land-boards/lb-boards/KiCAD/README.md

lb-boards Designs
=================

land-boards.com - Printed Circuit Board Designs
-----------------------------------------------

Design files are kept here. Most are [Kicad based designs][Kicad].
[Kicad]: http://www.kicad-pcb.org/display/KICAD/KiCad+EDA+Software+Suite/ "Kicad is an open source electronic design suite which includes professional quality schematic capture and board layout tools."

See [our PCB Designs Website][ourWebsite] and our [land-boards Wiki][ourWiki].
[ourWebsite]: http://land-boards.com/content/ "land-boards.com website"
[ourWiki]: http://land-boards.com/blwiki/ "land-boards.com wiki"
