land-boards/lb-boards/BeagleBoneBlack Cards/FlyingBone/README

BeagleBone prototyping board.

Directory 'kicad' contains design files.
Directory 'gerber' contains gerber files prepared for sending to the board house.
Directory 'lib' contains schematic symbol and PCB module for BeagleBone, both ready for use on your own boards.
