land-boards/lb-boards/SYNTHS/ER-PROTO-02_SET/Hagiwo-Quantizer-main/README.md

# Hagiwo-Quantizer
A MCP4821 version of Hagiwo Quantizer

This is a version of Hagiwo Quantizer with a MCP4821 12 bit DAC. The code is still under review. Using the new DAC I have to check calibration.
