land-boards/lb-boards/HamRadio/VFO-003/Documents/REFERNCE_DESIGNS/ETHERKIT_Si5351ABreakoutBoard/README.md

Si5351A Breakout Board
=====================

This repository hosts the KiCad project files for the Si5351A Breakout 
Board, as well as the schematic in PDF format.
