land-boards/lb-boards/SYNTHS/ER-ADSR-555-01_SET/DOCS/BENJIAO/MiniADSR-main/README.md

# MiniADSR

A four-parameter envelope generator based on Rene Schmitz' [The Fastest Envelope in the West](https://www.schmitzbits.de/adsr.html). More info on my website: https://benjiaomodular.com/post/2022-02-02-mini-adsr/

# Versions

## 1.0.1
Quick fixes for v1.0
- Fixed connection of R7 to Q2 pin 1
- Updated C2 value to 10uF
- Change sustain pot from 1M to 10k
- C3 from 100uF to 1uF
- Added version numbers
- Flipped power connectors 180deg to accomodate larger IDC connectors.

## 1.0
Initial design.

### Issues
- Wrong connection from R7
- Wrong value for C3 and Sustain pot
