land-boards/lb-boards/Raspberry Pi Cards/RPI-PWR/Rev_X2/report.txt

Info: Backing up file “C:\Users\HPz420\Documents\GitHub\land-boards\lb-boards\Raspberry Pi Cards\RPI-PWR\sym-lib-table” to file “C:\Users\HPz420\Documents\GitHub\land-boards\lb-boards\Raspberry Pi Cards\RPI-PWR\rescue-backup\sym-lib-table-2020-02-07-10-05-51”.
Info: Backing up file “C:\Users\HPz420\Documents\GitHub\land-boards\lb-boards\Raspberry Pi Cards\RPI-PWR\RPI-PWR.sch” to file “C:\Users\HPz420\Documents\GitHub\land-boards\lb-boards\Raspberry Pi Cards\RPI-PWR\rescue-backup\RPI-PWR-2020-02-07-10-05-51.sch”.
Info: Backing up file “C:\Users\HPz420\Documents\GitHub\land-boards\lb-boards\Raspberry Pi Cards\RPI-PWR\RPI-PWR.pro” to file “C:\Users\HPz420\Documents\GitHub\land-boards\lb-boards\Raspberry Pi Cards\RPI-PWR\rescue-backup\RPI-PWR-2020-02-07-10-05-51.pro”.
Info: Backing up file “C:\Users\HPz420\Documents\GitHub\land-boards\lb-boards\Raspberry Pi Cards\RPI-PWR\RPI-PWR-cache.lib” to file “C:\Users\HPz420\Documents\GitHub\land-boards\lb-boards\Raspberry Pi Cards\RPI-PWR\rescue-backup\RPI-PWR-cache-2020-02-07-10-05-51.lib”.
Info: Backing up file “C:\Users\HPz420\Documents\GitHub\land-boards\lb-boards\Raspberry Pi Cards\RPI-PWR\RPI-PWR-rescue.lib” to file “C:\Users\HPz420\Documents\GitHub\land-boards\lb-boards\Raspberry Pi Cards\RPI-PWR\rescue-backup\RPI-PWR-rescue-2020-02-07-10-05-51.lib”.
Info: Backing up file “C:\Users\HPz420\Documents\GitHub\land-boards\lb-boards\Raspberry Pi Cards\RPI-PWR\RPI-PWR-rescue.dcm” to file “C:\Users\HPz420\Documents\GitHub\land-boards\lb-boards\Raspberry Pi Cards\RPI-PWR\rescue-backup\RPI-PWR-rescue-2020-02-07-10-05-51.dcm”.
Info: Adding library “RPI-PWR-rescue”, file “${KIPRJMOD}/RPI-PWR-rescue.lib” to project symbol library table.
Symbol “COUPON” mapped to symbol library “RPI-PWR-rescue”.
Symbol “COUPON” mapped to symbol library “RPI-PWR-rescue”.
Symbol “CONN_1” mapped to symbol library “RPI-PWR-rescue”.
Symbol “CONN_1” mapped to symbol library “RPI-PWR-rescue”.
Symbol “R” mapped to symbol library “Device”.
Symbol “LED-RESCUE-RPI-PWR” mapped to symbol library “RPI-PWR-rescue”.
Symbol “RASPIO” mapped to symbol library “RPI-PWR-rescue”.
Symbol “USB-MICRO-B” mapped to symbol library “RPI-PWR-rescue”.
Symbol “R” mapped to symbol library “Device”.
Symbol “FUSE” mapped to symbol library “RPI-PWR-rescue”.
Info: Symbol library table mapping complete!
