land-boards/lb-boards/Audio Cards/AudioAmp380/Rev2/panelx2/report.txt

Info: Backing up file “C:\Users\HPz420\Documents\GitHub\land-boards\lb-boards\Audio Cards\AudioAmp380\sym-lib-table” to file “C:\Users\HPz420\Documents\GitHub\land-boards\lb-boards\Audio Cards\AudioAmp380\rescue-backup\sym-lib-table-2021-08-17-08-27-29”.
Info: Backing up file “C:\Users\HPz420\Documents\GitHub\land-boards\lb-boards\Audio Cards\AudioAmp380\AudioAmp380.sch” to file “C:\Users\HPz420\Documents\GitHub\land-boards\lb-boards\Audio Cards\AudioAmp380\rescue-backup\AudioAmp380-2021-08-17-08-27-29.sch”.
Info: Backing up file “C:\Users\HPz420\Documents\GitHub\land-boards\lb-boards\Audio Cards\AudioAmp380\AudioAmp380.pro” to file “C:\Users\HPz420\Documents\GitHub\land-boards\lb-boards\Audio Cards\AudioAmp380\rescue-backup\AudioAmp380-2021-08-17-08-27-29.pro”.
Info: Backing up file “C:\Users\HPz420\Documents\GitHub\land-boards\lb-boards\Audio Cards\AudioAmp380\AudioAmp380-cache.lib” to file “C:\Users\HPz420\Documents\GitHub\land-boards\lb-boards\Audio Cards\AudioAmp380\rescue-backup\AudioAmp380-cache-2021-08-17-08-27-29.lib”.
Info: Backing up file “C:\Users\HPz420\Documents\GitHub\land-boards\lb-boards\Audio Cards\AudioAmp380\AudioAmp380-rescue.lib” to file “C:\Users\HPz420\Documents\GitHub\land-boards\lb-boards\Audio Cards\AudioAmp380\rescue-backup\AudioAmp380-rescue-2021-08-17-08-27-29.lib”.
Info: Backing up file “C:\Users\HPz420\Documents\GitHub\land-boards\lb-boards\Audio Cards\AudioAmp380\AudioAmp380-rescue.dcm” to file “C:\Users\HPz420\Documents\GitHub\land-boards\lb-boards\Audio Cards\AudioAmp380\rescue-backup\AudioAmp380-rescue-2021-08-17-08-27-29.dcm”.
Info: Adding library “AudioAmp380-rescue”, file “${KIPRJMOD}/AudioAmp380-rescue.lib” to project symbol library table.
Symbol “RCA-JACK” mapped to symbol library “AudioAmp380-rescue”.
Symbol “RCA-JACK” mapped to symbol library “AudioAmp380-rescue”.
Symbol “C” mapped to symbol library “Device”.
Symbol “GND-RESCUE-AudioAmp386” mapped to symbol library “AudioAmp380-rescue”.
Symbol “R” mapped to symbol library “Device”.
Symbol “C” mapped to symbol library “Device”.
Symbol “LM386-RESCUE-AudioAmp386” mapped to symbol library “AudioAmp380-rescue”.
Symbol “COUPON” mapped to symbol library “AudioAmp380-rescue”.
Symbol “MTG_HOLE” mapped to symbol library “AudioAmp380-rescue”.
Symbol “CP1_Small” mapped to symbol library “Device”.
Symbol “CP1_Small” mapped to symbol library “Device”.
Symbol “R” mapped to symbol library “Device”.
Symbol “CP1_Small” mapped to symbol library “Device”.
Symbol “CP1_Small” mapped to symbol library “Device”.
Symbol “CONN_01X05” mapped to symbol library “AudioAmp380-rescue”.
Symbol “CP1_Small” mapped to symbol library “Device”.
Symbol “C” mapped to symbol library “Device”.
Symbol “DCJ0202” mapped to symbol library “AudioAmp380-rescue”.
Info: Symbol library table mapping complete!
