land-boards/lb-boards/Projects/QTPy/circuitpython-community-bundle-7.x-mpy-20220601/VERSIONS.txt

20220601
https://github.com/WoolseyWorkshop/WoolseyWorkshop_CircuitPython_74HC165/releases/tag/0.8.0
https://github.com/mmabey/Adafruit_Soundboard/releases/tag/v0.1.1
https://github.com/BiffoBear/CircuitPython_AS3935/releases/tag/2.0.3
https://github.com/skerr92/at42qt-acorn-python/releases/tag/v1.0.6
https://github.com/solderparty/arturo182_CircuitPython_BBQ10Keyboard/releases/tag/v0.2.0
https://github.com/ricardoquesada/bluepad32-circuitpython/releases/tag/0.99.1
https://github.com/jamesbowman/CircuitPython_bteve/releases/tag/0.1.4
https://github.com/hierophect/Hierophect_Circuitpython_Dynamixel/releases/tag/0.0.0
https://github.com/tylercrumpton/CircuitPython_GC9A01/releases/tag/1.0.0
https://github.com/mmabey/CircuitPython_HCSR04/releases/tag/v0.2
https://github.com/fivesixzero/CircuitPython_HX711/releases/tag/1.1.0
https://github.com/gmparis/CircuitPython_I2C_Button/releases/tag/3.1.0
https://github.com/bwshockley/CircuitPython-i2cEncoderLibV21/releases/tag/1.0.1
https://github.com/electronut/Electronutlabs_CircuitPython_ILI/releases/tag/1.0.0
https://github.com/barbudor/CircuitPython_INA3221/releases/tag/2.0.0
https://github.com/Neradoc/Circuitpython_Waveshare_LCD1602/releases/tag/1.0.0
https://github.com/electronut/Electronutlabs_CircuitPython_LIS2DH12/releases/tag/1.0.0
https://github.com/electronut/Electronutlabs_CircuitPython_LTR329ALS01/releases/tag/1.0.0
https://github.com/pimoroni/Pimoroni_CircuitPython_LTR559/releases/tag/v0.0.1
https://github.com/pimoroni/Pimoroni_CircuitPython_MICS6814/releases/tag/v0.0.1
https://github.com/vifino/CircuitPython-mitutoyo/releases/tag/v1.0
https://github.com/CedarGroveStudios/CircuitPython_NAU7802/releases/tag/1.5.1
https://github.com/2bndy5/CircuitPython_nRF24L01/releases/tag/2.1.0
https://github.com/fourstix/Sparkfun_CircuitPython_QwiicAS3935/releases/tag/1.0.7
https://github.com/fourstix/Sparkfun_CircuitPython_QwiicJoystick/releases/tag/1.0.10
https://github.com/fourstix/Sparkfun_CircuitPython_QwiicKe/releases/tag/1.0.4
https://github.com/fourstix/Sparkfun_CircuitPython_QwiicRelay/releases/tag/1.0.6
https://github.com/fourstix/Sparkfun_CircuitPython_QwiicTwist/releases/tag/1.0.8
https://github.com/fourstix/Sparkfun_CircuitPython_SerLCD/releases/tag/1.0.4
https://github.com/winneymj/CircuitPython_SH/releases/tag/1.3.2
https://github.com/s-light/slight_CircuitPython_TLC5957/releases/tag/0.1.2
https://github.com/lesamouraipourpre/Community_CircuitPython_TCA9555/releases/tag/0.2.2
https://github.com/tekktrik/CircuitPython_TicStepper/releases/tag/2.0.1
https://github.com/barbudor/CircuitPython_TMP75/releases/tag/1.0.2
https://github.com/arofarn/CircuitPython_TrellisM4_extended/releases/tag/1.0.0
https://github.com/jfurcean/CircuitPython_WiiChuck/releases/tag/0.0.3
https://github.com/jimbobbennett/CircuitPython_AzureCustomVision_Predic/releases/tag/0.2.1
https://github.com/jimbobbennett/CircuitPython_/releases/tag/0.2.1
https://github.com/buildwithpiper/PiperBlocklyLibrary/releases/tag/v1.09
https://github.com/s-light/CircuitPython_ansi_escape_code/releases/tag/1.0.1
https://github.com/jposada202020/CircuitPython_ArrowLine/releases/tag/0.8.3
https://github.com/WarriorOfWire/CircuitPython_async/releases/tag/v0.1.2
https://github.com/jimbobbennett/CircuitPython_Ba/releases/tag/0.3.1
https://github.com/jposada202020/CircuitPython_Candlesticks/releases/tag/0.6.2
https://github.com/FoamyGuy/CircuitPython_Display_Frame/releases/tag/0.0.4
https://github.com/tekktrik/CircuitPython_CSV/releases/tag/1.0.7
https://github.com/2231puppy/CircuitPython_DiscordBot/releases/tag/1.2.0
https://github.com/dastels/circuitPython_dotstar_featherwing/releases/tag/Initial
https://github.com/tannewt/CircuitPython_Example/releases/tag/1.0.0
https://github.com/tekktrik/CircuitPython_functools/releases/tag/0.1.0
https://github.com/gamblor21/Gamblor21_CircuitPython_AHRS/releases/tag/v0.3-alpha
https://github.com/benevpi/CIRCUITPYTHON_ifttt/releases/tag/0.0.1
https://github.com/jposada202020/CircuitPython_MorseCode/releases/tag/0.2.0
https://github.com/s-light/CircuitPython_nonblocking_serialinput/releases/tag/1.0.0
https://github.com/Angeleno-Tech/nonblocking_timer/releases/tag/1.0.0
https://github.com/FoamyGuy/Foamyguy_CircuitPython_nvm_helper/releases/tag/1.0.1
https://github.com/jimbobbennett/CircuitPython_P/releases/tag/0.4.0
https://github.com/cognitivegears/CircuitPython_Schedule/releases/tag/0.1.2
https://github.com/jposada202020/CircuitPython_st/releases/tag/0.5.1
https://github.com/evindunn/circuitpython_tzdb/releases/tag/0.0.4
https://github.com/jepler/Jepler_CircuitPython_udecimal/releases/tag/1.0.5
