land-boards/lb-boards/BeagleBoneBlack Cards/BBB Overall/beaglebone-black-master/README.md

BeagleBone Black
================

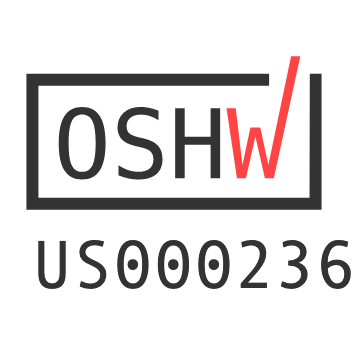
[picture p56: BeagleBoneBlack Cards/BBB Overall/beaglebone-black-master/OSHW_mark_US000236.png]
(https://certification.oshwa.org/us000236.html)
