land-boards/lb-boards/Analog Cards/UNI-OPAMP-04/Docs/RefDesigns/Ap31-OpAmp-DiffAmp.PNG

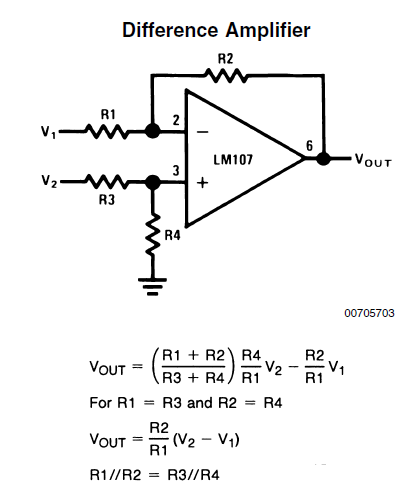
Analog Cards/UNI-OPAMP-04/Docs/RefDesigns/Ap31-OpAmp-DiffAmp.PNG
