land-boards/lb-boards/Analog Cards/UNI-OPAMP-04/Docs/RefDesigns/OpAMP-sch.PNG

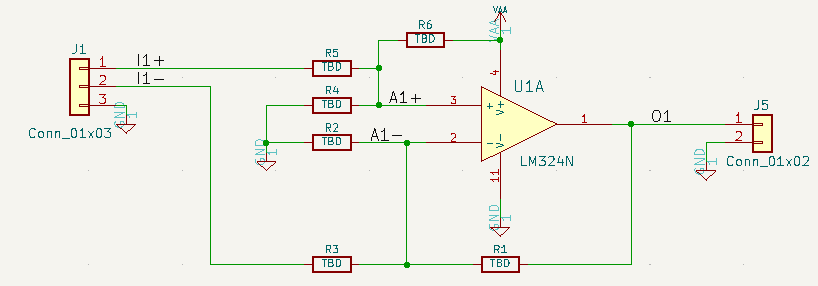
Analog Cards/UNI-OPAMP-04/Docs/RefDesigns/OpAMP-sch.PNG
