land-boards/lb-boards/Arduino Cards/QTPy49-01/QT_Py_Apps/QTPy49_Ap_01 (MMBASIC)/Pics/SD_Loader_App_Schematic.PNG

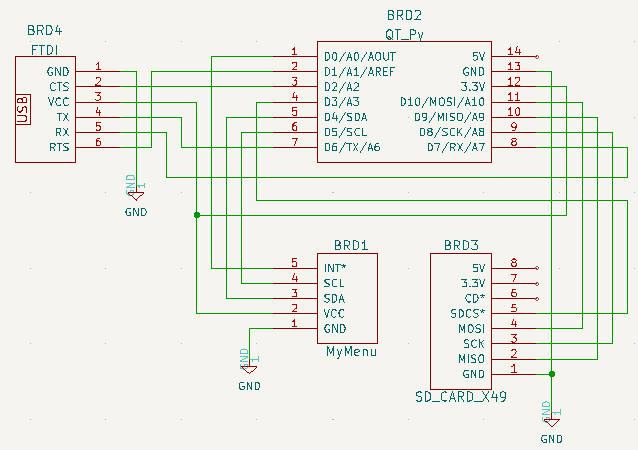
Arduino Cards/QTPy49-01/QT_Py_Apps/QTPy49_Ap_01 (MMBASIC)/Pics/SD_Loader_App_Schematic.PNG
