land-boards/lb-boards/Audio Cards/AudioAmp384/pictures/LM384_Equiv_Schematic.PNG

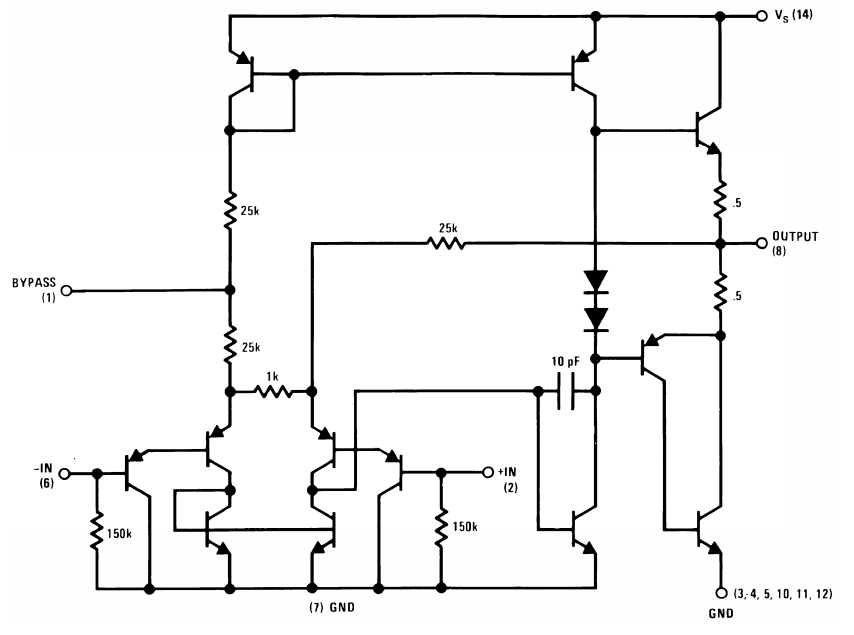
Audio Cards/AudioAmp384/pictures/LM384_Equiv_Schematic.PNG
