land-boards/lb-boards/Audio Cards/Pot_Pins/pictures/Schematics/AudioAmp380-Rev2_Schematic.png

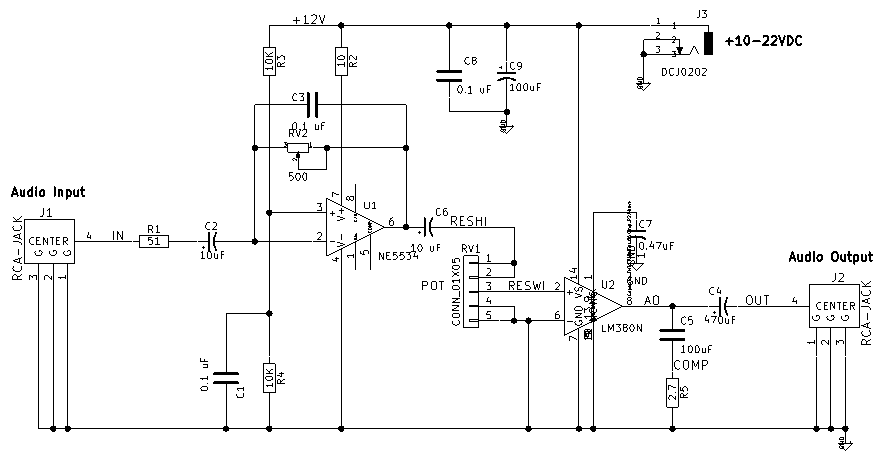
Audio Cards/Pot_Pins/pictures/Schematics/AudioAmp380-Rev2_Schematic.png
