land-boards/lb-boards/Audio Cards/Pot_Pins/pictures/Schematics/LM380_Equiv_Schematic.PNG

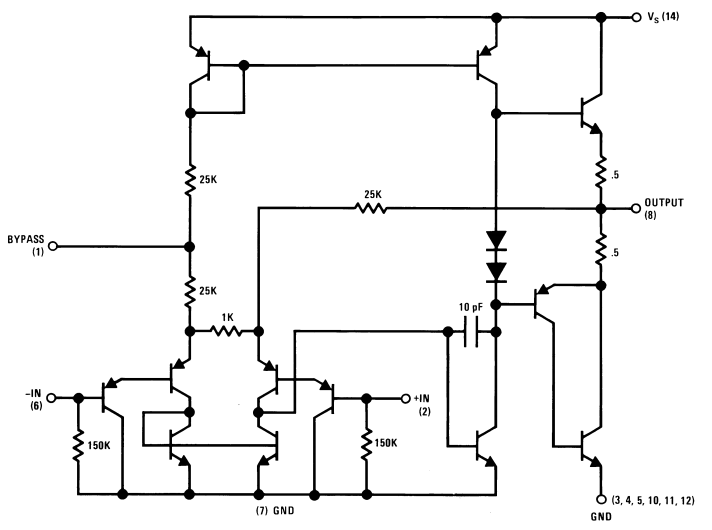
Audio Cards/Pot_Pins/pictures/Schematics/LM380_Equiv_Schematic.PNG
