land-boards/lb-boards/Audio Cards/XR-2206/pictures/Schematics/xr2206x3.png

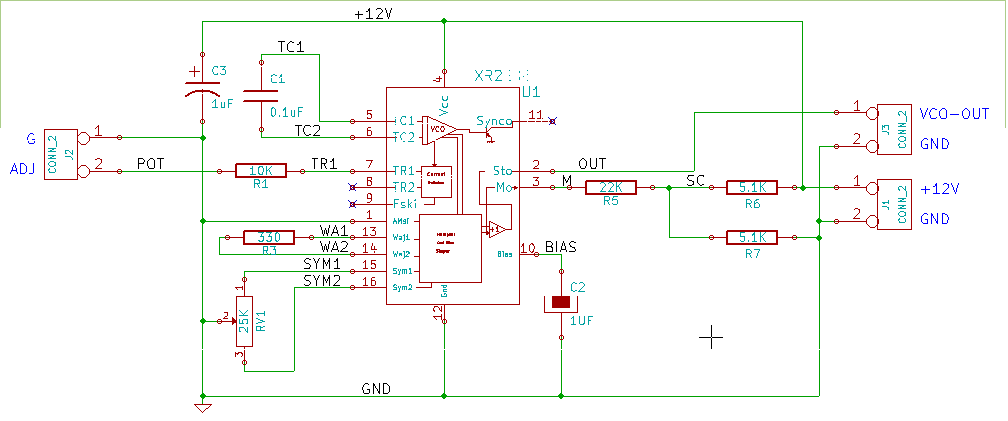
Audio Cards/XR-2206/pictures/Schematics/xr2206x3.png
