land-boards/lb-boards/BeagleBoneBlack Cards/BBB-COMMS-2/Docs/BeagleBone-Black-Pinout.jpg

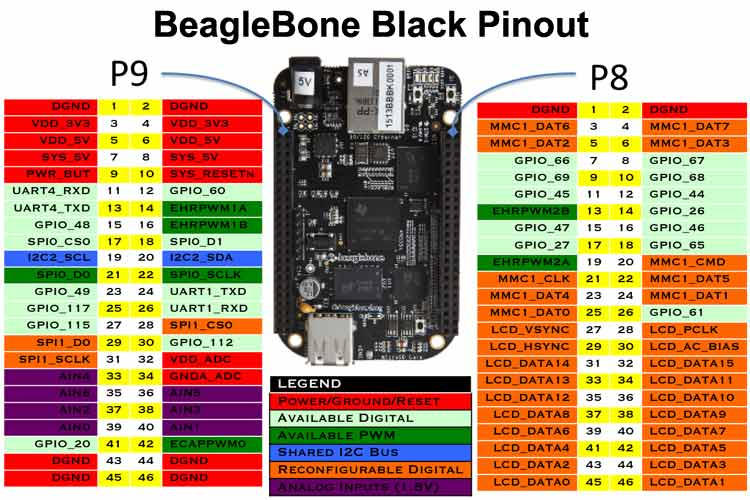
BeagleBoneBlack Cards/BBB-COMMS-2/Docs/BeagleBone-Black-Pinout.jpg
