land-boards/lb-boards/ESP32/ESP32-49MM/Pics/ESP-32_VGA_Pinout_Rev2.PNG

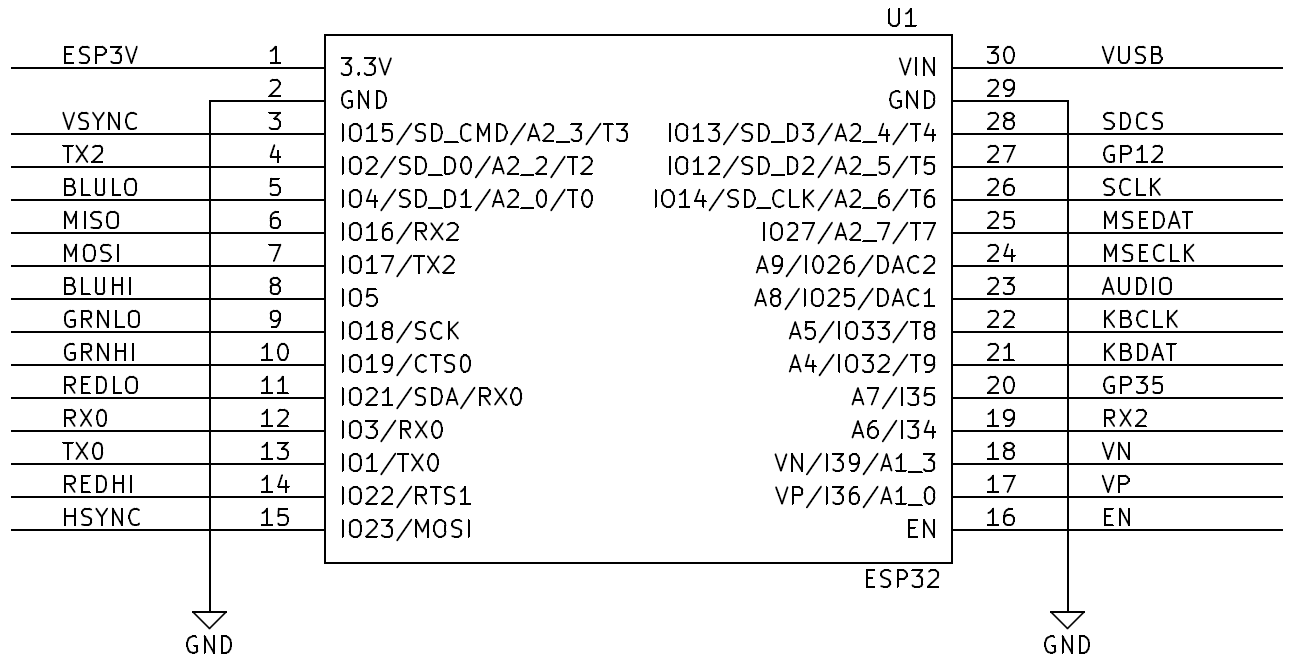
ESP32/ESP32-49MM/Pics/ESP-32_VGA_Pinout_Rev2.PNG
