land-boards/lb-boards/ESP32/ESP-12E-01/Pictures/Design/canvas.png

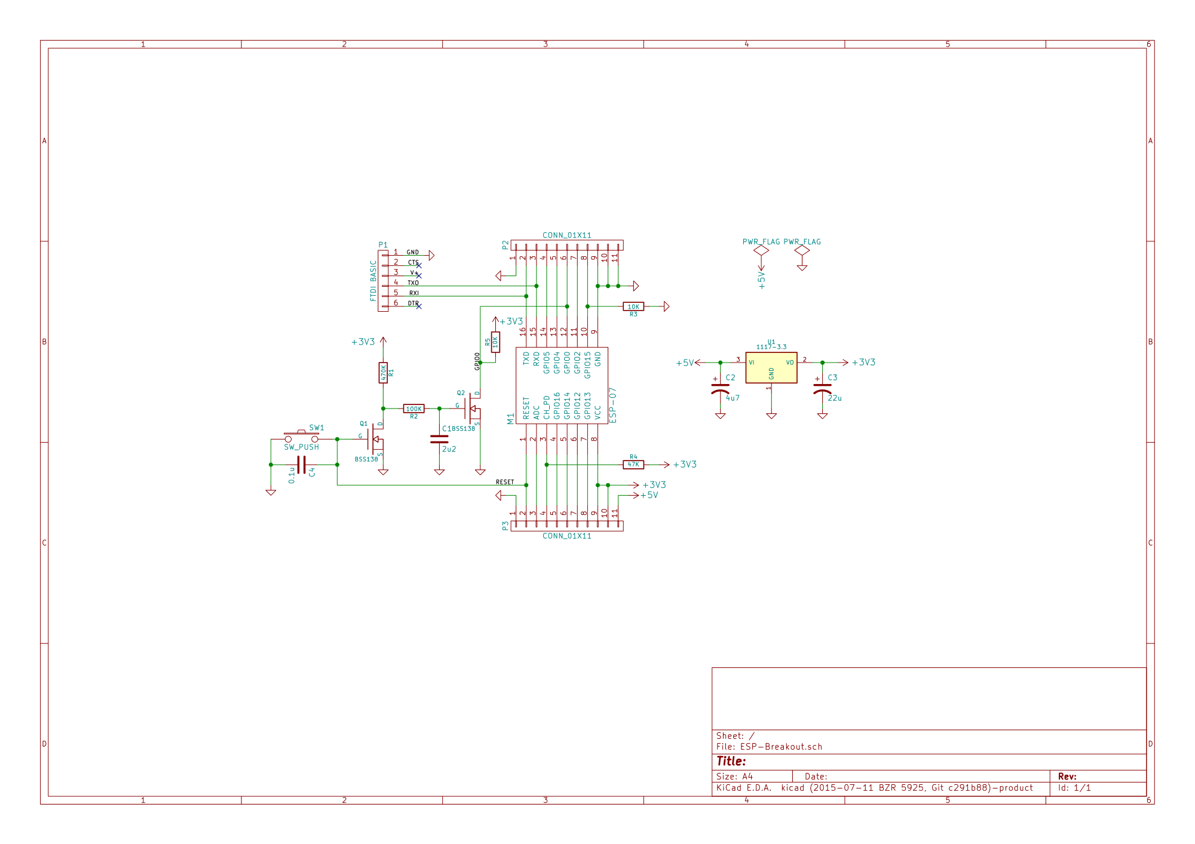
ESP32/ESP-12E-01/Pictures/Design/canvas.png
