land-boards/lb-boards/ESP32/ESP-12E-01/Pictures/Design/Screen-2015-06-12-641.png

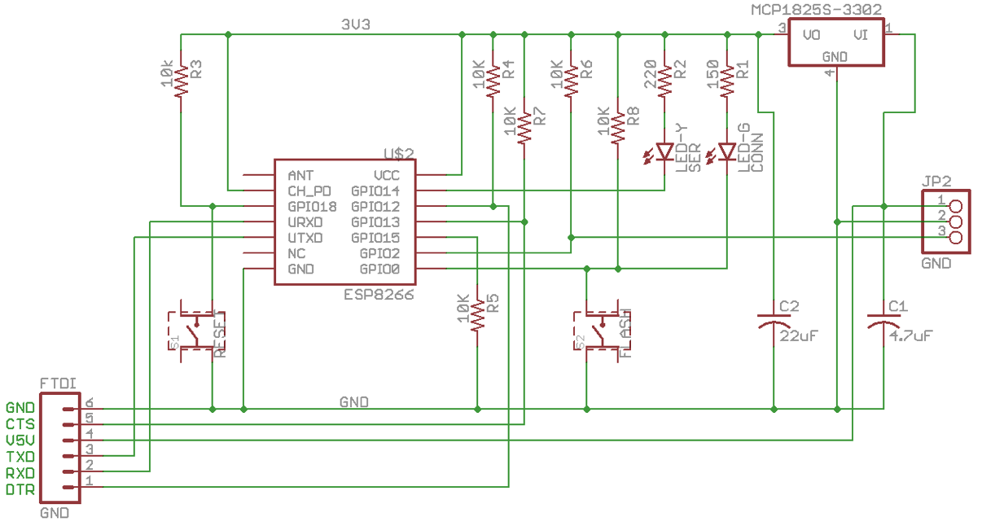
ESP32/ESP-12E-01/Pictures/Design/Screen-2015-06-12-641.png
