land-boards/lb-boards/ESP32/ESP-12E-01/Pictures/Design/wemos-d1-mini-shematics.jpg

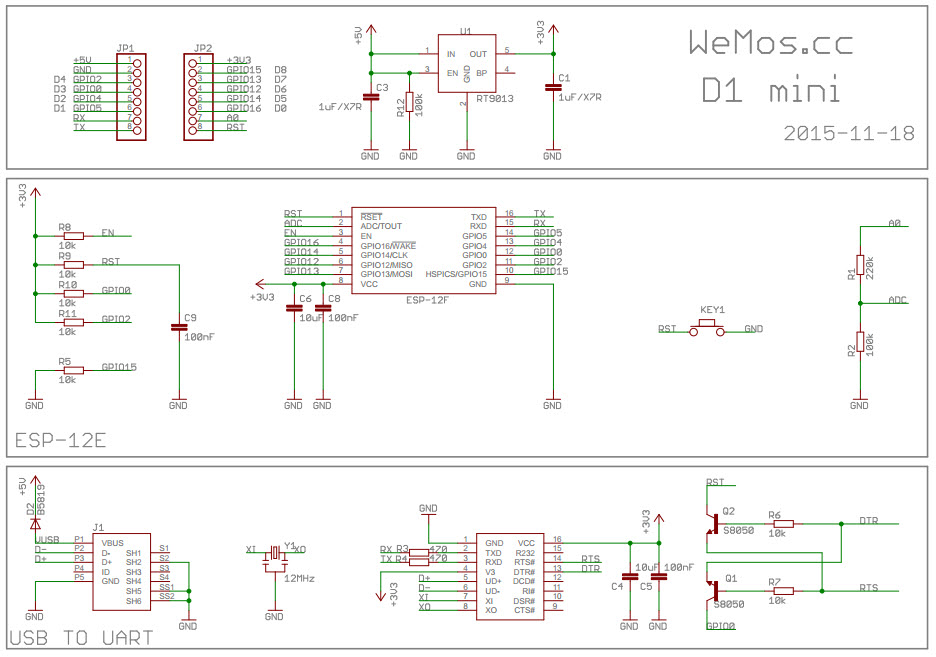
ESP32/ESP-12E-01/Pictures/Design/wemos-d1-mini-shematics.jpg
