land-boards/lb-boards/GPS Cards/GPS-Design/Pictures/GPS-Box-480vpx.jpg

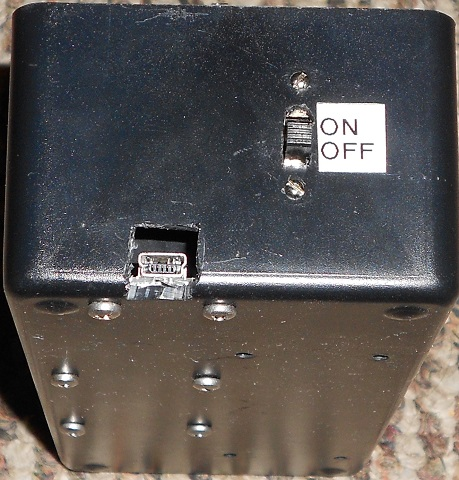
GPS Cards/GPS-Design/Pictures/GPS-Box-480vpx.jpg
