land-boards/lb-boards/GPS Cards/GPS-Design/Pictures/GPS-insides-1600px.JPG

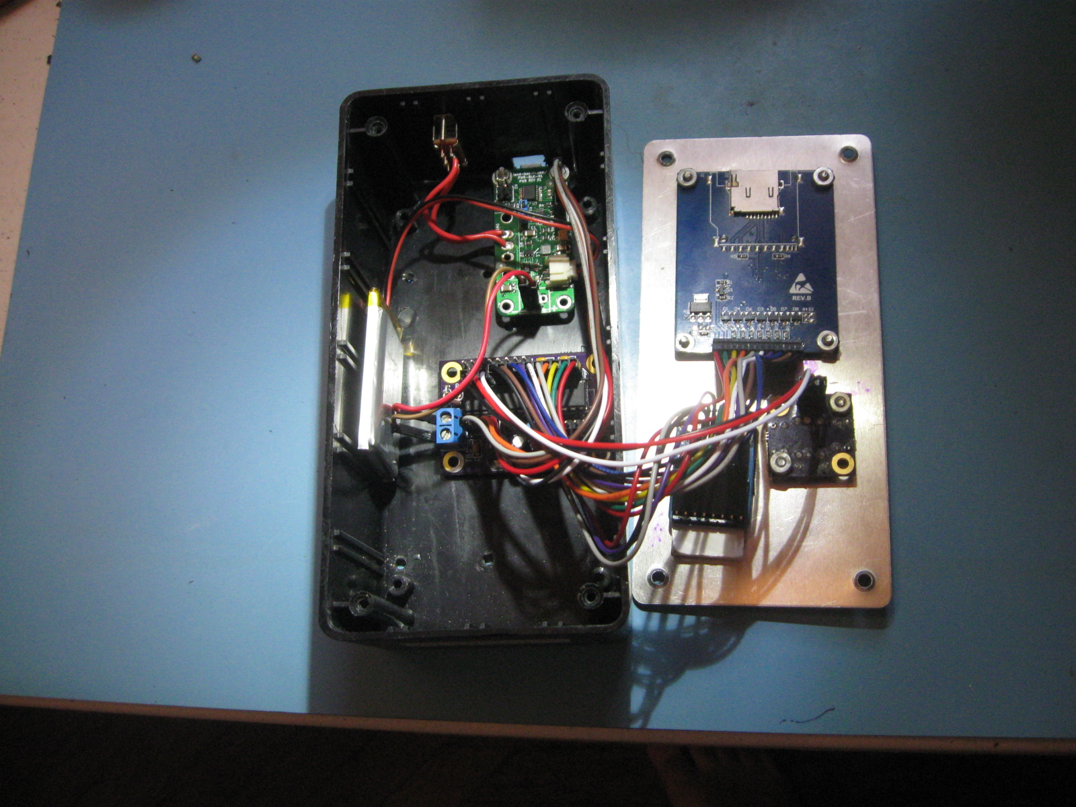
GPS Cards/GPS-Design/Pictures/GPS-insides-1600px.JPG
