land-boards/lb-boards/HamRadio/NoiseGen/Pics/Prototype/HighPassFilter/Filter DesignGain.PNG

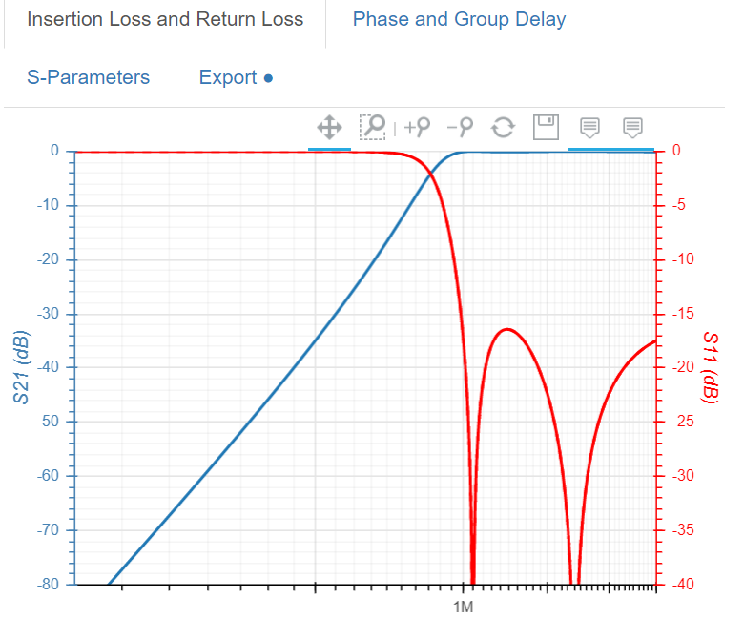
HamRadio/NoiseGen/Pics/Prototype/HighPassFilter/Filter DesignGain.PNG
