land-boards/lb-boards/HamRadio/RF-AMP-1/Docs/RF-AMP-1-Schematic.PNG

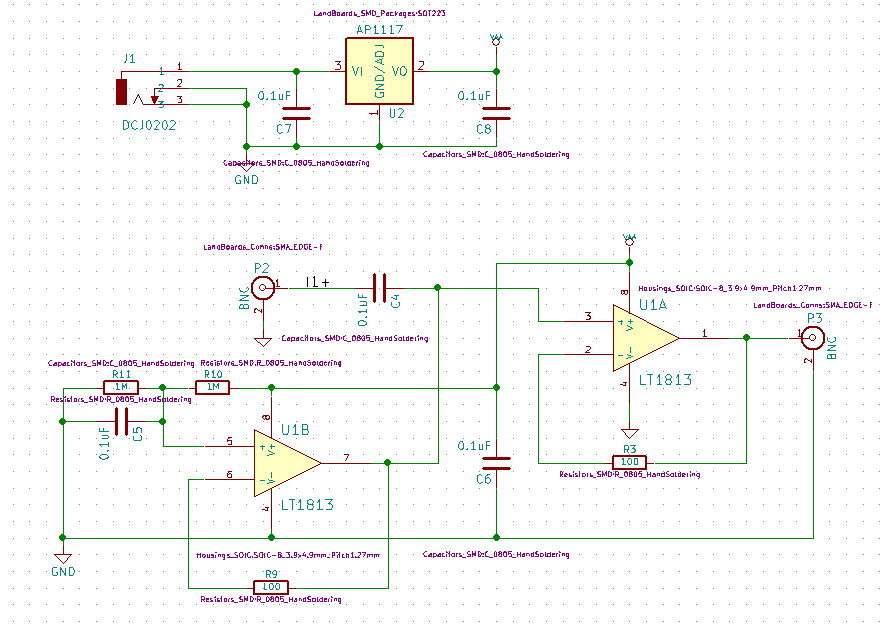
HamRadio/RF-AMP-1/Docs/RF-AMP-1-Schematic.PNG
