land-boards/lb-boards/HamRadio/VFO-001/Pictures/VFO-001-SCHEMATIC-V2A.PNG

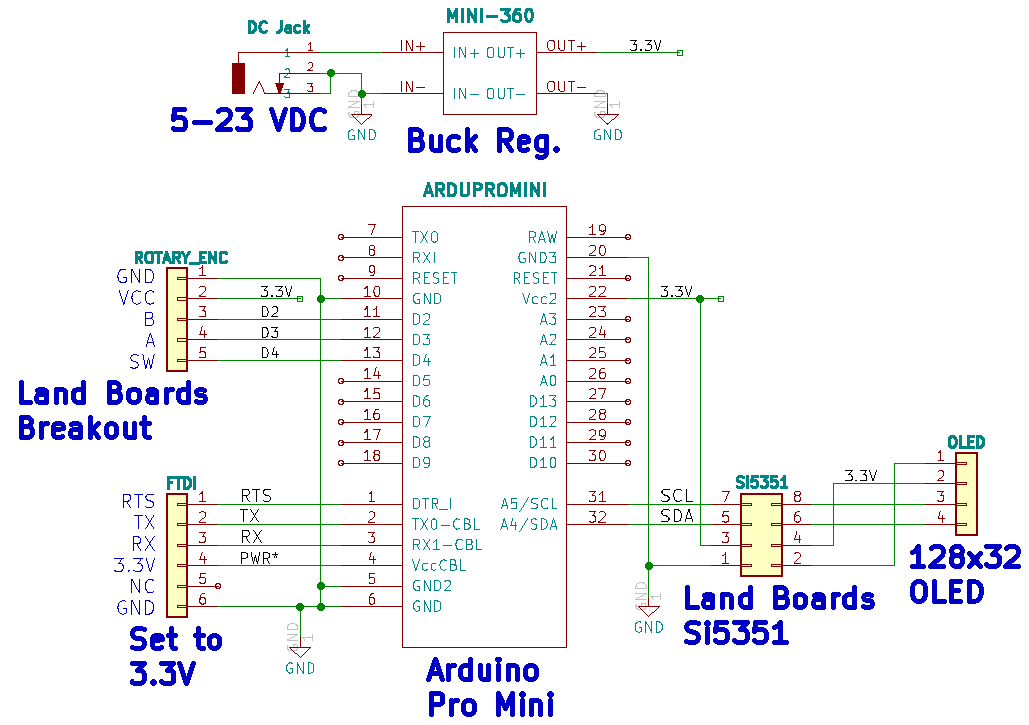
HamRadio/VFO-001/Pictures/VFO-001-SCHEMATIC-V2A.PNG
