land-boards/lb-boards/HamRadio/W7ZOI_TIA/Pics/NGSPICE/W7ZOI_SCHEMATIC_KiCAD-2.PNG

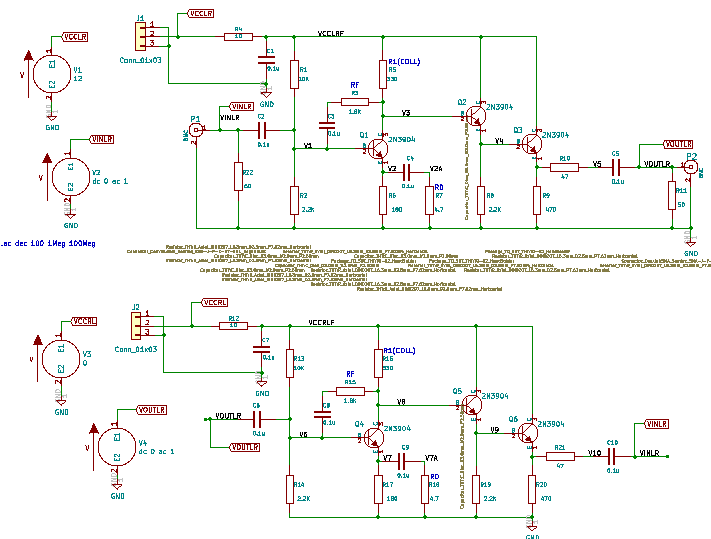
HamRadio/W7ZOI_TIA/Pics/NGSPICE/W7ZOI_SCHEMATIC_KiCAD-2.PNG
