land-boards/lb-boards/I2C Cards/DigIO32-I2C/Pictures/Conns/DB37Pinout.PNG

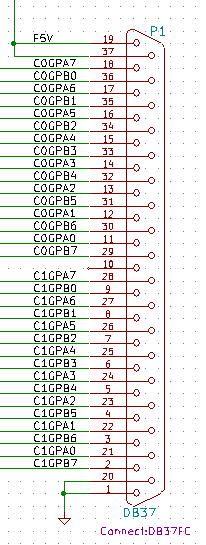
I2C Cards/DigIO32-I2C/Pictures/Conns/DB37Pinout.PNG
