land-boards/lb-boards/LEDs Cards/LEDS-SWITCHES _2/Pics/LEDS-SWITCHES-2_P1_Pinout.PNG

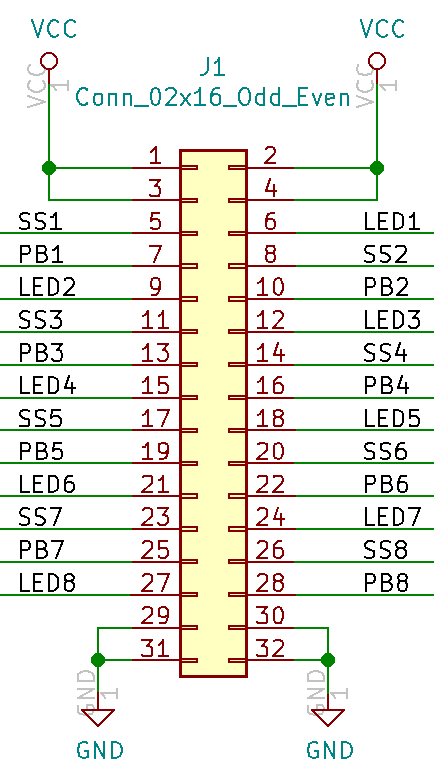
LEDs Cards/LEDS-SWITCHES _2/Pics/LEDS-SWITCHES-2_P1_Pinout.PNG
