land-boards/lb-boards/ODAS Cards/SD_CARD_X49/pictures/CCA/X49_Mounted_In_Chassis_1133px.jpg

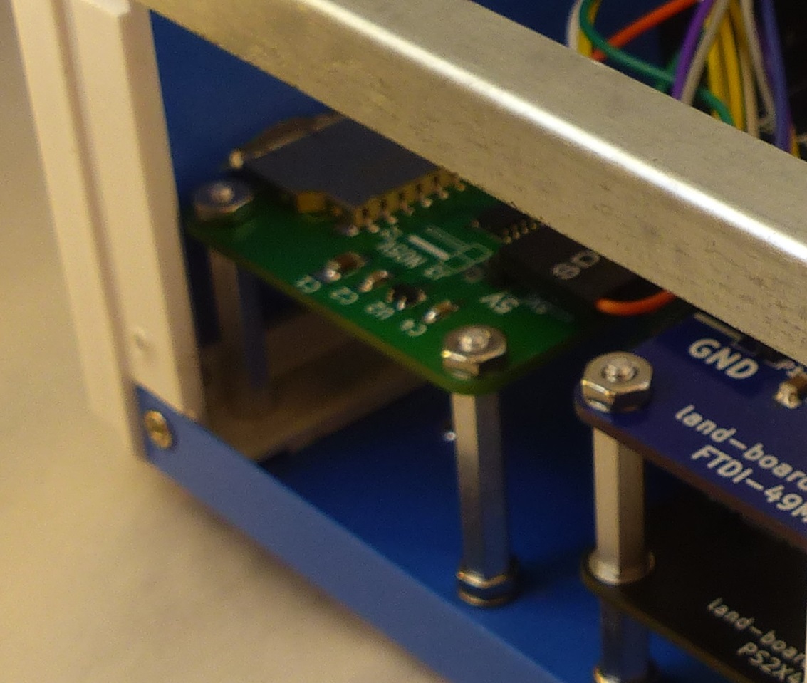
ODAS Cards/SD_CARD_X49/pictures/CCA/X49_Mounted_In_Chassis_1133px.jpg
