land-boards/lb-boards/Projects/RadioDesign/FilterDesign/BUTTER07/DOCS/BUTTER07-3D-OTRTH.png

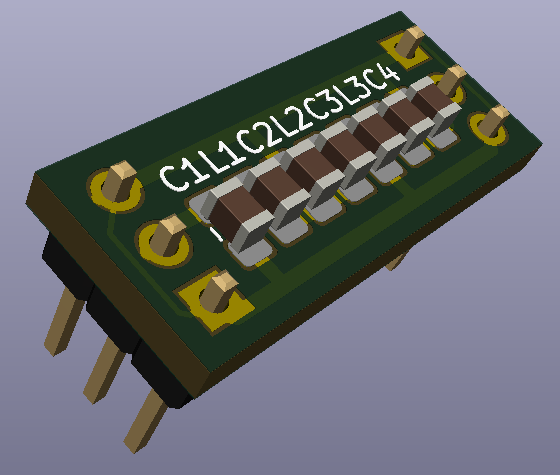
Projects/RadioDesign/FilterDesign/BUTTER07/DOCS/BUTTER07-3D-OTRTH.png
