land-boards/lb-boards/Projects/RadioDesign/FilterDesign/BUTTER07/DOCS/BUTTER07-LPF-Web.PNG

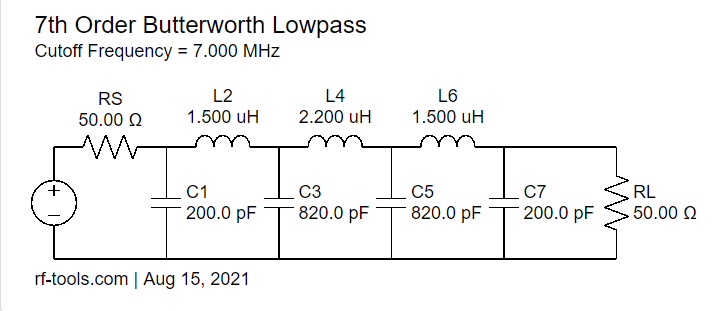
Projects/RadioDesign/FilterDesign/BUTTER07/DOCS/BUTTER07-LPF-Web.PNG
