land-boards/lb-boards/Projects/RadioDesign/FilterDesign/BUTTER07/DOCS/LPF-Web.PNG

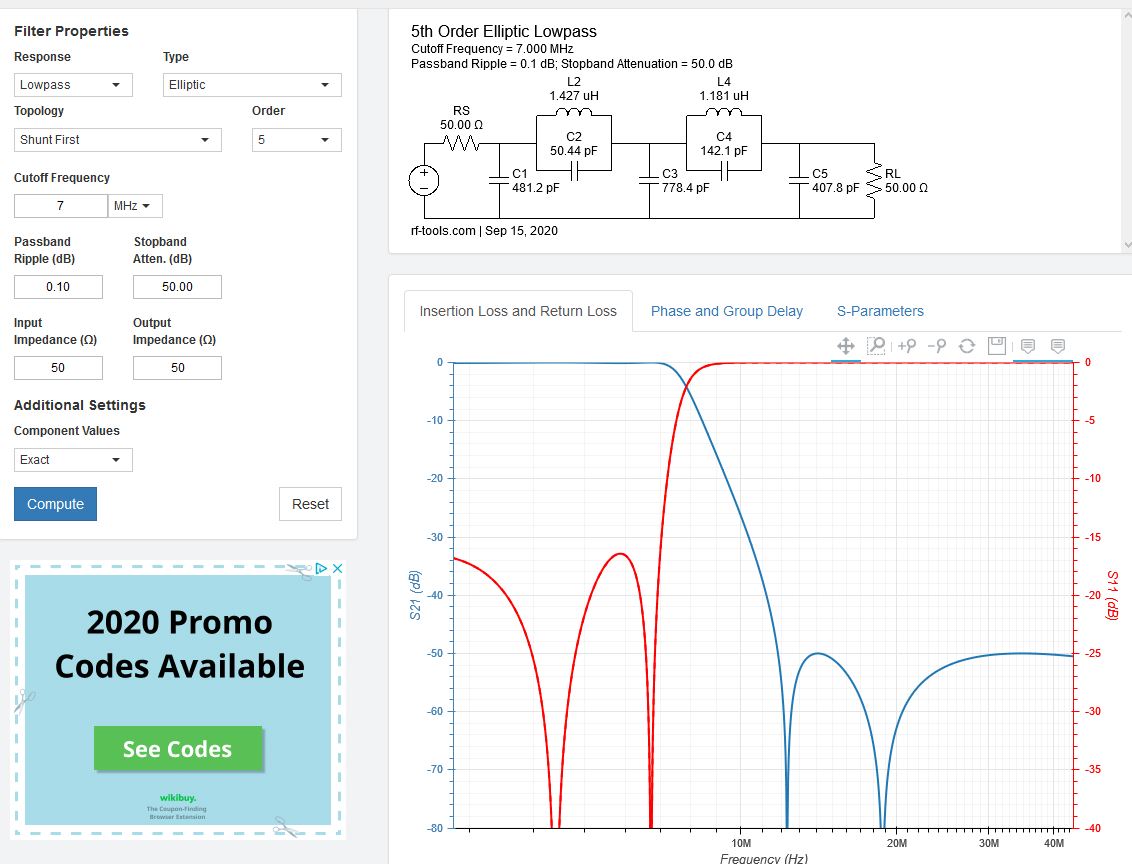
Projects/RadioDesign/FilterDesign/BUTTER07/DOCS/LPF-Web.PNG
