land-boards/lb-boards/Prototyping Cards/DB25-02/Docs/DB25-02_Female-02_SCHEMATIC.PNG

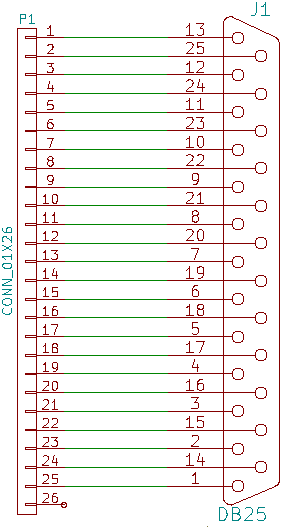
Prototyping Cards/DB25-02/Docs/DB25-02_Female-02_SCHEMATIC.PNG
