land-boards/lb-boards/Prototyping Cards/DB37RIBBONADAPTER/Pictures/Conns/DC37pinout.jpg

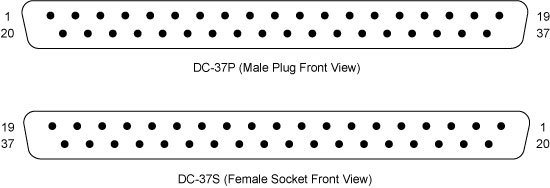
Prototyping Cards/DB37RIBBONADAPTER/Pictures/Conns/DC37pinout.jpg
