land-boards/lb-boards/Raspberry Pi Cards/RPPSOC/Pictures/ProgrammingDocs/ExampleCode/Example8-Blink-Schematic.PNG

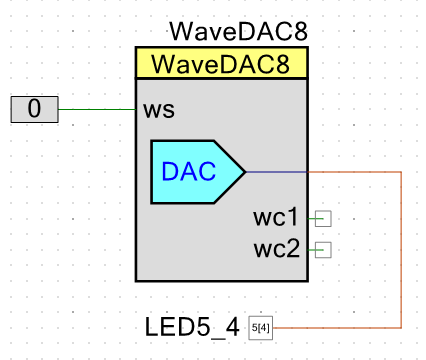
Raspberry Pi Cards/RPPSOC/Pictures/ProgrammingDocs/ExampleCode/Example8-Blink-Schematic.PNG
