land-boards/lb-boards/RetroCPUs/LB-RETRO-SET/LB-65CXX-01/Pics/Schem/R65C02_vs_W65C02_w65c816_Pinout.png

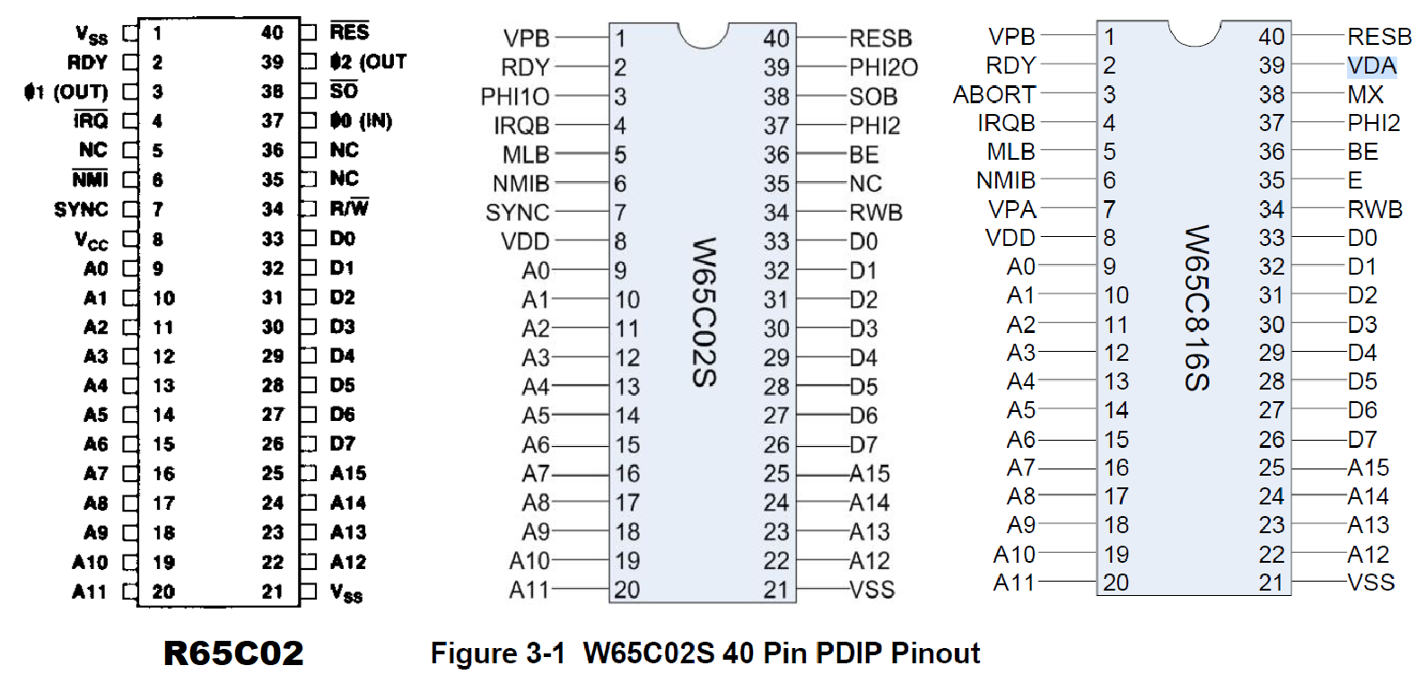
RetroCPUs/LB-RETRO-SET/LB-65CXX-01/Pics/Schem/R65C02_vs_W65C02_w65c816_Pinout.png
