land-boards/lb-boards/SYNTHS/Docs/Modules/Mutable Instruments/MI Beaks (Peaks)/Schematics/beaks_schem_sh3.PNG

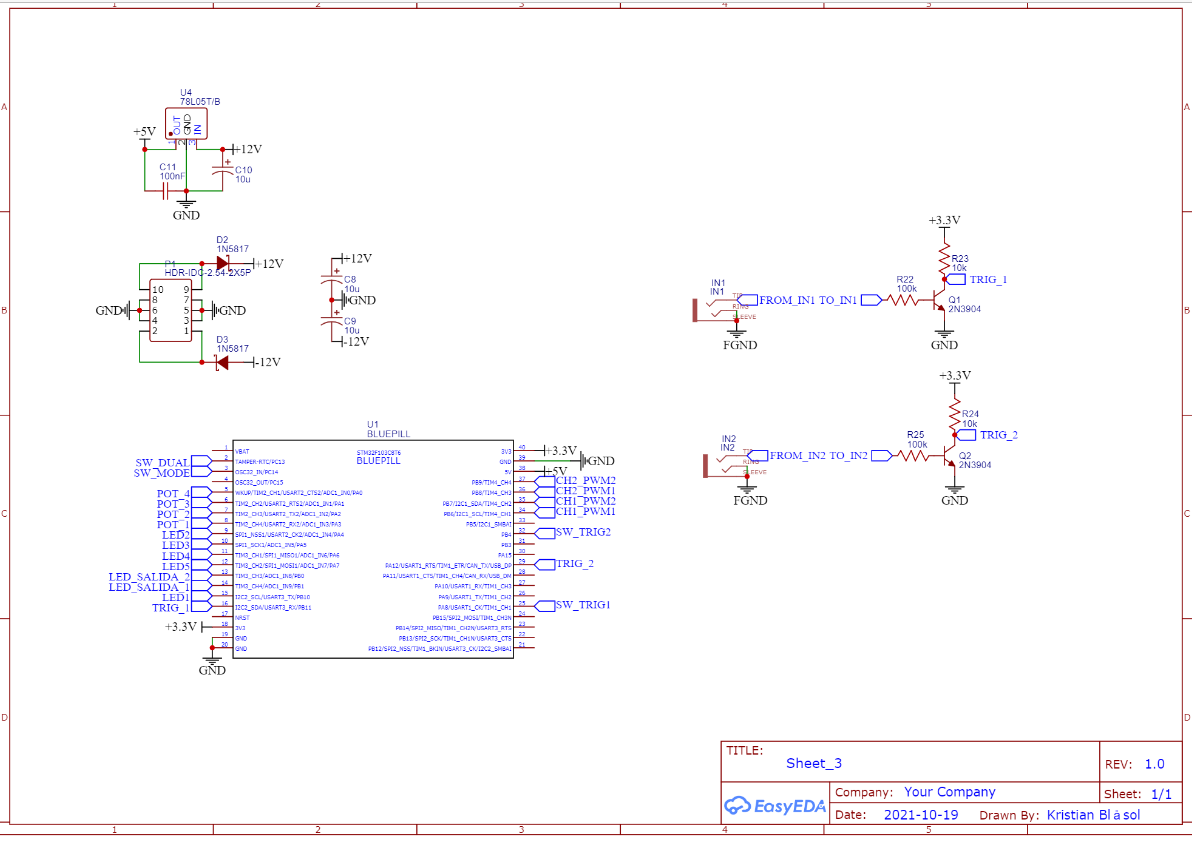
SYNTHS/Docs/Modules/Mutable Instruments/MI Beaks (Peaks)/Schematics/beaks_schem_sh3.PNG
