land-boards/lb-boards/SYNTHS/ER-PROTO-02_SET/ER-DELAY-03/Docs/Benji/MiniDelay v1.0 - Schematic.png

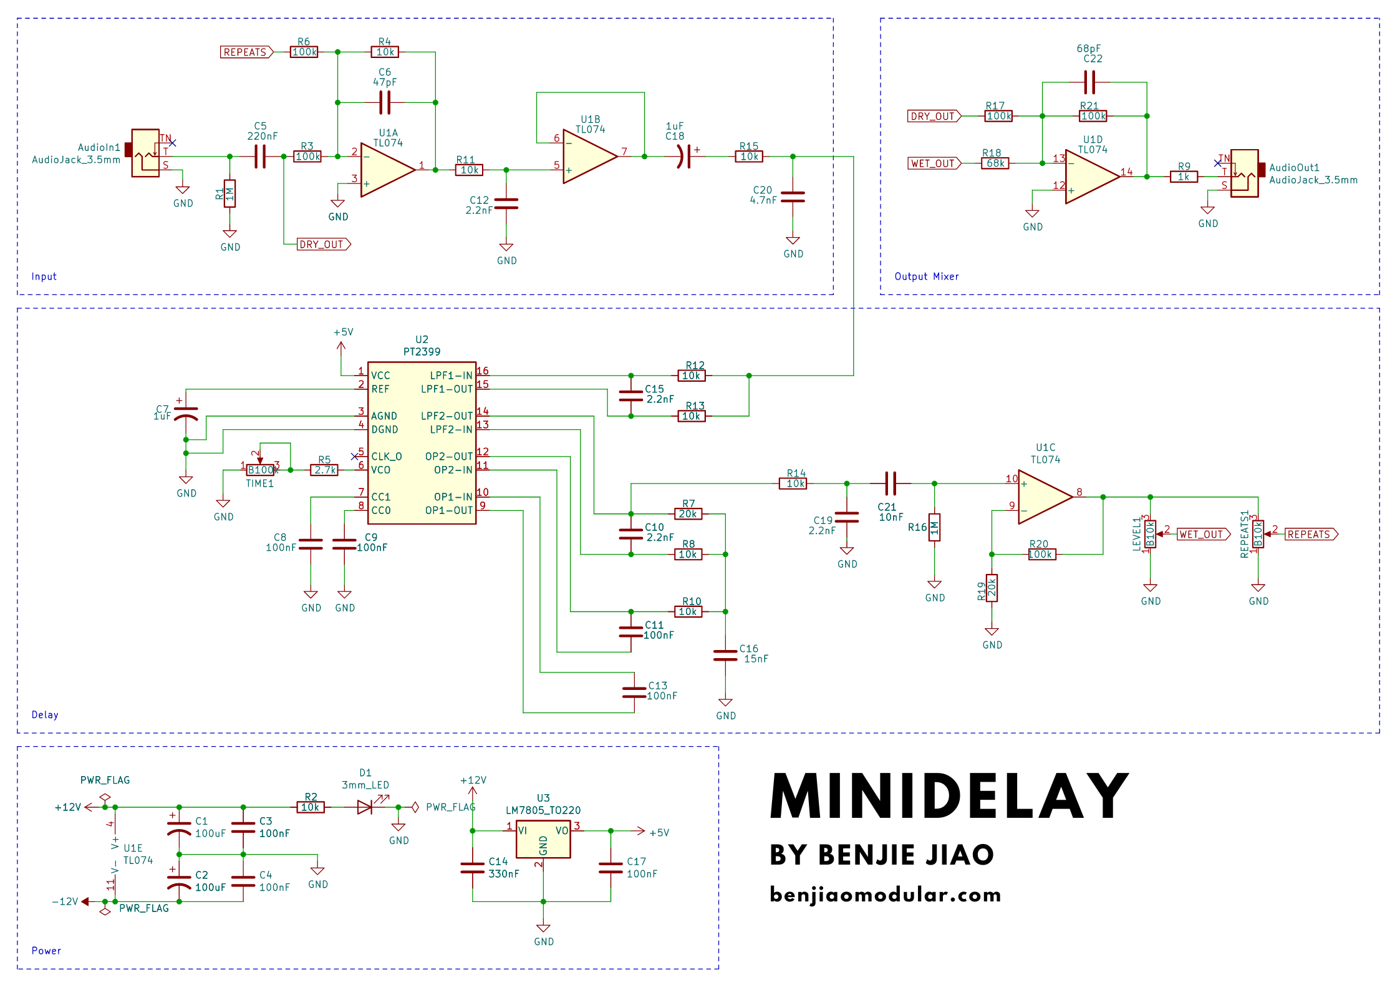
SYNTHS/ER-PROTO-02_SET/ER-DELAY-03/Docs/Benji/MiniDelay v1.0 - Schematic.png
