land-boards/lb-boards/SYNTHS/ER-VCF-02_SET/PICS/REWORK/ER-VCF-02_Pot_Pinout.PNG

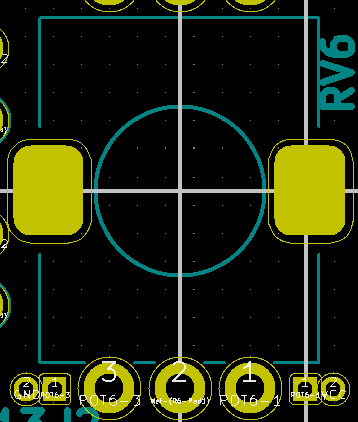
SYNTHS/ER-VCF-02_SET/PICS/REWORK/ER-VCF-02_Pot_Pinout.PNG
