land-boards/lb-boards/SYNTHS/ER-VCO-03_SET/ER-VCO-03-DB/DOCS/HAGIWO_VCO_SCHEMATIC.png

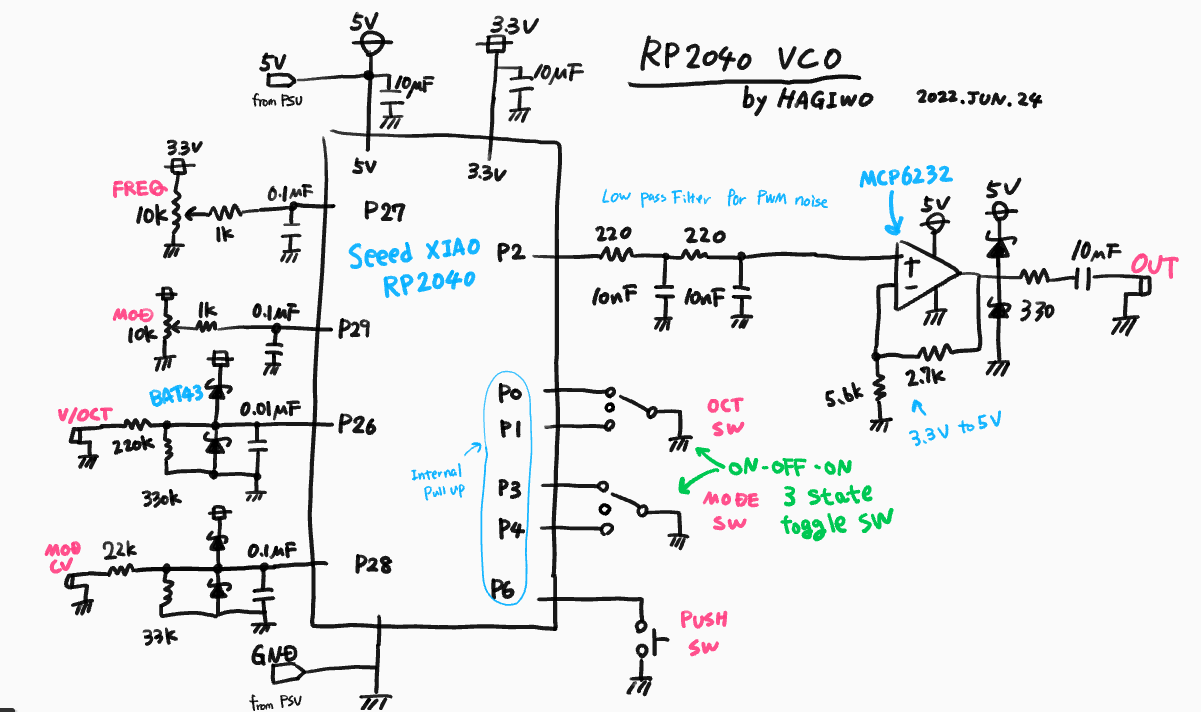
SYNTHS/ER-VCO-03_SET/ER-VCO-03-DB/DOCS/HAGIWO_VCO_SCHEMATIC.png
