land-boards/lb-boards/SYNTHS/SYNTH-LADDER/SYNTH-MIDI-CTL-01/DOCS/Eurorack-Power-Pinouts.png

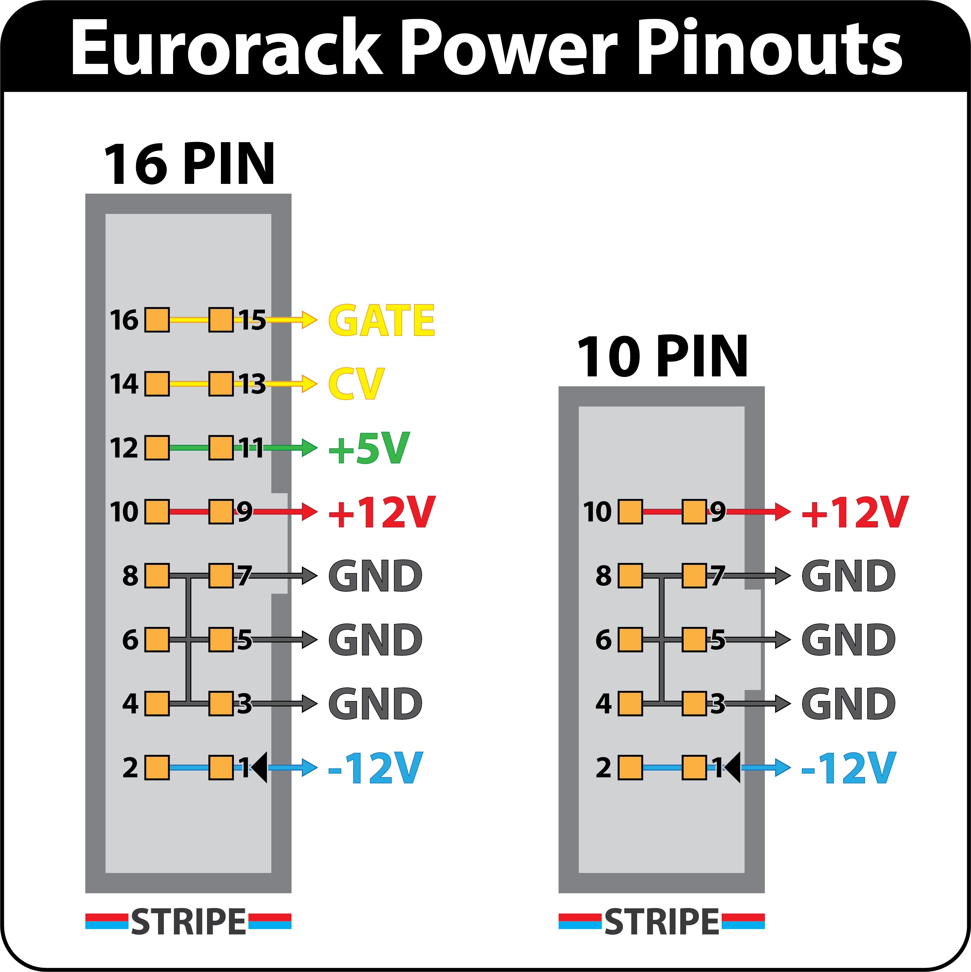
SYNTHS/SYNTH-LADDER/SYNTH-MIDI-CTL-01/DOCS/Eurorack-Power-Pinouts.png
