land-boards/lb-boards/LEDs Cards/LED1W/plots/OSH Park ~ Order Details.htm

Order number | RpxLyHyu
Order status | Payment verification has been received from Paypal.
Ordered on | March 12th 2017.
Paid on | March 12th 2017 via paypal.
Items
3 of LED1W.zip
0.80x0.80 inch (20.40x20.40 mm) 2 layer board.
Your board is awaiting panelization.
3 boards at $3.20 per batch of three. | $3.20
Sub total | $3.20
USPS - Free Shipping | $0.00
TOTAL (paid) | $3.20
Shipping Address | Doug Gilliland land-boards 1150 S Pittsburgh St Connellsville , PA , 15425 United States
