land-boards/lb-boards/Arduino Cards/Screwduino/PartsList/TERMINAL LABEL.odt

A5 | A4 | A3 | A2 | A1 | A0 | GND | ARF | D13 | D12 | D11 | D10 | D9 | VIN | +5V | GND
GND | GND | +5V | +5V | RS* | D8 | D7 | D6 | GND | +5V | D5 | D4 | D3 | D2 | D1 | GND

A5 | A4 | A3 | A2 | A1 | A0 | GND | ARF | D13 | D12 | D11 | D10 | D9 | VIN | +5V | GND
GND | GND | +5V | +5V | RS* | D8 | D7 | D6 | GND | +5V | D5 | D4 | D3 | D2 | D1 | GND

A5 | A4 | A3 | A2 | A1 | A0 | GND | ARF | D13 | D12 | D11 | D10 | D9 | VIN | +5V | GND
GND | GND | +5V | +5V | RS* | D8 | D7 | D6 | GND | +5V | D5 | D4 | D3 | D2 | D1 | GND

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

A5 | A4 | A3 | A2 | A1 | A0 | GND | ARF | D13 | D12 | D11 | D10 | D9 | VIN | +5V | GND
GND | GND | +5V | +5V | RT* | D8 | D7 | D6 | GND | +5V | D5 | D4 | D3 | D2 | D1 | GND

A5 | A4 | A3 | A2 | A1 | A0 | GND | ARF | D13 | D12 | D11 | D10 | D9 | VIN | +5V | GND
GND | GND | +5V | +5V | RT* | D8 | D7 | D6 | GND | +5V | D5 | D4 | D3 | D2 | D1 | GND

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
