land-boards/lb-boards/Inventory/Inventory-2013-03-07.xlsx

Mouser Part Number | Total Qty | Description | Category | Package
647-UPS2C101MHD1TN | 3 | Aluminum Electrolytic Capacitors - Leaded 100UF 160V 105c | Capacitor
140-REA100M1EBK0511P | 112 | Aluminum Electrolytic Capacitors - Leaded 25V 10uF 20% 5x11mm | Capacitor
661-EKMGG250ELL221MH | 3 | Aluminum Electrolytic Capacitors - Leaded 25volts 220uF 8x11.5 | Capacitor
647-UFW1V471MPD | 3 | Aluminum Electrolytic Capacitors - Leaded 35volts 470uF 20% | Capacitor
75-1C10Z5U104M050B | 168 | Multilayer Ceramic Capacitors MLCC - Leaded 0.1uF 50volts Z5U 20% 2.5mm L/S | Capacitor
581-08055C104K | 100 | Multilayer Ceramic Capacitors MLCC - SMD/SMT 0805 0.1uF 50volts X7R 10% | Capacitor | SM0805
140-CC501N180J-RC | 100 | Multilayer Ceramic Capacitors MLCC - SMD/SMT 0805 18pF 50volts C0G/NP0 5% | Capacitor | SM0805
77-VJ0805Y105MXQTBC | 100 | Multilayer Ceramic Capacitors MLCC - SMD/SMT 0805 1uF 10volts X7R 20% | Capacitor | SM0805
888-XB24-Z7WIT-004 | 2 | Zigbee / 802.15.4 Modules XBee ZB w/WiredWhip AT Router F/W | CCA
163-179PH-EX | 5 | DC Power Connectors PCB 2.1MM | Connector
568-NYS354 | 12 | RCA Phono Connectors SHIELDED RIGHT ANGLE REAN | Connector
798-UX60SC-MB-5ST80 | 31 | USB Connectors MINI B RECEPT RA SMT BTTM MNT | Connector
774-ATS080CSM-1 | 13 | Crystals 8MHz 32pF 30ppm -20C 70C | Crystal
546-1551KRBK | 1 | Enclosures, Boxes, & Cases 3.15 X 1.57 X .67 Black With Key Ring | Enclosure
546-1551KTBU | 5 | Enclosures, Boxes, & Cases 3.15 x 1.58 x 0.79 TransBlue | Enclosure
563-CU-1945 | 2 | Enclosures, Boxes, & Cases 3.76 X 6.21 X 2.0 | Enclosure
649-68494-426HLF | 3 | Headers & Wire Housings 26P UNSHROUD HEADER RT ANGLE | Header
649-68000-236HLF | 10 | Headers & Wire Housings 36 POS STR HDR | Header
649-68602-406HLF | 6 | Headers & Wire Housings 6P DR VRT UNSHRD HDR TIN OVER NICKEL | Header
571-6404536 | 6 | Headers & Wire Housings FLAT HEADER 6P Right Angle Post tin | Header
532-580200B00 | 3 | Heat Sinks HEAT SINK DIP-14/16 | HeatSink
926-LM386N-3/NOPB | 2 | Audio Amplifiers | IC-Analog
926-LM384N/NOPB | 3 | Audio Amplifiers 5-W AUDIO POWER AMP | IC-Analog
579-MCP23008-E/P | 1 | Interface - I/O Expanders In/Out I2C int | IC-Logic
579-MCP23017-E/SP | 3 | Interface - Specialized 16bit Input/Output Exp I2C interface | IC-Logic
895-FT232RL | 3 | USB Interface IC USB to Serial UART Enhanced IC SSOP-28 | IC-Logic
579-MCP73833-AMI/UN | 3 | Battery Management Charge Management Controllers | IC-Power
926-LM22674MR50NOPB | 0 | DC/DC Switching Converters | IC-Power
621-AP1117Y50G-13 | 8 | Low Dropout Regulators - LDO LINEAR REG FIXED-MODE | IC-Power
863-MBR0530T1G | 0 | Fixed Inductors 68uH 20% | Inductor
859-LTST-C170KRKT | 100 | Standard LEDs - SMD Red Clear 631nm | LED
696-SML-LX15IGC-TR | 6 | Standard LEDs - SMD Red/Green 635/565 nm | LED
78-TLHR5201 | 16 | Standard LEDs - Through Hole Red Tinted Non-Diff 16-30mcd@10mA | LED
556-ATMEGA328P-PU | 17 | 8-bit Microcontrollers - MCU 32KB In-system Flash 20MHz 1.8V-5.5V | Microcontroller
556-ATTINY85-20PU | 10 | 8-bit Microcontrollers - MCU 8kB Flash 0.512kB EEPROM 6 I/O Pins | Microcontroller
556-ATMEGA32U4-AU | 13 | 8-bit Microcontrollers - MCU AVR USB 32K FLASH INDUSTRIAL | Microcontroller
556-ATMEGA32U4-MU | 3 | 8-bit Microcontrollers - MCU AVR USB 32K FLASH INDUSTRIAL | Microcontroller
844-IRFU420PBF | 3 | MOSFET N-Chan 500V 2.4 Amp | MOSFET
844-IRFD9110PBF | 6 | MOSFET P-Chan 100V 0.7 Amp | MOSFET
652-91A1A-B24-B15L | 3 | Potentiometers 5/8" SQUARE ST PANEL CTRL | Potentiometer
512-1N4006 | 12 | Rectifiers 1.0a Rectifier General Purpose | Rectifier
512-1N4004 | 25 | Rectifiers Vr/400V Io/1A T/R | Rectifier
71-CCF55100KFKE36 | 100 | Metal Film Resistors - Through Hole 1/4watt 100Kohms 1% | Resistor | R4
71-CMF5510K000FKEK | 100 | Metal Film Resistors - Through Hole 1/4watt 10Kohms 1% | Resistor | R4
260-10K-RC | 100 | Thick Film Resistors - SMD 1/10WATT 10KOHMS 5% | Resistor | 0805
260-150-RC | 200 | Thick Film Resistors - SMD 1/10WATT 150OHMS 5% | Resistor | 0805
260-22-RC | 100 | Thick Film Resistors - SMD 1/10WATT 22OHMS | Resistor | 0805
260-470-RC | 100 | Thick Film Resistors - SMD 1/10WATT 470OHMS 5% | Resistor | 0805
301-150-RC | 100 | Thick Film Resistors - SMD 1/16WATT 150OHMS | Resistor | 0603
652-CR0805JW-271ELF | 100 | Thick Film Resistors - SMD 270ohm 5% | Resistor | 0805
652-CRT0805FZ1002ELF | 100 | Thin Film Resistors - SMD 1/8watts 10K 1% | Resistor | 0805
652-3306F-1-253 | 6 | Trimmer Resistors - Through Hole 25K 25% 6mm Single Turn | Resistor | POT-6MM
72-T93YA-50K | 3 | Trimmer Resistors - Through Hole 3/8" SQ V/ADJ 50K, 19 TURN | Resistor
81-CSTLS16M0X51-A0 | 13 | Resonators 16MHz 5% | Resonator | RESON_3PIN
546-1551ATS100 | 1 | Racks & Rack Cabinet Accessories #2 S-TAP SCREW 100PK | Screw
575-199328 | 6 | IC & Component Sockets 28P TIN PIN TIN CONT | Socket
517-4828-3004-CP | 6 | IC & Component Sockets SOCKET 28POS .3" IC OPEN FRAME | Socket
688-SKQUCA | 4 | Multi-Directional Switches 4-direction 160gf w/ 320gf cntr push | Switch
653-B3F-1022 | 6 | Tactile Switches 6X6 Flat 5mm Btn Force 150g w/Grd | Switch
685-EX330 | 1 | Digital Multimeters MINI DMM WITH TEMP & NON CONTACT VOLTAG | TestEqt
667-ERT-J1VG103JA | 10 | Thermistors - NTC 10KOhms 5% THERMISTOR NTC | Thermistor | 0603
667-ERT-JZEG103JA | 3 | Thermistors - NTC 10KOhms 5% THERMISTOR NTC | Thermistor | 0201
610-MJE13005 | 6 | Transistors Bipolar - BJT NPN Fast SW | Transistor | TO-220
512-SS8050CBU | 25 | Transistors Bipolar - BJT NPN/40V/1.5A | Transistor | TO-92
512-1N5228B | 3 | Zener Diodes 3.9V 0.5W Zener | Zener | DO-35
512-1N5239B | 3 | Zener Diodes 9.1V 0.5W Zener | Zener | DO-35
