land-boards/lb-boards/Hardware/Inventory/Mouser_All-LandBoards-Parts_May24_0422PM.xls

ALL-LANDBOARDS-PARTS
Mouser # | Mfr. # | Manufacturer | Customer # | Description | RoHS | Lifecycle | Order Qty. | Price (USD) | Ext.: (USD)
926-LMR62014XMFENOPB | LMR62014XMFE/NOPB | Texas Instruments |  | Switching Voltage Regulators 20VOUT,1A SIMPLE SW NANO STEP-UP REG | RoHS Compliant |  | 1 | $1.15 | $1.15
584-ADR3440ARJZ-R7 | ADR3440ARJZ-R7 | Analog Devices Inc. | VREG4096 | Voltage References 4.096V 0.60um CMOS 10ppm/C Voltage REF | RoHS Compliant |  | 1 | $2.87 | $2.87
895-FT230XS-R | FT230XS-R | FTDI | USB-Console | USB Interface IC USB to Basic Serial UART IC SSOP-16 | RoHS Compliant |  | 1 | $2.26 | $2.26
798-UX60SC-MB-5ST80 | UX60SC-MB-5ST(80) | Hirose Electric | RPI-Console-usb | USB Connectors MINI B RECEPT RA SMT BTTM MNT | RoHS Compliant |  | 1 | $0.75 | $0.75
652-TC33X-2-102E | TC33X-2-102E | Bourns |  | Trimmer Resistors - SMD 3MM 1KOHMS 25% 0.1WATT OPEN FRM | RoHS Compliant By Exemption |  | 1 | $0.28 | $0.28
595-TXS0108EPWR | TXS0108EPWR | Texas Instruments |  | Translation - Voltage Levels 8B Bidir Vltg-Level Translator | RoHS Compliant |  | 1 | $1.57 | $1.57
859-4N25M | 4N25M | Lite-On |  | Transistor Output Optocouplers PTR 20%, 2.5KV | RoHS Compliant |  | 1 | $0.47 | $0.47
660-RK73Z2ATTD | RK73Z2ATTD | KOA Speer |  | Thick Film Resistors - SMD ZEROohms JUMPER | RoHS Compliant By Exemption |  | 1 | $0.10 | $0.10
603-RC0805FR-079K09L | RC0805FR-079K09L | YAGEO |  | Thick Film Resistors - SMD 9.09 kOhms 125 mW 0805 1% | RoHS Compliant By Exemption |  | 1 | $0.10 | $0.10
603-RC0805FR-0782KL | RC0805FR-0782KL | YAGEO |  | Thick Film Resistors - SMD 82 kOhms 125 mW 0805 1% | RoHS Compliant By Exemption |  | 1 | $0.10 | $0.10
603-RC0805JR-0733KL | RC0805JR-0733KL | YAGEO |  | Thick Film Resistors - SMD 33 kOhms 125 mW 0805 5% | RoHS Compliant By Exemption |  | 1 | $0.10 | $0.10
603-RC0805FR-07249RL | RC0805FR-07249RL | YAGEO |  | Thick Film Resistors - SMD 249 Ohms 125 mW 0805 1% | RoHS Compliant By Exemption |  | 1 | $0.10 | $0.10
603-RC0805FR-07162KL | RC0805FR-07162KL | YAGEO |  | Thick Film Resistors - SMD 162 kOhms 125 mW 0805 1% | RoHS Compliant By Exemption |  | 1 | $0.10 | $0.10
660-RK73B2ATTD472J | RK73B2ATTD472J | KOA Speer |  | Thick Film Resistors - SMD 1/4watts 4.7Kohms 5% | RoHS Compliant By Exemption |  | 1 | $0.10 | $0.10
660-RK73H2ATTD3740F | RK73H2ATTD3740F | KOA Speer |  | Thick Film Resistors - SMD 1/4W 374 OHM 1% | RoHS Compliant By Exemption |  | 1 | $0.10 | $0.10
660-RK73B2ATTD331J | RK73B2ATTD331J | KOA Speer |  | Thick Film Resistors - SMD 1/4watts 330ohms 5% | RoHS Compliant By Exemption |  | 1 | $0.10 | $0.10
660-RK73B2ATTD392J | RK73B2ATTD392J | KOA Speer |  | Thick Film Resistors - SMD 1/4watts 3.9Kohms 5% | RoHS Compliant By Exemption |  | 1 | $0.10 | $0.10
660-RK73B2ATTD241J | RK73B2ATTD241J | KOA Speer |  | Thick Film Resistors - SMD 1/4watts 240ohms 5% | RoHS Compliant By Exemption |  | 1 | $0.10 | $0.10
660-RK73B2ATTD222J | RK73B2ATTD222J | KOA Speer |  | Thick Film Resistors - SMD 1/4watts 2.2Kohms 5% | RoHS Compliant By Exemption |  | 1 | $0.10 | $0.10
660-RK73B2ATTD103J | RK73B2ATTD103J | KOA Speer |  | Thick Film Resistors - SMD 1/4watts 10Kohms 5% | RoHS Compliant By Exemption |  | 1 | $0.10 | $0.10
660-RK73H2ATTE3091F | RK73H2ATTE3091F | KOA Speer |  | Thick Film Resistors - SMD 1/4W 3.09K OHM 1% | RoHS Compliant By Exemption |  | 1 | $0.10 | $0.10
595-PCA9544APWR | PCA9544APWR | Texas Instruments |  | Switch ICs - Various 4-Ch I2C & SMBus Multiplexer | RoHS Compliant |  | 1 | $2.40 | $2.40
859-LTST-C170KRKT | LTST-C170KRKT | Lite-On |  | Standard LEDs - SMD Red Clear 631nm | RoHS Compliant |  | 1 | $0.31 | $0.31
577-HS-4787 | HS-4787 | Techspray |  | Soldering Irons SOLDERING TIP | Not Applicable |  | 1 | $7.01 | $7.01
577-HS-4786 | HS-4786 | Techspray |  | Soldering Irons SOLDERING TIP | RoHS Compliant |  | 1 | $7.01 | $7.01
577-HS-2751 | HS-2751 | Techspray |  | Soldering Irons SOLDERING TIP | Not Applicable |  | 1 | $6.20 | $6.20
533-0186 | 83-1000-0186 | Kester |  | Soldering Flux #186 RMA FLUX PEN | RoHS Compliant |  | 1 | $11.32 | $11.32
910-SMD291SNL | SMD291SNL | Chip Quik |  | Solder Solder Paste 15g | RoHS Compliant |  | 1 | $15.29 | $15.29
738-13368 | 13368 | AIM - American Iron and Metal |  | Solder Sn63/Pb37 GLOWCORE2% .015 DIA 1/2 lb. | No |  | 1 | $65.94 | $65.94
738-14048 | 14048 | AIM - American Iron and Metal |  | Solder SAC305 GLOWCORE 2.5% .032 DIA 1 lb. | RoHS Compliant |  | 1 | $62.16 | $62.16
577-1809-25F | 1809-25F | Techspray |  | Desoldering Braid / Solder Removal PROWICK .055in WIDTH YELLOW 25ft LENTH A | RoHS Compliant |  | 1 | $17.38 | $17.38
577-1808-10F | 1808-10F | Techspray |  | Desoldering Braid / Solder Removal PROWICK .035in WIDTH WHITE 10ft LENTH AS | RoHS Compliant |  | 1 | $7.77 | $7.77
511-BAT20JFILM | BAT20JFILM | STMicroelectronics |  | Schottky Diodes & Rectifiers RECTIFIER | RoHS Compliant |  | 1 | $0.42 | $0.42
863-MBR0520LT1G | MBR0520LT1G | onsemi |  | Schottky Diodes & Rectifiers 0.5A 20V | RoHS Compliant |  | 1 | $0.36 | $0.36
523-31-5431-10RFX | 031-5431-10RFX | Amphenol |  | RF Connectors / Coaxial Connectors PC R/A BLHD JCK Ni WHITE HOUSING | RoHS Compliant By Exemption |  | 1 | $3.45 | $3.45
81-CSTLS16M0X53-B0 | CSTLS16M0X53-B0 | Murata | SCREWDUINO | Resonators 16.0 MHZ 5 % 15PF | RoHS Compliant By Exemption |  | 1 | $0.33 | $0.33
652-4610X-1LF-330 | 4610X-101-331LF | Bourns |  | Resistor Networks & Arrays 10pins 330 OHMS Bussed | RoHS Compliant By Exemption |  | 1 | $0.46 | $0.46
71-CSC10A014K70GEK | CSC10A014K70GEK | Vishay |  | Resistor Networks & Arrays 10pin 4.7Kohms 2% Bussed | RoHS Compliant By Exemption |  | 1 | $2.23 | $2.23
504-PTS12066V100 | PTS12066V100 | Eaton |  | Resettable Fuses - PPTC PPTC 1206 6V 1.0A SMD | RoHS Compliant |  | 1 | $0.19 | $0.19
652-MFR900 | MF-R900 | Bourns | 3D_Printer | Resettable Fuses - PPTC 30V 9.0A-HD 40A MAX | RoHS Compliant |  | 1 | $0.92 | $0.92
583-1N4004-T | 1N4004-T | Rectron |  | Rectifiers Vr/400V Io/1A T/R | RoHS Compliant By Exemption |  | 1 | $0.21 | $0.21
726-BTS117BKSA1 | BTS117BKSA1 | Infineon |  | Power Switch ICs - Power Distribution HITFET | RoHS Compliant By Exemption | End of Life | 1 | $3.23 | $3.23
595-LM324ADR | LM324ADR | Texas Instruments |  | Operational Amplifiers - Op Amps Quad GP Op Amp | RoHS Compliant |  | 1 | $0.49 | $0.49
579-MCP6004-I/SL | MCP6004-I/SL | Microchip |  | Operational Amplifiers - Op Amps Quad 1.8V 1MHz | RoHS Compliant |  | 1 | $0.58 | $0.58
511-LM358DT | LM358DT | STMicroelectronics |  | Operational Amplifiers - Op Amps Dual Low Power | RoHS Compliant |  | 1 | $0.54 | $0.54
579-MCP6002-I/SN | MCP6002-I/SN | Microchip |  | Operational Amplifiers - Op Amps Dual 1.8V 1MHz | RoHS Compliant |  | 1 | $0.44 | $0.44
80-C0805C473K5R | C0805C473K5RACTU | KEMET |  | Multilayer Ceramic Capacitors MLCC - SMD/SMT 50V 0.047uF X7R 0805 10% | RoHS Compliant |  | 1 | $0.25 | $0.25
80-C0805C104K5R | C0805C104K5RACTU | KEMET |  | Multilayer Ceramic Capacitors MLCC - SMD/SMT 50V 0.1uF X7R 0805 10% | RoHS Compliant |  | 1 | $0.13 | $0.13
80-C0805C105Z4V | C0805C105Z4VACTU | KEMET |  | Multilayer Ceramic Capacitors MLCC - SMD/SMT 16V 1uF Y5V 0805 -20%,+80% | RoHS Compliant |  | 1 | $0.11 | $0.11
77-VJ1206V106ZXQTBC | VJ1206V106ZXQTW1BC | Vishay |  | Multilayer Ceramic Capacitors MLCC - SMD/SMT 1206 10uF 10volts Y5V +80-20% | RoHS Compliant |  | 1 | $0.64 | $0.64
77-VJ0805Y681JXXCBC | VJ0805Y681JXXCW1BC | Vishay |  | Multilayer Ceramic Capacitors MLCC - SMD/SMT 0805 680pF 25volts X7R 5% | RoHS Compliant |  | 1 | $0.34 | $0.34
75-1C10Z5U104M050B | 1C10Z5U104M050B | Vishay |  | Multilayer Ceramic Capacitors MLCC - Leaded 0.1uF 50volts Z5U 20% 2.5mm L/S | RoHS Compliant By Exemption |  | 1 | $0.36 | $0.36
594-K104K15X7RF5UH5 | K104K15X7RF5UH5 | Vishay |  | Multilayer Ceramic Capacitors MLCC - Leaded .1uF 50volts 10% 5.0mm X7R | RoHS Compliant |  | 1 | $0.26 | $0.26
81-RDER71H104K0P1H3B | RDER71H104K0P1H03B | Murata |  | Multilayer Ceramic Capacitors MLCC - Leaded .1UF 50V 10% 2.54MM | RoHS Compliant |  | 1 | $0.50 | $0.50
771-PMV48XP215 | PMV48XP,215 | Nexperia |  | MOSFET P-CH -20 V -3.5 A | RoHS Compliant |  | 1 | $0.48 | $0.48
603-MFR-25FRF5210K | MFR-25FRF52-10K | YAGEO |  | Metal Film Resistors - Through Hole 10 kOhms 250 mW 1% 100 PPM / C | RoHS Compliant |  | 1 | $0.12 | $0.12
771-PCA9685PW,112 | PCA9685PW,112 | NXP |  | LED Display Drivers I2C Bus LED Controller 28-Pin | RoHS Compliant |  | 1 | $2.97 | $2.97
926-LM2936MP30NOPB | LM2936MP-3.0/NOPB | Texas Instruments |  | LDO Voltage Regulators Ultra-Lo Quiescent Current LDO Vtg Reg | RoHS Compliant |  | 1 | $2.67 | $2.67
595-SN74AC14DR | SN74AC14DR | Texas Instruments | COAX TESTER | Inverters Hex Schmitt-Trigger | RoHS Compliant |  | 1 | $0.56 | $0.56
579-MCP23008T-E/SO | MCP23008T-E/SO | Microchip | SOIC-18 | Interface - I/O Expanders In/Out I2C int | RoHS Compliant |  | 1 | $1.38 | $1.38
579-MCP23008-E/P | MCP23008-E/P | Microchip | PDIP-18 | Interface - I/O Expanders In/Out I2C int | RoHS Compliant |  | 1 | $1.55 | $1.55
579-MCP23017-E/SP | MCP23017-E/SP | Microchip | ODAS-23017 | Interface - I/O Expanders 16bit Input/Output Exp I2C interface | RoHS Compliant |  | 1 | $1.70 | $1.70
649-DILB8P223TLF | DILB8P-223TLF | FCI / Amphenol |  | IC & Component Sockets 8P IC SOCKET | RoHS Compliant |  | 1 | $0.22 | $0.22
801-R30G-0100 | R30G-0100 | Jonard Industries |  | Hook-up Wire WIRE 30 AWG GREEN 100 FT | RoHS Compliant |  | 1 | $14.95 | $14.95
652-PEC12R-4120F-S12 | PEC12R-4120F-S0012 | Bourns |  | Encoders HORZ 12DET 12PULSE 20mm SHAFT SPST SW | RoHS Compliant By Exemption |  | 1 | $2.04 | $2.04
546-1591LS-BK | 1591LSBK | Hammond |  | Enclosures, Boxes, & Cases ABS, Economical Type 3.3x2.2x1.4" Black | RoHS Compliant |  | 1 | $5.04 | $5.04
698-CAT24C32WI-GT3 | CAT24C32WI-GT3 | onsemi |  | EEPROM 32K-Bit I2C Serial EEPROM | RoHS Compliant |  | 1 | $0.31 | $0.31
579-24LC024-I/P | 24LC024-I/P | Microchip | ODAS EEPROM | EEPROM 256x8 | RoHS Compliant |  | 1 | $0.46 | $0.46
698-CAT24C256WI-GT3 | CAT24C256WI-GT3 | onsemi | BBB-EEPROM | EEPROM 256kb I2C Serial CMOS EEPROM | RoHS Compliant |  | 1 | $0.41 | $0.41
579-MCP4231-103-E/P | MCP4231-103E/P | Microchip |  | Digital Potentiometer ICs Dual 7B V SPI POT | RoHS Compliant |  | 1 | $1.30 | $1.30
579-MCP4151-103E/SN | MCP4151-103E/SN | Microchip |  | Digital Potentiometer ICs Digital Pot 256 step SPI dual Ch | RoHS Compliant |  | 1 | $1.21 | $1.21
727-CY8CKIT-059 | CY8CKIT-059 | Cypress Semiconductor |  | Development Boards & Kits - ARM CY8CKIT-059 PSoC 5LP Dev Kit | RoHS Compliant |  | 1 | $14.66 | $14.66
806-K22X-B25P-N | K22X-B25P-N | Kycon |  | D-Sub Standard Connectors D25 M 318FP-GR BRKT | RoHS Compliant By Exemption |  | 1 | $4.16 | $4.16
649-ID25S33E4GX00LF | ID25S33E4GX00LF | FCI / Amphenol | DB-25F | D-Sub Standard Connectors D-SUB 25 POSITION | RoHS Compliant |  | 1 | $1.76 | $1.76
652-CRA2512FZ-R50ELF | CRA2512-FZ-R050ELF | Bourns |  | Current Sense Resistors - SMD 0.050ohms 1% | RoHS Compliant |  | 1 | $0.48 | $0.48
579-TCN75AVUA | TCN75AVUA | Microchip |  | Board Mount Temperature Sensors 2-Wire SER Temp Sens/Ther Mon | RoHS Compliant |  | 1 | $0.90 | $0.90
863-MMBT3904LT1G | MMBT3904LT1G | onsemi |  | Bipolar Transistors - BJT NPN GENERAL PURPOSE | RoHS Compliant |  | 1 | $0.16 | $0.16
579-MCP73831T-2ACIOT | MCP73831T-2ACI/OT | Microchip |  | Battery Management Charge mgnt contr | RoHS Compliant |  | 1 | $0.77 | $0.77
727-CY8C5267AXILP051 | CY8C5267AXI-LP051 | Cypress Semiconductor |  | ARM Microcontrollers - MCU 5.50 V, PSoC 5 CapSense Plus | RoHS Compliant |  | 1 | $14.23 | $14.23
667-ECE-A1VKA100I | ECE-A1VKA100I | Panasonic |  | Aluminum Electrolytic Capacitors - Radial Leaded 35VDC 10uF SU | RoHS Compliant |  | 1 | $0.30 | $0.30
556-ATTINY85-20SU | ATTINY85-20SU | Microchip |  | 8-bit Microcontrollers - MCU AVR 8K FLSH 512B EE 512B SRAM ADC 5V | RoHS Compliant |  | 1 | $1.57 | $1.57
556-ATTINY85-20PU | ATTINY85-20PU | Microchip |  | 8-bit Microcontrollers - MCU 8kB Flash 0.512kB EEPROM 6 I/O Pins | RoHS Compliant |  | 1 | $1.74 | $1.74
556-ATMEGA328P-PU | ATMEGA328P-PU | Microchip |  | 8-bit Microcontrollers - MCU 32KB In-system Flash 20MHz 1.8V-5.5V | RoHS Compliant |  | 1 | $2.87 | $2.87
574-T42-1/C | T42-1/C | Vector |  | Circuit Board Hardware - PCB 100 PER PKG | RoHS Compliant |  | 1 | $12.12 | $12.12
595-CD74AC02E | CD74AC02E | Texas Instruments |  | Logic Gates Quad 2-Input NOR Gates | RoHS Compliant |  | 1 | $0.86 | $0.86
595-SN74AC08N | SN74AC08N | Texas Instruments |  | Logic Gates Quadruple 2-Input Positive-AND Gates | RoHS Compliant |  | 1 | $0.66 | $0.66
595-SN74LS123DR | SN74LS123DR | Texas Instruments |  | Monostable Multivibrator Dual retrig monostbl multivibrators | RoHS Compliant |  | 1 | $0.86 | $0.86
595-SN74AC14N | SN74AC14N | Texas Instruments |  | Inverters Hex Schmitt-Trigger | RoHS Compliant |  | 1 | $0.70 | $0.70
798-ZX62D-B-5PA830 | ZX62D-B-5PA8(30) | Hirose Electric | USB Micro | USB Connectors 5P RECEPTACLE | RoHS Compliant |  | 1 | $0.74 | $0.74
649-D37S13A4PA00LF | D37S13A4PA00LF | FCI / Amphenol | DB-37F | D-Sub Standard Connectors 37P SKT RA SOLDER SIZE C NO SCREWS | RoHS Compliant |  | 1 | $2.65 | $2.65
595-CD74HCT166E | CD74HCT166E | Texas Instruments |  | Counter Shift Registers 8-Bit Prl-In Srl-Out | RoHS Compliant |  | 1 | $0.62 | $0.62
815-ABL-11.0592-B2 | ABL-11.0592MHZ-B2 | ABRACON |  | Crystals CRYSTAL 11.0592MHZ 18PF T/H | RoHS Compliant |  | 1 | $0.32 | $0.32
156-3315-E | 156-3315-E | Kobiconn | VGA | D-Sub High Density Connectors HD D-SUB PCB R/A FM GOLD FLASH 15P BLK | RoHS Compliant |  | 1 | $1.69 | $1.69
559-FOXS160-20-LF | FOXSLF/160-20 | ABRACON |  | Crystals 16MHz 20pF | RoHS Compliant |  | 1 | $0.35 | $0.35
649-DC37P064HTXLF | DC37P064HTXLF | FCI / Amphenol | DB-37M | D-Sub Standard Connectors 37P PIN SOLDER BUCKET | RoHS Compliant |  | 1 | $2.29 | $2.29
603-CC805JRNPO9BN200 | CC0805JRNPO9BN200 | YAGEO |  | Multilayer Ceramic Capacitors MLCC - SMD/SMT 50 V 20 pF C0G 0805 5% | RoHS Compliant |  | 1 | $0.14 | $0.14
913-AS6C1008-55PCN | AS6C1008-55PCN | Alliance Memory | MULTICOMP | SRAM 1Mb, 2.7V-5.5V, 55ns 128K x 8 Asynch SRAM | RoHS Compliant |  | 1 | $3.99 | $3.99
571-3-1991253-7 | 3-1991253-7 | TE Connectivity |  | D-Sub Backshells 37 POS BCKSHL SIZE4 | RoHS Compliant |  | 1 | $2.79 | $2.79
512-FQP7P06 | FQP7P06 | onsemi |  | MOSFET 60V P-Channel QFET | RoHS Compliant |  | 1 | $1.56 | $1.56
546-1591BS-BK | 1591BSBK | Hammond |  | Enclosures, Boxes, & Cases ABS, Economical Type 4.4x2.4x1.1" Black | RoHS Compliant |  | 1 | $5.04 | $5.04
649-D25S33E4PA00LF | D25S33E4PA00LF | FCI / Amphenol | DB-25F | D-Sub Standard Connectors 25P SKT RA SOLDER SHELL SIZE B | RoHS Compliant |  | 1 | $1.42 | $1.42
667-ERJ-6ENF5103V | ERJ-6ENF5103V | Panasonic |  | Thick Film Resistors - SMD 0805 510Kohms 1% AEC-Q200 | RoHS Compliant By Exemption |  | 1 | $0.10 | $0.10
913-AS6C1008-55SIN | AS6C1008-55SIN | Alliance Memory | MULTICOMP | SRAM 1Mb, 2.7V-5.5V, 55ns 128K x 8 Asynch SRAM | RoHS Compliant |  | 1 | $3.21 | $3.21
727-CY8C4024AZI-S403 | CY8C4024AZI-S403 | Cypress Semiconductor | PSCO4 | ARM Microcontrollers - MCU PSoC4 | RoHS Compliant |  | 1 | $2.85 | $2.85
649-DC37P064TXLF | DC37P064TXLF | FCI / Amphenol | DigIO32-I2C | D-Sub Standard Connectors Solder bucket conn. 37 way Pin | RoHS Compliant |  | 1 | $2.18 | $2.18
685-EX330 | EX330 | Extech |  | Digital Multimeters Multimeter W/NCV, 4000 Ct Autoranging/Temp | RoHS Compliant |  | 1 | $59.99 | $59.99
660-CF1/4CT26A103J | CF1/4CT26A103J | KOA Speer |  | Carbon Film Resistors - Through Hole 10K ohm 5% | RoHS Compliant |  | 1 | $0.10 | $0.10
667-ERJ-6GEYJ102V | ERJ-6GEYJ102V | Panasonic |  | Thick Film Resistors - SMD 0805 1Kohms 5% AEC-Q200 | RoHS Compliant By Exemption |  | 1 | $0.12 | $0.12
738-13426 | 13426 | AIM - American Iron and Metal |  | Solder Sn63/Pb37 GLOWCORE2% .032 DIA. 1 lb. | No |  | 1 | $38.73 | $38.73
578-SM1 | SM1 | Apex Tool Group | Solder Stand | Soldering & Desoldering Stations Weller Solder-Mate Solder Dispenser | No |  | 1 | $14.10 | $14.10
590-824-1L | 824-1L | MG Chemicals | Isopropyl Al | Chemicals ISOPROPYL ALCOHOL 1L (1 QUART) LIQUID | RoHS Compliant |  | 1 | $12.03 | $12.03
863-LM317TG | LM317TG | onsemi | Adj Reg | Linear Voltage Regulators 1.5A ADJ 1.2-37V Positive | RoHS Compliant By Exemption |  | 1 | $0.87 | $0.87
652-4608X-2LF-330 | 4608X-102-331LF | Bourns | LED2 | Resistor Networks & Arrays 8pins 330 OHMS Isolated | RoHS Compliant By Exemption |  | 1 | $0.54 | $0.54
771-SA612AD01112 | SA612AD/01,112 | NXP | RF Mixer | RF Mixer LP VHF DBL-BAL W/OSC | RoHS Compliant |  | 1 | $3.35 | $3.35
844-IRF510PBF | IRF510PBF | Vishay | MOSFET | MOSFET 100V N-CH HEXFET D2-PAK | RoHS Compliant By Exemption |  | 1 | $1.17 | $1.17
512-BS170D75Z | BS170-D75Z | onsemi | MOSFET | MOSFET N-Ch Enhancement Mode Field Effect | RoHS Compliant |  | 1 | $0.42 | $0.42
71-CRCW0805-50 | CRCW080550R0FKTA | Vishay | Prec 50 Ohms | Thick Film Resistors - SMD 1/8watt 50ohms 1% Non Std Qt Req'd | No |  | 1 | $0.66 | $0.66
511-1N5711 | 1N5711 | STMicroelectronics | Schottky | Schottky Diodes & Rectifiers 15mA 70 Volt | RoHS Compliant By Exemption |  | 1 | $0.39 | $0.39
512-1N4148 | 1N4148 | onsemi | GP Diode | Diodes - General Purpose, Power, Switching 100V Io/200mA BULK | RoHS Compliant By Exemption |  | 1 | $0.10 | $0.10
647-UVR1V471MPD | UVR1V471MPD | Nichicon | Audio Amp | Aluminum Electrolytic Capacitors - Radial Leaded 35volts 470uF 10x16 20% 5LS | RoHS Compliant |  | 1 | $0.56 | $0.56
667-ECE-A1VKS100 | ECE-A1VKS100 | Panasonic | Audio Amp | Aluminum Electrolytic Capacitors - Radial Leaded 10UF 35V KS RADIAL | RoHS Compliant |  | 1 | $0.33 | $0.33
81-LQP02TN22NJ02D | LQP02TN22NJ02D | Murata | FM Filter | Fixed Inductors | RoHS Compliant |  | 1 | $0.11 | $0.11
609-L-14C27NJV4T | L-14C27NJV4T | Johanson | FM Filter | Fixed Inductors 27nH 5% | RoHS Compliant |  | 1 | $0.10 | $0.10
652-CE201210-R33J | CE201210-R33J | Bourns | FM Filter | Fixed Inductors 330nH 5% 1mm Multi Layer | RoHS Compliant |  | 1 | $0.14 | $0.14
652-CE201210-R18J | CE201210-R18J | Bourns | FM Filter | Fixed Inductors 180nH 5% 1mm Multi Layer | RoHS Compliant |  | 1 | $0.14 | $0.14
81-GRM39C111J50 | GRM1885C1H111JA01D | Murata | FM Filter | Multilayer Ceramic Capacitors MLCC - SMD/SMT PLEASE SEE MURATA'S SUGGESTED ALTERNATE GRM0335C1H111JA01D | RoHS Compliant |  | 1 | $0.15 | $0.15
710-885012006008 | 885012006008 | Wurth Elektronik | FM Filter | Multilayer Ceramic Capacitors MLCC - SMD/SMT WCAP-CSGP 100pF 0603 5% 10V MLCC | RoHS Compliant |  | 1 | $0.10 | $0.10
490-SJ1-3523N | SJ1-3523N | CUI Devices | 3.5mm Jack | Phone Connectors Audio Jacks | RoHS Compliant |  | 1 | $0.87 | $0.87
700-MAX11645EUA+ | MAX11645EUA+ | Maxim Integrated | A/D I2C | Analog to Digital Converters - ADC Low-Power, 1-/2-Channel, I C, 12-Bit ADCs | RoHS Compliant |  | 1 | $3.05 | $3.05
710-885012006052 | 885012006052 | Wurth Elektronik |  | Multilayer Ceramic Capacitors MLCC - SMD/SMT WCAP-CSGP 15pF 0603 5% 50V MLCC | RoHS Compliant |  | 1 | $0.10 | $0.10
728-FC4505-440-A | FC4505-440-A | Fascomp | Standoffs | Standoffs & Spacers 3/16 HEX 1/2" LNGTH ALUM 440 THREAD M/F | RoHS Compliant |  | 1 | $0.37 | $0.37
728-FC4513-440-A | FC4513-440-A | Fascomp | Standoffs | Standoffs & Spacers 3/16 HEX 1" LNGTH ALUM 440 THREAD M/F | RoHS Compliant |  | 1 | $0.82 | $0.82
728-FC4542-440-A | FC4542-440-A | Fascomp | Standoffs | Standoffs & Spacers 1/4 HEX 1" LNGTH ALUM 440 THREAD M/F | RoHS Compliant |  | 1 | $0.65 | $0.65
728-FC4536-632-A | FC4536-632-A | Fascomp | Standoffs | Standoffs & Spacers 1/4 HEX 5/8" LNGTH ALUM 632 THREAD M/F | RoHS Compliant |  | 1 | $0.47 | $0.47
728-FC4538-632-A | FC4538-632-A | Fascomp | Standoffs | Standoffs & Spacers 1/4 HEX 3/4" LNGTH ALUM 632 THREAD M/F | RoHS Compliant |  | 1 | $0.52 | $0.52
728-FC4542-632-A | FC4542-632-A | Fascomp | Standoffs | Standoffs & Spacers 1/4 HEX 1" LNGTH ALUM 632 THREAD M/F | RoHS Compliant |  | 1 | $0.65 | $0.65
700-MAX31855KASA+ | MAX31855KASA+ | Maxim Integrated |  | Sensor Interface Cold-Junction Compensated Thermocouple-to-Digital Converter | RoHS Compliant |  | 1 | $9.71 | $9.71
523-GMC020080HR | GMC020080HR | Amphenol |  | Memory Card Connectors 2 In 1 Connector Sd+mmc |  |  | 1 | $1.39 | $1.39
512-FQP30N06L | FQP30N06L | onsemi |  | MOSFET 60V N-Channel QFET Logic Level | RoHS Compliant By Exemption |  | 1 | $1.97 | $1.97
653-G6L-1P-DC12 | G6L-1P-DC12 | Omron |  | Low Signal Relays - PCB LO PROF SPST 12VDC | RoHS Compliant |  | 1 | $3.18 | $3.18
649-D37P33E4GX00LF | D37P33E4GX00LF | FCI / Amphenol | DB-37M | D-Sub Standard Connectors SIGNAL 37 WAY PIN RT ANGLE | RoHS Compliant By Exemption |  | 1 | $2.63 | $2.63
649-D37S33E4GV00LF | D37S33E4GV00LF | FCI / Amphenol | DB-37F | D-Sub Standard Connectors 37P SKT RA SOLDER SHELL SIZE C | RoHS Compliant By Exemption |  | 1 | $2.79 | $2.79
649-D25P13B4PA00LF | D25P13B4PA00LF | FCI / Amphenol | DB-25M | D-Sub Standard Connectors 25P PIN RA SOLDER SH SZ B EU STAND | RoHS Compliant |  | 1 | $1.89 | $1.89
603-RC0805FR-0720KL | RC0805FR-0720KL | YAGEO | OPTOFAST/USB | Thick Film Resistors - SMD 20 kOhms 125 mW 0805 1% | RoHS Compliant By Exemption |  | 1 | $0.13 | $0.13
667-ERJ-6GEYJ122V | ERJ-6GEYJ122V | Panasonic | OPTOFAST/USB | Thick Film Resistors - SMD 0805 1.2Kohms 5% AEC-Q200 | RoHS Compliant By Exemption |  | 1 | $0.12 | $0.12
603-RC0805FR-07150RL | RC0805FR-07150RL | YAGEO | OPTOFAST/USB | Thick Film Resistors - SMD 150 Ohms 125 mW 0805 1% | RoHS Compliant By Exemption |  | 1 | $0.10 | $0.10
595-ULN2003ADR | ULN2003ADR | Texas Instruments | RELAY-DRV | Darlington Transistors Darlington | RoHS Compliant |  | 1 | $0.56 | $0.56
603-RC0805FR-07200RL | RC0805FR-07200RL | YAGEO |  | Thick Film Resistors - SMD 200 Ohms 125 mW 0805 1% | RoHS Compliant By Exemption |  | 1 | $0.10 | $0.10
568-NYS354 | NYS354 | Neutrik | RCA_BLK | RCA Phono Connectors SHIELDED RIGHT ANGLE REAN | RoHS Compliant |  | 1 | $0.69 | $0.69
579-24LC024T-I/SN | 24LC024T-I/SN | Microchip | ODAS_EEP_SMT | EEPROM 256x8 | RoHS Compliant |  | 1 | $0.35 | $0.35
667-ERJ-6GEYJ220V | ERJ-6GEYJ220V | Panasonic | USB_RES | Thick Film Resistors - SMD 0805 22ohms 5% AEC-Q200 | RoHS Compliant By Exemption |  | 1 | $0.12 | $0.12
490-RCJ-014 | RCJ-014 | CUI Devices | RCA_YEL | RCA Phono Connectors RCA Connectors | RoHS Compliant |  | 1 | $0.95 | $0.95
565-4408 | 4408/POM | Pomona | CableRack | Test Accessories - Other TEST LEAD HOLDER FOR WIRES UP TO .320IN DIA. | RoHS Compliant |  | 1 | $20.80 | $20.80
577-1811-25F | 1811-25F | Techspray |  | Desoldering Braid / Solder Removal PROWICK .098in WIDTH BLUE 25ft LENGTH AS | RoHS Compliant |  | 1 | $19.39 | $19.39
556-ATTINY10-TSHR | ATTINY10-TSHR | Microchip |  | 8-bit Microcontrollers - MCU 12MHz, Indust. Temp | RoHS Compliant |  | 1 | $0.46 | $0.46
621-AP2191DWG-7 | AP2191DWG-7 | Diodes Incorporated |  | Power Switch ICs - Power Distribution 1.5A Single Ch USB 2.0 Switch 2.7V-5.5V | RoHS Compliant |  | 1 | $0.44 | $0.44
584-LT1813CS8#PBF | LT1813CS8#PBF | Analog Devices Inc. |  | High Speed Operational Amplifiers Dual 100MHz 3.6mA OA | RoHS Compliant |  | 1 | $3.23 | $3.23
511-TDA7850 | TDA7850 | STMicroelectronics |  | Audio Amplifiers 4 x 50 W MOSFET Quad Bridge Pwr Amplifier | RoHS Compliant |  | 1 | $11.41 | $11.41
870-61WV5128EDBLL10T | IS61WV5128EDBLL-10TLI | ISSI |  | SRAM 4Mb 2.4-3.6V 10ns 512x8 Async SRAM | RoHS Compliant |  | 1 | $4.41 | $4.41
530-105-0752-1 | 105-0752-001 | Cinch Connectivity Solutions |  | Test Plugs & Test Jacks TEST JACK RED | RoHS Compliant |  | 1 | $1.48 | $1.48
530-10507531 | 105-0753-001 | Cinch Connectivity Solutions |  | Test Plugs & Test Jacks TEST JACK BLACK | RoHS Compliant |  | 1 | $1.45 | $1.45
161-2206 | 161-2206 | Kobiconn |  | Circular DIN Connectors MINI DIN PCB 6 PIN | No |  | 1 | $1.55 | $1.55
584-LTC3569EFE#PBF | LTC3569EFE#PBF | Analog Devices Inc. |  | Switching Voltage Regulators Programmable 1.2A and 2X600mA, Triple Buck Regulator | RoHS Compliant |  | 1 | $8.61 | $8.61
511-STM32L152C-DISCO | STM32L152C-DISCO | STMicroelectronics |  | Development Boards & Kits - ARM STM32L152RCT6 MCU Discovery Kit Board | RoHS Compliant |  | 1 | $12.38 | $12.38
71-CRCW080510K0JNEAC | CRCW080510K0JNEAC | Vishay |  | Thick Film Resistors - SMD 1/8Watt 10Kohms 5% Commercial Use | RoHS Compliant By Exemption |  | 1 | $0.10 | $0.10
842-ICE40HX1KSTICKEV | ICE40HX1K-STICK-EVN | Lattice |  | Programmable Logic IC Development Tools iCE40-HX1K iCEstick Eval Board | RoHS Compliant |  | 1 | $49.49 | $49.49
424-410-328-35 | 410-328-35 | Digilent |  | Programmable Logic IC Development Tools Cmod A7-35T | RoHS Compliant |  | 1 | $89.00 | $89.00
771-MMBT3904VL | MMBT3904VL | Nexperia |  | Bipolar Transistors - BJT TRANS BIPOLAR | RoHS Compliant |  | 1 | $0.11 | $0.11
649-DILB40P223TLF | DILB40P-223TLF | FCI / Amphenol |  | IC & Component Sockets 40P DIP SOCKET STAMPED AND FORMED | RoHS Compliant |  | 1 | $0.78 | $0.78
701-SP3232EEN-L/TR | SP3232EEN-L/TR | MaxLinear |  | RS-232 Interface IC TRUE +3V-+5.5V RS-232 | RoHS Compliant |  | 1 | $1.42 | $1.42
490-UJ2-BH-1-TH | UJ2-BH-1-TH | CUI Devices |  | USB Connectors USB 2.0 type B jack 4 pin Horizontal TH | RoHS Compliant |  | 1 | $0.62 | $0.62
913-AS6C4008-55PCN | AS6C4008-55PCN | Alliance Memory |  | SRAM 4M, 2.7-5.5V, 55ns 512K x 8 Asynch SRAM | RoHS Compliant |  | 1 | $6.38 | $6.38
815-AB38T-32.768KHZ | AB38T-32.768KHZ | ABRACON |  | Crystals 32.768K HZ 12.5PF 30000 OHM | RoHS Compliant |  | 1 | $0.22 | $0.22
534-103 | 103 | Keystone Electronics |  | Coin Cell Battery Holders TH COIN CELL BATTERY HOLDER 20mm | RoHS Compliant |  | 1 | $1.82 | $1.82
649-DILB32P223TLF | DILB32P-223TLF | FCI / Amphenol |  | IC & Component Sockets SOCKETS DIP | RoHS Compliant |  | 1 | $0.75 | $0.75
692-Z84C0010PEG | Z84C0010PEG | ZiLOG |  | Microprocessors - MPU 10MHz CMOS CPU XTEMP | RoHS Compliant |  | 1 | $9.00 | $9.00
870-62WV102EBLL45TLI | IS62WV10248EBLL-45TLI | ISSI |  | SRAM 8Mb LowPwr/Pwr Saver Async 1Mbx8 45ns | RoHS Compliant |  | 1 | $6.28 | $6.28
955-W65C816S6TQG-14 | W65C816S6TQG-14 | Western Design Center (WDC) |  | Microprocessors - MPU 16-bit MPU 44 Pin QFP package | RoHS Compliant |  | 1 | $11.35 | $11.35
710-629105150521 | 629105150521 | Wurth Elektronik |  | USB Connectors WR-COM USB Micro SMT Type B Horiztl | RoHS Compliant |  | 1 | $2.21 | $2.21
649-D09S33E4PA00LF | D09S33E4PA00LF | FCI / Amphenol |  | D-Sub Standard Connectors 9P RA SOCKET SOLDER SHELL SIZE E | RoHS Compliant |  | 1 | $1.05 | $1.05
649-D09P13B4PA00LF | D09P13B4PA00LF | FCI / Amphenol |  | D-Sub Standard Connectors 9P RA PIN SOLDER SHELL SZ E EU STAND | RoHS Compliant |  | 1 | $1.12 | $1.12
875-HZ0805E601R-10 | HZ0805E601R-10 | Laird Performance Materials |  | Ferrite Beads 600ohms 100MHz .5A Monolithic 0805 SMD | RoHS Compliant |  | 1 | $0.10 | $0.10
523-12401610E4#2A | 12401610E4#2A | Amphenol |  | USB Connectors USB TYPE C RCPT R/A SMT TOP MOUNT | RoHS Compliant |  | 1 | $1.72 | $1.72
595-LP2985-33DBVR | LP2985-33DBVR | Texas Instruments |  | LDO Voltage Regulators 150-mA Low-Noise 1.5% tolerance | RoHS Compliant |  | 1 | $0.58 | $0.58
595-TXS0104EDR | TXS0104EDR | Texas Instruments |  | Translation - Voltage Levels 4B Bidirec Vltg- Level Translator | RoHS Compliant |  | 1 | $1.28 | $1.28
587-634-015-274-906 | 634-015-274-906 | EDAC |  | D-Sub High Density Connectors 15P VIDEO D-SUB RIGHT ANGLE BLUE | No |  | 1 | $1.70 | $1.70
863-2N3055G | 2N3055G | onsemi |  | Bipolar Transistors - BJT NPN 15A 60V | RoHS Compliant By Exemption |  | 1 | $4.73 | $4.73
87062WV1288BLL55QLI | IS62WV1288BLL-55QLI | ISSI |  | SRAM 1Mb 128Kx8 55ns Async SRAM | RoHS Compliant |  | 1 | $2.29 | $2.29
728-FC4530-632-A | FC4530-632-A | Fascomp | Standoffs | Standoffs & Spacers 1/4 HEX 1/4" LNGTH ALUM 632 THREAD M/F | RoHS Compliant |  | 1 | $0.36 | $0.36
728-FC4540-632-A | FC4540-632-A | Fascomp | Standoffs | Standoffs & Spacers 1/4 HEX 7/8" LNGTH ALUM 632 THREAD M/F | RoHS Compliant |  | 1 | $0.57 | $0.57
652-CR0805FX-6800ELF | CR0805-FX-6800ELF | Bourns |  | Thick Film Resistors - SMD 680ohm 1% | RoHS Compliant By Exemption |  | 1 | $0.10 | $0.10
579-MCP23017-E/SS | MCP23017-E/SS | Microchip | SSOP-28 | Interface - I/O Expanders 16bit Input/Output Exp I2C interface | RoHS Compliant |  | 1 | $1.70 | $1.70
217-C9536XL-10VQG44C | XC9536XL-10VQG44C | Xilinx |  | CPLD - Complex Programmable Logic Devices 3.3V 36-mc CPLD | RoHS Compliant |  | 1 | $2.31 | $2.31
284-HS10-3.3F | HS10 3R3 F | Ohmite |  | Wirewound Resistors - Chassis Mount PWR RES 10W 3.3 1% | RoHS Compliant |  | 1 | $2.70 | $2.70
284-HS10-5J | HS10 5R J | Ohmite |  | Wirewound Resistors - Chassis Mount 10W 5 OHM 5% | RoHS Compliant |  | 1 | $3.72 | $3.72
511-LF50ABV | LF50ABV | STMicroelectronics |  | LDO Voltage Regulators 5.0V 0.5A Positive | RoHS Compliant By Exemption |  | 1 | $1.44 | $1.44
540-TRG22F2FBBNN | TRG22F2FBBNN | ZF Electronics |  | Rocker Switches SPST BLK 16A ON-OFF | RoHS Compliant |  | 1 | $1.94 | $1.94
553-F14X | F-14X | Triad Magnetics |  | Power Transformers POWER XFMR 6.3Vct@1.2A 115V CHASSIS MOUNT w/LEADS/F-14X 1 | RoHS Compliant |  | 1 | $12.87 | $12.87
576-0217010.MXP | 0217010.MXP | Littelfuse | DVM fuse | Cartridge Fuses 250 V 10A 5x20mm Fast Acting | RoHS Compliant |  | 1 | $0.44 | $0.44
579-24LC1026-I/P | 24LC1026-I/P | Microchip |  | EEPROM 1024K 128K X 8 2.5V SER EE 128 BYTE PAGE | RoHS Compliant |  | 1 | $4.54 | $4.54
583-1N5822-T | 1N5822-T | Rectron |  | Schottky Diodes & Rectifiers Vr/40V Io/3A T/R | RoHS Compliant By Exemption |  | 1 | $0.35 | $0.35
603-RC0805FR-072K32L | RC0805FR-072K32L | YAGEO |  | Thick Film Resistors - SMD 2.32 kOhms 125 mW 0805 1% | RoHS Compliant By Exemption |  | 1 | $0.10 | $0.10
603-RC0805FR-07845RL | RC0805FR-07845RL | YAGEO | VGA-RES | Thick Film Resistors - SMD 845 Ohms 125 mW 0805 1% | RoHS Compliant By Exemption |  | 1 | $0.10 | $0.10
611-PTS636SK43SMTRLF | PTS636 SK43 SMTR LFS | C&K Switches |  | Tactile Switches Tact 50mA 12VDC, 6.0x3.5, 4.3mm H, 250gf, G leads, No ground pin, Black Actuator | RoHS Compliant |  | 1 | $0.16 | $0.16
634-SI5351A-B-GT | SI5351A-B-GT | Skyworks |  | Clock Generators & Support Products I2C program, any-frequency, any-output, Xtal reference, 3-output LVCMOS clock generator | RoHS Compliant |  | 1 | $2.05 | $2.05
652-CR0805FX-4220ELF | CR0805-FX-4220ELF | Bourns | VGA-RES | Thick Film Resistors - SMD 422ohm 1% | RoHS Compliant By Exemption |  | 1 | $0.10 | $0.10
652-CR0805JW-153ELF | CR0805-JW-153ELF | Bourns |  | Thick Film Resistors - SMD 15K 5% | RoHS Compliant By Exemption |  | 1 | $0.10 | $0.10
660-RK73H2ATTD3300F | RK73H2ATTD3300F | KOA Speer |  | Thick Film Resistors - SMD 1/4W 330 OHM 1% | RoHS Compliant By Exemption |  | 1 | $0.10 | $0.10
709-LRS200-36 | LRS-200-36 | MEAN WELL |  | Switching Power Supplies 212.4W 36V 5.9A 115Vac or 230Vac | RoHS Compliant |  | 1 | $33.80 | $33.80
709-RS25-3.3 | RS-25-3.3 | MEAN WELL |  | Switching Power Supplies 19.8W 3.3V 6A | RoHS Compliant |  | 1 | $12.91 | $12.91
709-RS25-5 | RS-25-5 | MEAN WELL |  | Switching Power Supplies 25W 5V 5A | RoHS Compliant |  | 1 | $12.91 | $12.91
71-CRCW080518K0JNEA | CRCW080518K0JNEA | Vishay |  | Thick Film Resistors - SMD 1/8watt 18Kohms 5% | RoHS Compliant By Exemption |  | 1 | $0.10 | $0.10
710-860020375018 | 860020375018 | Wurth Elektronik |  | Aluminum Electrolytic Capacitors - Radial Leaded WCAP-ATG5 1200uF 16V 20% Radial | RoHS Compliant |  | 1 | $0.52 | $0.52
756-WH25-1R0JI | WH25-1R0JI | TT Electronics |  | Wirewound Resistors - Chassis Mount 1ohm 5% | RoHS Compliant |  | 1 | $4.77 | $4.77
804-39SF0407CPHE | SST39SF040-70-4C-PHE | Microchip |  | NOR Flash 512K X 8 70ns | RoHS Compliant |  | 1 | $2.24 | $2.24
806-KMDGX-6S-BS | KMDGX-6S-BS | Kycon |  | Circular DIN Connectors 6P R/A FULL SHIELD GOLD PLANTED | RoHS Compliant |  | 1 | $1.49 | $1.49
704-MCQ1V2012-1R0-R | MCQ1V2012-1R0-R | Eaton |  | Fixed Inductors Multi H Q,IND 1.0uH Q35 150mA 2PADS SMT | RoHS Compliant | New Product | 1 | $0.10 | $0.10
704-MCQ1V2012-1R2-R | MCQ1V2012-1R2-R | Eaton |  | Fixed Inductors Multi H Q, IND 1.2uH Q35 50mA 2PADS SMT | RoHS Compliant | New Product | 1 | $0.10 | $0.10
704-MCQ1V2012-1R5-R | MCQ1V2012-1R5-R | Eaton |  | Fixed Inductors Multi H Q, IND 1.5uH Q35 50mA 2PADS SMT | RoHS Compliant | New Product | 1 | $0.10 | $0.10
704-MCQ1V2012-1R8-R | MCQ1V2012-1R8-R | Eaton |  | Fixed Inductors Multi H Q, IND 1.8uH Q35 50mA 2PADS SMT | RoHS Compliant | New Product | 1 | $0.10 | $0.10
728-FC4503-440-A | FC4503-440-A | Fascomp | Standoffs | Standoffs & Spacers 3/16 HEX 3/8" LNGTH ALUM 440 THREAD M/F | RoHS Compliant |  | 1 | $0.36 | $0.36
728-FC4509-440-A | FC4509-440-A | Fascomp | Standoffs | Standoffs & Spacers 3/16 HEX 3/4" LNGTH ALUM 440 THREAD M/F | RoHS Compliant |  | 1 | $0.50 | $0.50
728-FC4546-632-A | FC4546-632-A | Fascomp | Standoffs | Standoffs & Spacers Male Female Standoff, 1/4" Hex X 1-1/4", 632 Thread, Aluminum | RoHS Compliant |  | 1 | $0.79 | $0.79
455-RG_174_/U | RG_174_/U | HUBER+SUHNER | COAX_50OHM | Coaxial Cables SOLD IN METERS | RoHS Compliant |  | 1 | $3.52 | $3.52
512-BS270D74Z | BS270-D74Z | onsemi | MOSFET | MOSFET N-Ch Enhancement Mode Field Effect | RoHS Compliant |  | 1 | $0.44 | $0.44
595-SN74HC4066DR | SN74HC4066DR | Texas Instruments | ANALOG_SW | Analog Switch ICs Quadruple Bilateral Analog Switches | RoHS Compliant |  | 1 | $0.62 | $0.62
579-MCP2221A-I/P | MCP2221A-I/P | Microchip | USB_SER | USB Interface IC USB 2.0 to I2C Converter with GPIO | RoHS Compliant |  | 1 | $3.22 | $3.22
704-MCQ1V2012-3R3-R | MCQ1V2012-3R3-R | Eaton | FILT_I_3.3UH | Fixed Inductors Multi H Q, IND 3.3uH Q35 50mA 2PADS SMT | RoHS Compliant | New Product | 1 | $0.10 | $0.10
511-L7805CV | L7805CV | STMicroelectronics | VREG_5V | Linear Voltage Regulators 5.0V 1.0A Positive | RoHS Compliant By Exemption |  | 1 | $0.69 | $0.69
791-0805B561K501CT | 0805B561K501CT | Walsin | FILT_C_560PF | Multilayer Ceramic Capacitors MLCC - SMD/SMT 560pF, +-10%, 500V | RoHS Compliant |  | 1 | $0.20 | $0.20
603-CC805JRNPOBBN151 | CC0805JRNPOBBN151 | YAGEO | FILT_C_150PF | Multilayer Ceramic Capacitors MLCC - SMD/SMT 500V 150pF C0G 0805 5% | RoHS Compliant |  | 1 | $0.18 | $0.18
603-CC0805JRBBN121 | CC0805JRNPOBBN121 | YAGEO | FILT_C_120PF | Multilayer Ceramic Capacitors MLCC - SMD/SMT 500V 120pF C0G 0805 5% | RoHS Compliant |  | 1 | $0.21 | $0.21
595-SN74HC138N | SN74HC138N | Texas Instruments |  | Encoders, Decoders, Multiplexers & Demultiplexers 3-to-8 Line Decoder | RoHS Compliant |  | 1 | $0.60 | $0.60
546-1591DTBU | 1591DTBU | Hammond |  | Enclosures, Boxes, & Cases Polycarbonate 5.9x3.2x1.8" IceBlue | RoHS Compliant |  | 1 | $12.89 | $12.89
454-W25Q32JVSSIQ | W25Q32JVSSIQ | Winbond |  | NOR Flash spiFlash, 32M-bit, 4Kb Uniform Sector | RoHS Compliant |  | 1 | $0.89 | $0.89
738-14054 | 14054 | AIM - American Iron and Metal | SOLD-FINE | Solder SAC305 GLOWCORE 2.5% .020 DIA 1 lb. | RoHS Compliant |  | 1 | $78.60 | $78.60
556-ATMEGA32U4-AU | ATMEGA32U4-AU | Microchip |  | 8-bit Microcontrollers - MCU AVR USB 32K FLASH INDUSTRIAL | RoHS Compliant |  | 1 | $5.51 | $5.51
667-ERT-J1VG103JA | ERT-J1VG103JA | Panasonic |  | NTC Thermistors 10KOhms 5% THERMISTOR NTC | RoHS Compliant |  | 1 | $0.19 | $0.19
77-VJ0805Y105MXQTBC | VJ0805Y105MXQTW1BC | Vishay |  | Multilayer Ceramic Capacitors MLCC - SMD/SMT 0805 1uF 10volts X7R 20% | RoHS Compliant |  | 1 | $0.30 | $0.30
652-CR0805JW-271ELF | CR0805-JW-271ELF | Bourns |  | Thick Film Resistors - SMD 270ohm 5% | RoHS Compliant By Exemption |  | 1 | $0.10 | $0.10
652-CRT0805FZ1002ELF | CRT0805-FZ-1002ELF | Bourns |  | Thin Film Resistors - SMD 1/8watts 10K 1% | RoHS Compliant |  | 1 | $0.17 | $0.17
559-FOX924B-27 | FOX924B-27 | ABRACON | TXC0_Si5351 | TCXO Oscillators 27.0MHz 3.3Volts -30C +85C | RoHS Compliant |  | 1 | $3.06 | $3.06
738-13977 | 13977 | AIM - American Iron and Metal |  | Solder Sn63/Pb37 GLOCOR2.5% .032 DIA 1 lb. | No |  | 1 | $34.07 | $34.07
771-NXB0108PWJ | NXB0108PWJ | Nexperia |  | Translation - Voltage Levels TRANSLATION-VOLTAGE LEVELS | RoHS Compliant | New Product | 1 | $1.01 | $1.01
595-TXS0104ED | TXS0104ED | Texas Instruments |  | Translation - Voltage Levels 4B Bidirec Vltg- Level Translator | RoHS Compliant |  | 1 | $1.53 | $1.53
771-PCA9548AD-T | PCA9548AD,118 | NXP |  | Multiplexer Switch ICs 8-CH I2C SWITCH W/RESET | RoHS Compliant |  | 1 | $2.66 | $2.66
771-PCA9544APW-T | PCA9544APW,118 | NXP |  | Multiplexer Switch ICs 4-CH I2C MUX W/INTERRUPT | RoHS Compliant |  | 1 | $2.59 | $2.59
755-RN771VTE-17 | RN771VTE-17 | ROHM Semiconductor | PIN_DIODE | PIN Diodes DIODE PIN SWITCH 50V 2PIN UMD | RoHS Compliant |  | 1 | $0.36 | $0.36
710-885012007061 | 885012007061 | Wurth Elektronik | CP_OSC | Multilayer Ceramic Capacitors MLCC - SMD/SMT WCAP-CSGP 470pF 0805 5% 50V MLCC | RoHS Compliant |  | 1 | $0.10 | $0.10
926-LM380N/NOPB | LM380N/NOPB | Texas Instruments | AudioAmp | Audio Amplifiers 2.5W AUDIO POWER AMP | RoHS Compliant |  | 1 | $2.16 | $2.16
80-ESK477M035AH2AA | ESK477M035AH2AA | KEMET |  | Aluminum Electrolytic Capacitors - Radial Leaded 35V 470uF 85C 2k Hour Radial | RoHS Compliant |  | 1 | $0.58 | $0.58
926-LM386N-4/NOPB | LM386N-4/NOPB | Texas Instruments |  | Audio Amplifiers LOW VLTG AUDIO PWR AMP | RoHS Compliant |  | 1 | $1.49 | $1.49
595-NE5534AP | NE5534AP | Texas Instruments |  | Operational Amplifiers - Op Amps Low Noise | RoHS Compliant |  | 1 | $1.32 | $1.32
579-24LC024/P | 24LC024/P | Microchip |  | EEPROM 256x8 | RoHS Compliant |  | 1 | $0.46 | $0.46
603-AC1206FR-07249RL | AC1206FR-07249RL | YAGEO | ATTEN_20DB | Thick Film Resistors - SMD 249Ohms 1/4W 1206 1% AEC-Q200 | RoHS Compliant By Exemption |  | 1 | $0.11 | $0.11
660-RK73H2BTTDD61R9F | RK73H2BTTDD61R9F | KOA Speer | ATTEN_20DB | Thick Film Resistors - SMD 61.9 OHM 1% | RoHS Compliant By Exemption |  | 1 | $0.11 | $0.11
603-RC1206FR-0797R6L | RC1206FR-0797R6L | YAGEO | ATTEN_10DB | Thick Film Resistors - SMD 97.6Ohms 1/4W 1206 1% | RoHS Compliant By Exemption |  | 1 | $0.23 | $0.23
603-RC1206FR-0771R5L | RC1206FR-0771R5L | YAGEO | ATTEN_10DB | Thick Film Resistors - SMD 71.5 Ohms 250 mW 1206 1% | RoHS Compliant By Exemption |  | 1 | $0.14 | $0.14
603-AC1206FR-0753R6L | AC1206FR-0753R6L | YAGEO | ATTEN_30DB | Thick Film Resistors - SMD 53.6Ohms 1/4W 1206 1% AEC-Q200 | RoHS Compliant By Exemption |  | 1 | $0.13 | $0.13
660-RK73H2BTTD7870F | RK73H2BTTD7870F | KOA Speer | ATTEN_30DB | Thick Film Resistors - SMD 1/4watts 787ohms 1% | RoHS Compliant By Exemption |  | 1 | $0.10 | $0.10
660-RK73H2BTTD51R0F | RK73H2BTTD51R0F | KOA Speer | ATTEN_40DB | Thick Film Resistors - SMD 1/4watts 51ohms 1% | RoHS Compliant By Exemption |  | 1 | $0.11 | $0.11
603-RC1206FR-072K49L | RC1206FR-072K49L | YAGEO | ATTEN_40DB | Thick Film Resistors - SMD 2.49 kOhms 250 mW 1206 1% | RoHS Compliant By Exemption |  | 1 | $0.23 | $0.23
603-RC1206FR-07294RL | RC1206FR-07294RL | YAGEO | ATTEN_3DB | Thick Film Resistors - SMD 294Ohms 1/4W 1206 1% | RoHS Compliant By Exemption |  | 1 | $0.14 | $0.14
660-RK73H2BTTE17R8F | RK73H2BTTE17R8F | KOA Speer | ATTEN_3DB | Thick Film Resistors - SMD 1/4watts 17.8ohms 1% | RoHS Compliant By Exemption |  | 1 | $0.12 | $0.12
512-FST3253MTCX | FST3253MTCX | onsemi | SDR | Encoders, Decoders, Multiplexers & Demultiplexers Multi/Demulti Bus Sw | RoHS Compliant |  | 1 | $0.96 | $0.96
603-RC1206FR-077K87L | RC1206FR-077K87L | YAGEO | ATTEN_50DB | Thick Film Resistors - SMD 7.87 kOhms 250 mW 1206 1% | RoHS Compliant By Exemption |  | 1 | $0.10 | $0.10
603-RC1206FR-0726K1L | RC1206FR-0726K1L | YAGEO | ATTEN_60DB | Thick Film Resistors - SMD 26.1 kOhms 250 mW 1206 1% | RoHS Compliant |  | 1 | $0.10 | $0.10
660-RK73H2BTTD37R4F | RK73H2BTTD37R4F | KOA Speer | ATTEN_6DB | Thick Film Resistors - SMD 1/4watts 37.4ohms 1% | RoHS Compliant By Exemption |  | 1 | $0.10 | $0.10
660-RK73H2BTTDD49R9F | RK73H2BTTDD49R9F | KOA Speer | ATTEN_50_60DB | Thick Film Resistors - SMD 49.9 OHM 1% | RoHS Compliant By Exemption |  | 1 | $0.11 | $0.11
871-B78108S1155J | B78108S1155J | EPCOS / TDK | AF_MIX_OUT | Fixed Inductors HF-CHOKE BC 1500 UH 5% |  |  | 1 | $0.45 | $0.45
660-RK73H2BTTD1070F | RK73H2BTTD1070F | KOA Speer | ATTEN_13DB | Thick Film Resistors - SMD 1/4watts 107ohms 1% | RoHS Compliant By Exemption |  | 1 | $0.11 | $0.11
603-RC1206FR-0778R7L | RC1206FR-0778R7L | YAGEO | ATTEN_13DB | Thick Film Resistors - SMD 78.7 Ohms 250 mW 1206 1% | RoHS Compliant By Exemption |  | 1 | $0.14 | $0.14
810-CGA5L2C0G1H104J | CGA5L2C0G1H104J160AA | TDK |  | Multilayer Ceramic Capacitors MLCC - SMD/SMT CGA 1206 50V 0.1uF C0G 5% AEC-Q200 | RoHS Compliant |  | 1 | $0.51 | $0.51
575-144308 | 110-44-308-41-001000 | Mill-Max |  | IC & Component Sockets 8P TIN PIN TIN CNT | RoHS Compliant By Exemption |  | 1 | $0.60 | $0.60
575-1154731441001000 | 115-47-314-41-001000 | Mill-Max |  | IC & Component Sockets STANDRD SOLDER TAIL DIP SOCKET | RoHS Compliant |  | 1 | $1.18 | $1.18
575-199328 | 110-99-328-41-001000 | Mill-Max |  | IC & Component Sockets 28P TIN PIN TIN CONT | No |  | 1 | $1.64 | $1.64
575-1154732841003000 | 115-47-328-41-003000 | Mill-Max |  | IC & Component Sockets STANDRD SOLDER TAIL DIP SOCKET | RoHS Compliant |  | 1 | $2.30 | $2.30
71-CRCW1206150RFKEAC | CRCW1206150RFKEAC | Vishay | ATTEN_6DB | Thick Film Resistors - SMD 1/4Watt 150ohms 1% Commercial Use | RoHS Compliant By Exemption |  | 1 | $0.10 | $0.10
449-LFXTAL064523BULK | LFXTAL064523Bulk | IQD Frequency Products |  | Crystals 9MHz 30pF -10C 60C | RoHS Compliant |  | 1 | $1.26 | $1.26
771-BAV99-T/R | BAV99,215 | Nexperia |  | Diodes - General Purpose, Power, Switching SW DBL 100V 215MA HS | RoHS Compliant |  | 1 | $0.16 | $0.16
595-NE5534PE4 | NE5534PE4 | Texas Instruments |  | Operational Amplifiers - Op Amps Lo-Noise Hi-Sp Audio Op Amp | RoHS Compliant |  | 1 | $1.12 | $1.12
771-BZX79-C4V7-T/R | BZX79-C4V7,113 | Nexperia |  | Zener Diodes 500MW 4.7V 5% | RoHS Compliant By Exemption |  | 1 | $0.16 | $0.16
594-S100K33SL0R63K7R | S100K33SL0R63K7R | Vishay |  | Ceramic Disc Capacitors 10pF 3000V 10% SL0 7.5mm LS | RoHS Compliant |  | 1 | $0.35 | $0.35
810-CC45SL3AD121JYNA | CC45SL3AD121JYNNA | TDK |  | Ceramic Disc Capacitors D: 7mm 1kV 120pF SL 5% LS:5mm | RoHS Compliant |  | 1 | $0.36 | $0.36
810-CC45SL3AD470JYVN | CC45SL3AD470JYVNA | TDK |  | Ceramic Disc Capacitors D: 5.5mm 1kV 47pF SL 5% LS:5mm | RoHS Compliant |  | 1 | $0.30 | $0.30
810-CC45SL3AD820JYNA | CC45SL3AD820JYNNA | TDK |  | Ceramic Disc Capacitors D: 6mm 1kV 82pF SL 5% LS:5mm | RoHS Compliant |  | 1 | $0.35 | $0.35
810-CC45SL3AD101JYNA | CC45SL3AD101JYNNA | TDK |  | Ceramic Disc Capacitors D: 6.5mm 1kV 100pF SL 5% LS:5mm | RoHS Compliant |  | 1 | $0.31 | $0.31
810-CC45SL3AD391JYVN | CC45SL3AD391JYVNA | TDK |  | Ceramic Disc Capacitors D: 10.5mm 1kV 390pF SL 5% LS:5mm | RoHS Compliant |  | 1 | $0.44 | $0.44
594-D471K20Y5PH6UJ5R | D471K20Y5PH6UJ5R | Vishay |  | Ceramic Disc Capacitors 470pF 100V 10% | RoHS Compliant |  | 1 | $0.25 | $0.25
810-CC45SL3AD271JYVN | CC45SL3AD271JYVNA | TDK |  | Ceramic Disc Capacitors D: 9mm 1kV 270pF SL 5% LS:5mm | RoHS Compliant |  | 1 | $0.42 | $0.42
810-CC45SL3AD330JYNA | CC45SL3AD330JYNNA | TDK |  | Ceramic Disc Capacitors D: 5.5mm 1kV 33pF SL 5% LS:5mm | RoHS Compliant |  | 1 | $0.35 | $0.35
594-S681K29Y5PN63J5R | S681K29Y5PN63J5R | Vishay |  | Ceramic Disc Capacitors 680pF 1000V 10% Y5P 5.0mm LS | RoHS Compliant |  | 1 | $0.35 | $0.35
594-S331K33Y5PR63K7R | S331K33Y5PR63K7R | Vishay |  | Ceramic Disc Capacitors 330pF 3000V 10% Y5P 7.5mm LS | RoHS Compliant |  | 1 | $0.37 | $0.37
594-S201K33S3NN63L6 | S201K33S3NN63L6R | Vishay |  | Ceramic Disc Capacitors 200PF 1KV 10% | RoHS Compliant By Exemption |  | 1 | $0.58 | $0.58
603-CFR25SJT-26-10K | CFR25SJT-26-10K | YAGEO |  | Carbon Film Resistors - Through Hole 10 kOhms 250 mW 5% -350/ +500 PPM / C | RoHS Compliant |  | 1 | $0.10 | $0.10
667-ERJ-P06J104V | ERJ-P06J104V | Panasonic |  | Thick Film Resistors - SMD 0805 100Kohms 0.5W 5% AEC-Q200 | RoHS Compliant By Exemption |  | 1 | $0.13 | $0.13
595-SN74HC00AN | SN74HC00AN | Texas Instruments |  | Logic Gates | RoHS Compliant |  | 1 | $0.60 | $0.60
913-AS6C1008-55PIN | AS6C1008-55PIN | Alliance Memory |  | SRAM 1Mb, 2.7V-5.5V, 55ns 128K x 8 Asynch SRA | RoHS Compliant |  | 1 | $4.33 | $4.33
575-2104764041001000 | 210-47-640-41-001000 | Mill-Max |  | IC & Component Sockets STANDRD SOLDER TAIL DIP SOCKET | RoHS Compliant |  | 1 | $2.63 | $2.63
437-1108763241001101 | 110-87-632-41-001101 | Preci-dip |  | IC & Component Sockets | RoHS Compliant |  | 1 | $2.11 | $2.11
575-143314 | 110-43-314-41-001000 | Mill-Max |  | IC & Component Sockets 14P TIN PIN GLD CNT | RoHS Compliant By Exemption |  | 1 | $1.44 | $1.44
603-RC0805FR-07487KL | RC0805FR-07487KL | YAGEO |  | Thick Film Resistors - SMD 487 kOhms 125 mW 0805 1% | RoHS Compliant By Exemption |  | 1 | $0.10 | $0.10
660-RK73B2BTTD820J | RK73B2BTTD820J | KOA Speer |  | Thick Film Resistors - SMD 1/4watts 82ohms 5% | RoHS Compliant By Exemption |  | 1 | $0.10 | $0.10
859-HSDL-4261 | HSDL-4261 | Lite-On |  | Infrared Emitters IR Emitter 870nm High Power | RoHS Compliant |  | 1 | $0.64 | $0.64
720-SFH313FA | SFH 313 FA | ams OSRAM |  | Phototransistors PHOTOTRANSISTOR | RoHS Compliant |  | 1 | $0.76 | $0.76
71-CRCW08052K20JNEB | CRCW08052K20JNEB | Vishay |  | Thick Film Resistors - SMD 1/8watt 2.2Kohms 5% | RoHS Compliant By Exemption |  | 1 | $0.10 | $0.10
71-CRCW0805-1.0M-E3 | CRCW08051M00FKEA | Vishay |  | Thick Film Resistors - SMD 1/8watt 1Mohms 1% 100ppm | RoHS Compliant |  | 1 | $0.18 | $0.18
71-CRCW0805J-1K-E3 | CRCW08051K00JNEA | Vishay |  | Thick Film Resistors - SMD 1/8watt 1Kohms 5% 200ppm | RoHS Compliant By Exemption |  | 1 | $0.10 | $0.10
652-SRN3015-100M | SRN3015-100M | Bourns |  | Fixed Inductors 10uH 20% SMD 3015 | RoHS Compliant |  | 1 | $0.52 | $0.52
504-PTS120615V050 | PTS120615V050 | Eaton |  | Resettable Fuses - PPTC PPTC 1206 15V 0.5A SMD | RoHS Compliant |  | 1 | $0.19 | $0.19
77-VJ1206V475MXJTBC | VJ1206V475MXJTW1BC | Vishay |  | Multilayer Ceramic Capacitors MLCC - SMD/SMT 1206 4.7uF 16volts Y5V 20% | RoHS Compliant |  | 1 | $0.85 | $0.85
556-ATMEGA328-AU | ATMEGA328-AU | Microchip |  | 8-bit Microcontrollers - MCU AVR 32K FLSH, 1K EE 2K SRAM - 20 MHz | RoHS Compliant |  | 1 | $2.40 | $2.40
851-CDEP147NP8R0-125 | CDEP147NP-8R0MC-125 | Sumida |  | Fixed Inductors SMD Power Inductor 8UH 11A | RoHS Compliant |  | 1 | $2.28 | $2.28
647-QXK2J224KTP | QXK2J224KTP | Nichicon |  | Film Capacitors 630volts 0.22uF | RoHS Compliant |  | 1 | $1.59 | $1.59
649-68002-106HLF | 68002-106HLF | FCI / Amphenol |  | Headers & Wire Housings UNSHROUDED HEADER VERT THRU HOLE 6 POS | RoHS Compliant |  | 1 | $0.62 | $0.62
649-68002-103HLF | 68002-103HLF | FCI / Amphenol |  | Headers & Wire Housings 3POS HDR 30AU | RoHS Compliant |  | 1 | $0.43 | $0.43
696-SML-LX15IGC-TR | SML-LX15IGC-TR | Lumex |  | Standard LEDs - SMD Red/Green 635/565 nm | RoHS Compliant |  | 1 | $0.73 | $0.73
579-MCP73833-AMI/UN | MCP73833-AMI/UN | Microchip |  | Battery Management Charge Management Controllers | RoHS Compliant |  | 1 | $1.15 | $1.15
660-RK73B2ATTD562J | RK73B2ATTD562J | KOA Speer |  | Thick Film Resistors - SMD 1/4watts 5.6Kohms 5% | RoHS Compliant By Exemption |  | 1 | $0.10 | $0.10
660-RK73B2ATTD121J | RK73B2ATTD121J | KOA Speer |  | Thick Film Resistors - SMD 1/4watts 120ohms 5% | RoHS Compliant By Exemption |  | 1 | $0.10 | $0.10
774-ATS160SM-1 | ATS160SM-1 | CTS |  | Crystals 16MHz | RoHS Compliant |  | 1 | $0.37 | $0.37
782-TSOP38238 | TSOP38238 | Vishay |  | Infrared Receivers 2.5-5.5V 38kHz | RoHS Compliant |  | 1 | $0.95 | $0.95
782-TSAL6200 | TSAL6200 | Vishay |  | Infrared Emitters - High Power 940nm,T-1.75 72mW/sr,+/-17deg. | RoHS Compliant |  | 1 | $0.52 | $0.52
254-EMB125-RO | 254-EMB125-RO | Kobitone |  | Piezo Buzzers & Audio Indicators 12 x 9.5mm 2300Hz | RoHS Compliant |  | 1 | $1.98 | $1.98
653-B3F-1022 | B3F-1022 | Omron |  | Tactile Switches 6X6 Flat 5mm Btn Force 150g w/out Grd | RoHS Compliant |  | 1 | $0.38 | $0.38
649-68000-236 | 68000-236 | FCI / Amphenol |  | Headers & Wire Housings BERGSTIK HEADER 36P | No |  | 1 | $2.29 | $2.29
720-LGR971-KN-1 | LG R971-KN-1-0-20-R18 | ams OSRAM |  | Standard LEDs - SMD Green, 570nm 26mcd, 20mA | RoHS Compliant |  | 1 | $0.31 | $0.31
77-VJ0805A180GXQCBC | VJ0805A180GXQCW1BC | Vishay |  | Multilayer Ceramic Capacitors MLCC - SMD/SMT 0805 18pF 10volts C0G 2% | RoHS Compliant |  | 1 | $0.28 | $0.28
77-VJ1206V475MXQTBC | VJ1206V475MXQTW1BC | Vishay |  | Multilayer Ceramic Capacitors MLCC - SMD/SMT 1206 4.7uF 10volts Y5V 20% | RoHS Compliant |  | 1 | $0.85 | $0.85
77-VJ0805A681KXACBC | VJ0805A681KXACW1BC | Vishay |  | Multilayer Ceramic Capacitors MLCC - SMD/SMT 0805 680pF 50volts C0G 10% | RoHS Compliant |  | 1 | $0.28 | $0.28
71-CRCW0805J-100-E3 | CRCW0805100RJNEC | Vishay |  | Thick Film Resistors - SMD 1/8watt 100ohms 5% 200ppm | RoHS Compliant By Exemption |  | 1 | $0.10 | $0.10
71-CRCW0805J-10K-E3 | CRCW080510K0JNEA | Vishay |  | Thick Film Resistors - SMD 1/8watt 10Kohms 5% 200ppm | RoHS Compliant By Exemption |  | 1 | $0.12 | $0.12
71-CRCW0805105JT-RT5 | CRCW08051M00JNTB | Vishay |  | Thick Film Resistors - SMD 1/8watt 1Mohms 5% | No |  | 1 | $0.15 | $0.15
71-CRCW08052K20JNEA | CRCW08052K20JNEA | Vishay |  | Thick Film Resistors - SMD 1/8watt 2.2Kohms 5% | RoHS Compliant By Exemption |  | 1 | $0.10 | $0.10
71-CRCW0805J-33-E3 | CRCW080533R0JNEA | Vishay |  | Thick Film Resistors - SMD 1/8watt 33ohms 5% 200ppm | RoHS Compliant By Exemption |  | 1 | $0.13 | $0.13
71-CRCW0805J-330-E3 | CRCW0805330RJNEA | Vishay |  | Thick Film Resistors - SMD 1/8watt 330ohms 5% 200ppm | RoHS Compliant By Exemption |  | 1 | $0.12 | $0.12
71-CRCW0805470RJNEB | CRCW0805470RJNEB | Vishay |  | Thick Film Resistors - SMD 1/8watt 470ohms 5% | RoHS Compliant By Exemption |  | 1 | $0.13 | $0.13
926-LMR62014XMF/NOPB | LMR62014XMF/NOPB | Texas Instruments |  | Switching Voltage Regulators SIMPLE SWITCHER 20V out,1.4A SU Vltg Reg | RoHS Compliant |  | 1 | $1.15 | $1.15
863-MC14093BDG | MC14093BDG | onsemi | X1 board | Logic Gates 3-18V Quad 2-Input NAND Schmitt | RoHS Compliant |  | 1 | $0.69 | $0.69
621-MMBT3904-F | MMBT3904-7-F | Diodes Incorporated |  | Bipolar Transistors - BJT 40V NPN SS Trans 60Vceo 6Vebo 200mA | RoHS Compliant |  | 1 | $0.12 | $0.12
660-RK73B2ATTD102J | RK73B2ATTD102J | KOA Speer |  | Thick Film Resistors - SMD 1/4watt 1K OHM 5% | RoHS Compliant By Exemption |  | 1 | $0.10 | $0.10
660-RK73B2ATTD271J | RK73B2ATTD271J | KOA Speer |  | Thick Film Resistors - SMD 1/4watts 270ohms 5% | RoHS Compliant By Exemption |  | 1 | $0.10 | $0.10
660-RK73B2ATTD561J | RK73B2ATTD561J | KOA Speer |  | Thick Film Resistors - SMD 1/4watts 560ohms 5% | RoHS Compliant By Exemption |  | 1 | $0.10 | $0.10
660-RK73B2ATTD182J | RK73B2ATTD182J | KOA Speer |  | Thick Film Resistors - SMD 1/4watts 1.8Kohms 5% | RoHS Compliant By Exemption |  | 1 | $0.10 | $0.10
660-RK73B2ATTD332J | RK73B2ATTD332J | KOA Speer |  | Thick Film Resistors - SMD 1/4watts 3.3Kohms 5% | RoHS Compliant By Exemption |  | 1 | $0.10 | $0.10
534-3001 | 3001 | Keystone Electronics |  | Coin Cell Battery Holders TH COIN CELL BATTERY HOLDER 12mm | RoHS Compliant |  | 2 | $0.52 | $1.04
863-MC14093BDTR2G | MC14093BDTR2G | onsemi | X2 board | Logic Gates 3-18V Quad 2-Input NAND Schmitt | RoHS Compliant |  | 1 | $0.62 | $0.62
562-Q2Z116-6N36 | Q2-Z-1/16-01-QB6IN-36 | Qualtek | LAB | Heat Shrink Tubing and Sleeves 1/16 6IN 36PC BAG BLACK | RoHS Compliant |  | 1 | $1.39 | $1.39
562-Q2Z332-6N32 | Q2-Z-3/32-01-QB6IN-32 | Qualtek | LAB | Heat Shrink Tubing and Sleeves 3/32 6IN 32PC BAG BLACK | RoHS Compliant |  | 1 | $1.29 | $1.29
562-Q2Z18-6N28 | Q2-Z-1/8-01-QB6IN-28 | Qualtek | LAB | Heat Shrink Tubing and Sleeves 1/8 6IN 28PC BAG BLACK | RoHS Compliant |  | 1 | $1.24 | $1.24
562-Q2F316-04-24 | Q2-F-3/16-04-QB6IN-24 | Qualtek | LAB | Heat Shrink Tubing and Sleeves 3/16 6IN 24PC BAG RED | RoHS Compliant |  | 1 | $2.30 | $2.30
562-Q2Z14-6N20 | Q2-Z-1/4-01-QB6IN-20 | Qualtek | LAB | Heat Shrink Tubing and Sleeves 1/4 6IN 20PC BAG BLACK | RoHS Compliant |  | 1 | $1.57 | $1.57
517-3417-6600 | 3417-6600 | 3M | HP LA | Headers & Wire Housings 40P IDC SOCKET | RoHS Compliant |  | 1 | $8.31 | $8.31
517-3448-3040 | 3448-3040 | 3M | HP LA | Headers & Wire Housings STRAIN RELIEF FOR 40P CNCTR | RoHS Compliant |  | 1 | $1.11 | $1.11
517-3490-6 | 3490-6 | 3M | HP LA | Headers & Wire Housings SOCKET PULL TAB | RoHS Compliant |  | 1 | $1.98 | $1.98
562-Q2Z516-6N18 | Q2-Z-5/16-01-QB6IN-18 | Qualtek | LAB | Heat Shrink Tubing and Sleeves 5/16 6IN 18PC BAG BLACK | RoHS Compliant |  | 1 | $2.22 | $2.22
595-TLV1117-50CDCYR | TLV1117-50CDCYR | Texas Instruments |  | LDO Voltage Regulators Fixed LDO Volt Reg | RoHS Compliant |  | 1 | $0.86 | $0.86
612-TL1105DF100Q | TL1105DF100Q | E-Switch |  | Tactile Switches 6.0X13.0MM 100G | RoHS Compliant |  | 1 | $0.21 | $0.21
71-CMF5510K000FKEK | CMF5510K000FKEK | Vishay |  | Metal Film Resistors - Through Hole 1/2watt 10Kohms 1% | RoHS Compliant |  | 1 | $0.47 | $0.47
163-179PH-EX | 163-179PH-EX | Kobiconn |  | DC Power Connectors PCB 2.1MM | RoHS Compliant By Exemption |  | 1 | $1.04 | $1.04
651-1935226 | 1935226 | Phoenix Contact |  | Fixed Terminal Blocks PT 1.5/8-5.0-H | RoHS Compliant By Exemption |  | 1 | $1.81 | $1.81
649-69190-403 | 69190-403 | FCI / Amphenol |  | Headers & Wire Housings BERGSTIK HEADER 3P |  |  | 1 | $0.22 | $0.22
649-68602-406HLF | 68602-406HLF | FCI / Amphenol |  | Headers & Wire Housings 6P DR VRT UNSHRD HDR TIN OVER NICKEL | RoHS Compliant |  | 1 | $0.29 | $0.29
649-68602-404HLF | 68602-404HLF | FCI / Amphenol |  | Headers & Wire Housings 4P DR VRT UNSHRD HDR TIN OVER NICKEL | RoHS Compliant |  | 1 | $0.28 | $0.28
140-REA100M1EBK0511P | REA100M1EBK-0511P | Lelon |  | Aluminum Electrolytic Capacitors - Radial Leaded 25V 10uF 20% 5x11mm | RoHS Compliant |  | 1 | $0.11 | $0.11
517-4828-3004-CP | 4828-3004-CP | 3M |  | IC & Component Sockets SOCKET 28POS .3" IC OPEN FRAME | RoHS Compliant |  | 1 | $0.95 | $0.95
571-6404536 | 640453-6 | TE Connectivity |  | Headers & Wire Housings FLAT HEADER 6P Right Angle Post tin | RoHS Compliant |  | 1 | $0.81 | $0.81
517-3490-89140 | 3490-89140 | 3M |  | Headers & Wire Housings SOCKET PULL TAB PREASSEMBLED | RoHS Compliant |  | 1 | $1.02 | $1.02
726-BAT54-04E6327 | BAT 54-04 E6327 | Infineon |  | Schottky Diodes & Rectifiers 30V 0.2A | RoHS Compliant |  | 1 | $0.49 | $0.49
5168-CW8500 | CW8500 | Chemtronics |  | Soldering Flux NO CLEAN TACKY FLUX 3.5g SYRINGE | RoHS Compliant |  | 1 | $25.42 | $25.42
652-CR0805JW-241ELF | CR0805-JW-241ELF | Bourns |  | Thick Film Resistors - SMD 240ohm 5% | RoHS Compliant By Exemption |  | 1 | $0.10 | $0.10
581-08055C104M | 08055C104MAT2A | Kyocera AVX |  | Multilayer Ceramic Capacitors MLCC - SMD/SMT 50V 0.1uF X7R 0805 20% | RoHS Compliant By Exemption |  | 1 | $0.17 | $0.17
571-2158771 | 215877-1 | TE Connectivity |  | Modular Connectors / Ethernet Connectors 8/8 R/A MOD JACK | RoHS Compliant |  | 1 | $1.64 | $1.64
652-CR0805JW-331ELF | CR0805-JW-331ELF | Bourns |  | Thick Film Resistors - SMD 330ohm 5% | RoHS Compliant By Exemption |  | 1 | $0.10 | $0.10
652-CR0805JW-102ELF | CR0805-JW-102ELF | Bourns |  | Thick Film Resistors - SMD 1K 5% | RoHS Compliant By Exemption |  | 1 | $0.10 | $0.10
652-CR0805JW-182ELF | CR0805-JW-182ELF | Bourns |  | Thick Film Resistors - SMD 1.8K 5% | RoHS Compliant By Exemption |  | 1 | $0.10 | $0.10
652-CR0805JW-222ELF | CR0805-JW-222ELF | Bourns |  | Thick Film Resistors - SMD 2.2K 5% | RoHS Compliant By Exemption |  | 1 | $0.10 | $0.10
652-CR0805JW-332ELF | CR0805-JW-332ELF | Bourns |  | Thick Film Resistors - SMD 3.3K 5% | RoHS Compliant By Exemption |  | 1 | $0.10 | $0.10
652-CR0805-JW-472ELF | CR0805-JW-472ELF | Bourns |  | Thick Film Resistors - SMD 4.7KOHM 1/8WATT 5% | RoHS Compliant By Exemption |  | 1 | $0.10 | $0.10
652-CR0805JW-105ELF | CR0805-JW-105ELF | Bourns |  | Thick Film Resistors - SMD 1M 5% | RoHS Compliant By Exemption |  | 2 | $0.10 | $0.20
774-ATS16BSM-1 | ATS16BSM-1 | CTS |  | Crystals 16MHz 18pF 30ppm -20C 70C | RoHS Compliant |  | 1 | $0.38 | $0.38
660-RK73H2ATTD3091F | RK73H2ATTD3091F | KOA Speer |  | Thick Film Resistors - SMD 1/4W 3.09K OHM 1% | RoHS Compliant By Exemption |  | 1 | $0.10 | $0.10
80-C0805C103K5R | C0805C103K5RACTU | KEMET |  | Multilayer Ceramic Capacitors MLCC - SMD/SMT 50V 0.01uF X7R 0805 10% | RoHS Compliant |  | 2 | $0.12 | $0.24
603-CC206KKX5R7BB106 | CC1206KKX5R7BB106 | YAGEO |  | Multilayer Ceramic Capacitors MLCC - SMD/SMT 16 V 10 uF X5R 1206 10% | RoHS Compliant |  | 1 | $0.61 | $0.61
661-EKMGG250ELL221MH | EKMG250ELL221MHB5D | United Chemi-Con (UCC) |  | Aluminum Electrolytic Capacitors - Radial Leaded 25volts 220uF 8x11.5 | RoHS Compliant |  | 2 | $0.65 | $1.30
603-CC805KKX7R7BB105 | CC0805KKX7R7BB105 | YAGEO |  | Multilayer Ceramic Capacitors MLCC - SMD/SMT 16V 1uF X7R 0805 10% | RoHS Compliant |  | 1 | $0.25 | $0.25
77-VJ0805Y473JXAPBC | VJ0805Y473JXAPW1BC | Vishay |  | Multilayer Ceramic Capacitors MLCC - SMD/SMT 0805 0.047uF 50volts X7R 5% | RoHS Compliant |  | 1 | $0.34 | $0.34
926-LM22674MR50NOPB | LM22674MR-5.0/NOPB | Texas Instruments |  | Switching Voltage Regulators 500 mA SD Vtg Reg | RoHS Compliant |  | 2 | $4.08 | $8.16
556-ATMEGA328-PU | ATMEGA328-PU | Microchip |  | 8-bit Microcontrollers - MCU AVR 32K FLSH 1K EE2K SRAM-20MHz IND | RoHS Compliant |  | 1 | $2.61 | $2.61
895-FT232RL | FT232RL-REEL | FTDI |  | USB Interface IC USB to Serial UART Enhanced IC SSOP-28 | RoHS Compliant |  | 2 | $4.80 | $9.60
863-MBR0530T1G | MBR0530T1G | onsemi |  | Schottky Diodes & Rectifiers 0.5A 30V | RoHS Compliant |  | 1 | $0.38 | $0.38
810-C3225X5R1E106K | C3225X5R1E106K250AA | TDK |  | Multilayer Ceramic Capacitors MLCC - SMD/SMT 1210 25V 10uF X5R 10% T: 2.5mm | RoHS Compliant |  | 1 | $0.57 | $0.57
926-LM386N-3/NOPB | LM386N-3/NOPB | Texas Instruments |  | Audio Amplifiers Lo Vtg Audio Pwr Amp | RoHS Compliant |  | 1 | $1.49 | $1.49
926-LM384N/NOPB | LM384N/NOPB | Texas Instruments |  | Audio Amplifiers 5-W AUDIO POWER AMP | RoHS Compliant |  | 1 | $2.49 | $2.49
844-IRFU420PBF | IRFU420PBF | Vishay |  | MOSFET N-Chan 500V 2.4 Amp | RoHS Compliant |  | 1 | $1.28 | $1.28
81-CSTLS16M0X51-A0 | CSTLS16M0X51-A0 | Murata |  | Resonators 16.0 MHZ 5 % | RoHS Compliant By Exemption |  | 1 | $0.34 | $0.34
774-ATS080CSM-1 | ATS080CSM-1 | CTS |  | Crystals 8MHz 32pF 30ppm -20C 70C | RoHS Compliant |  | 1 | $0.38 | $0.38
72-T93YA-50K | T93YA503KT20 | Vishay |  | Trimmer Resistors - Through Hole 3/8" SQ V/ADJ 50K | RoHS Compliant By Exemption |  | 1 | $1.92 | $1.92
71-CCF55100KFKE36 | CCF55100KFKE36 | Vishay |  | Metal Film Resistors - Through Hole 1/4watt 100Kohms 1% Rated to 1/2watt | RoHS Compliant |  | 1 | $0.18 | $0.18
667-ERT-JZEG103JA | ERT-JZEG103JA | Panasonic |  | NTC Thermistors 10KOhms 5% THERMISTOR NTC | RoHS Compliant |  | 1 | $0.10 | $0.10
652-91A1A-B24-B15L | 91A1A-B24-B15L | Bourns |  | Potentiometers 5/8" SQUARE ST PANEL CTRL | RoHS Compliant By Exemption |  | 1 | $8.18 | $8.18
652-3306F-1-253 | 3306F-1-253 | Bourns |  | Trimmer Resistors - Through Hole 25K 25% 6mm Single Turn | RoHS Compliant By Exemption |  | 1 | $0.50 | $0.50
649-68000-236HLF | 68000-236HLF | FCI / Amphenol |  | Headers & Wire Housings 36 POS STR HDR | RoHS Compliant |  | 1 | $1.95 | $1.95
647-UPS2C101MHD1TN | UPS2C101MHD1TN | Nichicon |  | Aluminum Electrolytic Capacitors - Radial Leaded 100UF 160V 105c | RoHS Compliant |  | 1 | $1.44 | $1.44
647-UFW1V471MPD | UFW1V471MPD | Nichicon |  | Aluminum Electrolytic Capacitors - Radial Leaded 35volts 470uF 20% | RoHS Compliant |  | 1 | $0.76 | $0.76
610-MJE13005 | MJE13005 PBFREE | Central Semiconductor |  | Bipolar Transistors - BJT NPN Fast SW | RoHS Compliant |  | 1 | $2.92 | $2.92
581-08055C104K | 08055C104KAT2A | Kyocera AVX |  | Multilayer Ceramic Capacitors MLCC - SMD/SMT 50V 0.1uF X7R 0805 10% | RoHS Compliant By Exemption |  | 1 | $0.16 | $0.16
563-CU-1945 | CU-1945 | Bud Industries |  | Enclosures, Boxes, & Cases Utilibox Style J Plastic Utility Box (6.2 X 3.8 X 2.1 In) | RoHS Compliant |  | 1 | $5.50 | $5.50
546-1551KTBU | 1551KTBU | Hammond |  | Enclosures, Boxes, & Cases Translucent Blue Box 3.15x1.58x0.79" | RoHS Compliant |  | 1 | $2.85 | $2.85
546-1551KRBK | 1551KRBK | Hammond |  | Enclosures, Boxes, & Cases Mini w/Key Ring Kit .79x1.58x3.15" Black | RoHS Compliant |  | 1 | $3.06 | $3.06
546-1551ATS100 | 1551ATS100 | Hammond |  | Enclosures, Boxes, & Cases #2 x 3/16" Screw Pack 100, Phillips | RoHS Compliant |  | 1 | $8.69 | $8.69
532-580200B00 | 580200B00000G | Aavid |  | Heat Sinks Slide-On, Stamped Heat Sink, DIPS, Plastic, Angle Fin, Horizontal, 20C/W, 6.35mm | RoHS Compliant |  | 1 | $1.01 | $1.01
512-SS8050CBU | SS8050CBU | onsemi |  | Bipolar Transistors - BJT NPN/40V/1.5A | RoHS Compliant |  | 1 | $0.51 | $0.51
512-1N5239B | 1N5239B | onsemi |  | Zener Diodes 9.1V 0.5W Zener | RoHS Compliant |  | 1 | $0.19 | $0.19
512-1N5228B | 1N5228B | onsemi |  | Zener Diodes 3.9V 0.5W Zener | RoHS Compliant By Exemption |  | 1 | $0.17 | $0.17
844-IRFD9110PBF | IRFD9110PBF | Vishay |  | MOSFET 100V P-CH HEXFET MOSFET | RoHS Compliant By Exemption |  | 2 | $1.66 | $3.32
652-SRN6045-680M | SRN6045-680M | Bourns |  | Fixed Inductors 68uH 20% SMD 6045 | RoHS Compliant |  | 1 | $0.59 | $0.59
667-EEU-EE2C101 | EEU-EE2C101 | Panasonic |  | Aluminum Electrolytic Capacitors - Radial Leaded 100uF 160V | RoHS Compliant |  | 1 | $1.66 | $1.66
511-LD1117AS33 | LD1117AS33TR | STMicroelectronics |  | LDO Voltage Regulators 3.3V 1.0A Positive | RoHS Compliant |  | 1 | $1.03 | $1.03
649-78548-406HLF | 78548-406HLF | FCI / Amphenol |  | Headers & Wire Housings BERGSTIK II DR STRAIGHT-RET | RoHS Compliant |  | 1 | $0.48 | $0.48
810-FG18X7R1H474KRT6 | FG18X7R1H474KRT06 | TDK | AudioAmp | Multilayer Ceramic Capacitors MLCC - Leaded RAD 50V 0.47uF X7R 10% LS:2.5mm | RoHS Compliant |  | 1 | $0.34 | $0.34
603-MFR-25FTE52-51R | MFR-25FTE52-51R | YAGEO | AudioAmp | Metal Film Resistors - Through Hole 51 OHM 1/4W 1% | RoHS Compliant |  | 1 | $0.11 | $0.11
603-AC0805FR-07180RL | AC0805FR-07180RL | YAGEO | TIA_Amp | Thick Film Resistors - SMD 180 Ohms 125 mW 0805 1% AEC-Q200 | RoHS Compliant By Exemption |  | 2 | $0.10 | $0.20
998-MIC5317-3.3YM5TR | MIC5317-3.3YM5-TR | Microchip | SDCARD | LDO Voltage Regulators Single LDO, Hi-Perf. 150mA, 3.3 Vout | RoHS Compliant |  | 1 | $0.23 | $0.23
187-CL21B103KDCNNNC | CL21B103KDCNNNC | Samsung Electro-Mechanics |  | Multilayer Ceramic Capacitors MLCC - SMD/SMT 10nF+/-10% 200V X7R 0805 | RoHS Compliant |  | 1 | $0.10 | $0.10
588-OJ3925E-R52 | OJ3925E-R52 | Ohmite | PicoDAC | Carbon Film Resistors - Through Hole 3.9K Ohm 1/8W 5% 200 Volt | RoHS Compliant |  | 1 | $0.11 | $0.11
299-16K-RC | 299-16K-RC | Xicon | PicoDAC | Carbon Film Resistors - Through Hole 16Kohms 5% | RoHS Compliant |  | 1 | $0.36 | $0.36
260-1.8K-RC | 260-1.8K-RC | Xicon | TIA_SMT | Thick Film Resistors - SMD 1/8WATT 1.8KOHMS | RoHS Compliant By Exemption |  | 1 | $0.10 | $0.10
579-MCP4251503EP | MCP4251-503E/P | Microchip | SPIPOT_5K | Digital Potentiometer ICs Dual 8B V SPI POT | RoHS Compliant |  | 2 | $1.33 | $2.66
