land-boards/lb-boards/Hardware/Inventory/KickstarterCostFile.xlsx

Sheet: KickStarter
RasPi-GVS |  |  |  |  | RasPi-Plus-GVS |  |  |  |  | BBB-GVS
Reward Amount | Reward object | Limit | Date | Reward Text | Reward Amount | Reward object | Limit | Date | Reward Text | Reward Amount | Reward object | Limit | Date | Reward Text
$1.00 | Gratitude | Unlimited | 2014-09-01 | Pledge in increments of $1 to show you like this design and want to help us do more projects like this one. You get our gratitude. | $1.00 | Gratitude | Unlimited | 2014-09-01 | Pledge in increments of $1 to show you like this design and want to help us do more projects like this one. You get our gratitude. | $1.00 | Gratitude | Unlimited | 2014-09-01 | Pledge in increments of $1 to show you like this design and want to help us do more projects like this one. You get our gratitude.
$25.00 | Assembled/Tested board | 50 | 2014-09-01 | Initial adopter reward. You get an assembled and tested card. If you want more than one card, pledge in increments of the pledge amount. We will do the math and send you as many cards as you pledge to buy. | $28.00 | Assembled/Tested board | 50 | 2014-09-01 | Initial adopter reward. You get an assembled and tested card. If you want more than one card, pledge in increments of the pledge amount. We will do the math and send you as many cards as you pledge to buy. | $28.00 | Assembled/Tested board | 50 | 2014-09-01 | Initial adopter reward. You get an assembled and tested card. If you want more than one card, pledge in increments of the pledge amount. We will do the math and send you as many cards as you pledge to buy.
$28.00 | Assembled/Tested board | 100 | 2014-10-01 | You get an assembled and tested card. If you want more than one card, pledge in increments of the pledge amount. We will do the math and send you as many cards as you pledge to buy. | $30.00 | Assembled/Tested board | 100 | 2014-10-01 | You get an assembled and tested card. If you want more than one card, pledge in increments of the pledge amount. We will do the math and send you as many cards as you pledge to buy. | $30.00 | Assembled/Tested board | 100 | 2014-10-01 | You get an assembled and tested card. If you want more than one card, pledge in increments of the pledge amount. We will do the math and send you as many cards as you pledge to buy.
$30.00 | Assembled/Tested board | Unlimited | 2014-11-01 | You get an assembled and tested card. If you want more than one card, pledge in increments of the pledge amount. We will do the math and send you as many cards as you pledge to buy. | $34.00 | Assembled/Tested board | Unlimited | 2014-11-14 | You get an assembled and tested card. If you want more than one card, pledge in increments of the pledge amount. We will do the math and send you as many cards as you pledge to buy. | $34.00 | Assembled/Tested board | Unlimited | 2014-11-14 | You get an assembled and tested card. If you want more than one card, pledge in increments of the pledge amount. We will do the math and send you as many cards as you pledge to buy.

Sheet: RasPi-GVS
RasPi-GVS
Cost |  | Qty - 50 | Qty - 100 | Qty - 1000
BOM |  | $0.00 | $0.00 | $0.00
Assembly |  | $4.00 | $4.00 | $4.00
Test |  | $6.00 | $6.00 | $6.00
Ship |  | $3.50 | $3.50 | $3.50
Total |  | $13.50 | $13.50 | $13.50
Price |  | $28.00 | $30.00 | $34.00
Disc |  | $25.20 | $27.00 | $30.60
Profit |  | $11.70 | $13.50 | $17.10
BOM |  |  |  | Piece Price per item |  |  | Extended Cost per unit
Desc | Ref Des | Package | Qty per board | Qty - 50 | Qty - 100 | Qty - 1000 | Qty - 50 | Qty - 100 | Qty - 1000
PCB-50x50 | BRD1 |  | 1 | $1.00 | $0.80 | $0.75 | $1.00 | $0.80 | $0.75
CAP104-0805 | C2 C3 C4 C5 C6 | SM0805 | 5 | $0.10 | $0.08 | $0.07
CAP105-0805 | C1 | SM1206 | 1 | $0.20 | $0.18 | $0.16
FUSE | F1 F2 | SM1206 | 2 | $0.25 | $0.23 | $0.22
JACK-3.5MM | J12 | JACK_2.1MM | 1 | $0.55 | $0.45 | $0.40
CONN_6 | J10 J11 | PIN_ARRAY-6X1 | 2 | $0.26 | $0.26 | $0.26
CONN_3 | J3 J4 J5 J6 J7 J8 J9 | PIN_ARRAY_3X1 | 7 | $0.04 | $0.04 | $0.03
CONN_4 | J1 J2 J13 | PIN_ARRAY_4x1 | 3 | $0.06 | $0.05 | $0.04
COUPON | COUP?2 COUP?1 | REV_BLOCK | 2 | #N/A | #N/A | #N/A
RASPIO | P1 | pin_array_13x2 | 1 | $1.00 | $1.00 | $1.00
TXB0108EPWR | U1 U2 | SOG20 | 2 | $1.67 | $1.67 | $0.90
AP1117-5.0V | U3 | SOT223 | 1 | $1.00 | $0.90 | $0.80

Sheet: RasPi-Plus-GVS
RasPi-Plus-GVS
Cost |  | Qty - 50 | Qty - 100 | Qty - 1000
BOM |  | $1.00 | $0.90 | $0.80
Assembly |  | $4.00 | $4.00 | $4.00
Test |  | $6.00 | $6.00 | $6.00
Ship |  | $3.50 | $3.50 | $3.50
Total |  | $14.50 | $14.40 | $14.30
Price |  | $28.00 | $30.00 | $34.00
Disc |  | $25.20 | $27.00 | $30.60
Profit |  | $10.70 | $12.60 | $16.30
BOM |  |  |  | Piece Price per item |  |  | Extended Cost per unit
Desc | Ref Des | Package | Qty per board | Qty - 50 | Qty - 100 | Qty - 1000 | Qty - 50 | Qty - 100 | Qty - 1000
PCB-100x100 | BRD1 |  | 1 | $2.75 | $2.45 | $2.00 | $2.75 | $2.45 | $2.00
CAP104-0805 | C2 C3 C4 C5 C6 | SM0805 | 5 | $0.10 | $0.08 | $0.07 | $0.50 | $0.40 | $0.35
CAP106-1206 | C1 | SM1206 | 1 | $0.25 | $0.25 | $0.20 | $0.25 | $0.25 | $0.20
FUSE | F1 F2 | SM1206 | 2 | $0.25 | $0.23 | $0.22 | $0.50 | $0.46 | $0.44
JACK-3.5MM | J22 | JACK_2.1MM | 1 | $0.55 | $0.45 | $0.40 | $0.55 | $0.45 | $0.40
CONN_6 | J10 J11 | PIN_ARRAY-6X1 | 2 | $0.26 | $0.26 | $0.26 | $0.52 | $0.52 | $0.52
CONN_3 | J3 J4 J5 J6 J7 J8 J9 J12 J13 J14 J15 J16 J17 J18 J19 J20 | PIN_ARRAY_3X1 | 16 | $0.04 | $0.04 | $0.03 | $0.61 | $0.56 | $0.51
RASPIOPLUS | J24 | PIN_ARRAY_20X2 | 1 | $1.00 | $1.00 | $1.00 | $1.00 | $1.00 | $1.00
CONN_4 | J1 J2 J21 | PIN_ARRAY_4x1 | 3 | $0.06 | $0.05 | $0.04 | $0.17 | $0.15 | $0.14
TXB0108EPWR | U1 U2 | SOG20 | 2 | $1.67 | $1.67 | $0.90 | $3.34 | $3.34 | $1.80
AP1117-5.0V | U3 | SOT223 | 1 | $1.00 | $0.90 | $0.80 | $1.00 | $0.90 | $0.80
 |  |  |  |  |  |  | $11.20 | $10.48 | $8.16

Sheet: BBB-GVS
BBB-GVS |  | Qty - 50 | Qty - 100 | Qty - 1000
Cost
BOM |  | $9.91 | $9.25 | $7.03
Assembly |  | $4.00 | $4.00 | $4.00
Test |  | $6.00 | $6.00 | $6.00
Ship |  | $3.50 | $3.50 | $3.50
Total |  | $23.41 | $22.75 | $20.53
Price |  | $28.00 | $30.00 | $34.00
Disc |  | $25.20 | $27.00 | $30.60
Profit |  | $1.79 | $4.25 | $10.07
BOM |  |  |  | Piece Price per item |  |  | Extended Cost per unit
Desc | Ref Des | Package | Qty per board | Qty - 50 | Qty - 100 | Qty - 1000 | Qty - 50 | Qty - 100 | Qty - 1000
PCB-100x100 | BRD1 | BEAGLEBONE | 1 | $2.75 | $2.45 | $2.00 | $2.75 | $2.45 | $2.00
CONN_26x2_M | P8,P9 |  | 2 | $1.00 | $1.00 | $1.00
CAP104-0805 | C1 C2 C4 C5 | SM0805 | 4 | $0.10 | $0.08 | $0.07 | $0.40 | $0.32 | $0.28
CAP105-0805 | C3 | SM0805 | 1 | $0.20 | $0.18 | $0.16 | $0.20 | $0.18 | $0.16
LED-0805 | D1 D2 | SM0805 | 2 | $0.25 | $0.23 | $0.22 | $0.50 | $0.46 | $0.44
FUSE | F1 F2 | SM1206 | 2 | $0.25 | $0.23 | $0.22 | $0.50 | $0.46 | $0.44
ADR SEL | J24 | PIN_ARRAY_2X2 | 1 | $0.20 | $0.20 | $0.20 | $0.20 | $0.20 | $0.20
CONN_3 | J1-J10,J14,J15,J17-J23,J25-J32 | PIN_ARRAY_3X1 | 27 | $0.04 | $0.04 | $0.03 | $1.04 | $0.95 | $0.86
CONN_4 | J11-J13,J16 | PIN_ARRAY_4x1 | 4 | $0.06 | $0.05 | $0.04 | $0.23 | $0.20 | $0.18
330 | R3 R4 | SM0805 | 2 | $0.05 | $0.05 | $0.05 | $0.10 | $0.10 | $0.10
5.6K | R1 R2 R5 R6 R7 | SM0805 | 5 | $0.05 | $0.05 | $0.05 | $0.25 | $0.25 | $0.25
CAT24C256 | U3 | SO8E | 1 | $0.40 | $0.35 | $0.32 | $0.40 | $0.35 | $0.32
TXB0108EPWR | U2,U4 | SOG20 | 2 | $1.67 | $1.67 | $0.90 | $3.34 | $3.34 | $1.80
 |  |  |  |  |  |  | $9.91 | $9.25 | $7.03

Sheet: Costs
Parts Costs
 |  | Piece Price per item
Part | Descr | Qty - 50 | Qty - 100 | Qty - 1000 | BoE
330 |  | 0.05 | 0.05 | 0.05
5.6K |  | 0.05 | 0.05 | 0.05 | mouser
ADR SEL |  | 0.2 | 0.2 | 0.2
AP1117-5.0V |  | 1 | 0.9 | 0.8
CAP104-0805 | Cap, 0.1uF | 0.1 | 0.08 | 0.07
CAP105-0805 | Cap, 1.0uF | 0.2 | 0.18 | 0.16
CAP106-1206 | Cap, 10uF | 0.25 | 0.25 | 0.2
CAT24C256 |  | 0.4 | 0.35 | 0.32
CONN_26x2_M |  | 1 | 1 | 1
CONN_3 |  | 0.03833333333 | 0.035 | 0.032
CONN_4 |  | 0.0575 | 0.05 | 0.045
CONN_6 | HEADER, 6x1 | 0.26 | 0.26 | 0.26
FUSE |  | 0.25 | 0.23 | 0.22
JACK-3.5MM |  | 0.55 | 0.45 | 0.4
LED-0805 |  | 0.25 | 0.23 | 0.22
PCB-100x100 |  | $2.75 | $2.45 | $2.00 | SWAG
PCB-50x50 |  | $1.00 | $0.80 | $0.75 | seeedstudio
RASPIO |  | 1 | 1 | 1
RASPIOPLUS | CONN, 2x20 Female | 1 | 1 | 1
TXB0108EPWR |  | 1.67 | 1.67 | 0.9
