land-boards/lb-boards/SYNTHS/SYNTH-MIDI-CV4-01/PARTS LIST/SYNTH-MIDI-CV4-01.csv

Find | Qty | Ref Des | Part Number | Find | Qty | Ref Des | Part Number
1 | 7 | R1-R4, R13, R15, R16 | 220 | 12 | 1 | U2 | XIAO_RP2040
2 | 4 | R5, R8, R9, R12 | 3.9K | 13 | 2 | U3, U4 | [http://ww1.microchip.com/downloads/en/DeviceDoc/20002249B.pdf MCP4822-E/P]
3 | 4 | R6, R7, R10, R11 | 5.6K | 14 | 1 | U5 | [https://www.mouser.com/ProductDetail/Vishay-Semiconductors/CNY17-4X006?qs=%2Fjqivxn91ccVZaHNJrlaNA%3D%3D CNY17-4]
4 | 1 | R14 | 4.7K | 15 | 1 | U6 | [http://ww1.microchip.com/downloads/en/DeviceDoc/21733j.pdf MCP6234]
5 | 1 | R17 | 10K | 16 | 1 | U7 | [https://www.mouser.com/ProductDetail/595-SN74HC14AN 74HC14]
6 | 9 | D1-D9 | BAT41 | 17 | 1 | H1 | HEADER, 1X2
7 | 4 | C4-C7 | 0.1uF | 18 | 1 | J1 | HEADER, IDC, 2X8
8 | 3 | C1-C3 | 10uF | 19 | 4 | J2, J3, J5, J7 | [https://www.mouser.com/ProductDetail/490-SJ1-3523N SJ1-3523N]
9 | 1 | Q1 | [https://www.onsemi.com/pub/Collateral/2N3903-D.PDF 2N3904] | 20 | 2 | J4, J6 | [http://www.mouser.com/ds/2/18/40_c091_abd_e-75918.pdf DIN-5]
10 | 1 | U1 | AZ1117-5 | 21 | 1 | J8 | HEADER, 1X4
11 | 2 | U2 | SOCKET, FEMALE, 1X7
