land-boards/lb-boards/BeagleBoneBlack Cards/BBB-GVS-4/PartsList/BBB-GVS-4_REV1.csv

Item | Qty | Reference(s) | Value | Item | Qty | Reference(s) | Value
1 | 1 | C1 | 1uF (0805) | 8 | 1 | U1 | CAT24C256WI-GT3
2 | 2 | C2, C3 | 0.1uF (0805) | 9 | 2 | U4, U5 | TXS0104EDR
3 | 2 | D1, D2 | LED (0805) | 10 | 15 | VARIOUS | HEADER, 2X3
4 | 3 | R1, R2, R4 | 5.6K (0805) | 11 | 5 | A6, J1, J10, J12, J25 | HEADER, 1X3
5 | 1 | R3 | 470 (0805) | 12 | 2 | P8, P9 | HEADER, 2X26 (BOTTOM)
6 | 1 | R5 | 1K (0805) | 13 | 1 | J16 | HEADER, 1X2
7 | 2 | F1, F2 | POLY FUSE, 1A (1206) | 14 | 2 | J11, J25(SYS) | SHUNT
