land-boards/lb-boards/ESP32/ESP32-VGA/Parts List/ESP32-VGA_Rev3_PL.csv

Find | Qty | Ref Des | Part Number | Find | Qty | Ref Des | Part Number
1 | 4 | C1, C2, C4, C5 | [https://www.mouser.com/ProductDetail/KEMET/C0805C104M5RACTU 0.1uF] | 10 | 2 | U1 | Header, female, 1x15
2 | 1 | C3 | [https://www.mouser.com/ProductDetail/Taiyo-Yuden/EMK316BJ106KD-T 10uF] | 11 | 1 | H1 | Header, Vert, 1x2
3 | 1 | C6 | [https://www.mouser.com/ProductDetail/Taiyo-Yuden/EMK316BJ106KD-T 10uF] | 12 | 1 | H2 | Header, Vert, 2x4
4 | 3 | R1, R3, R5 | [https://www.mouser.com/ProductDetail/652-CR0805FX-4220ELF 422] | 13 | 1 | H3 | Header, Vert, 1x4
5 | 3 | R2, R4, R6 | [https://www.mouser.com/ProductDetail/603-RC0805FR-07845RL 845] | 14 | 1 | J1 | [https://www.ebay.com/sch/i.html?_from=R40&_nkw=5.5mm+x+2.5mm+Plastic+DC+Power+Jack&_sacat=0 DCJ0202]
6 | 1 | R7 | [https://www.mouser.com/ProductDetail/YAGEO/RC0805JR-13270RL?qs=fRxXYNj8ftGjdryVMthBYw%3D%3D 270] | 15 | 2 | J2, J3 | Header, 1x6, Rt Ang, (FTDI)
7 | 1 | R8 | [https://www.mouser.com/ProductDetail/Yageo/RT0805FRE07150RL?qs=sGAEpiMZZMu61qfTUdNhGxEjuuBLd0B4fB5OA91vaXU%3D 150] | 16 | 1 | J4 | [http://portal.fciconnect.com/Comergent//fci/drawing/10067847.pdf Conn, SD Card]
8 | 1 | U1 | [https://www.ebay.com/sch/i.html?_from=R40&_trksid=p2047675.m570.l1311&_nkw=esp-wroom-32&_sacat=0 ESP-32] | 17 | 1 | J5 | Header, Vert, 2x2
9 | 1 | U2 | [https://www.mouser.com/ProductDetail/Texas-Instruments/TXS0104ED?qs=7kv20MEVUlg5V59AplM5UA%3D%3D TXS0104ED] | 18 | 1 | P1 | [https://www.ebay.com/itm/10Pcs-mini-6pin-female-pcb-mount-ps2-jack-mouse-keyboard-plug-connec-CO/312856912531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 MINI-DIN6, PS2 (GRN)]
 |  |  |  | 19 | 1 | P2 | [https://www.ebay.com/itm/10PCS-MINI-6PIN-FEMALE-PCB-MOUNT-PS2-JACK-mouse-keyboard-plug-connector-Purple/141976500445 MINI-DIN6, PS2 (PURP)]
 |  |  |  | 20 | 1 | P3 | [https://www.mouser.com/ProductDetail/587-634-015-274-906 CONN, DB15HD, BLUE (VGA)]
 |  |  |  | 21 | 1 | P4 | [https://www.mouser.com/ProductDetail/568-NYS354 JACK,, RT ANG, RCA]
