land-boards/lb-boards/FPGA Cards/ITX-SWLEDs/PARTS_LIST/ITX-SWLEDs.csv

Find | Qty | Ref Des | Part Number
1 | 16 | D1-D16 | LED, 3mm
2 | 16 | R2-R17 | 1K (balllast resistors)
3 | 8 | SW1-SW8 | SW_Push, 6mm, 6mm high
4 | 8 | SW9-SW16 | SW, Slide, SPDT
5 | 1 | J8 | Header, Female, 2x20
