land-boards/lb-boards/HamRadio/DRIVE50/PartsList/DRIVE50.csv

Find | Qty | Ref Des | Part Number | Find | Qty | Ref Des | Part Number
1 | 1 | C4 | 0.1uF | 7 | 1 | J1 | Header, Right Angle, 1x3
2 | 1 | R1 | 1K (0805) | 8 | 1 | PB1 | BNC, 523-31-5431-10RFX (or)
3 | 5 | R2, R3, R4, R5, R6 | 249 (0805) or 374 (0805) | 9 | 1 | PA1 | SMA, Edge Launch
4 | 1 | R7 | 10K (0805)
5 | 1 | U1 | [http://www.ti.com/lit/gpn/sn74LS14 74AC14]
6 | 1 | DS1 | LED (0805)
