land-boards/lb-boards/I2C Cards/SWLEDX8/Parts List/SWLEDX8.csv

Find | Qty | Ref Des | Part Number
1 | 8 | D0-D7 | LED-fixed
2 | 8 | R1-R8 | 10K
3 | 8 | R9-R16 | 1K
4 | 8 | SW0-SW7 | [https://www.ebay.com/sch/i.html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 SS12D00G3]
5 | 1 | P1 | Header, 2X10
