land-boards/lb-boards/LEDs Cards/LED32-DB37/Parts List/LED32-DB37.csv

Find | Qty | Ref Des | Part Number
1 | 32 | D0-D31 | LED, 3mm
2 | 1 | J1 | DB37 Male or Female
4 | 32 | R1-R32 | 330 (Note)
