land-boards/lb-boards/LEDs Cards/LEDS-SWITCHES _2/Parts List/LEDS-SWITCHES _2.csv

Find | Qty | Ref Des | Part Number
1 | 8 | D1-D8 | LED, 5mm
2 | 8 | PB1-PB8 | [https://www.mouser.com/c/electromechanical/switches/tactile-switches/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 6x6mm Pushbutton]
3 | 16 | R1-R16 | 10K (1/4W)
4 | 8 | R17-R24 | 560 (1/4W)
5 | 8 | SS1-SS8 | [https://www.ebay.com/sch/i.html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 SS12D00G3]
6 | 1 | J1 | Header, Right Angle, 2x16
