land-boards/lb-boards/LEDs Cards/MAX7219X4/PartsList/MAX7219X4.csv

Find | Qty | Ref Des | Part Number
1 | 1 | J1 | Conn_01x08
2 | 1 | U1 | TXS0104
3 | 4 | BRD1-BRD4 | MAX7912_MODULE, BLUE PCB
