land-boards/lb-boards/ODAS Cards/ODAS-PSOC5/Parts List/ODAS-PSOC5_Rev5_PL.csv

Find | Qty | Ref Des | Part Number | Find | Qty | Ref Des | Part Number
1 | 1 | C1 | 10uF (1206) | 8 | 2 | H1, H2 | Header, Strt. 1X3
2 | 9 | C2, C3, C6, C7, C9-C14 | 0.1uF (0805) | 9 | 1 | H3 | Header, Strt, 1x2
3 | 2 | C4, C5 | 8pF (0805) | 10 | 1 | H4 | Header, Strt, 2X2
4 | 2 | C8, C11 | 1uF (0805) | 12 | 1 | P1 | Header, Right angle, 2X20
5 | 1 | DS1 | LED (0805) | 13 | 1 | P2 | USB-B
6 | 1 | F1 | Poly Fuse, 0.5A (1206) | 14 | 2 | P3, P5 | Header, Right angle, 1X4
17 | 2 | R1, R2 | 22 (0805) | 15 | 1 | P4 | Header, Right angle, 1X6
18 | 1 | R3 | 120 (0805) | 16 | 1 | P5
19 | 3 | R4, R6, R7 | 3.9K (0805)
20 | 1 | R5 | 1K (0805)
22 | 1 | U1 | AZ1117-3.3
23 | 1 | U2 | CY8C5267AXI-LP051
24 | 1 | U3 | CAT24C32WI-GT3
25 | 1 | Y1 | Crystal, 16 MHz
