land-boards/lb-boards/RetroCPUs/JoyPad/PartsList/JoyPad.csv

Find | Qty | Ref Des | Part Number
1 | 1 | J1 | Header, 1x12
2 | 1 | J2 | DB-9M
3 | 8 | SW1-SW8 | Pushbutton, 6mm, 6mm high
