land-boards/lb-boards/Audio Cards/AudioAmp380/Parts List/AudioAmp380_Rev3_PL.csv

Qty | Value | Ref Des | Qty | Value | Ref Des
1 | 0.47uF, 50V | C7 | 1 | IC, LM380N | U2
3 | 100nF, 50V | C1,C3,C8 | 1 | IC, NE5534 | U1
2 | 100uF, 35V | C5,C9 | 1 | RES, TRIMMER, 500 | RV2
2 | 10uF, 35V | C2,C6 | 1 | CONN, 1X5, 10K POT | RV1
1 | 470uF, 35V | C4 | 2 | RCA-JACK | J1,J2
1 | 51, 1/4W | R1 | 1 | DCJ0202 | J3
1 | 10, 1/4W | R2
2 | 10K, 1/4W | R3,R4
1 | 2.7, 1/4W | R5
