land-boards/lb-boards/HamRadio/RF-Amp/Parts List/RF-Amp_PL.csv

Qty | Value | RefDes | Qty | Value | RefDes
3 | CAP, 100nF | C1-C3 | 2 | TOROID, FT37-43 | T1,T2
1 | RES, 15K, 1/4W | R1 | 1 | TERM BLK, 2 PIN, 5mm | P3
1 | RES, 3.3K, 1/4W | R2 | 2 | BNC | P1,P2
1 | RES, 120, 1/4W | R3 | 2 | SMA | PB1,PB2
1 | RES, 10, 1/4W | R4 | 2 | DNP | R5,R6
1 | TRANS, 2N3904 | Q1
