land-boards/lb-boards/Arduino Cards/Screwduino/PartsList/screwduino_PL.csv

Qty | Value | RefDes | Qty | Value | RefDes
7 | 0.1uF | C1-C7 | 1 | SW_PUSH_OMRON | SW1
1 | 1N4004 | D1 | 1 | HEADER, STRT, 3X1 | JP2
3 | 10K | R1,R2,R3 | 1 | HEADER, STRT, 3X2 | JP3
1 | AP1117 | U2 | 1 | HEADER, STRT 1X4 | JP8
1 | RESONATOR, 16MHz | X1 | 1 | CONN. RT ANGLE, 6 | JP1
2 | 47uF | C8,C9 | 16 | TERM BLOCKS, 5MM, 2 POS | JP4-JP7
1 | SOCKET, 28 PIN, 0.3 IN |  | 1 | JACK-3.5MM | K1
1 | ATMEGA328-P | U1
