land-boards/lb-boards/RetroCPUs/FrontPanel01/PartsList/FrontPanel_PL.csv

Qty | Value | RefDes | Qty | Value | RefDes
4 | 10K | R3-R7 | 32 | LED (NOTE 3) | DS1-DS32
2 | 2.2K (NOTE 1) | R1,R2 | 1 | HEADER, RT ANG, 2X2 | J6
32 | 560 (NOTE 2) | R5,R8-R38 | 1 | HEADER, RT ANG 1X4 | J3
4 | MCP23017-E/SS | U1,U2,U3,U4 | 1 | HEADER, RT ANG, 1x2 | J1
32 | SW_Push | SW1-SW32 | 1 | HEADER, RT ANG, 1x5 | J2
