land-boards/lb-boards/SYNTHS/MIDI-IN-OUT/PARTS LIST/MIDI-IN-OUT.csv

Find | Qty | Ref Des | Part Number
1 | 1 | D1 | [https://www.mouser.com/ProductDetail/STMicroelectronics/BAT41?qs=JV7lzlMm3yLsDyxobuLK1w%3D%3D 1n914]
2 | 2 | J1, J2 | [https://www.amazon.com/dp/B07NY6Z2N7?psc=1&ref=ppx_yo2ov_dt_b_product_details DIN-5]
3 | 1 | J3 | HEADER, RIGHT ANG, 1x5
4 | 1 | J4 | HEADER, STRT, 1x2
6 | 1 | Q1 | [https://www.onsemi.com/pub/Collateral/2N3903-D.PDF 2N3904]
7 | 3 | R1, R4, R5 | [https://www.mouser.com/ProductDetail/Xicon/299-220-RC?qs=MNX0Jdkv8mSgBtBJYBhvZQ%3D%3D 220]
8 | 1 | R2 | [https://www.mouser.com/ProductDetail/Xicon/299-10K-RC?qs=qNdDiqE2HS9kugz4oNhLDw%3D%3D 10K]
9 | 1 | R3 | [https://www.mouser.com/ProductDetail/Xicon/299-2.2K-RC?qs=QaPBMFBEHz3RDbXknTj%252ByA%3D%3D 2.2K]
10 | 1 | U1 | [https://www.mouser.com/ProductDetail/595-SN74HC14AN 74HC14]
11 | 1 | U2 | [https://www.mouser.com/ProductDetail/Vishay-Semiconductors/CNY17-4X006?qs=%2Fjqivxn91ccVZaHNJrlaNA%3D%3D CNY17-4X006]
