land-boards/lb-boards/Arduino Cards/QTPy49-01/PartsList/QTPy49.csv

Find | Qty | Ref Des | Part Number | Find | Qty | Ref Des | Part Number
1 | 4 | C1, C4, C5, C6 | 0.1uF | 5 | 2 | J4, J5 | Header, Strt, 1x4
2 | 1 | D1 | D_Schottky | 6 | 3 | J6, J7, J8 | Header, Strt, 1x3
3 | 1 | U2 | AZ1117-5 | 7 | 1 | J2 | Header, Strt, 1x2 (opt)
4 | 1 | BRD1 | XIAO RP2040 | 8 | 1 | J3 | SD_Card
 |  |  |  | 9 | 1 | J1 | Conn, DC
