land-boards/lb-boards/FPGA Cards/RETRO-65C816/PARTS_LIST/RETRO-65C816_REV2.csv

Find | Qty | Ref Des | Part Number | Find | Qty | Ref Des | Part Number
1 | 6 | C1, C2, C3, C5, C8, C9 | Cap, 0.1uF (0805) | 22 | 1 | H1 | Header, Strt, 1x2
2 | 3 | C4, C6, C7 | Cap, 10uF (1206) | 23 | 1 | H1 | Shunt
3 | 2 | D1, D2 | LED, 3mm | 24 | 1 | H2 | Header, Right Ang, 1x3
4 | 1 | L1 | Ind, MI0805K601R-10 (0805) | 25 | 1 | J1 | Header, Strt, 2x25
5 | 3 | R1, R2, R7 | Res, 10K (0805) | 26 | 1 | J2 | Header, Strt, 1x4
6 | 2 | R3, R4 | Res, 22 (0805) | 27 | 1 | J3 | Header, Right Ang, 2x6
7 | 2 | R5, R6 | Res, 330 (0805) | 28 | 1 | J4 | [https://www.mouser.com/datasheet/2/670/uj2-bh-th-1779177.pdf Conn, USB B]
8 | 1 | R8 | R2H, Note 1 | 29 | 1 | J5 | Header, Rt Ang, 2x3
9 | 1 | R9 | R3M, Note 1 | 30 | 2 | J7, J8 | Header, Female, Strt, 2x32
10 | 1 | R10 | R3L, Note 1 | 31 | 1 | P1 | [https://www.mouser.com/ProductDetail/587-634-015-274-906 634-015-274-906 (DB15HD)]
11 | 1 | R11 | G3H, Note 1 | 32 | 1 | P2 | Mini-DIN6, PS/2, Purple
12 | 1 | R12 | G3M, Note 1 | 33 | 1 | P4 | [https://www.mouser.com/ProductDetail/523-GMC020080HR SD Socket, GMC020080HR]
13 | 1 | R13 | G3L, Note 1
14 | 1 | R14 | B2H, Note 1
15 | 1 | R15 | R3L, Note 1
16 | 2 | R16, R17 | Res, 47 (0805)
17 | 1 | U1 | [https://www.onsemi.com/pdf/datasheet/ncp1117-d.pdf NCP1117ST33T3G]
18 | 1 | U2 | [https://www.mouser.com/ProductDetail/FTDI/FT230XS-U/?qs=Gp1Yz1mis3UZolxbXux7lw%3D%3D FT230XS-U]
19 | 1 | U3 | [https://www.mouser.com/ProductDetail/ISSI/IS62WV10248EBLL-45TLI?qs=uCnMRCNammlHlbXwB0OS3A%3D%3D IS62WV10248EBLL-45TLI]
20 | 1 | U4 | [https://www.mouser.com/ProductDetail/Western-Design-Center-WDC/W65C816S6TQG-14?qs=9lcNTSmDlCpDFNJ8GRf7eQ%3D%3D W65C816S6TQG-14]
21 | 1 | U5 | [https://www.mouser.com/ProductDetail/Texas-Instruments/TXS0104ED?qs=7kv20MEVUlg5V59AplM5UA%3D%3D TXS0104EDR]
