land-boards/lb-boards/HamRadio/VFO-003/Parts List/VFO-003.csv

Find | Qty | Ref Des | Part Number
1 | 1 | BRD1 | MINI-360
2 | 1 | C1 | 10uF
3 | 7 | C2, C6, C7, C8, C9, C10, C11 | 0.1uF
