land-boards/lb-boards/I2C Cards/SWLEDX8-I2C/Parts List/SWLEDX8-I2C.csv

Item | Qty | Reference(s) | Value | Item | Qty | Reference(s) | Value
1 | 4 | R1-R4 | 10K (0805) | 4 | 1 | P1 (Note 1) | Header, 2X10
2 | 2 | R5, R6 | 2.2K (0805) | 5 | 1 | P2 (Note 2) | Header, 2X5
3 | 1 | U1 | MCP23017P | 6 | 1 | P3 (Note 3) | Header, 2X5
