land-boards/lb-boards/ODAS Cards/SH-LEV-01/Parts List/SH-LEV-01.csv

Find | Qty | Ref Des | Part Number
1 | 2 | C1, C2 | 0.1uF
2 | 2 | J1, J2 | Conn_01x12
5 | 2 | U1, U2 | [https://www.ti.com/product/TXS0104E TXS0104]
