land-boards/lb-boards/Raspberry Pi Cards/PiPico_SDK/Parts List/PiPico_SDK.csv

Find | Qty | Ref Des | Part Number
1 | 2 | C3, C5 | [https://www.mouser.com/ProductDetail/140-REA470M1CBK0511P 47uF]
2 | 6 | C7, C8, C96, C97, C98, C99 | [https://www.mouser.com/ProductDetail/KEMET/C315C104M5U5TA7303?qs=LRwtGMyvRhhtzW9z3Tp7qQ%3D%3D 0.1uF]
3 | 1 | D1 | [https://www.mouser.com/ProductDetail/onsemi/SBR80520LT1G?qs=VZpK7o2ExSQ%252BUJtVfeZ3AQ%3D%3D MBR0520T1H]
4 | 1 | D2 | [https://www.mouser.com/ProductDetail/Rectron/1N5819-T?qs=w4rXzN23dC3jxJaDspMQbA%3D%3D 1N5819]
5 | 1 | J2 | [https://www.mouser.com/datasheet/2/123/English_634_Ordering_Guide-1830723.pdf CONN, DB15HD, BLUE (VGA)]
6 | 1 | J4 | [https://www.mouser.com/datasheet/2/670/sj1_352xn-1779157.pdf AudioJack3]
7 | 1 | J5 | [https://www.mouser.com/datasheet/2/670/uj2_bh_th-1779177.pdf USB-B]
8 | 1 | J6 | Header, Vert, 2x3
9 | 2 | J9, J10 | Socket, Female. 1x20
11 | 2 | R1, R2 | [https://www.mouser.com/ProductDetail/Xicon/299-2.2K-RC?qs=QaPBMFBEHz3RDbXknTj%252ByA%3D%3D 2.2K]
12 | 2 | R3, R5 | [https://www.mouser.com/ProductDetail/Ohmite/OJ4705E-R52?qs=AkUtuiJmyfnsNaojPyuOog%3D%3D 47]
13 | 8 | R4, R10, R20, R21, R22, R27, R32, R37 | [https://www.mouser.com/ProductDetail/Xicon/299-1K-RC?qs=LFVzBv9lGv703mrPrUE94Q%3D%3D 1K]
14 | 4 | R8, R11, R23, R24 | [https://www.digikey.com/en/products/detail/stackpole-electronics-inc/CF18JT10K0/1741566 10K]
15 | 3 | R26, R31, R36 | [https://www.digikey.com/en/products/detail/vishay-dale/RN55D4990FB14/3193826 499]
16 | 3 | R28, R33, R38 | [https://www.mouser.com/ProductDetail/Xicon/299-2K-RC?qs=LARUBeJqYEWnnAboW84Hxg%3D%3D 2K]
17 | 3 | R29, R34, R39 | 4.02K
18 | 3 | R30, R35, R40 | 8.06K
19 | 1 | SD1 | [https://cdn.amphenol-cs.com/media/wysiwyg/files/drawing/gmc02008xhr.pdf Conn, SD Card]
20 | 4 | SW1, SW2, SW3, SW4 | Pushbutton, 6mm
22 | 1 | U1 | [https://www.adafruit.com/product/4864 RPi-PICO]
