land-boards/lb-boards/RetroCPUs/SIMPLE-6502/PartsList/SIMPLE-6502.csv

Find | Qty | Ref Des | Part Number | Find | Qty | Ref Des | Part Number
1 | 4 | C1-C4 | [https://www.mouser.com/ProductDetail/710-860020672005 1uF] | 13 | 1 | U5 | 65C02
2 | 1 | C5 | 47uF | 14 | 1 | U6 | [https://www.mouser.com/ProductDetail/595-SN74HC00AN 74HC00]
3 | 1 | C6 | [https://www.mouser.com/ProductDetail/TDK/FG18C0G1H271JNT00?qs=vNwBHymccZ%2FxLVdLN%2FZvBg%3D%3D 270pF] | 15 | 1 | U7 | [https://www.mouser.com/ProductDetail/Texas-Instruments/SN74HC04AN?qs=byeeYqUIh0N6S9uYkR6RCw%3D%3D 74HC04]
4 | 7 | C7-C13 | 0.1uF | 16 | 1 | U8 | [https://www.mouser.com/ProductDetail/595-SN74HC74N 74HC74]
5 | 7 | R1, R4-R9 | [https://www.mouser.com/ProductDetail/Xicon/299-2.2K-RC?qs=QaPBMFBEHz3RDbXknTj%252ByA%3D%3D 2.7K] | 17 | 1 | U9 | [https://www.mouser.com/c/?q=DS1813-5 DS1813-5]
6 | 2 | R2, R3 | [https://www.mouser.com/ProductDetail/Xicon/299-2.2K-RC?qs=QaPBMFBEHz3RDbXknTj%252ByA%3D%3D 2.2K] | 18 | 1 | J1 | [https://www.mouser.com/ProductDetail/649-D09P13B4PA00LF DB9_Male]
7 | 1 | SW1 | PUSHBUTTON, 6MM | 19 | 1 | J2 | HEADER, STRT, 1X3
8 | 1 | Y1 | [https://www.mouser.com/ProductDetail/815-AB-1.8432-B2 1.8432 MHz] | 20 | 1 | J3 | HEADER, STRT, 1X6
9 | 1 | U1 | [http://www.ti.com/lit/ds/symlink/max232.pdf MAX232] | 21 | 1 | J4 | HEADER, STRT, 2X4
10 | 1 | U2 | [https://www.mouser.com/ProductDetail/Alliance-Memory/AS6C62256-55PCN?qs=LD2UibpCYJqgbIupMJnGTQ%3D%3D AS6C62256-55PCN] | 22 | 2 | J5, J6 | JUMPER (1X3)
11 | 1 | U3 | [https://www.jameco.com/Jameco/Products/ProdDS/43633.pdf MC68B50] | 23 | 1 | JP1 | JMP_NOT_W65C02
12 | 1 | U4 | [http://ww1.microchip.com/downloads/en/DeviceDoc/doc0015.pdf 27C512]
