land-boards/lb-boards/RetroCPUs/SIMPLE-68008/PartsList/SIMPLE-68008.csv

Find | Qty | Ref Des | Part Number | Find | Qty | Ref Des | Part Number
1 | 7 | C1-C6, C9 | 0.1uF | 10 | 1 | U5 | [https://www.nxp.com/docs/en/reference-manual/MC68000UM.pdf MC68008D-10]
2 | 1 | C7 | 0-5pf | 11 | 1 | U6 | 68681
3 | 1 | C8 | 10-15pF | 12 | 1 | U7 | [https://www.alliancememory.com/wp-content/uploads/pdf/AS6C4008.pdf AS6C4008-55PCN]
4 | 6 | R1-R6 | [https://www.mouser.com/ProductDetail/Xicon/299-2.7K-RC?qs=sGAEpiMZZMsPqMdJzcrNwi5wZazroUaaviDzz9InDsw%3D 2.7K] | 13 | 1 | U8 | [http://ww1.microchip.com/downloads/en/devicedoc/doc0189.pdf EEPROM]
5 | 1 | Y1 | 3.6864 MHz | 14 | 1 | H1 | HEADER, STRT, 2X4
6 | 1 | SW1 | PUSHBUTTON, 6MM | 15 | 5 | H2, H3, H4, H5, H6 | JUMPER (1X3)
7 | 1 | U1 | OSC, 10 MHz | 16 | 1 | J1 | Conn_02x06_Odd_Even
8 | 2 | U2, U3 | GAL16V8 | 17 | 1 | J2 | Conn_01x06
9 | 1 | U4 | [https://www.mouser.com/c/?q=DS1813-5 DS1813-5 (OPT)] | 18 | 1 | J3 | Conn_01x08
