land-boards/lb-boards/RetroCPUs/SIMPLE-6809/PartsList/SIMPLE-6809.csv

Find | Qty | Ref Des | Part Number | Find | Qty | Ref Des | Part Number
1 | 4 | C1, C2, C3, C4 | [https://www.mouser.com/ProductDetail/710-860020672005 1uF] | 10 | 1 | U3 | [https://www.jameco.com/Jameco/Products/ProdDS/43633.pdf MC68B50]
2 | 2 | C5, C6 | 8pF | 11 | 1 | U4 | [http://ww1.microchip.com/downloads/en/DeviceDoc/doc0015.pdf 27C512]
3 | 5 | C7, C8, C9, C12, C13 | 0.1uF | 12 | 1 | U5 | [http://pdf.datasheetcatalog.com/datasheet/motorola/MC68B09S.pdf MC68B09]
4 | 1 | C10 | 47uF | 13 | 1 | U6 | [https://www.mouser.com/ProductDetail/595-SN74HC00AN 74HC00]
5 | 1 | Y1 | [https://www.mouser.com/ProductDetail/815-ABL-7.3728-B2 7.3728 MHz] | 14 | 1 | U7 | [https://www.mouser.com/c/?q=DS1813-5 DS1813-5]
6 | 4 | R1, R2, R6, R7 | [https://www.mouser.com/ProductDetail/Xicon/299-2.2K-RC?qs=QaPBMFBEHz3RDbXknTj%252ByA%3D%3D 2.7K] | 15 | 1 | J1 | [https://www.mouser.com/ProductDetail/649-D09P13B4PA00LF DB9_Male]
7 | 1 | SW1 | PUSHBUTTON, 6MM | 16 | 2 | J2, J5 | JUMPER, EEP (1X3)
8 | 1 | U1 | [http://www.ti.com/lit/ds/symlink/max232.pdf MAX232] | 17 | 1 | J3 | HEADER, STRT, 1X6
9 | 1 | U2 | [https://www.mouser.com/ProductDetail/Alliance-Memory/AS6C62256-55PCN?qs=LD2UibpCYJqgbIupMJnGTQ%3D%3D AS6C62256-55PCN] | 18 | 1 | J4 | HEADER, STRT, 2X4
