land-boards/lb-boards/HamRadio/Colpitts_XTAL_Osc/PARTSLIST/CP-OSC_PL.csv

Qty | Value | RefDes | Qty | Value | RefDes
1 | 0.1uF | C4 | 2 | 2N3904 | Q1,Q2
1 | 10nF | C3 | 1 | BNC | J1
2 | 470PF | C1,C2 | 1 | Conn_01x06 | J2
2 | 10K | R1,R2 | 1 | DCJ0202 | J3
3 | 1K | R3-R5 | 1 | SMA | P1
1 | 47 | R6 | 1 | UUT-Crystal | Y5
