land-boards/lb-boards/HamRadio/VFO-003/Parts List/VFO-003_Rev2_PL.csv

Qty | Value | RefDes | Qty | Value | RefDes
7 | 0.1uF | C2-C8 (0805) | 3 | SMA-F (OPT) | J9,J10,J11
1 | 10uF | C1 (1206) | 3 | BNC (OPT) | P1,P2,P3
9 | 150 | R7-R9,R12-R17 | 1 | Conn, Strt, 1x2 | J6
3 | 1K | R4-R6 | 1 | Conn, Strt, 1x6 | J4
5 | 2.2K | R1-R3,R10,R11 | 3 | Conn, 1x8 | J2,J3,J8
2 | 74AC14 | U4,U5 | 1 | Conn, 1x10 | J5
1 | Si5351A | U3 | 1 | Conn, 2x3 | J7
1 | ASE-xxxMHz | X1 | 1 | DCJ0202 | J99
1 | MINI-360 | BRD1 | 2 | Rotary_Encoder_Switch | SW1 OR SW2
1 | ARDUPROMINI-3.3V | U1 | 1 | OLED_I2C | J1
