land-boards/lb-boards/Arduino Cards/ToidUino/parts/pictures/alt-large-tin-usb.jpg

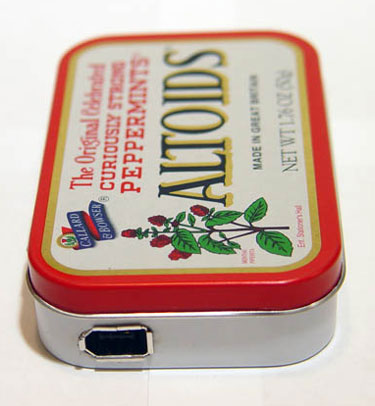
Arduino Cards/ToidUino/parts/pictures/alt-large-tin-usb.jpg
