land-boards/lb-boards/Arduino Cards/ToidUino/parts/pictures/LiPo.jpeg

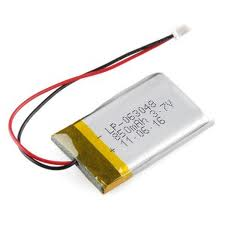
Arduino Cards/ToidUino/parts/pictures/LiPo.jpeg
