land-boards/lb-boards/Arduino Cards/ToidUino/parts/pictures/ToiDuinoInAltoidsTin.png

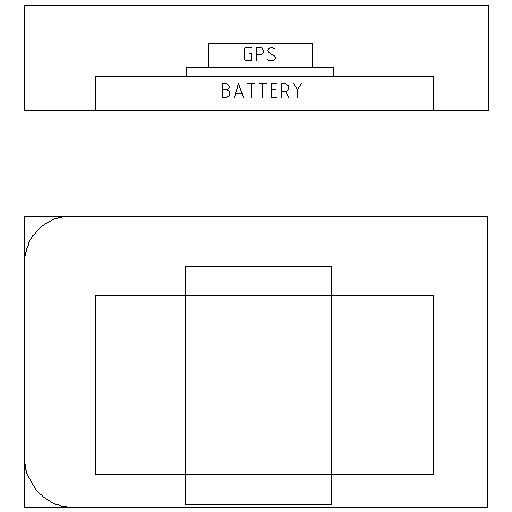
Arduino Cards/ToidUino/parts/pictures/ToiDuinoInAltoidsTin.png
