land-boards/lb-boards/HamRadio/BUTTER07/PartsAndKits/CWAZ_125W/CWAZ-20M/Pics/CWAZ-20M_P1828.JPG

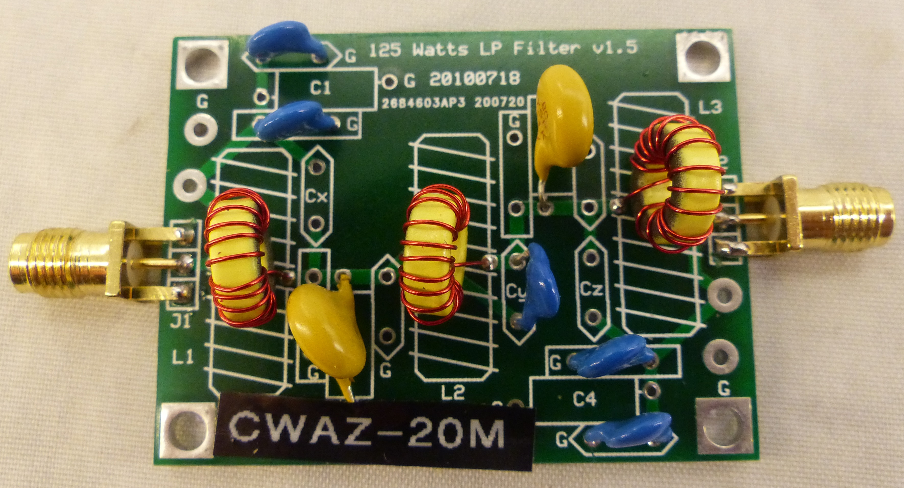
HamRadio/BUTTER07/PartsAndKits/CWAZ_125W/CWAZ-20M/Pics/CWAZ-20M_P1828.JPG
