land-boards/lb-boards/HamRadio/BUTTER07/PartsAndKits/CWAZ_125W/CWAZ-40M/Pics/125W_40M_KandP_Filter/P1070845.JPG

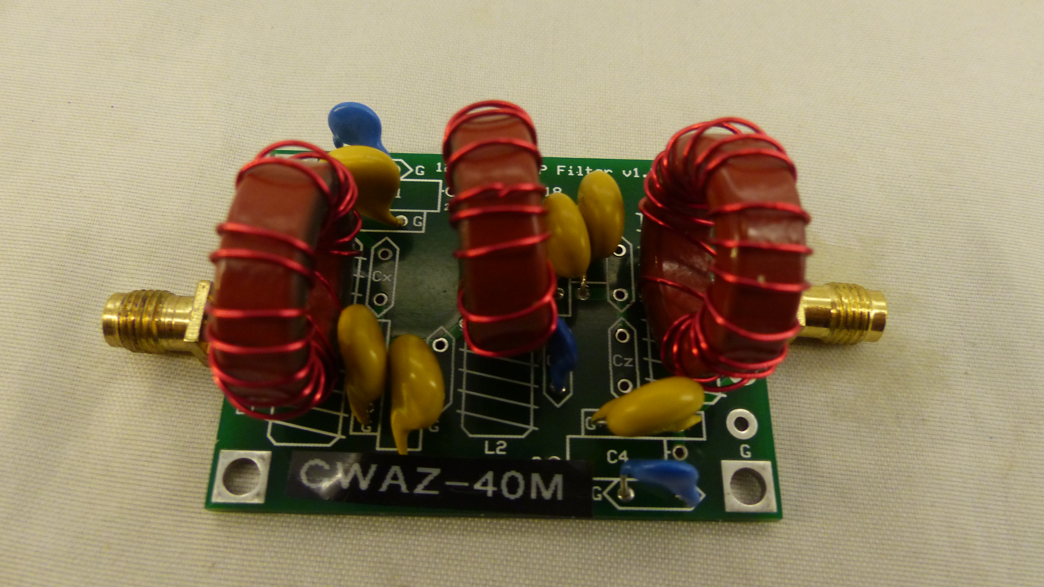
HamRadio/BUTTER07/PartsAndKits/CWAZ_125W/CWAZ-40M/Pics/125W_40M_KandP_Filter/P1070845.JPG
