land-boards/lb-boards/HamRadio/VFO-001/Pictures/Parts Pics/4f94a3ec-b251-4afd-8f34-ba00c37fba60.jpg

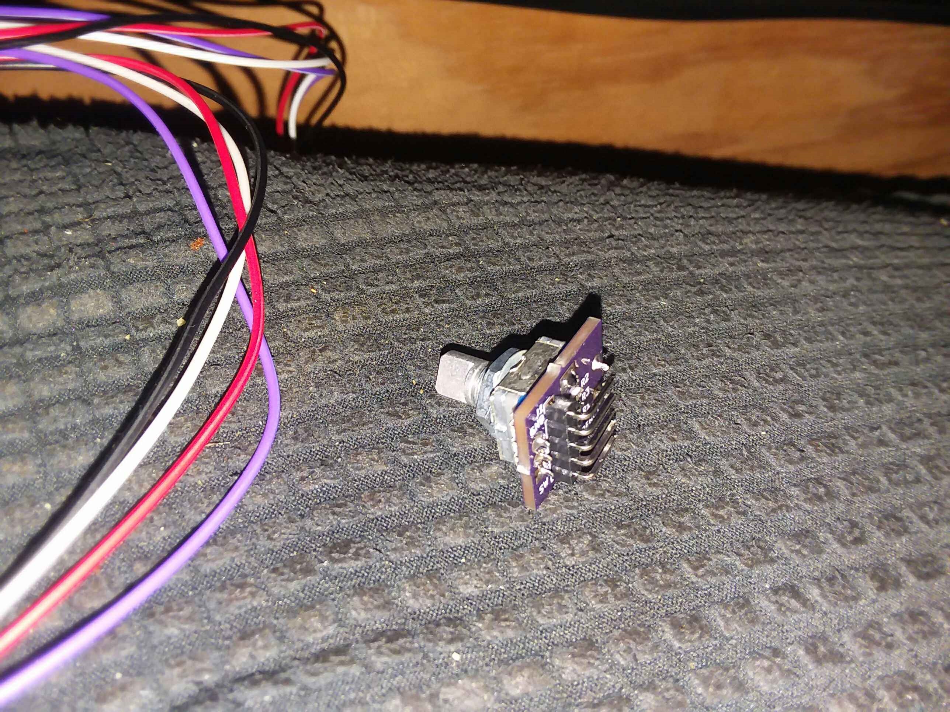
HamRadio/VFO-001/Pictures/Parts Pics/4f94a3ec-b251-4afd-8f34-ba00c37fba60.jpg
