land-boards/lb-boards/HamRadio/VFO-001/Pictures/Parts Pics/Mini-360-2.jpg

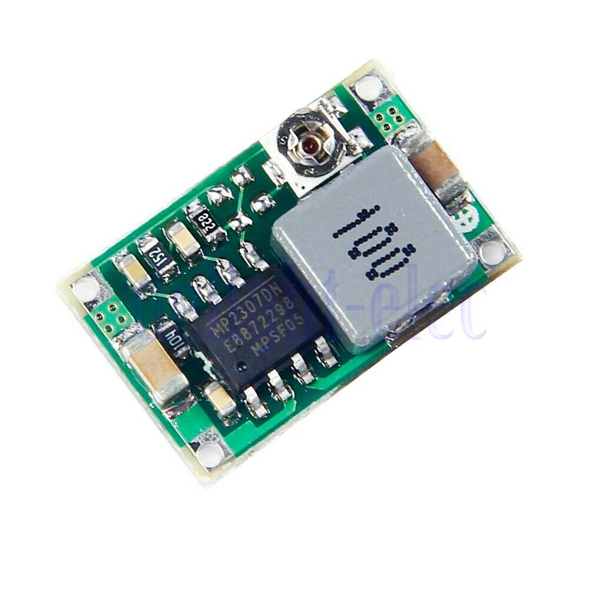
HamRadio/VFO-001/Pictures/Parts Pics/Mini-360-2.jpg
