land-boards/lb-boards/HamRadio/VFO-001/Pictures/Parts Pics/Mini-360-720px.jpg

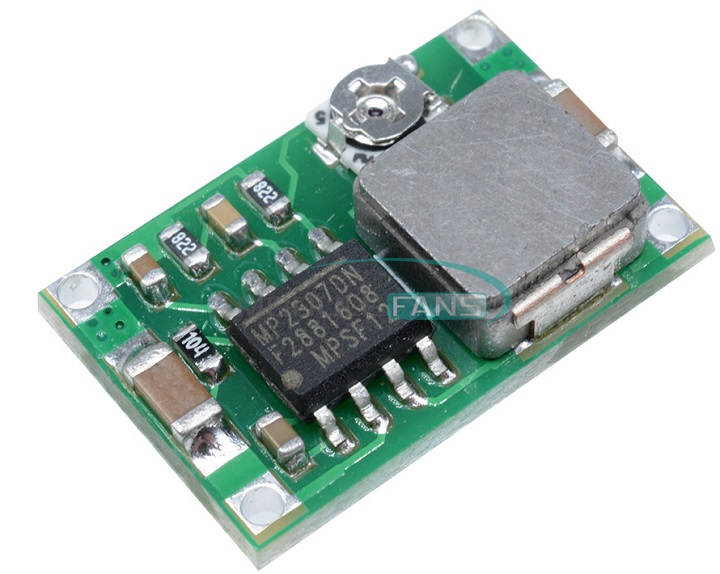
HamRadio/VFO-001/Pictures/Parts Pics/Mini-360-720px.jpg
