land-boards/lb-boards/Projects/IReflow/pictures/OvenParts/IMG_4966.JPG

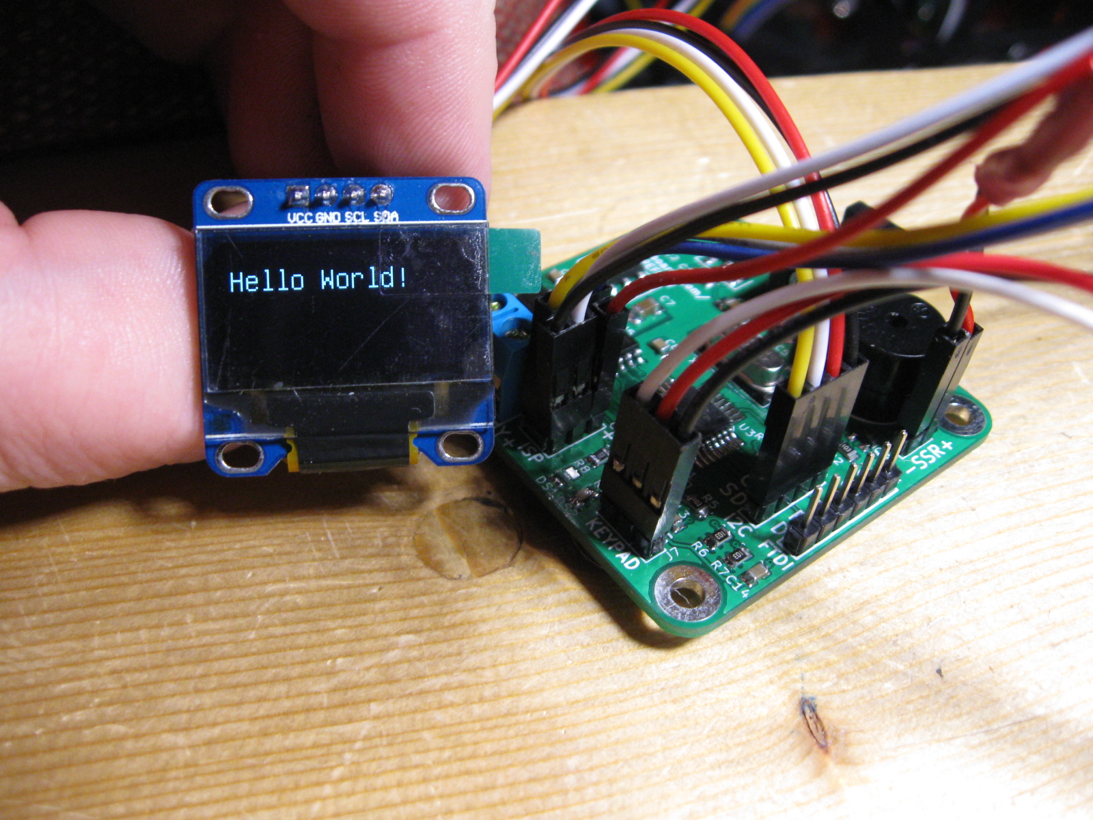
Projects/IReflow/pictures/OvenParts/IMG_4966.JPG
