land-boards/lb-boards/Projects/IReflow/pictures/OvenParts/Oster-TSSTTVDFL2-1.jpg

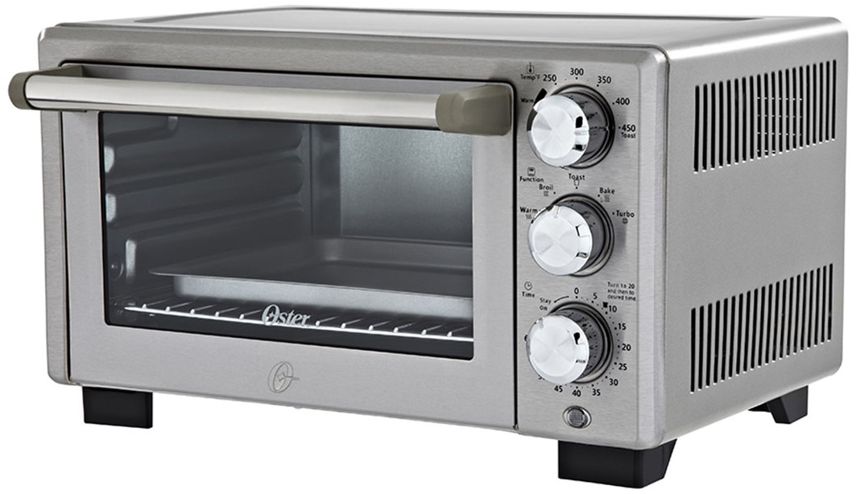
Projects/IReflow/pictures/OvenParts/Oster-TSSTTVDFL2-1.jpg
