land-boards/lb-boards/SYNTHS/ER-PROTO-01_SET/ER-PROTO-01-NANO-MOZZI/PICS/3D/ER-MOZZI-PARTS_3D.PNG

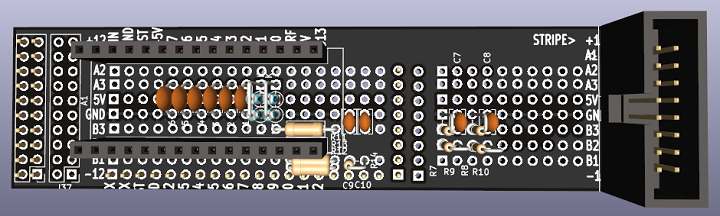
SYNTHS/ER-PROTO-01_SET/ER-PROTO-01-NANO-MOZZI/PICS/3D/ER-MOZZI-PARTS_3D.PNG
