land-boards/lb-boards/Arduino Cards/ToidUino/parts/Placement.dxf

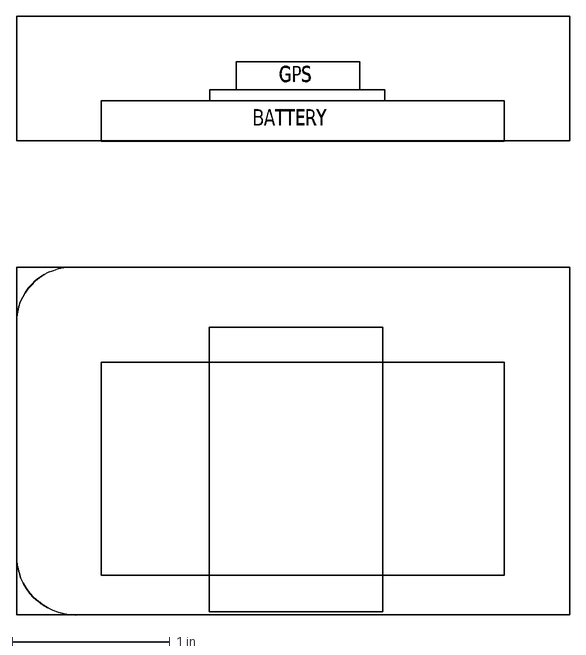
[picture p132: CAD file, 2012-09-03]
Arduino Cards/ToidUino/parts/Placement.dxf
BATTERY
GPS
