land-boards/lb-boards/Audio Cards/Pot_Pins/Parts/nys-354-1.dxf

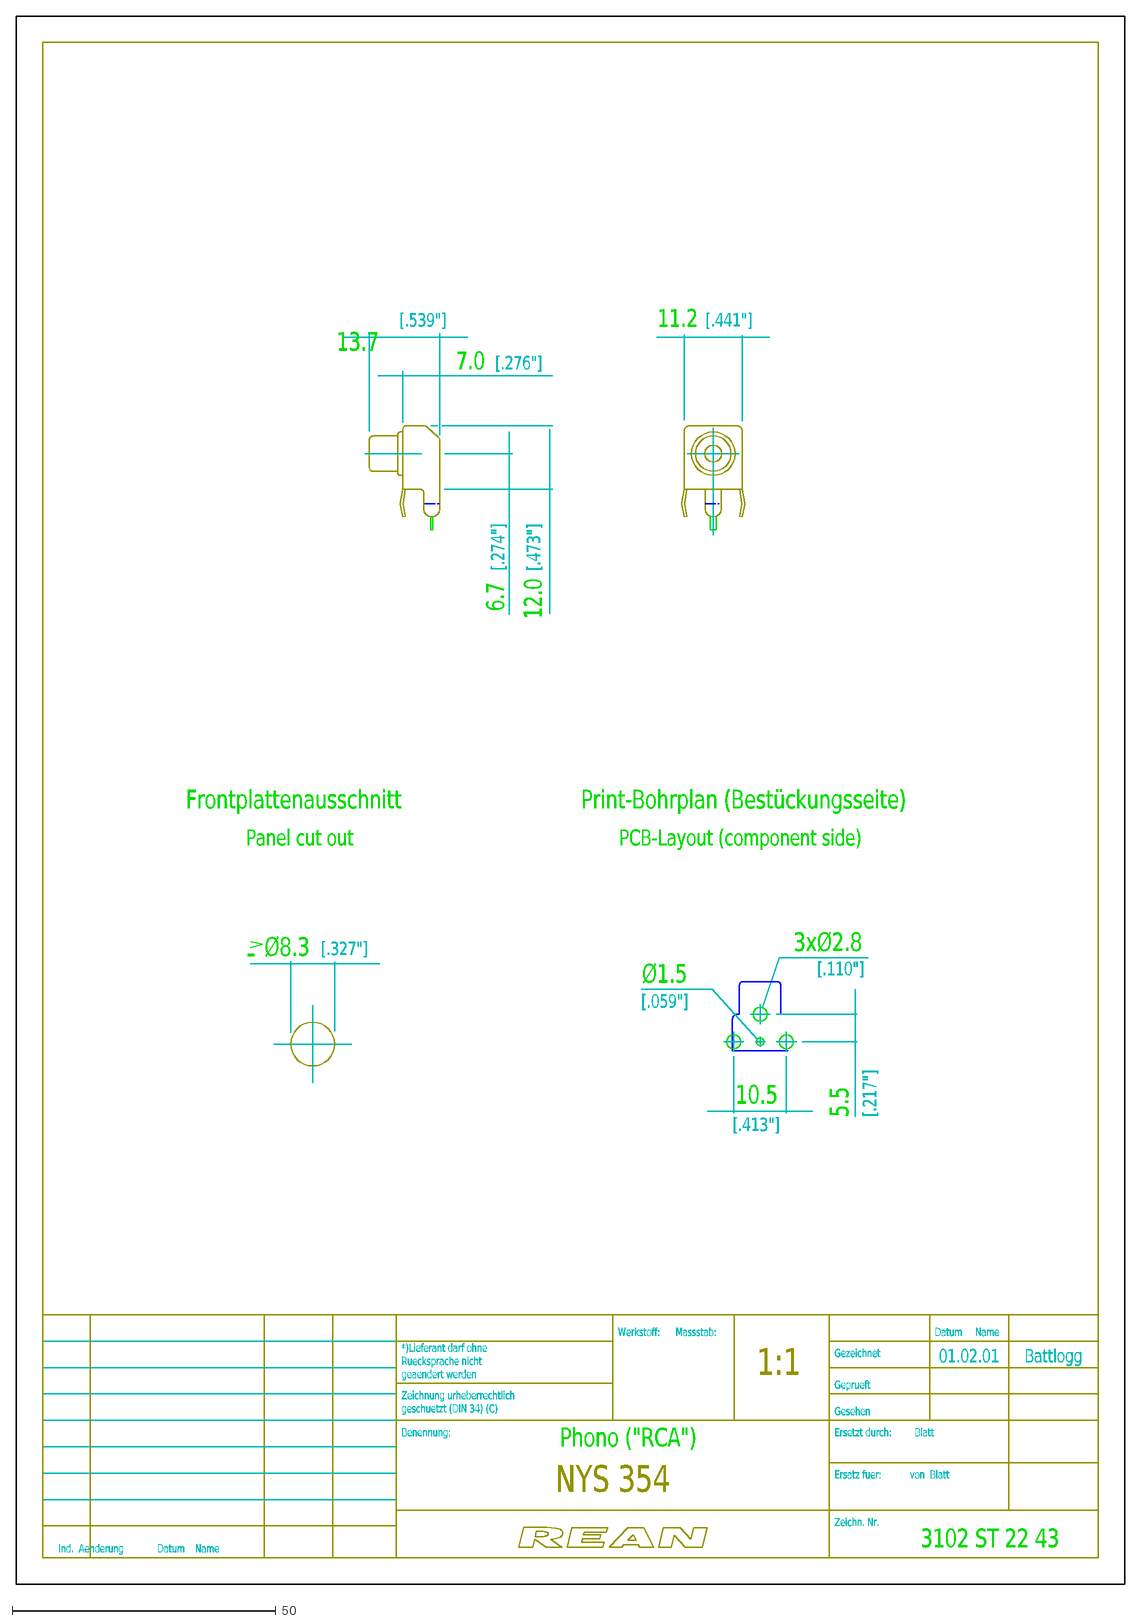
[picture p133: CAD file, 2012-07-01]
Audio Cards/Pot_Pins/Parts/nys-354-1.dxf
6.7
7.0
12.0
11.2
13.7
[.327"]
Ø8.3
-
Panel\~cut\~out
Frontplattenausschnitt
Print-Bohrplan\~(Bestückungsseite)
PCB-Layout\~(component\~side)
[.539"]
[.441"]
[.276"]
[.274"]
[.473"]
10.5
[.413"]
[.059"]
Ø1.5
3xØ2.8
[.110"]
5.5
[.217"]
Zeichn.\~Nr.
Ersetzt\~durch:\~\~\~\~\~\~\~\~\~Blatt
Gezeichnet
Gesehen
Datum\~\~\~\~\~Name
Werkstoff:\~\~\~\~\~\~Massstab:
Benennung:
*)Lieferant\~darf\~ohne
Ruecksprache\~nicht
geaendert\~werden
Zeichnung\~urheberrechtlich
geschuetzt\~(DIN\~34)\~(C)
Geprueft
Ersatz\~fuer:\~\~\~\~\~\~\~\~\~\~\~von\~\~Blatt
Ind.\~\~Aenderung\~\~\~\~\~\~\~\~\~\~\~\~\~Datum\~\~\~\~Name
Battlogg
01.02.01
NYS\~354
Phono\~("RCA")
3102\~ST\~22\~43
1:1
