land-boards/lb-boards/GPS Cards/USB-GPS-Hammond/parts/PowerSwitch-RS-275-409.dxf

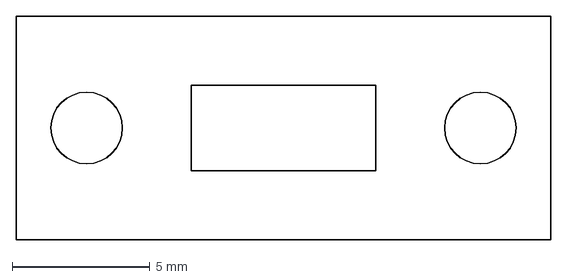
[picture p134: CAD file, 2012-12-21]
GPS Cards/USB-GPS-Hammond/parts/PowerSwitch-RS-275-409.dxf
19.4 x 8.10 mm
