land-boards/lb-boards/GVS Cards/IRSens-2/plots/IRSens-2-Dwgs_User.dxf

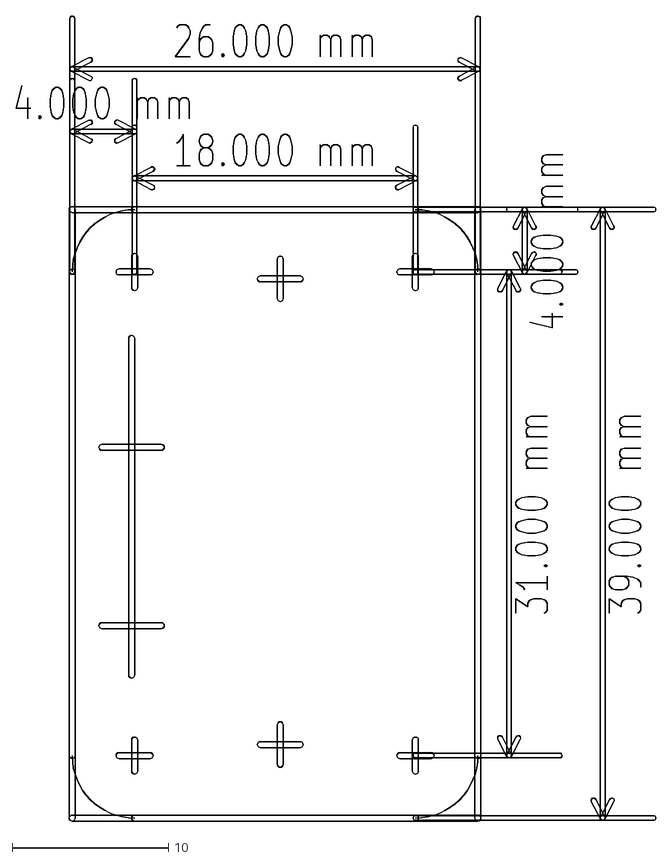
[picture p135: CAD file, 2015-02-15]
GVS Cards/IRSens-2/plots/IRSens-2-Dwgs_User.dxf
41.0 x 51.6
