land-boards/lb-boards/HamRadio/CRYSTAL_FILTERS/SSB6/REV1/SSB6.step

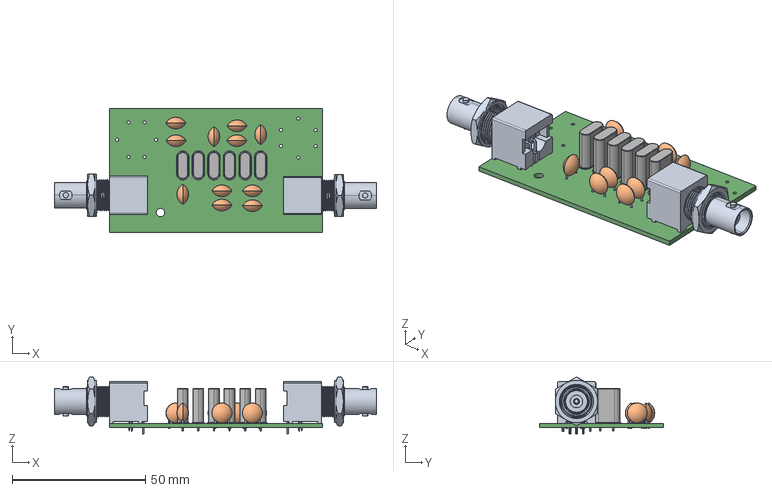
[picture p136: CAD file, 2021-09-03]
HamRadio/CRYSTAL_FILTERS/SSB6/REV1/SSB6.step
120.8 x 46.5 x 21.4 mm
