land-boards/lb-boards/HamRadio/VFO-003/Pictures/STP_Files/BNC/31-5431-10RFX.stp

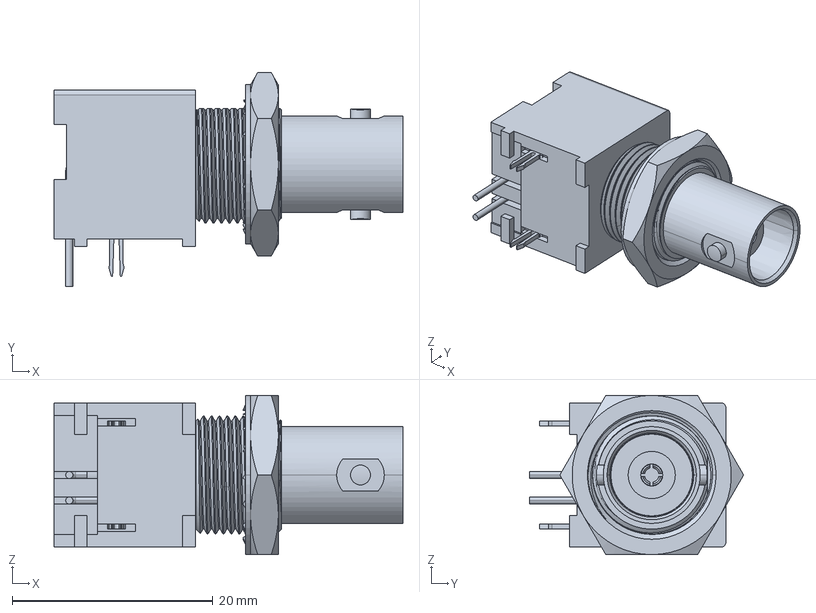
[picture p137: CAD file, 2020-11-30]
HamRadio/VFO-003/Pictures/STP_Files/BNC/31-5431-10RFX.stp
34.8 x 21.4 x 15.9 mm
