land-boards/lb-boards/HamRadio/VFO-003/Pictures/STP_Files/DC_Jack/DS-201B.step

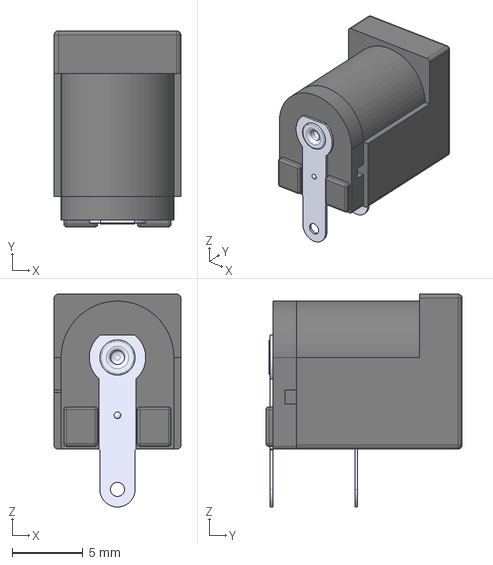
[picture p138: CAD file, 2020-11-30]
HamRadio/VFO-003/Pictures/STP_Files/DC_Jack/DS-201B.step
9.00 x 13.9 x 15.1 mm
