land-boards/lb-boards/HamRadio/VFO-003/Pictures/STP_Files/OLED/OLED_0.91_128x32.stp

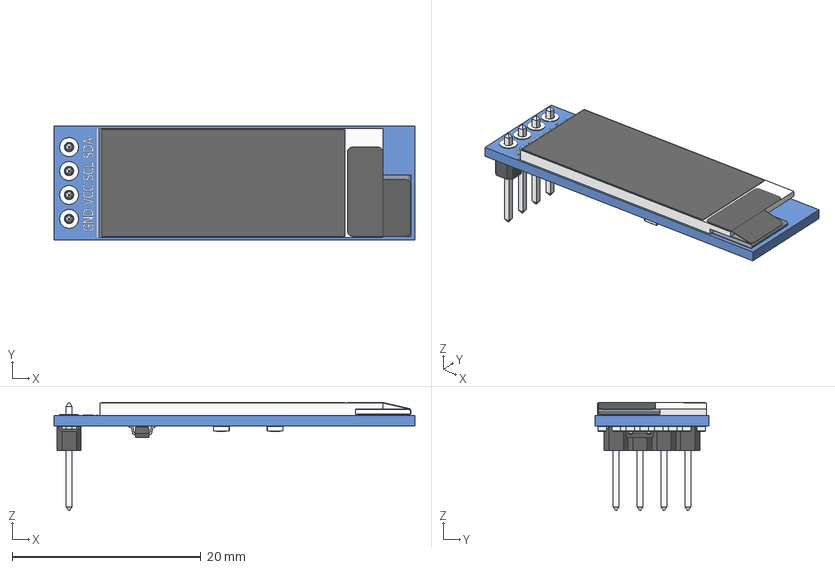
[picture p139: CAD file, 2020-11-30]
HamRadio/VFO-003/Pictures/STP_Files/OLED/OLED_0.91_128x32.stp
38.3 x 12.1 x 11.5 mm
OLED_0.91_128x32
Pin Header 4 x 1 TH 2.54mm Pitch
RESC-0603 x 13
2SD0601A
