land-boards/lb-boards/HamRadio/VFO-003/Pictures/STP_Files/Rotary-Encoder/encoder_RotativoPush_5PIN_M7.SLDPRT

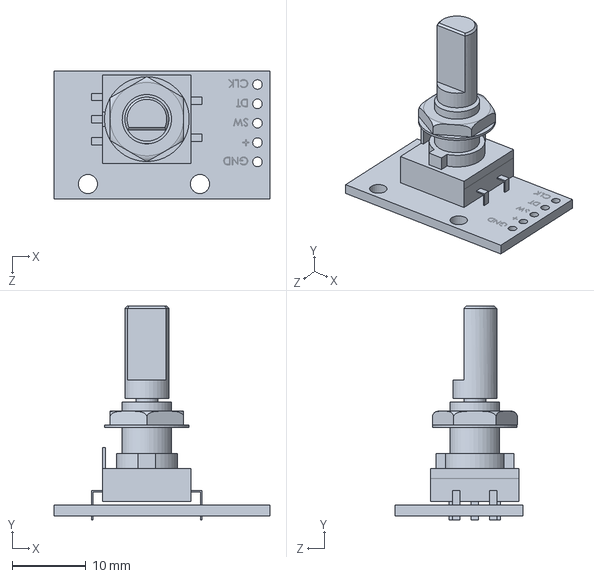
[picture p140: CAD file, 2020-11-30]
HamRadio/VFO-003/Pictures/STP_Files/Rotary-Encoder/encoder_RotativoPush_5PIN_M7.SLDPRT
29.3 x 29.0 x 17.3 mm
