land-boards/lb-boards/Hardware/PCIe outline/PCIe Outline.dxf

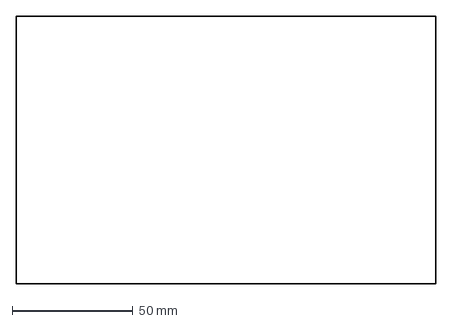
[picture p141: CAD file, 2012-07-11]
Hardware/PCIe outline/PCIe Outline.dxf
174.0 x 111.2 mm
