land-boards/lb-boards/I2C Cards/DigIO32-I2C/plots/DigIO32-I2C-drl_map.dxf

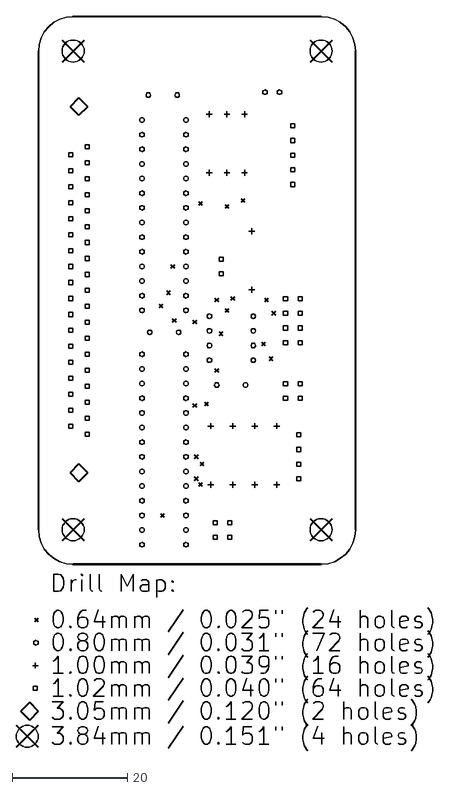
[picture p142: CAD file, 2018-12-25]
I2C Cards/DigIO32-I2C/plots/DigIO32-I2C-drl_map.dxf
72.3 x 127.4
