land-boards/lb-boards/I2C Cards/Proto16-I2C/Rev-X2/plots/Proto16-I2C-drl_map.dxf

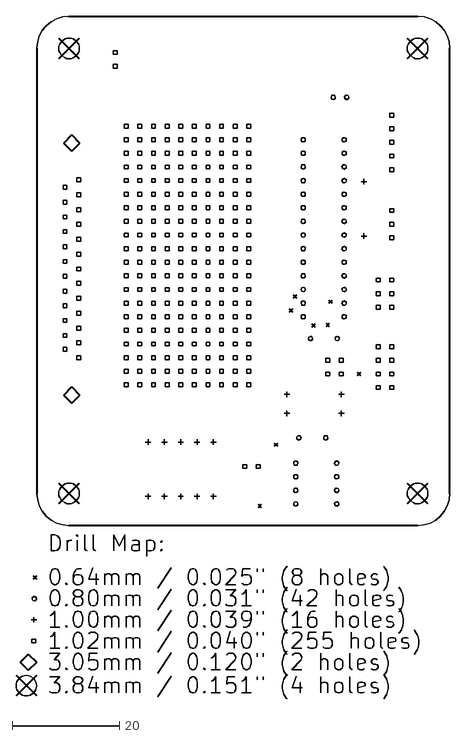
[picture p143: CAD file, 2018-12-25]
I2C Cards/Proto16-I2C/Rev-X2/plots/Proto16-I2C-drl_map.dxf
80.9 x 127.4
