land-boards/lb-boards/KiCAD/3D_STP_Files/AUD_PJ-301BM/AUD_PJ-301BM.step

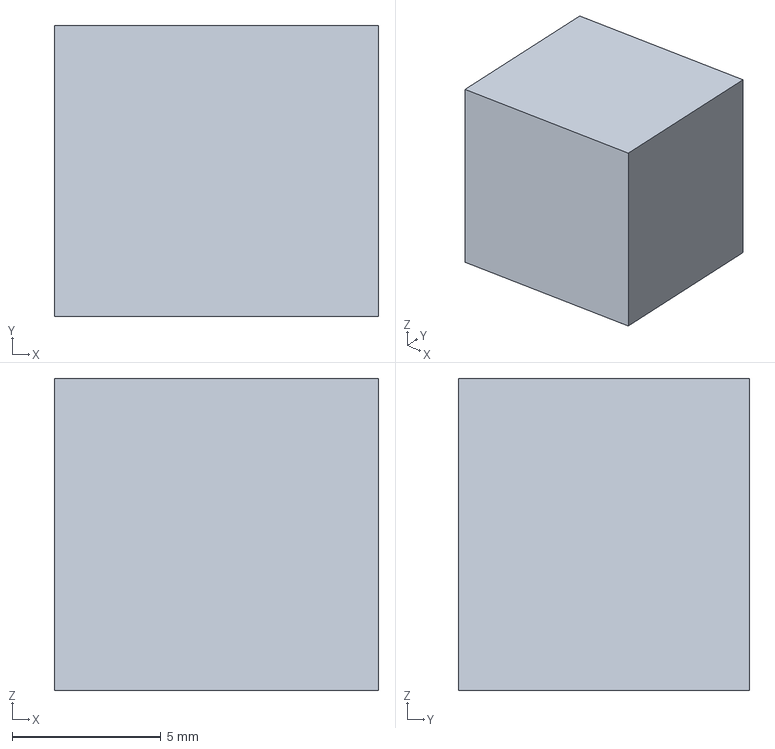
[picture p144: CAD file, 2022-10-10]
KiCAD/3D_STP_Files/AUD_PJ-301BM/AUD_PJ-301BM.step
10.9 x 9.80 x 10.5 mm
