land-boards/lb-boards/KiCAD/3D_STP_Files/Audio_Jack/AudioJack.FCStd

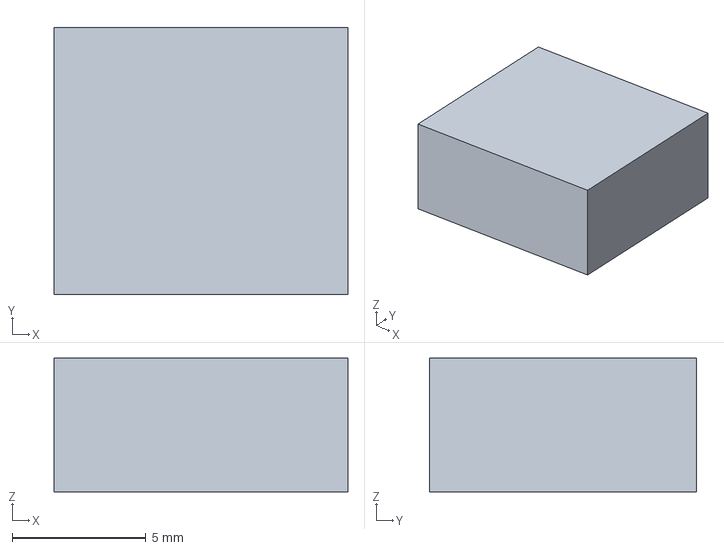
[picture p145: CAD file, 2022-10-10]
KiCAD/3D_STP_Files/Audio_Jack/AudioJack.FCStd
11.0 x 10.0 x 5.00 mm
