land-boards/lb-boards/KiCAD/3D_STP_Files/Audio_Thonny/PJ302M.step

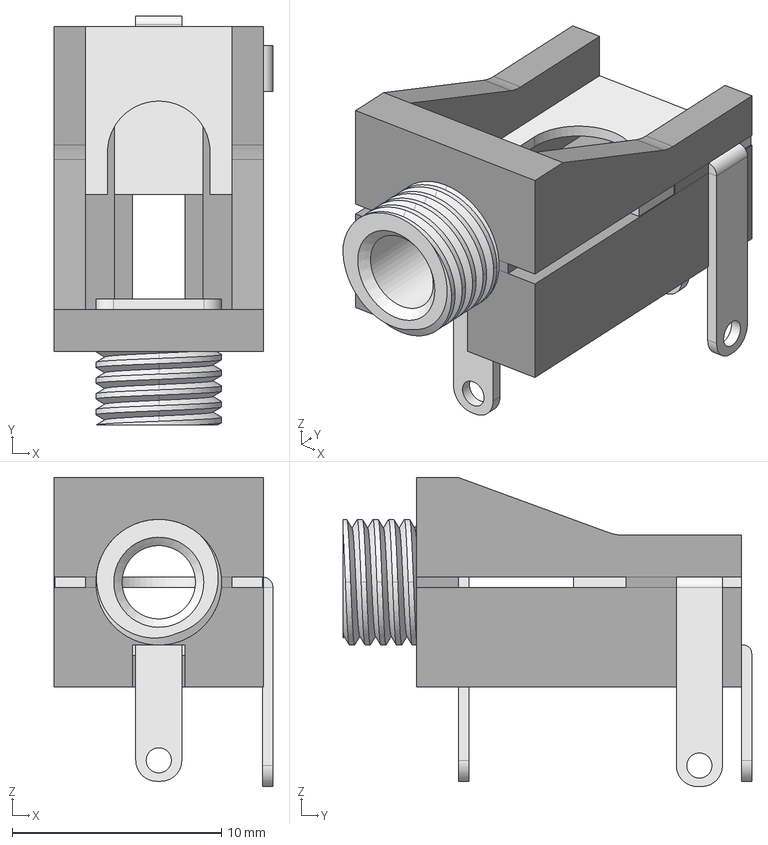
[picture p146: CAD file, 2022-10-10]
KiCAD/3D_STP_Files/Audio_Thonny/PJ302M.step
10.4 x 19.5 x 14.8 mm
