land-boards/lb-boards/KiCAD/3D_STP_Files/DIN-5_MIDI.FCStd

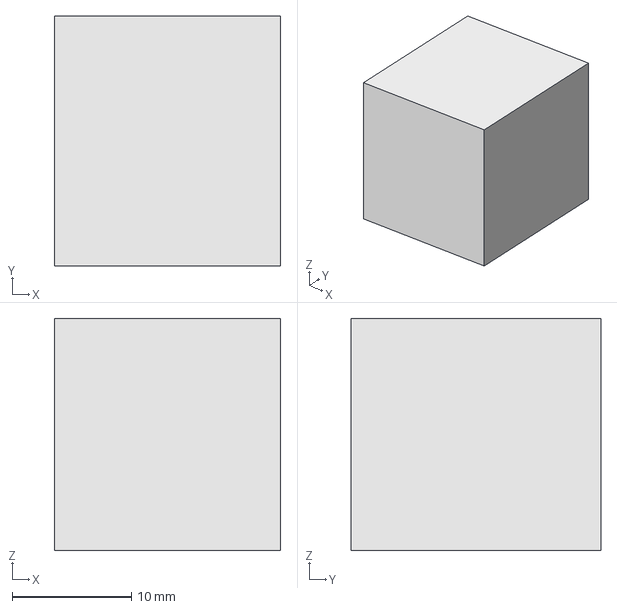
[picture p147: CAD file, 2022-10-10]
KiCAD/3D_STP_Files/DIN-5_MIDI.FCStd
19.0 x 21.0 x 19.5 mm
