land-boards/lb-boards/KiCAD/3D_STP_Files/DS1307/DS1307.FCStd

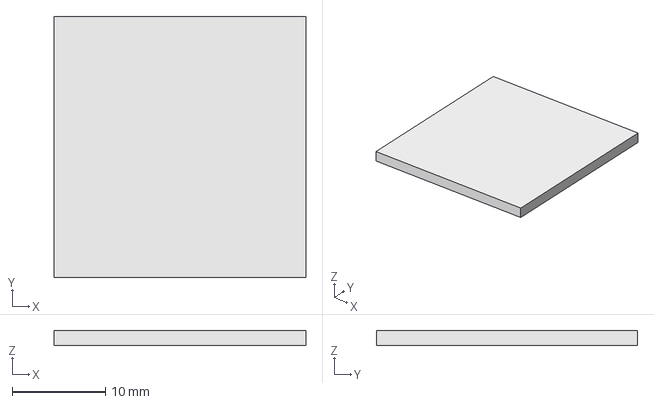
[picture p148: CAD file, 2022-10-10]
KiCAD/3D_STP_Files/DS1307/DS1307.FCStd
27.0 x 28.0 x 1.60 mm
