land-boards/lb-boards/KiCAD/3D_STP_Files/MAX7912_MODULE/MAX7912_MODULE.FCStd

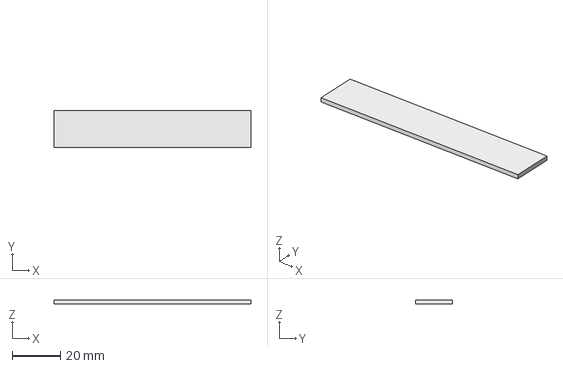
[picture p149: CAD file, 2022-10-10]
KiCAD/3D_STP_Files/MAX7912_MODULE/MAX7912_MODULE.FCStd
82.0 x 15.5 x 1.60 mm
