land-boards/lb-boards/KiCAD/3D_STP_Files/Mini-360/Mini-360.step

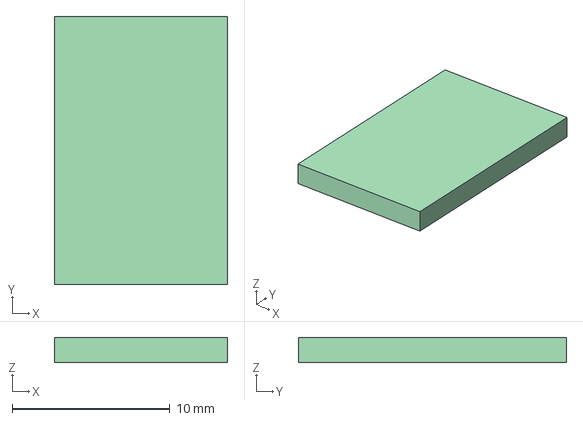
[picture p150: CAD file, 2022-10-10]
KiCAD/3D_STP_Files/Mini-360/Mini-360.step
11.0 x 17.0 x 1.60 mm
