land-boards/lb-boards/KiCAD/3D_STP_Files/OLED/0.96 OLED Module - i2C.stp

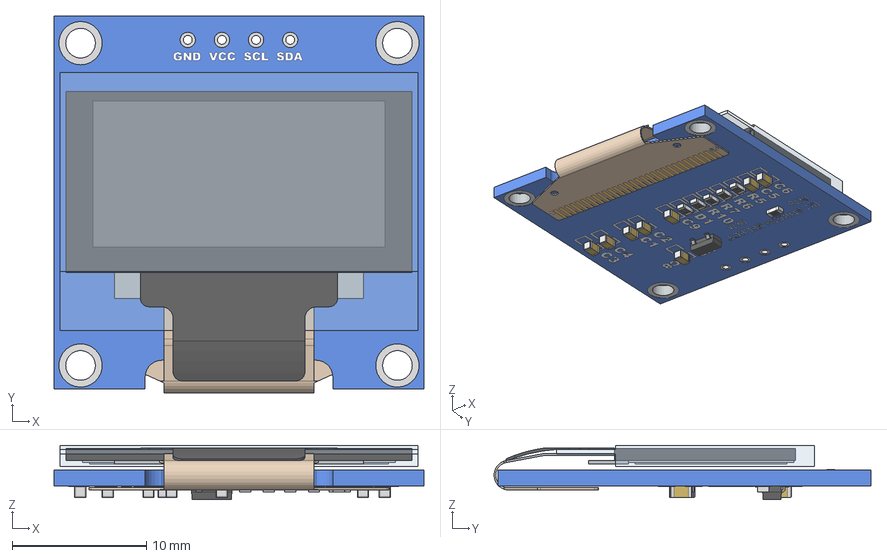
[picture p151: CAD file, 2022-10-10]
KiCAD/3D_STP_Files/OLED/0.96 OLED Module - i2C.stp
27.5 x 28.0 x 4.03 mm
0.96 OLED - Board - i2c
0.96 OLED - Glass
0.96 OLED - Flat Reverse
0603 Resistor x 6
SOT-23
0603 Capacitor x 8
