land-boards/lb-boards/KiCAD/3D_STP_Files/POTS/Potentiometer.step

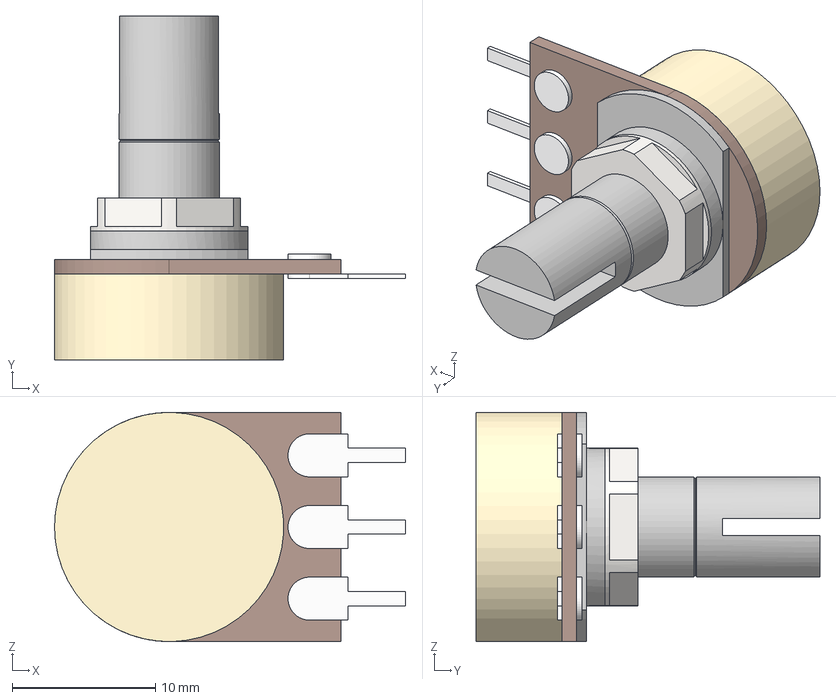
[picture p152: CAD file, 2022-10-10]
KiCAD/3D_STP_Files/POTS/Potentiometer.step
24.5 x 24.0 x 16.0 mm
Rotary top
Nut and washer
