land-boards/lb-boards/KiCAD/3D_STP_Files/POTS/Potentiometers/R-0904N-L-15KS-green.step

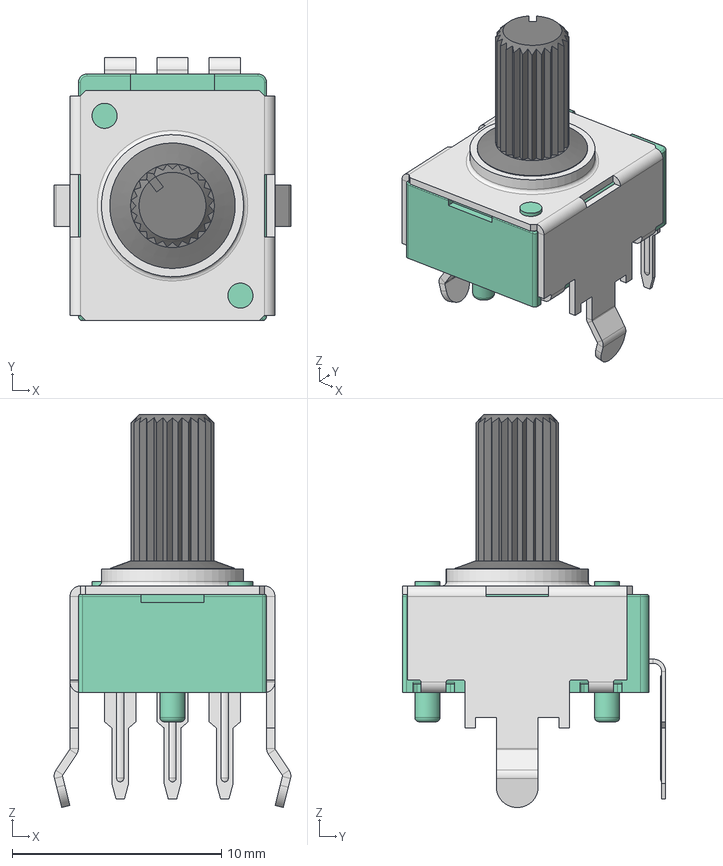
[picture p153: CAD file, 2022-10-10]
KiCAD/3D_STP_Files/POTS/Potentiometers/R-0904N-L-15KS-green.step
11.3 x 12.6 x 18.8 mm
