land-boards/lb-boards/KiCAD/3D_STP_Files/PS2_MiniDIN/PS2_MiniDIN6.step

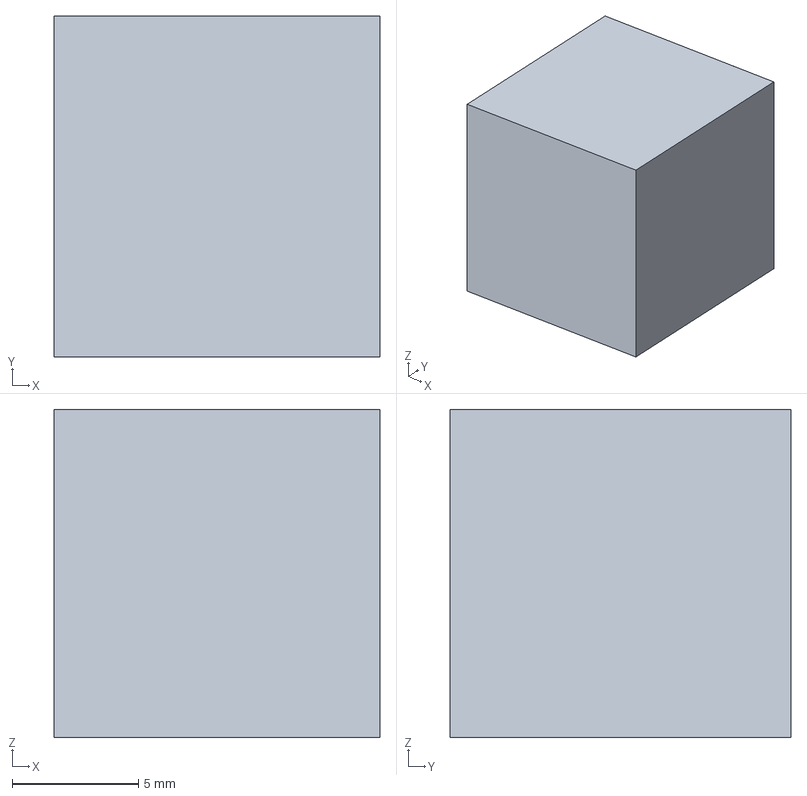
[picture p154: CAD file, 2022-10-10]
KiCAD/3D_STP_Files/PS2_MiniDIN/PS2_MiniDIN6.step
12.9 x 13.5 x 13.0 mm
