land-boards/lb-boards/KiCAD/3D_STP_Files/Raspberry Pi Pico/D1, Diode, Schottky, Raspberry Pi Pico-R3.SLDPRT

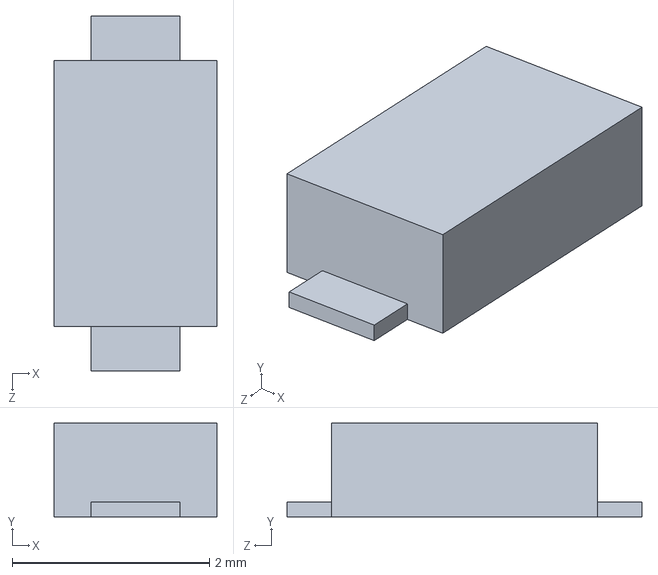
[picture p155: CAD file, 2022-10-10]
KiCAD/3D_STP_Files/Raspberry Pi Pico/D1, Diode, Schottky, Raspberry Pi Pico-R3.SLDPRT
1.65 x 0.95 x 3.60 mm
