land-boards/lb-boards/KiCAD/3D_STP_Files/Raspberry Pi Pico_6/Raspberry Pi Pico.step

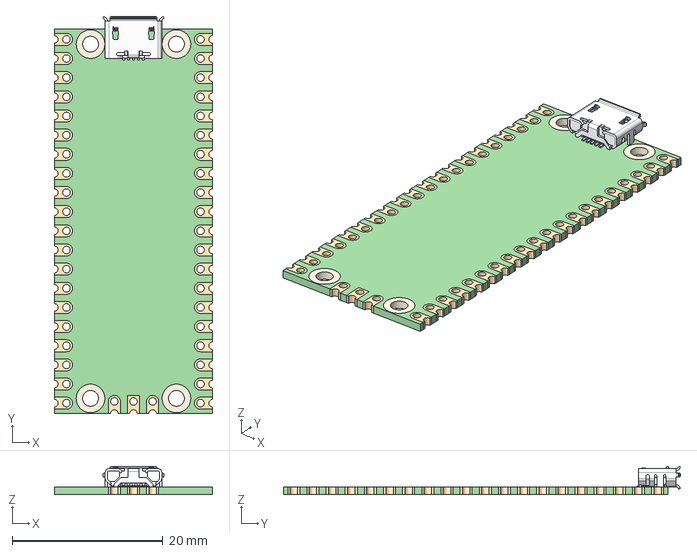
[picture p156: CAD file, 2022-10-10]
KiCAD/3D_STP_Files/Raspberry Pi Pico_6/Raspberry Pi Pico.step
21.0 x 52.7 x 3.73 mm
PCB
Micro-USB_breakout v2
