land-boards/lb-boards/KiCAD/3D_STP_Files/SD_Socket/SD_Socket.step

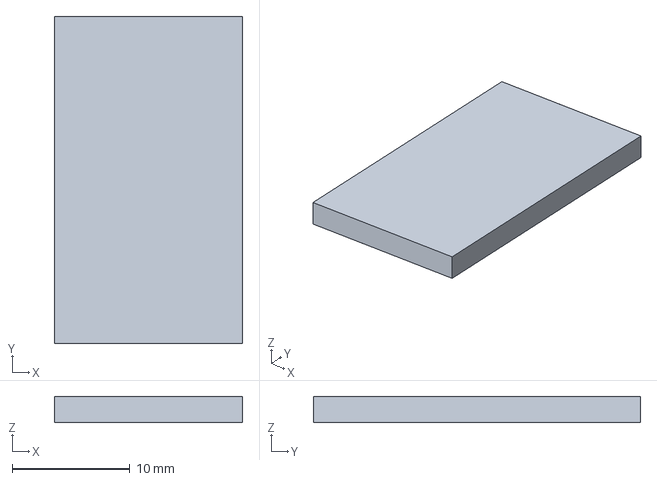
[picture p157: CAD file, 2022-10-10]
KiCAD/3D_STP_Files/SD_Socket/SD_Socket.step
16.0 x 27.8 x 2.25 mm
