land-boards/lb-boards/KiCAD/3D_STP_Files/Slide_Switch_THT_SPDT/Cube.step

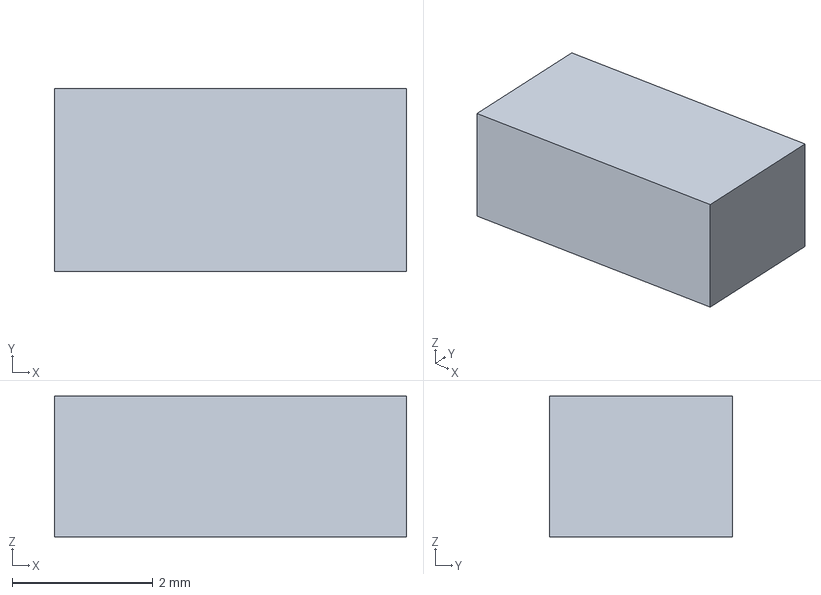
[picture p158: CAD file, 2022-10-10]
KiCAD/3D_STP_Files/Slide_Switch_THT_SPDT/Cube.step
5.00 x 2.60 x 2.00 mm
