land-boards/lb-boards/KiCAD/3D_STP_Files/USB_B/USB.step

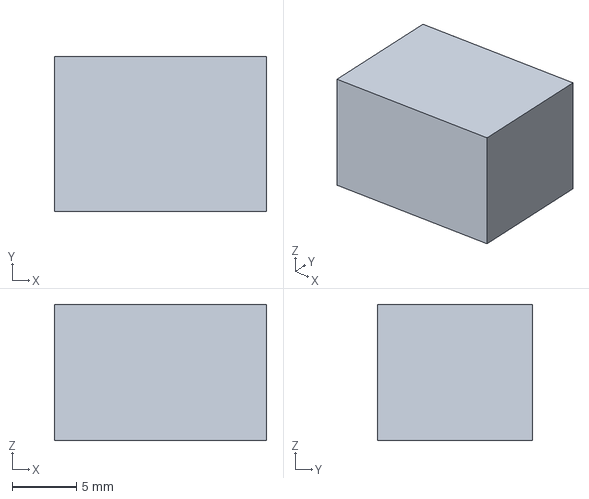
[picture p159: CAD file, 2022-10-10]
KiCAD/3D_STP_Files/USB_B/USB.step
16.5 x 12.1 x 10.6 mm
