land-boards/lb-boards/LEDs Cards/LED-12/LED-12-X1/plots/LED-12-Back.dxf

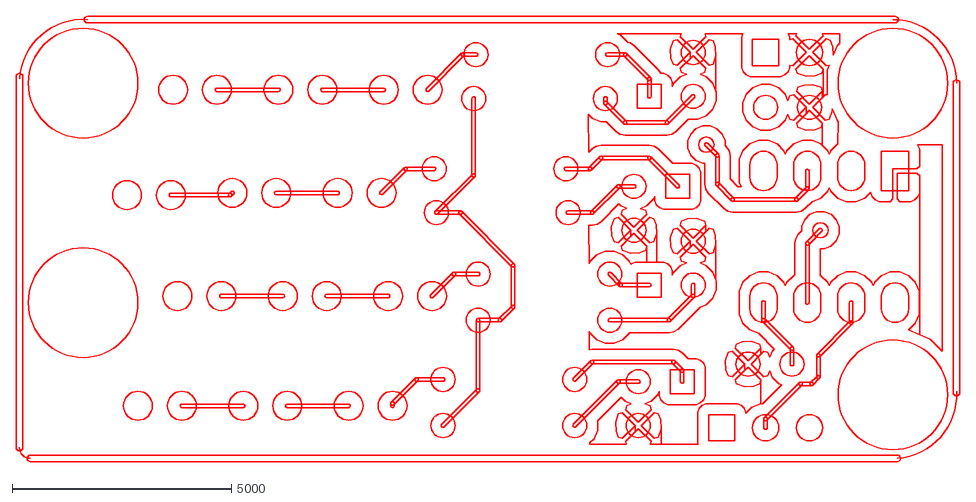
[picture p160: CAD file, 2013-01-22]
LEDs Cards/LED-12/LED-12-X1/plots/LED-12-Back.dxf
21500.0 x 10150.0
