land-boards/lb-boards/LEDs Cards/LED-32/plots/LED-32-drl_map.dxf

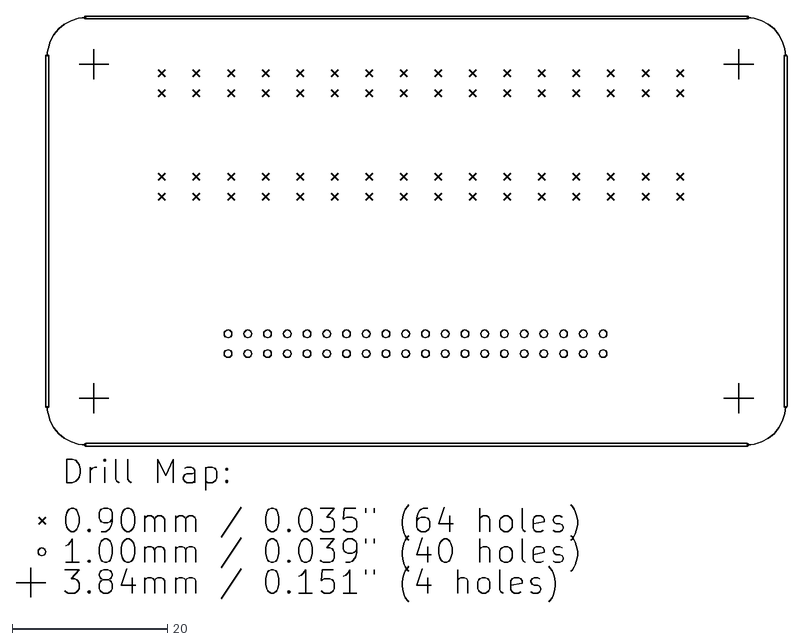
[picture p161: CAD file, 2018-12-25]
LEDs Cards/LED-32/plots/LED-32-drl_map.dxf
99.2 x 75.4
