land-boards/lb-boards/ODAS Cards/Carrier95to49/Rev_X3/plots/Carrier95to49-drl_map.dxf

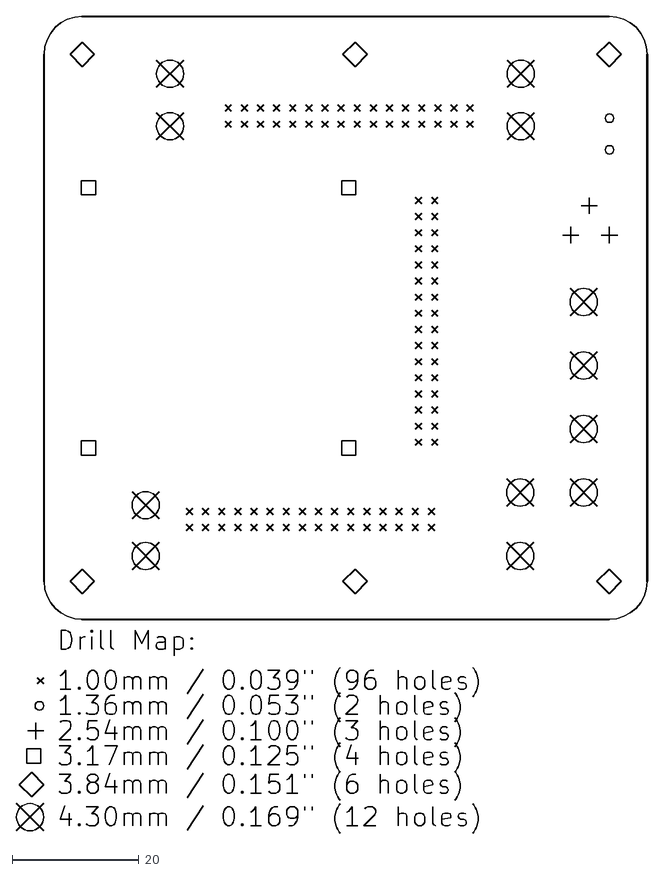
[picture p162: CAD file, 2018-12-25]
ODAS Cards/Carrier95to49/Rev_X3/plots/Carrier95to49-drl_map.dxf
99.4 x 128.7
