land-boards/lb-boards/ODAS Cards/ODAS-PSOC5/Rev X3/Plots/ODAS-PSOC5-drl_map.dxf

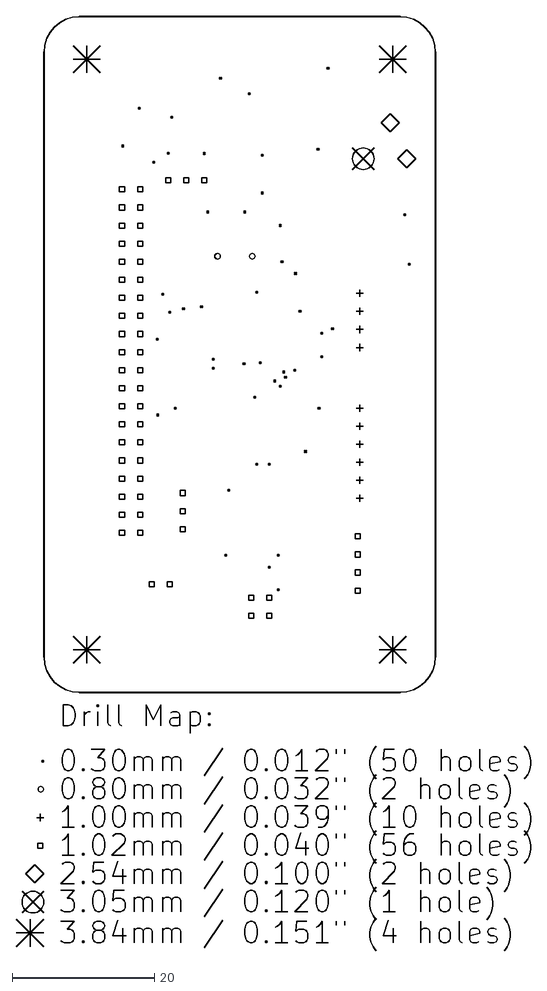
[picture p163: CAD file, 2018-12-25]
ODAS Cards/ODAS-PSOC5/Rev X3/Plots/ODAS-PSOC5-drl_map.dxf
72.3 x 131.3
