land-boards/lb-boards/Opto Cards/OptoFast-2/plots/OptoFast-2-drl_map.dxf

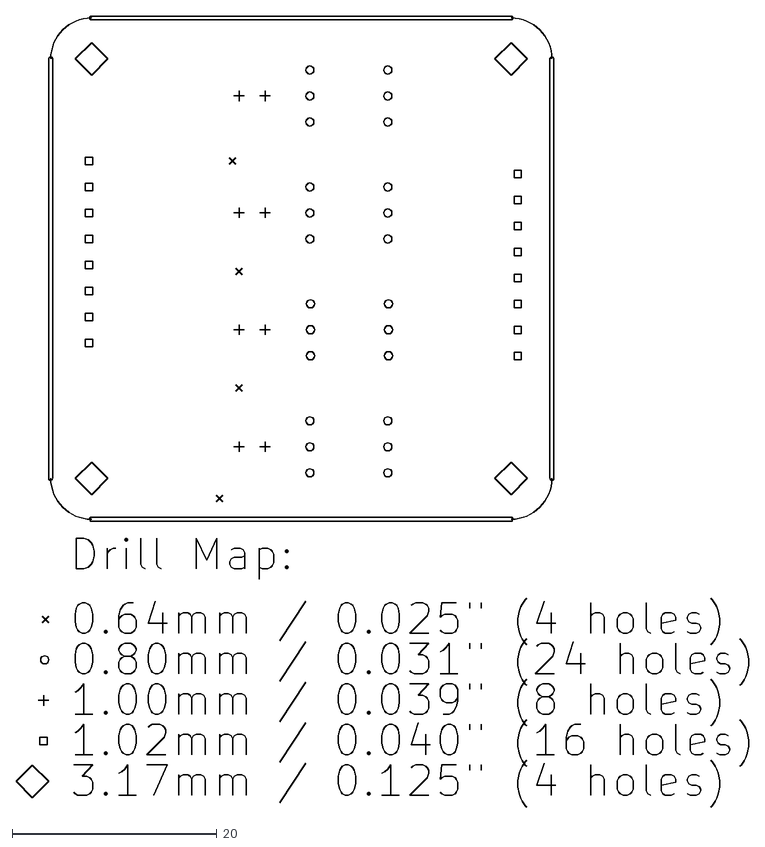
[picture p164: CAD file, 2018-12-25]
Opto Cards/OptoFast-2/plots/OptoFast-2-drl_map.dxf
71.6 x 77.3
