land-boards/lb-boards/Opto Cards/OptoUSB/Rev-X2/plots/OptoUSB-drl_map.dxf

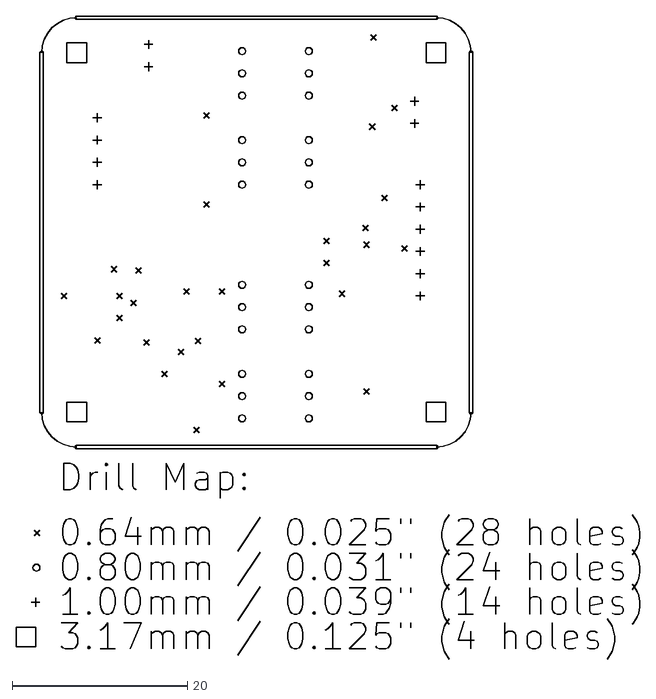
[picture p165: CAD file, 2018-12-25]
Opto Cards/OptoUSB/Rev-X2/plots/OptoUSB-drl_map.dxf
71.1 x 73.4
