land-boards/lb-boards/Power Cards/PWR-BLK-02/plots/PWR-BLK-02-F_Cu.dxf

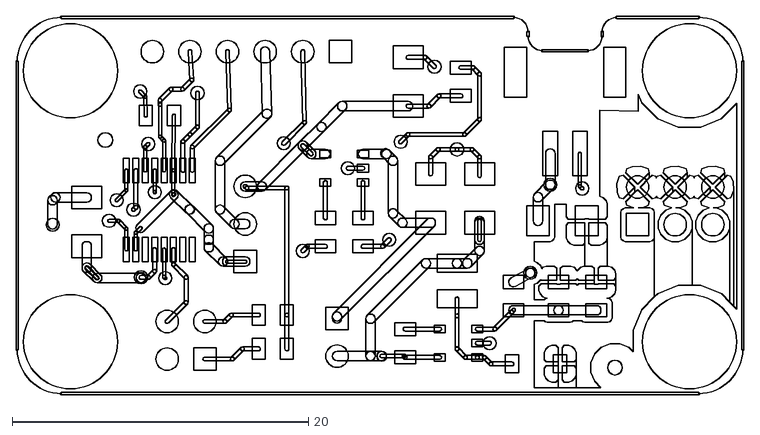
[picture p166: CAD file, 2015-02-14]
Power Cards/PWR-BLK-02/plots/PWR-BLK-02-F_Cu.dxf
49.1 x 25.6
