land-boards/lb-boards/Projects/WakeUp/plots/WakeUp-Dwgs_User.dxf

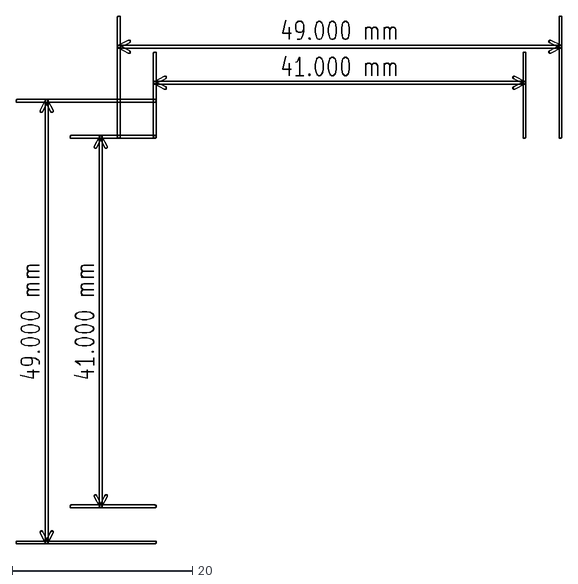
[picture p167: CAD file, 2014-11-27]
Projects/WakeUp/plots/WakeUp-Dwgs_User.dxf
60.6 x 58.6
