land-boards/lb-boards/Raspberry Pi Cards/PiPicoMite01/Parts/Enclosures/RL6215BK.stp

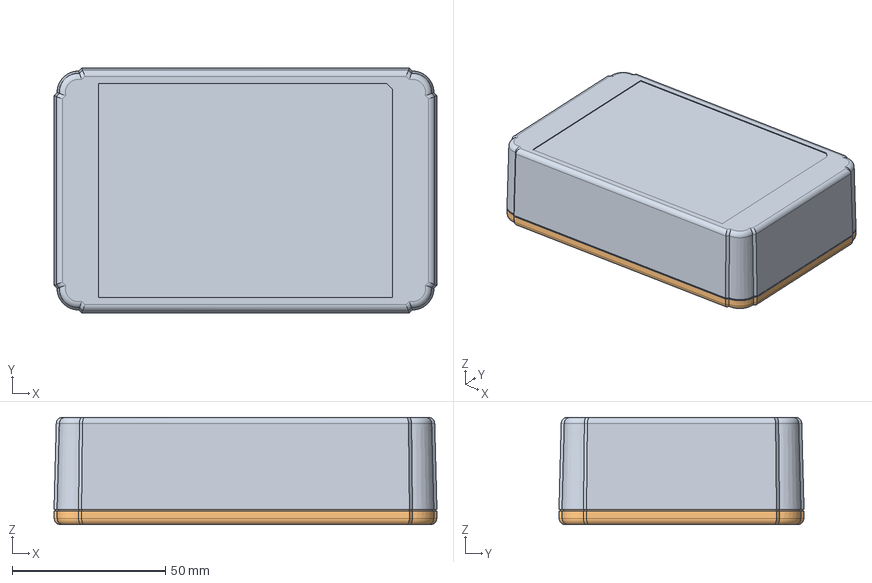
[picture p168: CAD file, 2022-10-10]
Raspberry Pi Cards/PiPicoMite01/Parts/Enclosures/RL6215BK.stp
125.0 x 80.0 x 35.0 mm
RL6215 BOX
(screw M2.6X 20mm FH) x 4
