land-boards/lb-boards/Raspberry Pi Cards/PiPicoMite03/Pics/Enclosure/3D_End_Panels/PiPicoMite03 panel - VGA end.stl

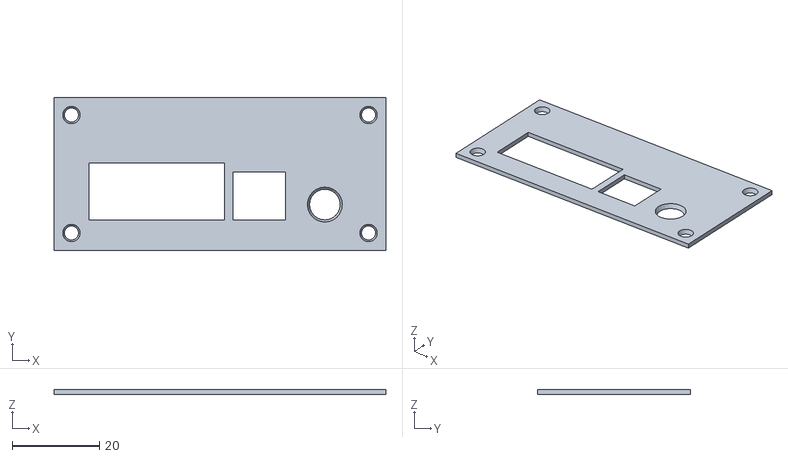
[picture p169: CAD file, 2023-02-11]
Raspberry Pi Cards/PiPicoMite03/Pics/Enclosure/3D_End_Panels/PiPicoMite03 panel - VGA end.stl
76.0 x 35.0 x 1.20
