land-boards/lb-boards/Raspberry Pi Cards/RasPi-GVS/parts/ibex_rpi_model_b_v1_00.dxf

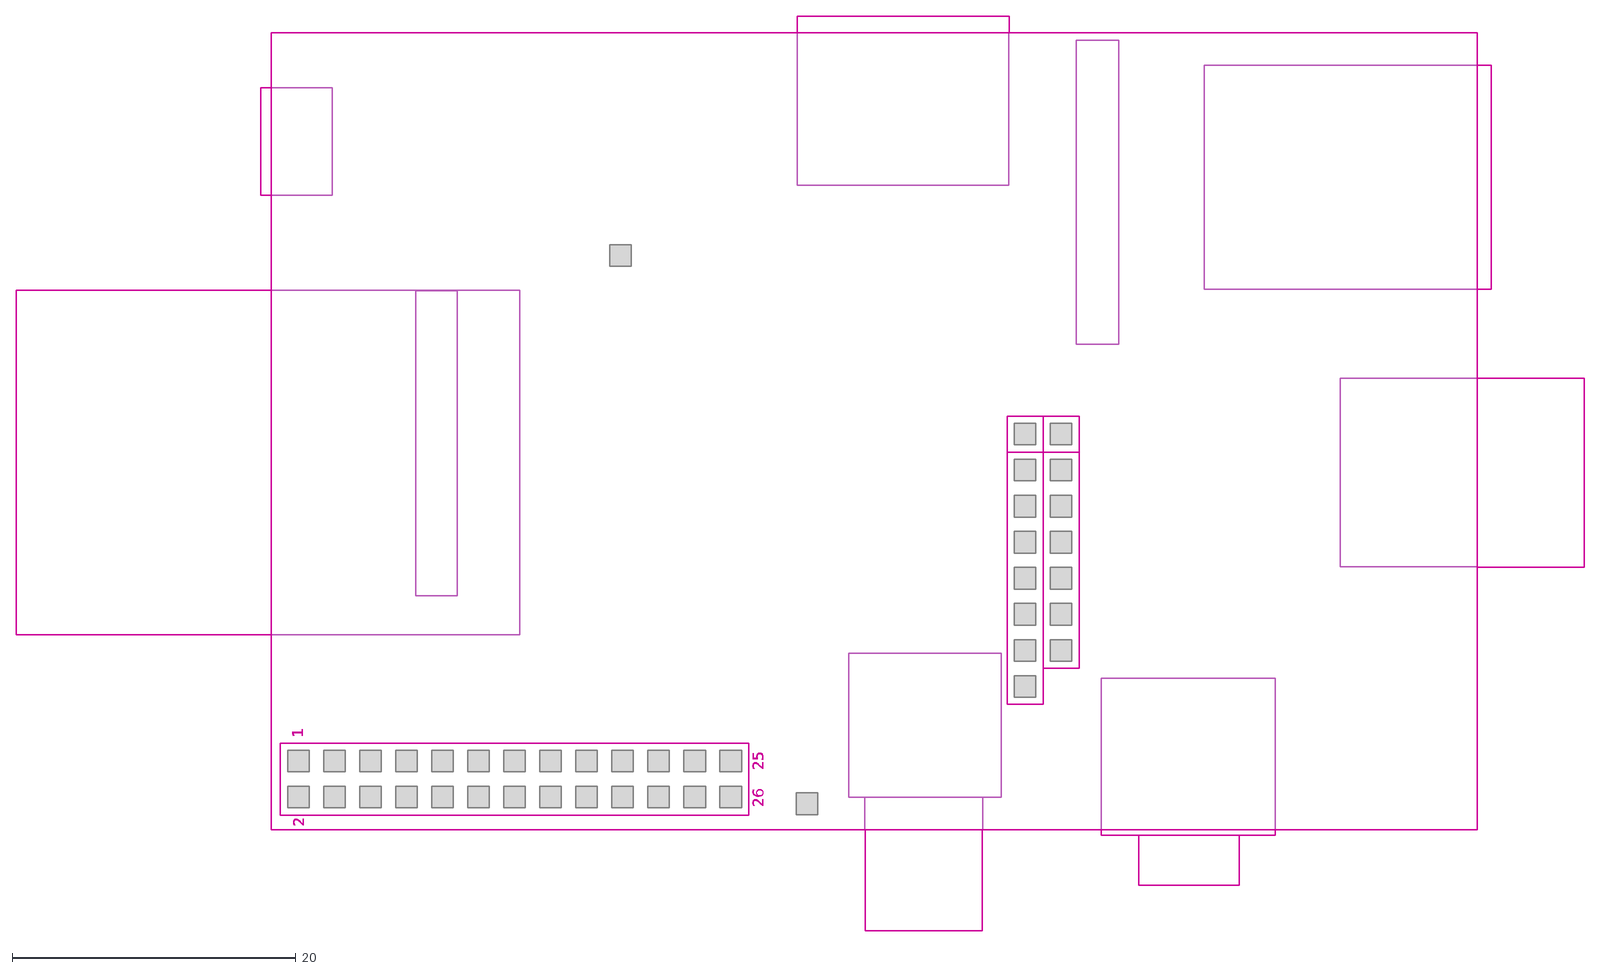
[picture p170: CAD file, 2014-04-24]
Raspberry Pi Cards/RasPi-GVS/parts/ibex_rpi_model_b_v1_00.dxf
26
25
2
1
