land-boards/lb-boards/SYNTHS/Docs/KiCad_3D_Models/pythonocc/cube-out-fc.stp

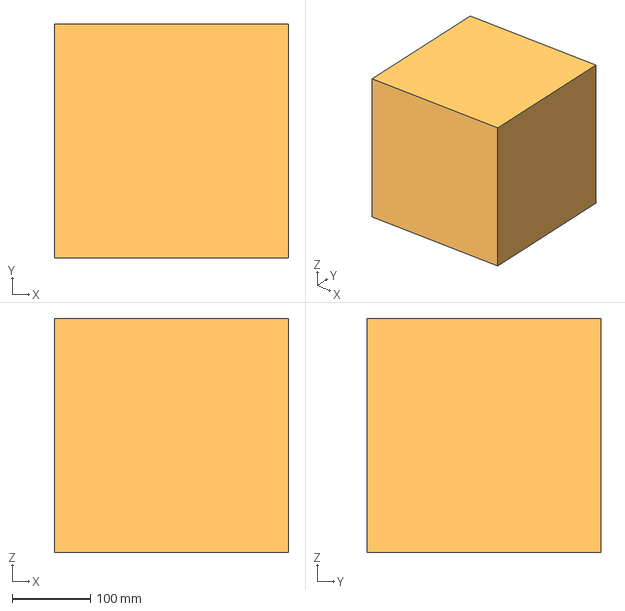
[picture p171: CAD file, 2022-10-11]
SYNTHS/Docs/KiCad_3D_Models/pythonocc/cube-out-fc.stp
300.0 x 300.0 x 300.0 mm
