land-boards/lb-boards/GVS Cards/IRSens-2/plots/IRSens-2-Dwgs_Use-dimensionedr.dxf

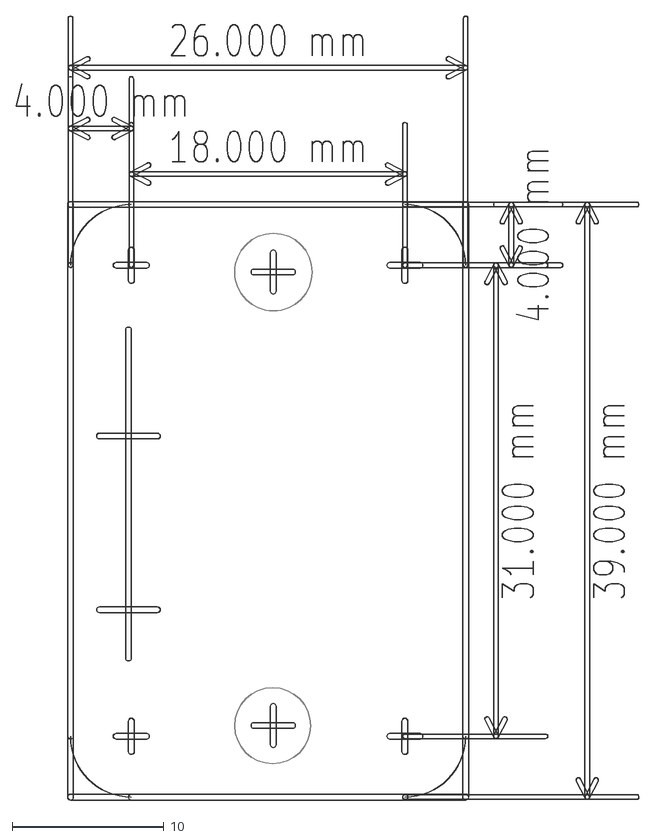
[picture p172: CAD file, 2015-02-15]
GVS Cards/IRSens-2/plots/IRSens-2-Dwgs_Use-dimensionedr.dxf
41.0 x 51.6
