land-boards/lb-boards/HamRadio/VFO-003/Pictures/STP_Files/DC_Jack/DS-261B.step

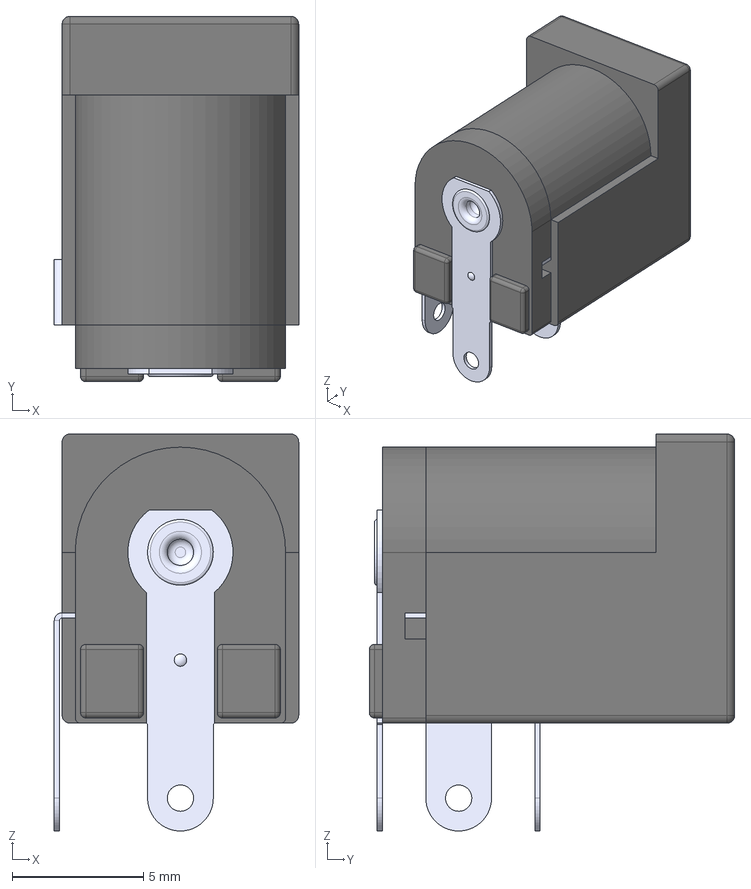
[picture p173: CAD file, 2020-11-30]
HamRadio/VFO-003/Pictures/STP_Files/DC_Jack/DS-261B.step
9.30 x 13.9 x 15.1 mm
