land-boards/lb-boards/HamRadio/VFO-003/Pictures/STP_Files/Rotary-Encoder/EC11E12-15P30C-SW.stp

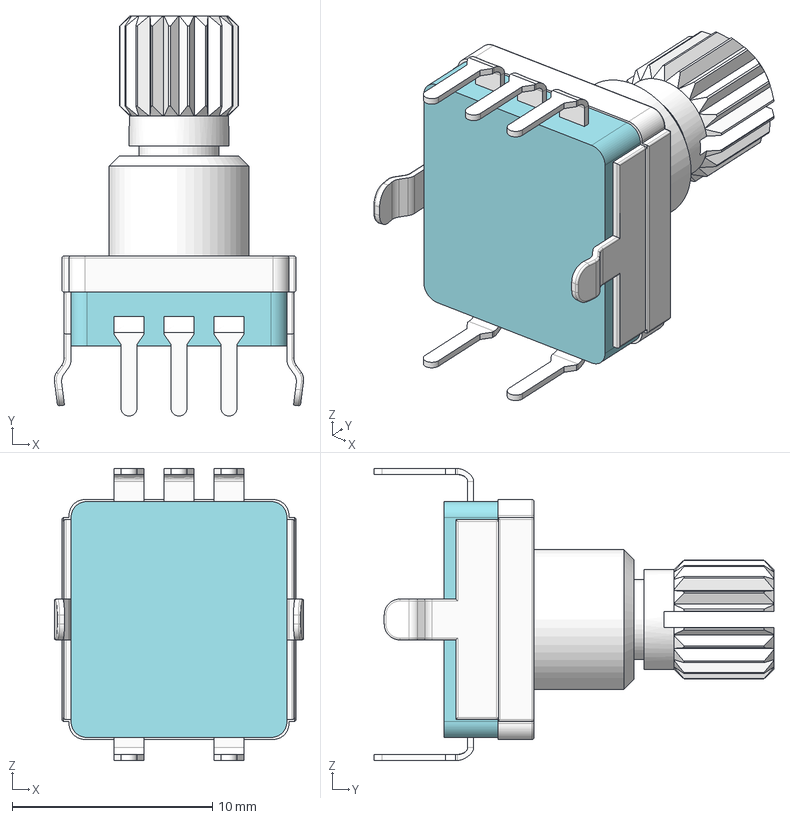
[picture p174: CAD file, 2020-11-30]
HamRadio/VFO-003/Pictures/STP_Files/Rotary-Encoder/EC11E12-15P30C-SW.stp
12.5 x 20.0 x 14.6 mm
