land-boards/lb-boards/KiCAD/3D_STP_Files/Audio_Thonny/PJ398SM.step

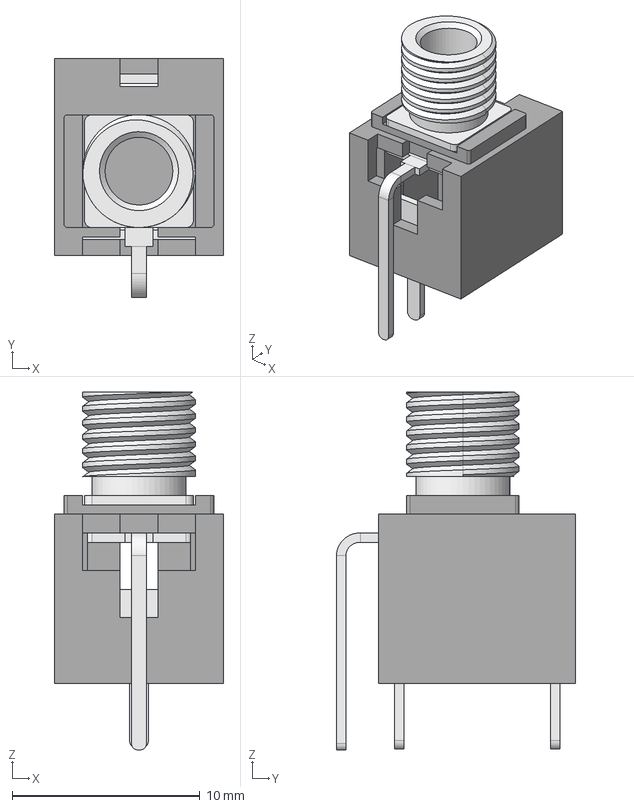
[picture p175: CAD file, 2022-10-10]
KiCAD/3D_STP_Files/Audio_Thonny/PJ398SM.step
9.00 x 12.7 x 19.1 mm
