land-boards/lb-boards/KiCAD/3D_STP_Files/OLED/0.96 OLED - Flush.stp

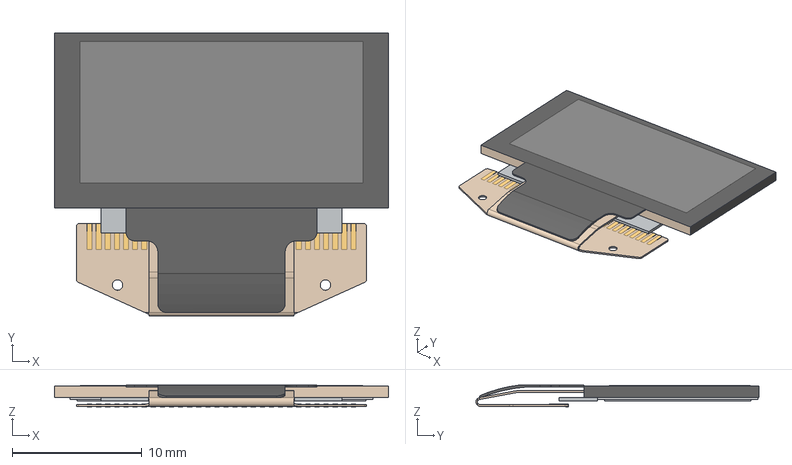
[picture p176: CAD file, 2022-10-10]
KiCAD/3D_STP_Files/OLED/0.96 OLED - Flush.stp
25.7 x 21.8 x 1.66 mm
