land-boards/lb-boards/KiCAD/3D_STP_Files/POTS/Potentiometers/R-0904N-L-20KQ.step

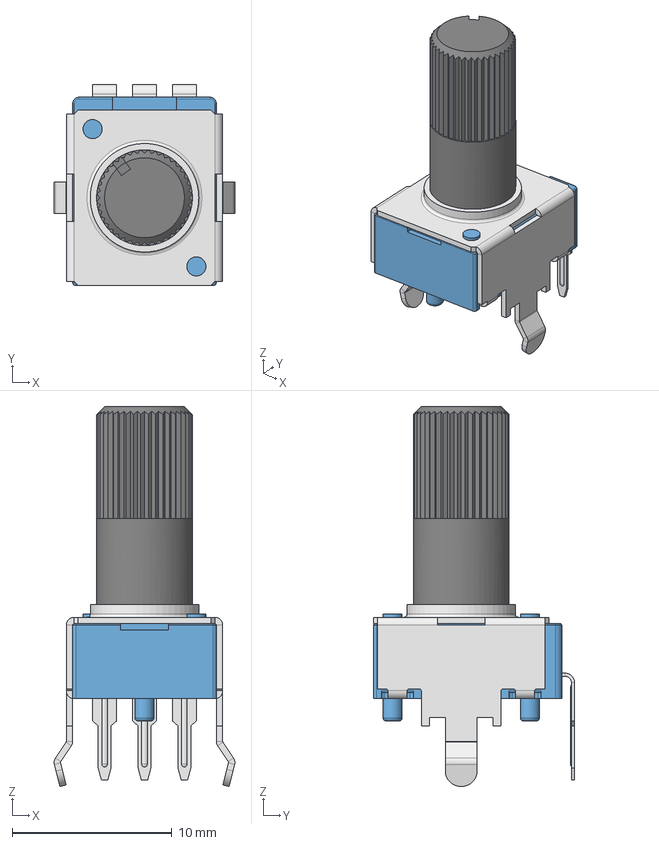
[picture p177: CAD file, 2022-10-10]
KiCAD/3D_STP_Files/POTS/Potentiometers/R-0904N-L-20KQ.step
11.3 x 12.6 x 23.8 mm
