land-boards/lb-boards/KiCAD/3D_STP_Files/PS2_MiniDIN/connector.SLDPRT

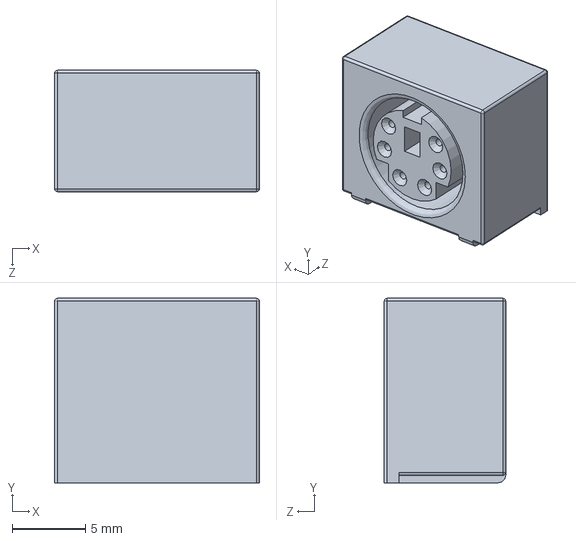
[picture p178: CAD file, 2022-10-10]
KiCAD/3D_STP_Files/PS2_MiniDIN/connector.SLDPRT
14.0 x 12.6 x 8.30 mm
