land-boards/lb-boards/KiCAD/3D_STP_Files/Raspberry Pi Pico/X1, X12M000000S096, 12 Mhz Crystal Resonator, Raspberry Pi Pico-R3.SLDPRT

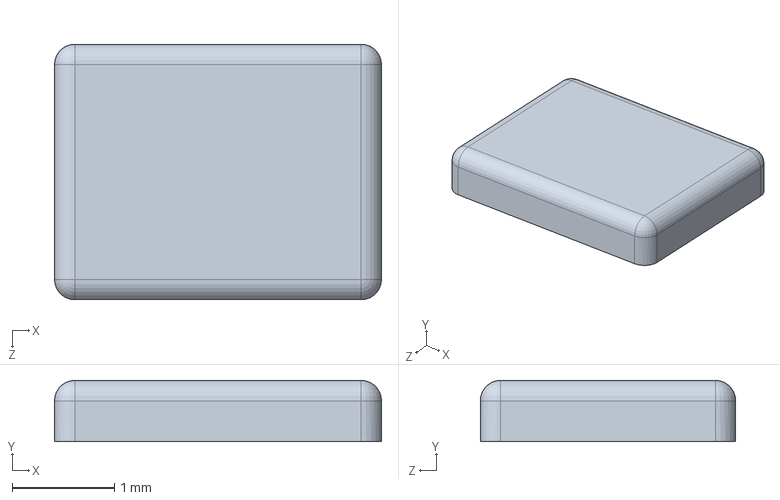
[picture p179: CAD file, 2022-10-10]
KiCAD/3D_STP_Files/Raspberry Pi Pico/X1, X12M000000S096, 12 Mhz Crystal Resonator, Raspberry Pi Pico-R3.SLDPRT
3.20 x 0.6 x 2.50 mm
