land-boards/lb-boards/LEDs Cards/LED-12/LED-12-X1/plots/LED-12-Front.dxf

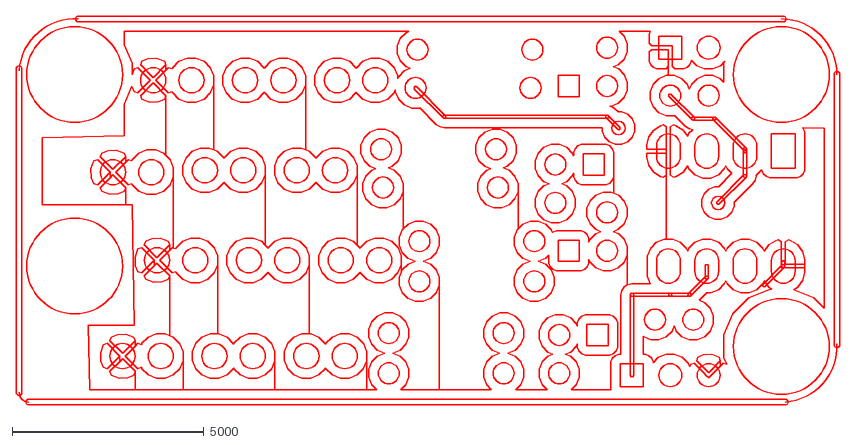
[picture p180: CAD file, 2013-01-22]
LEDs Cards/LED-12/LED-12-X1/plots/LED-12-Front.dxf
21500.0 x 10150.0
