land-boards/lb-boards/ODAS Cards/Carrier95to49/Rev_X2/plots/Carrier95to49-NPTH-drl_map.dxf

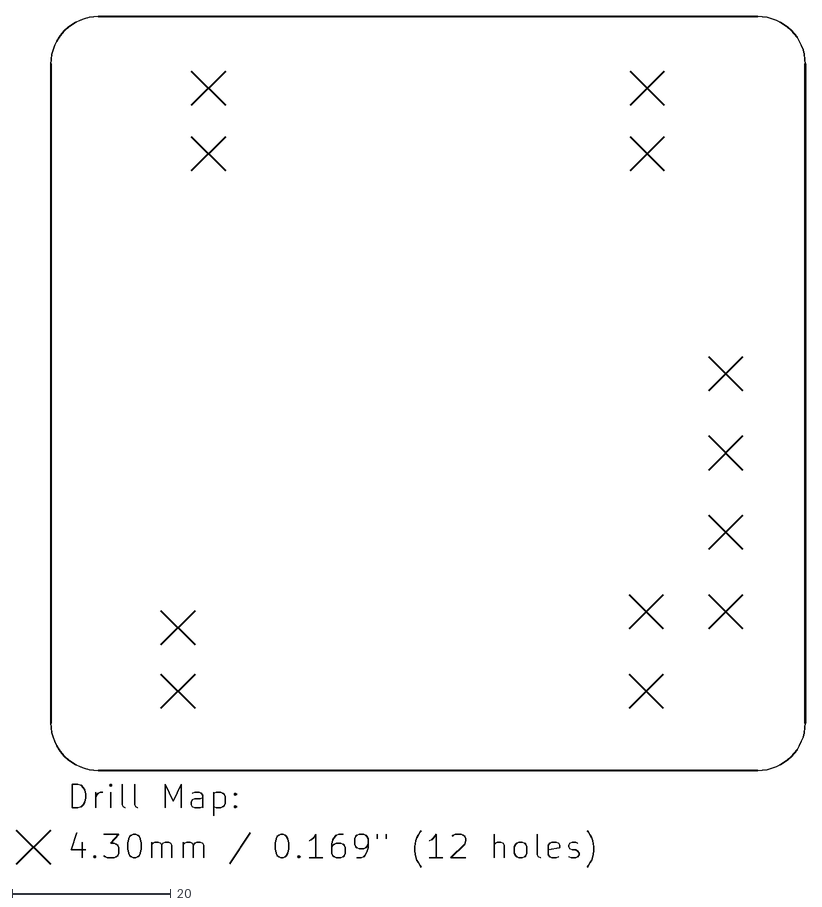
[picture p181: CAD file, 2018-12-25]
ODAS Cards/Carrier95to49/Rev_X2/plots/Carrier95to49-NPTH-drl_map.dxf
99.4 x 107.2
