land-boards/lb-boards/ODAS Cards/ODAS-PSOC5/Rev X3/Plots/ODAS-PSOC5-NPTH-drl_map.dxf

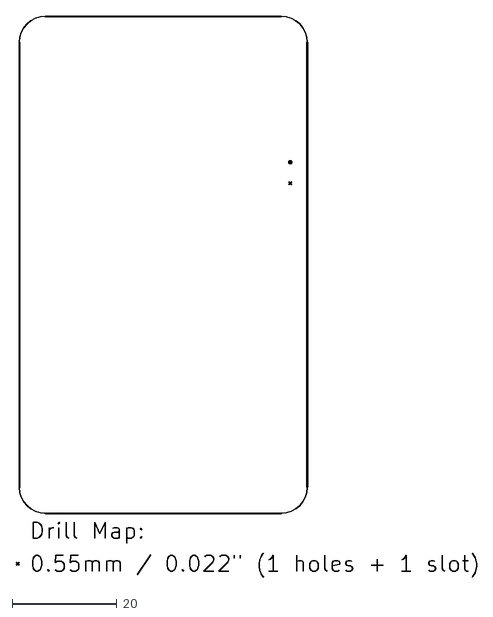
[picture p182: CAD file, 2018-12-25]
ODAS Cards/ODAS-PSOC5/Rev X3/Plots/ODAS-PSOC5-NPTH-drl_map.dxf
88.0 x 107.2
