land-boards/lb-boards/Projects/WakeUp/plots/WakeUp-Edge_Cuts.dxf

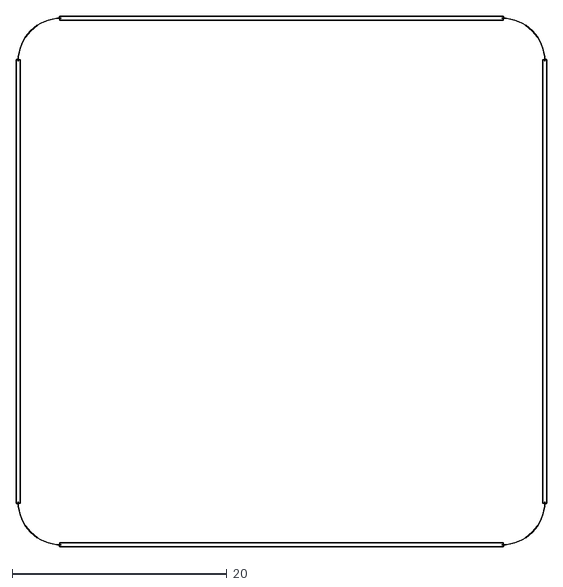
[picture p183: CAD file, 2014-11-27]
Projects/WakeUp/plots/WakeUp-Edge_Cuts.dxf
49.4 x 49.4
