land-boards/lb-boards/KiCAD/3D_STP_Files/POTS/Potentiometers/R-0904N-L-25F-green.step

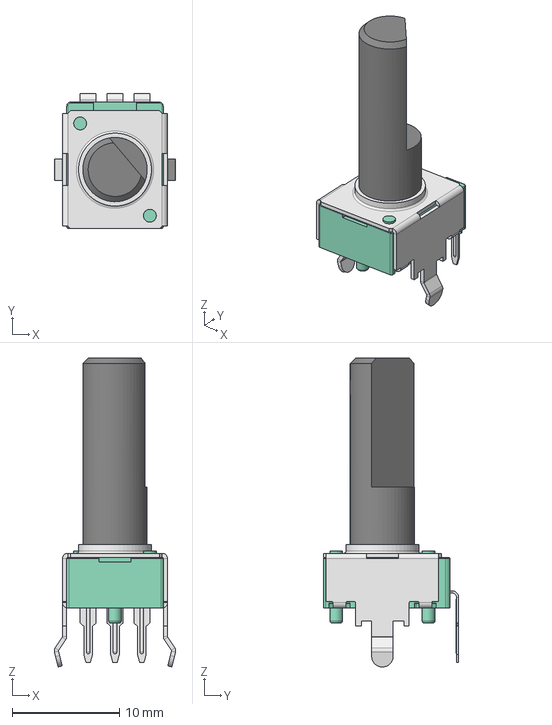
[picture p185: CAD file, 2022-10-10]
KiCAD/3D_STP_Files/POTS/Potentiometers/R-0904N-L-25F-green.step
11.3 x 12.6 x 28.8 mm
