land-boards/lb-boards/KiCAD/3D_STP_Files/PS2_MiniDIN/Cube.step

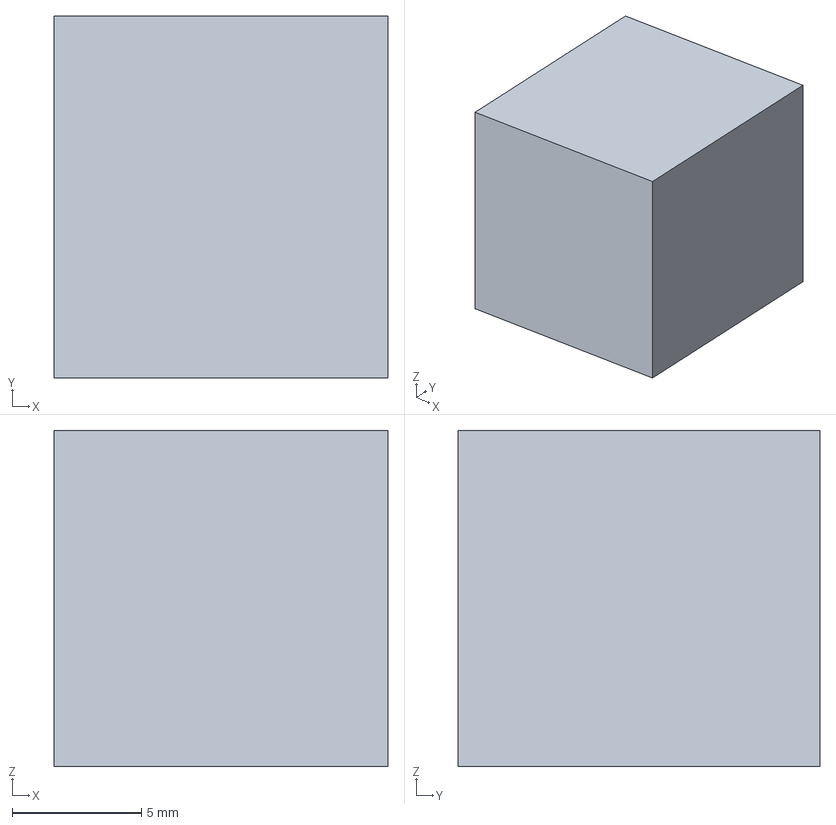
[picture p186: CAD file, 2022-10-10]
KiCAD/3D_STP_Files/PS2_MiniDIN/Cube.step
12.9 x 14.0 x 13.0 mm
