land-boards/lb-boards/KiCAD/3D_STP_Files/Raspberry Pi Pico/D2, QSME-C194, LED, Raspberry Pi Pico-R3.SLDPRT

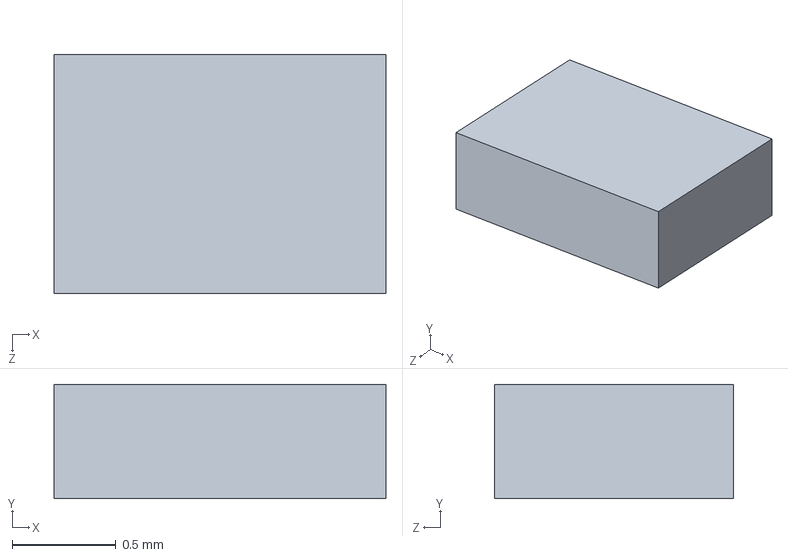
[picture p187: CAD file, 2022-10-10]
KiCAD/3D_STP_Files/Raspberry Pi Pico/D2, QSME-C194, LED, Raspberry Pi Pico-R3.SLDPRT
1.60 x 0.55 x 1.15 mm
