land-boards/lb-boards/Projects/WakeUp/plots/WakeUp-Front.dxf

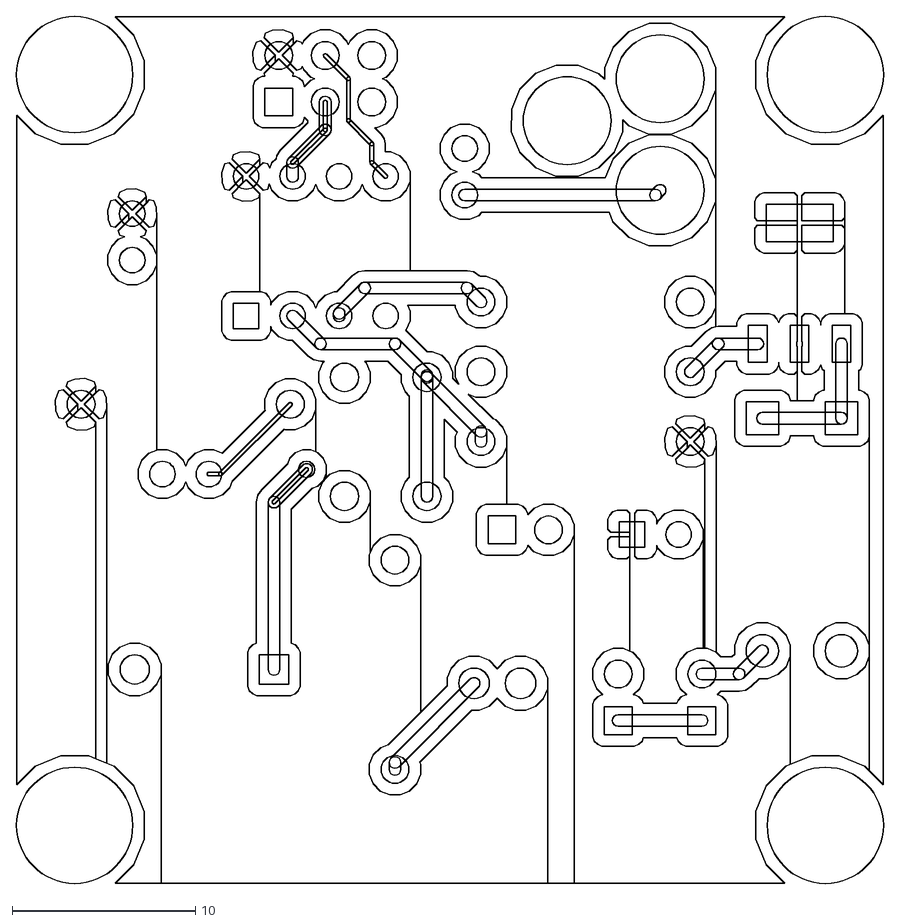
[picture p189: CAD file, 2014-11-27]
Projects/WakeUp/plots/WakeUp-Front.dxf
47.3 x 47.3
