land-boards/lb-boards/SYNTHS/Docs/KiCad_3D_Models/pythonocc/sg1-c5-214-out.stp

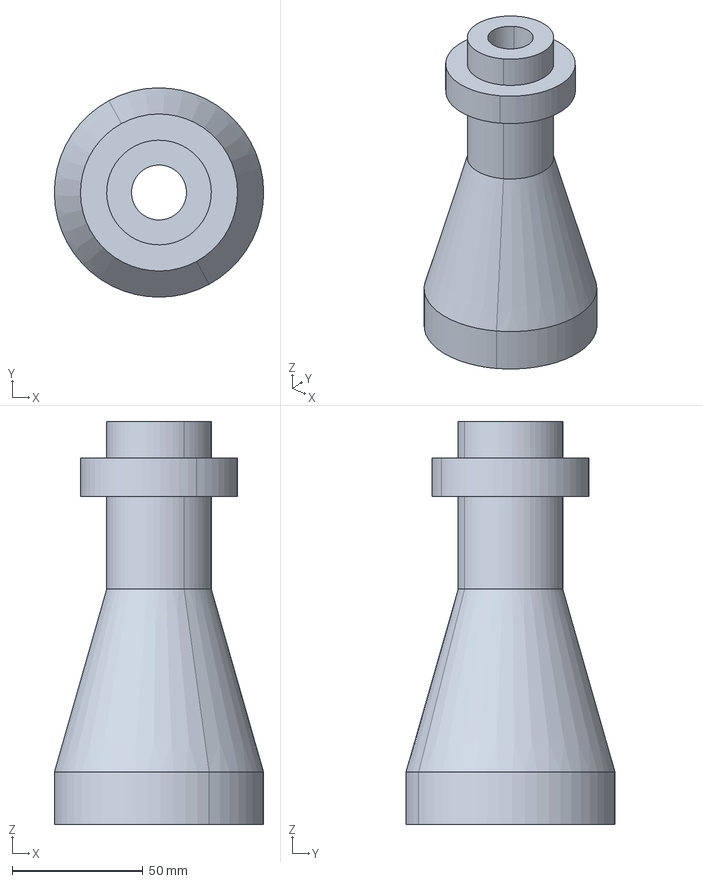
[picture p190: CAD file, 2022-10-11]
SYNTHS/Docs/KiCad_3D_Models/pythonocc/sg1-c5-214-out.stp
80.0 x 80.0 x 154.0 mm
