land-boards/lb-boards/HamRadio/VFO-003/Pictures/STP_Files/Rotary-Encoder/STEP Rotary Encoder Knob.STEP

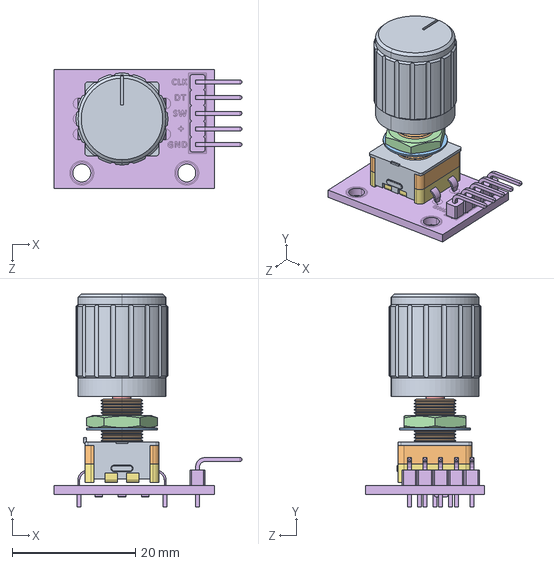
[picture p191: CAD file, 2020-11-30]
HamRadio/VFO-003/Pictures/STP_Files/Rotary-Encoder/STEP Rotary Encoder Knob.STEP
30.4 x 34.5 x 19.2 mm
