land-boards/lb-boards/LEDs Cards/LED-12/LED-12-X1/plots/LED-12-SilkS_Back.dxf

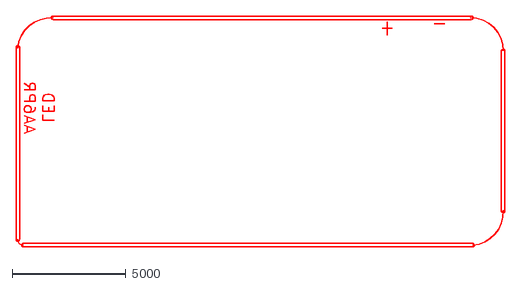
[picture p192: CAD file, 2013-01-22]
LEDs Cards/LED-12/LED-12-X1/plots/LED-12-SilkS_Back.dxf
21500.0 x 10150.0
