land-boards/lb-boards/HamRadio/VFO-003/Pictures/STP_Files/Rotary-Encoder/encoder.stp

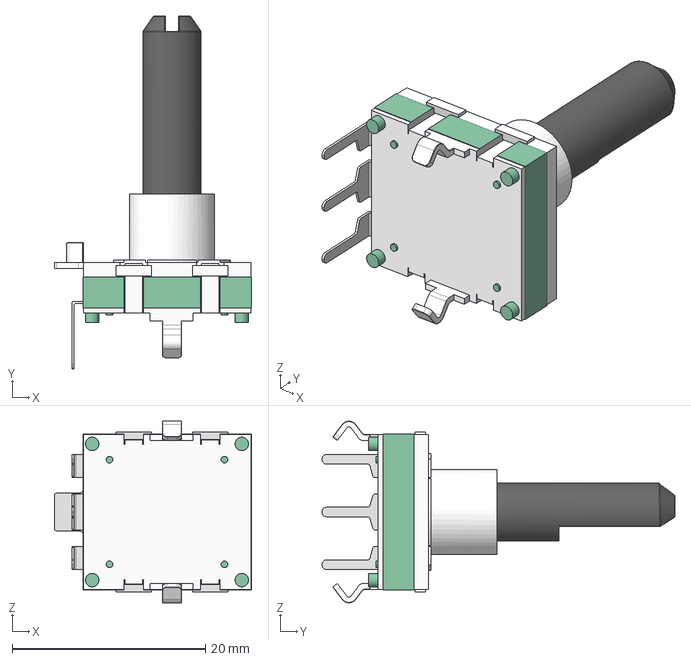
[picture p193: CAD file, 2020-11-30]
HamRadio/VFO-003/Pictures/STP_Files/Rotary-Encoder/encoder.stp
20.4 x 36.5 x 18.8 mm
