land-boards/lb-boards/KiCAD/3D_STP_Files/POTS/Potentiometers/R-0904N-L-15KT-black.step

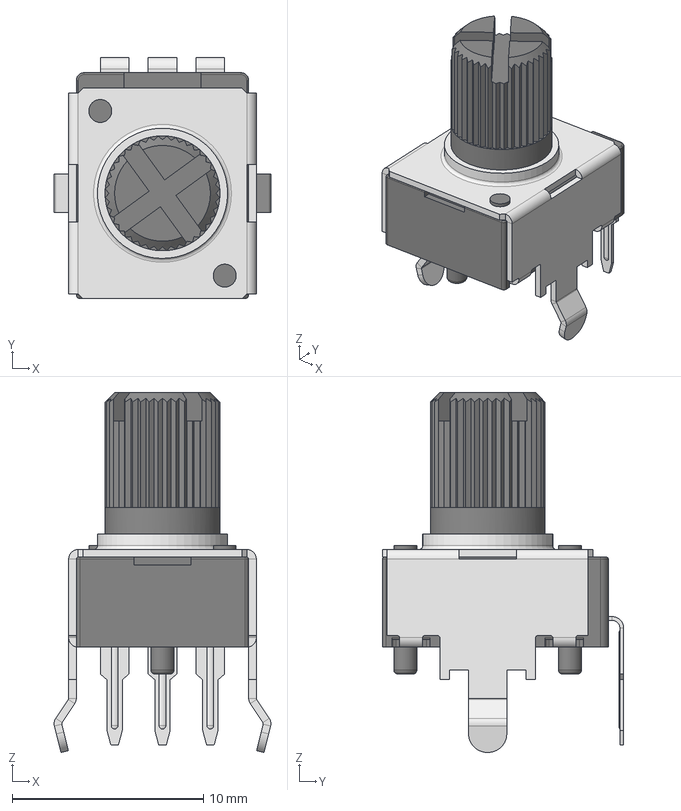
[picture p194: CAD file, 2022-10-10]
KiCAD/3D_STP_Files/POTS/Potentiometers/R-0904N-L-15KT-black.step
11.3 x 12.6 x 18.8 mm
