land-boards/lb-boards/KiCAD/3D_STP_Files/Raspberry Pi Pico/Q1, MOSFET, DMG1012T, Raspberry Pi Pico-R3.SLDPRT

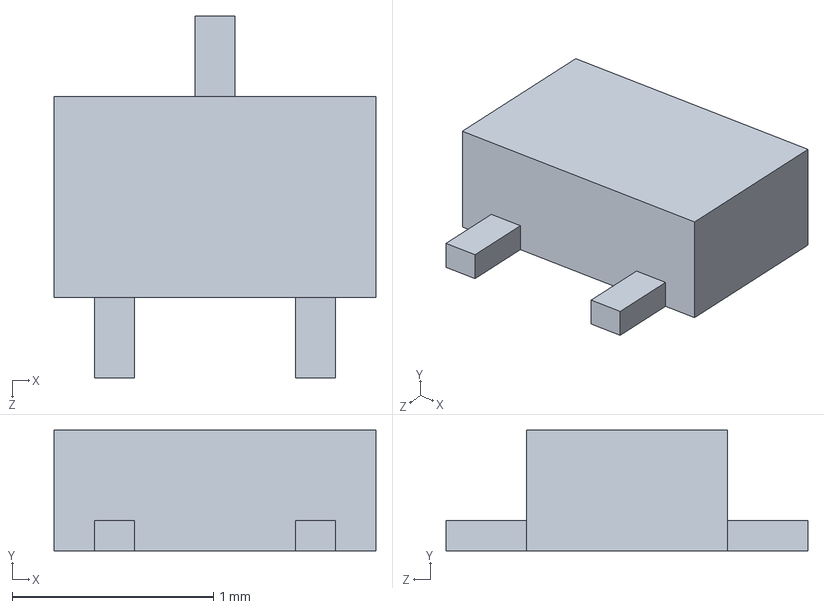
[picture p195: CAD file, 2022-10-10]
KiCAD/3D_STP_Files/Raspberry Pi Pico/Q1, MOSFET, DMG1012T, Raspberry Pi Pico-R3.SLDPRT
1.60 x 0.6 x 1.80 mm
