land-boards/lb-boards/KiCAD/3D_STP_Files/Audio_Thonny/PJ301BM.step

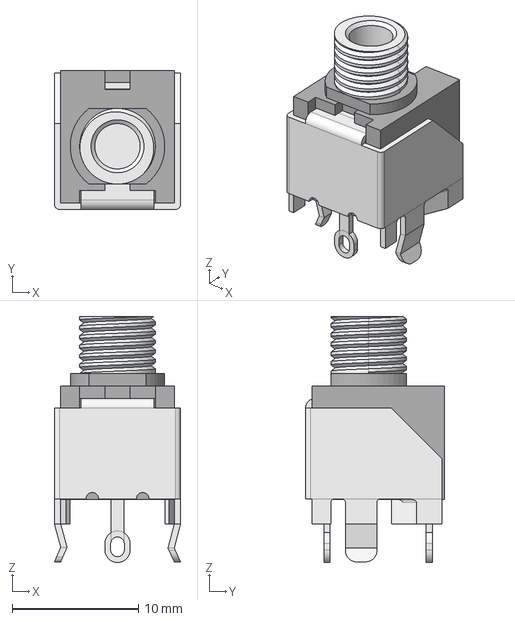
[picture p197: CAD file, 2022-10-10]
KiCAD/3D_STP_Files/Audio_Thonny/PJ301BM.step
10.0 x 11.0 x 19.5 mm
