land-boards/lb-boards/KiCAD/3D_STP_Files/Raspberry Pi Pico/L1, Inductor, Raspberry Pi Pico-R3.SLDPRT

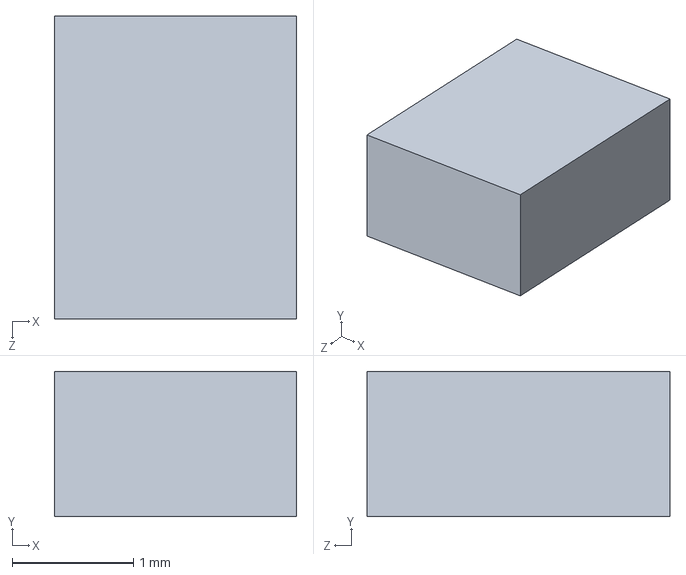
[picture p198: CAD file, 2022-10-10]
KiCAD/3D_STP_Files/Raspberry Pi Pico/L1, Inductor, Raspberry Pi Pico-R3.SLDPRT
2.00 x 1.20 x 2.50 mm
