land-boards/lb-boards/KiCAD/3D_STP_Files/Raspberry Pi Pico/RP2040 Microcontroller, Raspberry Pi Pico-R3.SLDPRT

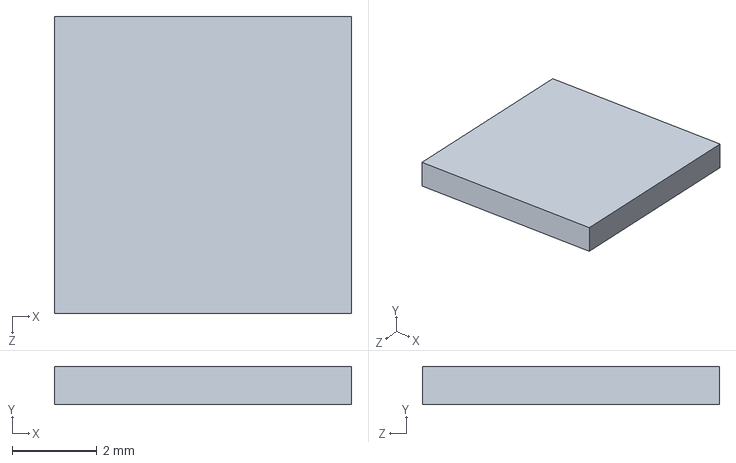
[picture p202: CAD file, 2022-10-10]
KiCAD/3D_STP_Files/Raspberry Pi Pico/RP2040 Microcontroller, Raspberry Pi Pico-R3.SLDPRT
7.00 x 0.9 x 7.00 mm
