land-boards/lb-boards/KiCAD/3D_STP_Files/Raspberry Pi Pico/PCB, Raspberry Pi Pico-R3.SLDPRT

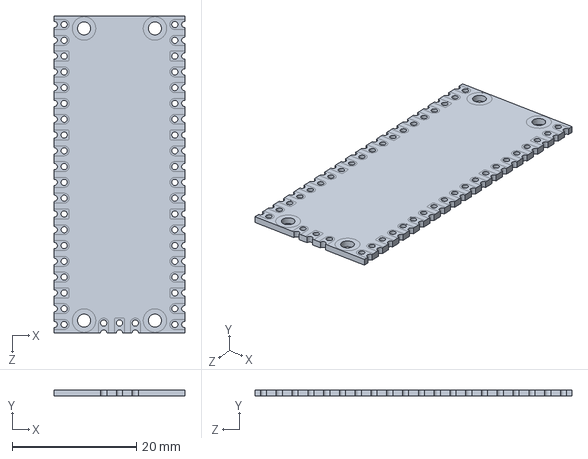
[picture p204: CAD file, 2022-10-10]
KiCAD/3D_STP_Files/Raspberry Pi Pico/PCB, Raspberry Pi Pico-R3.SLDPRT
21.0 x 1.00 x 51.0 mm
