land-boards/lb-boards/KiCAD/3D_STP_Files/Raspberry Pi Pico/SW1, Tact Switch, Raspberry Pi Pico-R3.SLDPRT

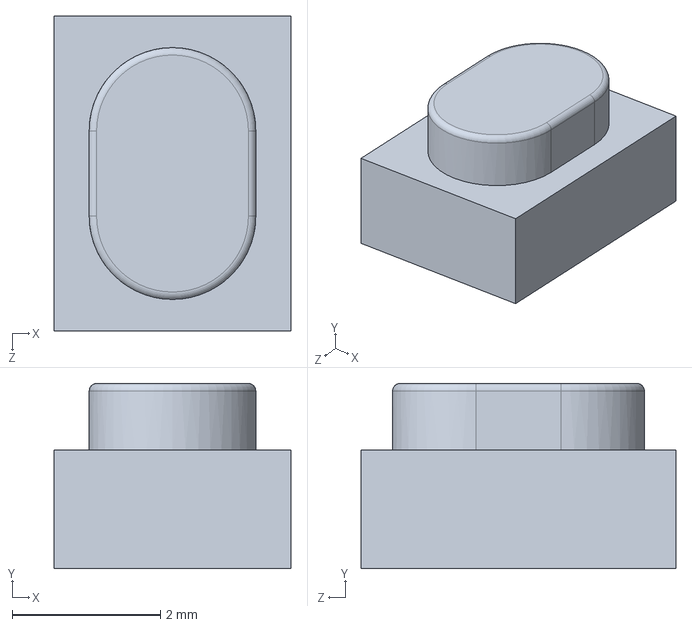
[picture p205: CAD file, 2022-10-10]
KiCAD/3D_STP_Files/Raspberry Pi Pico/SW1, Tact Switch, Raspberry Pi Pico-R3.SLDPRT
3.20 x 2.50 x 4.25 mm
