land-boards/lb-boards/KiCAD/3D_STP_Files/Audio_Thonny/PJ301M-12.step

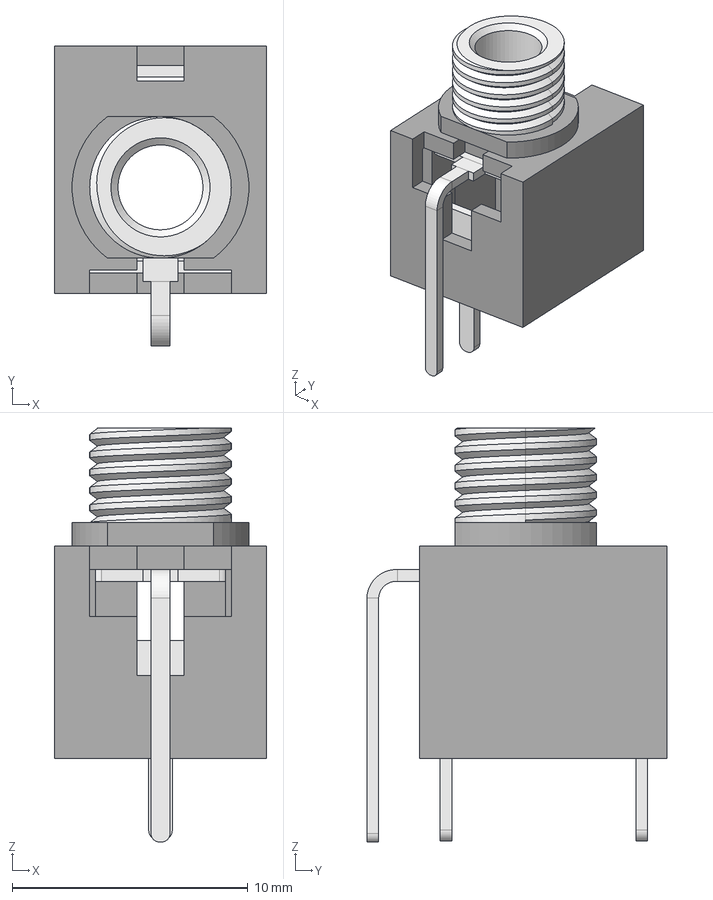
[picture p206: CAD file, 2022-10-10]
KiCAD/3D_STP_Files/Audio_Thonny/PJ301M-12.step
9.00 x 12.7 x 17.6 mm
