land-boards/lb-boards/KiCAD/3D_STP_Files/Raspberry Pi Pico/SMD Capacitor, Configurable, Raspberry Pi Pico-R3.SLDPRT

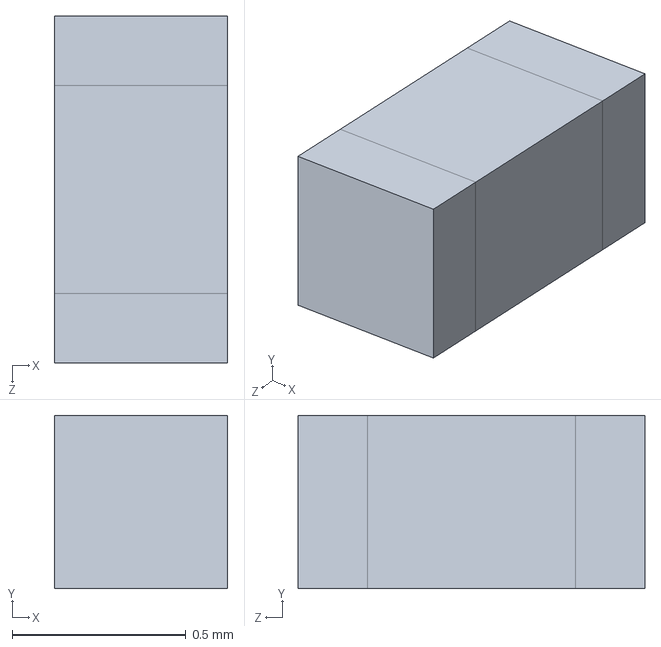
[picture p207: CAD file, 2022-10-10]
KiCAD/3D_STP_Files/Raspberry Pi Pico/SMD Capacitor, Configurable, Raspberry Pi Pico-R3.SLDPRT
0.5 x 0.5 x 1.00 mm
