land-boards/lb-boards/KiCAD/3D_STP_Files/Raspberry Pi Pico/U2, RT6150B-33GQW, Buck Boost Converter, Raspberry Pi Pico-R3.SLDPRT

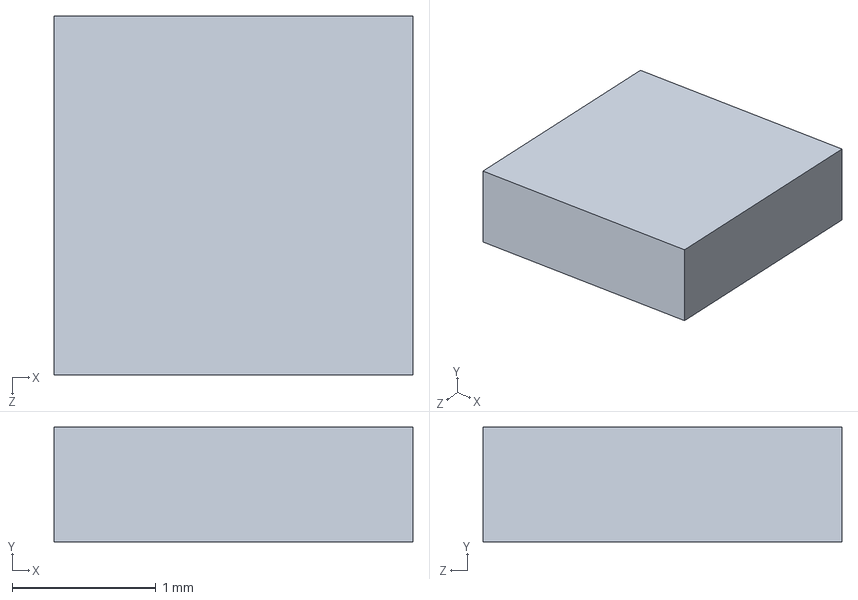
[picture p208: CAD file, 2022-10-10]
KiCAD/3D_STP_Files/Raspberry Pi Pico/U2, RT6150B-33GQW, Buck Boost Converter, Raspberry Pi Pico-R3.SLDPRT
2.50 x 0.8 x 2.50 mm
