land-boards/lb-boards/KiCAD/3D_STP_Files/Raspberry Pi Pico/MicroUSB Port, Raspberry Pi Pico-R3.SLDPRT

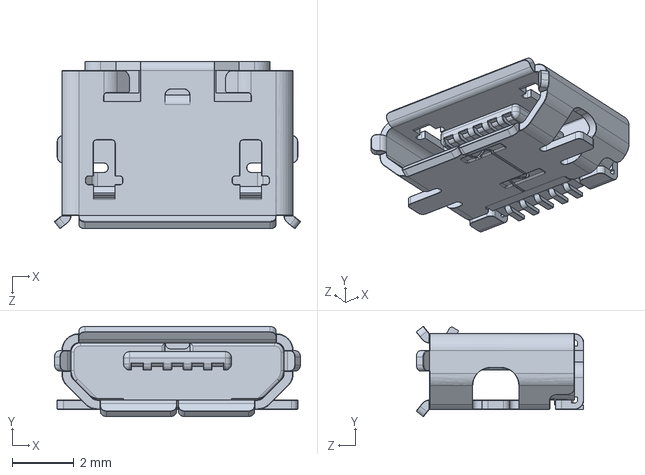
[picture p209: CAD file, 2022-10-10]
KiCAD/3D_STP_Files/Raspberry Pi Pico/MicroUSB Port, Raspberry Pi Pico-R3.SLDPRT
7.97 x 2.92 x 5.43 mm
