land-boards/lb-boards/KiCAD/3D_STP_Files/Audio_Thonny/FCR1281.step

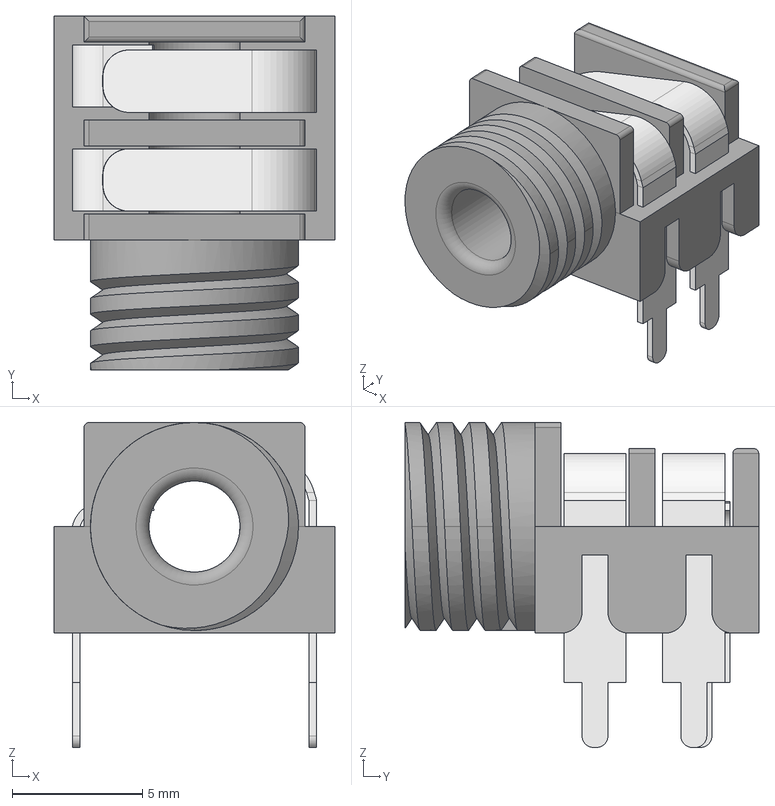
[picture p210: CAD file, 2022-10-10]
KiCAD/3D_STP_Files/Audio_Thonny/FCR1281.step
10.8 x 13.6 x 12.5 mm
