land-boards/lb-boards/KiCAD/3D_STP_Files/Audio_Thonny/PJ366ST.step

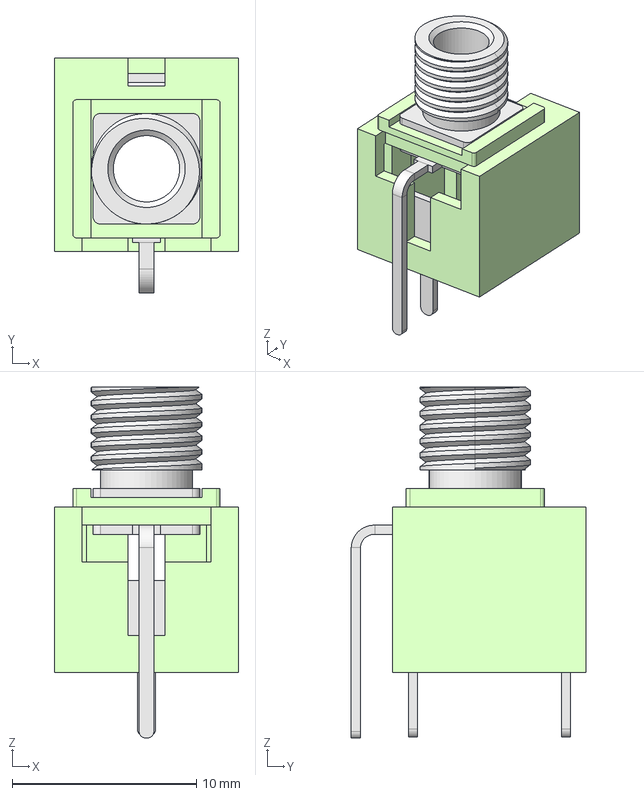
[picture p211: CAD file, 2022-10-10]
KiCAD/3D_STP_Files/Audio_Thonny/PJ366ST.step
10.0 x 12.7 x 19.1 mm
