land-boards/lb-boards/KiCAD/3D_STP_Files/Audio_Thonny/PJ3410.step

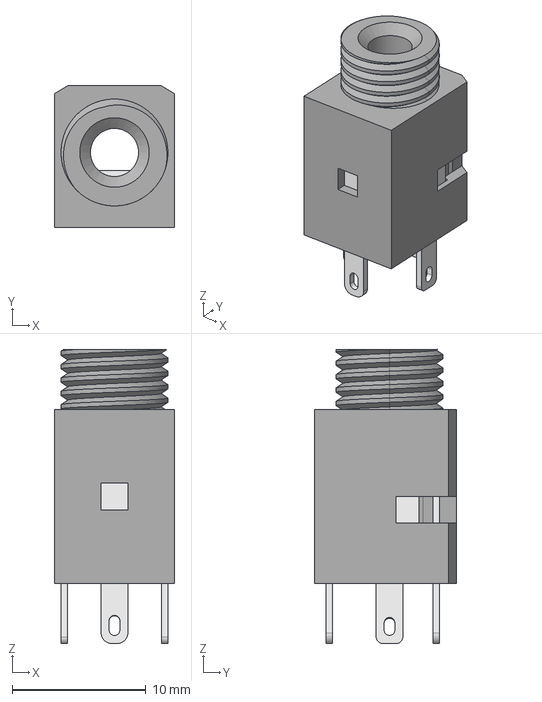
[picture p213: CAD file, 2022-10-10]
KiCAD/3D_STP_Files/Audio_Thonny/PJ3410.step
9.00 x 10.6 x 22.0 mm
