land-boards/lb-boards/(list of files, cad)

Other CAD files:
GPS Cards/USB-GPS/Case-3D/case-X1/USB-GPS-lid.dxf
KiCAD/3D_STP_Files/DIN-5_MIDI/Cube.step
Raspberry Pi Cards/PiPicoMite02/Pics/3D/Cube.step
Raspberry Pi Cards/RaspPi-001/Raspberry Pi Dimensioned drawing.dxf
SYNTHS/Docs/Modules/Mutable Instruments/MI_GitHub_Repo/blades/hardware_design/panel/blades.dwg
SYNTHS/Docs/Modules/Mutable Instruments/MI_GitHub_Repo/blinds/hardware_design/panel/blinds.dwg
SYNTHS/Docs/Modules/Mutable Instruments/MI_GitHub_Repo/braids/hardware_design/panel/braids.dwg
SYNTHS/Docs/Modules/Mutable Instruments/MI_GitHub_Repo/branches/hardware_design/panel/branches.dwg
SYNTHS/Docs/Modules/Mutable Instruments/MI_GitHub_Repo/clouds/hardware_design/panel/clouds.dwg
SYNTHS/Docs/Modules/Mutable Instruments/MI_GitHub_Repo/edges/hardware_design/panel/edges.dwg
SYNTHS/Docs/Modules/Mutable Instruments/MI_GitHub_Repo/elements/hardware_design/panel/elements.dwg
SYNTHS/Docs/Modules/Mutable Instruments/MI_GitHub_Repo/frames/hardware_design/panel/frames.dwg
SYNTHS/Docs/Modules/Mutable Instruments/MI_GitHub_Repo/grids/hardware_design/panel/grids.dwg
SYNTHS/Docs/Modules/Mutable Instruments/MI_GitHub_Repo/kinks/hardware_design/panel/kinks.dwg
SYNTHS/Docs/Modules/Mutable Instruments/MI_GitHub_Repo/links/hardware_design/panel/links.dwg
SYNTHS/Docs/Modules/Mutable Instruments/MI_GitHub_Repo/marbles/hardware_design/panel/marbles_v70.dwg
SYNTHS/Docs/Modules/Mutable Instruments/MI_GitHub_Repo/peaks/hardware_design/panel/peaks.dwg
SYNTHS/Docs/Modules/Mutable Instruments/MI_GitHub_Repo/plaits/hardware_design/panel/plaits_v50.dwg
SYNTHS/Docs/Modules/Mutable Instruments/MI_GitHub_Repo/rings/hardware_design/panel/rings.dwg
SYNTHS/Docs/Modules/Mutable Instruments/MI_GitHub_Repo/ripples/hardware_design/panel/ripples2.dwg
SYNTHS/Docs/Modules/Mutable Instruments/MI_GitHub_Repo/shades/hardware_design/panel/shades.dwg
SYNTHS/Docs/Modules/Mutable Instruments/MI_GitHub_Repo/shelves/hardware_design/panel/shelves.dwg
SYNTHS/Docs/Modules/Mutable Instruments/MI_GitHub_Repo/stages/hardware_design/panel/stages_v70.dwg
SYNTHS/Docs/Modules/Mutable Instruments/MI_GitHub_Repo/streams/hardware_design/panel/streams.dwg
SYNTHS/Docs/Modules/Mutable Instruments/MI_GitHub_Repo/tides/hardware_design/panel/tides.dwg
SYNTHS/Docs/Modules/Mutable Instruments/MI_GitHub_Repo/tides2/hardware_design/panel/tides2.dwg
SYNTHS/Docs/Modules/Mutable Instruments/MI_GitHub_Repo/veils/hardware_design/panel/veils2.dwg
SYNTHS/Docs/Modules/Mutable Instruments/MI_GitHub_Repo/warps/hardware_design/panel/warps.dwg
SYNTHS/Docs/Modules/Mutable Instruments/MI_GitHub_Repo/yarns/hardware_design/panel/yarns.dwg
KiCAD/3D_STP_Files/DIN-5_MIDI/DIN-5_MIDI.FCStd
KiCAD/3D_STP_Files/DS1307/DS1306_PCB.step
KiCAD/3D_STP_Files/MAX7912_MODULE/max7912_bd.step
KiCAD/3D_STP_Files/Mini-360/Cube.step
SYNTHS/Docs/KiCad_3D_Models/pythonocc/cube-occ-out.stp
SYNTHS/Docs/Modules/Mutable Instruments/MI_GitHub_Repo/ripples/hardware_design/panel/ripples.dwg
SYNTHS/Docs/Modules/Mutable Instruments/MI_GitHub_Repo/shades/hardware_design/panel/shades2.dwg
SYNTHS/Docs/Modules/Mutable Instruments/MI_GitHub_Repo/shelves/hardware_design/panel/shelves_mk2.dwg
SYNTHS/Docs/Modules/Mutable Instruments/MI_GitHub_Repo/veils/hardware_design/panel/veils.dwg
KiCAD/3D_STP_Files/Slide_Switch_THT_SPDT/Slide_SW_THT_SPDT.step
SYNTHS/Docs/Modules/Mutable Instruments/MI_GitHub_Repo/shelves/hardware_design/panel/shelves_expander.dwg
KiCAD/3D_STP_Files/POTS/Potentiometers/R-0904N-L-15KQ-black.step
KiCAD/3D_STP_Files/PS2_MiniDIN/PS2_MiniDIN.FCStd
SYNTHS/Docs/KiCad_3D_Models/pythonocc/sg1-c5-214.stp
KiCAD/3D_STP_Files/POTS/Potentiometers/R-0904N-L-25KQ-black.step
KiCAD/3D_STP_Files/POTS/Potentiometers/R-0904N-L-25KC-black.step
KiCAD/3D_STP_Files/POTS/Potentiometers/R-0904N-L-20KQ-green.step
KiCAD/3D_STP_Files/POTS/Potentiometers/R-0904N-L-20F-black.step
KiCAD/3D_STP_Files/POTS/Potentiometers/R-0904N-L-25KQ-green.step
KiCAD/3D_STP_Files/POTS/Potentiometers/R-0904N-L-20KQ-black.step
KiCAD/3D_STP_Files/POTS/Potentiometers/R-0904N-L-20F-green.step
KiCAD/3D_STP_Files/Raspberry Pi Pico/U3, W25Q16JVUXIQ, Serial NOR Flash 16 Mbit, Raspberry Pi Pico-R3.SLDPRT
KiCAD/3D_STP_Files/POTS/Potentiometers/R-0904N-L-15F.step
KiCAD/3D_STP_Files/POTS/Potentiometers/R-0904N-L-15KS-black.step
KiCAD/3D_STP_Files/POTS/Potentiometers/R-0904N-L-15KS.step
KiCAD/3D_STP_Files/POTS/Potentiometers/R-0904N-L-25KT-black.step
KiCAD/3D_STP_Files/POTS/Potentiometers/R-0904N-L-15KC.step
GPS Cards/USB-GPS/Case-3D/Case-X2/GPS-Box-X3.skp
GPS Cards/USB-GPS/Case-3D/Case-X2/GPS-Box.skp
GPS Cards/USB-GPS/Case-3D/Case-X2/USB-GPS-lid-x3.skp
GPS Cards/USB-GPS/Case-3D/Case-X2/USB-GPS-lid.skp
GPS Cards/USB-GPS/Case-3D/case-X1/GPS-Box.skp
GPS Cards/USB-GPS/Case-3D/case-X1/USB-GPS-Board.skp
GPS Cards/USB-GPS/Case-3D/case-X1/USB-GPS-lid.skp
GVS Cards/IRSens-2/plots/~IRSens-2-Dwgs_Use-dimensionedr.dxf
HamRadio/VFO-003/Pictures/STP_Files/Rotary-Encoder/nut.stp
Hardware/raspberry_pi_dimensions.skp
KiCAD/3D_STP_Files/AUD_PJ-301BM/AUD_PJ-301BM.FCStd
KiCAD/3D_STP_Files/Audio_Thonny/6mm_hex_nut.step
KiCAD/3D_STP_Files/Audio_Thonny/6mm_knurl_nut.step
KiCAD/3D_STP_Files/Audio_Thonny/FCR1281_Hex_nut.step
KiCAD/3D_STP_Files/Audio_Thonny/PJ301BM_Hex_nut.step
KiCAD/3D_STP_Files/Audio_Thonny/PJ301BM_Knurl_nut.step
KiCAD/3D_STP_Files/Audio_Thonny/PJ301M-12_Hex_nut.step
KiCAD/3D_STP_Files/Audio_Thonny/PJ301M-12_Knurl_nut.step
KiCAD/3D_STP_Files/Audio_Thonny/PJ302M_Hex_nut.step
KiCAD/3D_STP_Files/Audio_Thonny/PJ302M_Knurl_nut.step
KiCAD/3D_STP_Files/Audio_Thonny/PJ3410_Hex_nut.step
KiCAD/3D_STP_Files/Audio_Thonny/PJ3410_Round_nut.step
KiCAD/3D_STP_Files/Audio_Thonny/PJ366ST_Hex_nut.step
KiCAD/3D_STP_Files/Audio_Thonny/PJ366ST_Knurl_nut.step
KiCAD/3D_STP_Files/Audio_Thonny/PJ398SM_Hex_nut.step
KiCAD/3D_STP_Files/Audio_Thonny/PJ398SM_Knurl_nut.step
KiCAD/3D_STP_Files/Mini-360/Mini-360.FCStd
KiCAD/3D_STP_Files/POTS/Potentiometer.f3d
KiCAD/3D_STP_Files/POTS/Potentiometers/R-0904N-L-15F-black.step
KiCAD/3D_STP_Files/POTS/Potentiometers/R-0904N-L-15F-green.step
KiCAD/3D_STP_Files/POTS/Potentiometers/R-0904N-L-15KC-black.step
KiCAD/3D_STP_Files/POTS/Potentiometers/R-0904N-L-15KC-green.step
KiCAD/3D_STP_Files/POTS/Potentiometers/R-0904N-L-15KQ-green.step
KiCAD/3D_STP_Files/POTS/Potentiometers/R-0904N-L-15KQ.step
KiCAD/3D_STP_Files/POTS/Potentiometers/R-0904N-L-15KT-green.step
KiCAD/3D_STP_Files/POTS/Potentiometers/R-0904N-L-15KT.step
KiCAD/3D_STP_Files/POTS/Potentiometers/R-0904N-L-20F.step
KiCAD/3D_STP_Files/POTS/Potentiometers/R-0904N-L-20KC-green.step
KiCAD/3D_STP_Files/POTS/Potentiometers/R-0904N-L-20KC.step
KiCAD/3D_STP_Files/POTS/Potentiometers/R-0904N-L-20KS-black.step
KiCAD/3D_STP_Files/POTS/Potentiometers/R-0904N-L-20KS-green.step
KiCAD/3D_STP_Files/POTS/Potentiometers/R-0904N-L-20KS.step
KiCAD/3D_STP_Files/POTS/Potentiometers/R-0904N-L-20KT-black.step
KiCAD/3D_STP_Files/POTS/Potentiometers/R-0904N-L-20KT-green.step
KiCAD/3D_STP_Files/POTS/Potentiometers/R-0904N-L-20KT.step
KiCAD/3D_STP_Files/POTS/Potentiometers/R-0904N-L-25F-black.step
KiCAD/3D_STP_Files/POTS/Potentiometers/R-0904N-L-25F.step
KiCAD/3D_STP_Files/POTS/Potentiometers/R-0904N-L-25KC-green.step
KiCAD/3D_STP_Files/POTS/Potentiometers/R-0904N-L-25KC.step
KiCAD/3D_STP_Files/POTS/Potentiometers/R-0904N-L-25KQ.step
KiCAD/3D_STP_Files/POTS/Potentiometers/R-0904N-L-25KS-black.step
KiCAD/3D_STP_Files/POTS/Potentiometers/R-0904N-L-25KS-green.step
KiCAD/3D_STP_Files/POTS/Potentiometers/R-0904N-L-25KT-green.step
KiCAD/3D_STP_Files/POTS/Potentiometers/R-0904N-L-25KT.step
KiCAD/3D_STP_Files/Raspberry Pi Pico/Raspberry Pi Pico-R3.x_b
KiCAD/3D_STP_Files/Raspberry Pi Pico_6/Raspberry Pi Pico.f3d
KiCAD/3D_STP_Files/Raspberry Pi Pico_6/Raspberry Pi Pico.stl
KiCAD/3D_STP_Files/SD_Socket/SD_Socket.FCStd
KiCAD/3D_STP_Files/Slide_Switch_THT_SPDT/Slide_Switch_THT_SPDT.FCStd
KiCAD/3D_STP_Files/USB_B/usb.FCStd
ODAS Cards/Carrier95to49/Rev_X2/plots/Carrier95to49-drl_map.dxf
