land-boards/lb-boards/SYNTHS/NOT_BUILD/ER-MIDI-CV4-01/DOCS/Firmware/README.txt

Fuse LOW:  0xFF
Fuse HIGH: 0xDE
Fuse EXT:  0x05
