land-boards/lb-boards/SYNTHS/Docs/Modules/Mutable Instruments/MI Braids/MI Thru Hole Braids _Gerbers/How-to-order-PCB.txt

How to Order PCB

Please refer to:
https://docs.easyeda.com/en/PCB/Order-PCB
