land-boards/lb-boards/Projects/RadioDesign/RadioICs/SI4735-master/examples/SI47XX_08_RDS/SI47XX_03_RDS_TFT_ILI9225_NEW/user_manual.txt

User manual

1. BAND, MODE, AGC/Attenuation, banddwith and STEP

Press the desired command push button and after, rotate the encoder to select the option you want. For example:
To switch the band, press the band button and then rotate the encoder clockwise or counterclockwise.
The display will show you the current band. If you are on AM mode, you can use also the encoder push
button to select the band.

To switch the mode (AM, LSB or USB), press mode button and then rotate the encoder.

The same idea you can use to AGC/Attenuation, STEP and Banddwith.

Tip: Try press and release the push button fastly. I mean, do not keep the button pressed for a long time.
     If you do that, you might alternate the command status (enable and disable) randomly.

2. SEEK COMMAND

The seek button should be used to find a station. The seek direction is based on the last encoder movement.
If clockwise, the seek will go up; if counterclockwise, the seek will go down.

3. VFO/VFO Switch

To control the VFO and BFO, used the encoder push button. The display will show if you are using VFO or BFO.
It is importante to say the this action work only on SSB mode.
