land-boards/lb-boards/KiCAD/utilities/pyKiFootPrint/docs/index.rst

.. pyKiBackannSchem documentation master file, created by
   sphinx-quickstart on Thu May 08 14:02:28 2014.
   You can adapt this file completely to your liking, but it should at least
   contain the root `toctree` directive.

Welcome to pyKiBackannSchem's documentation!
============================================

Contents:

.. toctree::
   :maxdepth: 2

.. automodule:: pyKiBackannSchem
 
.. autoclass:: ProcessKicadSchematic
    :members:
	
.. autoclass:: UIManager
    :members:
