land-boards/lb-boards/Arduino Cards/MyMenu/pictures/Operating/IMG_5010.JPG

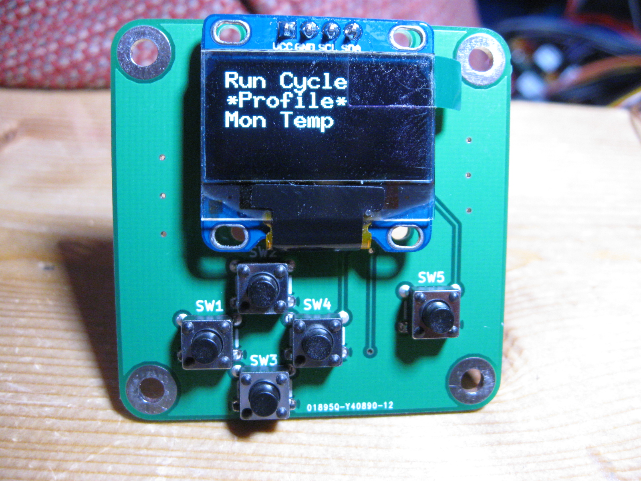
Arduino Cards/MyMenu/pictures/Operating/IMG_5010.JPG
