land-boards/lb-boards/Arduino Cards/MyMenu/pictures/Operating/IMG_5826.JPG

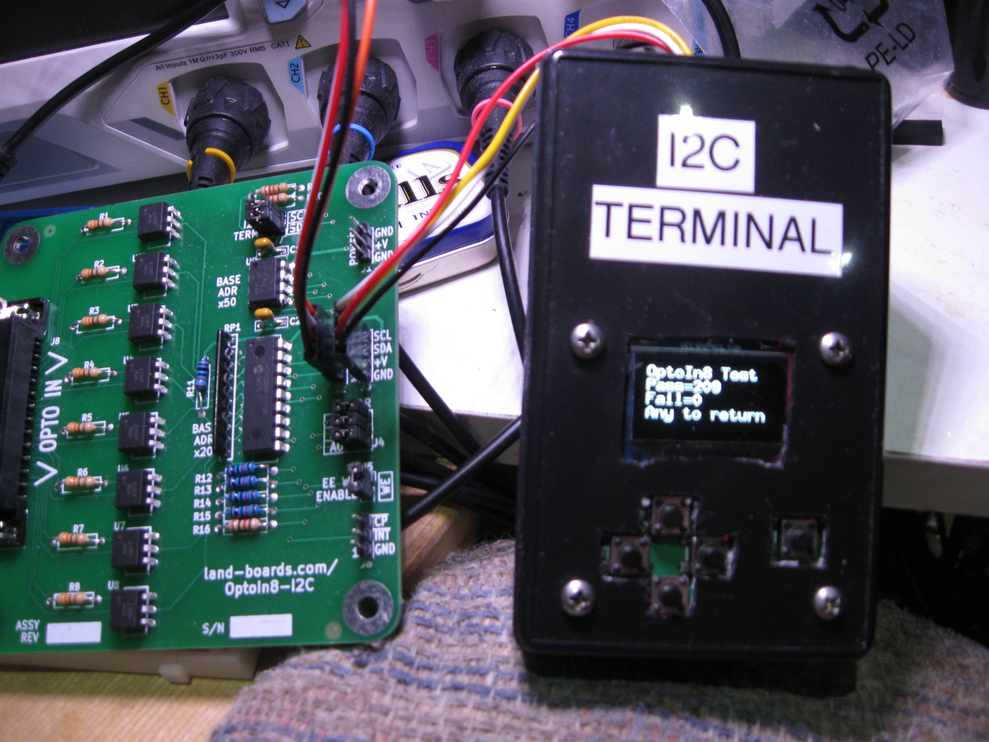
Arduino Cards/MyMenu/pictures/Operating/IMG_5826.JPG
