land-boards/lb-boards/Arduino Cards/MyMenu/pictures/Operating/MyMenu-X1-CCA-Oper-480px.jpg

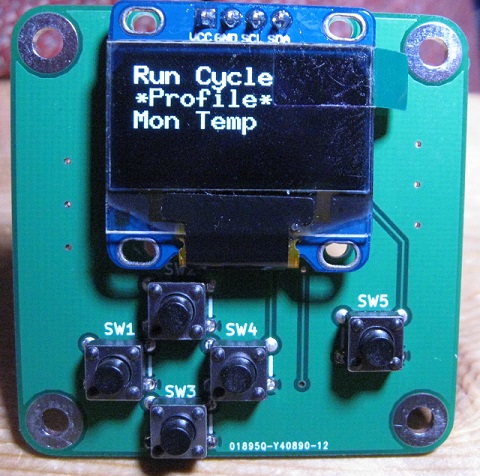
Arduino Cards/MyMenu/pictures/Operating/MyMenu-X1-CCA-Oper-480px.jpg
