land-boards/lb-boards/Arduino Cards/MyMenu/pictures/Operating/MyMenu-X2-rear-side.png

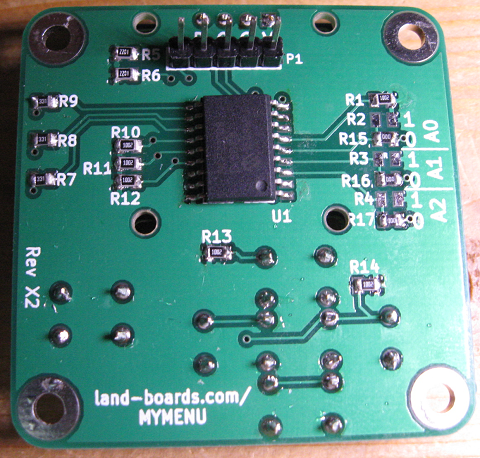
Arduino Cards/MyMenu/pictures/Operating/MyMenu-X2-rear-side.png
