land-boards/lb-boards/Arduino Cards/MyMenu/pictures/Operating/OLED 30654.jpg

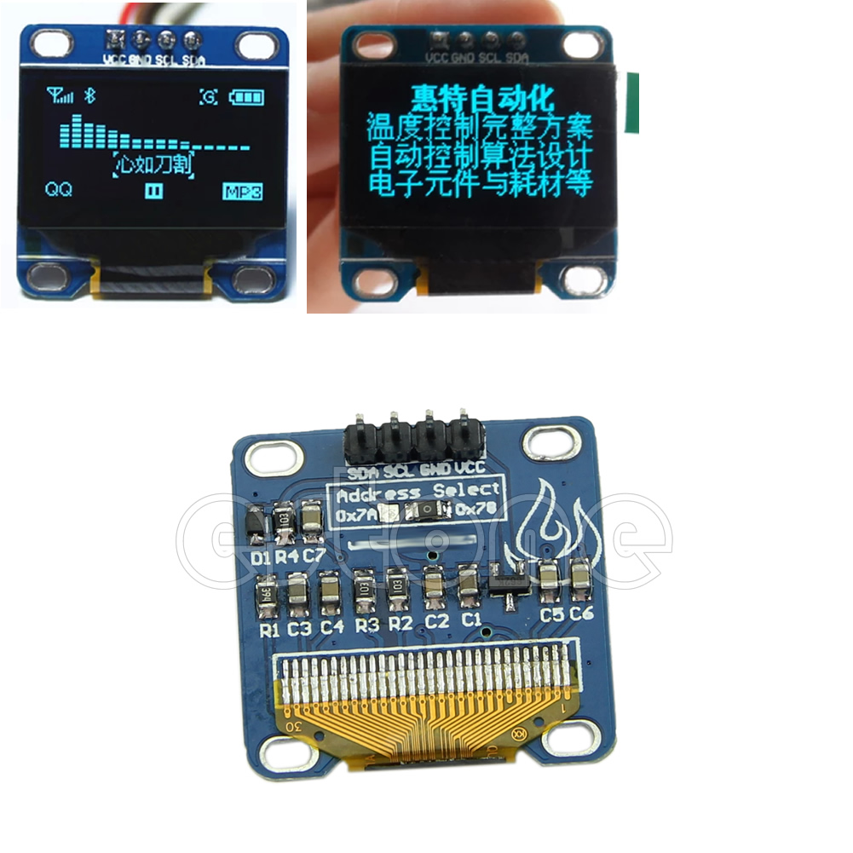
Arduino Cards/MyMenu/pictures/Operating/OLED 30654.jpg
