land-boards/lb-boards/Arduino Cards/MyMenu/pictures/Operating/P_20150807_124415.jpg

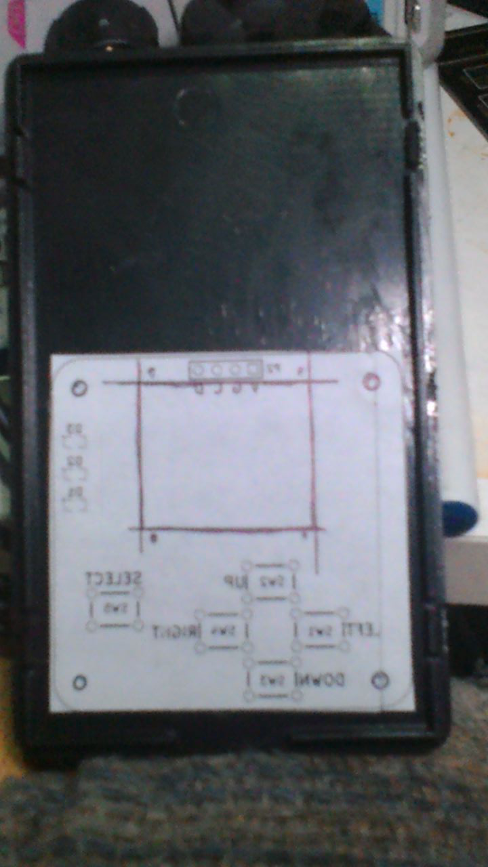
Arduino Cards/MyMenu/pictures/Operating/P_20150807_124415.jpg
