land-boards/lb-boards/BeagleBoneBlack Cards/BBB-GVS/Pictures/CCA/Pictures-V2/BBB-GVS-assembled-V2.jpg

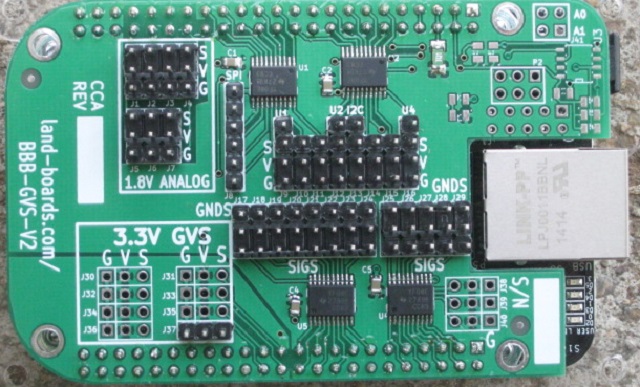
BeagleBoneBlack Cards/BBB-GVS/Pictures/CCA/Pictures-V2/BBB-GVS-assembled-V2.jpg
