land-boards/lb-boards/FPGA Cards/DCE-RS232-Female/Pics/Assembly/P1070560.JPG

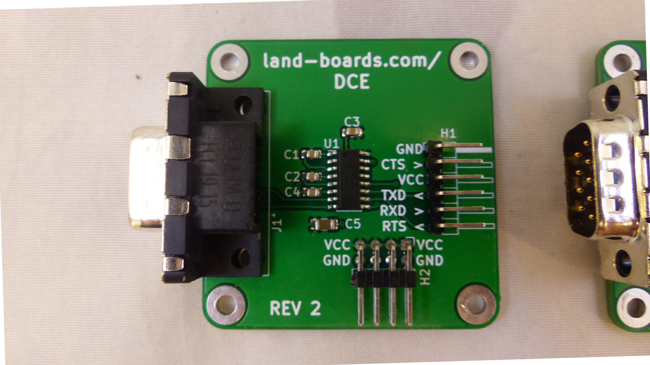
FPGA Cards/DCE-RS232-Female/Pics/Assembly/P1070560.JPG
