land-boards/lb-boards/FPGA Cards/DTE-RS232-Male/Pics/Assembly/P1070563.JPG

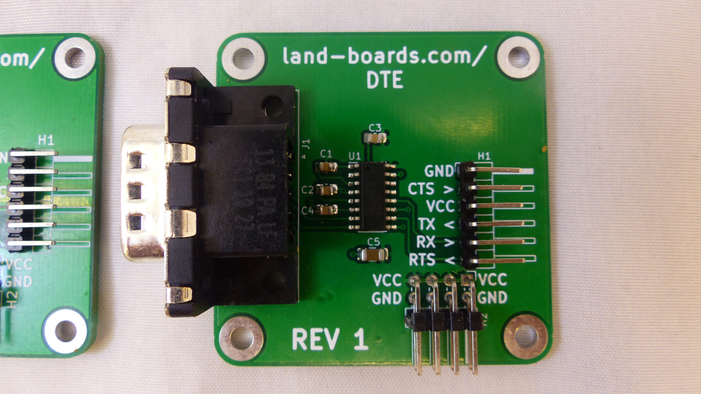
FPGA Cards/DTE-RS232-Male/Pics/Assembly/P1070563.JPG
