land-boards/lb-boards/FPGA Cards/RETRO-EP4CE15/Pictures/MultiCompInBox/BOX_BUILD/MultiCompInBox_P1984.JPG

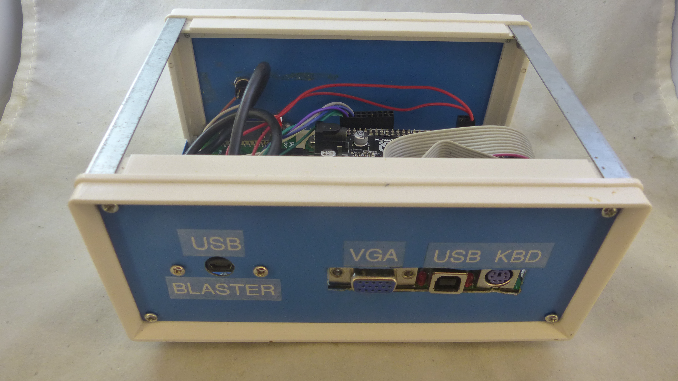
FPGA Cards/RETRO-EP4CE15/Pictures/MultiCompInBox/BOX_BUILD/MultiCompInBox_P1984.JPG
