land-boards/lb-boards/FPGA Cards/RETRO-EP4CE15/Pictures/MultiCompInBox/BOX_BUILD/MultiCompInBox_P1987_cropped.jpg

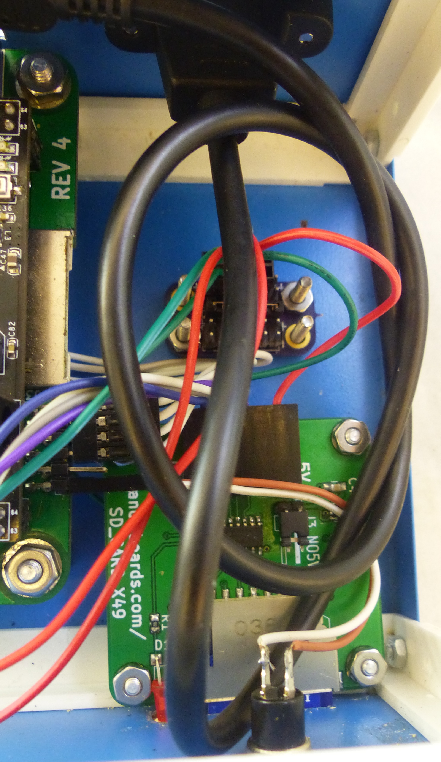
FPGA Cards/RETRO-EP4CE15/Pictures/MultiCompInBox/BOX_BUILD/MultiCompInBox_P1987_cropped.jpg
