land-boards/lb-boards/HamRadio/Colpitts_XTAL_Osc/Pics/W2AEW_Build/XTAL-Osc.PNG

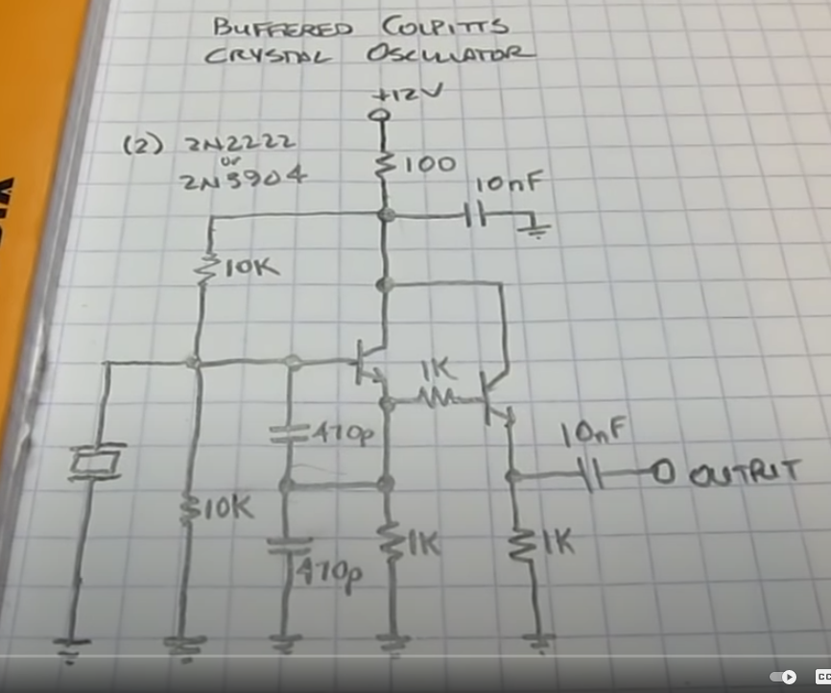
HamRadio/Colpitts_XTAL_Osc/Pics/W2AEW_Build/XTAL-Osc.PNG
