land-boards/lb-boards/HamRadio/CRYSTAL_FILTERS/SSB6/pictures/TestFixture/TestFixtureAssembly/P1070886.JPG

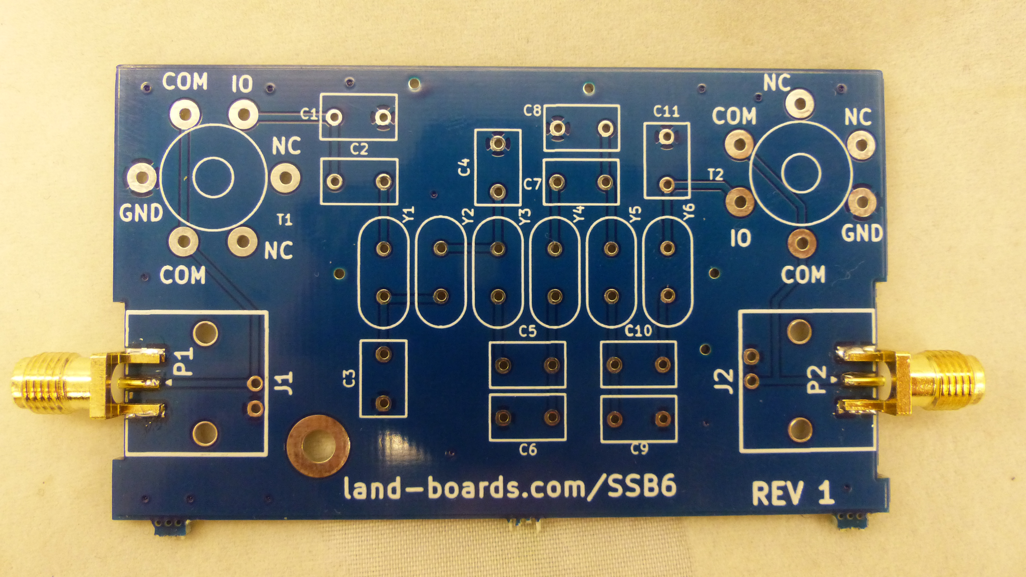
HamRadio/CRYSTAL_FILTERS/SSB6/pictures/TestFixture/TestFixtureAssembly/P1070886.JPG
