land-boards/lb-boards/HamRadio/CRYSTAL_FILTERS/SSB6/pictures/TestFixture/TestFixtureAssembly/P1070893.JPG

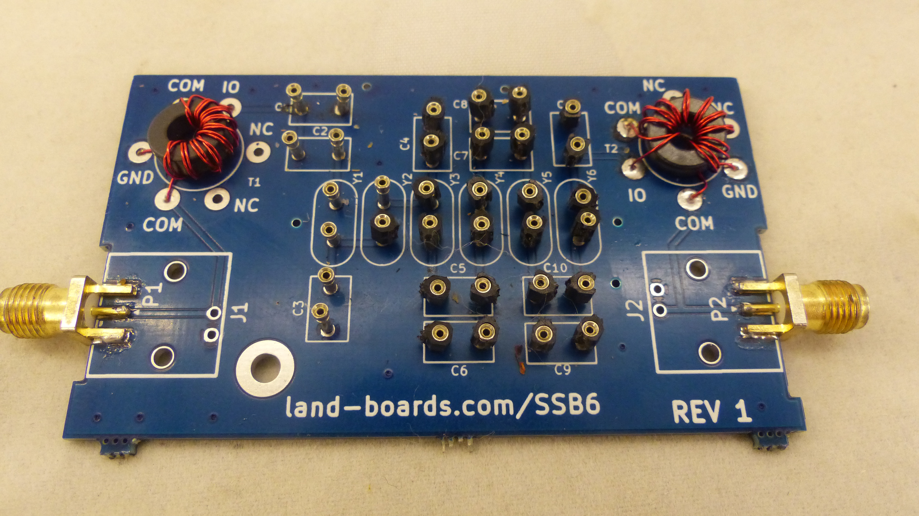
HamRadio/CRYSTAL_FILTERS/SSB6/pictures/TestFixture/TestFixtureAssembly/P1070893.JPG
