land-boards/lb-boards/HamRadio/VFO-001/Pictures/Assembly/P1070130.JPG

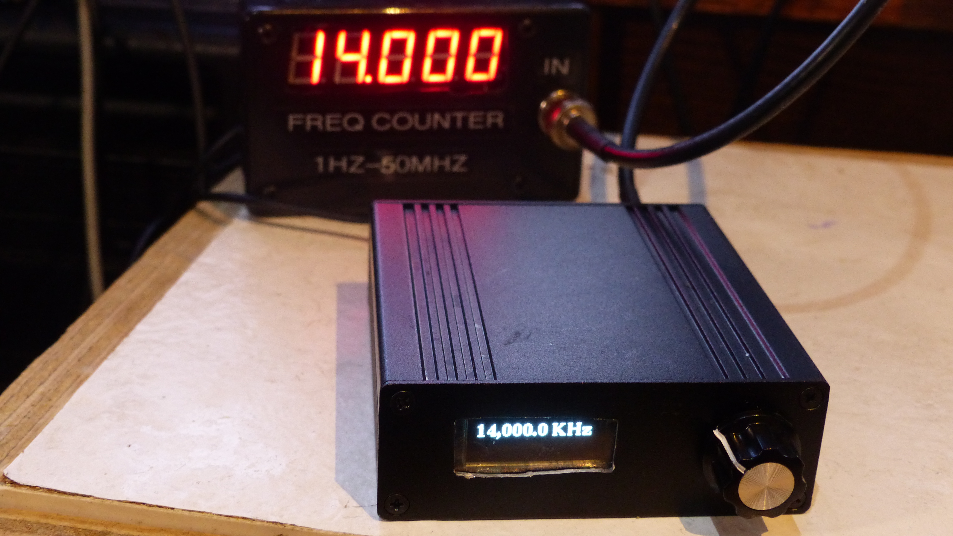
HamRadio/VFO-001/Pictures/Assembly/P1070130.JPG
