land-boards/lb-boards/HamRadio/VFO-001/Pictures/Assembly/P1070132.JPG

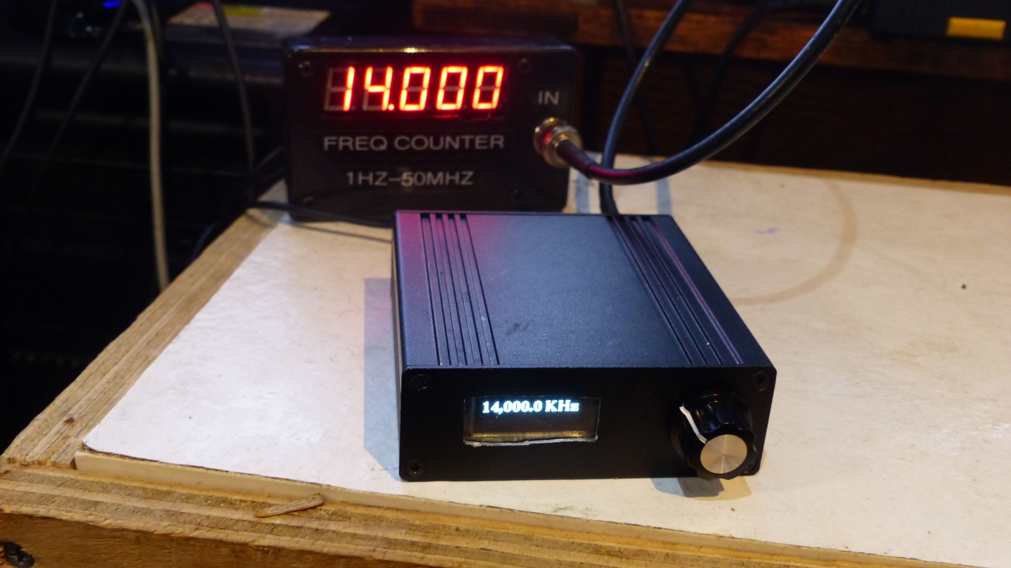
HamRadio/VFO-001/Pictures/Assembly/P1070132.JPG
