land-boards/lb-boards/HamRadio/VFO-001/Pictures/Assembly/VFO-001-Arduino_Mini-360-01.JPG

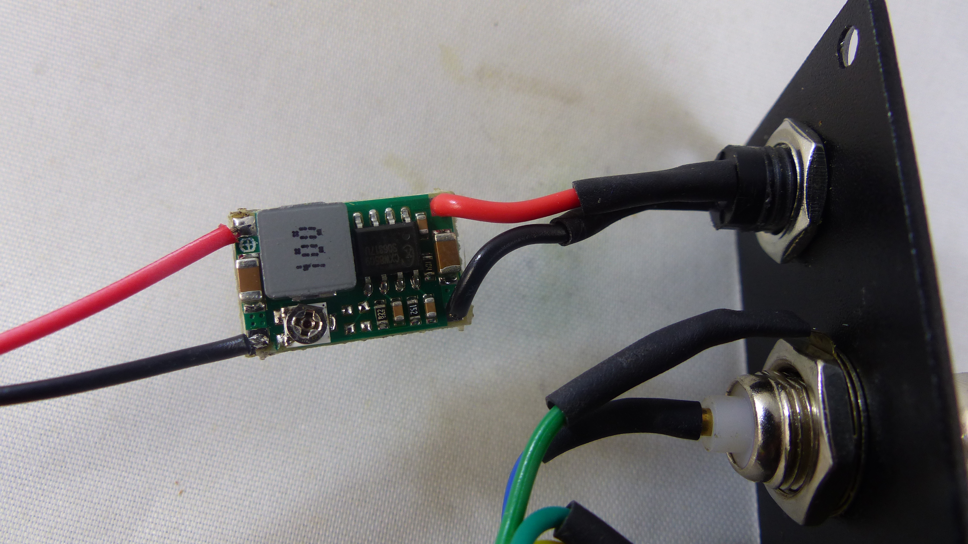
HamRadio/VFO-001/Pictures/Assembly/VFO-001-Arduino_Mini-360-01.JPG
