land-boards/lb-boards/HamRadio/VFO-001/Pictures/Assembly/VFO-001-Arduino_PD01-Wired.JPG

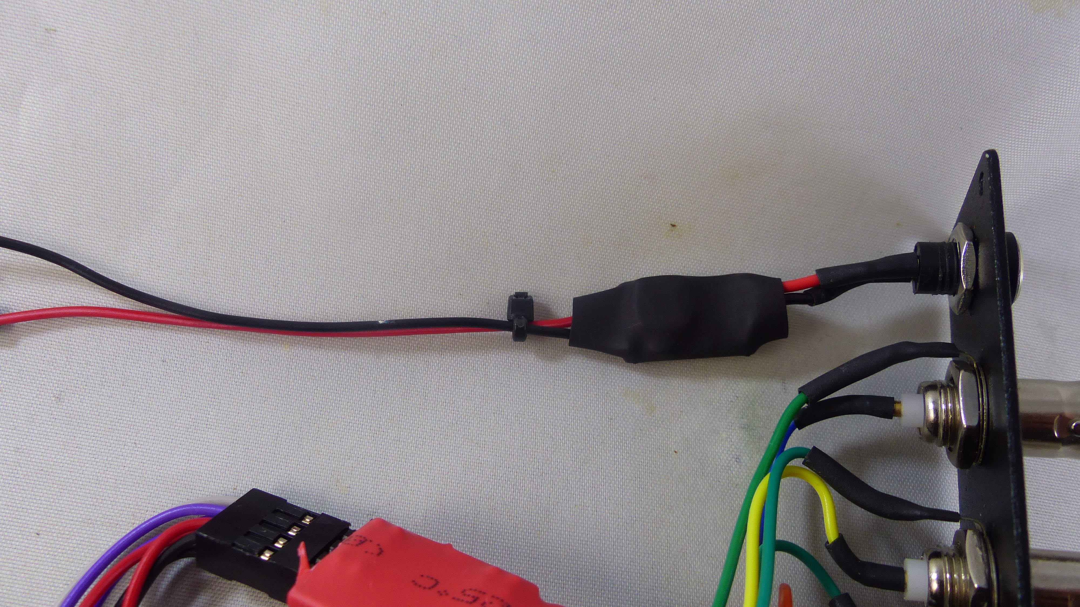
HamRadio/VFO-001/Pictures/Assembly/VFO-001-Arduino_PD01-Wired.JPG
