land-boards/lb-boards/HamRadio/VFO-001/Pictures/Assembly/VFO-001-Arduino_Si5351-1.JPG

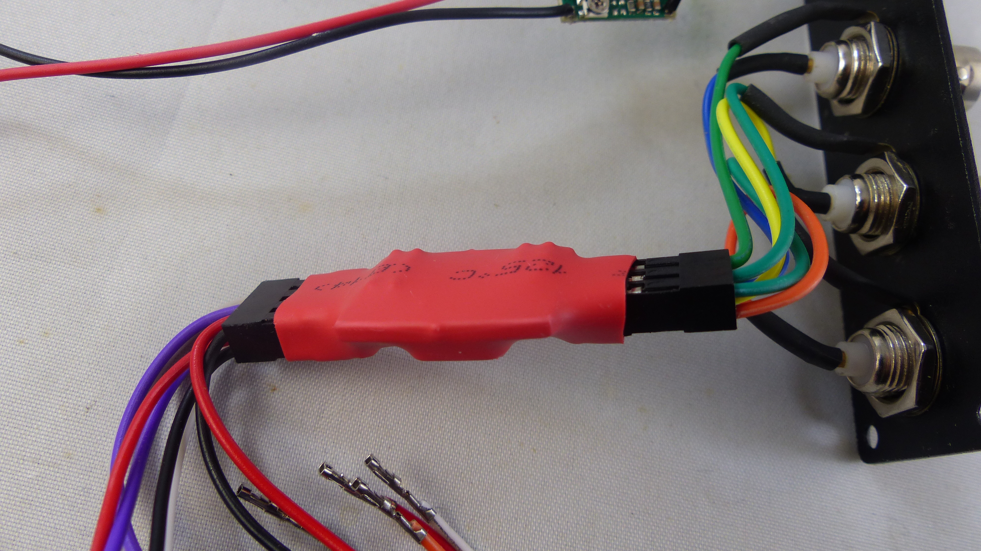
HamRadio/VFO-001/Pictures/Assembly/VFO-001-Arduino_Si5351-1.JPG
