land-boards/lb-boards/HamRadio/VFO-001/Pictures/Assembly/VFO-001-Nibbler-BNCs_Placement.jpg

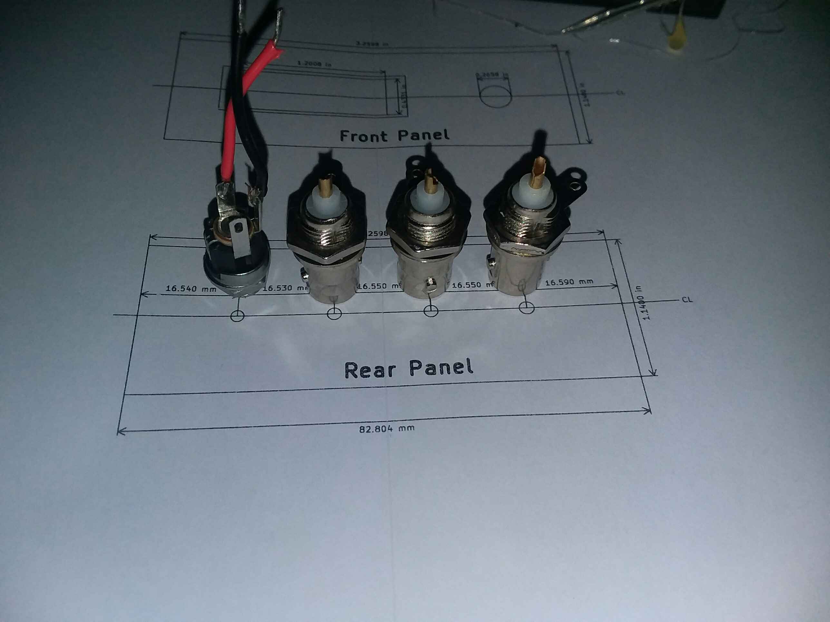
HamRadio/VFO-001/Pictures/Assembly/VFO-001-Nibbler-BNCs_Placement.jpg
