land-boards/lb-boards/HamRadio/VFO-001/Pictures/Assembly/VFO-001-Rear_Panel-720px.jpg

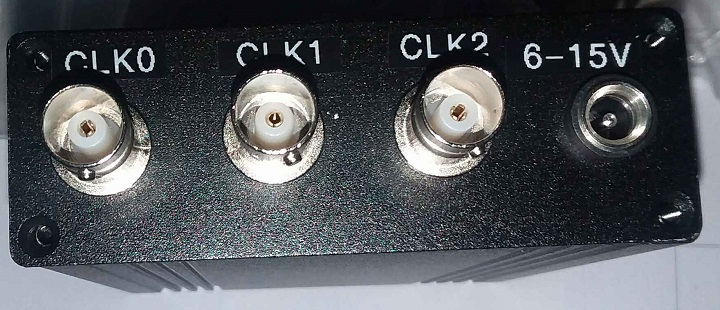
HamRadio/VFO-001/Pictures/Assembly/VFO-001-Rear_Panel-720px.jpg
