land-boards/lb-boards/HamRadio/VFO-001/Pictures/Assembly/VFO-001_P113.JPG

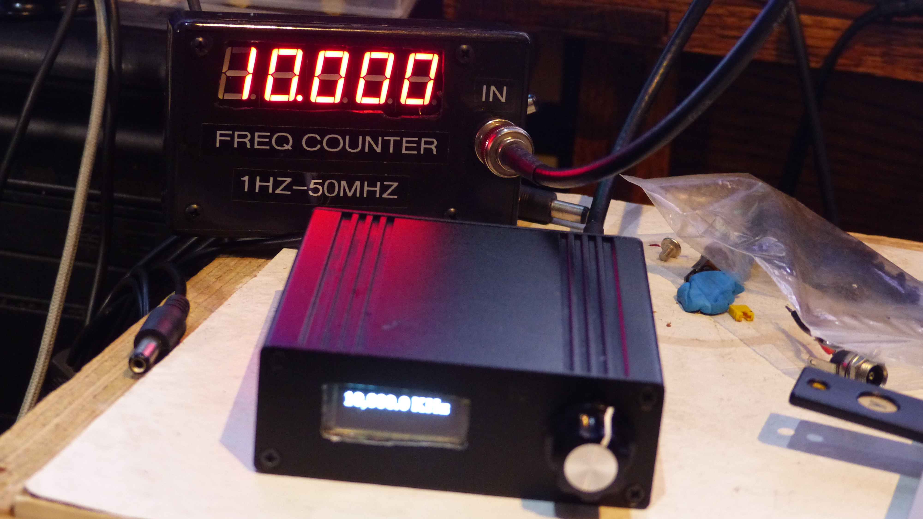
HamRadio/VFO-001/Pictures/Assembly/VFO-001_P113.JPG
