land-boards/lb-boards/HamRadio/VFO-001/Pictures/Assembly/VFO-001_P132-720px.jpg

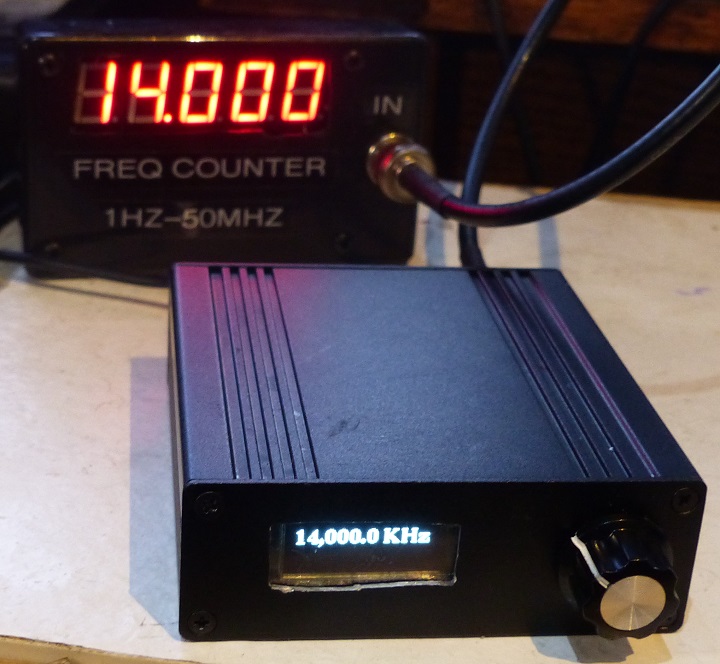
HamRadio/VFO-001/Pictures/Assembly/VFO-001_P132-720px.jpg
