land-boards/lb-boards/HamRadio/VFO-001/Pictures/Measurements/DS1Z_QuickPrint3.png

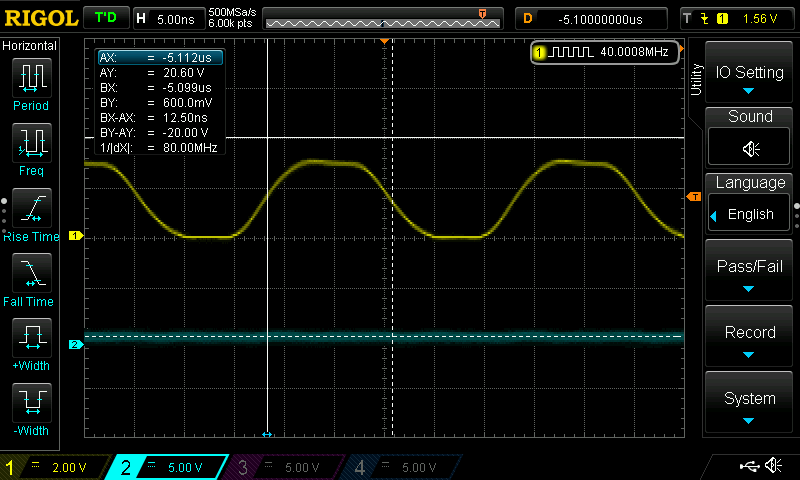
HamRadio/VFO-001/Pictures/Measurements/DS1Z_QuickPrint3.png
