land-boards/lb-boards/HamRadio/VFO-005/Pictures/Measurements/DS1Z_QuickPrint20.png

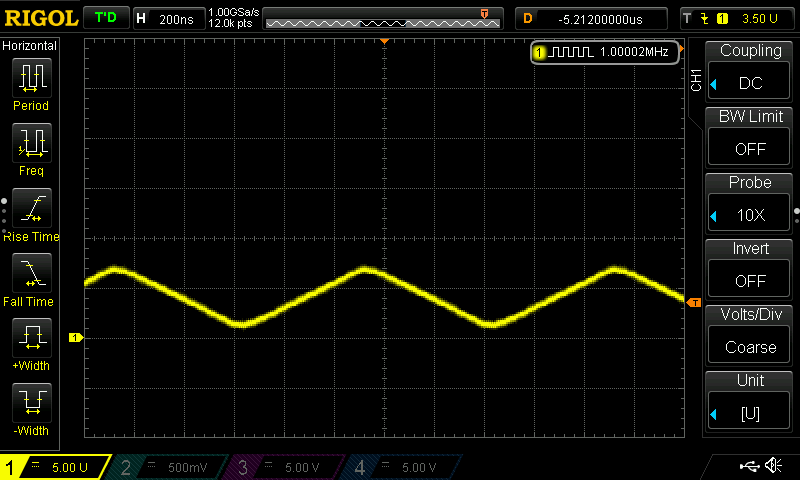
HamRadio/VFO-005/Pictures/Measurements/DS1Z_QuickPrint20.png
