land-boards/lb-boards/I2C Cards/I2CIO-8/Pictures/Assembly/IMG_6001.JPG

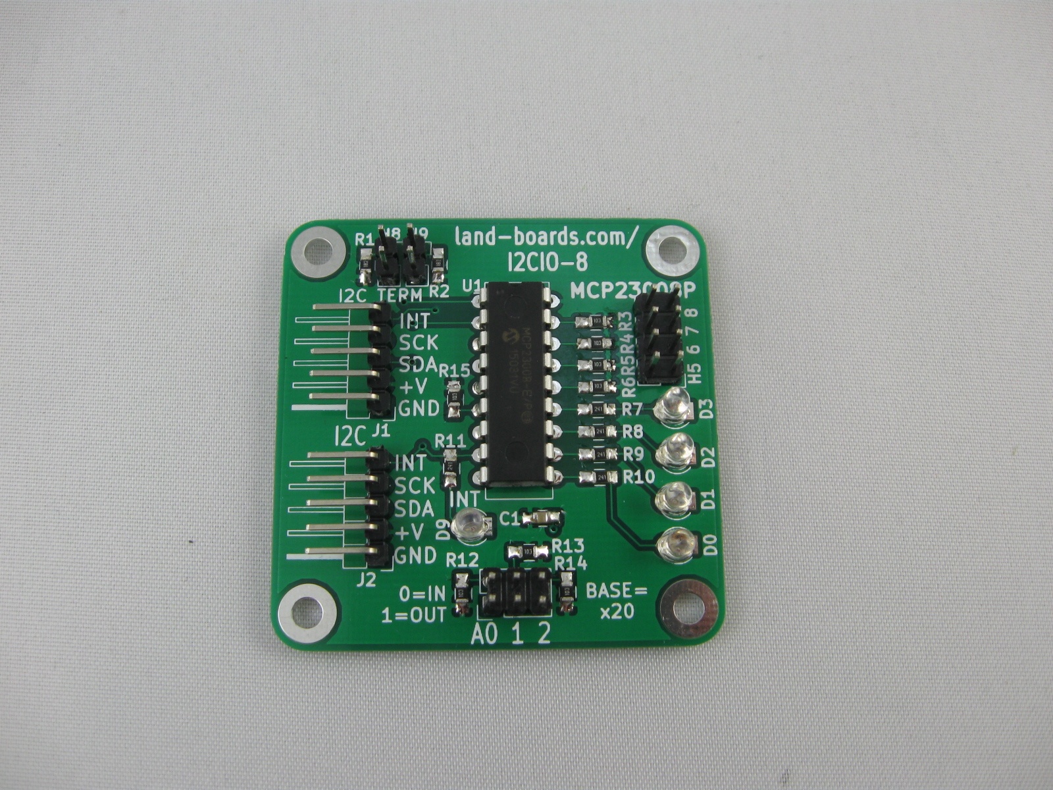
I2C Cards/I2CIO-8/Pictures/Assembly/IMG_6001.JPG
