land-boards/lb-boards/I2C Cards/I2CIO-8/Pictures/Assembly/Rev-X1/IMG_5957.JPG

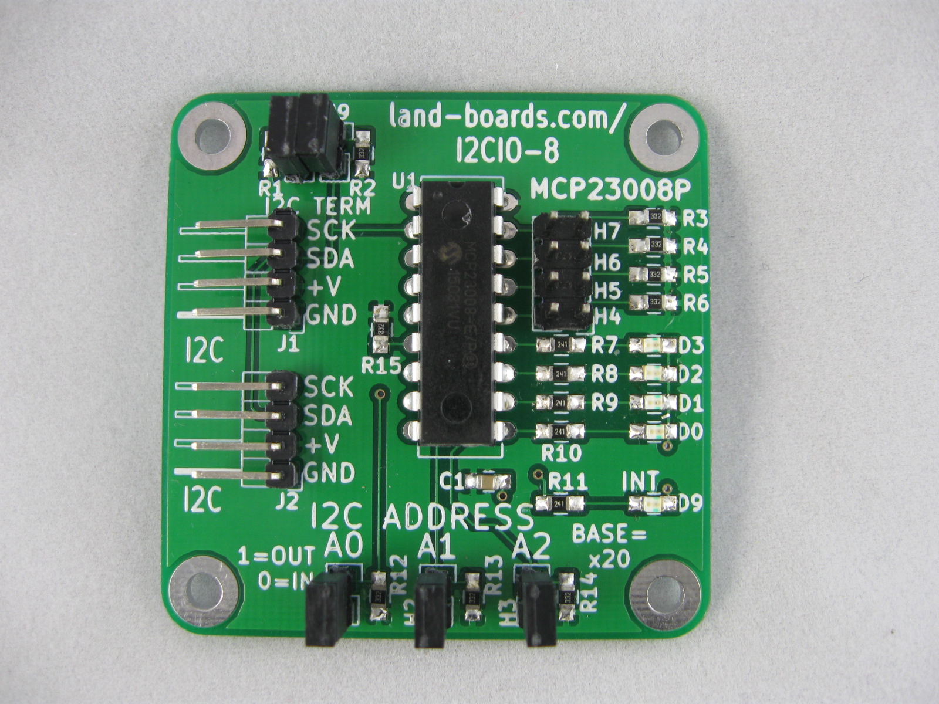
I2C Cards/I2CIO-8/Pictures/Assembly/Rev-X1/IMG_5957.JPG
