land-boards/lb-boards/ODAS Cards/ODAS-PSOC5/Pictures/Assembly/ODAS-PSOC5-P682-X4-4000px.JPG

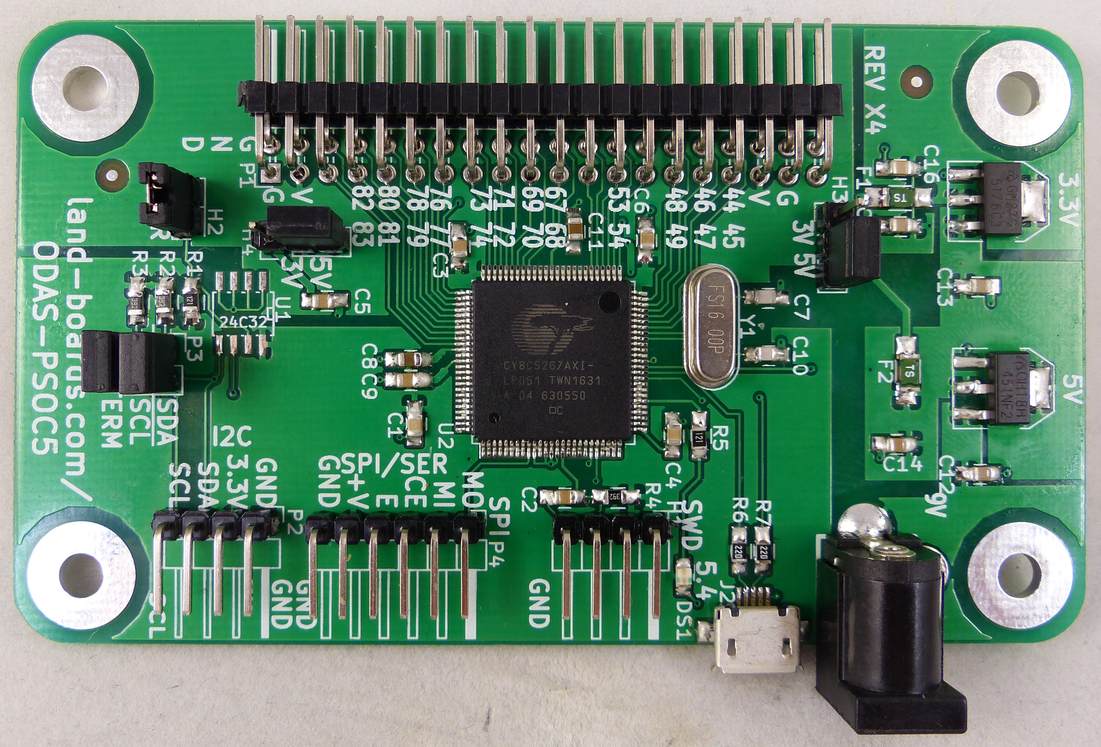
ODAS Cards/ODAS-PSOC5/Pictures/Assembly/ODAS-PSOC5-P682-X4-4000px.JPG
