land-boards/lb-boards/Projects/IReflow/pictures/Calibration/SetToBake-BothElements/BakeHeatCool-Manual/ToasterOvenBakeHeatCoolManual.png

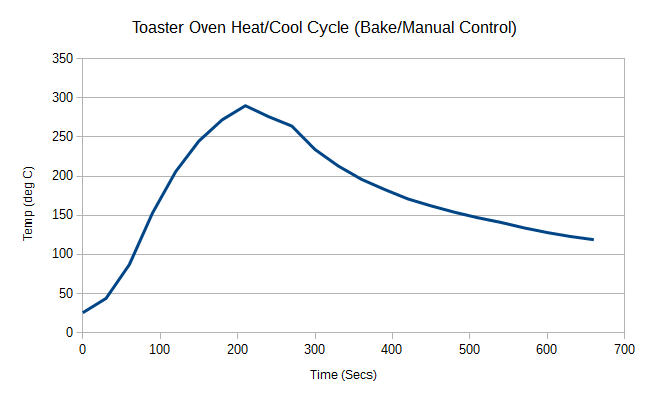
Projects/IReflow/pictures/Calibration/SetToBake-BothElements/BakeHeatCool-Manual/ToasterOvenBakeHeatCoolManual.png
