land-boards/lb-boards/Projects/IReflow/pictures/Calibration/SolderProfiles/LeadFreeProfile.PNG

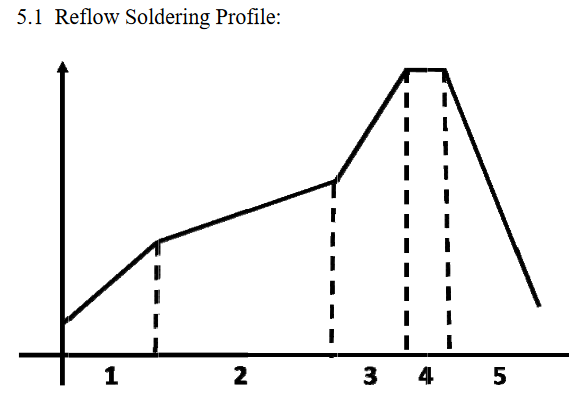
Projects/IReflow/pictures/Calibration/SolderProfiles/LeadFreeProfile.PNG
