land-boards/lb-boards/Projects/IReflow/pictures/Oven Build/P1030696.JPG

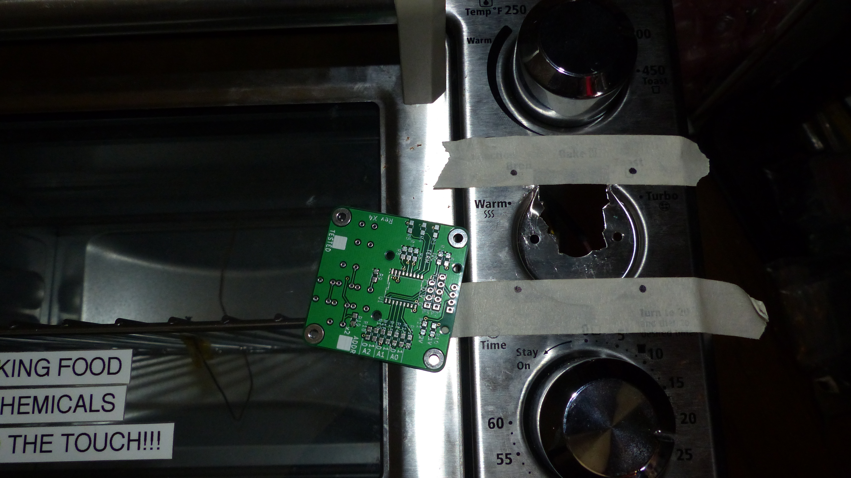
Projects/IReflow/pictures/Oven Build/P1030696.JPG
