land-boards/lb-boards/Projects/IReflow/pictures/Oven Build/P1030699.JPG

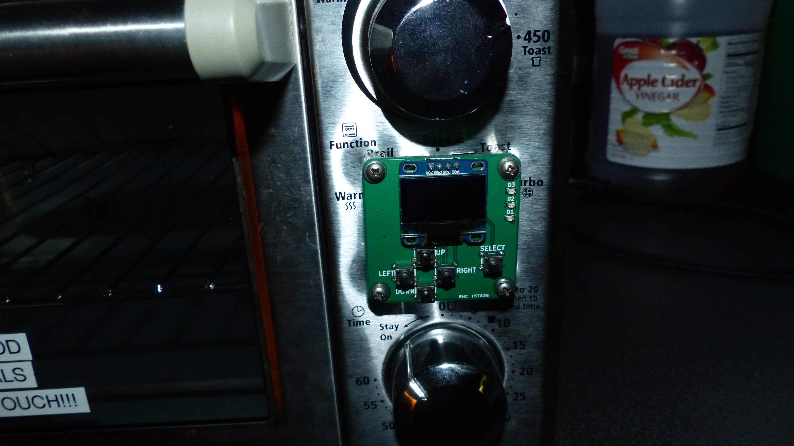
Projects/IReflow/pictures/Oven Build/P1030699.JPG
