land-boards/lb-boards/Projects/IReflow/pictures/Oven Build/P1030703.JPG

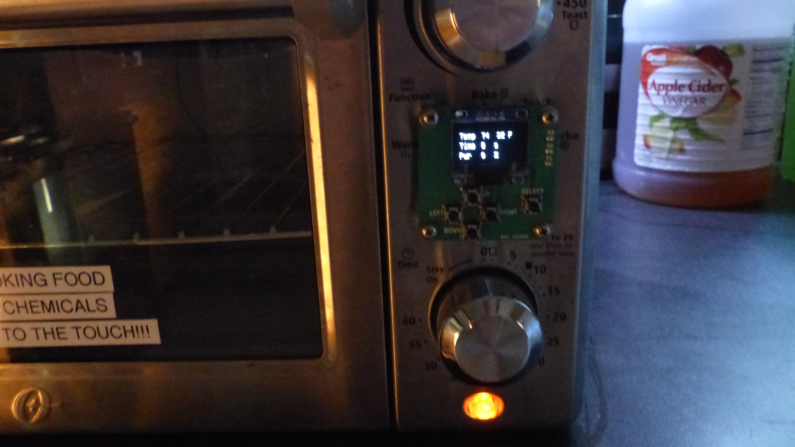
Projects/IReflow/pictures/Oven Build/P1030703.JPG
