land-boards/lb-boards/Raspberry Pi Cards/PiPicoMite02/Pics/CCA/CircuitPython_Build/PiPicoMite02_CPBuild_P18348-720px.jpg

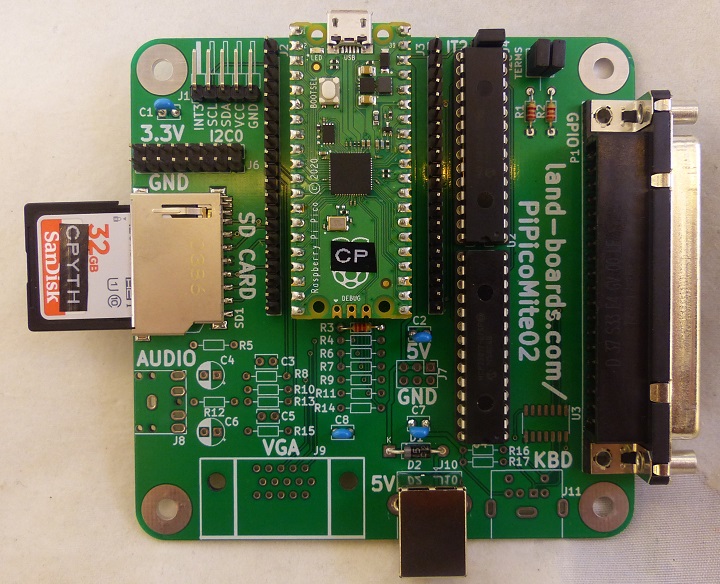
Raspberry Pi Cards/PiPicoMite02/Pics/CCA/CircuitPython_Build/PiPicoMite02_CPBuild_P18348-720px.jpg
