land-boards/lb-boards/RetroCPUs/SIMPLE-6502/Pics/Build/SIMPLE-6502_P1090153.JPG

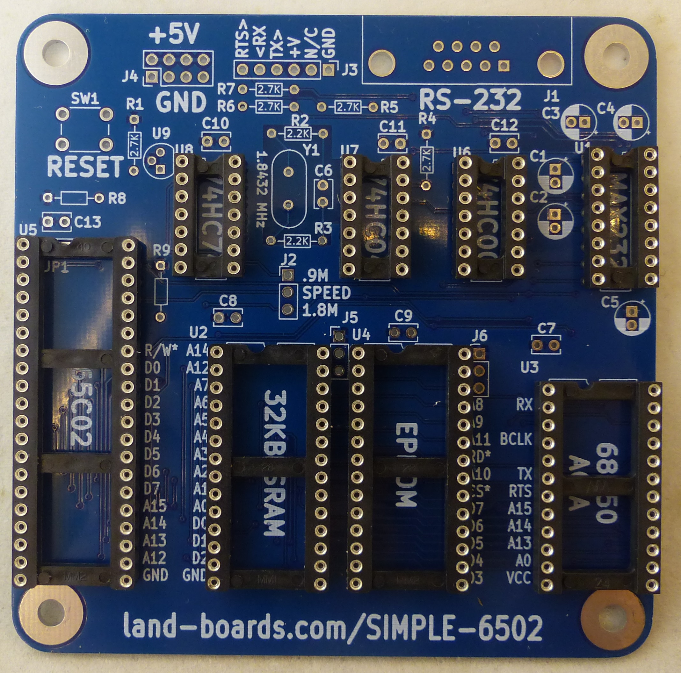
RetroCPUs/SIMPLE-6502/Pics/Build/SIMPLE-6502_P1090153.JPG
