land-boards/lb-boards/RetroCPUs/SIMPLE-6502/Pics/Build/SIMPLE-6502_P1090194-720pxV.jpg

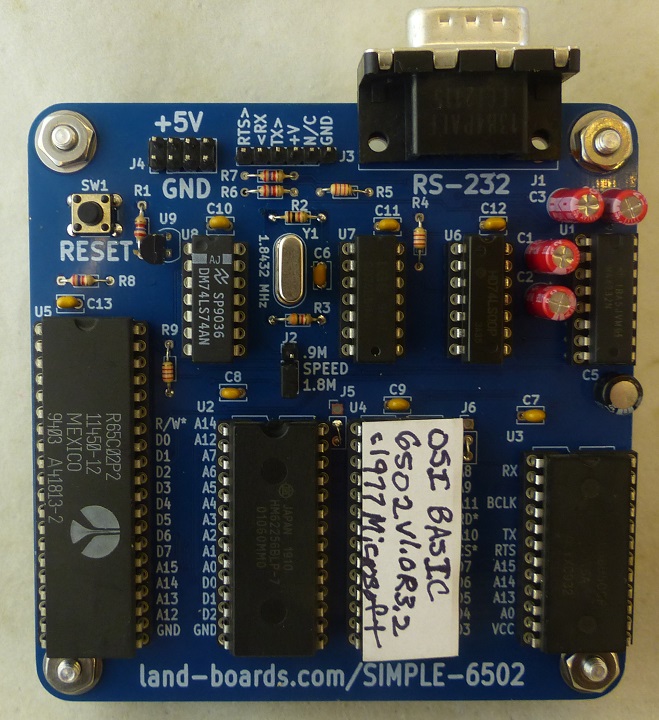
RetroCPUs/SIMPLE-6502/Pics/Build/SIMPLE-6502_P1090194-720pxV.jpg
