land-boards/lb-boards/RetroCPUs/SIMPLE-6809/Pics/Build/SIMPLE-6809_P1090173.JPG

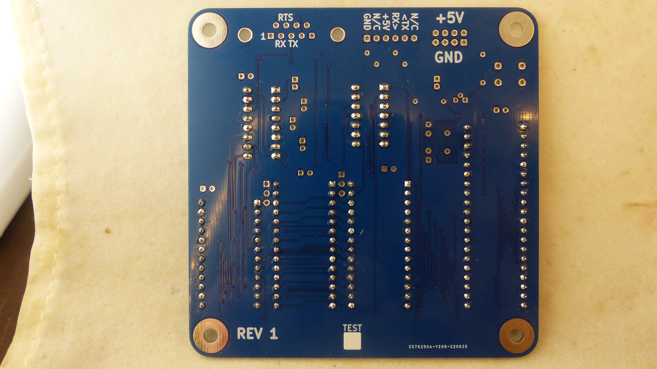
RetroCPUs/SIMPLE-6809/Pics/Build/SIMPLE-6809_P1090173.JPG
