land-boards/lb-boards/RetroCPUs/SIMPLE-Z80/Pics/BUILD/P1090203.JPG

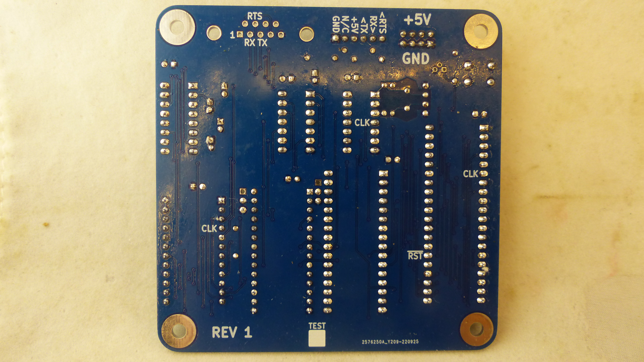
RetroCPUs/SIMPLE-Z80/Pics/BUILD/P1090203.JPG
