land-boards/lb-boards/RetroCPUs/SIMPLE-Z80/Pics/BUILD/SIMPLE-Z80_P1090211.JPG

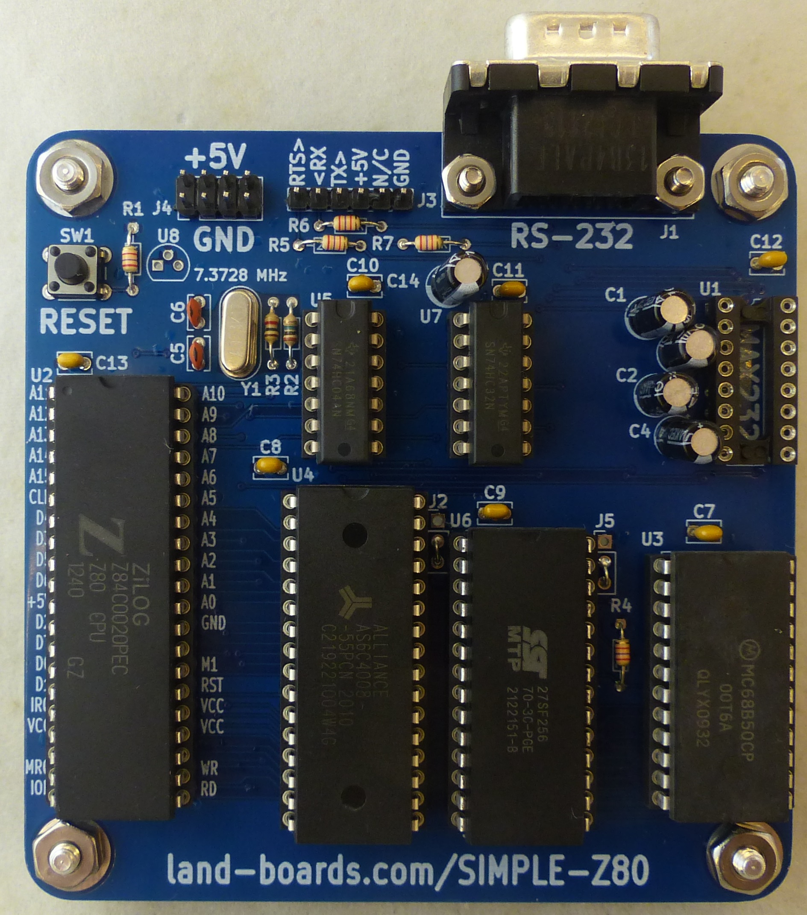
RetroCPUs/SIMPLE-Z80/Pics/BUILD/SIMPLE-Z80_P1090211.JPG
