land-boards/lb-boards/SYNTHS/Docs/Modules/Mutable Instruments/MI Beaks (Peaks)/Build/MI_Beaks_Analog_Card_Front_Side_Resistors_Caps_P1080745-720px.jpg

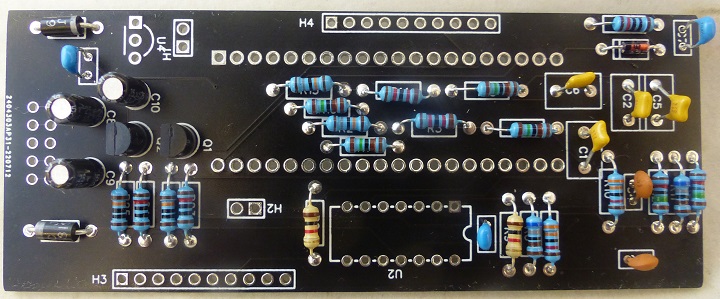
SYNTHS/Docs/Modules/Mutable Instruments/MI Beaks (Peaks)/Build/MI_Beaks_Analog_Card_Front_Side_Resistors_Caps_P1080745-720px.jpg
