land-boards/lb-boards/SYNTHS/Docs/Modules/Mutable Instruments/MI Beaks (Peaks)/Build/MI_Beaks_Controls_Resistors-Added_P1080719.JPG

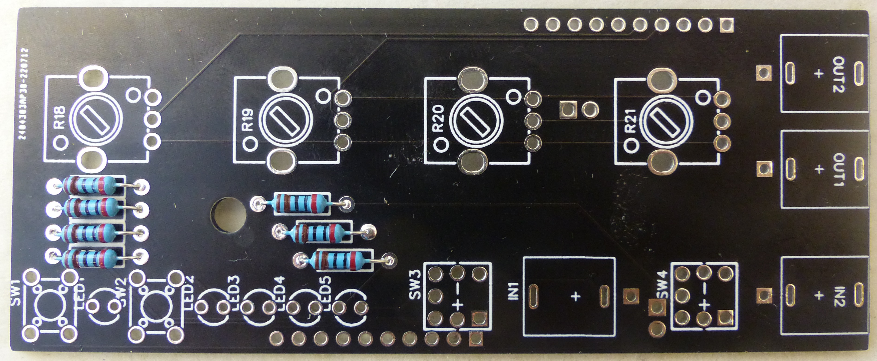
SYNTHS/Docs/Modules/Mutable Instruments/MI Beaks (Peaks)/Build/MI_Beaks_Controls_Resistors-Added_P1080719.JPG
