land-boards/lb-boards/SYNTHS/Docs/Modules/Mutable Instruments/MI Beaks (Peaks)/Build/MI_Beaks_Front_Panel_With_Ctrls_Jacks_P1080734-720px.jpg

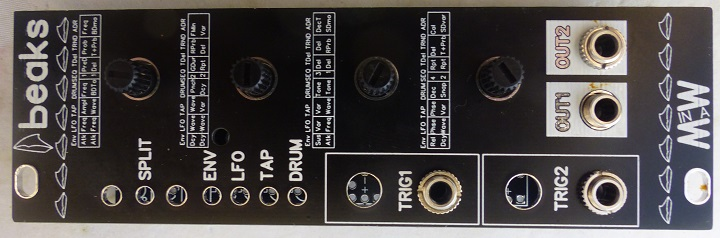
SYNTHS/Docs/Modules/Mutable Instruments/MI Beaks (Peaks)/Build/MI_Beaks_Front_Panel_With_Ctrls_Jacks_P1080734-720px.jpg
