land-boards/lb-boards/SYNTHS/Docs/Modules/Mutable Instruments/MI Braids/MI Thru Hole Braids Assembled/Braids_Video_Cap_01.PNG

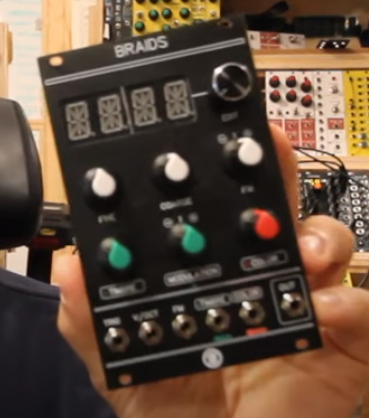
SYNTHS/Docs/Modules/Mutable Instruments/MI Braids/MI Thru Hole Braids Assembled/Braids_Video_Cap_01.PNG
