land-boards/lb-boards/SYNTHS/Docs/Modules/Mutable Instruments/MI_Gris (Grids)/Build/GRIS_P1370-720pxV.jpg

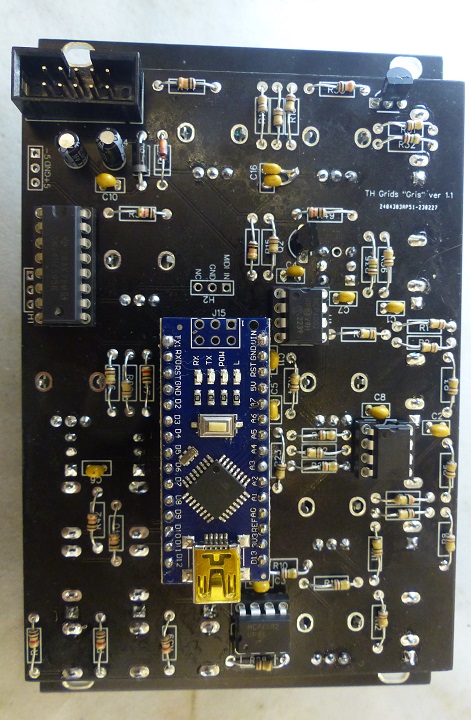
SYNTHS/Docs/Modules/Mutable Instruments/MI_Gris (Grids)/Build/GRIS_P1370-720pxV.jpg
