land-boards/lb-boards/SYNTHS/Docs/Modules/Mutable Instruments/MI_Gris (Grids)/Build/GRIS_P10366-720pxV.jpg

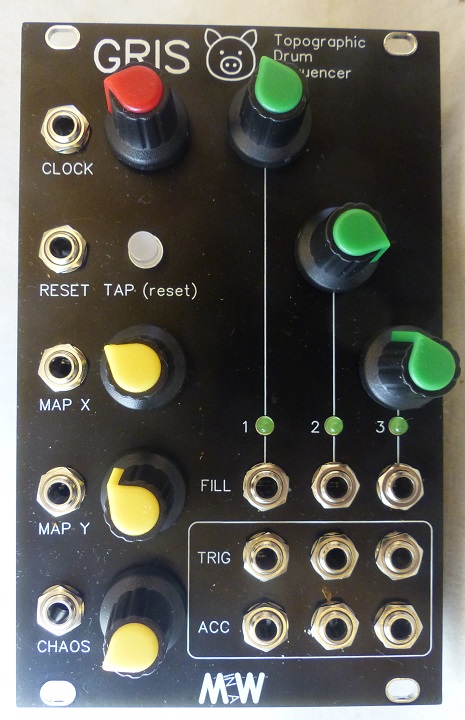
SYNTHS/Docs/Modules/Mutable Instruments/MI_Gris (Grids)/Build/GRIS_P10366-720pxV.jpg
