land-boards/lb-boards/SYNTHS/ER-PROTO-02_SET/ER-GATE-SEQ-01/Pics/Build/ER-GATE-SEQ-01_P1080968-720pxV.jpg

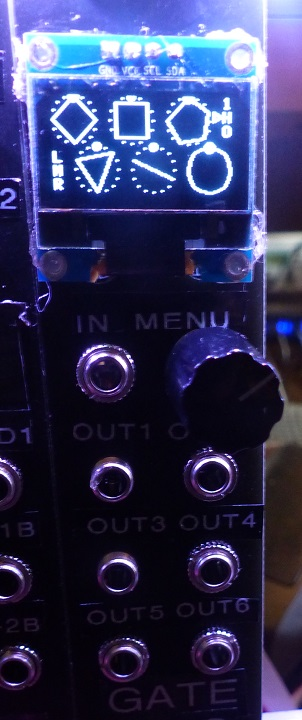
SYNTHS/ER-PROTO-02_SET/ER-GATE-SEQ-01/Pics/Build/ER-GATE-SEQ-01_P1080968-720pxV.jpg
