land-boards/lb-boards/SYNTHS/ER-PROTO-02_SET/ER-SCOPE-01/PICS/Build/ER-SCOPE-01_P1090044-720pxV.jpg

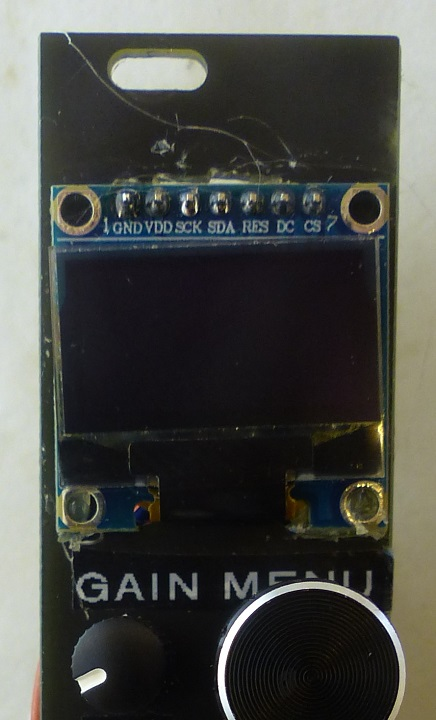
SYNTHS/ER-PROTO-02_SET/ER-SCOPE-01/PICS/Build/ER-SCOPE-01_P1090044-720pxV.jpg
