land-boards/lb-boards/SYNTHS/ER-PROTO-02_SET/ER-SCOPE-01/PICS/Build/ER-SCOPE-01_P1090053-720px.jpg

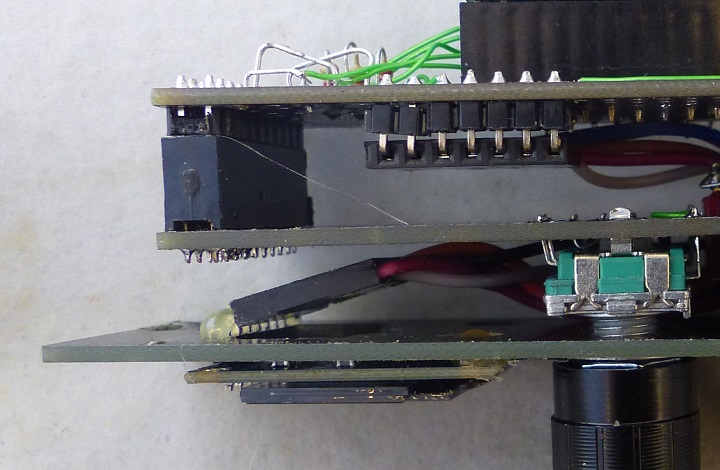
SYNTHS/ER-PROTO-02_SET/ER-SCOPE-01/PICS/Build/ER-SCOPE-01_P1090053-720px.jpg
