land-boards/lb-boards/SYNTHS/ER-PROTO-02_SET/ER-SCOPE-01/PICS/Build/I2C/ER-SCOPE-01_P1080978.JPG

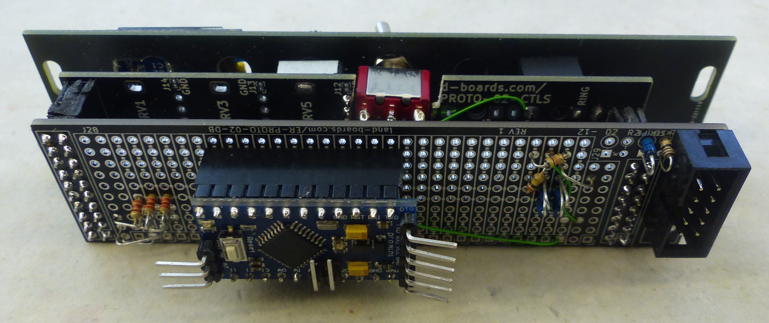
SYNTHS/ER-PROTO-02_SET/ER-SCOPE-01/PICS/Build/I2C/ER-SCOPE-01_P1080978.JPG
