land-boards/lb-boards/SYNTHS/NOT_BUILD/ER-MIDI-CV4-01/ER-MIDI-VC4-01_DB/PICS/3D/ER-MIDI-VC4-01_DB_FRONT_3D.png

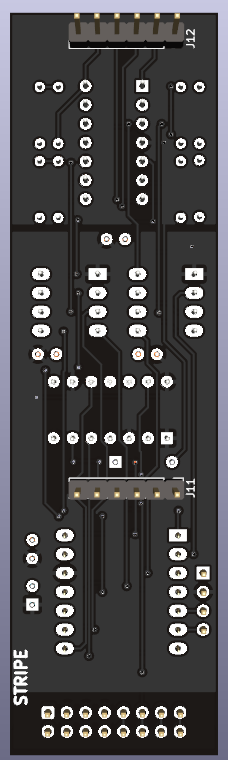
SYNTHS/NOT_BUILD/ER-MIDI-CV4-01/ER-MIDI-VC4-01_DB/PICS/3D/ER-MIDI-VC4-01_DB_FRONT_3D.png
