land-boards/lb-boards/SYNTHS/NOT_BUILD/ER-MIDI-CV4-01/ER-MIDI-VC4-01_DB/PICS/CAD/ER-MIDI-VC4-01_DB_FRONT_CAD.PNG

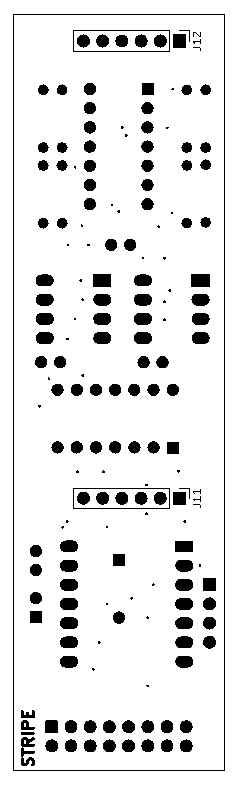
SYNTHS/NOT_BUILD/ER-MIDI-CV4-01/ER-MIDI-VC4-01_DB/PICS/CAD/ER-MIDI-VC4-01_DB_FRONT_CAD.PNG
