land-boards/lb-boards/SYNTHS/NOT_BUILD/ER-MIDI-CV4-01/PICS/3D/ER-MIDI-CV4-01_SET_3D-720px.png

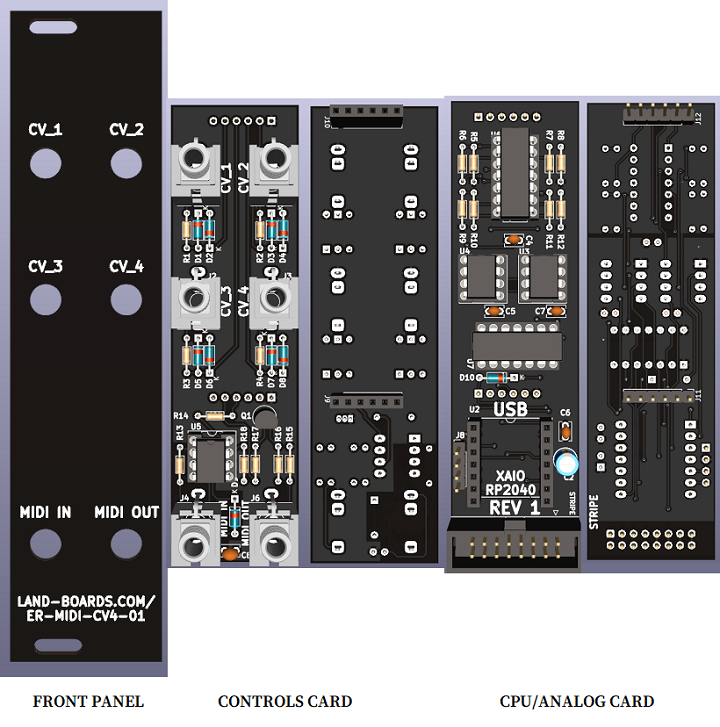
SYNTHS/NOT_BUILD/ER-MIDI-CV4-01/PICS/3D/ER-MIDI-CV4-01_SET_3D-720px.png
