land-boards/lb-boards/SYNTHS/NOT_BUILD/MOD-MIDI-THRU/PICS/3D/MOD-MIDI-THRU_REAR_4D.png

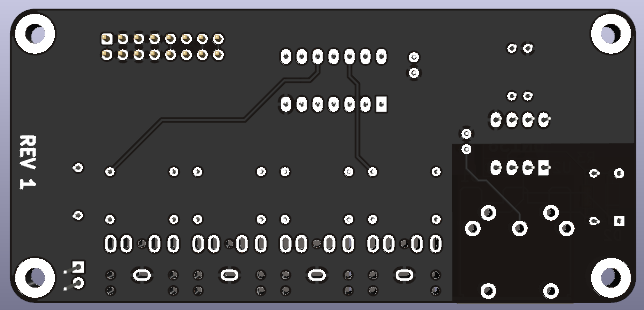
SYNTHS/NOT_BUILD/MOD-MIDI-THRU/PICS/3D/MOD-MIDI-THRU_REAR_4D.png
