land-boards/lb-boards/SYNTHS/NOT_BUILD/SYNTH-MIXER4-01_SET/SYNTH-CTLS-5-01/PICS/3D/SYNTH-MIXER4-01-CTRLS_FRONT_3D.PNG

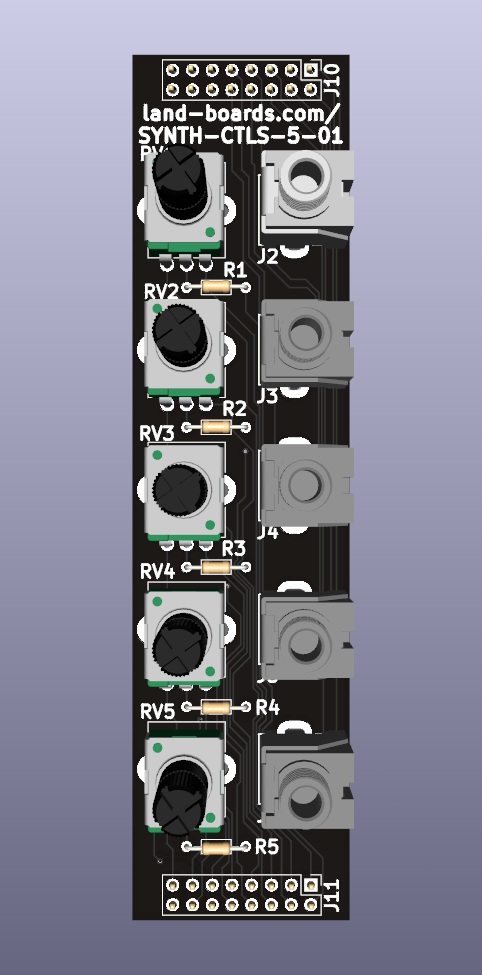
SYNTHS/NOT_BUILD/SYNTH-MIXER4-01_SET/SYNTH-CTLS-5-01/PICS/3D/SYNTH-MIXER4-01-CTRLS_FRONT_3D.PNG
