land-boards/lb-boards/SYNTHS/NOT_BUILD/SYNTH-MIXER4-01_SET/SYNTH-MIXER4-01-DB/PICS/3D/SYNTH-MIXER4-01-DB_REAR-3D.png

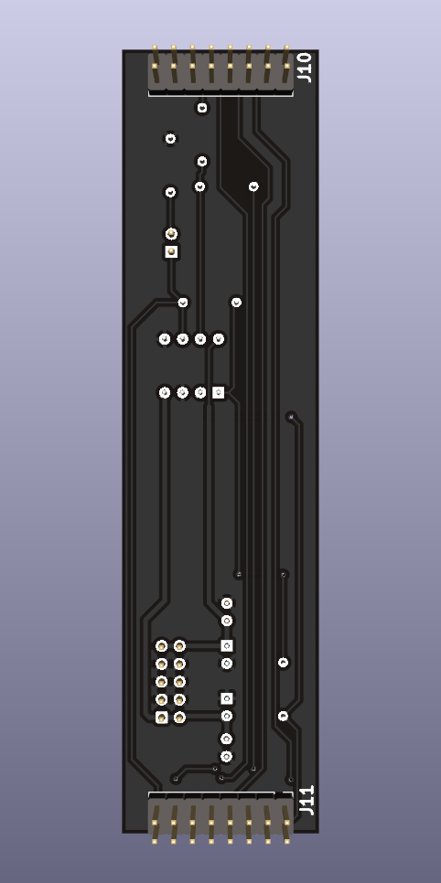
SYNTHS/NOT_BUILD/SYNTH-MIXER4-01_SET/SYNTH-MIXER4-01-DB/PICS/3D/SYNTH-MIXER4-01-DB_REAR-3D.png
