land-boards/lb-boards/SYNTHS/NOT_BUILD/SYNTH-MIXER4-DB/DOCS/pj301bm-jack-technical-drawing.jpg

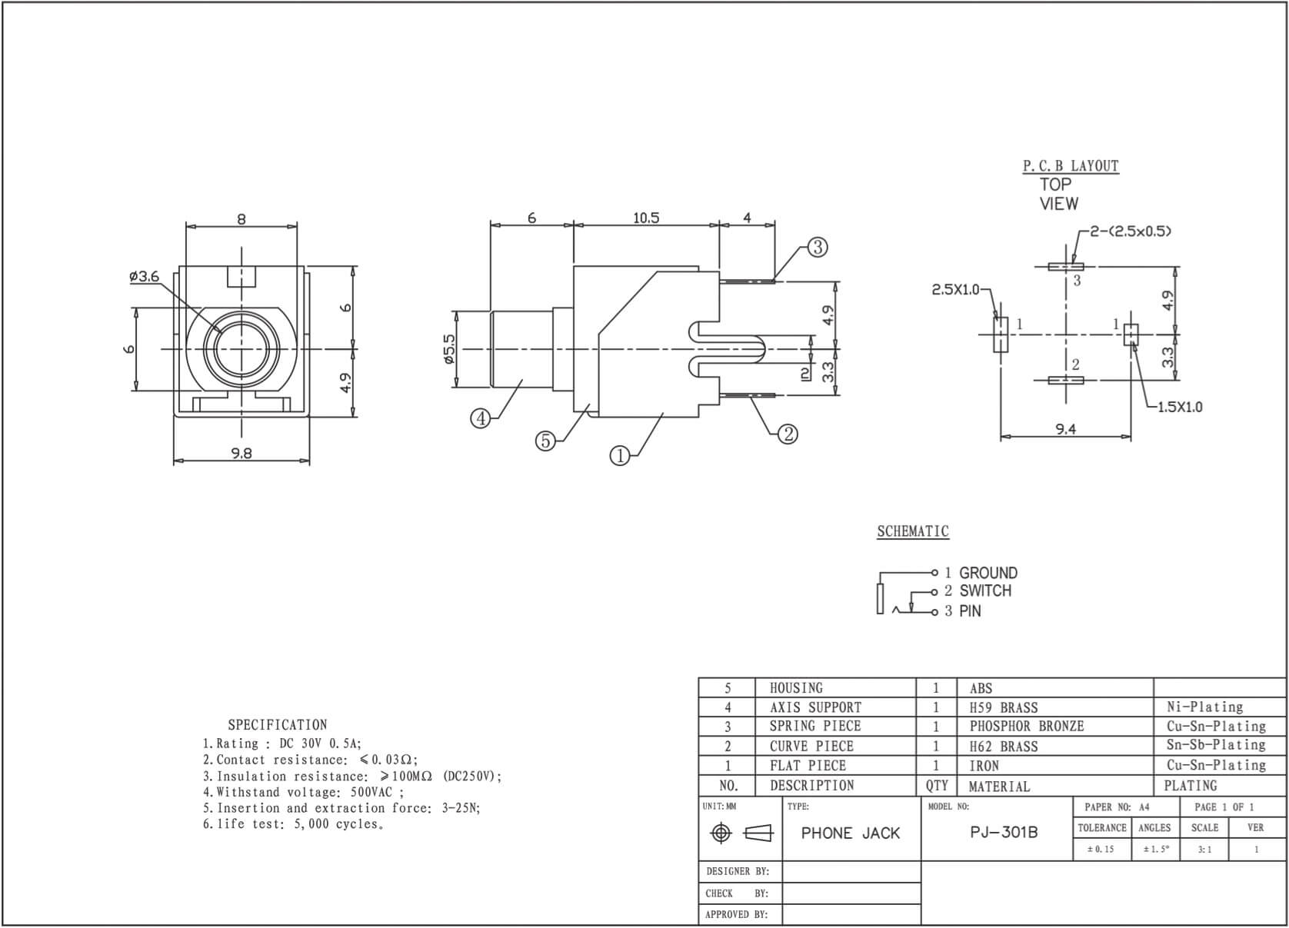
SYNTHS/NOT_BUILD/SYNTH-MIXER4-DB/DOCS/pj301bm-jack-technical-drawing.jpg
