land-boards/lb-boards/SYNTHS/NOT_BUILD/SYNTH-MIXER6-01_SET/SYNTH-MIXER6-01/PICS/Rework/SYNTH-MIXER6-01_Rework.PNG

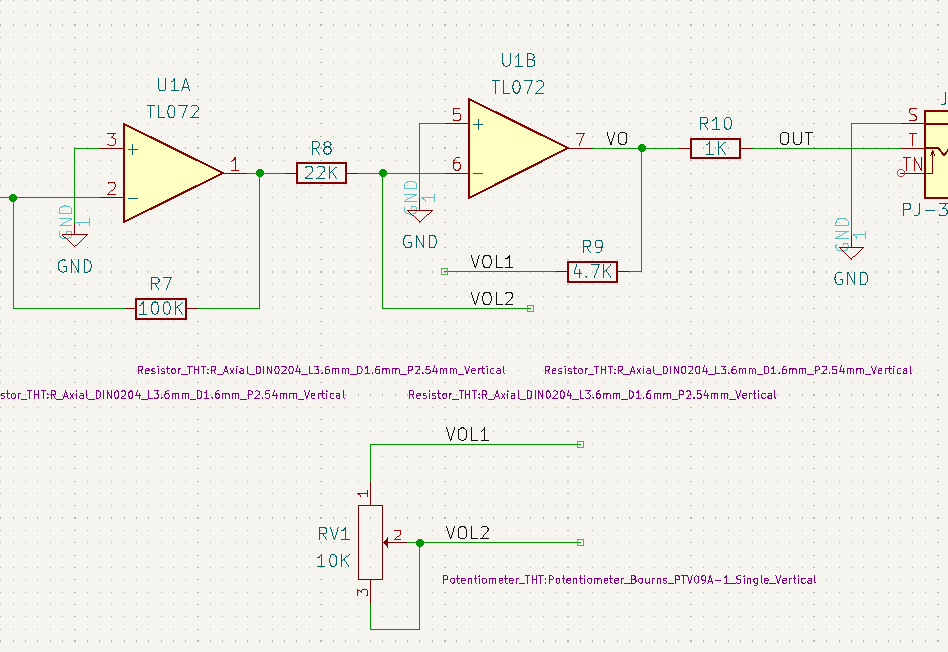
SYNTHS/NOT_BUILD/SYNTH-MIXER6-01_SET/SYNTH-MIXER6-01/PICS/Rework/SYNTH-MIXER6-01_Rework.PNG
