land-boards/lb-boards/SYNTHS/NOT_BUILD/SYNTH-MIXER6-01_SET/SYNTH-MIXER6-01_PANEL/PICS/3D/SYNTH-MIXER6-01_PWR_OPAMP_3D.png

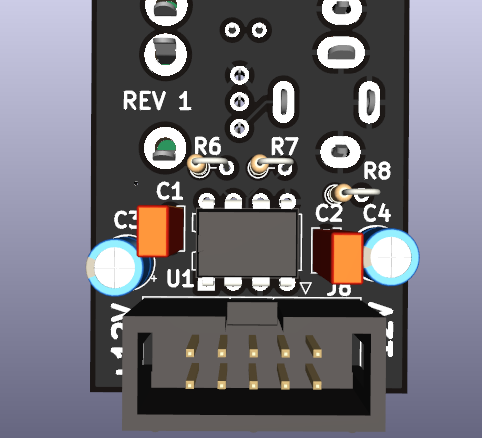
SYNTHS/NOT_BUILD/SYNTH-MIXER6-01_SET/SYNTH-MIXER6-01_PANEL/PICS/3D/SYNTH-MIXER6-01_PWR_OPAMP_3D.png
