land-boards/lb-boards/SYNTHS/NOT_BUILD/SYNTH-MIXER-05/PICS/3D/SYNTH-MIXER_05_REV1_REAR.png

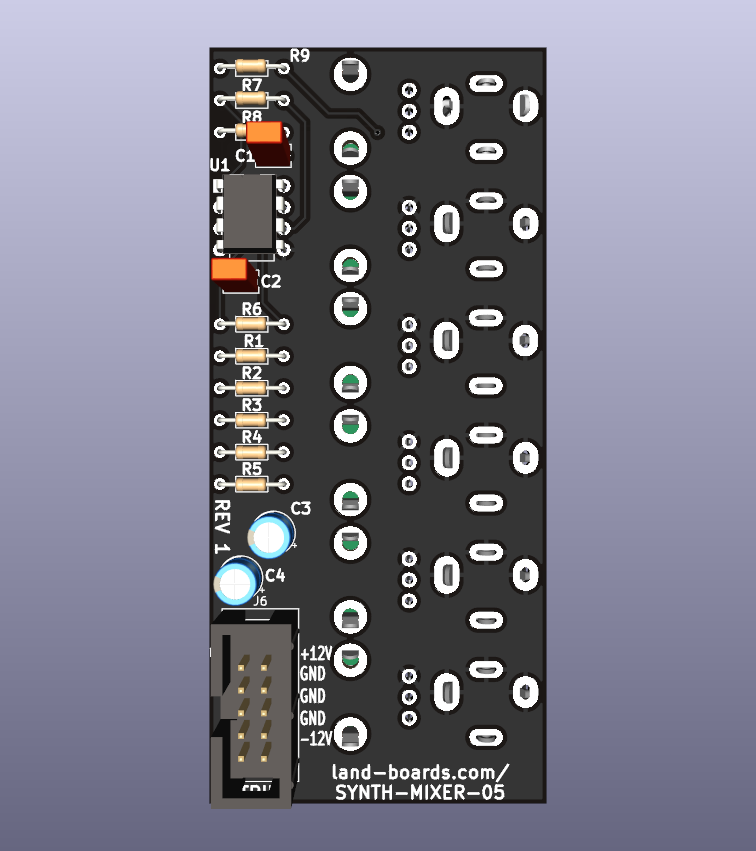
SYNTHS/NOT_BUILD/SYNTH-MIXER-05/PICS/3D/SYNTH-MIXER_05_REV1_REAR.png
