land-boards/lb-boards/Test Equipment Cards/DiffProbe/WebPages/4064.Solving Op Amp Stability 2014_Part 1.pptx

Solving Op Amp Stability Issues
Part 1

(For Voltage Feedback Op Amps)
Tim Green & Collin Wells
Precision Analog Linear Applications

<number>

Notes: This presentation will focus on techniques to solve voltage feedback op amp stability problems. The content is intended to teach any range of professional, from technician to PHD, to become an op amp stability expert!

## Slide 2

Overview

Main Presentation Focus:
1. Op Amp Stability Basics
2. Stability Analysis – Method 1 : Loaded Aol & 1/β Technique
A) Riso Compensation Technique for Output Capacitive Loads
1. Stability Analysis – Method 2 : Aol & 1/β Technique
  A. CF Compensation Technique for Input Capacitance
2. Stability Tricks and Rules of Thumb
Appendix:
1. Additional Useful Tools for your Analog Stability Toolbox
  A. Op Amp Output Impedance
  B. Pole and Zero: Magnitude and Phase on Bode Plots
  C. Dual Feedback Paths and 1/β
  D. Non-Loop Stability Problems
2) Nine different ways to stabilize op amps with capacitive loads
A) Definition by example using TINA-TI simulations

<number>

## Slide 3

The Culprits

Output Capacitive Loads!

Reference Buffers!

Cable/Shield Drive!

MOSFET Gate Drive!

Input Capacitance and Large Value Resistors

Large Value Resistors or Low-Power Circuits!

Transimpedance Amplifiers!

Transient Suppression!

<number>

Notes: For small signal op amps the most common cause of op amp instability is capacitance on the output or input. Sometimes output capacitive loads are obvious, such as a reference buffer loaded by an output capacitor, for high frequency filtering, and as a charge reservoir for load transients. Other output capacitive loads can often be overlooked, such as, cable capacitance and MOSFET gate capacitance. Input capacitance is easy to overlook, since it is usually parasitic capacitance, such as, op amp input capacitance, photodiode capacitance, or diode/transient voltage suppressor capacitance. Both input and output capacitance are often the culprits of unstable op amp circuits.

## Slide 4

Just Plain Trouble!

Inverting Input Filter??

Oscillator

Output Filter??

Oscillator

<number>

Notes: For an inverting gain configuration, as shown here, some engineers will add a filter, Cin, which will result in a nice oscillatory behavior unless proper compensation is added for stability. Output capacitance on an op amp should always be of concern from a stability concern. Even if it is not a sustained oscillation, a response to a transient step excitation can result in undesired overshoot and ringing on the output. This becomes more of concern as we designs systems with 12 bit and higher resolution A/D Converters with sample rates fast enough to capture the ringing.
.

## Slide 5

But it worked fine
in the lab!

Transient on:
+Input or –Input
Vcc or Vee
Output

But I’m only using it at DC!

Check ALL Op Amp Circuits for Stability regardless of their closed loop signal frequency of operation!

<number>

Notes: A typical “Supply Splitter” is shown above. Many an engineer has built one of these for a mid-supply reference point in a single supply system. A large capacitance is put on the output to provide a local charge reservoir for load transients on VOUT, and to also provide good high frequency bypassing in the form of a low impedance to ground at high frequencies, should loads connected generate noise or high frequency spikes. Then, in the lab, he has connected a DC meter and confirmed that the output voltage, VOUT, is indeed mid-supply. Now the supply splitter circuit goes into production. Best case the product passes final test and is shipped to the customer. Worst case production fall-out happens and yields go down. Worst, worst case the product ships to the end customer and the end customer starts to have intermittent performance problems All of this due to a marginally stable or unstable mid-supply reference circuit which could have been avoided by proper stability analysis at the design phase! Regardless of the final signal frequency of operation, including DC only, op amps have usable bandwidth and are happy to oscillate under the right conditions. Check stability on all op amp circuits.
Treat all op amp pins as inputs. A transient on +input, -input, output, or power supplies (Vcc or Vee) can set an unstable or marginally stable into an undesired, burst, oscillatory state that may eventually recover. However, during the oscillatory response due to a transient, the end application may read false data, make wrong decisions, or even cause unwanted shutdowns.

## Slide 6

Recognize Amplifier Stability Issues on the Bench

- Required Tools:
  - Oscilloscope
  - Signal Generator
- Other Useful Tools:
  - Gain / Phase Analyzer
  - Network / Spectrum Analyzer

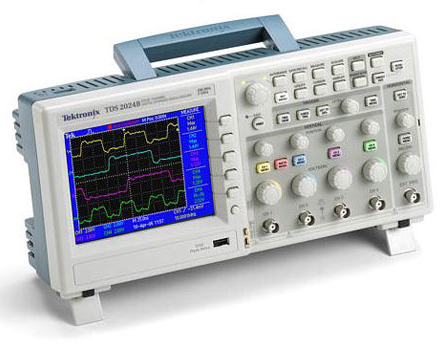
[picture p336: figure]
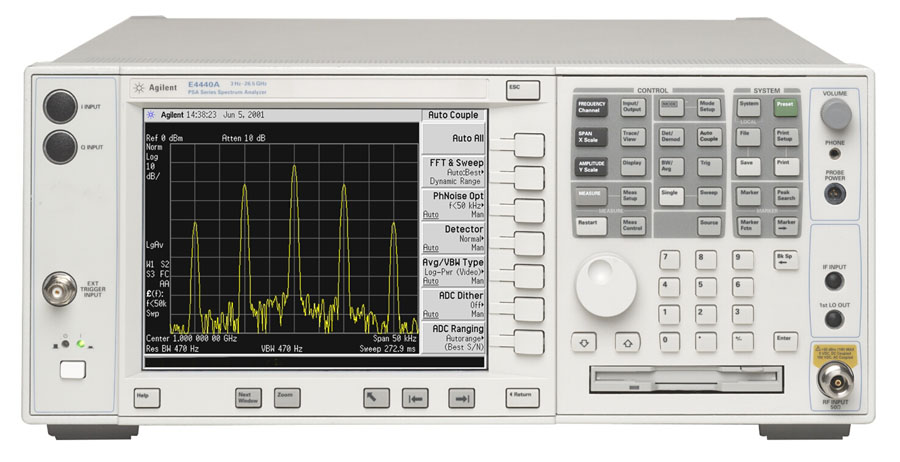
[picture p337: figure]
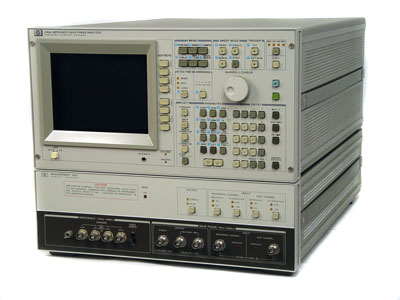
[picture p338: figure]

<number>

Notes: Your lab contains instruments that can help you check prototype circuits for stability problems. Most labs will have a Signal Generator and an Oscilloscope. Techniques will be shown later in this presentation on how to easily check op amp stability using these instruments in the time domain. If a Gain/Phase Analyzer or Network/Spectrum Analyzer are available they can be used to check op amp stability in the frequency domain.

## Slide 7

Recognize Amplifier Stability Issues

- Oscilloscope - Transient Domain Analysis:
  - Oscillations or Ringing
  - Overshoots
  - Unstable DC Voltages
  - High Distortion

<number>

Notes: In the time domain, a transient analysis in the lab, with the results displayed on and oscilloscope, can indicate whether there is a stability problem in the op amp circuit. On the output waveform, oscillations or ringing, overshoots, unstable DC voltages or high distortion are all indicators of stability issues.

## Slide 8

Recognize Amplifier Stability Issues

- Gain / Phase Analyzer - Frequency Domain:
- Peaking, Unexpected Gains, Rapid Phase Shifts

<number>

Notes: In the frequency domain, a Gain/Phase Analyzer output waveform will have peaking in the magnitude plot and rapid phase shifts in the phase plot, if there are stability issues with the op amp circuit.

## Slide 9

Quick Op-Amp Theory
Bode Plot Review
Basic Stability Tools

<number>

## Slide 10

Poles and Bode Plots

- Pole Location = fP
- Magnitude = -20dB/Decade Slope
- Slope begins at fP and continues down as frequency increases
- Actual Function = -3dB down @ fP
- Phase = -45°/Decade Slope through fP
- Decade Above fP Phase = -90° (-84.3°)
- Decade Below fP Phase = 0° (-5.7°)

<number>

Notes: Pole → ■● ☐● ☐☐■ ☐ ☐☐●●☐ ■ ☐ ●☐ ■ ☐☐ ■ ●☐ ☐● ●☐☐■ ■ ☐
☐☐ ☐☐ ●■ ■ ■ ●☐ ☐● ☐☐■ ☐ ☐● ●☐☐■ ☒■ ☐■ ☐ ☐ ☐ ☐☐● ■ ●☐ ■● ☐● ☐☐■ ● ●☐ ■☐☐ ☐■ ●● ●☐ ☐☐■ ☐☐ ■ ☐■ ■ ☐☐■ ☐☐ ☐☐ ■ ☐☐■ ☐☐ ☐ ☐☐■ ■ ■ ☐ ☐ ☐☐

## Slide 11

Zeros and Bode Plots

- Zero Location = fZ
- Magnitude = +20dB/Decade Slope
- Slope begins at fZ and continues up as frequency increases
- Actual Function = +3dB up @ fZ
- Phase = +45°/Decade Slope through fZ
- Decade Above fZ Phase = +90° (+84.3°)
- Decade Below fZ Phase = 0° (5.7°)

<number>

Notes: Zero → ■● ☐☐ ☐☐■ ☐ “☐☐●●☐■” ☐☐ ☐ ☐☐●●☐ ■ ☐ ●☐ ■ ☐☐ ■ ●☐ ☐☐ ●☐☐■ ■ ■☐ ☐☐ ☐☐ ●■ ■ ■ ●☐ ☐● ☐☐■ ☐ ☐☐ ●☐☐■ ☒■ ☐■ ☐ ☐ ☐ ☐☐● ■ ●☐ ■● ☐☐ ☐☐■ ● ■☐☐ ☐■ ☐☐■ ☐☐ ☐■ ●● ●☐ ☐☐■ ■ ■☐☐ ☐☐ ■ ☐☐■ ■☐☐ ■ ☐■ ☐☐ ☐ ●☐ ● ☐ ■ ■ ●☐ ☐☐■ ☐☐ ■ ☐☐■ ■ ☐ ☒ ■☐ ☐ ☐ ● ■ ☐☐ ☐☐■ ■☐ ■ ☐ ■☐☐ ■☐ ●● ■☐ ■ ☐ ☐ ☐☐ ☒ ☐☐■ ■ ☐ ☒ ■☐■ ■ ☐ ☐☐■ ■☐

## Slide 12

Capacitor - Intuitive Model

<number>

Notes: Our Intuitive Capacitive Model for AC Stability Analysis is defined above and contains three distinct operating areas. At “DC” the capacitor will be viewed as an open circuit. At “High Frequency” the capacitor will be viewed as a short circuit. In between the capacitor will be viewed as a frequency controlled resistor with a 1/2πfC decrease in impedance as frequency increases.

## Slide 13

Inductor - Intuitive Model

<number>

Notes: Our Intuitive Inductor Model for AC Stability Analysis is defined above and contains three distinct operating areas. At “DC” the inductor will be viewed as a short circuit. At “High Frequency” the inductor will be viewed as an open circuit. In between the inductor will be viewed as a frequency controlled resistor with a 2πfL increase in impedance as frequency increases.

## Slide 14

Capacitor and Inductor - Impedance vs Frequency

Low frequency=
High Impedance

High frequency=
High Impedance

Low frequency=
Low Impedance

High frequency=
Low Impedance

<number>

Notes: SPICE simulation confirms the impedance effects for a capacitor as Low Frequency = High Impedance and High Frequency = Low Impedance. Spice simulation also confirms the impedance effects for an inductor as Low Frequency = Low Impedance and High Frequency = High Impedance.

## Slide 15

Op Amp - Intuitive Model

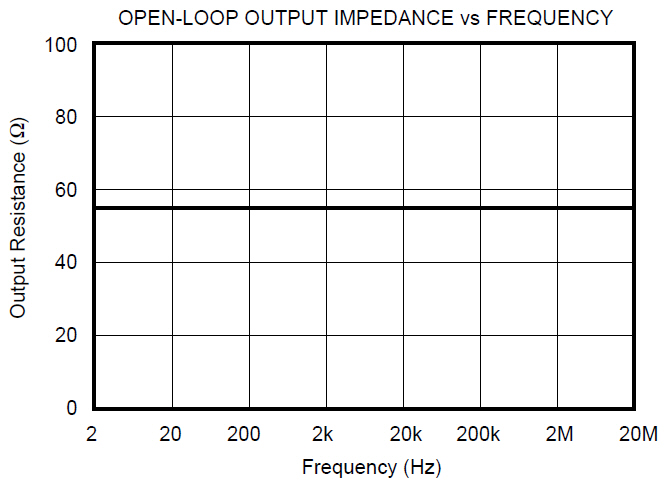
[picture p339: figure]
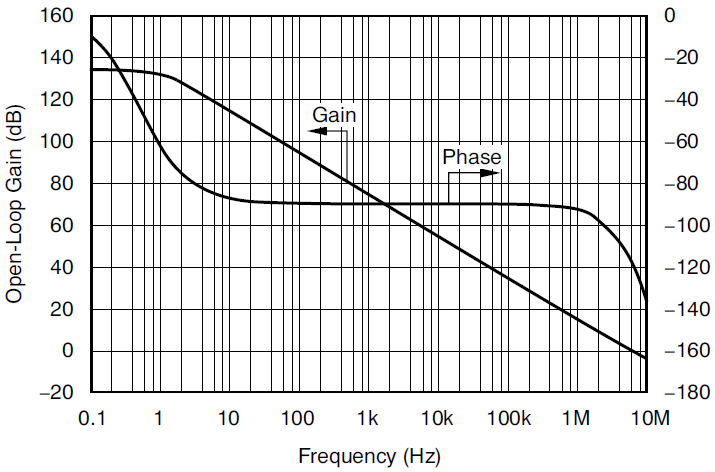
[picture p340: figure]

<number>

Notes: Our Intuitive Op Amp Model for AC Stability Analysis is defined above. The differential voltage between the IN+ and IN- terminals will be amplified by x1 and converted to a single-ended AC Voltage Source, Vdiff. Vdiff is then amplified by K(f). K(f) represents the data sheet Aol Curve (Open Loop Gain vs Frequency Plot). This resultant voltage, Vo, is then followed by the Op Amp Open Loop, AC Small Signal, Output Impedance, Ro. After passing through Ro the voltage, Vo, appears as Vout.

## Slide 16

Op-Amp Loop Gain Model

VOUT/VIN = Acl = Aol/(1+Aolβ)
If Aol >> 1 then Acl ≈ 1/β
Aol: Open Loop Gain
β: Feedback Factor
Acl: Closed Loop Gain

<number>

Notes: The lower diagram is the traditional control loop model which represents an op amp circuit with feedback. The top diagram depicts the sections of a typical op amp circuit with feedback which correspond to the control loop model. This model of an op amp circuit with feedback we will call the Op Amp Loop Gain Model. Notice that the Aol is the Op Amp data sheet parameter Aol, and is the open loop gain of the op amp. β (Beta) is the amount of output voltage from VOUT which gets fed back as feedback to the op amp -input. The β network in this example is a resistor feedback network.
In the derivation of VOUT/VIN we see that the closed loop gain function is directly defined by Aol and β.

## Slide 17

β and 1/β

- β is easy to calculate as feedback network around the Op Amp
- 1/β is reciprocal of β
- Easy Rules-Of-Thumb and Tricks to Plot 1/β on Op Amp Aol Curve
- Plotting Aol Curve and 1/β Curve shows Loop Gain

<number>

Notes: Before we simulate a circuit in SPICE we will want to know what the approximate outcome will be. Remember GIGO (Garbage In Garbage Out)!!
Beta (β) and its reciprocal 1/Beta (1/β) along with the data sheet Aol Curve will provide a powerful method for first-order approximations of Loop Gain analysis before we run SPICE. Beta (β) is easy to compute and its reciprocal even easier to plot!

## Slide 18

Amplifier Stability Criteria

VOUT/VIN = Aol / (1+ Aolβ)
If: Aolβ = -1
Then: VOUT/VIN = Aol / 0 → ∞
If VOUT/VIN = ∞ → Unbounded Gain
Any small changes in VIN will result in large changes in VOUT which will feed back to VIN and result in even larger changes in VOUT → OSCILLATIONS → INSTABILITY !!
Aolβ: Loop Gain
Aolβ = -1 → Phase shift of +180°, Magnitude of 1 (0dB)
fcl: frequency where Aolβ = 1 (0dB)
Stability Criteria:
At fcl, where Aolβ = 1 (0dB), Phase Shift < +180°
Desired Phase Margin (distance from +180° Phase Shift) > 45°

<number>

Notes: From our Op Amp Loop Gain Model we can derive the criteria for a stable, closed loop, op amp circuit.
At the frequency fcl, where Loop Gain (Aolβ) goes to 1 or 0dB, if the Loop Gain Phase Shift is +/-180°, then we have instability!!
At fcl the distance the Loop Gain Phase Shift is from 180° is called the Loop Gain Phase Margin. Our desired Loop Gain Phase Margin is >45° for an acceptably damped, well-behaved, closed loop response.

## Slide 19

Traditional Loop Gain Test

Op Amp Loop Gain Model
Op Amp is “Closed Loop”

Loop Gain Test:
(An Open Loop Test)
Break the Closed Loop at β
Ground VIN
Inject AC Source, VTest, into β
Aolβ = VOUT

<number>

Notes: Since stability is defined by the magnitude and phase plot of Loop Gain (Aolβ) then we will need to know how to easily analyze Loop Gain (Aolβ) magnitude and phase. To do this we will break the closed loop op amp circuit and inject a small signal AC source into the loop and measure amplitude and phase to plot the complete loop gain picture. It is key to understand that Loop Gain is an open loop analysis as shown here.

## Slide 20

Traditional Loop Gain Test

SPICE Loop Gain Test:
Op Amp Loop Gain Test is an “Open Loop” Test
SPICE finds a DC Operating Point before it does an AC Analysis so loop must be closed for DC and open for AC.
Break the Closed Loop at VOUT
Ground VIN → source impedance low for AC analysis
Inject: AC Source, VTest, into RF
(Inject: AC Source into High Impedance Node)
Read: Aolβ = Loop Gain = VOUT
(Read: Loop Gain from Low Impedance Node)

Op Amp Loop Gain Model
Op Amp is “Closed Loop”
VOUT/VIN = Aol / (1+Aolβ)

<number>

Notes: Loop Gain is an Open Loop Gain Test which looks at magnitude and phase around the entire loop starting on one side of where the loop is broken open and ending at the other side where it is broken open. The loop can be broken anywhere but the break shown here will account for both input capacitance effects and the interaction of the op amp open loop output impedance, Zo, with any capacitive loading on the output. When breaking the loop open remember to inject the test signal into the highest impedance side of the break and read out from the lowest impedance side of the break. This makes intuitive sense since you cannot excite a circuit if the source is being shorted out by a low impedance. When analyzing a circuit built in SPICE for simulation the traditional Loop Gain Test breaks the closed loop op amp circuit through the use of an inductor and capacitor. A very large value of inductance ensures the loop is closed at DC (a requirement for SPICE simulation is to be able to calculate a DC Operating Point first before performing an AC Analysis) but open at AC frequencies of interest. A very large value of capacitance ensures that our AC Small Signal Source is not connected at DC but is directly connected at the frequencies of interest.

## Slide 21

SPICE Loop Gain Test

DC Analysis

DC Analysis

DC Analysis

AC Equivalent Circuit

<number>

DC Equivalent Circuit

Notes: The SPICE loop gain circuit above is the preferred way to break open the loop for loop gain analysis for most applications. It will account for both input capacitance and any open loop output impedance, Zo, interactions with capacitive output loading. The DC Equivalent Circuit shows that the loop will be closed by the inductor, LT, being a short at DC and the capacitor, CT, being an open so our test generator, VG1, will not be connected. SPICE must find a DC operating point as a requirement before any AC Analysis will run. It is important to check the DC Operating point before running an AC Analysis. If an op amp output is saturated for example SPICE will use this condition to build its AC Equivalent Models and they will not be correct since the op amp will have a different AC Equivalent Model in saturation than in normal linear operation. AC Analysis is only valid when the op amp is in a linear operating condition. The AC Equivalent Circuit shows what SPICE will use during its AC Analysis. For all frequencies of interest the capacitor CT is a short and our test generator, VG1, injects the signal into the open loop since for all frequencies of interest the inductor, LT, is an open.

## Slide 22

Loop Gain (Aolβ) from Aol and 1/β

Plot (dB) 1/β on Op Amp Aol (dB)
Aolβ = Aol(dB) – 1/β(dB)
Aolβ = Aol / (1/β) = Aolβ
Note how Aolβ changes with frequency

<number>

Notes: The 1/β plot plotted on the Aol curve will provide a clear picture of exactly what the Loop Gain (Aolβ) plot is. From our derivation above we clearly see that the Aolβ magnitude plot is simply the difference between Aol and 1/β when we plot 1/β in dB on an Aol curve. Note that as frequency increases Aolβ decreases. Aolβ is the gain left to correct for errors in the VOUT/VIN or Closed Loop response. So as Aolβ decreases the VOUT/VIN response will become less accurate until the point where Aolβ goes to 0dB where from then on the VOUT/VIN response will simply follow the Aol curve.

## Slide 23

“Rate-of-Closure” Stability Criteria using 1/β & Aol

At fcl: Loop Gain (Aolβ) = 1 (0dB)
Rate-of-Closure @ fcl =
(Aol slope – 1/β slope)
*20dB/decade Rate-of-Closure @ fcl = STABLE
**40dB/decade Rate-of-Closure @ fcl = UNSTABLE

<number>

Notes: Once we plot 1/β on the Aol curve there is an easy first-order check for stability called Rate-Of-Closure. This Rate-Of-Closure stability check is defined as the “rate of closure” of the 1/β curve with the Aol curve at fcl, where loop gain goes to 0dB. A 40db/decade rate-of-closure implies an UNSTABLE circuit and a 20dB/decade rate-of-closure implies a STABLE circuit. The 40dB/decade rate-of-closure implies instability because it implies two poles in the Aolβ plot before fcl which can mean a 180 phase shift. Four examples are shown above with their respective rate-of-closure computed below.

fcl1: Aol-1/β1 = -20dB/decade - +20dB/decade = -40dB/decade → ☐☐●☐☐
● ☐●β → ☐☐●☐☐
● ☐●β – → ☐☐●☐☐
● ☐●β → ☐☐●☐☐

## Slide 24

Loop Gain (Aolβ) Example

Example 1: Note locations of poles and zeros in Aol & 1/β

Rate-of-Closure @ fcl = 40dB/decade
→ UNSTABLE!

<number>

Notes: A loop gain analysis example serves to relate how we can analyze the stability of an op amp circuit from the 1/β curve plotted on the Aol curve. Here as frequency increases the capacitor Cin goes towards a short in impedance thereby lowering the magnitude of the β plot with frequency (less voltage feedback as frequency increases) and respectively raising the 1/β curve as frequency increases. From our rate-of-closure criteria we predict an UNSTABLE circuit. Note the locations of poles, fp1 and fp2, in the Aol curve and the zero, fz1, in the 1/β plot.

## Slide 25

Loop Gain (Aolβ) Plot from Aol & 1/β Plot

Loop Gain (Aolβ) Phase at fcl:
Phase Shift = -180
Phase Margin = 0

To Plot Aolβ from Aol & 1/β Plot:
Poles in Aol curve are Poles in Aolβ (Loop Gain)Plot
Zeros in Aol curve are Zeros in Aolβ (Loop Gain) Plot
Poles in 1/β curve are Zeros in Aolβ (Loop Gain) Plot
Zeros in 1/β curve are Poles in Aolβ ( Loop Gain) Plot
[Remember: β is the reciprocal of 1/β]

<number>

Example 1: Note locations of poles and zeros in Loop Gain

Notes: From our 1/β plot on the Aol curve we can plot the Aolβ (Loop Gain) magnitude plot. From the Aolβ (Loop Gain) magnitude plot we can then plot the Aolβ (Loop Gain) phase plot. The rules to create an Aolβ (Loop Gain) plot from the 1/β plot on the Aol curve are simple: Poles and zeros from the Aol curve are poles and zeros in the Aolβ (Loop Gain) plot. Poles and zeros from the 1/β plot are opposite in the Aolβ (Loop Gain) plot. One easy way to remember this is β is used in the Aolβ (Loop Gain) plot and 1/β is the reciprocal of β and so we would expect the Aolβ (Loop Gain) curve to use the reciprocal of poles and zeros from the 1/β plot. Reciprocal of a pole is a zero and reciprocal of a zero is a pole.

Phase shift at fcl (Θcl) can be seen to be -180° which is UNSTABLE. Mathematically the complete Phase Shift is calculated as:
Θcl = -tan⁻¹ (fcl/fp1) -tan⁻¹ (fcl/fz1) -tan⁻¹ (fcl/fp2)
Θcl = -tan⁻¹ (10k/10) -tan⁻¹ (10k/1k) -tan⁻¹ (10k/1M)
Θcl = -89.94° -84.29°-0.57°
Θcl = -174.8°
Note that in the Aolβ (Loop Gain) plot there are all poles (fp1, fz1, fp2)

First order approximation errors for magnitude plots:
Actual Pole is -3dB down from ideal at fp
Actual Zero is +3dB up from ideal at fz

First order approximation errors for phase plots:
Actual Pole Phase is 6° lower than 0° a decade less than fp
Actual Pole Phase is 6° higher than -90° a decade more than fp
Actual Zero Phase is 6° higher than 0° a decade less than fz
Actual Pole Phase is 6° lower than +90° a decade more than fz

Phase margin is a definition used to describe how close closed loop op amp configuration is to oscillation (how far away from 180° Θcl is) . A positive phase margin is an indication of stability. A phase margin of about 45° is desirable for maximum response to a pulse input without ringing or instability.
Θpm (phase margin) = 180 + Θcl
First Order Approximation Phase Margin:
Θpm (phase margin) = 180° + Θcl
Θpm = 180° + (-180°) = 0°
Actual Phase Margin:
Θpm (phase margin) = 180° + Θcl
Θpm = 180° + (-174.8°) = 5.2°

## Slide 26

1/β Always = Closed Loop Response

VOUT/VIN = Aol/(1+Aolβ)
At fcl: Aolβ = 1 → VOUT/VIN = Aol/(1+1) ~ Aol
No Loop Gain left to correct for errors
VOUT/VIN follows the Aol curve at f > fcl

Note:
1/β is the AC, Small Signal, Closed Loop, ”Noise Gain” for the Op Amp.
VOUT/VIN is often NOT the same as 1/β.

<number>

Notes: The VOUT/VIN closed loop response is not always the same as 1/β. In the example above we see that the AC small signal feedback is modified by the Rn-Cn network in parallel with RI. As frequency increases we see the results of this network reflected in the 1/β plot on the Aol curve. Think of this example as an inverting summing op amp circuit. We are summing in VIN through RI and Ground through the Rn-Cn netowrk. VOUT/VIN will not be affected by this Rn-Cn network at low frequencies and the desired gain is seen as 20dB. As Loop Gain (Aolβ) is forced to 1 (0dB) by the Rn-Cn network there is no Loop Gain (Aolβ) left to correct for errors and VOUT/VIN will follow the Aol curve at frequencies above fcl. In this example the closed loop gain is inverting but the 1/β will reflect a non-inverting gain equivalent number at DC. One way to view this is that the 1/β gain is the “noise gain” and a noise source could appear on the +input of the op amp. In essence the op amp always runs in its “noise gain” for loop stability considerations.

## Slide 27

How to Modify 1/β for Stable Circuits

<number>

Notes: Two common op amp networks, ZI and ZF are shown above. We will perform a 1st Order Analysis on each of these networks independently and then use Tina SPICE to simulate the op amp circuit and check if our predicted results agree! The key to our 1st Order Analysis will be to use our Intuitive Component Models (capacitor and inductor) from earlier in this presentation and a little intuition.

## Slide 28

1/β “First Order Analysis” for ZF

- 1/β Low Frequency = RF/RI = 100 → 40dB
Cp = Open at Low Frequency
- 1/β High Frequency = (Rp//RF)/RI ≈ Rp/RI = 10 → 20dB
Cp = Short at High Frequency
- Pole in 1/β when Magnitude of XCp = RF
Magnitude XCp = 1/(2∙п∙f∙Cp)
fp = 1/(2∙п∙RF∙Cp) = 1kHz
- Zero in 1/β when Magnitude of XCp = Rp
fz = 1/(2∙п∙Rp∙Cp) = 10kHz

<number>

Notes: Let’s perform our 1st Order Analysis for the ZF network above. This is a feedback network in the op amp circuit. Cp is open at low frequency and the Low Frequency 1/β becomes simply RF/RI as shown. At the other frequency extreme, high frequency, Cp is a short and the High Frequency 1/β becomes (Rp//RF)/RI. However, when Cp is a short Rp<<RF and Rp should dominate the feedback resistance and so we approximate high frequency gain to be Rp/RI. We note there is a reactive element in the feedback path of the op amp, a capacitor, and therefore know there has to be some poles and/or zeros somewhere in the transfer function. At the frequency where the magnitude of Cp matches that of the parallel impedance with it (dominated here by RF) we anticipate a pole in the 1/β plot. Feedback resistance will be getting smaller and therefore VOUT must start to reduce. Now the frequency where the magnitude of Cp matches that of the impedance in series with it, Rp, we expect a zero since as Cp approaches a short the net feedback resistance can become no smaller and VOUT must flatten out as frequency increases. So we have predicted by our 1st order analysis where a pole and zero exists as well as the Low Frequency and High Frequency 1/β levels.

## Slide 29

TINA SPICE: 1/β for ZF

Lo f

Hi f

<number>

Notes: Our optimally scaled Tina SPICE simulation results are displayed above. Our First Order analysis results are shown along with the actual measured results. Our 1st Order Analysis results and predictions are not exact but certainly more than acceptable for a powerful and intuitive analysis for the 1/β curve for AC Stability Analysis.

## Slide 30

1/β “First Order Analysis” for ZI

- 1/β Low Frequency = RF/RI = 10 → 20dB
Cn = Open at Low Frequency
- 1/β High Frequency = RF/(RI//Rn) ≈ RF/Rn =100 → 40dB
Cn = Short at High Frequency
- Zero in 1/β when Magnitude of XCn = RI
Magnitude XCn = 1/(2∙п∙f∙Cn)
fz = 1/(2∙п∙RI∙Cn) = 1kHz
- Pole in 1/β when Magnitude of XCn = Rn
fp = 1/(2∙п∙Rn∙Cn) = 10kHz

<number>

Notes: Let’s perform our 1st Order Analysis for the ZI network above. This is an input network in the op amp circuit. Cn is open at low frequency and the Low Frequency 1/β becomes simply RF/RI as shown. At the other frequency extreme, high frequency, Cn is a short and the High Frequency 1/β becomes RF/(RI//Rn). However, when Cp is a short Rn<<RI and Rn should dominate the input resistance and so we approximate high frequency gain to be RF/Rn. We note there is a reactive element in the input path of the op amp, a capacitor, and therefore know there has to be some poles and/or zeros somewhere in the transfer function. At the frequency where the magnitude of Cn matches that of the parallel impedance with it (dominated here by RI) we anticipate a zero in the 1/β plot. Input resistance will be getting smaller and therefore VOUT must start to increase. Now the frequency where the magnitude of Cn matches that of the impedance in series with it, Rn, we expect a pole since as Cn approaches a short the net input resistance can become no smaller and VOUT must flatten out as frequency increases. So we have predicted by our 1st order analysis where a pole and zero exists as well as the Low Frequency and High Frequency 1/β levels.

## Slide 31

TINA SPICE: 1/β for ZI

Hi f

Lo f

<number>

Notes: Our optimally scaled Tina SPICE simulation results are displayed above. Our First Order analysis results are shown along with the actual measured results. Our 1st Order Analysis results and predictions are not exact but certainly more than acceptable for a powerful and intuitive analysis for the 1/β curve for AC Stability Analysis.

## Slide 32

Stability Analysis - Method 1
(Loaded Aol & 1/β Technique)

(Riso Compensation)

Notes: There are two basic methods for analyzing op amp stability problems. The first method, Method 1, will use the Loaded Aol and 1/β Technique to analyze stability problems due to capacitive loading of an op amp output. The compensation used for this example will be Riso Compensation.

## Slide 33

Capacitive Loading on Op Amp Outputs

Unity Gain Buffer Circuits Circuits with Gain

Will this circuit behavior
get you a raise in pay?

<number>

Notes: Capacitive loading on op amp outputs without proper stability considerations can lead to undesired oscillations on the op amp outputs as shown here. The worst case will be for a unity gain buffer as shown on the left, since phase margin will be lowest for this configuration. On the right is the transient response for a higher gain circuit with the same op amp and same capacitive load, with less oscillation, since phase margin is increased as closed loop gain is increased. Higher closed loop gain will also result in a decrease in closed loop bandwidth as well.

## Slide 34

Loaded Aol

<number>

Notes: A loop gain analysis circuit can be used to analyze the “Loaded Aol” due to CLoad. As shown here the “Loaded Aol” curve due to CLoad,1uF, has an additional pole in it around 3kHz, fp2. fp1 is the original pole in the Aol curve of the op amp before CLoad is applied. Since the circuit is running as a unity gain follower 1/β is 0dB and at fcl, where 1/β intersects the Loaded Aol curve, we see a 40dB/decade rate-of-closure, which is UNSTABLE by our rate-of-closure criteria.

## Slide 35

Loaded Aol Model

<number>

Notes: Our stability analysis of the effects of capacitive loading on an op amp will be simplified by the introduction of the “Loaded Aol Model”. As shown in this slide the data sheet Aol curve is followed by the op amp output resistance, Ro. The capacitive load, CLoad, in conjunction with Ro will form an additional pole in the Aol plot and may be represented by a new “Loaded Aol” plot. The Ro-CLoad network form the “Aol Load” on the original op amp “Aol”.

## Slide 36

Loaded Aol Model

fp2

<number>

Notes: The data sheet Aol is loaded by the Ro-CLoad load network as shown here. The additional pole, fp2, due to Ro and CLoad is computed here.

## Slide 37

Loaded Aol Model

fp1

Aol

fp2

Aol Load

+

Note: Addition on Bode Plots = Linear Multiplication

fp1

Loaded Aol

=

fp2

<number>

Notes: The op amp original “Aol” is “multiplied” by the “Aol Load” to yield the resultant “Loaded Aol” curve. On dB plots linear multiplication is performed by adding the curves in dB. As shown above it becomes easy to see the resultant “Loaded Aol” by adding the op amp original “Aol” plus the “Aol Load” formed by Ro-CLoad.

## Slide 38

Loaded Aol –
Loop Gain & Phase

Phase Margin at fcl

<number>

Notes: The Loaded Aol caused by CLoad, 1uF, will result in Loop Gain phase margin at fcl of only 0.548 degrees. This is definitely an UNSTABLE circuit as it stands here.

## Slide 39

Riso Compensation

Riso will add a zero in the Loaded Aol Curve

<number>

Notes: One way to compensate the op amp circuit for CLoad is to add Riso Compensation. Note the point of feedback for the circuit is still taken directly at the output of the op amp. The addition of Riso will add a zero into the “Loaded Aol” curve and stabilize the circuit.

## Slide 40

Riso Compensation
Results

<number>

Notes: The Riso Compensation will add fz1 into the “Loaded Aol” which will result in a -20dB/decade slope crossing 0db at fcl. This will result in a stable circuit by our rate-of-closure criteria of 20dB/decade indicating stability.

## Slide 41

Riso Compensation Theory

<number>

Notes: Our stability analysis using the “Loaded Aol Model” will be analyzed for the addition of the Riso Compensation. The data sheet Aol curve is followed by the op amp output resistance, Ro, Riso Compensation, Riso, and load capacitance, CLoad. Note the point of feedback is between Ro and Riso. The capacitive load, CLoad, in conjunction with Ro and Riso will form an additional pole in the Loaded Aol plot. The capacitive load, CLoad, in conjunction with Riso will add a zero in the Loaded Aol plot.

## Slide 42

Riso Compensation Theory

fp2

fz1

<number>

Notes: The data sheet Aol is loaded by the Ro-Riso-CLoad load network as shown here. The additional pole, fp2, due to Ro + Riso and CLoad is computed here. Also we see a zero, fz1, formed by Riso and Cload.

## Slide 43

Riso Compensation Theory

fp1

Aol

fp2

fz1

Aol Load

+

Note: Addition on Bode Plots = Linear Multiplication

fp1

fp2

fz1

Loaded Aol

=

<number>

Notes: The op amp original “Aol” is “multiplied” by the “Aol Load” with Riso Compensation to yield the resultant “Loaded Aol” curve. On dB plots linear multiplication is performed by adding the curves in dB. As shown above, it becomes easy to see the resultant “Loaded Aol”, by adding the op amp original “Aol” plus the “Aol Load”, formed by the Ro-Riso-CLoad combination.

## Slide 44

Riso Compensation Design Steps

1. Determine fp2 in Loaded Aol due to CLoad
  A. Measure in SPICE with CLoad on Op Amp Output
2. Plot fp2 on original Aol to create new Loaded Aol
3) Add Desired fz2 on to Loaded Aol Plot for Riso Compensation
  A. Keep fz1 < 10*fp2 (Case A)
  B. Or keep the Loaded Aol Magnitude at fz1 > 0dB (Case B)
(fz1>10dB will allow for Aol variation of ½ Decade in Unity Gain Bandwidth)
4) Compute value for Riso based on plotted fz1
5) SPICE simulation with Riso for Loop Gain (Aolβ) Magnitude and Phase
6. Adjust Riso Compensation if greater Loop Gain (Aolβ) phase margin desired
7. Check closed loop AC response for VOUT/VIN
  A. Look for peaking which indicates marginal stability
  B. Check if closed AC response is acceptable for end application
8. Check Transient response for VOUT/VIN
  A. Overshoot and ringing in the time domain indicates marginal stability
  B. Determine if settling time is acceptable for end application

<number>

Notes: The Riso Compensation design steps are outlined here. Two cases, Case A and Case B, will be presented. Rules-of-thumb will be presented to yield best stability on first pass analysis.

## Slide 45

1),2) Loaded Aol and fp2

Case A, CLoad=1uF, fp2=2.98kHz
Case B, CLoad=2.9nF, fp2=983.37kHz

<number>

Notes: Two different CLoads will be analyzed to show rules-of-thumb to get the best stability using Riso Compensation. Case A will use CLoad = 1uF and Case B will used CLoad = 2.9nF. By setting Riso = 0 ohms we can easily analyze the Loaded Aol for each case without Riso Compensation. From above Loaded Aol plots we can use the phase plots to determine the pole locations of fp2 for each of Case A, CLoad=1uF and Case B, CLoad=2.9nF.
From above we have completed Steps 1 and 2 for the Riso Compensation Design:
Determine fp2 in Loaded Aol due to CLoad
Measure in SPICE with CLoad on Op Amp Output
Plot fp2 on original Aol to create new Loaded Aol

## Slide 46

3) Add fz1 on Loaded Aol

Case A, CLoad=1uF, fz1=29.8kHz
Case B, CLoad=2.9nF, fz1=4.07MHz

<number>

Notes: Our Loaded Aol curves for Case A, CLoad=1uF and Case B, CLoad=2.9nF, found using Step 1 and Step 2, are shown above. We can add straight line approximations to the magnitude plot (-20dB/decade slope) to indicate how and where we want to modify the Loaded Aol curve so the unity gain buffer (1/β = 0dB) will be stable with each respective capacitive load. These lines are added per the recommended rules-of-thumb below in Step 3.
From above we have completed Step 3 for the Riso Compensation Design:
3) Add Desired fz2 on to Loaded Aol Plot for Riso Compensation
Keep fz1 < 10*fp2 (Case A)
Or keep the Loaded Aol Magnitude at fz1 > 0dB (Case B)
(fz1>10dB will allow for Aol variation of ½ Decade in Unity Gain Bandwidth)

## Slide 47

4) Compute Value for Riso

Case A, CLoad=1uF, fz1=29.8kHz
Case B, CLoad=2.9nF, fz1=4.07MHz

<number>

Notes: From Riso Compensation Design Step 3 we know the respective locations we want for fz1. From that we can compute Riso and choose a standard resistor value.
From above we have completed Step 4 for the Riso Compensation Design:
4) Compute value for Riso based on plotted fz1

## Slide 48

5),6) Loop Gain, Case A

Phase Margin at fcl = 87.5 degrees

<number>

Notes: Design Step 5 for Riso Compensation is to check the final Riso value chosen by a loop gain plot on the complete op amp circuit. We see from above that for Case A, CLoad=1uF, at fcl, where Loop Gain (Aolβ) goes to zero, the phase margin is 87.5 degrees. Step 6 is to adjust Riso for more phase margin if we are not satisfied with our first analysis and re-run the loop gain and phase plot to check the final design. Here we are happy with 87.5 degrees of Loop Gain (Aolβ) phase margin.
From above we have completed Steps 5 & 6 for the Riso Compensation Design:
SPICE simulation with Riso for Loop Gain (Aolβ) Magnitude and Phase
Adjust Riso Compensation if greater Loop Gain (Aolβ) phase margin desired

## Slide 49

5),6) Loop Gain, Case B

Phase Margin at fcl = 54 degrees

<number>

Notes: Design Step 5 for Riso Compensation is to check the final Riso value chosen by a loop gain plot on the complete op amp circuit. We see from above that for Case B, CLoad=2.9nF, at fcl, where Loop Gain (Aolβ) goes to zero, the phase margin is 54.2 degrees. Step 6 is to adjust Riso for more phase margin if we are not satisfied with our first analysis and re-run the loop gain and phase plot to check the final design. Here we are happy with 54.2 degrees of Loop Gain (Aolβ) phase margin.
From above we have completed Steps 5 & 6 for the Riso Compensation Design:
SPICE simulation with Riso for Loop Gain (Aolβ) Magnitude and Phase
Adjust Riso Compensation if greater Loop Gain (Aolβ) phase margin desired

## Slide 50

7) AC VOUT/VIN, Case A

<number>

Notes: Design Step 7 for Riso Compensation is to check the closed loop AC response over frequency. From above, for Case A, CLoad=1uF, we see the closed loop AC response for both the output of the op amp, VOA, and the output after Riso, VOUT. If this closed loop bandwidth is not acceptable for the final application we will need to consider other capacitive stability techniques (see Appendix) or a different op amp or different load capacitance value.
From above we have completed Step 7 for the Riso Compensation Design:
Check closed loop AC response for VOUT/VIN
Look for peaking which indicates marginal stability
Check if closed AC response is acceptable for end application

## Slide 51

8) Transient Analysis, Case A

<number>

Notes: Design Step 8 for Riso Compensation is to check the closed loop transient response. From above, for Case A, CLoad=1uF, we see the closed loop Transient response for both the output of the op amp, VOA, and the output after Riso, VOUT show no signs of excessive overshoot or ringing before settling.
From above we have completed Step 7 for the Riso Compensation Design:
Check Transient response for VOUT/VIN
A) Overshoot and ringing in the time domain indicates marginal stability

## Slide 52

Riso Compensation: Key Design Consideration

Accuracy of VOUT depends on Load Current

Light Load Current

Heavy Load Current

<number>

Notes: The Riso Compensation has one key design consideration with regards to accuracy at VOUT for heavy loads. The feedback for voltage accuracy is directly at the output of the op amp and the VOUT at the load is isolated by Riso. If output currents are large and depending upon the value of Riso the voltage at VOUT will not be the voltage at VIN for the unity gain follower shown above. If this is a problem in the end application a different compensation technique for the CLoad will need to be used (see Appendix for alternative compensation methods for output capacitive loads).
