land-boards/lb-boards/Analog Cards/SPI-POTX2/Pictures/Testing/SPI-POTX2_P1889_720px.jpg

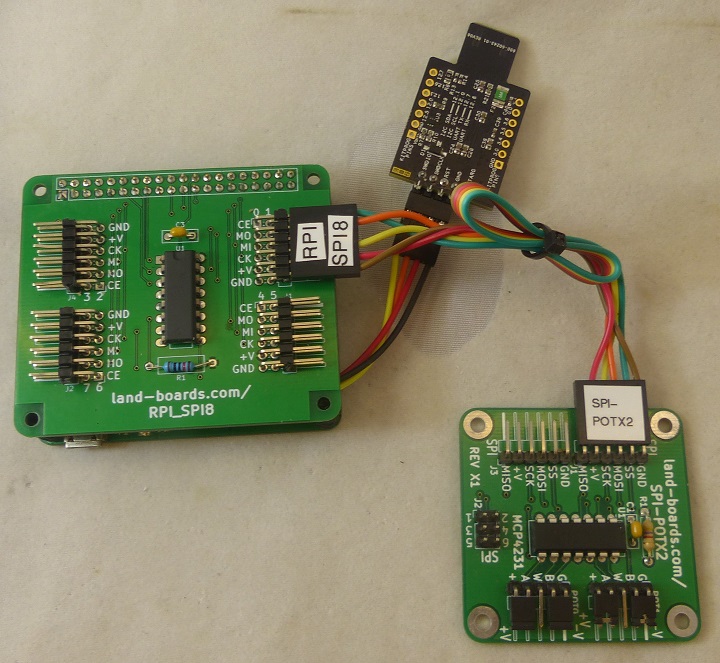
Analog Cards/SPI-POTX2/Pictures/Testing/SPI-POTX2_P1889_720px.jpg
