land-boards/lb-boards/Analog Cards/UNI-OPAMP-04/Docs/Measure_Input_Voltage_Offseet/Input-Offset-Voltage-Test-Schematic.png

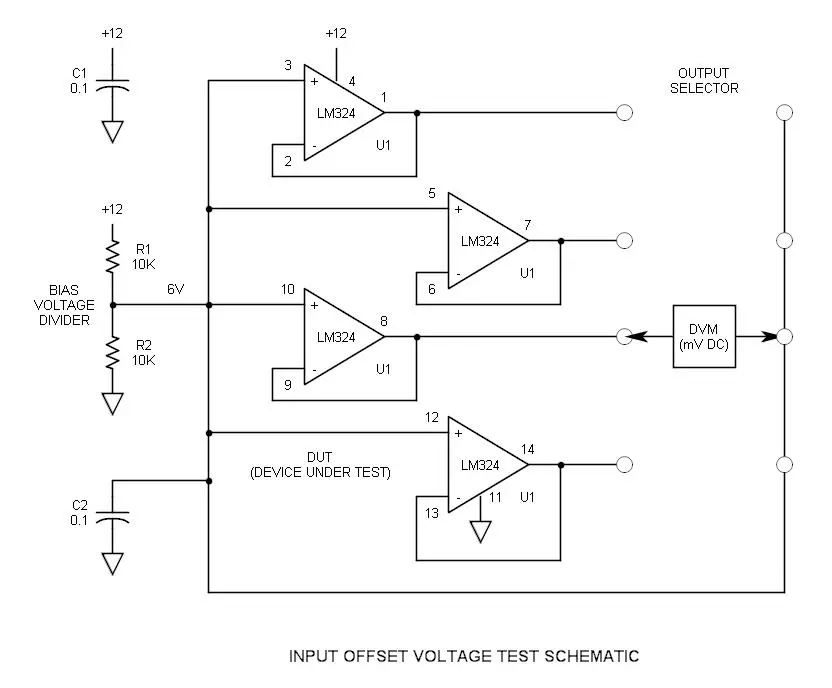
Analog Cards/UNI-OPAMP-04/Docs/Measure_Input_Voltage_Offseet/Input-Offset-Voltage-Test-Schematic.png
