land-boards/lb-boards/Arduino Cards/Blue-Pill-Hub/Pictures/TESTING/P1050641.JPG

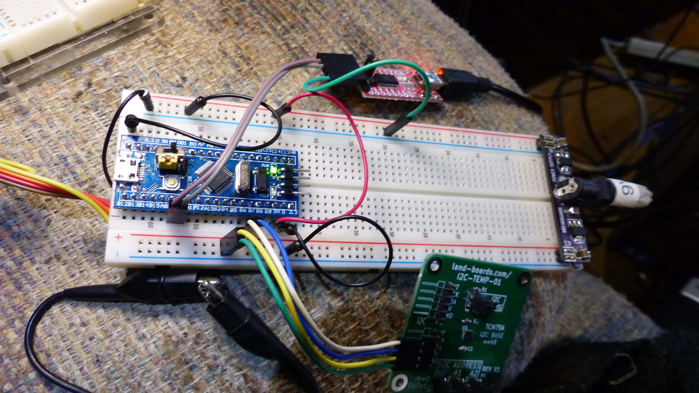
Arduino Cards/Blue-Pill-Hub/Pictures/TESTING/P1050641.JPG
