land-boards/lb-boards/Arduino Cards/Blue-Pill-Hub/Pictures/TESTING/P1050642.JPG

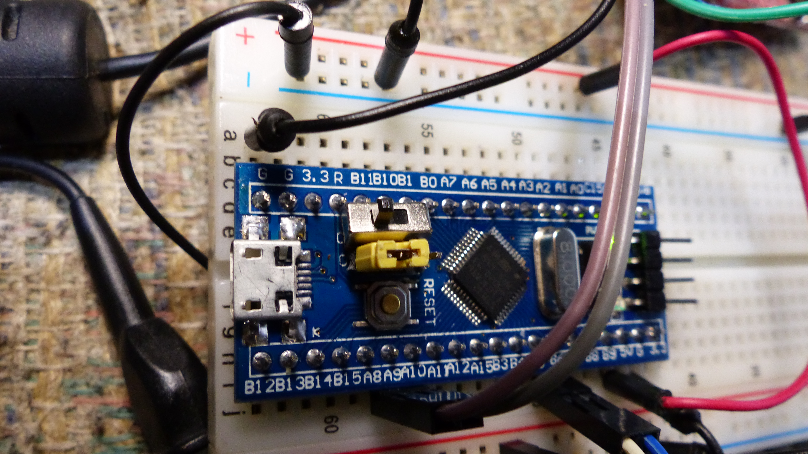
Arduino Cards/Blue-Pill-Hub/Pictures/TESTING/P1050642.JPG
