land-boards/lb-boards/Arduino Cards/Screwduino/pictures/TestStation/P1010560.JPG

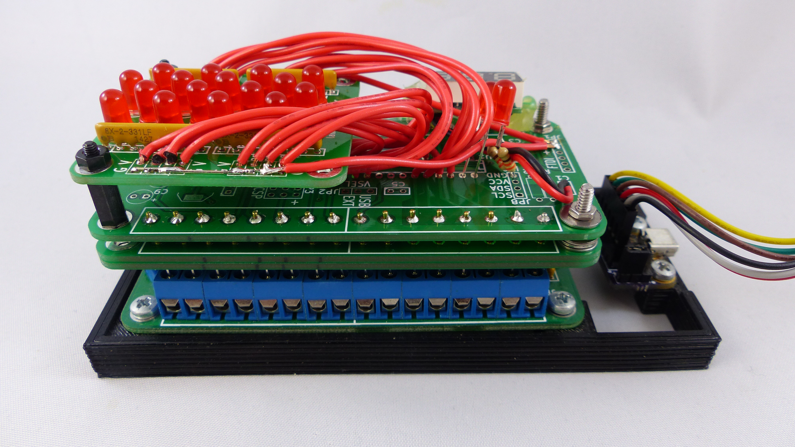
Arduino Cards/Screwduino/pictures/TestStation/P1010560.JPG
