land-boards/lb-boards/Arduino Cards/Screwduino/pictures/TestStation/P1010563.JPG

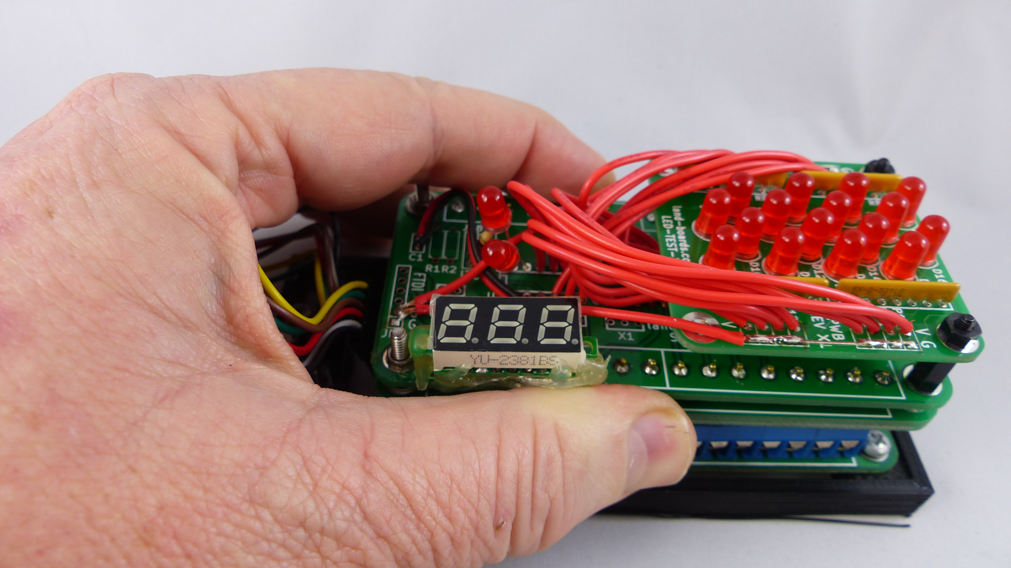
Arduino Cards/Screwduino/pictures/TestStation/P1010563.JPG
