land-boards/lb-boards/Arduino Cards/Screwduino/pictures/TestStation/P1010565.JPG

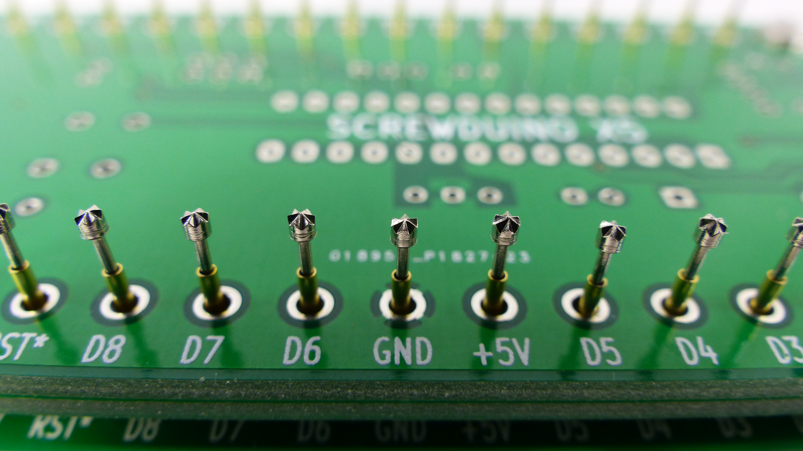
Arduino Cards/Screwduino/pictures/TestStation/P1010565.JPG
