land-boards/lb-boards/Arduino Cards/Screwduino/pictures/TestStation/P1080600.JPG

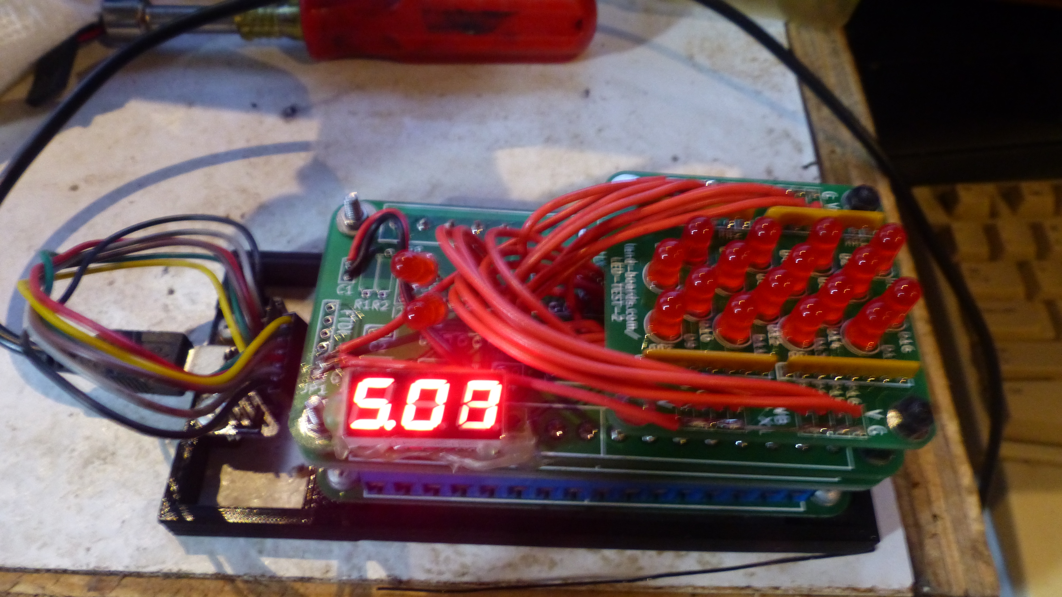
Arduino Cards/Screwduino/pictures/TestStation/P1080600.JPG
