land-boards/lb-boards/Arduino Cards/Screwduino/pictures/TestStation/P1080603.JPG

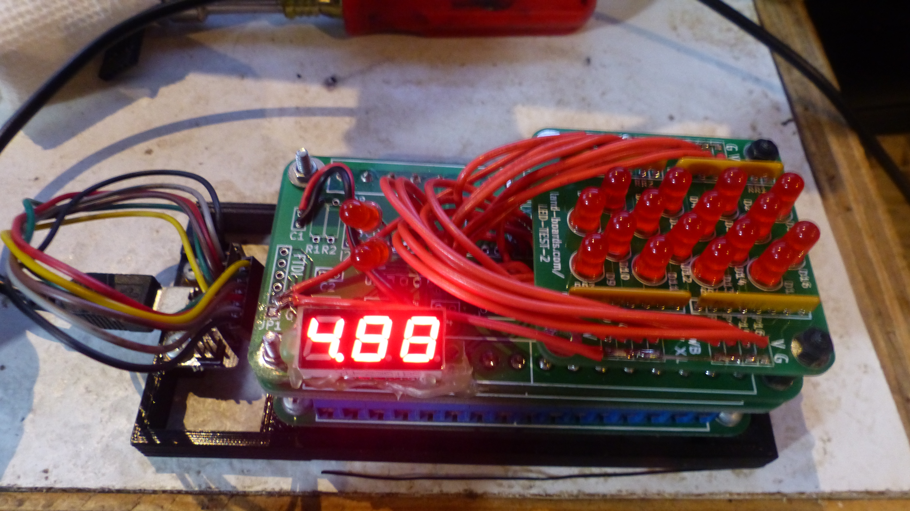
Arduino Cards/Screwduino/pictures/TestStation/P1080603.JPG
