land-boards/lb-boards/BeagleBoneBlack Cards/BBB-COMMS-2/Pictures/CAD/OSH Park ~ Verify your design_files/26344b4748915d2698897abf6a432f1f.png

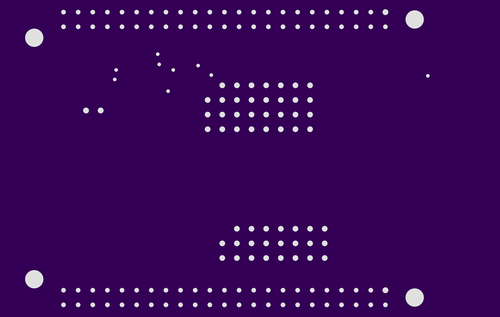
BeagleBoneBlack Cards/BBB-COMMS-2/Pictures/CAD/OSH Park ~ Verify your design_files/26344b4748915d2698897abf6a432f1f.png
