land-boards/lb-boards/BeagleBoneBlack Cards/BBB-COMMS-2/Pictures/CAD/OSH Park ~ Verify your design_files/d28c9fd01b917575ffffe7b1b9482da2.png

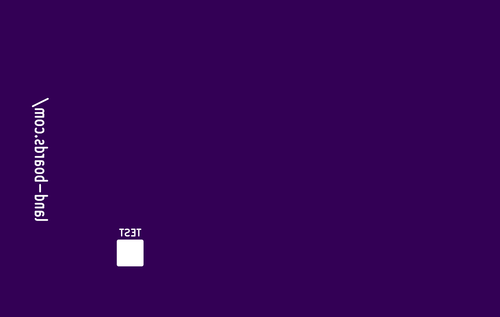
BeagleBoneBlack Cards/BBB-COMMS-2/Pictures/CAD/OSH Park ~ Verify your design_files/d28c9fd01b917575ffffe7b1b9482da2.png
