land-boards/lb-boards/BeagleBoneBlack Cards/BBB-COMMS-2/Pictures/CAD/OSH Park ~ Verify your design_files/e2ff3fcda02047be365012851a60dec0.png

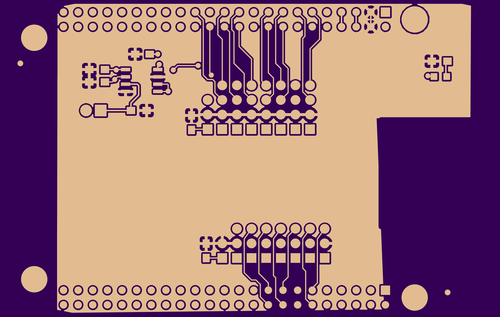
BeagleBoneBlack Cards/BBB-COMMS-2/Pictures/CAD/OSH Park ~ Verify your design_files/e2ff3fcda02047be365012851a60dec0.png
