land-boards/lb-boards/BeagleBoneBlack Cards/BBB-COMMS-2/Pictures/CAD/OSH Park ~ Verify your design_files/f5591a89d30ee6acd70fab4394c8f5de.png

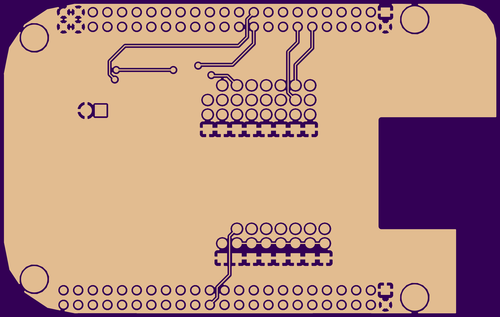
BeagleBoneBlack Cards/BBB-COMMS-2/Pictures/CAD/OSH Park ~ Verify your design_files/f5591a89d30ee6acd70fab4394c8f5de.png
