land-boards/lb-boards/BeagleBoneBlack Cards/BBB-COMMS-2/Pictures/Testing/I2C_Testing/BBB-COMMS-2_I2CIO-8_Test-Setup_720px.png

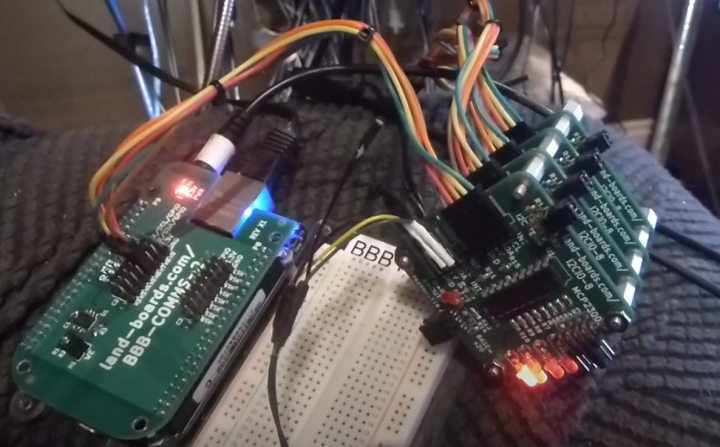
BeagleBoneBlack Cards/BBB-COMMS-2/Pictures/Testing/I2C_Testing/BBB-COMMS-2_I2CIO-8_Test-Setup_720px.png
