land-boards/lb-boards/BeagleBoneBlack Cards/BBB-GVS-3/Pictures/Testing/BBB-GVS-3_IMG_6046stretched-720px.jpg

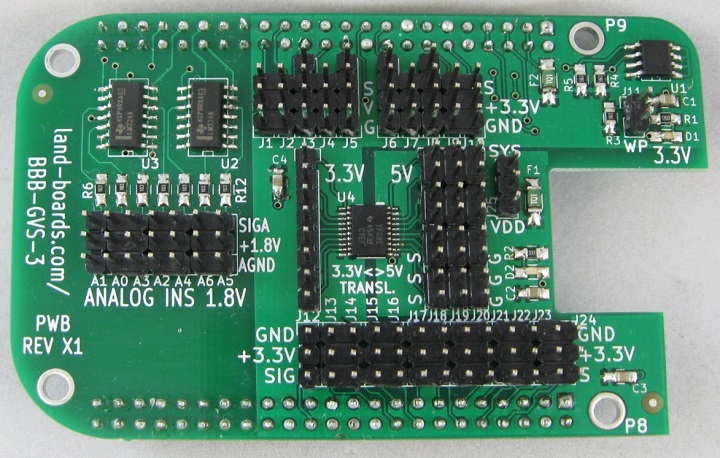
BeagleBoneBlack Cards/BBB-GVS-3/Pictures/Testing/BBB-GVS-3_IMG_6046stretched-720px.jpg
