land-boards/lb-boards/BeagleBoneBlack Cards/BBB-GVS-3/Pictures/Testing/P1080050.JPG

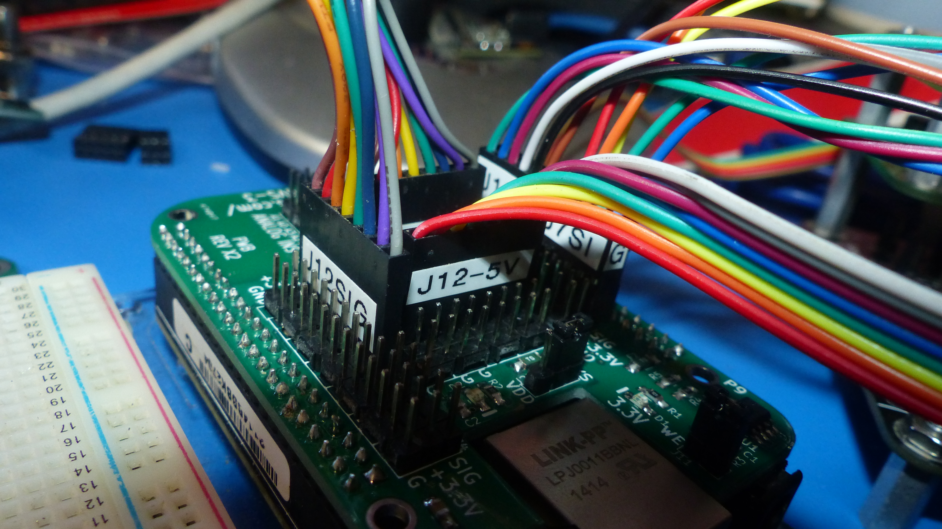
BeagleBoneBlack Cards/BBB-GVS-3/Pictures/Testing/P1080050.JPG
