land-boards/lb-boards/FPGA Cards/DCE-RS232-Female/Pics/Test/P1070553.JPG

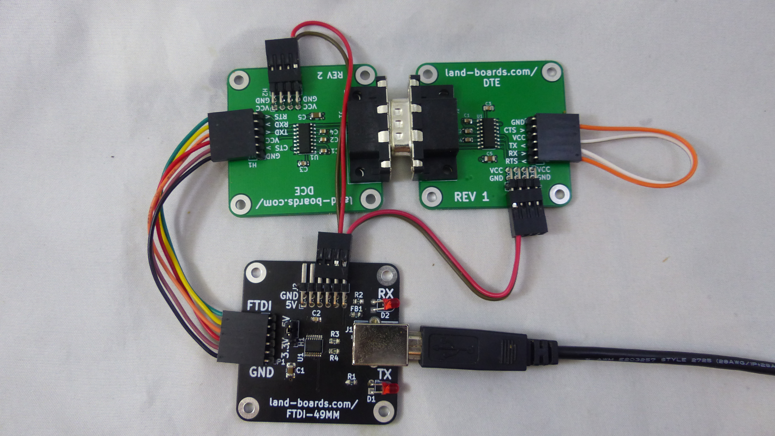
FPGA Cards/DCE-RS232-Female/Pics/Test/P1070553.JPG
