land-boards/lb-boards/HamRadio/ADE1-MIXER/pics/ADE-1_Performance.PNG

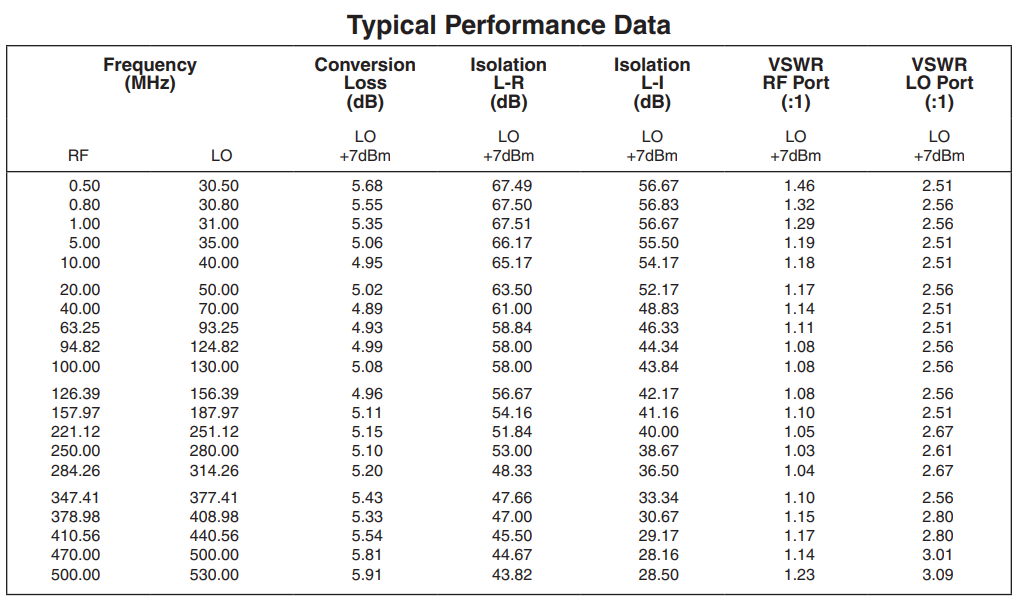
HamRadio/ADE1-MIXER/pics/ADE-1_Performance.PNG
