land-boards/lb-boards/HamRadio/ANTUNER/Pictures/CAD/OSH Park ~ Verify your design_files/5f9017c68a6d9b3b453f8d4b126e3967.png

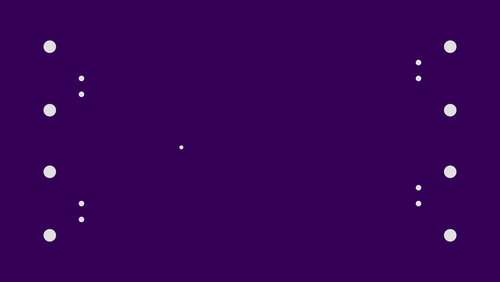
HamRadio/ANTUNER/Pictures/CAD/OSH Park ~ Verify your design_files/5f9017c68a6d9b3b453f8d4b126e3967.png
