land-boards/lb-boards/HamRadio/ANTUNER/Pictures/CAD/OSH Park ~ Verify your design_files/8e6a2d3d959b461287f77ae5e3ae1cac.png

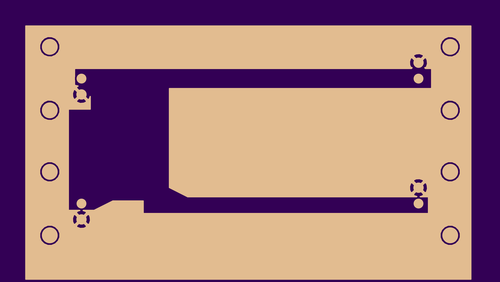
HamRadio/ANTUNER/Pictures/CAD/OSH Park ~ Verify your design_files/8e6a2d3d959b461287f77ae5e3ae1cac.png
