land-boards/lb-boards/HamRadio/ANTUNER/Pictures/CAD/OSH Park ~ Verify your design_files/4330d881c0278b81a7cbf9f7f889a85a.png

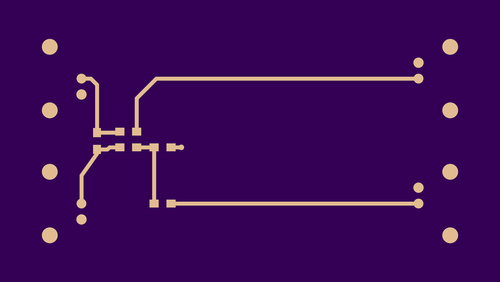
HamRadio/ANTUNER/Pictures/CAD/OSH Park ~ Verify your design_files/4330d881c0278b81a7cbf9f7f889a85a.png
