land-boards/lb-boards/HamRadio/ANTUNER/Pictures/CAD/OSH Park ~ Verify your design_files/79091656915c47fab60f8ce10f2de985.png

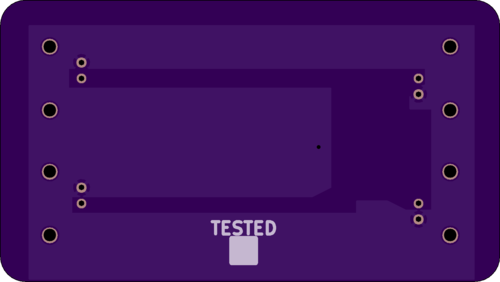
HamRadio/ANTUNER/Pictures/CAD/OSH Park ~ Verify your design_files/79091656915c47fab60f8ce10f2de985.png
