land-boards/lb-boards/HamRadio/Colpitts_XTAL_Osc/Pics/tinySA_Measurements/Rev2/CP_Osc_4p43MHz_4_to_30MHz_SMT_BNC_Rev2_tinySA.PNG

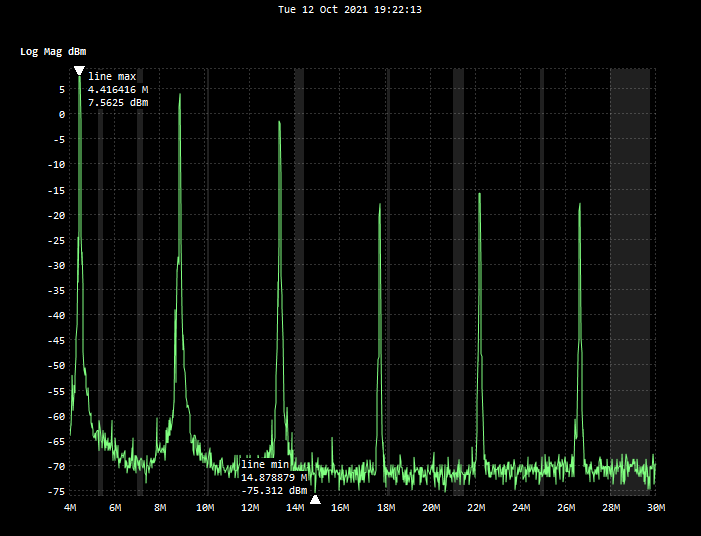
HamRadio/Colpitts_XTAL_Osc/Pics/tinySA_Measurements/Rev2/CP_Osc_4p43MHz_4_to_30MHz_SMT_BNC_Rev2_tinySA.PNG
