land-boards/lb-boards/HamRadio/CRYSTAL_FILTERS/SSB6/pictures/TestFixture/Measurements/PinJig-02.png

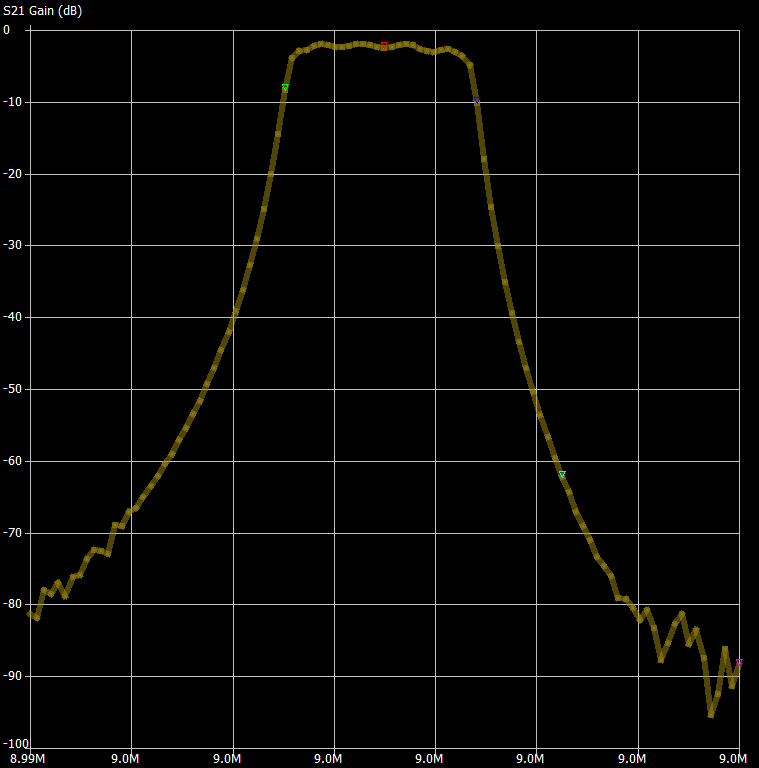
HamRadio/CRYSTAL_FILTERS/SSB6/pictures/TestFixture/Measurements/PinJig-02.png
