land-boards/lb-boards/HamRadio/DRIVE50/Pictures/Test/P1080484.JPG

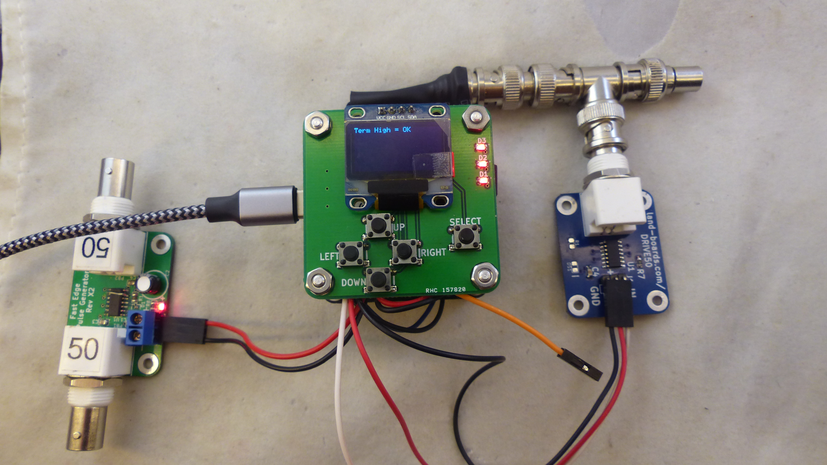
HamRadio/DRIVE50/Pictures/Test/P1080484.JPG
