land-boards/lb-boards/HamRadio/NoiseGen/Pics/Prototype/TESTING_PROTOTYPE/NG_ON.PNG

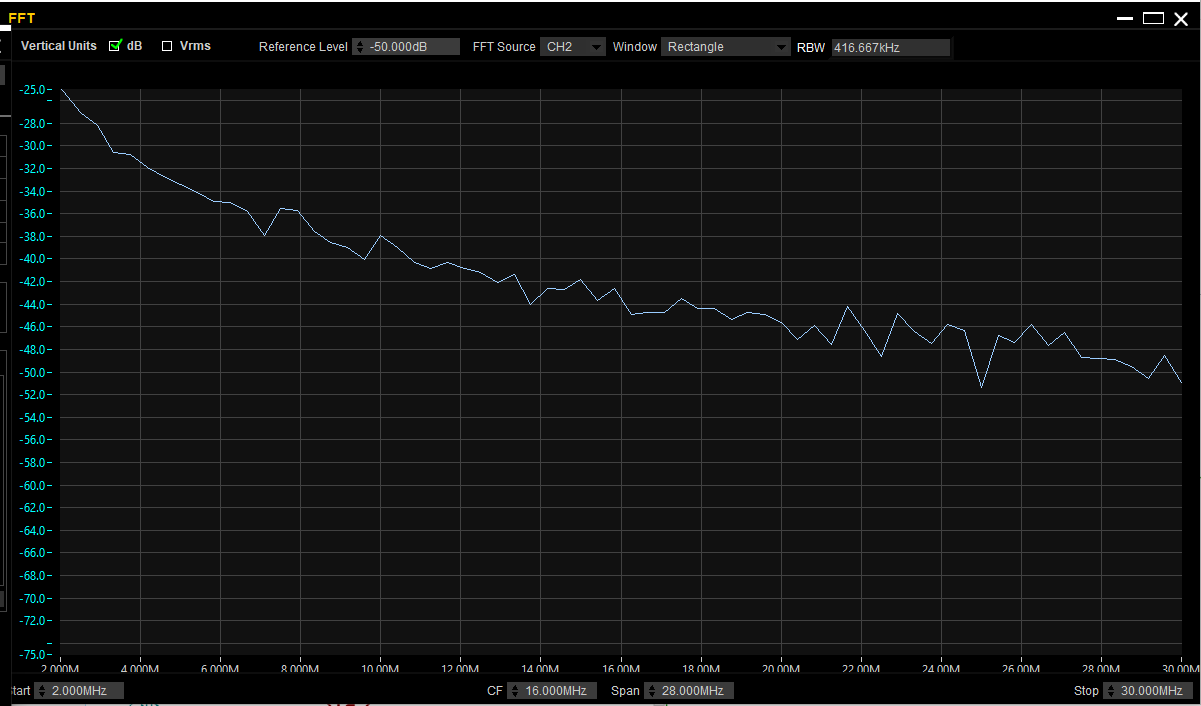
HamRadio/NoiseGen/Pics/Prototype/TESTING_PROTOTYPE/NG_ON.PNG
