land-boards/lb-boards/HamRadio/NoiseGen/Pics/tinySA_Measurements/EMiRFD/NoiseGenOnTinySA_On_100KHz-1MHz.PNG

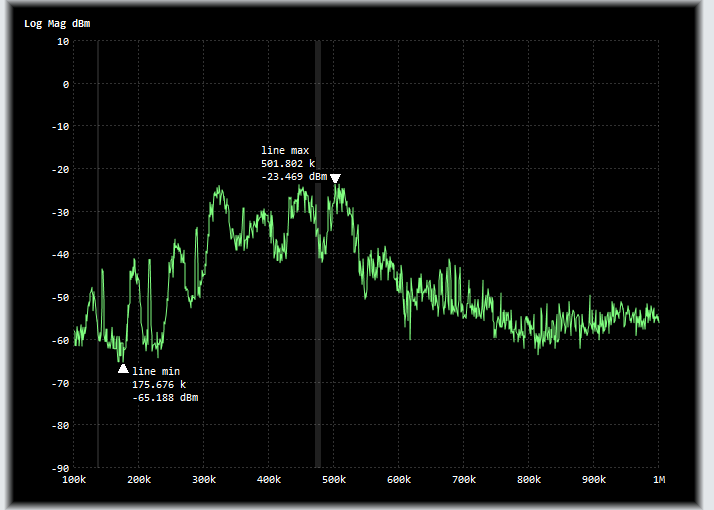
HamRadio/NoiseGen/Pics/tinySA_Measurements/EMiRFD/NoiseGenOnTinySA_On_100KHz-1MHz.PNG
