land-boards/lb-boards/HamRadio/PULSE-GEN/Pictures/Test/P1080369.JPG

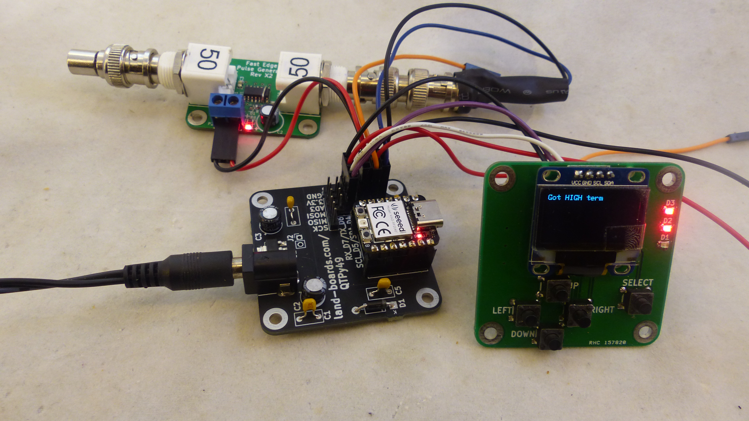
HamRadio/PULSE-GEN/Pictures/Test/P1080369.JPG
