land-boards/lb-boards/HamRadio/VFO-001/Pictures/Measurements/7ceb0521-5bfa-4f60-983f-b9007c21abcd.jpg

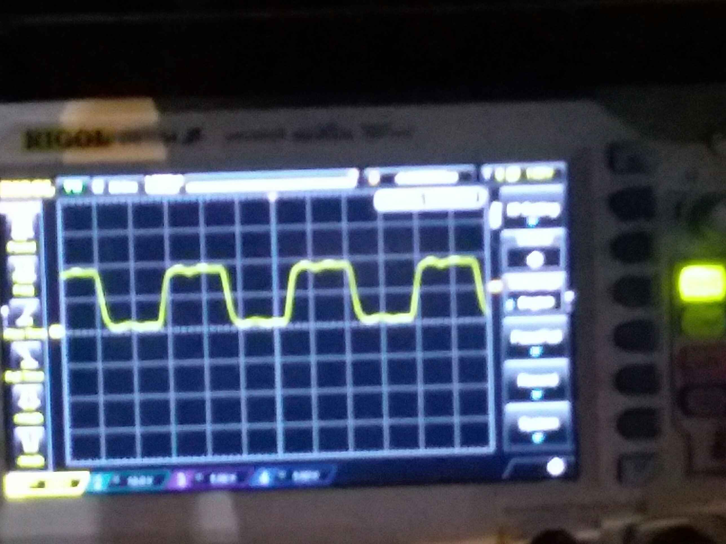
HamRadio/VFO-001/Pictures/Measurements/7ceb0521-5bfa-4f60-983f-b9007c21abcd.jpg
