land-boards/lb-boards/HamRadio/VFO-001/Pictures/Measurements/tinySA/tinySA_VFO-001_10MHz-Signal_Narrow-10MHz.png

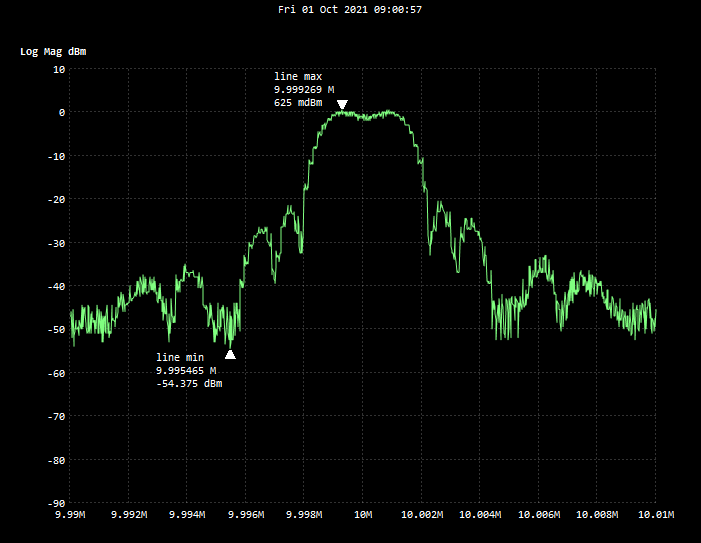
HamRadio/VFO-001/Pictures/Measurements/tinySA/tinySA_VFO-001_10MHz-Signal_Narrow-10MHz.png
