land-boards/lb-boards/HamRadio/VFO-005/Pictures/Measurements/tinySA/tinySA_7MHz-Sinewave.png

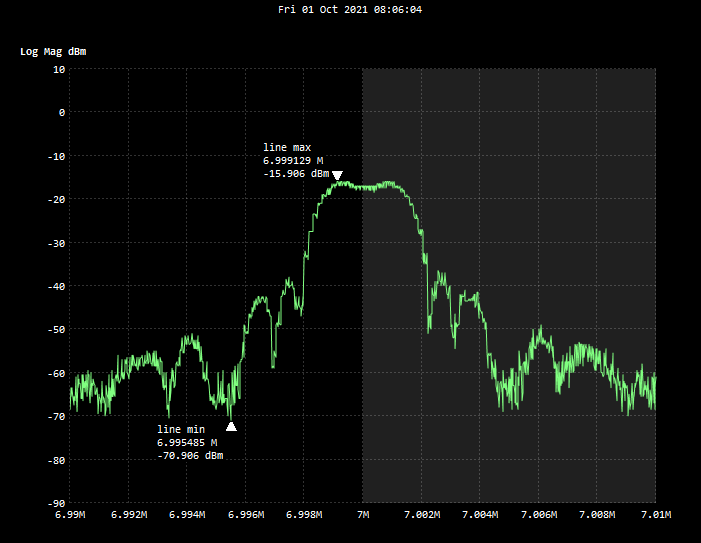
HamRadio/VFO-005/Pictures/Measurements/tinySA/tinySA_7MHz-Sinewave.png
