land-boards/lb-boards/HamRadio/VFO-005/Pictures/Measurements/tinySA/tinySA_10MHz-Sinewave_From_DC_to_30MHz_.png

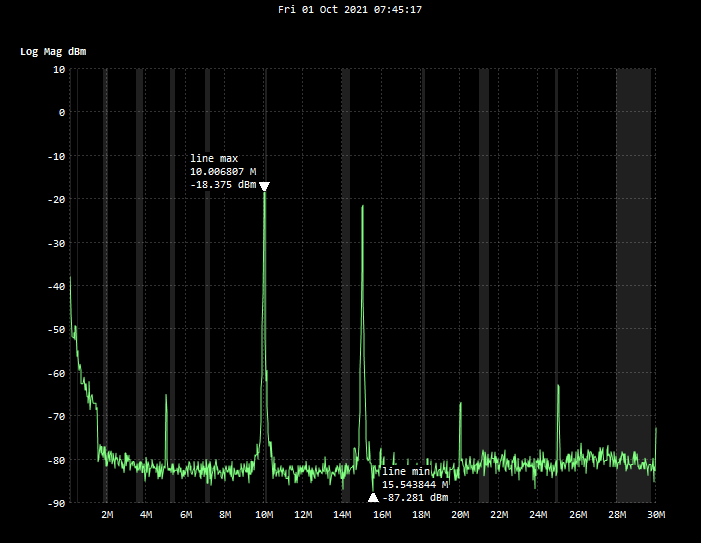
HamRadio/VFO-005/Pictures/Measurements/tinySA/tinySA_10MHz-Sinewave_From_DC_to_30MHz_.png
