land-boards/lb-boards/I2C Cards/I2C-RPT-01/pictures/Testing/I2C-RPT-01_P1858.JPG

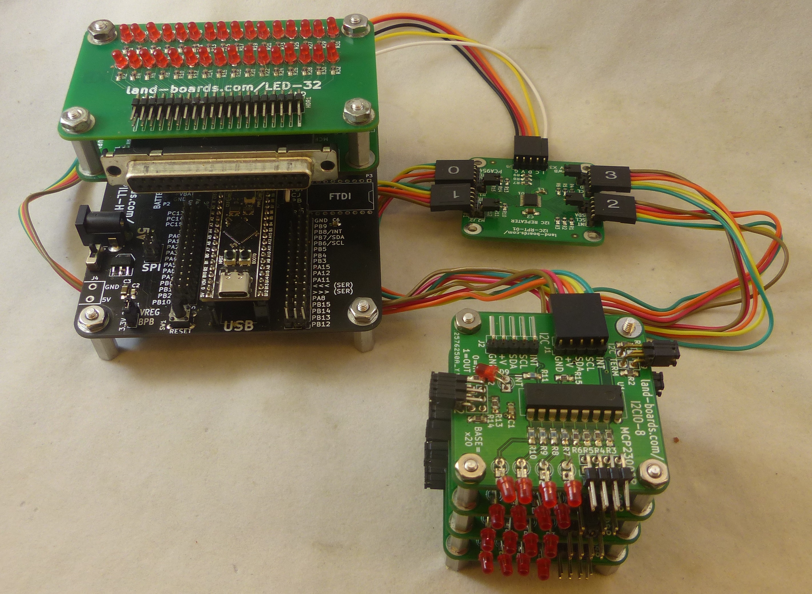
I2C Cards/I2C-RPT-01/pictures/Testing/I2C-RPT-01_P1858.JPG
