land-boards/lb-boards/I2C Cards/I2C-RPT-08/pictures/Testing/IC2RPT-08_P1871-720px.jpg

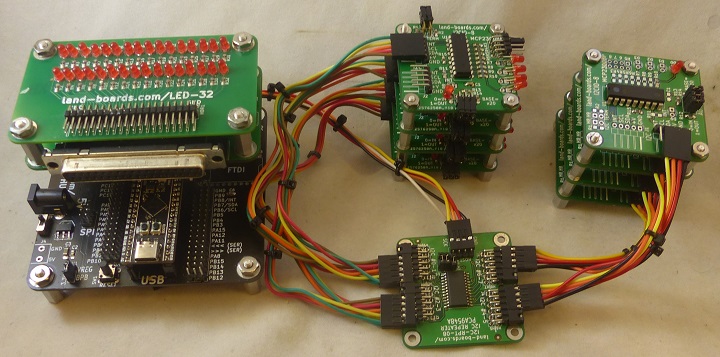
I2C Cards/I2C-RPT-08/pictures/Testing/IC2RPT-08_P1871-720px.jpg
