land-boards/lb-boards/I2C Cards/I2C-RPT-08/pictures/Testing/P1010969.JPG

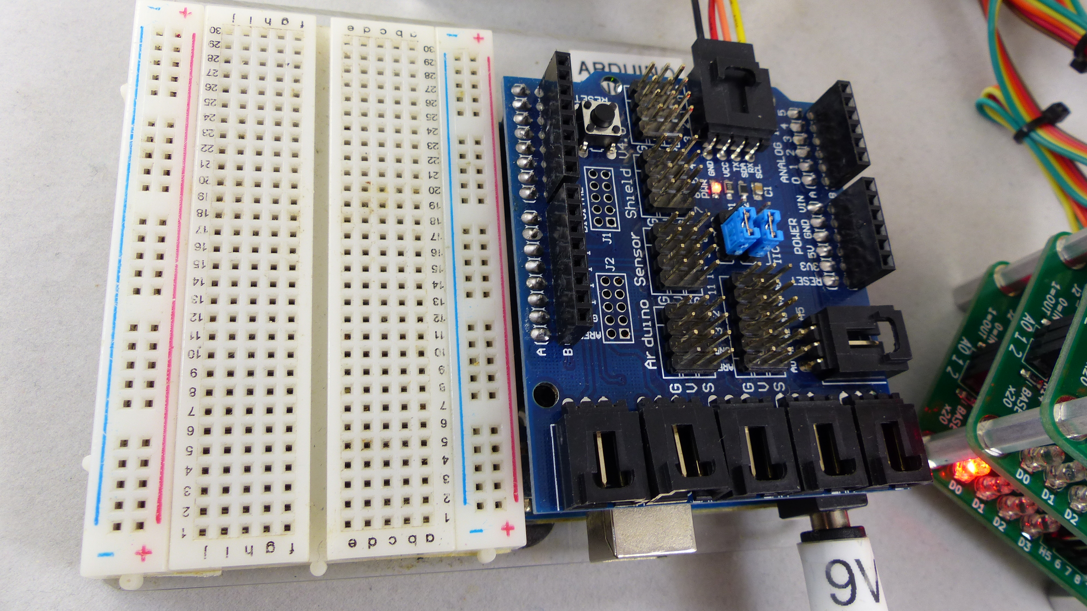
I2C Cards/I2C-RPT-08/pictures/Testing/P1010969.JPG
