land-boards/lb-boards/I2C Cards/I2CIO16-DB25/Pictures/Test/P1080297.JPG

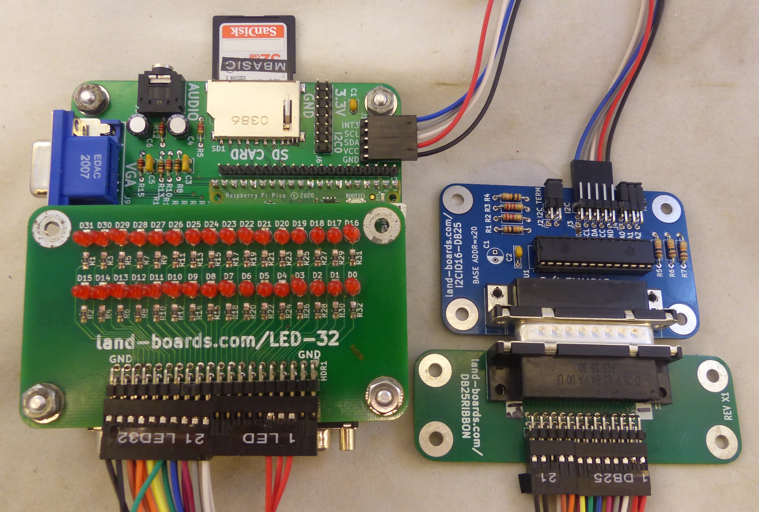
I2C Cards/I2CIO16-DB25/Pictures/Test/P1080297.JPG
