land-boards/lb-boards/I2C Cards/I2CIO-8X/pictures/Test_Station/I2CIO-8X_P1866_720PX.jpg

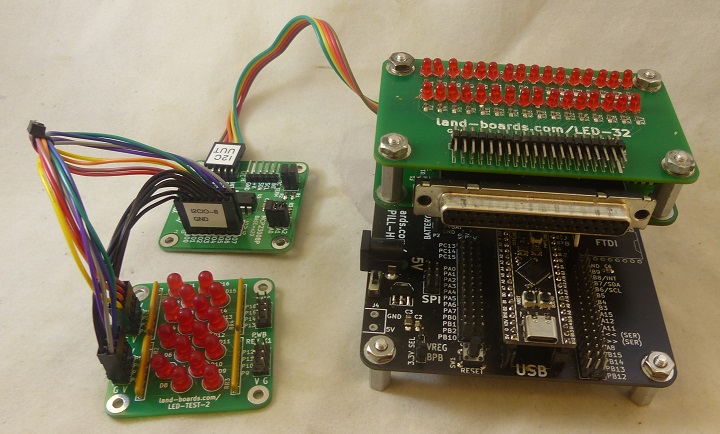
I2C Cards/I2CIO-8X/pictures/Test_Station/I2CIO-8X_P1866_720PX.jpg
