land-boards/lb-boards/I2C Cards/I2CIO-8X/pictures/Test_Station/P1080065.JPG

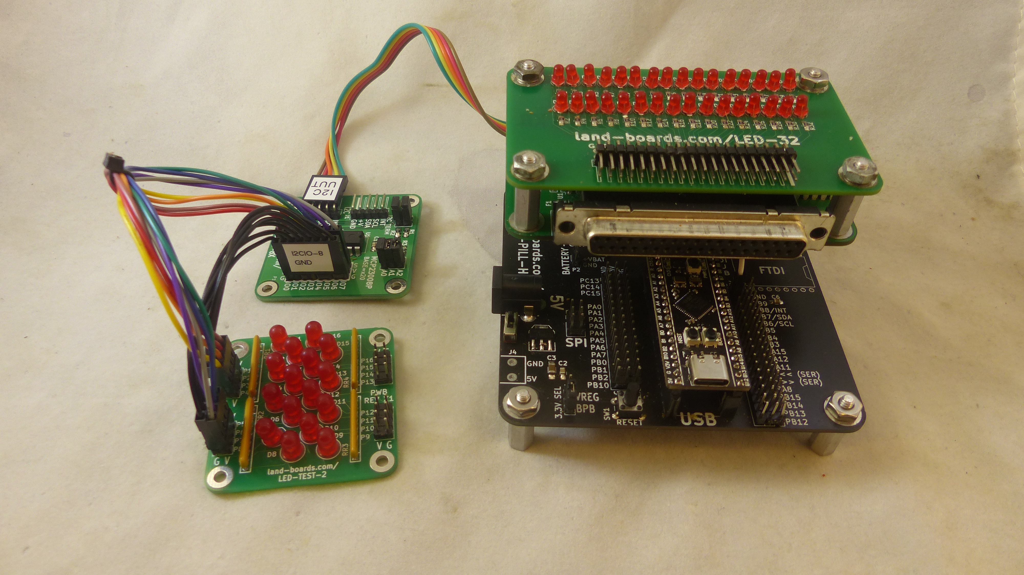
I2C Cards/I2CIO-8X/pictures/Test_Station/P1080065.JPG
