land-boards/lb-boards/I2C Cards/Proto16-I2C/Pictures/Test/Proto16-I2C-P1010569-4000px.JPG

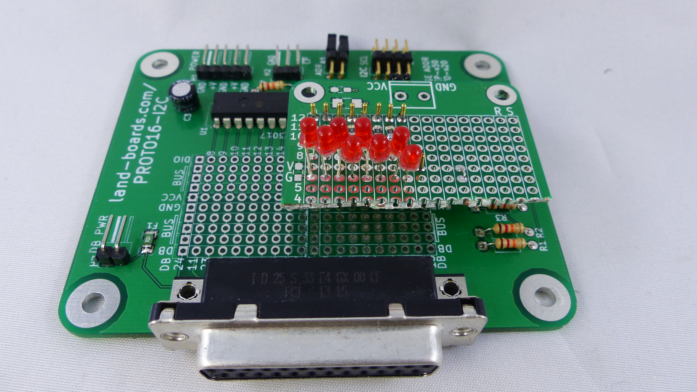
I2C Cards/Proto16-I2C/Pictures/Test/Proto16-I2C-P1010569-4000px.JPG
