land-boards/lb-boards/I2C Cards/SWLEDX8/Pictures/Test/P1080189.JPG

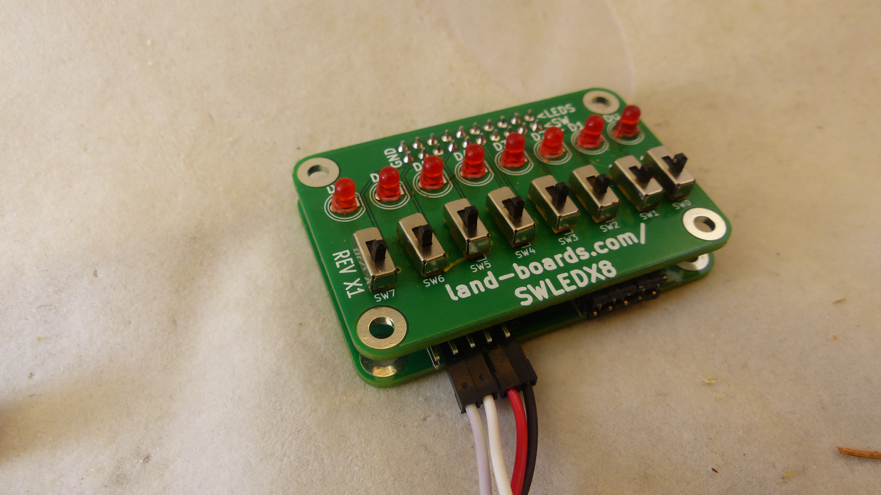
I2C Cards/SWLEDX8/Pictures/Test/P1080189.JPG
