land-boards/lb-boards/LEDs Cards/LED-32/Pictures/CAD/OSH Park ~ Verify your design_files/5ff55e49373707292266e07264227a3e.png

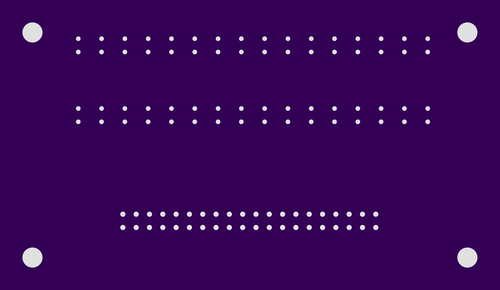
LEDs Cards/LED-32/Pictures/CAD/OSH Park ~ Verify your design_files/5ff55e49373707292266e07264227a3e.png
