land-boards/lb-boards/LEDs Cards/LED-32/Pictures/CAD/OSH Park ~ Verify your design_files/51f58de5c15280c3748f97e8f75a3555.png

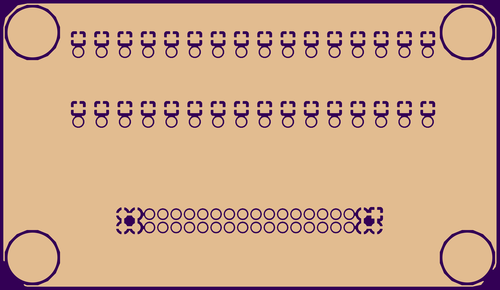
LEDs Cards/LED-32/Pictures/CAD/OSH Park ~ Verify your design_files/51f58de5c15280c3748f97e8f75a3555.png
