land-boards/lb-boards/LEDs Cards/LED-32/Pictures/CAD/OSH Park ~ Verify your design_files/933de1b0c6578e26555cf48e5fd52e9e.png

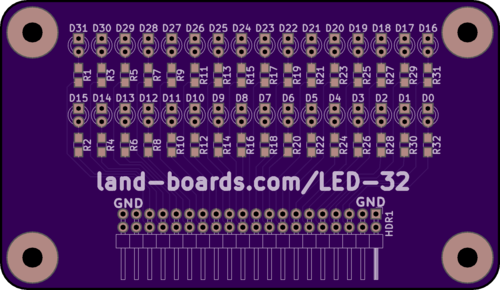
LEDs Cards/LED-32/Pictures/CAD/OSH Park ~ Verify your design_files/933de1b0c6578e26555cf48e5fd52e9e.png
