land-boards/lb-boards/LEDs Cards/LED-TEST-2/Pictures/CCA/LED-Test-2-320px.jpg

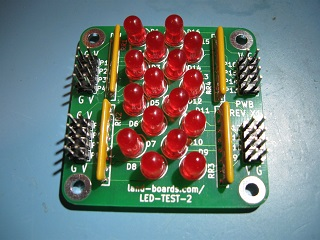
LEDs Cards/LED-TEST-2/Pictures/CCA/LED-Test-2-320px.jpg
