land-boards/lb-boards/LEDs Cards/LED-TEST-2/Pictures/CCA/LED-Test-2-5291-512px.jpg

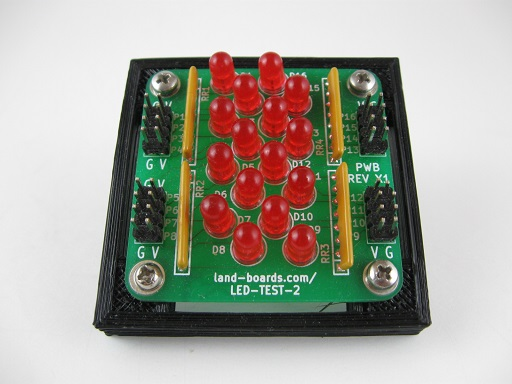
LEDs Cards/LED-TEST-2/Pictures/CCA/LED-Test-2-5291-512px.jpg
