land-boards/lb-boards/LEDs Cards/LED-TEST-2/Pictures/Kits/LED-TEST-2_5834-640px.jpg

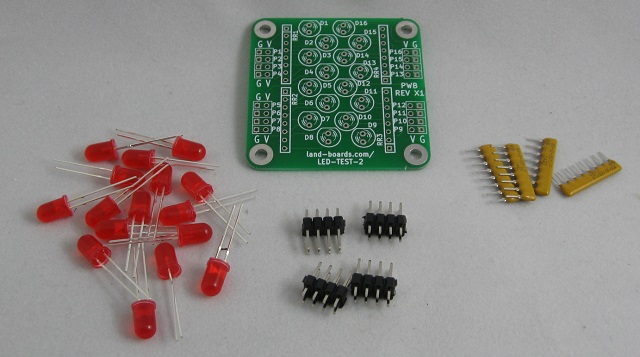
LEDs Cards/LED-TEST-2/Pictures/Kits/LED-TEST-2_5834-640px.jpg
