land-boards/lb-boards/LEDs Cards/LED-TEST-2/Pictures/Kits/LED-TEST-2_5835.JPG

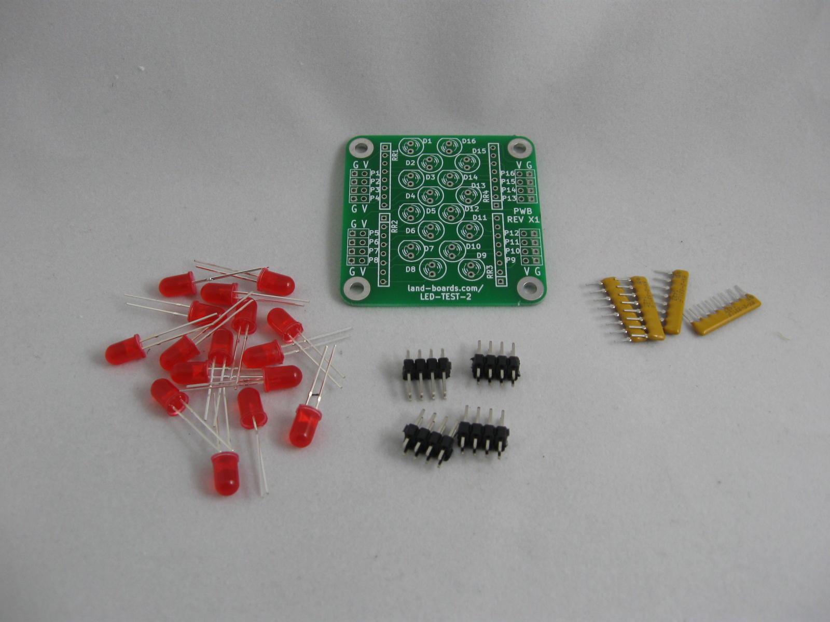
LEDs Cards/LED-TEST-2/Pictures/Kits/LED-TEST-2_5835.JPG
