land-boards/lb-boards/LEDs Cards/LED-TEST-2/Pictures/LED-TEST-2-CAD/LED-Test2-CAD-X1.PNG

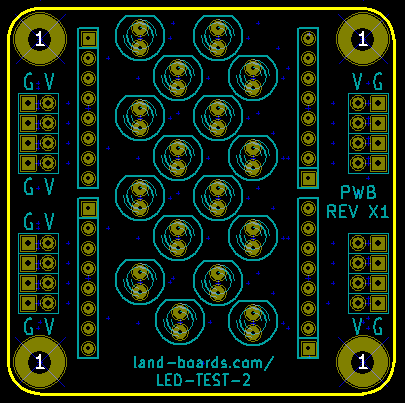
LEDs Cards/LED-TEST-2/Pictures/LED-TEST-2-CAD/LED-Test2-CAD-X1.PNG
