land-boards/lb-boards/LEDs Cards/LED-Test/Pictures/LED-Test-3D.PNG

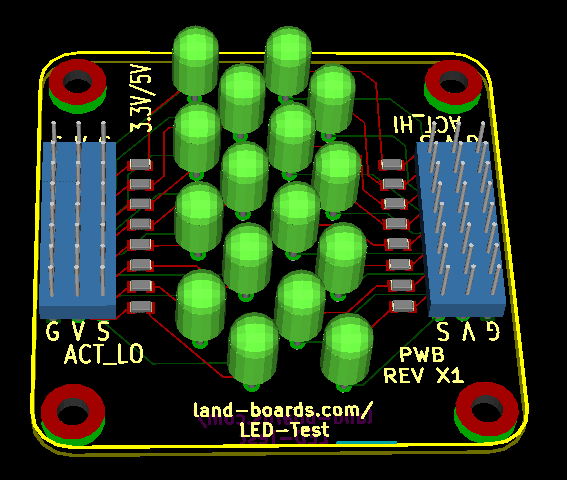
LEDs Cards/LED-Test/Pictures/LED-Test-3D.PNG
