land-boards/lb-boards/LEDs Cards/LED-Test/Pictures/LED-Test-PWB-X2.PNG

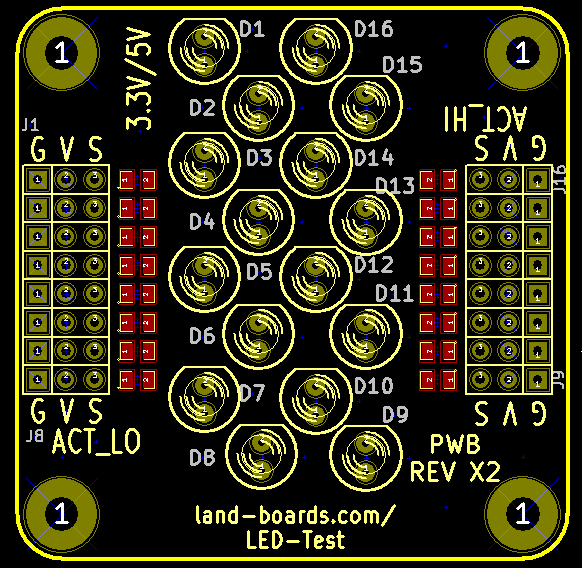
LEDs Cards/LED-Test/Pictures/LED-Test-PWB-X2.PNG
