land-boards/lb-boards/LEDs Cards/MAX7219X4/pics/Test/Rev_2_Test/MAX7219X4_P18547_TEST_720PX.jpg

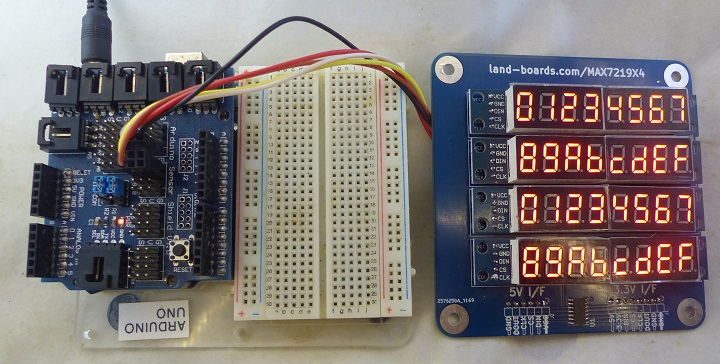
LEDs Cards/MAX7219X4/pics/Test/Rev_2_Test/MAX7219X4_P18547_TEST_720PX.jpg
