land-boards/lb-boards/LEDs Cards/MAX7219X4/pics/Test/Rev_2_Test/P1080545.JPG

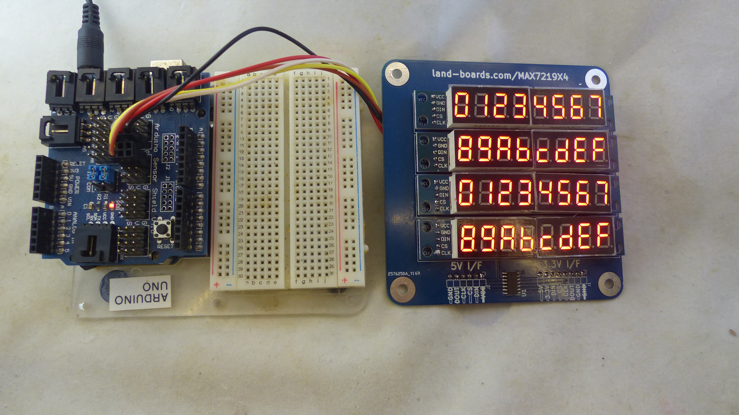
LEDs Cards/MAX7219X4/pics/Test/Rev_2_Test/P1080545.JPG
