land-boards/lb-boards/LEDs Cards/MAX7219X4/pics/Test/Rev_2_Test/P1080548.JPG

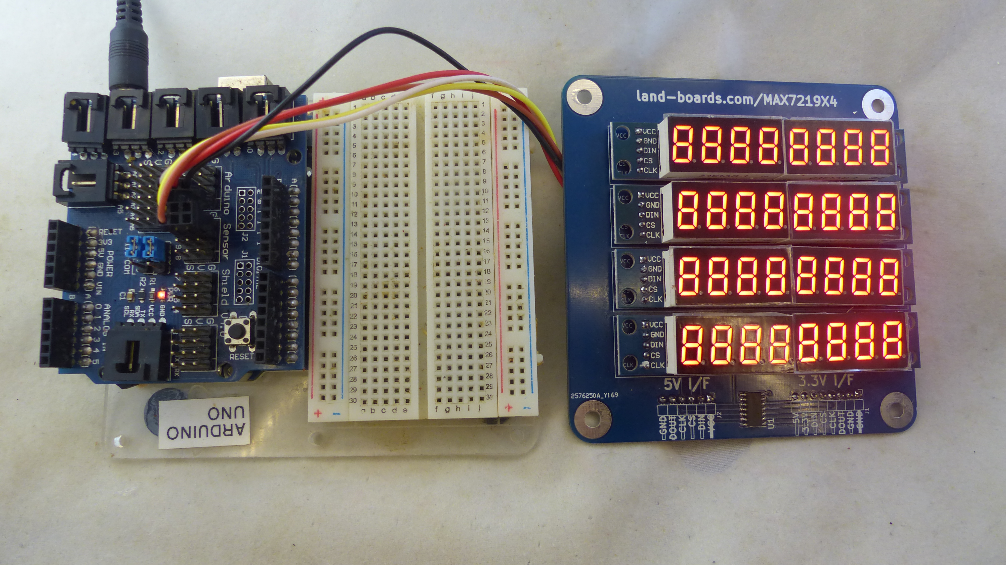
LEDs Cards/MAX7219X4/pics/Test/Rev_2_Test/P1080548.JPG
