land-boards/lb-boards/ODAS Cards/ODAS-PSOC5/Pictures/CAD/Rev_X3/OSH Park ~ Verify your design_files/67a9cf9259c8ad0957d5cbf876ce4164.png

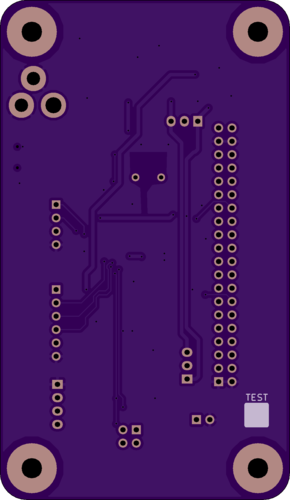
ODAS Cards/ODAS-PSOC5/Pictures/CAD/Rev_X3/OSH Park ~ Verify your design_files/67a9cf9259c8ad0957d5cbf876ce4164.png
