land-boards/lb-boards/ODAS Cards/ODAS-PSOC5/Pictures/Test/oLDtESTsTATION/ODAS-PSOC5_P1002_720px.jpg

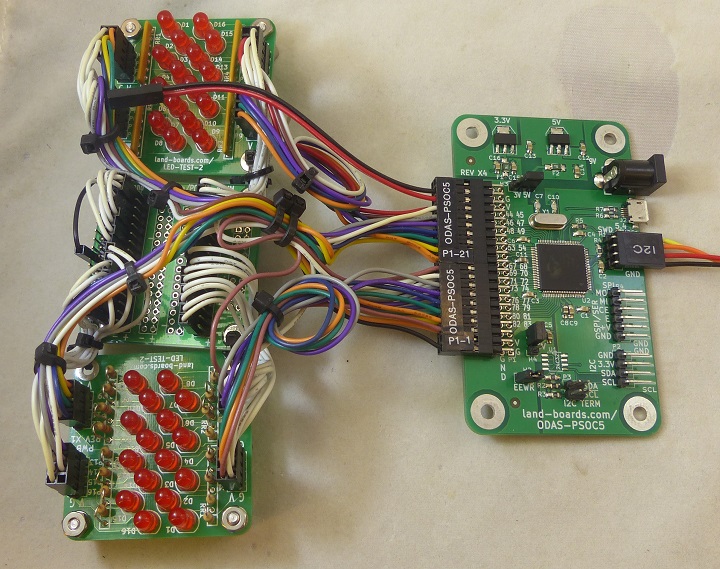
ODAS Cards/ODAS-PSOC5/Pictures/Test/oLDtESTsTATION/ODAS-PSOC5_P1002_720px.jpg
