land-boards/lb-boards/ODAS Cards/ODAS-PSOC5/Pictures/Test/oLDtESTsTATION/P1020179.JPG

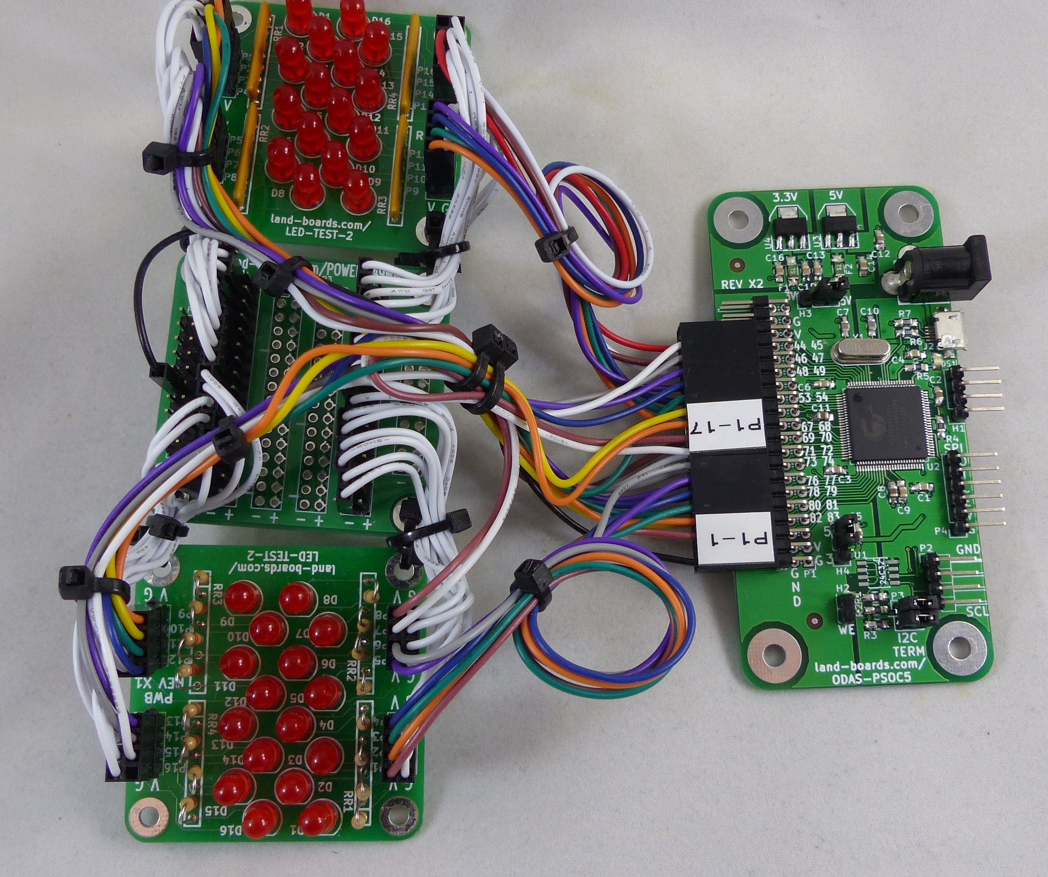
ODAS Cards/ODAS-PSOC5/Pictures/Test/oLDtESTsTATION/P1020179.JPG
