land-boards/lb-boards/ODAS Cards/ODAS-RELAY-16/Pictures/CAD/Rev X1/OSH Park ~ Verify your design_files/1d2613d0f5e87df5b81078e25bc14c08.png

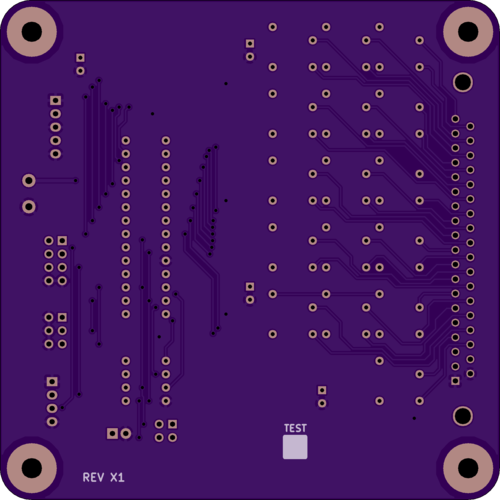
ODAS Cards/ODAS-RELAY-16/Pictures/CAD/Rev X1/OSH Park ~ Verify your design_files/1d2613d0f5e87df5b81078e25bc14c08.png
