land-boards/lb-boards/ODAS Cards/ODAS-RELAY-16/Pictures/CAD/Rev X1/OSH Park ~ Verify your design_files/7b400250536779faadce071df40903d1.png

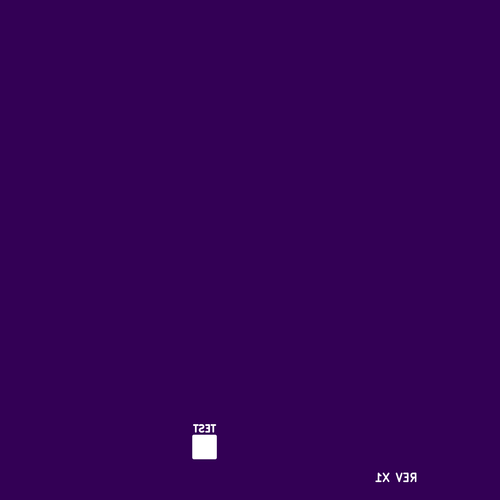
ODAS Cards/ODAS-RELAY-16/Pictures/CAD/Rev X1/OSH Park ~ Verify your design_files/7b400250536779faadce071df40903d1.png
