land-boards/lb-boards/ODAS Cards/ODAS-RELAY-16/Pictures/CAD/Rev X1/OSH Park ~ Verify your design_files/50c78d8d6da620e211219df4ae009382.png

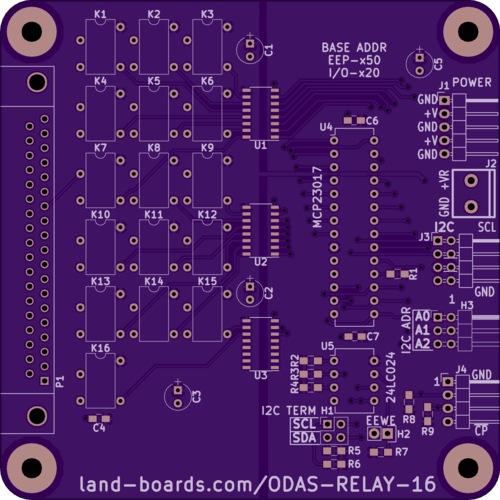
ODAS Cards/ODAS-RELAY-16/Pictures/CAD/Rev X1/OSH Park ~ Verify your design_files/50c78d8d6da620e211219df4ae009382.png
