land-boards/lb-boards/ODAS Cards/ODAS-RELAY-16/Pictures/CAD/Rev X1/OSH Park ~ Verify your design_files/54f0901a02893a44a5df7a569760597b.png

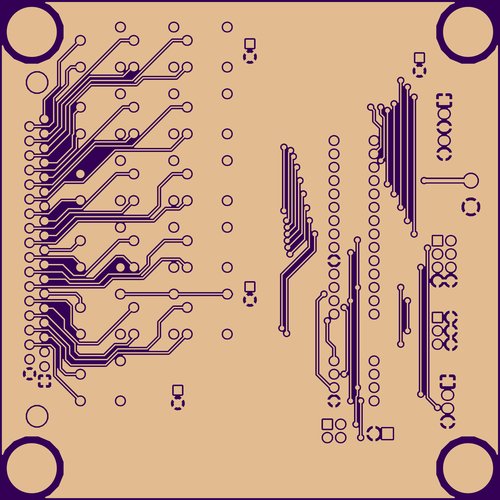
ODAS Cards/ODAS-RELAY-16/Pictures/CAD/Rev X1/OSH Park ~ Verify your design_files/54f0901a02893a44a5df7a569760597b.png
