land-boards/lb-boards/ODAS Cards/ODAS-RELAY-16/Pictures/CAD/Rev X1/OSH Park ~ Verify your design_files/aedef1bad6f94f3484544abb19d93113.png

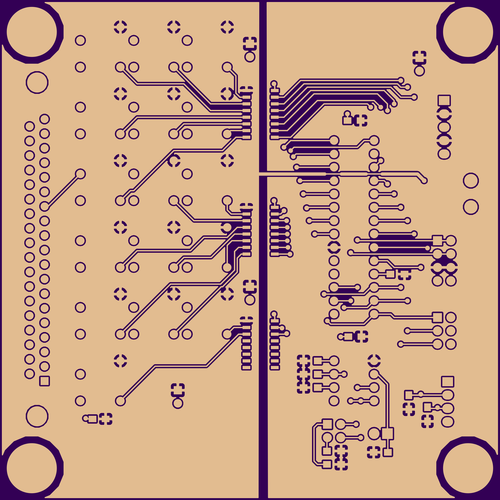
ODAS Cards/ODAS-RELAY-16/Pictures/CAD/Rev X1/OSH Park ~ Verify your design_files/aedef1bad6f94f3484544abb19d93113.png
