land-boards/lb-boards/ODAS Cards/SD_CARD_X49/pictures/Test/P1080098.JPG

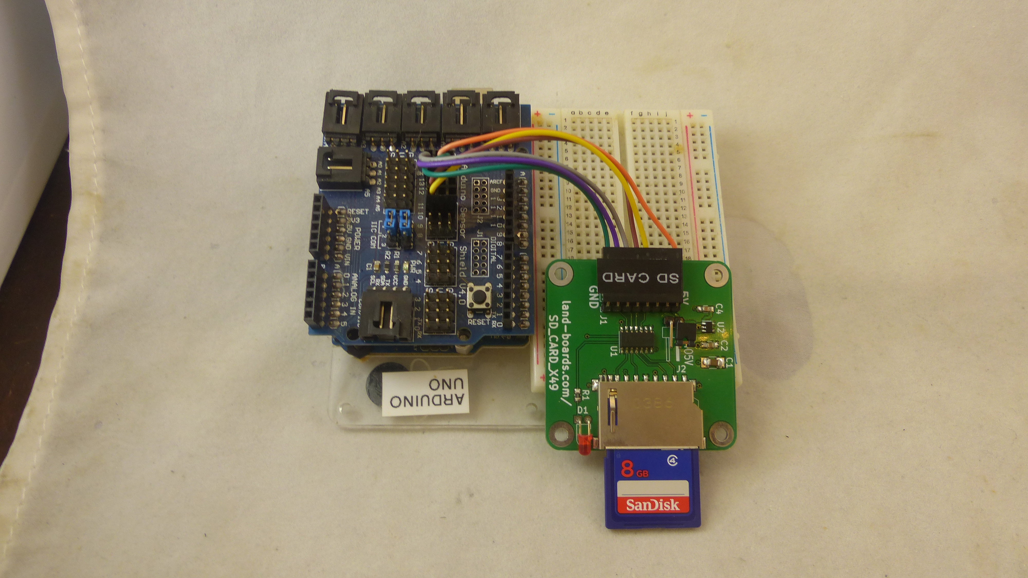
ODAS Cards/SD_CARD_X49/pictures/Test/P1080098.JPG
