land-boards/lb-boards/Opto Cards/OptoUSB/Pictures/Test/P1080128.JPG

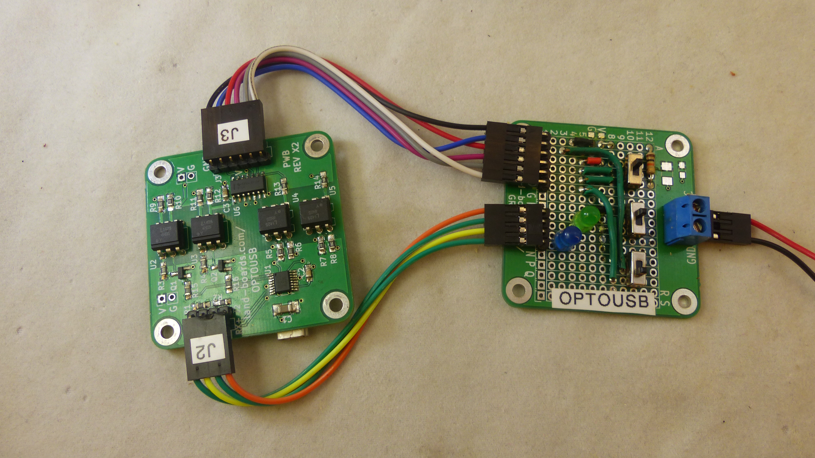
Opto Cards/OptoUSB/Pictures/Test/P1080128.JPG
