land-boards/lb-boards/Opto Cards/OptoUSB/Pictures/Test/P1080131.JPG

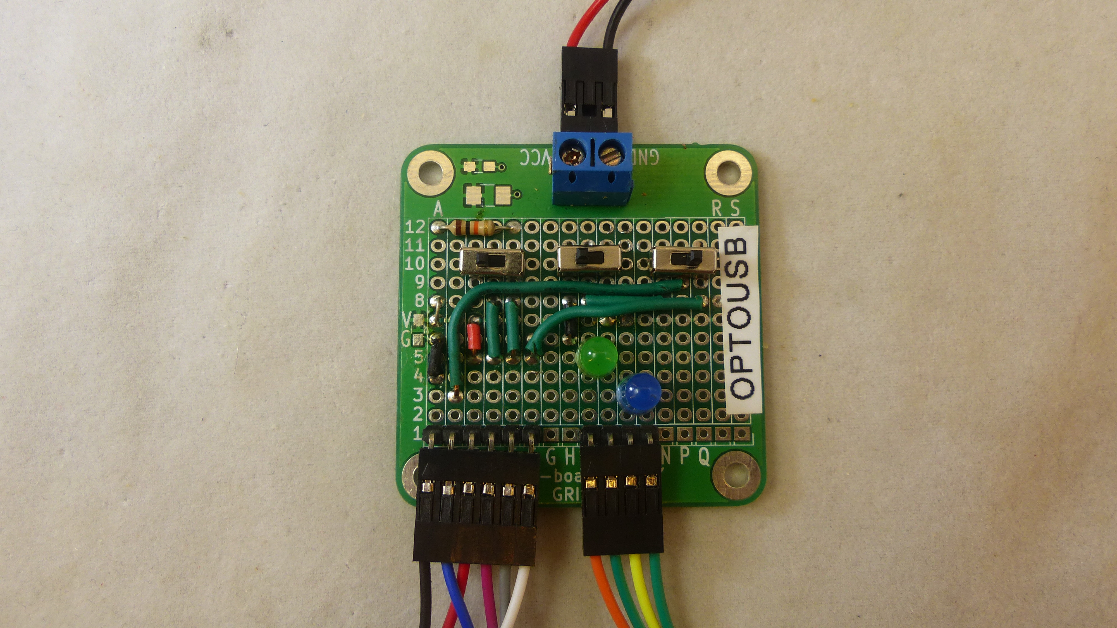
Opto Cards/OptoUSB/Pictures/Test/P1080131.JPG
