land-boards/lb-boards/Projects/IReflow/pictures/Calibration/SetToBake-BothElements/BakeHeatOnly/ToasterOvenBake.png

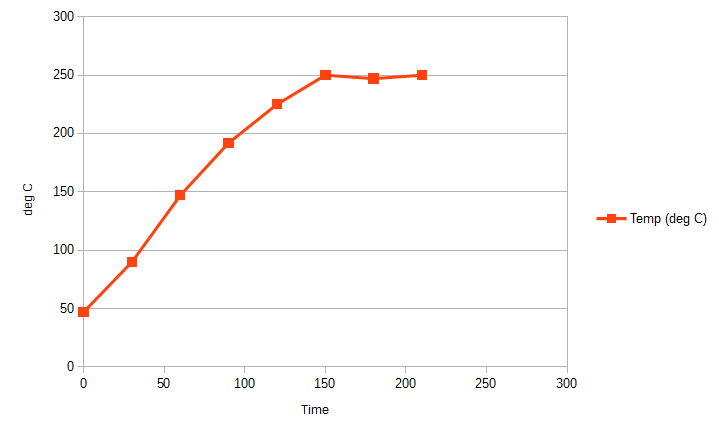
Projects/IReflow/pictures/Calibration/SetToBake-BothElements/BakeHeatOnly/ToasterOvenBake.png
