land-boards/lb-boards/Projects/PiPicoMite02_Card_Test_Sration/Pics/Full-Sized/PiPicoMite02_Test_Station_Back-2.JPG

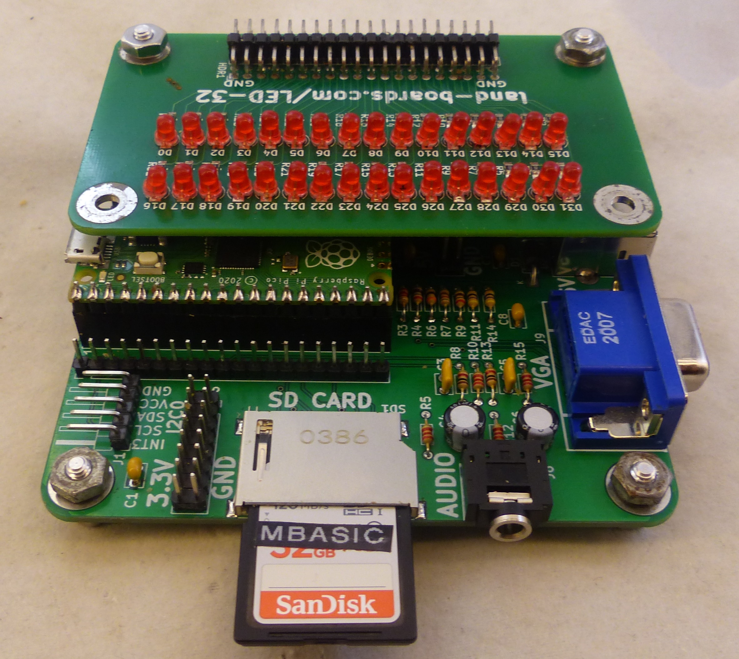
Projects/PiPicoMite02_Card_Test_Sration/Pics/Full-Sized/PiPicoMite02_Test_Station_Back-2.JPG
