land-boards/lb-boards/Projects/PiPicoMite02_Card_Test_Sration/Pics/PiPicoMite02_Test_Station_I2C_Conn-720px.jpg

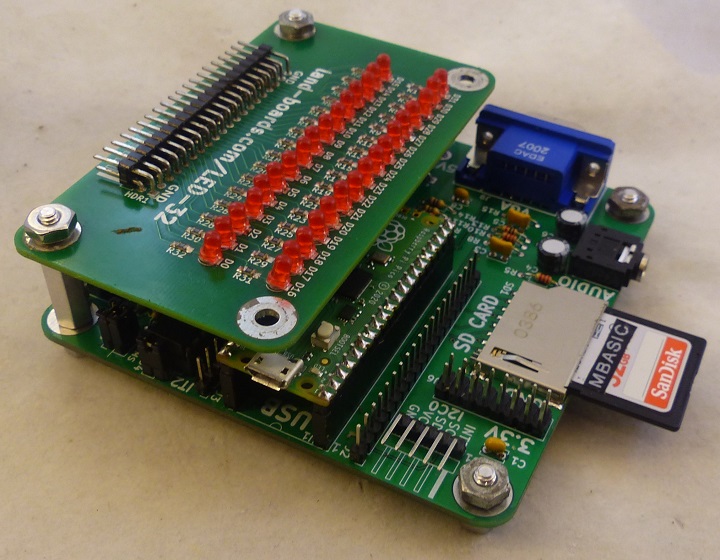
Projects/PiPicoMite02_Card_Test_Sration/Pics/PiPicoMite02_Test_Station_I2C_Conn-720px.jpg
