land-boards/lb-boards/Projects/PiPicoMite02_Card_Test_Sration/Pics/PiPicoMite02_Test_Station_VGA_PS2_Pwr-720px.jpg

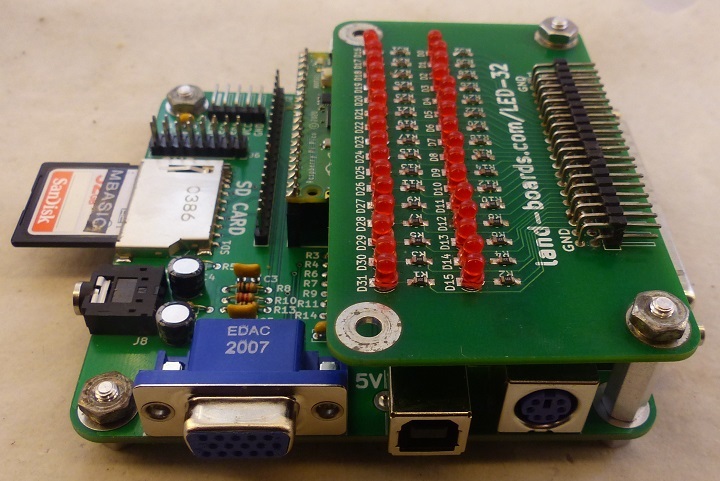
Projects/PiPicoMite02_Card_Test_Sration/Pics/PiPicoMite02_Test_Station_VGA_PS2_Pwr-720px.jpg
