land-boards/lb-boards/Prototyping Cards/DB37RIBBONADAPTER/Pictures/CAD/OSH Park ~ Verify your design_files/20b94aa5baac756f3711ddb7e1676801.png

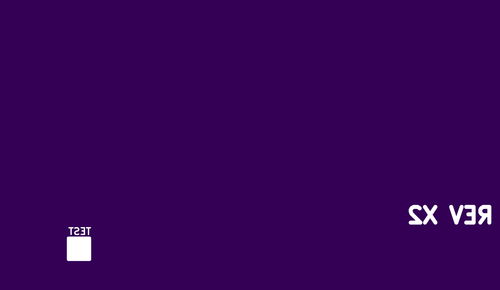
Prototyping Cards/DB37RIBBONADAPTER/Pictures/CAD/OSH Park ~ Verify your design_files/20b94aa5baac756f3711ddb7e1676801.png
