land-boards/lb-boards/Prototyping Cards/DB37RIBBONADAPTER/Pictures/CAD/OSH Park ~ Verify your design_files/b7e5e5d91109f69d2ac4e82da0f3353c.png

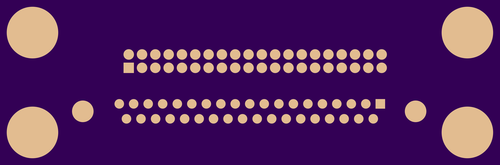
Prototyping Cards/DB37RIBBONADAPTER/Pictures/CAD/OSH Park ~ Verify your design_files/b7e5e5d91109f69d2ac4e82da0f3353c.png
