land-boards/lb-boards/Raspberry Pi Cards/PiPicoMite01/Pics/Test/RTC/PiPicoMite01_RTC_P1080357_Cropped_720px.jpg

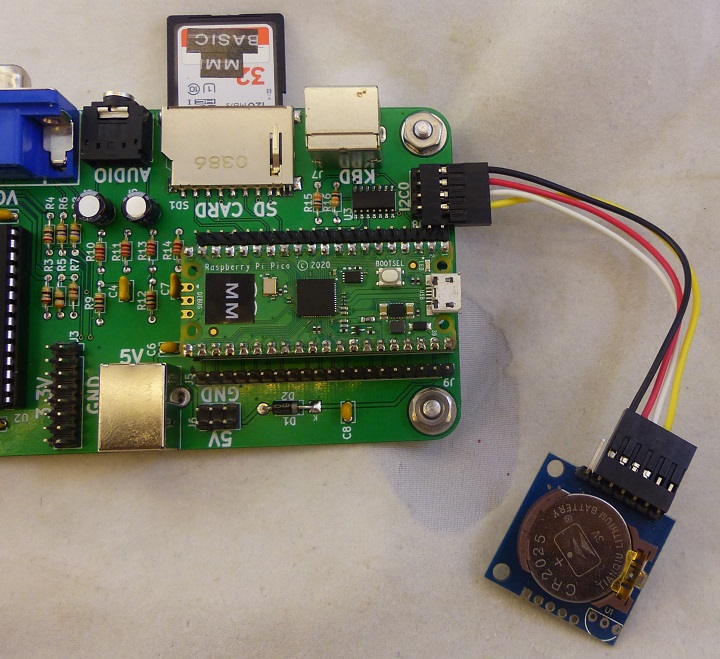
Raspberry Pi Cards/PiPicoMite01/Pics/Test/RTC/PiPicoMite01_RTC_P1080357_Cropped_720px.jpg
