land-boards/lb-boards/Raspberry Pi Cards/PiPicoMite01/Pics/Test/SWLEDX8/P1080359.JPG

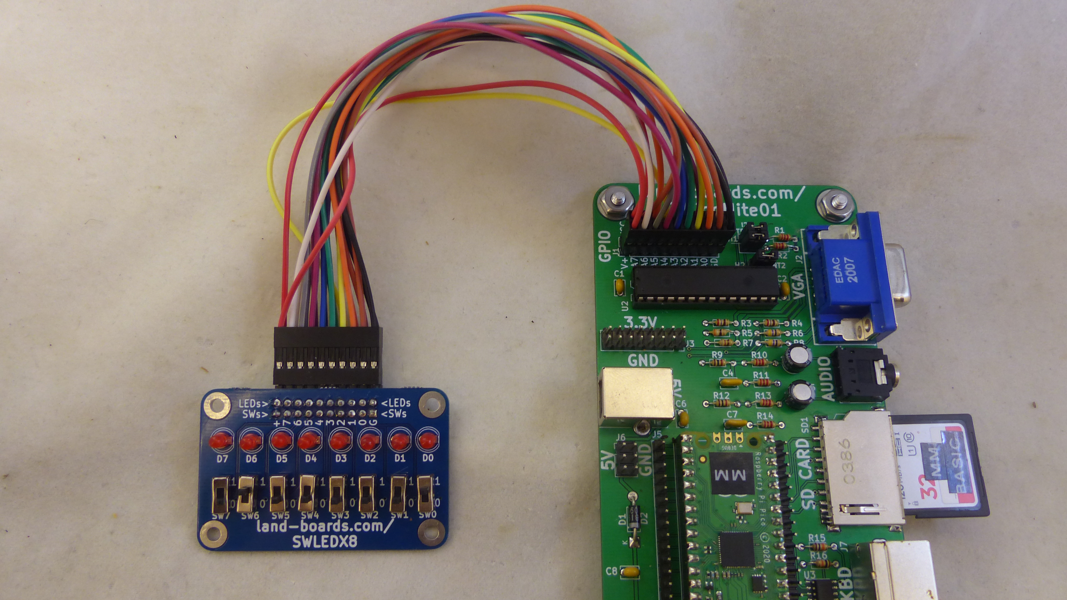
Raspberry Pi Cards/PiPicoMite01/Pics/Test/SWLEDX8/P1080359.JPG
