land-boards/lb-boards/Raspberry Pi Cards/PiPicoMite01/Pics/Test/SWLEDX8/PiPicoMite01_P1080361_2789px.jpg

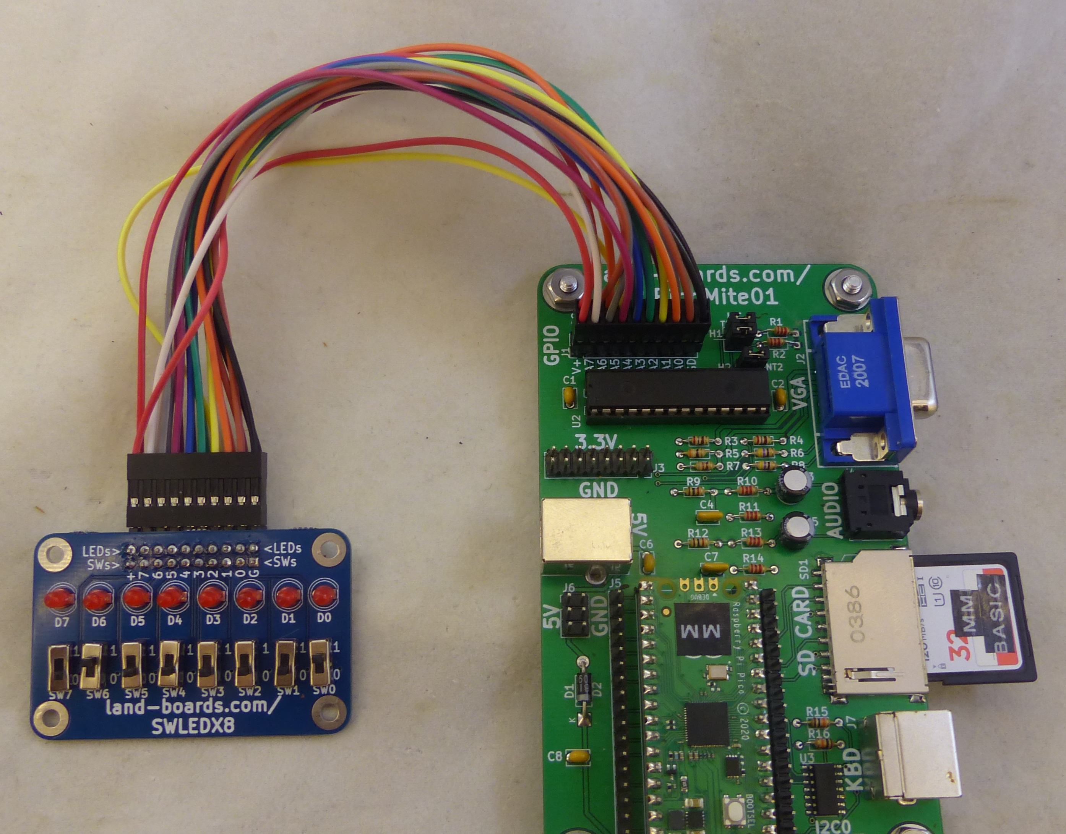
Raspberry Pi Cards/PiPicoMite01/Pics/Test/SWLEDX8/PiPicoMite01_P1080361_2789px.jpg
