land-boards/lb-boards/Raspberry Pi Cards/PiPicoMite01/Pics/Test/SWLEDX8/PiPicoMite01_P1080361_4000px.JPG

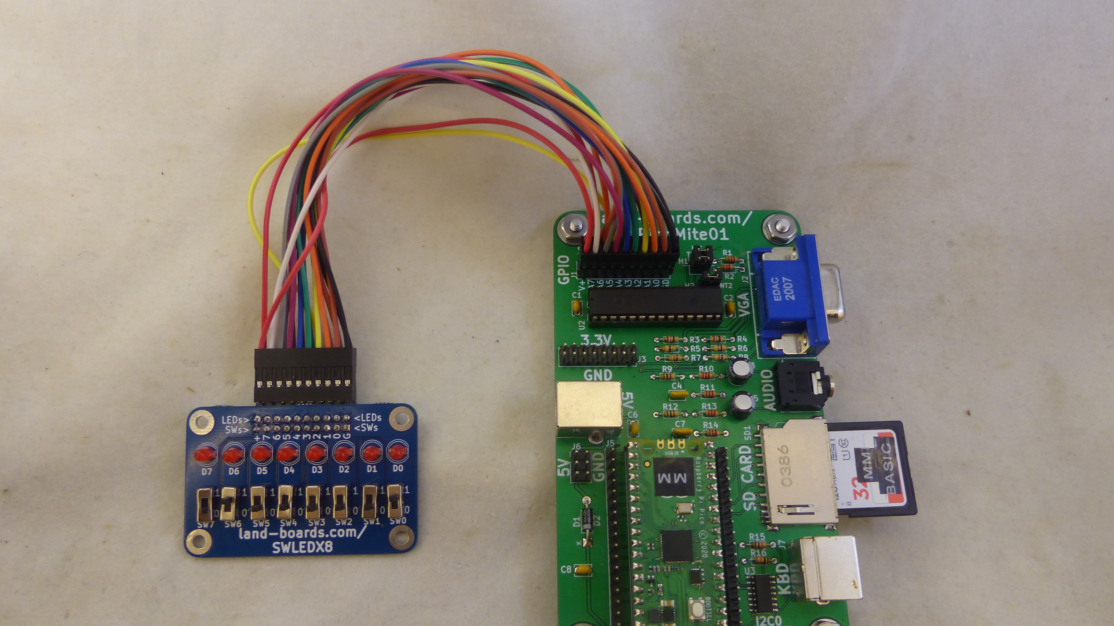
Raspberry Pi Cards/PiPicoMite01/Pics/Test/SWLEDX8/PiPicoMite01_P1080361_4000px.JPG
