land-boards/lb-boards/Raspberry Pi Cards/RasPi-Plus-GVS-CFG/pictures/UUT/RPP-GVS-CFG-X2-fastTest-640px.jpg

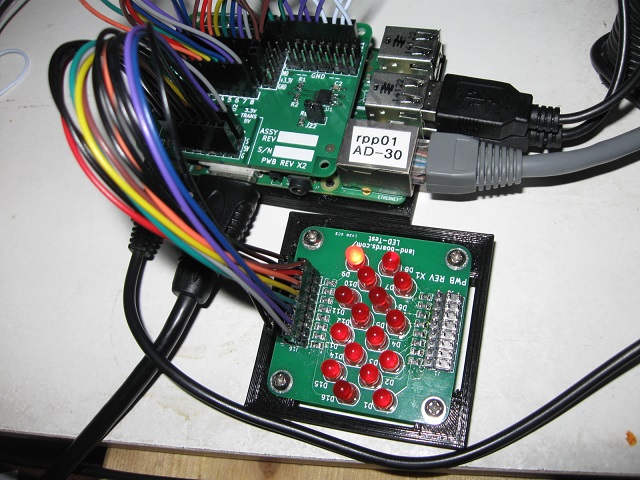
Raspberry Pi Cards/RasPi-Plus-GVS-CFG/pictures/UUT/RPP-GVS-CFG-X2-fastTest-640px.jpg
