land-boards/lb-boards/Raspberry Pi Cards/RP-Console/pictures/UUT/RPI-Console-Test-5459-cropped-640px.jpg

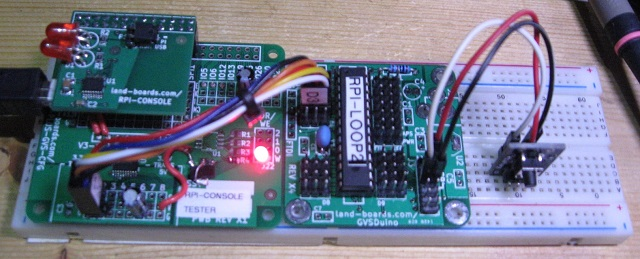
Raspberry Pi Cards/RP-Console/pictures/UUT/RPI-Console-Test-5459-cropped-640px.jpg
