land-boards/lb-boards/Raspberry Pi Cards/RP-Console/pictures/UUT/RPI-CONSOLE-TESTER-BOARD/IMG_5153.JPG

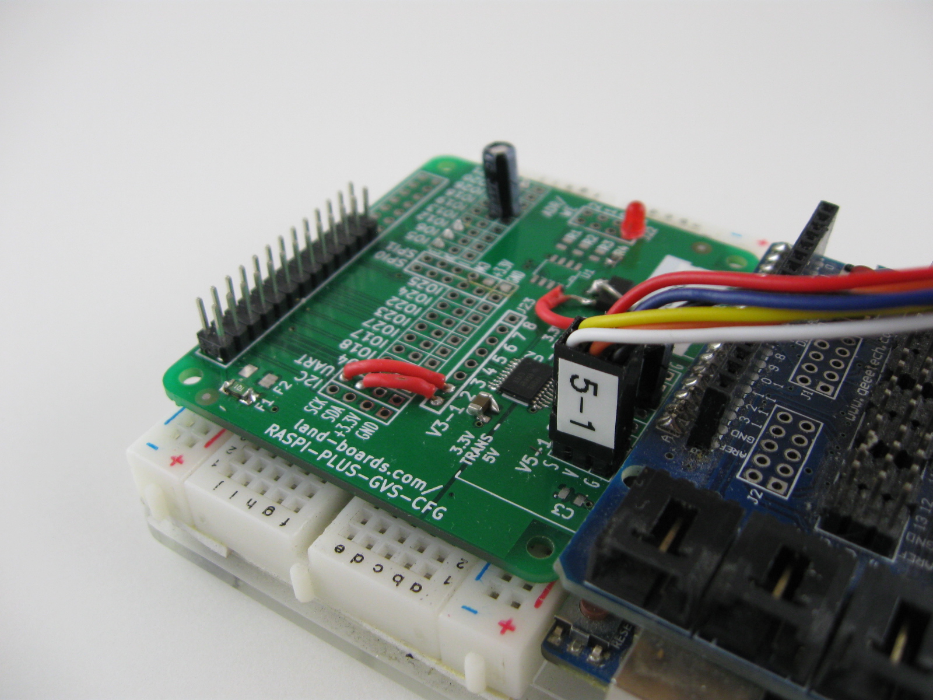
Raspberry Pi Cards/RP-Console/pictures/UUT/RPI-CONSOLE-TESTER-BOARD/IMG_5153.JPG
