land-boards/lb-boards/Raspberry Pi Cards/RP-Console/pictures/UUT/RPI-CONSOLE-TESTER-WITH-ARDUINO/IMG_5099.JPG

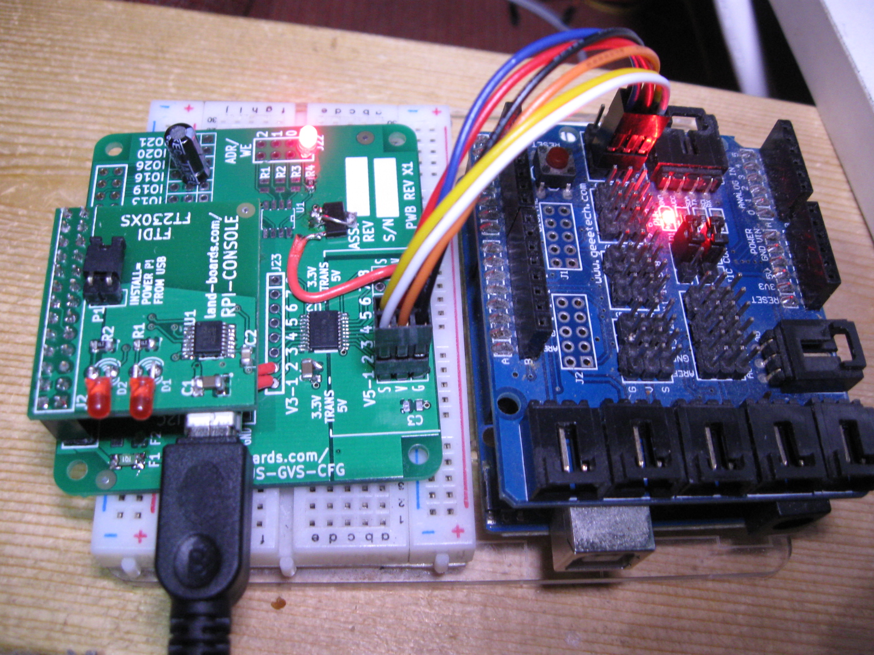
Raspberry Pi Cards/RP-Console/pictures/UUT/RPI-CONSOLE-TESTER-WITH-ARDUINO/IMG_5099.JPG
