land-boards/lb-boards/Raspberry Pi Cards/RP-Console/pictures/UUT/RPI-CONSOLE-TESTER-WITH-ARDUINO/IMG_5101.JPG

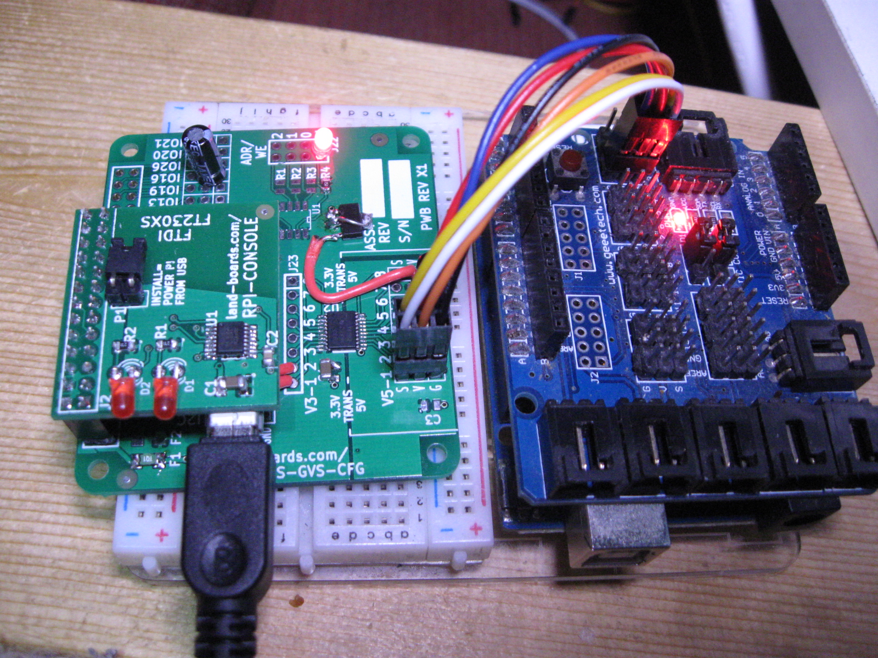
Raspberry Pi Cards/RP-Console/pictures/UUT/RPI-CONSOLE-TESTER-WITH-ARDUINO/IMG_5101.JPG
