land-boards/lb-boards/Raspberry Pi Cards/RPI-I2C-HUB/pictures/Test/P1416.JPG

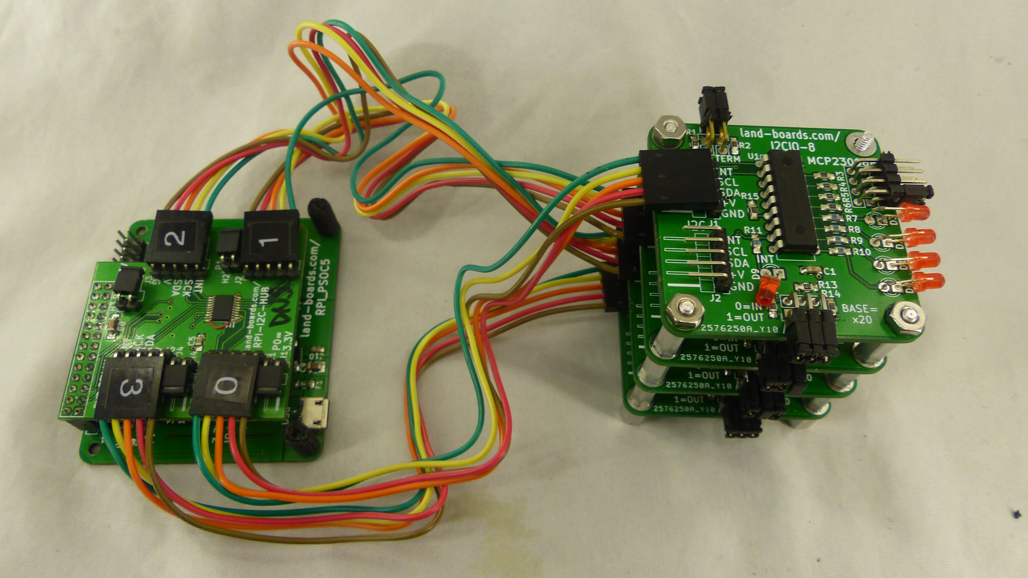
Raspberry Pi Cards/RPI-I2C-HUB/pictures/Test/P1416.JPG
