land-boards/lb-boards/Raspberry Pi Cards/RPI_SPI8/Pictures/Testing/LED_Testing/P1080083.JPG

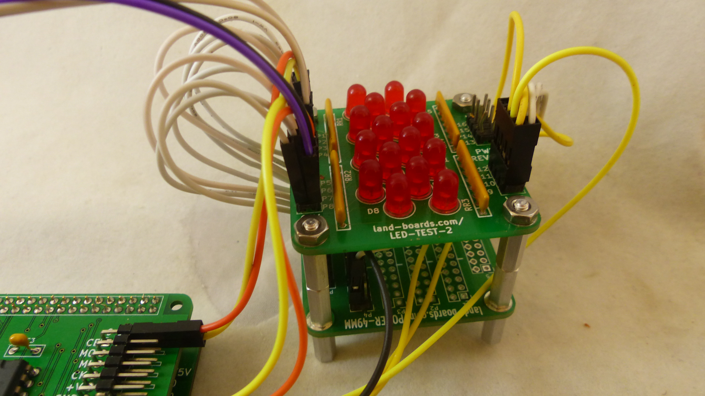
Raspberry Pi Cards/RPI_SPI8/Pictures/Testing/LED_Testing/P1080083.JPG
