land-boards/lb-boards/Raspberry Pi Cards/RPI_SPI8/Pictures/Testing/RASPI_TESTING/P1080094.JPG

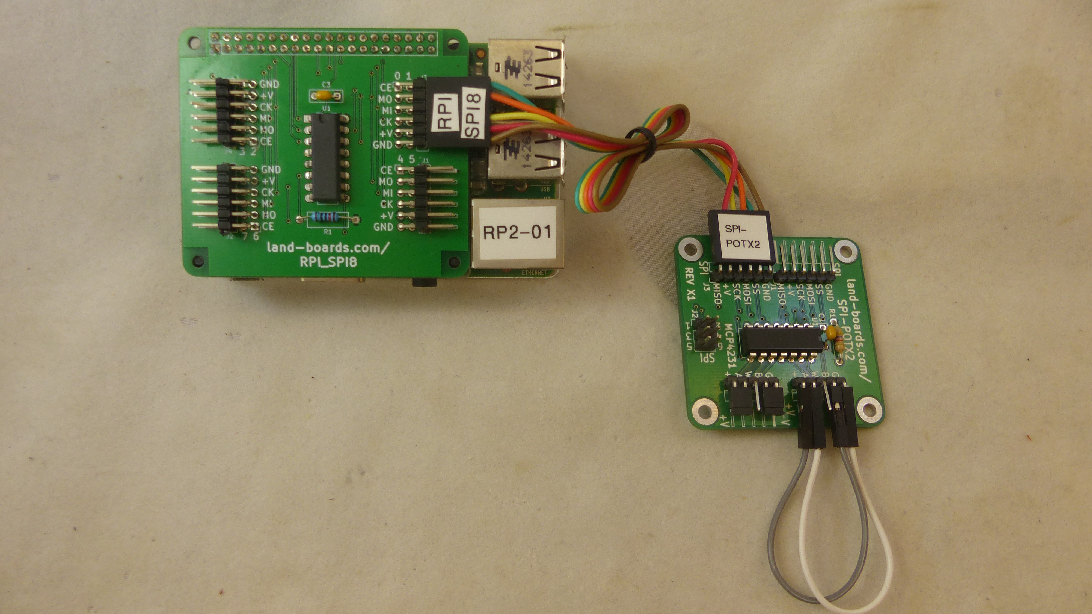
Raspberry Pi Cards/RPI_SPI8/Pictures/Testing/RASPI_TESTING/P1080094.JPG
