land-boards/lb-boards/Raspberry Pi Cards/RPI_SPI8/Pictures/Testing/RASPI_TESTING/P1080095.JPG

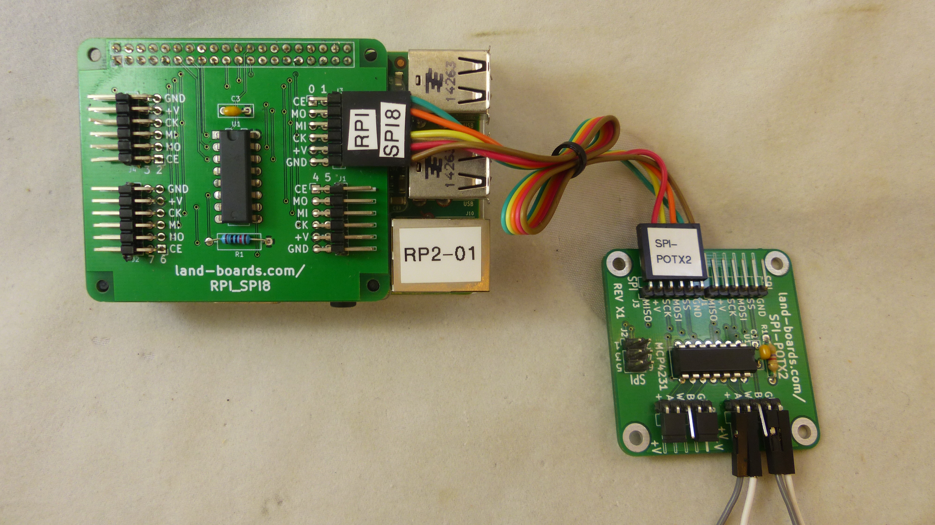
Raspberry Pi Cards/RPI_SPI8/Pictures/Testing/RASPI_TESTING/P1080095.JPG
