land-boards/lb-boards/Raspberry Pi Cards/RPPSOC/Pictures/Test/RPPSOC_TEST_P110153.JPG

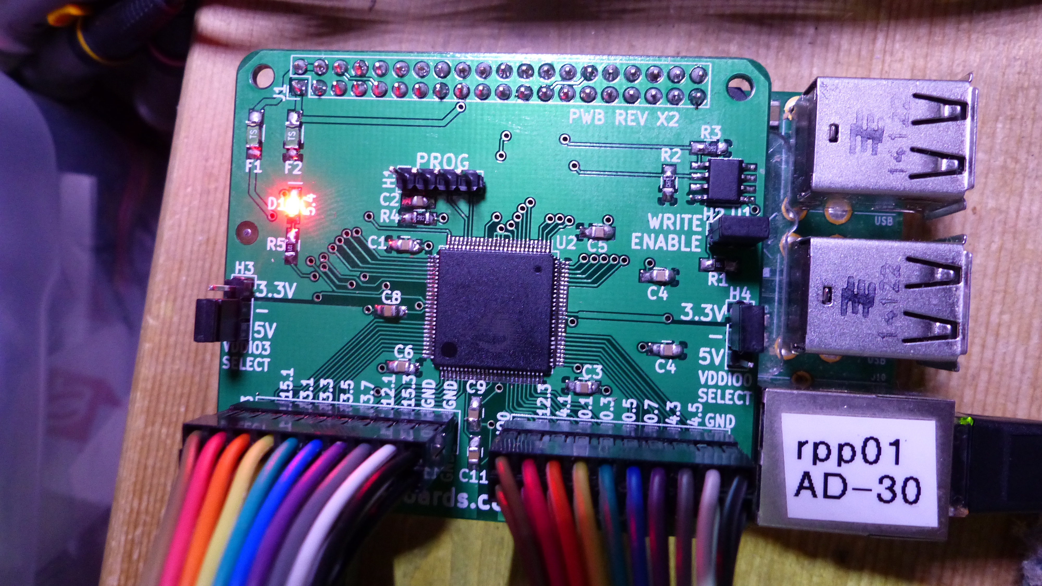
Raspberry Pi Cards/RPPSOC/Pictures/Test/RPPSOC_TEST_P110153.JPG
