land-boards/lb-boards/SYNTHS/ER-PROTO-02_SET/ER-PROTO-02_S-H/PICS/MEASURE/ER-LEVEL-SH_.SAM_CLK.png

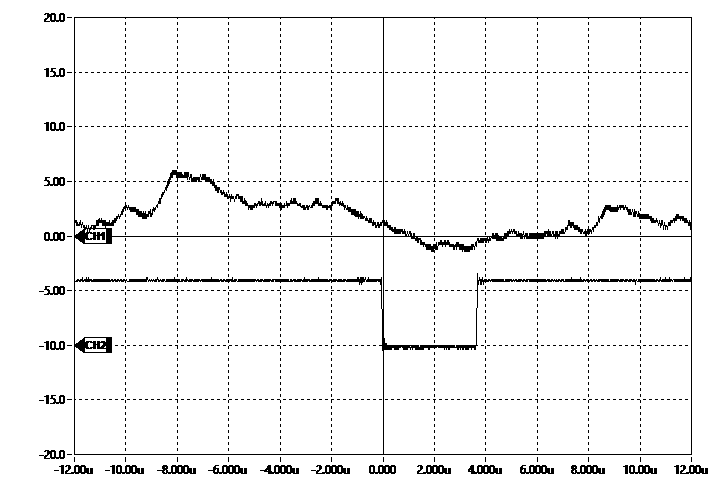
SYNTHS/ER-PROTO-02_SET/ER-PROTO-02_S-H/PICS/MEASURE/ER-LEVEL-SH_.SAM_CLK.png
