land-boards/lb-boards/SYNTHS/ER-PROTO-02_SET/ER-PROTO-02_S-H/PICS/MEASURE/ER-S-H_WHITE_SAMPLE.png

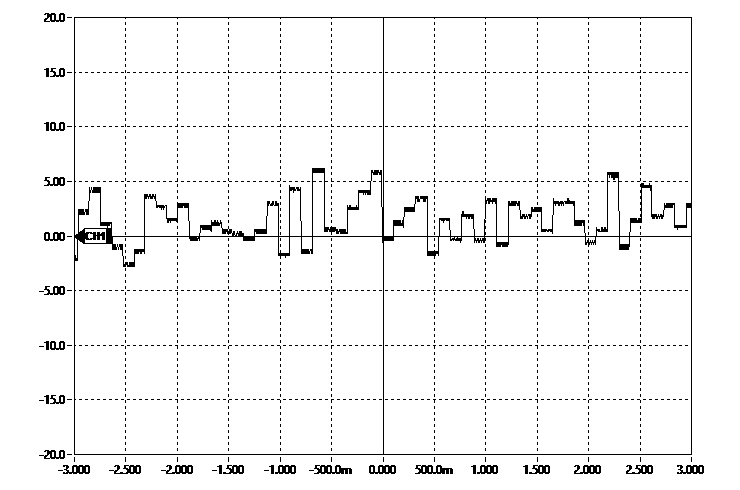
SYNTHS/ER-PROTO-02_SET/ER-PROTO-02_S-H/PICS/MEASURE/ER-S-H_WHITE_SAMPLE.png
