land-boards/lb-boards/Test Equipment Cards/DiffProbe/Pictures/CAD/DiffProbe-BothSides-X2bw.png

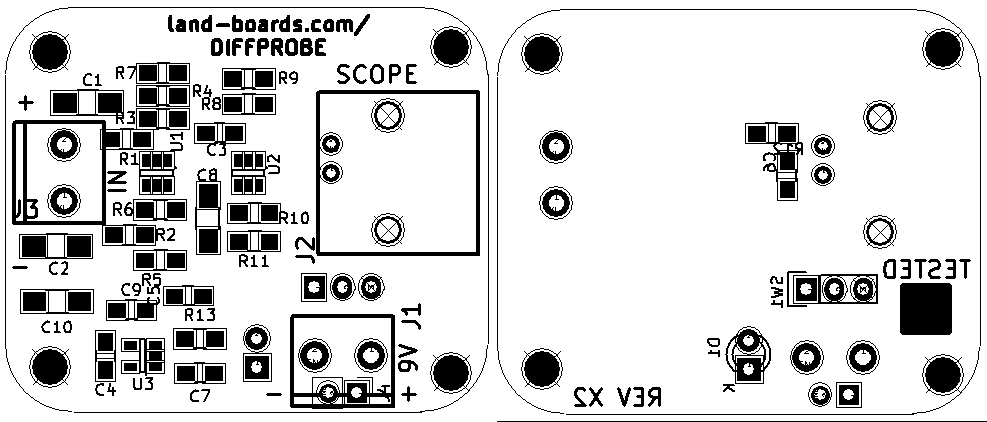
Test Equipment Cards/DiffProbe/Pictures/CAD/DiffProbe-BothSides-X2bw.png
