land-boards/lb-boards/Test Equipment Cards/DiffProbe/Pictures/CAD/X1/DiffProbe-Back.PNG

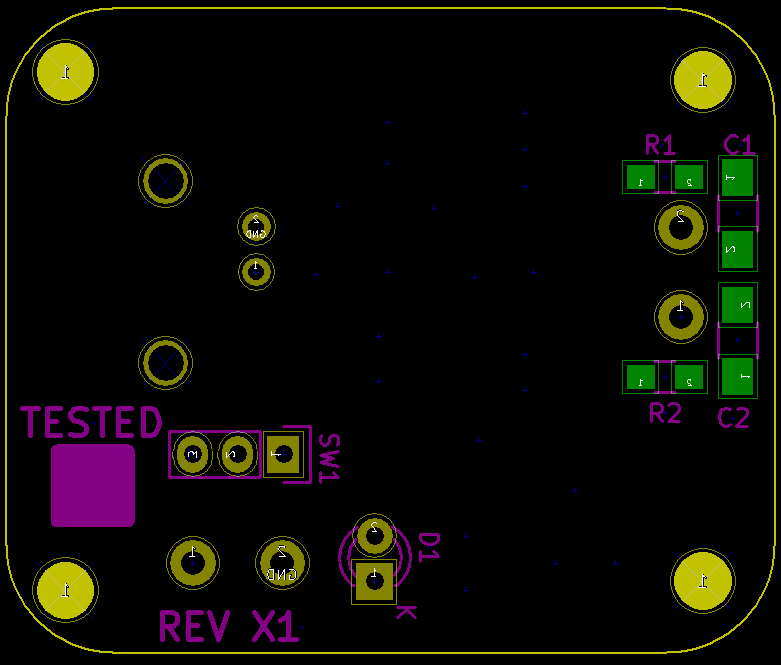
Test Equipment Cards/DiffProbe/Pictures/CAD/X1/DiffProbe-Back.PNG
