land-boards/lb-boards/Test Equipment Cards/DiffProbe/Pictures/DiffProbe.PNG

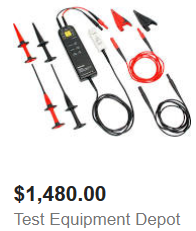
Test Equipment Cards/DiffProbe/Pictures/DiffProbe.PNG
