land-boards/lb-boards/Test Equipment Cards/DiffProbe/Pictures/DiffProbeCabled-4000px-P591.JPG

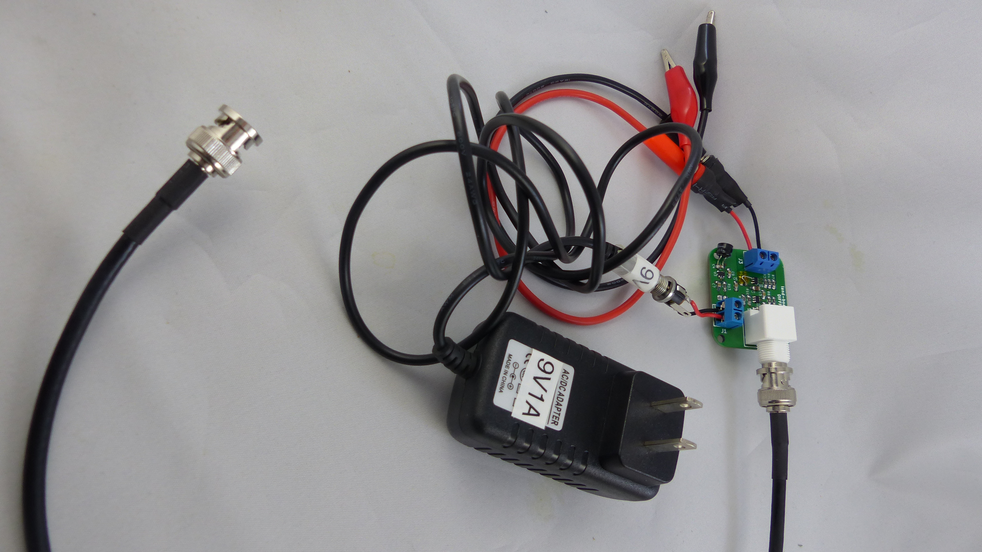
Test Equipment Cards/DiffProbe/Pictures/DiffProbeCabled-4000px-P591.JPG
