land-boards/lb-boards/Test Equipment Cards/DiffProbe/Pictures/DiffProbeX2-back.png

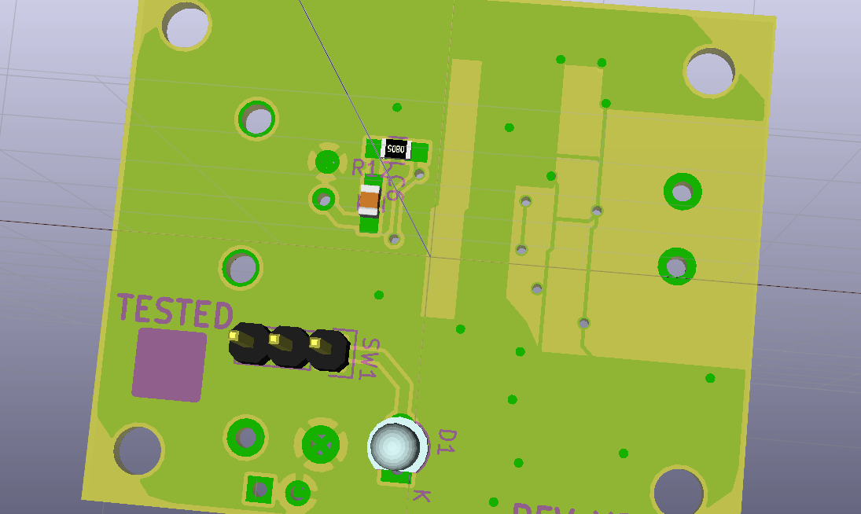
Test Equipment Cards/DiffProbe/Pictures/DiffProbeX2-back.png
