land-boards/lb-boards/Test Equipment Cards/DiffProbe/Pictures/ds1054z-grounds.jpg

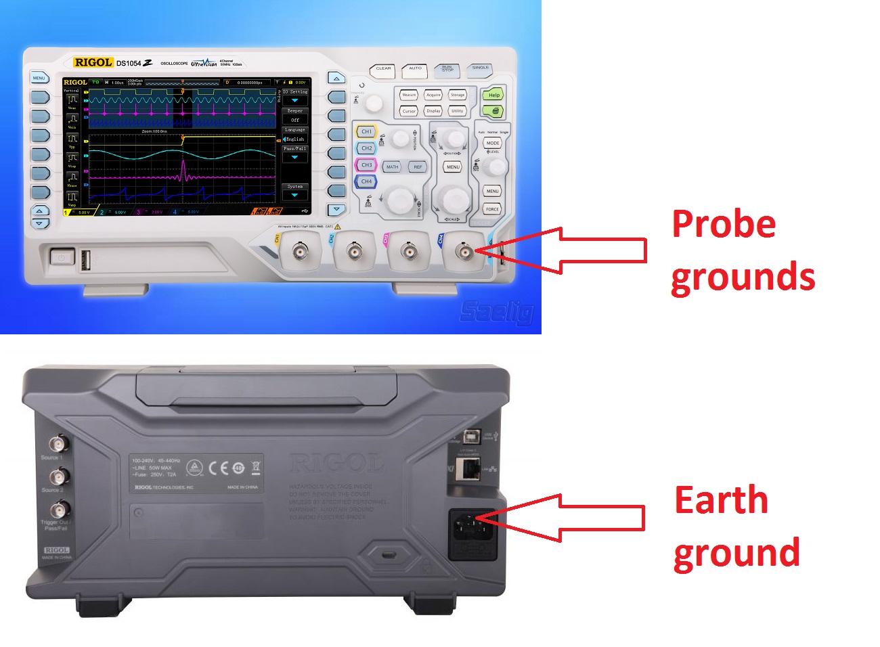
Test Equipment Cards/DiffProbe/Pictures/ds1054z-grounds.jpg
