land-boards/lb-boards/Test Equipment Cards/DiffProbe/Pictures/GimmickCap.PNG

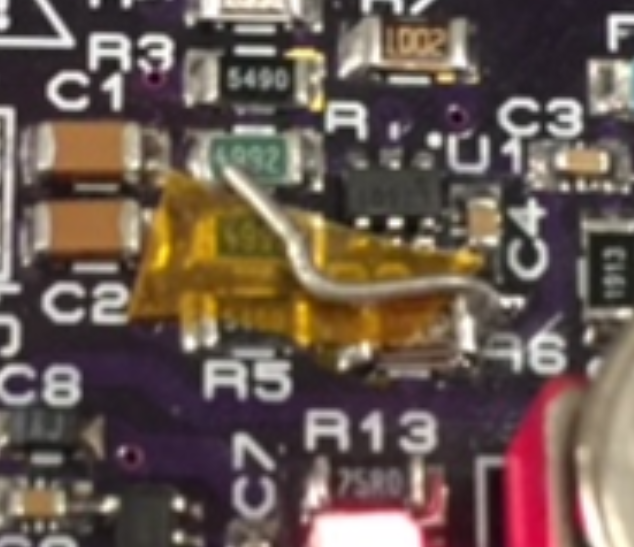
Test Equipment Cards/DiffProbe/Pictures/GimmickCap.PNG
