land-boards/lb-boards/Test Equipment Cards/DiffProbe/Pictures/LTC6268-10_isoSPI_DiffAmp.png

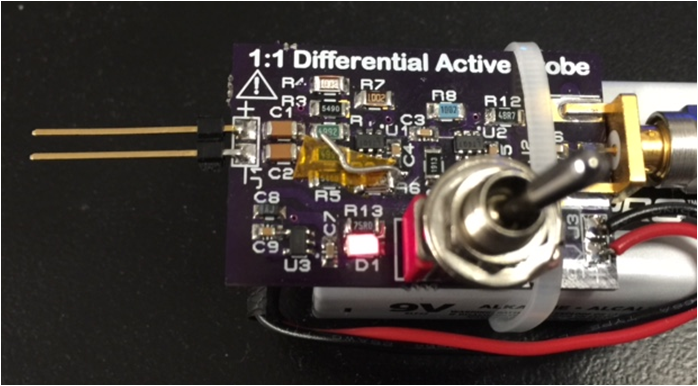
Test Equipment Cards/DiffProbe/Pictures/LTC6268-10_isoSPI_DiffAmp.png
