land-boards/lb-boards/Test Equipment Cards/DiffProbe/Pictures/PWB/P1070438.JPG

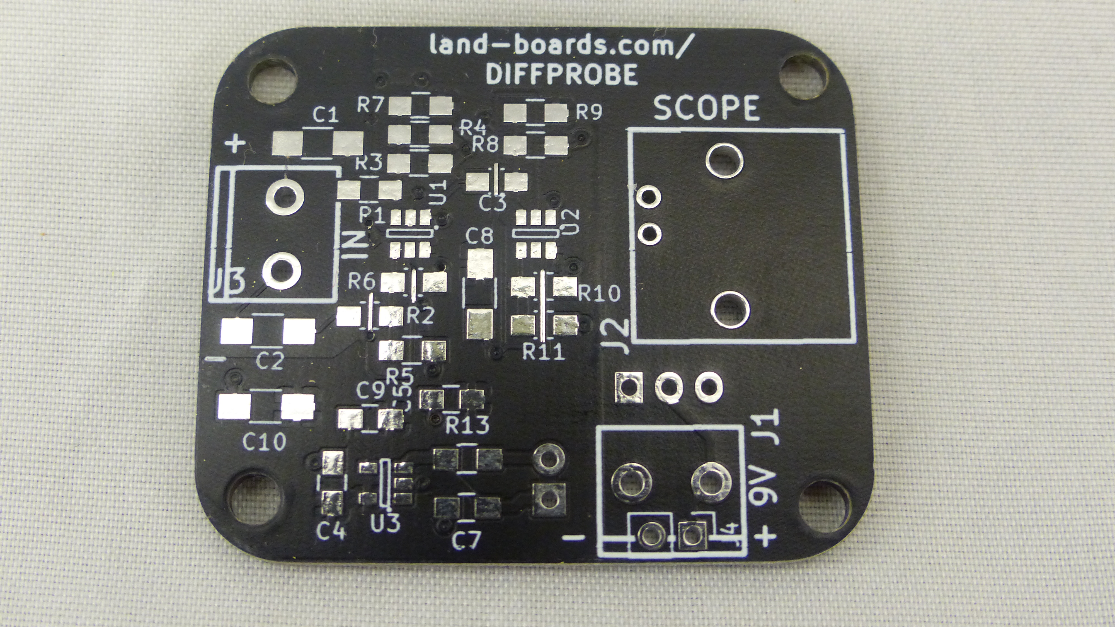
Test Equipment Cards/DiffProbe/Pictures/PWB/P1070438.JPG
