land-boards/lb-boards/Test Equipment Cards/DiffProbe/Pictures/ScopeScreenCaps/DiffProbe-X2sine1MHz200mV.bmp

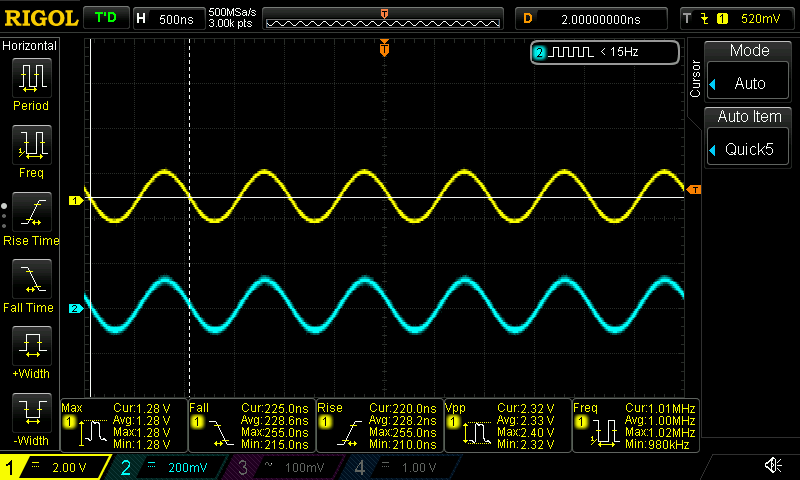
Test Equipment Cards/DiffProbe/Pictures/ScopeScreenCaps/DiffProbe-X2sine1MHz200mV.bmp
