land-boards/lb-boards/Test Equipment Cards/DiffProbe/Pictures/ScopeScreenCaps/DiffProbe-X2square1MHz200mV.bmp

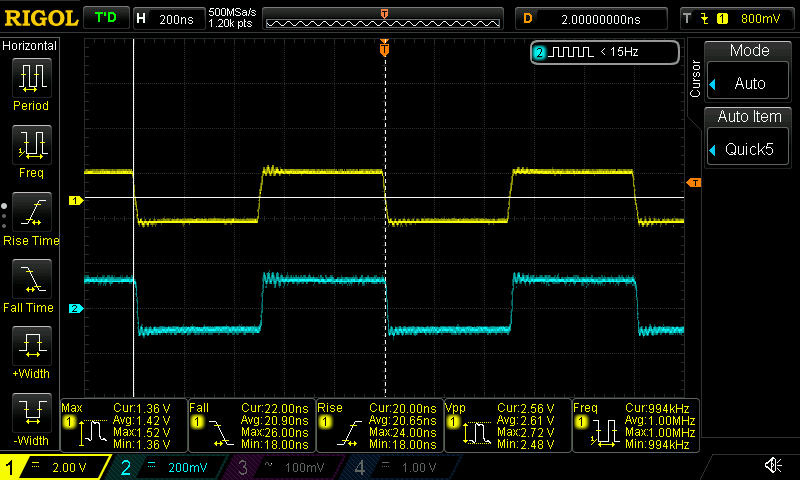
Test Equipment Cards/DiffProbe/Pictures/ScopeScreenCaps/DiffProbe-X2square1MHz200mV.bmp
