land-boards/lb-boards/Test Equipment Cards/DiffProbe/Pictures/ScopeScreenCaps/DiffProbe-X2square100KHz200mV-risingEdge.bmp

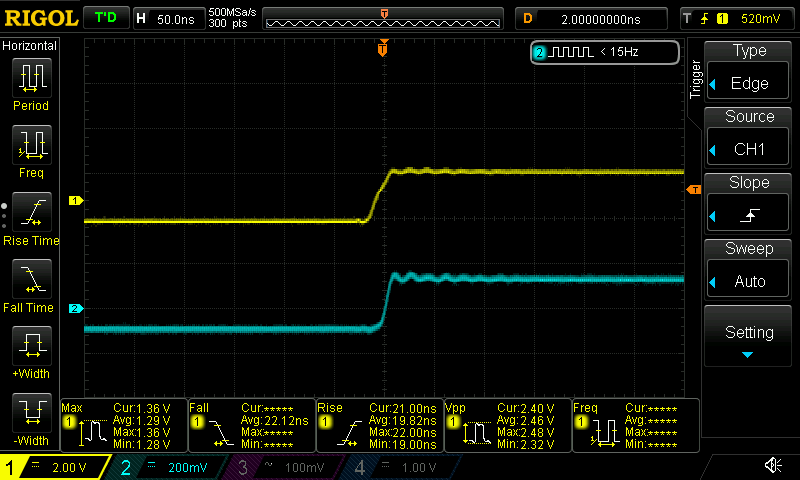
Test Equipment Cards/DiffProbe/Pictures/ScopeScreenCaps/DiffProbe-X2square100KHz200mV-risingEdge.bmp
