land-boards/lb-boards/Test Equipment Cards/DiffProbe/Pictures/ScopeScreenCaps/P1010671.JPG

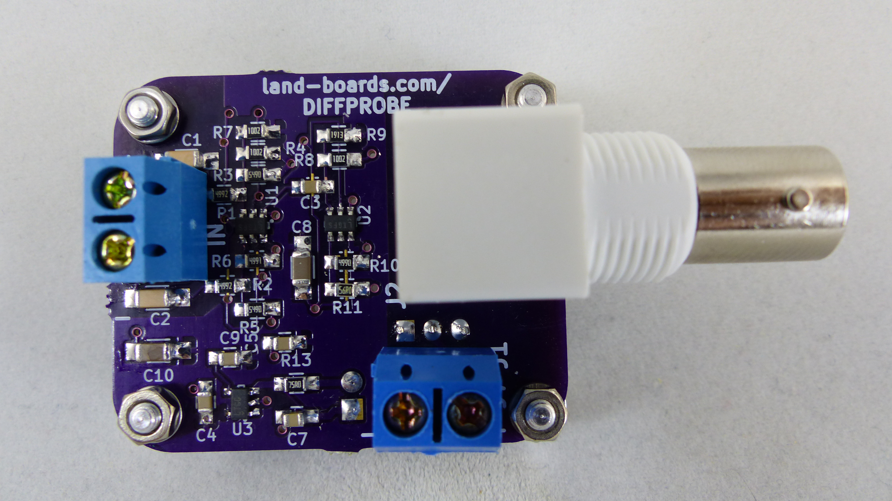
Test Equipment Cards/DiffProbe/Pictures/ScopeScreenCaps/P1010671.JPG
