land-boards/lb-boards/Test Equipment Cards/DiffProbe/Pictures/ScopeScreenCaps/P1010676.JPG

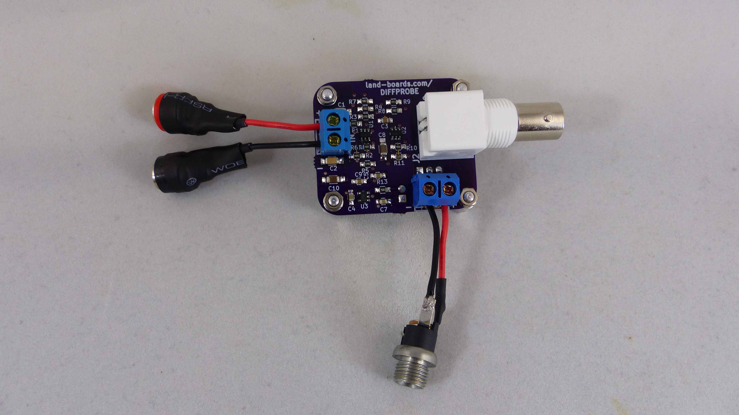
Test Equipment Cards/DiffProbe/Pictures/ScopeScreenCaps/P1010676.JPG
