land-boards/lb-boards/Test Equipment Cards/FTDIBkout/Pictures/FTDIBkout-X1-P619-4000px.JPG

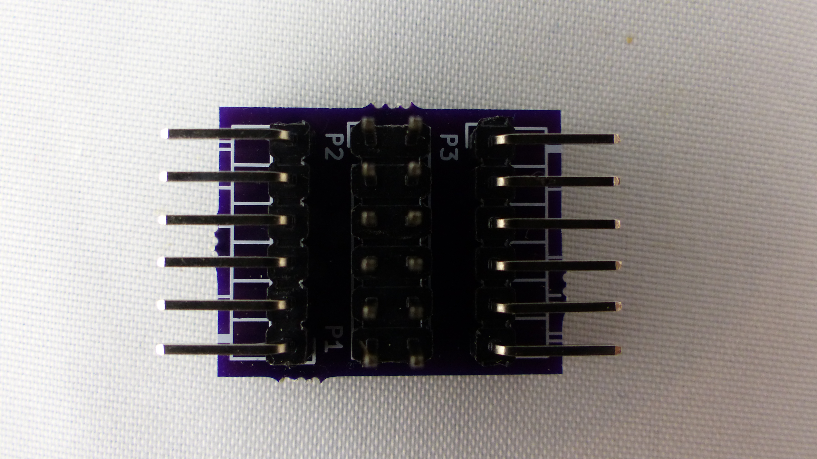
Test Equipment Cards/FTDIBkout/Pictures/FTDIBkout-X1-P619-4000px.JPG
