land-boards/lb-boards/Test Equipment Cards/FTDIBkout/Pictures/P1010620.JPG

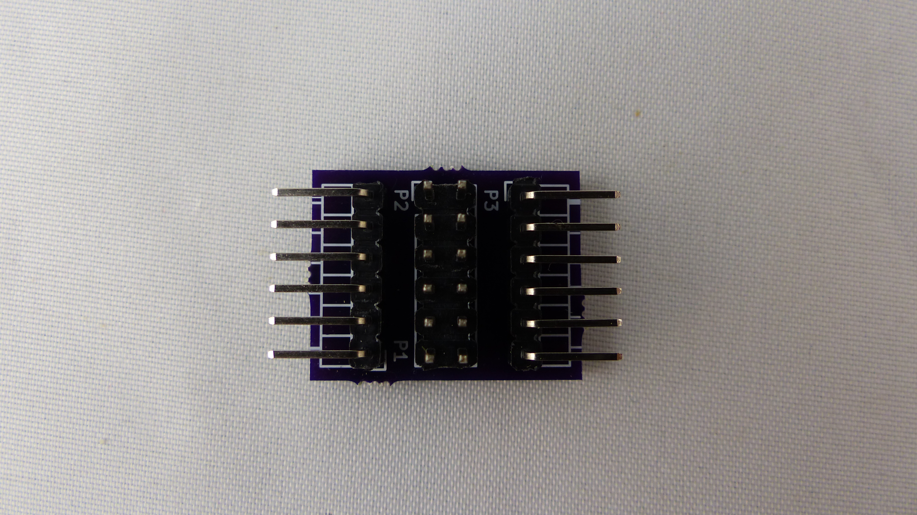
Test Equipment Cards/FTDIBkout/Pictures/P1010620.JPG
