land-boards/lb-boards/Test Equipment Cards/FTDIBkout/Pictures/Rev X0/FTDIBkout-4000px-P573.JPG

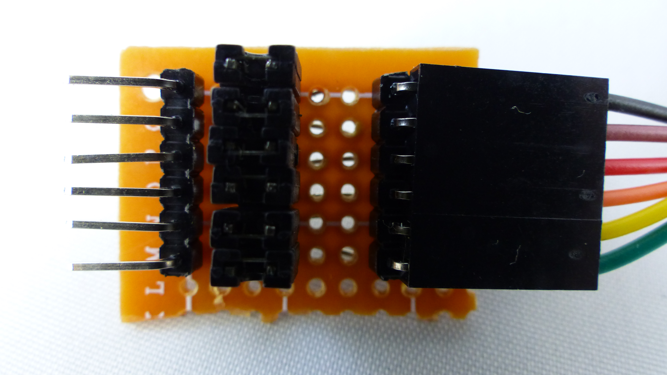
Test Equipment Cards/FTDIBkout/Pictures/Rev X0/FTDIBkout-4000px-P573.JPG
