land-boards/lb-boards/Test Equipment Cards/LogicProbe/pictures/CCAs/RPI-CONSOLE-U-MTD-PI-ORTHO-X1_6013-320px.jpg

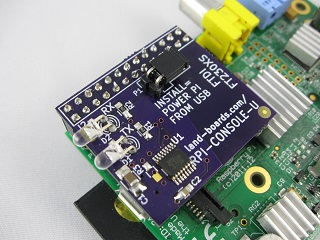
Test Equipment Cards/LogicProbe/pictures/CCAs/RPI-CONSOLE-U-MTD-PI-ORTHO-X1_6013-320px.jpg
