land-boards/lb-boards/Test Equipment Cards/LogicProbe/pictures/CCAs/RPI-CONSOLE-U-ORTHO-X1__6011-320px.jpg

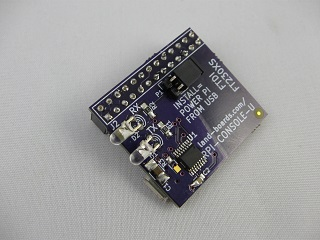
Test Equipment Cards/LogicProbe/pictures/CCAs/RPI-CONSOLE-U-ORTHO-X1__6011-320px.jpg
