land-boards/lb-boards/Test Equipment Cards/TinyOptoProbe/Pictures/RevX1/P1010726.JPG

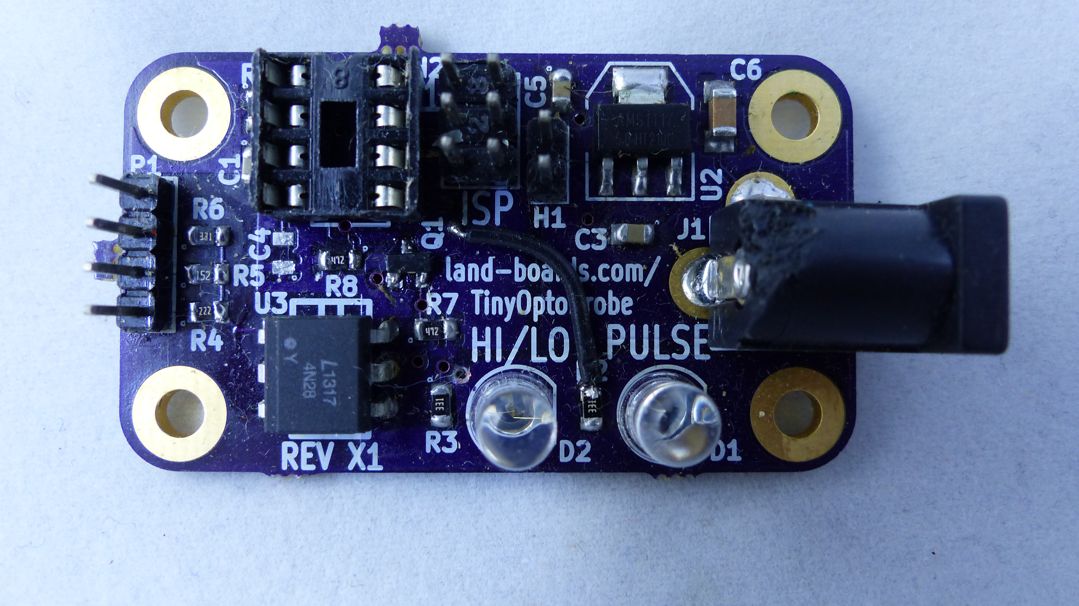
Test Equipment Cards/TinyOptoProbe/Pictures/RevX1/P1010726.JPG
