land-boards/lb-boards/Test Equipment Cards/TinyOptoProbe/Pictures/RevX2/TinyOptoProbe-X2-PWB-H2-Header.png

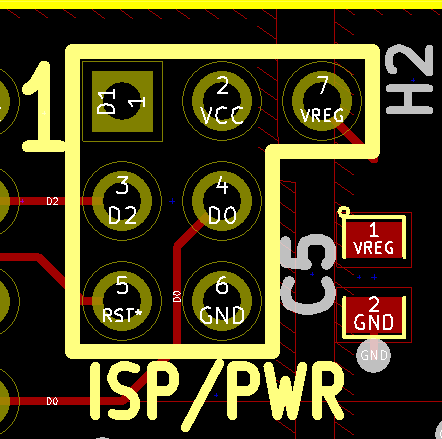
Test Equipment Cards/TinyOptoProbe/Pictures/RevX2/TinyOptoProbe-X2-PWB-H2-Header.png
