land-boards/lb-boards/Test Equipment Cards/TinyOptoProbe/Pictures/RevX2/TinyOptoProbe-X2-PWB-Layers-Kicad.png

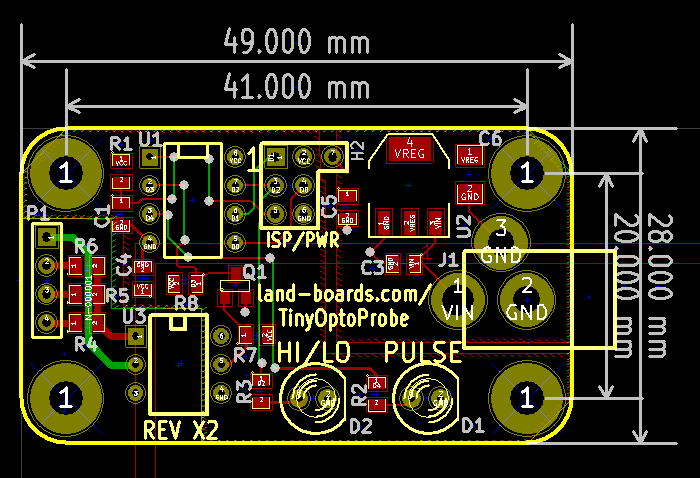
Test Equipment Cards/TinyOptoProbe/Pictures/RevX2/TinyOptoProbe-X2-PWB-Layers-Kicad.png
