land-boards/lb-boards/Test Equipment Cards/TinyOptoProbe/Pictures/RevX2/TinyOptoProbe-X3-CCA-1600px.JPG

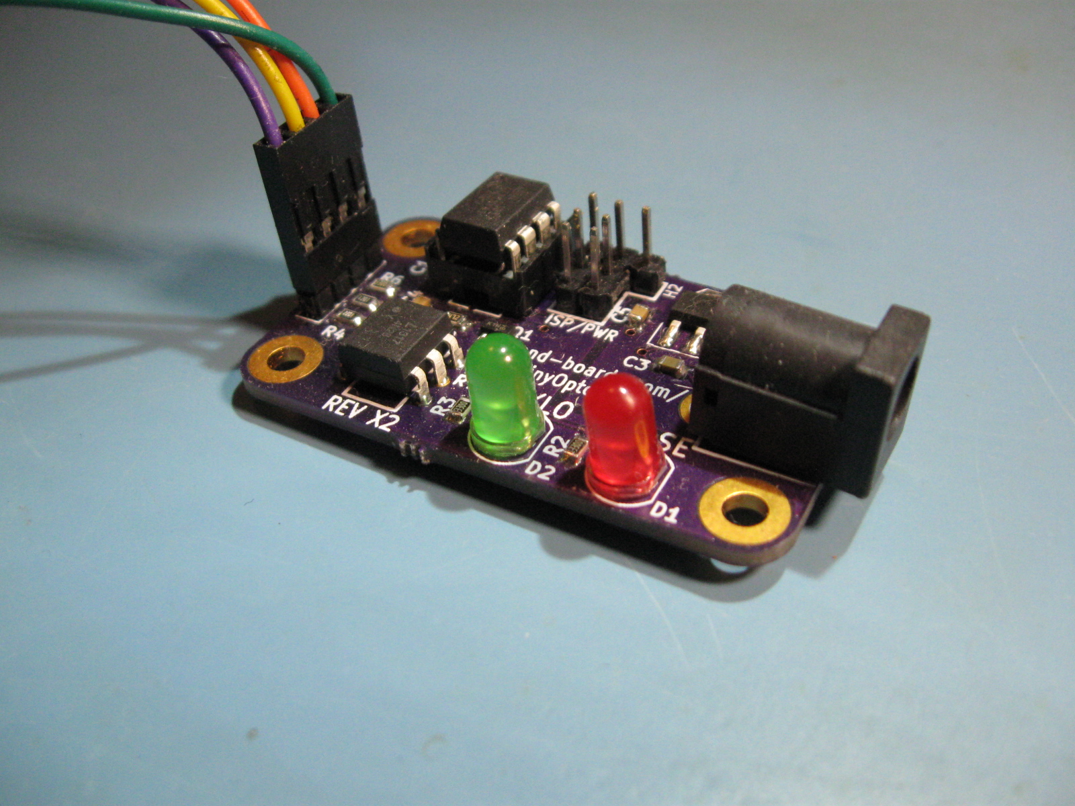
Test Equipment Cards/TinyOptoProbe/Pictures/RevX2/TinyOptoProbe-X3-CCA-1600px.JPG
