land-boards/lb-boards/TestProject/RPI_TESR/pics/CAD/Raspberri_Pi_Color_CAD.PNG

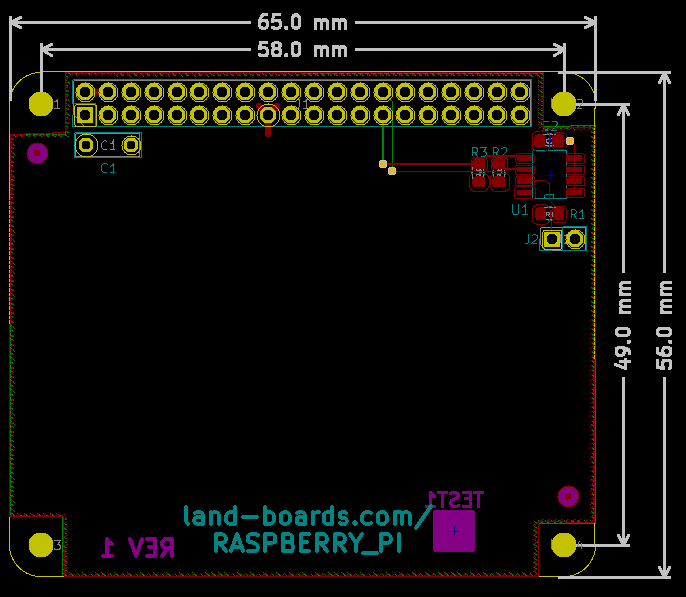
TestProject/RPI_TESR/pics/CAD/Raspberri_Pi_Color_CAD.PNG
