land-boards/lb-boards/Raspberry Pi Cards/RPPSOC/PSOC-SPI/PSOC-SPI/PSOC-SPI.cydsn/CortexM3/ARM_GCC_493/Debug/LINK_options.txt

-Wl,--start-group -o ".\\CortexM3\\ARM_GCC_493\\Debug\\PSOC-SPI.elf" ".\\CortexM3\\ARM_GCC_493\\Debug\\main.o" ".\\CortexM3\\ARM_GCC_493\\Debug\\cymetadata.o" ".\\CortexM3\\ARM_GCC_493\\Debug\\Cm3Start.o" ".\\CortexM3\\ARM_GCC_493\\Debug\\PSOC-SPI.a" "C:\\Program\ Files\ (x86)\\Cypress\\PSoC\ Creator\\3.3\\PSoC\ Creator\\psoc\\content\\cycomponentlibrary\\CyComponentLibrary.cylib\\CortexM3\\ARM_GCC_493\\Debug\\CyComponentLibrary.a" -mcpu=cortex-m3 -mthumb -g -ffunction-sections -Og -L "Generated_Source\\PSoC5" "-Wl,-Map,.\\CortexM3\\ARM_GCC_493\\Debug/PSOC-SPI.map" -T "Generated_Source\\PSoC5\\cm3gcc.ld" -specs=nano.specs -Wl,--gc-sections -Wl,--end-group
