land-boards/lb-boards/I2C Cards/I2C-RPT-01/pictures/CAD/I2C-RPT-01-X2_Changes.png

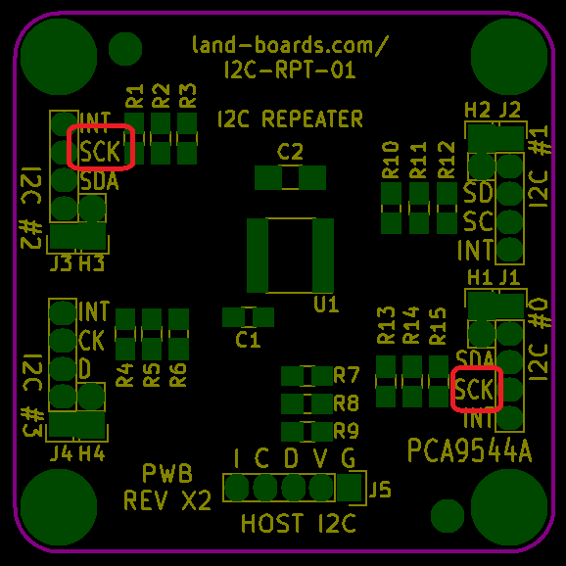
I2C Cards/I2C-RPT-01/pictures/CAD/I2C-RPT-01-X2_Changes.png
