land-boards/lb-boards/RetroCPUs/LB-RETRO-SET/LB-6809-01/Pics/Debug/LB6809_Loop_Trigger.png

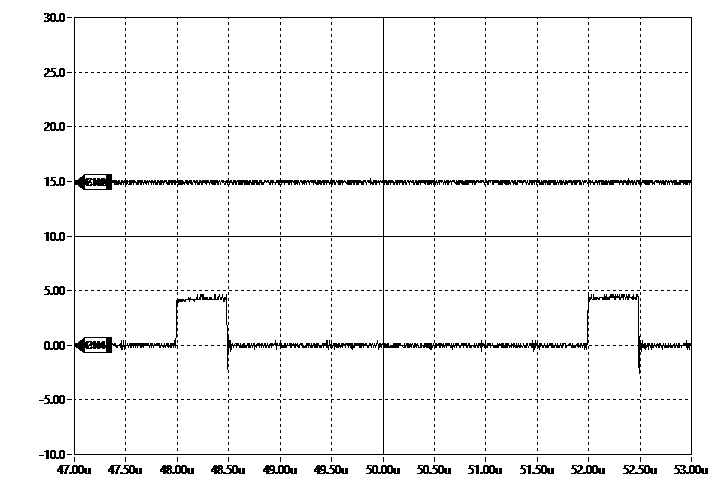
RetroCPUs/LB-RETRO-SET/LB-6809-01/Pics/Debug/LB6809_Loop_Trigger.png
