land-boards/lb-boards/RetroCPUs/SIMPLE-6502/Pics/DEBUG/SIMPLE-6502_RESET-FALLING.png

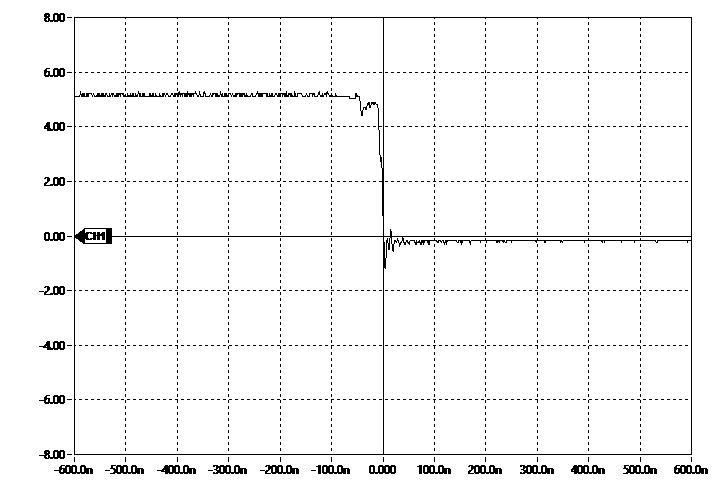
RetroCPUs/SIMPLE-6502/Pics/DEBUG/SIMPLE-6502_RESET-FALLING.png
