land-boards/lb-boards/RetroCPUs/SIMPLE-6502/Pics/DEBUG/SIMPLE-6502_TL866Plus_Program.png

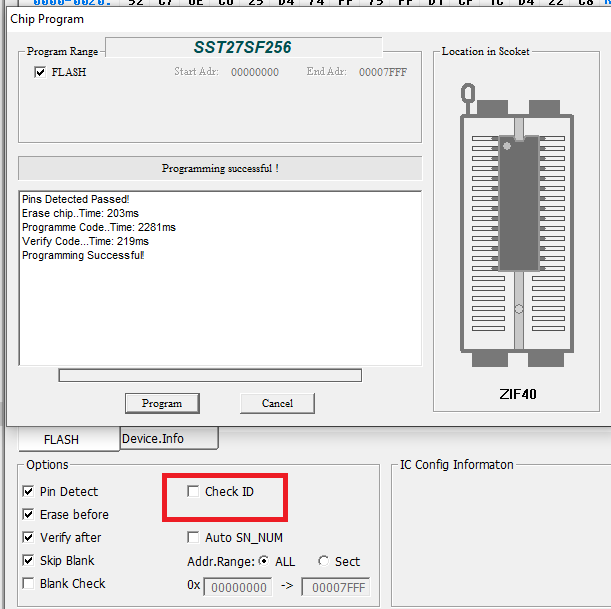
RetroCPUs/SIMPLE-6502/Pics/DEBUG/SIMPLE-6502_TL866Plus_Program.png
