land-boards/lb-boards/RetroCPUs/SIMPLE-6809/Pics/DEBUG/SIMPLE-6809_BASIC_DISPLAY.PNG

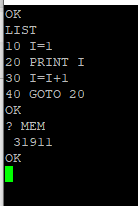
RetroCPUs/SIMPLE-6809/Pics/DEBUG/SIMPLE-6809_BASIC_DISPLAY.PNG
