land-boards/lb-boards/SYNTHS/ER-ADSR-555-01_SET/DOCS/DEBUG/ER-ADSR-555_CAP_003.png

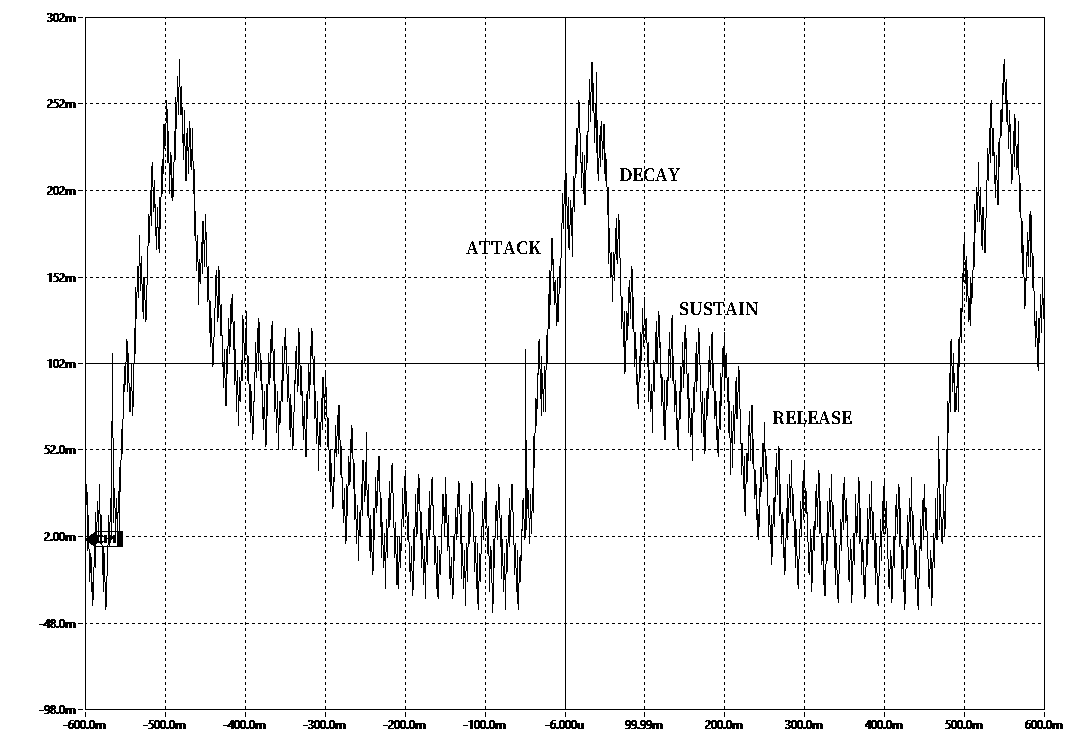
SYNTHS/ER-ADSR-555-01_SET/DOCS/DEBUG/ER-ADSR-555_CAP_003.png
