land-boards/lb-boards/SYNTHS/ER-ADSR-555-01_SET/DOCS/DEBUG/ER-ADSR-555_CAP_004.png

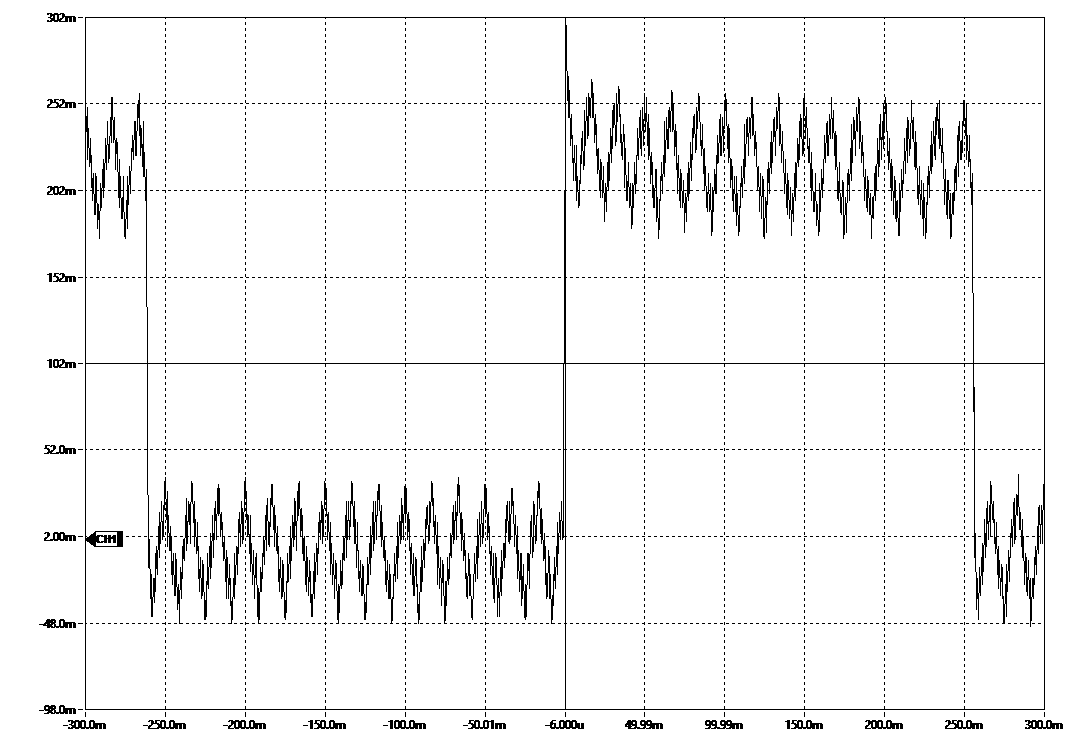
SYNTHS/ER-ADSR-555-01_SET/DOCS/DEBUG/ER-ADSR-555_CAP_004.png
