land-boards/lb-boards/SYNTHS/ER-ADSR-555-01_SET/ER-ADSR-555-01-controls/Pics/DEBUG/Rev2/ER-DELAY-01_C1-R6-Base-Voltage.png

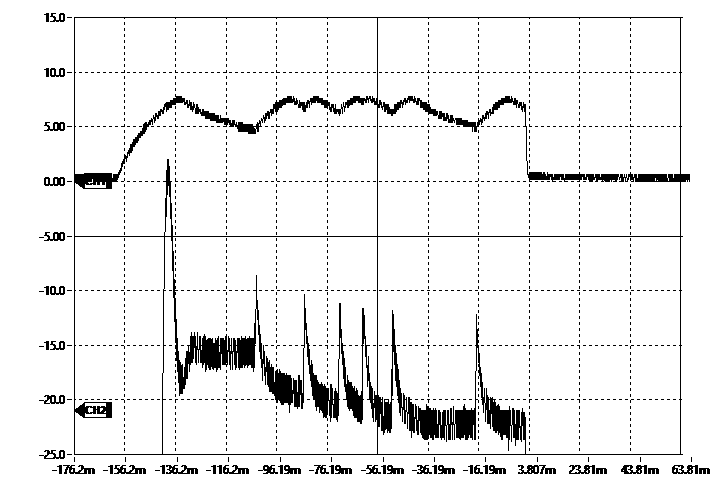
SYNTHS/ER-ADSR-555-01_SET/ER-ADSR-555-01-controls/Pics/DEBUG/Rev2/ER-DELAY-01_C1-R6-Base-Voltage.png
