land-boards/lb-boards/(threads)

Thread 1 (2019-10-28):

M29F400T

piotr433, 2019-10-28:
M29F400T in the KICAD/st-microelectronics.lib - swapped pins A15 and A-1/D15
