land-boards/lb-boards/Projects/RadioDesign/ubitxv6.pdf

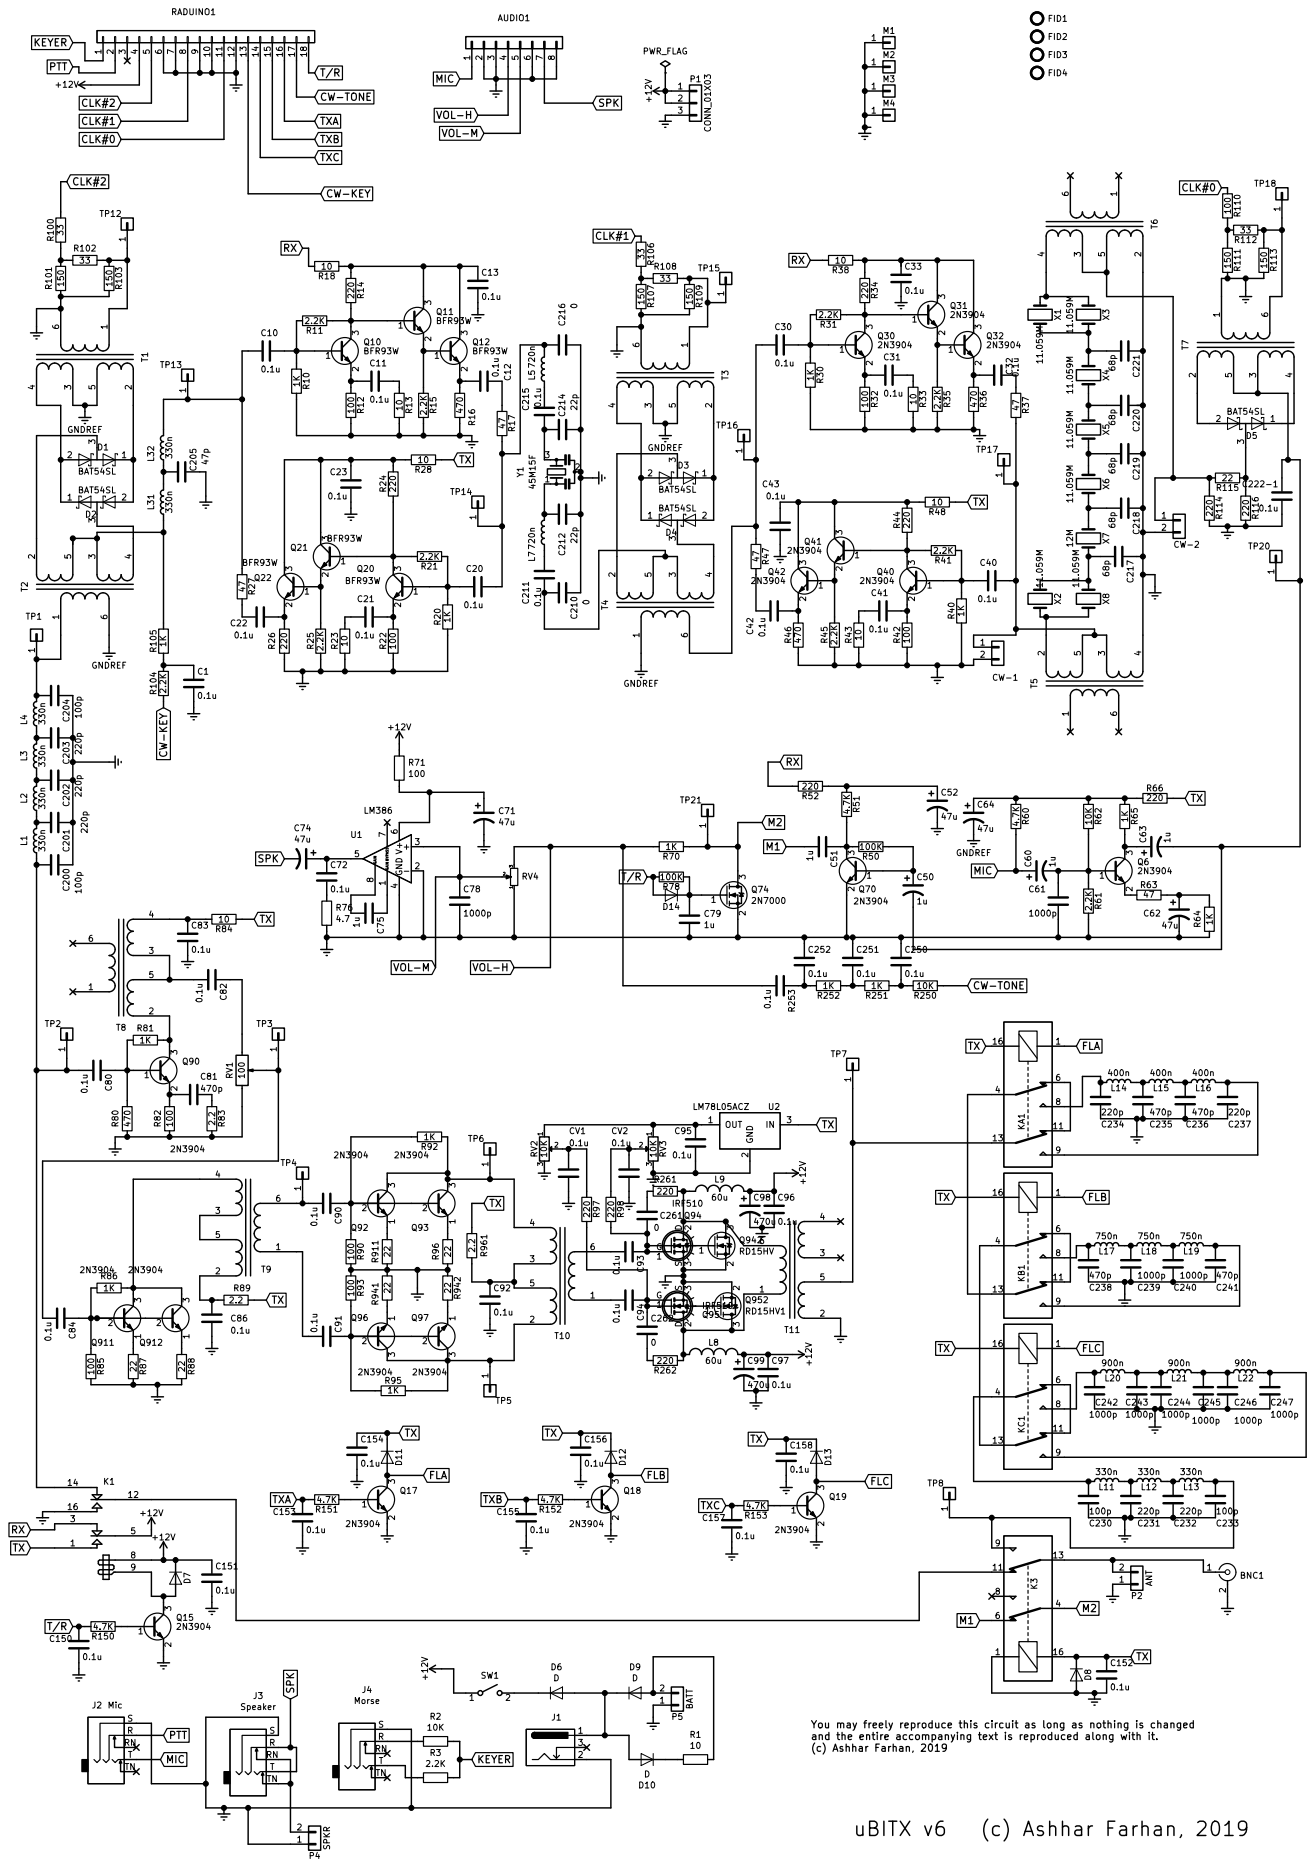
[picture p491: page 1]

You may freely reproduce this circuit as long as nothing is changed
and the entire accompanying text is reproduced along with it.
(c) Ashhar Farhan, 2019
