land-boards/lb-boards/ESP32/ESP32-TERM/ESP32-TERM_SCHEMATIC_REV1.pdf

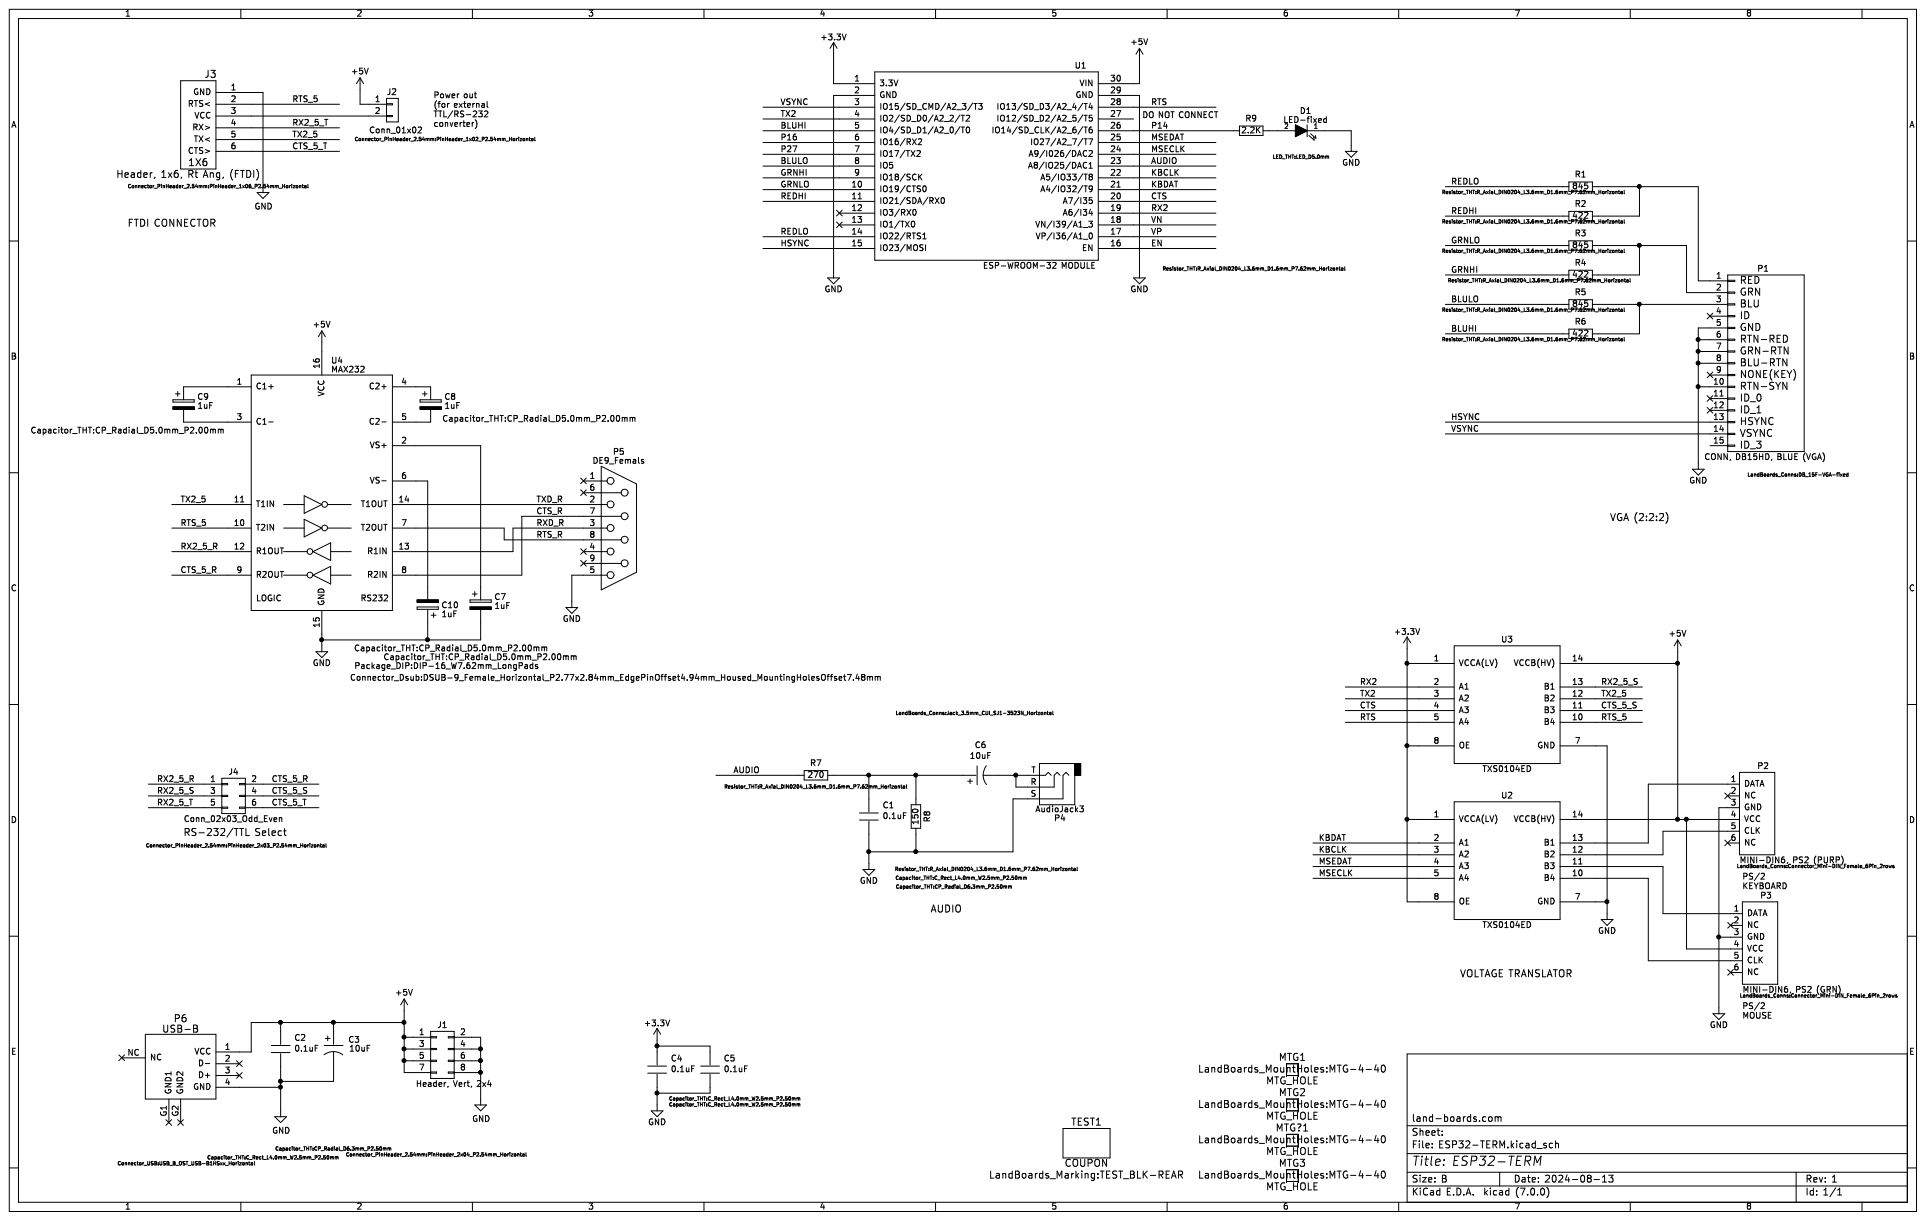
[picture p492: page 1]
