land-boards/lb-boards/RetroCPUs/SIMPLE-68008/SIMPLE-68008_Rev1_Schematic.pdf

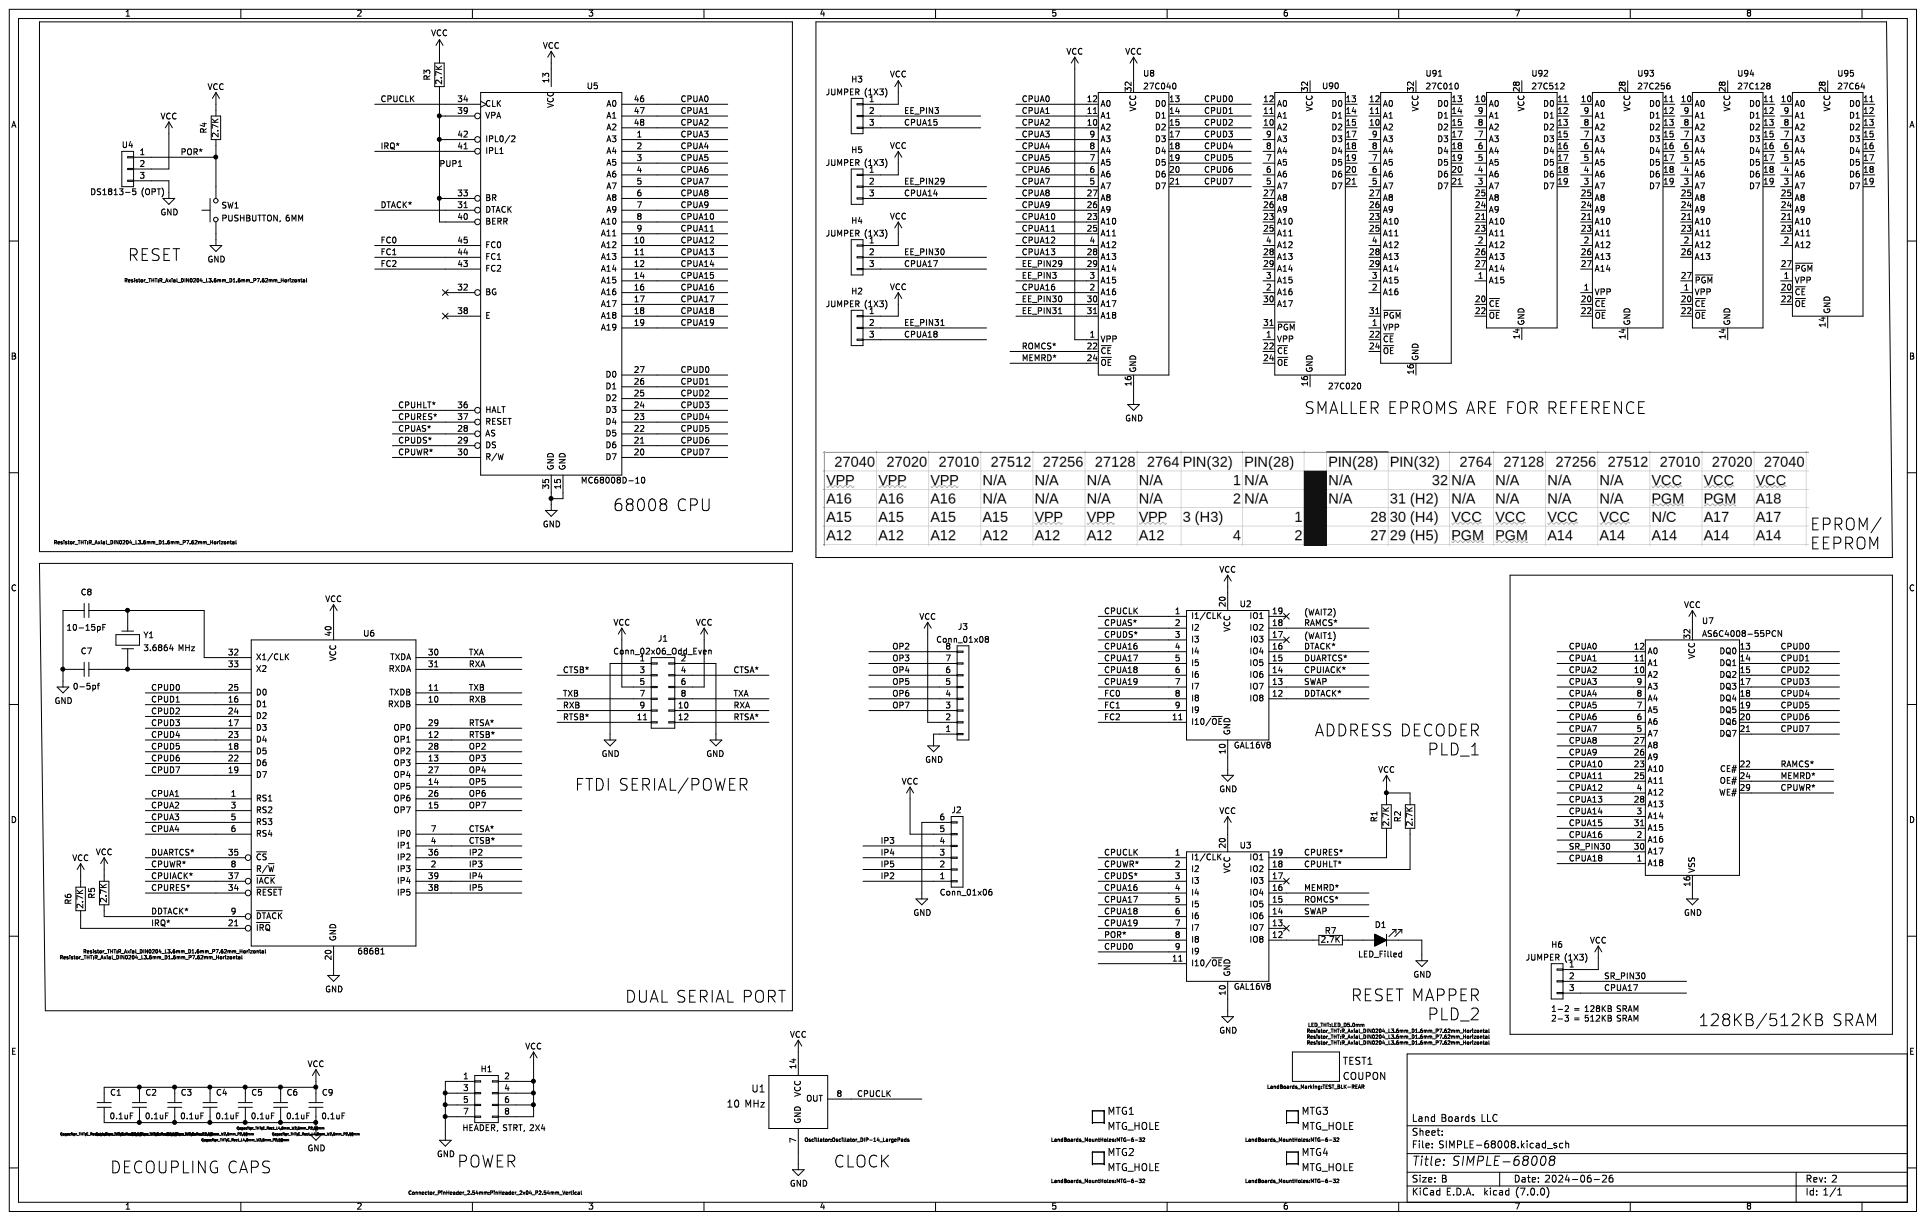
[picture p493: page 1]
