land-boards/lb-boards/SYNTHS/ER-VCO-03_SET/ER-VCO-03_REV1_Schematic.pdf

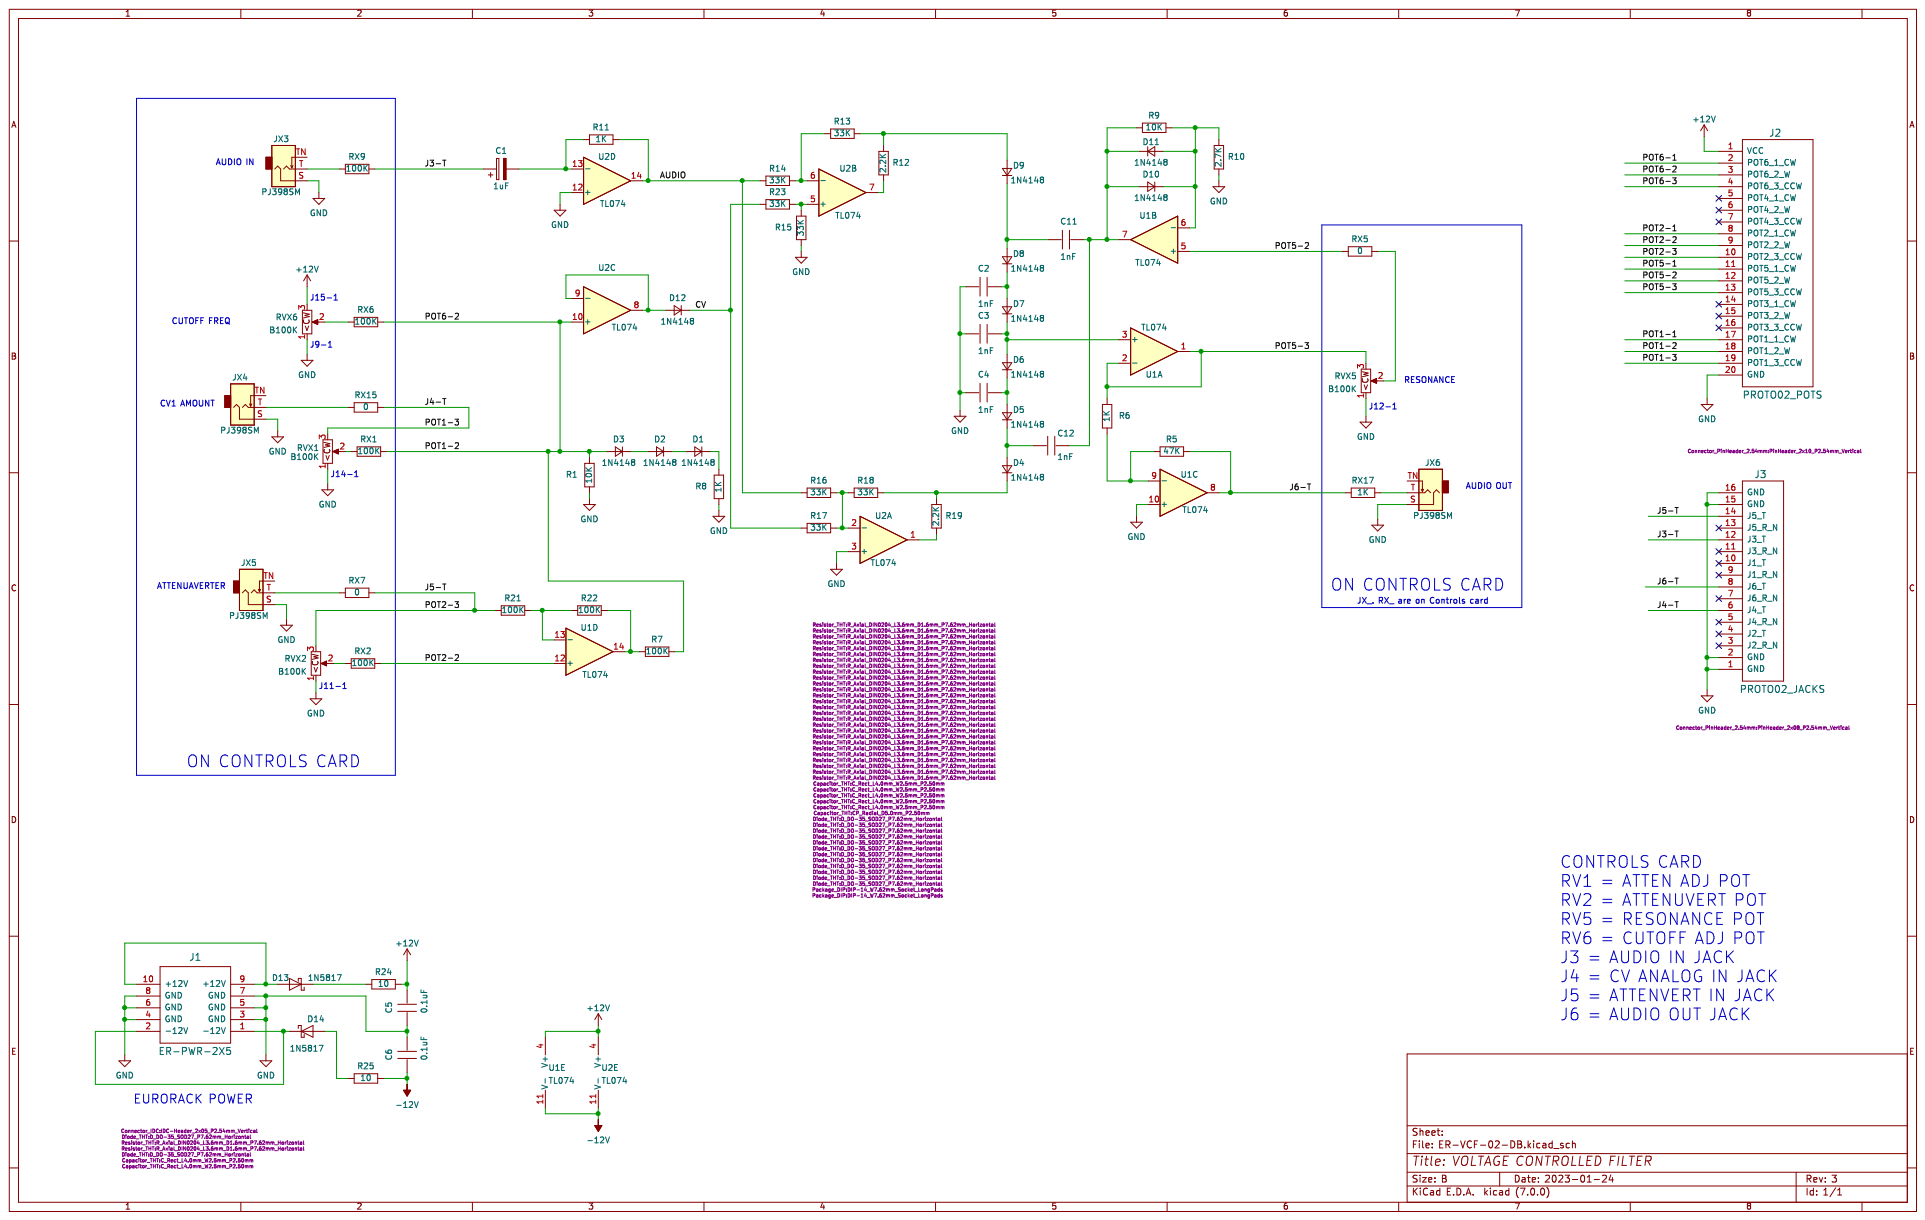
[picture p494: page 1]
