land-boards/lb-boards/SYNTHS/ER-VCF-02_SET/ER-VCF-02_REV1_Schematic.pdf

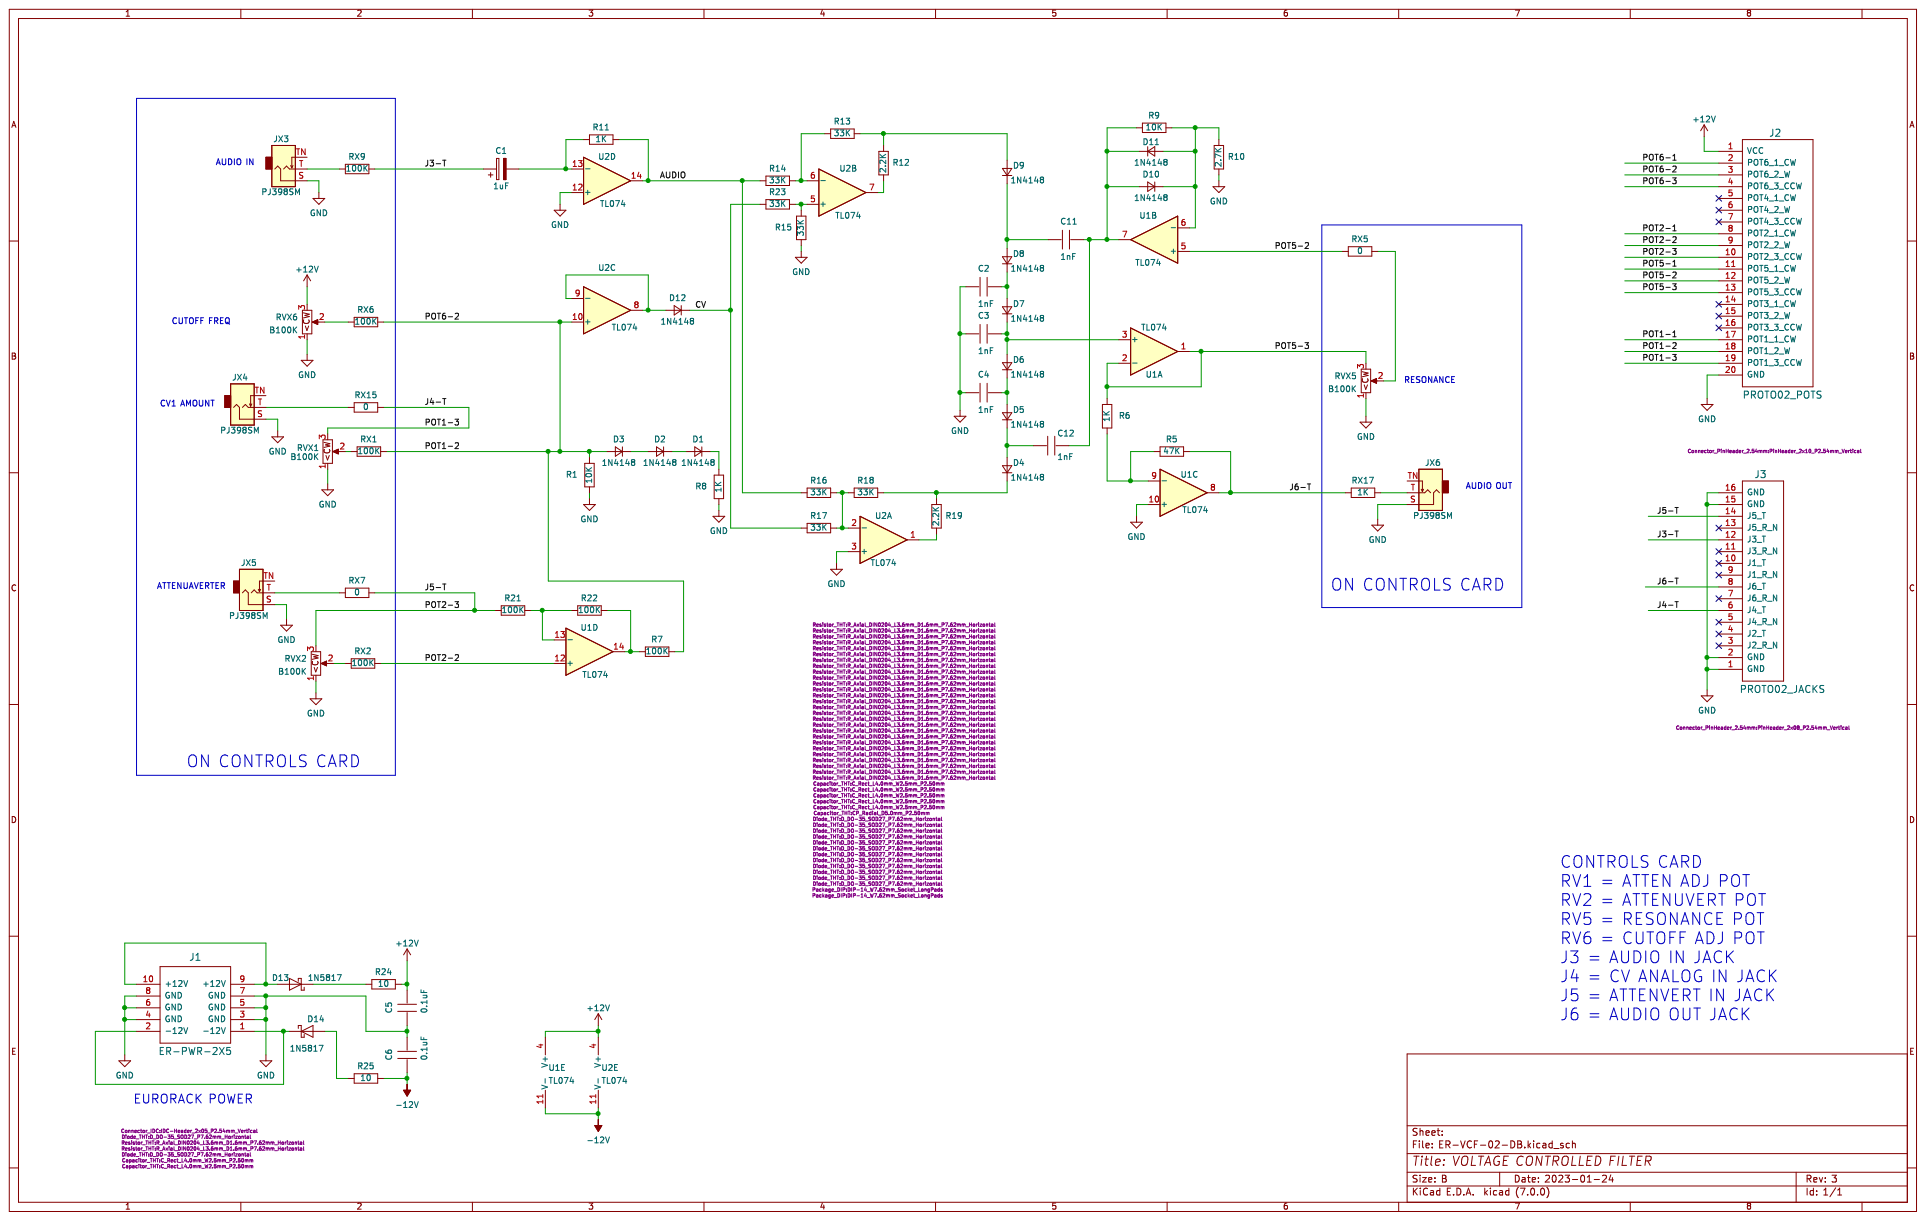
[picture p495: page 1]
