land-boards/lb-boards/SYNTHS/SYNTH-MIDI-CV4-01/SYNTH-MIDI-CV4-01_REV1_Schematic.pdf

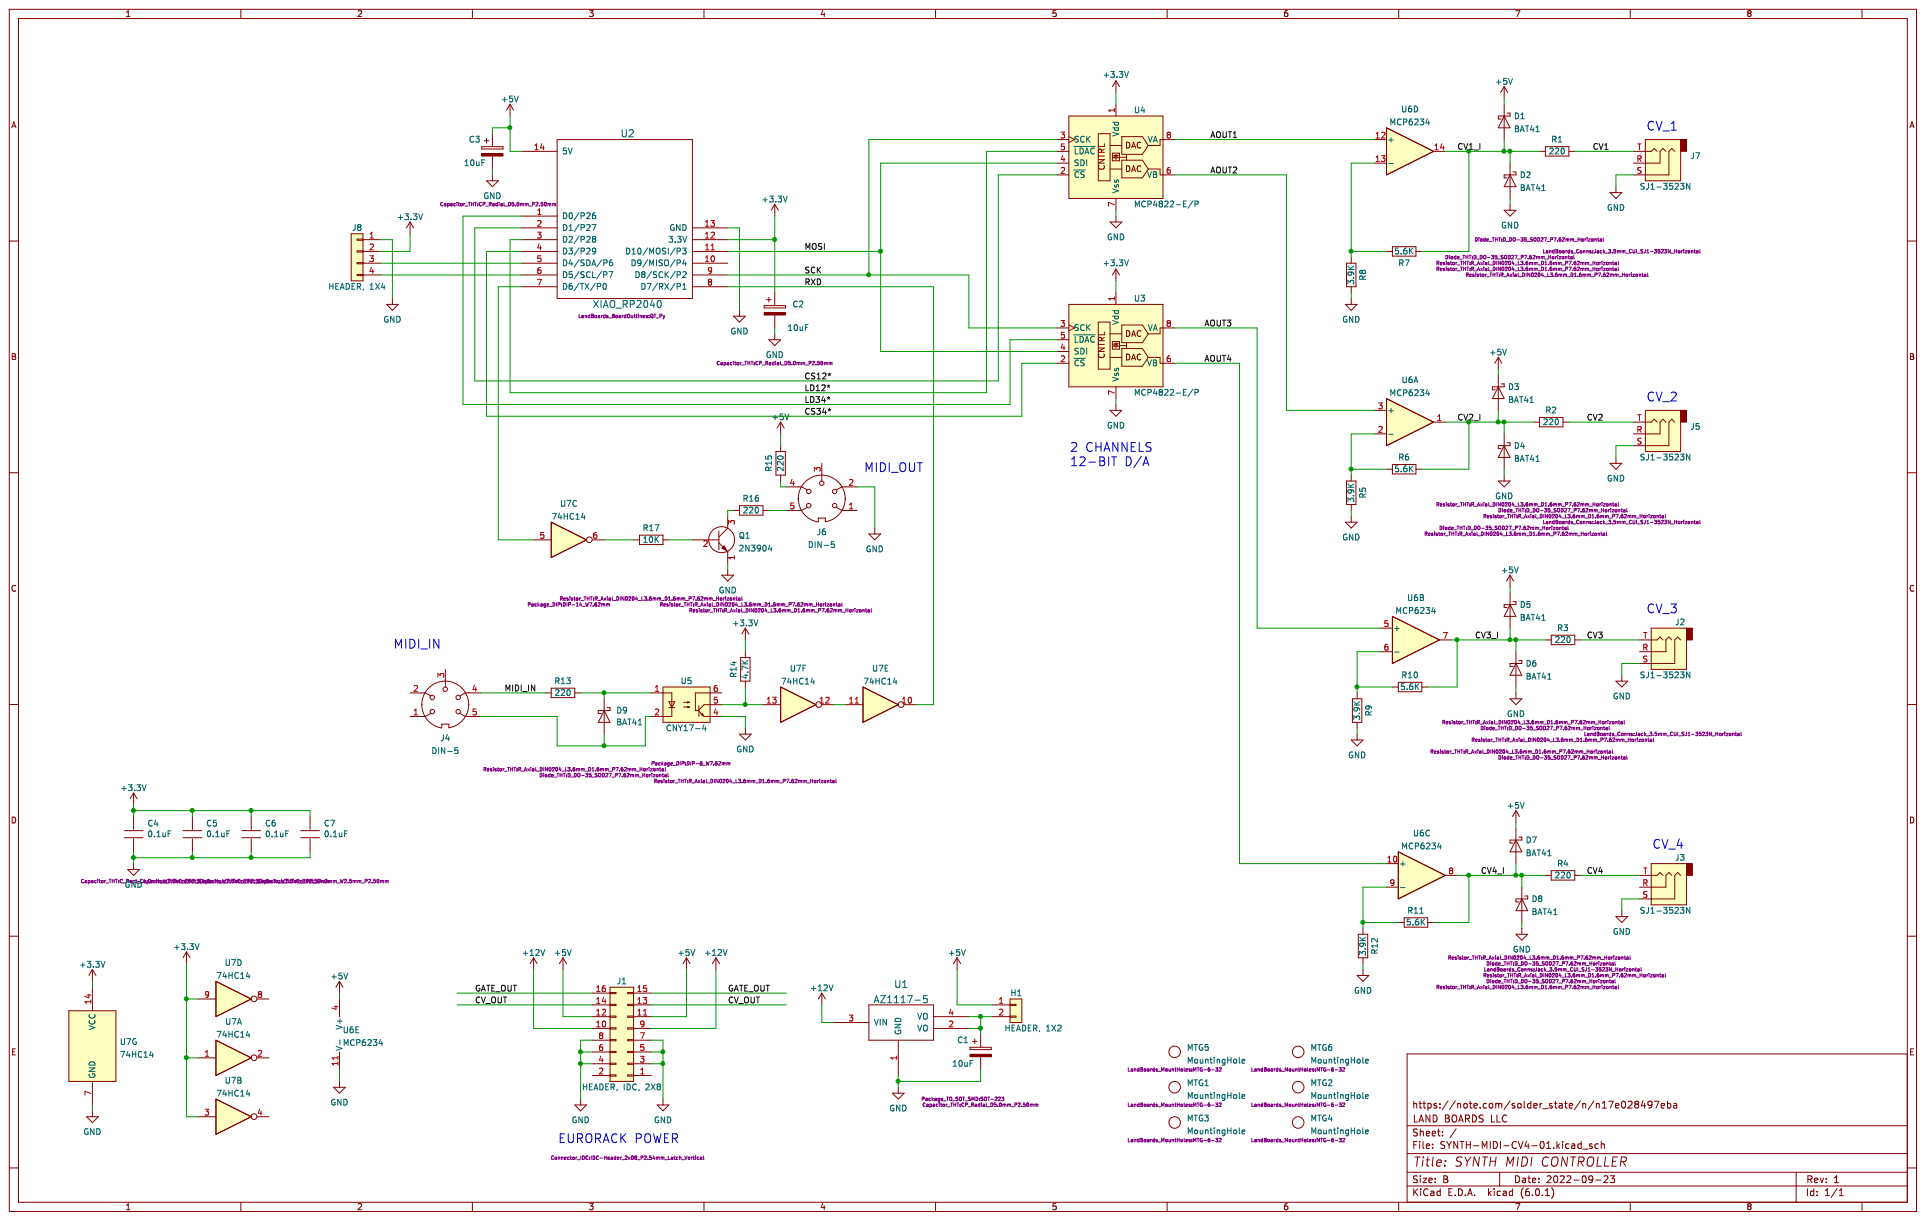
[picture p496: page 1]
