land-boards/lb-boards/SYNTHS/ER-MIDI-THRU_SET/ER-MIDI-THRU_REV1_Schematic.pdf

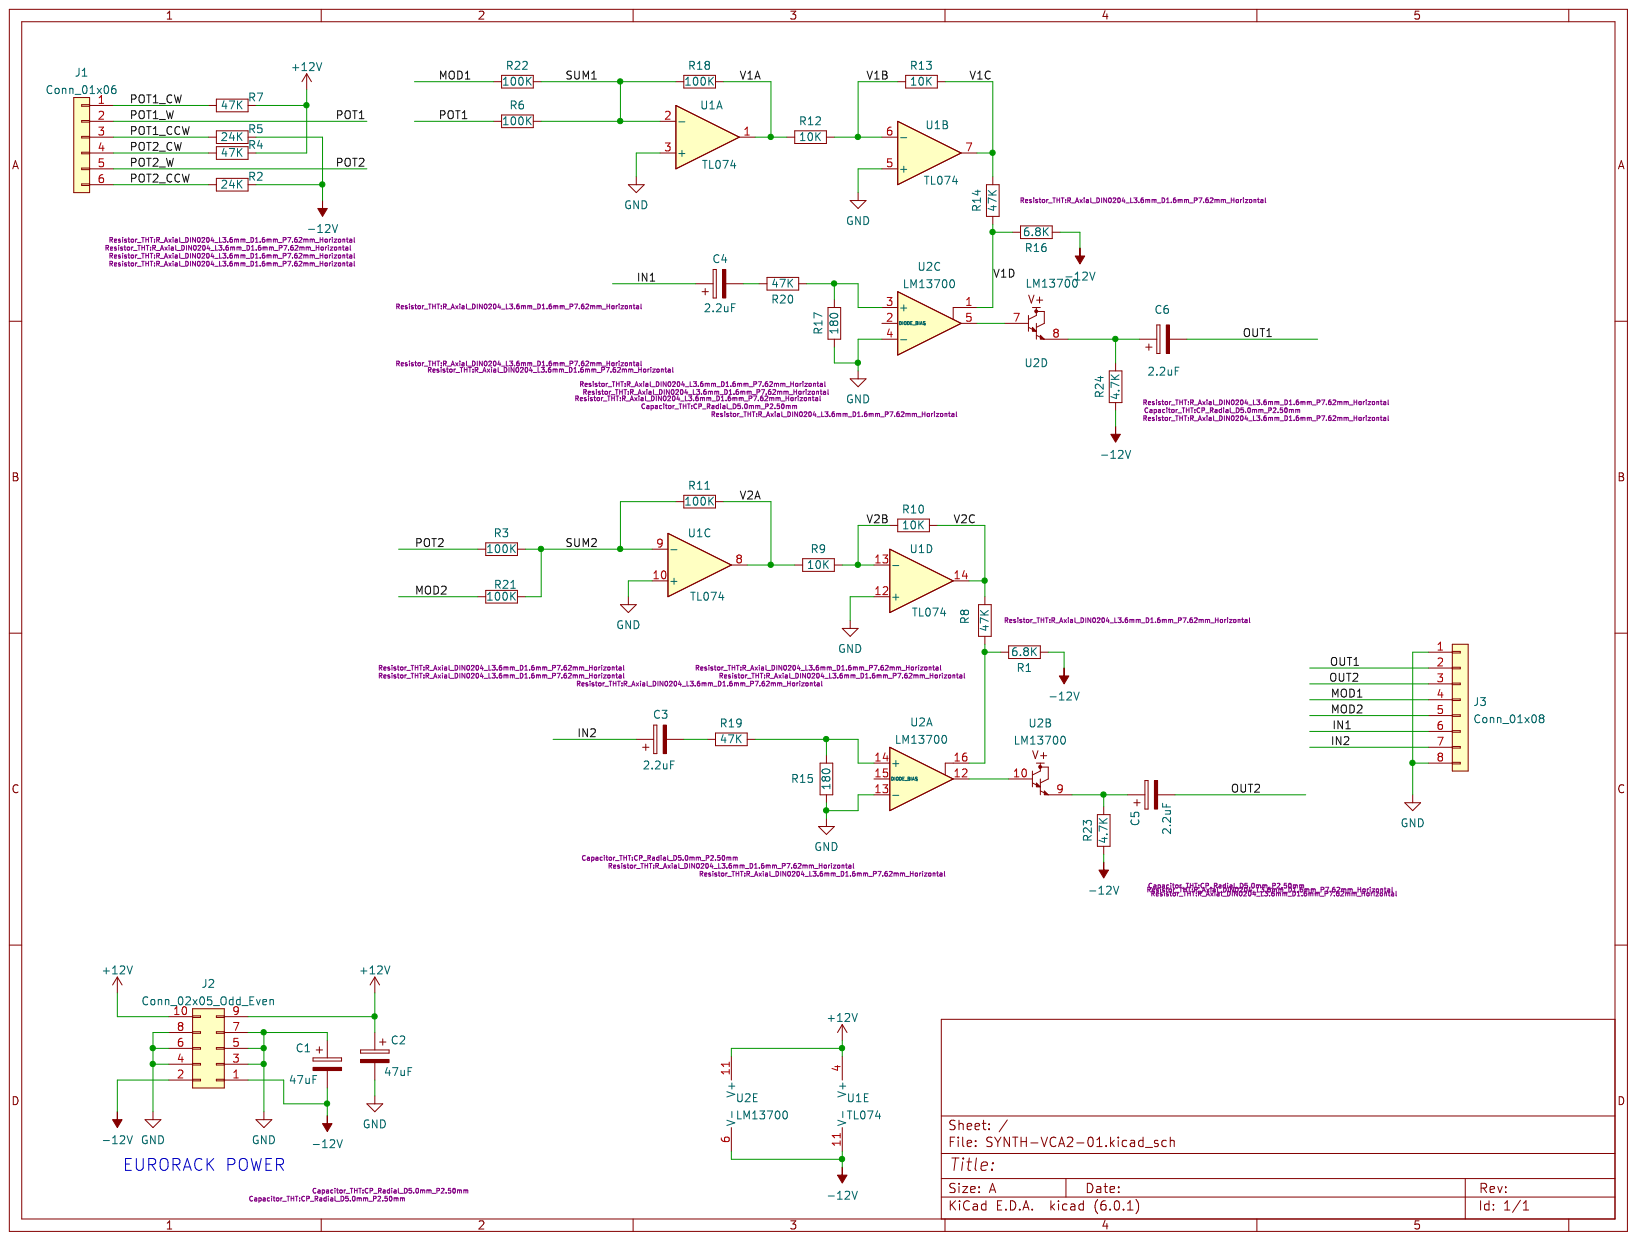
[picture p497: page 1]
