land-boards/lb-boards/Analog Cards/SPI-POTX2/SPI-POTX2_Rev2_Schematic.pdf

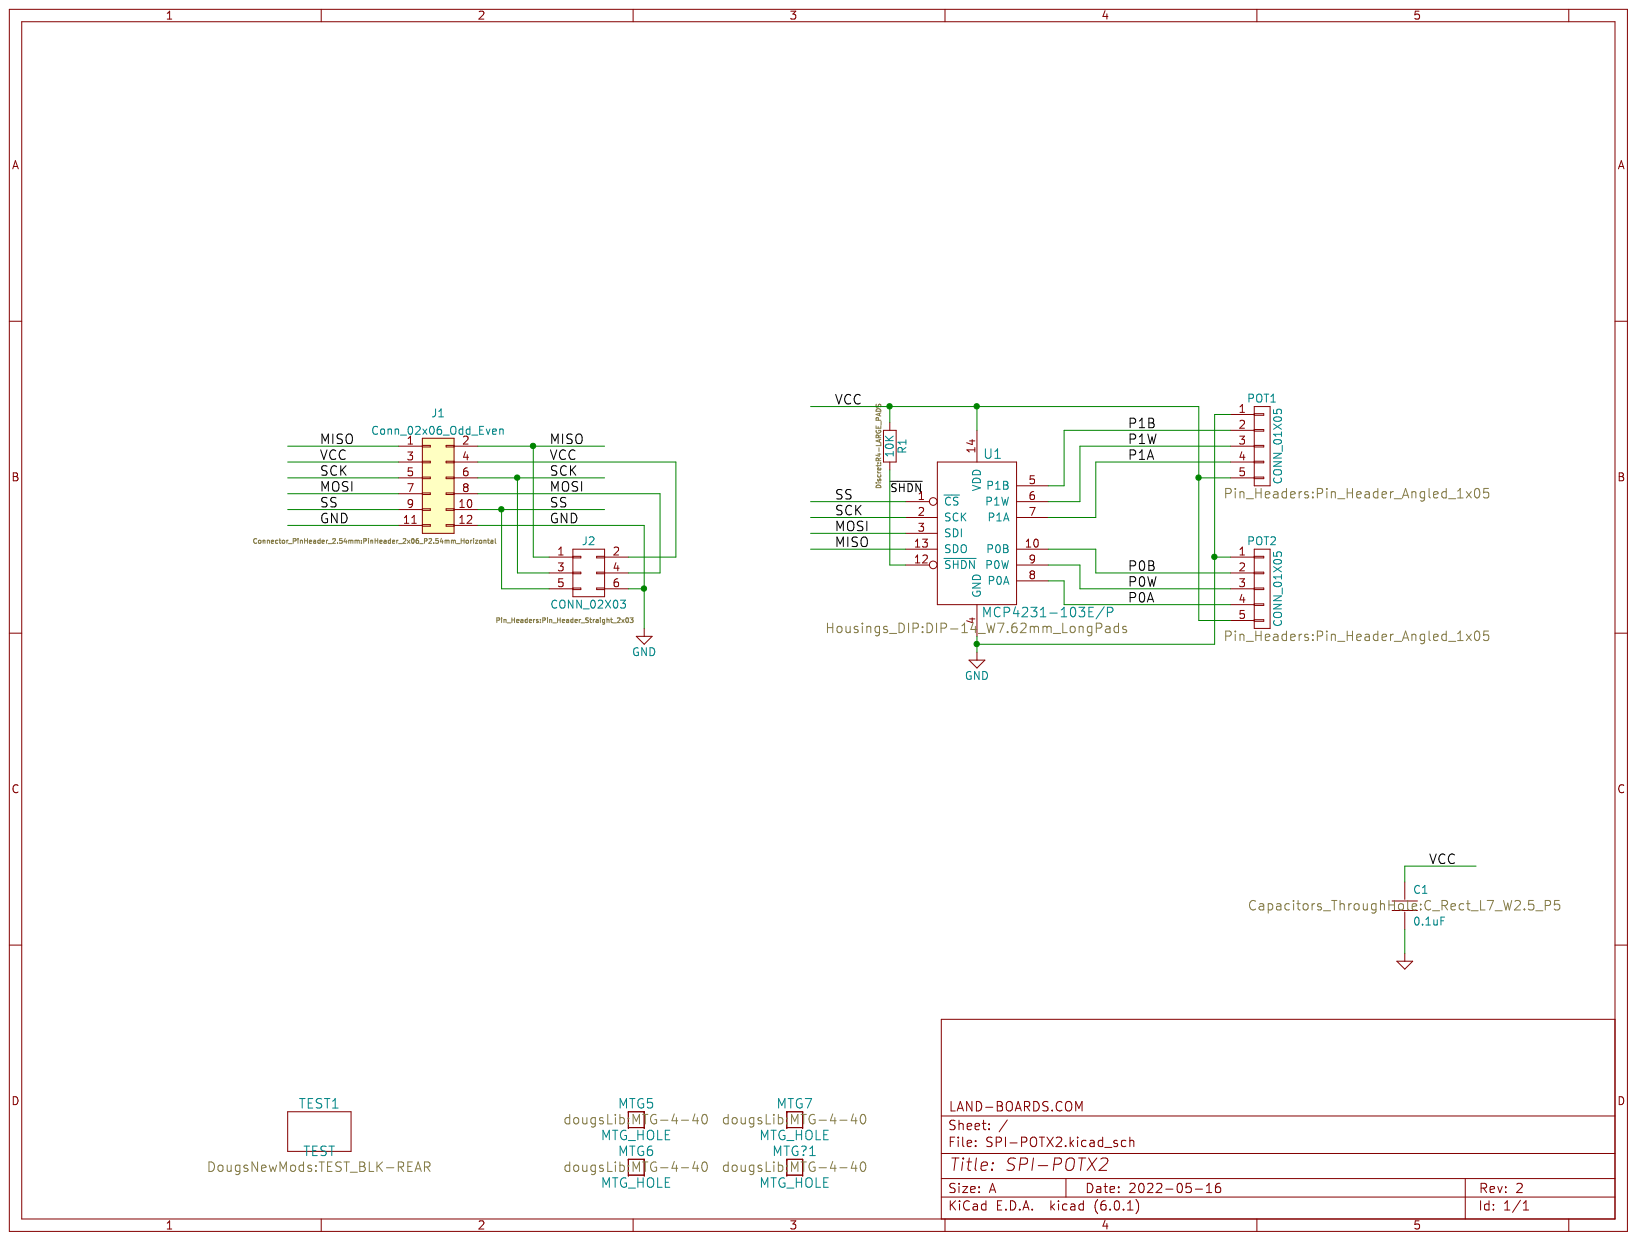
[picture p498: page 1]
