land-boards/lb-boards/Analog Cards/UNI-OPAMP-04/UNI-OPAMP-04_Rev1_Schematic.pdf

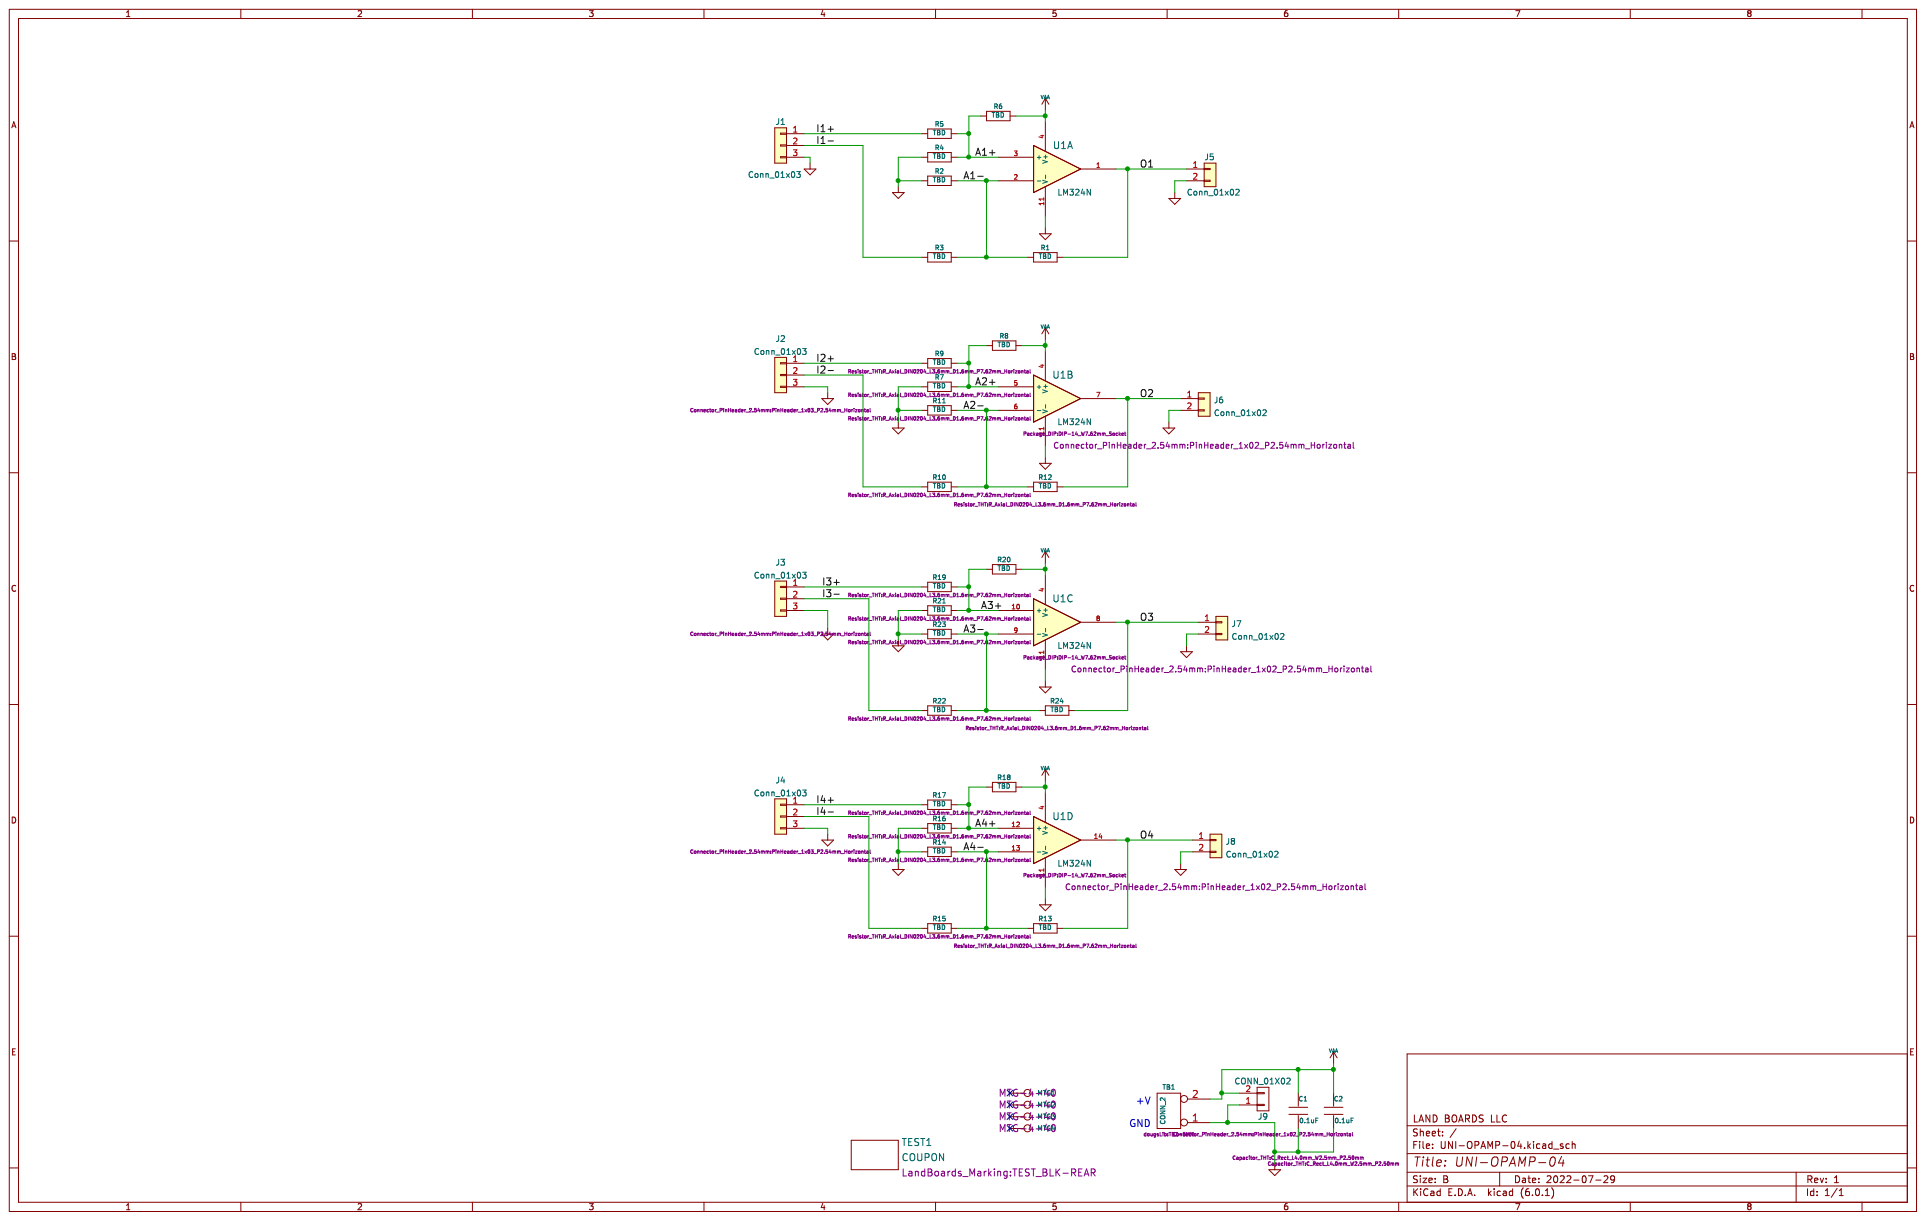
[picture p499: page 1]
