land-boards/lb-boards/Arduino Cards/ArduinoInABox/ARDUINO_IN_A_BOX_REV1_Schematic.pdf

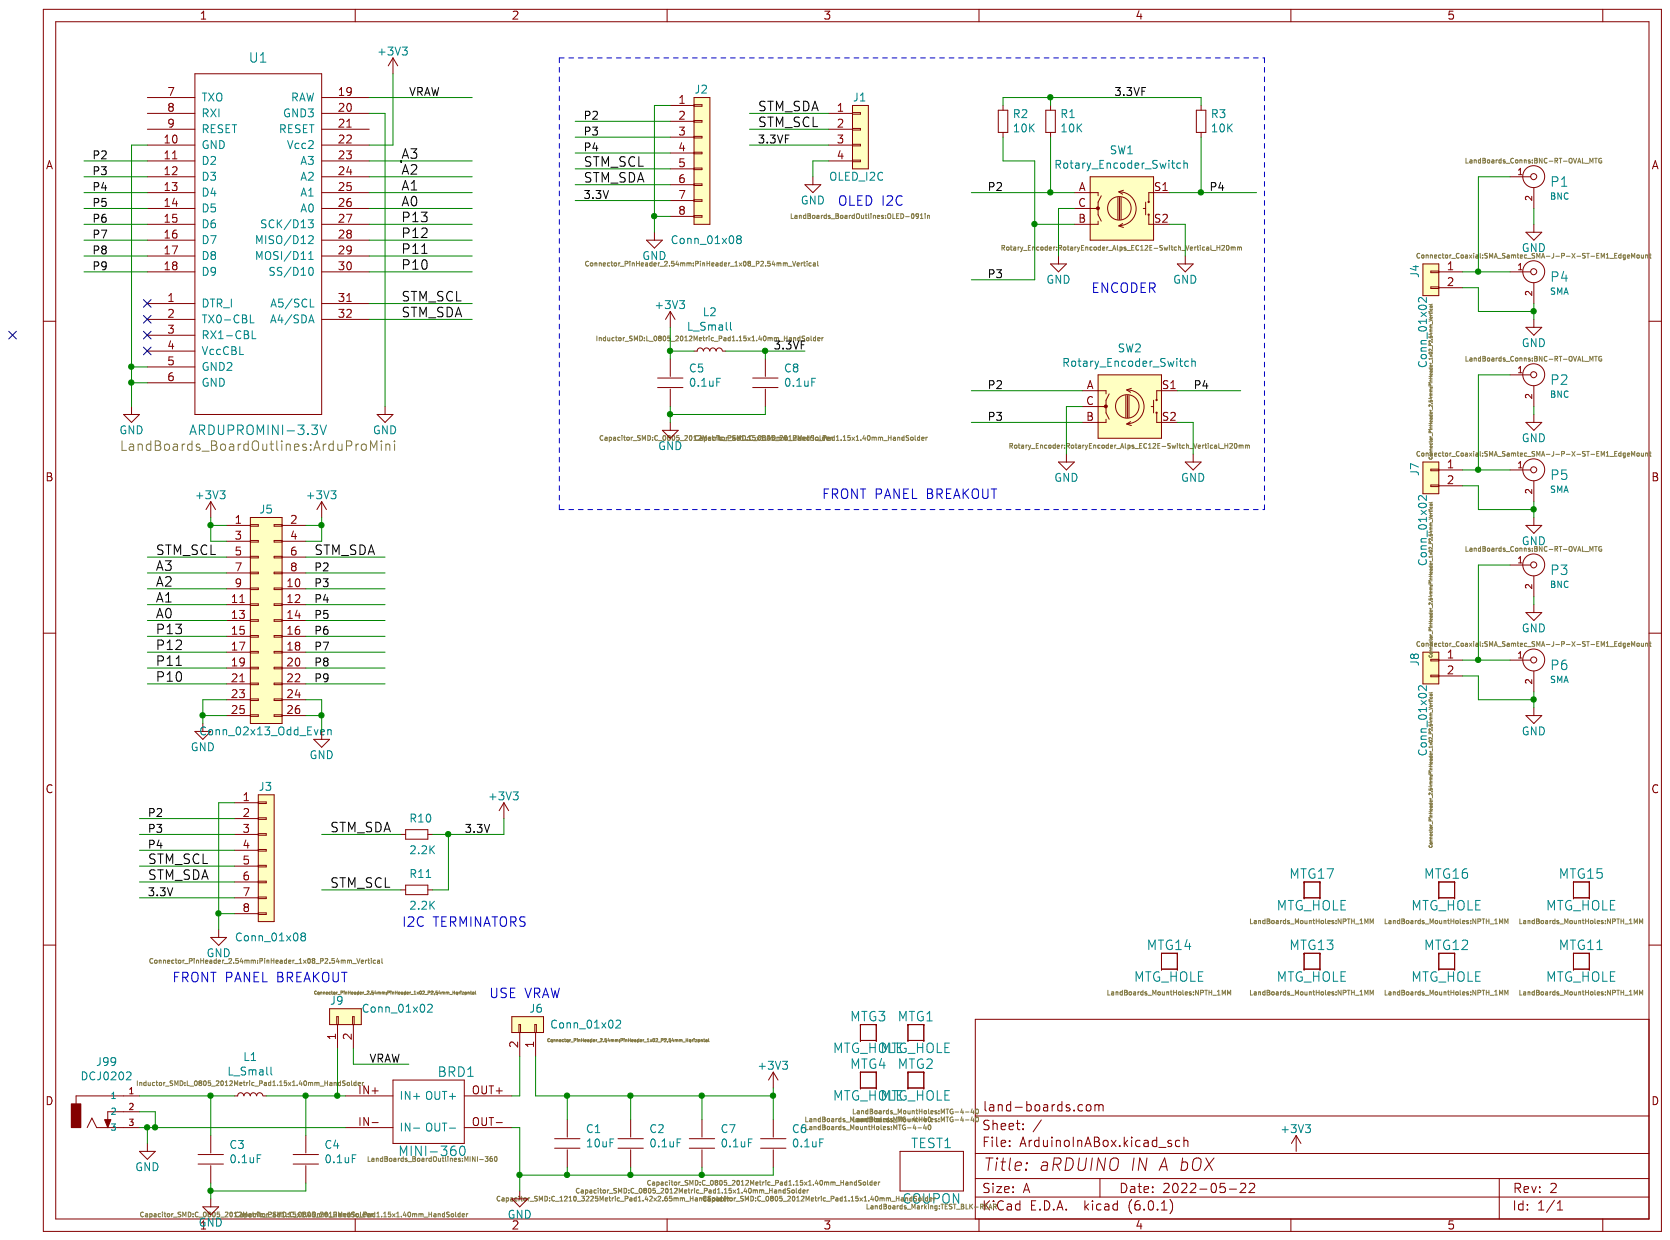
[picture p500: page 1]
