land-boards/lb-boards/Arduino Cards/MyMenu/MyMenu_Rev5_Schematic.pdf

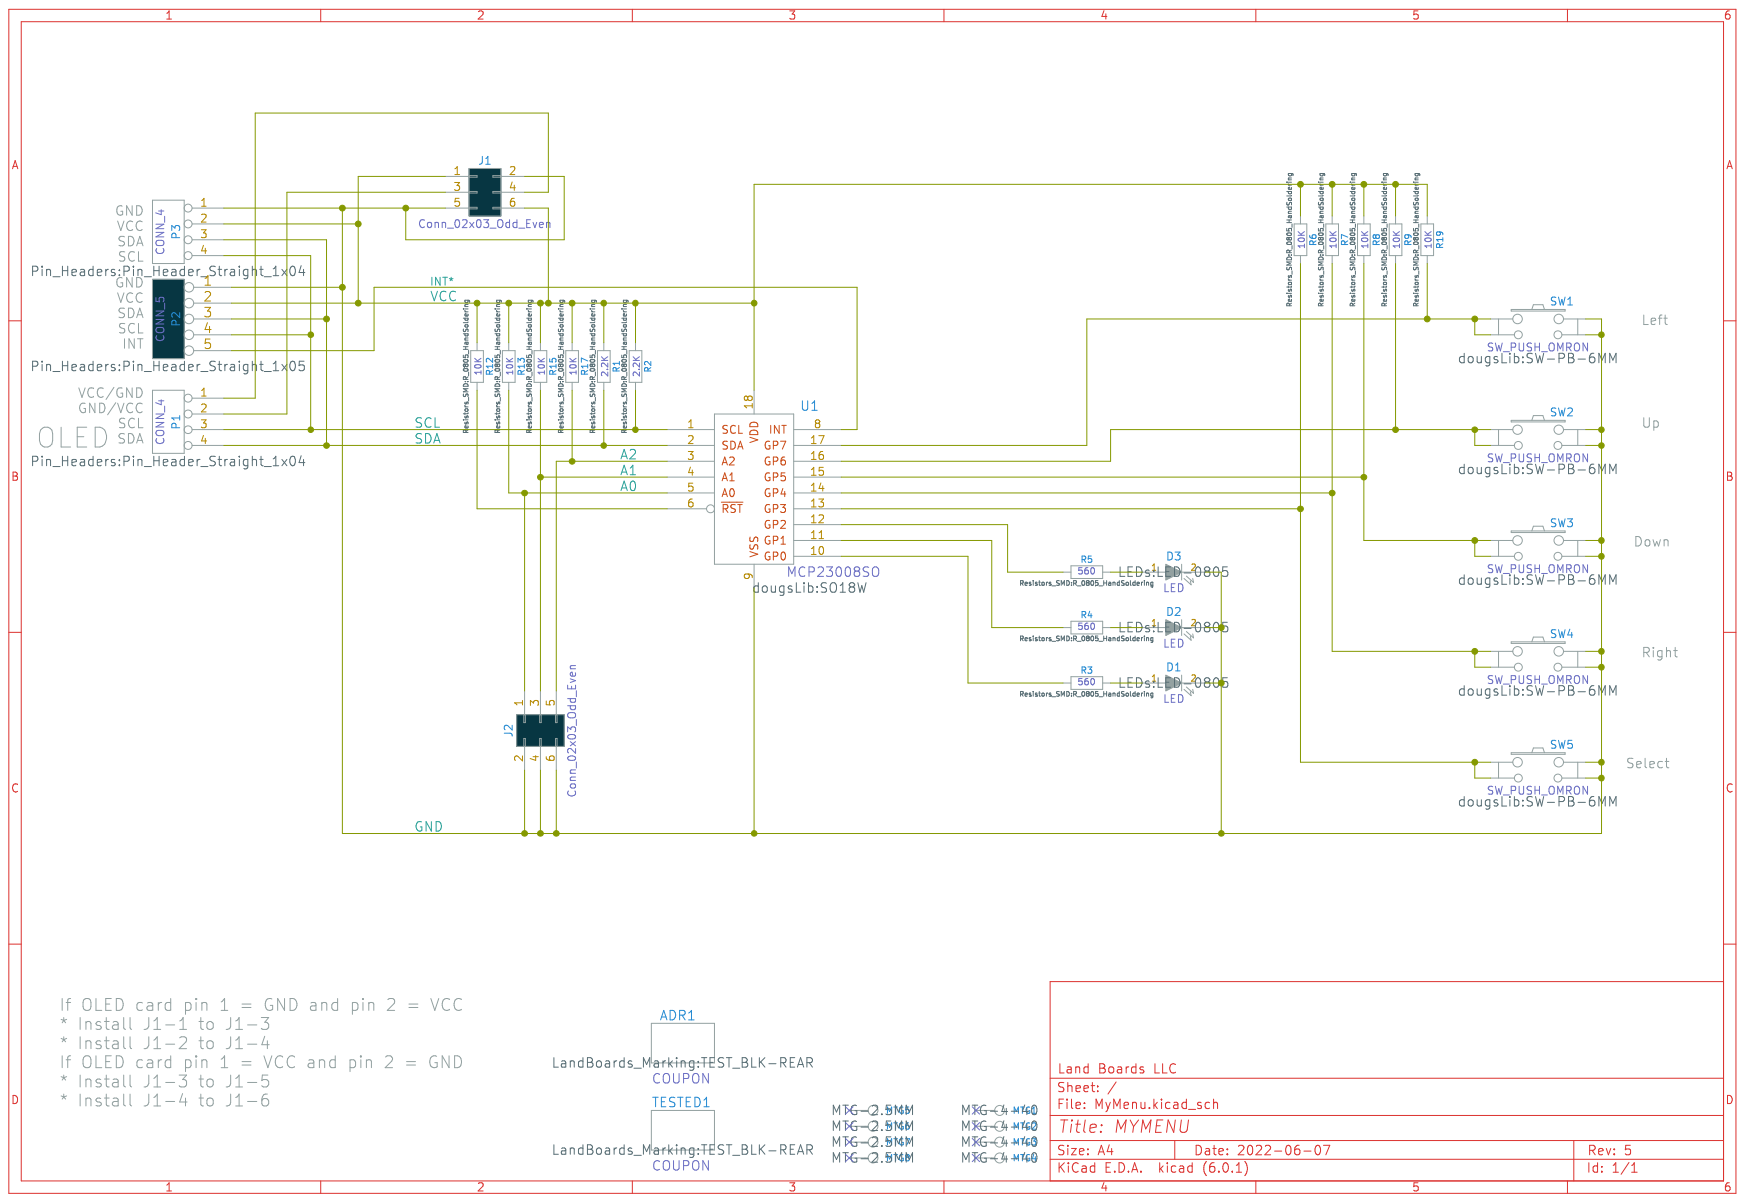
[picture p501: page 1]
