land-boards/lb-boards/Arduino Cards/QTPy49-01/QTPy-01_Rev1_Schematic.pdf

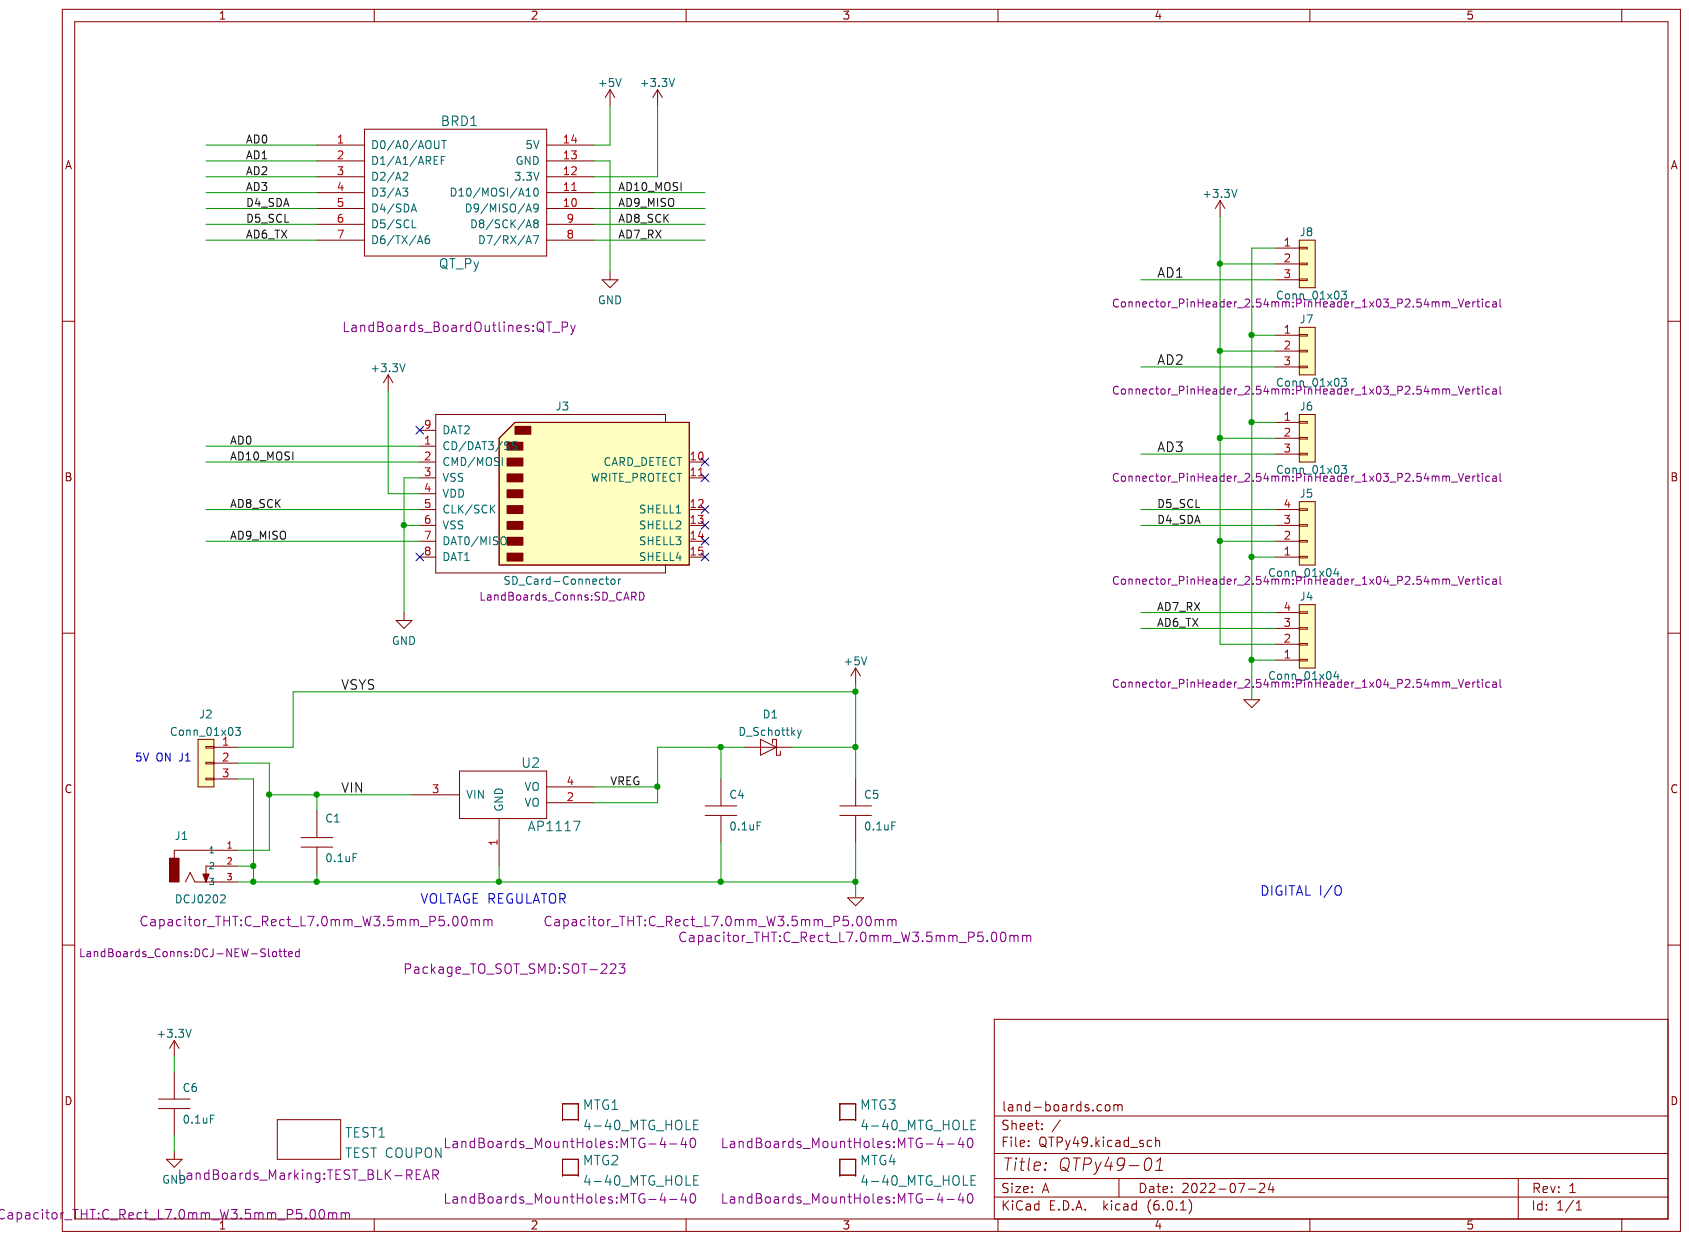
[picture p502: page 1]
