land-boards/lb-boards/Arduino Cards/QTPy49/QTPy49_Rev1_Schematic.pdf

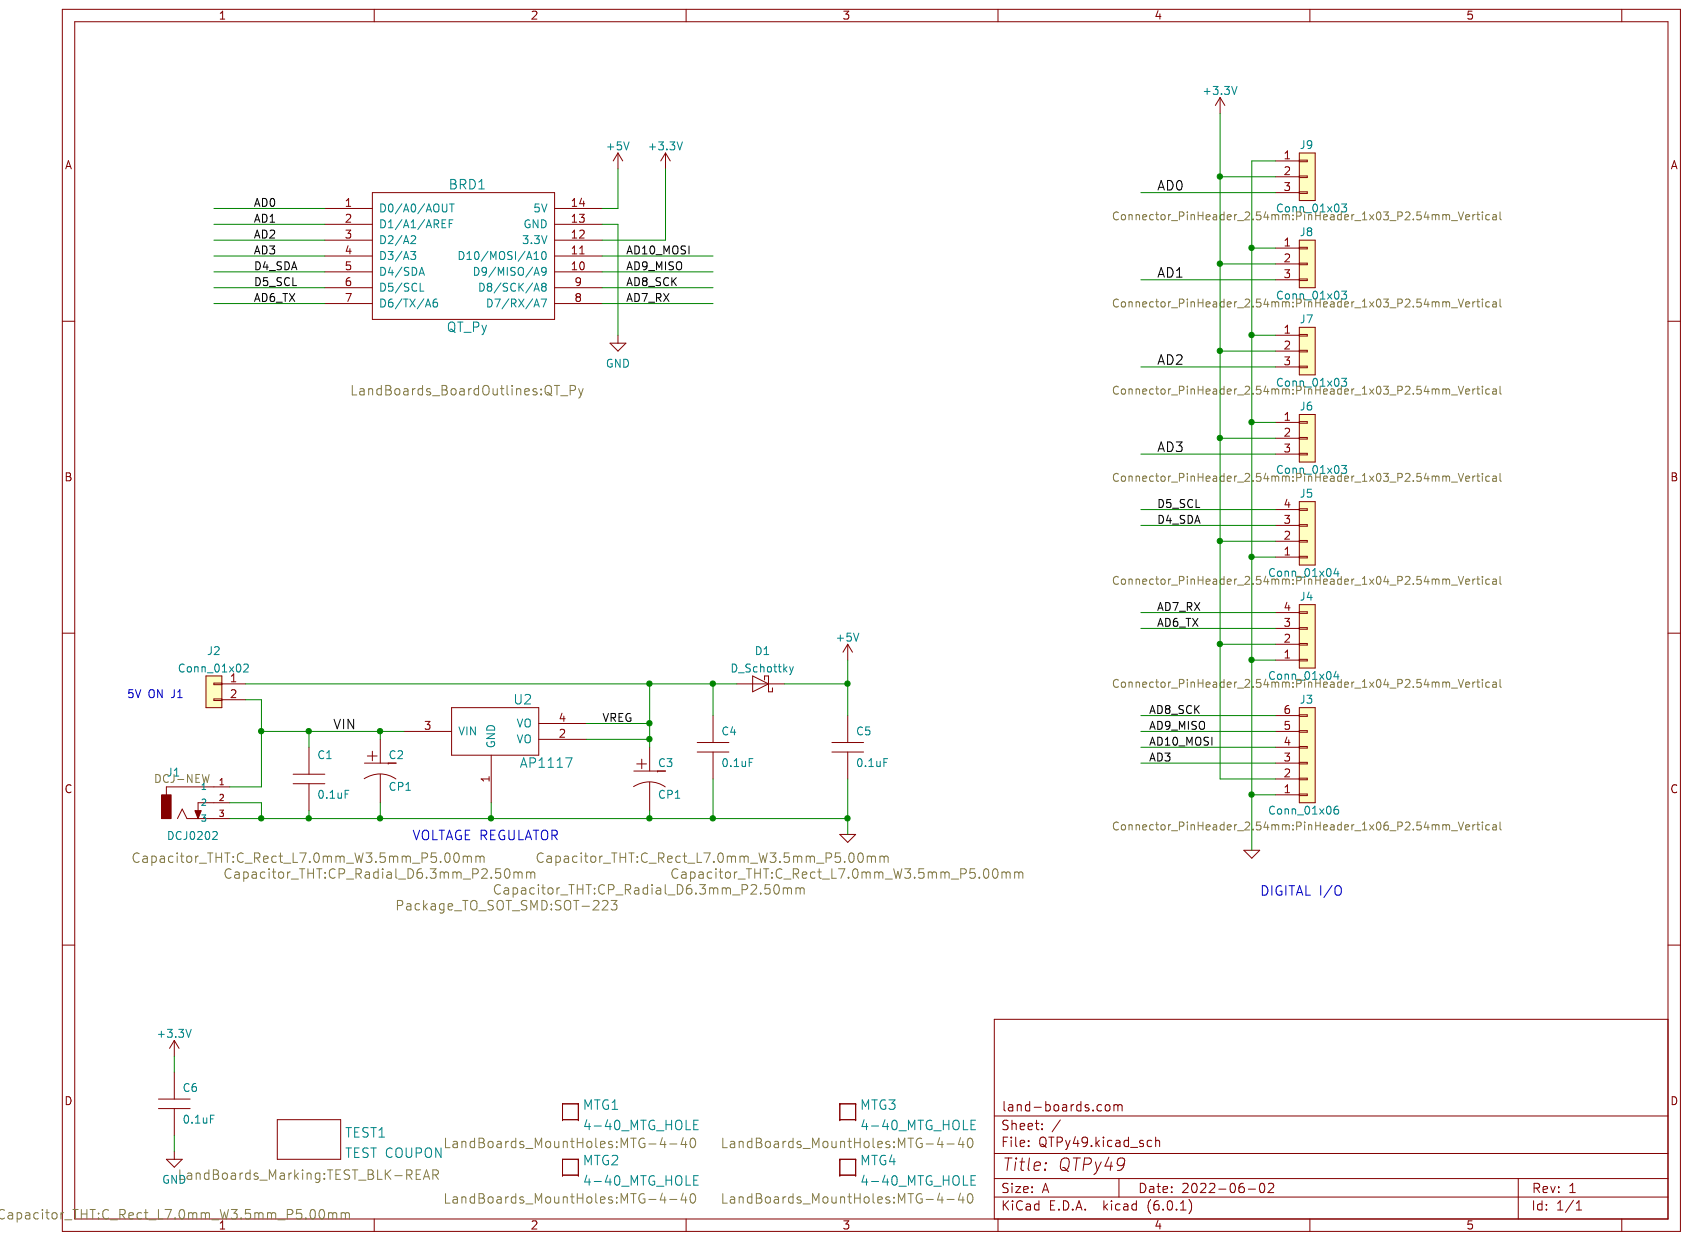
[picture p503: page 1]
