land-boards/lb-boards/FPGA Cards/FPGA-ITX-01/FPGA-ITX-01_Rev1_Schematic.pdf

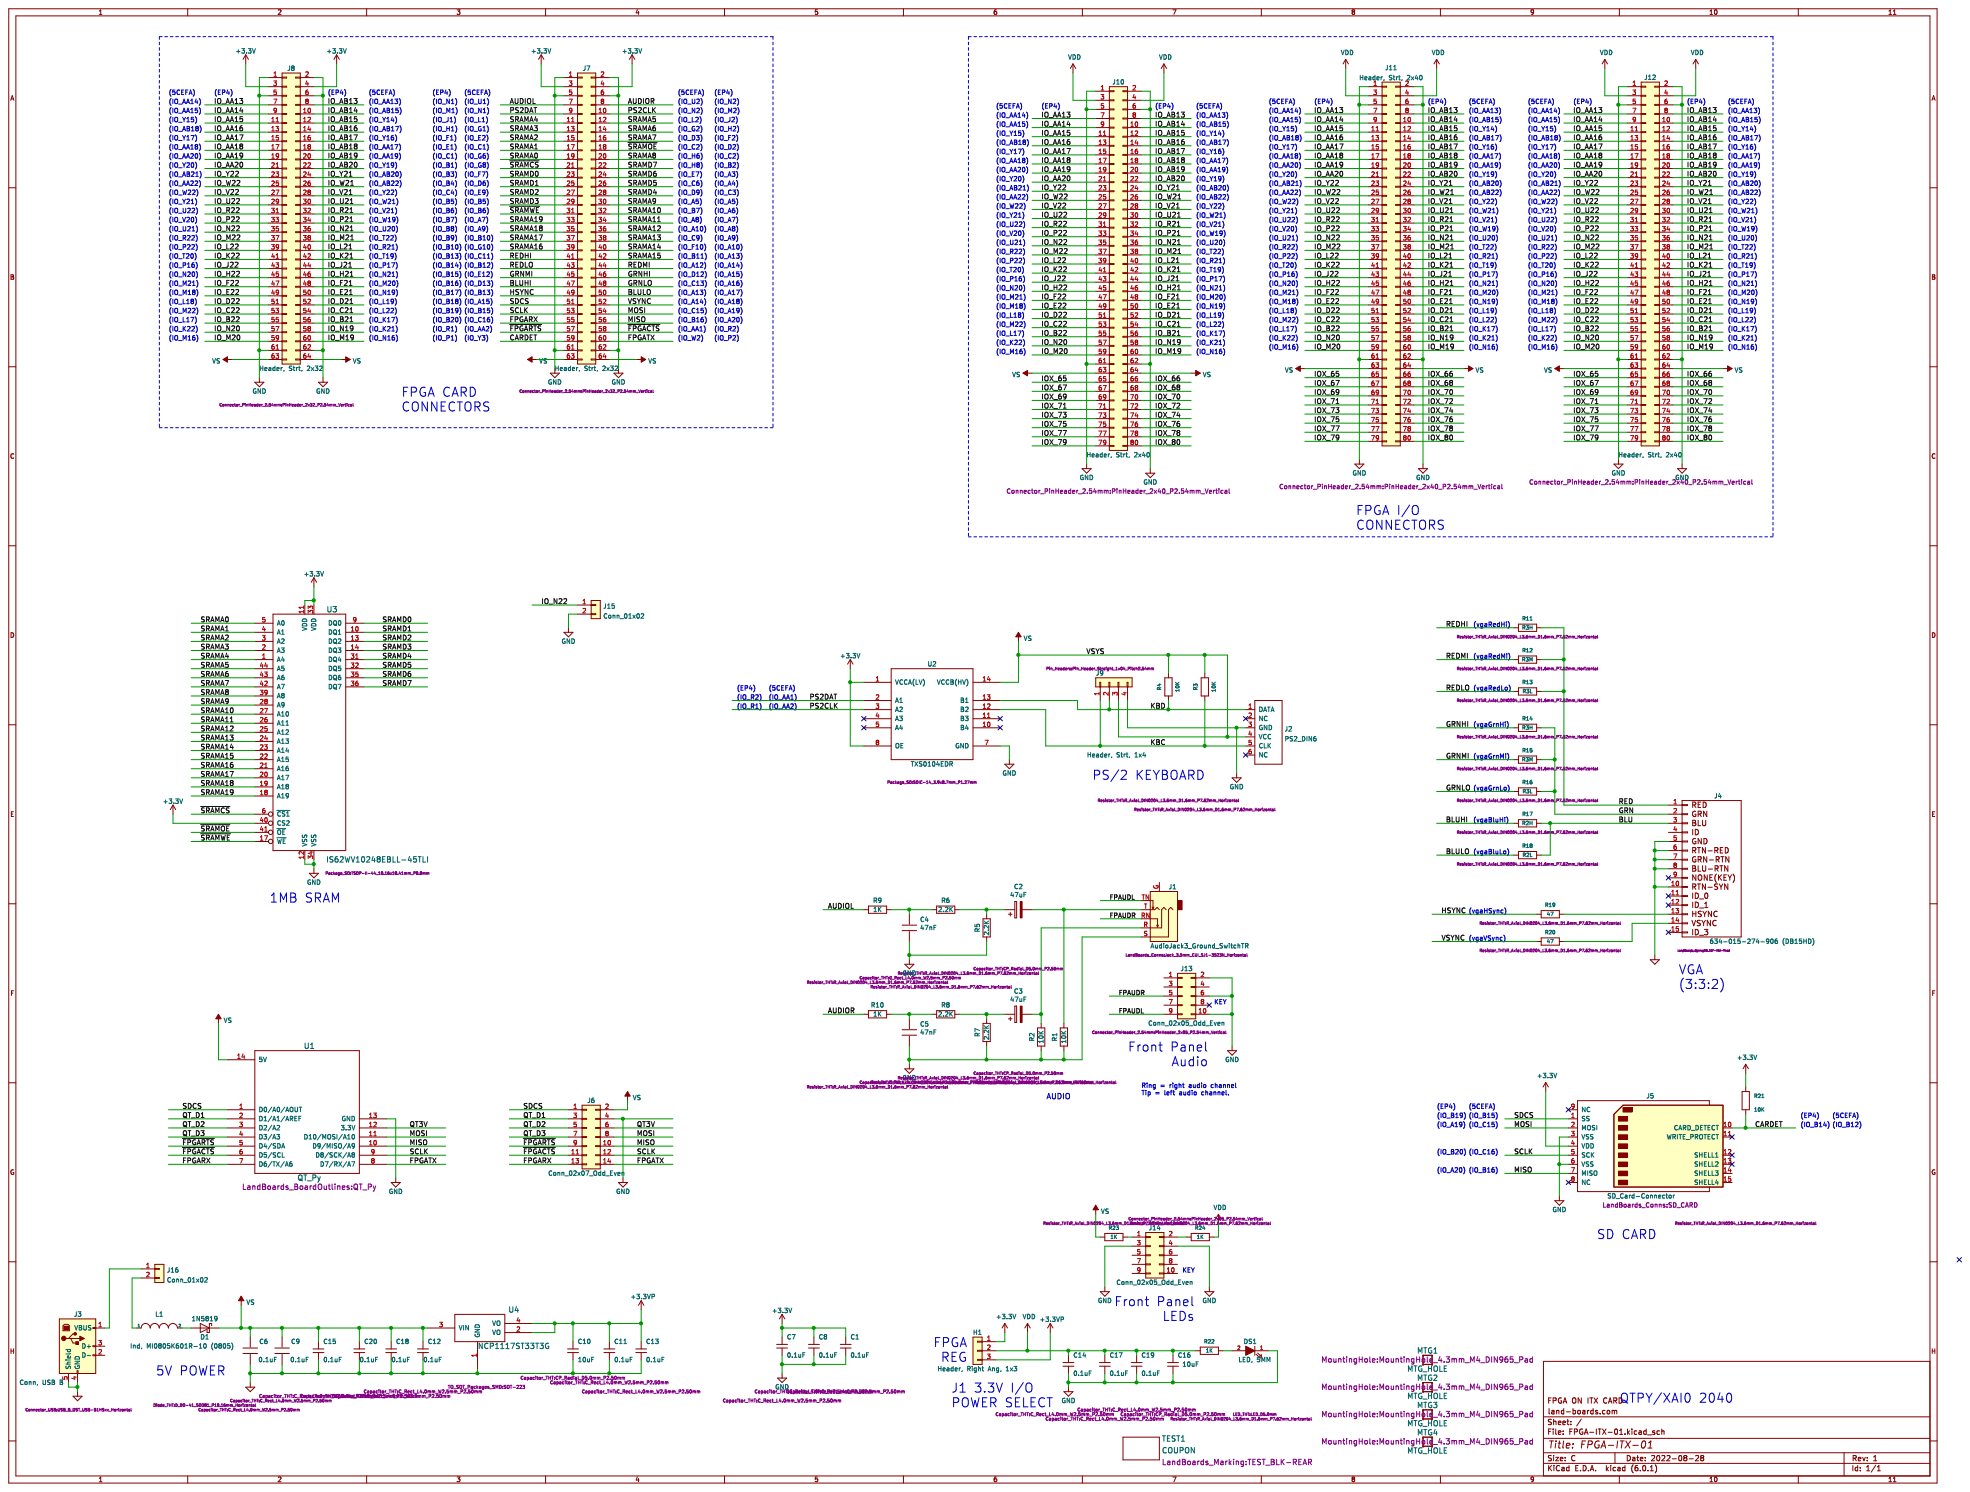
[picture p504: page 1]
