land-boards/lb-boards/FPGA Cards/RETRO-65C816/RETRO-65C816_REV2_SCHEMATIC.pdf

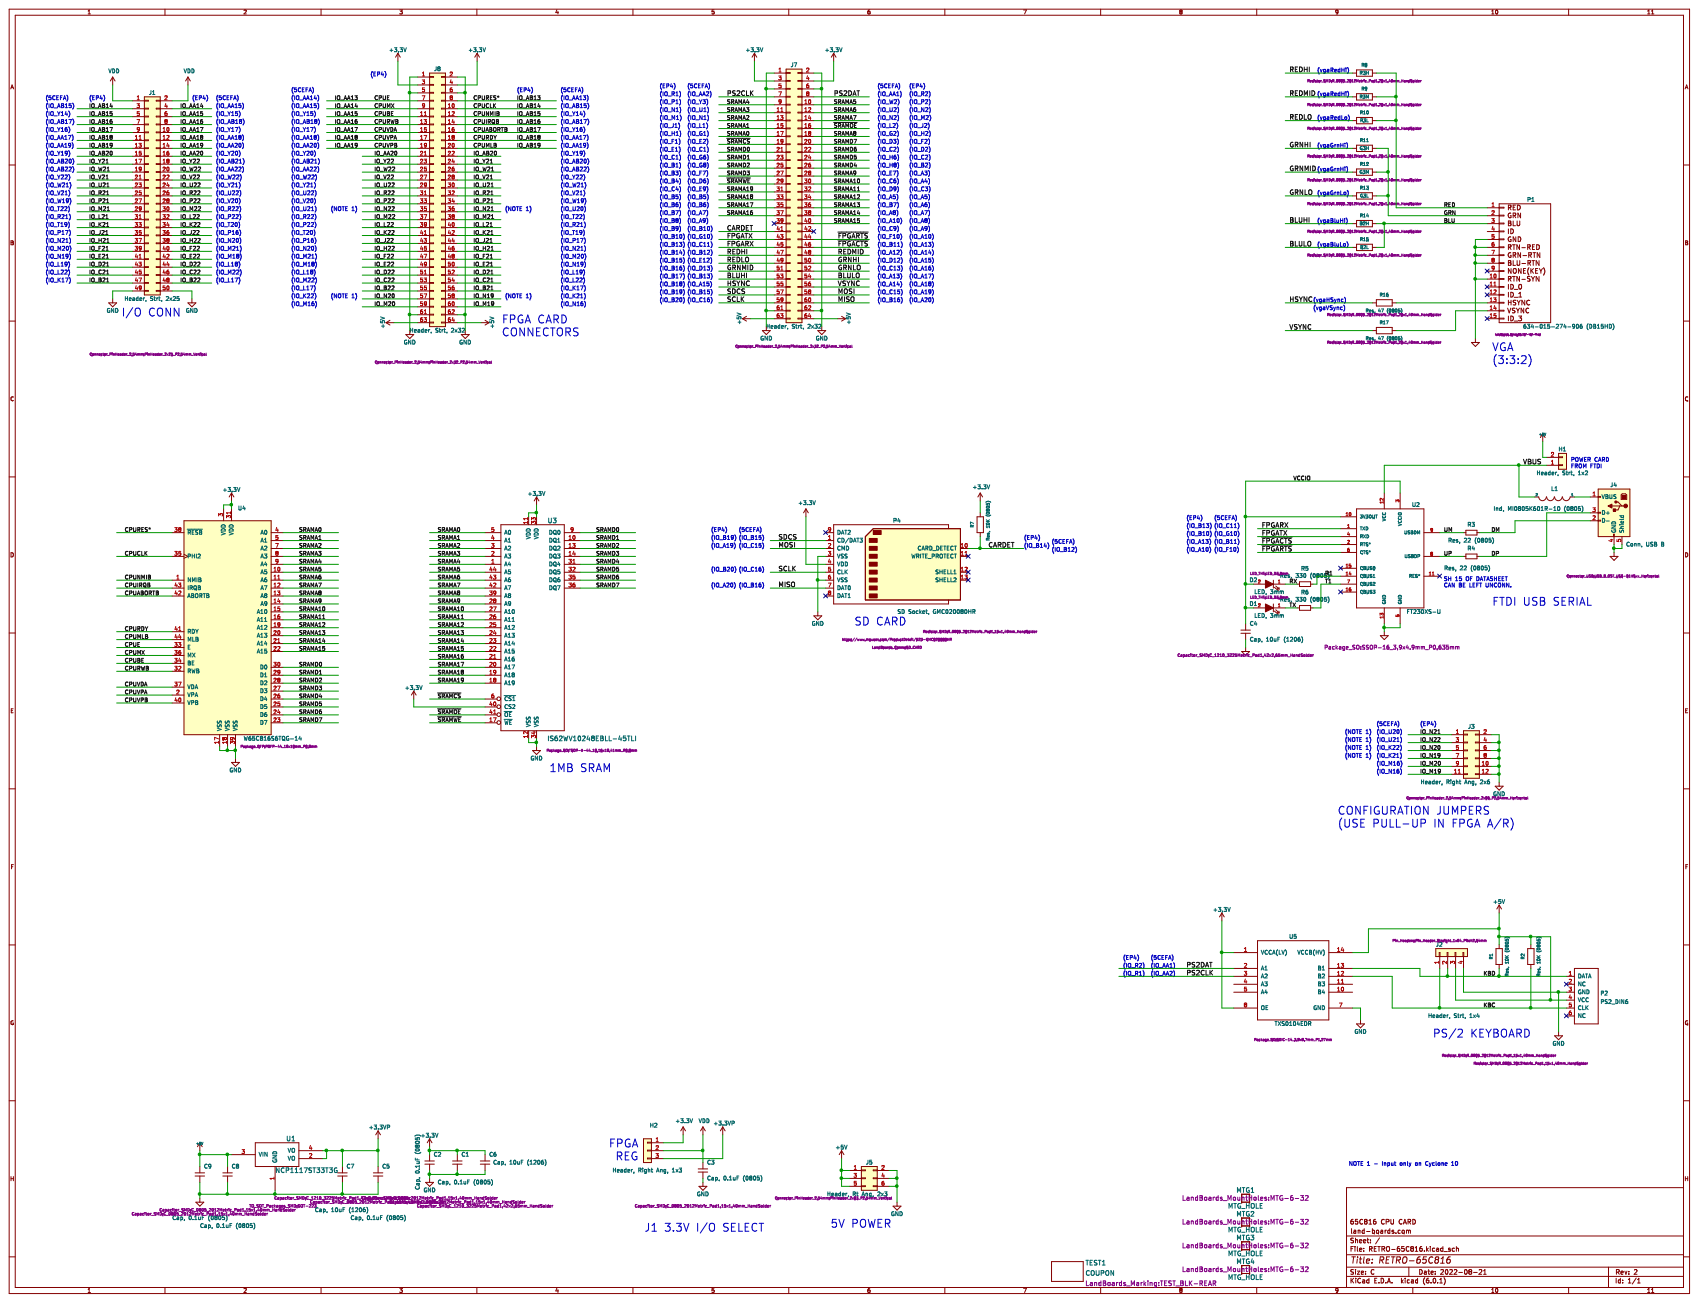
[picture p505: page 1]
