land-boards/lb-boards/I2C Cards/I2CIO-8/I2CIO-8_Rev3_Schematic.pdf

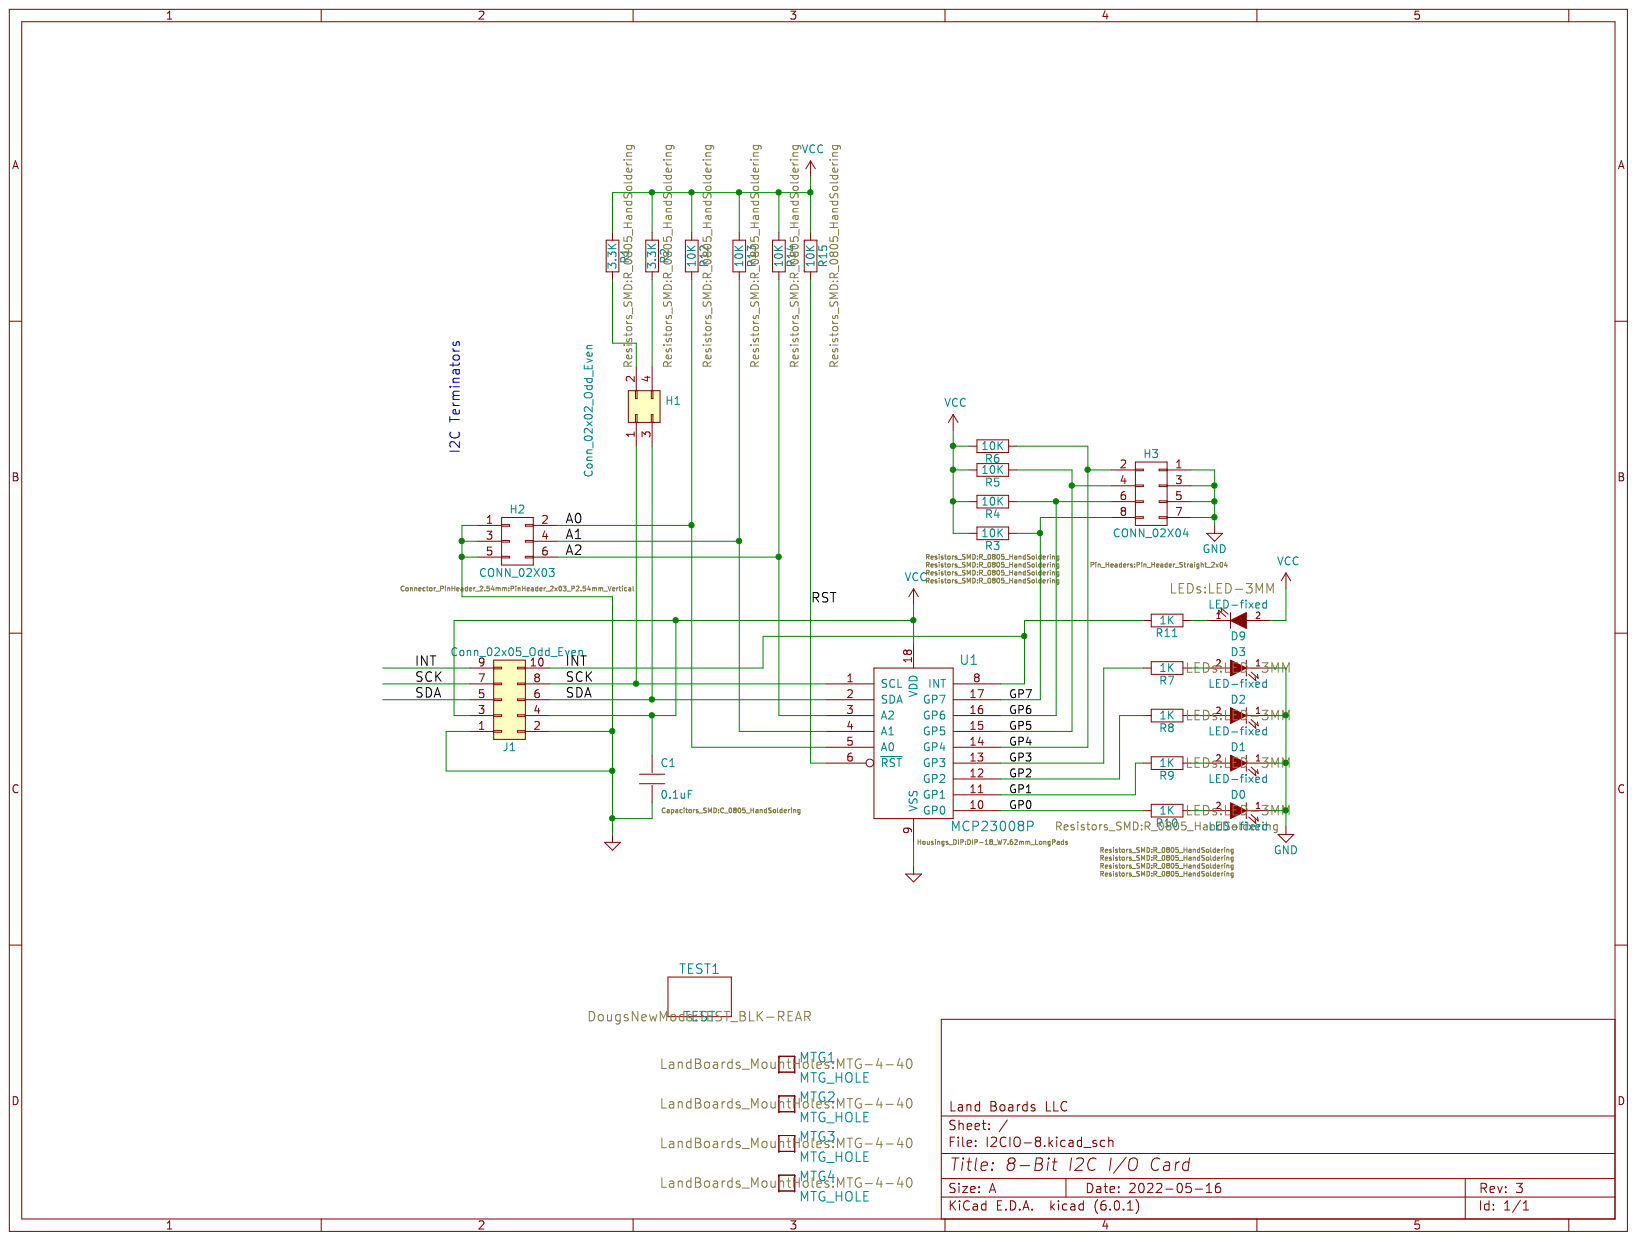
[picture p506: page 1]
