land-boards/lb-boards/I2C Cards/I2CIO16-DB25/I2CIO16-DB25_Rev1_Schematic.pdf

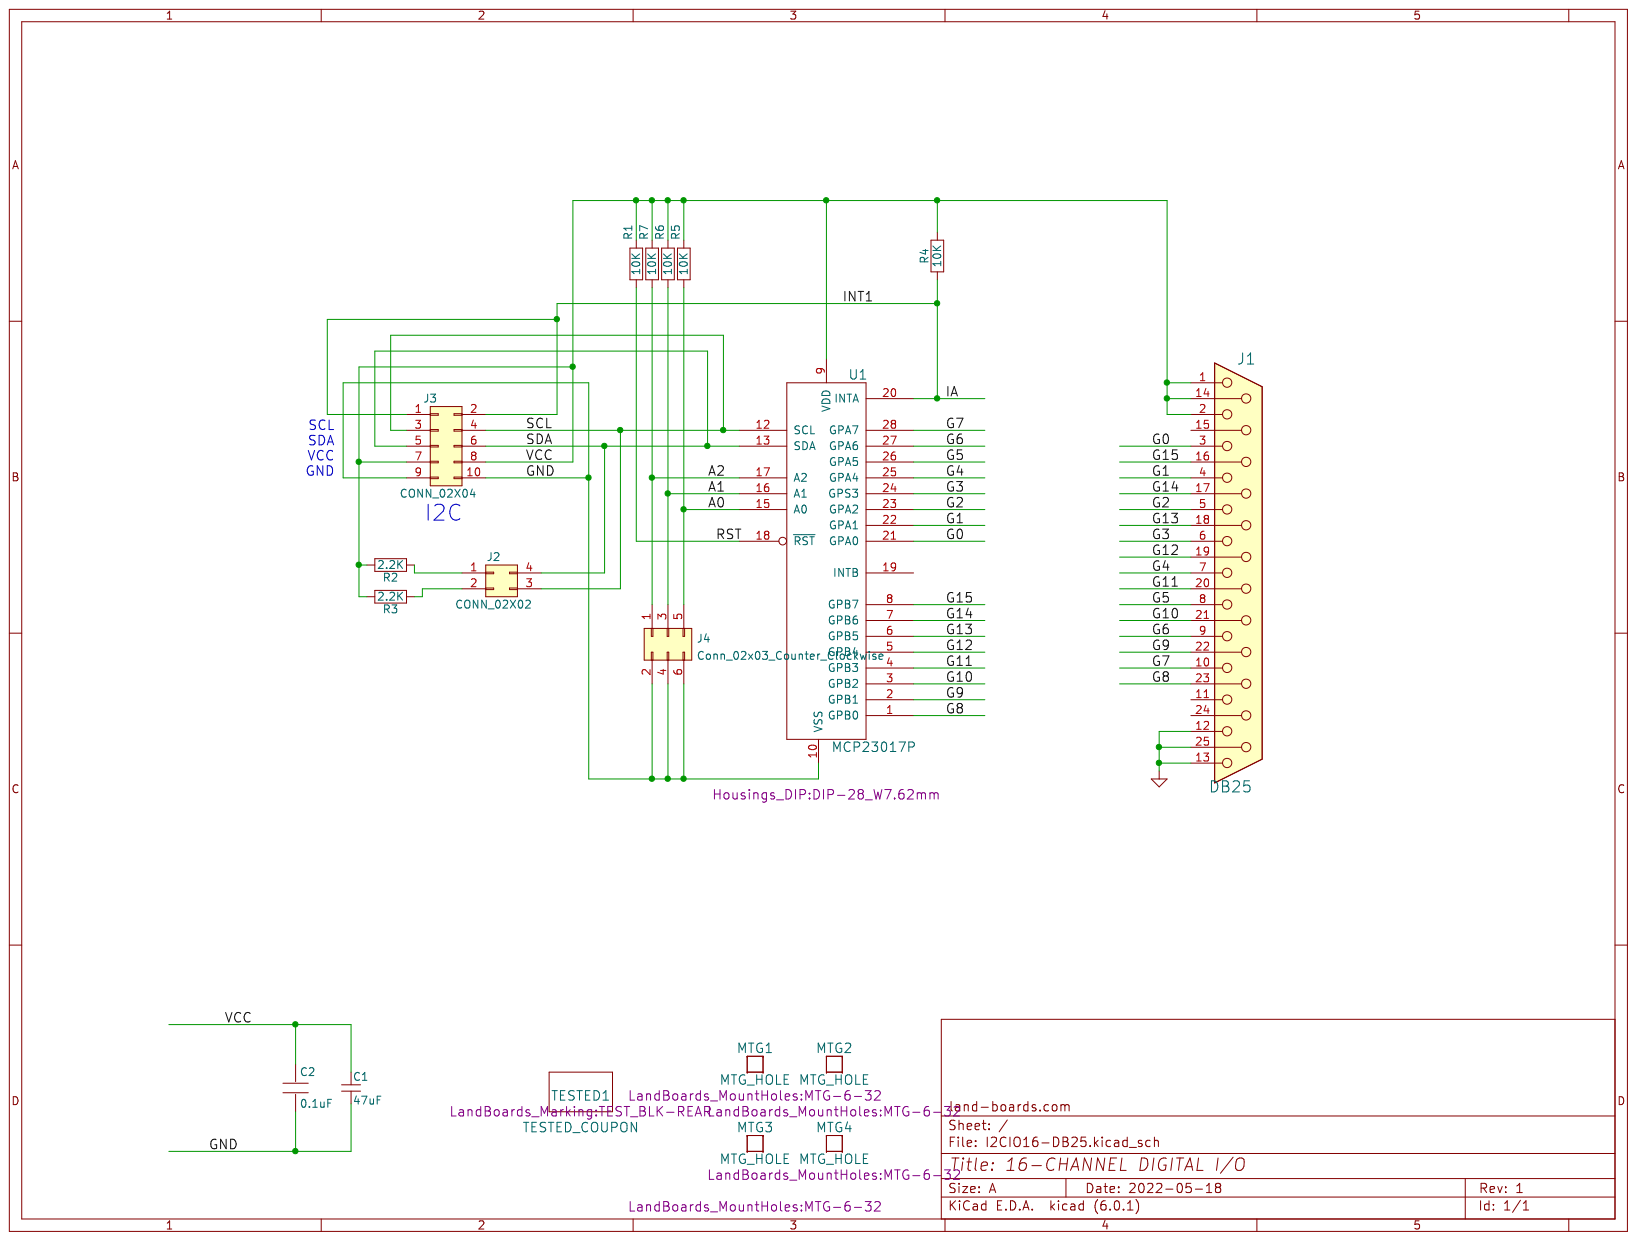
[picture p507: page 1]
