land-boards/lb-boards/I2C Cards/SWLEDX8-I2C/SWLEDX8-I2C_REV2_Schematic.pdf

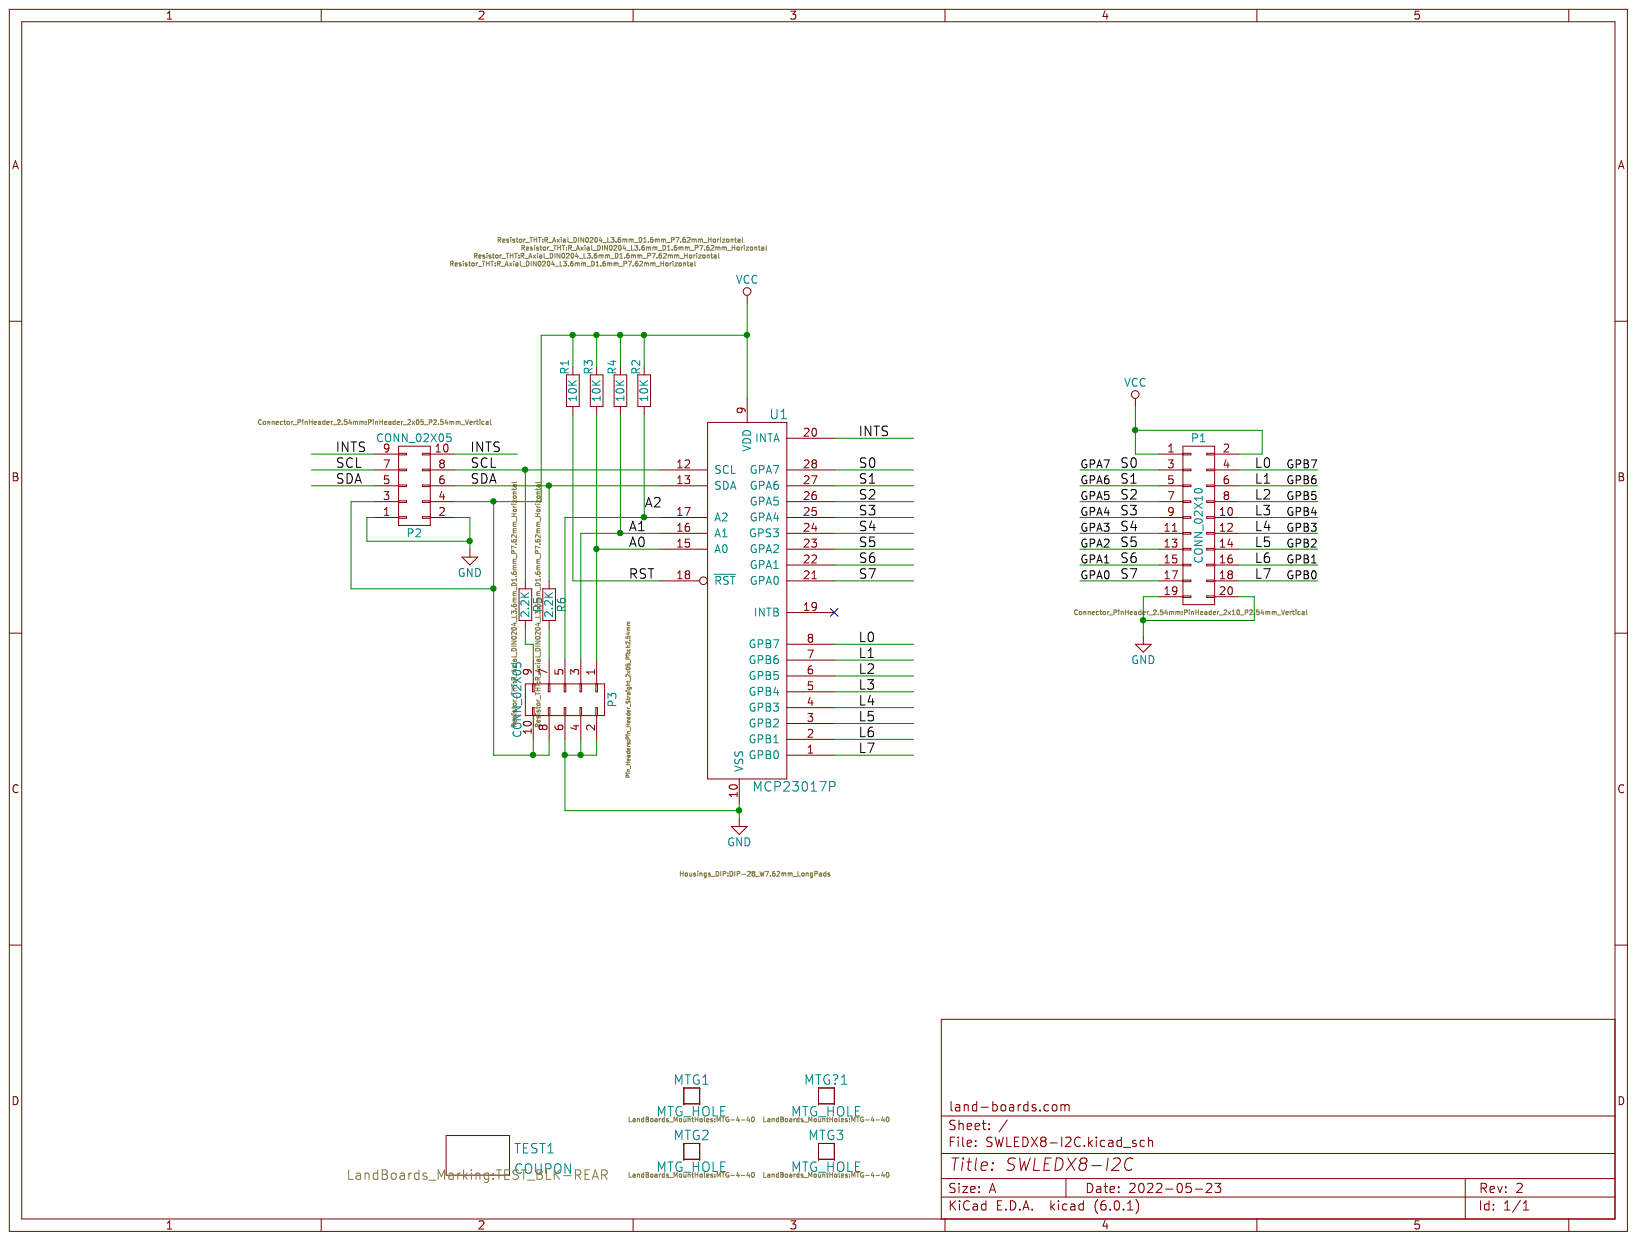
[picture p508: page 1]
