land-boards/lb-boards/I2C Cards/SWLEDX8/SWLEDX8_Rev2_Schematic.pdf

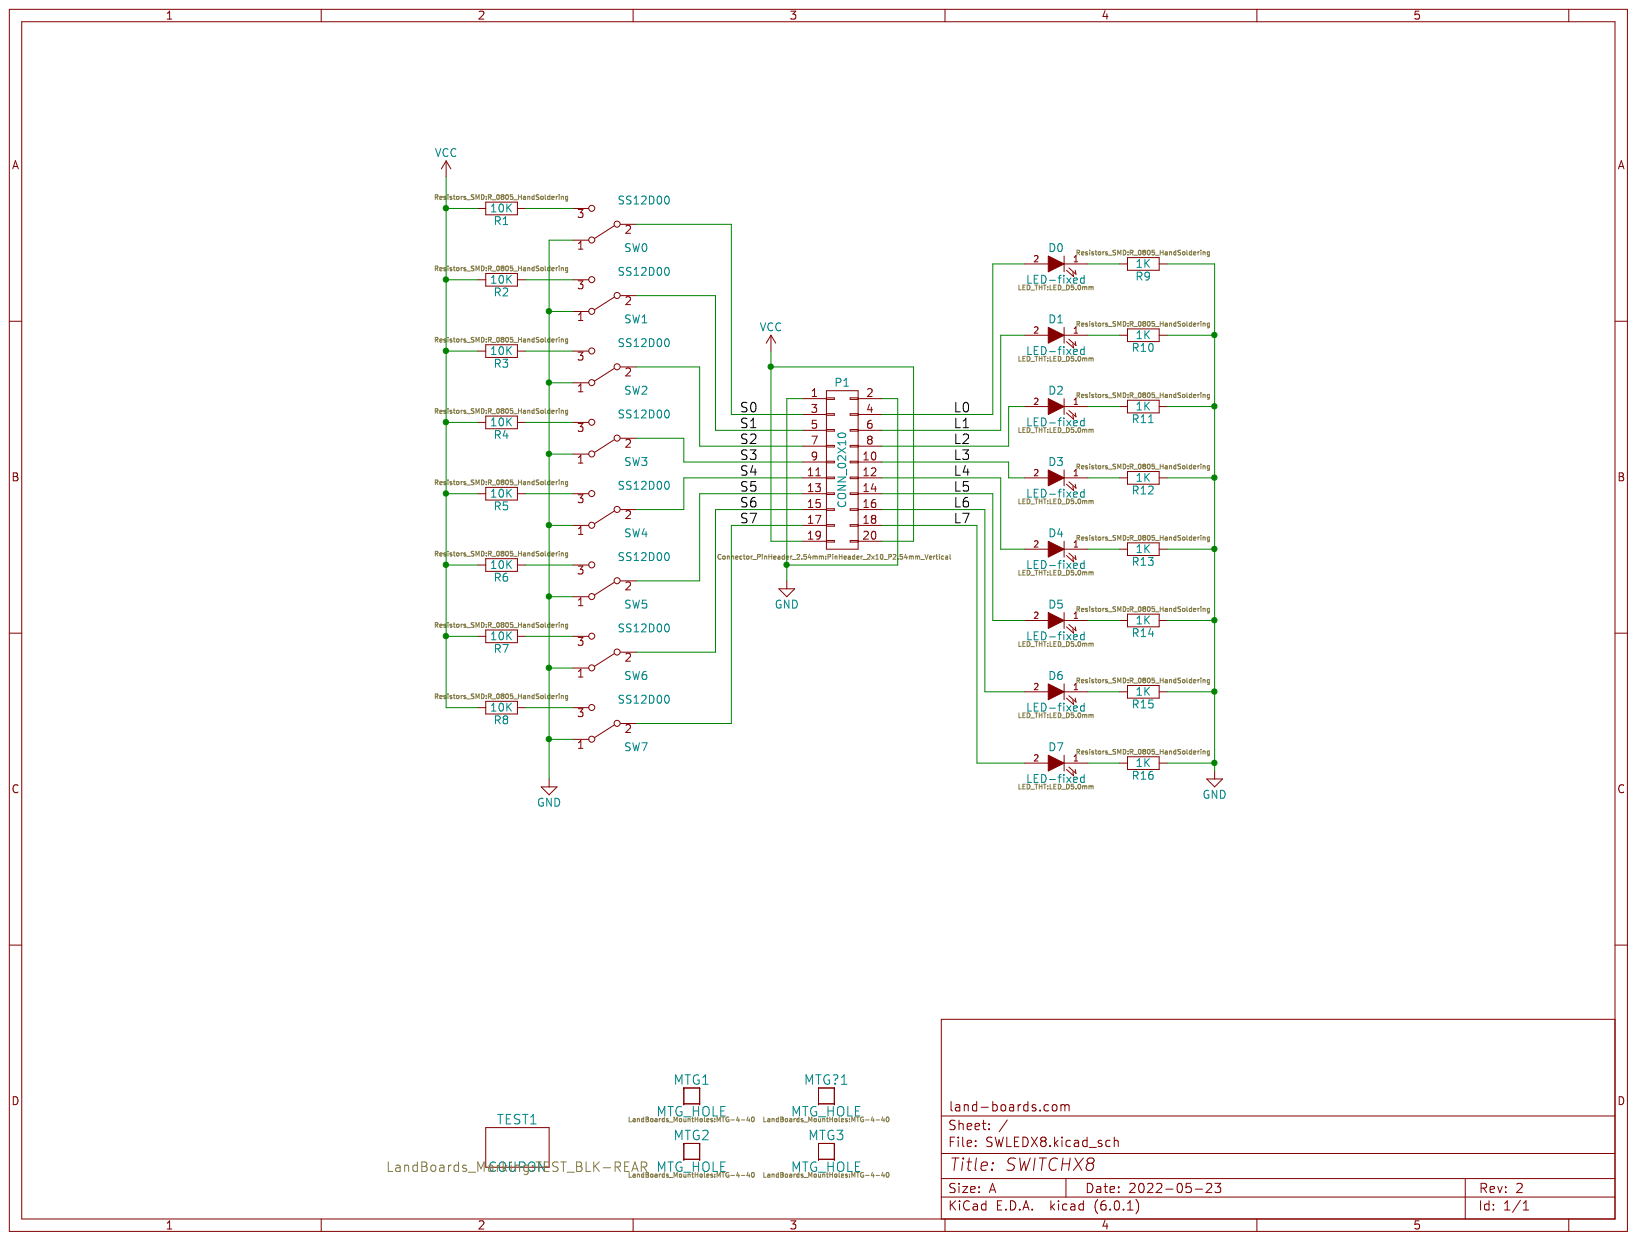
[picture p509: page 1]
