land-boards/lb-boards/LEDs Cards/LEDS-SWITCHES _2/LEDS-SWITCHES-2_REV1_Schematic.pdf

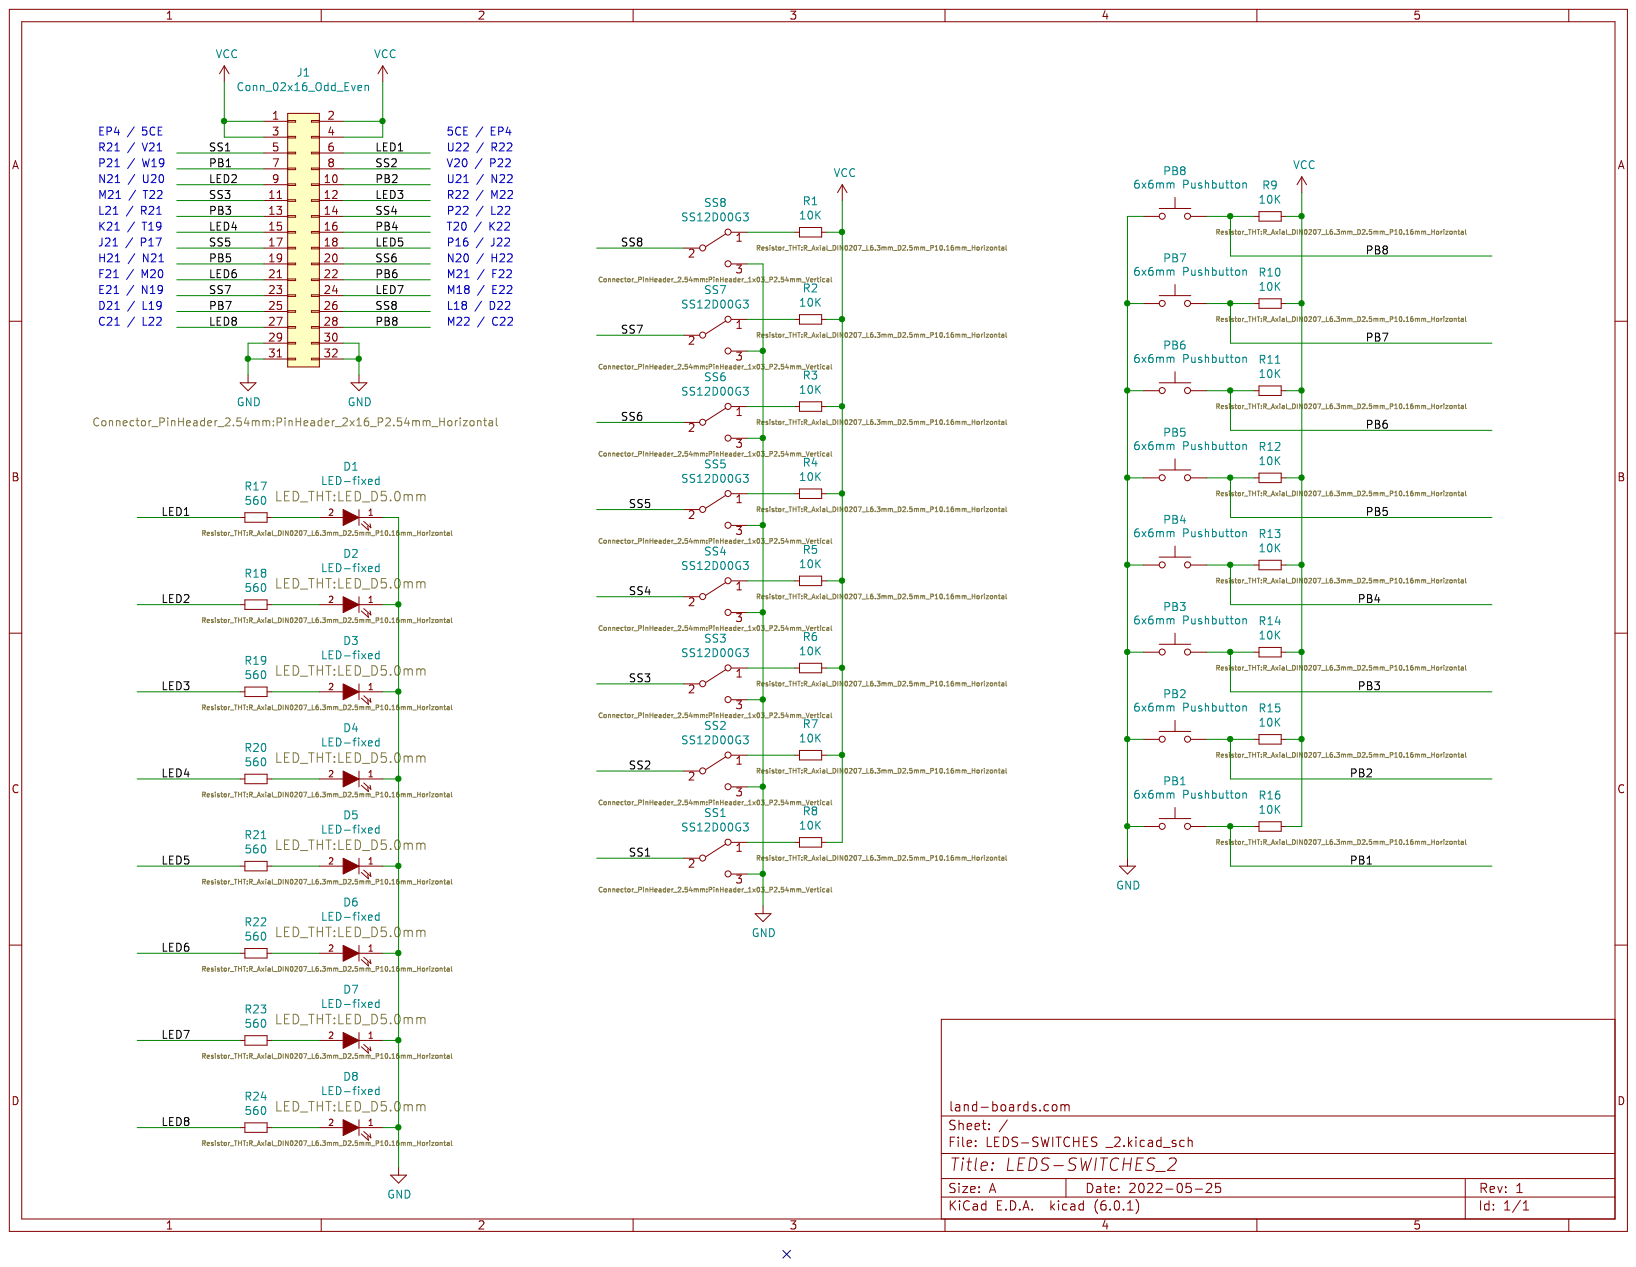
[picture p510: page 1]
