land-boards/lb-boards/ODAS Cards/ODAS-PSOC5/ODAS-PSOC5LP-Rev5-Schematic.pdf

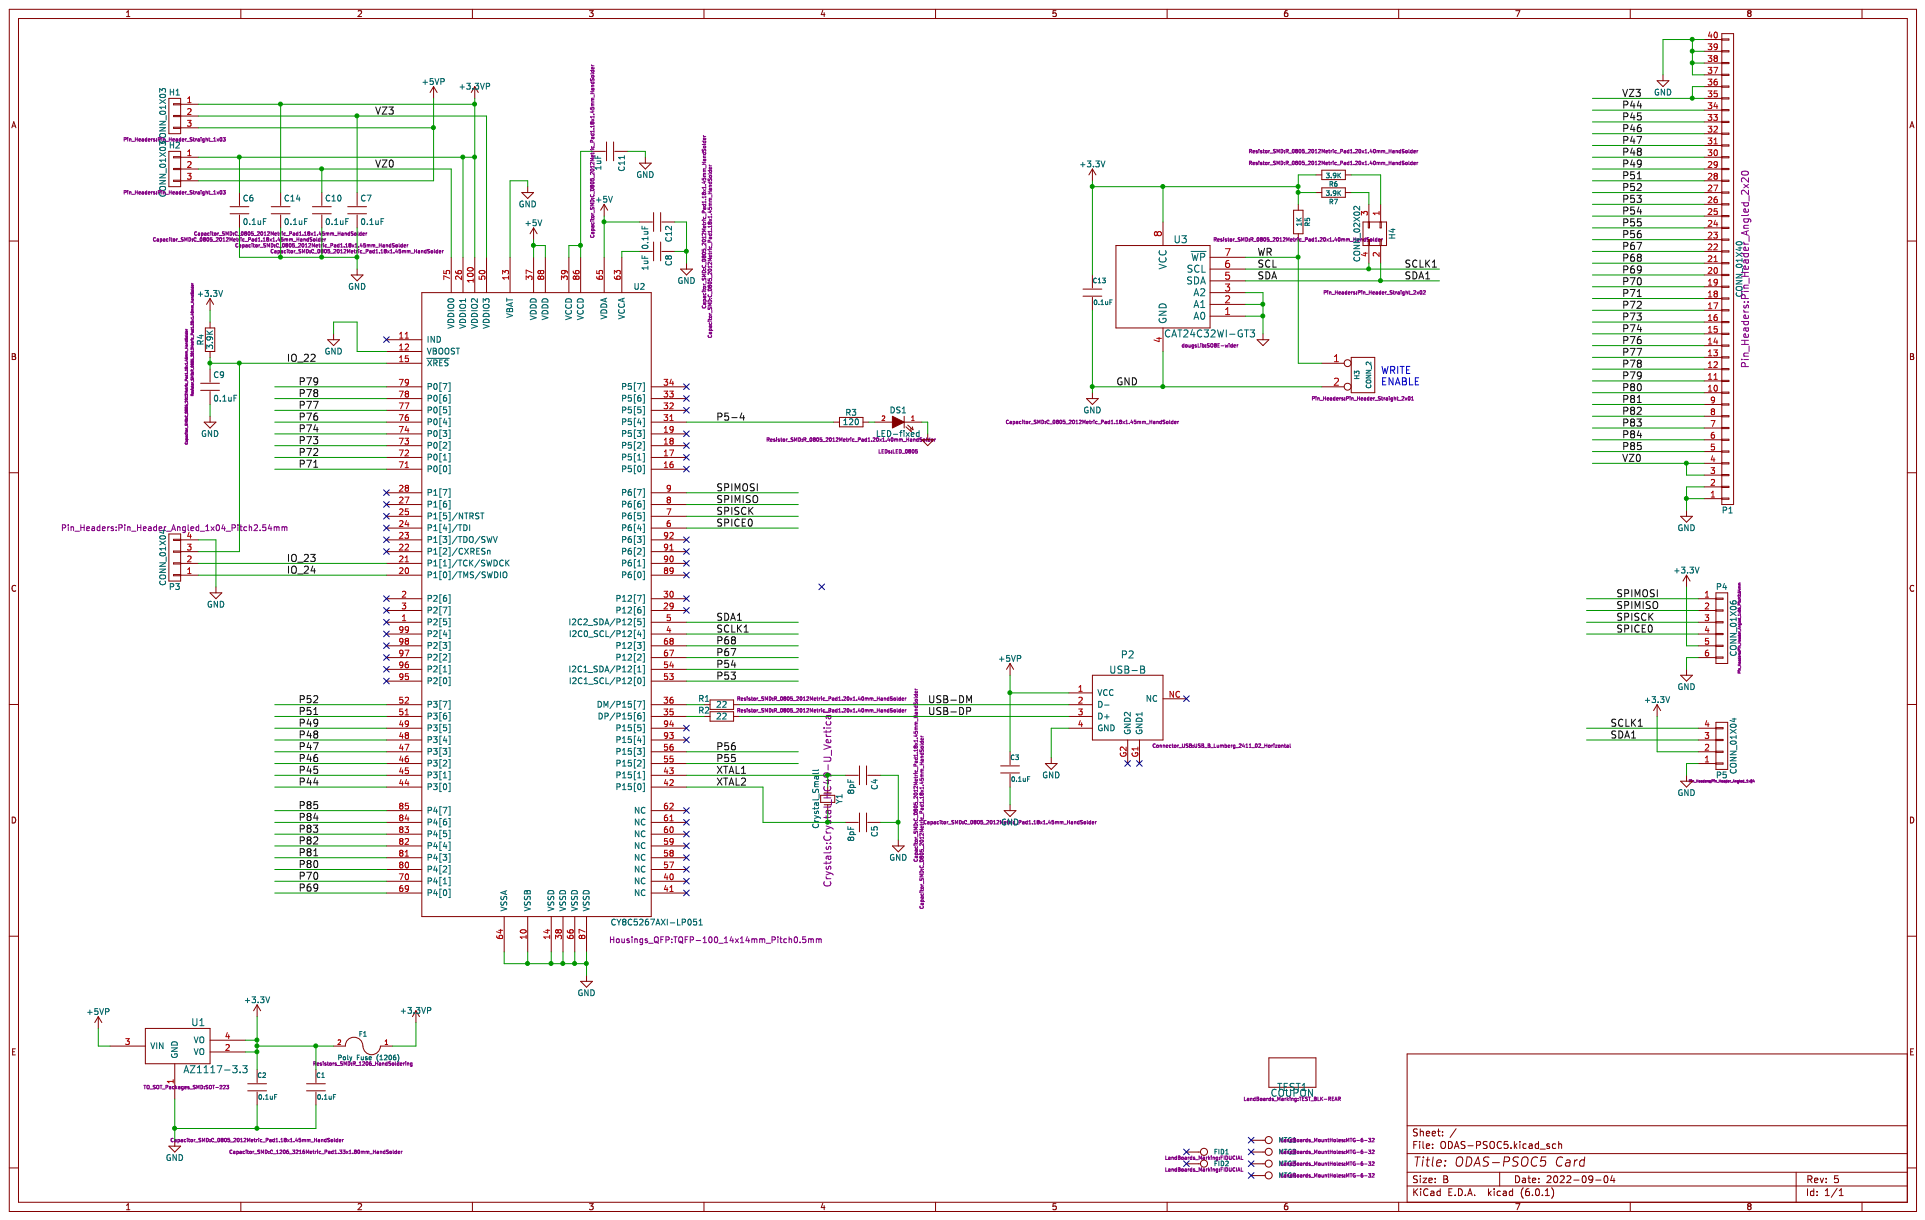
[picture p511: page 1]
