land-boards/lb-boards/ODAS Cards/PS2X49/PS2X49_Rev3_Schematic.pdf

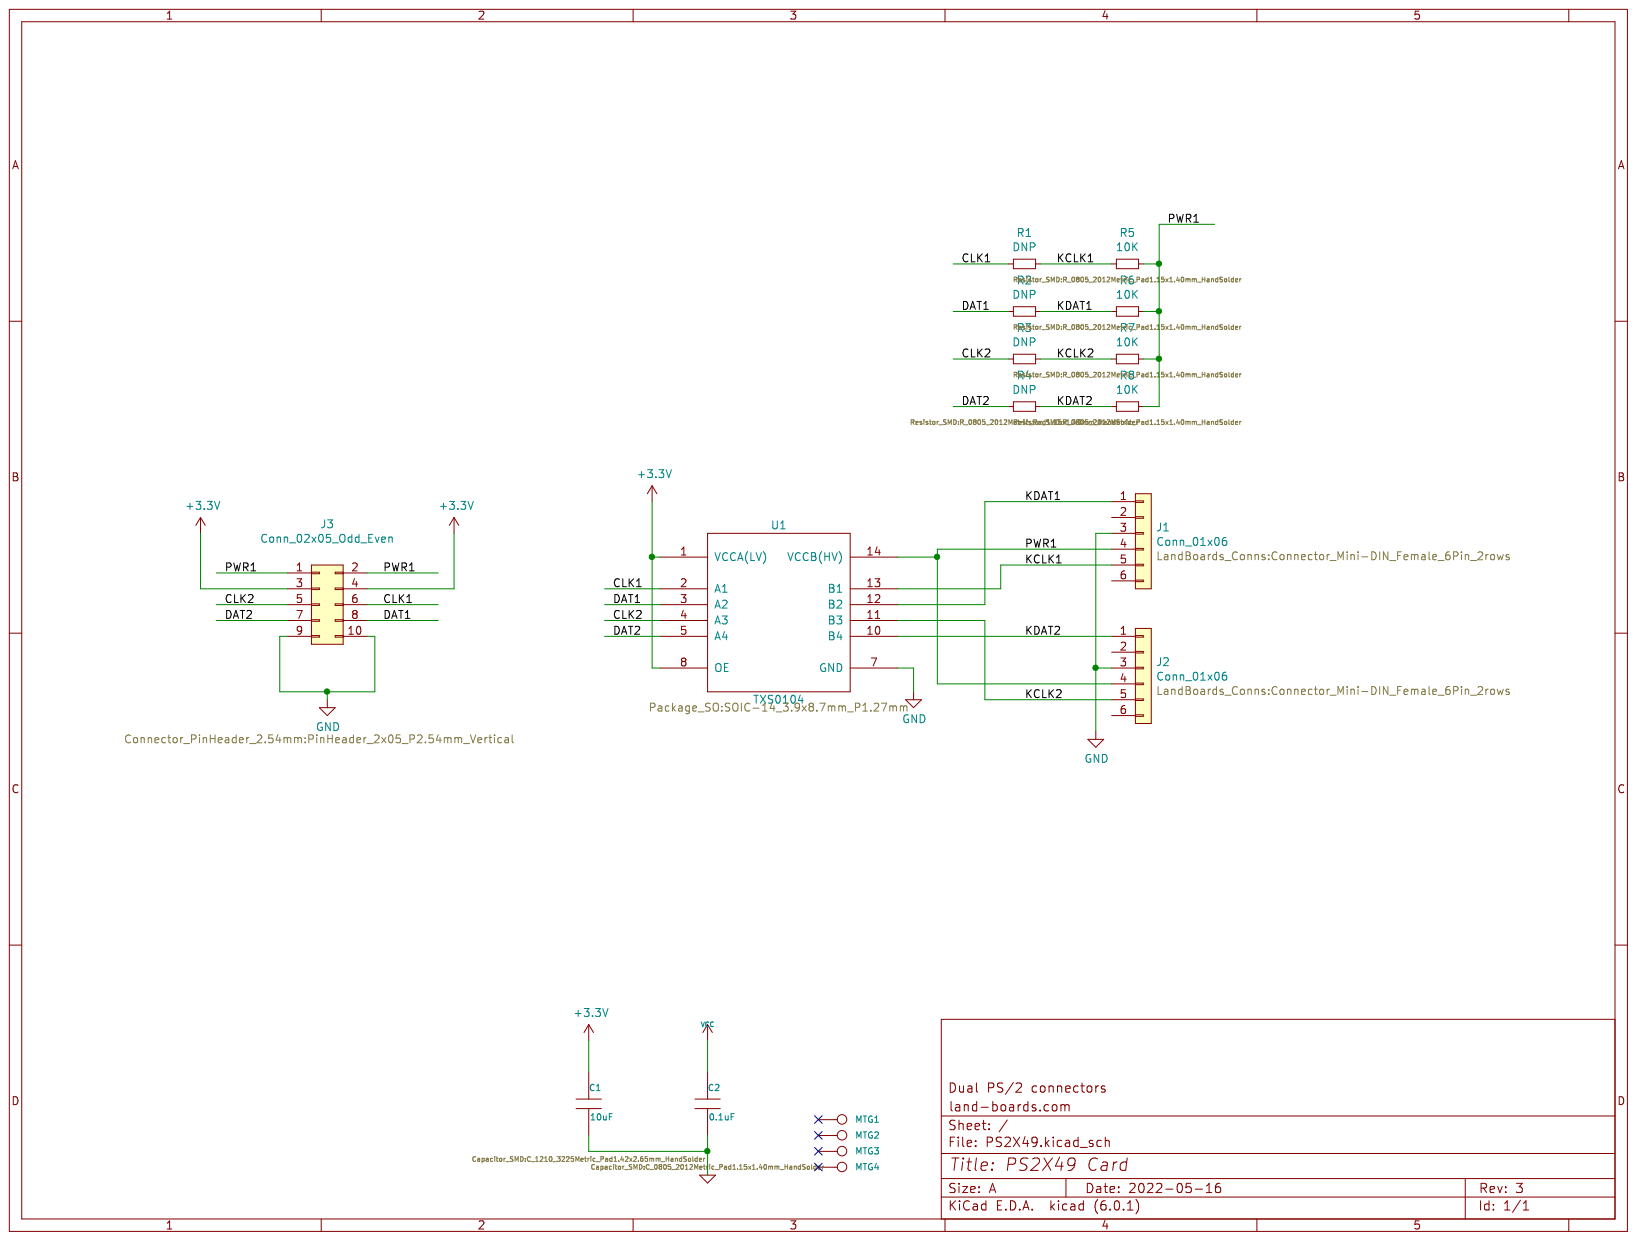
[picture p512: page 1]
