land-boards/lb-boards/ODAS Cards/SD_CARD_X49/SD_CARD_X49_REV2_SCHEMATIC.pdf

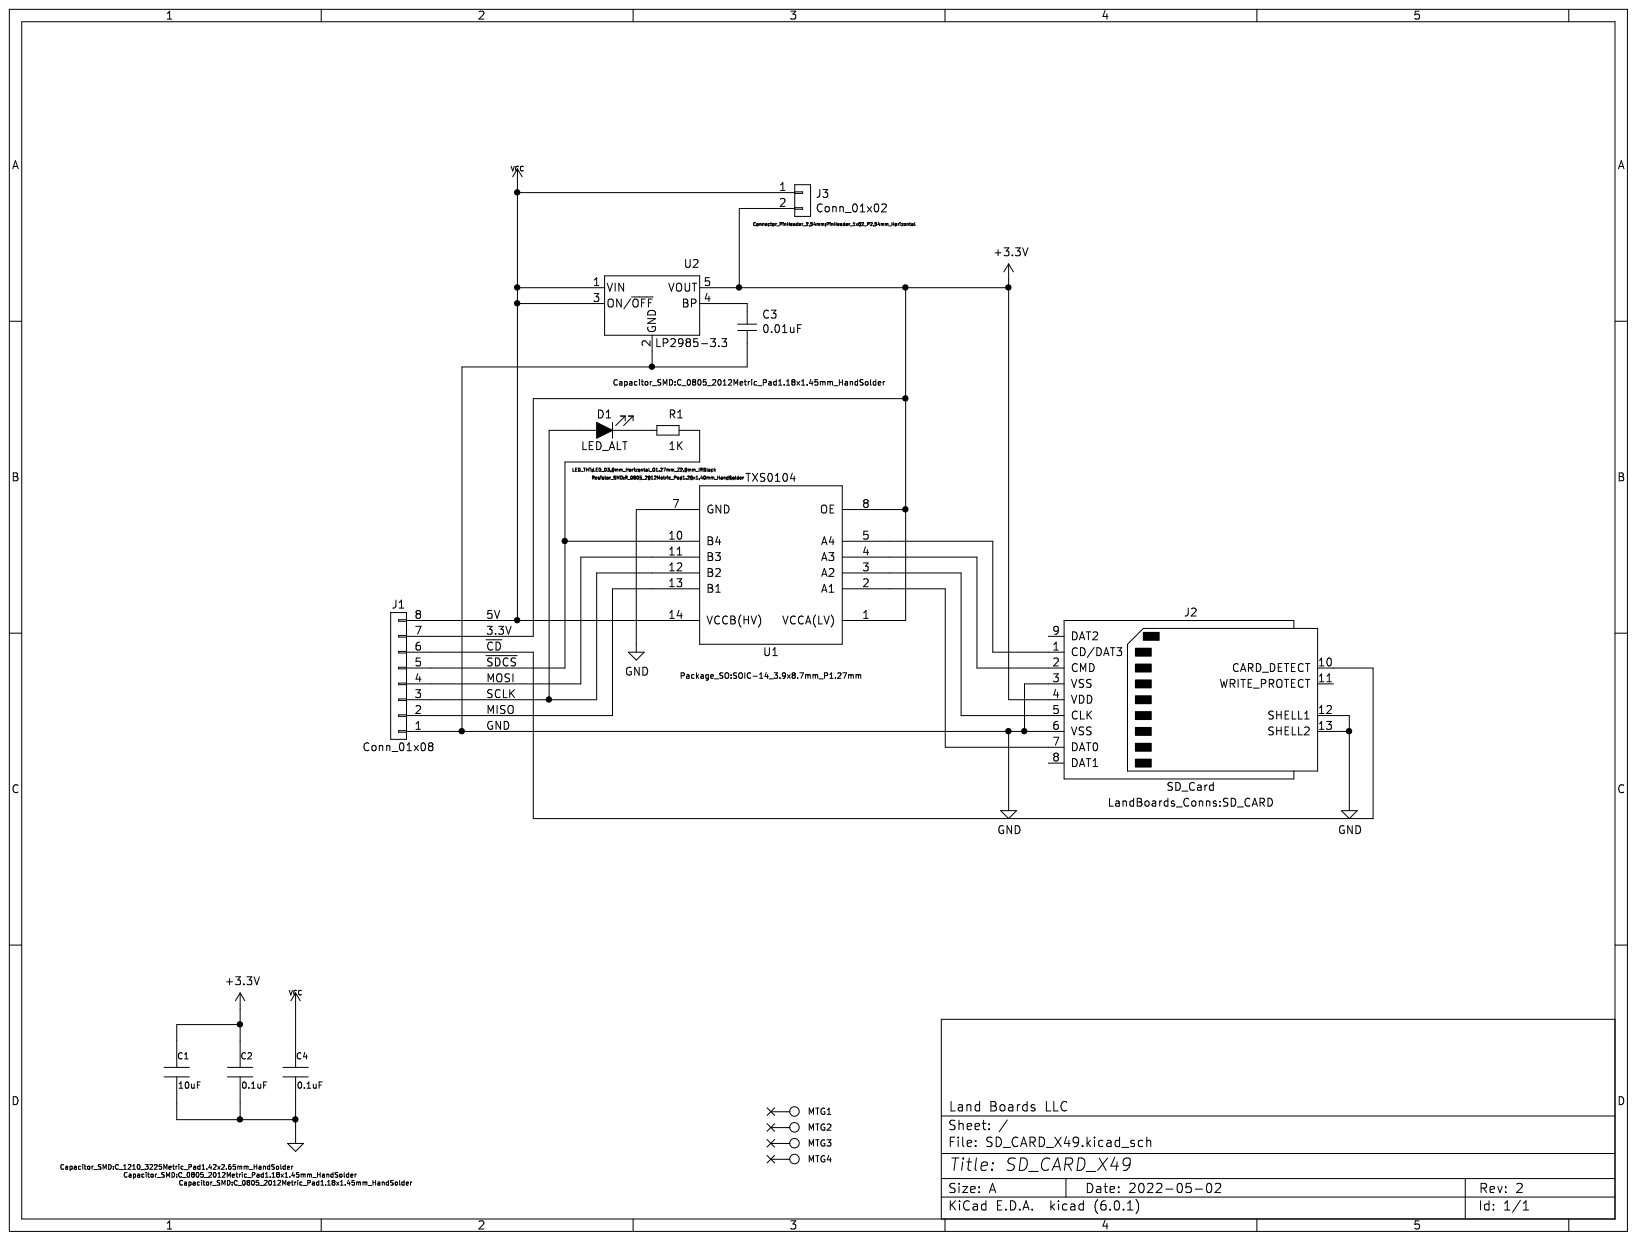
[picture p513: page 1]
