land-boards/lb-boards/Raspberry Pi Cards/PicoVGA/PicoVGA01_Rev1_Schematic.pdf

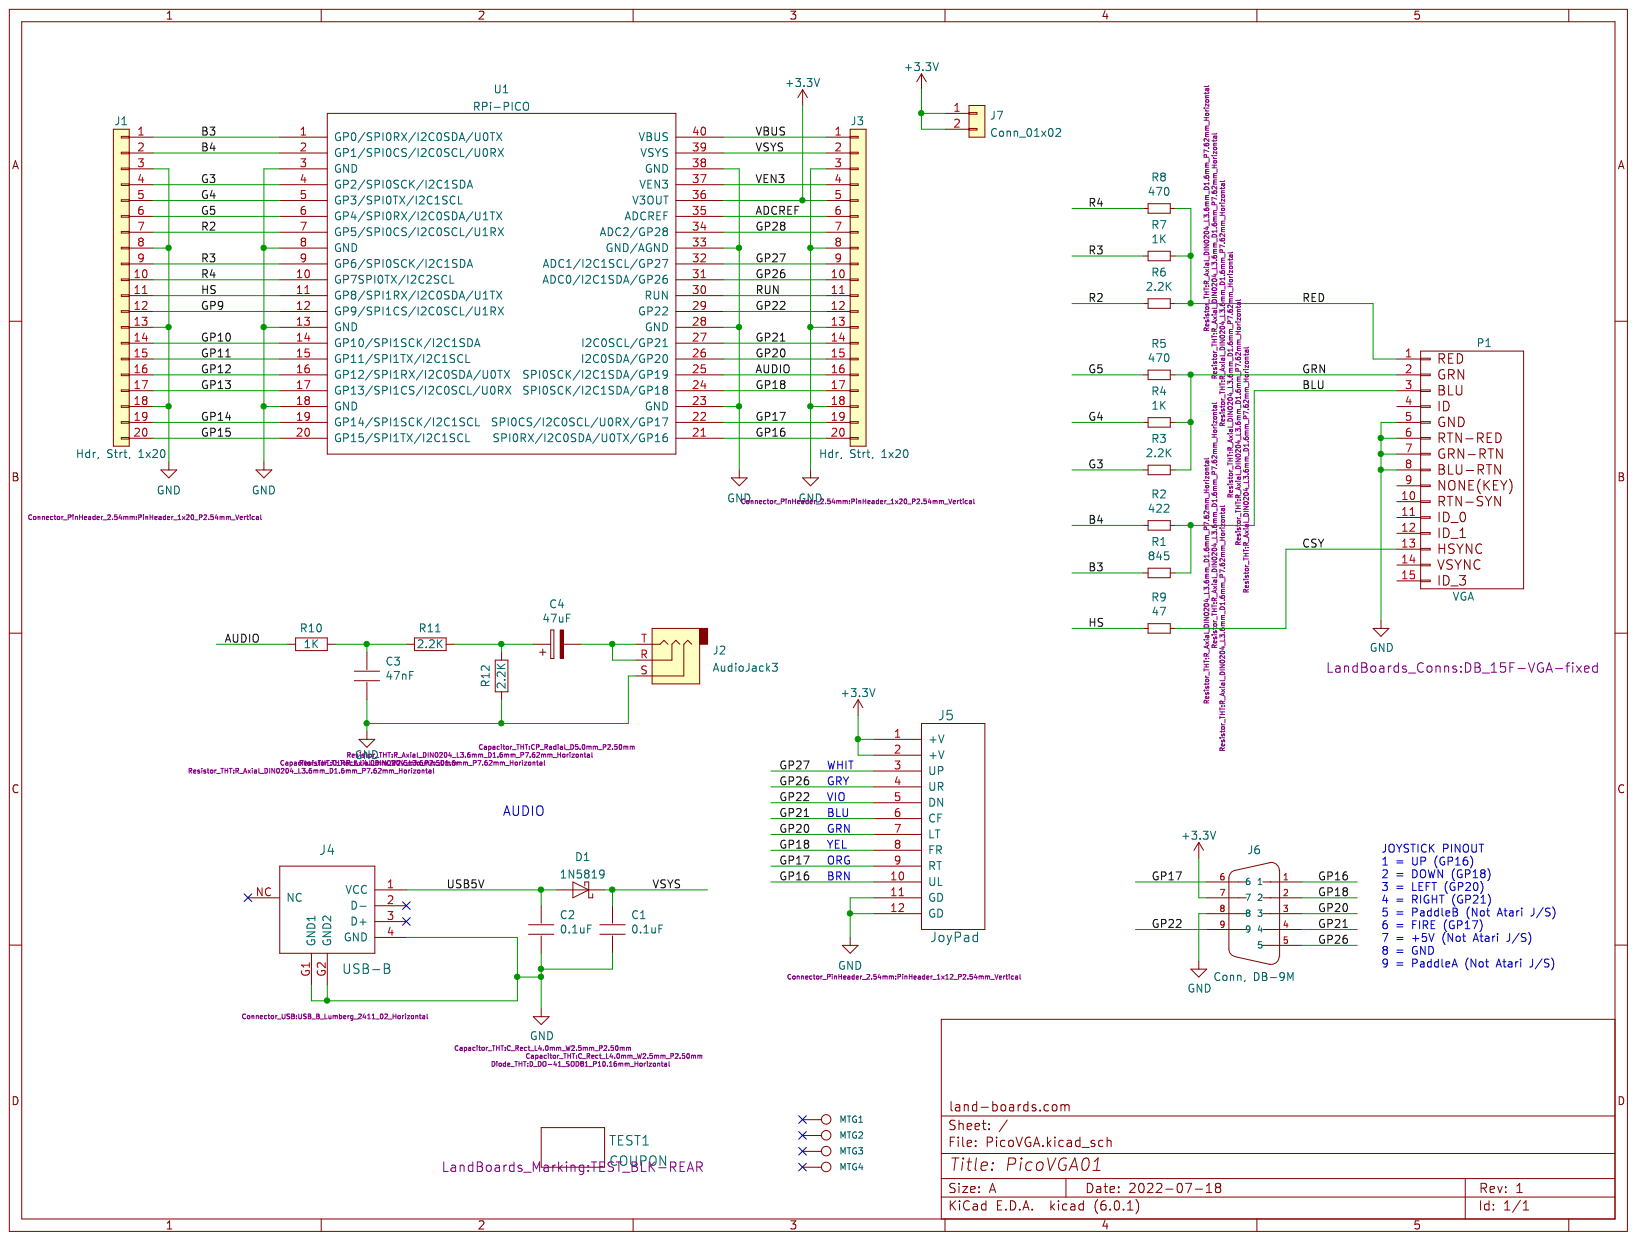
[picture p514: page 1]
