land-boards/lb-boards/Raspberry Pi Cards/PiPico_SDK/PiPico_SDK_Rev1_Schematic.pdf

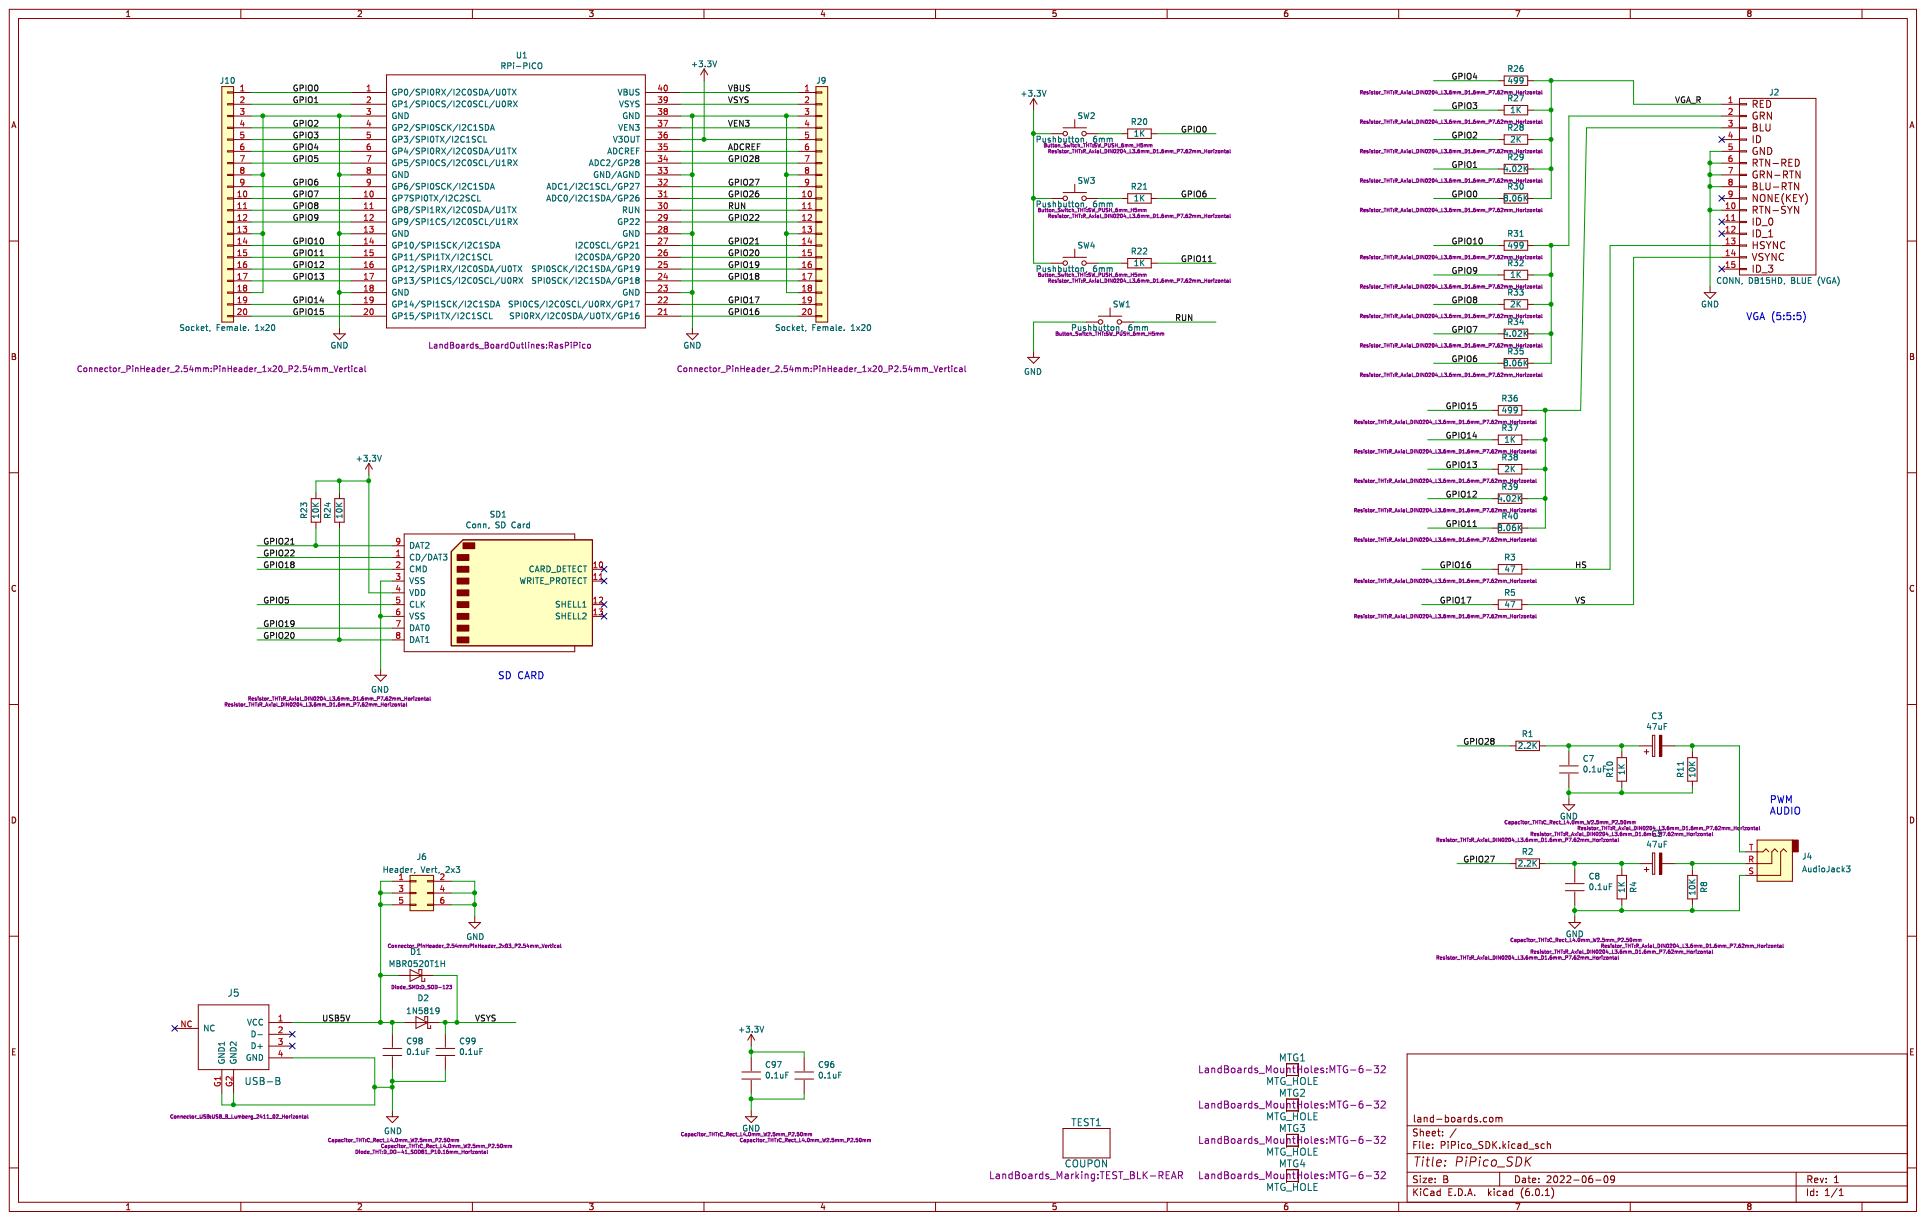
[picture p515: page 1]
