land-boards/lb-boards/Raspberry Pi Cards/PiPicoMite01/PiPicoMite01_Rev2_Schematic.pdf

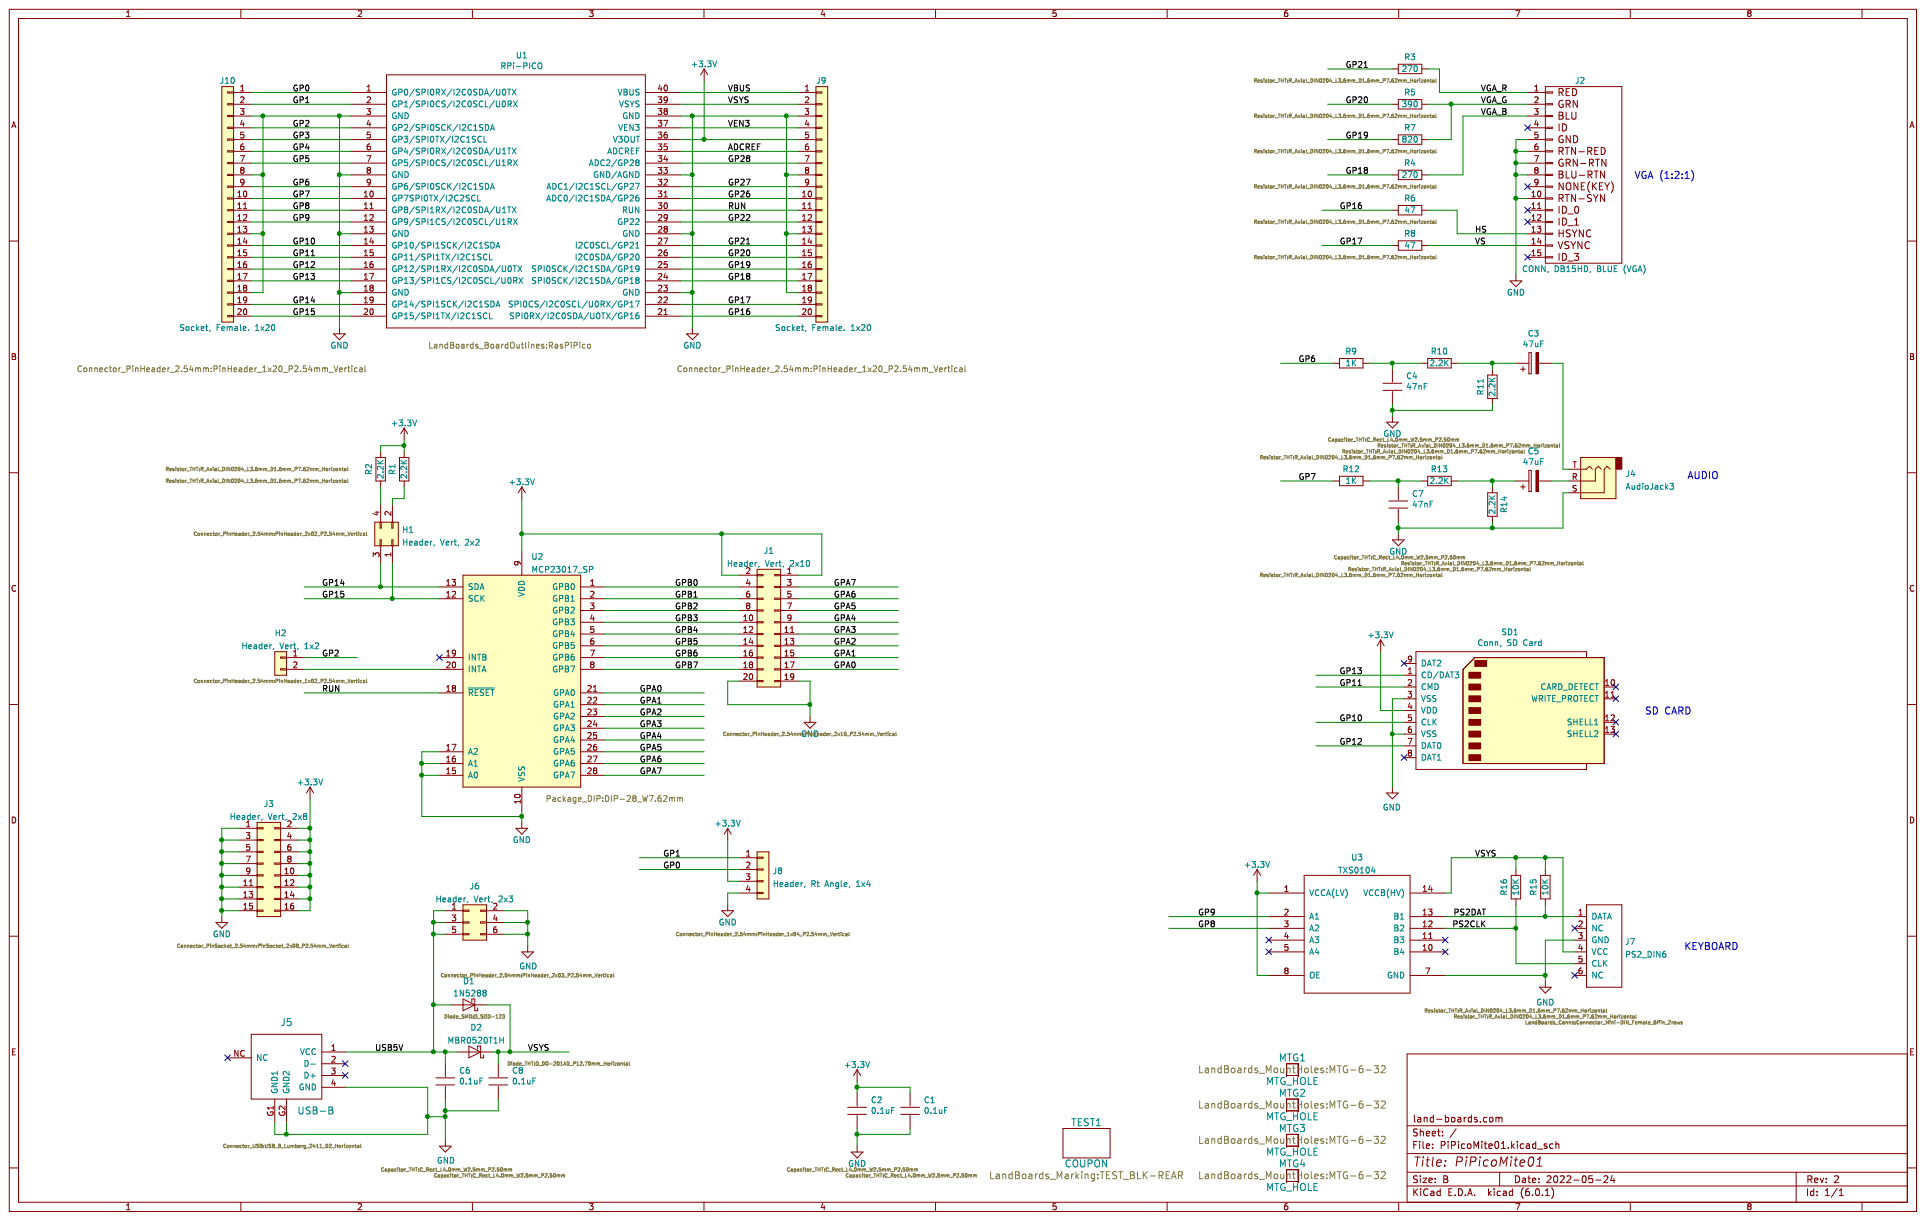
[picture p516: page 1]
