land-boards/lb-boards/Raspberry Pi Cards/PiPicoMite02/PiPicoMite02_Rev1_Schematic.pdf

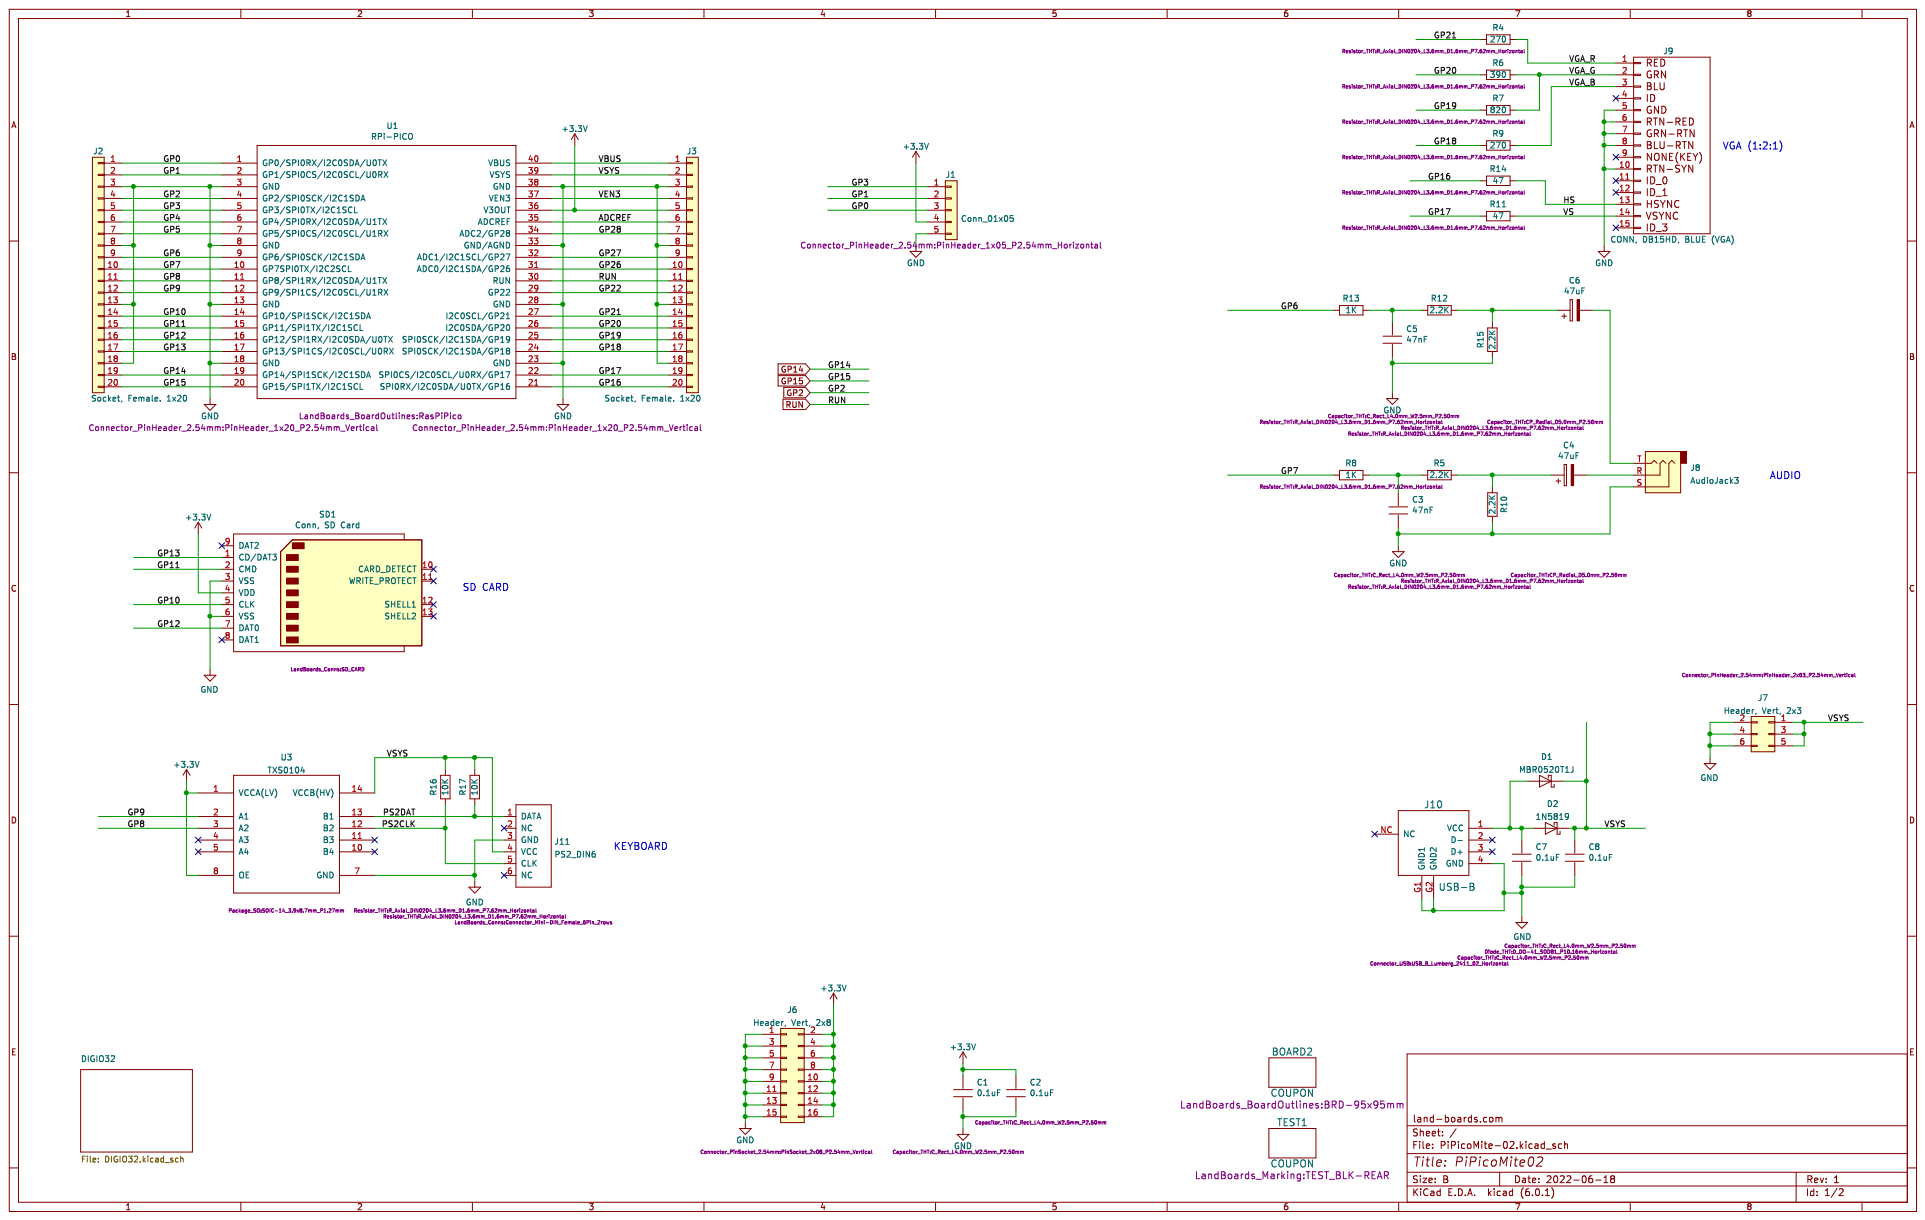
[picture p517: page 1]

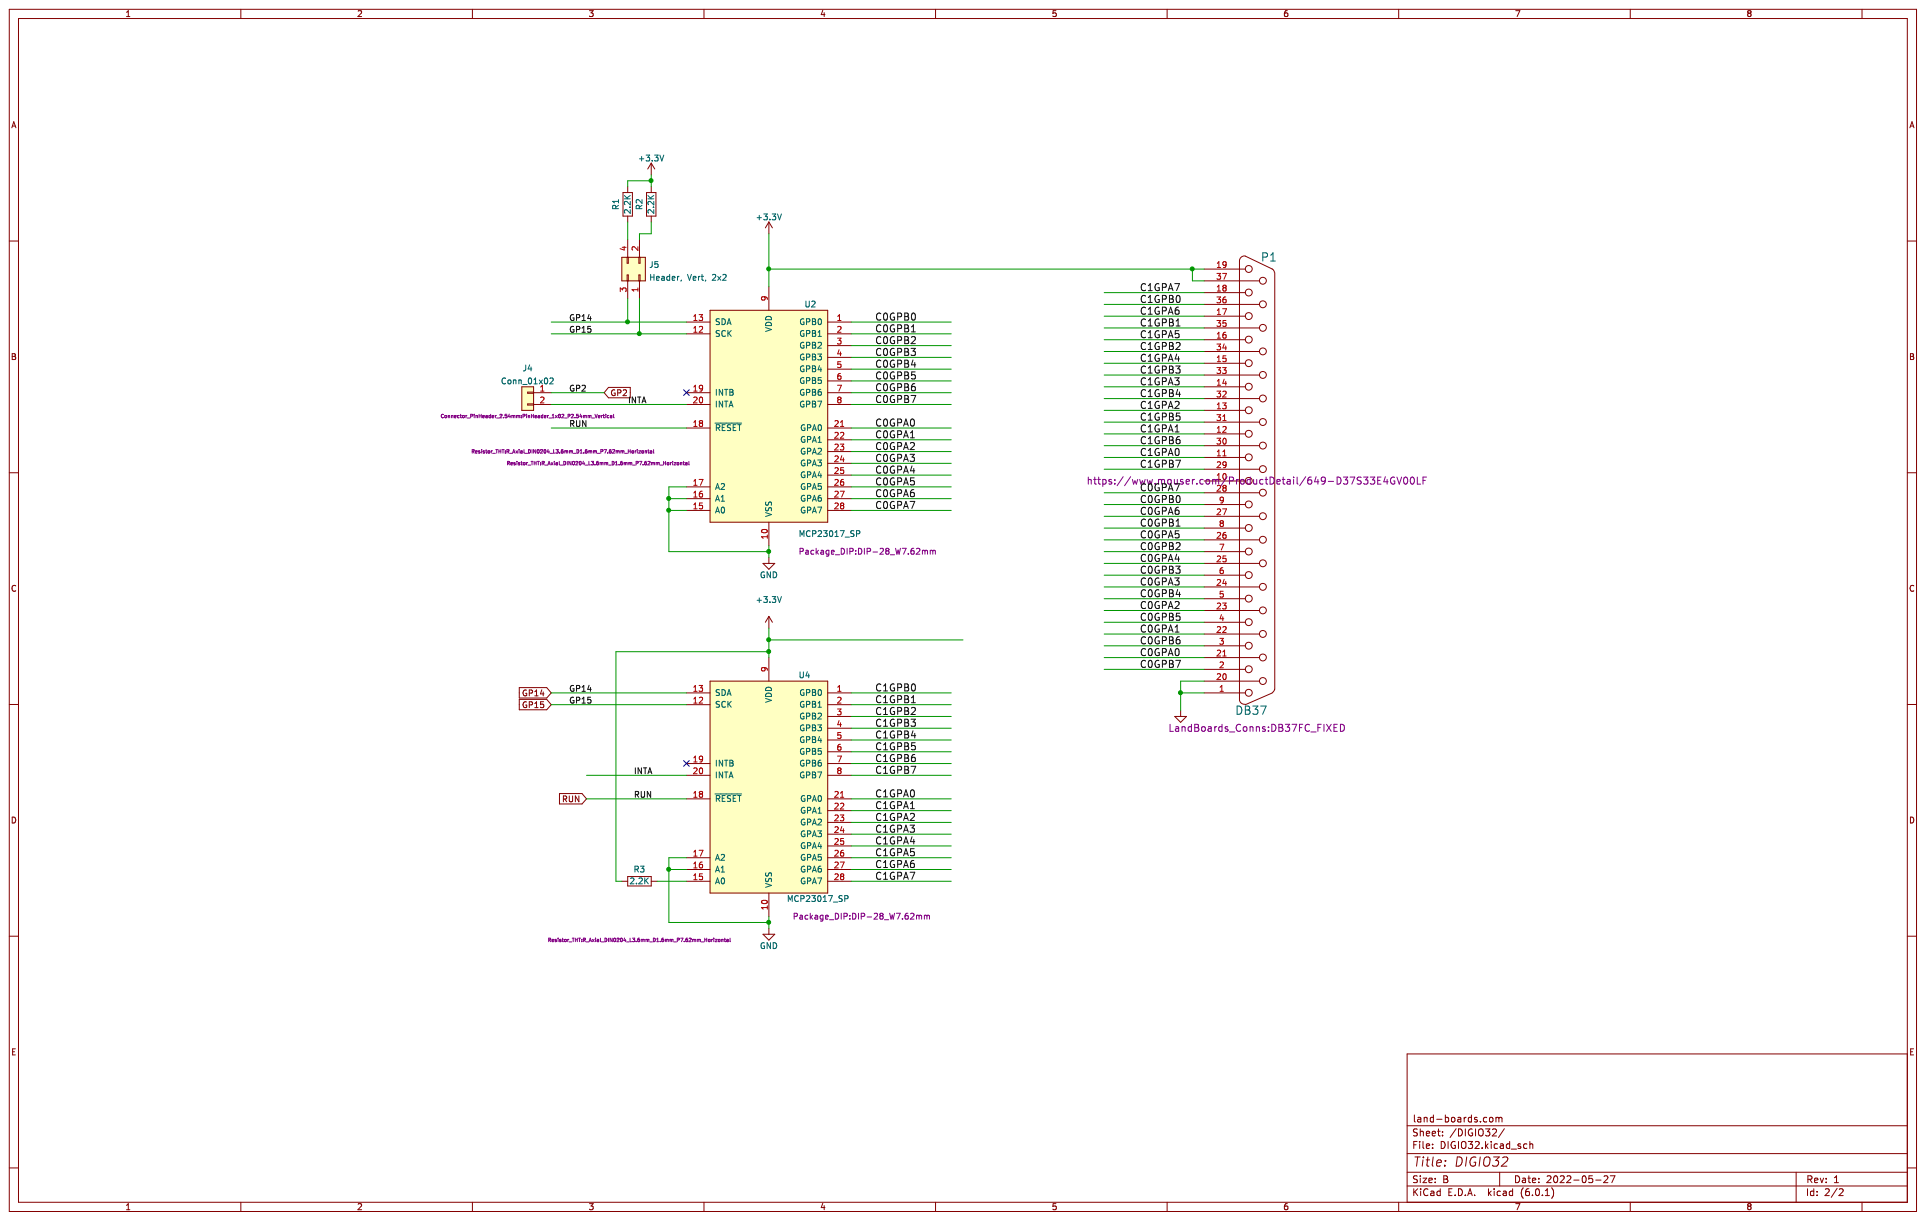
[picture p518: page 2]
