land-boards/lb-boards/Raspberry Pi Cards/PiPicoMite03/PiPicoMite03_Rev1_Schematic.pdf

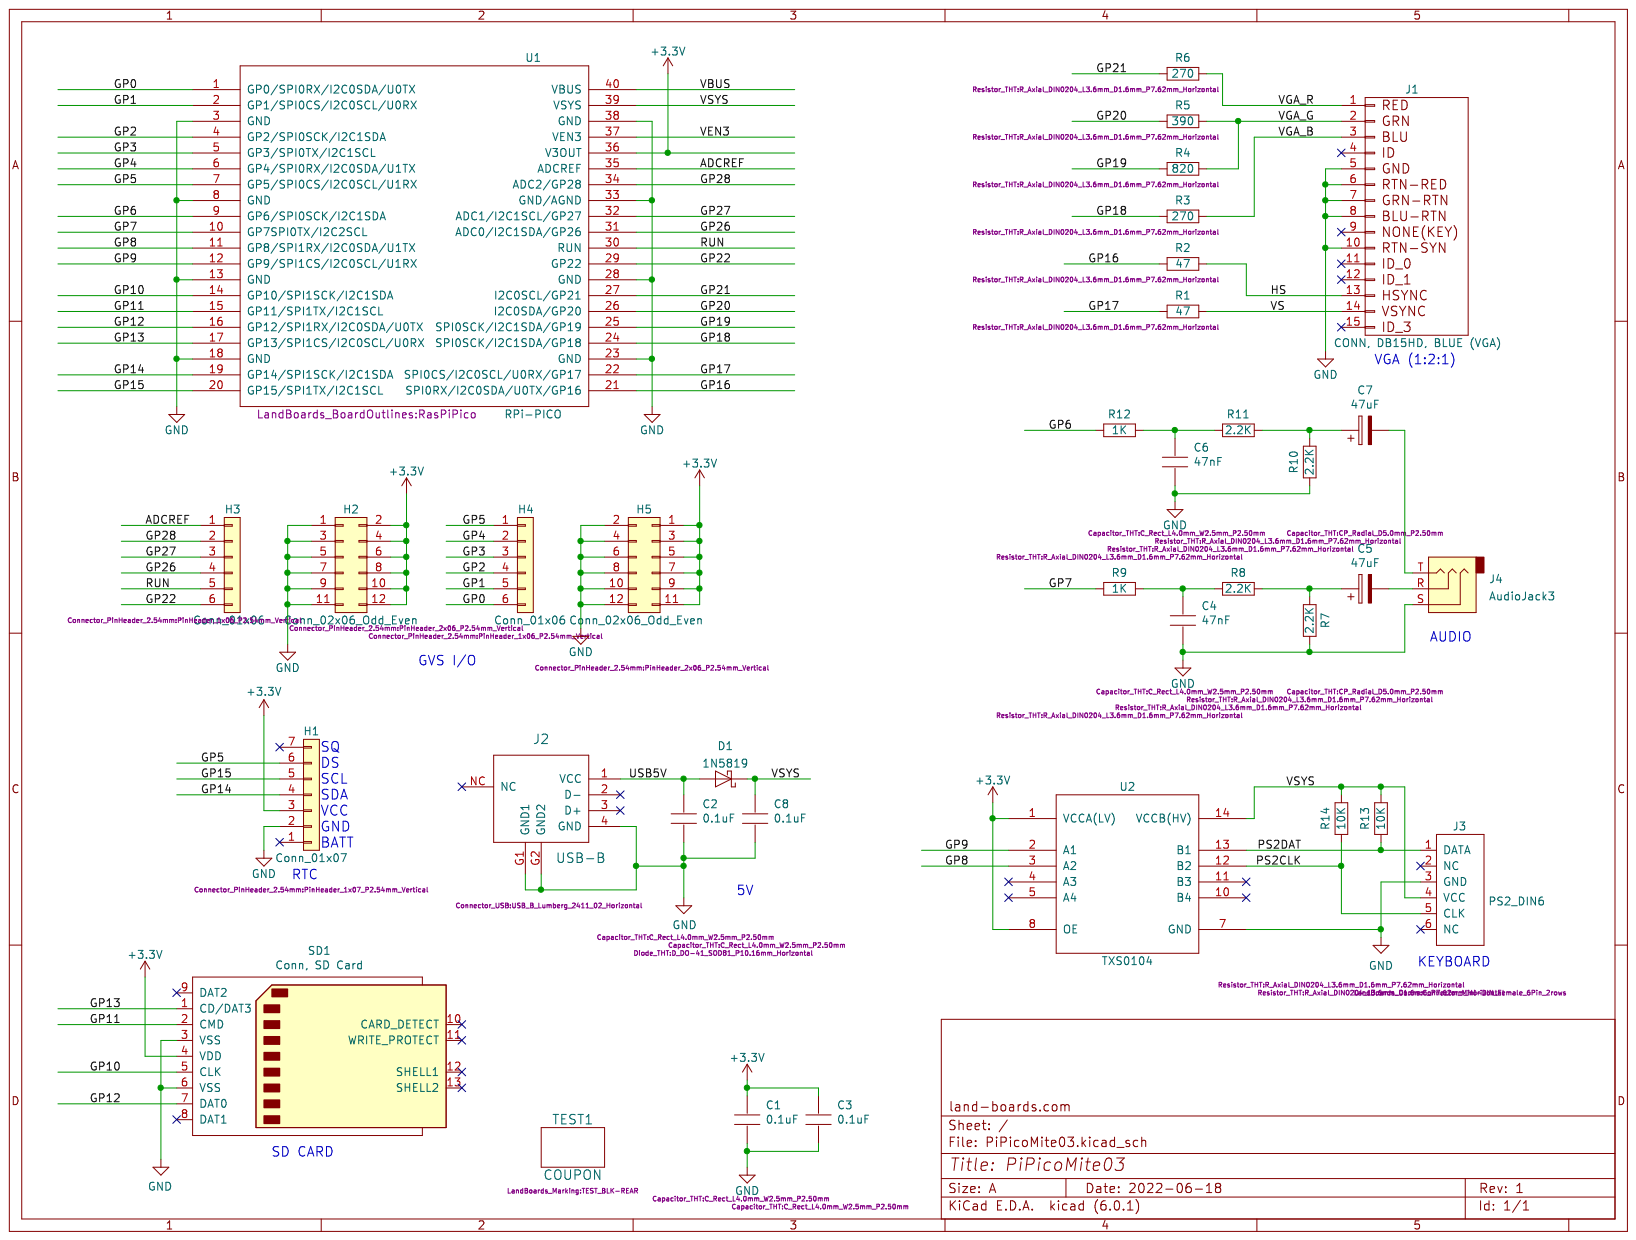
[picture p519: page 1]
