land-boards/lb-boards/Raspberry Pi Cards/RPI_SPI8/RPI_SPI8_Schematic_Rev3.pdf

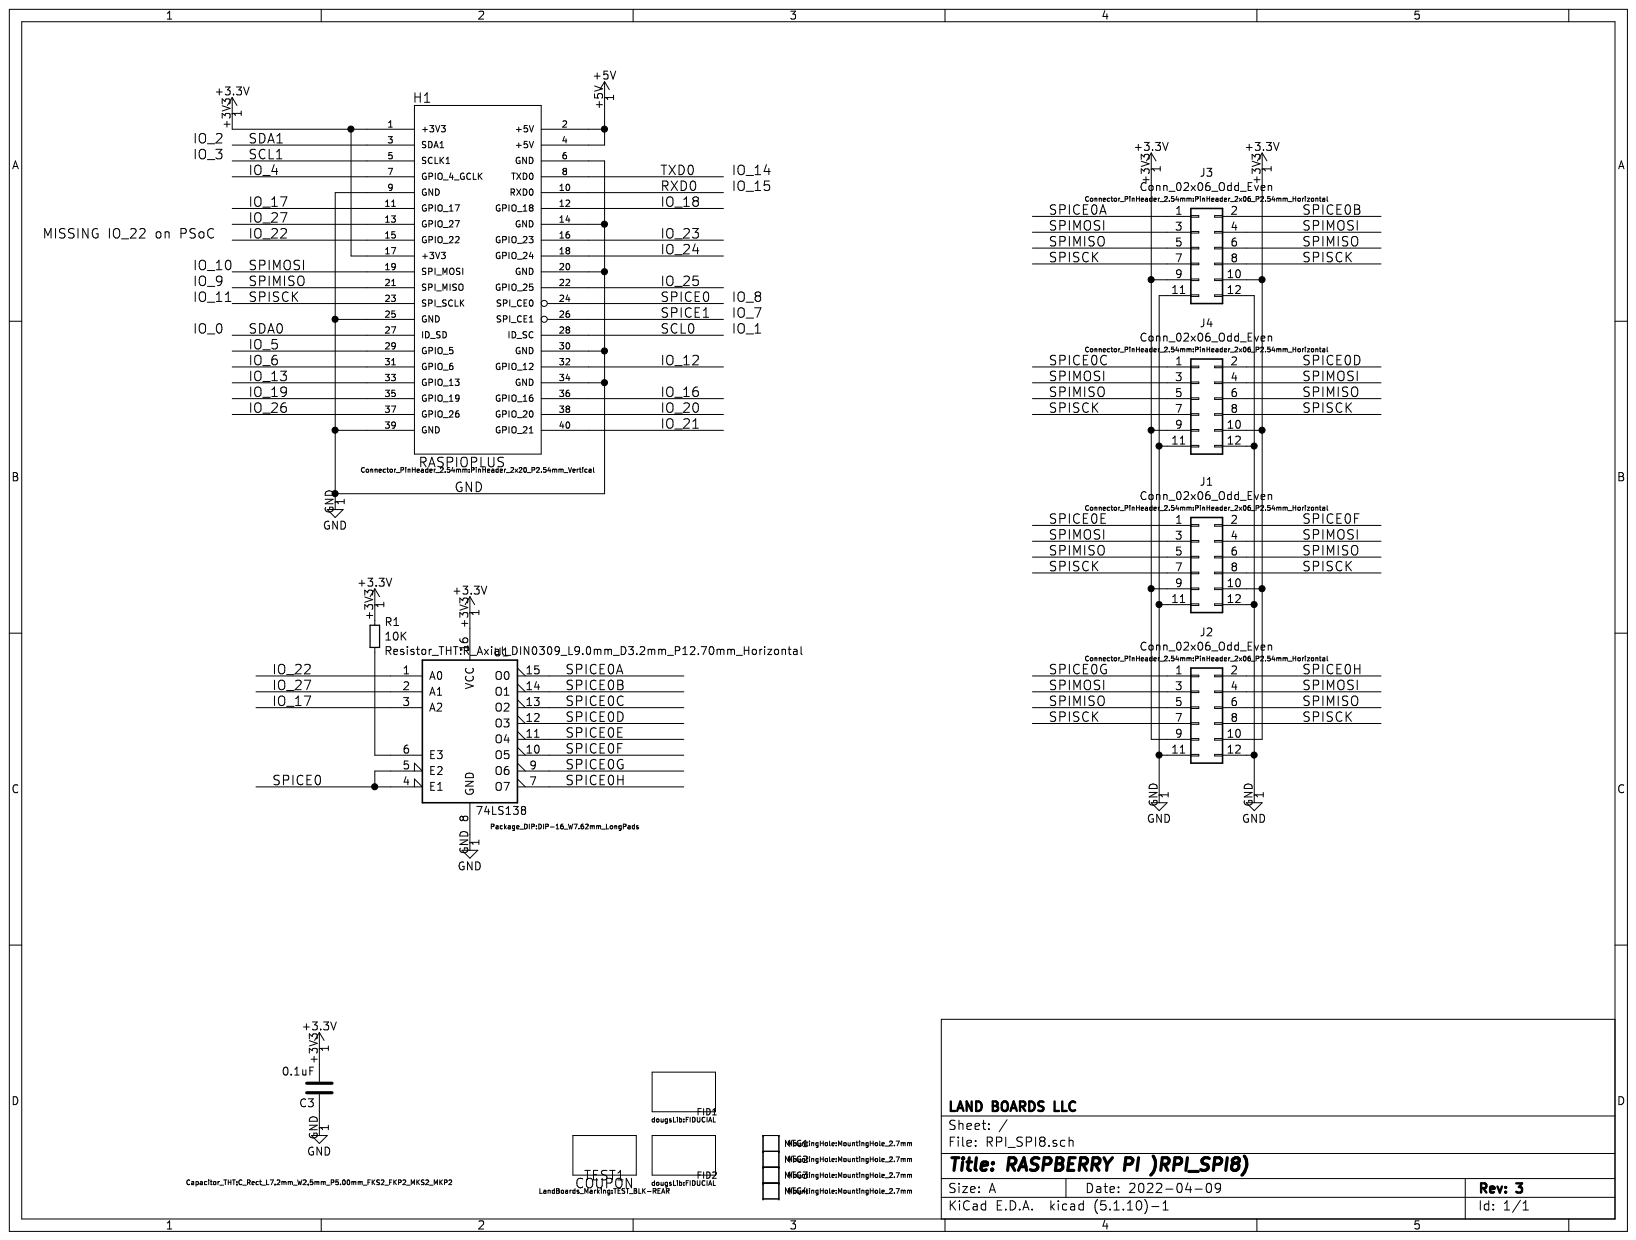
[picture p520: page 1]
