land-boards/lb-boards/Analog Cards/SPI-POTX2/SPI-POTX2_RevX1_Schematic.pdf

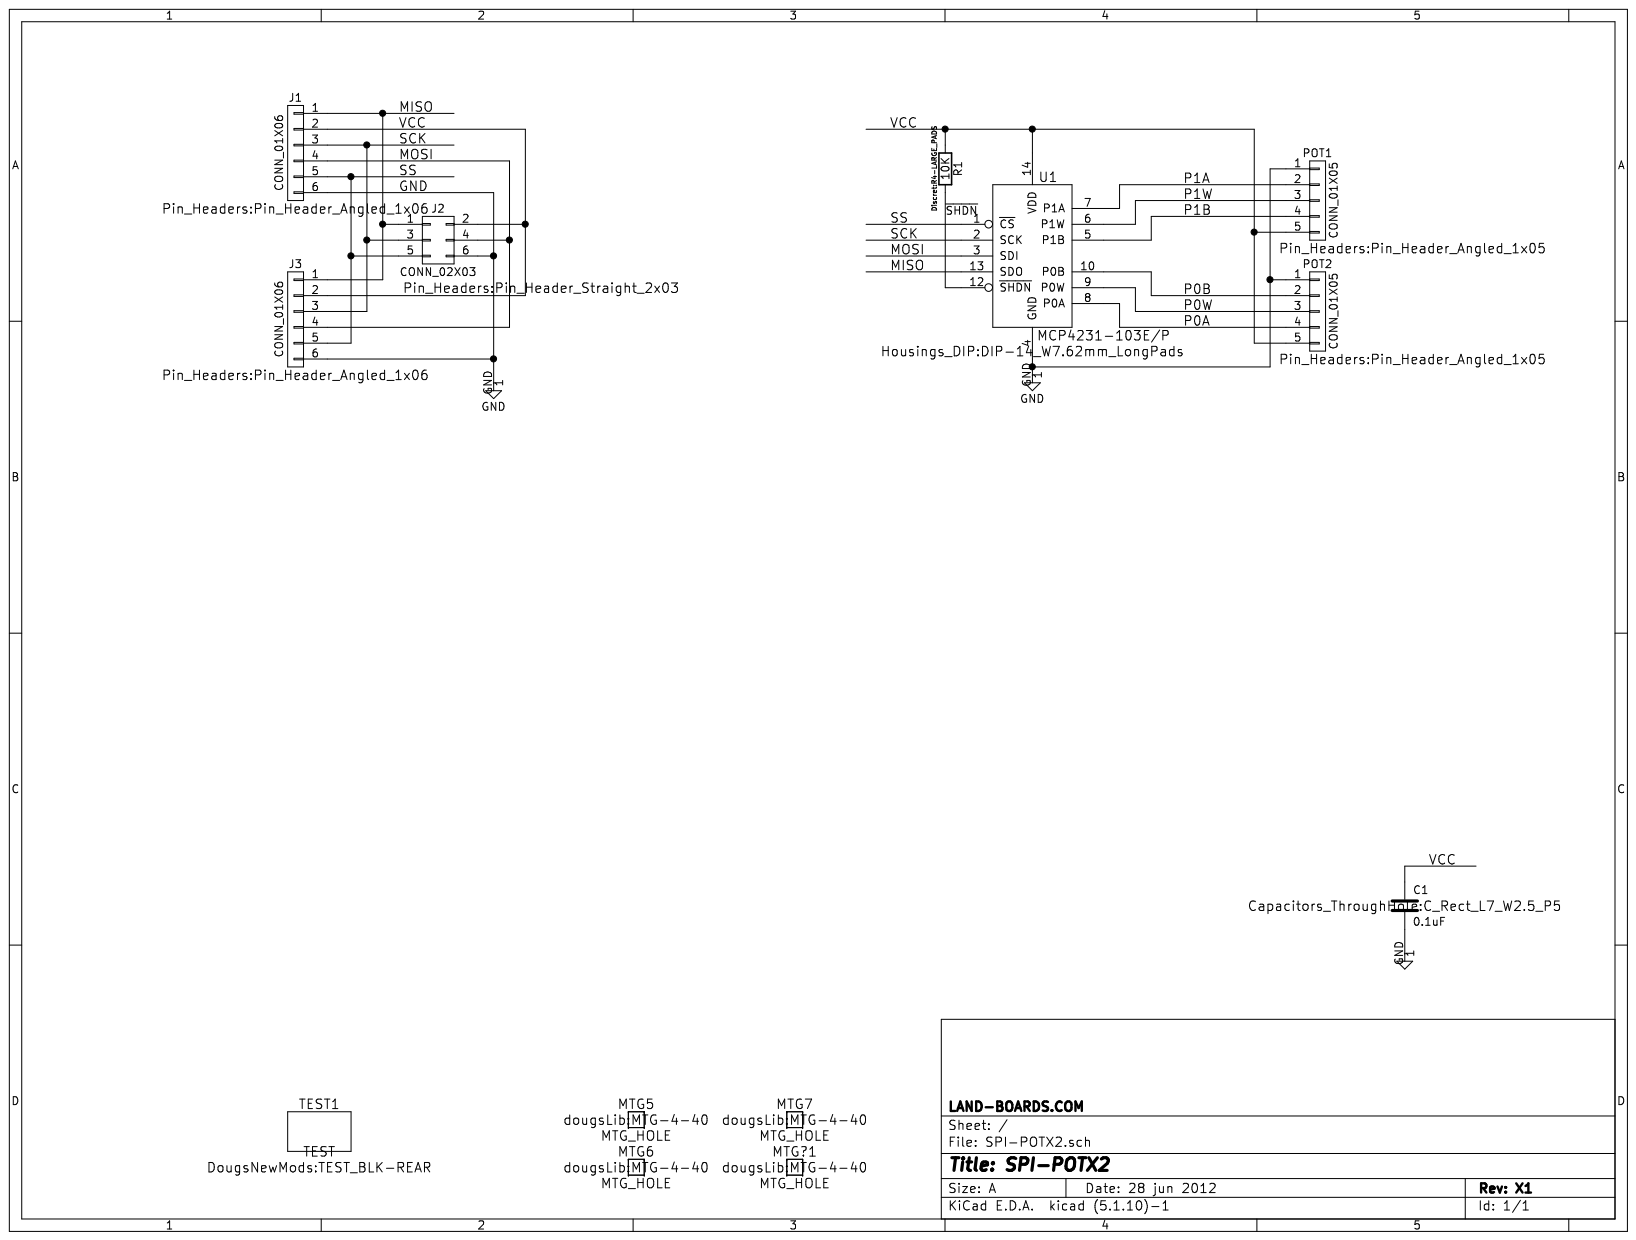
[picture p521: page 1]
