land-boards/lb-boards/BeagleBoneBlack Cards/BBB-COMMS-2/BBB_COMMS_2_RevX1_Schematic.pdf

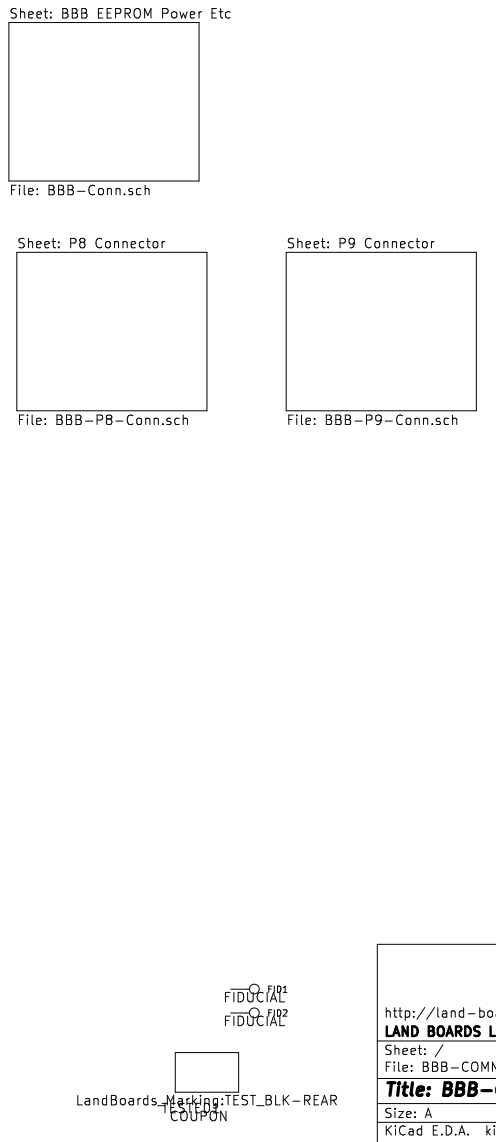
[picture p522: page 1]

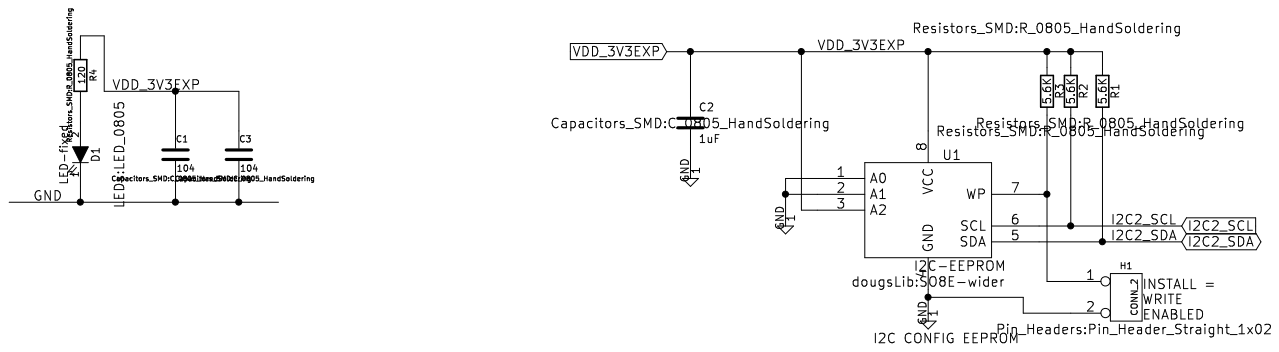
[picture p523: page 2]

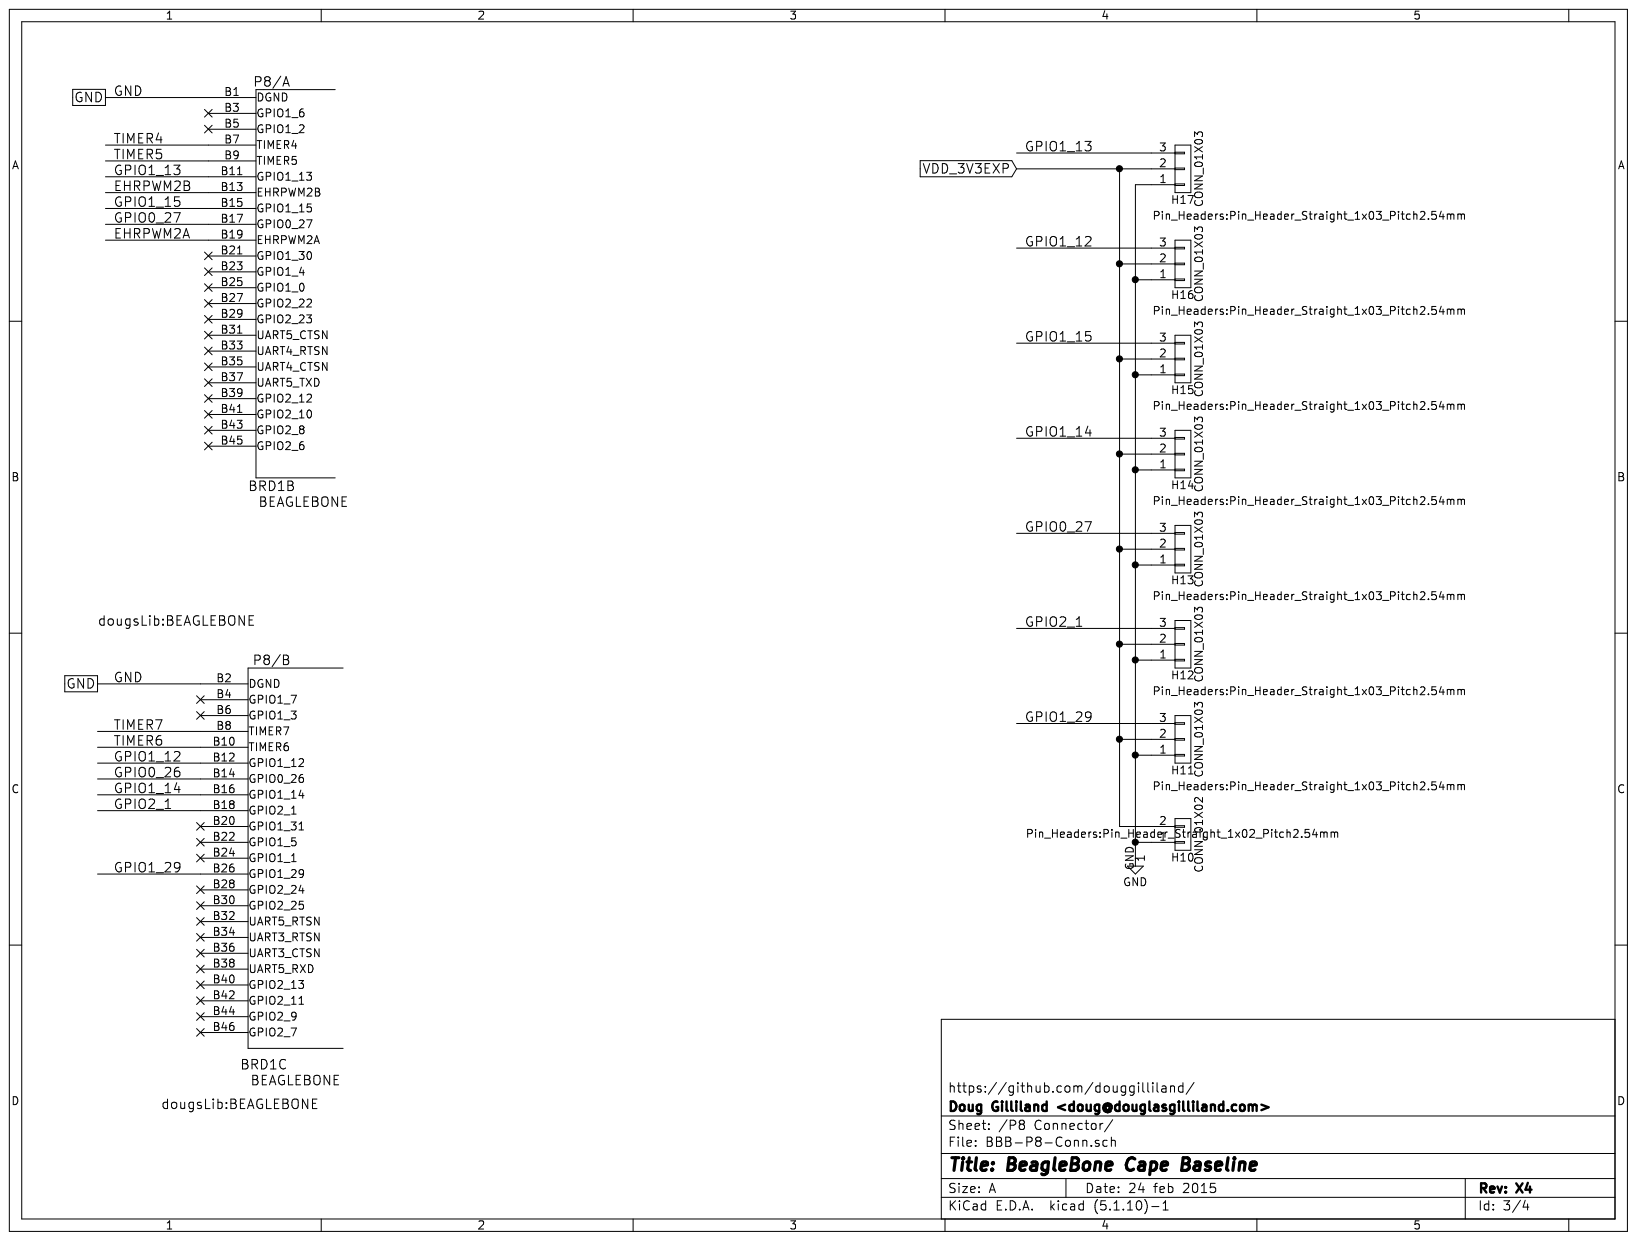
[picture p524: page 3]

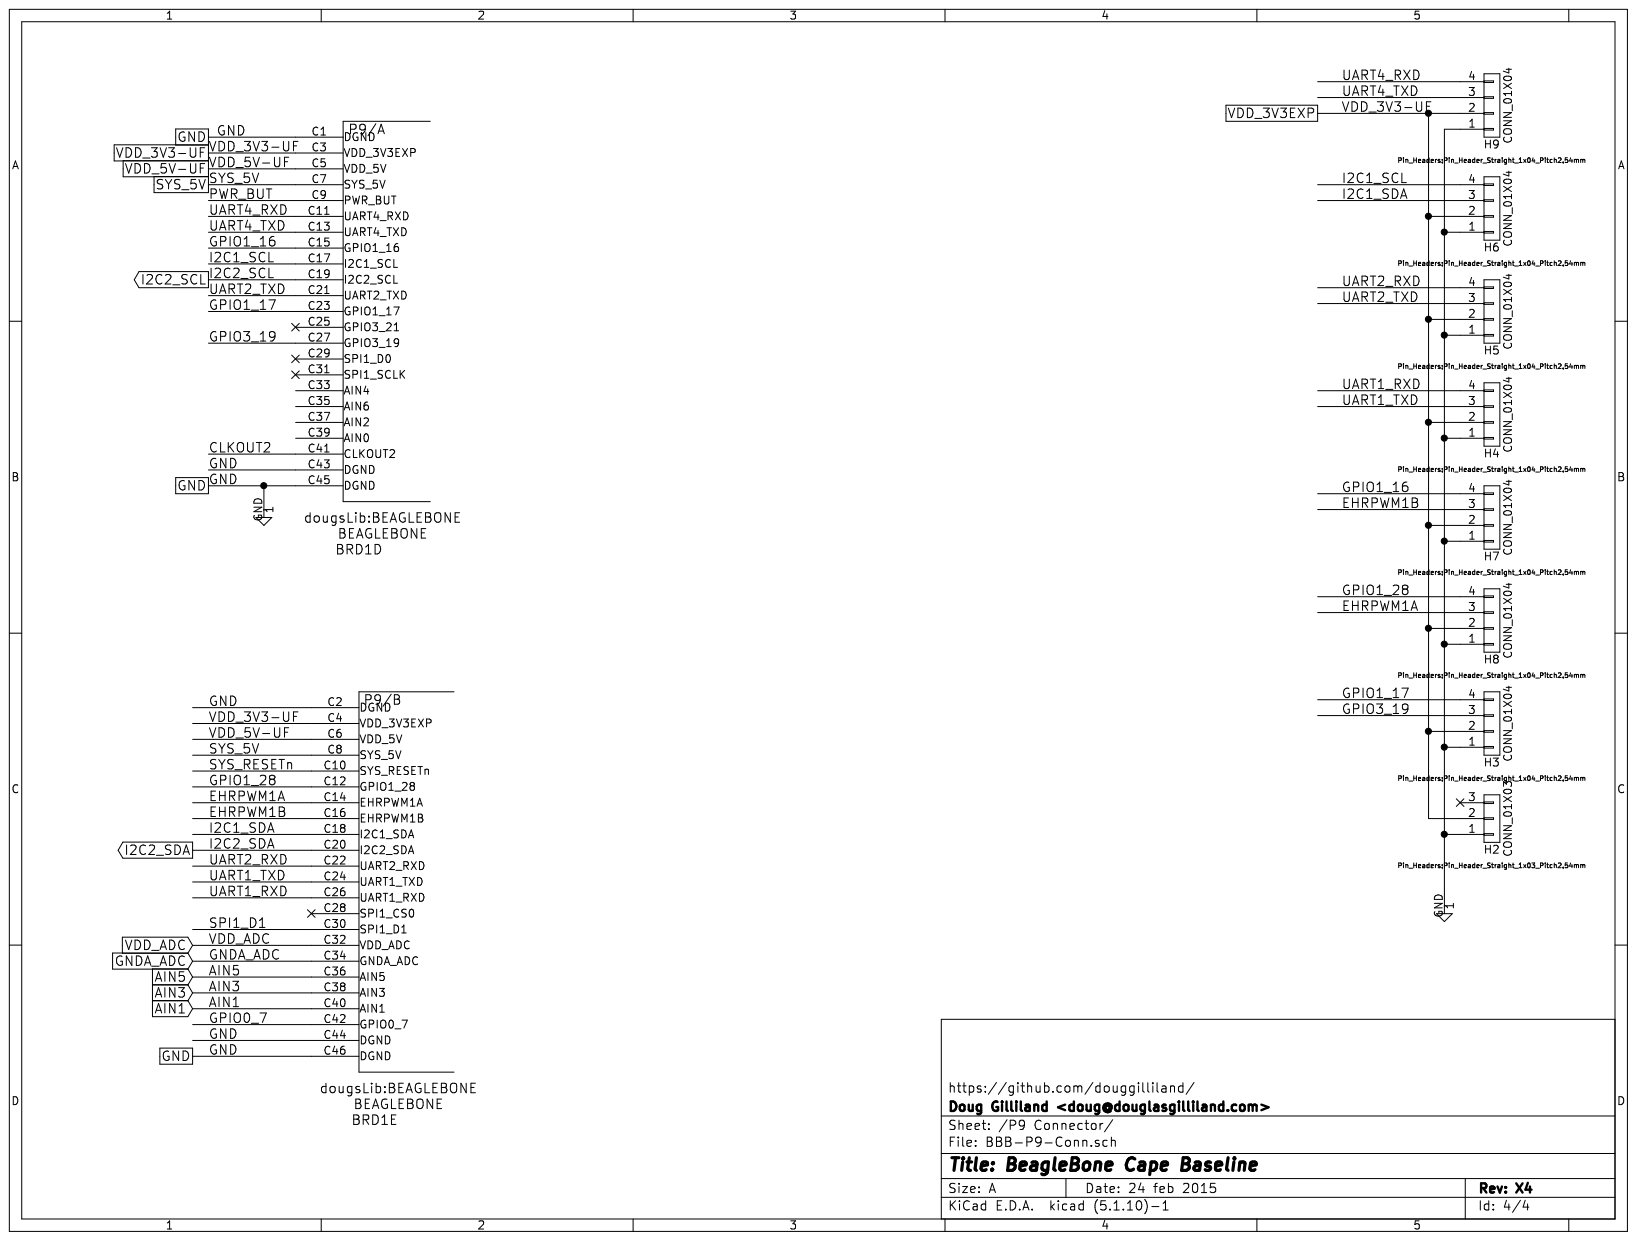
[picture p525: page 4]
