land-boards/lb-boards/BeagleBoneBlack Cards/BBB-GVS/BBB-GVS_RexX5_Schematic.pdf

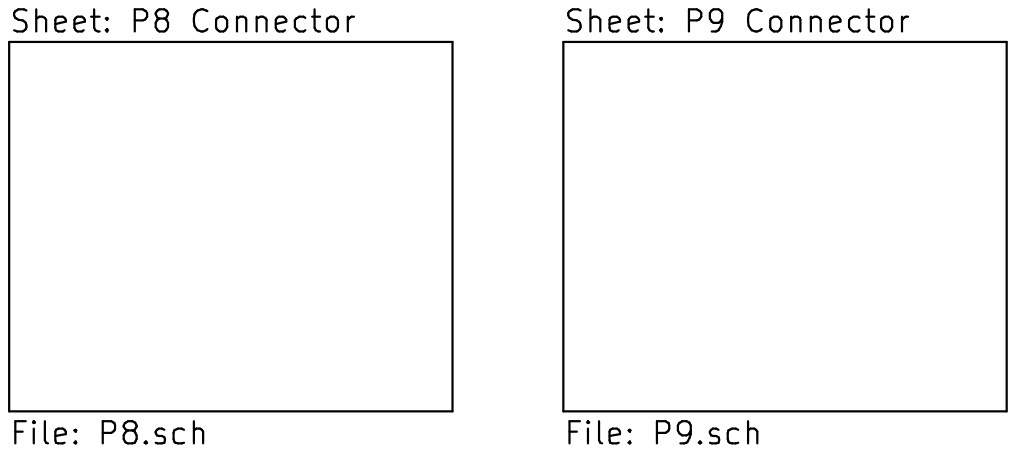
[picture p526: page 1]

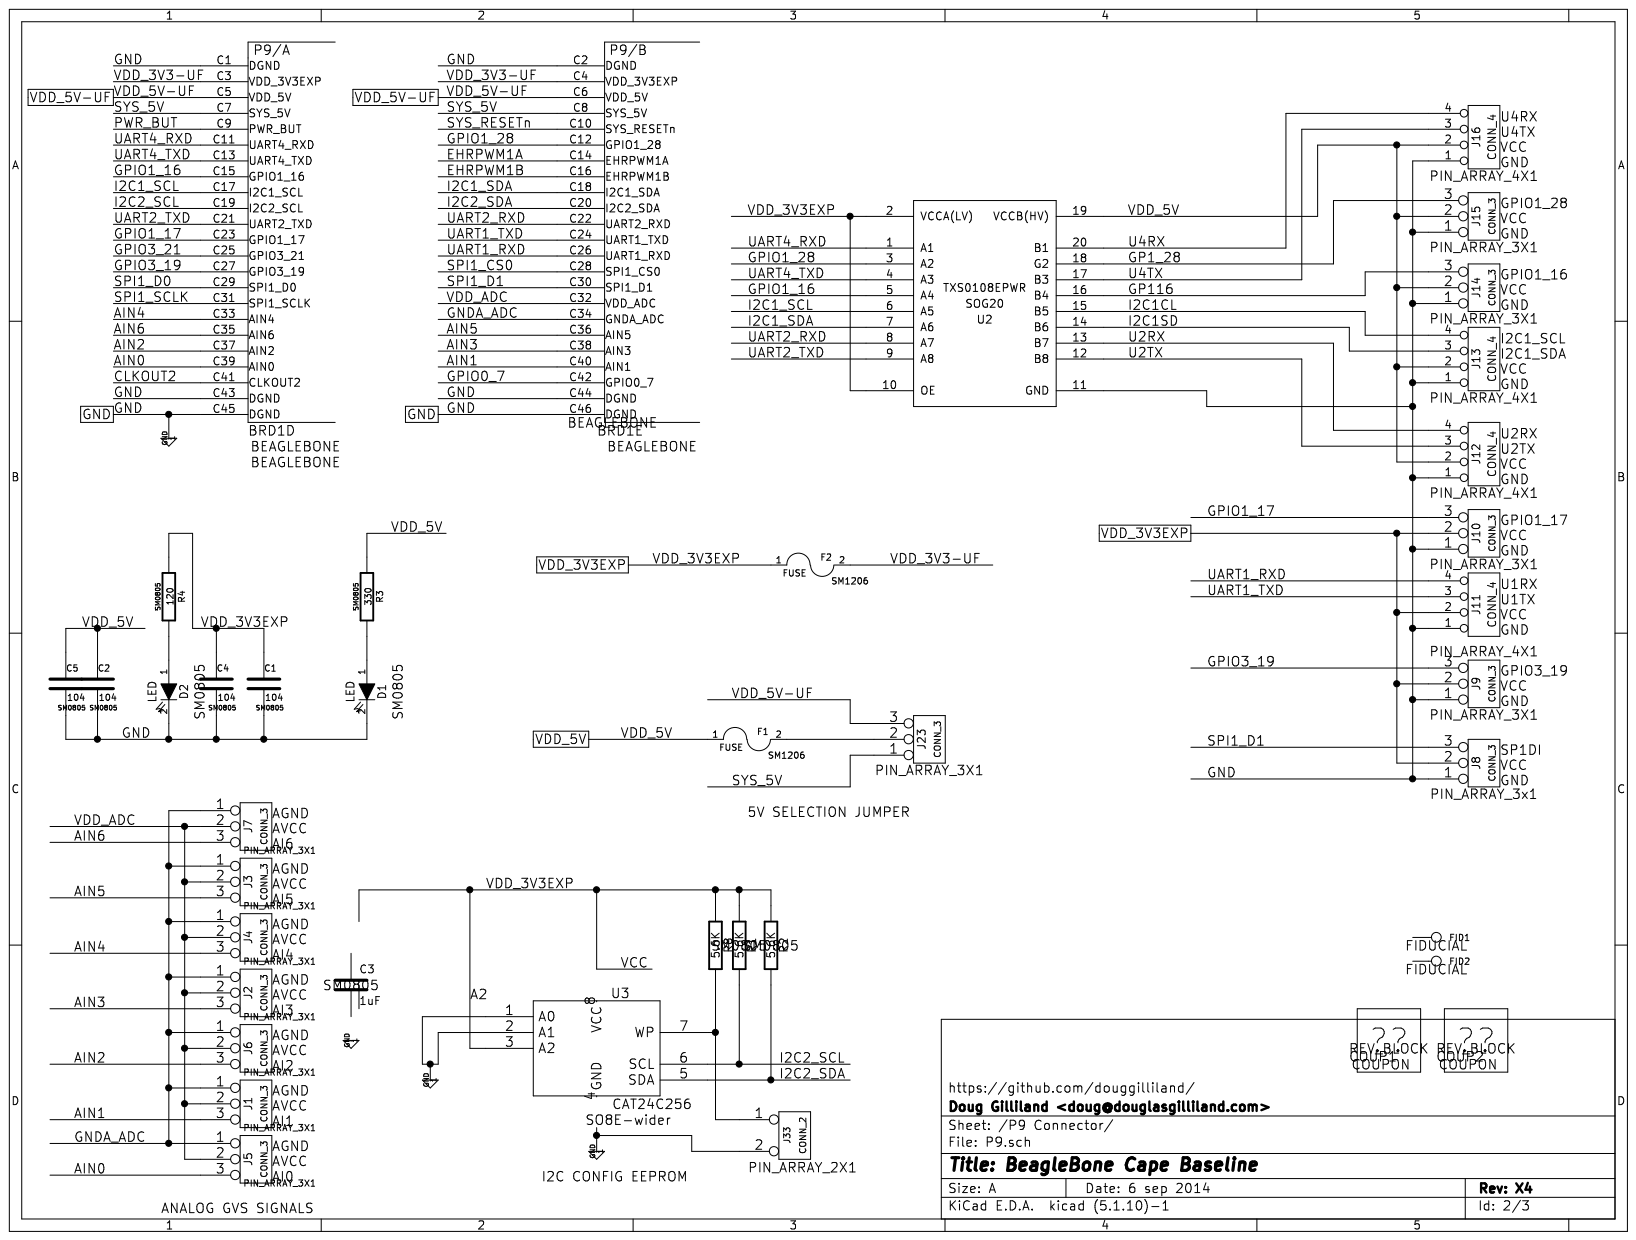
[picture p527: page 2]

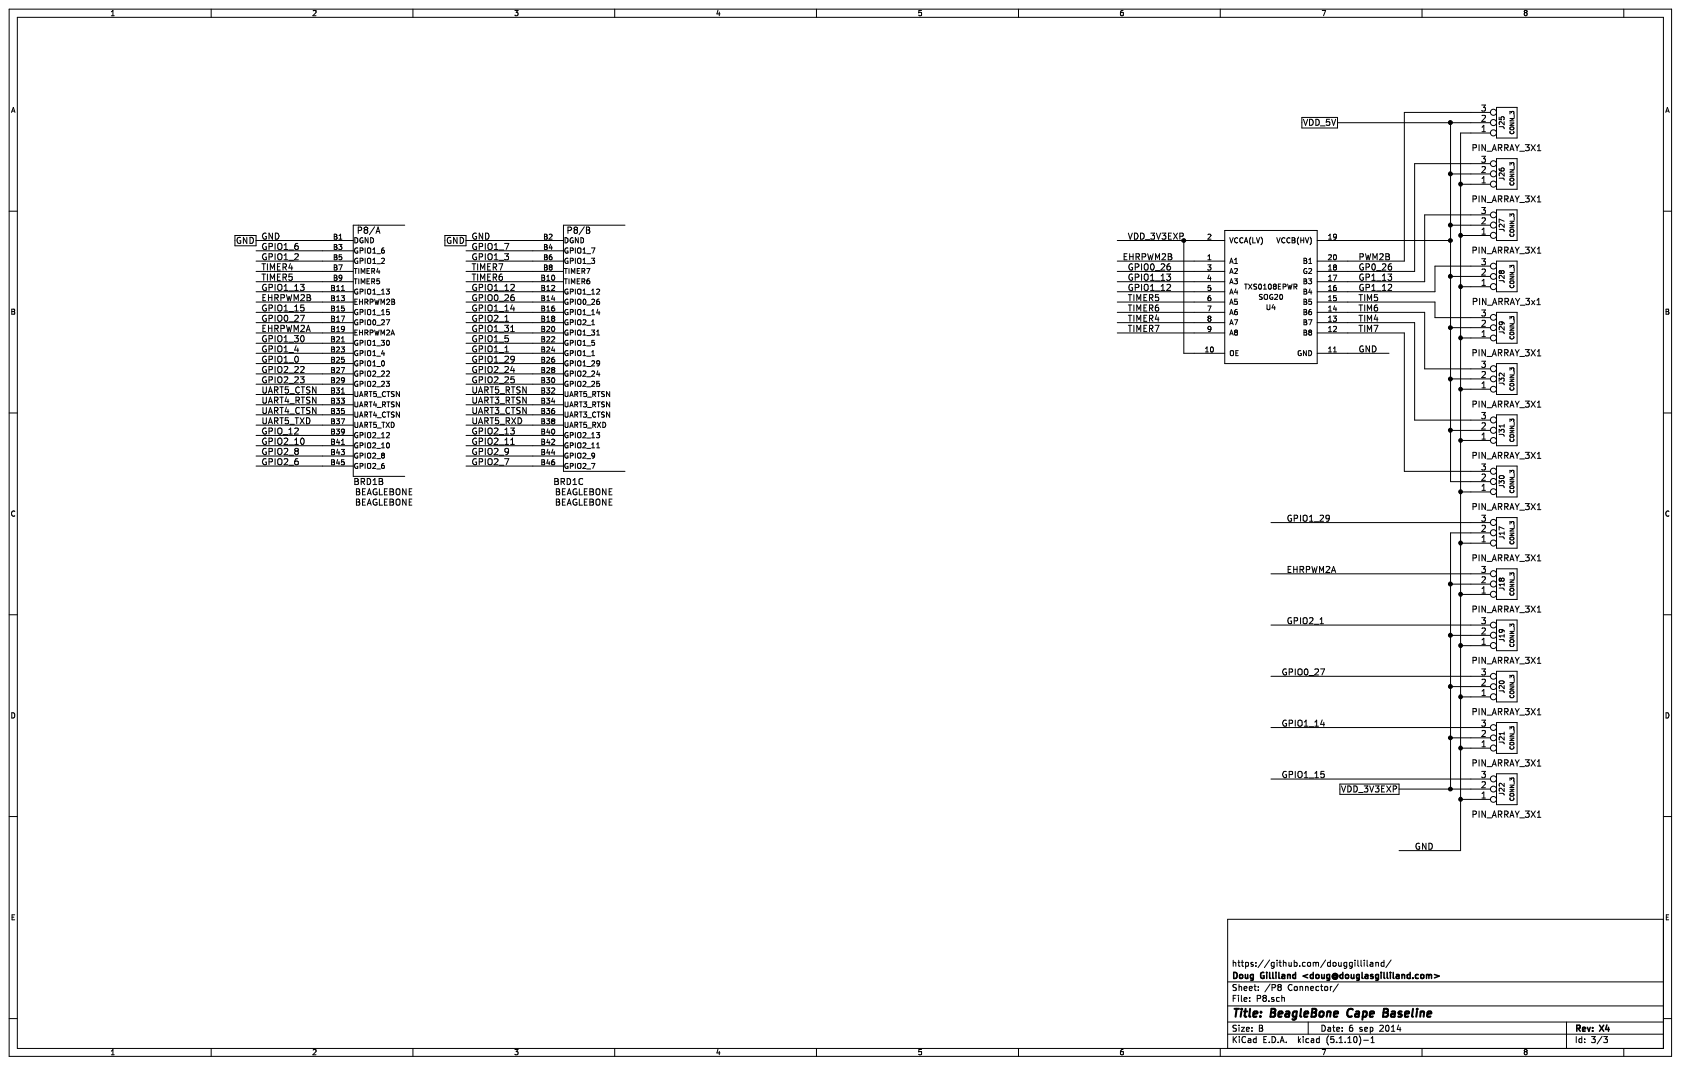
[picture p528: page 3]
