land-boards/lb-boards/HamRadio/W7ZOI_TIA/W7ZOI_TIA_SCHEMATIC_REV1.pdf

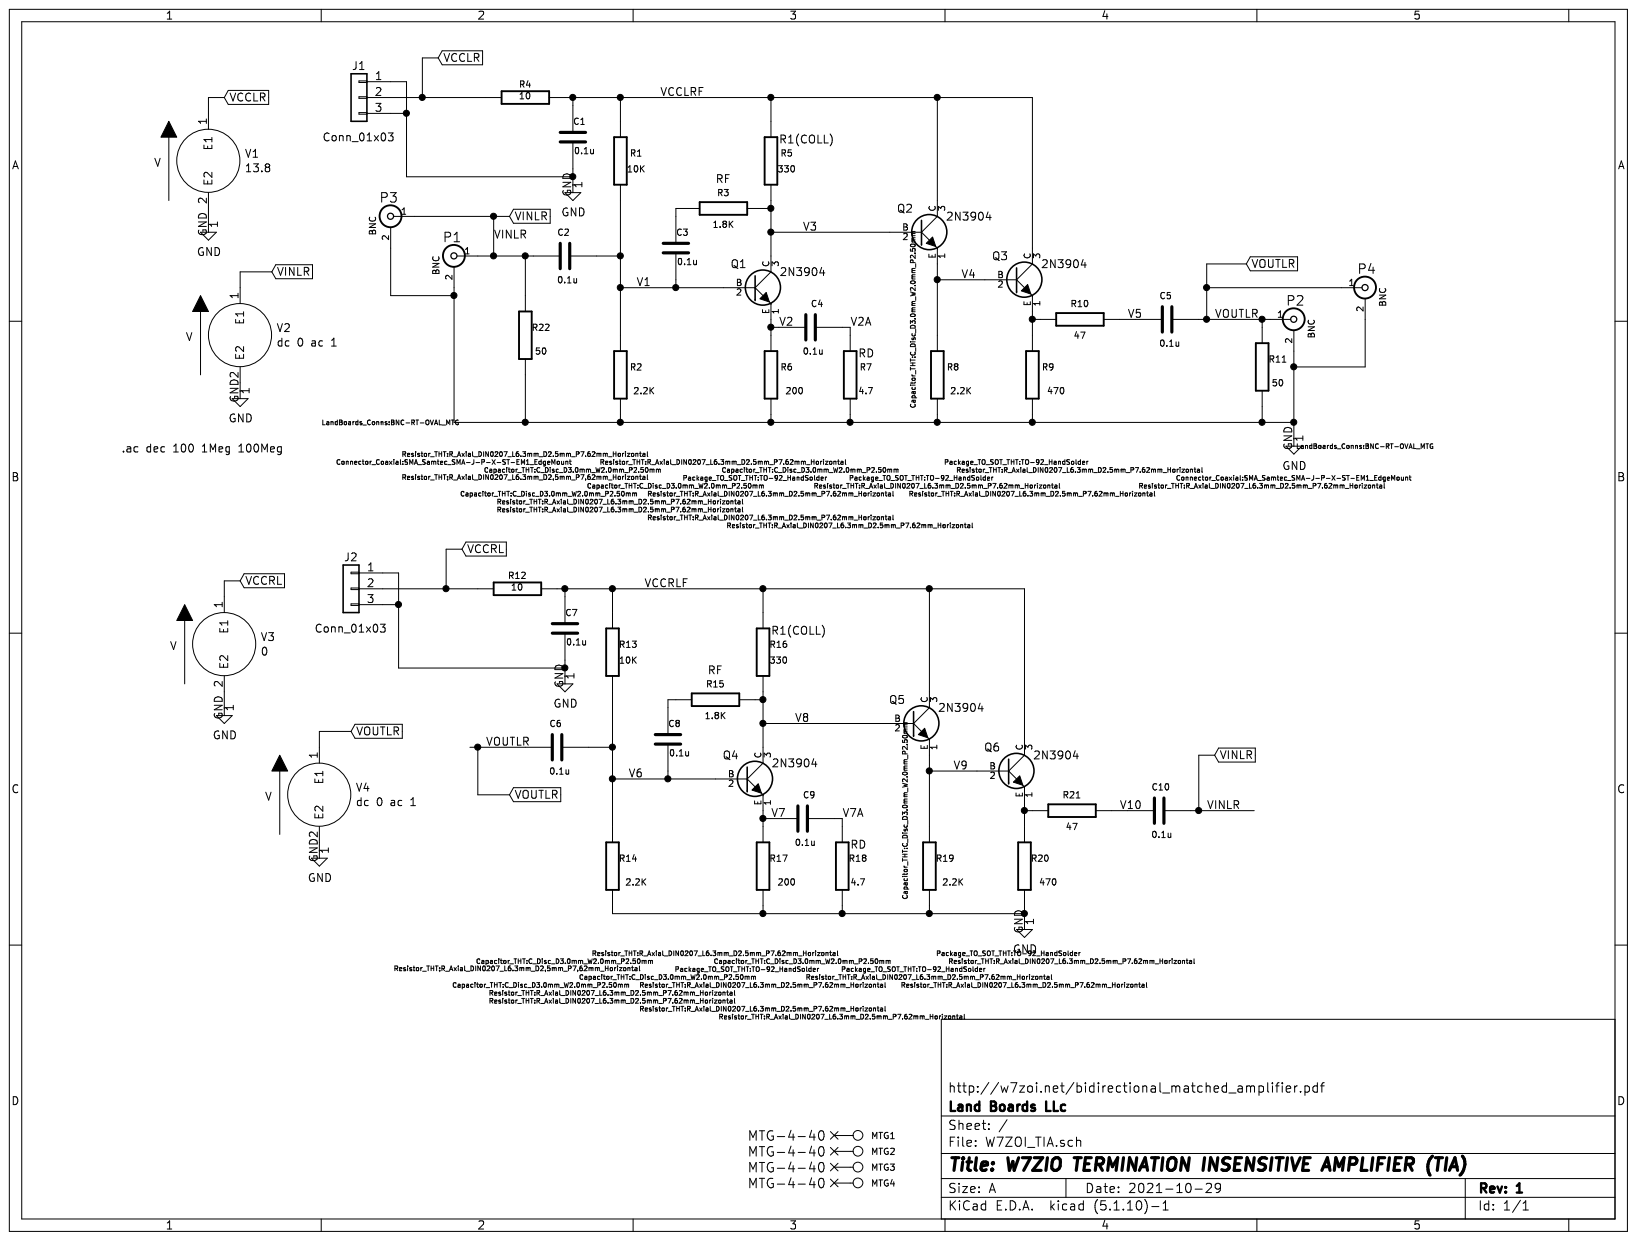
[picture p529: page 1]
