land-boards/lb-boards/I2C Cards/I2C-RPT-08/I2CRPT08_Rev2_Schematic.pdf

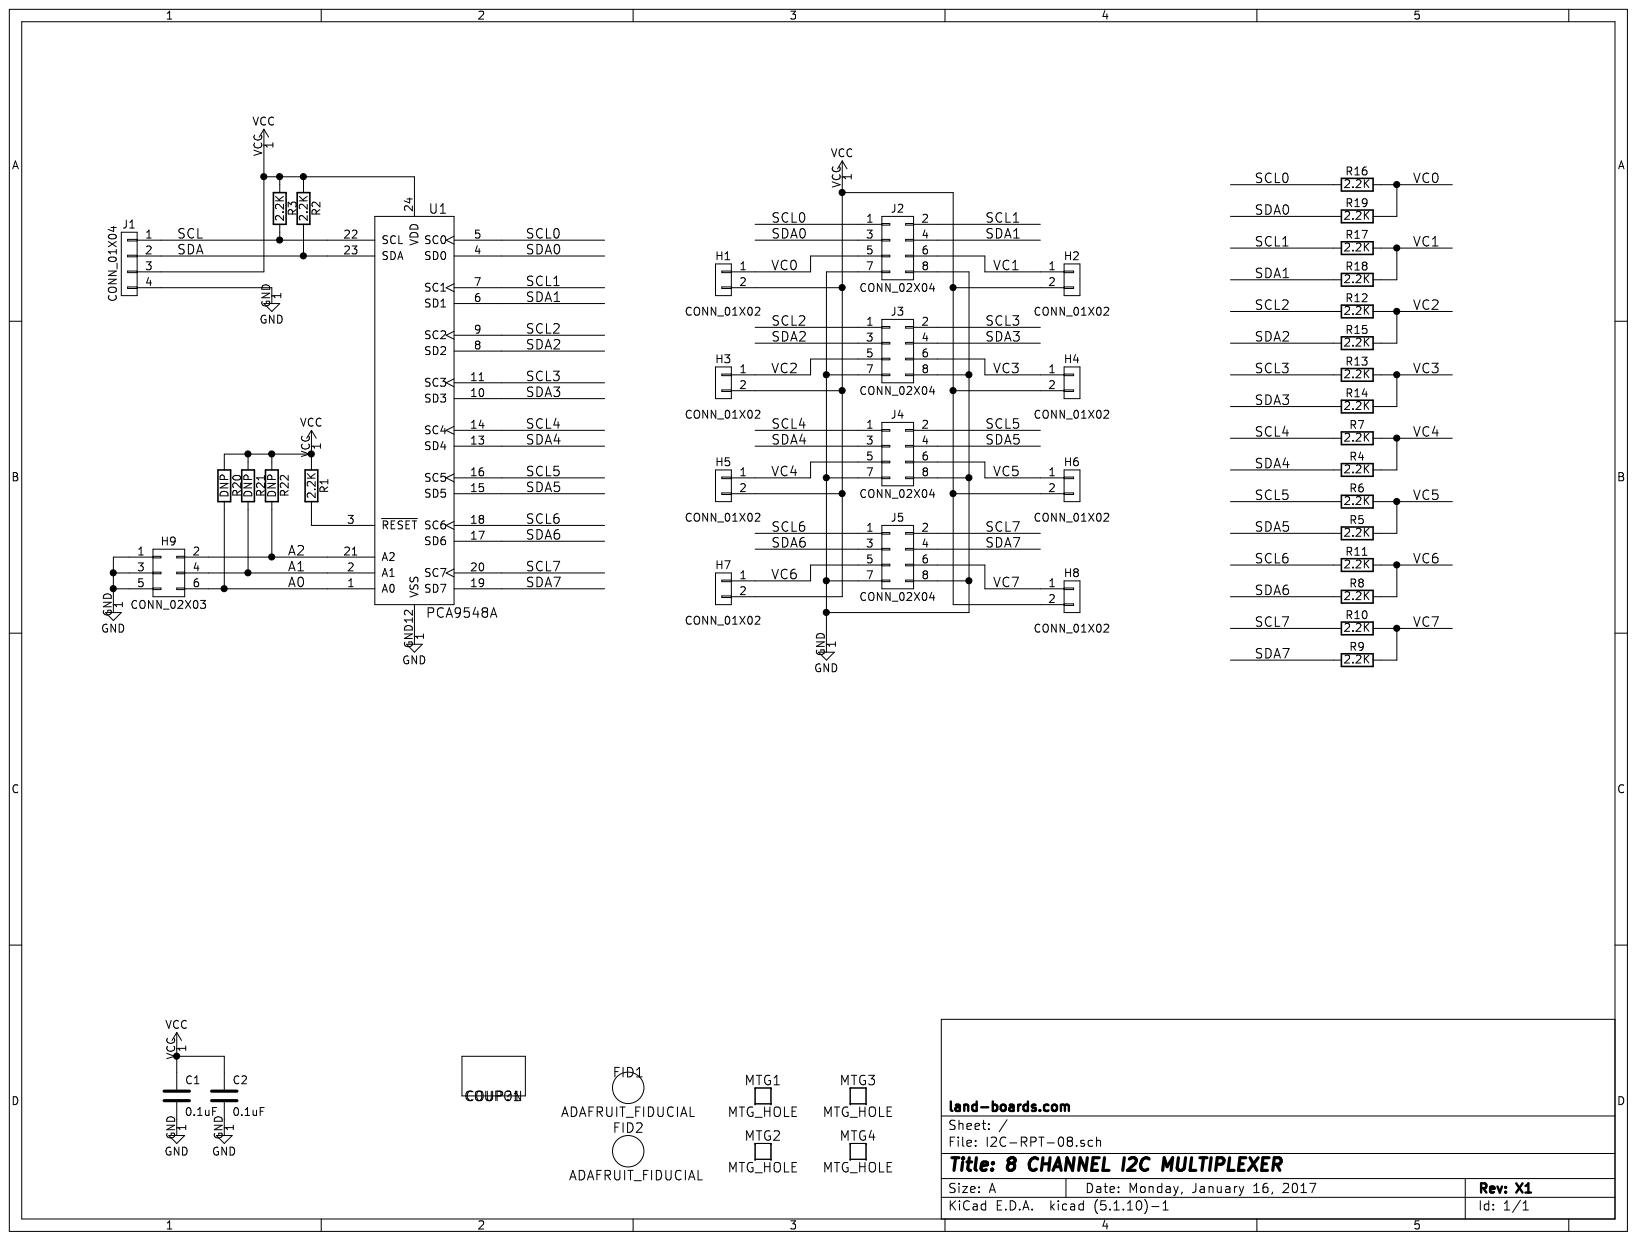
[picture p530: page 1]
