land-boards/lb-boards/I2C Cards/I2CIO-8X/I2CIO-8X_RevX1_Schematic.pdf

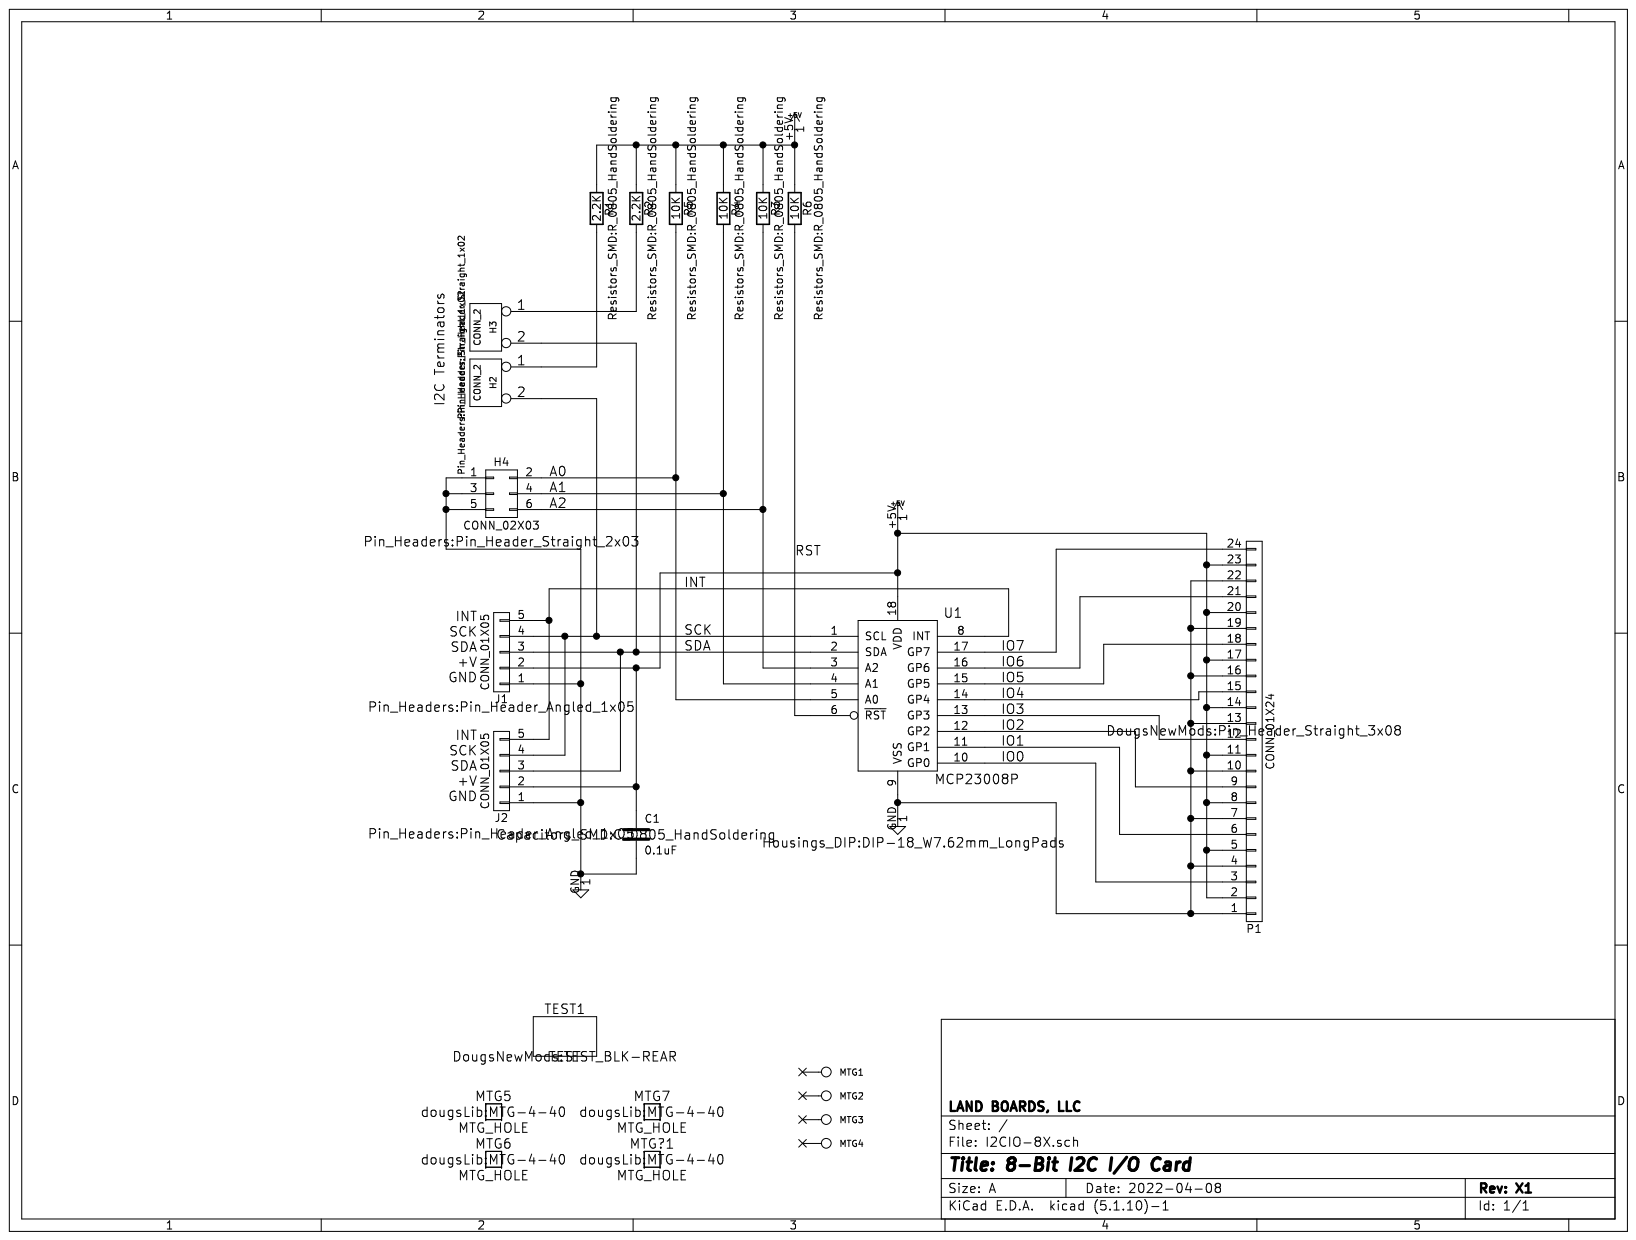
[picture p531: page 1]
