land-boards/lb-boards/Projects/IntegTheremin/IntegTheramin_Schematic.pdf

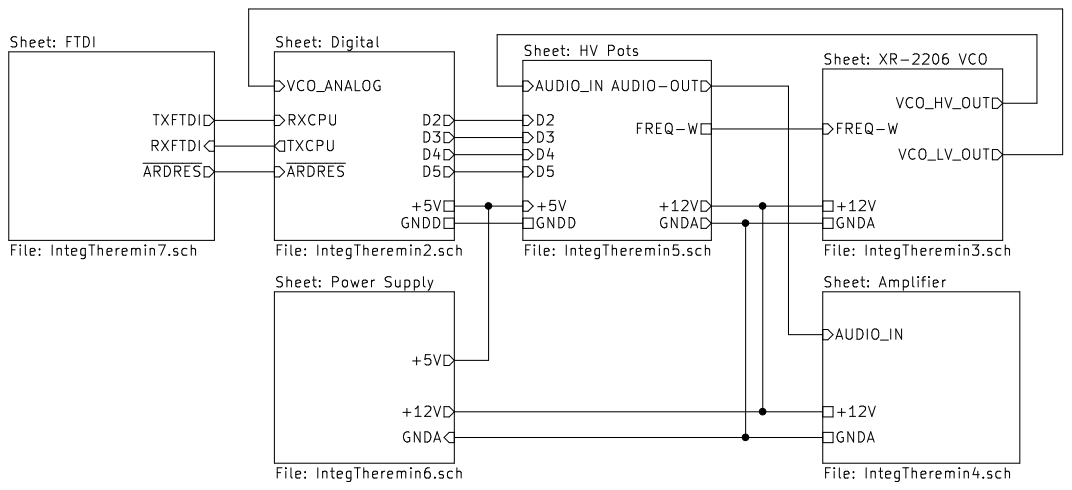
[picture p532: page 1]

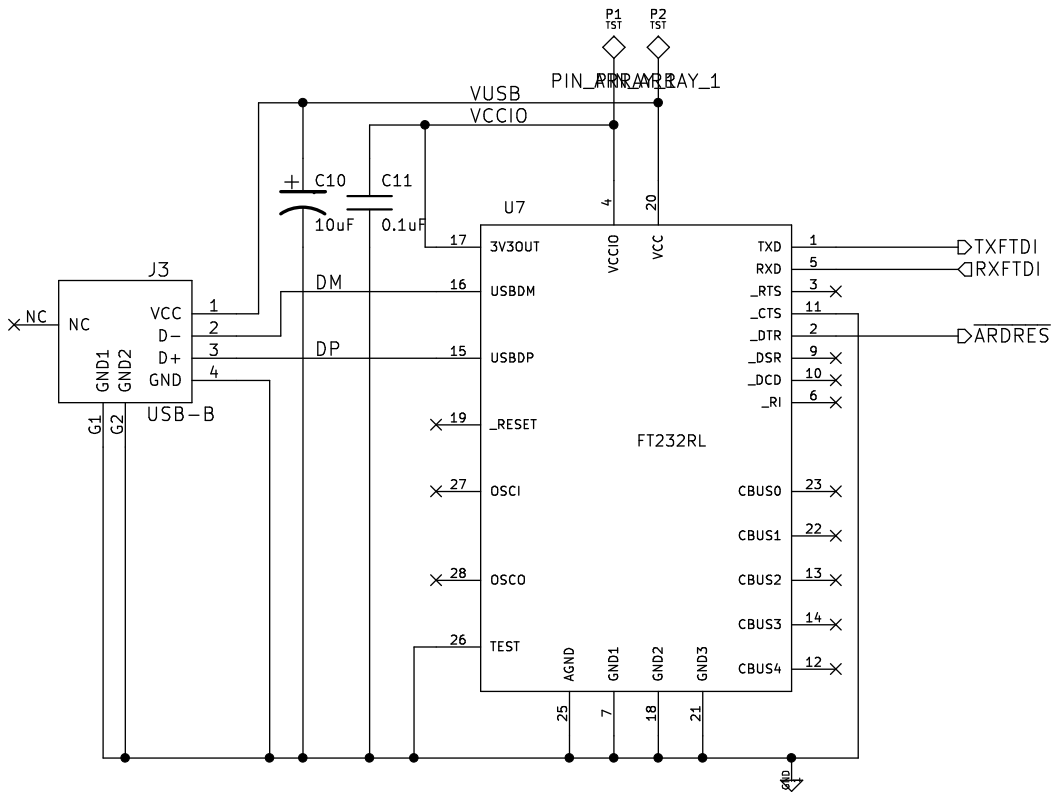
[picture p533: page 2]

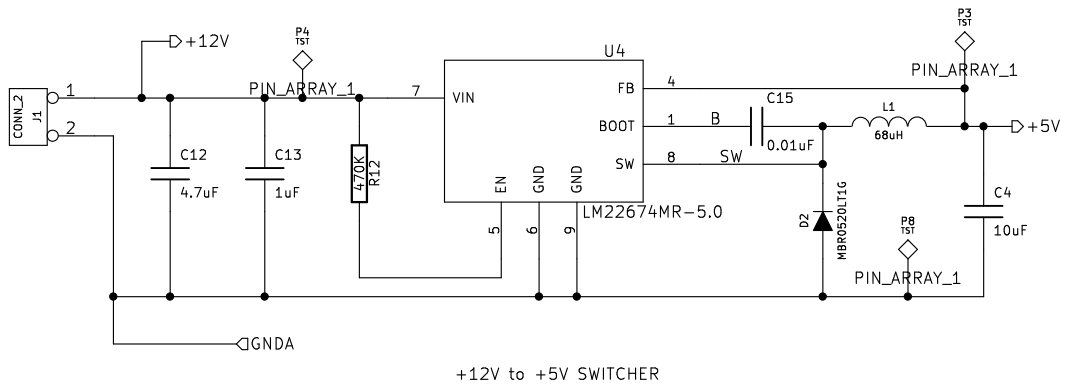
[picture p534: page 3]

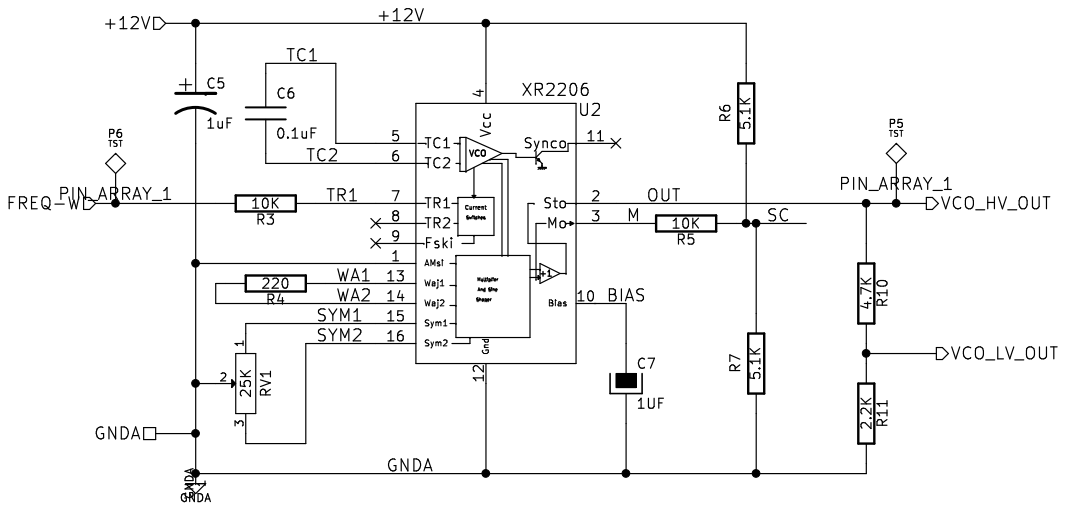
[picture p535: page 4]

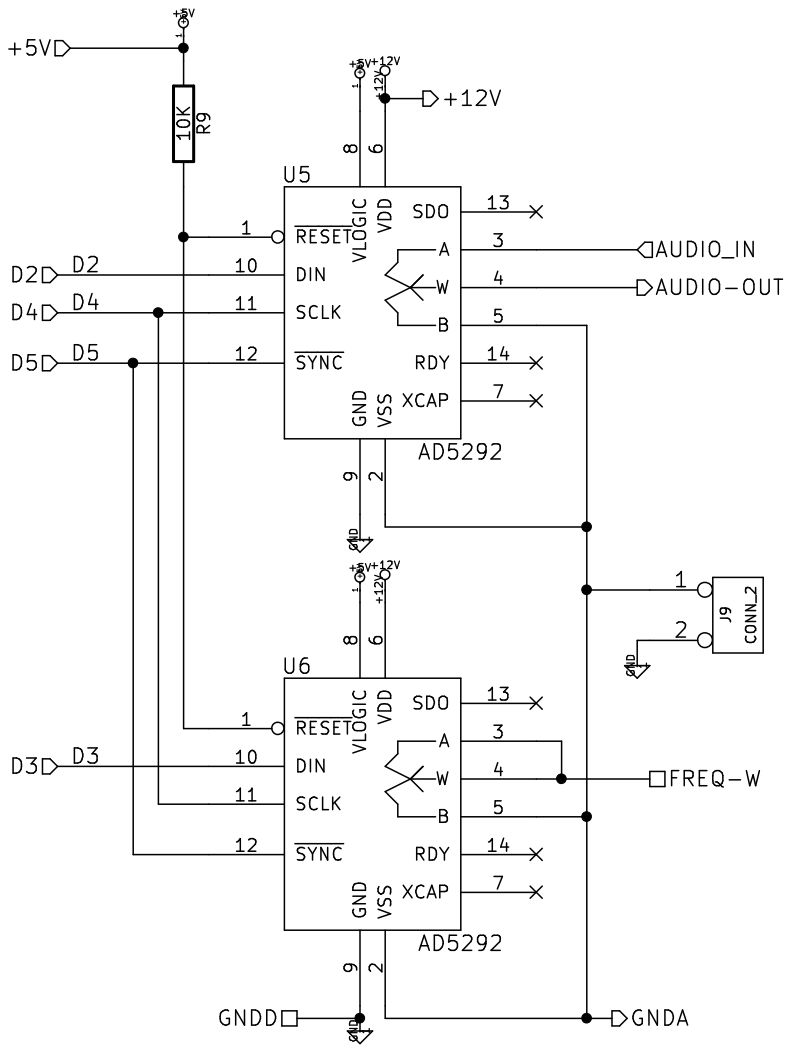
[picture p536: page 5]

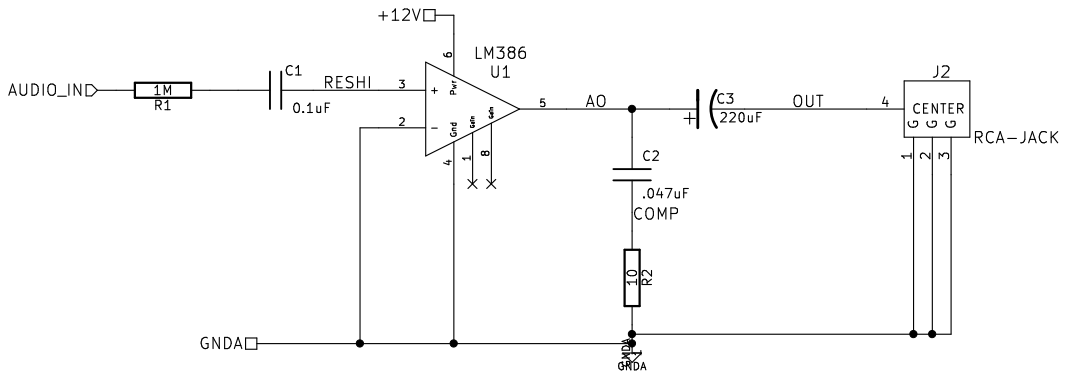
[picture p537: page 6]

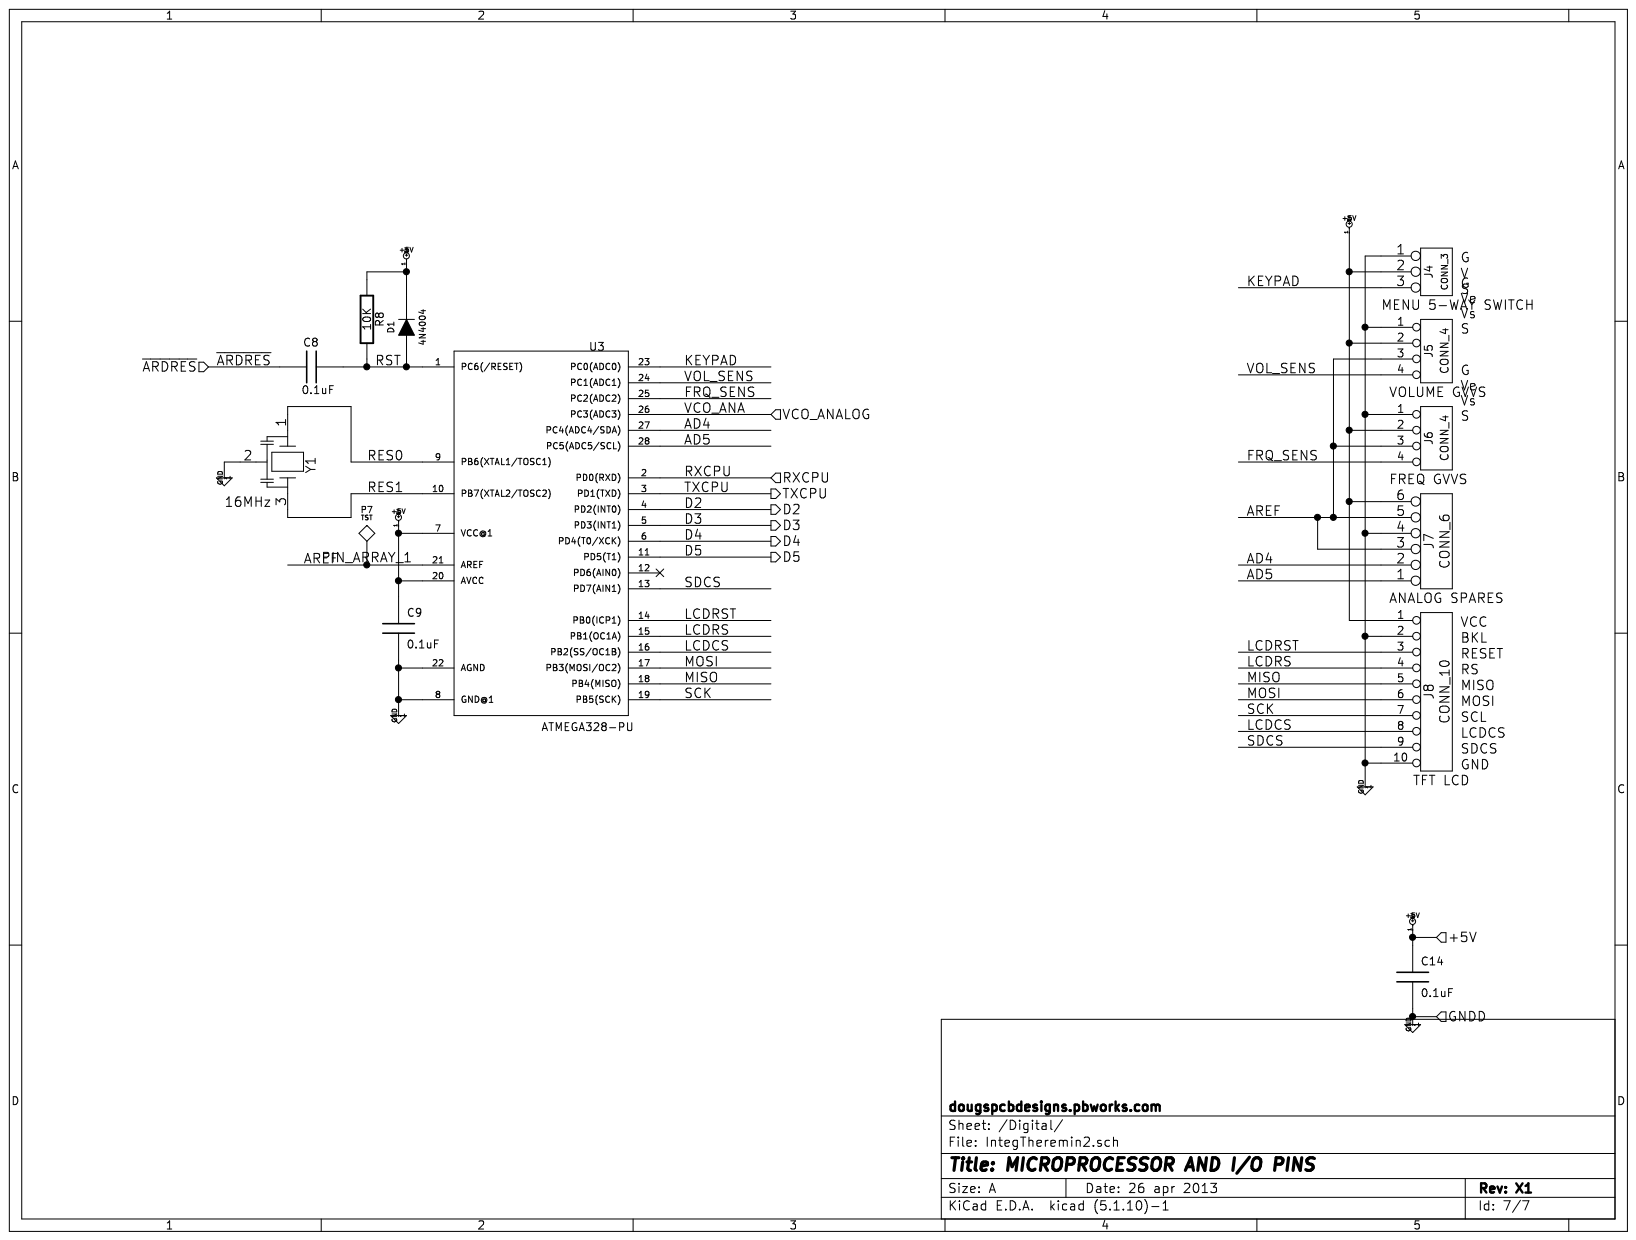
[picture p538: page 7]
