land-boards/lb-boards/FPGA Cards/RETRO-EP4CE15/RETRO-EP4CE15_REV_4_Schematic.pdf

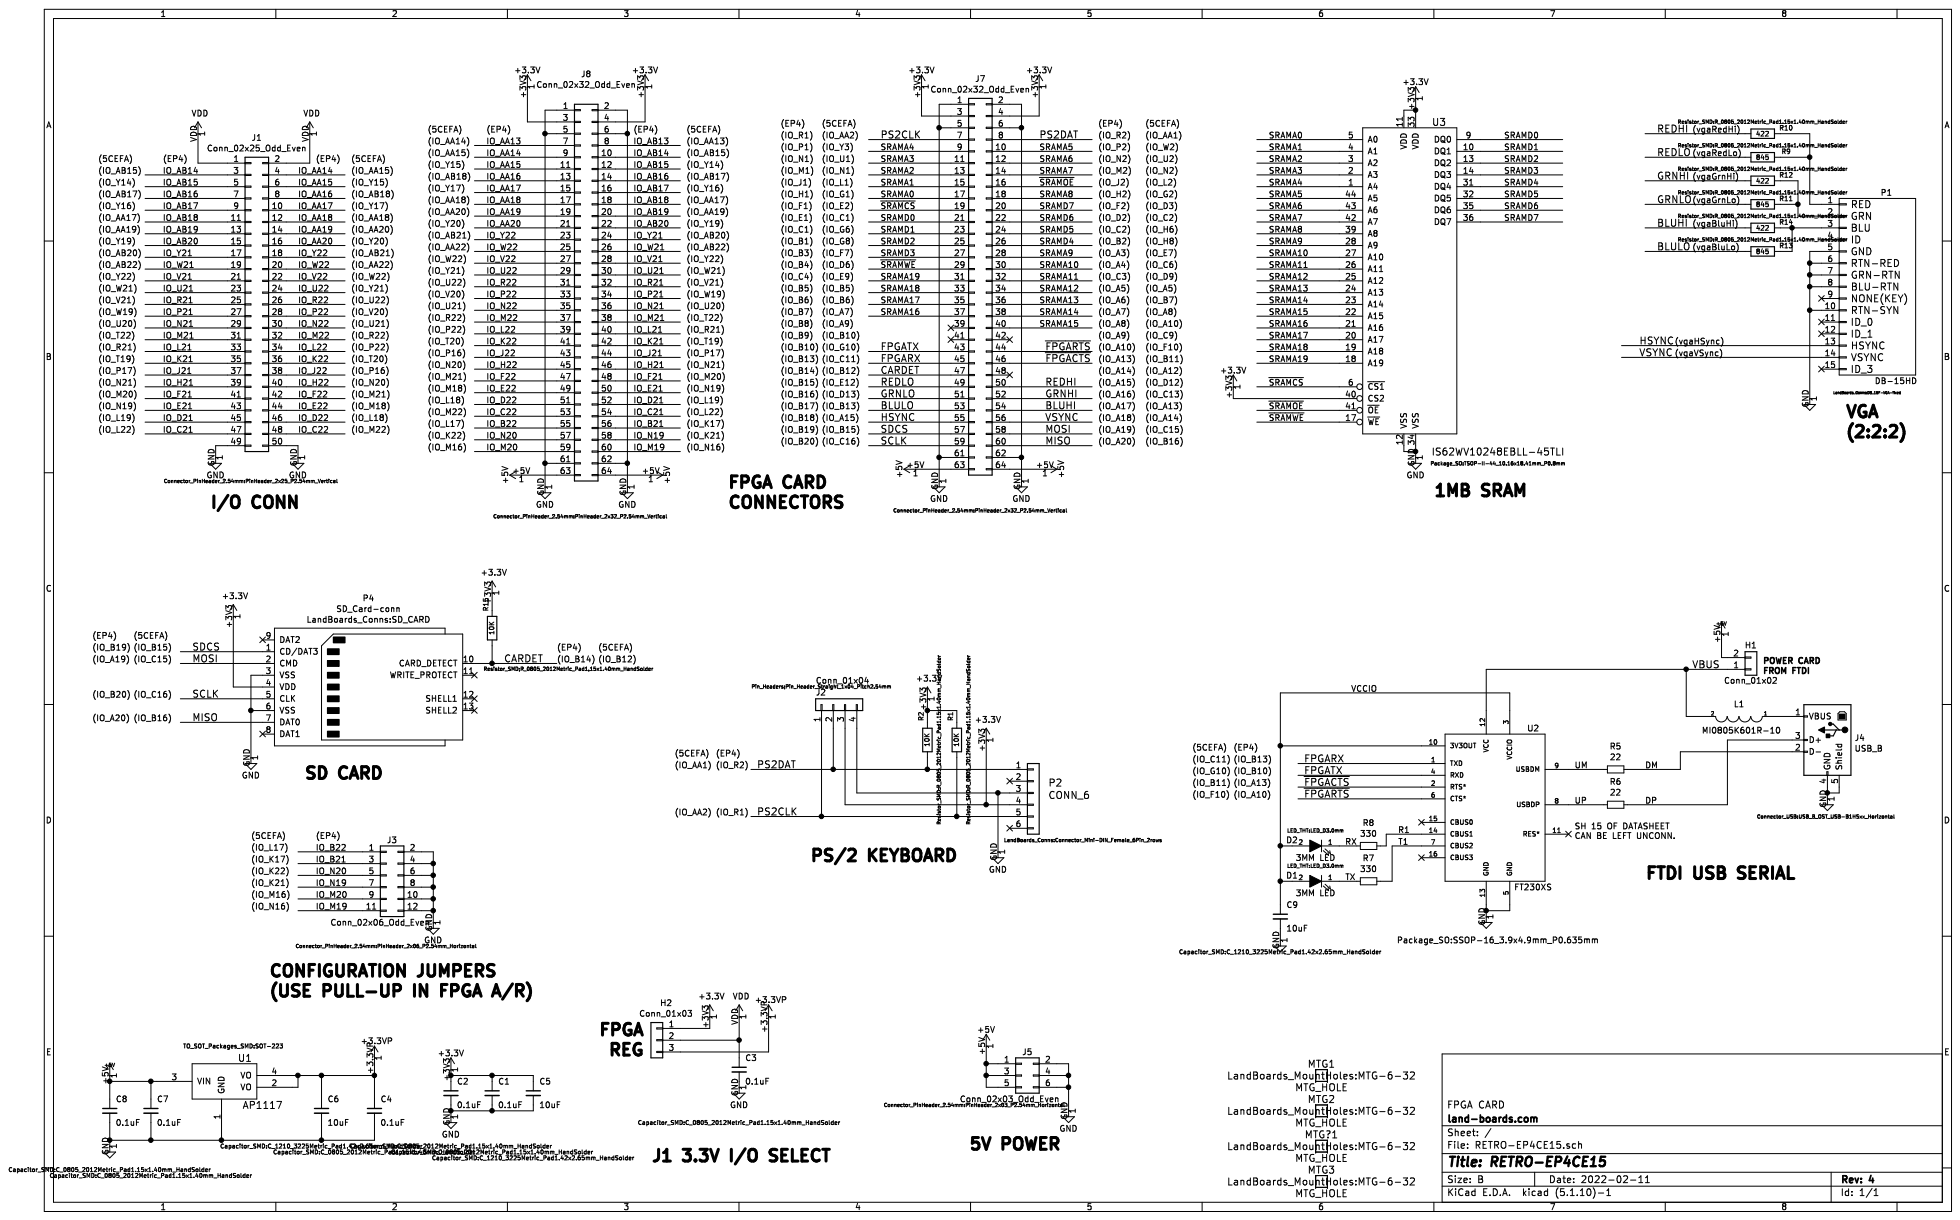
[picture p539: page 1]
