land-boards/lb-boards/Arduino Cards/FTDI-USB-TTL-49MM/FTDI-49MM_REV_2_Schematic.pdf

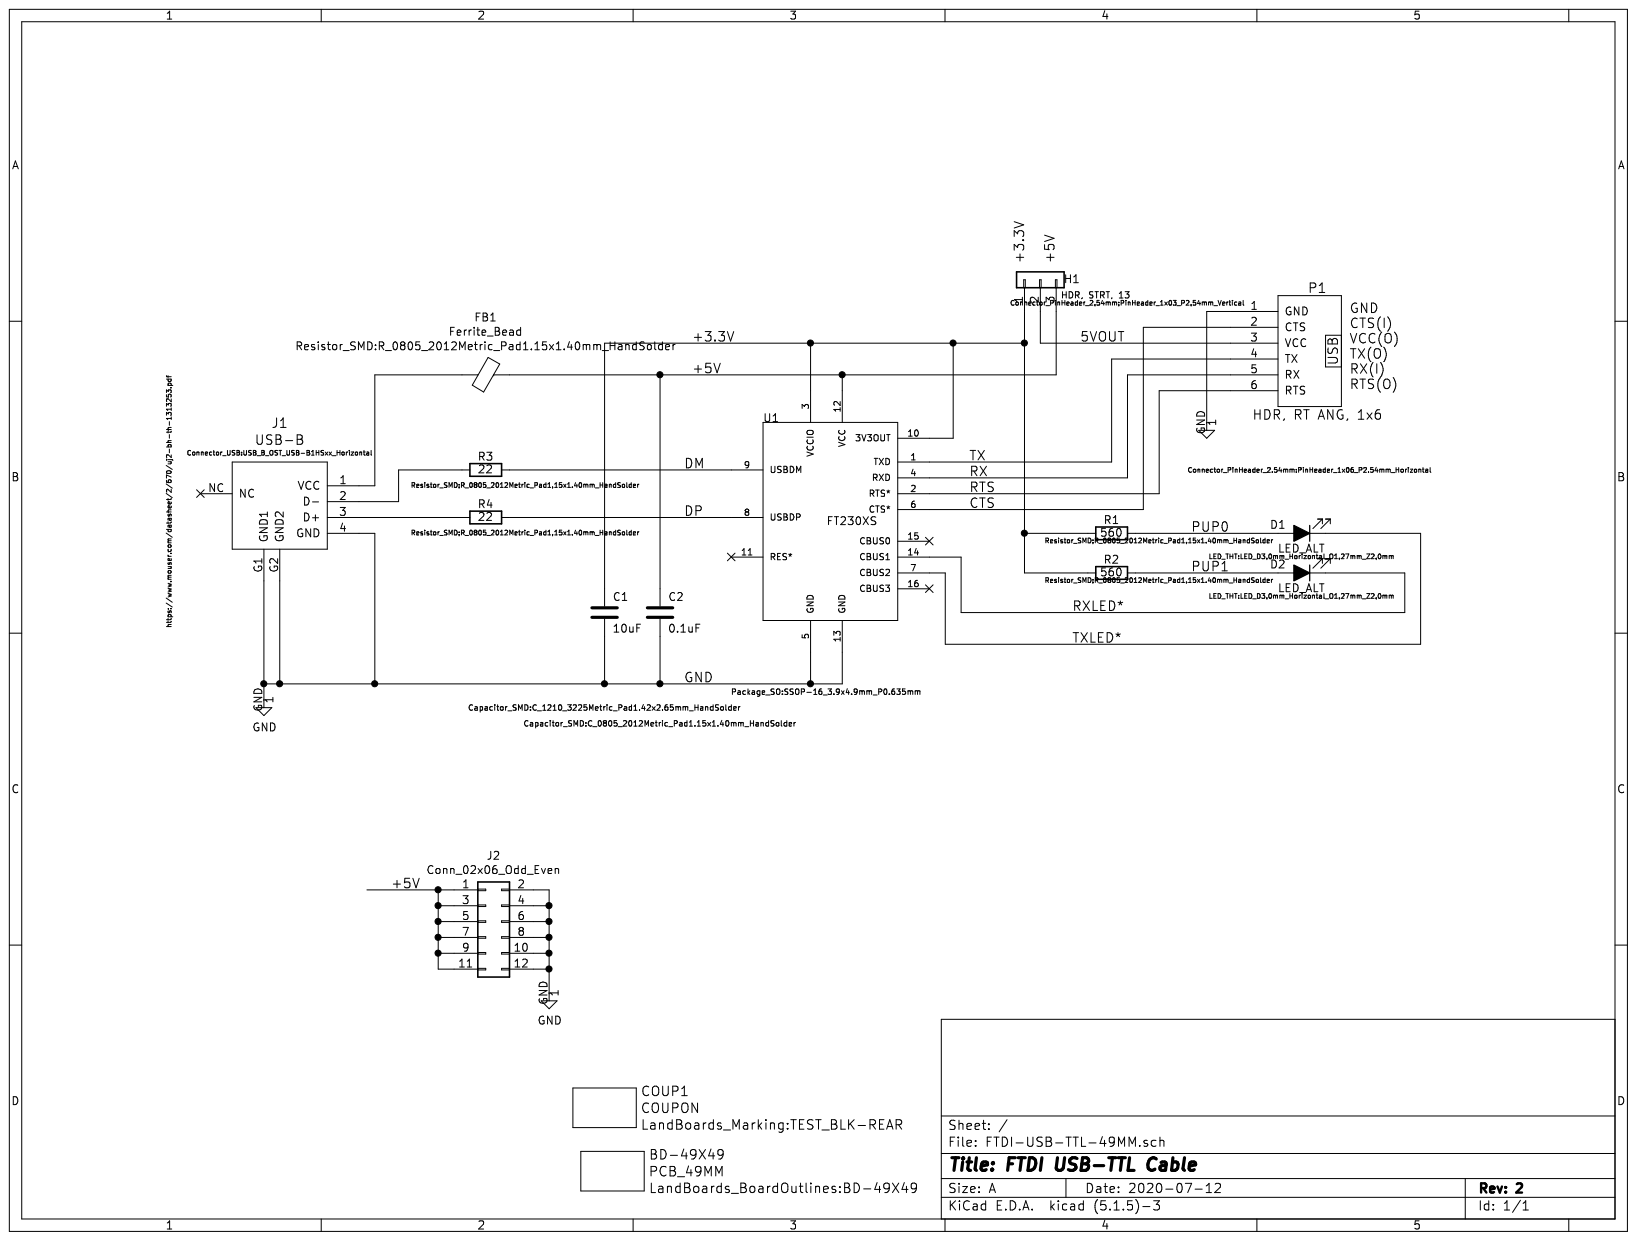
[picture p540: page 1]
