land-boards/lb-boards/Arduino Cards/Screwduino/Screwduino-Rev_X6_Schematic.pdf

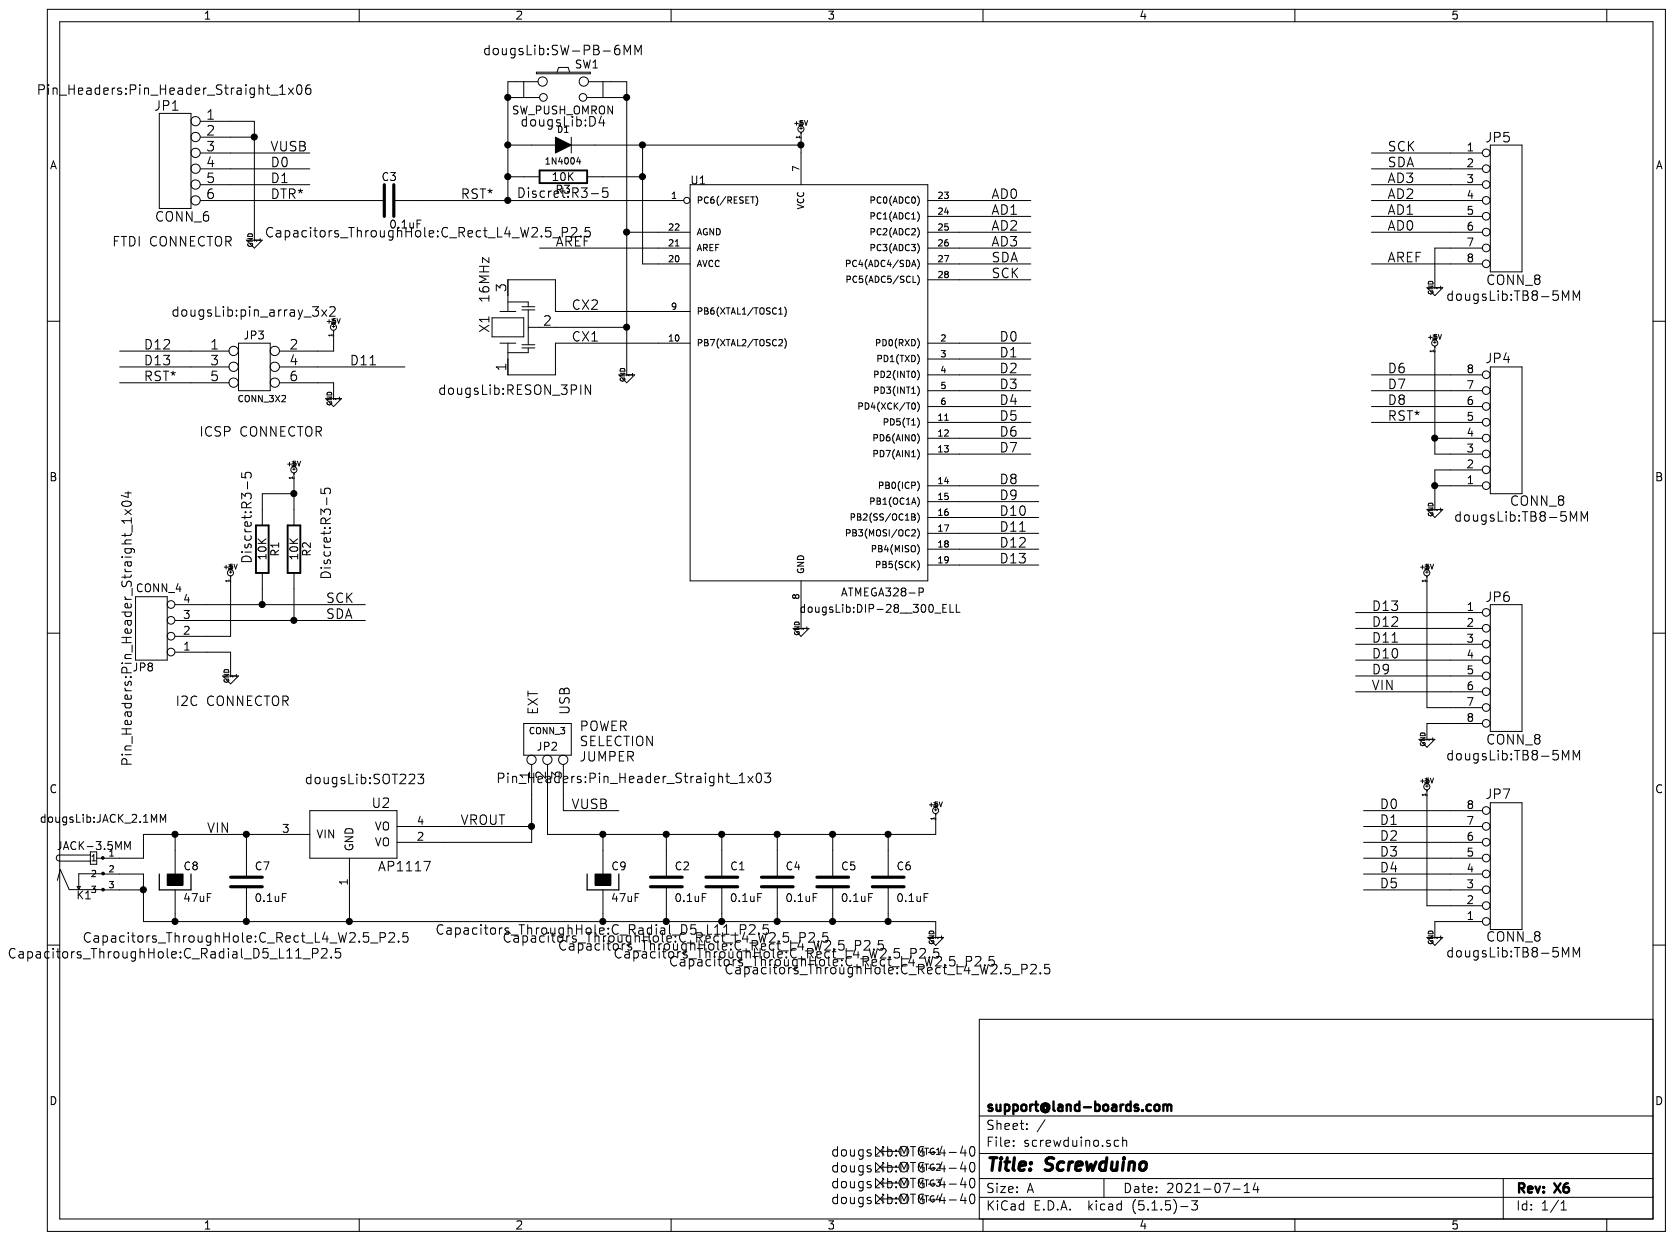
[picture p541: page 1]
