land-boards/lb-boards/RetroCPUs/FrontPanel02/FrontPanel-01_Rev1_Schematic.pdf

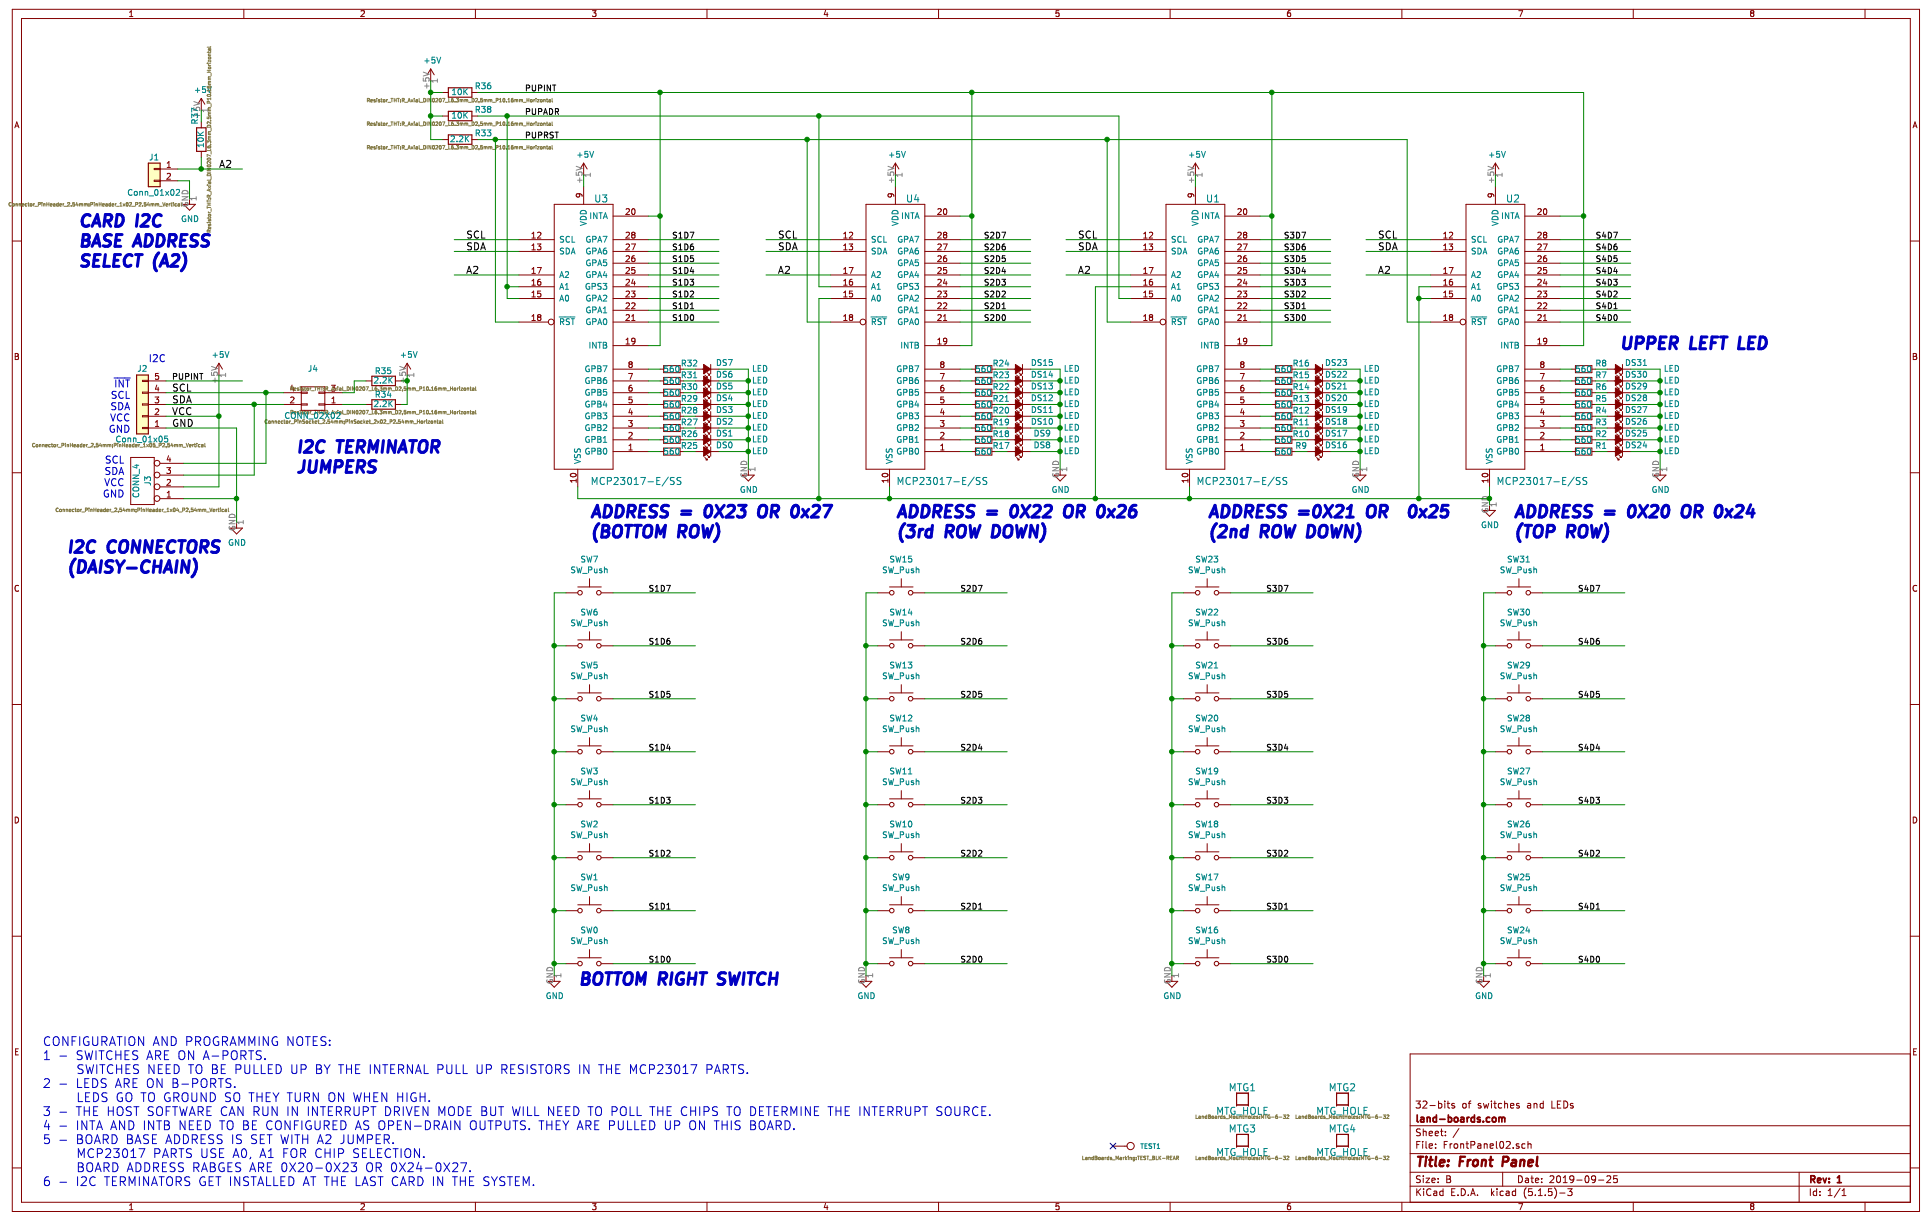
[picture p542: page 1]
