land-boards/lb-boards/RetroCPUs/PDP-8/PDP-8_Rev_1_Schematic.pdf

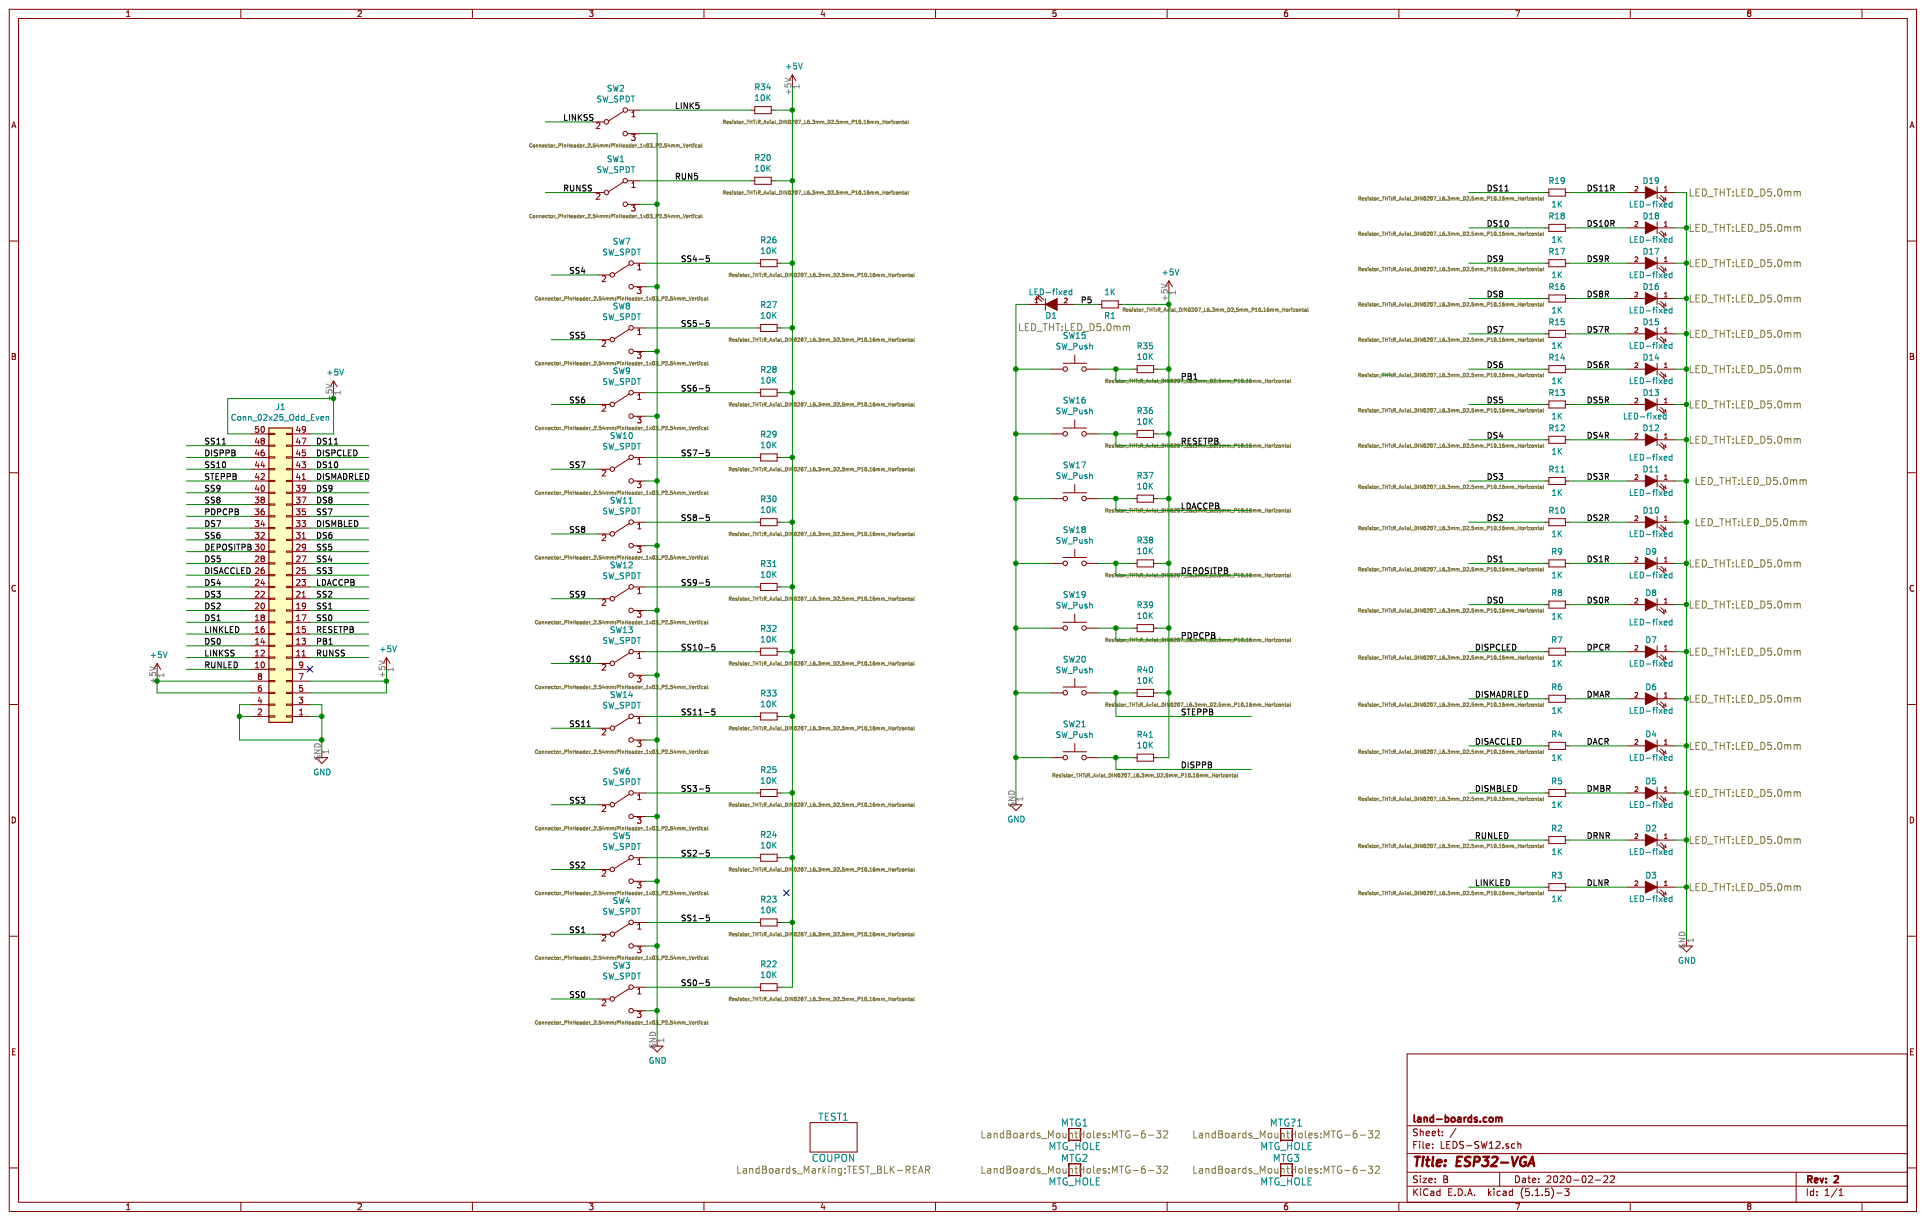
[picture p543: page 1]
