land-boards/lb-boards/ModuleTest/Parts/SD-card-slot-module-schematic.pdf

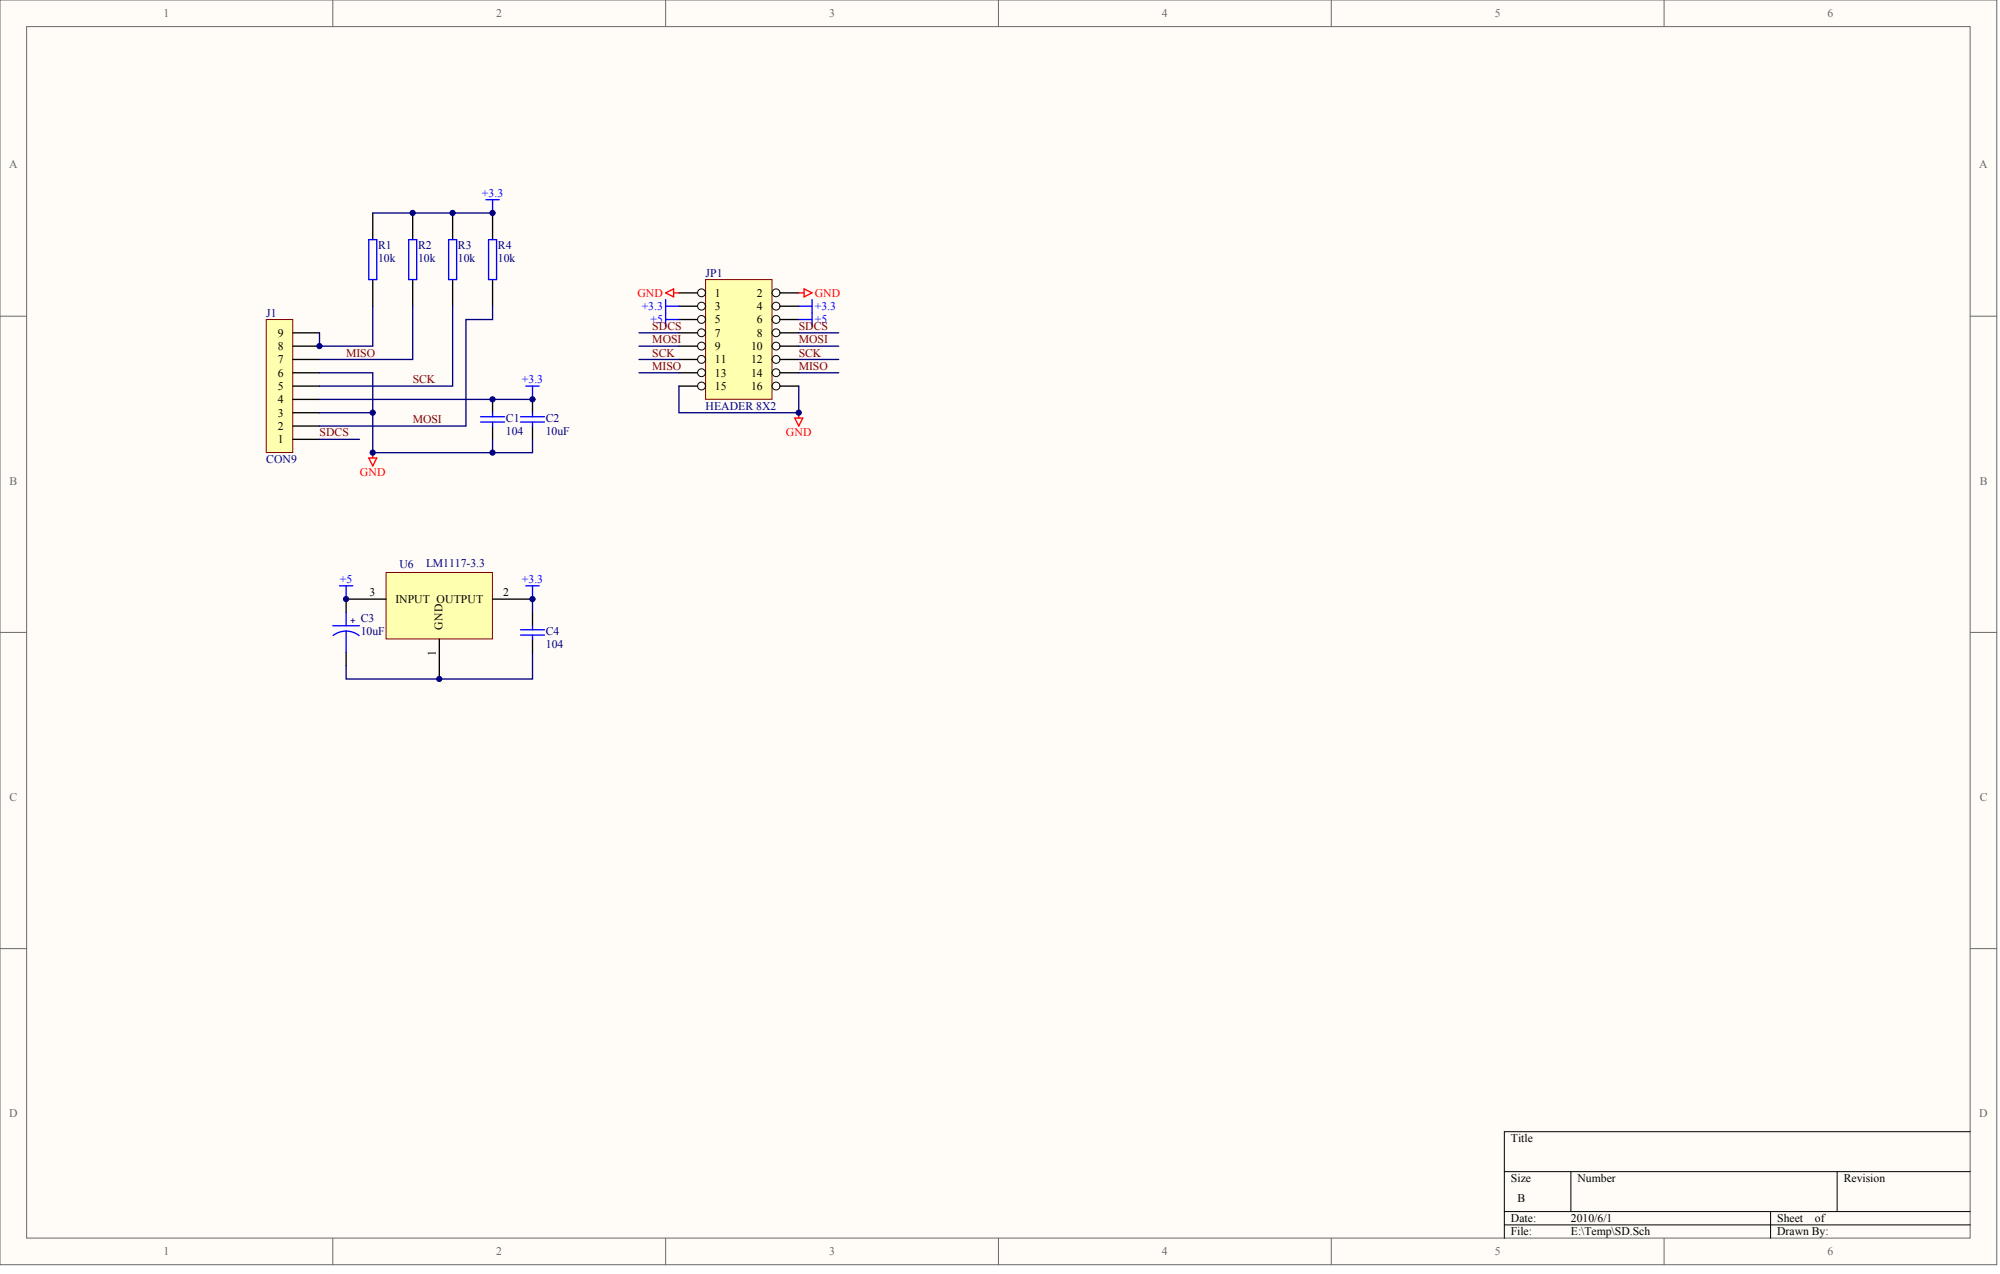
[picture p544: page 1]
