land-boards/lb-boards/ESP32/ESP32-Hub/ESP-32_Hub_Rev3_Schematic.pdf

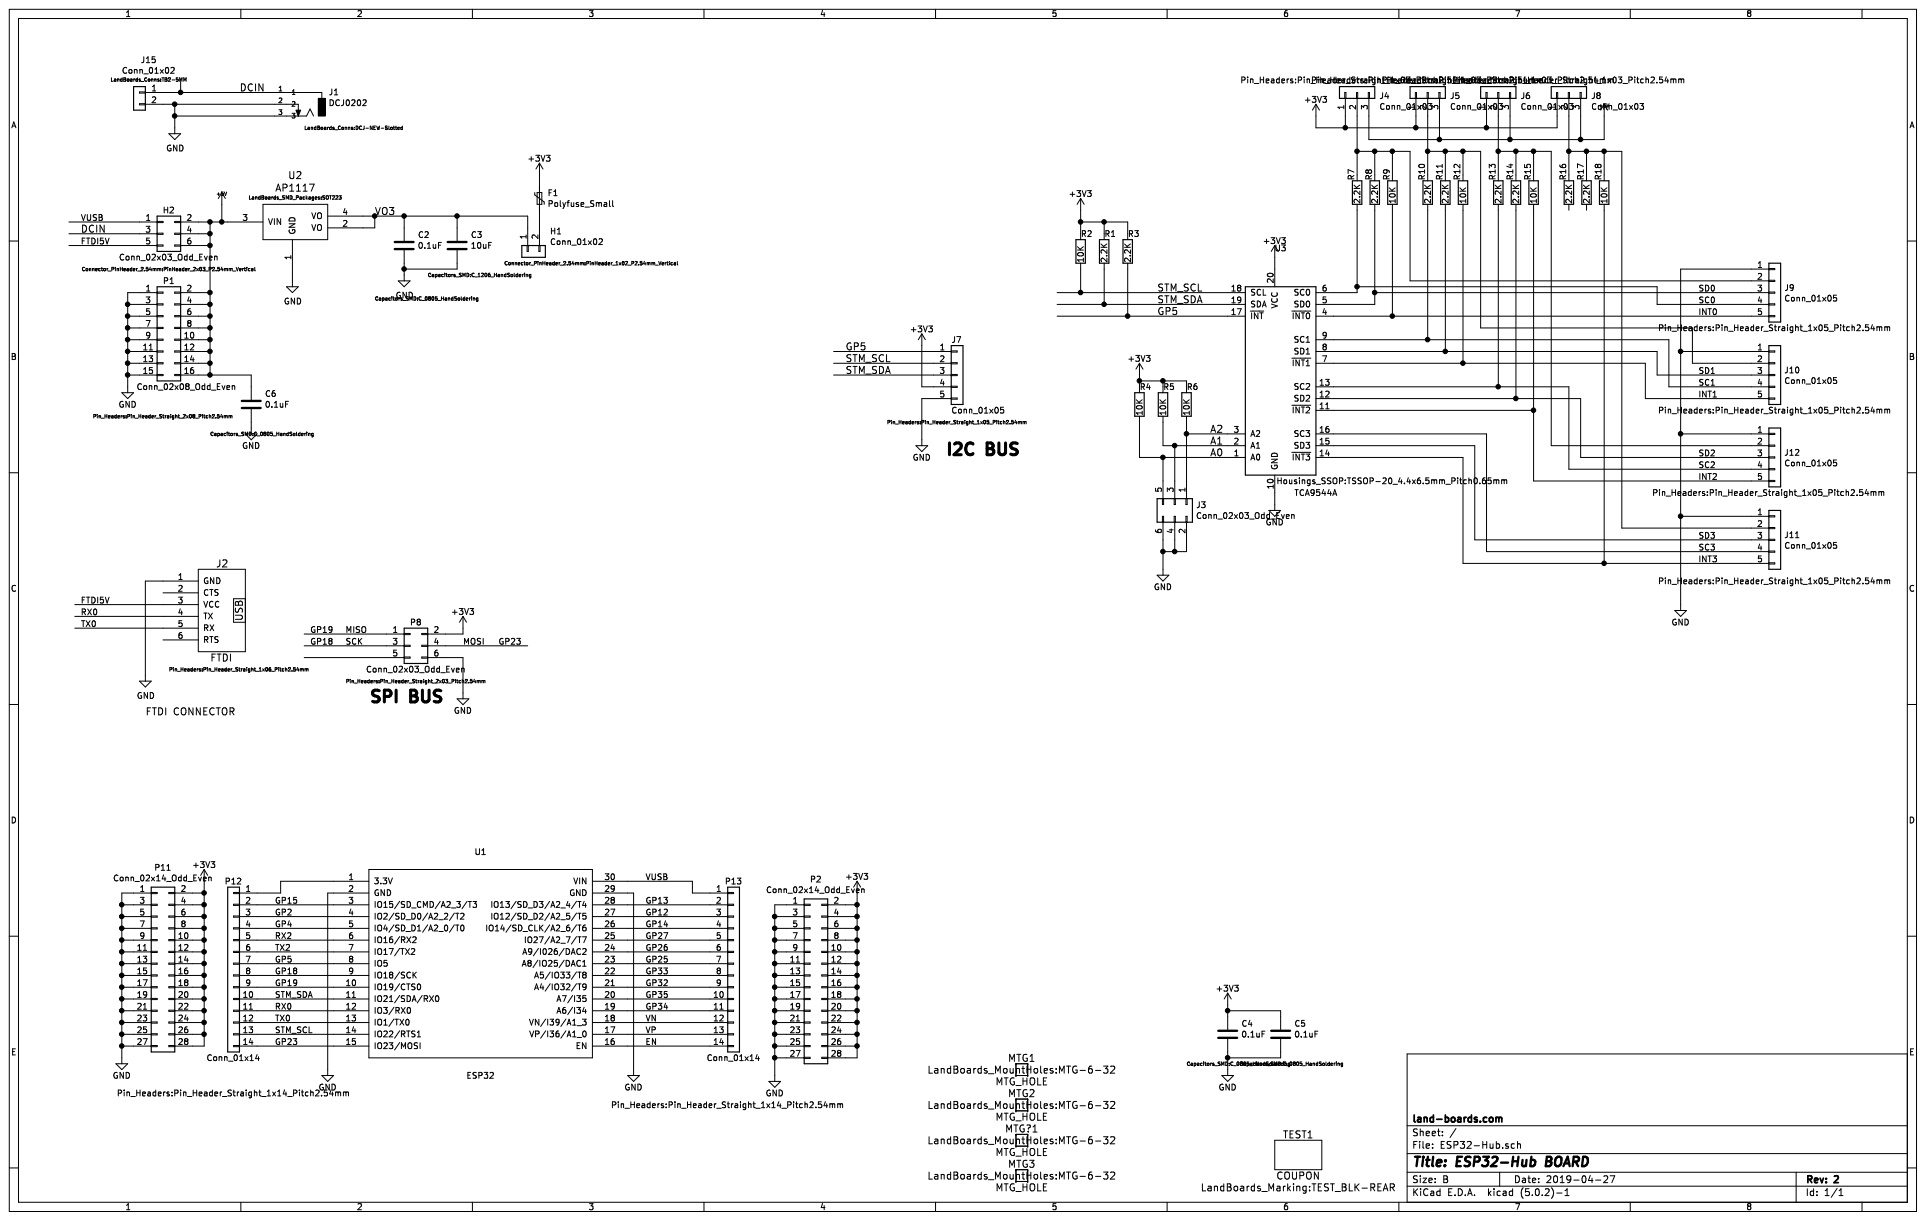
[picture p545: page 1]
