land-boards/lb-boards/Raspberry Pi Cards/RasPi-Plus-GVS-CFG/RasPi-GVS-Plus-CFG_Rev_X3_Schematic.pdf

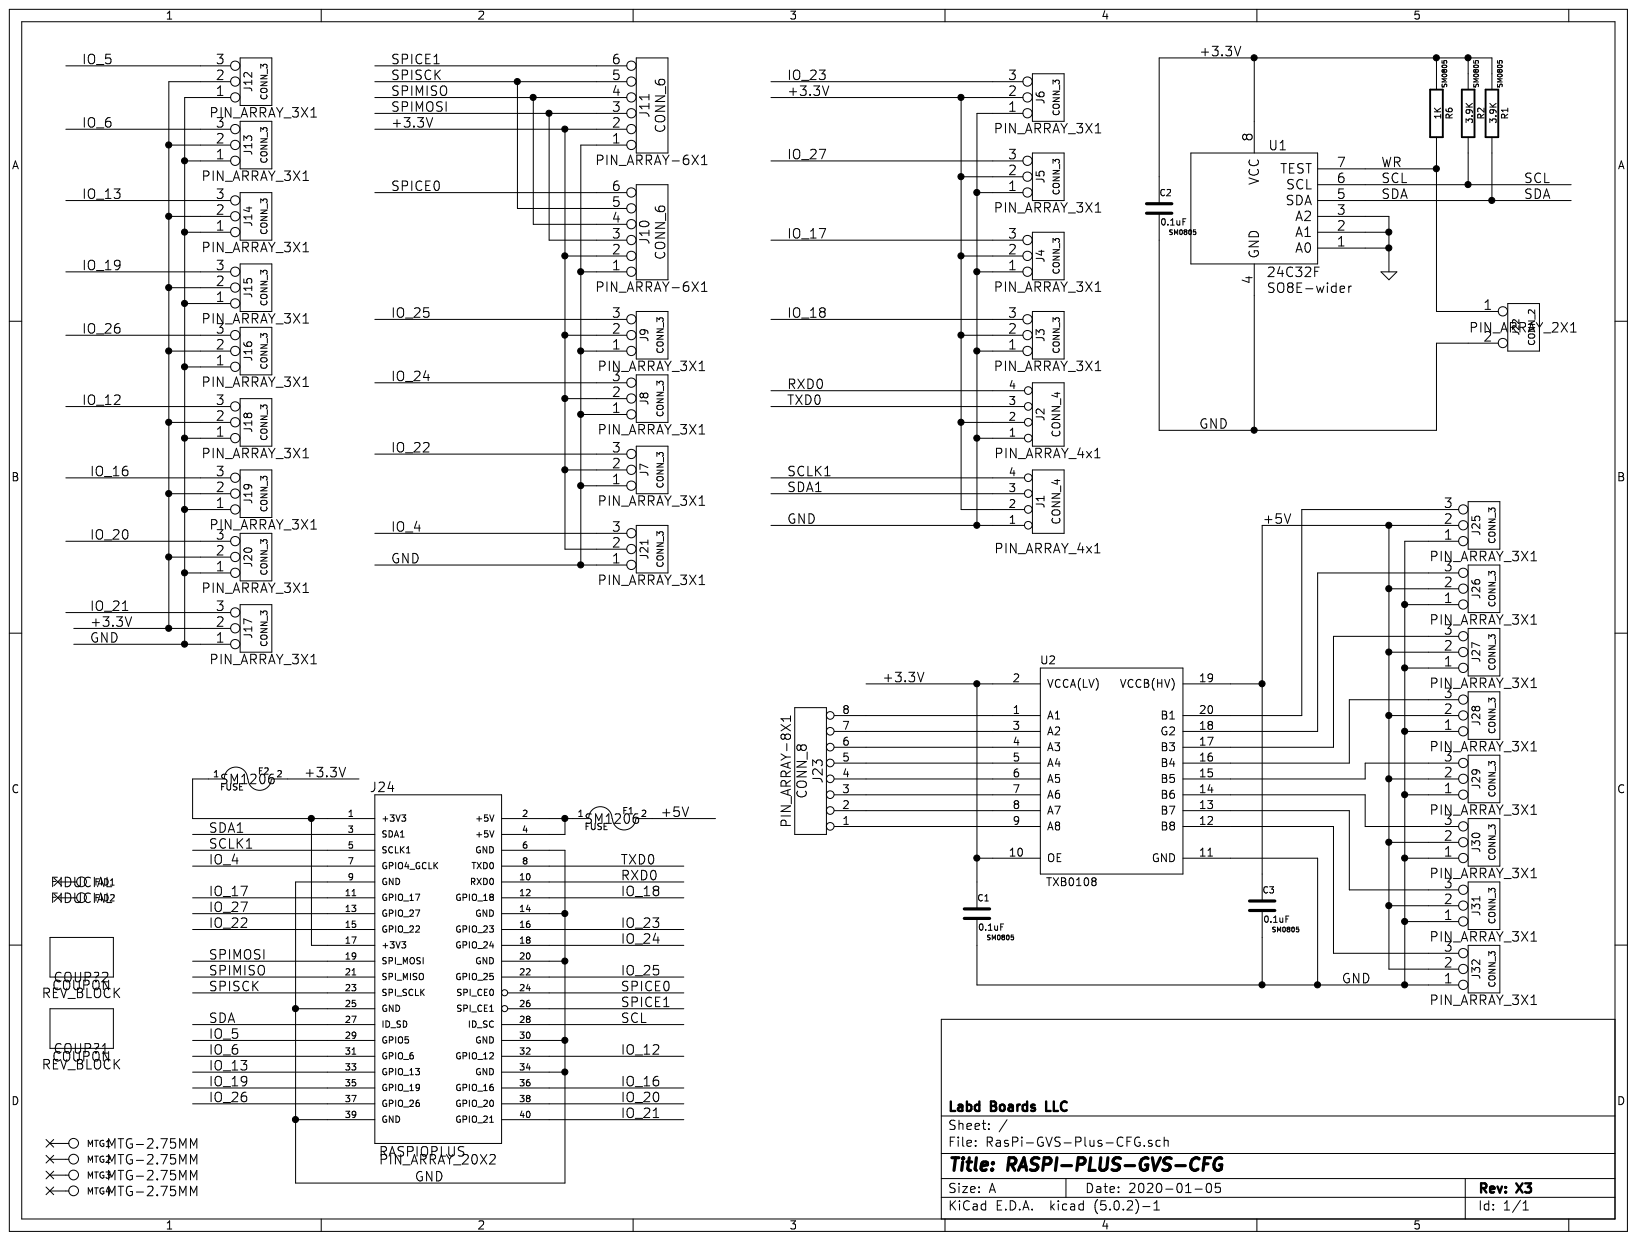
[picture p546: page 1]
