land-boards/lb-boards/Raspberry Pi Cards/RPI-MDI/RPI-MDI_Rev_X3_Schematic.pdf

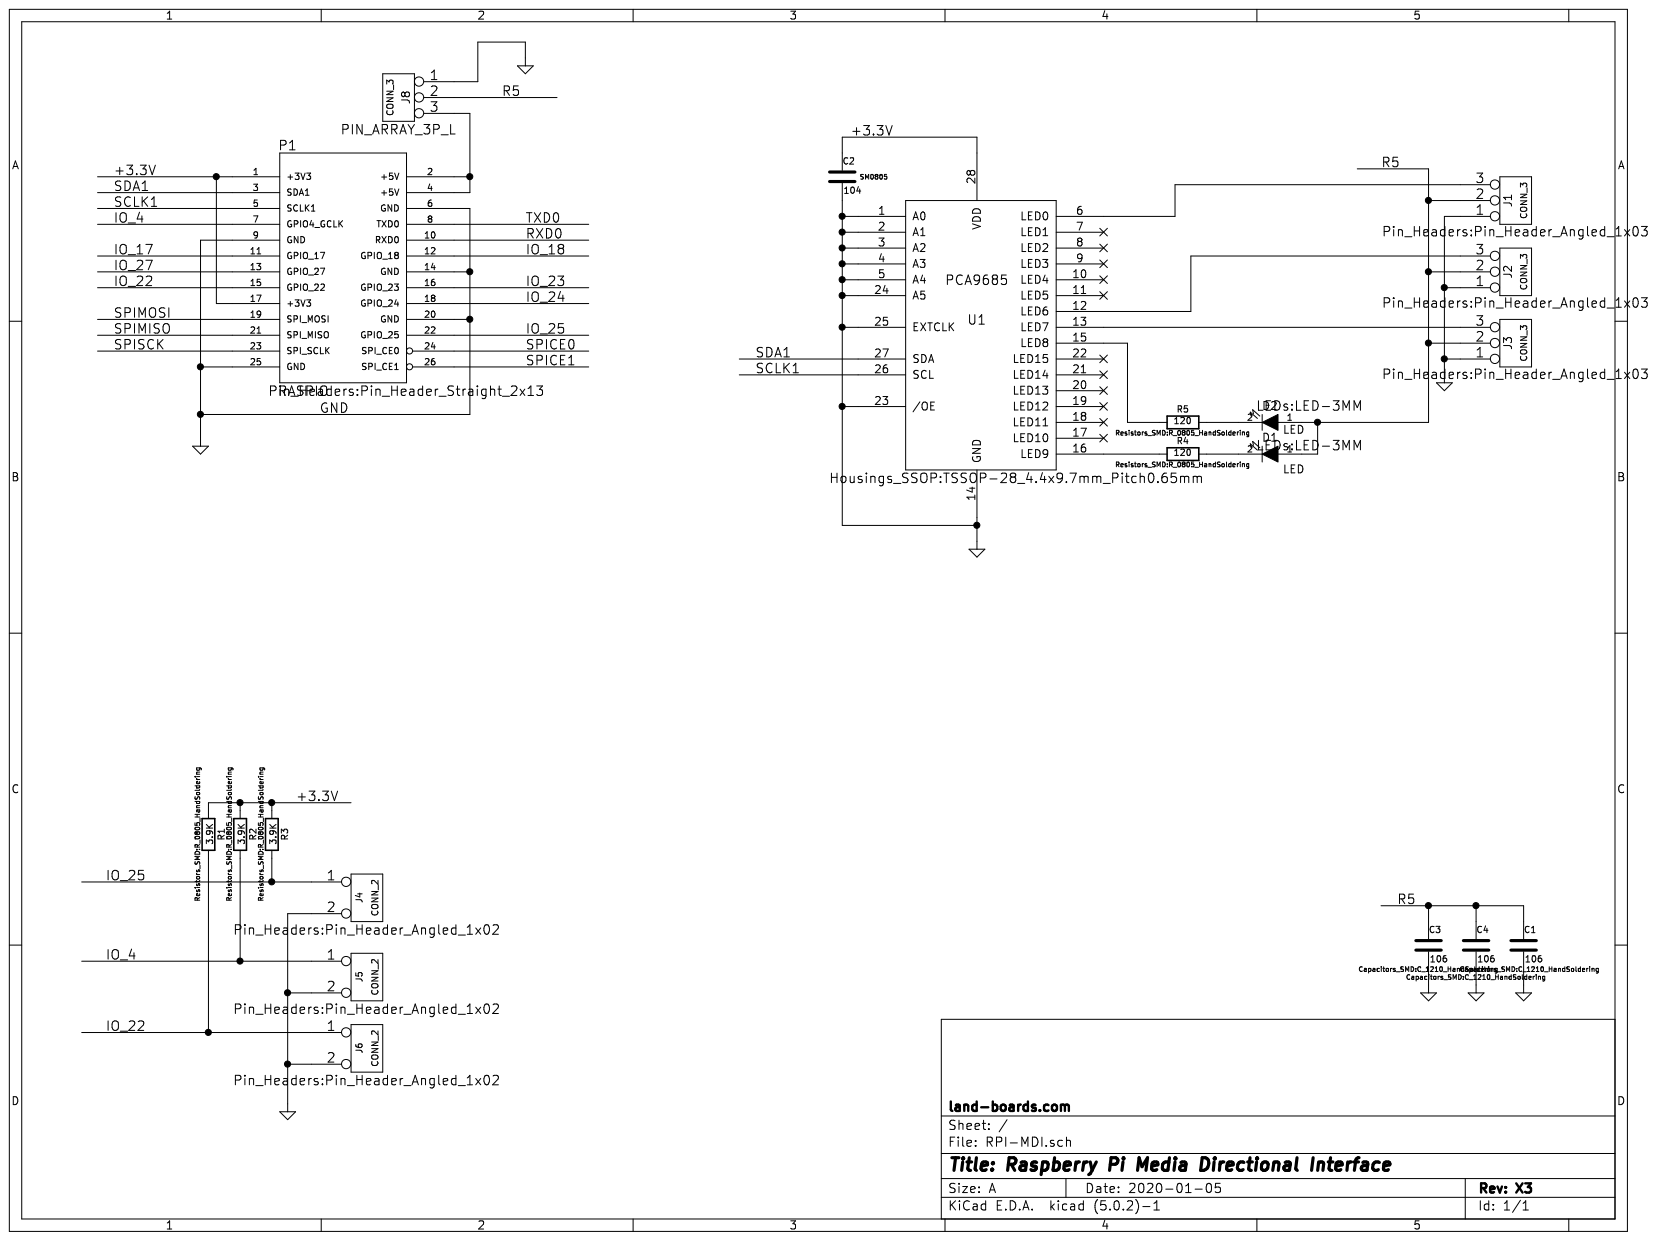
[picture p547: page 1]
