land-boards/lb-boards/Raspberry Pi Cards/RPP-UIO-16/RPP-UIO-16_Rev_X2_Schematic.pdf

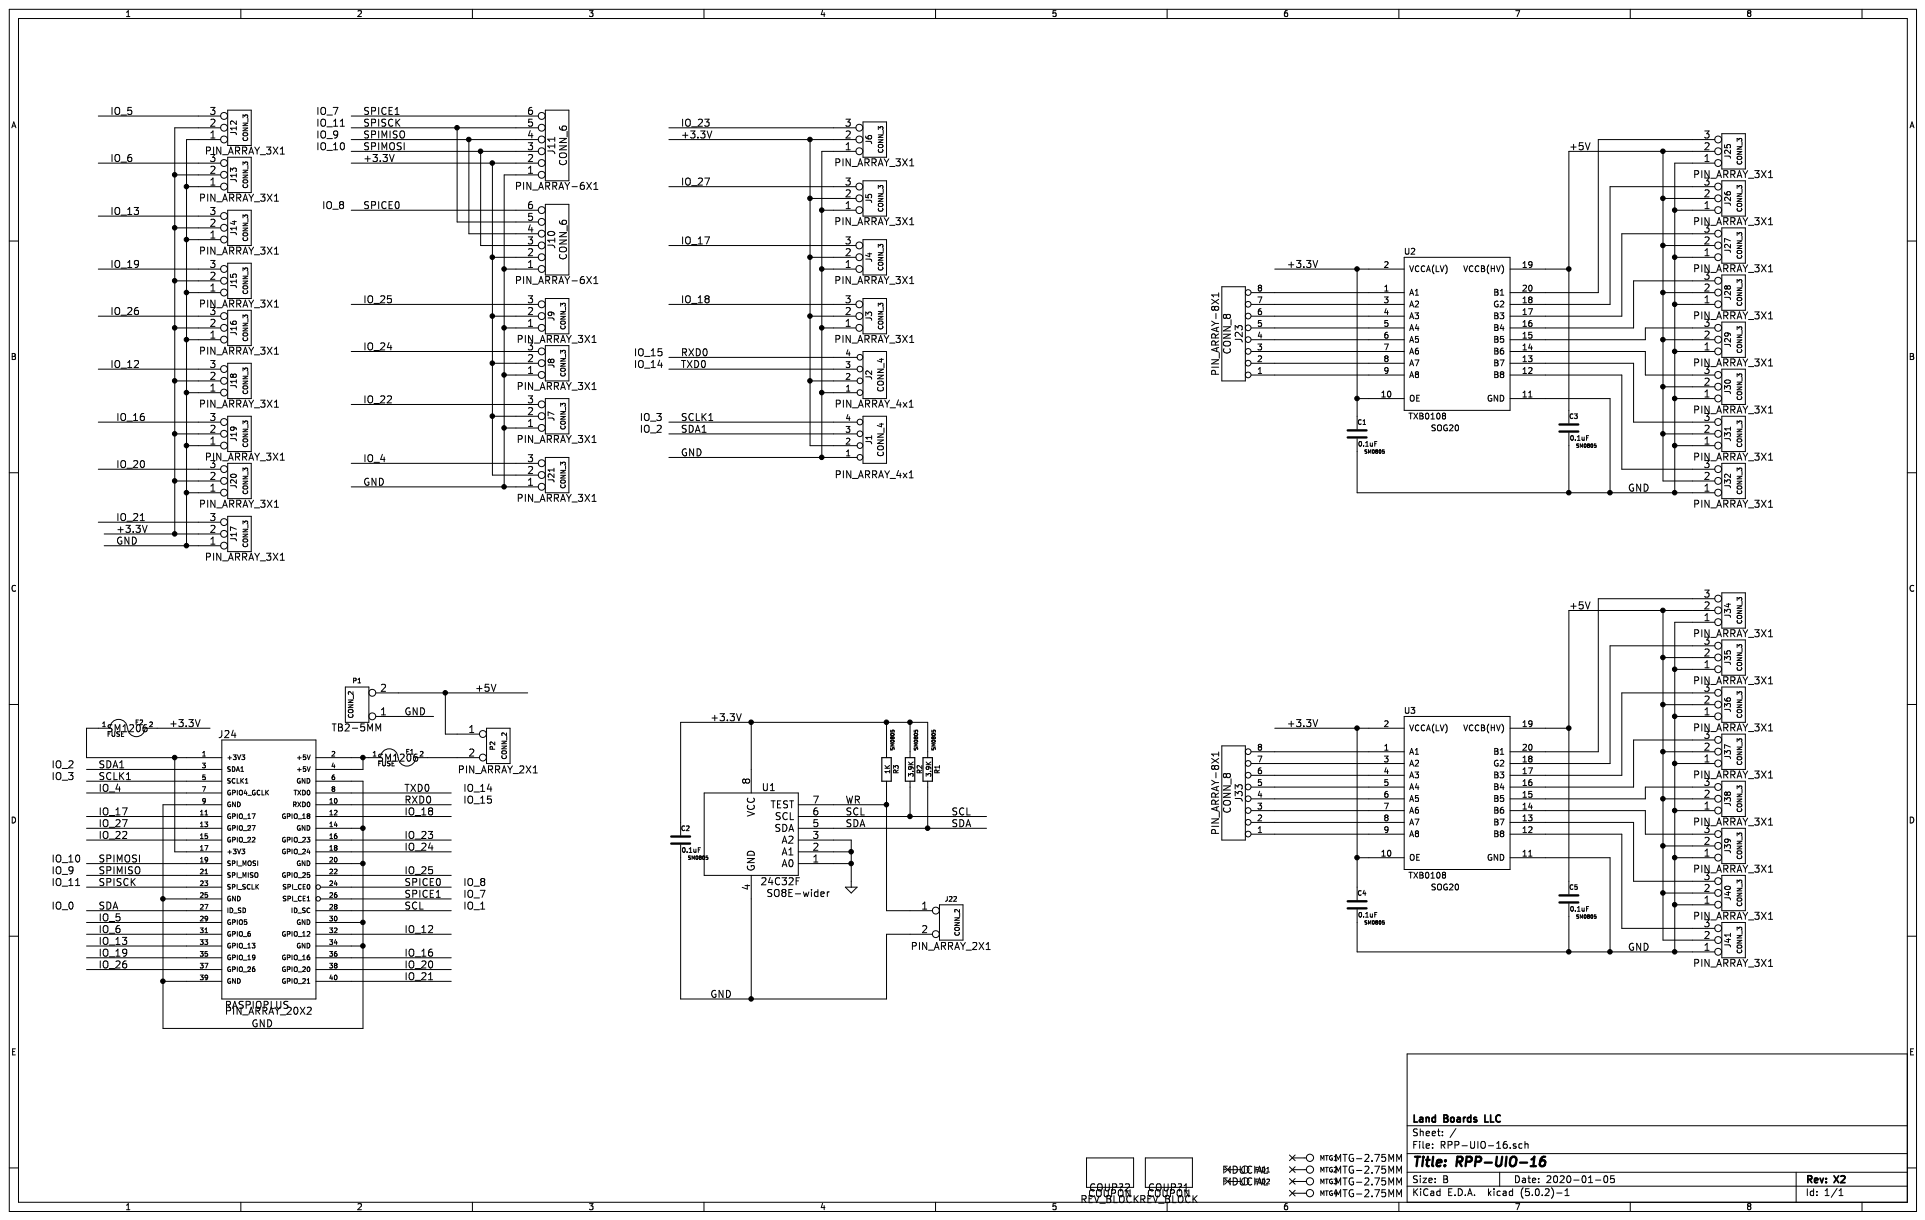
[picture p548: page 1]
