land-boards/lb-boards/Raspberry Pi Cards/RasPi-Plus-GVS/Raspi-Plus-GVS_Rev_X2_Schematic.pdf

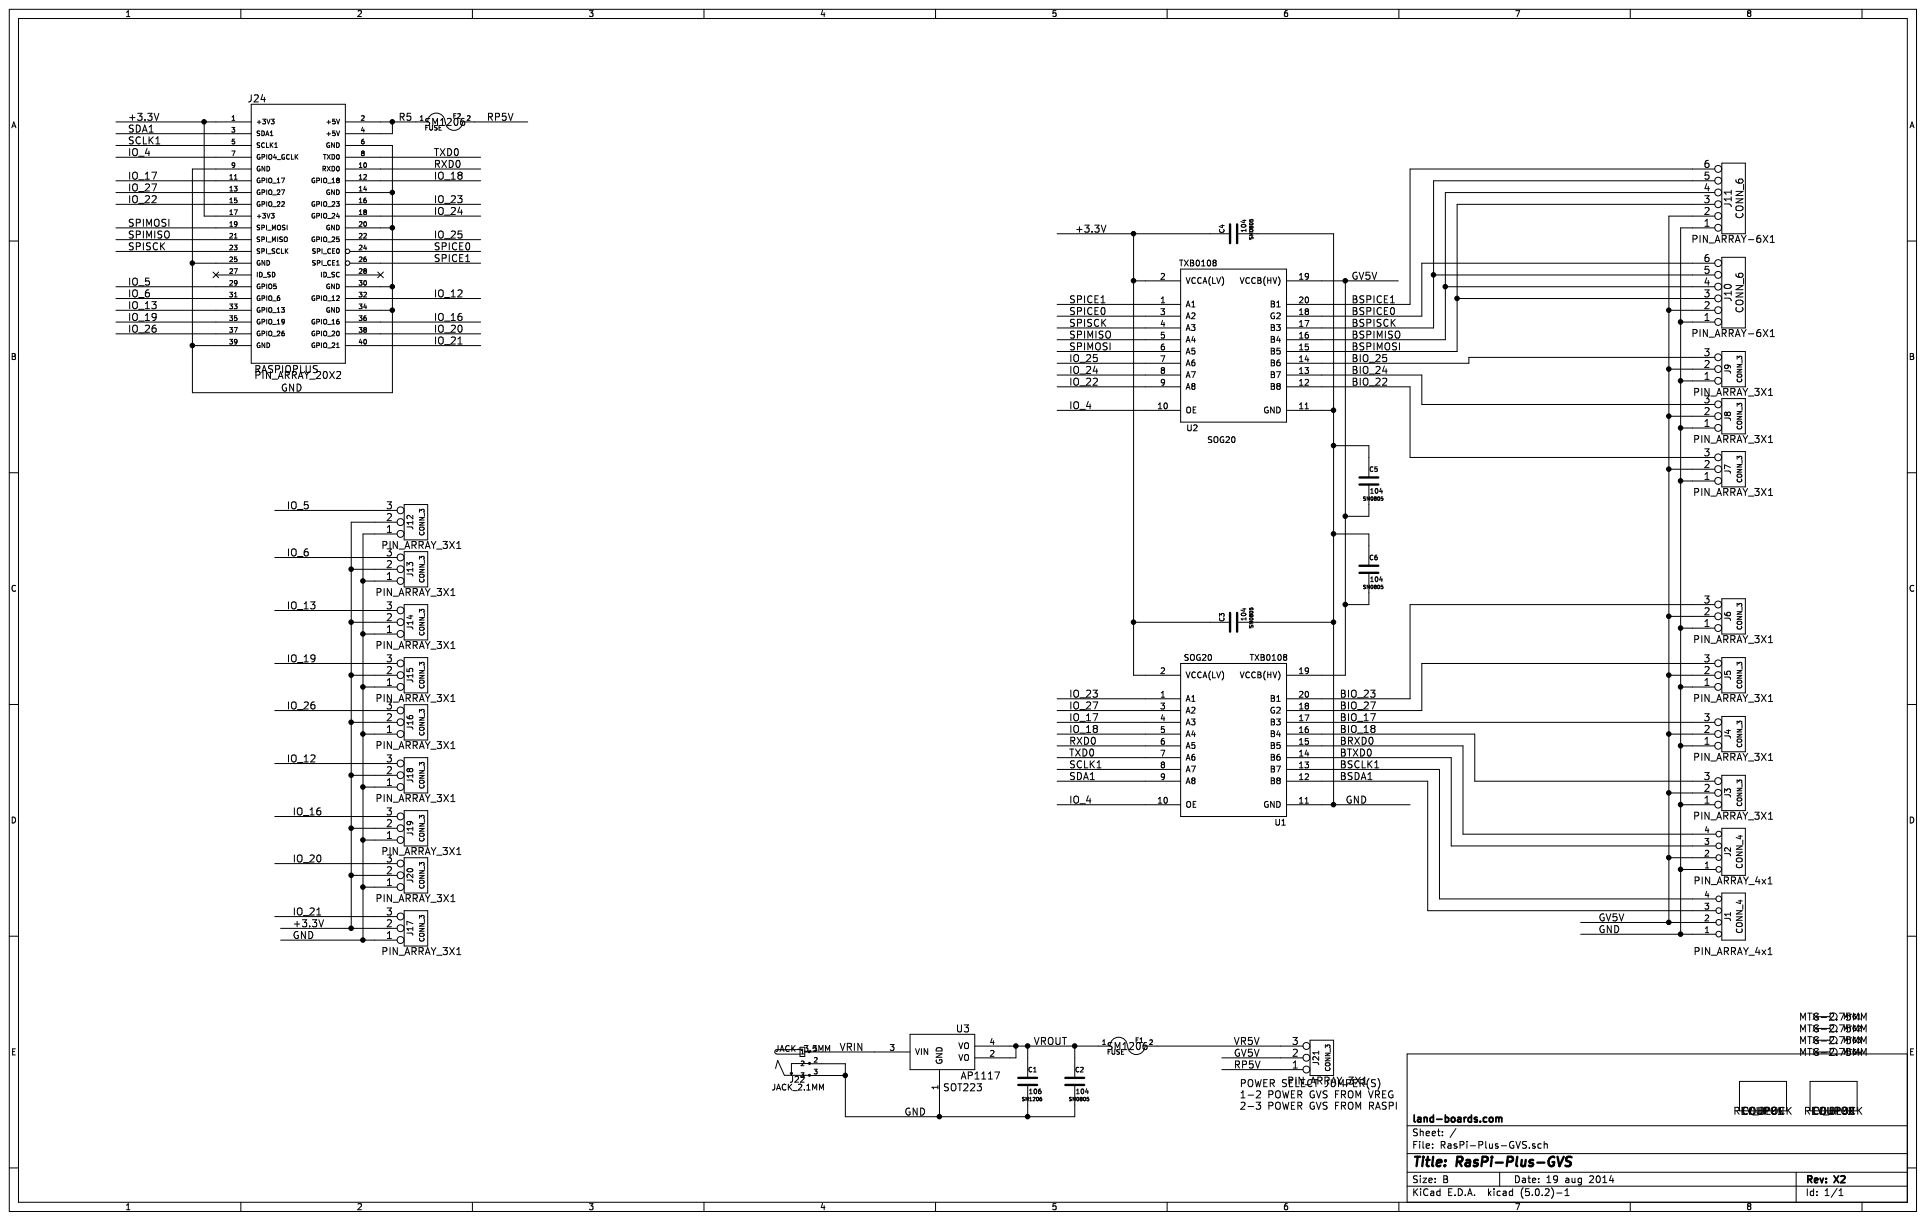
[picture p549: page 1]
