land-boards/lb-boards/I2C Cards/DigIO16-I2C/DigIO16-I2C_X3_Schematic.pdf

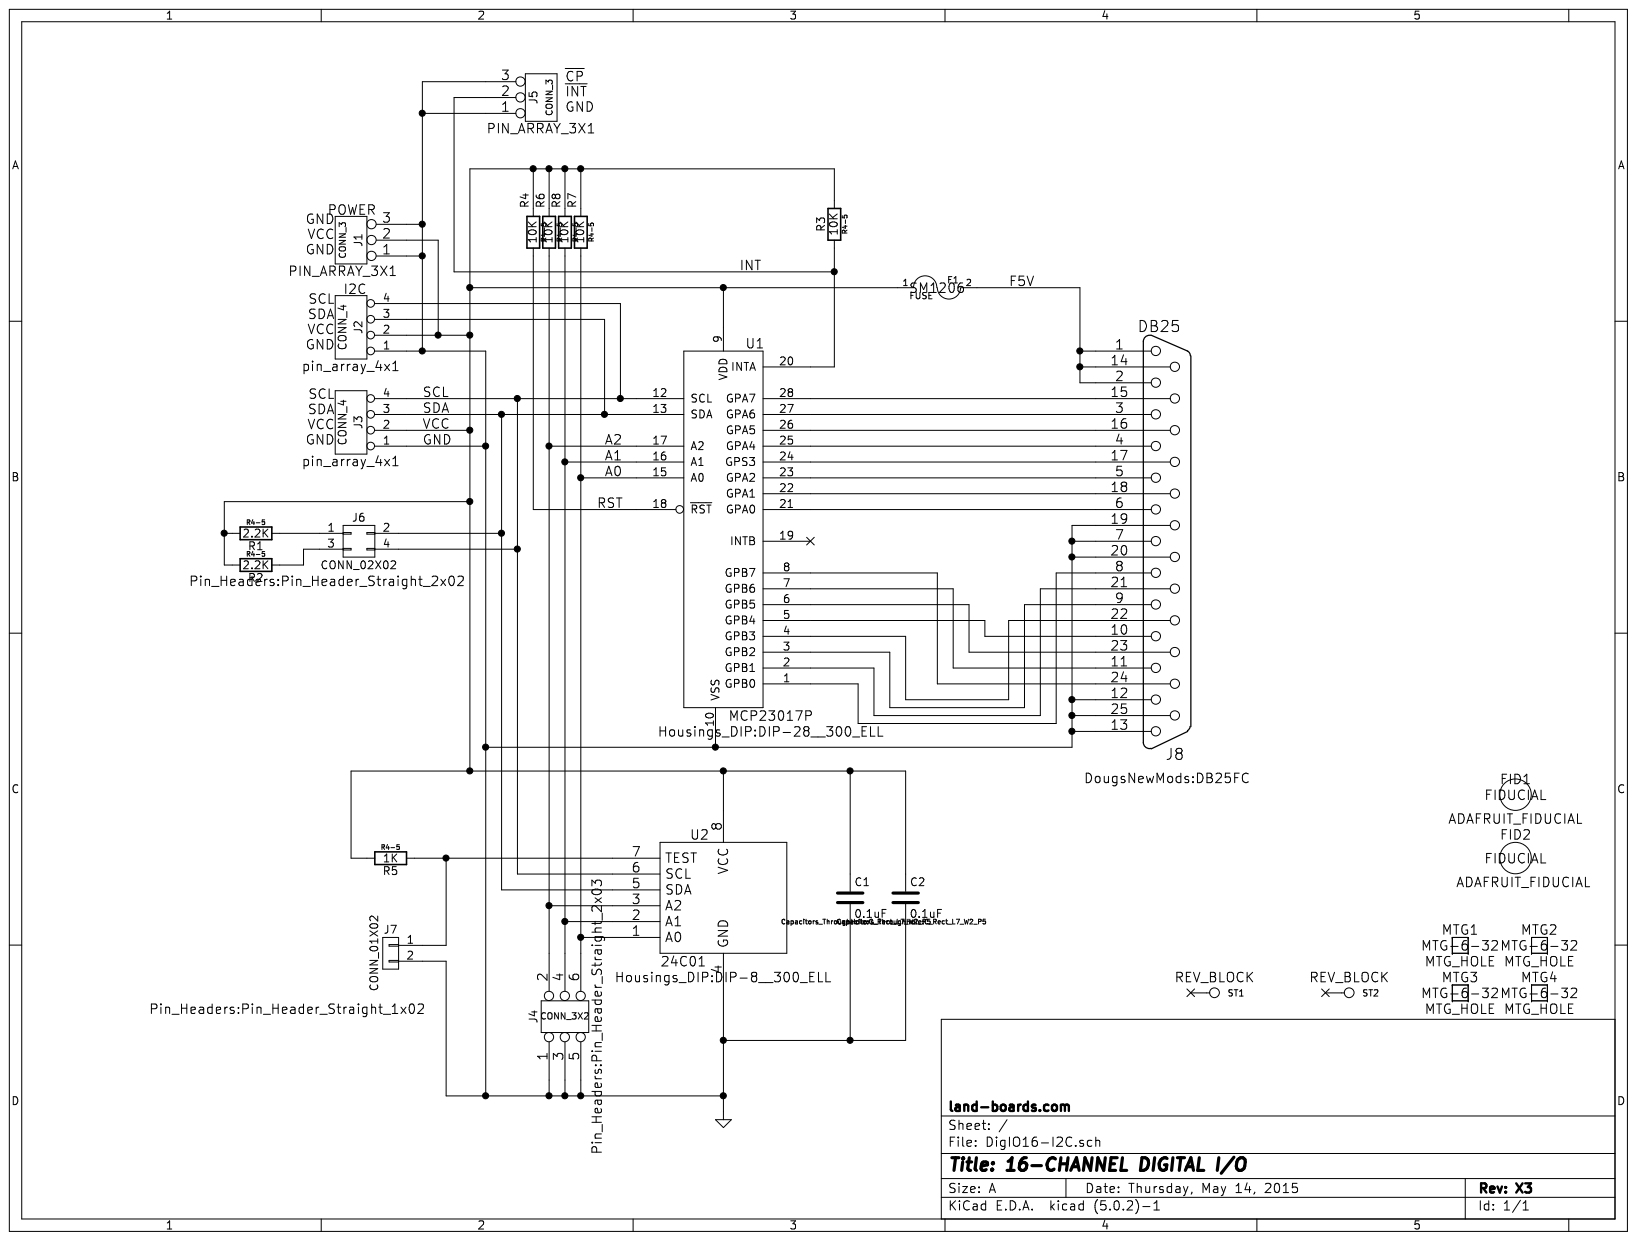
[picture p550: page 1]
