land-boards/lb-boards/I2C Cards/I2C-RPT-01/I2C-RPT-01_RevX3_Schematic.pdf

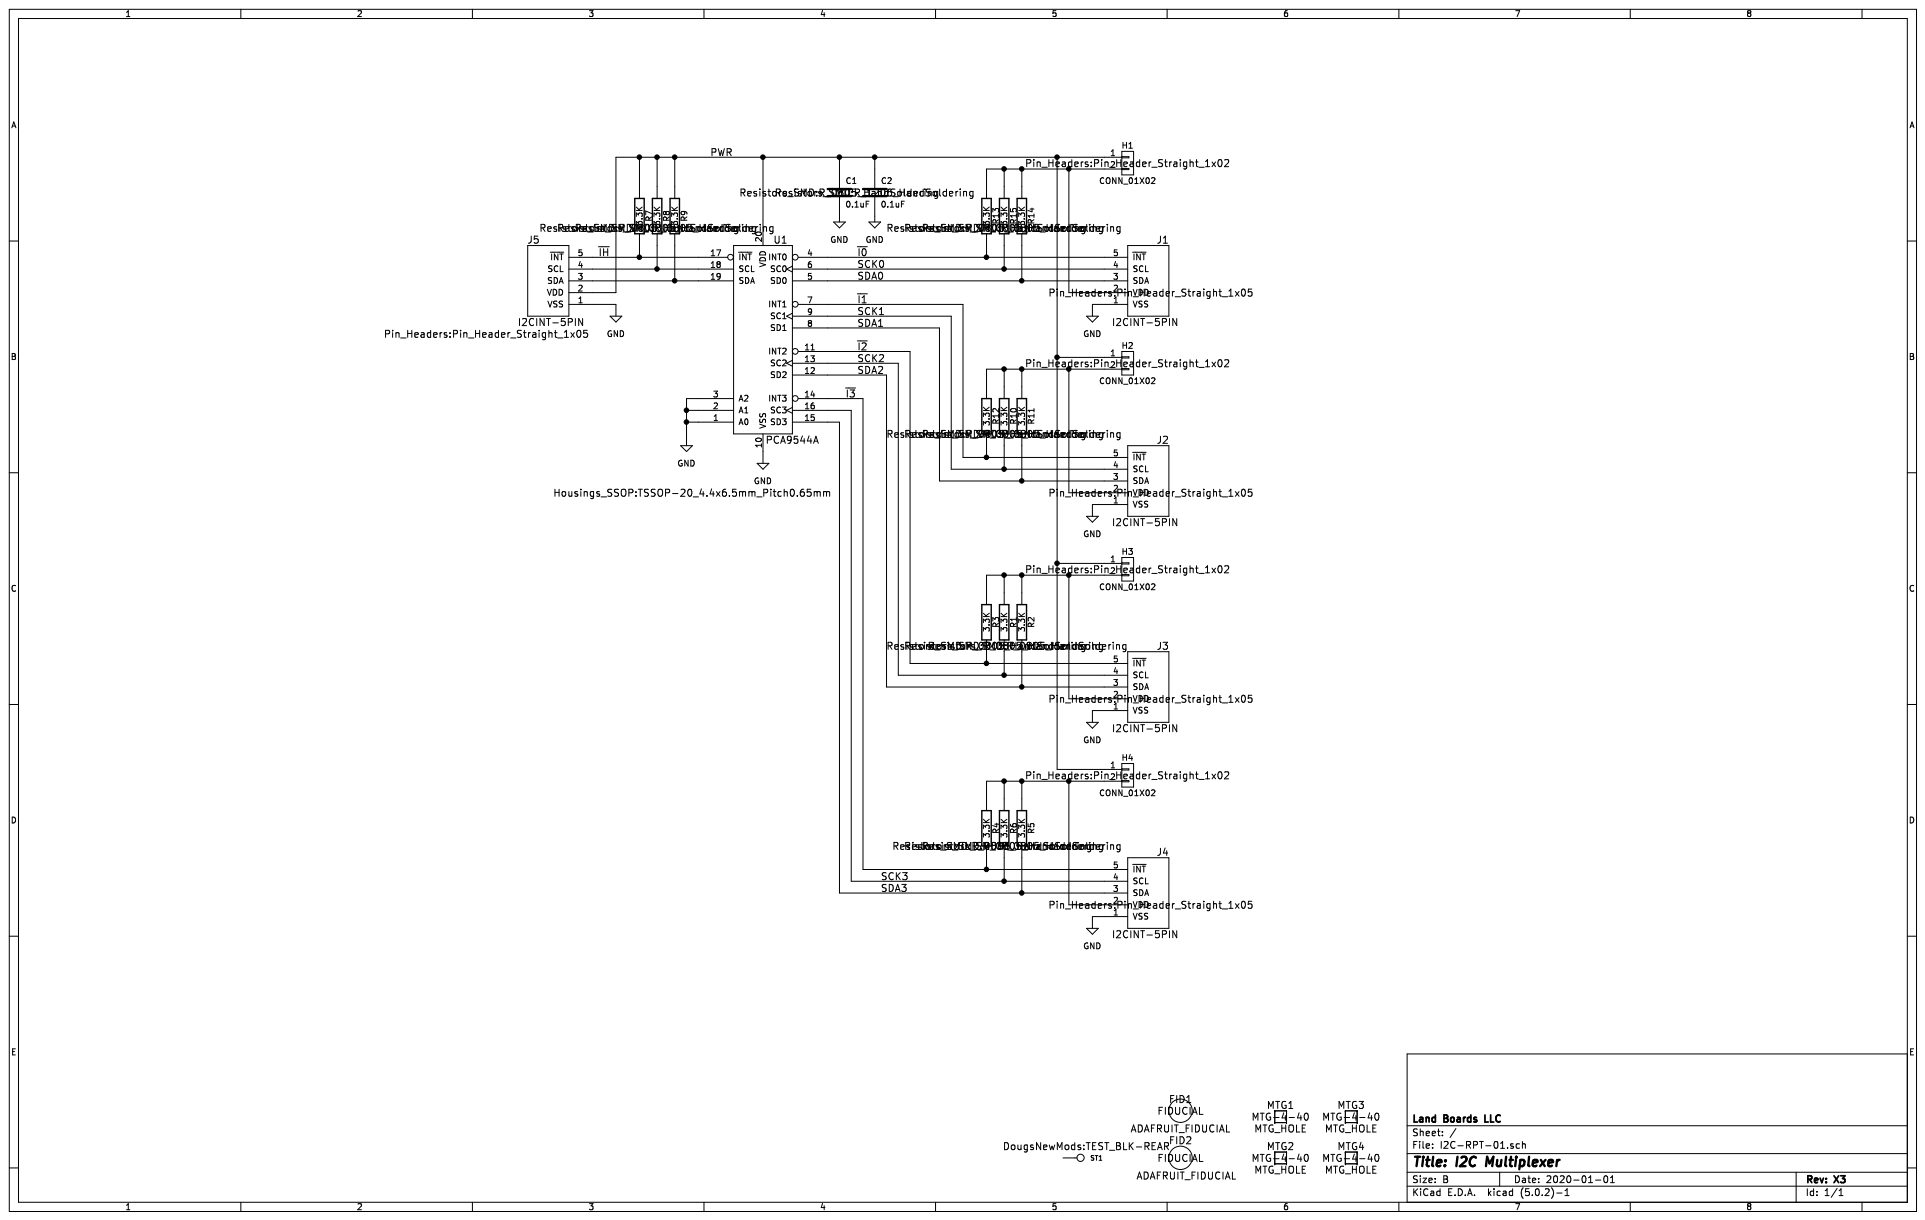
[picture p551: page 1]
