land-boards/lb-boards/FPGA Cards/RETRO-EP4CE6/RETRO-EP4_Schematic_Rev_X2.pdf

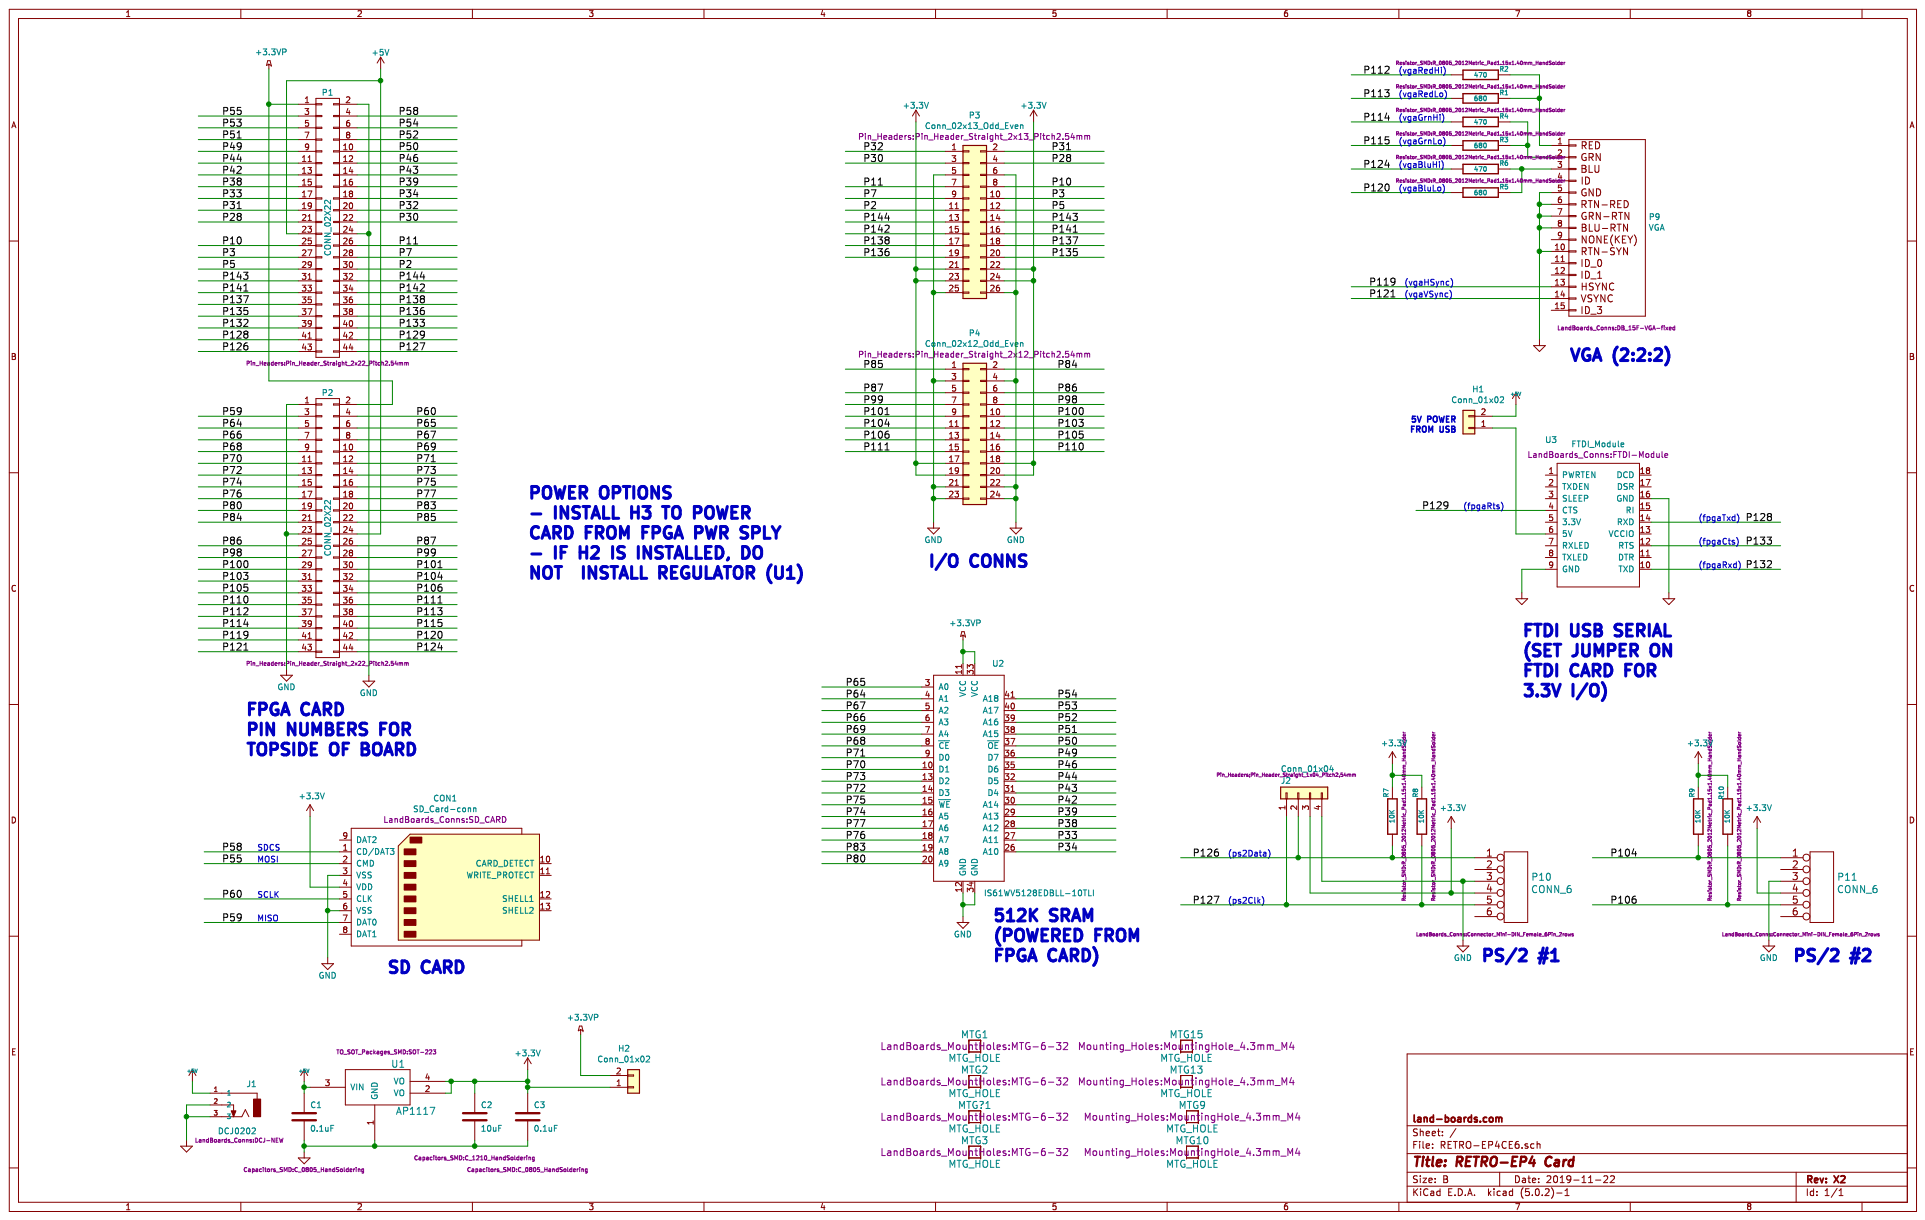
[picture p552: page 1]
