land-boards/lb-boards/Raspberry Pi Cards/RPI_PSOC5/RPI_PSOC5_Schematic_Rev_2.pdf

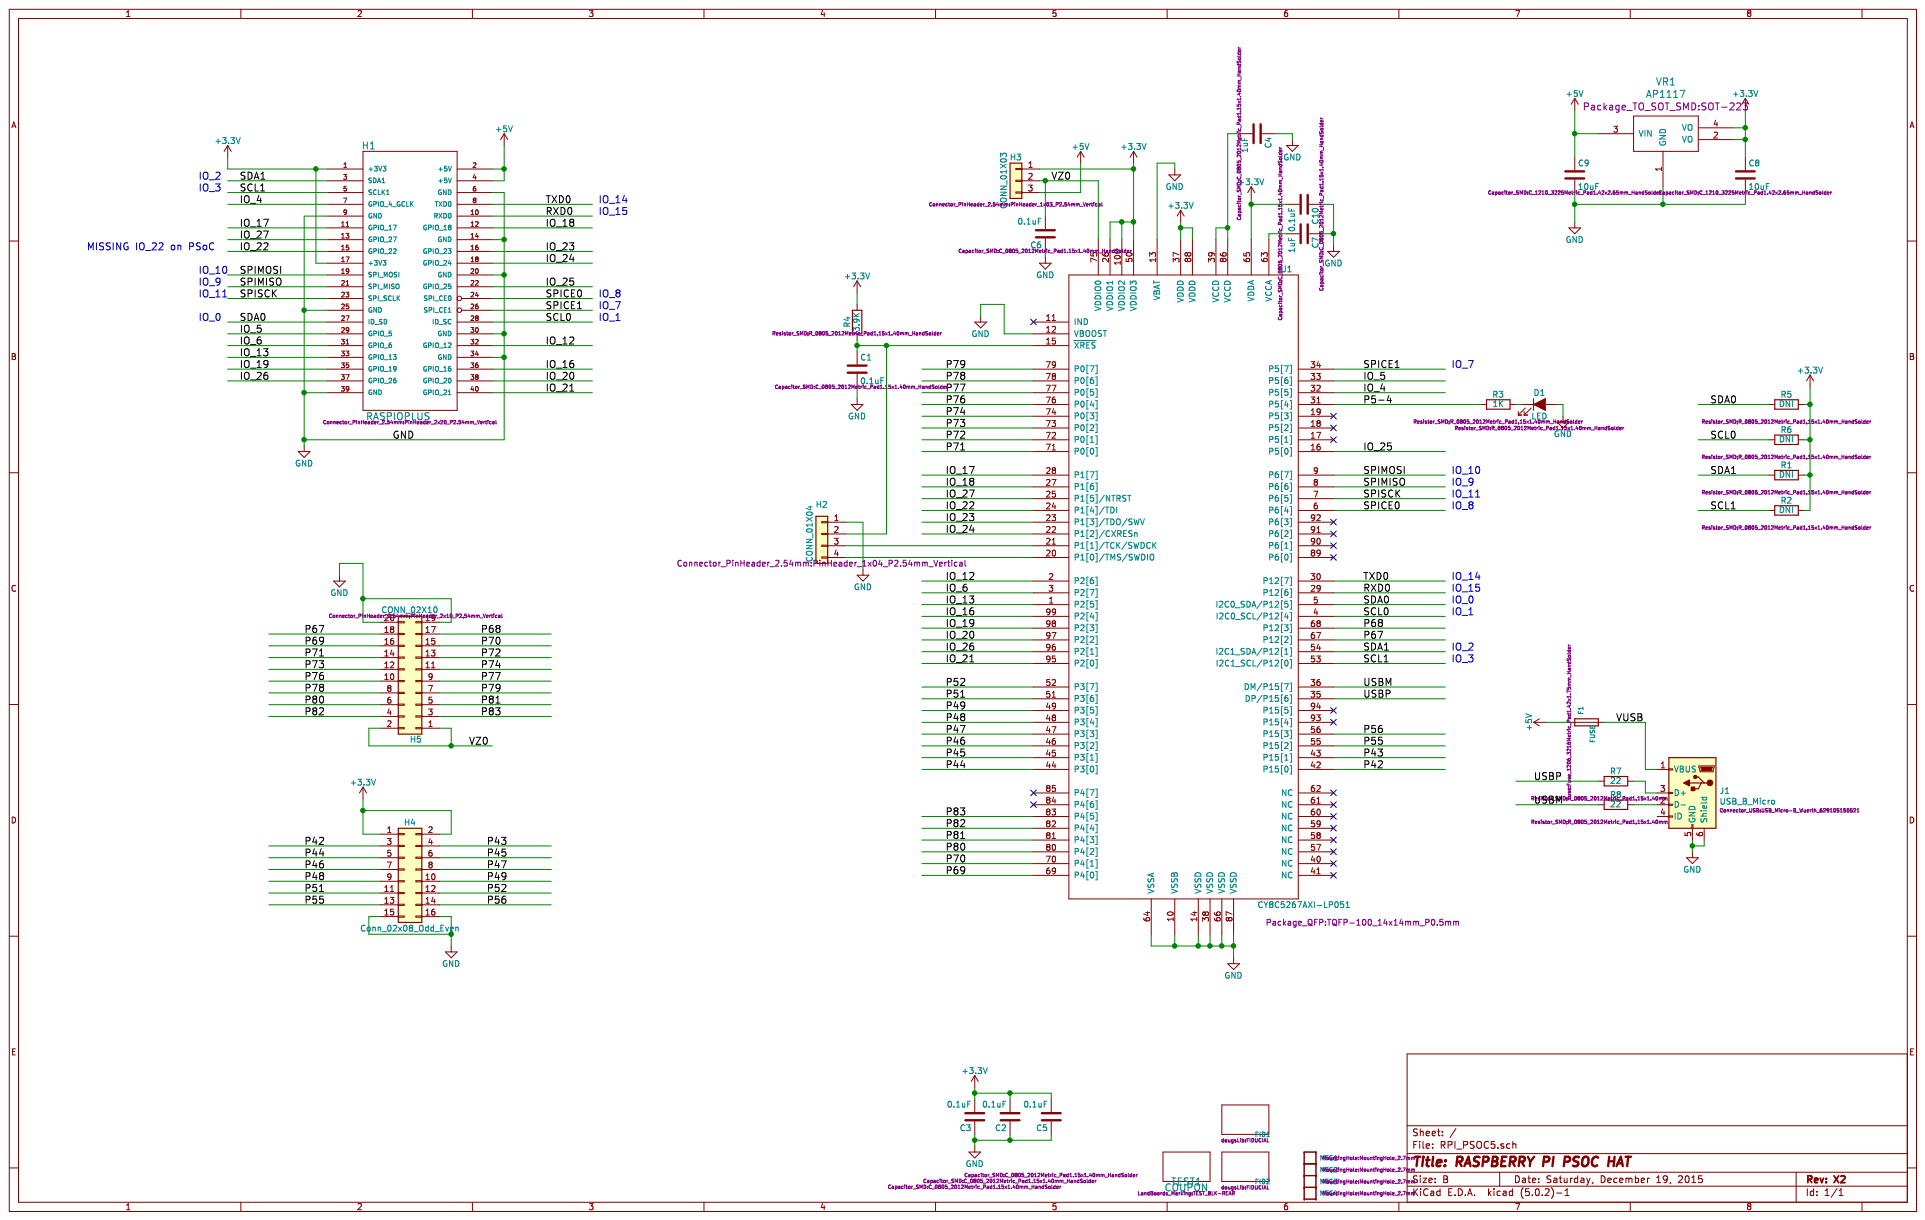
[picture p553: page 1]
