land-boards/lb-boards/FPGA Cards/RETRO-EP4CE6/RETRO-EP4_Schematic_Rev_X1.pdf

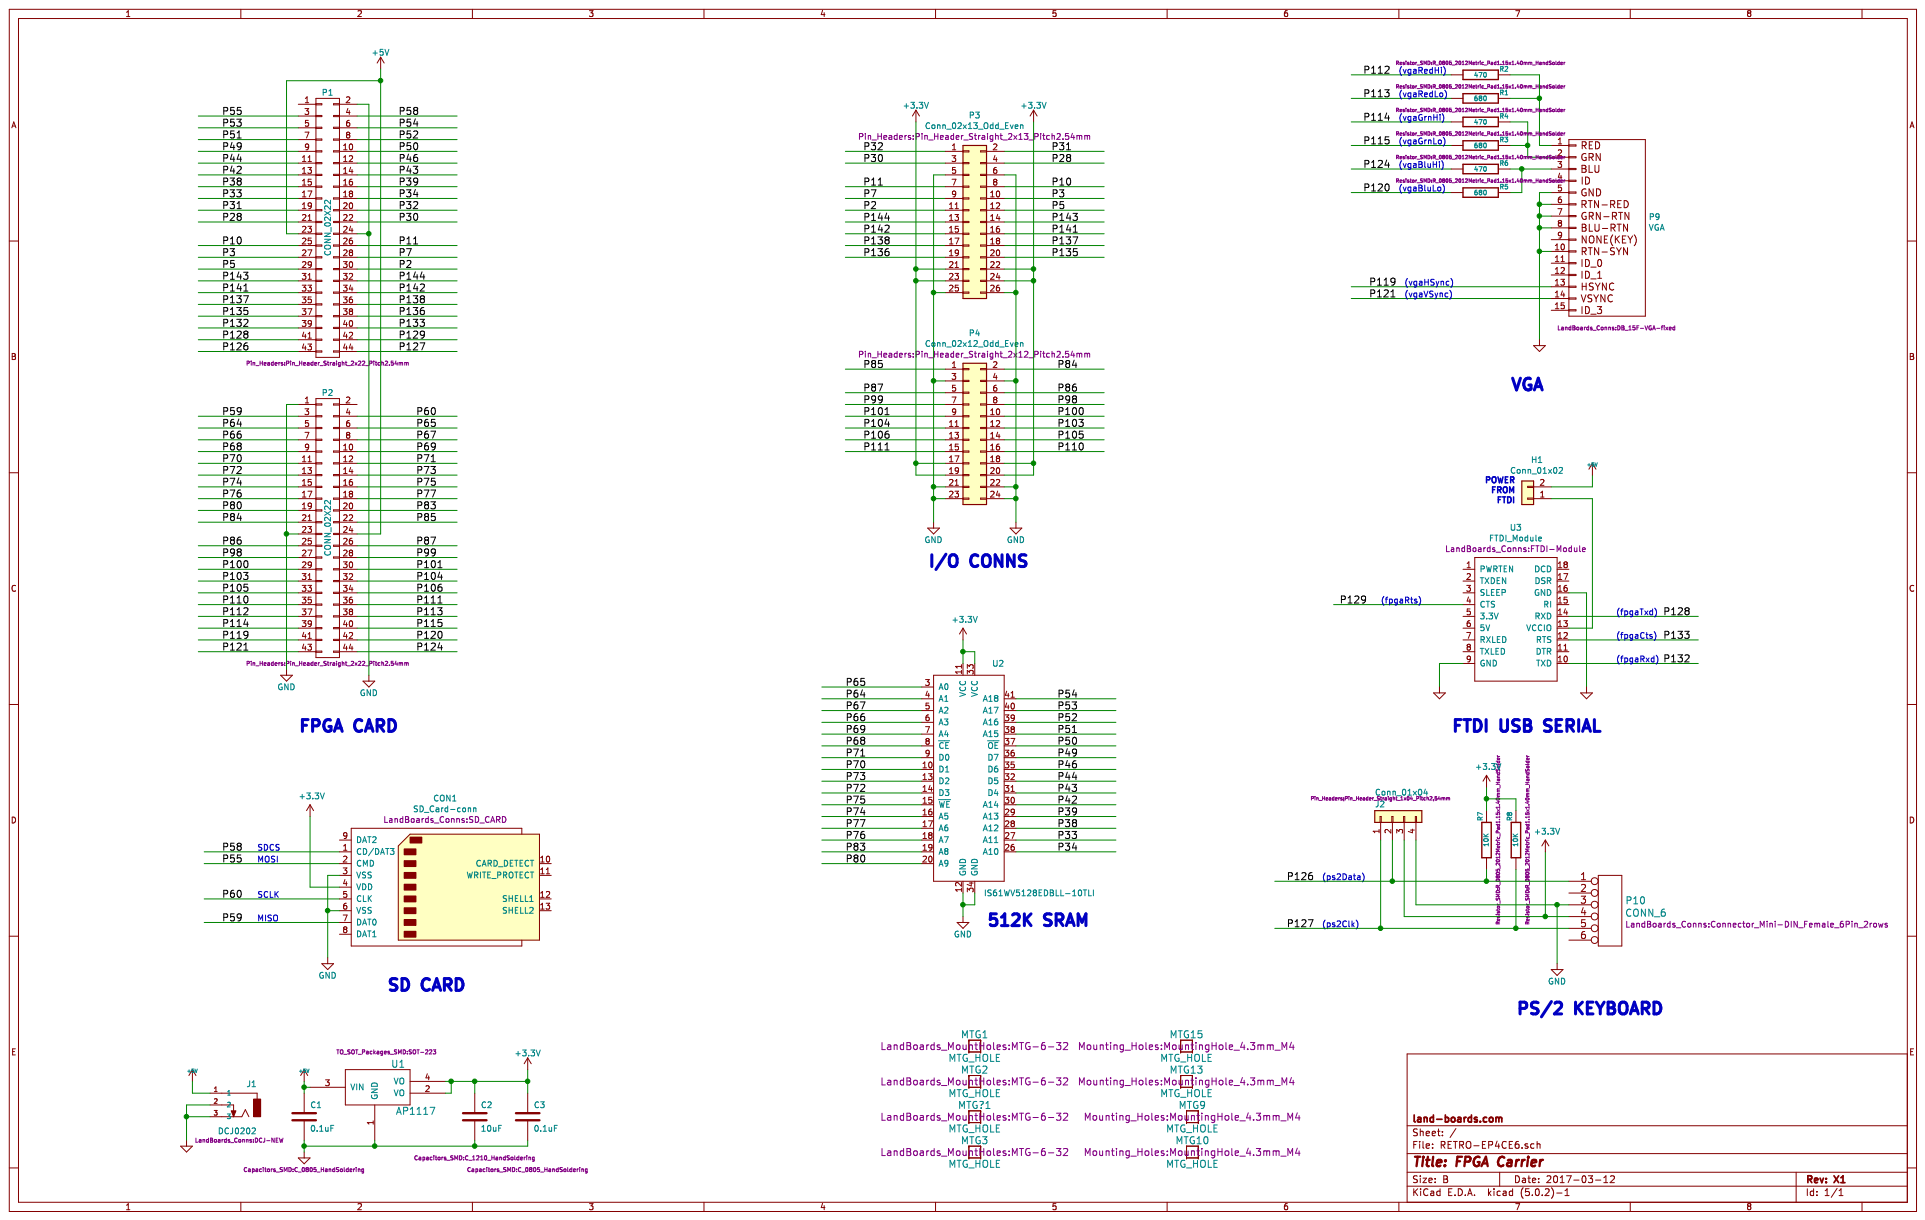
[picture p554: page 1]
