land-boards/lb-boards/FPGA Cards/BASE-EP4CE6/BaseEP6-Schematic.pdf

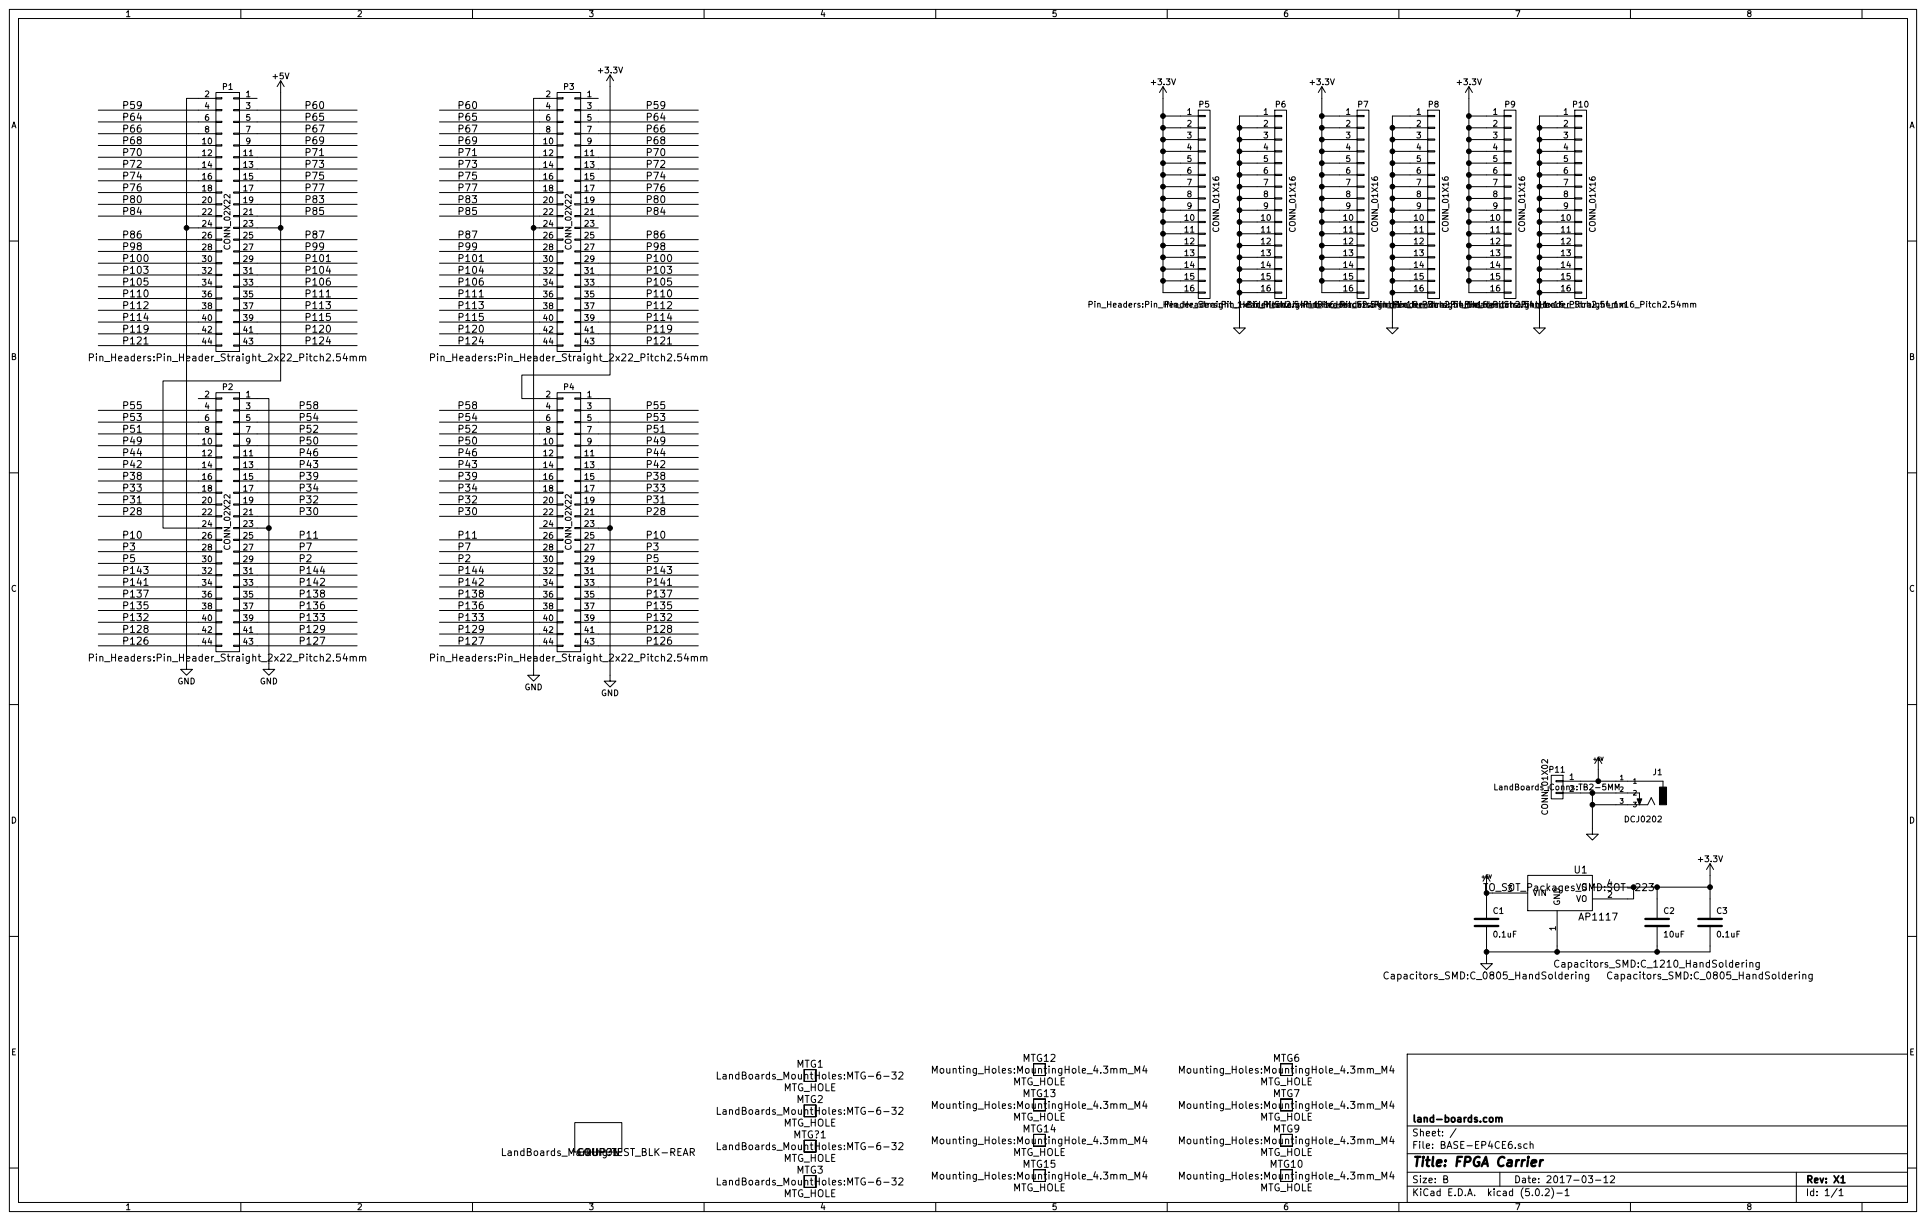
[picture p555: page 1]
