land-boards/lb-boards/Audio Cards/AudioAmp384/AudioAmp384 Schematic.pdf

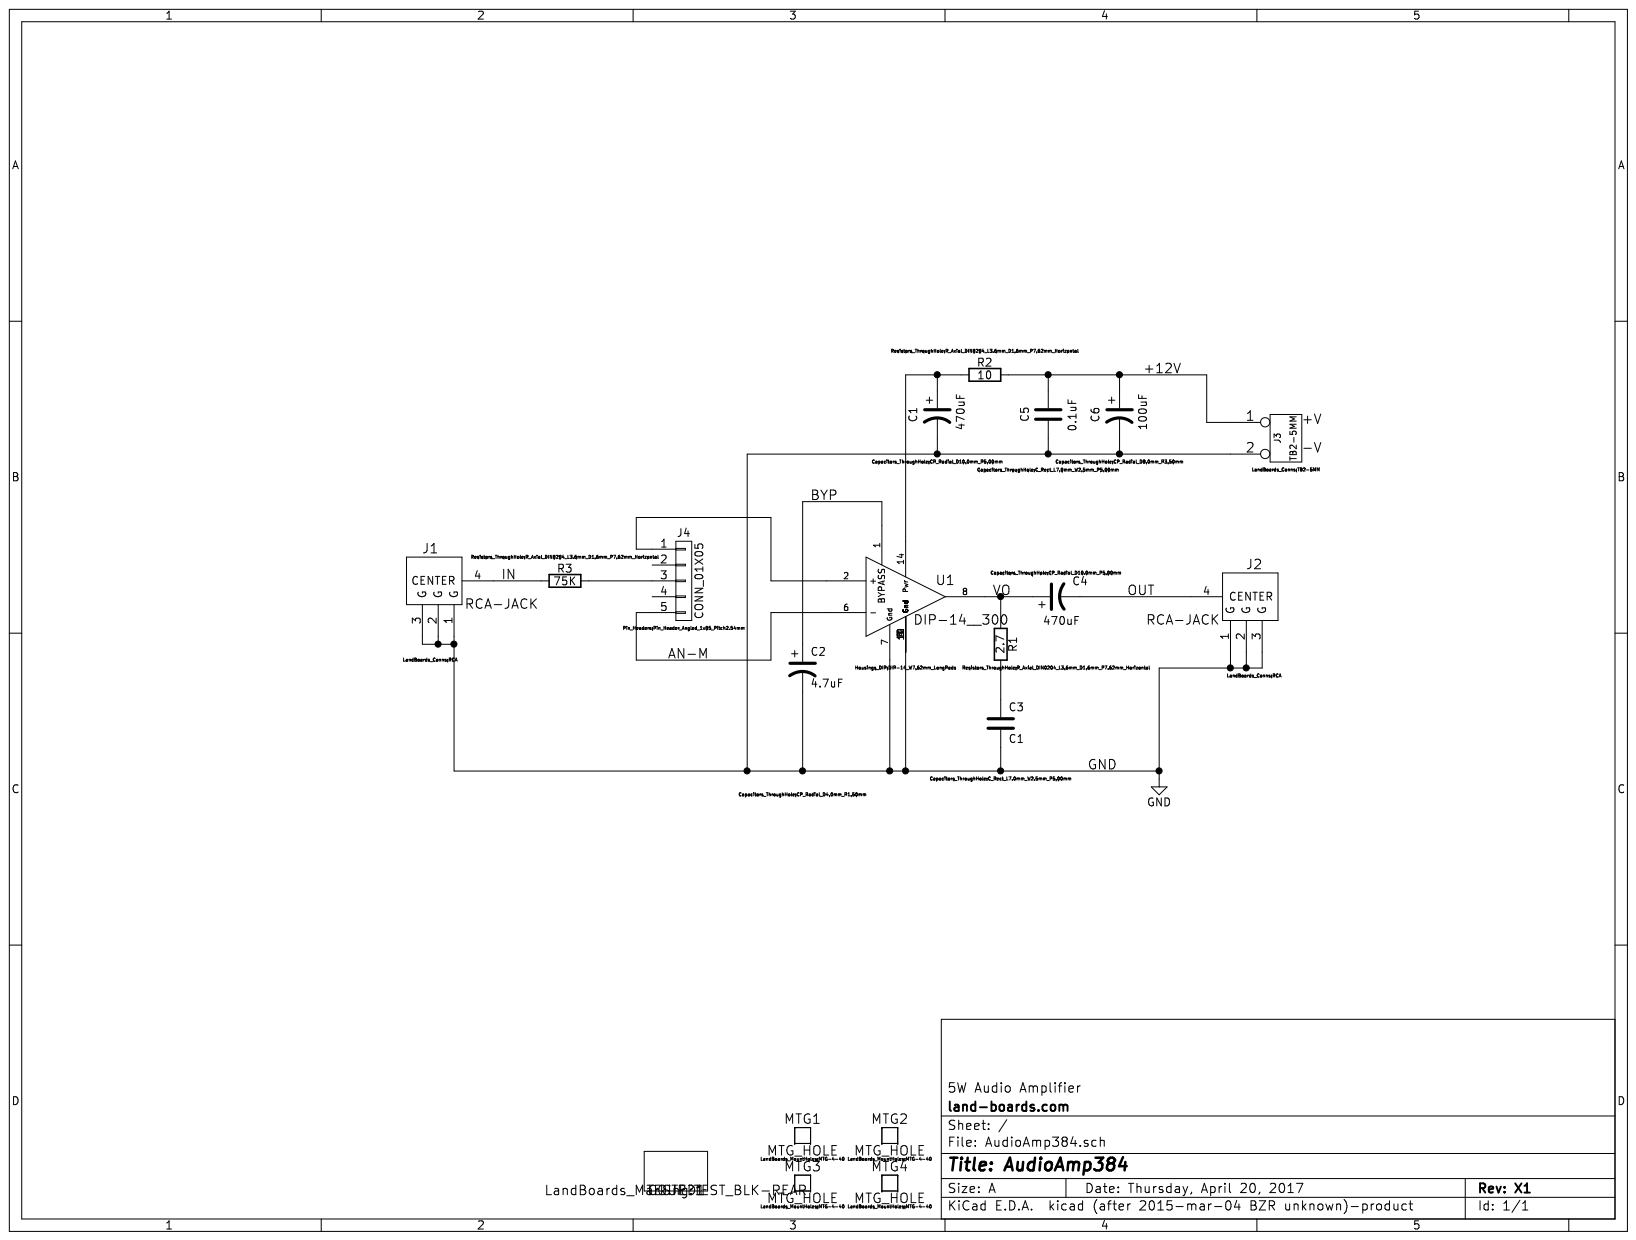
[picture p556: page 1]
