land-boards/lb-boards/Test Equipment Cards/DiffProbe/Simulations/LTC6268_isoSPI_DiffAmp-1-msecScale.asc

C1: cap; 2.2n
C2: cap; .07p
C3: cap; 2.2n
C4: cap; 1µ
C5: cap; 14p
C6: cap; {Cp2}
C7: cap; {Cp2}
C8: cap; {Cp2}
C9: cap; {Cp2}
C10: cap; {Cp2}
C11: cap; {Cp2}
C12: cap; {Cp2}
C13: cap; {Cp2}
C14: cap; {Cp2}
C15: cap; 10n
L1: ind2; {Lz2}
L2: ind2; {Lz2}
L3: ind2; {Lz2}
L4: ind2; {Lz2}
L5: ind2; {Lz2}
L6: ind2; {Lz2}
L7: ind2; {Lz2}
L8: ind2; {Lz2}
R1: res; 505k
R2: res; 549
R3: res; 549
R4: res; 4.99K
R5: res; 10K
R6: res; 549
R7: res; 4.99K
R8: res; 10K
R9: res; 191K
R10: res; 48.7
R11: res; 1Meg
R12: res; 505K
R13: res; 10K
U1: LTC6268-10
U2: LTC6268-10
V1: voltage; 5
V2: signal; PULSE(0 -5 100n 2n 2n 100n)
Named nets: 0, +V, -IN, +IN, OUT, SCOPE
.param Lz2=29n Cp2=11p
Note:
  C2 is stray capacitance from a wire positioned above R4 (location and clearance tuned for best settling/stability).
  If the simulation model is not found please update with the "Sync Release" command from the "Tools" menu.
  It remains the customer's responsibility to verify proper and reliable operation in the actual application.
  Component substitution and printed circuit board layout may significantly affect circuit performance or reliability.
  Contact your local sales representative for assistance. This circuit is distributed to customers only for use with LTC parts.
  Copyright © 2015 Linear Technology Inc. All rights reserved.
LTC6268-10 - 4GHz Ultra-Low Bias Current FET Input Op Amp
Oscilloscope Differential Probe
High common mode range and CMRR, high impedance, super low input current, low input capacitance, high closed loop bandwidth
Model of scope probe and 2ns of 50 Ohm cable
.tran 300n
