land-boards/lb-boards/Projects/RadioDesign/SDR_Upverter/WA3TFS_LPF/LP_Filter.asc

C1: cap; 68p
C2: cap; 150p
C3: cap; 68p
L1: ind; .3µ
L2: ind; .3µ
R1: res; 50
V1: voltage; ""; AC 1; Rser=0
Named nets: 0
.ac dec 10 1MEG 100MEG
