land-boards/lb-boards/HamRadio/NoiseGen/Rev4/LTSpice_Design4/CascodeAmp2.asc

C1: cap; 0.1µ
C2: cap; 0.1µ
C3: cap; 100nF
Q1: npn; 2N3904
Q2: npn; 2N3904
R1: res; 560
R2: res; 50
R3: res; 100K
R4: res; 100K
R5: res; 150K
R6: res; 560K
R7: res; 100K
V1: voltage; ""; AC 1
V2: voltage; 12
Named nets: 0, N1, N3, +12V, N4, N6, N5, N2
;tran 0 100uS 99.9uS
.ac lin 100 1K 100MEG
