land-boards/lb-boards/Projects/RadioDesign/FilterDesign/BUTTER07/DOCS/BUTTER07.asc

C1: cap; 160pf
C2: cap; 620pf
C3: cap; 620pf
C4: cap; 160pF
L1: ind; 1.1µH
L2: ind; 1.8µh
L3: ind; 1.1µH
R1: res; 50
R2: res; 50
V1: voltage; ""; AC 1
Named nets: 0
.ac oct 100 1000000 30000000
