land-boards/lb-boards/Projects/RadioDesign/FilterDesign/BUTTER07/DOCS/eliptic-5th order.asc

C1: cap; 481pf
C2: cap; 50pf
C3: cap; 142pf
C4: cap; 744pf
C5: cap; 408pf
L1: ind; 1.4µH
L2: ind; 1.1µh
R1: res; 50
R2: res; 50
V1: voltage; ""; AC 1
Named nets: 0
.ac oct 100 1 30000000
