land-boards/lb-boards/SYNTHS/ER-PROTO-01_SET/ER-PROTO-01_NOISE/Draft1.asc

C1: cap; 10µF
C2: cap; 1OUF
D1: zener; PTZ6_2B
R1: res; 10K
R2: res; 1K
R3: res; 100K
R4: res; 22K
R5: res; 10K
R6: res; 110K
U1: UniversalOpamp
U2: UniversalOpamp
V1: voltage; 12
V2: voltage; SINE(0 1 1000)
.tran .01
