land-boards/lb-boards/HamRadio/RF-Amp/Mic_Amp/Draft1.asc

C1: cap; 47n
R1: res; 2.2K
R2: res; 2.2K
R3: res; 2.2K
V1: voltage; PULSE(0 3.3 10US 0 0 10US 20US)
Named nets: 0, VOUT
