land-boards/lb-boards/ODAS Cards/VGAX49/Simulation/DAC_Sim_3bit.asc

C1: cap; 75pF
R1: res; 2200
R3: res; 1000
R4: res; 470
R5: res; 75
V1: voltage; PULSE(0 3.3 .25 1ns 1ns .25 .5 4)
V2: voltage; PULSE(0 3.3 .5 1ns 1ns 0.5 0 4)
V3: voltage; PULSE(0 3.3 .125 1nS 1nS .125 .25 8)
Named nets: 0, VOUT
.tran 1
