land-boards/lb-boards/ODAS Cards/VGAX49/Simulation/Draft1.asc

C1: cap; 12n
C2: cap; 47n
L1: ind; 0.0012
R1: res; 1K
R2: res; 2.2K
R3: res; 2.2K
V1: voltage; SINE(0 3.3 1000); AC 3.3
Named nets: 0
.ac dec 20 20000 50000
