land-boards/lb-boards/HamRadio/RF-Amp/LTSpice/2n3904 2_amp.asc

C1: cap; 100nF
C3: cap; 100nF
C4: cap; 100nF
L1: ind2; 35µH
L2: ind2; 8.75µH
L3: ind2; 38.3µH
L4: ind2; 42.4µH
Q1: npn; 2N3904
R1: res; 15K
R2: res; 3.3K
R3: res; 120
R4: res; 4.7
R5: res; 50
V1: voltage; ""; AC 1; Rser=50
V2: voltage; 12; Rser=10
Named nets: 0
K2 L1 L2 1
.ac dec 100 1.5MEG 30MEG
K1 L3 L4 1
