land-boards/lb-boards/HamRadio/RF-Amp/Mic_Amp/2n3904_Mic_amp.asc

C1: cap; 47µF
C2: cap; 10µF
C3: cap; 10µF
C4: cap; 100nF
Q1: npn; 2N3904
R1: res; 15K
R2: res; 3K
R3: res; 120
R5: res; 50
R6: res; 560
V1: voltage; ""; AC 1; Rser=50
V2: voltage; 12; Rser=10
Named nets: 0
.ac dec 100 300 5K
