land-boards/lb-boards/HamRadio/ADE1-MIXER/LP_Audio/LP_Audio.asc

C1: cap; 1p
C2: cap; 100µ
C3: cap; 0.1µ
L1: ind; 1.5m
R1: res; 50
R2: res; 50
R7: res; 51
V1: voltage; ""; AC 1
Named nets: 0
.ac dec 100 10 1000K
