land-boards/lb-boards/HamRadio/BUTTER07/Spice_Sims/CWAZ_Low_Pass_7MHz.asc

C1: cap; 430p
C2: cap; 660p
C3: cap; 660p
C4: cap; 430p
C5: cap; 100p
L1: ind; 1.41µ
L2: ind; 1.5µ
L3: ind; 1.41µ
R1: res; 50
V1: voltage; SINE(0 1 1MEG 0); AC 1; Rser=50
Named nets: 0
.ac dec 100 7MEG 18MEG
