land-boards/lb-boards/HamRadio/IRF510-Amplifier-v2/ltspice/10W IRF510 Amp - Impedance.asc

C1: cap; 220pF
C2: cap; 680pF
C3: cap; 470pF
C4: cap; 270pF
C5: cap; 150p
C6: cap; 330pF
C7: cap; 150p
C8: cap; 33p
C9: cap; .1µF
C24: cap; 150p
C25: cap; 330pF
C26: cap; 150p
C27: cap; 33p
C29: cap; 470p
C30: cap; 1200p
C31: cap; 1200p
C32: cap; 100nF
C33: cap; .1µF
C34: cap; .1µ
C35: cap; .33µ
D4: zener; ZENER_12V
L1: ind2; .22µH
L2: ind; .27µH
L3: ind; 300nH
L4: ind2; .58µH
L5: ind; 1.02µH
L13: ind2; .68µH
L15: ind2; .58µH
L16: ind; 1.02µH
L17: ind2; 100n
L18: ind; 120n
L19: ind2; 44µH
L21: ind2; .68µH
M3: nmos; IRF510
Q1: npn; 2N3904
R1: res; 50
R2: res; 50
R3: res; 100
R4: res; 4.7k
R5: res; 4.7k
R6: res; 1k
R7: res; 50
R24: res; 50
R25: res; 50
R26: res; 1
R27: res; 33
R28: res; 10
R29: res; 2.7k
R30: res; .1
R31: res; .1
V1: voltage; ""; AC 1; Rser=0.1
V2: voltage; 5; Rser=0
V3: voltage; ""; AC 1; Rser=0.1
V7: voltage; ""; AC 1; Rser=0.1
V11: voltage; 13.8; Rser=0
V12: voltage; 4.2; Rser=0
Named nets: 0, Vsw
20m
Actual
K3 L13 L21 1
.ac dec 400 1000000 45000000
20 in 50 ohm out
20m
.lib ZENER_12V.LIB
