land-boards/lb-boards/HamRadio/ADE1-MIXER/Diplexer/Diplexer_9MHz.asc

C1: cap; 40pf
C3: cap; 1000pF
L1: ind; 8.0µH
L2: ind; 250nh
R1: res; 50
R7: res; 51
R8: res; 51
V1: voltage; 0; AC 1; Rser=50
Named nets: 0
.ac lin 100 1MEG 30MEG
