land-boards/lb-boards/HamRadio/BUTTER07/Spice_Sims/Butter_Low_Pass_7MHz.asc

C1: cap; 470p
C2: cap; 680p
C3: cap; 680p
C4: cap; 470p
C5: cap; 100p
L1: ind; 1.3µ
L2: ind; 1.2µ
L3: ind; 1.3µ
R1: res; 50
V1: voltage; ""; AC 1; Rser=50
Named nets: 0
.ac dec 100 100K 30MEG
