land-boards/lb-boards/HamRadio/BUTTER07/Spice_Sims/Draft1.asc

C1: cap; 2.4n
C2: cap; 2.4n
L1: ind; 6.8µ
L2: ind; 3.9µ
L3: ind; 6.8µ
R1: res; 50
V1: voltage; ""; AC 1; Rser=50
Named nets: 0
.ac dec 100 10k 100MEG
