land-boards/lb-boards/HamRadio/RF_Finals/LTSpice/10W IRF510 Amp - Impedance.asc

C1: cap; 220pF
C2: cap; 680pF
C3: cap; 470pF
C4: cap; 100n
C5: cap; 150p
C6: cap; 330pF
C7: cap; 150p
C8: cap; 33p
C9: cap; .1µF
C10: cap; 100n
C11: cap; 150p
C12: cap; 330pF
C13: cap; 150p
C14: cap; 33p
C15: cap; 100n
C16: cap; 100n
C17: cap; 150p
C18: cap; 100nF
C19: cap; .1µF
C20: cap; .1µ
C21: cap; .1µ
C22: cap; 100n
C23: cap; .1µF
C24: cap; 150p
C25: cap; 330pF
C26: cap; 150p
C27: cap; 33p
C28: cap; 100n
C29: cap; 470p
C30: cap; 1200p
C31: cap; 1200p
C32: cap; 100nF
C33: cap; .1µF
C34: cap; .1µ
C35: cap; .33µ
C36: cap; 100n
C37: cap; 330pF
C38: cap; 150p
C39: cap; 33pF
C40: cap; 100n
C41: cap; 270pF
C42: cap; 430pF
C43: cap; 270pF
C44: cap; 100n
C45: cap; 100n
D1: zener; ZENER_12V
D4: zener; PH_BZX384-B12
L1: ind2; .22µH
L2: ind2; .27µH
L3: ind2; 89.6µH
L4: ind2; .58µH
L5: ind; 1.02µH
L6: ind2; 250µH
L7: ind2; .58µH
L8: ind; 1.02µH
L9: ind2; 44µH
L10: ind2; .58µH
L11: ind2; 44µH
L12: ind2; 25µH
L13: ind2; 22.4µH
L14: ind2; 89.6µH
L15: ind2; .58µH
L16: ind; 1.02µH
L17: ind2; 100n
L18: ind; 120n
L19: ind2; 44µH
L20: ind2; 22.4µH
L22: ind; 1.02µH
L23: ind2; .75µH
L24: ind; .75µH
M1: nmos; IRF510
M3: nmos; IRF510
Q1: npn; 2N3904
Q2: npn; 2SC5706
Q3: npn; 2N3904
Q4: npn; 2N3904
Q5: npn; 2SC5706
R1: res; 50
R2: res; 24k
R3: res; 100
R4: res; 4.7k
R5: res; 4.7k
R6: res; 1k
R7: res; 50
R8: res; 24k
R9: res; 6.8k
R10: res; 18
R11: res; 50
R12: res; 22k
R13: res; 1
R14: res; 33
R15: res; 10
R16: res; 2.7k
R17: res; .1
R18: res; .1
R19: res; 22k; tol=4.7k
R20: res; 4.7k
R21: res; 4.7k
R22: res; 62
R23: res; 62
R24: res; 50
R25: res; 50
R26: res; 1
R27: res; 33
R28: res; 10
R29: res; 2.7k
R30: res; .1
R31: res; .1
R32: res; .1
R33: res; 200
R34: res; 1.6k
R35: res; 8.4k
R36: res; 1k
R37: res; 62
R38: res; 62
R39: res; 18
R40: res; .1
R41: res; .1
R42: res; 50
R43: res; 50
R44: res; 6.8k
R45: res; 18
R46: res; 18
R47: res; .1
R48: res; 16
V1: voltage; ""; AC 1; Rser=0.1
V2: voltage; 5; Rser=0
V3: voltage; ""; AC 1; Rser=0.1
V4: voltage; 13.8; Rser=0
V5: voltage; ""; AC .05; Rser=0.1
V6: voltage; 13.8; Rser=0
V7: voltage; ""; AC 1; Rser=0.1
V8: voltage; 5; Rser=0
V9: voltage; ""; AC 1; Rser=0.1
V10: voltage; 13.8; Rser=0
V11: voltage; 13.8; Rser=0
V12: voltage; 4.2; Rser=0
V13: voltage; ""; AC .05; Rser=0.1
V14: voltage; ""; AC 1; Rser=0.1
V15: voltage; 13.8; Rser=0
V16: voltage; ""; AC 1; Rser=0.1
Named nets: 0
20m
Actual
.ac dec 400 12000000 16000000
20 in 50 ohm out
20m
.lib 2SC5706-SPICE-D.LIB
20m
K12 L14 L20 1
K11 L6 L12 1
.lib ZENER_12V.LIB
20m
20m
K32 L3 L13 1
