land-boards/lb-boards/HamRadio/RF_Finals/LTSpice/10W IRF510 Amp - preamp v2.asc

C1: cap; 100n
C2: cap; .1µF
C19: cap; 100n
C20: cap; 100n
C24: cap; 150p
C25: cap; 330pF
C26: cap; 150p
C27: cap; 33p
C29: cap; 470p
C30: cap; 1200p
C31: cap; 1200p
C32: cap; 100nF
C33: cap; .1µF
C34: cap; .1µ
C35: cap; .1µ
D4: zener; PH_BZX384-B12
L13: ind2; 89.6µH
L15: ind2; .58µH
L16: ind; 1.02µH
L17: ind2; 100n
L18: ind; 120n
L19: ind2; 44µH
L21: ind2; 22.4µH
M1: pmos; IRF7207
M2: nmos; BS170
M3: nmos; IRF510
Q1: npn; 2SC5706
Q2: npn; 2N2222
R1: res; 4.7k
R2: res; 4.7k
R3: res; 1.5k
R4: res; 10k
R5: res; 10k
R6: res; 10k
R7: res; 1k
R8: res; 1.6k
R9: res; 8.4k
R10: res; 1k
R16: res; 100
R17: res; 2k
R18: res; 4.7k
R19: res; 20k
R20: res; 10
R24: res; 50
R25: res; 50
R26: res; 1
R27: res; 33
R28: res; 10
R29: res; 2.7k
R30: res; .1
R31: res; .1
V1: voltage; 5; Rser=0
V2: voltage; 12; Rser=0
V3: voltage; PULSE(0 3,3 0 10n 10n 1 2); Rser=0
V7: voltage; 13.8; Rser=0
V10: voltage; SINE(0 0.4 14000000 0 0 0 0); Rser=1
V11: voltage; 13.8; Rser=0
V12: voltage; 5; Rser=0
Named nets: 0, Vsw
.lib 2SC5706-SPICE-D.LIB
20m
Actual
K3 L13 L21 1
.tran 0 .00009 .000088
.include bs170.txt
