land-boards/lb-boards/HamRadio/RF_Finals/LTSpice/10W IRF510 Amp 7 MHz - Impedance.asc

C1: cap; 330p
C2: cap; 680p
C3: cap; 330p
C4: cap; 68p
C9: cap; .1µF
C24: cap; 330p
C25: cap; 680p
C26: cap; 330p
C27: cap; 68p
C32: cap; 100nF
C33: cap; .1µF
C34: cap; .1µ
C35: cap; .33µ
D4: zener; PH_BZX384-B12
L1: ind2; 1.25µH
L2: ind; 1.77µH
L15: ind2; 1.25µH
L16: ind; 1.77µH
L19: ind2; 44µH
M3: nmos; IRF510
Q1: npn; 2N3904
R1: res; 50
R3: res; 100
R4: res; 4.7k
R5: res; 4.7k
R6: res; 1k
R24: res; 50
R26: res; 1
R27: res; 33
R28: res; 10
R29: res; 2.7k
R30: res; .1
R31: res; .1
V1: voltage; ""; AC 1; Rser=0.1
V2: voltage; 5; Rser=0
V3: voltage; ""; AC 1; Rser=0.1
V7: voltage; ""; AC 1; Rser=0.1
V11: voltage; 13.8; Rser=0
V12: voltage; 4.2; Rser=0
Named nets: 0
20m
.ac dec 400 6000000 8000000
20m
