land-boards/lb-boards/HamRadio/RF_Finals/LTSpice/10W IRF510 Amp.asc

C1: cap; 33p
C2: cap; 150p
C3: cap; 470p
C4: cap; 1200p
C5: cap; 1200p
C6: cap; .1µ
C7: cap; .33µ
C8: cap; 100nF
C9: cap; .1µF
C10: cap; 100nF
C11: cap; 330pF
C12: cap; 150p
C13: cap; .1µ
C14: cap; .33µ
C15: cap; 330p
C16: cap; 680p
C17: cap; 330p
C18: cap; 68p
C28: cap; .1µF
D1: zener; PH_BZX384-B12
D2: zener; PH_BZX384-B12
L1: ind2; 100n
L2: ind2; 44µH
L3: ind; 120n
L4: ind2; 44µH
L5: ind2; 12.6µH
L6: ind2; 5.6µH
L7: ind2; .58µH
L8: ind; 1.02µH
L9: ind2; 12.6µH
L10: ind2; 1.25µ
L11: ind; 1.77µ
L12: ind2; 5.6µH
M1: nmos; IRF510
M2: nmos; IRF510
R1: res; 50
R2: res; .1
R3: res; 0
R4: res; .1
R5: res; 0
R6: res; 50
R7: res; 33
R8: res; 10
R9: res; 2.7k
R10: res; 33
R11: res; 50
R12: res; 10
R13: res; 2.7k
R14: res; .1
R15: res; .1
V1: voltage; 13.8; Rser=0
V2: voltage; SINE(0 10 7000000 0 0 0 0); Rser=1
V3: voltage; 4.25; Rser=0
V4: voltage; 13.8; Rser=0
V5: voltage; SINE(0 10 14000000 0 0 0 0); Rser=1
V6: voltage; 4.25; Rser=0
Named nets: 0
.tran 0 .00009 .000088
K1 L5 L6 1
20m
Actual
40m
K2 L9 L12 1
