land-boards/lb-boards/HamRadio/RF_Finals/LTSpice/Bias Reference.asc

M1: nmos; BS170
M2: nmos; BS170
Q1: npn; 2N3904
Q2: npn; 2N3904
R1: res; 2.2k
R2: res; 33.2
R3: res; 220
R4: res; 22k
R5: res; 1Meg
R6: res; 2.2k
R7: res; 33.2
R8: res; 220
R9: res; 22k
R10: res; 1Meg
V1: voltage; 20; Rser=0
V2: voltage; 9; Rser=0
Named nets: 0
.tran .000000001
.include bs170.txt
