land-boards/lb-boards/HamRadio/RF_Finals/LTSpice/BS170 PMOS Power Switch.asc

C1: cap; 22n
M1: pmos; IRF7207
M2: nmos; BS170
R3: res; 1.5k
R4: res; 10k
R5: res; 10k
R6: res; 10k
R7: res; 1k
V2: voltage; 12; Rser=0
V3: voltage; PULSE(0 3 1 10n 10n 1 2 10); Rser=0
Named nets: 0
.include bs170.txt
.tran 10
