land-boards/lb-boards/HamRadio/RF_Finals/LTSpice/bs170 push pull.asc

C1: cap; .1µF
C2: cap; 10µF
C3: cap; .1µF
C4: cap; .1µF
C5: cap; .1µF
C6: cap; .1µF
C7: cap; .1µF
C8: cap; .1µF
C9: cap; .1µF
C10: cap; 33pF
L1: ind2; 9µH
L2: ind2; 2.25µH
L3: ind2; 2.25µH
L4: ind2; 6.25µH
L5: ind2; 2.25µH
L6: ind2; 2.25µH
L7: ind; 23µH
L8: ind; 1µH
L9: ind; 1µH
L10: ind2; 44µH
L11: ind2; 44µH
L12: ind2; 8.8µH
L13: ind2; 19.8µH
L14: ind; 1µH
L15: ind; 1µH
M1: nmos; BS170
M2: nmos; BS170
M3: nmos; IRF510
M4: nmos; IRF510
R1: res; 220
R2: res; 220
R3: res; 2.2
R4: res; 2.2
R5: res; 220
R6: res; 220
R7: res; 220
R8: res; 220
R9: res; 50
R10: res; .5
R11: res; .5
R12: res; 47
R13: res; 47
V1: voltage; SINE(0 2 7000000); Rser=1
V2: voltage; 14; Rser=0
V3: voltage; 2.7; Rser=0
V4: voltage; 4.9; Rser=0
V5: voltage; 4.9; Rser=0
Named nets: 0
K2 L4 L5 L6 1
.include bs170.txt
K1 L1 L2 L3 1
.tran 0 .000110 .000109
K3 L10 L11 1
K5 L12 L13 1
