land-boards/lb-boards/HamRadio/RF_Finals/LTSpice/Collector Feedback.asc

C1: cap; 100nF
C2: cap; 100nF
C3: cap; .1µF
C4: cap; 10µF
C5: cap; 10µF
C6: cap; .1µF
L1: ind2; 100µH
L2: ind2; 100µH
Q1: npn; 2N3904
Q2: npn; 2N3904
R1: res; 4.7k
R2: res; 1k
R3: res; 40
R4: res; 40
R5: res; 1000
R6: res; 20k
R7: res; 3.6k
R8: res; 220
R9: res; .01
R10: res; 1.2k
V1: voltage; SINE(0 .01 14000000); Rser=0
V2: voltage; 12; Rser=0
V3: voltage; SINE(0 .001 10000); Rser=0
V4: voltage; 12; Rser=0
Named nets: 0
K3 L1 L2 1
.tran .000001
