land-boards/lb-boards/HamRadio/RF_Finals/LTSpice/Combiner.asc

C1: cap; 82p
C2: cap; 82p
C3: cap; 82p
C4: cap; 82p
C5: cap; 82p
C6: cap; 82p
C7: cap; 82p
C8: cap; 82p
C9: cap; 220pF
C10: cap; 220pF
L1: ind2; 1.76µH
L2: ind2; 176µH
L3: ind2; 44µH
L4: ind2; 44µH
L5: ind2; 1.76µH
L6: ind2; 176µH
L7: ind2; 176µH
L8: ind2; 176µH
L9: ind2; 1.76µH
L10: ind2; 1.76µH
L11: ind2; .44µH
L12: ind2; .44µH
L13: ind2; 1.76µH
L14: ind2; .44µH
L15: ind2; .44µH
L16: ind2; 1.76µH
L17: ind2; 2.4µH
L18: ind2; .6µH
L19: ind2; .6µH
L20: ind2; 2.4µH
L21: ind2; 176µH
L23: ind2; 176µH
R1: res; 50
R2: res; 50
R3: res; 50
R4: res; 50
R5: res; 50
R6: res; 50
R7: res; 50
R8: res; 50
R9: res; 50
R10: res; 50
R11: res; 50
R12: res; 50
R13: res; 50
R14: res; 50
R15: res; 50
R16: res; 50
R17: res; 50
V1: voltage; SINE(0 1 14000000 0 0 180); AC 1 180; Rser=.1
V2: voltage; SINE(0 1 14000000 0 0 0); AC 1; Rser=.1
V3: voltage; SINE(0 1 14000000 0 0 180); AC 1 180; Rser=.1
V4: voltage; SINE(0 1 14000000 0 0 0); AC 1; Rser=.1
V5: voltage; SINE(0 1 14000000 0 0 0); AC 1; Rser=.1
V6: voltage; SINE(0 1 14000000 0 0 180); AC 1; Rser=.1
V7: voltage; ""; AC 1; Rser=.1
V8: voltage; ""; AC 1 180; Rser=.1
V9: voltage; ""; AC 1; Rser=.1
V10: voltage; ""; AC 1 180; Rser=.1
V11: voltage; SINE(0 1 14000000 0 0 0); AC 1; Rser=.1
Named nets: 0
K3 L10 L11 L12 1
K4 L2 L3 L4 1
K5 L6 L7 L8 1
K13 L13 L14 L15 1
.tran 0 .0000022 .0000018
;ac dec 400 1Meg 30Meg
K19 L17 L18 L19 1
K17 L23 L21 1
