land-boards/lb-boards/HamRadio/RF_Finals/LTSpice/Doubler.asc

C1: cap; 47pF
C2: cap; 10nF
C3: cap; 10nF
C4: cap; 10nF
C5: cap; 10nF
C6: cap; 10nF
C9: cap; 47pF
D1: diode; 1N4148
D2: diode; 1N4148
D3: diode; 1N4148
D4: diode; 1N4148
D5: diode; 1N4148
D6: diode; 1N4148
D9: diode; 1N4148
L1: ind2; 20µH
L2: ind2; 20µH
R1: res; 470k
R2: res; 470k
R12: res; 100k
V1: voltage; SINE(0 20 12000000); Rser=50
V2: voltage; SINE(0 50 12000000); Rser=0
V7: voltage; SINE(0 50 12000000); Rser=0
Named nets: 0
.tran 0 .00001 0
K3 L1 L2 1
Voltage Tripler
Voltage Doubler
