land-boards/lb-boards/HamRadio/RF_Finals/LTSpice/Harmonic Trap Impedance.asc

C1: cap; 150p
C2: cap; 330pF
C3: cap; 150p
C4: cap; 33p
C5: cap; 100nF
C6: cap; 220p
C7: cap; 560p
C8: cap; 220p
C9: cap; 100nF
C10: cap; 47p
C11: cap; 100nF
C12: cap; 100nF
C13: cap; 330p
C14: cap; 330p
C15: cap; 680p
C16: cap; 330p
C17: cap; 68p
C18: cap; 680p
C19: cap; 330p
C20: cap; 68p
L1: ind2; .58µH
L2: ind; 1.02µH
L3: ind2; .71µH
L4: ind; 1.25µH
L5: ind2; 1.02µH
L6: ind2; 1.25µH
L7: ind; 1.77µH
L8: ind; 1.44µH
R1: res; 50
R2: res; 50
R3: res; 50
R35: res; 50
V1: voltage; ""; AC 1 0
V2: voltage; ""; AC 1 0
V3: voltage; ""; AC 1 0
V5: voltage; ""; AC 1 0
Named nets: 0
.lib 2SC5706-SPICE-D.LIB
;tran 0 .00019 .000188
.include bs170.txt
.lib ZENER_12V.LIB
40m
.ac dec 401 6Meg 8Meg
20m
30m
40m
