land-boards/lb-boards/HamRadio/RF_Finals/LTSpice/jfet switch.asc

C1: cap; 100nF
J1: njf; J113
J2: njf; J113
J3: njf; J113
R1: res; 20k
R2: res; 100
R6: res; 20k
R8: res; 1Meg
R9: res; 4.7Meg
V1: voltage; SINE(5 1 1000); Rser=0
V2: voltage; -1
V3: voltage; SINE(5 1 1000); Rser=0
V4: voltage; 10; Rser=0
V5: voltage; PULSE(0 -1.8 0 .001 0 0 .001)
Named nets: 0
.tran .01
