land-boards/lb-boards/HamRadio/RF_Finals/LTSpice/paraset40 (1).asc

C1: cap; 47p
C2: cap; 100nF
C3: cap; .1µF
C4: cap; .1µF
C5: cap; .1µF
D1: diode; 1N4148
J1: njf
J2: njf
L1: ind2; 1µH
M1: nmos; BS170
M2: nmos; BS170
M3: nmos; BS170
M4: nmos; BS170
Q1: npn; 2N3904
R1: res; 330k
R2: res; 2.2k
R3: res; 470
R4: res; 50
R5: res; 4.7k
R6: res; 50
R7: res; 50
R8: res; 1Meg
R9: res; 4.7Meg
V1: voltage; SINE(0 4 7000000); Rser=0
V2: voltage; 12; Rser=0
V3: voltage; SINE(2 2 1000); Rser=0
Named nets: 0
.tran .001
.include bs170.txt
