land-boards/lb-boards/HamRadio/RF_Finals/LTSpice/Phaser Filter.asc

C1: cap; .1µF
C2: cap; 150p
C3: cap; 390p
C4: cap; 220p
C5: cap; .1µF
C6: cap; 220p
C7: cap; 390p
C8: cap; 220p
C9: cap; 33p
C10: cap; 220p
C11: cap; 560p
C12: cap; 330p
C13: cap; .1µF
C14: cap; 33p
L1: ind; .51µH
L2: ind; .59µH
L3: ind; .71µH
L4: ind; .78µH
L9: ind; .68µH
L10: ind; .68µH
R1: res; 50
R2: res; 50
R3: res; 32
R4: res; 50
R5: res; 40
R12: res; 50
V1: voltage; SINE(0 1 14000000); Rser=0
V2: voltage; SINE(0 1 10000000); Rser=0
V3: voltage; SINE(0 1 14000000); Rser=0
Named nets: 0
.tran .000001
20 meter Filter from Phaser
30 meter Filter from Phaser
