land-boards/lb-boards/HamRadio/RF_Finals/LTSpice/Phaser PA Impedance.asc

C1: cap; 100nF
C2: cap; 180pF
C3: cap; 100nF
C4: cap; 180pF
C5: cap; 100nF
C6: cap; 150p
C7: cap; 390p
C8: cap; 220p
C9: cap; 33p
C10: cap; 100nF
C11: cap; 330pF
C12: cap; 180pF
C13: cap; 220pF
C14: cap; 270pF
C15: cap; 120pF
C16: cap; 470pF
C17: cap; 1200pF
C18: cap; 1200pF
C19: cap; 220pF
C20: cap; 470pF
C21: cap; 330pF
C22: cap; 270pF
C23: cap; 680pF
C24: cap; 560pF
C25: cap; 180pF
C26: cap; 320pF
C27: cap; 180pF
C28: cap; .1µF
C29: cap; 220pF
C30: cap; 470pF
C31: cap; 330pF
C32: cap; 220pF
C33: cap; 680pF
C34: cap; 470pF
C35: cap; 283.9p
C36: cap; 697.1p
C37: cap; 760.6p
C38: cap; 220p
C39: cap; 766p
C40: cap; 587p
C41: cap; 680pF
C42: cap; 470p
C43: cap; 220pF
C44: cap; 470pF
C45: cap; 330pF
C46: cap; 150p
C47: cap; 330pF
C48: cap; 150p
C49: cap; 33p
C50: cap; 470p
C51: cap; 1200p
C52: cap; 1200p
C53: cap; 100n
C54: cap; 330p
C55: cap; 680p
C56: cap; 680p
C57: cap; 68p
D1: diode
L1: ind2; .68µH
L2: ind2; 11µH
L3: ind2; .51µH
L4: ind; .59µH
L5: ind2; 68µH
L6: ind2; 68µH
L7: ind2; .51µH
L8: ind; .51µH
L9: ind2; .68µH
L10: ind; .56µH
L11: ind2; .1µH
L12: ind; .12µH
L13: ind2; .33µH
L14: ind; .39µH
L15: ind2; .22µH
L16: ind; .27µH
L17: ind2; .54µH
L18: ind; .54µH
L19: ind2; .36µH
L20: ind; .36µH
L21: ind2; .22µH
L22: ind; .27µH
L23: ind2; 223.2n
L24: ind; 281.3n
L25: ind2; 291.7n
L26: ind; 282n
L27: ind2; .22µH
L28: ind; .27µH
L29: ind2; .33µH
L30: ind; .39µH
L31: ind2; .58µH
L32: ind; 1.02µH
L33: ind2; 100n
L34: ind; 120n
L35: ind2; 1.25µ
L36: ind; 1.77µ
Q1: npn; 2SC5706
Q2: npn; 2N3904
Q3: npn; 2SC5706
R1: res; 1k
R2: res; 1k
R3: res; 100
R4: res; 10k
R5: res; 10
R6: res; 100
R7: res; 1k
R8: res; 1k
R9: res; .5
R10: res; 50
R11: res; 50
R12: res; 50
R13: res; 50
R14: res; 50
R15: res; 50
R16: res; 50
R17: res; 50
R18: res; 1k
R19: res; 50
R20: res; 50
R21: res; 50
R22: res; 50
R23: res; 50
R24: res; 50
R25: res; 50
R26: res; 50
R27: res; 50
V1: voltage; 12; Rser=0
V2: voltage; SINE(2.5 .4 14000000 0 0 0); Rser=50
V3: voltage; 5; Rser=0
V4: voltage; 12; Rser=0
V5: voltage; SINE(2.5 .5 14000000 0 0 0); Rser=25
V6: voltage; SINE(2.5 .5 14000000 0 0 90); Rser=25
V7: voltage; ""; AC 1
Named nets: 0, Vsw, v7
;tran 0 .00002 .000018
.lib 2SC5706-SPICE-D.LIB
K1 L5 L6 1
Original from Phaser
Actual
70 in 50 out
30 in 50 out
10 in 50 ohm out
20 in 50 ohm out
50 in 50 ohm out
30 in 50 out
20 in 50 ohm out
20 in 50 ohm out
.ac dec 101 1000000 28000000
20 in 50 ohm out
30 in 50 out
Actual
Actual
40m
