land-boards/lb-boards/(list of files, drawings)

Other design files:
Arduino Cards/Screwduino/ExpressPCB-OBE/screwduino.pcb
BeagleBoneBlack Cards/BBB Overall/beaglebone-black-master/ALLEGRO/BEAGLEBONEBLK_C3.DSN
Projects/RadioDesign/RadioICs/SI4735-master/extras/schematic/ANTTENA.fzz
Projects/RadioDesign/RadioICs/SI4735-master/extras/schematic/attiny85_schematic.fzz
Projects/RadioDesign/RadioICs/SI4735-master/extras/schematic/basic_schematic.fzz
Projects/RadioDesign/RadioICs/SI4735-master/extras/schematic/basic_schematic_with_buttons_internal_pullup_i2c.fzz
Projects/RadioDesign/RadioICs/SI4735-master/extras/schematic/mute_circuit.fzz
