land-boards/lb-boards/RetroCPUs/LB-RETRO-SET/LB-6809-01/LB-6809-01.kicad_pcb

## KiCad design RetroCPUs/LB-RETRO-SET/LB-6809-01/LB-6809-01.kicad_pcb (2024-12-02)

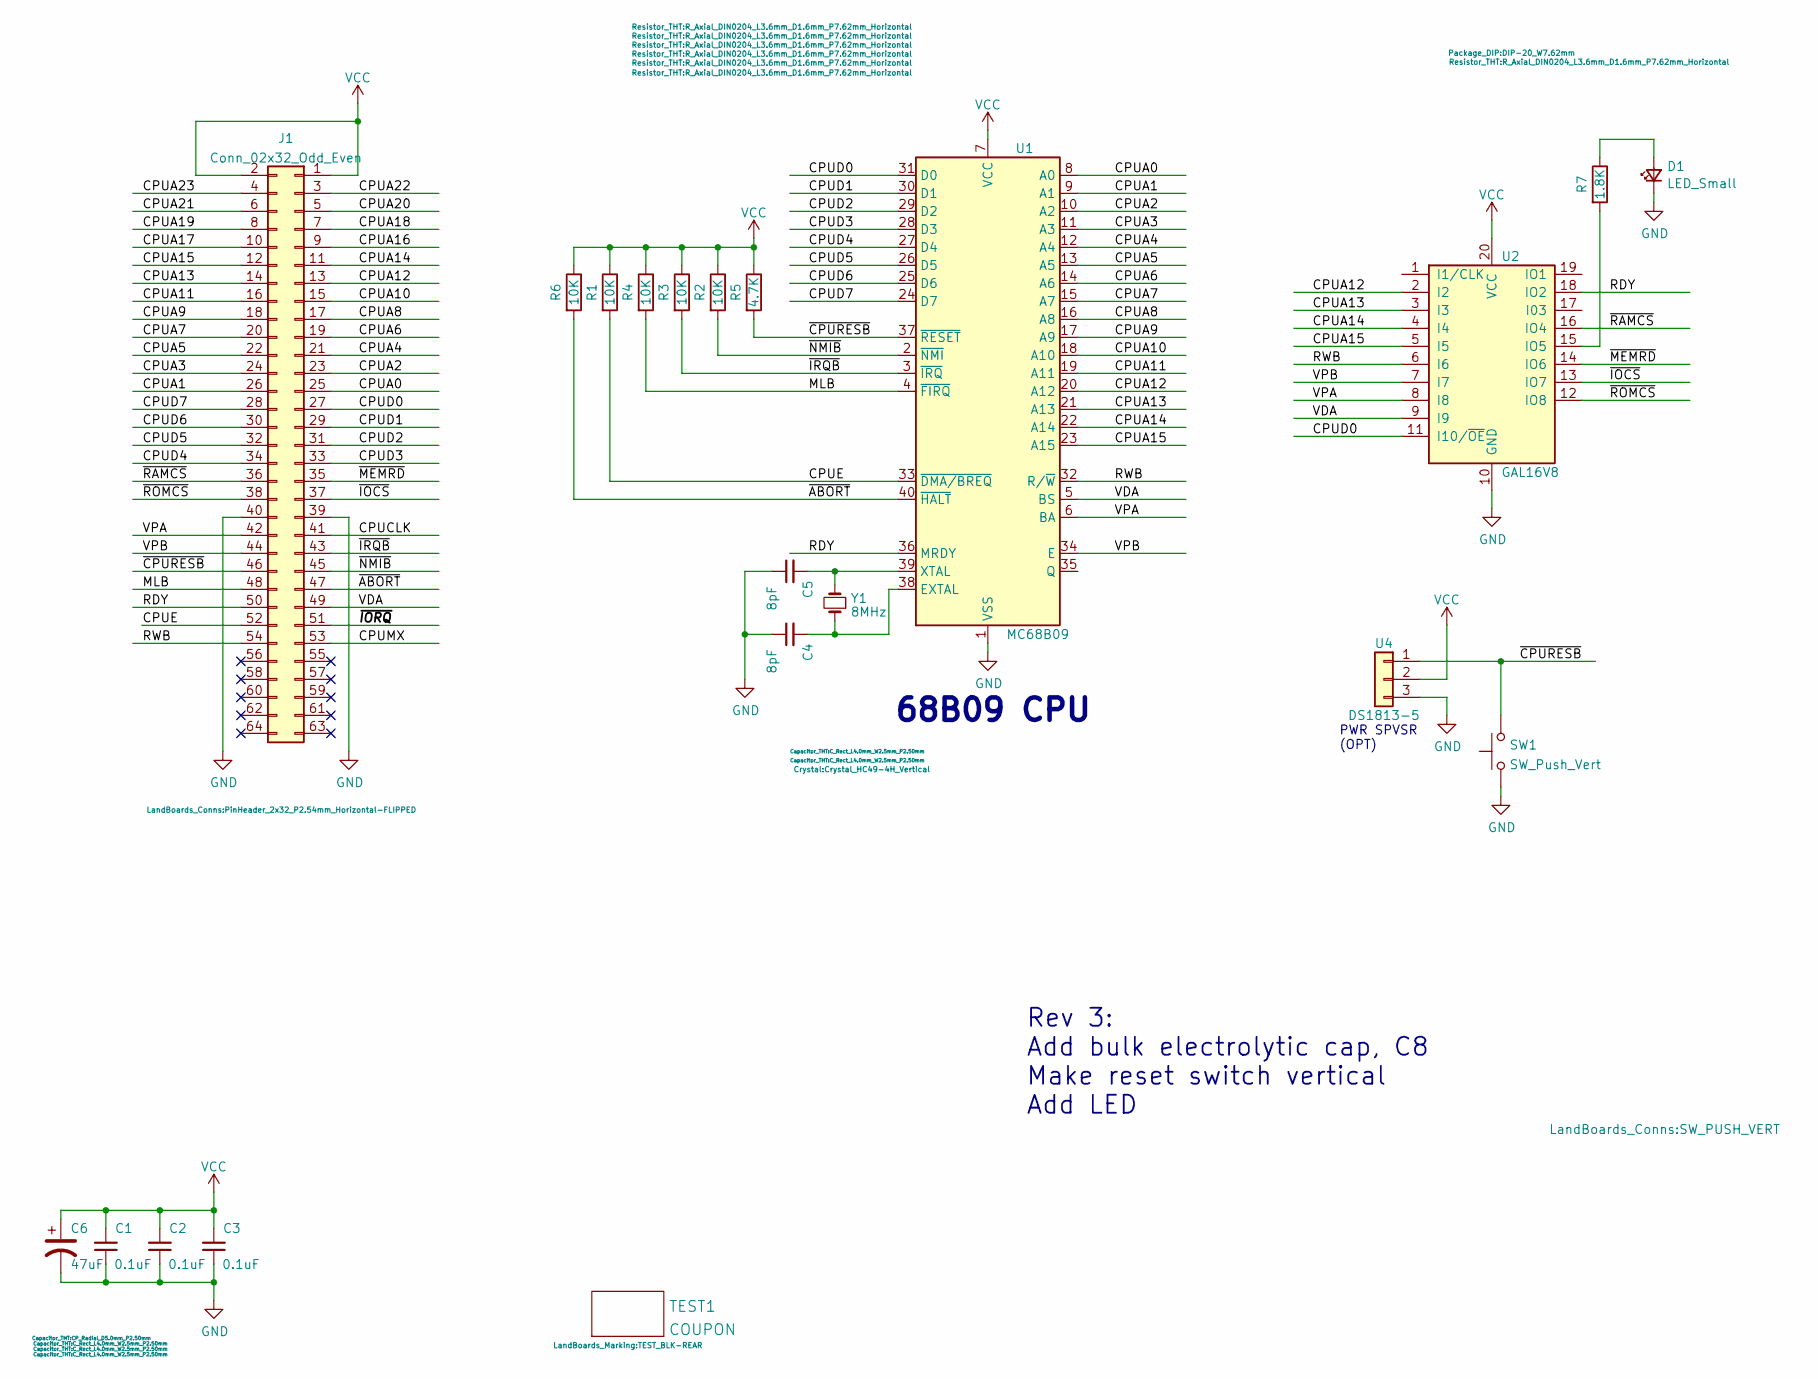
[picture p557: schematic LB-6809-01.kicad_sch]

Parts:
C1, C2, C3: 0.1uF; C_Rect_L4.0mm_W2.5mm_P2.50mm
C4, C5: 8pF; C_Rect_L4.0mm_W2.5mm_P2.50mm
C6: 47uF; CP_Radial_D5.0mm_P2.50mm
D1: LED_Small; LED_D5.0mm_Horizontal_O3.81mm_Z9.0mm
J1: Conn_02x32_Odd_Even; PinHeader_2x32_P2.54mm_Horizontal-FLIPPED
R1, R2, R3, R4, R6: 10K; R_Axial_DIN0204_L3.6mm_D1.6mm_P7.62mm_Horizontal
R5: 4.7K; R_Axial_DIN0204_L3.6mm_D1.6mm_P7.62mm_Horizontal
R7: 1.8K; R_Axial_DIN0204_L3.6mm_D1.6mm_P7.62mm_Horizontal
SW1: SW_Push_Vert; SW_PUSH_VERT
TEST1: COUPON; TEST_BLK-REAR
U1: MC68B09; DIP-40_W15.24mm
U2: GAL16V8; DIP-20_W7.62mm
U4: DS1813-5; TO-92
Y1: 8MHz; Crystal_HC49-4H_Vertical

Connections:
/CPUA0: J1.25, U1.8 (A0)
/CPUA1: J1.26, U1.9 (A1)
/CPUA2: J1.23, U1.10 (A2)
/CPUA3: J1.24, U1.11 (A3)
/CPUA4: J1.21, U1.12 (A4)
/CPUA5: J1.22, U1.13 (A5)
/CPUA6: J1.19, U1.14 (A6)
/CPUA7: J1.20, U1.15 (A7)
/CPUA8: J1.17, U1.16 (A8)
/CPUA9: J1.18, U1.17 (A9)
/CPUA10: J1.15, U1.18 (A10)
/CPUA11: J1.16, U1.19 (A11)
/CPUA12: J1.13, U1.20 (A12), U2.2 (I2)
/CPUA13: J1.14, U1.21 (A13), U2.3 (I3)
/CPUA14: J1.11, U1.22 (A14), U2.4 (I4)
/CPUA15: J1.12, U1.23 (A15), U2.5 (I5)
/CPUA16: J1.9
/CPUA17: J1.10
/CPUA18: J1.7
/CPUA19: J1.8
/CPUA20: J1.5
/CPUA21: J1.6
/CPUA22: J1.3
/CPUA23: J1.4
/CPUCLK: J1.41
/CPUD0: J1.27, U1.31 (D0), U2.11 (I10/~OE)
/CPUD1: J1.29, U1.30 (D1)
/CPUD2: J1.31, U1.29 (D2)
/CPUD3: J1.33, U1.28 (D3)
/CPUD4: J1.34, U1.27 (D4)
/CPUD5: J1.32, U1.26 (D5)
/CPUD6: J1.30, U1.25 (D6)
/CPUD7: J1.28, U1.24 (D7)
/CPUE: J1.52, R1.2, U1.33 (~DMA/BREQ)
/CPUMX: J1.53
/MLB: J1.48, R4.2, U1.4 (~FIRQ)
/RDY: J1.50, U1.36 (MRDY), U2.18 (IO2)
/RWB: J1.54, U1.32 (R/~W), U2.6 (I6)
/VDA: J1.49, U1.5 (BS), U2.9 (I9)
/VPA: J1.42, U1.6 (BA), U2.8 (I8)
/VPB: J1.44, U1.34 (E), U2.7 (I7)
/~ABORT: J1.47, R6.2, U1.40 (~HALT)
/~CPURESB: J1.46, R5.2, SW1.2, U1.37 (~RESET), U4.1
/~IOCS: J1.37, U2.13 (IO7)
/~IORQ: J1.51
/~IRQB: J1.43, R3.2, U1.3 (~IRQ)
/~MEMRD: J1.35, U2.14 (IO6)
/~NMIB: J1.45, R2.2, U1.2 (~NMI)
/~RAMCS: J1.36, U2.16 (IO4)
/~ROMCS: J1.38, U2.12 (IO8)
GND: C1.1, C2.1, C3.1, C4.1, C5.1, C6.2, D1.1 (K), J1.39, J1.40, SW1.1, U1.1 (VSS), U2.10 (GND), U4.3
unnamed: D1.2 (A), R7.1
unnamed: C4.2, U1.38 (EXTAL), Y1.1
unnamed: C5.2, U1.39 (XTAL), Y1.2
unnamed: R7.2, U2.15 (IO5)
VCC: C1.2, C2.2, C3.2, C6.1, J1.1, J1.2, R1.1, R2.1, R3.1, R4.1, R5.1, R6.1, U1.7 (VCC), U2.20 (VCC), U4.2

Notes on the sheet:
68B09 CPU
PWR SPVSR (OPT)
Rev 3: Add bulk electrolytic cap, C8 Make reset switch vertical Add LED

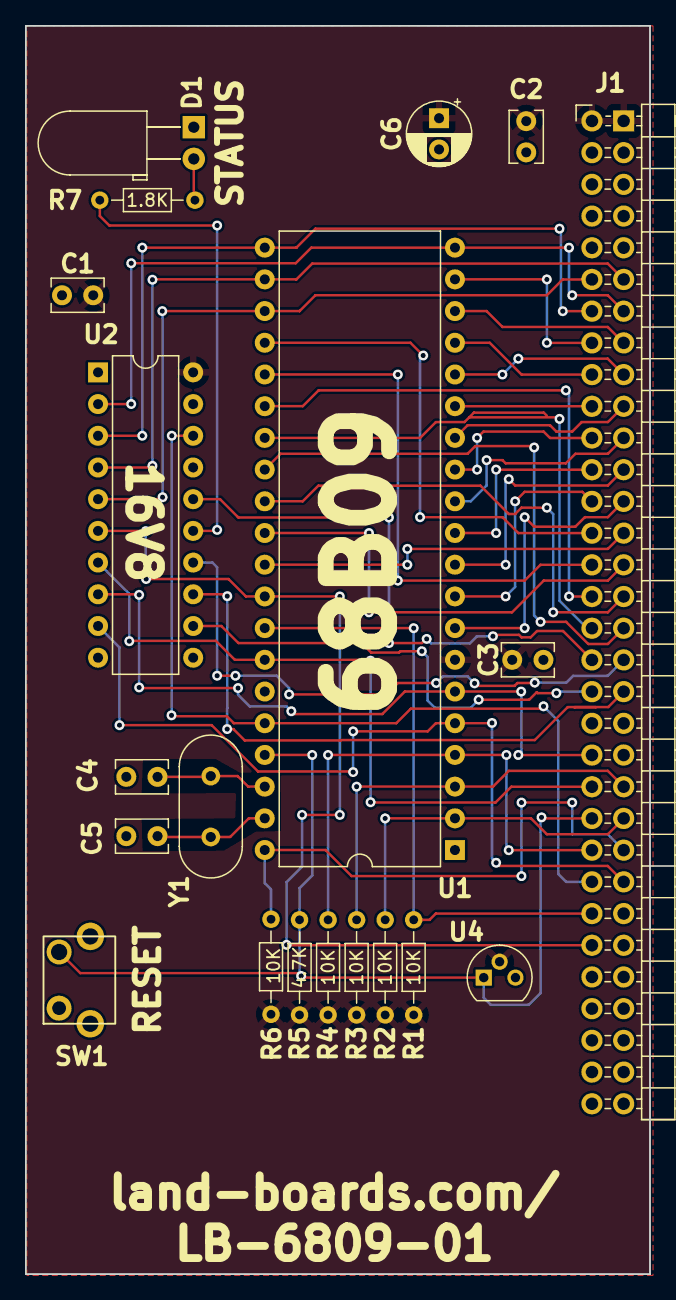
[picture p558: board LB-6809-01.kicad_pcb from above]

Board: 2 copper layers, 50.0 x 100.0 mm, 21 parts (0 on the bottom side), 45 nets.
