land-boards/lb-boards/RetroCPUs/LB-RETRO-SET/LB-MEM-04/LB-MEM-04.kicad_pcb

## KiCad design RetroCPUs/LB-RETRO-SET/LB-MEM-04/LB-MEM-04.kicad_pcb (2024-10-17)

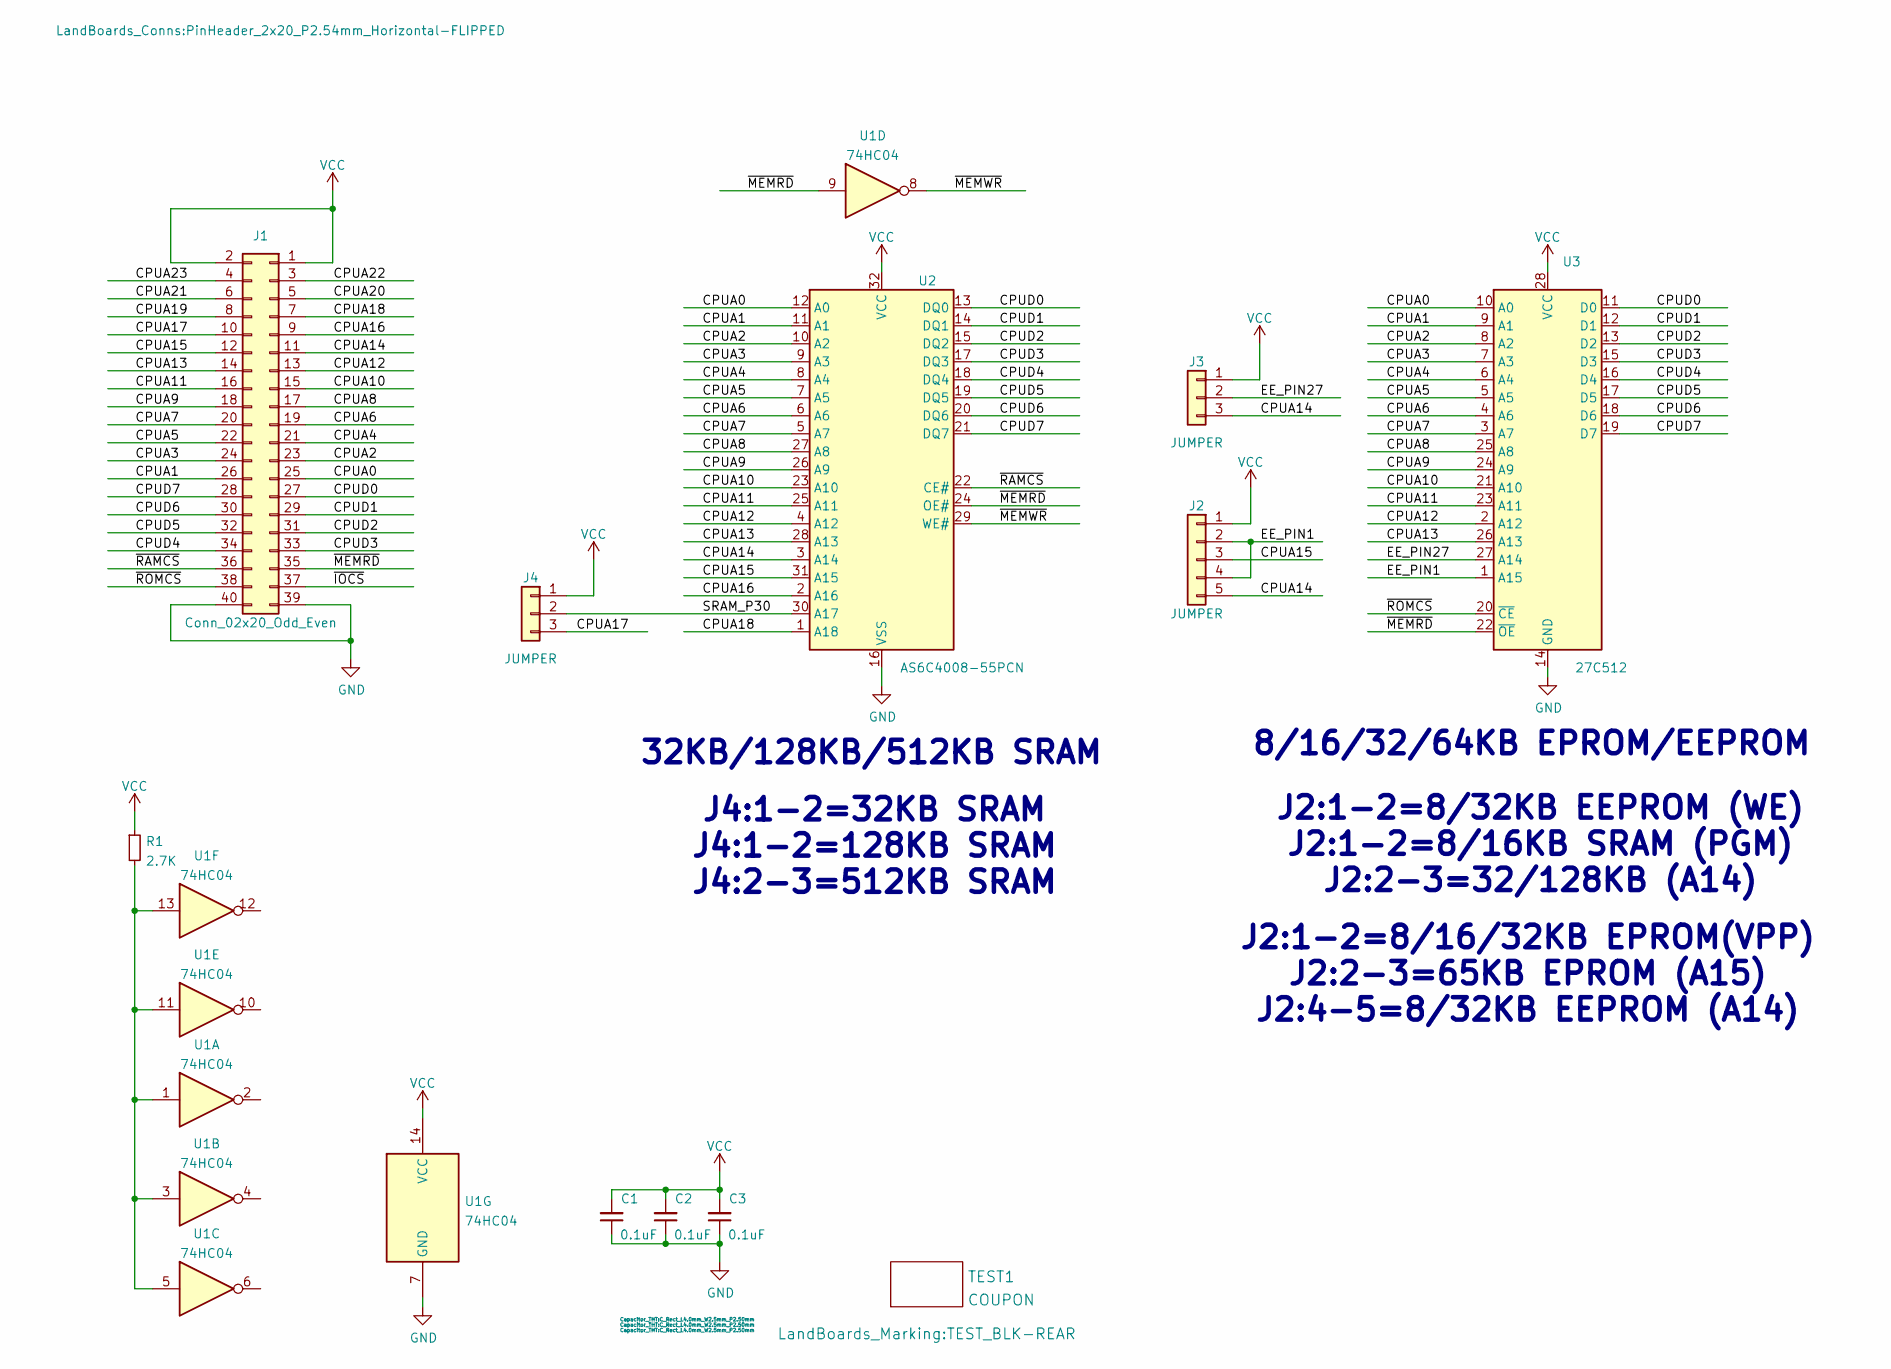
[picture p559: schematic LB-MEM-04.kicad_sch]

Parts:
C1, C2, C3: 0.1uF; C_Rect_L4.0mm_W2.5mm_P2.50mm
J1: Conn_02x20_Odd_Even; PinHeader_2x20_P2.54mm_Horizontal-FLIPPED
J2: JUMPER; PinHeader_1x05_P2.54mm_Vertical
J3, J4: JUMPER; PinHeader_1x03_P2.54mm_Vertical
R1: 2.7K; R_Axial_DIN0204_L3.6mm_D1.6mm_P7.62mm_Horizontal
TEST1: COUPON; TEST_BLK-REAR
U1: 74HC04; DIP-14_W7.62mm_LongPads
U2: AS6C4008-55PCN; DIP-32_W15.24mm
U3: 27C512; DIP-28_W15.24mm

Connections:
/CPUA0: J1.25, U2.12 (A0), U3.10 (A0)
/CPUA1: J1.26, U2.11 (A1), U3.9 (A1)
/CPUA2: J1.23, U2.10 (A2), U3.8 (A2)
/CPUA3: J1.24, U2.9 (A3), U3.7 (A3)
/CPUA4: J1.21, U2.8 (A4), U3.6 (A4)
/CPUA5: J1.22, U2.7 (A5), U3.5 (A5)
/CPUA6: J1.19, U2.6 (A6), U3.4 (A6)
/CPUA7: J1.20, U2.5 (A7), U3.3 (A7)
/CPUA8: J1.17, U2.27 (A8), U3.25 (A8)
/CPUA9: J1.18, U2.26 (A9), U3.24 (A9)
/CPUA10: J1.15, U2.23 (A10), U3.21 (A10)
/CPUA11: J1.16, U2.25 (A11), U3.23 (A11)
/CPUA12: J1.13, U2.4 (A12), U3.2 (A12)
/CPUA13: J1.14, U2.28 (A13), U3.26 (A13)
/CPUA14: J1.11, J2.5, J3.3, U2.3 (A14)
/CPUA15: J1.12, J2.3, U2.31 (A15)
/CPUA16: J1.9, U2.2 (A16)
/CPUA17: J1.10, J4.3
/CPUA18: J1.7, U2.1 (A18)
/CPUA19: J1.8
/CPUA20: J1.5
/CPUA21: J1.6
/CPUA22: J1.3
/CPUA23: J1.4
/CPUD0: J1.27, U2.13 (DQ0), U3.11 (D0)
/CPUD1: J1.29, U2.14 (DQ1), U3.12 (D1)
/CPUD2: J1.31, U2.15 (DQ2), U3.13 (D2)
/CPUD3: J1.33, U2.17 (DQ3), U3.15 (D3)
/CPUD4: J1.34, U2.18 (DQ4), U3.16 (D4)
/CPUD5: J1.32, U2.19 (DQ5), U3.17 (D5)
/CPUD6: J1.30, U2.20 (DQ6), U3.18 (D6)
/CPUD7: J1.28, U2.21 (DQ7), U3.19 (D7)
/EE_PIN1: J2.2, J2.4, U3.1 (A15)
/EE_PIN27: J3.2, U3.27 (A14)
/SRAM_P30: J4.2, U2.30 (A17)
/~IOCS: J1.37
/~MEMRD: J1.35, U1.9, U2.24 (OE#), U3.22 (~OE)
/~MEMWR: U1.8, U2.29 (WE#)
/~RAMCS: J1.36, U2.22 (CE#)
/~ROMCS: J1.38, U3.20 (~CE)
GND: C1.1, C2.1, C3.1, J1.39, J1.40, U1.7 (GND), U2.16 (VSS), U3.14 (GND)
unnamed: R1.2, U1.1, U1.3, U1.5, U1.11, U1.13
VCC: C1.2, C2.2, C3.2, J1.1, J1.2, J2.1, J3.1, J4.1, R1.1, U1.14 (VCC), U2.32 (VCC), U3.28 (VCC)

Notes on the sheet:
32KB/128KB/512KB SRAM
J2:1-2=8/32KB EEPROM (WE) J2:1-2=8/16KB SRAM (PGM) J2:2-3=32/128KB (A14)
J2:1-2=8/16/32KB EPROM(VPP) J2:2-3=65KB EPROM (A15) J2:4-5=8/32KB EEPROM (A14)
8/16/32/64KB EPROM/EEPROM
J4:1-2=32KB SRAM J4:1-2=128KB SRAM J4:2-3=512KB SRAM

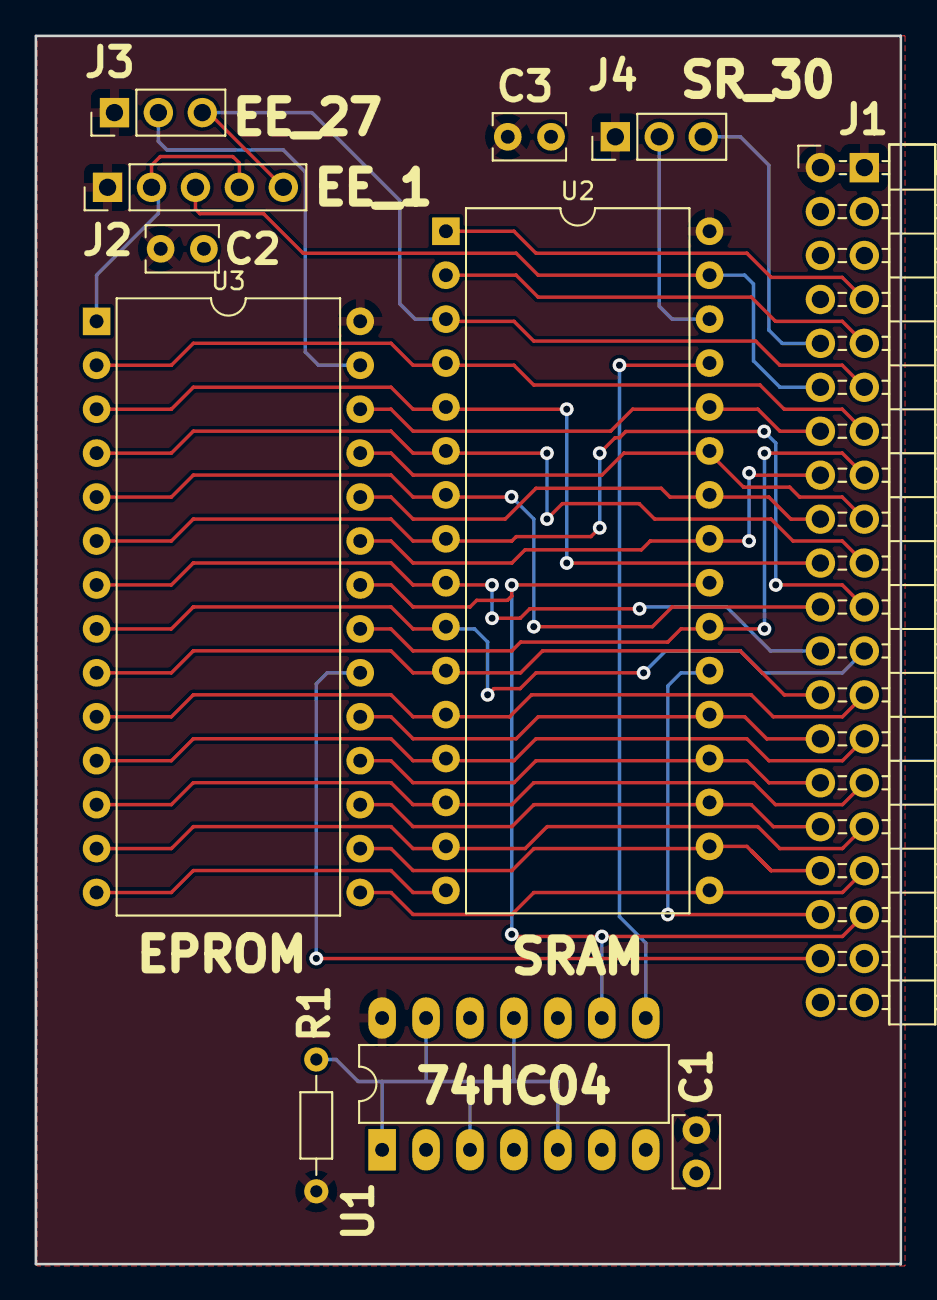
[picture p560: board LB-MEM-04.kicad_pcb from above]

Board: 2 copper layers, 50.0 x 71.0 mm, 12 parts (0 on the bottom side), 37 nets.

Other parts of the board:
TEST: COUPON; TEST_BLK-REAR
