land-boards/lb-boards/RetroCPUs/LB-RETRO-SET/LB-68B50-02/LB-68B50-02.kicad_pcb

## KiCad design RetroCPUs/LB-RETRO-SET/LB-68B50-02/LB-68B50-02.kicad_pcb (2024-10-03)

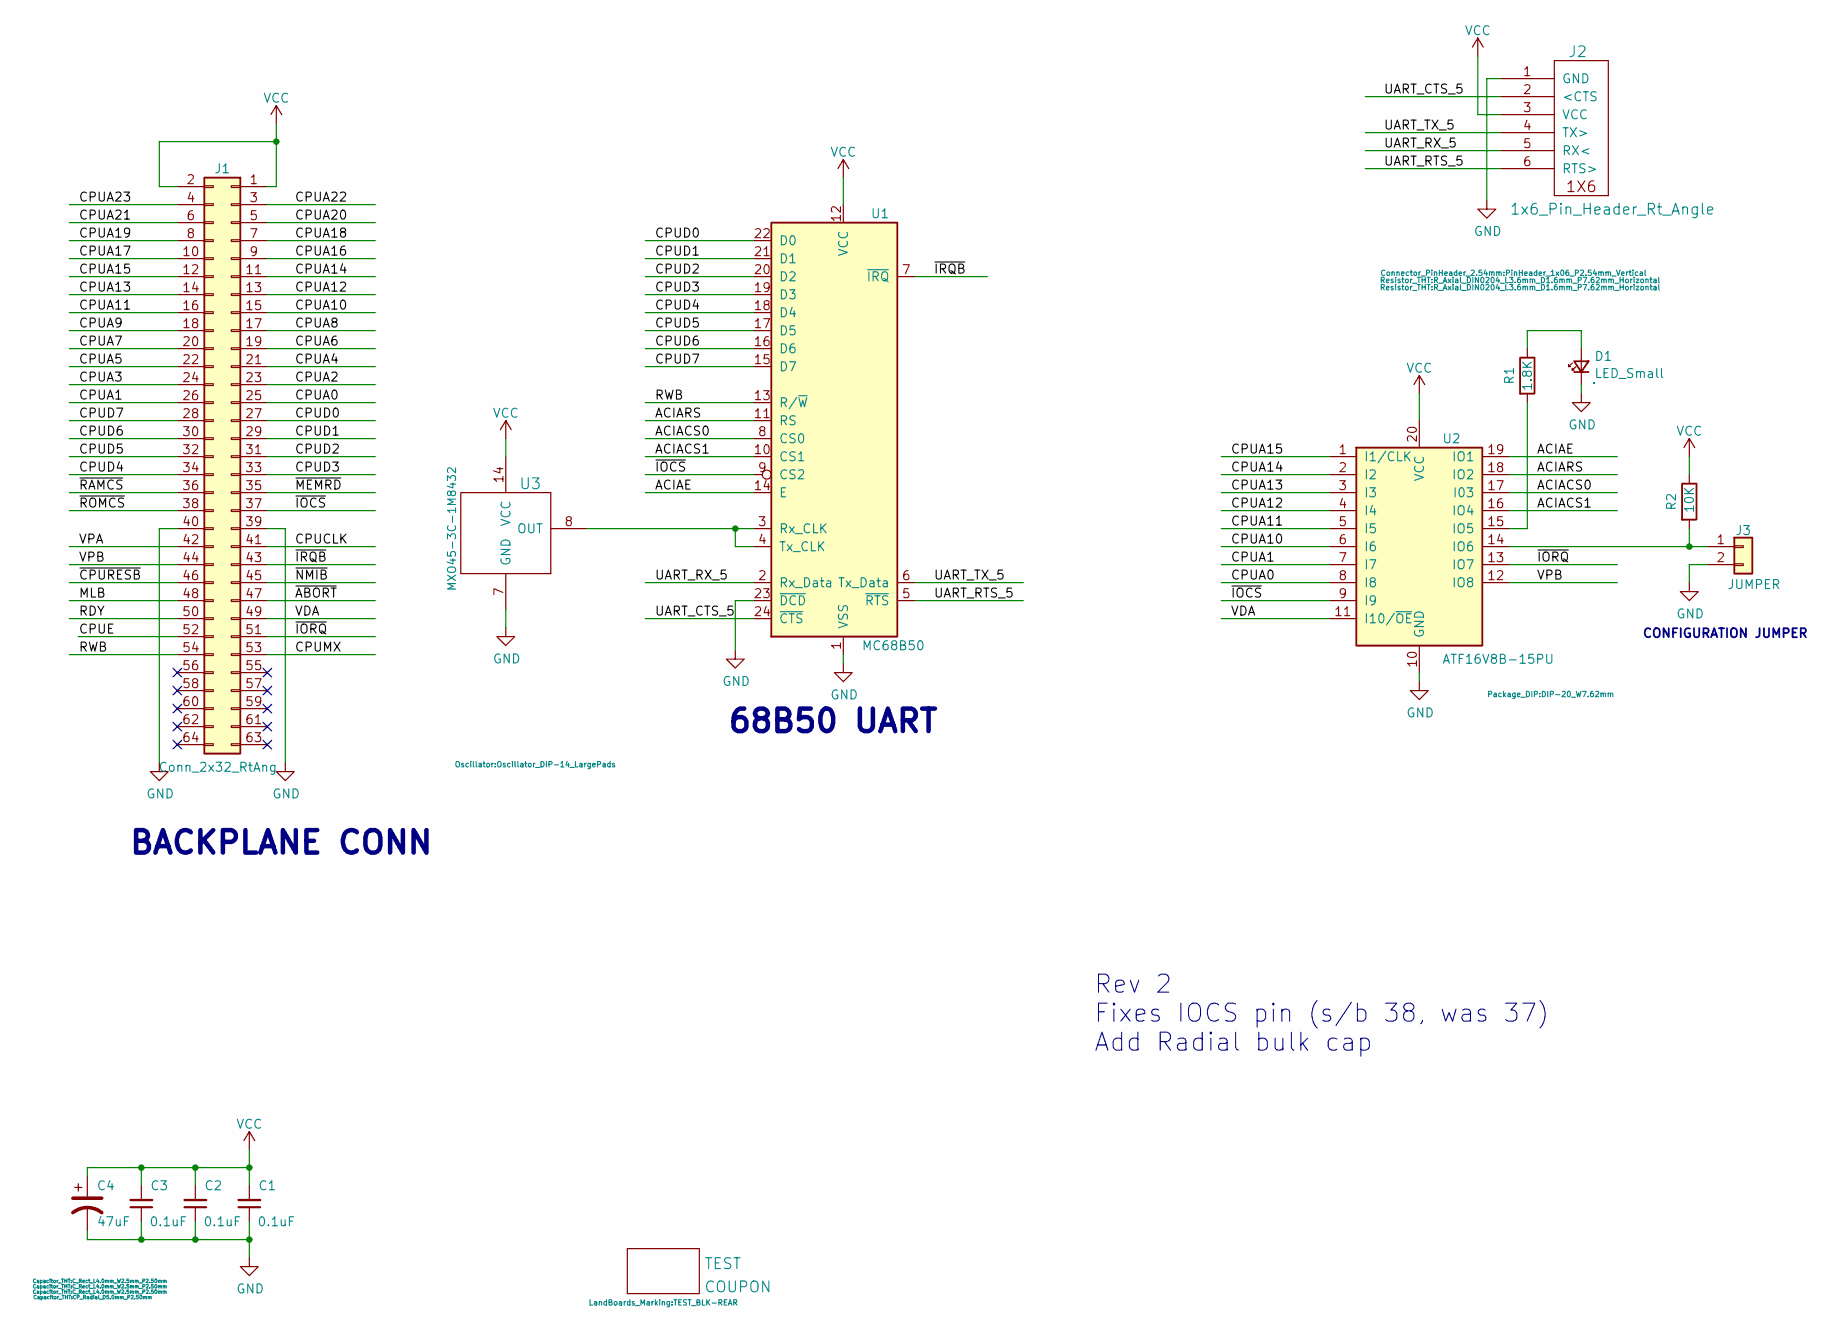
[picture p561: schematic LB-68B50-02.kicad_sch]

Parts:
C1, C2, C3: 0.1uF; C_Rect_L4.0mm_W2.5mm_P2.50mm
C4: 47uF; CP_Radial_D5.0mm_P2.50mm
D1: LED_Small; LED_D5.0mm_Horizontal_O3.81mm_Z9.0mm
J1: Conn_2x32_RtAng; PinHeader_2x32_P2.54mm_Horizontal-FLIPPED
J2: 1x6_Pin_Header_Rt_Angle; PinHeader_1x06_P2.54mm_Vertical
J3: JUMPER; PinHeader_1x02_P2.54mm_Vertical
R1: 1.8K; R_Axial_DIN0204_L3.6mm_D1.6mm_P7.62mm_Horizontal
R2: 10K; R_Axial_DIN0204_L3.6mm_D1.6mm_P7.62mm_Horizontal
TEST: COUPON; TEST_BLK-REAR
U1: MC68B50; DIP-24_W15.24mm_LongPads
U2: ATF16V8B-15PU; DIP-20_W7.62mm
U3: MXO45-3C-1M8432; Oscillator_DIP-14_LargePads

Connections:
/ACIACS0: U1.8 (CS0), U2.17 (I03)
/ACIACS1: U1.10 (CS1), U2.16 (IO4)
/ACIAE: U1.14 (E), U2.19 (IO1)
/ACIARS: U1.11 (RS), U2.18 (IO2)
/CPUA0: J1.25, U2.8 (I8)
/CPUA1: J1.26, U2.7 (I7)
/CPUA2: J1.23
/CPUA3: J1.24
/CPUA4: J1.21
/CPUA5: J1.22
/CPUA6: J1.19
/CPUA7: J1.20
/CPUA8: J1.17
/CPUA9: J1.18
/CPUA10: J1.15, U2.6 (I6)
/CPUA11: J1.16, U2.5 (I5)
/CPUA12: J1.13, U2.4 (I4)
/CPUA13: J1.14, U2.3 (I3)
/CPUA14: J1.11, U2.2 (I2)
/CPUA15: J1.12, U2.1 (I1/CLK)
/CPUA16: J1.9
/CPUA17: J1.10
/CPUA18: J1.7
/CPUA19: J1.8
/CPUA20: J1.5
/CPUA21: J1.6
/CPUA22: J1.3
/CPUA23: J1.4
/CPUCLK: J1.41
/CPUD0: J1.27, U1.22 (D0)
/CPUD1: J1.29, U1.21 (D1)
/CPUD2: J1.31, U1.20 (D2)
/CPUD3: J1.33, U1.19 (D3)
/CPUD4: J1.34, U1.18 (D4)
/CPUD5: J1.32, U1.17 (D5)
/CPUD6: J1.30, U1.16 (D6)
/CPUD7: J1.28, U1.15 (D7)
/CPUE: J1.52
/CPUMX: J1.53
/MLB: J1.48
/RDY: J1.50
/RWB: J1.54, U1.13 (R/~W)
/UART_CTS_5: J2.2 (<CTS), U1.24 (~CTS)
/UART_RTS_5: J2.6 (RTS>), U1.5 (~RTS)
/UART_RX_5: J2.5 (RX<), U1.2 (Rx_Data)
/UART_TX_5: J2.4 (TX>), U1.6 (Tx_Data)
/VDA: J1.49, U2.11 (I10/~OE)
/VPA: J1.42
/VPB: J1.44, U2.12 (IO8)
/~ABORT: J1.47
/~CPURESB: J1.46
/~IOCS: J1.37, U1.9 (CS2), U2.9 (I9)
/~IORQ: J1.51, U2.13 (IO7)
/~IRQB: J1.43, U1.7 (~IRQ)
/~MEMRD: J1.35
/~NMIB: J1.45
/~RAMCS: J1.36
/~ROMCS: J1.38
GND: C1.1, C2.1, C3.1, C4.2, D1.1 (K), J1.39, J1.40, J2.1 (GND), J3.2, U1.1 (VSS), U1.23 (~DCD), U2.10 (GND), U3.7 (GND)
unnamed: D1.2 (A), R1.1
unnamed: J3.1, R2.2, U2.14 (IO6)
unnamed: U1.3 (Rx_CLK), U1.4 (Tx_CLK), U3.8 (OUT)
unnamed: R1.2, U2.15 (IO5)
VCC: C1.2, C2.2, C3.2, C4.1, J1.1, J1.2, J2.3 (VCC), R2.1, U1.12 (VCC), U2.20 (VCC), U3.14 (VCC)

Notes on the sheet:
68B50 UART
CONFIGURATION JUMPER
Rev 2 Fixes IOCS pin (s/b 38, was 37) Add Radial bulk cap
BACKPLANE CONN

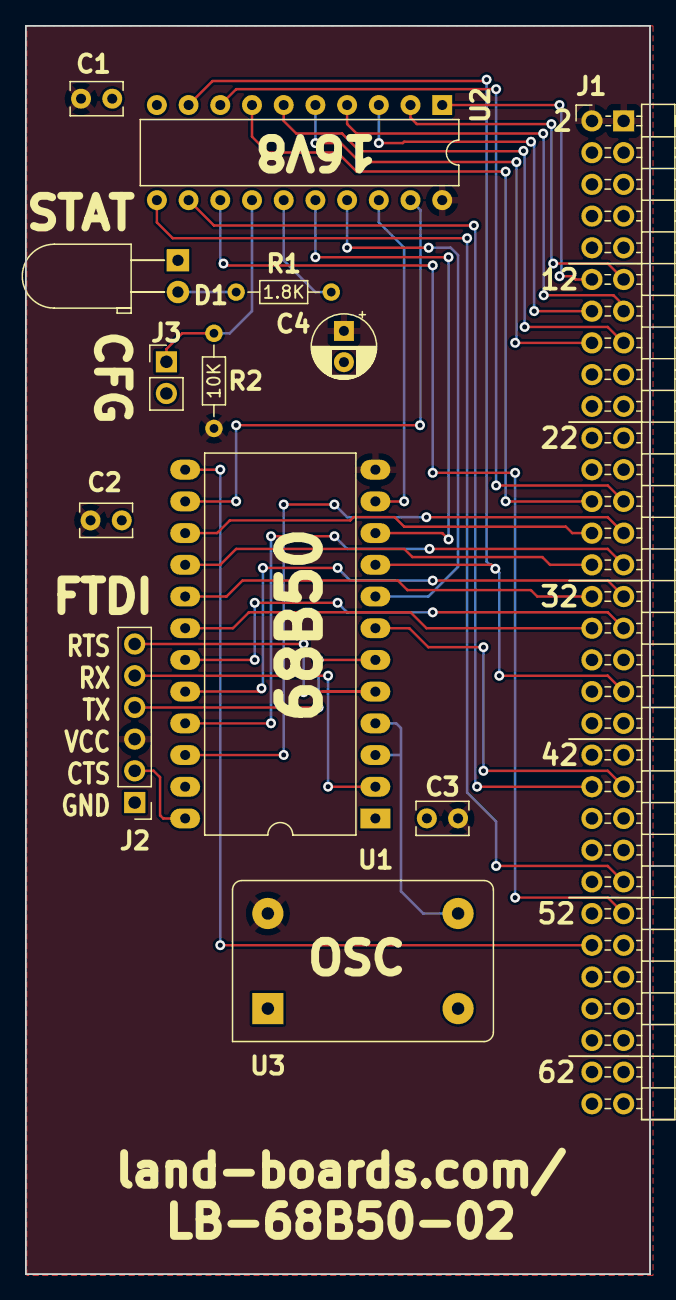
[picture p562: board LB-68B50-02.kicad_pcb from above]

Board: 2 copper layers, 50.0 x 100.0 mm, 14 parts (0 on the bottom side), 36 nets.
