land-boards/lb-boards/RetroCPUs/LB-RETRO-SET/LB-65CXX-01/LB-65CXX-01.kicad_pcb

## KiCad design RetroCPUs/LB-RETRO-SET/LB-65CXX-01/LB-65CXX-01.kicad_pcb (2024-09-23)

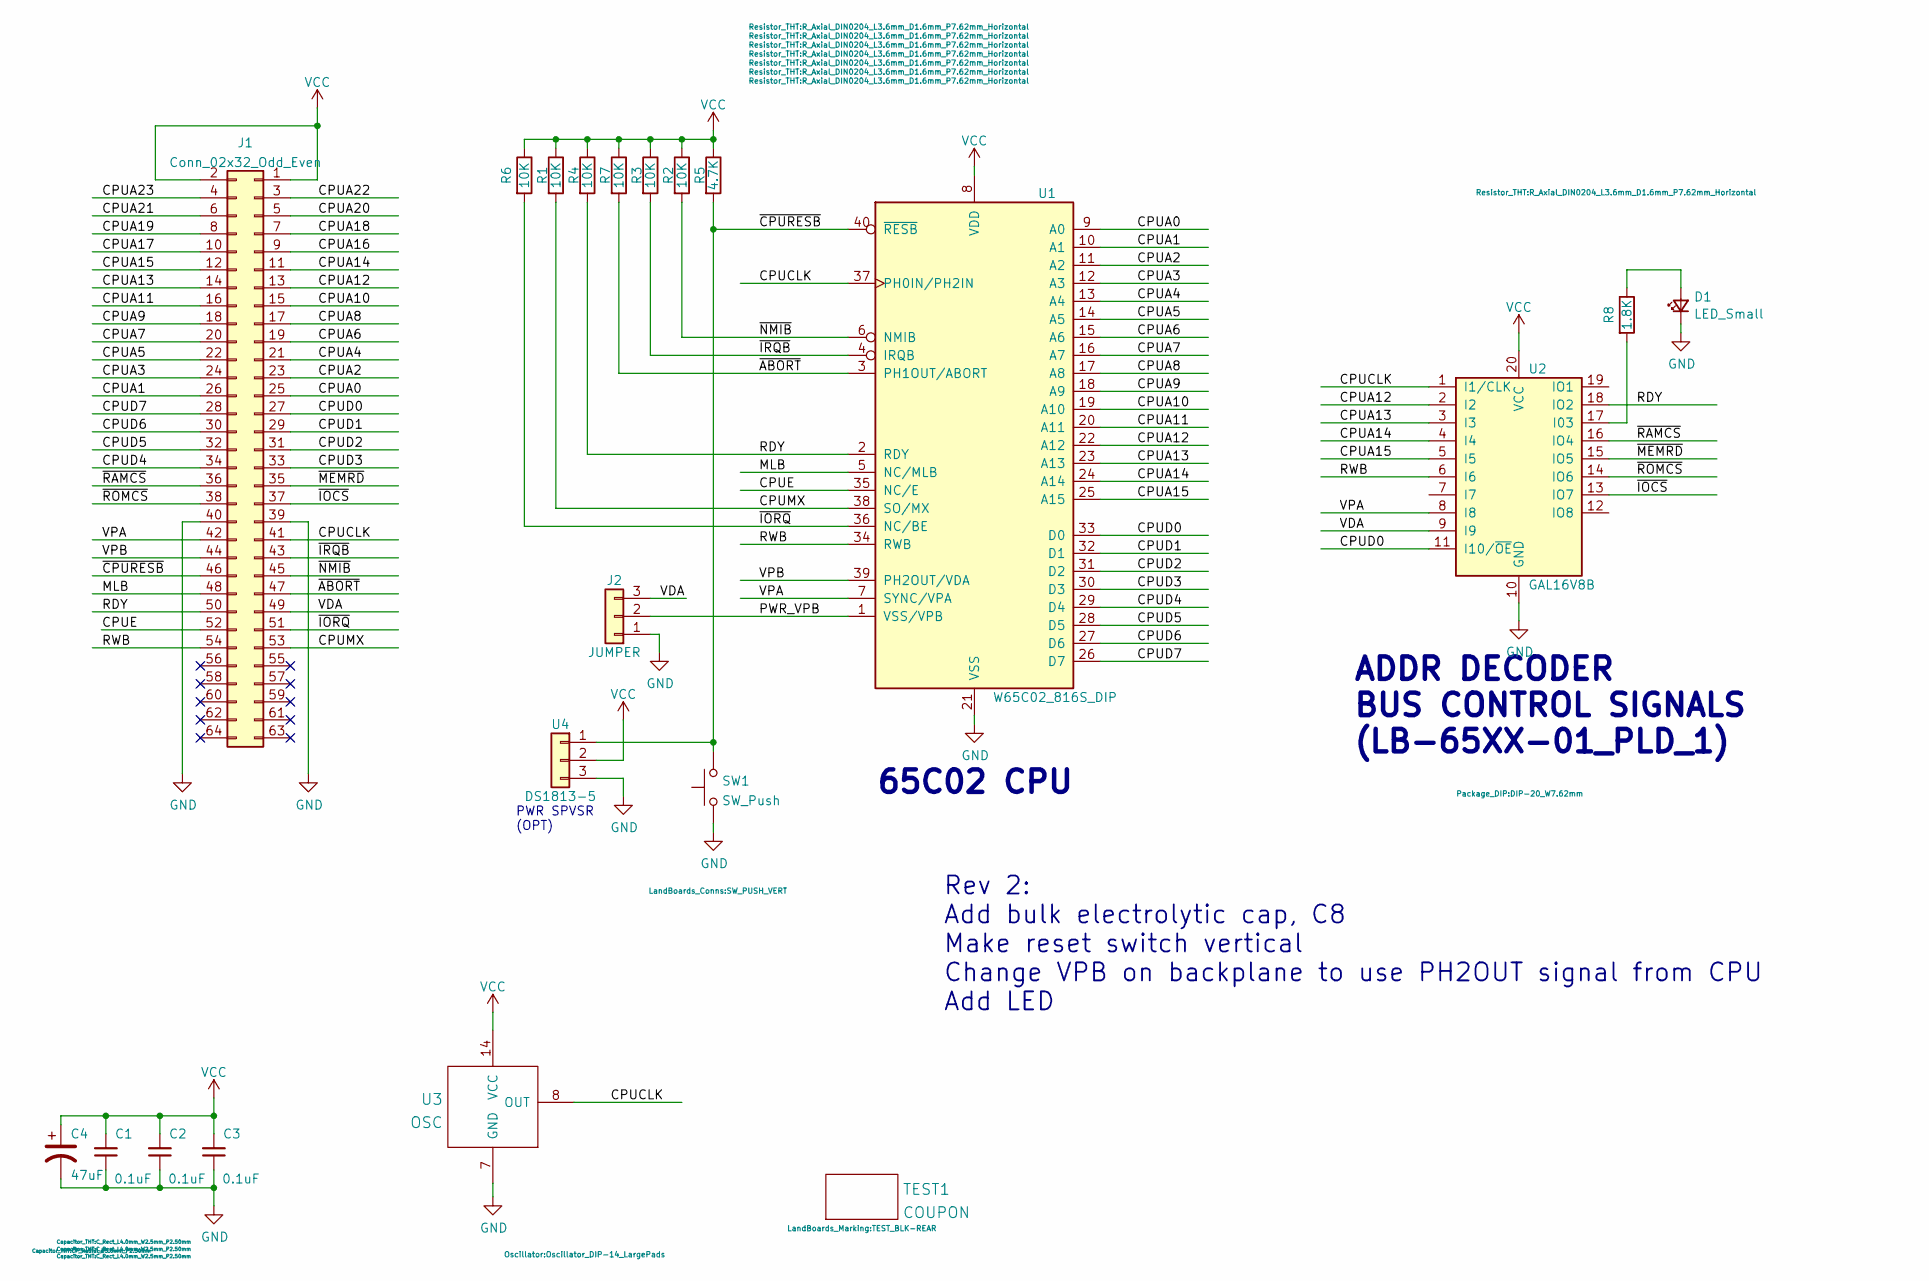
[picture p563: schematic LB-65CXX-01.kicad_sch]

Parts:
C1, C2, C3: 0.1uF; C_Rect_L4.0mm_W2.5mm_P2.50mm
C4: 47uF; CP_Radial_D5.0mm_P2.50mm
D1: LED_Small; LED_D5.0mm_Horizontal_O3.81mm_Z9.0mm
J1: Conn_02x32_Odd_Even; PinHeader_2x32_P2.54mm_Horizontal-FLIPPED
J2: JUMPER; PinHeader_1x03_P2.54mm_Vertical
R1, R2, R3, R4, R6, R7: 10K; R_Axial_DIN0204_L3.6mm_D1.6mm_P7.62mm_Horizontal
R5: 4.7K; R_Axial_DIN0204_L3.6mm_D1.6mm_P7.62mm_Horizontal
R8: 1.8K; R_Axial_DIN0204_L3.6mm_D1.6mm_P7.62mm_Horizontal
SW1: SW_Push; SW_PUSH_VERT
TEST1: COUPON; TEST_BLK-REAR
U1: W65C02_816S_DIP; DIP-40_W15.24mm_LongPads
U2: GAL16V8B; DIP-20_W7.62mm
U3: OSC; Oscillator_DIP-14_LargePads
U4: DS1813-5; TO-92

Connections:
/CPUA0: J1.25, U1.9 (A0)
/CPUA1: J1.26, U1.10 (A1)
/CPUA2: J1.23, U1.11 (A2)
/CPUA3: J1.24, U1.12 (A3)
/CPUA4: J1.21, U1.13 (A4)
/CPUA5: J1.22, U1.14 (A5)
/CPUA6: J1.19, U1.15 (A6)
/CPUA7: J1.20, U1.16 (A7)
/CPUA8: J1.17, U1.17 (A8)
/CPUA9: J1.18, U1.18 (A9)
/CPUA10: J1.15, U1.19 (A10)
/CPUA11: J1.16, U1.20 (A11)
/CPUA12: J1.13, U1.22 (A12), U2.2 (I2)
/CPUA13: J1.14, U1.23 (A13), U2.3 (I3)
/CPUA14: J1.11, U1.24 (A14), U2.4 (I4)
/CPUA15: J1.12, U1.25 (A15), U2.5 (I5)
/CPUA16: J1.9
/CPUA17: J1.10
/CPUA18: J1.7
/CPUA19: J1.8
/CPUA20: J1.5
/CPUA21: J1.6
/CPUA22: J1.3
/CPUA23: J1.4
/CPUCLK: J1.41, U1.37 (PH0IN/PH2IN), U2.1 (I1/CLK), U3.8 (OUT)
/CPUD0: J1.27, U1.33 (D0), U2.11 (I10/~OE)
/CPUD1: J1.29, U1.32 (D1)
/CPUD2: J1.31, U1.31 (D2)
/CPUD3: J1.33, U1.30 (D3)
/CPUD4: J1.34, U1.29 (D4)
/CPUD5: J1.32, U1.28 (D5)
/CPUD6: J1.30, U1.27 (D6)
/CPUD7: J1.28, U1.26 (D7)
/CPUE: J1.52, U1.35 (NC/E)
/CPUMX: J1.53, R1.2, U1.38 (SO/MX)
/MLB: J1.48, U1.5 (NC/MLB)
/PWR_VPB: J2.2, U1.1 (VSS/VPB)
/RDY: J1.50, R4.2, U1.2 (RDY), U2.18 (IO2)
/RWB: J1.54, U1.34 (RWB), U2.6 (I6)
/VDA: J1.49, J2.3, U2.9 (I9)
/VPA: J1.42, U1.7 (SYNC/VPA), U2.8 (I8)
/VPB: J1.44, U1.39 (PH2OUT/VDA)
/~ABORT: J1.47, R7.2, U1.3 (PH1OUT/ABORT)
/~CPURESB: J1.46, R5.2, SW1.2, U1.40 (~RESB), U4.1
/~IOCS: J1.37, U2.13 (IO7)
/~IORQ: J1.51, R6.2, U1.36 (NC/BE)
/~IRQB: J1.43, R3.2, U1.4 (IRQB)
/~MEMRD: J1.35, U2.15 (IO5)
/~NMIB: J1.45, R2.2, U1.6 (NMIB)
/~RAMCS: J1.36, U2.16 (IO4)
/~ROMCS: J1.38, U2.14 (IO6)
GND: C1.1, C2.1, C3.1, C4.2, D1.1 (K), J1.39, J1.40, J2.1, SW1.1, U1.21 (VSS), U2.10 (GND), U3.7 (GND), U4.3
unnamed: D1.2 (A), R8.1
unnamed: R8.2, U2.17 (I03)
VCC: C1.2, C2.2, C3.2, C4.1, J1.1, J1.2, R1.1, R2.1, R3.1, R4.1, R5.1, R6.1, R7.1, U1.8 (VDD), U2.20 (VCC), U3.14 (VCC), U4.2

Notes on the sheet:
65C02 CPU
PWR SPVSR (OPT)
Rev 2: Add bulk electrolytic cap, C8 Make reset switch vertical Change VPB on backplane to use PH2OUT signal from CPU Add LED
ADDR DECODER BUS CONTROL SIGNALS (LB-65XX-01_PLD_1)

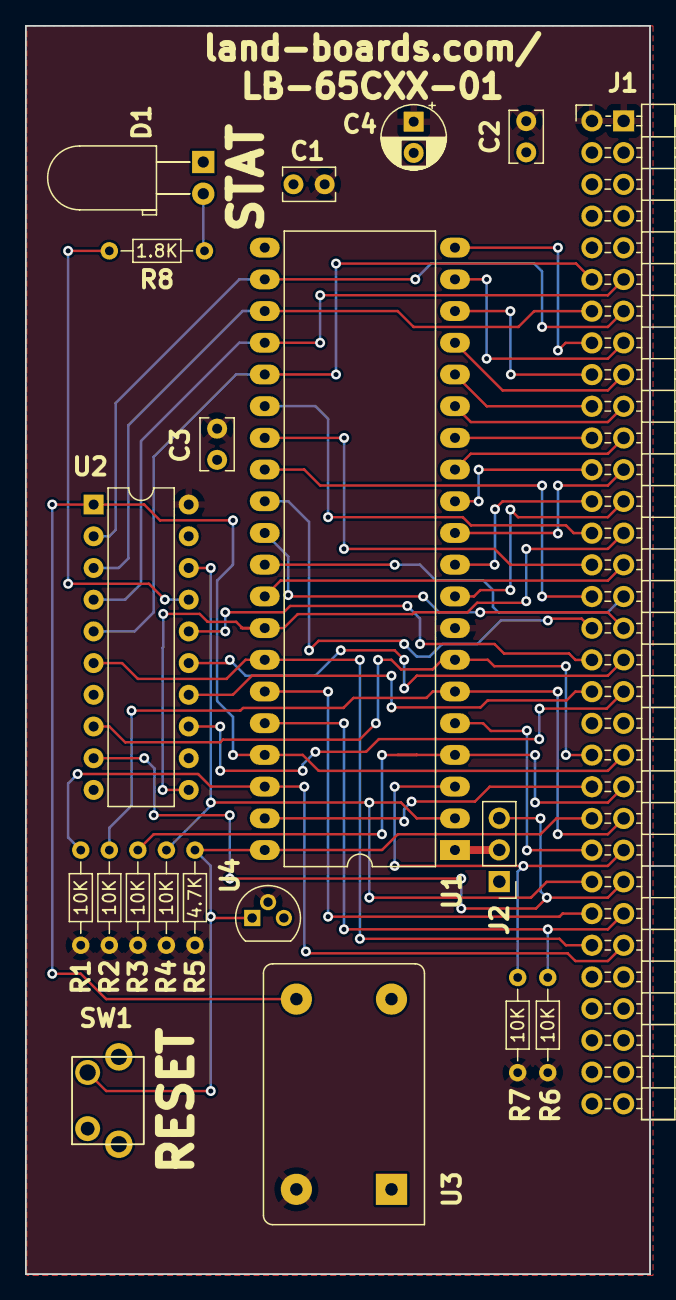
[picture p564: board LB-65CXX-01.kicad_pcb from above]

Board: 2 copper layers, 50.0 x 100.0 mm, 21 parts (0 on the bottom side), 47 nets.

Other parts of the board:
TEST: COUPON; TEST_BLK-REAR
