land-boards/lb-boards/RetroCPUs/SIMPLE-68008/SIMPLE-68008.kicad_pcb

## KiCad design RetroCPUs/SIMPLE-68008/SIMPLE-68008.kicad_pcb (2024-09-23)

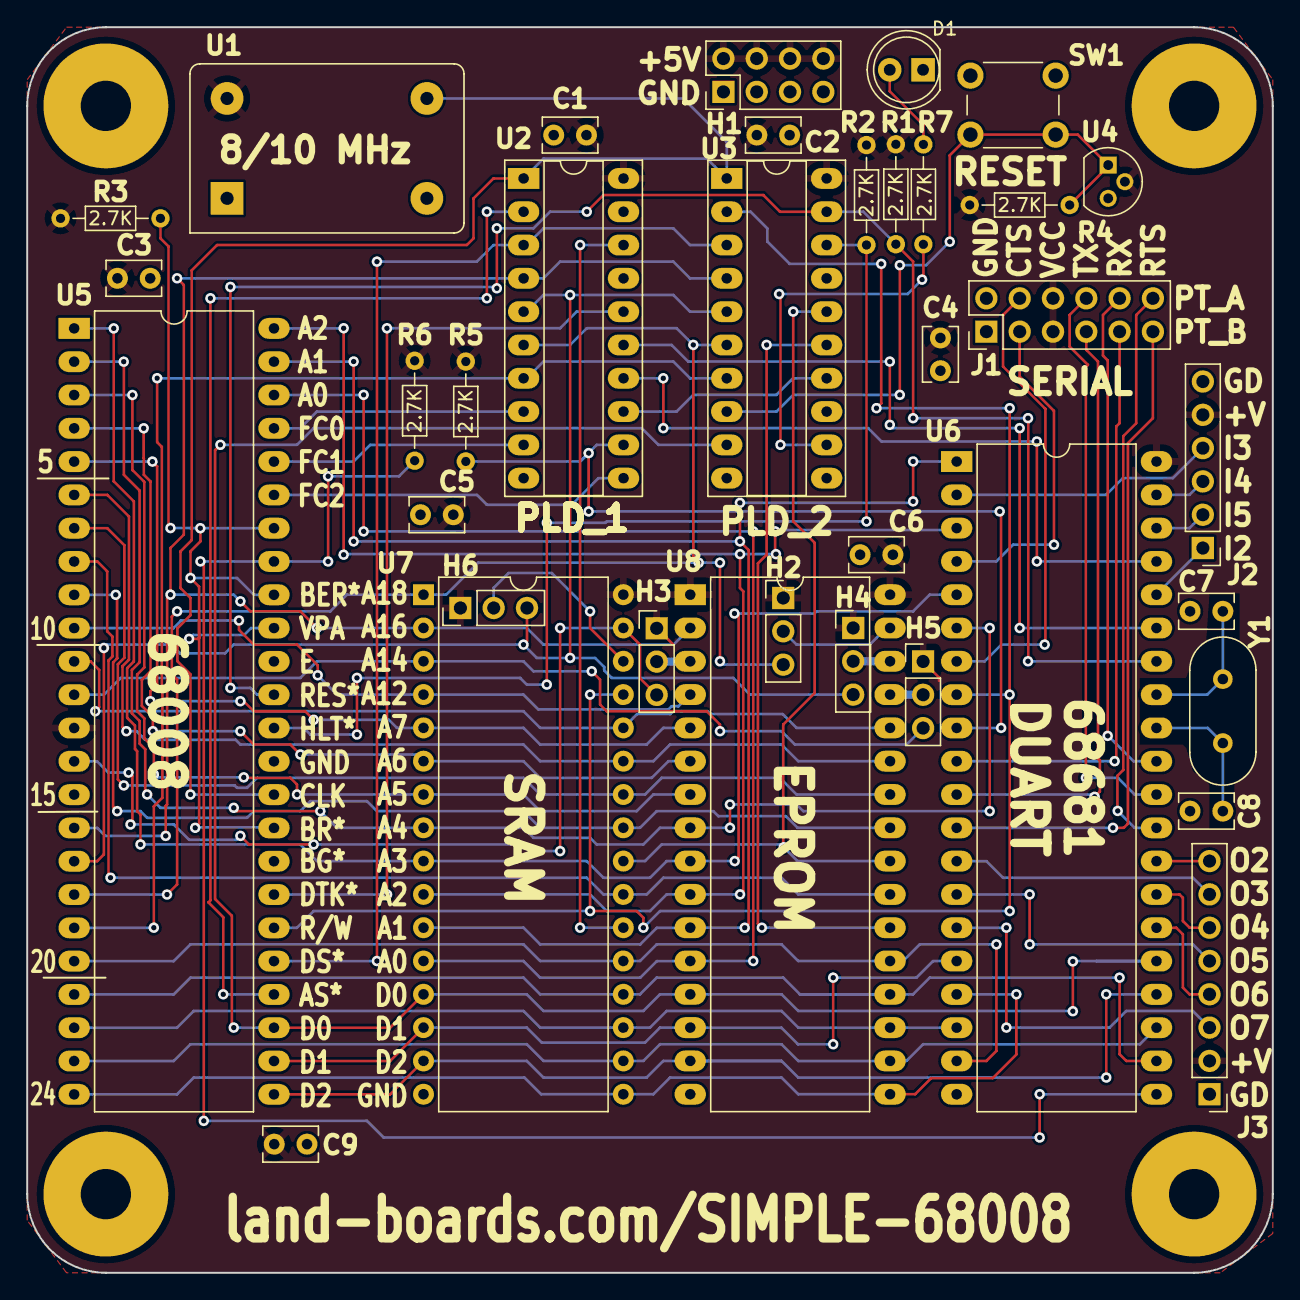
[picture p565: board SIMPLE-68008.kicad_pcb from above]

Board: 2 copper layers, 95.0 x 95.0 mm, 41 parts (0 on the bottom side), 77 nets.

Parts:
C1, C2, C3, C4, C5, C6, C9: 0.1uF; C_Rect_L4.0mm_W2.5mm_P2.50mm
C7: 0-5pf; C_Rect_L4.0mm_W2.5mm_P2.50mm
C8: 10-15pF; C_Rect_L4.0mm_W2.5mm_P2.50mm
D1: LED_Filled; LED_D5.0mm
H1: HEADER, STRT, 2X4; PinHeader_2x04_P2.54mm_Vertical
H2, H3, H4, H5, H6: JUMPER (1X3); PinHeader_1x03_P2.54mm_Vertical
J1: Conn_02x06_Odd_Even; PinHeader_2x06_P2.54mm_Vertical
J2: Conn_01x06; PinHeader_1x06_P2.54mm_Vertical
J3: Conn_01x08; PinHeader_1x08_P2.54mm_Vertical
MTG1, MTG2, MTG3, MTG4: MTG_HOLE; MTG-6-32
R1, R2, R3, R4, R5, R6, R7: 2.7K; R_Axial_DIN0204_L3.6mm_D1.6mm_P7.62mm_Horizontal
SW1: PUSHBUTTON, 6MM; SW_PUSH_6mm_H8.5mm
TEST: COUPON; TEST_BLK-REAR
U1: 10 MHz; Oscillator_DIP-14_LargePads
U2, U3: GAL16V8; DIP-20_W7.62mm_Socket_LongPads
U4: DS1813-5 (OPT); TO-92
U5: MC68008D-10; DIP-48_W15.24mm_LongPads
U6: 68681; DIP-40_W15.24mm_LongPads
U7: AS6C4008-55PCN; DIP-32_W15.24mm
U8: 27C040; DIP-32_W15.24mm_LongPads
Y1: 3.6864 MHz; Crystal_HC49-U_Vertical

Connections:
/CPUA0: U5.46 (A0), U7.12 (A0), U8.12 (A0)
/CPUA1: U5.47 (A1), U6.1 (RS1), U7.11 (A1), U8.11 (A1)
/CPUA2: U5.48 (A2), U6.3 (RS2), U7.10 (A2), U8.10 (A2)
/CPUA3: U5.1 (A3), U6.5 (RS3), U7.9 (A3), U8.9 (A3)
/CPUA4: U5.2 (A4), U6.6 (RS4), U7.8 (A4), U8.8 (A4)
/CPUA5: U5.3 (A5), U7.7 (A5), U8.7 (A5)
/CPUA6: U5.4 (A6), U7.6 (A6), U8.6 (A6)
/CPUA7: U5.5 (A7), U7.5 (A7), U8.5 (A7)
/CPUA8: U5.6 (A8), U7.27 (A8), U8.27 (A8)
/CPUA9: U5.7 (A9), U7.26 (A9), U8.26 (A9)
/CPUA10: U5.8 (A10), U7.23 (A10), U8.23 (A10)
/CPUA11: U5.9 (A11), U7.25 (A11), U8.25 (A11)
/CPUA12: U5.10 (A12), U7.4 (A12), U8.4 (A12)
/CPUA13: U5.11 (A13), U7.28 (A13), U8.28 (A13)
/CPUA14: H5.3, U5.12 (A14), U7.3 (A14)
/CPUA15: H3.3, U5.14 (A15), U7.31 (A15)
/CPUA16: U2.4 (I4), U3.4 (I4), U5.16 (A16), U7.2 (A16), U8.2 (A16)
/CPUA17: H4.3, H6.3, U2.5 (I5), U3.5 (I5), U5.17 (A17)
/CPUA18: H2.3, U2.6 (I6), U3.6 (I6), U5.18 (A18), U7.1 (A18)
/CPUA19: U2.7 (I7), U3.7 (I7), U5.19 (A19)
/CPUAS*: U2.2 (I2), U5.28 (AS)
/CPUCLK: U1.8 (OUT), U2.1 (I1/CLK), U3.1 (I1/CLK), U5.34 (CLK)
/CPUD0: U3.9 (I9), U5.27 (D0), U6.25 (D0), U7.13 (DQ0), U8.13 (D0)
/CPUD1: U5.26 (D1), U6.16 (D1), U7.14 (DQ1), U8.14 (D1)
/CPUD2: U5.25 (D2), U6.24 (D2), U7.15 (DQ2), U8.15 (D2)
/CPUD3: U5.24 (D3), U6.17 (D3), U7.17 (DQ3), U8.17 (D3)
/CPUD4: U5.23 (D4), U6.23 (D4), U7.18 (DQ4), U8.18 (D4)
/CPUD5: U5.22 (D5), U6.18 (D5), U7.19 (DQ5), U8.19 (D5)
/CPUD6: U5.21 (D6), U6.22 (D6), U7.20 (DQ6), U8.20 (D6)
/CPUD7: U5.20 (D7), U6.19 (D7), U7.21 (DQ7), U8.21 (D7)
/CPUDS*: U2.3 (I3), U3.3 (I3), U5.29 (DS)
/CPUHLT*: R2.2, U3.18 (IO2), U5.36 (HALT)
/CPUIACK*: U2.14 (IO6), U6.37 (~IACK)
/CPURES*: R1.2, U3.19 (IO1), U5.37 (RESET), U6.34 (~RESET)
/CPUWR*: U3.2 (I2), U5.30 (R/W), U6.8 (R/~W), U7.29 (WE#)
/CTSA*: J1.4, U6.7 (IP0)
/CTSB*: J1.3, U6.4 (IP1)
/DDTACK*: R5.2, U2.12 (IO8), U6.9 (~DTACK)
/DTACK*: U2.16 (IO4), U5.31 (DTACK)
/DUARTCS*: U2.15 (IO5), U6.35 (~CS)
/EE_PIN3: H3.2, U8.3 (A15)
/EE_PIN29: H5.2, U8.29 (A14)
/EE_PIN30: H4.2, U8.30 (A17)
/EE_PIN31: H2.2, U8.31 (A18)
/FC0: U2.8 (I8), U5.45 (FC0)
/FC1: U2.9 (I9), U5.44 (FC1)
/FC2: U2.11 (I10/~OE), U5.43 (FC2)
/IP2: J2.1, U6.36 (IP2)
/IP3: J2.4, U6.2 (IP3)
/IP4: J2.3, U6.39 (IP4)
/IP5: J2.2, U6.38 (IP5)
/IRQ*: R6.2, U5.41 (IPL1), U6.21 (~IRQ)
/MEMRD*: U3.16 (IO4), U7.24 (OE#), U8.24 (~OE)
/OP2: J3.8, U6.28 (OP2)
/OP3: J3.7, U6.13 (OP3)
/OP4: J3.6, U6.27 (OP4)
/OP5: J3.5, U6.14 (OP5)
/OP6: J3.4, U6.26 (OP6)
/OP7: J3.3, U6.15 (OP7)
/POR*: R4.2, SW1.2, U3.8 (I8), U4.1
/PUP1: R3.2, U5.33 (BR), U5.39 (VPA), U5.40 (BERR), U5.42 (IPL0/2)
/RAMCS*: U2.18 (IO2), U7.22 (CE#)
/ROMCS*: U3.15 (IO5), U8.22 (~CE)
/RTSA*: J1.12, U6.29 (OP0)
/RTSB*: J1.11, U6.12 (OP1)
/RXA: J1.10, U6.31 (RXDA)
/RXB: J1.9, U6.10 (RXDB)
/SR_PIN30: H6.2, U7.30 (A17)
/SWAP: U2.13 (IO7), U3.14 (IO6)
/TXA: J1.8, U6.30 (TXDA)
/TXB: J1.7, U6.11 (TXDB)
GND: C1.1, C2.1, C3.1, C4.1, C5.1, C6.1, C7.2, C8.2, C9.1, D1.1 (K), H1.1, H1.3, H1.5, H1.7, J1.1, J1.2, J2.6, J3.1, SW1.1, U1.7 (GND), U2.10 (GND), U3.10 (GND), U4.3, U5.15 (GND), U5.35 (GND), U6.20 (GND), U7.16 (VSS), U8.16 (GND)
unnamed: D1.2 (A), R7.2
unnamed: R7.1, U3.12 (IO8)
unnamed: C8.1, U6.32 (X1/CLK), Y1.2
unnamed: C7.1, U6.33 (X2), Y1.1
VCC: C1.2, C2.2, C3.2, C4.2, C5.2, C6.2, C9.2, H1.2, H1.4, H1.6, H1.8, H2.1, H3.1, H4.1, H5.1, H6.1, J1.5, J1.6, J2.5, J3.2, R1.1, R2.1, R3.1, R4.1, R5.1, R6.1, U1.14 (VCC), U2.20 (VCC), U3.20 (VCC), U4.2, U5.13 (VCC), U6.40 (VCC), U7.32 (VCC), U8.1 (VPP), U8.32 (VCC)
