land-boards/lb-boards/Test Equipment Cards/FTDI_Monitor/FTDI_Monitor.kicad_pcb

## KiCad design Test Equipment Cards/FTDI_Monitor/FTDI_Monitor.kicad_pcb (2024-09-20)

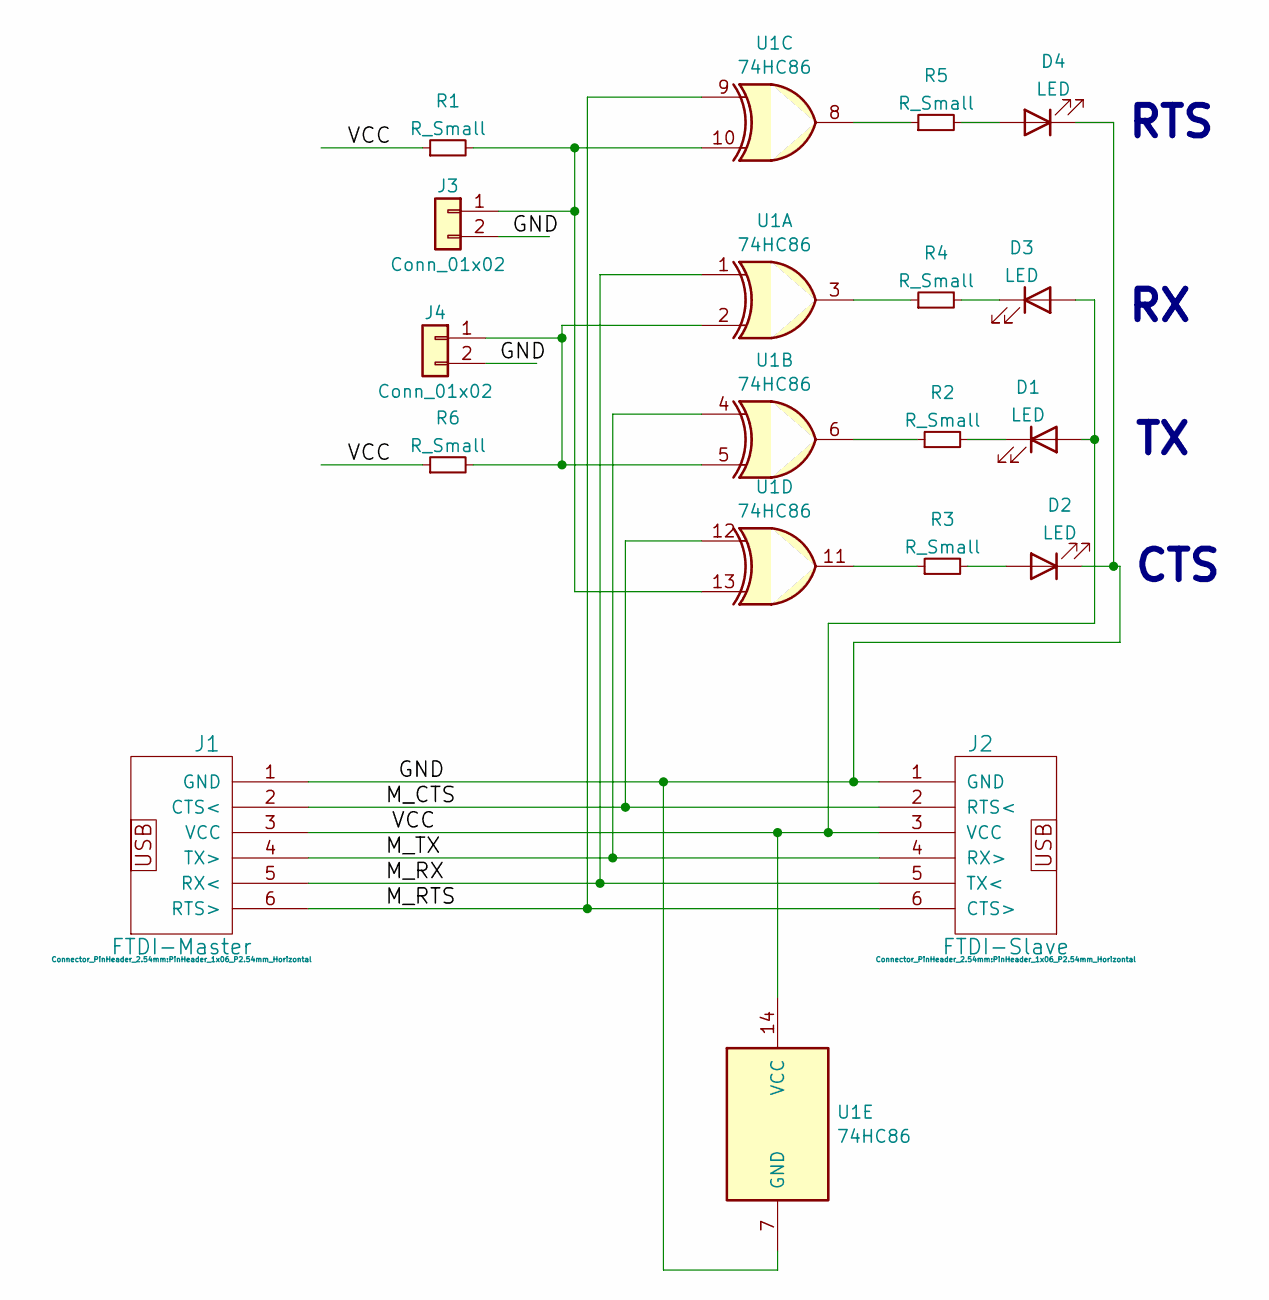
[picture p566: schematic FTDI_Monitor.kicad_sch]

Parts:
D1, D2, D3, D4: LED; LED_D5.0mm
J1: FTDI-Master; PinHeader_1x06_P2.54mm_Horizontal
J2: FTDI-Slave; PinHeader_1x06_P2.54mm_Horizontal
J3, J4: Conn_01x02; PinHeader_1x02_P2.54mm_Vertical
R1, R2, R3, R4, R5, R6: R_Small; R_Axial_DIN0204_L3.6mm_D1.6mm_P7.62mm_Horizontal
U1: 74HC86; DIP-14_W7.62mm_LongPads

Connections:
/GND: D2.1 (K), D4.1 (K), J1.1 (GND), J2.1 (GND), J3.2, J4.2, U1.7 (GND)
/M_CTS: J1.2 (CTS<), J2.2 (RTS<), U1.12
/M_RTS: J1.6 (RTS>), J2.6 (CTS>), U1.9
/M_RX: J1.5 (RX<), J2.5 (TX<), U1.1
/M_TX: J1.4 (TX>), J2.4 (RX>), U1.4
/VCC: D1.2 (A), D3.2 (A), J1.3 (VCC), J2.3 (VCC), R1.1, R6.1, U1.14 (VCC)
unnamed: D4.2 (A), R5.2
unnamed: D3.1 (K), R4.2
unnamed: D1.1 (K), R2.2
unnamed: D2.2 (A), R3.2
unnamed: J3.1, R1.2, U1.10, U1.13
unnamed: J4.1, R6.2, U1.2, U1.5
unnamed: R2.1, U1.6
unnamed: R3.1, U1.11
unnamed: R4.1, U1.3
unnamed: R5.1, U1.8

Notes on the sheet:
CTS
RTS

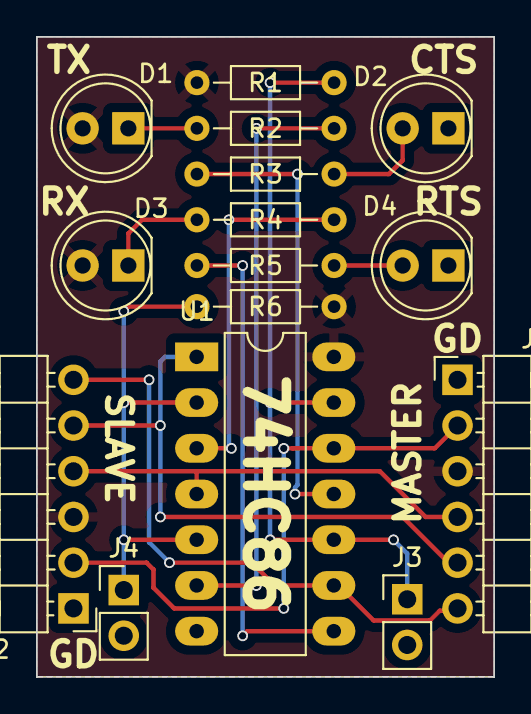
[picture p567: board Test Equipment Cards/FTDI_Monitor/FTDI_Monitor.kicad_pcb from above]

Board: 2 copper layers, 25.4 x 35.6 mm, 15 parts (0 on the bottom side), 16 nets.
