land-boards/lb-boards/Test Equipment Cards/FTDI_Monitor/Rev1/FTDI_Monitor.kicad_pcb

## KiCad design Test Equipment Cards/FTDI_Monitor/Rev1/FTDI_Monitor.kicad_pcb (2024-09-07)

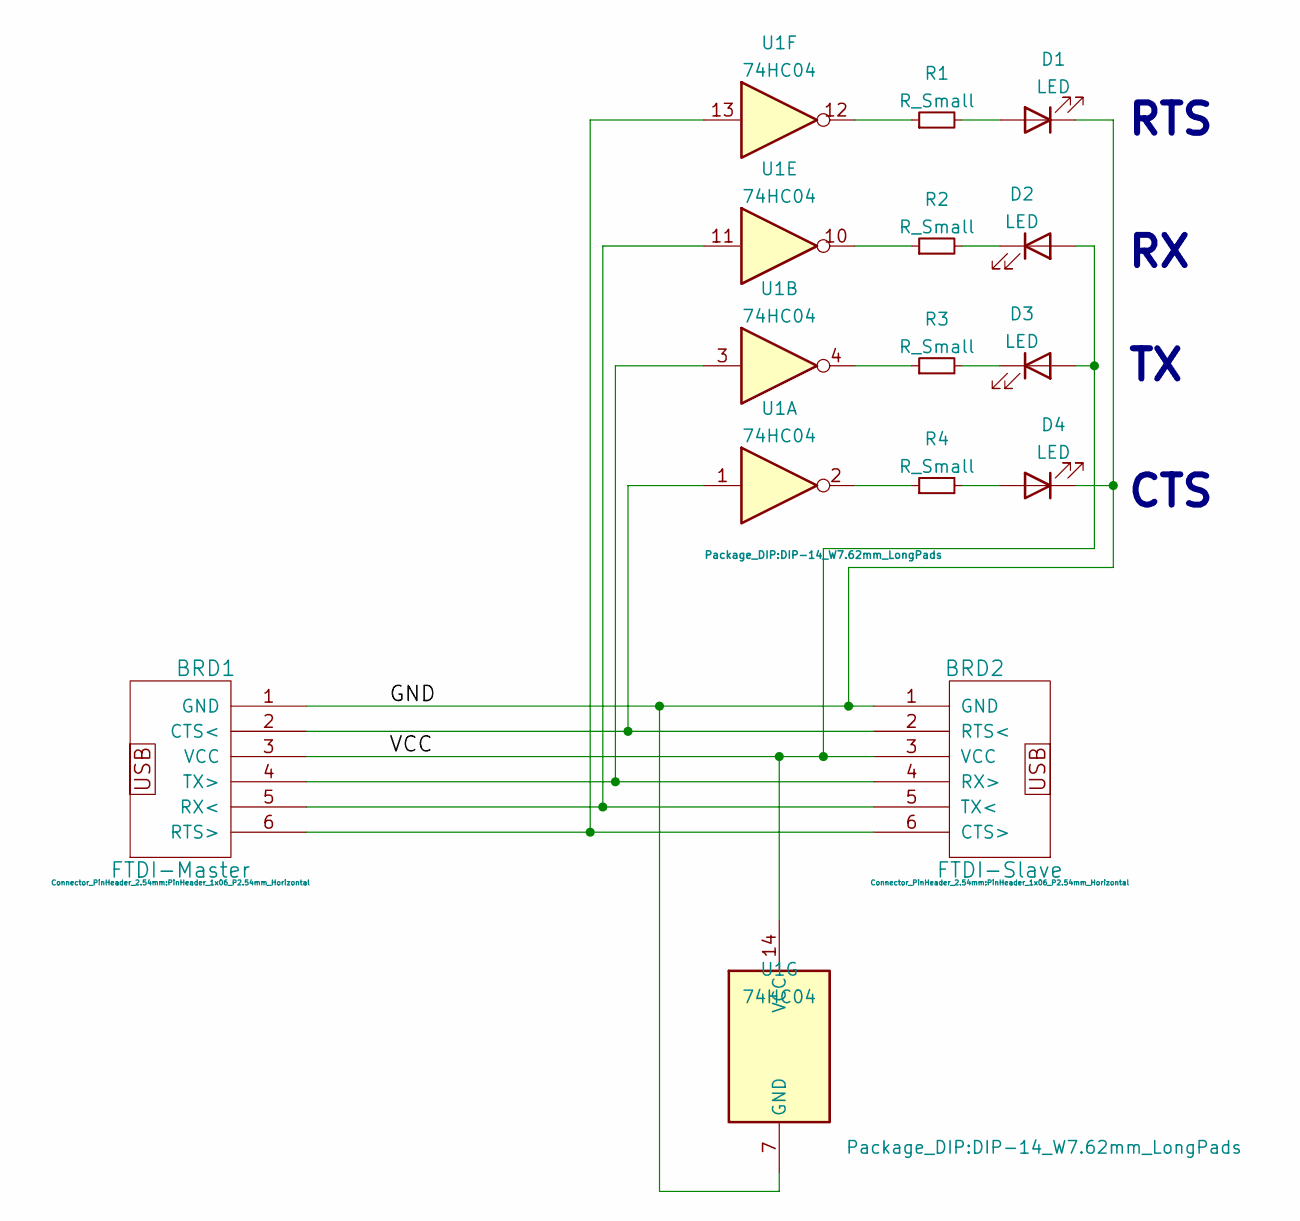
[picture p568: schematic FTDI_Monitor.kicad_sch]

Parts:
BRD1: FTDI-Master; PinHeader_1x06_P2.54mm_Horizontal
BRD2: FTDI-Slave; PinHeader_1x06_P2.54mm_Horizontal
D1, D2, D3, D4: LED; LED_D5.0mm
R1, R2, R3, R4: R_Small; R_Axial_DIN0204_L3.6mm_D1.6mm_P7.62mm_Horizontal
U1: 74HC04; DIP-14_W7.62mm_LongPads

Connections:
/GND: BRD1.1 (GND), BRD2.1 (GND), D1.1 (K), D4.1 (K), U1.7 (GND)
/VCC: BRD1.3 (VCC), BRD2.3 (VCC), D2.2 (A), D3.2 (A), U1.14 (VCC)
unnamed: BRD1.2 (CTS<), BRD2.2 (RTS<), U1.1
unnamed: BRD1.4 (TX>), BRD2.4 (RX>), U1.3
unnamed: BRD1.5 (RX<), BRD2.5 (TX<), U1.11
unnamed: BRD1.6 (RTS>), BRD2.6 (CTS>), U1.13
unnamed: D1.2 (A), R1.2
unnamed: D2.1 (K), R2.2
unnamed: D3.1 (K), R3.2
unnamed: D4.2 (A), R4.2
unnamed: R1.1, U1.12
unnamed: R2.1, U1.10
unnamed: R3.1, U1.4
unnamed: R4.1, U1.2

Notes on the sheet:
CTS
RTS

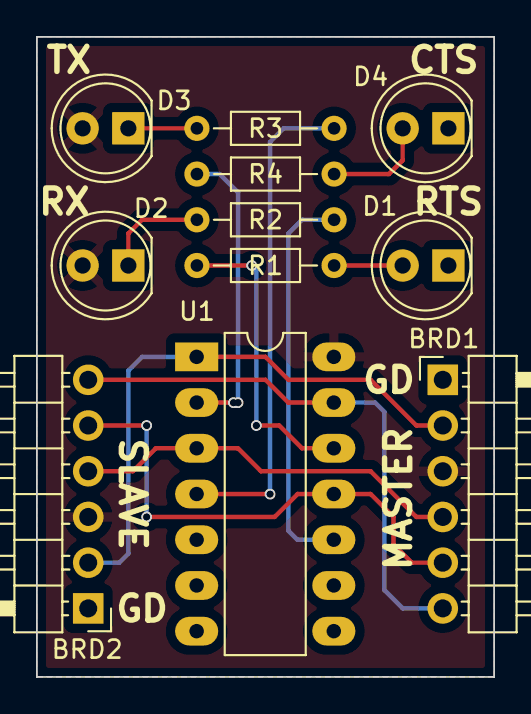
[picture p569: board Test Equipment Cards/FTDI_Monitor/Rev1/FTDI_Monitor.kicad_pcb from above]

Board: 2 copper layers, 25.4 x 35.6 mm, 11 parts (0 on the bottom side), 14 nets.
