land-boards/lb-boards/RetroCPUs/LB-RETRO-SET/LB-Z80-01/LB-Z80-01.kicad_pcb

## KiCad design RetroCPUs/LB-RETRO-SET/LB-Z80-01/LB-Z80-01.kicad_pcb (2024-09-20)

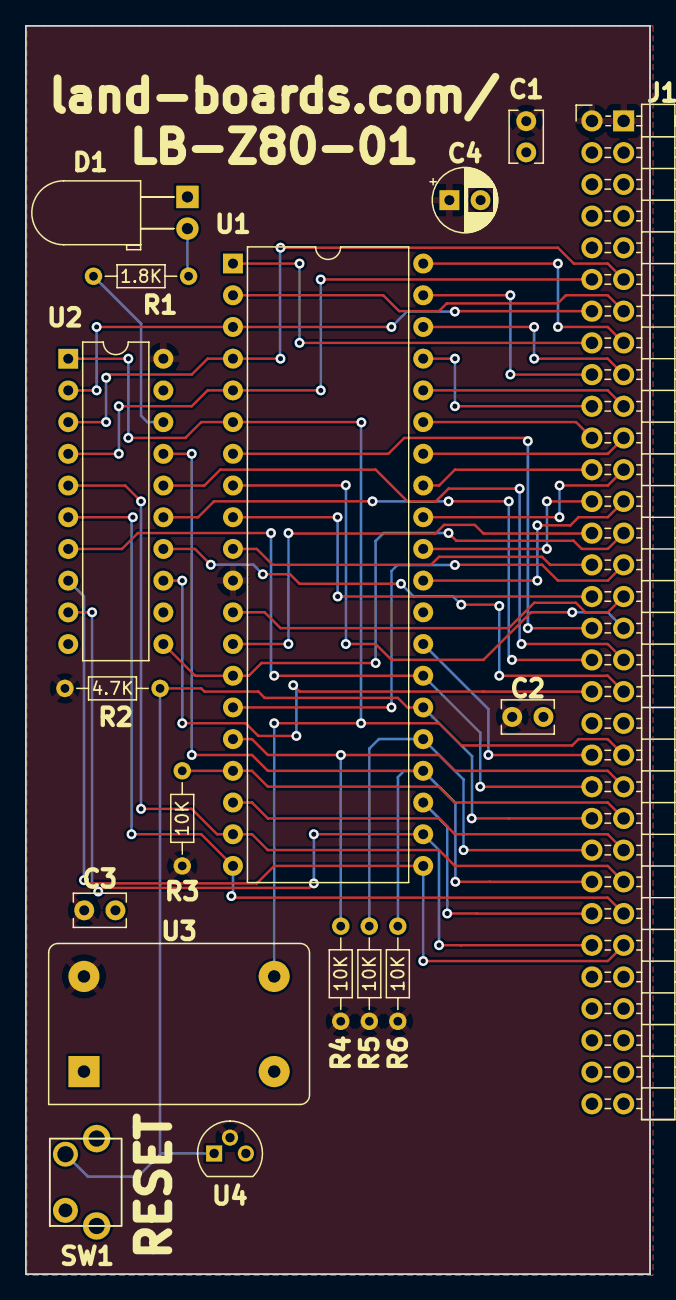
[picture p572: board LB-Z80-01.kicad_pcb from above]

Board: 2 copper layers, 50.0 x 100.0 mm, 18 parts (0 on the bottom side), 46 nets.

Parts:
C1, C2, C3: 0.1uF; C_Rect_L4.0mm_W2.5mm_P2.50mm
C4: 47uF; CP_Radial_D5.0mm_P2.50mm
D1: LED_Small; LED_D5.0mm_Horizontal_O3.81mm_Z9.0mm
J1: Conn_02x32_Odd_Even; PinHeader_2x32_P2.54mm_Horizontal-FLIPPED
R1: 1.8K; R_Axial_DIN0204_L3.6mm_D1.6mm_P7.62mm_Horizontal
R2: 4.7K; R_Axial_DIN0204_L3.6mm_D1.6mm_P7.62mm_Horizontal
R3, R4, R5, R6: 10K; R_Axial_DIN0204_L3.6mm_D1.6mm_P7.62mm_Horizontal
SW1: SW_Push; SW_PUSH_VERT
TEST1: COUPON; TEST_BLK-REAR
U1: Z80CPU; DIP-40_W15.24mm
U2: GAL16V8; DIP-20_W7.62mm
U3: OSC; Oscillator_DIP-14_LargePads
U4: DS1813-5; TO-92

Connections:
/CPUA0: J1.25, U1.30 (A0)
/CPUA1: J1.26, U1.31 (A1)
/CPUA2: J1.23, U1.32 (A2)
/CPUA3: J1.24, U1.33 (A3)
/CPUA4: J1.21, U1.34 (A4)
/CPUA5: J1.22, U1.35 (A5)
/CPUA6: J1.19, U1.36 (A6)
/CPUA7: J1.20, U1.37 (A7)
/CPUA8: J1.17, U1.38 (A8)
/CPUA9: J1.18, U1.39 (A9)
/CPUA10: J1.15, U1.40 (A10)
/CPUA11: J1.16, U1.1 (A11)
/CPUA12: J1.13, U1.2 (A12)
/CPUA13: J1.14, U1.3 (A13), U2.2 (I2)
/CPUA14: J1.11, U1.4 (A14), U2.3 (I3)
/CPUA15: J1.12, U1.5 (A15), U2.4 (I4)
/CPUCLK: J1.41, U1.6 (~CLK), U2.1 (I1/CLK), U3.8 (OUT)
/CPUD0: J1.27, U1.14 (D0), U2.11 (I10/~OE)
/CPUD1: J1.29, U1.15 (D1)
/CPUD2: J1.31, U1.12 (D2)
/CPUD3: J1.33, U1.8 (D3)
/CPUD4: J1.34, U1.7 (D4)
/CPUD5: J1.32, U1.9 (D5)
/CPUD6: J1.30, U1.10 (D6)
/CPUD7: J1.28, U1.13 (D7)
/LED: R1.2, U2.18 (IO2)
/RFSH: J1.42, U1.28 (~RFSH)
/~BUSACK: J1.52, U1.23 (~BUSACK)
/~BUSRQ: J1.48, R5.2, U1.25 (~BUSRQ)
/~CPURD: J1.53, U1.21 (~RD), U2.8 (I8)
/~CPURST: J1.46, R2.2, SW1.2, U1.26 (~RESET), U4.1
/~CPUWR: J1.54, U1.22 (~WR), U2.9 (I9)
/~HALT: J1.47, U1.18 (~HALT)
/~INT: J1.43, R4.2, U1.16 (~INT)
/~IOCS: J1.37, U2.14 (IO6)
/~IORQ: J1.51, U1.20 (~IORQ), U2.6 (I6)
/~M1: J1.44, U1.27 (~M1), U2.7 (I7)
/~MEMRD: J1.35, U2.16 (IO4)
/~MREQ: J1.49, U1.19 (~MREQ), U2.5 (I5)
/~NMI: J1.45, R3.2, U1.17 (~NMI)
/~RAMCS: J1.36, U2.15 (IO5)
/~ROMCS: J1.38, U2.13 (IO7)
/~WAIT: J1.50, R6.2, U1.24 (~WAIT), U2.17 (I03)
GND: C1.1, C2.1, C3.1, C4.2, D1.1 (K), J1.39, J1.40, SW1.1, U1.29 (GND), U2.10 (GND), U3.7 (GND), U4.3
unnamed: D1.2 (A), R1.1
VCC: C1.2, C2.2, C3.2, C4.1, J1.1, J1.2, R2.1, R3.1, R4.1, R5.1, R6.1, U1.11 (VCC), U2.20 (VCC), U3.14 (VCC), U4.2
