land-boards/lb-boards/RetroCPUs/LB-RETRO-SET/LB-BKOUT-02/LB-BKOUT-02.kicad_pcb

## KiCad design RetroCPUs/LB-RETRO-SET/LB-BKOUT-02/LB-BKOUT-02.kicad_pcb (2024-09-20)

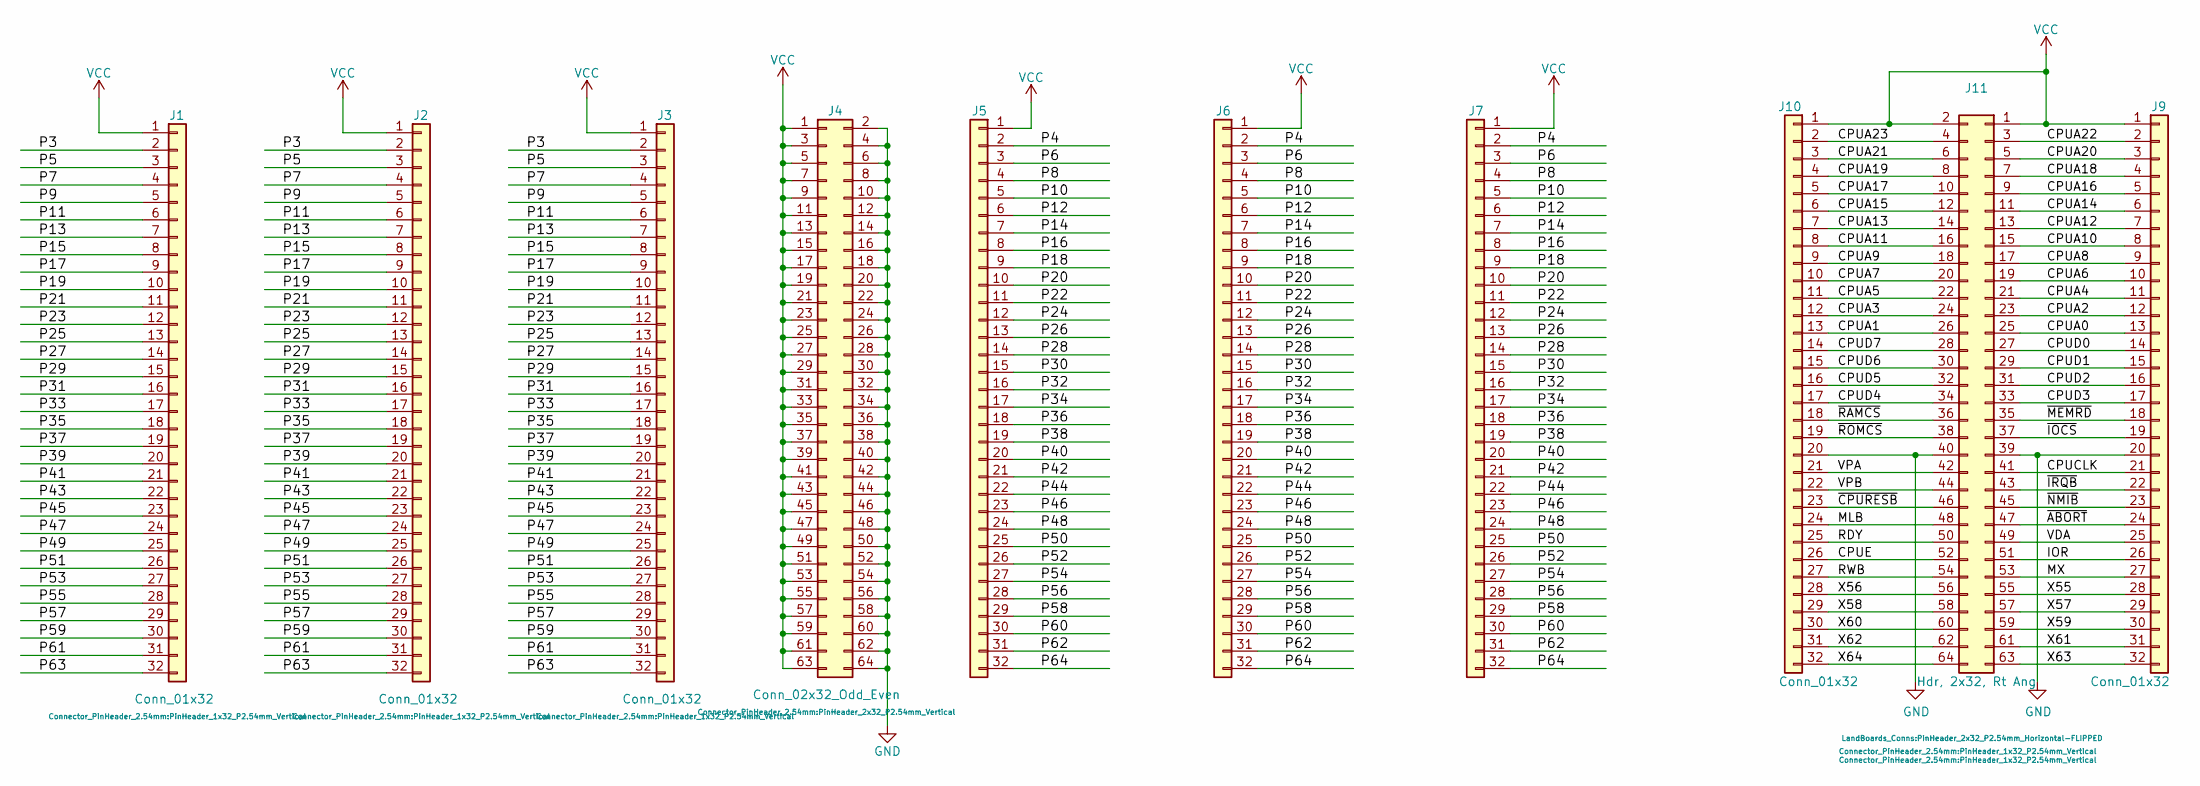
[picture p573: schematic LB-BKOUT-02.kicad_sch, ITX-65C816]

Parts:
J1, J2, J3, J5, J6, J7, J9, J10: Conn_01x32; PinHeader_1x32_P2.54mm_Vertical
J4: Conn_02x32_Odd_Even; PinHeader_2x32_P2.54mm_Vertical
J11: Hdr, 2x32, Rt Ang; PinHeader_2x32_P2.54mm_Horizontal-FLIPPED

Connections:
/CPUA0: J9.13, J11.25
/CPUA1: J10.13, J11.26
/CPUA2: J9.12, J11.23
/CPUA3: J10.12, J11.24
/CPUA4: J9.11, J11.21
/CPUA5: J10.11, J11.22
/CPUA6: J9.10, J11.19
/CPUA7: J10.10, J11.20
/CPUA8: J9.9, J11.17
/CPUA9: J10.9, J11.18
/CPUA10: J9.8, J11.15
/CPUA11: J10.8, J11.16
/CPUA12: J9.7, J11.13
/CPUA13: J10.7, J11.14
/CPUA14: J9.6, J11.11
/CPUA15: J10.6, J11.12
/CPUA16: J9.5, J11.9
/CPUA17: J10.5, J11.10
/CPUA18: J9.4, J11.7
/CPUA19: J10.4, J11.8
/CPUA20: J9.3, J11.5
/CPUA21: J10.3, J11.6
/CPUA22: J9.2, J11.3
/CPUA23: J10.2, J11.4
/CPUCLK: J9.21, J11.41
/CPUD0: J9.14, J11.27
/CPUD1: J9.15, J11.29
/CPUD2: J9.16, J11.31
/CPUD3: J9.17, J11.33
/CPUD4: J10.17, J11.34
/CPUD5: J10.16, J11.32
/CPUD6: J10.15, J11.30
/CPUD7: J10.14, J11.28
/CPUE: J10.26, J11.52
/IOR: J9.26, J11.51
/MLB: J10.24, J11.48
/MX: J9.27, J11.53
/P3: J1.2, J2.2, J3.2
/P4: J5.2, J6.2, J7.2
/P5: J1.3, J2.3, J3.3
/P6: J5.3, J6.3, J7.3
/P7: J1.4, J2.4, J3.4
/P8: J5.4, J6.4, J7.4
/P9: J1.5, J2.5, J3.5
/P10: J5.5, J6.5, J7.5
/P11: J1.6, J2.6, J3.6
/P12: J5.6, J6.6, J7.6
/P13: J1.7, J2.7, J3.7
/P14: J5.7, J6.7, J7.7
/P15: J1.8, J2.8, J3.8
/P16: J5.8, J6.8, J7.8
/P17: J1.9, J2.9, J3.9
/P18: J5.9, J6.9, J7.9
/P19: J1.10, J2.10, J3.10
/P20: J5.10, J6.10, J7.10
/P21: J1.11, J2.11, J3.11
/P22: J5.11, J6.11, J7.11
/P23: J1.12, J2.12, J3.12
/P24: J5.12, J6.12, J7.12
/P25: J1.13, J2.13, J3.13
/P26: J5.13, J6.13, J7.13
/P27: J1.14, J2.14, J3.14
/P28: J5.14, J6.14, J7.14
/P29: J1.15, J2.15, J3.15
/P30: J5.15, J6.15, J7.15
/P31: J1.16, J2.16, J3.16
/P32: J5.16, J6.16, J7.16
/P33: J1.17, J2.17, J3.17
/P34: J5.17, J6.17, J7.17
/P35: J1.18, J2.18, J3.18
/P36: J5.18, J6.18, J7.18
/P37: J1.19, J2.19, J3.19
/P38: J5.19, J6.19, J7.19
/P39: J1.20, J2.20, J3.20
/P40: J5.20, J6.20, J7.20
/P41: J1.21, J2.21, J3.21
/P42: J5.21, J6.21, J7.21
/P43: J1.22, J2.22, J3.22
/P44: J5.22, J6.22, J7.22
/P45: J1.23, J2.23, J3.23
/P46: J5.23, J6.23, J7.23
/P47: J1.24, J2.24, J3.24
/P48: J5.24, J6.24, J7.24
/P49: J1.25, J2.25, J3.25
/P50: J5.25, J6.25, J7.25
/P51: J1.26, J2.26, J3.26
/P52: J5.26, J6.26, J7.26
/P53: J1.27, J2.27, J3.27
/P54: J5.27, J6.27, J7.27
/P55: J1.28, J2.28, J3.28
/P56: J5.28, J6.28, J7.28
/P57: J1.29, J2.29, J3.29
/P58: J5.29, J6.29, J7.29
/P59: J1.30, J2.30, J3.30
/P60: J5.30, J6.30, J7.30
/P61: J1.31, J2.31, J3.31
/P62: J5.31, J6.31, J7.31
/P63: J1.32, J2.32, J3.32
/P64: J5.32, J6.32, J7.32
/RDY: J10.25, J11.50
/RWB: J10.27, J11.54
/VDA: J9.25, J11.49
/VPA: J10.21, J11.42
/VPB: J10.22, J11.44
/X55: J9.28, J11.55
/X56: J10.28, J11.56
/X57: J9.29, J11.57
/X58: J10.29, J11.58
/X59: J9.30, J11.59
/X60: J10.30, J11.60
/X61: J9.31, J11.61
/X62: J10.31, J11.62
/X63: J9.32, J11.63
/X64: J10.32, J11.64
/~ABORT: J9.24, J11.47
/~CPURESB: J10.23, J11.46
/~IOCS: J9.19, J11.37
/~IRQB: J9.22, J11.43
/~MEMRD: J9.18, J11.35
/~NMIB: J9.23, J11.45
/~RAMCS: J10.18, J11.36
/~ROMCS: J10.19, J11.38
GND: J4.2, J4.4, J4.6, J4.8, J4.10, J4.12, J4.14, J4.16, J4.18, J4.20, J4.22, J4.24, J4.26, J4.28, J4.30, J4.32, J4.34, J4.36, J4.38, J4.40, J4.42, J4.44, J4.46, J4.48, J4.50, J4.52, J4.54, J4.56, J4.58, J4.60, J4.62, J4.64, J9.20, J10.20, J11.39, J11.40
VCC: J1.1, J2.1, J3.1, J4.1, J4.3, J4.5, J4.7, J4.9, J4.11, J4.13, J4.15, J4.17, J4.19, J4.21, J4.23, J4.25, J4.27, J4.29, J4.31, J4.33, J4.35, J4.37, J4.39, J4.41, J4.43, J4.45, J4.47, J4.49, J4.51, J4.53, J4.55, J4.57, J4.59, J4.61, J4.63, J5.1, J6.1, J7.1, J9.1, J10.1, J11.1, J11.2

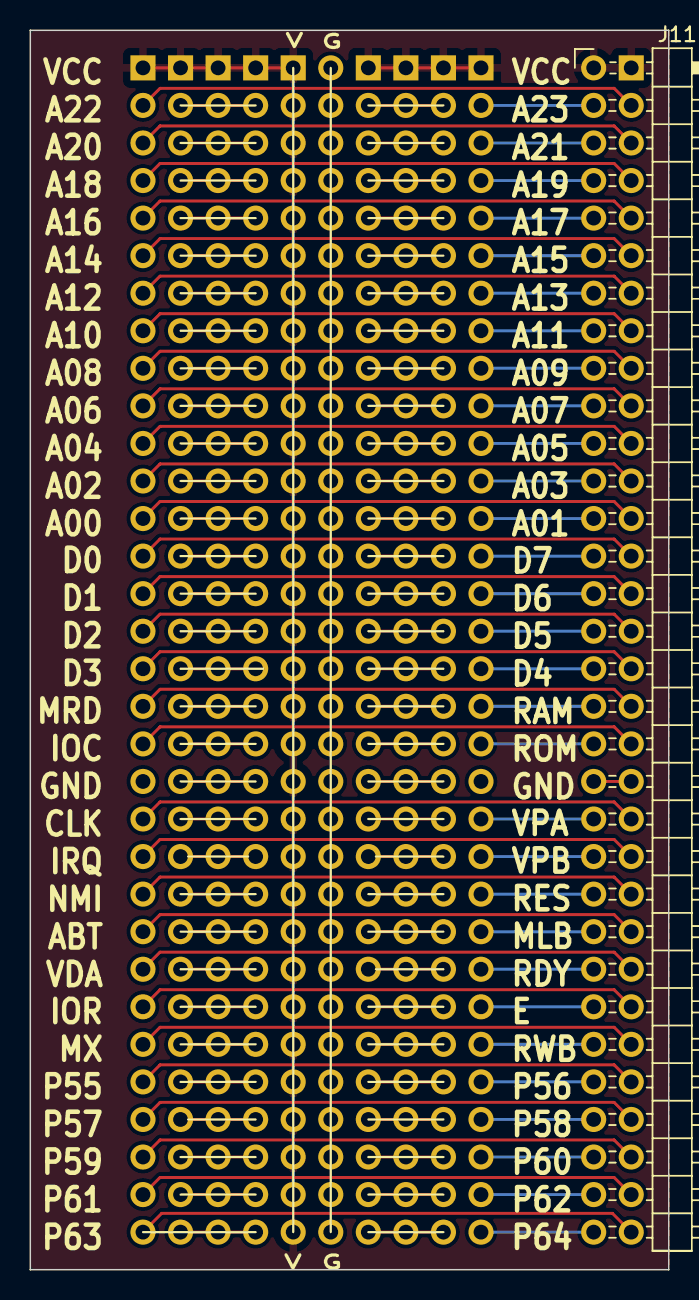
[picture p574: board LB-BKOUT-02.kicad_pcb from above]

Board: 2 copper layers, 43.2 x 83.8 mm, 10 parts (0 on the bottom side), 124 nets.
