land-boards/lb-boards/RetroCPUs/LB-RETRO-SET/LB-IOBRIDGE-01/LB-68B50-01.kicad_pcb

## KiCad design RetroCPUs/LB-RETRO-SET/LB-IOBRIDGE-01/LB-68B50-01.kicad_pcb (2024-09-13)

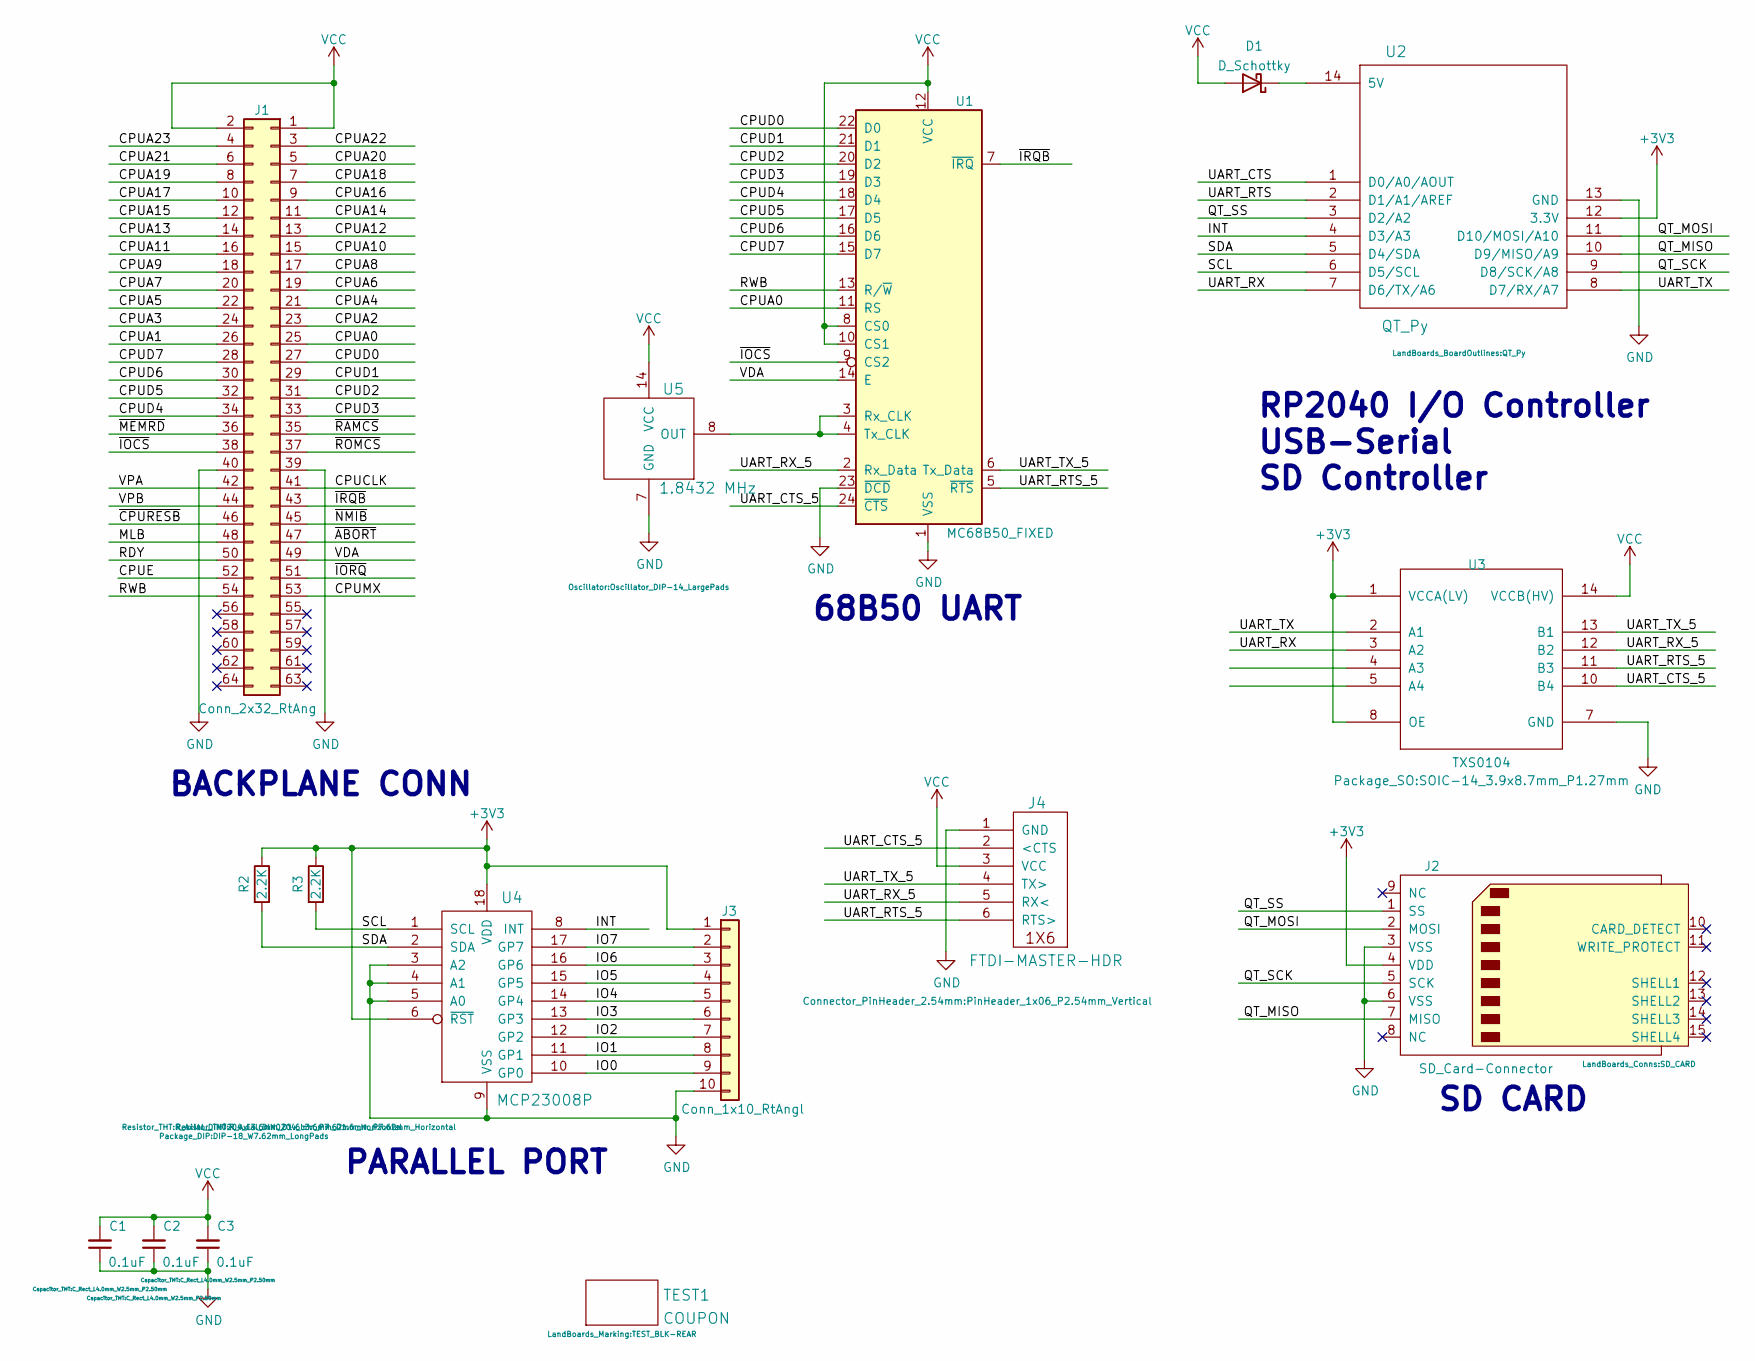
[picture p575: schematic LB-68B50-01.kicad_sch]

Parts:
C1, C2, C3: 0.1uF; C_Rect_L4.0mm_W2.5mm_P2.50mm
D1: D_Schottky; D_DO-35_SOD27_P10.16mm_Horizontal
J1: Conn_2x32_RtAng; PinHeader_2x32_P2.54mm_Horizontal-FLIPPED
J2: SD_Card-Connector; SD_CARD
J3: Conn_1x10_RtAngl; PinHeader_1x10_P2.54mm_Horizontal
J4: FTDI-MASTER-HDR; PinHeader_1x06_P2.54mm_Vertical
R2, R3: 2.2K; R_Axial_DIN0204_L3.6mm_D1.6mm_P7.62mm_Horizontal
TEST1: COUPON; TEST_BLK-REAR
U1: MC68B50_FIXED; DIP-24_W15.24mm_LongPads
U2: QT_Py
U3: TXS0104; SOIC-14_3.9x8.7mm_P1.27mm
U4: MCP23008P; DIP-18_W7.62mm_LongPads
U5: 1.8432 MHz; Oscillator_DIP-14_LargePads

Connections:
+3V3: J2.4 (VDD), J3.1, R2.1, R3.1, U2.12 (3.3V), U3.1 (VCCA(LV)), U3.8 (OE), U4.6 (~RST), U4.18 (VDD)
/CPUA0: J1.25, U1.11 (RS)
/CPUA1: J1.26
/CPUA2: J1.23
/CPUA3: J1.24
/CPUA4: J1.21
/CPUA5: J1.22
/CPUA6: J1.19
/CPUA7: J1.20
/CPUA8: J1.17
/CPUA9: J1.18
/CPUA10: J1.15
/CPUA11: J1.16
/CPUA12: J1.13
/CPUA13: J1.14
/CPUA14: J1.11
/CPUA15: J1.12
/CPUA16: J1.9
/CPUA17: J1.10
/CPUA18: J1.7
/CPUA19: J1.8
/CPUA20: J1.5
/CPUA21: J1.6
/CPUA22: J1.3
/CPUA23: J1.4
/CPUCLK: J1.41
/CPUD0: J1.27, U1.22 (D0)
/CPUD1: J1.29, U1.21 (D1)
/CPUD2: J1.31, U1.20 (D2)
/CPUD3: J1.33, U1.19 (D3)
/CPUD4: J1.34, U1.18 (D4)
/CPUD5: J1.32, U1.17 (D5)
/CPUD6: J1.30, U1.16 (D6)
/CPUD7: J1.28, U1.15 (D7)
/CPUE: J1.52
/CPUMX: J1.53
/INT: U2.4 (D3/A3), U4.8 (INT)
/IO0: J3.9, U4.10 (GP0)
/IO1: J3.8, U4.11 (GP1)
/IO2: J3.7, U4.12 (GP2)
/IO3: J3.6, U4.13 (GP3)
/IO4: J3.5, U4.14 (GP4)
/IO5: J3.4, U4.15 (GP5)
/IO6: J3.3, U4.16 (GP6)
/IO7: J3.2, U4.17 (GP7)
/MLB: J1.48
/QT_MISO: J2.7 (MISO), U2.10 (D9/MISO/A9)
/QT_MOSI: J2.2 (MOSI), U2.11 (D10/MOSI/A10)
/QT_SCK: J2.5 (SCK), U2.9 (D8/SCK/A8)
/QT_SS: J2.1 (SS), U2.3 (D2/A2)
/RDY: J1.50
/RWB: J1.54, U1.13 (R/~W)
/SCL: R3.2, U2.6 (D5/SCL), U4.1 (SCL)
/SDA: R2.2, U2.5 (D4/SDA), U4.2 (SDA)
/UART_CTS: U2.1 (D0/A0/AOUT)
/UART_CTS_5: J4.2 (<CTS), U1.24 (~CTS), U3.10 (B4)
/UART_RTS: U2.2 (D1/A1/AREF)
/UART_RTS_5: J4.6 (RTS>), U1.5 (~RTS), U3.11 (B3)
/UART_RX: U2.7 (D6/TX/A6), U3.3 (A2)
/UART_RX_5: J4.5 (RX<), U1.2 (Rx_Data), U3.12 (B2)
/UART_TX: U2.8 (D7/RX/A7), U3.2 (A1)
/UART_TX_5: J4.4 (TX>), U1.6 (Tx_Data), U3.13 (B1)
/VDA: J1.49, U1.14 (E)
/VPA: J1.42
/VPB: J1.44
/~ABORT: J1.47
/~CPURESB: J1.46
/~IOCS: J1.38, U1.9 (CS2)
/~IORQ: J1.51
/~IRQB: J1.43, U1.7 (~IRQ)
/~MEMRD: J1.36
/~NMIB: J1.45
/~RAMCS: J1.35
/~ROMCS: J1.37
GND: C1.1, C2.1, C3.1, J1.39, J1.40, J2.3 (VSS), J2.6 (VSS), J3.10, J4.1 (GND), U1.1 (VSS), U1.23 (~DCD), U2.13 (GND), U3.7 (GND), U4.3 (A2), U4.4 (A1), U4.5 (A0), U4.9 (VSS), U5.7 (GND)
unnamed: D1.1 (K), U2.14 (5V)
unnamed: U1.3 (Rx_CLK), U1.4 (Tx_CLK), U5.8 (OUT)
VCC: C1.2, C2.2, C3.2, D1.2 (A), J1.1, J1.2, J4.3 (VCC), U1.8 (CS0), U1.10 (CS1), U1.12 (VCC), U3.14 (VCCB(HV)), U5.14 (VCC)

Notes on the sheet:
68B50 UART
RP2040 I/O Controller USB-Serial SD Controller
SD CARD
BACKPLANE CONN
PARALLEL PORT

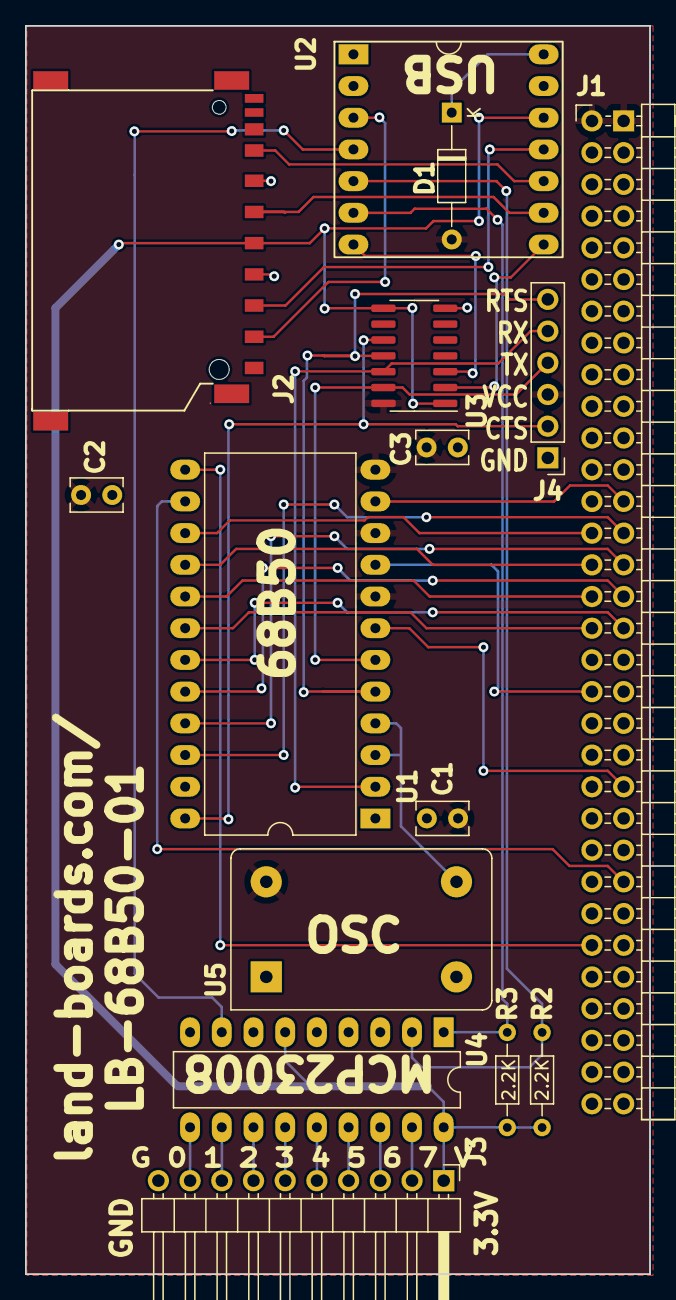
[picture p576: board LB-68B50-01.kicad_pcb from above]

Board: 2 copper layers, 50.0 x 100.0 mm, 16 parts (0 on the bottom side), 39 nets.

Other parts of the board:
TEST: COUPON; TEST_BLK-REAR
