land-boards/lb-boards/RetroCPUs/LB-RETRO-SET/LB-MEM-03/LB-MEM-03.kicad_pcb

## KiCad design RetroCPUs/LB-RETRO-SET/LB-MEM-03/LB-MEM-03.kicad_pcb (2024-09-07)

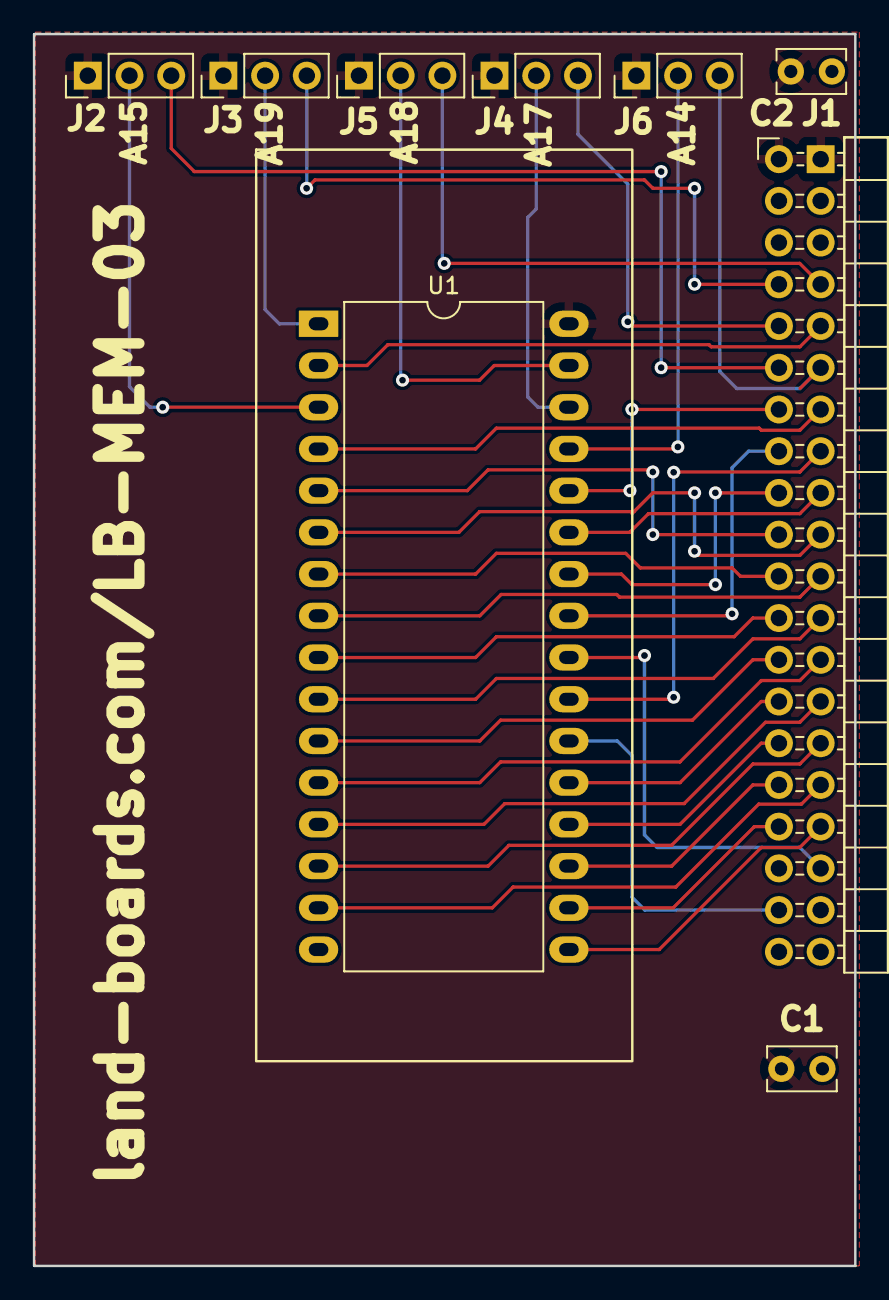
[picture p577: board LB-MEM-03.kicad_pcb from above]

Board: 2 copper layers, 50.0 x 75.0 mm, 10 parts (0 on the bottom side), 37 nets.

Parts:
C1, C2: 0.1uF; C_Rect_L4.0mm_W2.5mm_P2.50mm
J1: Conn_02x20_Odd_Even; PinHeader_2x20_P2.54mm_Horizontal-FLIPPED
J2, J3, J4, J5, J6: Conn_01x03; PinHeader_1x03_P2.54mm_Vertical
TEST: COUPON; TEST_BLK-REAR
U1: 27C080; DIP-32_W15.24mm_TEXTOOL

Connections:
/CPUA0: J1.25, U1.12 (A0)
/CPUA1: J1.26, U1.11 (A1)
/CPUA2: J1.23, U1.10 (A2)
/CPUA3: J1.24, U1.9 (A3)
/CPUA4: J1.21, U1.8 (A4)
/CPUA5: J1.22, U1.7 (A5)
/CPUA6: J1.19, U1.6 (A6)
/CPUA7: J1.20, U1.5 (A7)
/CPUA8: J1.17, U1.27 (A8)
/CPUA9: J1.18, U1.26 (A9)
/CPUA10: J1.15, U1.23 (A10)
/CPUA11: J1.16, U1.25 (A11)
/CPUA12: J1.13, U1.4 (A12)
/CPUA13: J1.14, U1.28 (A13)
/CPUA14: J1.11, J6.3
/CPUA15: J1.12, J2.3
/CPUA16: J1.9, U1.2 (A16)
/CPUA17: J1.10, J4.3
/CPUA18: J1.7, J5.3
/CPUA19: J1.8, J3.3
/CPUD0: J1.27, U1.13 (D0)
/CPUD1: J1.29, U1.14 (D1)
/CPUD2: J1.31, U1.15 (D2)
/CPUD3: J1.33, U1.17 (D3)
/CPUD4: J1.34, U1.18 (D4)
/CPUD5: J1.32, U1.19 (D5)
/CPUD6: J1.30, U1.20 (D6)
/CPUD7: J1.28, U1.21 (D7)
/EE_PIN1: J3.2, U1.1 (A19)
/EE_PIN3: J2.2, U1.3 (A15)
/EE_PIN29: J6.2, U1.29 (A14)
/EE_PIN30: J4.2, U1.30 (A17)
/EE_PIN31: J5.2, U1.31 (A18)
/~MEMRD: J1.35, U1.24 (~OE)
/~ROMCS: J1.38, U1.22 (~CE)
GND: C1.1, C2.1, J1.39, J1.40, U1.16 (GND)
VCC: C1.2, C2.2, J1.1, J1.2, J2.1, J3.1, J4.1, J5.1, J6.1, U1.32 (VCC)
