land-boards/lb-boards/RetroCPUs/LB-RETRO-SET/LB-BKPLANE-01/LB-BKPLANE-01.kicad_pcb

## KiCad design RetroCPUs/LB-RETRO-SET/LB-BKPLANE-01/LB-BKPLANE-01.kicad_pcb (2024-08-29)

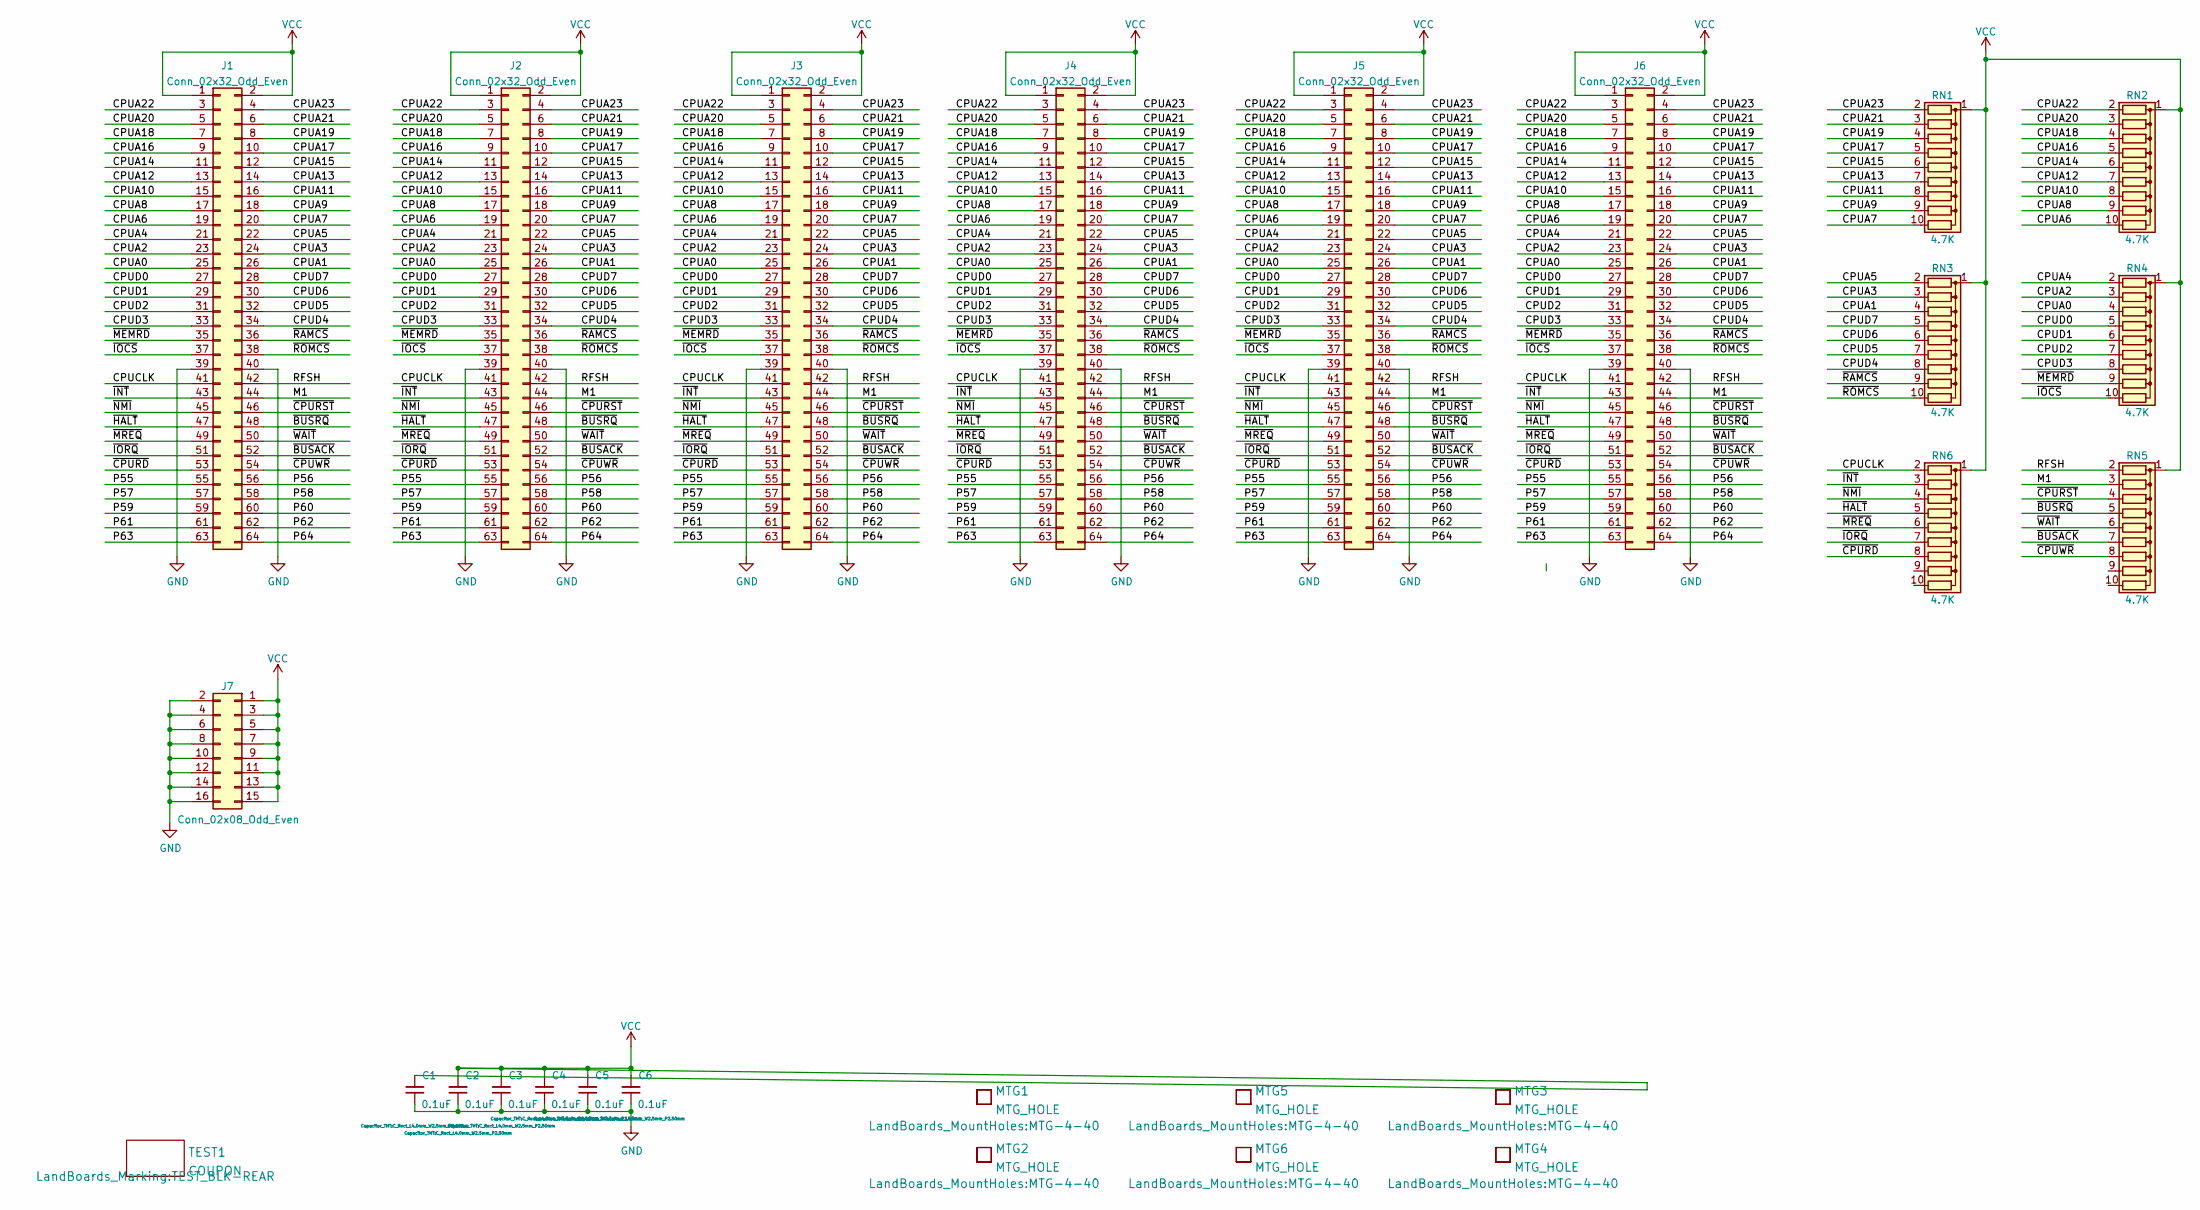
[picture p578: schematic LB-BKPLANE-01.kicad_sch]

Parts:
C1, C2, C3, C4, C5, C6: 0.1uF; C_Rect_L4.0mm_W2.5mm_P2.50mm
J1, J2, J3, J4, J5, J6: Conn_02x32_Odd_Even; PinHeader_2x32_P2.54mm_Vertical
J7: Conn_02x08_Odd_Even; PinHeader_2x08_P2.54mm_Vertical
MTG1, MTG2, MTG3, MTG4, MTG5, MTG6: MTG_HOLE; MTG-4-40
RN1, RN2, RN3, RN4, RN5, RN6: 4.7K; R_Array_SIP10
TEST1: COUPON; TEST_BLK-REAR

Connections:
/CPUA0: J1.25, J2.25, J3.25, J4.25, J5.25, J6.25, RN4.4 (R3)
/CPUA1: J1.26, J2.26, J3.26, J4.26, J5.26, J6.26, RN3.4 (R3)
/CPUA2: J1.23, J2.23, J3.23, J4.23, J5.23, J6.23, RN4.3 (R2)
/CPUA3: J1.24, J2.24, J3.24, J4.24, J5.24, J6.24, RN3.3 (R2)
/CPUA4: J1.21, J2.21, J3.21, J4.21, J5.21, J6.21, RN4.2 (R1)
/CPUA5: J1.22, J2.22, J3.22, J4.22, J5.22, J6.22, RN3.2 (R1)
/CPUA6: J1.19, J2.19, J3.19, J4.19, J5.19, J6.19, RN2.10 (R9)
/CPUA7: J1.20, J2.20, J3.20, J4.20, J5.20, J6.20, RN1.10 (R9)
/CPUA8: J1.17, J2.17, J3.17, J4.17, J5.17, J6.17, RN2.9 (R8)
/CPUA9: J1.18, J2.18, J3.18, J4.18, J5.18, J6.18, RN1.9 (R8)
/CPUA10: J1.15, J2.15, J3.15, J4.15, J5.15, J6.15, RN2.8 (R7)
/CPUA11: J1.16, J2.16, J3.16, J4.16, J5.16, J6.16, RN1.8 (R7)
/CPUA12: J1.13, J2.13, J3.13, J4.13, J5.13, J6.13, RN2.7 (R6)
/CPUA13: J1.14, J2.14, J3.14, J4.14, J5.14, J6.14, RN1.7 (R6)
/CPUA14: J1.11, J2.11, J3.11, J4.11, J5.11, J6.11, RN2.6 (R5)
/CPUA15: J1.12, J2.12, J3.12, J4.12, J5.12, J6.12, RN1.6 (R5)
/CPUA16: J1.9, J2.9, J3.9, J4.9, J5.9, J6.9, RN2.5 (R4)
/CPUA17: J1.10, J2.10, J3.10, J4.10, J5.10, J6.10, RN1.5 (R4)
/CPUA18: J1.7, J2.7, J3.7, J4.7, J5.7, J6.7, RN2.4 (R3)
/CPUA19: J1.8, J2.8, J3.8, J4.8, J5.8, J6.8, RN1.4 (R3)
/CPUA20: J1.5, J2.5, J3.5, J4.5, J5.5, J6.5, RN2.3 (R2)
/CPUA21: J1.6, J2.6, J3.6, J4.6, J5.6, J6.6, RN1.3 (R2)
/CPUA22: J1.3, J2.3, J3.3, J4.3, J5.3, J6.3, RN2.2 (R1)
/CPUA23: J1.4, J2.4, J3.4, J4.4, J5.4, J6.4, RN1.2 (R1)
/CPUCLK: J1.41, J2.41, J3.41, J4.41, J5.41, J6.41, RN6.2 (R1)
/CPUD0: J1.27, J2.27, J3.27, J4.27, J5.27, J6.27, RN4.5 (R4)
/CPUD1: J1.29, J2.29, J3.29, J4.29, J5.29, J6.29, RN4.6 (R5)
/CPUD2: J1.31, J2.31, J3.31, J4.31, J5.31, J6.31, RN4.7 (R6)
/CPUD3: J1.33, J2.33, J3.33, J4.33, J5.33, J6.33, RN4.8 (R7)
/CPUD4: J1.34, J2.34, J3.34, J4.34, J5.34, J6.34, RN3.8 (R7)
/CPUD5: J1.32, J2.32, J3.32, J4.32, J5.32, J6.32, RN3.7 (R6)
/CPUD6: J1.30, J2.30, J3.30, J4.30, J5.30, J6.30, RN3.6 (R5)
/CPUD7: J1.28, J2.28, J3.28, J4.28, J5.28, J6.28, RN3.5 (R4)
/M1: J1.44, J2.44, J3.44, J4.44, J5.44, J6.44, RN5.3 (R2)
/P55: J1.55, J2.55, J3.55, J4.55, J5.55, J6.55
/P56: J1.56, J2.56, J3.56, J4.56, J5.56, J6.56
/P57: J1.57, J2.57, J3.57, J4.57, J5.57, J6.57
/P58: J1.58, J2.58, J3.58, J4.58, J5.58, J6.58
/P59: J1.59, J2.59, J3.59, J4.59, J5.59, J6.59
/P60: J1.60, J2.60, J3.60, J4.60, J5.60, J6.60
/P61: J1.61, J2.61, J3.61, J4.61, J5.61, J6.61
/P62: J1.62, J2.62, J3.62, J4.62, J5.62, J6.62
/P63: J1.63, J2.63, J3.63, J4.63, J5.63, J6.63
/P64: J1.64, J2.64, J3.64, J4.64, J5.64, J6.64
/RFSH: J1.42, J2.42, J3.42, J4.42, J5.42, J6.42, RN5.2 (R1)
/~BUSACK: J1.52, J2.52, J3.52, J4.52, J5.52, J6.52, RN5.7 (R6)
/~BUSRQ: J1.48, J2.48, J3.48, J4.48, J5.48, J6.48, RN5.5 (R4)
/~CPURD: J1.53, J2.53, J3.53, J4.53, J5.53, J6.53, RN6.8 (R7)
/~CPURST: J1.46, J2.46, J3.46, J4.46, J5.46, J6.46, RN5.4 (R3)
/~CPUWR: J1.54, J2.54, J3.54, J4.54, J5.54, J6.54, RN5.8 (R7)
/~HALT: J1.47, J2.47, J3.47, J4.47, J5.47, J6.47, RN6.5 (R4)
/~INT: J1.43, J2.43, J3.43, J4.43, J5.43, J6.43, RN6.3 (R2)
/~IOCS: J1.37, J2.37, J3.37, J4.37, J5.37, J6.37, RN4.10 (R9)
/~IORQ: J1.51, J2.51, J3.51, J4.51, J5.51, J6.51, RN6.7 (R6)
/~MEMRD: J1.35, J2.35, J3.35, J4.35, J5.35, J6.35, RN4.9 (R8)
/~MREQ: J1.49, J2.49, J3.49, J4.49, J5.49, J6.49, RN6.6 (R5)
/~NMI: J1.45, J2.45, J3.45, J4.45, J5.45, J6.45, RN6.4 (R3)
/~RAMCS: J1.36, J2.36, J3.36, J4.36, J5.36, J6.36, RN3.9 (R8)
/~ROMCS: J1.38, J2.38, J3.38, J4.38, J5.38, J6.38, RN3.10 (R9)
/~WAIT: J1.50, J2.50, J3.50, J4.50, J5.50, J6.50, RN5.6 (R5)
GND: C1.1, C2.1, C3.1, C4.1, C5.1, C6.1, J1.39, J1.40, J2.39, J2.40, J3.39, J3.40, J4.39, J4.40, J5.39, J5.40, J6.39, J6.40, J7.2, J7.4, J7.6, J7.8, J7.10, J7.12, J7.14, J7.16
VCC: C1.2, C2.2, C3.2, C4.2, C5.2, C6.2, J1.1, J1.2, J2.1, J2.2, J3.1, J3.2, J4.1, J4.2, J5.1, J5.2, J6.1, J6.2, J7.1, J7.3, J7.5, J7.7, J7.9, J7.11, J7.13, J7.15, RN1.1 (common), RN2.1 (common), RN3.1 (common), RN4.1 (common), RN5.1 (common), RN6.1 (common)

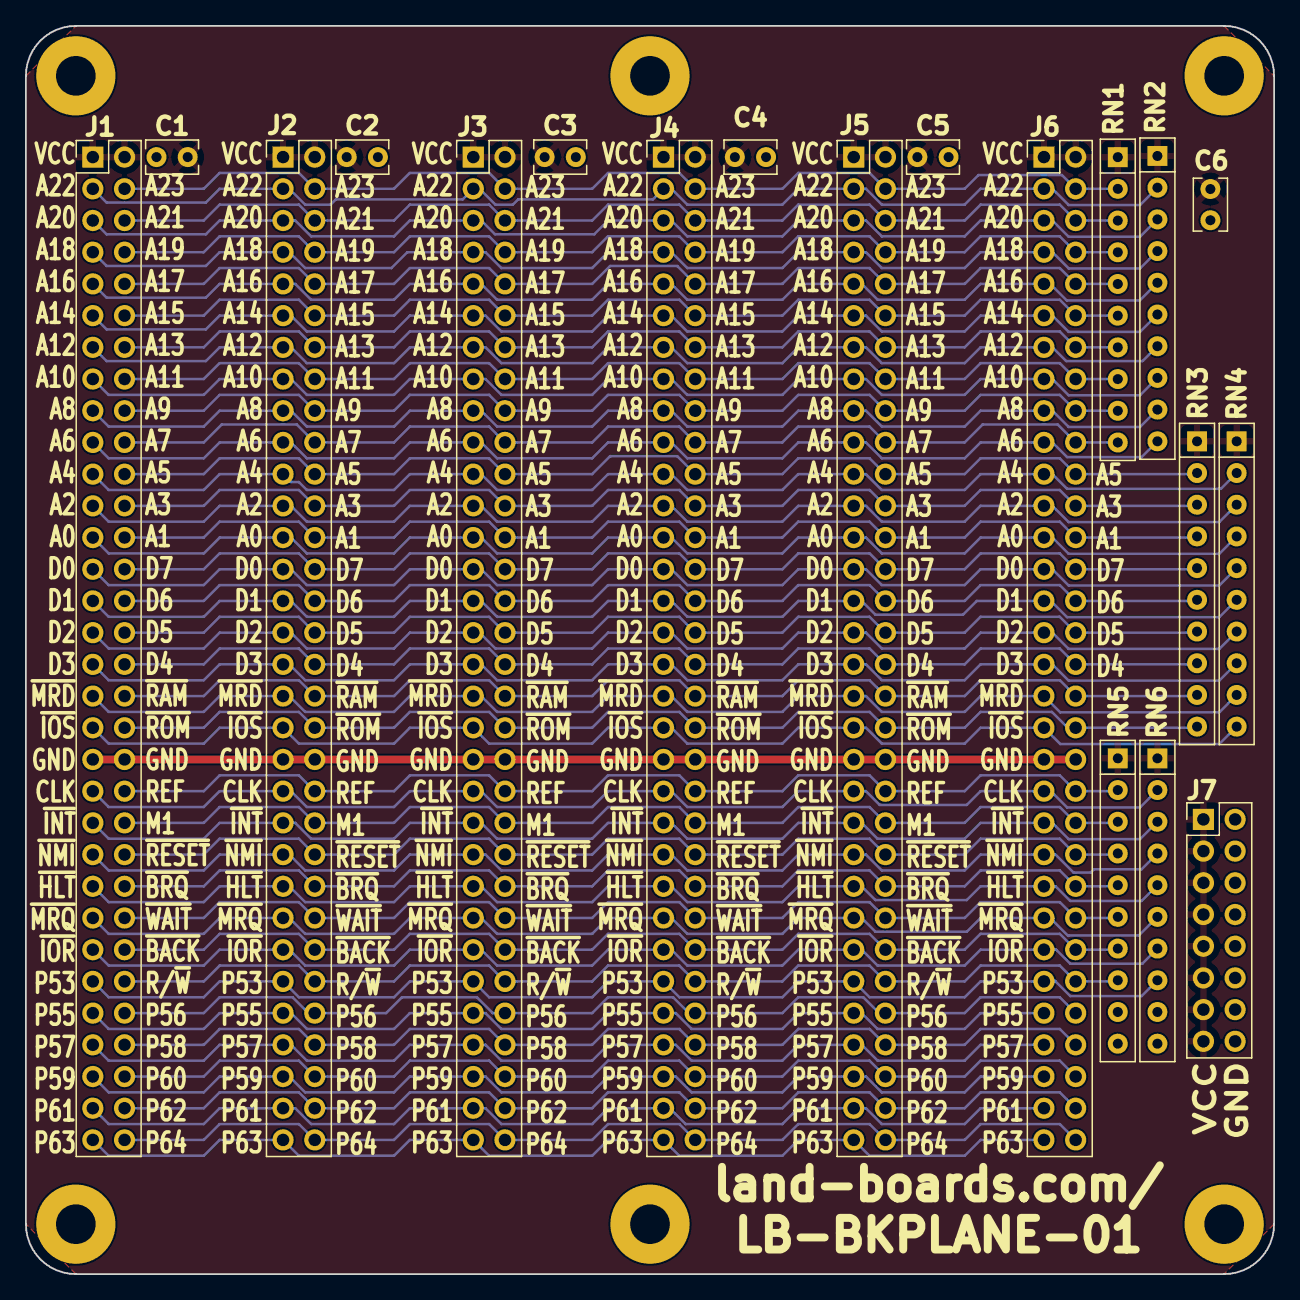
[picture p579: board LB-BKPLANE-01.kicad_pcb from above]

Board: 2 copper layers, 100.0 x 100.0 mm, 26 parts (0 on the bottom side), 62 nets.

Other parts of the board:
TEST: COUPON; TEST_BLK-REAR
