land-boards/lb-boards/RetroCPUs/LB-RETRO-SET/LB-LOGIC-01/LB-Logic-01.kicad_pcb

## KiCad design RetroCPUs/LB-RETRO-SET/LB-LOGIC-01/LB-Logic-01.kicad_pcb (2024-08-29)

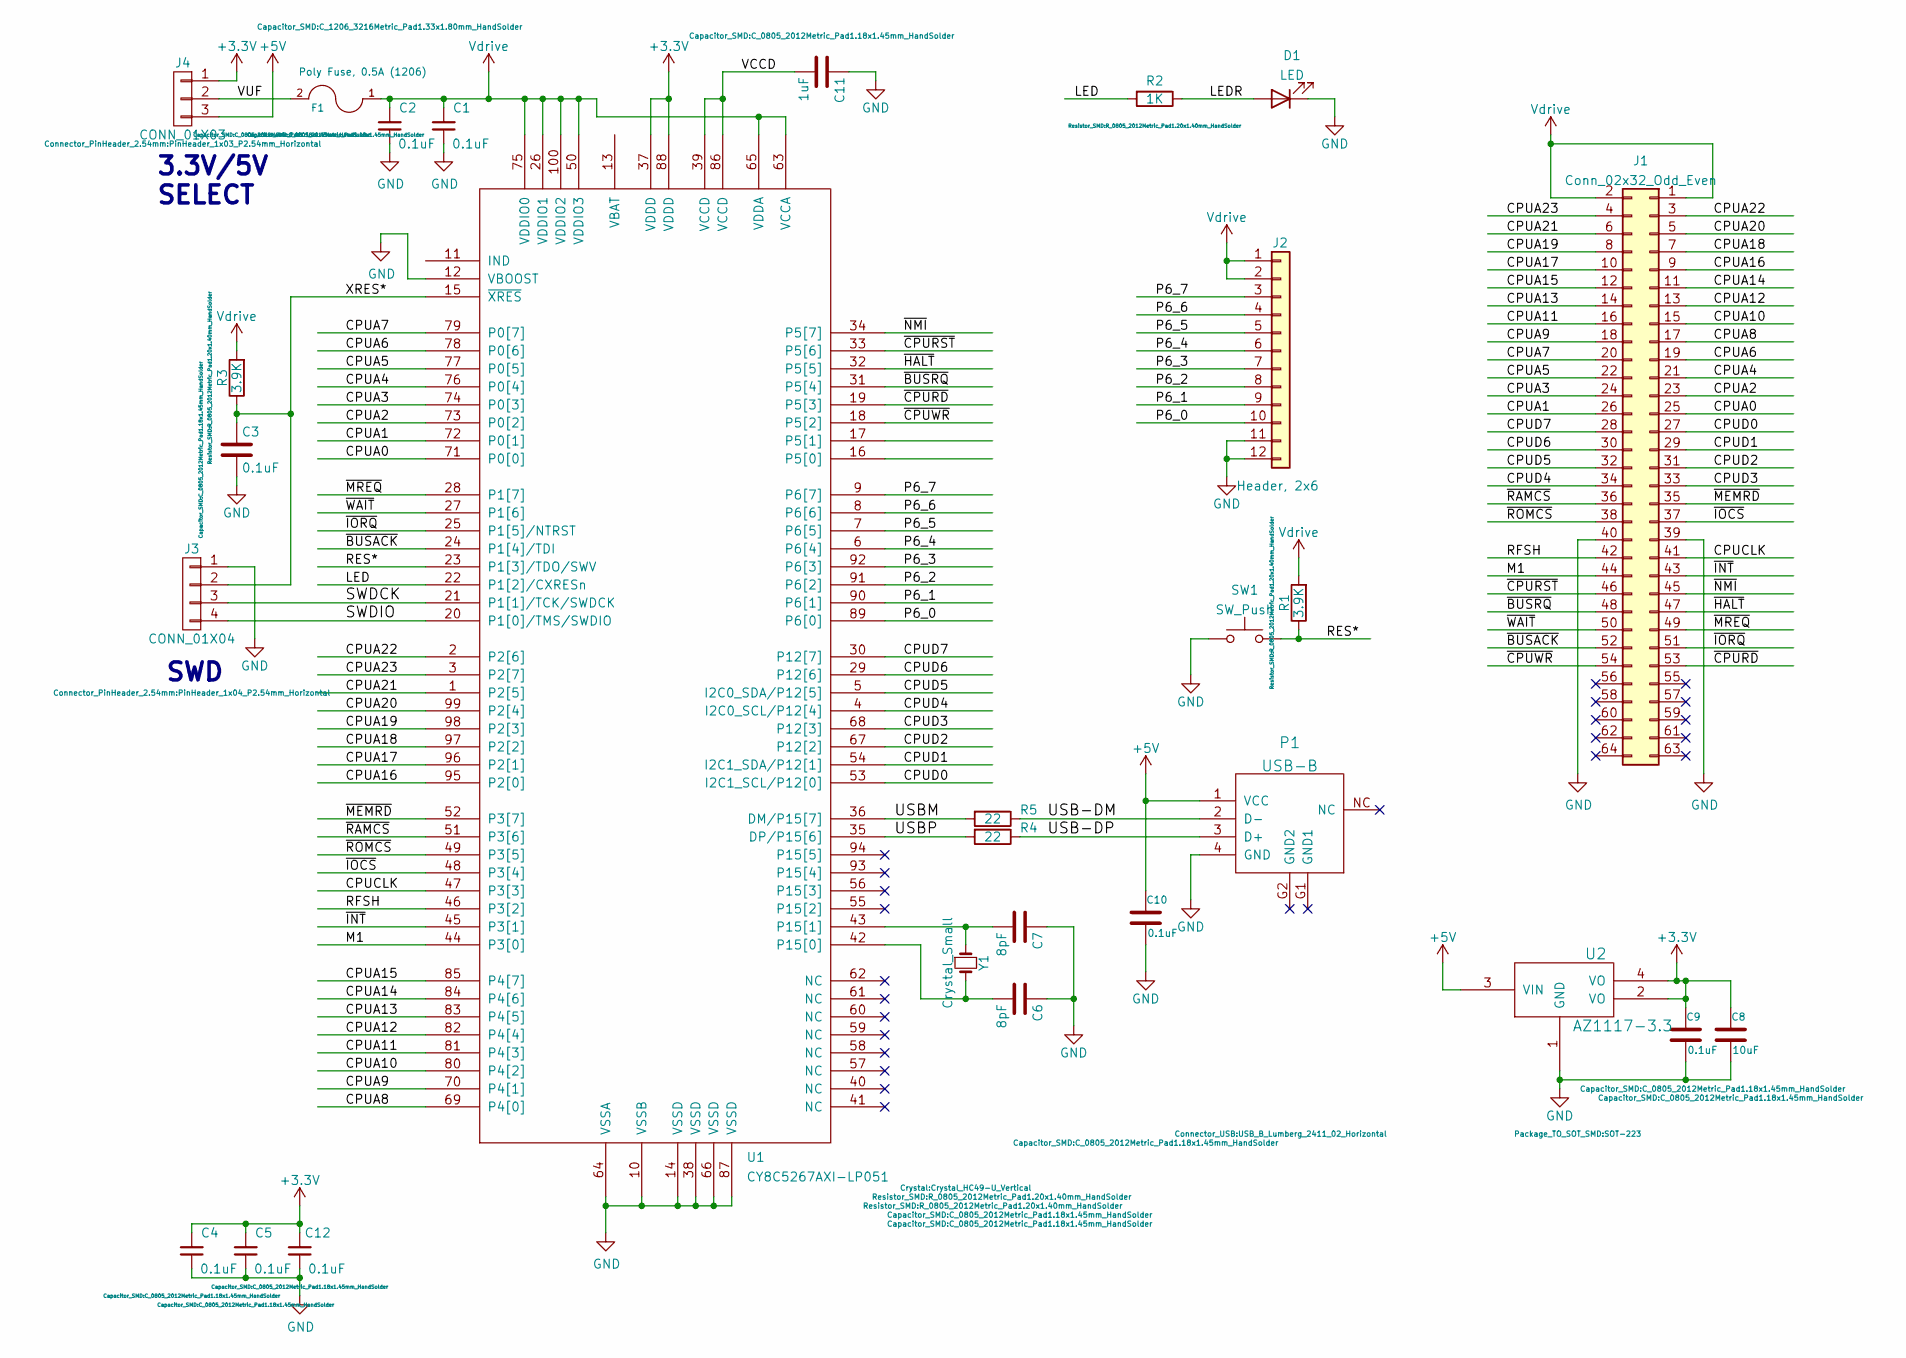
[picture p580: schematic LB-Logic-01.kicad_sch]

Parts:
C1, C2, C3, C4, C5, C9, C10, C12: 0.1uF; C_0805_2012Metric_Pad1.18x1.45mm_HandSolder
C6, C7: 8pF; C_0805_2012Metric_Pad1.18x1.45mm_HandSolder
C8: 10uF; C_0805_2012Metric_Pad1.18x1.45mm_HandSolder
C11: 1uF; C_0805_2012Metric_Pad1.18x1.45mm_HandSolder
D1: LED; LED_D3.0mm
F1: Poly Fuse, 0.5A (1206); C_1206_3216Metric_Pad1.33x1.80mm_HandSolder
J1: Conn_02x32_Odd_Even; PinHeader_2x32_P2.54mm_Horizontal-FLIPPED
J2: Header, 2x6; PinHeader_2x06_P2.54mm_Horizontal
J3: CONN_01X04; PinHeader_1x04_P2.54mm_Horizontal
J4: CONN_01X03; PinHeader_1x03_P2.54mm_Horizontal
P1: USB-B; USB_B_Lumberg_2411_02_Horizontal
R1, R3: 3.9K; R_0805_2012Metric_Pad1.20x1.40mm_HandSolder
R2: 1K; R_0805_2012Metric_Pad1.20x1.40mm_HandSolder
R4, R5: 22; R_0805_2012Metric_Pad1.20x1.40mm_HandSolder
SW1: SW_Push; SW_PUSH_6mm_H8.5mm
U1: CY8C5267AXI-LP051; TQFP-100_14x14mm_P0.5mm
U2: AZ1117-3.3; SOT-223
Y1: Crystal_Small; Crystal_HC49-U_Vertical

Connections:
+3V3: C4.2, C5.2, C8.1, C9.1, C12.2, J4.1, U1.37 (VDDD), U1.88 (VDDD), U2.2 (VO), U2.4 (VO)
+5V: C10.1, J4.3, P1.1 (VCC), U2.3 (VIN)
/CPUA0: J1.25, U1.71 (P0[0])
/CPUA1: J1.26, U1.72 (P0[1])
/CPUA2: J1.23, U1.73 (P0[2])
/CPUA3: J1.24, U1.74 (P0[3])
/CPUA4: J1.21, U1.76 (P0[4])
/CPUA5: J1.22, U1.77 (P0[5])
/CPUA6: J1.19, U1.78 (P0[6])
/CPUA7: J1.20, U1.79 (P0[7])
/CPUA8: J1.17, U1.69 (P4[0])
/CPUA9: J1.18, U1.70 (P4[1])
/CPUA10: J1.15, U1.80 (P4[2])
/CPUA11: J1.16, U1.81 (P4[3])
/CPUA12: J1.13, U1.82 (P4[4])
/CPUA13: J1.14, U1.83 (P4[5])
/CPUA14: J1.11, U1.84 (P4[6])
/CPUA15: J1.12, U1.85 (P4[7])
/CPUA16: J1.9, U1.95 (P2[0])
/CPUA17: J1.10, U1.96 (P2[1])
/CPUA18: J1.7, U1.97 (P2[2])
/CPUA19: J1.8, U1.98 (P2[3])
/CPUA20: J1.5, U1.99 (P2[4])
/CPUA21: J1.6, U1.1 (P2[5])
/CPUA22: J1.3, U1.2 (P2[6])
/CPUA23: J1.4, U1.3 (P2[7])
/CPUCLK: J1.41, U1.47 (P3[3])
/CPUD0: J1.27, U1.53 (I2C1_SCL/P12[0])
/CPUD1: J1.29, U1.54 (I2C1_SDA/P12[1])
/CPUD2: J1.31, U1.67 (P12[2])
/CPUD3: J1.33, U1.68 (P12[3])
/CPUD4: J1.34, U1.4 (I2C0_SCL/P12[4])
/CPUD5: J1.32, U1.5 (I2C0_SDA/P12[5])
/CPUD6: J1.30, U1.29 (P12[6])
/CPUD7: J1.28, U1.30 (P12[7])
/LED: R2.2, U1.22 (P1[2]/CXRESn)
/LEDR: D1.2 (A), R2.1
/M1: J1.44, U1.44 (P3[0])
/P6_0: J2.10, U1.89 (P6[0])
/P6_1: J2.9, U1.90 (P6[1])
/P6_2: J2.8, U1.91 (P6[2])
/P6_3: J2.7, U1.92 (P6[3])
/P6_4: J2.6, U1.6 (P6[4])
/P6_5: J2.5, U1.7 (P6[5])
/P6_6: J2.4, U1.8 (P6[6])
/P6_7: J2.3, U1.9 (P6[7])
/RES*: R1.1, SW1.2, U1.23 (P1[3]/TDO/SWV)
/RFSH: J1.42, U1.46 (P3[2])
/SWDCK: J3.3, U1.21 (P1[1]/TCK/SWDCK)
/SWDIO: J3.4, U1.20 (P1[0]/TMS/SWDIO)
/USB-DM: P1.2 (D-), R5.1
/USB-DP: P1.3 (D+), R4.1
/USBM: R5.2, U1.36 (DM/P15[7])
/USBP: R4.2, U1.35 (DP/P15[6])
/VCCD: C11.2, U1.39 (VCCD), U1.86 (VCCD)
/VUF: F1.2, J4.2
/XRES*: C3.1, J3.2, R3.1, U1.15 (~XRES)
/~BUSACK: J1.52, U1.24 (P1[4]/TDI)
/~BUSRQ: J1.48, U1.31 (P5[4])
/~CPURD: J1.53, U1.19 (P5[3])
/~CPURST: J1.46, U1.33 (P5[6])
/~CPUWR: J1.54, U1.18 (P5[2])
/~HALT: J1.47, U1.32 (P5[5])
/~INT: J1.43, U1.45 (P3[1])
/~IOCS: J1.37, U1.48 (P3[4])
/~IORQ: J1.51, U1.25 (P1[5]/NTRST)
/~MEMRD: J1.35, U1.52 (P3[7])
/~MREQ: J1.49, U1.28 (P1[7])
/~NMI: J1.45, U1.34 (P5[7])
/~RAMCS: J1.36, U1.51 (P3[6])
/~ROMCS: J1.38, U1.49 (P3[5])
/~WAIT: J1.50, U1.27 (P1[6])
GND: C1.1, C2.1, C3.2, C4.1, C5.1, C6.1, C7.1, C8.2, C9.2, C10.2, C11.1, C12.1, D1.1 (K), J1.39, J1.40, J2.11, J2.12, J3.1, P1.4 (GND), SW1.1, U1.10 (VSSB), U1.12 (VBOOST), U1.14 (VSSD), U1.38 (VSSD), U1.64 (VSSA), U1.66 (VSSD), U1.87 (VSSD), U2.1 (GND)
unnamed: C6.2, U1.42 (P15[0]), Y1.2
unnamed: C7.2, U1.43 (P15[1]), Y1.1
Vdrive: C1.2, C2.2, F1.1, J1.1, J1.2, J2.1, J2.2, R1.2, R3.2, U1.26 (VDDIO1), U1.50 (VDDIO3), U1.63 (VCCA), U1.65 (VDDA), U1.75 (VDDIO0), U1.100 (VDDIO2)

Notes on the sheet:
SWD
3.3V/5V SELECT

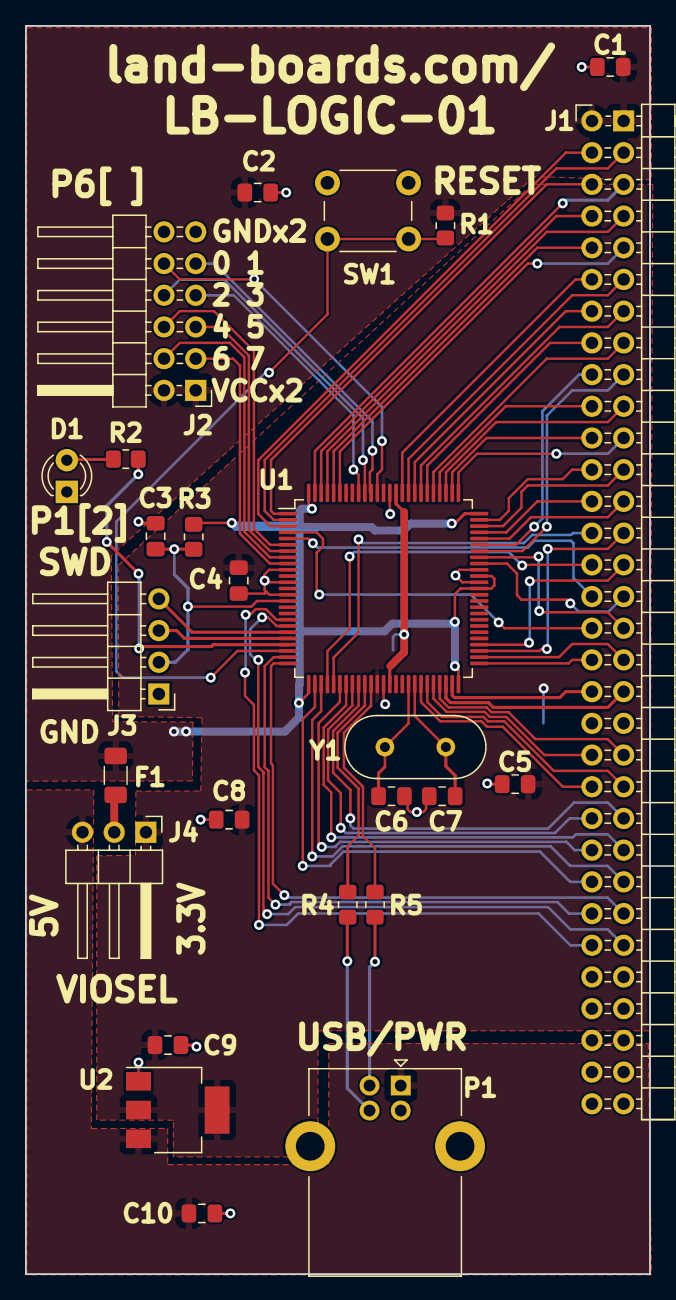
[picture p581: board LB-Logic-01.kicad_pcb from above]

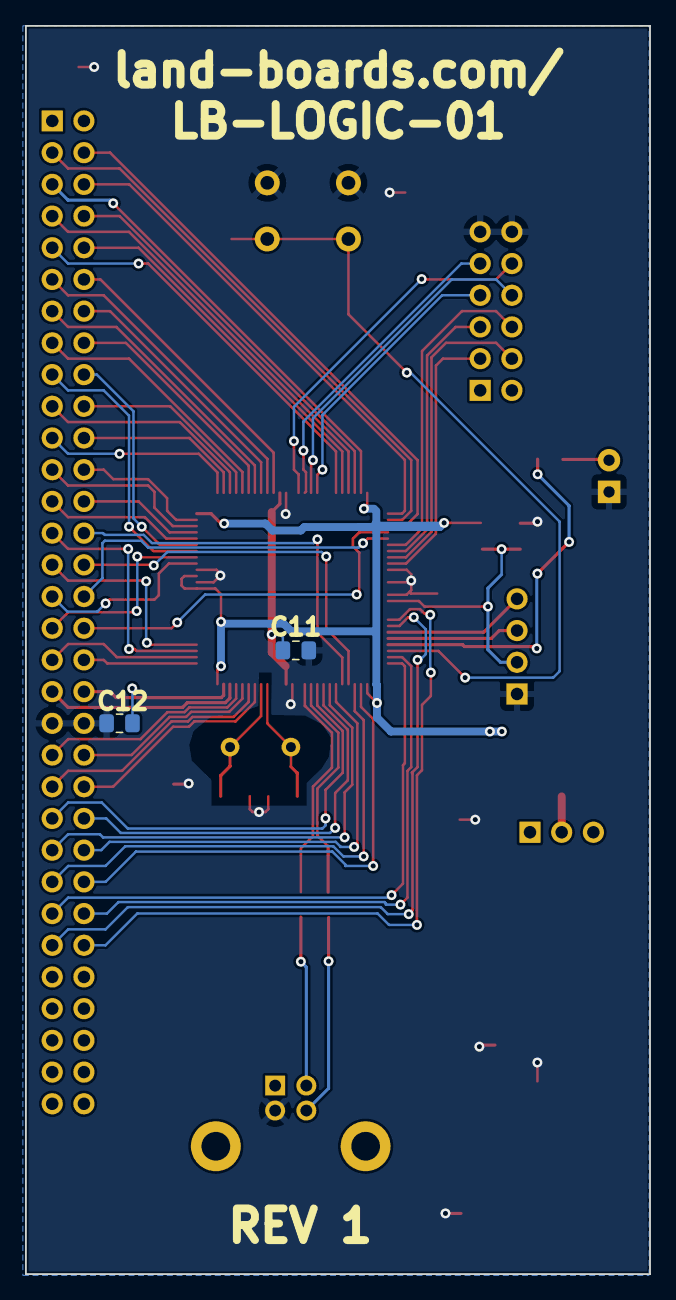
[picture p582: board LB-Logic-01.kicad_pcb from below]

Board: 2 copper layers, 50.0 x 100.0 mm, 28 parts (2 on the bottom side), 76 nets.
