land-boards/lb-boards/RetroCPUs/LB-RETRO-SET/LB-BKOUT-01/LB-BKOUT.kicad_pcb

## KiCad design RetroCPUs/LB-RETRO-SET/LB-BKOUT-01/LB-BKOUT.kicad_pcb (2024-08-29)

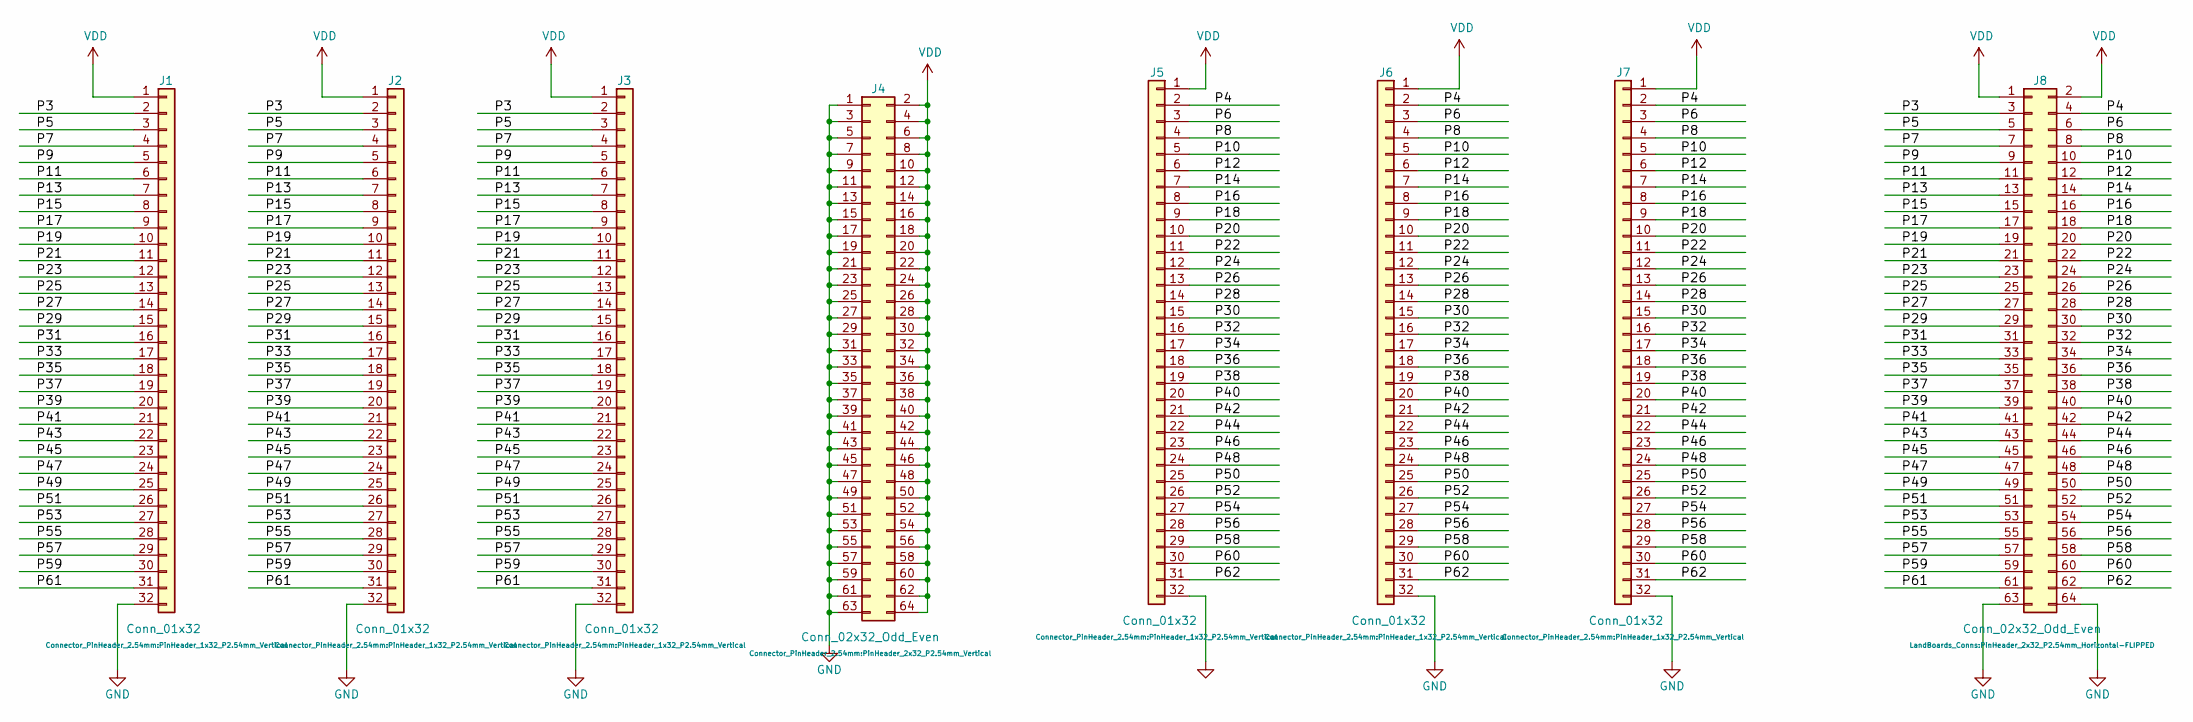
[picture p583: schematic LB-BKOUT.kicad_sch, ITX-65C816]

Parts:
J1, J2, J3, J5, J6, J7: Conn_01x32; PinHeader_1x32_P2.54mm_Vertical
J4: Conn_02x32_Odd_Even; PinHeader_2x32_P2.54mm_Vertical
J8: Conn_02x32_Odd_Even; PinHeader_2x32_P2.54mm_Horizontal-FLIPPED

Connections:
/P3: J1.2, J2.2, J3.2, J8.3
/P4: J5.2, J6.2, J7.2, J8.4
/P5: J1.3, J2.3, J3.3, J8.5
/P6: J5.3, J6.3, J7.3, J8.6
/P7: J1.4, J2.4, J3.4, J8.7
/P8: J5.4, J6.4, J7.4, J8.8
/P9: J1.5, J2.5, J3.5, J8.9
/P10: J5.5, J6.5, J7.5, J8.10
/P11: J1.6, J2.6, J3.6, J8.11
/P12: J5.6, J6.6, J7.6, J8.12
/P13: J1.7, J2.7, J3.7, J8.13
/P14: J5.7, J6.7, J7.7, J8.14
/P15: J1.8, J2.8, J3.8, J8.15
/P16: J5.8, J6.8, J7.8, J8.16
/P17: J1.9, J2.9, J3.9, J8.17
/P18: J5.9, J6.9, J7.9, J8.18
/P19: J1.10, J2.10, J3.10, J8.19
/P20: J5.10, J6.10, J7.10, J8.20
/P21: J1.11, J2.11, J3.11, J8.21
/P22: J5.11, J6.11, J7.11, J8.22
/P23: J1.12, J2.12, J3.12, J8.23
/P24: J5.12, J6.12, J7.12, J8.24
/P25: J1.13, J2.13, J3.13, J8.25
/P26: J5.13, J6.13, J7.13, J8.26
/P27: J1.14, J2.14, J3.14, J8.27
/P28: J5.14, J6.14, J7.14, J8.28
/P29: J1.15, J2.15, J3.15, J8.29
/P30: J5.15, J6.15, J7.15, J8.30
/P31: J1.16, J2.16, J3.16, J8.31
/P32: J5.16, J6.16, J7.16, J8.32
/P33: J1.17, J2.17, J3.17, J8.33
/P34: J5.17, J6.17, J7.17, J8.34
/P35: J1.18, J2.18, J3.18, J8.35
/P36: J5.18, J6.18, J7.18, J8.36
/P37: J1.19, J2.19, J3.19, J8.37
/P38: J5.19, J6.19, J7.19, J8.38
/P39: J1.20, J2.20, J3.20, J8.39
/P40: J5.20, J6.20, J7.20, J8.40
/P41: J1.21, J2.21, J3.21, J8.41
/P42: J5.21, J6.21, J7.21, J8.42
/P43: J1.22, J2.22, J3.22, J8.43
/P44: J5.22, J6.22, J7.22, J8.44
/P45: J1.23, J2.23, J3.23, J8.45
/P46: J5.23, J6.23, J7.23, J8.46
/P47: J1.24, J2.24, J3.24, J8.47
/P48: J5.24, J6.24, J7.24, J8.48
/P49: J1.25, J2.25, J3.25, J8.49
/P50: J5.25, J6.25, J7.25, J8.50
/P51: J1.26, J2.26, J3.26, J8.51
/P52: J5.26, J6.26, J7.26, J8.52
/P53: J1.27, J2.27, J3.27, J8.53
/P54: J5.27, J6.27, J7.27, J8.54
/P55: J1.28, J2.28, J3.28, J8.55
/P56: J5.28, J6.28, J7.28, J8.56
/P57: J1.29, J2.29, J3.29, J8.57
/P58: J5.29, J6.29, J7.29, J8.58
/P59: J1.30, J2.30, J3.30, J8.59
/P60: J5.30, J6.30, J7.30, J8.60
/P61: J1.31, J2.31, J3.31, J8.61
/P62: J5.31, J6.31, J7.31, J8.62
GND: J1.32, J2.32, J3.32, J4.1, J4.3, J4.5, J4.7, J4.9, J4.11, J4.13, J4.15, J4.17, J4.19, J4.21, J4.23, J4.25, J4.27, J4.29, J4.31, J4.33, J4.35, J4.37, J4.39, J4.41, J4.43, J4.45, J4.47, J4.49, J4.51, J4.53, J4.55, J4.57, J4.59, J4.61, J4.63, J5.32, J6.32, J7.32, J8.63, J8.64
VDD: J1.1, J2.1, J3.1, J4.2, J4.4, J4.6, J4.8, J4.10, J4.12, J4.14, J4.16, J4.18, J4.20, J4.22, J4.24, J4.26, J4.28, J4.30, J4.32, J4.34, J4.36, J4.38, J4.40, J4.42, J4.44, J4.46, J4.48, J4.50, J4.52, J4.54, J4.56, J4.58, J4.60, J4.62, J4.64, J5.1, J6.1, J7.1, J8.1, J8.2

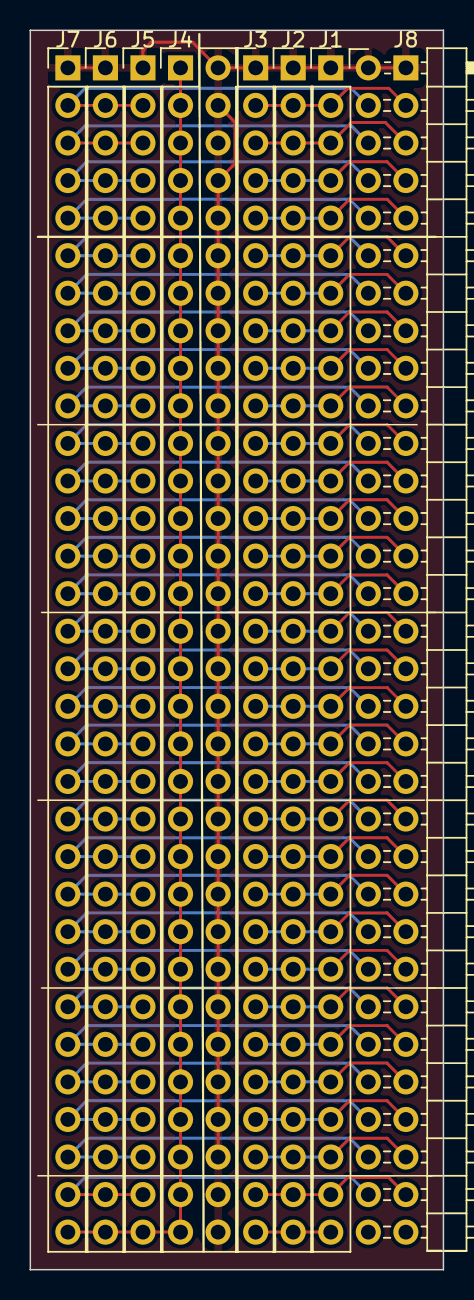
[picture p584: board LB-BKOUT.kicad_pcb from above]

Board: 2 copper layers, 27.9 x 83.8 mm, 8 parts (0 on the bottom side), 62 nets.
