land-boards/lb-boards/ESP32/ESP32-TERM/ESP32-TERM.kicad_pcb

## KiCad design ESP32/ESP32-TERM/ESP32-TERM.kicad_pcb (2024-08-18)

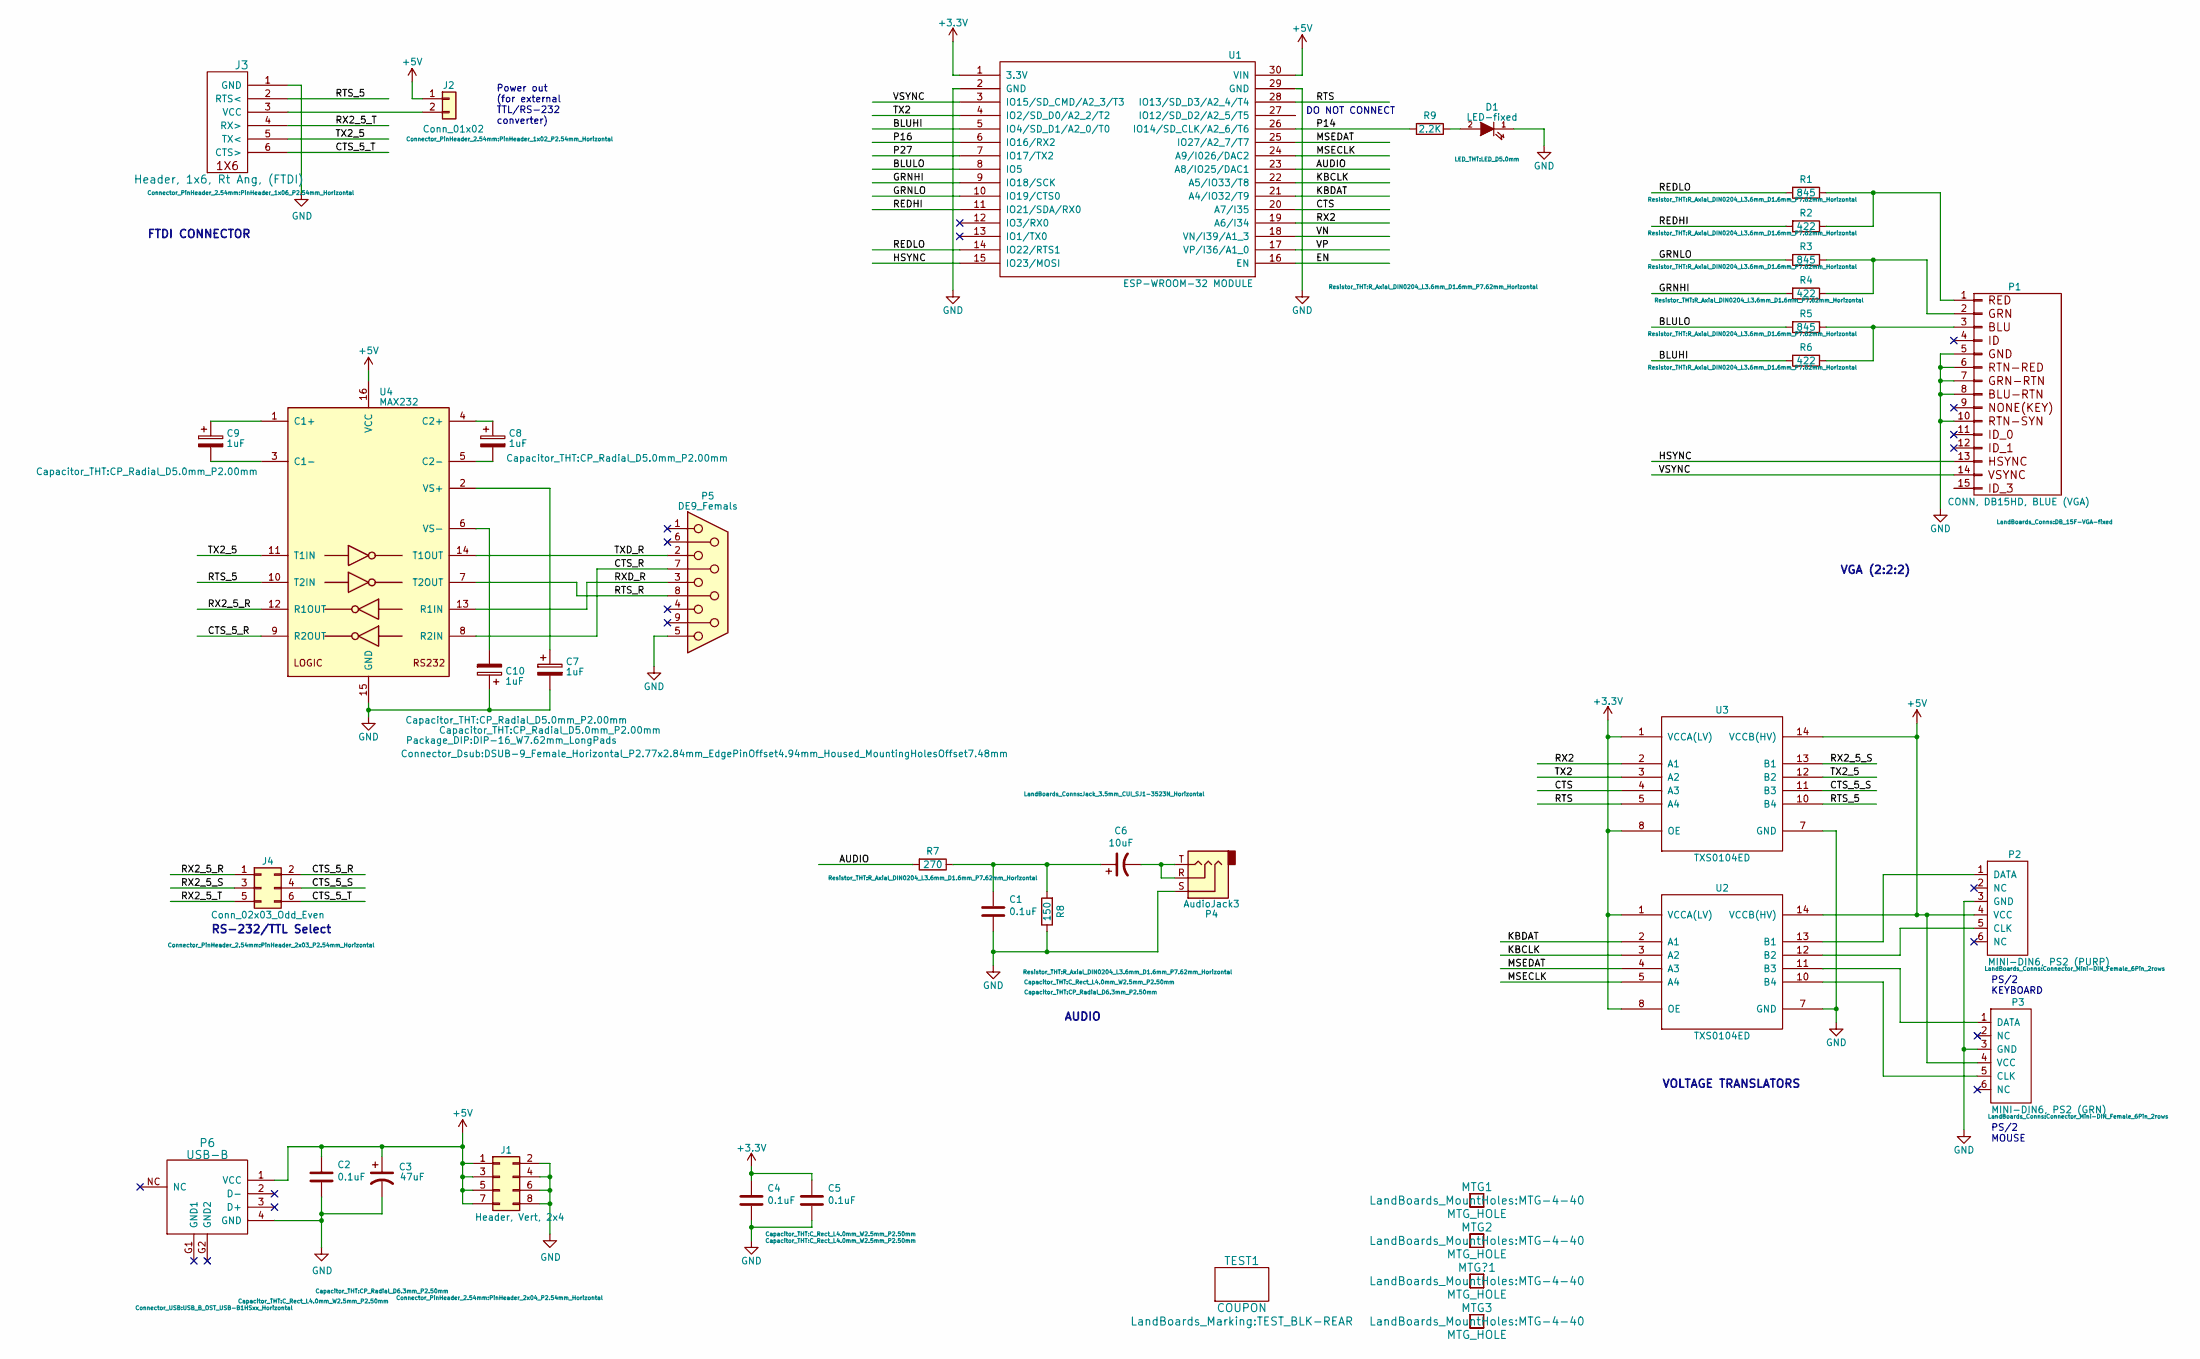
[picture p585: schematic ESP32-TERM.kicad_sch]

Parts:
C1, C2, C4, C5: 0.1uF; C_Rect_L4.0mm_W2.5mm_P2.50mm
C3: 47uF; CP_Radial_D6.3mm_P2.50mm
C6: 10uF; CP_Radial_D6.3mm_P2.50mm
C7, C8, C9, C10: 1uF; CP_Radial_D5.0mm_P2.00mm
D1: LED-fixed; LED_D5.0mm
J1: Header, Vert, 2x4; PinHeader_2x04_P2.54mm_Horizontal
J2: Conn_01x02; PinHeader_1x02_P2.54mm_Horizontal
J3: Header, 1x6, Rt Ang, (FTDI); PinHeader_1x06_P2.54mm_Horizontal
J4: Conn_02x03_Odd_Even; PinHeader_2x03_P2.54mm_Horizontal
MTG1, MTG2, MTG3: MTG_HOLE; MTG-4-40
MTG?1: MTG_HOLE; MTG-4-40
P1: CONN, DB15HD, BLUE (VGA); DB_15F-VGA-fixed
P2: MINI-DIN6, PS2 (PURP); Connector_Mini-DIN_Female_6Pin_2rows
P3: MINI-DIN6, PS2 (GRN); Connector_Mini-DIN_Female_6Pin_2rows
P4: AudioJack3; Jack_3.5mm_CUI_SJ1-3523N_Horizontal
P5: DE9_Femals; DSUB-9_Female_Horizontal_P2.77x2.84mm_EdgePinOffset4.94mm_H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
P6: USB-B; USB_B_OST_USB-B1HSxx_Horizontal
R1, R3, R5: 845; R_Axial_DIN0204_L3.6mm_D1.6mm_P7.62mm_Horizontal
R2, R4, R6: 422; R_Axial_DIN0204_L3.6mm_D1.6mm_P7.62mm_Horizontal
R7: 270; R_Axial_DIN0204_L3.6mm_D1.6mm_P7.62mm_Horizontal
R8: 150; R_Axial_DIN0204_L3.6mm_D1.6mm_P7.62mm_Horizontal
R9: 2.2K; R_Axial_DIN0204_L3.6mm_D1.6mm_P7.62mm_Horizontal
TEST1: COUPON; TEST_BLK-REAR
U1: ESP-WROOM-32 MODULE; ESP32_EXP
U2, U3: TXS0104ED; SOIC-14_3.9x8.7mm_P1.27mm
U4: MAX232; DIP-16_W7.62mm_LongPads

Connections:
+3V3: C4.1, C5.1, U1.1 (3.3V), U2.1 (VCCA(LV)), U2.8 (OE), U3.1 (VCCA(LV)), U3.8 (OE)
+5V: C2.1, C3.1, J1.1, J1.3, J1.5, J1.7, J2.1, P2.4 (VCC), P3.4 (VCC), P6.1 (VCC), U1.30 (VIN), U2.14 (VCCB(HV)), U3.14 (VCCB(HV)), U4.16 (VCC)
/AUDIO: R7.2, U1.23 (A8/IO25/DAC1)
/BLUHI: R6.2, U1.5 (IO4/SD_D1/A2_0/T0)
/BLULO: R5.2, U1.8 (IO5)
/CTS: U1.20 (A7/I35), U3.4 (A3)
/CTS_5_R: J4.2, U4.9 (R2OUT)
/CTS_5_S: J4.4, U3.11 (B3)
/CTS_5_T: J3.6 (CTS>), J4.6
/CTS_R: P5.7, U4.8 (R2IN)
/EN: U1.16 (EN)
/GRNHI: R4.2, U1.9 (IO18/SCK)
/GRNLO: R3.2, U1.10 (IO19/CTS0)
/HSYNC: P1.13, U1.15 (IO23/MOSI)
/KBCLK: U1.22 (A5/IO33/T8), U2.3 (A2)
/KBDAT: U1.21 (A4/IO32/T9), U2.2 (A1)
/MSECLK: U1.24 (A9/I026/DAC2), U2.5 (A4)
/MSEDAT: U1.25 (IO27/A2_7/T7), U2.4 (A3)
/P14: R9.2, U1.26 (IO14/SD_CLK/A2_6/T6)
/P16: U1.6 (IO16/RX2)
/P27: U1.7 (IO17/TX2)
/REDHI: R2.2, U1.11 (IO21/SDA/RX0)
/REDLO: R1.2, U1.14 (IO22/RTS1)
/RTS: U1.28 (IO13/SD_D3/A2_4/T4), U3.5 (A4)
/RTS_5: J3.2 (RTS<), U3.10 (B4), U4.10 (T2IN)
/RTS_R: P5.8, U4.7 (T2OUT)
/RX2: U1.19 (A6/I34), U3.2 (A1)
/RX2_5_R: J4.1, U4.12 (R1OUT)
/RX2_5_S: J4.3, U3.13 (B1)
/RX2_5_T: J3.4 (RX>), J4.5
/RXD_R: P5.3, U4.13 (R1IN)
/TX2: U1.4 (IO2/SD_D0/A2_2/T2), U3.3 (A2)
/TX2_5: J3.5 (TX<), U3.12 (B2), U4.11 (T1IN)
/TXD_R: P5.2, U4.14 (T1OUT)
/VN: U1.18 (VN/I39/A1_3)
/VP: U1.17 (VP/I36/A1_0)
/VSYNC: P1.14, U1.3 (IO15/SD_CMD/A2_3/T3)
GND: C1.2, C2.2, C3.2, C4.2, C5.2, C7.2, C10.1, D1.1 (K), J1.2, J1.4, J1.6, J1.8, J3.1 (GND), P1.5, P1.6, P1.7, P1.8, P1.10, P2.3 (GND), P3.3 (GND), P4.S, P5.5, P6.4 (GND), R8.1, U1.2 (GND), U1.29 (GND), U2.7 (GND), U3.7 (GND), U4.15 (GND)
unnamed: C1.1, C6.1, R7.1, R8.2
unnamed: C6.2, P4.R, P4.T
unnamed: D1.2 (A), R9.1
unnamed: J2.2, J3.3 (VCC)
unnamed: P1.1, R1.1, R2.1
unnamed: P1.2, R3.1, R4.1
unnamed: P1.3, R5.1, R6.1
unnamed: P2.5 (CLK), U2.12 (B2)
unnamed: P2.1 (DATA), U2.13 (B1)
unnamed: P3.5 (CLK), U2.10 (B4)
unnamed: P3.1 (DATA), U2.11 (B3)
unnamed: C9.1, U4.1 (C1+)
unnamed: C9.2, U4.3 (C1-)
unnamed: C8.1, U4.4 (C2+)
unnamed: C8.2, U4.5 (C2-)
unnamed: C7.1, U4.2 (VS+)
unnamed: C10.2, U4.6 (VS-)

Notes on the sheet:
VOLTAGE TRANSLATORS
AUDIO
Power out (for external TTL/RS-232 converter)
PS/2 KEYBOARD
DO NOT CONNECT
VGA (2:2:2)
PS/2 MOUSE
FTDI CONNECTOR
RS-232/TTL Select

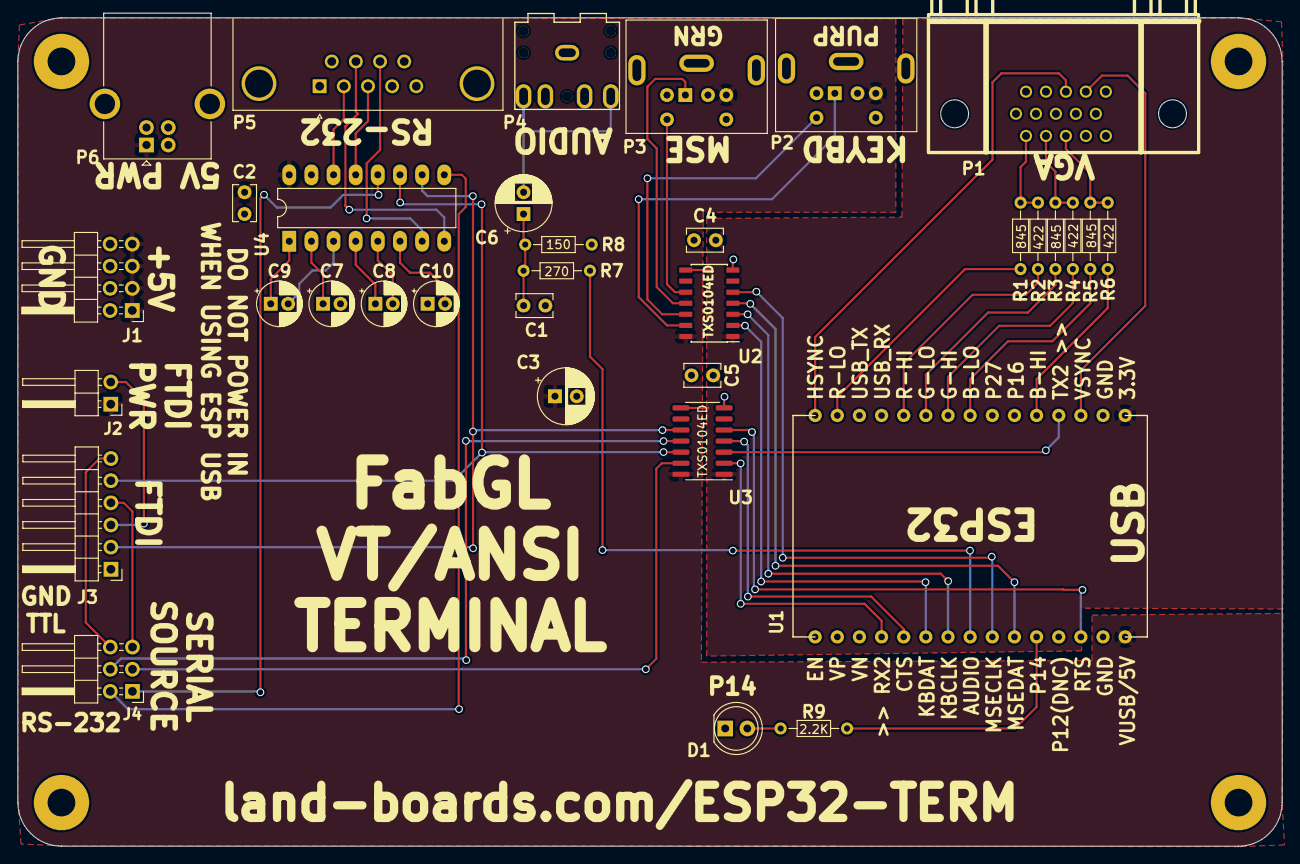
[picture p586: board ESP32-TERM.kicad_pcb from above]

Board: 2 copper layers, 145.0 x 95.0 mm, 39 parts (0 on the bottom side), 50 nets.

Other parts of the board:
TEST: COUPON; TEST_BLK-REAR
