land-boards/lb-boards/ESP32/ESP32-VGA/ESP32-VGA.kicad_pcb

## KiCad design ESP32/ESP32-VGA/ESP32-VGA.kicad_pcb (2024-08-18)

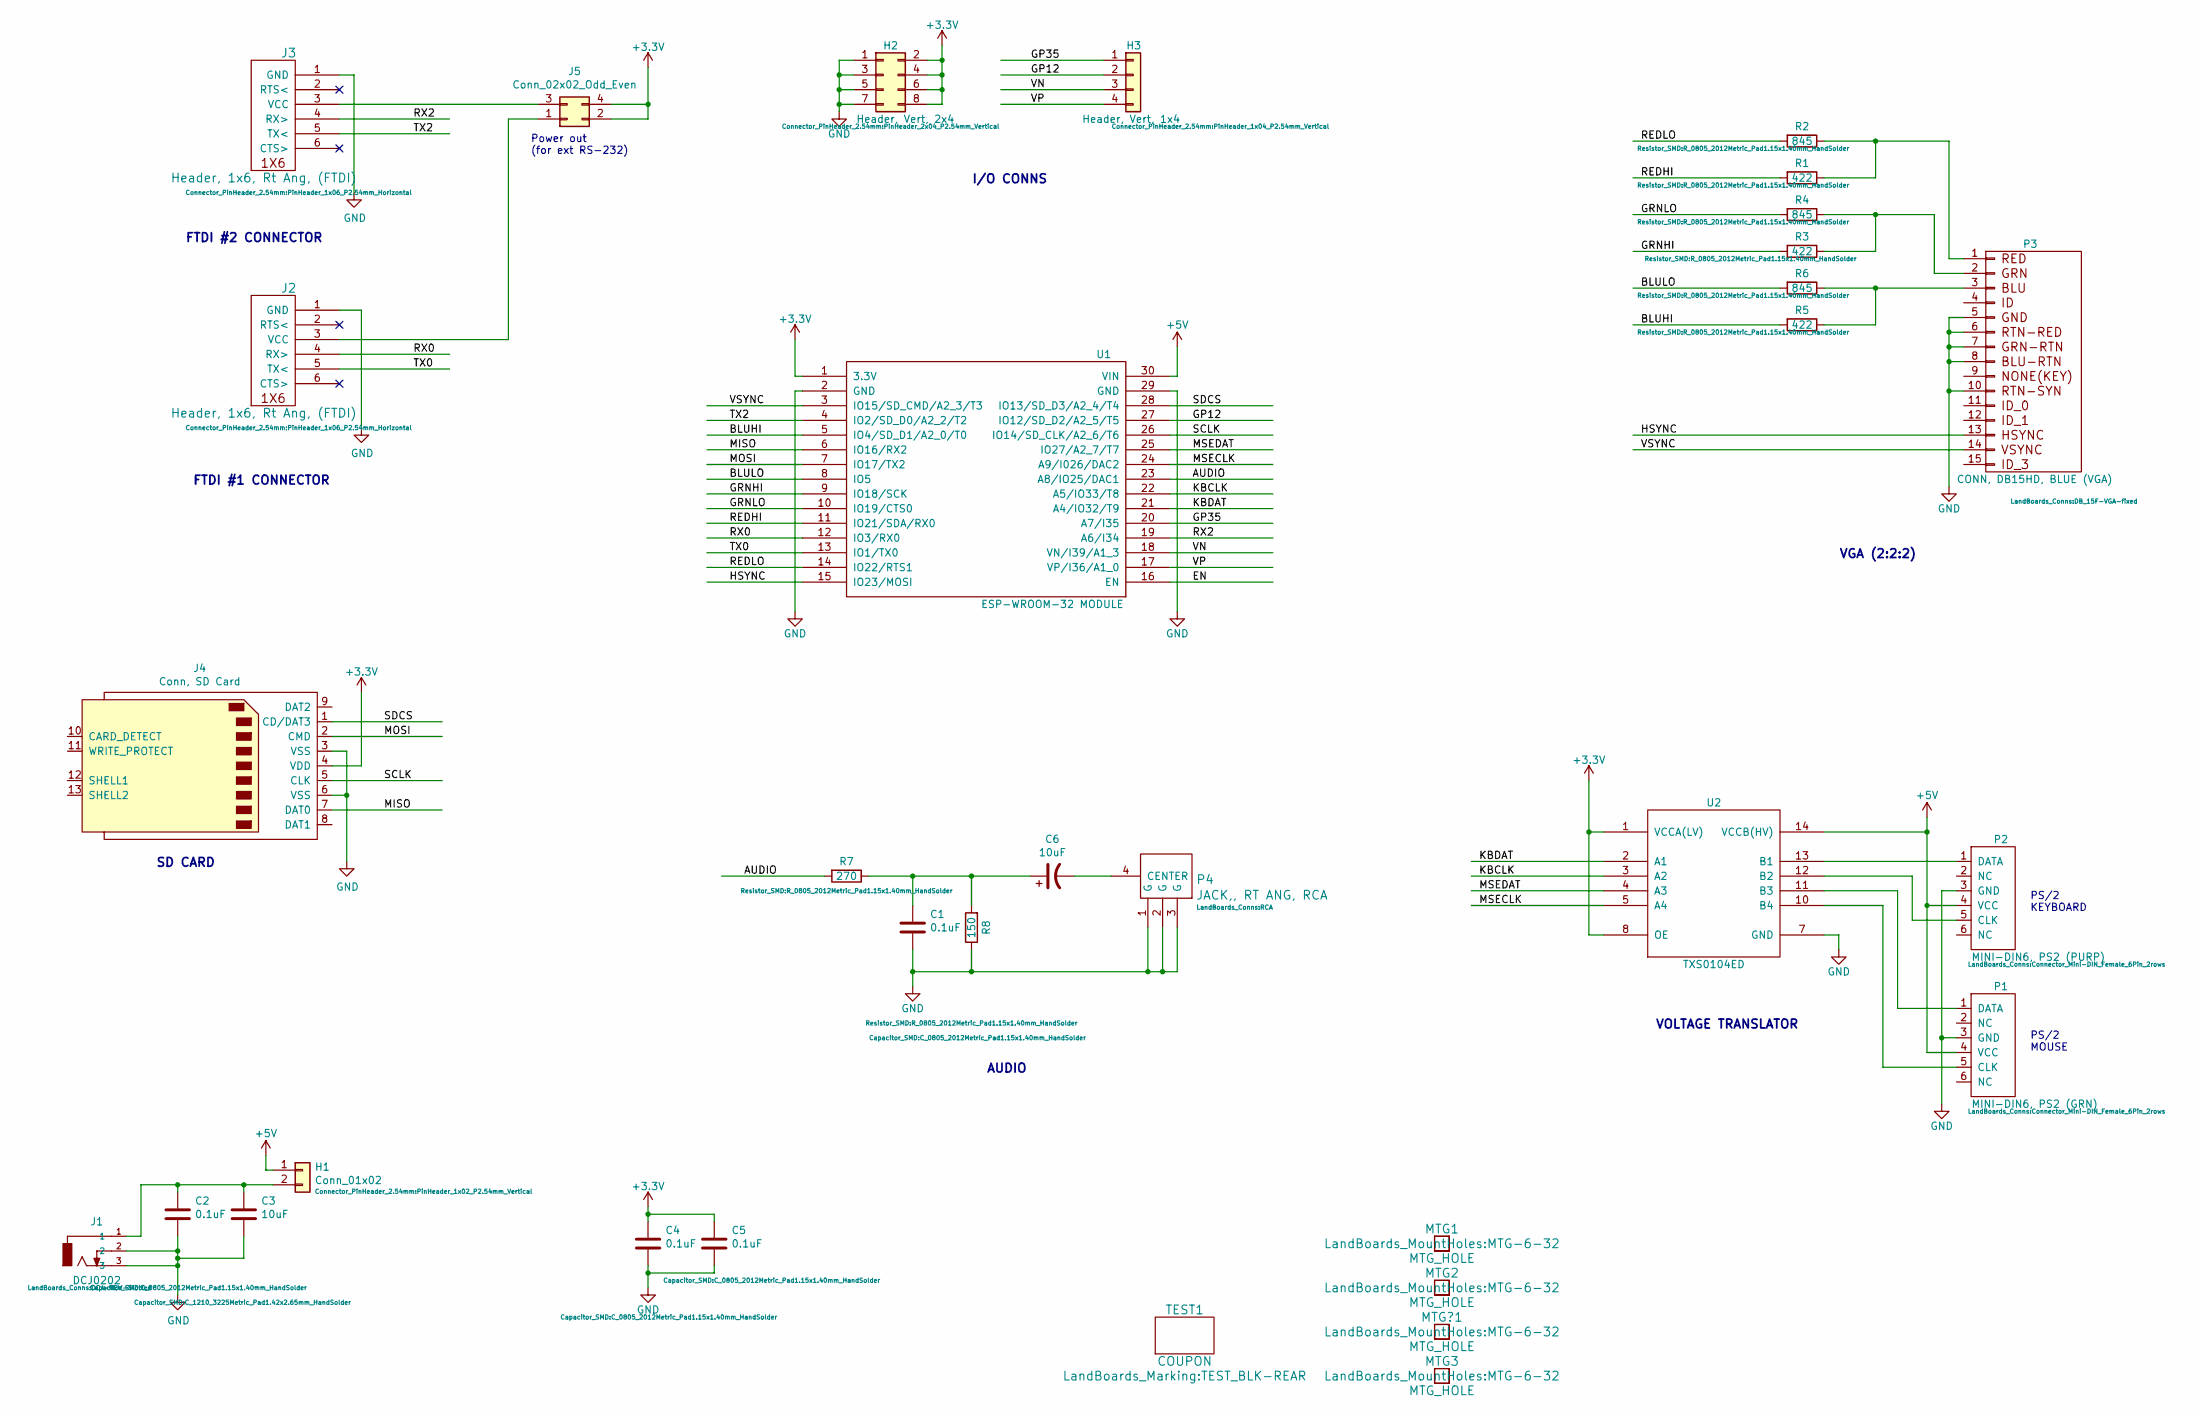
[picture p587: schematic ESP32-VGA.kicad_sch]

Parts:
C1, C2, C4, C5: 0.1uF; C_0805_2012Metric_Pad1.15x1.40mm_HandSolder
C3, C6: 10uF; C_1210_3225Metric_Pad1.42x2.65mm_HandSolder
H1: Conn_01x02; PinHeader_1x02_P2.54mm_Vertical
H2: Header, Vert, 2x4; PinHeader_2x04_P2.54mm_Vertical
H3: Header, Vert, 1x4; PinHeader_1x04_P2.54mm_Vertical
J1: DCJ0202; DCJ-NEW-Slotted
J2, J3: Header, 1x6, Rt Ang, (FTDI); PinHeader_1x06_P2.54mm_Horizontal
J4: Conn, SD Card; SD_CARD
J5: Conn_02x02_Odd_Even; PinHeader_2x02_P2.54mm_Vertical
MTG1, MTG2, MTG3: MTG_HOLE; MTG-6-32
MTG?1: MTG_HOLE; MTG-6-32
P1: MINI-DIN6, PS2 (GRN); Connector_Mini-DIN_Female_6Pin_2rows
P2: MINI-DIN6, PS2 (PURP); Connector_Mini-DIN_Female_6Pin_2rows
P3: CONN, DB15HD, BLUE (VGA); DB_15F-VGA-fixed
P4: JACK,, RT ANG, RCA; RCA
R1, R3, R5: 422; R_0805_2012Metric_Pad1.15x1.40mm_HandSolder
R2, R4, R6: 845; R_0805_2012Metric_Pad1.15x1.40mm_HandSolder
R7: 270; R_0805_2012Metric_Pad1.15x1.40mm_HandSolder
R8: 150; R_0805_2012Metric_Pad1.15x1.40mm_HandSolder
TEST1: COUPON; TEST_BLK-REAR
U1: ESP-WROOM-32 MODULE; ESP32_EXP
U2: TXS0104ED; SOIC-14_3.9x8.7mm_P1.27mm

Connections:
+3V3: C4.1, C5.1, H2.2, H2.4, H2.6, H2.8, J4.4 (VDD), J5.2, J5.4, U1.1 (3.3V), U2.1 (VCCA(LV)), U2.8 (OE)
+5V: H1.1, P1.4 (VCC), P2.4 (VCC), U1.30 (VIN), U2.14 (VCCB(HV))
/AUDIO: R7.2, U1.23 (A8/IO25/DAC1)
/BLUHI: R5.2, U1.5 (IO4/SD_D1/A2_0/T0)
/BLULO: R6.2, U1.8 (IO5)
/GP12: H3.2, U1.27 (IO12/SD_D2/A2_5/T5)
/GP35: H3.1, U1.20 (A7/I35)
/GRNHI: R3.2, U1.9 (IO18/SCK)
/GRNLO: R4.2, U1.10 (IO19/CTS0)
/HSYNC: P3.13, U1.15 (IO23/MOSI)
/KBCLK: U1.22 (A5/IO33/T8), U2.3 (A2)
/KBDAT: U1.21 (A4/IO32/T9), U2.2 (A1)
/MISO: J4.7 (DAT0), U1.6 (IO16/RX2)
/MOSI: J4.2 (CMD), U1.7 (IO17/TX2)
/MSECLK: U1.24 (A9/I026/DAC2), U2.5 (A4)
/MSEDAT: U1.25 (IO27/A2_7/T7), U2.4 (A3)
/REDHI: R1.2, U1.11 (IO21/SDA/RX0)
/REDLO: R2.2, U1.14 (IO22/RTS1)
/RX0: J2.4 (RX>), U1.12 (IO3/RX0)
/RX2: J3.4 (RX>), U1.19 (A6/I34)
/SCLK: J4.5 (CLK), U1.26 (IO14/SD_CLK/A2_6/T6)
/SDCS: J4.1 (CD/DAT3), U1.28 (IO13/SD_D3/A2_4/T4)
/TX0: J2.5 (TX<), U1.13 (IO1/TX0)
/TX2: J3.5 (TX<), U1.4 (IO2/SD_D0/A2_2/T2)
/VN: H3.3, U1.18 (VN/I39/A1_3)
/VP: H3.4, U1.17 (VP/I36/A1_0)
/VSYNC: P3.14, U1.3 (IO15/SD_CMD/A2_3/T3)
GND: C1.2, C2.2, C3.2, C4.2, C5.2, H2.1, H2.3, H2.5, H2.7, J1.2, J1.3, J2.1 (GND), J3.1 (GND), J4.3 (VSS), J4.6 (VSS), P1.3 (GND), P2.3 (GND), P3.5, P3.6, P3.7, P3.8, P3.10, P4.1 (G), P4.2 (G), P4.3 (G), R8.1, U1.2 (GND), U1.29 (GND), U2.7 (GND)
unnamed: C1.1, C6.1, R7.1, R8.2
unnamed: C2.1, C3.1, H1.2, J1.1
unnamed: C6.2, P4.4 (CENTER)
unnamed: J2.3 (VCC), J5.1
unnamed: J3.3 (VCC), J5.3
unnamed: P1.1 (DATA), U2.11 (B3)
unnamed: P1.5 (CLK), U2.10 (B4)
unnamed: P2.1 (DATA), U2.13 (B1)
unnamed: P2.5 (CLK), U2.12 (B2)
unnamed: P3.1, R1.1, R2.1
unnamed: P3.2, R3.1, R4.1
unnamed: P3.3, R5.1, R6.1

Notes on the sheet:
VOLTAGE TRANSLATOR
AUDIO
PS/2 MOUSE
Power out (for ext RS-232)
PS/2 KEYBOARD
FTDI #1 CONNECTOR
I/O CONNS
VGA (2:2:2)
SD CARD
FTDI #2 CONNECTOR

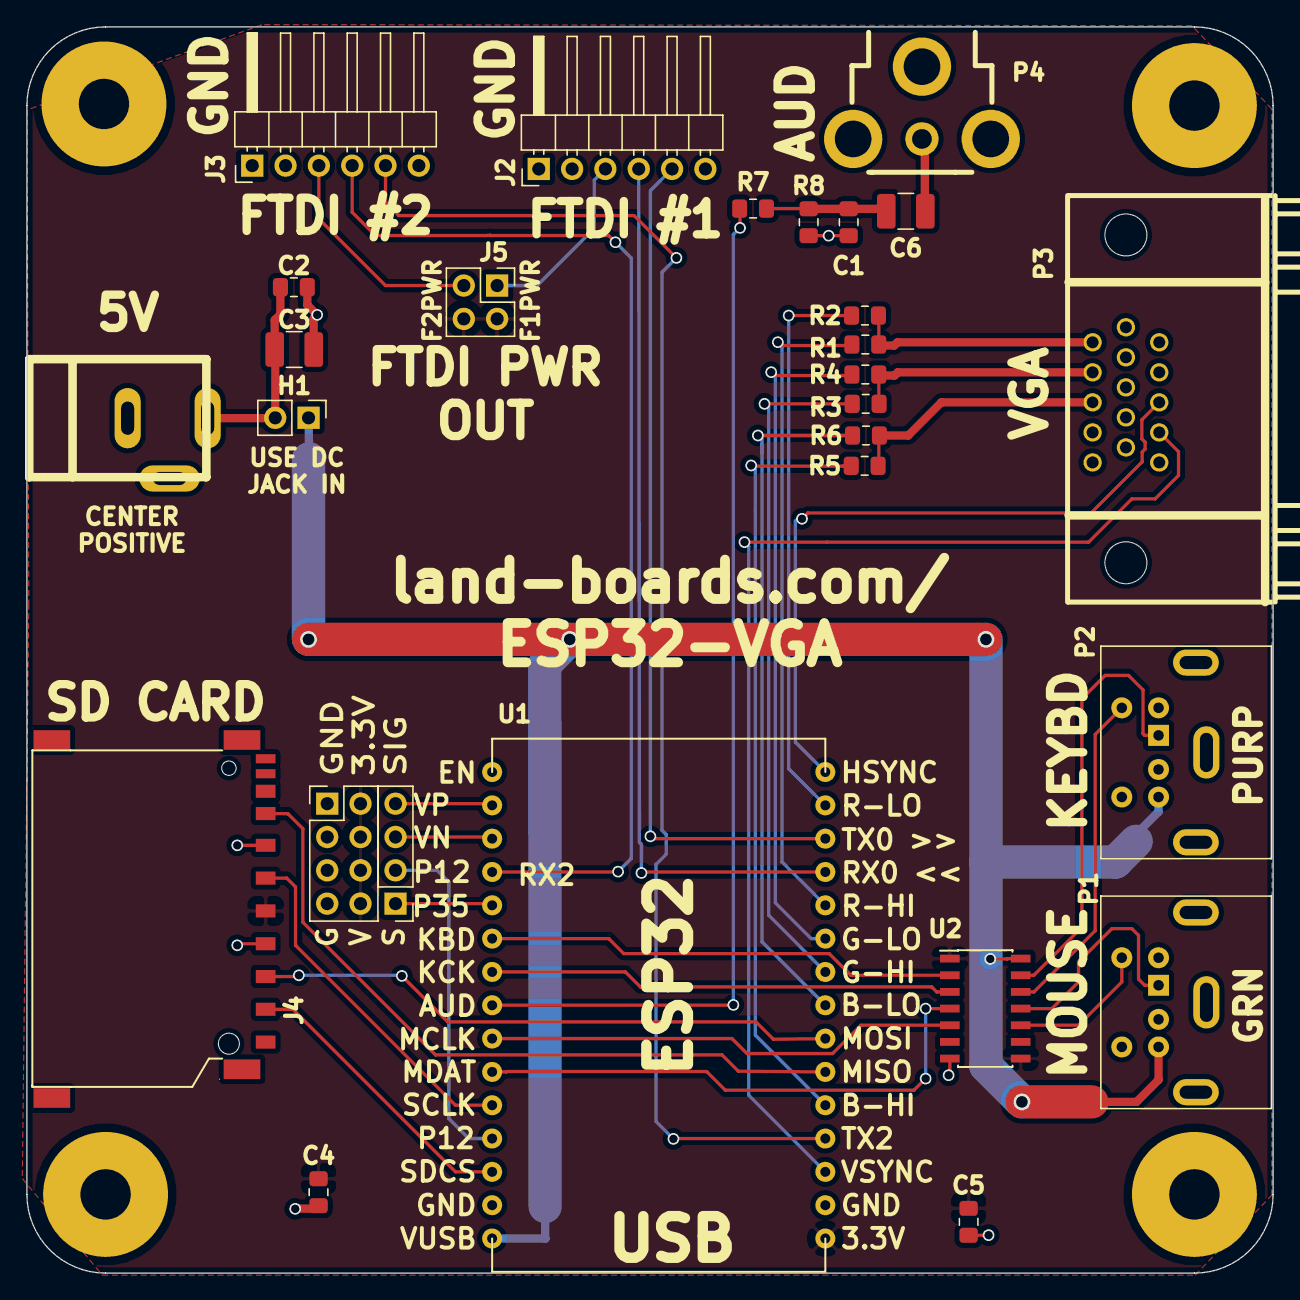
[picture p588: board ESP32-VGA.kicad_pcb from above]

Board: 2 copper layers, 95.0 x 95.0 mm, 33 parts (0 on the bottom side), 40 nets.

Other parts of the board:
TEST: COUPON; TEST_BLK-REAR
