land-boards/lb-boards/RetroCPUs/PDP-8/LEDS-SW12.kicad_pcb

## KiCad design RetroCPUs/PDP-8/LEDS-SW12.kicad_pcb (2024-06-27)

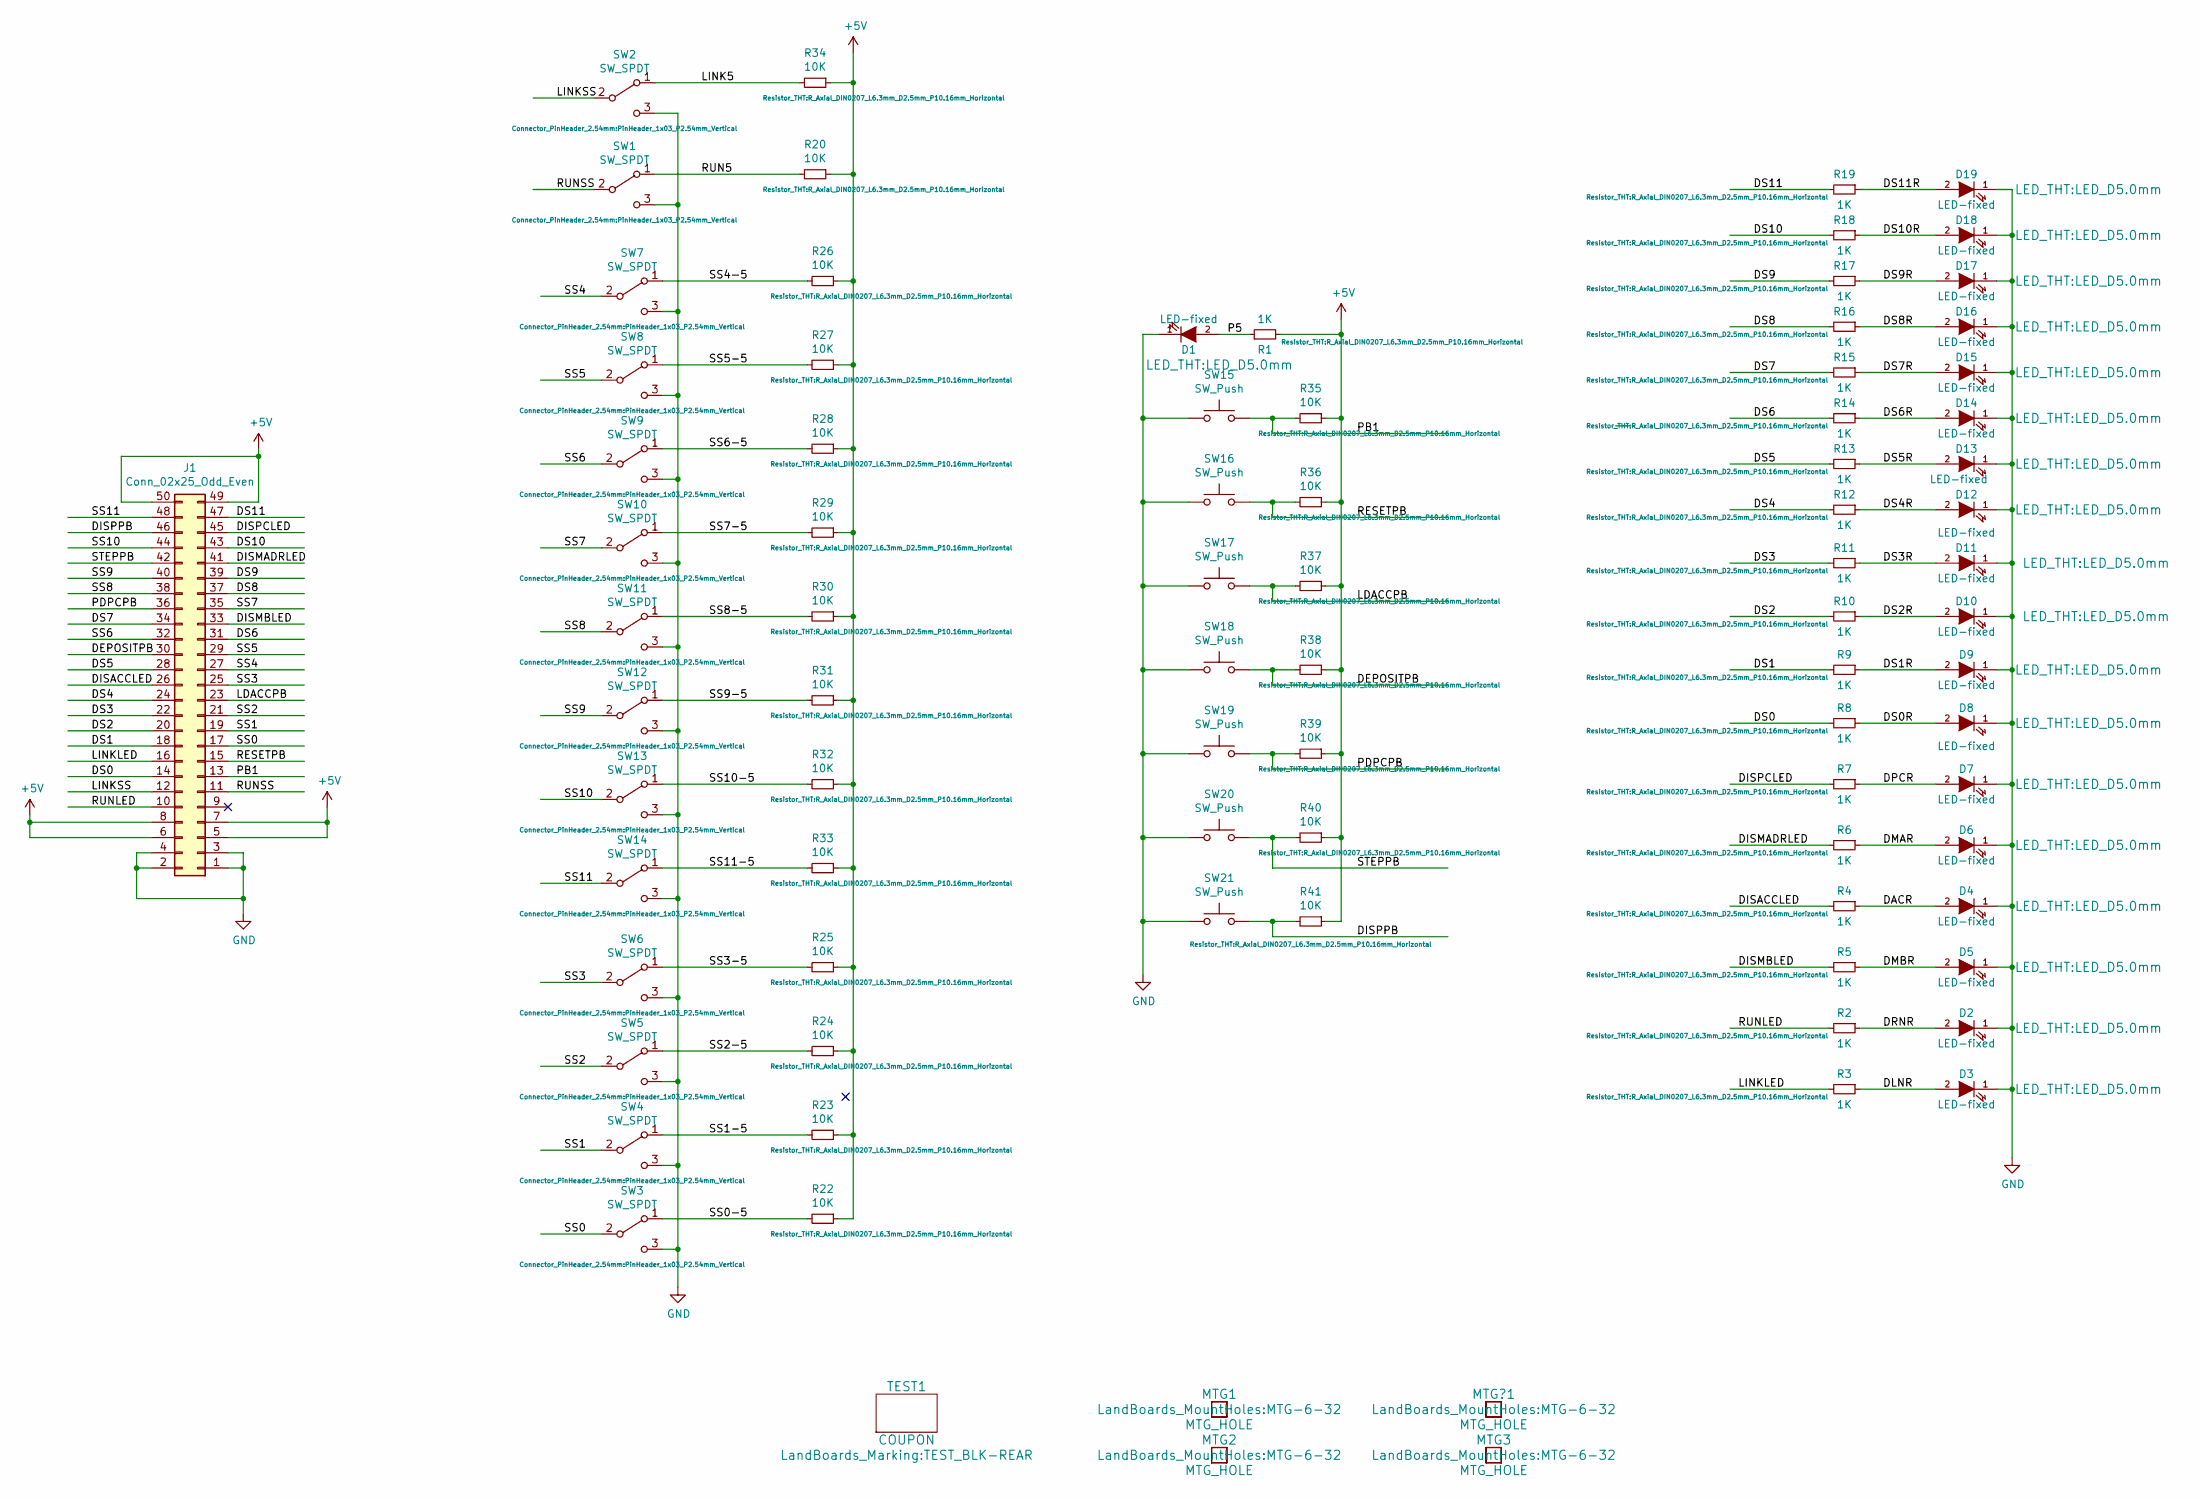
[picture p589: schematic LEDS-SW12.kicad_sch, ESP32-VGA]

Parts:
D1, D2, D3, D4, D5, D6, D7, D8, D9, D10, D11, D12, D13, D14, D15, D16, D17, D18, D19: LED-fixed; LED_D5.0mm
J1: Conn_02x25_Odd_Even; PinHeader_2x25_P2.54mm_Horizontal
MTG1, MTG2, MTG3: MTG_HOLE; MTG-6-32
MTG?1: MTG_HOLE; MTG-6-32
R1, R2, R3, R4, R5, R6, R7, R8, R9, R10, R11, R12, R13, R14, R15, R16, R17, R18, R19: 1K; R_Axial_DIN0207_L6.3mm_D2.5mm_P10.16mm_Horizontal
R20, R22, R23, R24, R25, R26, R27, R28, R29, R30, R31, R32, R33, R34, R35, R36, R37, R38, R39, R40, R41: 10K; R_Axial_DIN0207_L6.3mm_D2.5mm_P10.16mm_Horizontal
SW1, SW2, SW3, SW4, SW5, SW6, SW7, SW8, SW9, SW10, SW11, SW12, SW13, SW14: SW_SPDT; PinHeader_1x03_P2.54mm_Vertical
SW15, SW16, SW17, SW18, SW19, SW20, SW21: SW_Push; SW_PUSH_6mm_H8.5mm
TEST1: COUPON; TEST_BLK-REAR

Connections:
+5V: J1.5, J1.6, J1.7, J1.8, J1.49, J1.50, R1.2, R20.1, R22.1, R23.1, R24.1, R25.1, R26.1, R27.1, R28.1, R29.1, R30.1, R31.1, R32.1, R33.1, R34.1, R35.1, R36.1, R37.1, R38.1, R39.1, R40.1, R41.1
/DACR: D4.2 (A), R4.1
/DEPOSITPB: J1.30, R38.2, SW18.2
/DISACCLED: J1.26, R4.2
/DISMADRLED: J1.41, R6.2
/DISMBLED: J1.33, R5.2
/DISPCLED: J1.45, R7.2
/DISPPB: J1.46, R41.2, SW21.2
/DLNR: D3.2 (A), R3.1
/DMAR: D6.2 (A), R6.1
/DMBR: D5.2 (A), R5.1
/DPCR: D7.2 (A), R7.1
/DRNR: D2.2 (A), R2.1
/DS0: J1.14, R8.2
/DS0R: D8.2 (A), R8.1
/DS1: J1.18, R9.2
/DS1R: D9.2 (A), R9.1
/DS2: J1.20, R10.2
/DS2R: D10.2 (A), R10.1
/DS3: J1.22, R11.2
/DS3R: D11.2 (A), R11.1
/DS4: J1.24, R12.2
/DS4R: D12.2 (A), R12.1
/DS5: J1.28, R13.2
/DS5R: D13.2 (A), R13.1
/DS6: J1.31, R14.2
/DS6R: D14.2 (A), R14.1
/DS7: J1.34, R15.2
/DS7R: D15.2 (A), R15.1
/DS8: J1.37, R16.2
/DS8R: D16.2 (A), R16.1
/DS9: J1.39, R17.2
/DS9R: D17.2 (A), R17.1
/DS10: J1.43, R18.2
/DS10R: D18.2 (A), R18.1
/DS11: J1.47, R19.2
/DS11R: D19.2 (A), R19.1
/LDACCPB: J1.23, R37.2, SW17.2
/LINK5: R34.2, SW2.1 (A)
/LINKLED: J1.16, R3.2
/LINKSS: J1.12, SW2.2 (B)
/P5: D1.2 (A), R1.1
/PB1: J1.13, R35.2, SW15.2
/PDPCPB: J1.36, R39.2, SW19.2
/RESETPB: J1.15, R36.2, SW16.2
/RUN5: R20.2, SW1.1 (A)
/RUNLED: J1.10, R2.2
/RUNSS: J1.11, SW1.2 (B)
/SS0: J1.17, SW3.2 (B)
/SS0-5: R22.2, SW3.1 (A)
/SS1: J1.19, SW4.2 (B)
/SS1-5: R23.2, SW4.1 (A)
/SS2: J1.21, SW5.2 (B)
/SS2-5: R24.2, SW5.1 (A)
/SS3: J1.25, SW6.2 (B)
/SS3-5: R25.2, SW6.1 (A)
/SS4: J1.27, SW7.2 (B)
/SS4-5: R26.2, SW7.1 (A)
/SS5: J1.29, SW8.2 (B)
/SS5-5: R27.2, SW8.1 (A)
/SS6: J1.32, SW9.2 (B)
/SS6-5: R28.2, SW9.1 (A)
/SS7: J1.35, SW10.2 (B)
/SS7-5: R29.2, SW10.1 (A)
/SS8: J1.38, SW11.2 (B)
/SS8-5: R30.2, SW11.1 (A)
/SS9: J1.40, SW12.2 (B)
/SS9-5: R31.2, SW12.1 (A)
/SS10: J1.44, SW13.2 (B)
/SS10-5: R32.2, SW13.1 (A)
/SS11: J1.48, SW14.2 (B)
/SS11-5: R33.2, SW14.1 (A)
/STEPPB: J1.42, R40.2, SW20.2
GND: D1.1 (K), D2.1 (K), D3.1 (K), D4.1 (K), D5.1 (K), D6.1 (K), D7.1 (K), D8.1 (K), D9.1 (K), D10.1 (K), D11.1 (K), D12.1 (K), D13.1 (K), D14.1 (K), D15.1 (K), D16.1 (K), D17.1 (K), D18.1 (K), D19.1 (K), J1.1, J1.2, J1.3, J1.4, SW1.3 (C), SW2.3 (C), SW3.3 (C), SW4.3 (C), SW5.3 (C), SW6.3 (C), SW7.3 (C), SW8.3 (C), SW9.3 (C), SW10.3 (C), SW11.3 (C), SW12.3 (C), SW13.3 (C), SW14.3 (C), SW15.1, SW16.1, SW17.1, SW18.1, SW19.1, SW20.1, SW21.1
