land-boards/lb-boards/RetroCPUs/PDP-8/LEDS-SW12.kicad_pcb

## KiCad design RetroCPUs/PDP-8/LEDS-SW12.kicad_pcb (continued)

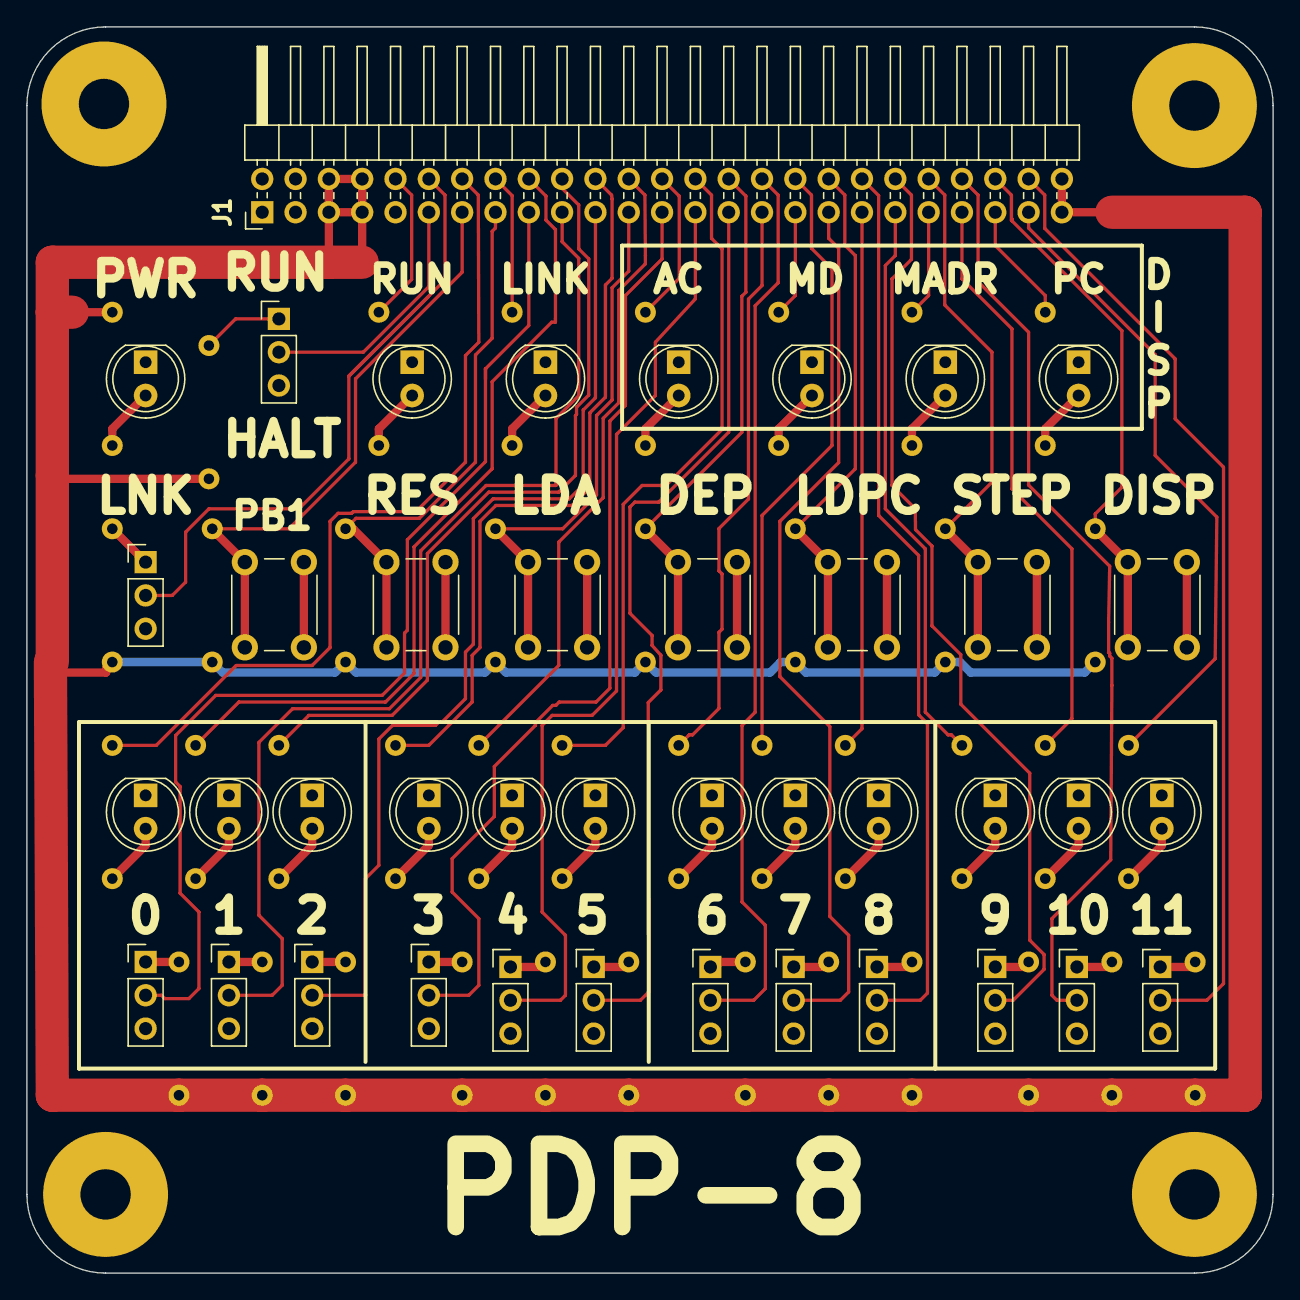
[picture p590: board LEDS-SW12.kicad_pcb from above]

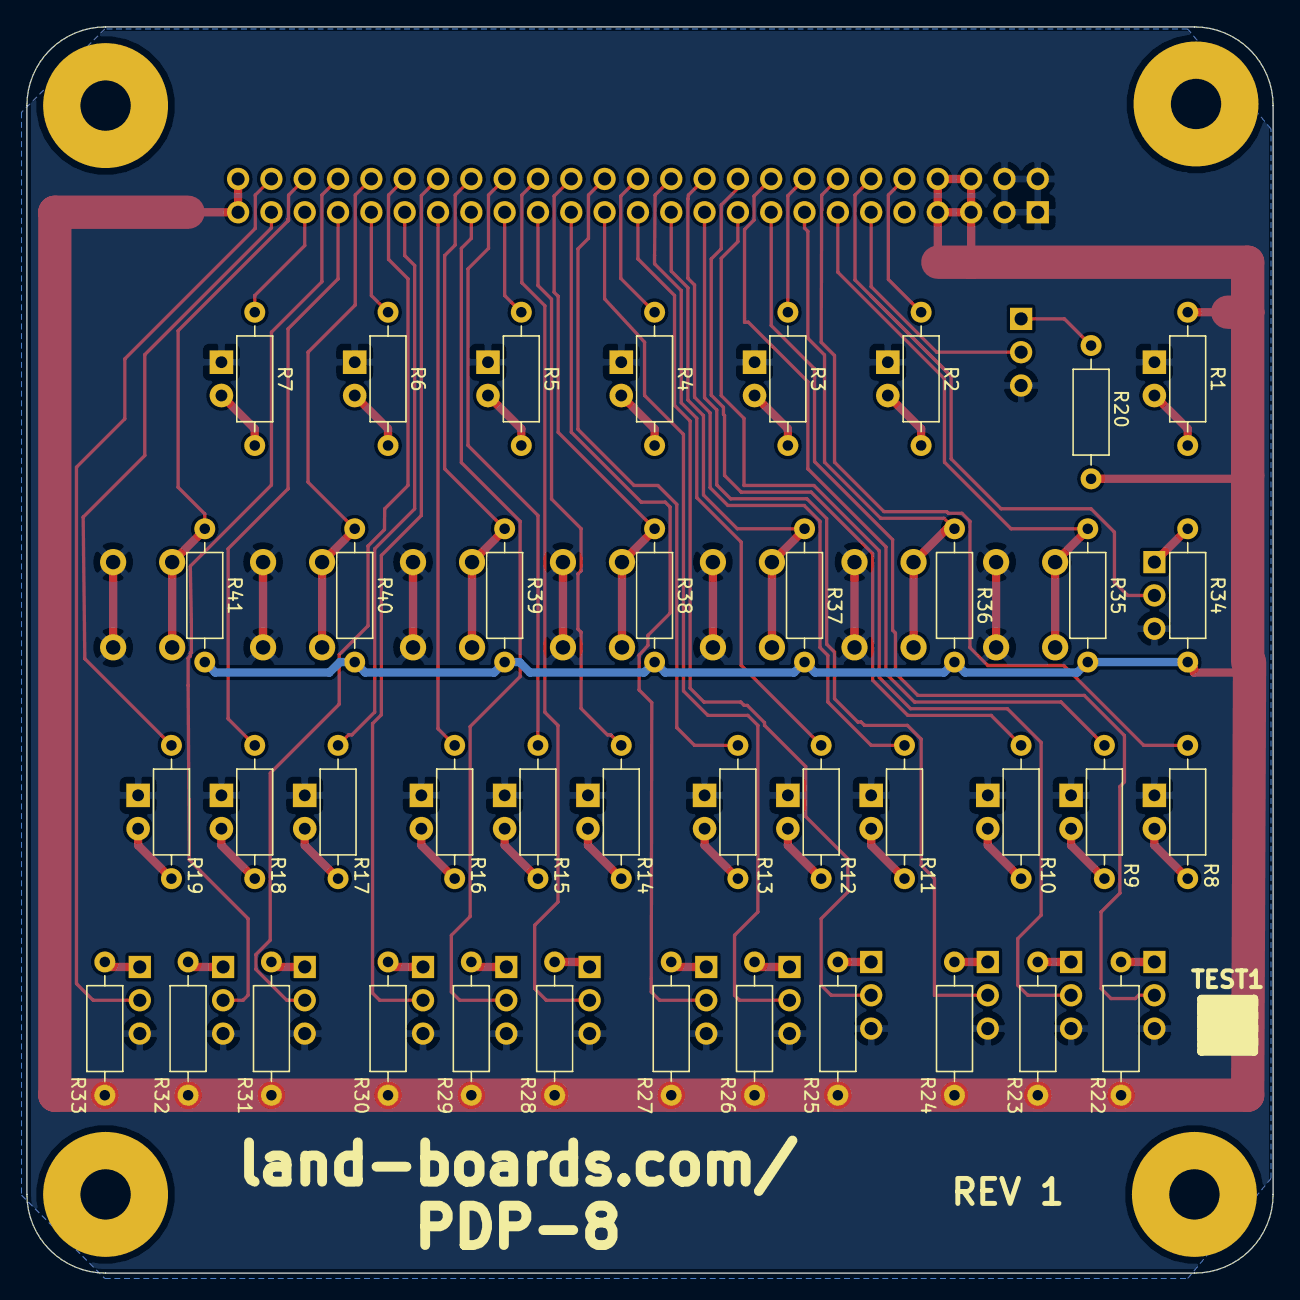
[picture p591: board LEDS-SW12.kicad_pcb from below]

Board: 2 copper layers, 95.0 x 95.0 mm, 86 parts (40 on the bottom side), 74 nets.
