land-boards/lb-boards/RetroCPUs/SIMPLE-6809/SIMPLE-6809.kicad_pcb

## KiCad design RetroCPUs/SIMPLE-6809/SIMPLE-6809.kicad_pcb (2024-06-20)

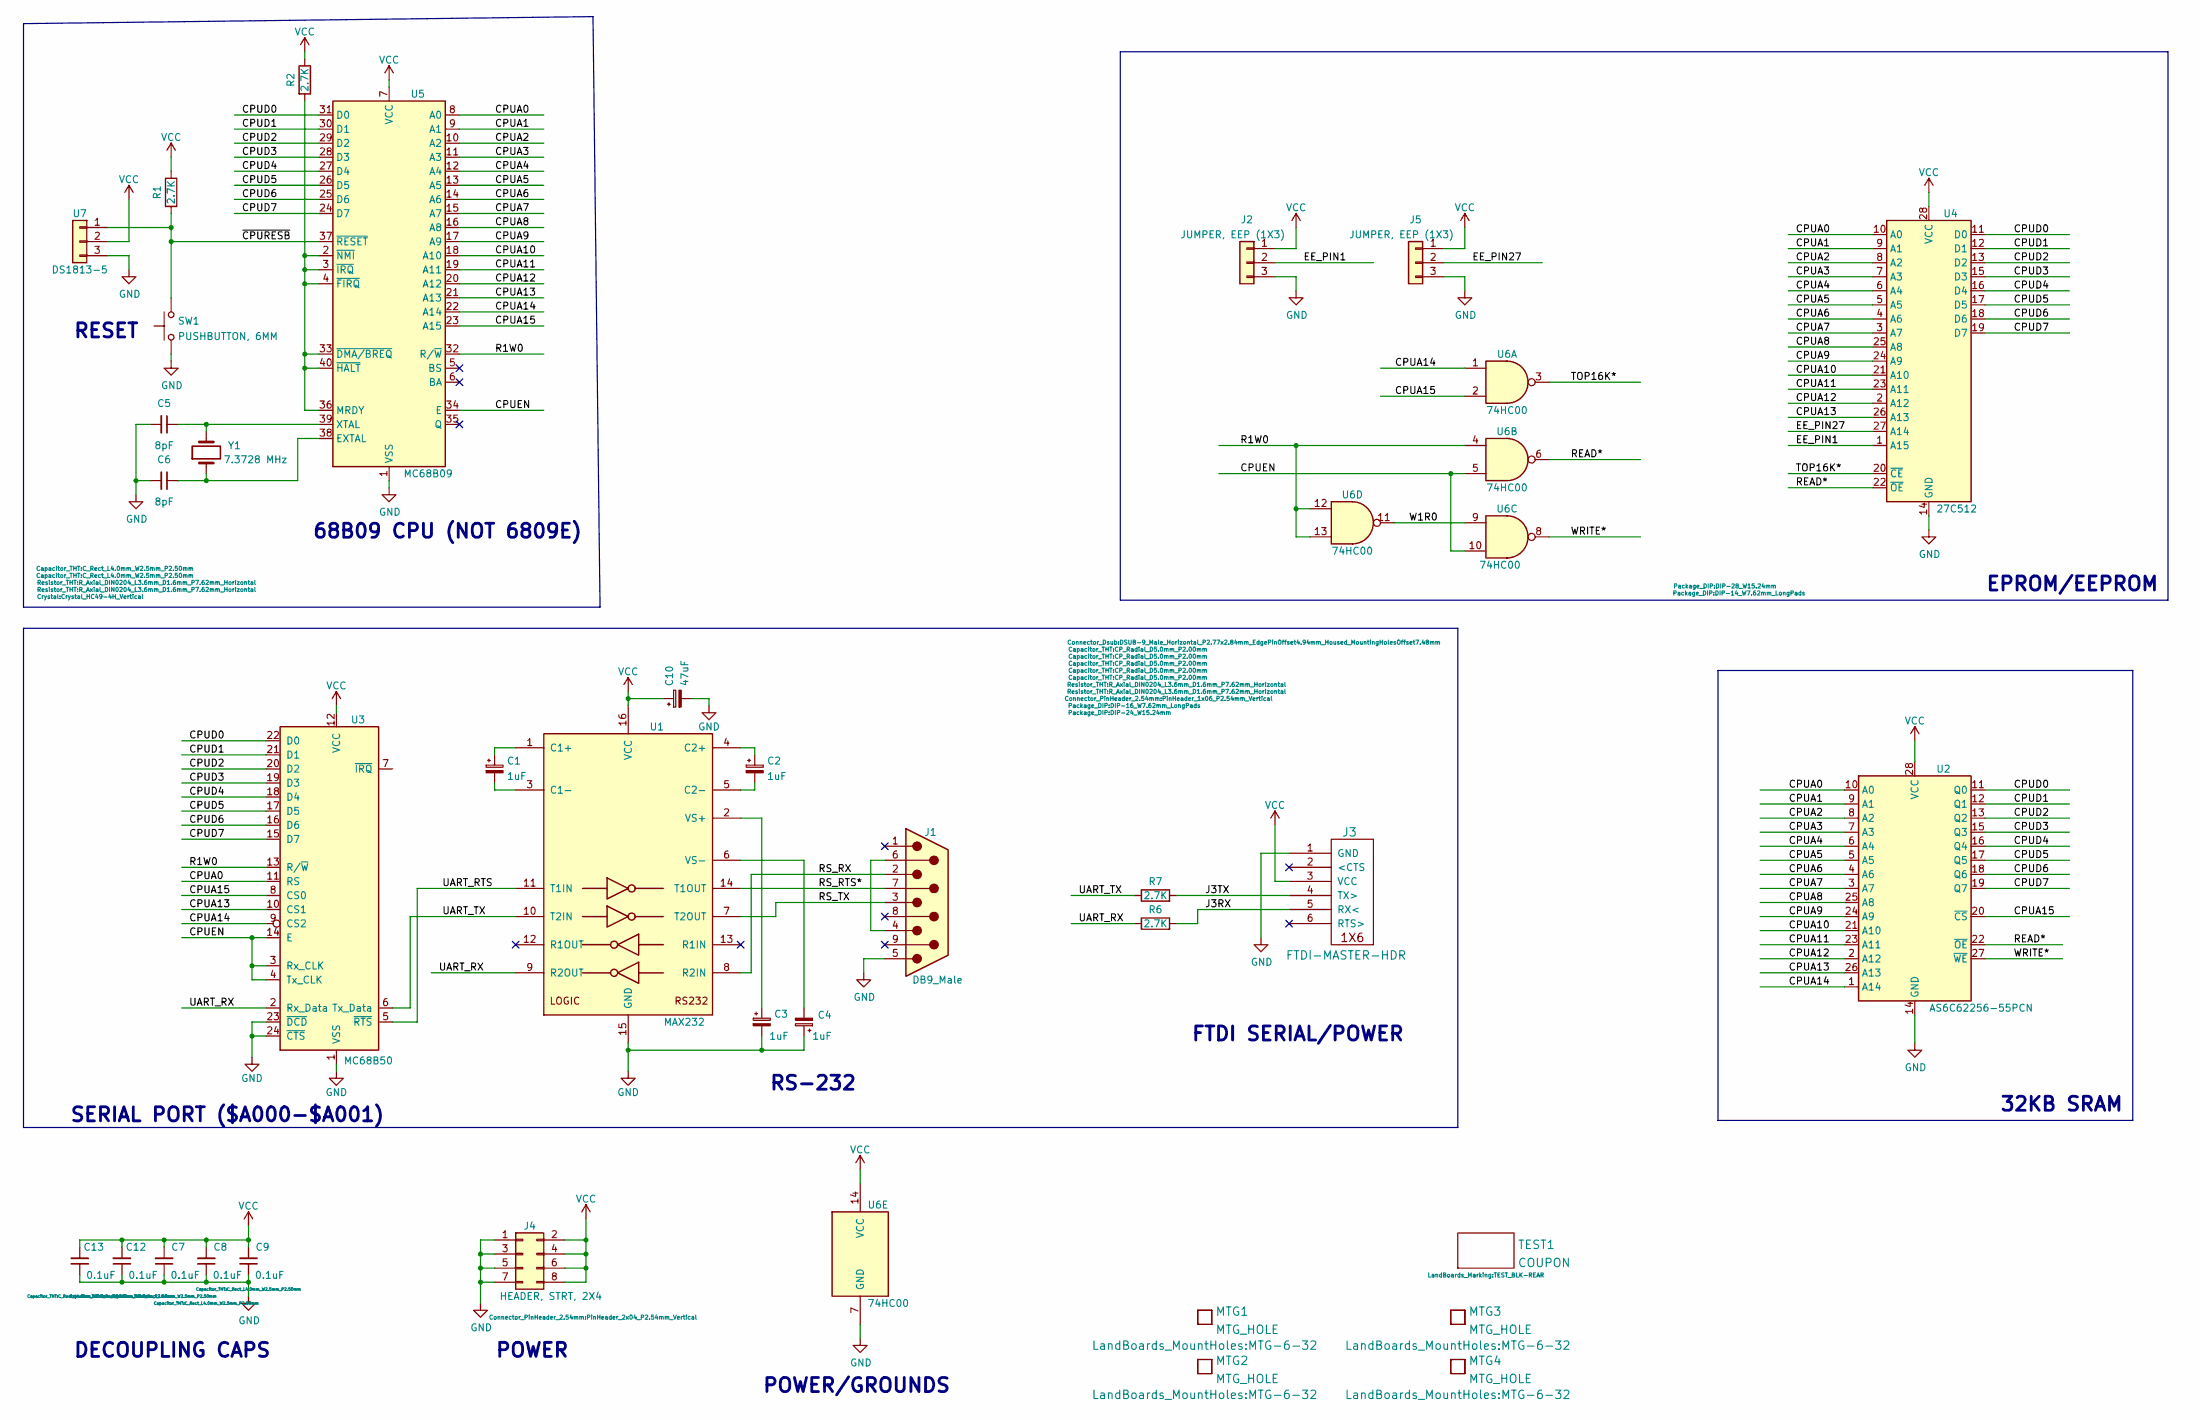
[picture p594: schematic SIMPLE-6809.kicad_sch]

Parts:
C1, C2, C3, C4: 1uF; CP_Radial_D5.0mm_P2.00mm
C5, C6: 8pF; C_Rect_L4.0mm_W2.5mm_P2.50mm
C7, C8, C9, C12, C13: 0.1uF; C_Rect_L4.0mm_W2.5mm_P2.50mm
C10: 47uF; CP_Radial_D5.0mm_P2.00mm
J1: DB9_Male; DSUB-9_Male_Horizontal_P2.77x2.84mm_EdgePinOffset4.94mm_Hou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
J2, J5: JUMPER, EEP (1X3); PinHeader_1x03_P2.54mm_Vertical
J3: FTDI-MASTER-HDR; PinHeader_1x06_P2.54mm_Vertical
J4: HEADER, STRT, 2X4; PinHeader_2x04_P2.54mm_Vertical
MTG1, MTG2, MTG3, MTG4: MTG_HOLE; MTG-6-32
R1, R2, R6, R7: 2.7K; R_Axial_DIN0204_L3.6mm_D1.6mm_P7.62mm_Horizontal
SW1: PUSHBUTTON, 6MM; SW_PUSH_6mm_H8.5mm
TEST1: COUPON; TEST_BLK-REAR
U1: MAX232; DIP-16_W7.62mm_LongPads
U2: AS6C62256-55PCN; DIP-28_W15.24mm
U3: MC68B50; DIP-24_W15.24mm
U4: 27C512; DIP-28_W15.24mm
U5: MC68B09; DIP-40_W15.24mm
U6: 74HC00; DIP-14_W7.62mm_LongPads
U7: DS1813-5; TO-92
Y1: 7.3728 MHz; Crystal_HC49-4H_Vertical

Connections:
/CPUA0: U2.10 (A0), U3.11 (RS), U4.10 (A0), U5.8 (A0)
/CPUA1: U2.9 (A1), U4.9 (A1), U5.9 (A1)
/CPUA2: U2.8 (A2), U4.8 (A2), U5.10 (A2)
/CPUA3: U2.7 (A3), U4.7 (A3), U5.11 (A3)
/CPUA4: U2.6 (A4), U4.6 (A4), U5.12 (A4)
/CPUA5: U2.5 (A5), U4.5 (A5), U5.13 (A5)
/CPUA6: U2.4 (A6), U4.4 (A6), U5.14 (A6)
/CPUA7: U2.3 (A7), U4.3 (A7), U5.15 (A7)
/CPUA8: U2.25 (A8), U4.25 (A8), U5.16 (A8)
/CPUA9: U2.24 (A9), U4.24 (A9), U5.17 (A9)
/CPUA10: U2.21 (A10), U4.21 (A10), U5.18 (A10)
/CPUA11: U2.23 (A11), U4.23 (A11), U5.19 (A11)
/CPUA12: U2.2 (A12), U4.2 (A12), U5.20 (A12)
/CPUA13: U2.26 (A13), U3.10 (CS1), U4.26 (A13), U5.21 (A13)
/CPUA14: U2.1 (A14), U3.9 (CS2), U5.22 (A14), U6.1
/CPUA15: U2.20 (~CS), U3.8 (CS0), U5.23 (A15), U6.2
/CPUD0: U2.11 (Q0), U3.22 (D0), U4.11 (D0), U5.31 (D0)
/CPUD1: U2.12 (Q1), U3.21 (D1), U4.12 (D1), U5.30 (D1)
/CPUD2: U2.13 (Q2), U3.20 (D2), U4.13 (D2), U5.29 (D2)
/CPUD3: U2.15 (Q3), U3.19 (D3), U4.15 (D3), U5.28 (D3)
/CPUD4: U2.16 (Q4), U3.18 (D4), U4.16 (D4), U5.27 (D4)
/CPUD5: U2.17 (Q5), U3.17 (D5), U4.17 (D5), U5.26 (D5)
/CPUD6: U2.18 (Q6), U3.16 (D6), U4.18 (D6), U5.25 (D6)
/CPUD7: U2.19 (Q7), U3.15 (D7), U4.19 (D7), U5.24 (D7)
/CPUEN: U3.3 (Rx_CLK), U3.4 (Tx_CLK), U3.14 (E), U5.34 (E), U6.5, U6.10
/EE_PIN1: J2.2, U4.1 (A15)
/EE_PIN27: J5.2, U4.27 (A14)
/J3RX: J3.5 (RX<), R6.2
/J3TX: J3.4 (TX>), R7.2
/R1W0: U3.13 (R/~W), U5.32 (R/~W), U6.4, U6.12, U6.13
/READ*: U2.22 (~OE), U4.22 (~OE), U6.6
/RS_RTS*: J1.7, U1.14 (T1OUT)
/RS_RX: J1.2, U1.8 (R2IN)
/RS_TX: J1.3, U1.7 (T2OUT)
/TOP16K*: U4.20 (~CE), U6.3
/UART_RTS: U1.11 (T1IN), U3.5 (~RTS)
/UART_RX: R6.1, U1.9 (R2OUT), U3.2 (Rx_Data)
/UART_TX: R7.1, U1.10 (T2IN), U3.6 (Tx_Data)
/W1R0: U6.9, U6.11
/WRITE*: U2.27 (~WE), U6.8
/~CPURESB: R1.2, SW1.2, U5.37 (~RESET), U7.1
GND: C3.2, C4.1, C5.2, C6.2, C7.1, C8.1, C9.1, C10.2, C12.1, C13.1, J1.5, J2.3, J3.1 (GND), J4.1, J4.3, J4.5, J4.7, J5.3, SW1.1, U1.15 (GND), U2.14 (GND), U3.1 (VSS), U3.23 (~DCD), U3.24 (~CTS), U4.14 (GND), U5.1 (VSS), U6.7 (GND), U7.3
unnamed: J1.4, J1.6
unnamed: C1.1, U1.1 (C1+)
unnamed: C1.2, U1.3 (C1-)
unnamed: C2.1, U1.4 (C2+)
unnamed: C2.2, U1.5 (C2-)
unnamed: C3.1, U1.2 (VS+)
unnamed: C4.2, U1.6 (VS-)
unnamed: C6.1, U5.38 (EXTAL), Y1.1
unnamed: R2.2, U5.2 (~NMI), U5.3 (~IRQ), U5.4 (~FIRQ), U5.33 (~DMA/BREQ), U5.36 (MRDY), U5.40 (~HALT)
unnamed: C5.1, U5.39 (XTAL), Y1.2
VCC: C7.2, C8.2, C9.2, C10.1, C12.2, C13.2, J2.1, J3.3 (VCC), J4.2, J4.4, J4.6, J4.8, J5.1, R1.1, R2.1, U1.16 (VCC), U2.28 (VCC), U3.12 (VCC), U4.28 (VCC), U5.7 (VCC), U6.14 (VCC), U7.2

Notes on the sheet:
POWER
RESET
32KB SRAM
DECOUPLING CAPS
FTDI SERIAL/POWER
SERIAL PORT ($A000-$A001)
POWER/GROUNDS
EPROM/EEPROM
68B09 CPU (NOT 6809E)
RS-232

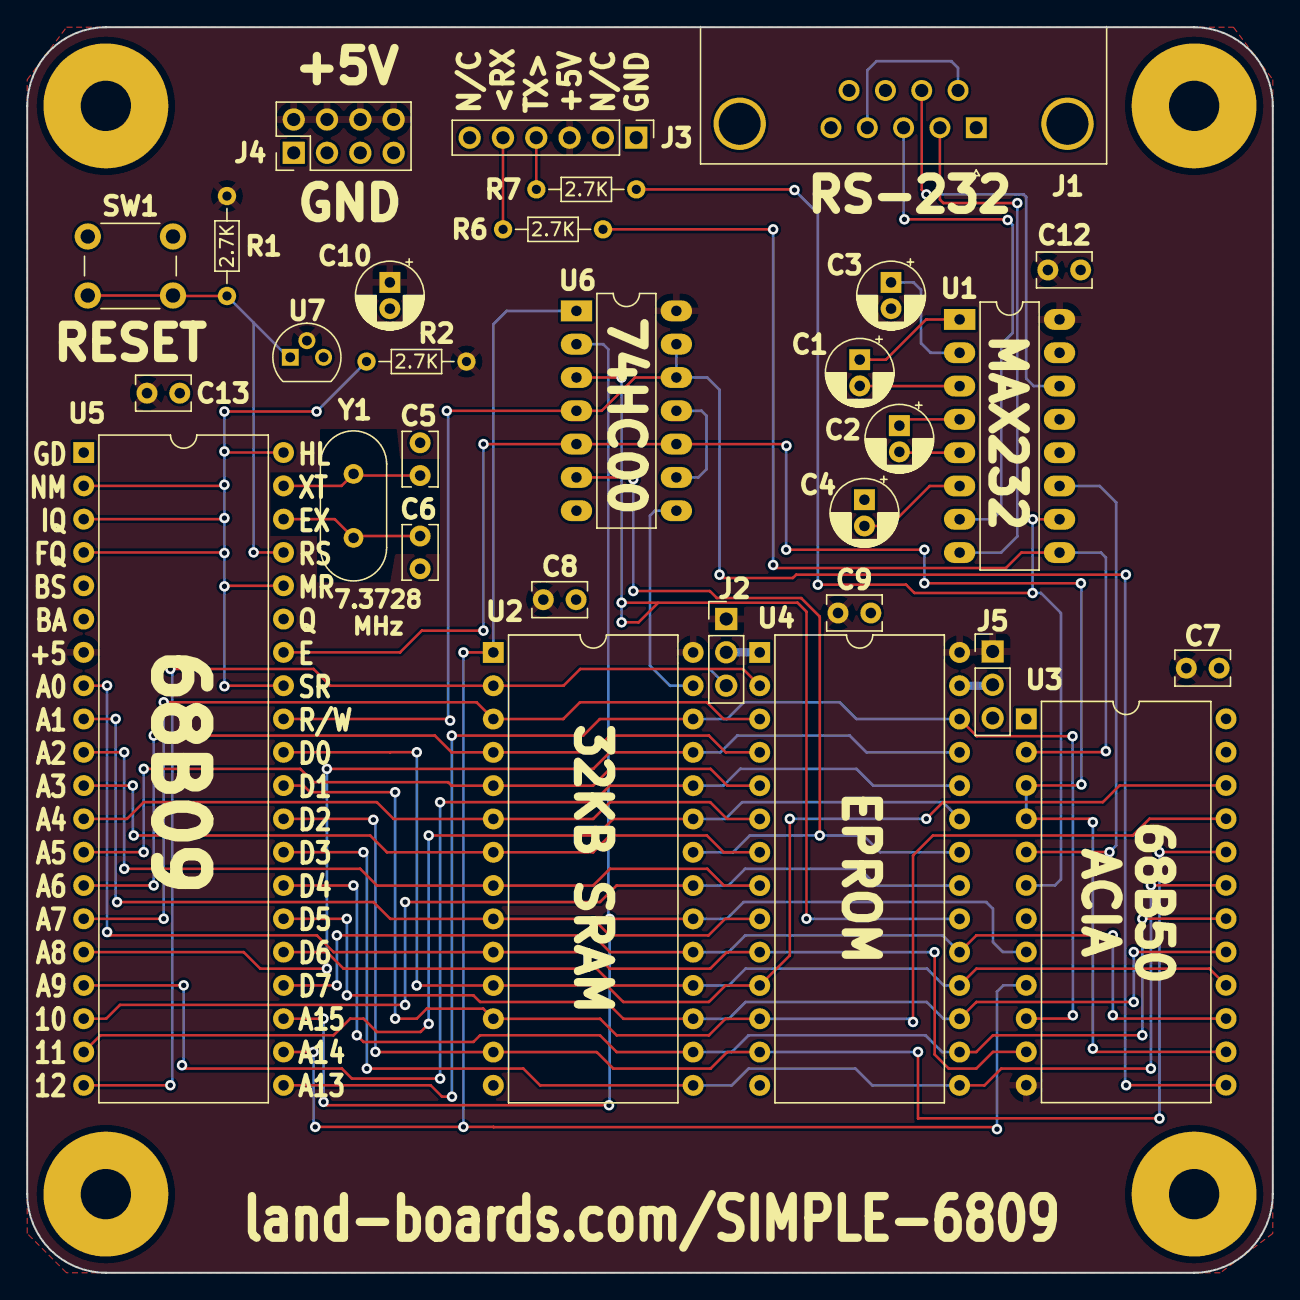
[picture p595: board SIMPLE-6809.kicad_pcb from above]

Board: 2 copper layers, 95.0 x 95.0 mm, 35 parts (0 on the bottom side), 53 nets.

Other parts of the board:
TEST: COUPON; TEST_BLK-REAR
