land-boards/lb-boards/Analog Cards/ANA-SIG-CON/ANA-SIG-CON.kicad_pcb

## KiCad design Analog Cards/ANA-SIG-CON/ANA-SIG-CON.kicad_pcb (2024-06-20)

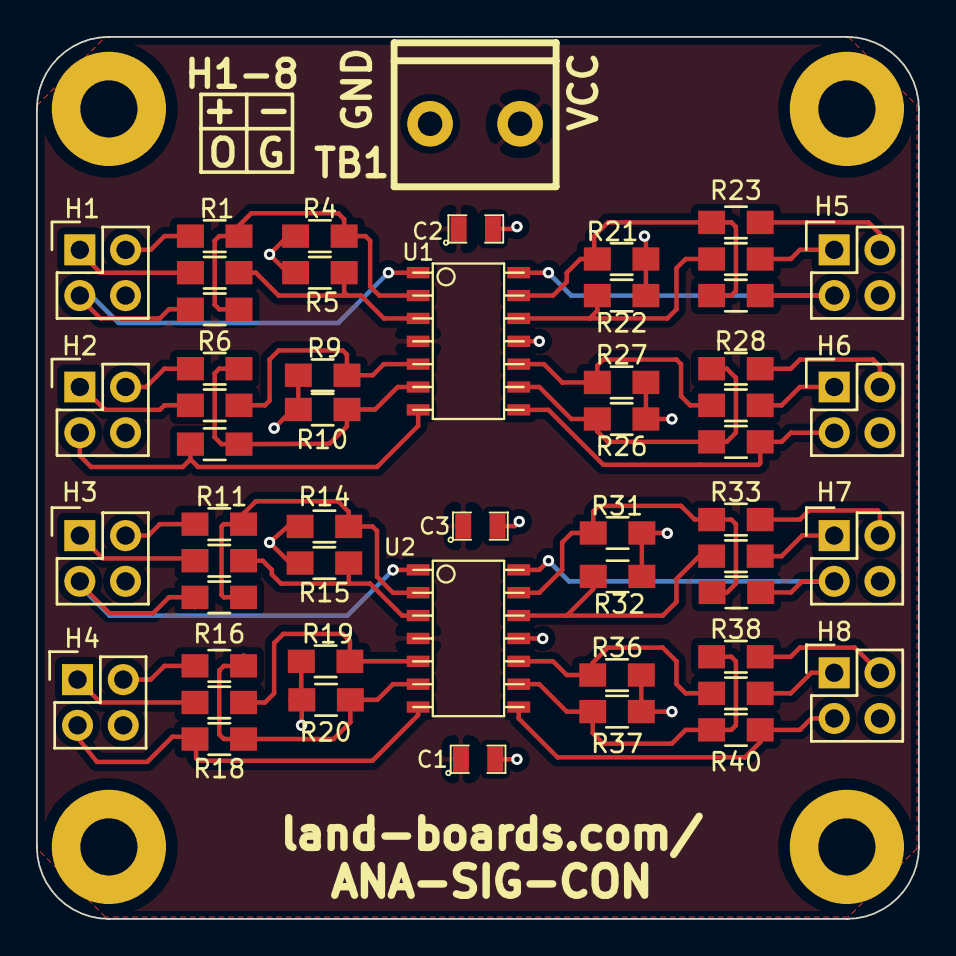
[picture p596: board ANA-SIG-CON.kicad_pcb from above]

Board: 2 copper layers, 49.0 x 49.0 mm, 58 parts (0 on the bottom side), 42 nets.

Parts:
C1, C2, C3: C; SM0805
H1, H2, H3, H4, H5, H6, H7, H8: CONN_01X04; Pin_Header_Straight_2x02
MTG1, MTG2, MTG3, MTG4: CONN_1; MTG-4-40
R1, R2, R4, R5, R6, R7, R9, R10, R11, R12, R14, R15, R16, R17, R19, R20, R21, R22, R23, R24, R26, R27, R28, R29, R31, R32, R33, R34, R36, R37, R38, R39: 1K; R_0805_HandSoldering
R3, R8, R13, R18, R25, R30, R35, R40: 1M; R_0805_HandSoldering
TB1: CONN_2; TB2-5MM
U1, U2: LM324N; so-14

Connections:
/I1+: H1.1, R2.1
/I1-: H1.2, R1.1
/I2+: H2.1, R7.1
/I2-: H2.2, R6.1
/I3+: H3.1, R12.1
/I3-: H3.2, R11.1
/I4+: H4.1, R17.1
/I4-: H4.2, R16.1
/I5+: H5.1, R24.1
/I5-: H5.2, R23.1
/I6+: H6.1, R29.1
/I6-: H6.2, R28.1
/I7+: H7.1, R34.1
/I7-: H7.2, R33.1
/I8+: H8.1, R39.1
/I8-: H8.2, R38.1
/O1: H1.3, R3.2, U1.1
/O2: H2.3, R8.2, U1.7
/O3: H3.3, R13.2, U2.1
/O4: H4.3, R18.2, U2.7
/O5: H5.3, R25.2, U1.14
/O6: H6.3, R30.2, U1.8
/O7: H7.3, R35.2, U2.14
/O8: H8.3, R40.2, U2.8
GND: C1.2, C2.2, C3.2, H1.4, H2.4, H3.4, H4.4, H5.4, H6.4, H7.4, H8.4, R4.1, R5.1, R9.1, R10.1, R14.1, R15.1, R19.1, R20.1, R21.1, R22.1, R26.1, R27.1, R31.1, R32.1, R36.1, R37.1, TB1.1, U1.11, U2.11
unnamed: R1.2, R3.1, R4.2, U1.2
unnamed: R2.2, R5.2, U1.3
unnamed: R7.2, R9.2, U1.5
unnamed: R6.2, R8.1, R10.2, U1.6
unnamed: R11.2, R13.1, R14.2, U2.2
unnamed: R12.2, R15.2, U2.3
unnamed: R16.2, R18.1, R20.2, U2.6
unnamed: R17.2, R19.2, U2.5
unnamed: R21.2, R23.2, R25.1, U1.13
unnamed: R22.2, R24.2, U1.12
unnamed: R26.2, R28.2, R30.1, U1.9
unnamed: R27.2, R29.2, U1.10
unnamed: R31.2, R33.2, R35.1, U2.13
unnamed: R32.2, R34.2, U2.12
unnamed: R36.2, R39.2, U2.10
unnamed: R37.2, R38.2, R40.1, U2.9
VAA: C1.1, C2.1, C3.1, TB1.2, U1.4, U2.4
