land-boards/lb-boards/Opto Cards/OptoIn8-I2C/KiCad5/OptoIn8-I2C.kicad_pcb

## KiCad design Opto Cards/OptoIn8-I2C/KiCad5/OptoIn8-I2C.kicad_pcb (2022-04-09)

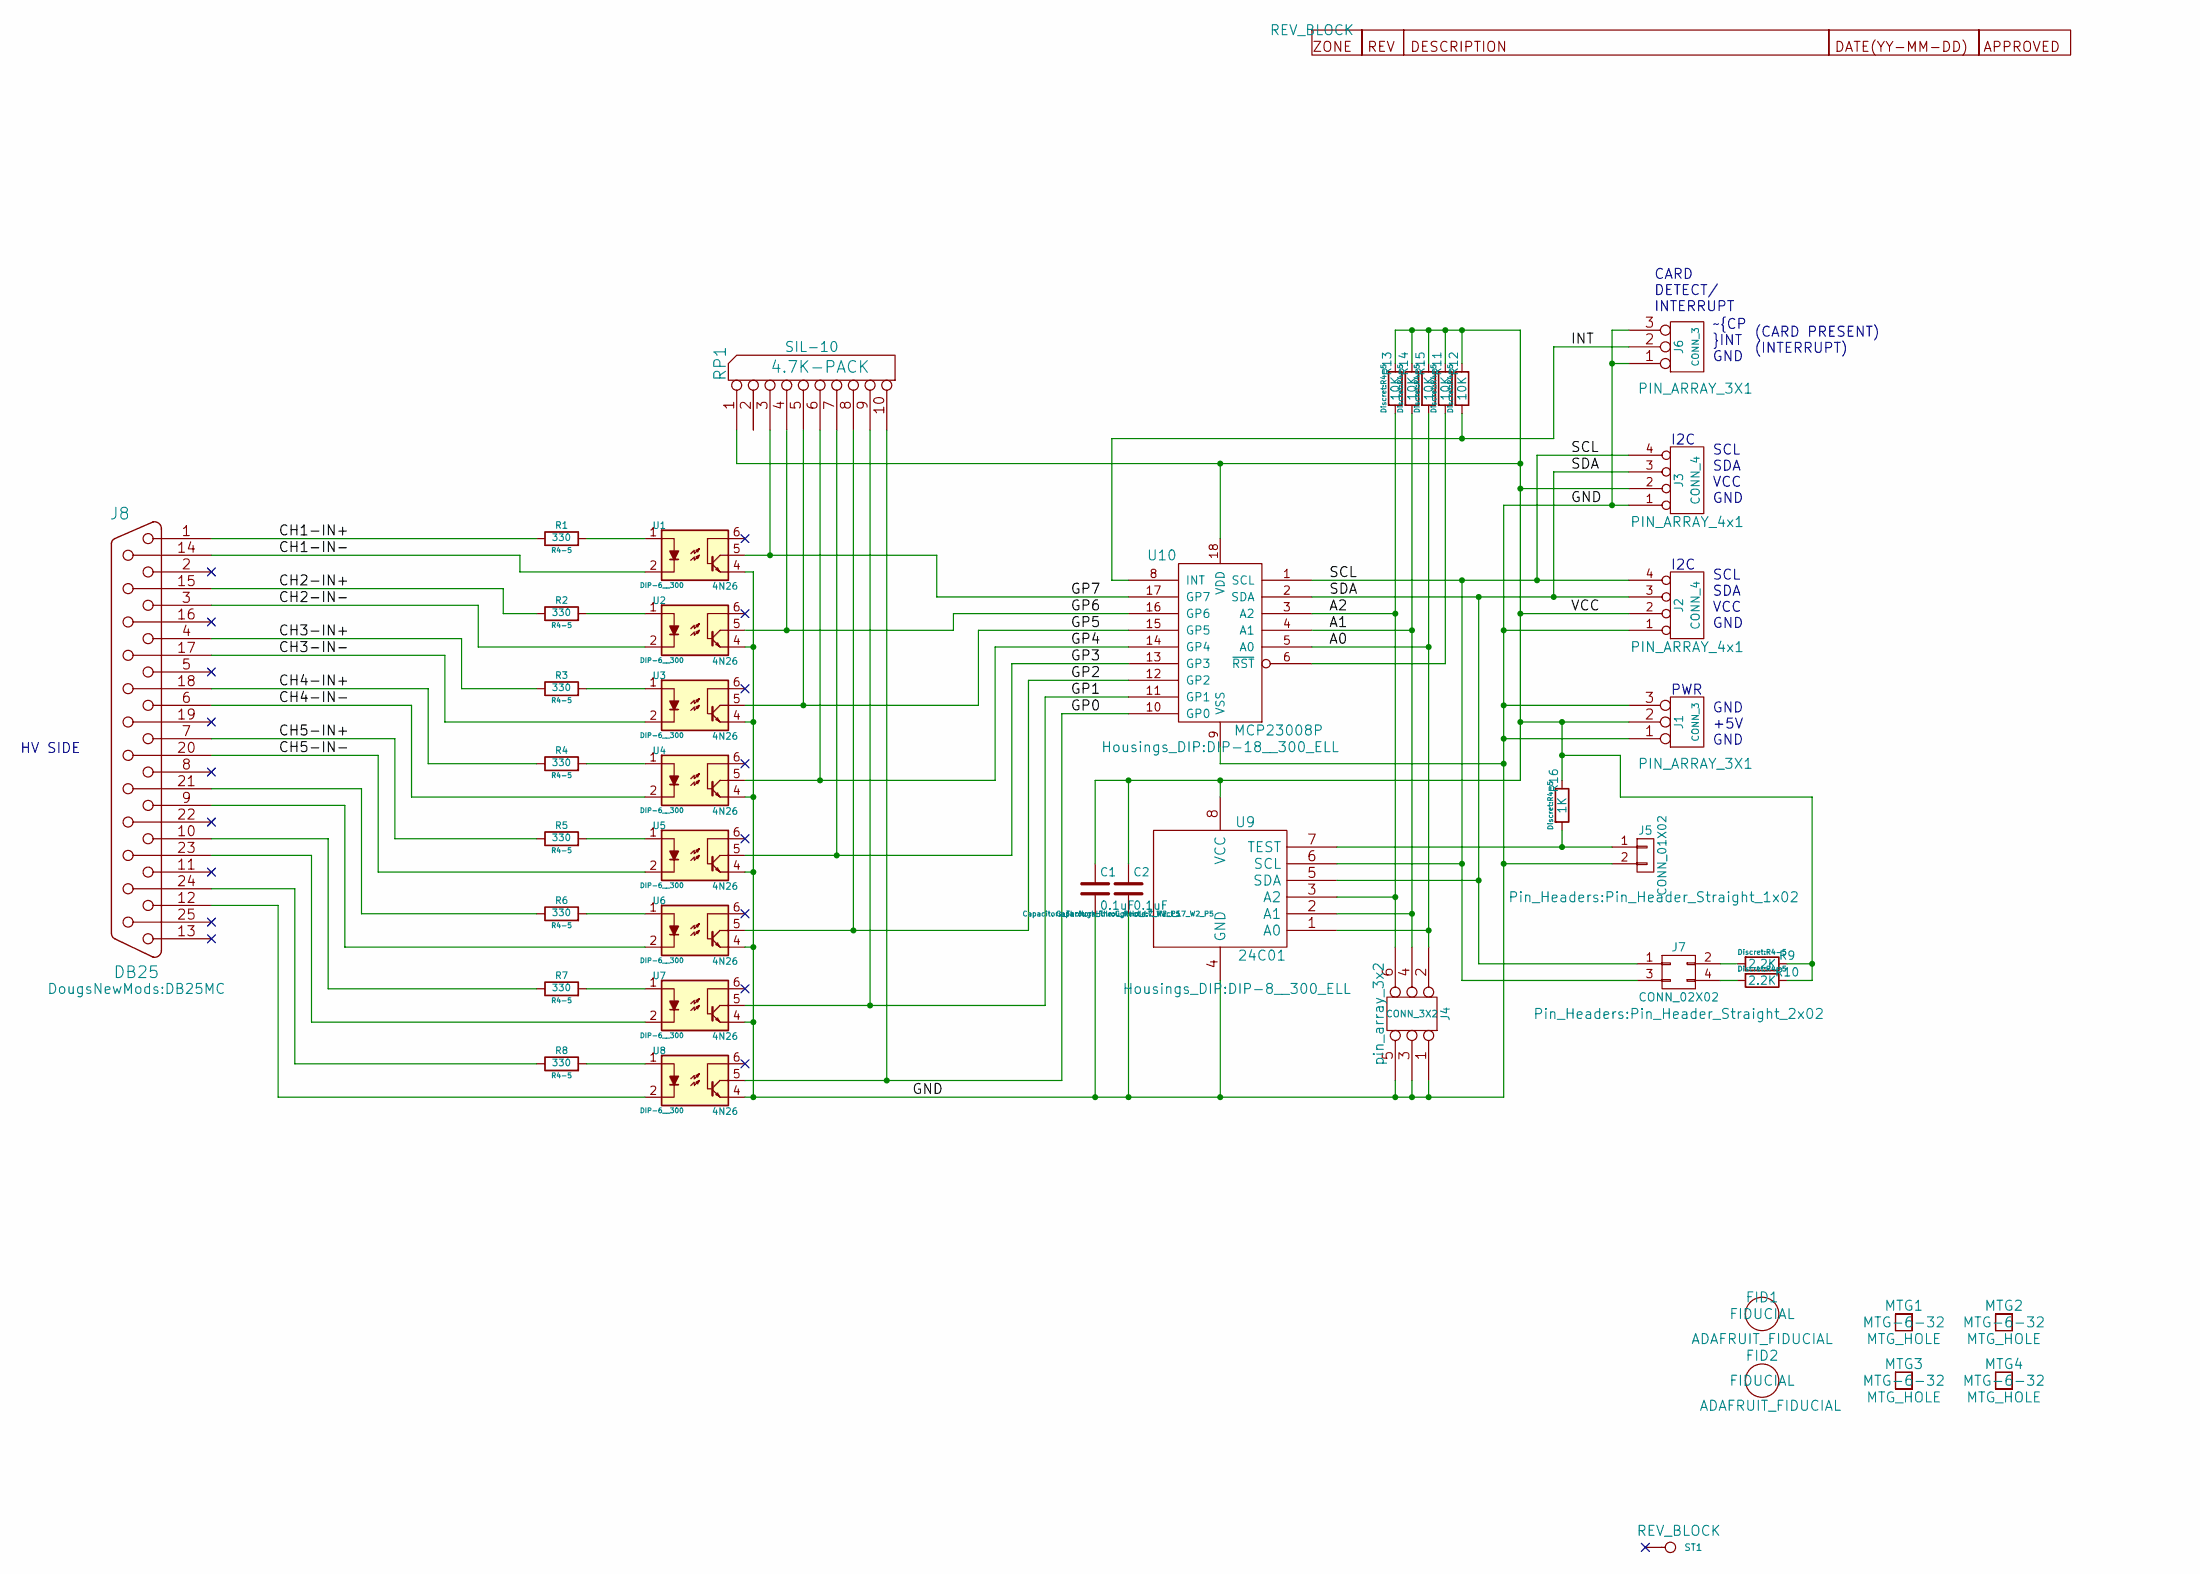
[picture p597: schematic OptoIn8-I2C.sch, 8-CHANNEL OPTO-ISOLATED INPUT I2C CARD]

Parts:
C1, C2: 0.1uF; C_Rect_L7_W2_P5
FID1, FID2: ADAFRUIT_FIDUCIAL; FIDUCIAL
J1, J6: CONN_3; PIN_ARRAY_3X1
J2, J3: CONN_4; PIN_ARRAY_4x1
J4: CONN_3X2; pin_array_3x2
J5: CONN_01X02; Pin_Header_Straight_1x02
J7: CONN_02X02; Pin_Header_Straight_2x02
J8: DB25; DB25MC
MTG1, MTG2, MTG3, MTG4: MTG_HOLE; MTG-6-32
R1, R2, R3, R4, R5, R6, R7, R8: 330; R4-5
R9, R10: 2.2K; R4-5
R11, R12, R13, R14, R15: 10K; R4-5
R16: 1K; R4-5
RP1: 4.7K-PACK; SIL-10; MfgPN 4610X-101-472LF
ST1: CONN_1; REV_BLOCK
ST2: REV-HIST; REV_BLOCK
U1, U2, U3, U4, U5, U6, U7, U8: 4N26; DIP-6__300
U9: 24C01; DIP-8__300_ELL
U10: MCP23008P; DIP-18__300_ELL

Connections:
/A0: J4.2, R15.2, U9.1 (A0), U10.5 (A0)
/A1: J4.4, R14.2, U9.2 (A1), U10.4 (A1)
/A2: J4.6, R13.2, U9.3 (A2), U10.3 (A2)
/CH1-IN+: J8.1, R1.1
/CH1-IN-: J8.14, U1.2
/CH2-IN+: J8.15, R2.1
/CH2-IN-: J8.3, U2.2
/CH3-IN+: J8.4, R3.1
/CH3-IN-: J8.17, U3.2
/CH4-IN+: J8.18, R4.1
/CH4-IN-: J8.6, U4.2
/CH5-IN+: J8.7, R5.1
/CH5-IN-: J8.20, U5.2
/GND: C1.2, C2.2, J1.1, J1.3, J2.1, J3.1, J4.1, J4.3, J4.5, J5.2, J6.1, J6.3, U1.4, U2.4, U3.4, U4.4, U5.4, U6.4, U7.4, U8.4, U9.4 (GND), U10.9 (VSS)
/GP0: RP1.10, U8.5, U10.10 (GP0)
/GP1: RP1.9, U7.5, U10.11 (GP1)
/GP2: RP1.8, U6.5, U10.12 (GP2)
/GP3: RP1.7, U5.5, U10.13 (GP3)
/GP4: RP1.6, U4.5, U10.14 (GP4)
/GP5: RP1.5, U3.5, U10.15 (GP5)
/GP6: RP1.4, U2.5, U10.16 (GP6)
/GP7: RP1.3, U1.5, U10.17 (GP7)
/INT: J6.2 (PM), R12.2, U10.8 (INT)
/SCL: J2.4, J3.4, J7.3, U9.6 (SCL), U10.1 (SCL)
/SDA: J2.3, J3.3, J7.1, U9.5 (SDA), U10.2 (SDA)
/VCC: C1.1, C2.1, J1.2 (PM), J2.2, J3.2, R9.1, R10.1, R11.1, R12.1, R13.1, R14.1, R15.1, R16.1, RP1.1 (COM), U9.8 (VCC), U10.18 (VDD)
unnamed: J5.1, R16.2, U9.7 (TEST)
unnamed: J7.2, R9.2
unnamed: J7.4, R10.2
unnamed: J8.9, U6.2
unnamed: J8.10, R7.1
unnamed: J8.12, U8.2
unnamed: J8.21, R6.1
unnamed: J8.23, U7.2
unnamed: J8.24, R8.1
unnamed: R1.2, U1.1
unnamed: R2.2, U2.1
unnamed: R3.2, U3.1
unnamed: R4.2, U4.1
unnamed: R5.2, U5.1
unnamed: R6.2, U6.1
unnamed: R7.2, U7.1
unnamed: R8.2, U8.1
unnamed: R11.2, U10.6 (~RST)

Notes on the sheet:
I2C
HV SIDE
SCL SDA VCC GND
~CP ~INT GND
CARD DETECT/ INTERRUPT
GND +5V GND
PWR
(CARD PRESENT) (INTERRUPT)

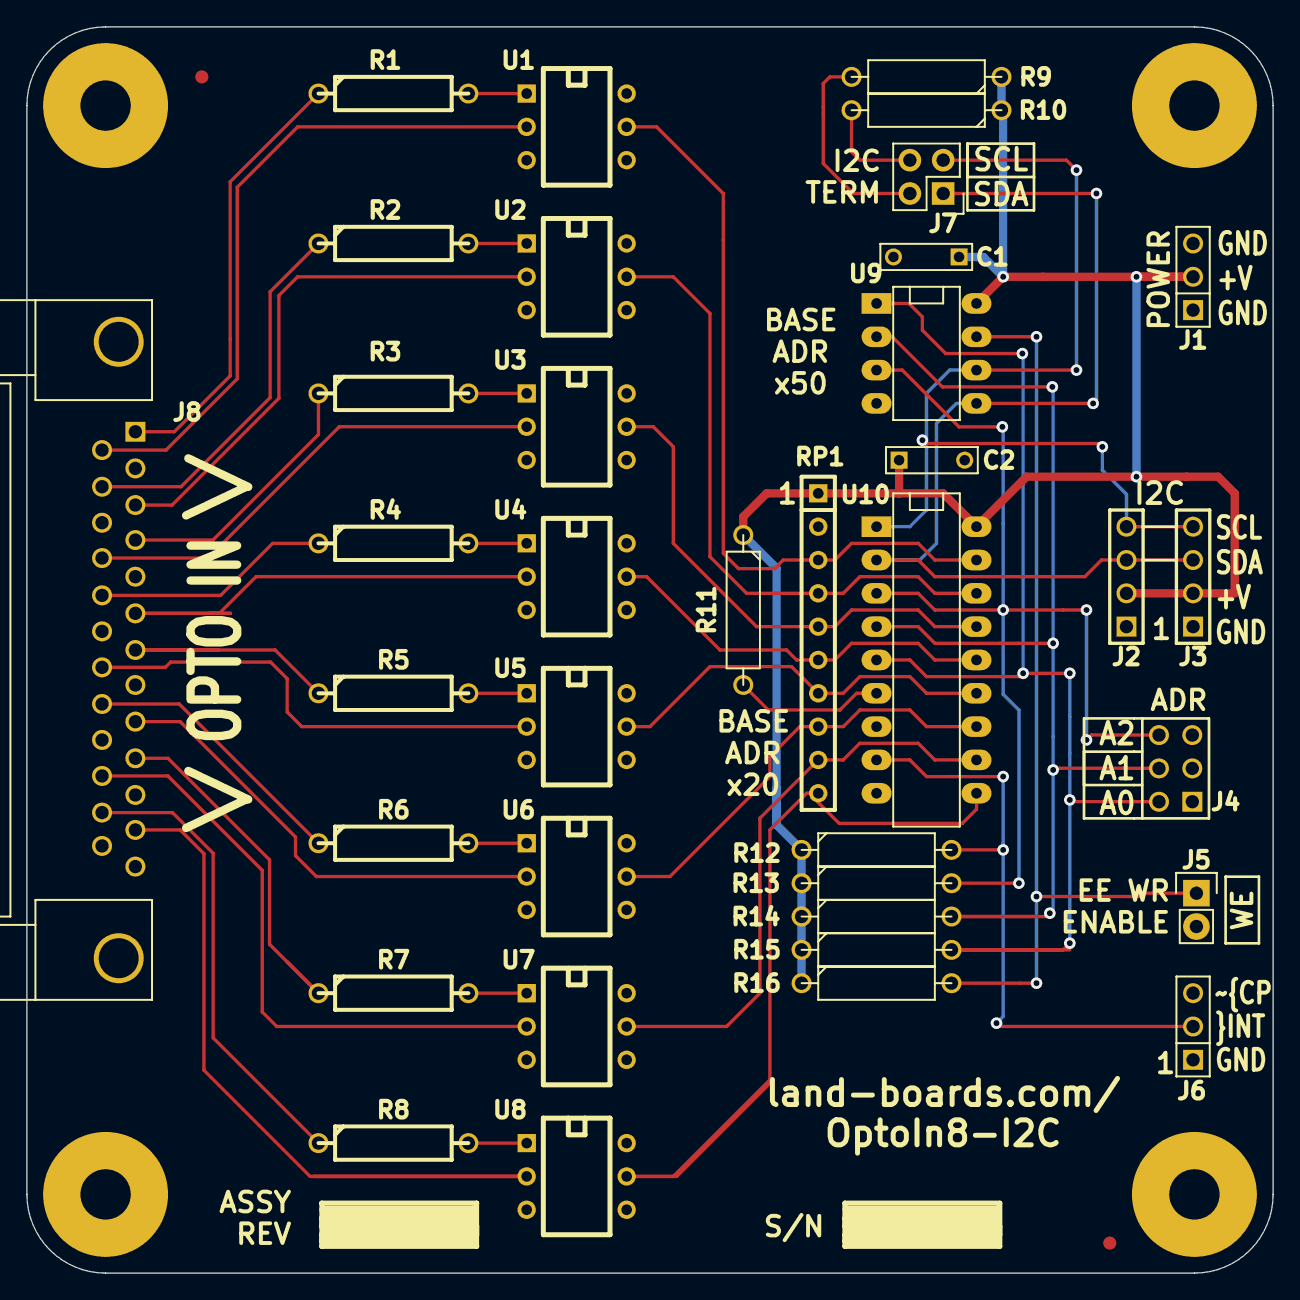
[picture p598: board OptoIn8-I2C.kicad_pcb from above]

Board: 2 copper layers, 95.0 x 95.0 mm, 46 parts (0 on the bottom side), 44 nets.

Other parts of the board:
TESTED: VAL**; TEST_BLK-REAR
