land-boards/lb-boards/Test Equipment Cards/DiffProbe/DiffProbe.kicad_pcb

## KiCad design Test Equipment Cards/DiffProbe/DiffProbe.kicad_pcb (2023-08-08)

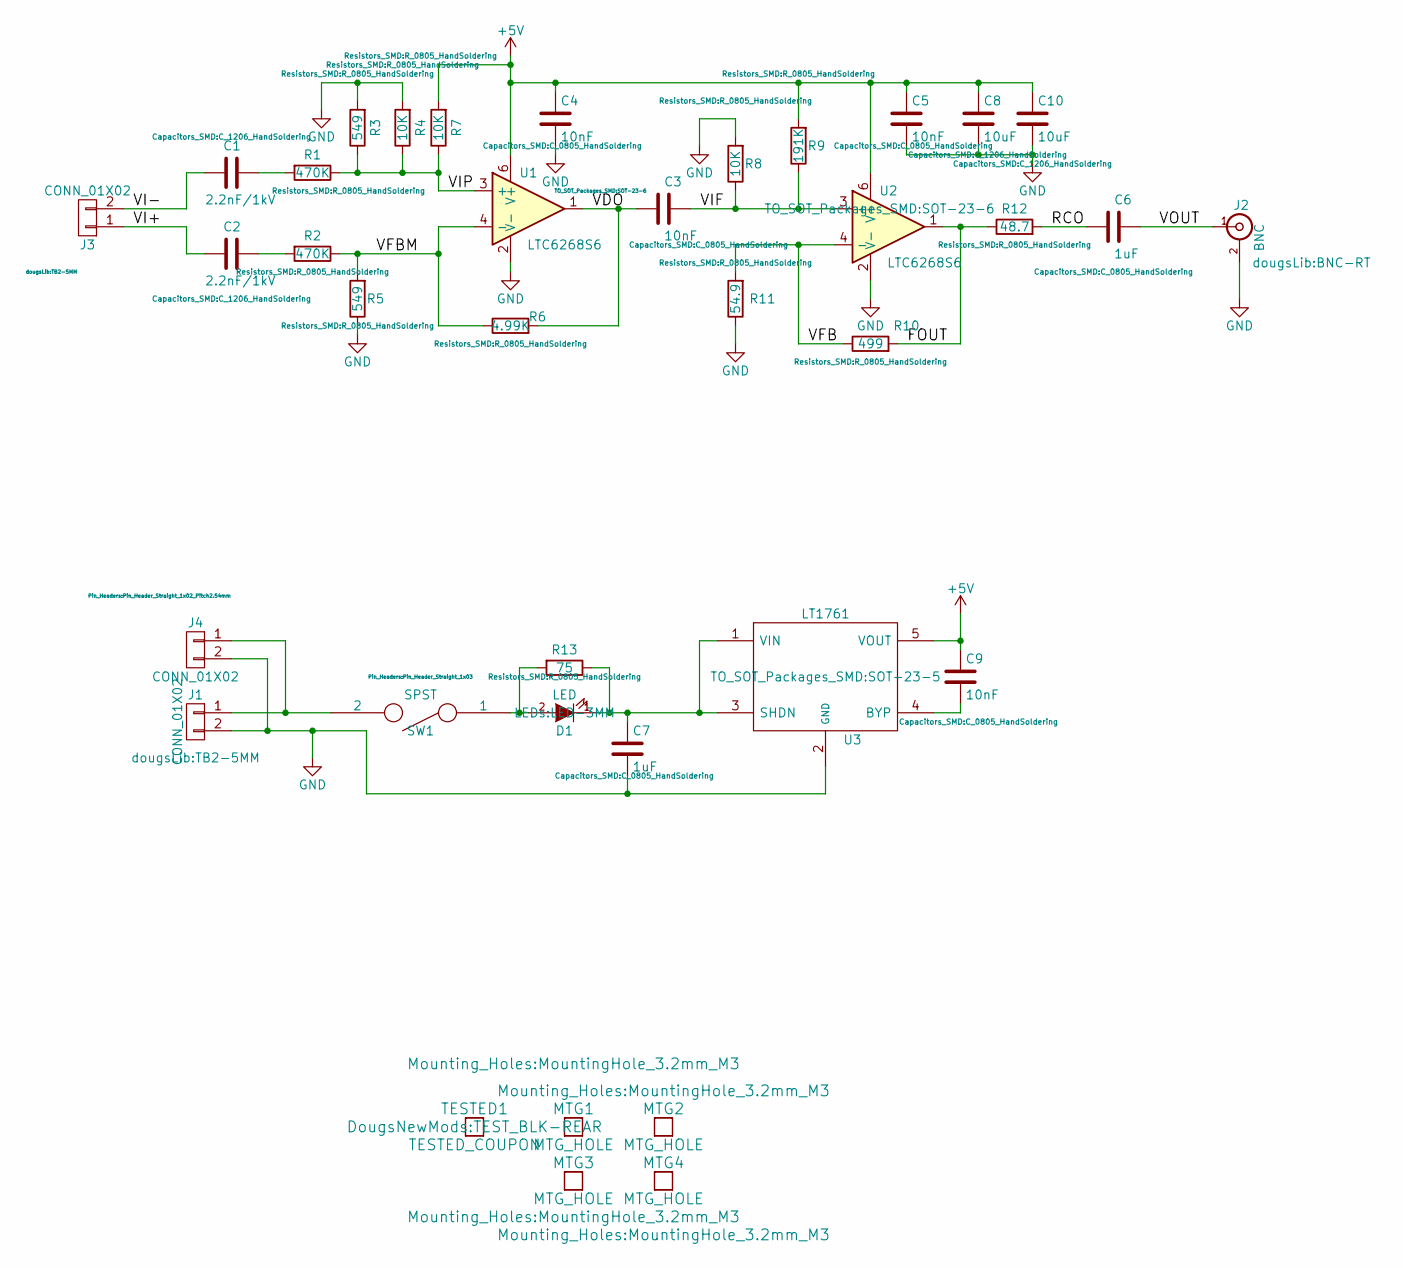
[picture p599: schematic DiffProbe.kicad_sch, Differential Probe]

Parts:
C1, C2: 2.2nF/1kV; C_1206_HandSoldering
C3, C4, C5, C9: 10nF; C_0805_HandSoldering
C6, C7: 1uF; C_0805_HandSoldering
C8, C10: 10uF; C_1206_HandSoldering
D1: LED; LED-3MM
J1, J3: CONN_01X02; TB2-5MM
J2: BNC; BNC-RT
J4: CONN_01X02; Pin_Header_Straight_1x02_Pitch2.54mm
MTG1, MTG2, MTG3, MTG4: MTG_HOLE; MountingHole_3.2mm_M3
R1, R2: 470K; R_0805_HandSoldering
R3, R5: 549; R_0805_HandSoldering
R4, R7, R8: 10K; R_0805_HandSoldering
R6: 4.99K; R_0805_HandSoldering
R9: 191K; R_0805_HandSoldering
R10: 499; R_0805_HandSoldering
R11: 54.9; R_0805_HandSoldering
R12: 48.7; R_0805_HandSoldering
R13: 75; R_0805_HandSoldering
SW1: SPST; Pin_Header_Straight_1x03
TESTED1: TESTED_COUPON; TEST_BLK-REAR
U1, U2: LTC6268S6; SOT-23-6
U3: LT1761; SOT-23-5

Connections:
+5V: C4.1, C5.1, C8.1, C9.1, C10.1, R7.2, R9.2, U1.6 (V+), U2.6 (V+), U3.5 (VOUT)
/FOUT: R10.2, R12.1, U2.1
/RCO: C6.2, R12.2
/VDO: C3.2, R6.2, U1.1
/VFB: R10.1, R11.2, U2.4 (-)
/VFBM: R2.1, R5.2, R6.1, U1.4 (-)
/VI+: C2.2, J3.1
/VI-: C1.2, J3.2
/VIF: C3.1, R8.1, R9.1, U2.3 (+)
/VIP: R1.1, R3.1, R4.1, R7.1, U1.3 (+)
/VOUT: C6.1, J2.1 (In)
GND: C4.2, C5.2, C7.2, C8.2, C10.2, J1.2, J2.2 (Ext), J4.2, R3.2, R4.2, R5.1, R8.2, R11.1, U1.2 (V-), U2.2 (V-), U3.2 (GND)
unnamed: C1.1, R1.2
unnamed: C2.1, R2.2
unnamed: C7.1, D1.1 (K), R13.1, U3.1 (VIN), U3.3 (SHDN)
unnamed: C9.2, U3.4 (BYP)
unnamed: D1.2 (A), R13.2, SW1.1
unnamed: J1.1, J4.1, SW1.2

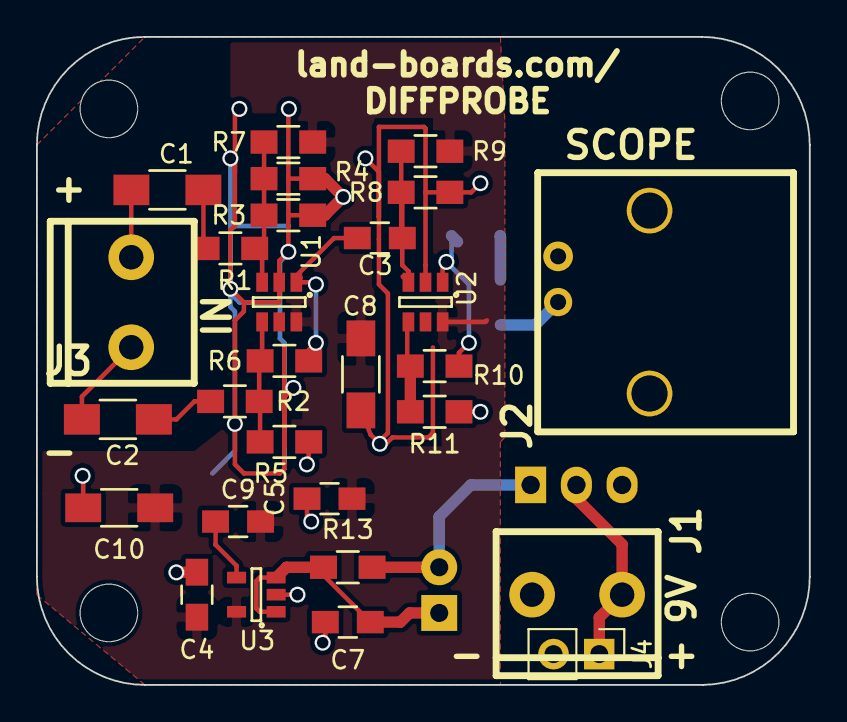
[picture p600: board DiffProbe.kicad_pcb from above]

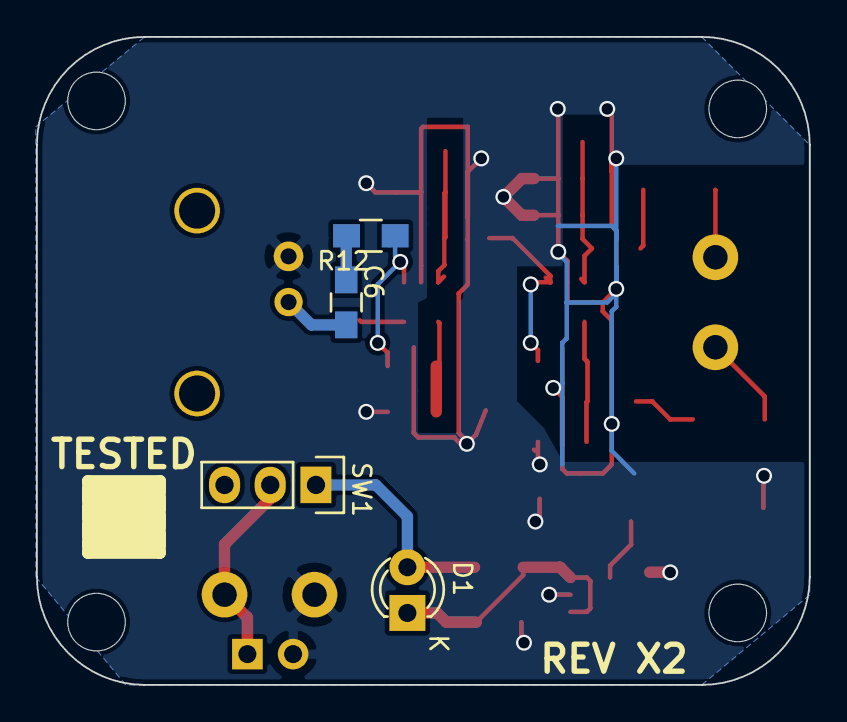
[picture p601: board DiffProbe.kicad_pcb from below]

Board: 2 copper layers, 42.9 x 36.0 mm, 37 parts (4 on the bottom side), 18 nets.

Other parts of the board:
TESTED: TESTED_COUPON; TEST_BLK-REAR
