land-boards/lb-boards/FPGA Cards/FPGA-ITX-01/FPGA-ITX-01.kicad_pcb

## KiCad design FPGA Cards/FPGA-ITX-01/FPGA-ITX-01.kicad_pcb (2023-05-29)

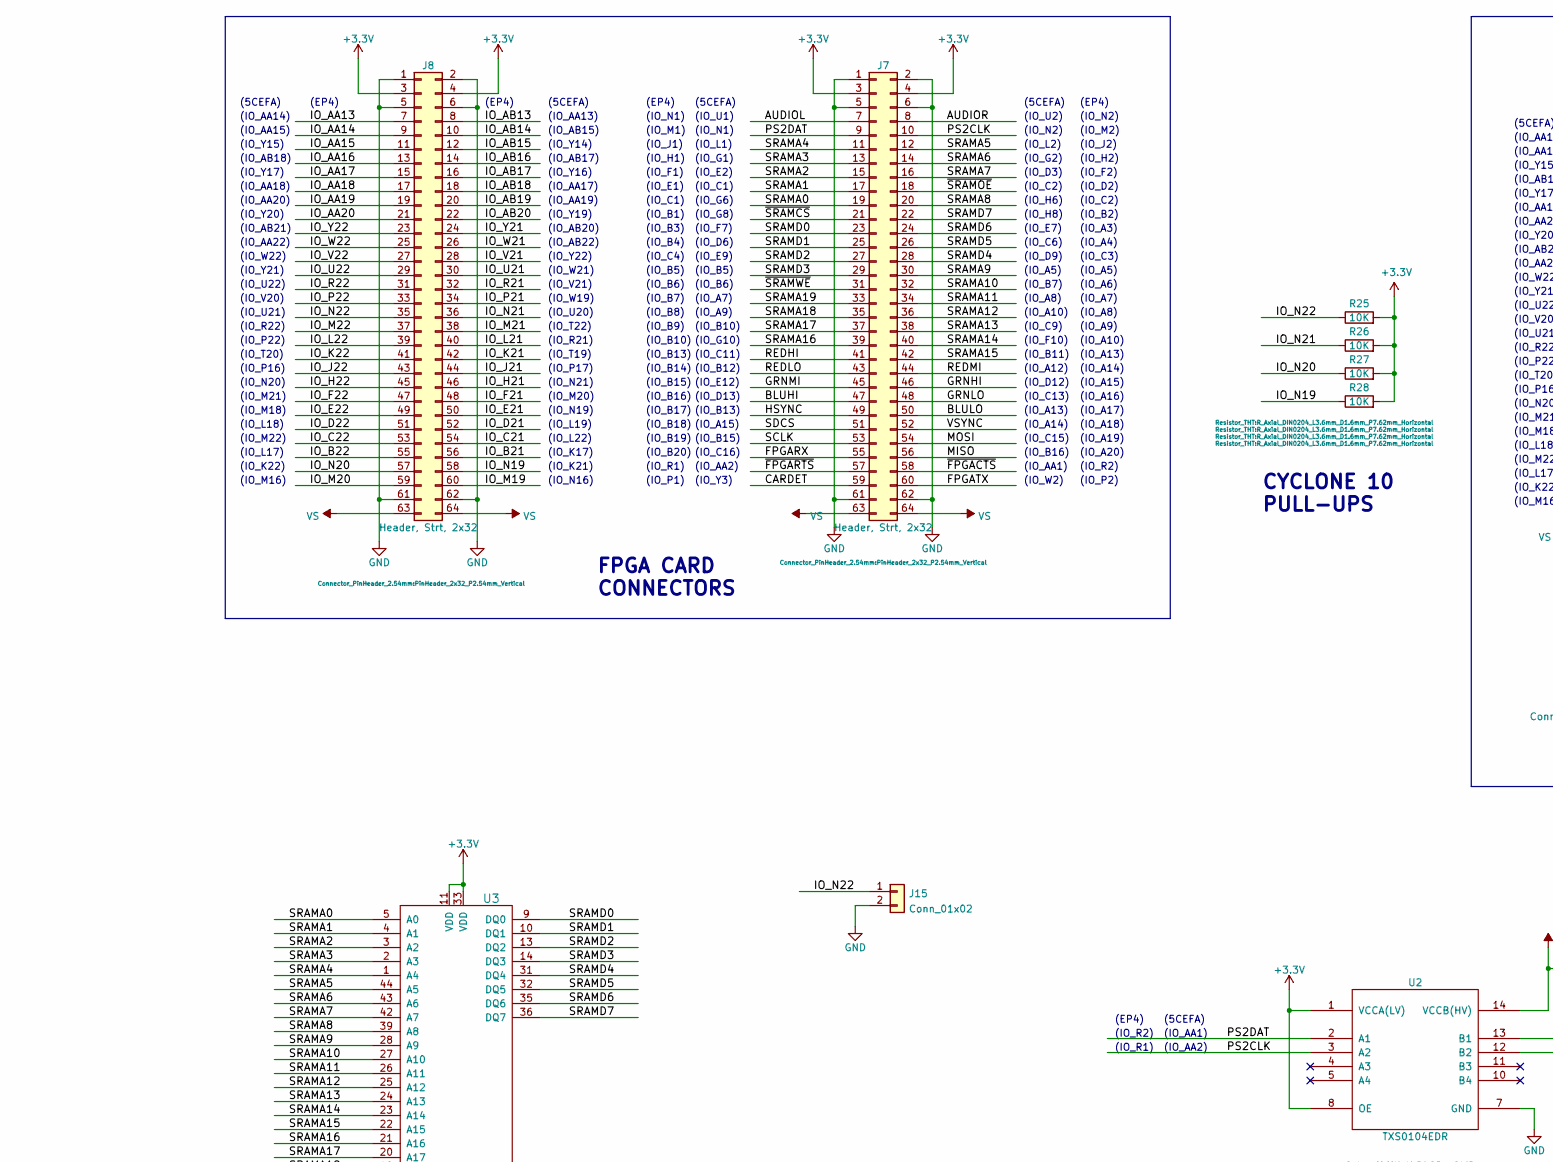
[picture p602: schematic FPGA-ITX-01.kicad_sch, part in row 1, column 1]

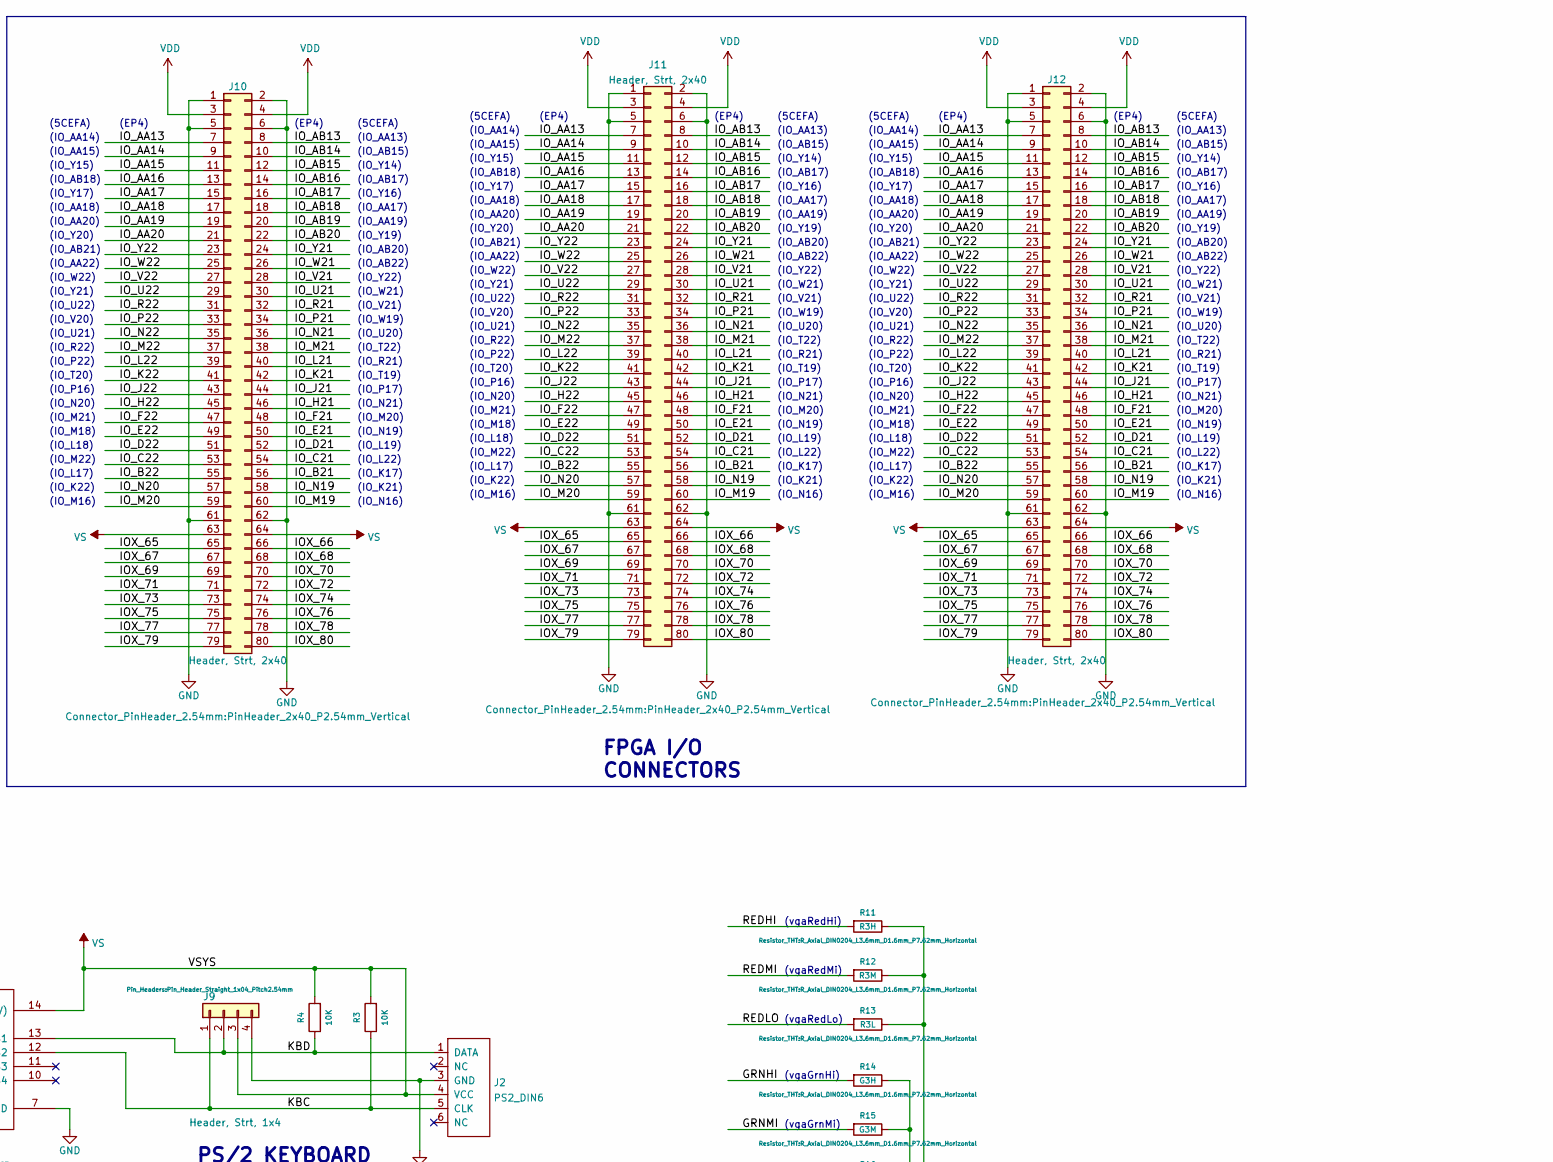
[picture p603: schematic FPGA-ITX-01.kicad_sch, part in row 1, column 2]

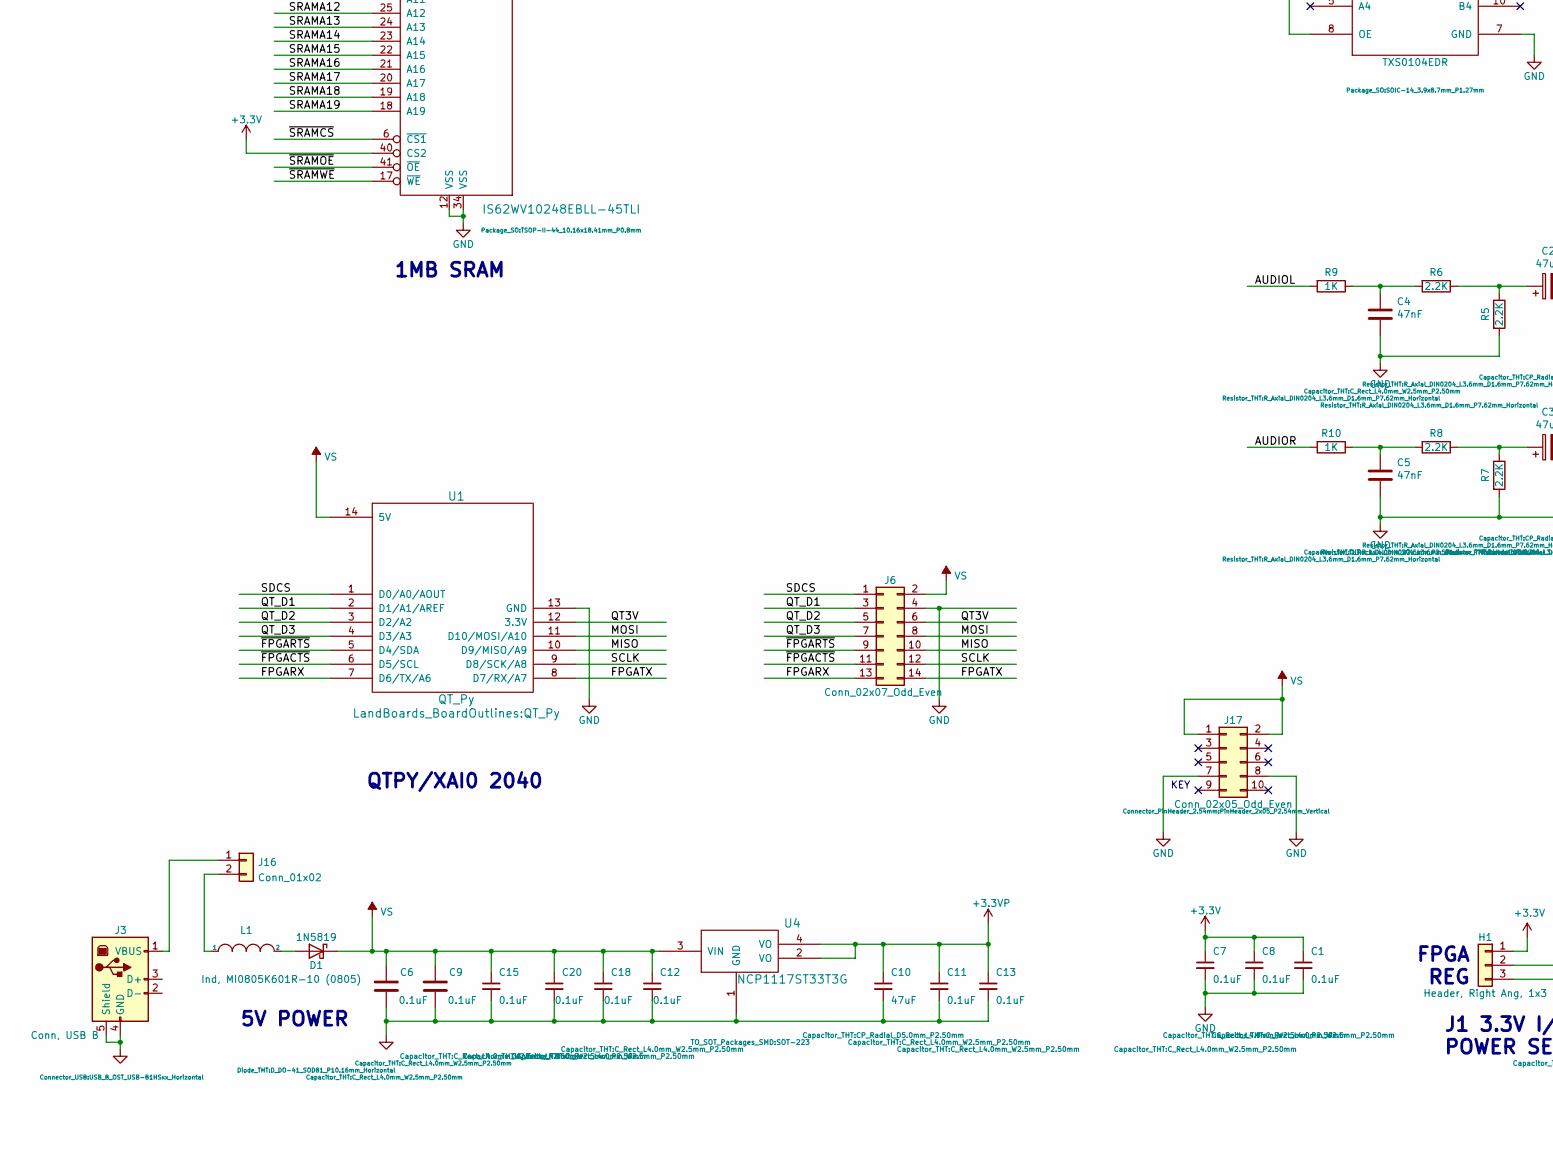
[picture p604: schematic FPGA-ITX-01.kicad_sch, part in row 2, column 1]

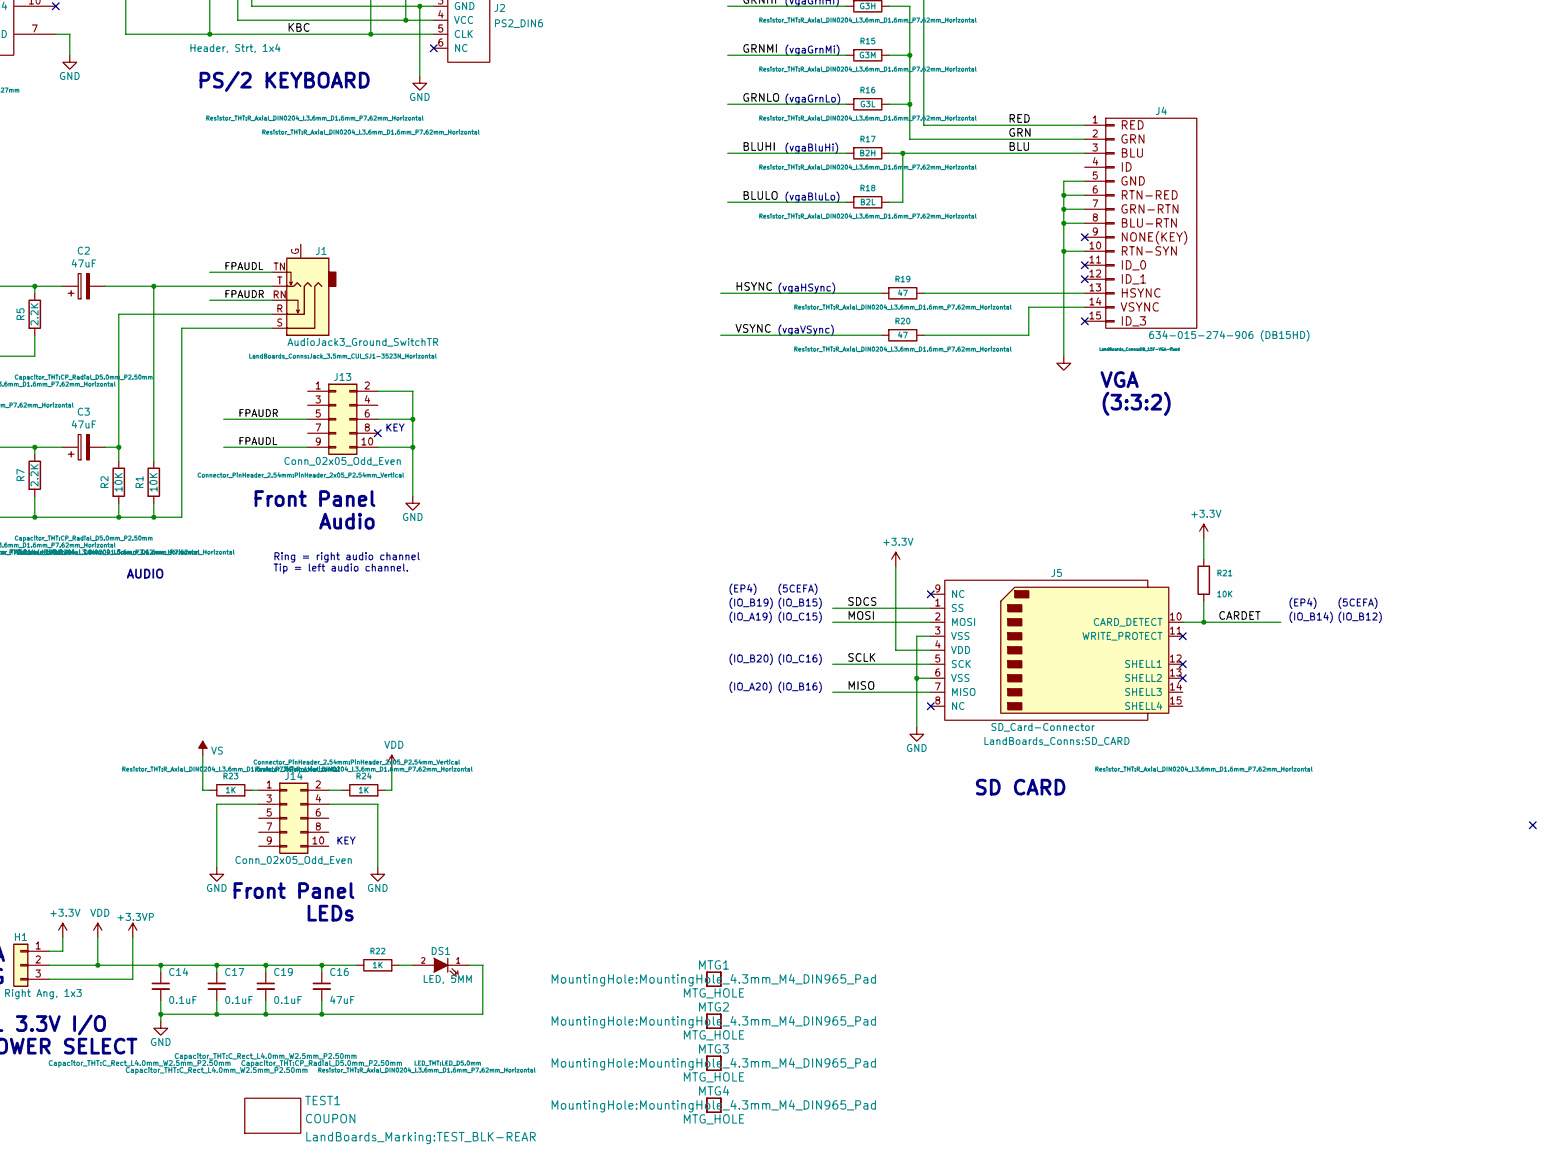
[picture p605: schematic FPGA-ITX-01.kicad_sch, part in row 2, column 2]

Parts:
C1, C6, C7, C8, C9, C11, C12, C13, C14, C15, C17, C18, C19, C20: 0.1uF; C_Rect_L4.0mm_W2.5mm_P2.50mm
C2, C3, C10, C16: 47uF; CP_Radial_D5.0mm_P2.50mm
C4, C5: 47nF; C_Rect_L4.0mm_W2.5mm_P2.50mm
D1: 1N5819; D_DO-41_SOD81_P10.16mm_Horizontal
DS1: LED, 5MM; LED_D5.0mm
H1: Header, Right Ang, 1x3; PinHeader_1x03_P2.54mm_Horizontal
J1: AudioJack3_Ground_SwitchTR; Jack_3.5mm_CUI_SJ1-3523N_Horizontal
J2: PS2_DIN6; Connector_Mini-DIN_Female_6Pin_2rows
J3: Conn, USB B; USB_B_OST_USB-B1HSxx_Horizontal
J4: 634-015-274-906 (DB15HD); DB_15F-VGA-fixed
J5: SD_Card-Connector; SD_CARD
J6: Conn_02x07_Odd_Even; PinHeader_2x07_P2.54mm_Vertical
J7, J8: Header, Strt, 2x32; PinHeader_2x32_P2.54mm_Vertical
J9: Header, Strt, 1x4; Pin_Header_Straight_1x04_Pitch2.54mm
J10, J11, J12: Header, Strt, 2x40; PinHeader_2x40_P2.54mm_Vertical
J13, J14, J17: Conn_02x05_Odd_Even; PinHeader_2x05_P2.54mm_Vertical
J15: Conn_01x02; PinHeader_1x02_P2.54mm_Horizontal
J16: Conn_01x02; PinHeader_1x02_P2.54mm_Vertical
L1: Ind, MI0805K601R-10 (0805); L_0805_2012Metric_Pad1.15x1.40mm_HandSolder
MTG1, MTG2, MTG3, MTG4: MTG_HOLE; MountingHole_4.3mm_M4_DIN965_Pad
R1, R2, R3, R4, R21, R25, R26, R27, R28: 10K; R_Axial_DIN0204_L3.6mm_D1.6mm_P7.62mm_Horizontal
R5, R6, R7, R8: 2.2K; R_Axial_DIN0204_L3.6mm_D1.6mm_P7.62mm_Horizontal
R9, R10, R22, R23, R24: 1K; R_Axial_DIN0204_L3.6mm_D1.6mm_P7.62mm_Horizontal
R11: R3H; R_Axial_DIN0204_L3.6mm_D1.6mm_P7.62mm_Horizontal
R12: R3M; R_Axial_DIN0204_L3.6mm_D1.6mm_P7.62mm_Horizontal
R13: R3L; R_Axial_DIN0204_L3.6mm_D1.6mm_P7.62mm_Horizontal
R14: G3H; R_Axial_DIN0204_L3.6mm_D1.6mm_P7.62mm_Horizontal
R15: G3M; R_Axial_DIN0204_L3.6mm_D1.6mm_P7.62mm_Horizontal
R16: G3L; R_Axial_DIN0204_L3.6mm_D1.6mm_P7.62mm_Horizontal
R17: B2H; R_Axial_DIN0204_L3.6mm_D1.6mm_P7.62mm_Horizontal
R18: B2L; R_Axial_DIN0204_L3.6mm_D1.6mm_P7.62mm_Horizontal
R19, R20: 47; R_Axial_DIN0204_L3.6mm_D1.6mm_P7.62mm_Horizontal
TEST1: COUPON; TEST_BLK-REAR
U1: QT_Py
U2: TXS0104EDR; SOIC-14_3.9x8.7mm_P1.27mm
U3: IS62WV10248EBLL-45TLI; TSOP-II-44_10.16x18.41mm_P0.8mm
U4: NCP1117ST33T3G; SOT-223

Connections:
+3.3VP: C10.1, C11.1, C13.1, H1.3, U4.2 (VO), U4.4 (VO)
+3V3: C1.1, C7.1, C8.1, H1.1, J5.4 (VDD), J7.3, J7.4, J8.3, J8.4, R21.2, R25.2, R26.2, R27.2, R28.2, U2.1 (VCCA(LV)), U2.8 (OE), U3.11 (VDD), U3.33 (VDD), U3.40 (CS2)
/AUDIOL: J7.7, R9.2
/AUDIOR: J7.8, R10.2
/BLU: J4.3, R17.1, R18.1
/BLUHI: J7.47, R17.2
/BLULO: J7.50, R18.2
/CARDET: J5.10 (CARD_DETECT), J7.59, R21.1
/FPAUDL: J1.TN, J13.9
/FPAUDR: J1.RN, J13.5
/FPGARX: J6.13, J7.55, U1.7 (D6/TX/A6)
/FPGATX: J6.14, J7.60, U1.8 (D7/RX/A7)
/GRN: J4.2, R14.1, R15.1, R16.1
/GRNHI: J7.46, R14.2
/GRNLO: J7.48, R16.2
/GRNMI: J7.45, R15.2
/HSYNC: J7.49, R19.2
/IOX_65: J10.65, J11.65, J12.65
/IOX_66: J10.66, J11.66, J12.66
/IOX_67: J10.67, J11.67, J12.67
/IOX_68: J10.68, J11.68, J12.68
/IOX_69: J10.69, J11.69, J12.69
/IOX_70: J10.70, J11.70, J12.70
/IOX_71: J10.71, J11.71, J12.71
/IOX_72: J10.72, J11.72, J12.72
/IOX_73: J10.73, J11.73, J12.73
/IOX_74: J10.74, J11.74, J12.74
/IOX_75: J10.75, J11.75, J12.75
/IOX_76: J10.76, J11.76, J12.76
/IOX_77: J10.77, J11.77, J12.77
/IOX_78: J10.78, J11.78, J12.78
/IOX_79: J10.79, J11.79, J12.79
/IOX_80: J10.80, J11.80, J12.80
/IO_AA13: J8.7, J10.7, J11.7, J12.7
/IO_AA14: J8.9, J10.9, J11.9, J12.9
/IO_AA15: J8.11, J10.11, J11.11, J12.11
/IO_AA16: J8.13, J10.13, J11.13, J12.13
/IO_AA17: J8.15, J10.15, J11.15, J12.15
/IO_AA18: J8.17, J10.17, J11.17, J12.17
/IO_AA19: J8.19, J10.19, J11.19, J12.19
/IO_AA20: J8.21, J10.21, J11.21, J12.21
/IO_AB13: J8.8, J10.8, J11.8, J12.8
/IO_AB14: J8.10, J10.10, J11.10, J12.10
/IO_AB15: J8.12, J10.12, J11.12, J12.12
/IO_AB16: J8.14, J10.14, J11.14, J12.14
/IO_AB17: J8.16, J10.16, J11.16, J12.16
/IO_AB18: J8.18, J10.18, J11.18, J12.18
/IO_AB19: J8.20, J10.20, J11.20, J12.20
/IO_AB20: J8.22, J10.22, J11.22, J12.22
/IO_B21: J8.56, J10.56, J11.56, J12.56
/IO_B22: J8.55, J10.55, J11.55, J12.55
/IO_C21: J8.54, J10.54, J11.54, J12.54
/IO_C22: J8.53, J10.53, J11.53, J12.53
/IO_D21: J8.52, J10.52, J11.52, J12.52
/IO_D22: J8.51, J10.51, J11.51, J12.51
/IO_E21: J8.50, J10.50, J11.50, J12.50
/IO_E22: J8.49, J10.49, J11.49, J12.49
/IO_F21: J8.48, J10.48, J11.48, J12.48
/IO_F22: J8.47, J10.47, J11.47, J12.47
/IO_H21: J8.46, J10.46, J11.46, J12.46
/IO_H22: J8.45, J10.45, J11.45, J12.45
/IO_J21: J8.44, J10.44, J11.44, J12.44
/IO_J22: J8.43, J10.43, J11.43, J12.43
/IO_K21: J8.42, J10.42, J11.42, J12.42
/IO_K22: J8.41, J10.41, J11.41, J12.41
/IO_L21: J8.40, J10.40, J11.40, J12.40
/IO_L22: J8.39, J10.39, J11.39, J12.39
/IO_M19: J8.60, J10.60, J11.60, J12.60
/IO_M20: J8.59, J10.59, J11.59, J12.59
/IO_M21: J8.38, J10.38, J11.38, J12.38
/IO_M22: J8.37, J10.37, J11.37, J12.37
/IO_N19: J8.58, J10.58, J11.58, J12.58, R28.1
/IO_N20: J8.57, J10.57, J11.57, J12.57, R27.1
/IO_N21: J8.36, J10.36, J11.36, J12.36, R26.1
/IO_N22: J8.35, J10.35, J11.35, J12.35, J15.1, R25.1
/IO_P21: J8.34, J10.34, J11.34, J12.34
/IO_P22: J8.33, J10.33, J11.33, J12.33
/IO_R21: J8.32, J10.32, J11.32, J12.32
/IO_R22: J8.31, J10.31, J11.31, J12.31
/IO_U21: J8.30, J10.30, J11.30, J12.30
/IO_U22: J8.29, J10.29, J11.29, J12.29
/IO_V21: J8.28, J10.28, J11.28, J12.28
/IO_V22: J8.27, J10.27, J11.27, J12.27
/IO_W21: J8.26, J10.26, J11.26, J12.26
/IO_W22: J8.25, J10.25, J11.25, J12.25
/IO_Y21: J8.24, J10.24, J11.24, J12.24
/IO_Y22: J8.23, J10.23, J11.23, J12.23
/KBC: J2.5 (CLK), J9.1, R3.1, U2.12 (B2)
/KBD: J2.1 (DATA), J9.2, R4.1, U2.13 (B1)
/MISO: J5.7 (MISO), J6.10, J7.56, U1.10 (D9/MISO/A9)
/MOSI: J5.2 (MOSI), J6.8, J7.54, U1.11 (D10/MOSI/A10)
/PS2CLK: J7.10, U2.3 (A2)
/PS2DAT: J7.9, U2.2 (A1)
/QT3V: J6.6, U1.12 (3.3V)
/QT_D1: J6.3, U1.2 (D1/A1/AREF)
/QT_D2: J6.5, U1.3 (D2/A2)
/QT_D3: J6.7, U1.4 (D3/A3)
/RED: J4.1, R11.1, R12.1, R13.1
/REDHI: J7.41, R11.2
/REDLO: J7.43, R13.2
/REDMI: J7.44, R12.2
/SCLK: J5.5 (SCK), J6.12, J7.53, U1.9 (D8/SCK/A8)
/SDCS: J5.1 (SS), J6.1, J7.51, U1.1 (D0/A0/AOUT)
/SRAMA0: J7.19, U3.5 (A0)
/SRAMA1: J7.17, U3.4 (A1)
/SRAMA2: J7.15, U3.3 (A2)
/SRAMA3: J7.13, U3.2 (A3)
/SRAMA4: J7.11, U3.1 (A4)
/SRAMA5: J7.12, U3.44 (A5)
/SRAMA6: J7.14, U3.43 (A6)
/SRAMA7: J7.16, U3.42 (A7)
/SRAMA8: J7.20, U3.39 (A8)
/SRAMA9: J7.30, U3.28 (A9)
/SRAMA10: J7.32, U3.27 (A10)
/SRAMA11: J7.34, U3.26 (A11)
/SRAMA12: J7.36, U3.25 (A12)
/SRAMA13: J7.38, U3.24 (A13)
/SRAMA14: J7.40, U3.23 (A14)
/SRAMA15: J7.42, U3.22 (A15)
/SRAMA16: J7.39, U3.21 (A16)
/SRAMA17: J7.37, U3.20 (A17)
/SRAMA18: J7.35, U3.19 (A18)
/SRAMA19: J7.33, U3.18 (A19)
/SRAMD0: J7.23, U3.9 (DQ0)
/SRAMD1: J7.25, U3.10 (DQ1)
/SRAMD2: J7.27, U3.13 (DQ2)
/SRAMD3: J7.29, U3.14 (DQ3)
/SRAMD4: J7.28, U3.31 (DQ4)
/SRAMD5: J7.26, U3.32 (DQ5)
/SRAMD6: J7.24, U3.35 (DQ6)
/SRAMD7: J7.22, U3.36 (DQ7)
/VSYNC: J7.52, R20.2
/~FPGACTS: J6.11, J7.58, U1.6 (D5/SCL)
/~FPGARTS: J6.9, J7.57, U1.5 (D4/SDA)
/~SRAMCS: J7.21, U3.6 (~CS1)
/~SRAMOE: J7.18, U3.41 (~OE)
/~SRAMWE: J7.31, U3.17 (~WE)
GND: C1.2, C4.2, C5.2, C6.2, C7.2, C8.2, C9.2, C10.2, C11.2, C12.2, C13.2, C14.2, C15.2, C16.2, C17.2, C18.2, C19.2, C20.2, DS1.1 (K), J1.S, J2.3 (GND), J3.4 (GND), J3.5 (Shield), J4.5, J4.6, J4.7, J4.8, J4.10, J5.3 (VSS), J5.6 (VSS), J6.4, J7.1, J7.2, J7.5, J7.6, J7.61, J7.62, J8.1, J8.2, J8.5, J8.6, J8.61, J8.62, J9.4, J10.1, J10.2, J10.5, J10.6, J10.61, J10.62, J11.1, J11.2, J11.5, J11.6, J11.61, J11.62, J12.1, J12.2, J12.5, J12.6, J12.61, J12.62, J13.2, J13.6, J13.10, J14.3, J14.4, J15.2, J17.7, J17.8, R1.2, R2.2, R5.2, R7.2, U1.13 (GND), U2.7 (GND), U3.12 (VSS), U3.34 (VSS), U4.1 (GND)
unnamed: C2.1, R5.1, R6.1
unnamed: C2.2, J1.T, R1.1
unnamed: C3.1, R7.1, R8.1
unnamed: C3.2, J1.R, R2.1
unnamed: C4.1, R6.2, R9.1
unnamed: C5.1, R8.2, R10.1
unnamed: D1.2 (A), L1.2
unnamed: DS1.2 (A), R22.2
unnamed: J4.13, R19.1
unnamed: J4.14, R20.1
unnamed: J14.1, R23.2
unnamed: J14.2, R24.1
unnamed: J3.1 (VBUS), J16.1
unnamed: J16.2, L1.1
VDD: C14.1, C16.1, C17.1, C19.1, H1.2, J10.3, J10.4, J11.3, J11.4, J12.3, J12.4, R22.1, R24.2
VS: C6.1, C9.1, C12.1, C15.1, C18.1, C20.1, D1.1 (K), J2.4 (VCC), J6.2, J7.63, J7.64, J8.63, J8.64, J9.3, J10.63, J10.64, J11.63, J11.64, J12.63, J12.64, J17.1, J17.2, R3.2, R4.2, R23.1, U1.14 (5V), U2.14 (VCCB(HV)), U4.3 (VIN)

Notes on the sheet:
(IO_B5)
(IO_B18)
(IO_AA20)
(IO_B10)
(IO_K22)
(EP4)
(IO_Y19)
(IO_J1)
(IO_R2)
(IO_M18)
(IO_B17)
(IO_K21)
(IO_C2)
(IO_AA2)
(IO_A13)
(5CEFA)
1MB SRAM
(IO_AA1)
(IO_T22)
(vgaVSync)
(IO_A5)
(IO_Y15)
(IO_N20)
(IO_N21)
(vgaRedLo)
(IO_N1)
(IO_L18)
(IO_L17)
(vgaBluLo)
(IO_AA17)
(IO_N19)
Ring = right audio channel Tip = left audio channel.
(IO_H8)
(vgaHSync)
(IO_AA13)
Front Panel Audio
(IO_P17)
(IO_W22)
(IO_C15)
(IO_B7)
5V POWER
(IO_A14)
(IO_B6)
(IO_A3)
(IO_N2)
(IO_E9)
(IO_P2)
(IO_Y17)
(vgaGrnHi)
(IO_R22)
(IO_AA22)
(IO_U22)
(IO_H1)
(IO_B19)
(IO_A15)
(IO_Y14)
(IO_A6)
(IO_M20)
(IO_G2)
(IO_R21)
(IO_P1)
(IO_AB22)
(IO_AB17)
(IO_A16)
(IO_AB21)
FPGA CARD CONNECTORS
(IO_L22)
(IO_M1)
(IO_L1)
(IO_Y20)
(IO_A7)
(vgaRedHi)
(IO_N16)
(IO_AB18)
(IO_Y22)
(IO_A17)
(IO_A19)
(vgaBluHi)
(IO_AA18)
(IO_M22)
(IO_K17)
(IO_T19)
(IO_U21)
(IO_V21)
(IO_AA19)
(IO_A18)
(IO_A9)
(IO_AB20)
(IO_V20)
(IO_G1)
(IO_P16)
(IO_AA15)
(IO_P22)
(IO_A4)
(IO_C16)
(IO_Y21)
J1 3.3V I/O POWER SELECT
PS/2 KEYBOARD
(IO_H6)
(IO_AA14)
QTPY/XAI0 2040
(IO_C4)
(IO_R1)
(IO_M21)
(IO_B4)
(IO_D6)
(IO_A12)
(IO_W19)
(IO_B1)
(IO_B11)
(IO_L19)
(IO_B16)
(IO_D12)
Front Panel LEDs
(IO_C1)
(IO_U2)
(vgaGrnMi)
(IO_U1)
(IO_A8)
(IO_Y16)
(IO_T20)
(IO_B12)
(IO_AB15)
(IO_B13)
(IO_M16)
(IO_D13)
(IO_D2)
(IO_B15)
(IO_W21)
(IO_G6)
(IO_F2)
SD CARD
(IO_B14)
(IO_B8)
(IO_A10)
(IO_C13)
CYCLONE 10 PULL-UPS
(IO_U20)
(IO_E1)
(IO_G10)
(IO_F1)
(IO_E7)
(IO_B20)
(IO_B2)
(IO_A20)
(IO_D3)
(IO_Y3)
(IO_F7)
(IO_C11)
(IO_C9)
(vgaRedMi)
(IO_B3)
(IO_G8)
(IO_H2)
KEY
(IO_C3)
(IO_E12)
(IO_J2)
(IO_D9)
(IO_L2)
(IO_F10)
VGA (3:3:2)
(IO_E2)
(vgaGrnLo)
(IO_C6)
(IO_W2)
FPGA I/O CONNECTORS
AUDIO
(IO_B9)
FPGA REG
(IO_M2)

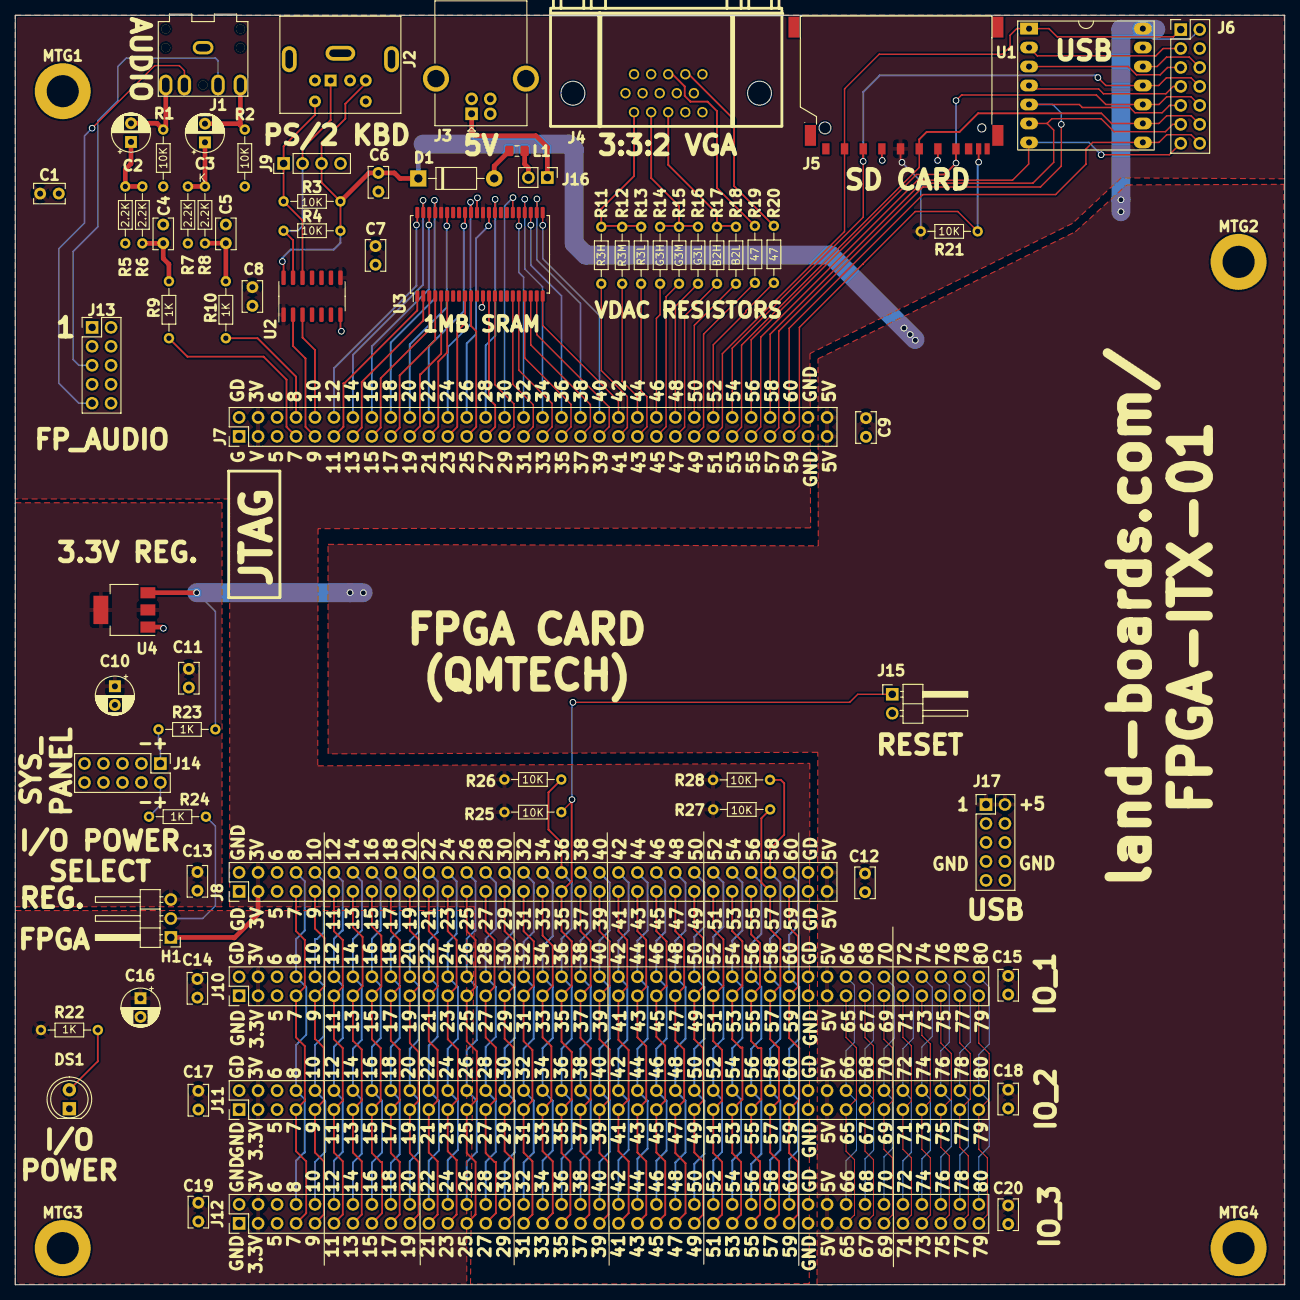
[picture p606: board FPGA-ITX-01.kicad_pcb from above]

Board: 2 copper layers, 170.0 x 170.0 mm, 78 parts (0 on the bottom side), 154 nets.

Other parts of the board:
TEST: COUPON; TEST_BLK-REAR
