land-boards/lb-boards/Projects/RadioDesign/RadioICs/SI4735-master/extras/schematic/SI4735.brd

## EAGLE design Projects/RadioDesign/RadioICs/SI4735-master/extras/schematic/SI4735.brd (2020-11-30)

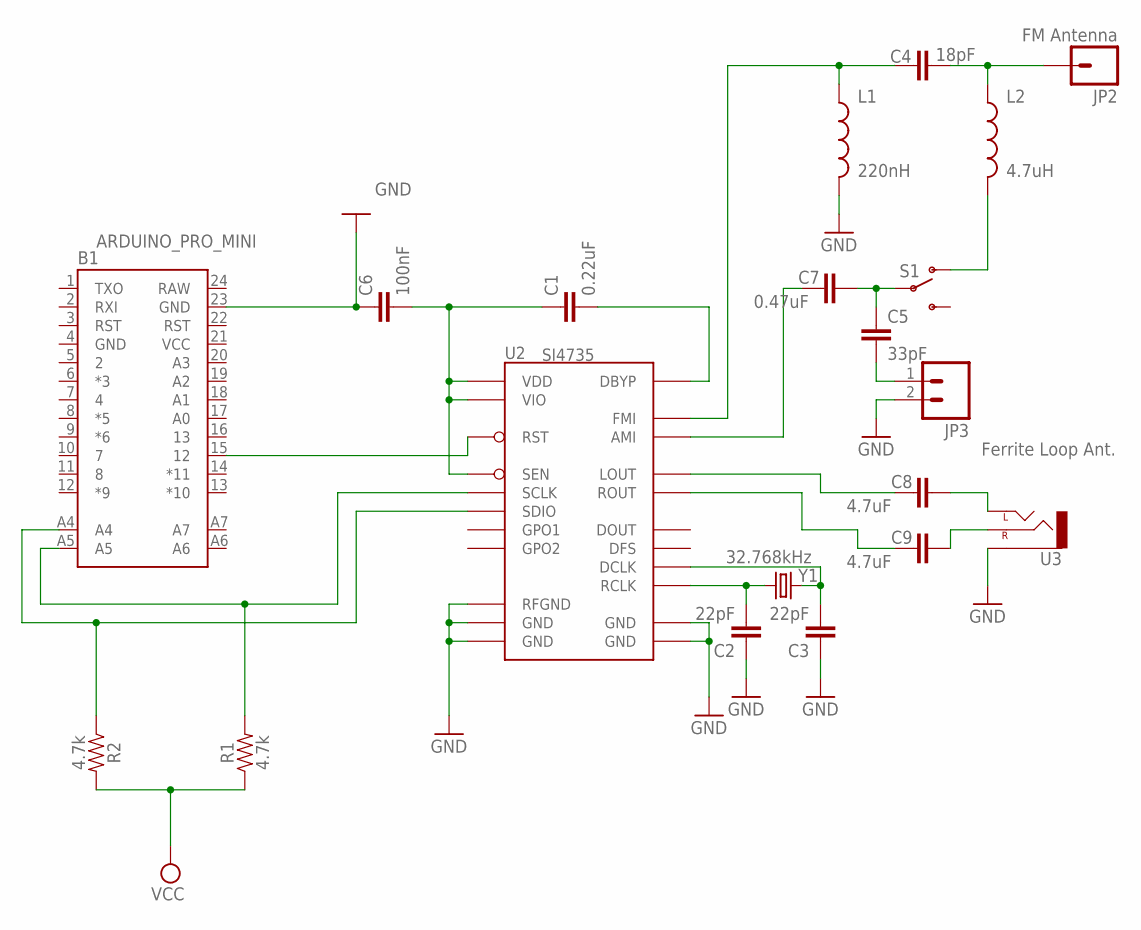
[picture p607: schematic SI4735.sch]

Parts:
B1: ARDUINO_PRO_MINI
C1: 0.22uF; 0402-CAP
C2, C3: 22pF; 0402-CAP
C4: 18pF; 0402-CAP
C5: 33pF; 0402-CAP
C6: 100nF; 0402-CAP
C7: 0.47uF; 0402-CAP
C8, C9: 4.7uF; 0402-CAP
JP2: FM Antenna; 1X01
JP3: Ferrite Loop Ant.; 1X02
L1: 220nH; C0402
L2: 4.7uH; C0402
R1, R2: 4.7k; 0603
S1: SWITCH-SPSTSMD; AYZ0202
U2: SI4735; SSOP24_NARROW
U3: AUDIO-JACKSMD2; AUDIO-JACK-3.5MM-SMD
Y1: 32.768kHz; CRYSTAL-32KHZ-SMD

Connections:
GND: B1.4 (GND), B1.23 (GND), C2.1, C3.1, C6.1, JP3.2, L1.2, U2.9 (RFGND), U2.10 (GND), U2.11 (GND), U2.13 (GND), U2.14 (GND), U3.SLEEVE
unnamed: C2.2, U2.19 (RCLK), Y1.X1 (1)
unnamed: C3.2, U2.3 (DCLK), Y1.X2 (2)
unnamed: B1.15 (12), U2.15 (RST)
unnamed: C1.2, U2.22 (DBYP)
unnamed: B1.A5, R1.2, U2.17 (SCLK)
unnamed: B1.A4, R2.1, U2.18 (SDIO)
unnamed: C4.1, L1.1, U2.8 (FMI)
unnamed: C4.2, JP2.1, L2.1
unnamed: L2.2, S1.1 (O)
unnamed: C5.1, C7.1, S1.2
unnamed: C7.2, U2.12 (AMI)
unnamed: C5.2, JP3.1
unnamed: C9.1, U3.RING (RIGHT)
unnamed: C8.1, U3.TIP (LEFT)
unnamed: C8.2, U2.24 (LOUT)
unnamed: C9.2, U2.23 (ROUT)
RAD_PWR: C1.1, C6.2, U2.16 (SEN), U2.20 (VIO), U2.21 (VDD)
RAW: B1.24 (RAW)
VCC: B1.21 (VCC), R1.1, R2.2

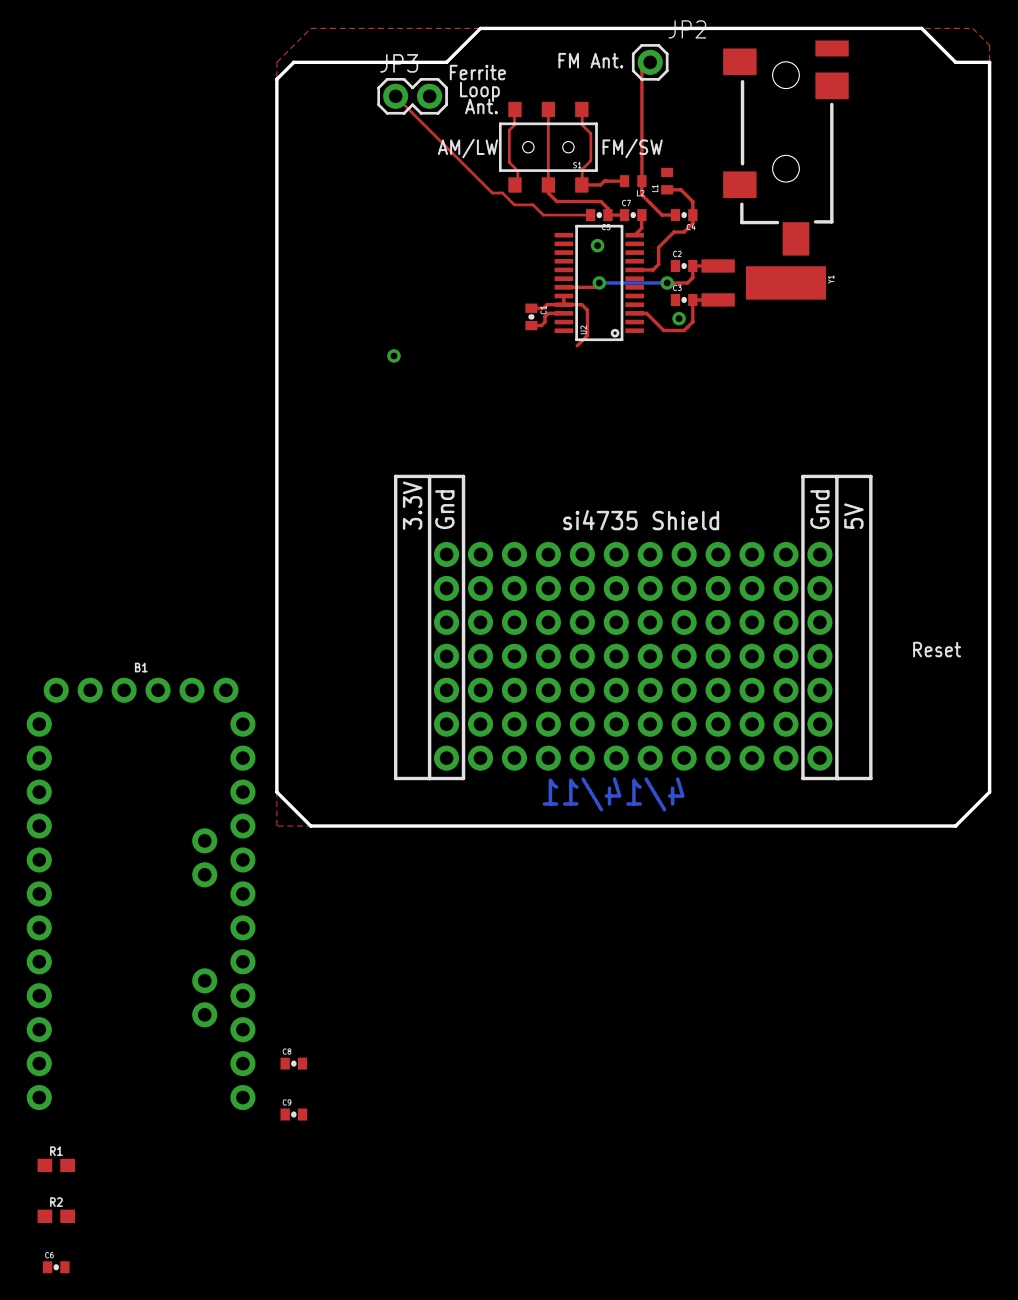
[picture p608: board SI4735.brd from above]

Board: 2 copper layers, 53.3 x 59.7 mm, 20 parts (0 on the bottom side), 19 nets.
