land-boards/lb-boards/GVSDuino/GVSDuino-X5.sch

## KiCad design GVSDuino/GVSDuino-X5.sch (2014-12-31)

Schematic: GVSDuino-X5.sch

Parts:
C1, C2, C3, C5: 0.1uF
C4: CP
C6, C7: 0.1uF; C1
D1: 1N4004
J1: CONN_3
J2: DCJ0202; JACK-3.5MM
J3: CONN_6X2
J4: CONN_6
K1, K2, K3, K4, K5, K6, K7, K8, K9, K10, K11, K12, K13, K14, K15, K16, K17, K18, K19, K20, K21: CONN_3
MTG1, MTG2, MTG3, MTG4: CONN_1
R1: 10K
U1: ATMEGA328-PU; atmega8-DIL28-3
U2: AP1117
Y1: 16MHz

Notes on the sheet:
FTDI CONNECTOR
POWER SELECTION
ANALOG INPUTS
Voltage Selector
Power from +5V
Power from AREF
DIGITAL I/O
SPI/ATProgHead
VOLTAGE REGULATOR
Power from Regulator
Power from FTDI
