land-boards/lb-boards/OptoIn8/OptoIn8.sch

## KiCad design OptoIn8/OptoIn8.sch (2014-05-19)

Schematic: OptoIn8.sch

Parts:
FID1, FID2: ADAFRUIT_FIDUCIAL
IC1, IC2, IC3, IC4, IC5, IC6, IC7, IC8: 4N26; DIP6
J1: DB15
J2: DB25
MTG1, MTG2, MTG3, MTG4: MTG_HOLE
R1, R2, R3, R4, R5, R6, R7, R8, R9, R10, R11, R12, R13, R14, R15, R16: R
ST1: CONN_1
ST2: REV-HIST

Notes on the sheet:
TTS SIDE
U70X SIDE
