land-boards/lb-boards/PC-Case-SwLED/PC-Case-SwLED.sch

## KiCad design PC-Case-SwLED/PC-Case-SwLED.sch (2016-06-28)

Schematic: PC-Case-SwLED.sch

Parts:
COUP?1: COUPON; REV_BLOCK
D1: LED; LED-5MM
F1: FUSE; R_1206_HandSoldering
FID1, FID2: CONN_1; FIDUCIAL
J1: RASPIO; Pin_Header_Straight_2x13
J2: CONN_02X05; Pin_Header_Straight_2x05
J3: USB-MICRO-B; USB_Micro-B-Wellco-SMT
R1, R2, R3, R4: 120; R_0805_HandSoldering
R5, R6: DNP; R_0805_HandSoldering
R7: 2.2K; R_0805_HandSoldering
