land-boards/lb-boards/Arduino Cards/ATProg/ATProg-Sht2.sch

## KiCad design Arduino Cards/ATProg/ATProg-Sht2.sch (2013-09-18)

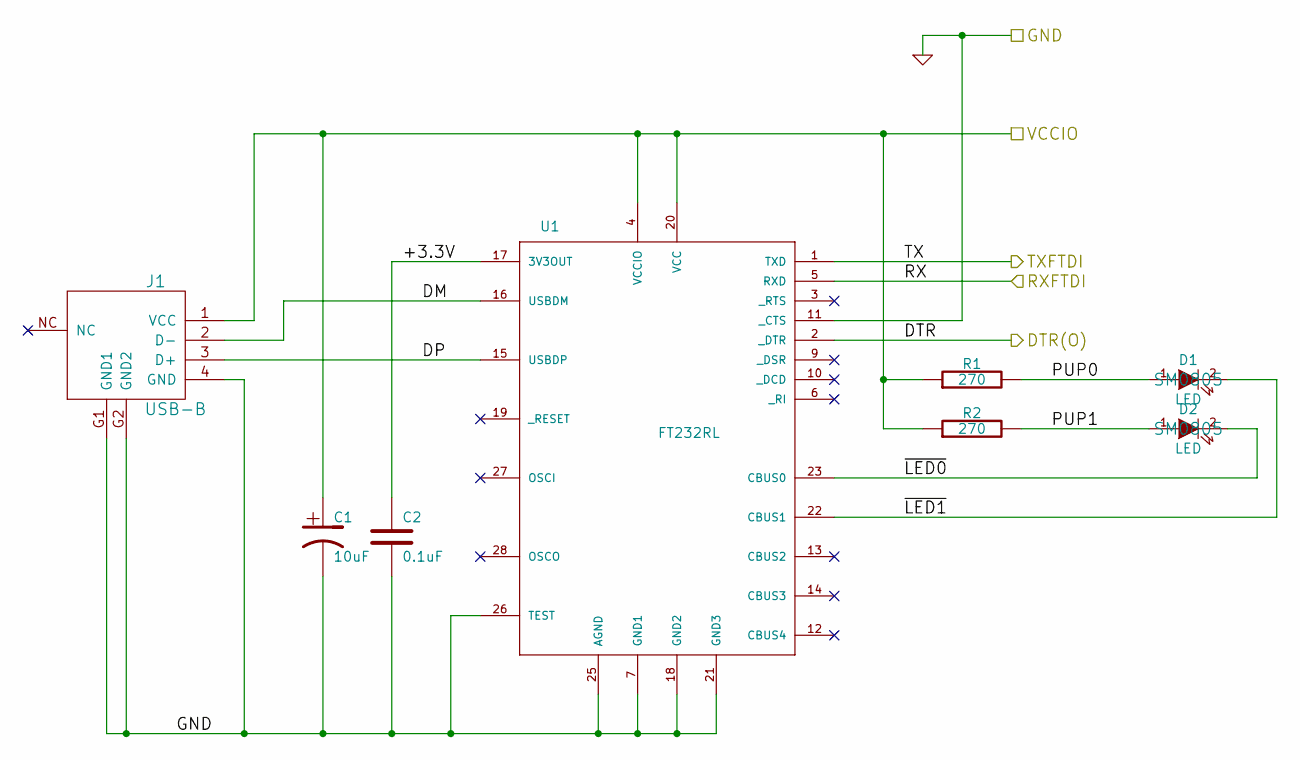
[picture p609: schematic ATProg-Sht2.sch]

Parts:
C1: 10uF; SM1210; MfgPN CC121ZKY5V8BB106
C2: 0.1uF; SM0805; MfgPN GRM155F51E104ZA1J
D1, D2: LED; SM0805
J1: USB-B; USB-B-MINI; MfgPN UX60SC-MB-5ST(80)
R1: 270; SM0805; MfgPN CRG0805F270R
R2: 270; SM0805
U1: FT232RL; SSOP28; MfgPN FT232RL-REEL

Connections:
+3.3V: C2.1, U1.17 (3V3OUT)
DM: J1.2 (D-), U1.16 (USBDM)
DP: J1.3 (D+), U1.15 (USBDP)
DTR: U1.2 (_DTR)
GND: C1.2, C2.2, J1.4 (GND), J1.G1 (GND1), J1.G2 (GND2), U1.7 (GND1), U1.11 (_CTS), U1.18 (GND2), U1.21 (GND3), U1.25 (AGND), U1.26 (TEST)
PUP0: D1.1 (A), R1.2
PUP1: D2.1 (A), R2.2
RX: U1.5 (RXD)
TX: U1.1 (TXD)
VCCIO: C1.1, J1.1 (VCC), R1.1, R2.1, U1.4 (VCCIO), U1.20 (VCC)
~LED0: D2.2 (K), U1.23 (CBUS0)
~LED1: D1.2 (K), U1.22 (CBUS1)
