land-boards/lb-boards/Arduino Cards/ATProg/ATProg-Sht3.sch

## KiCad design Arduino Cards/ATProg/ATProg-Sht3.sch (2013-09-18)

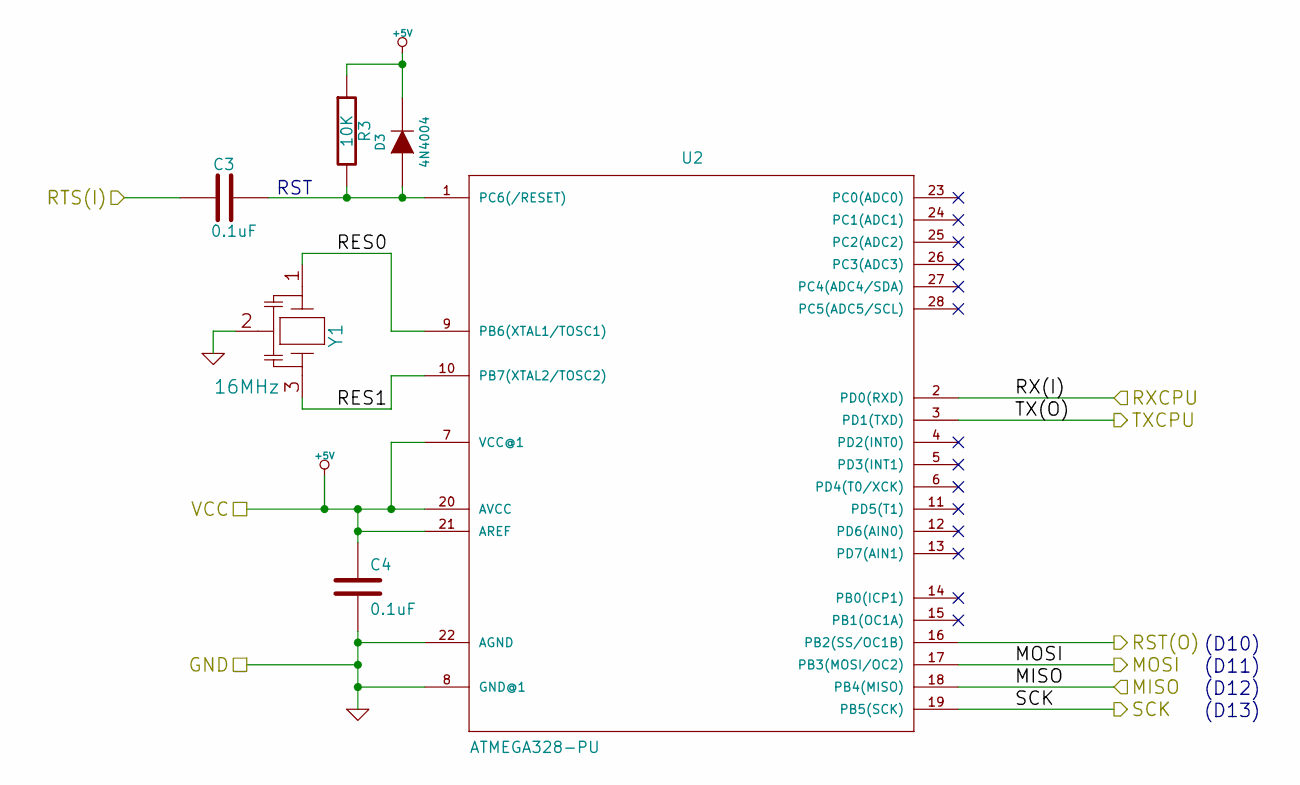
[picture p610: schematic ATProg-Sht3.sch]

Parts:
C3, C4: 0.1uF; SM0805
D3: 4N4004; D3
R3: 10K; SM0805
U2: ATMEGA328-PU; DIP-28__300
Y1: 16MHz; SIL-3

Connections:
+5V: C4.1, D3.2 (K), R3.1, U2.7 (VCC@1), U2.20 (AVCC), U2.21 (AREF)
GND: C4.2, U2.8 (GND@1), U2.22 (AGND), Y1.2
MISO: U2.18 (PB4(MISO))
MOSI: U2.17 (PB3(MOSI/OC2))
unnamed: C3.2, D3.1 (A), R3.2, U2.1 (PC6(/RESET))
RES0: U2.9 (PB6(XTAL1/TOSC1)), Y1.1
RES1: U2.10 (PB7(XTAL2/TOSC2)), Y1.3
RST(O): U2.16 (PB2(SS/OC1B))
RTS(I): C3.1
RX(I): U2.2 (PD0(RXD))
SCK: U2.19 (PB5(SCK))
TX(O): U2.3 (PD1(TXD))

Notes on the sheet:
(D13)
(D12)
(D11)
RST
(D10)
