land-boards/lb-boards/Arduino Cards/ATProg/ATProg-Sht4.sch

## KiCad design Arduino Cards/ATProg/ATProg-Sht4.sch (2013-09-18)

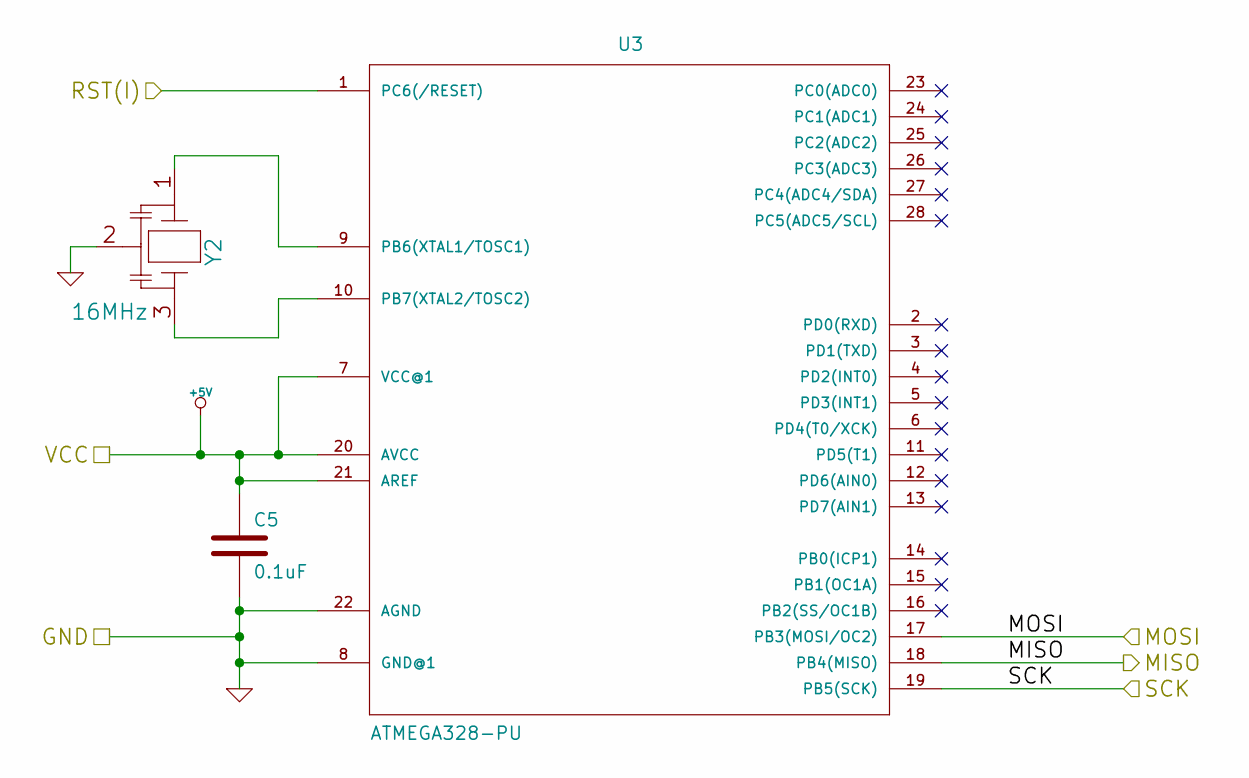
[picture p611: schematic ATProg-Sht4.sch]

Parts:
C5: 0.1uF; SM0805
U3: ATMEGA328-PU; TEXTOOL-28N
Y2: 16MHz; SIL-3

Connections:
+5V: C5.1, U3.7 (VCC@1), U3.20 (AVCC), U3.21 (AREF)
GND: C5.2, U3.8 (GND@1), U3.22 (AGND), Y2.2
MISO: U3.18 (PB4(MISO))
MOSI: U3.17 (PB3(MOSI/OC2))
unnamed: U3.9 (PB6(XTAL1/TOSC1)), Y2.1
unnamed: U3.10 (PB7(XTAL2/TOSC2)), Y2.3
RST(I): U3.1 (PC6(/RESET))
SCK: U3.19 (PB5(SCK))
