land-boards/lb-boards/Arduino Cards/ATProg/ATProg.sch

## KiCad design Arduino Cards/ATProg/ATProg.sch (2013-09-18)

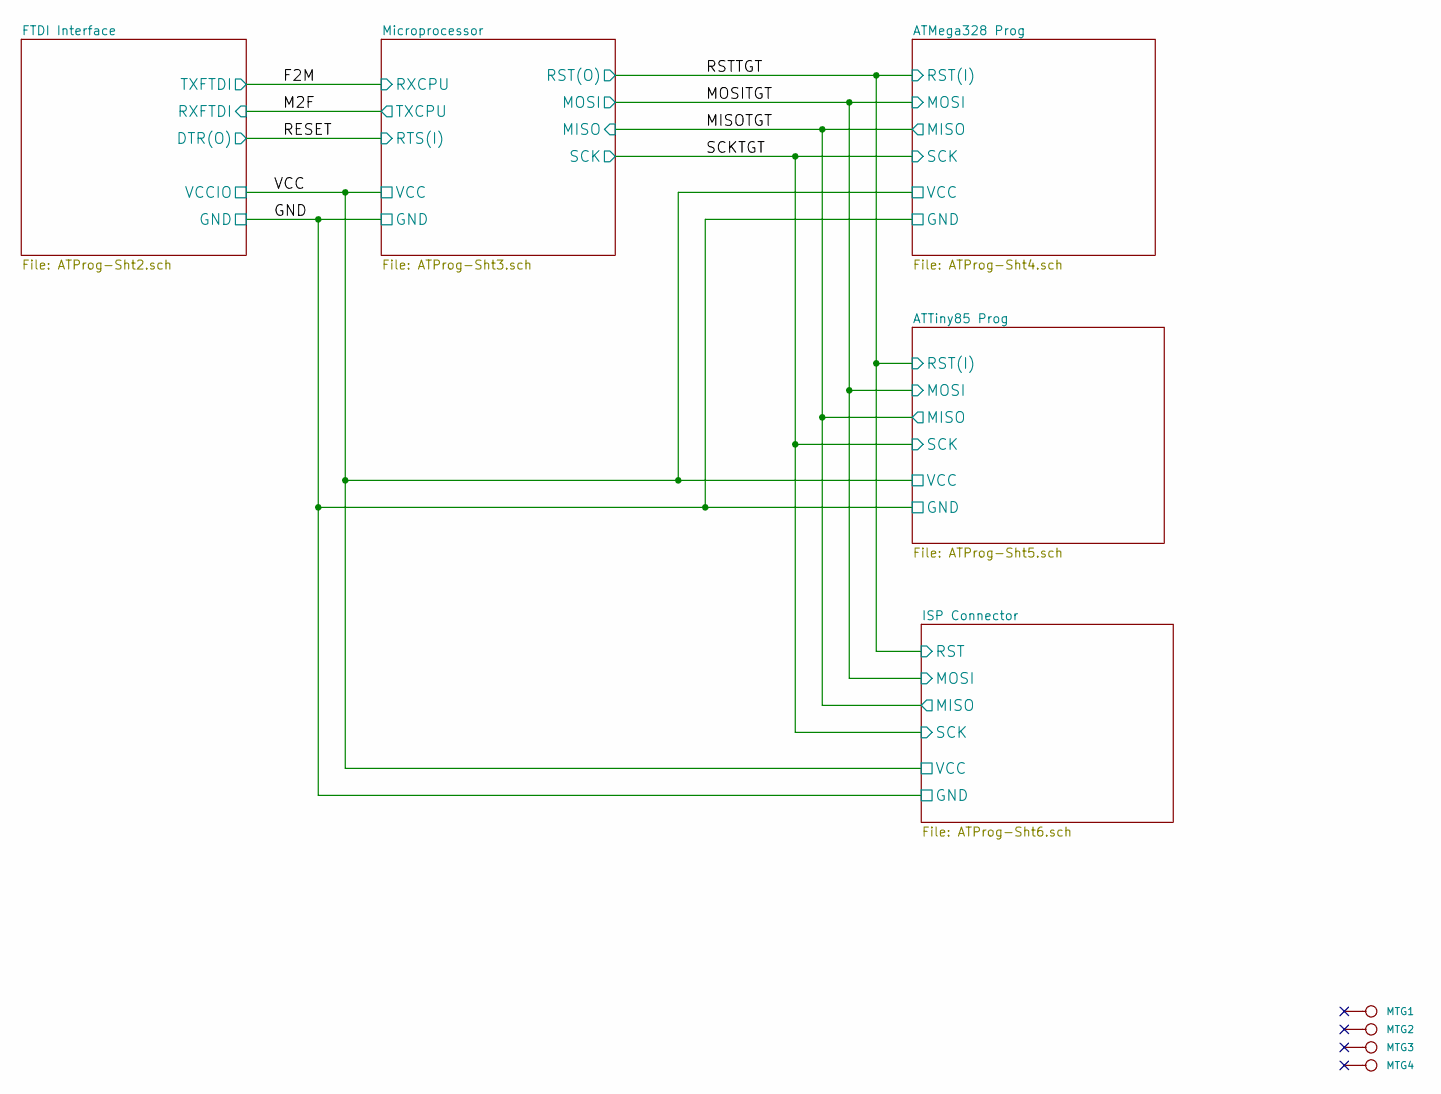
[picture p612: schematic ATProg.sch]

Parts:
MTG1, MTG2, MTG3, MTG4: CONN_1; MTG-4-40
