land-boards/lb-boards/Arduino Cards/ATProgHead/ATProgHead.sch

## KiCad design Arduino Cards/ATProgHead/ATProgHead.sch (2014-07-06)

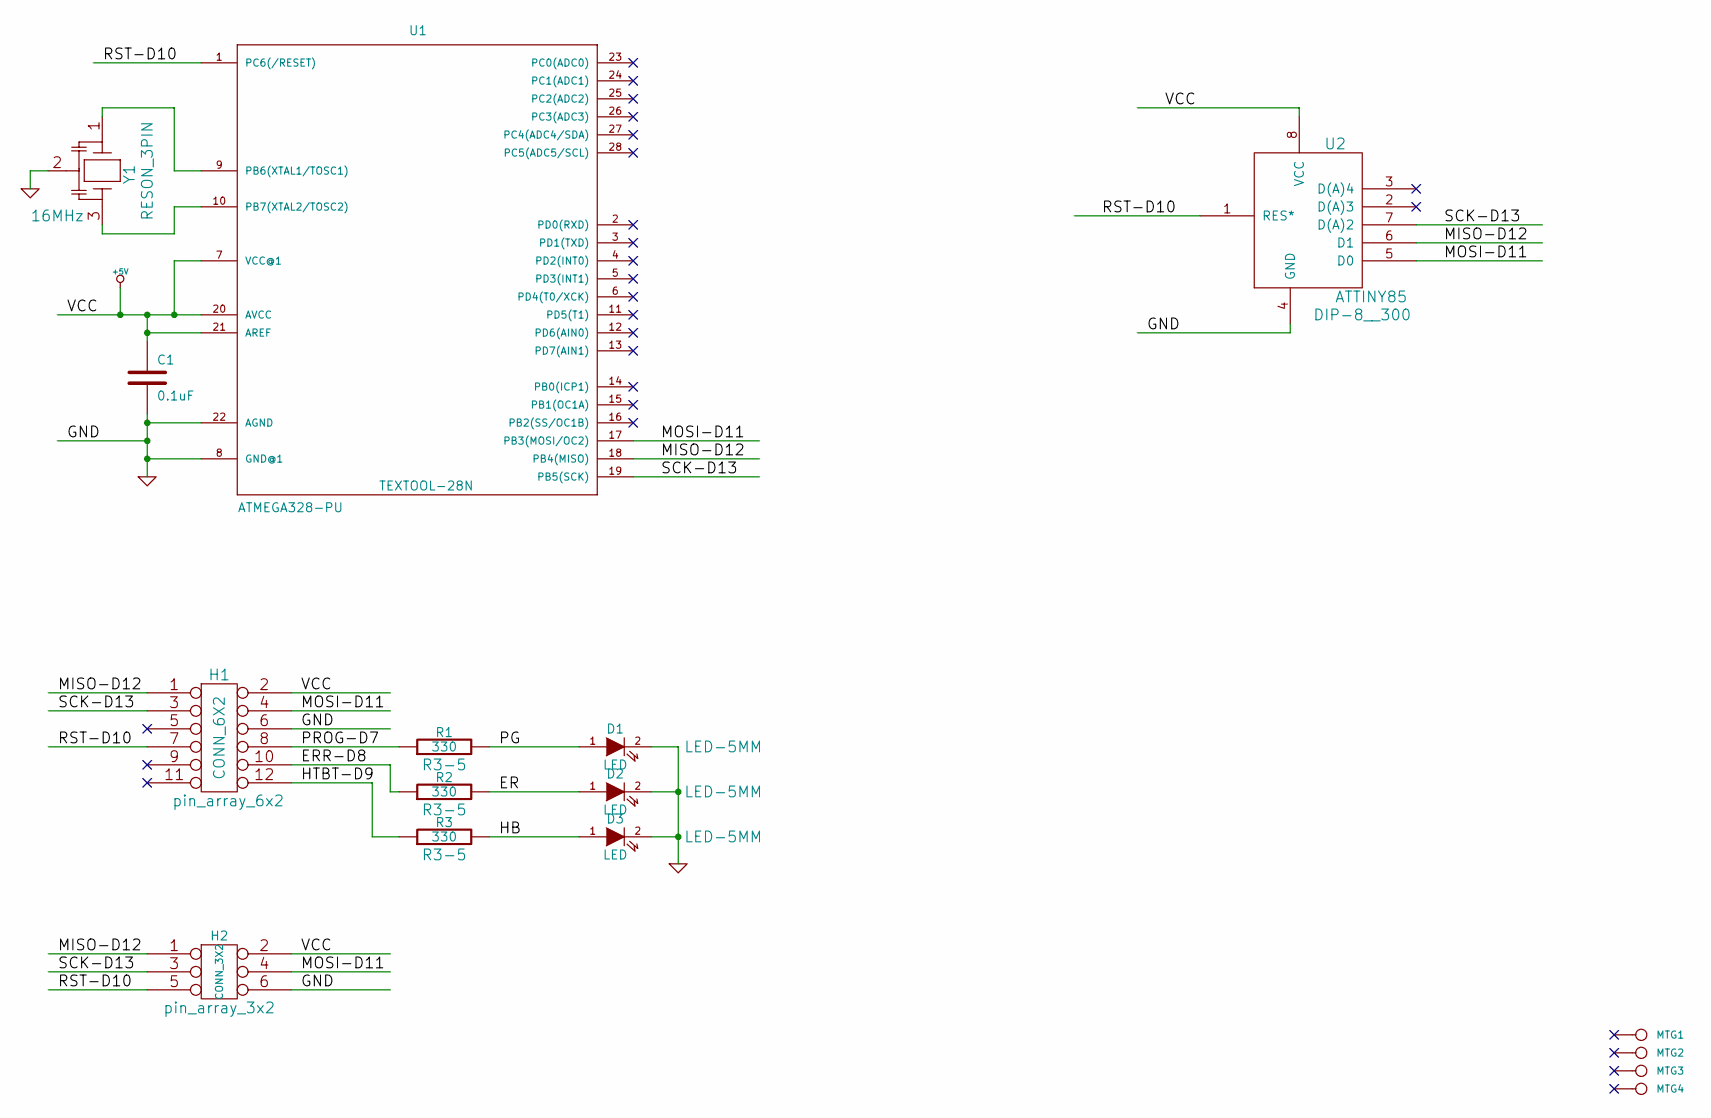
[picture p613: schematic ATProgHead.sch]

Parts:
C1: 0.1uF; C1
D1, D2, D3: LED; LED-5MM
H1: CONN_6X2; pin_array_6x2
H2: CONN_3X2; pin_array_3x2
MTG1, MTG2, MTG3, MTG4: CONN_1; MTG-4-40
R1, R2, R3: 330; R3-5
U1: ATMEGA328-PU; TEXTOOL-28N
U2: ATTINY85; DIP-8__300
Y1: 16MHz; RESON_3PIN

Connections:
+5V: C1.1, H1.2, H2.2, U1.7 (VCC@1), U1.20 (AVCC), U1.21 (AREF), U2.8 (VCC)
ER: D2.1 (A), R2.2
ERR-D8: H1.10, R2.1
GND: C1.2, D1.2 (K), D2.2 (K), D3.2 (K), H1.6, H2.6, U1.8 (GND@1), U1.22 (AGND), U2.4 (GND), Y1.2
HB: D3.1 (A), R3.2
HTBT-D9: H1.12, R3.1
MISO-D12: H1.1, H2.1, U1.18 (PB4(MISO)), U2.6 (D1)
MOSI-D11: H1.4, H2.4, U1.17 (PB3(MOSI/OC2)), U2.5 (D0)
unnamed: U1.9 (PB6(XTAL1/TOSC1)), Y1.1
unnamed: U1.10 (PB7(XTAL2/TOSC2)), Y1.3
PG: D1.1 (A), R1.2
PROG-D7: H1.8, R1.1
RST-D10: H1.7, H2.5, U1.1 (PC6(/RESET)), U2.1 (RES*)
SCK-D13: H1.3, H2.3, U1.19 (PB5(SCK)), U2.7 (D(A)2)
