land-boards/lb-boards/Arduino Cards/ArduinoInABox/ArduinoInABox.kicad_sch

## KiCad design Arduino Cards/ArduinoInABox/ArduinoInABox.kicad_sch (2022-10-10)

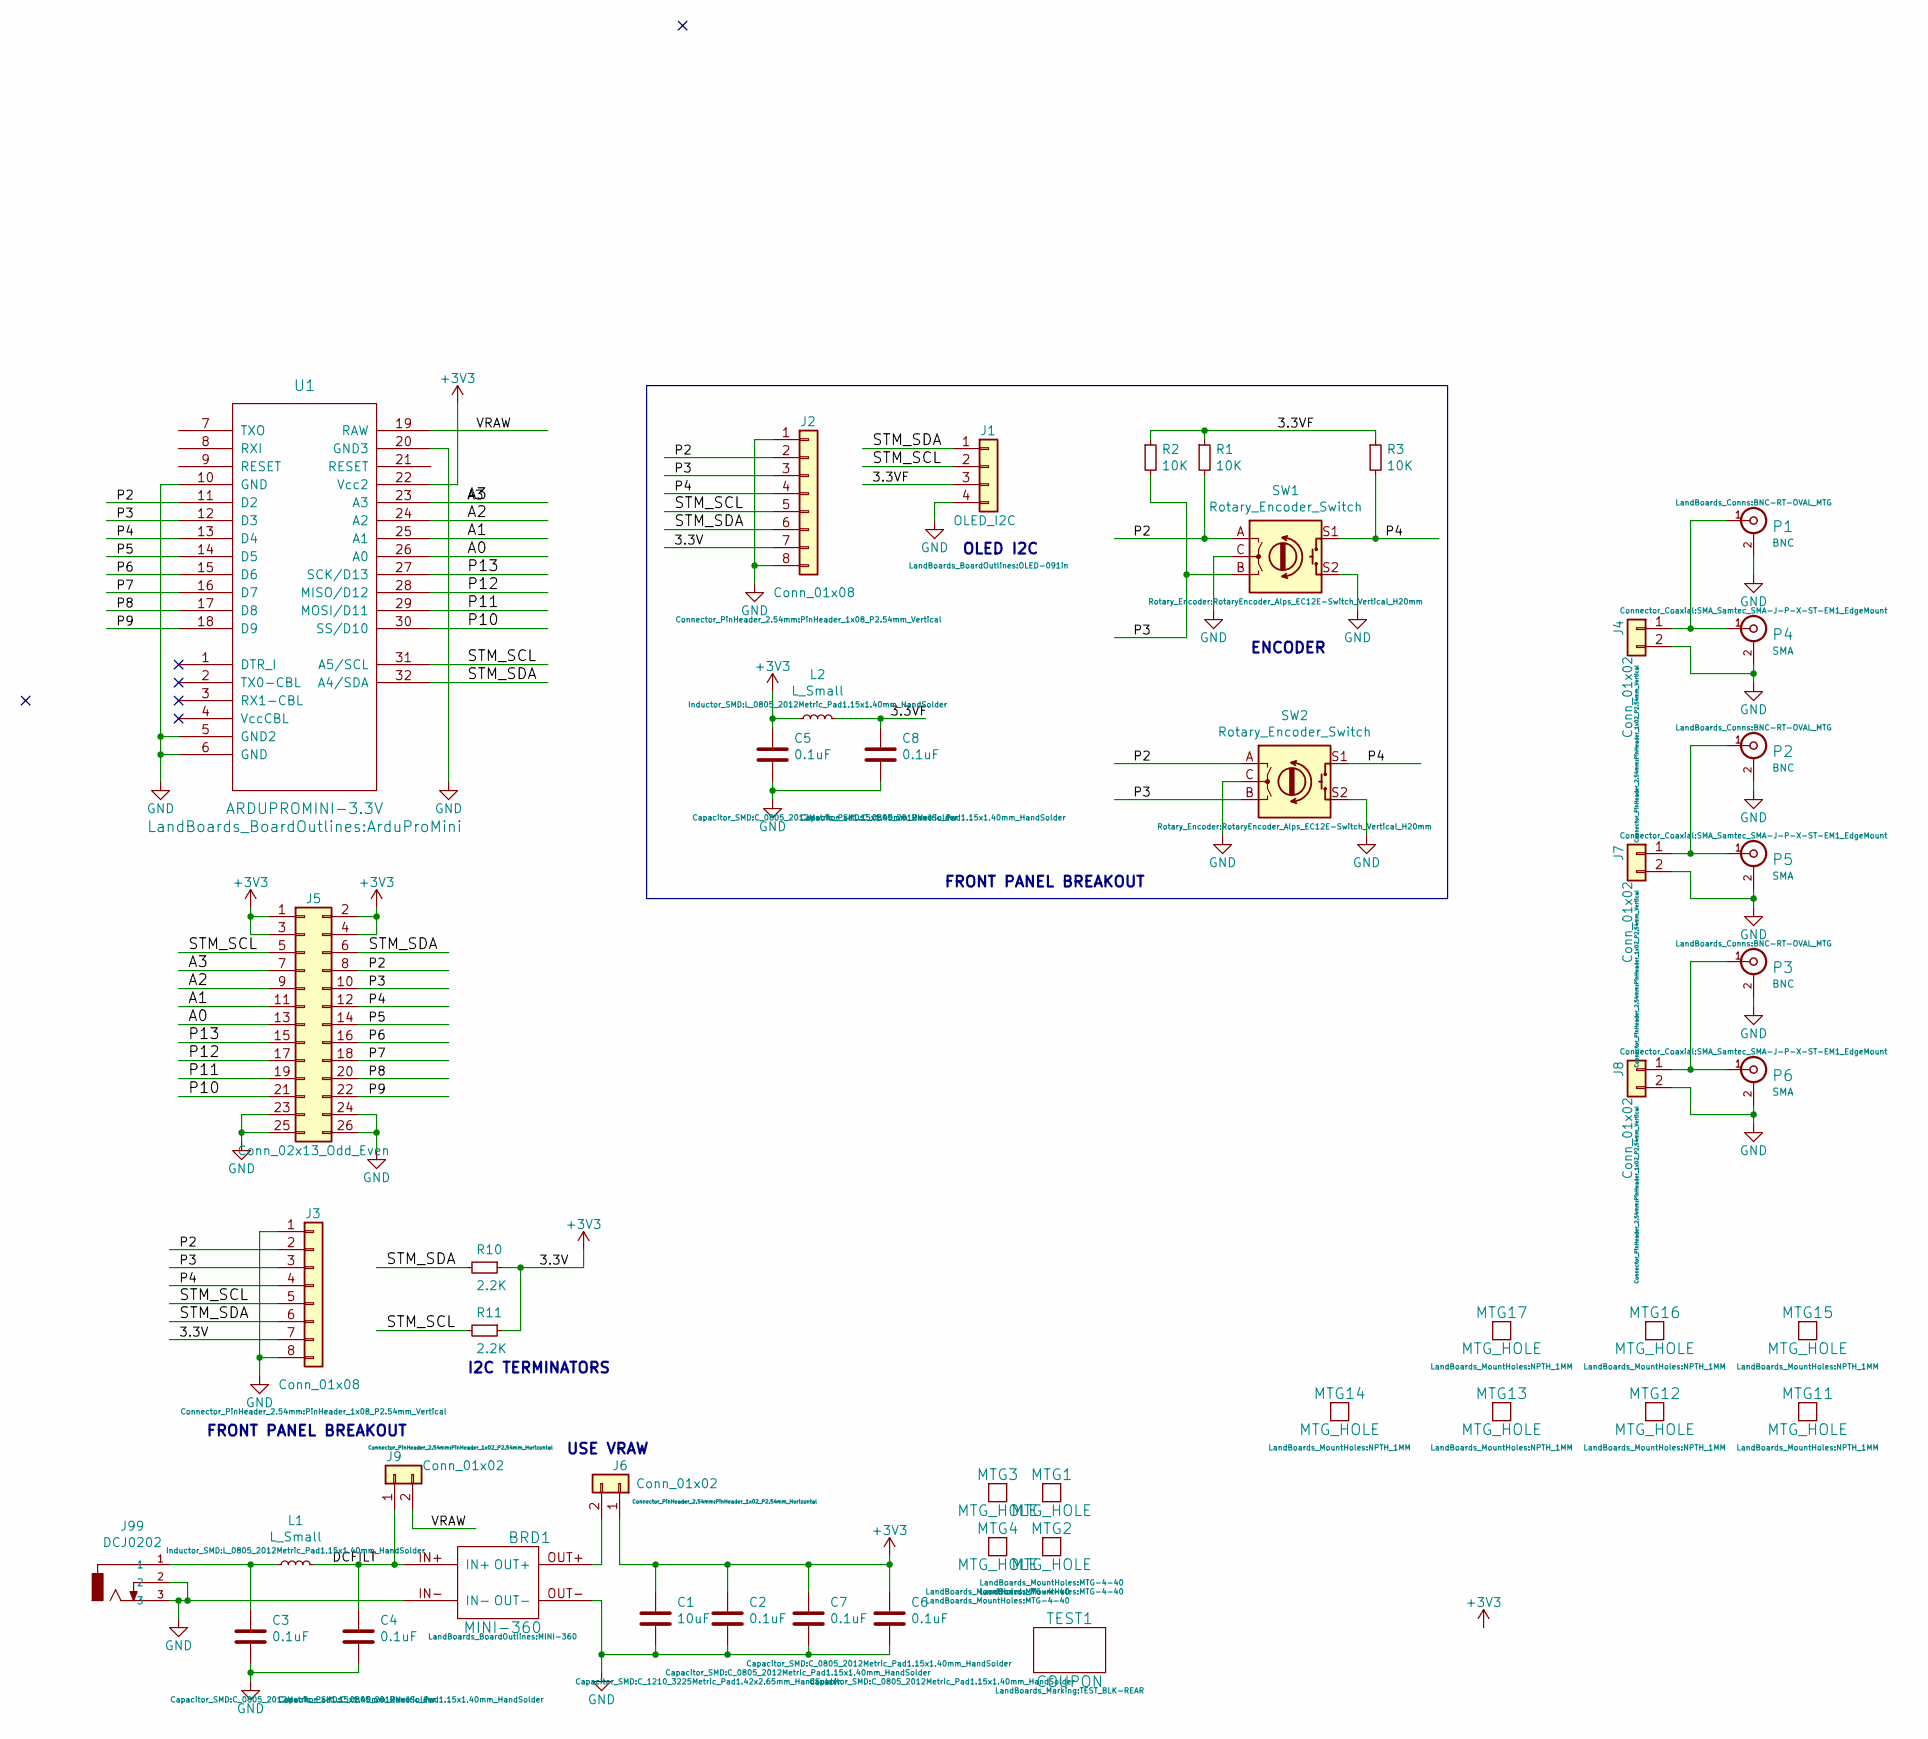
[picture p614: schematic ArduinoInABox.kicad_sch]

Parts:
BRD1: MINI-360
C1: 10uF; C_1210_3225Metric_Pad1.42x2.65mm_HandSolder
C2, C3, C4, C5, C6, C7, C8: 0.1uF; C_0805_2012Metric_Pad1.15x1.40mm_HandSolder
J1: OLED_I2C; OLED-091in
J2, J3: Conn_01x08; PinHeader_1x08_P2.54mm_Vertical
J4, J7, J8: Conn_01x02; PinHeader_1x02_P2.54mm_Vertical
J5: Conn_02x13_Odd_Even; PinHeader_2x13_P2.54mm_Vertical
J6, J9: Conn_01x02; PinHeader_1x02_P2.54mm_Horizontal
J99: DCJ0202; DCJ-NEW-Slotted
L1, L2: L_Small; L_0805_2012Metric_Pad1.15x1.40mm_HandSolder
MTG1, MTG2, MTG3, MTG4: MTG_HOLE; MTG-4-40
MTG11, MTG12, MTG13, MTG14, MTG15, MTG16, MTG17: MTG_HOLE; NPTH_1MM
P1, P2, P3: BNC; BNC-RT-OVAL_MTG
P4, P5, P6: SMA; SMA_Samtec_SMA-J-P-X-ST-EM1_EdgeMount
R1, R2, R3: 10K; R_0805_2012Metric_Pad1.15x1.40mm_HandSolder
R10, R11: 2.2K; R_0805_2012Metric_Pad1.15x1.40mm_HandSolder
SW1, SW2: Rotary_Encoder_Switch; RotaryEncoder_Alps_EC12E-Switch_Vertical_H20mm
TEST1: COUPON; TEST_BLK-REAR
U1: ARDUPROMINI-3.3V; ArduProMini

Connections:
3.3VF: C8.1, J1.3, L2.2, R1.1, R2.1, R3.1
+3V3: C1.1, C2.1, C5.1, C6.1, C7.1, J2.7, J3.7, J5.1, J5.2, J5.3, J5.4, J6.1, L2.1, R10.1, R11.1, U1.22 (Vcc2)
A0: J5.13, U1.26 (A0)
A1: J5.11, U1.25 (A1)
A2: J5.9, U1.24 (A2)
A3: J5.7, U1.23 (A3)
DCFILT: BRD1.IN+, C4.1, J9.1, L1.2
GND: BRD1.IN-, BRD1.OUT-, C1.2, C2.2, C3.2, C4.2, C5.2, C6.2, C7.2, C8.2, J1.4, J2.1, J2.8, J3.1, J3.8, J4.2, J5.23, J5.24, J5.25, J5.26, J7.2, J8.2, J99.2, J99.3, P1.2 (Ext), P2.2 (Ext), P3.2 (Ext), P4.2 (Ext), P5.2 (Ext), P6.2 (Ext), SW1.C, SW1.S2, SW2.C, SW2.S2, U1.5 (GND2), U1.6 (GND), U1.10 (GND), U1.20 (GND3)
unnamed: BRD1.OUT+, J6.2
unnamed: C3.1, J99.1, L1.1
unnamed: J4.1, P1.1 (In), P4.1 (In)
unnamed: J7.1, P2.1 (In), P5.1 (In)
unnamed: J8.1, P3.1 (In), P6.1 (In)
P2: J2.2, J3.2, J5.8, R1.2, SW1.A, SW2.A, U1.11 (D2)
P3: J2.3, J3.3, J5.10, R2.2, SW1.B, SW2.B, U1.12 (D3)
P4: J2.4, J3.4, J5.12, R3.2, SW1.S1, SW2.S1, U1.13 (D4)
P5: J5.14, U1.14 (D5)
P6: J5.16, U1.15 (D6)
P7: J5.18, U1.16 (D7)
P8: J5.20, U1.17 (D8)
P9: J5.22, U1.18 (D9)
P10: J5.21, U1.30 (SS/D10)
P11: J5.19, U1.29 (MOSI/D11)
P12: J5.17, U1.28 (MISO/D12)
P13: J5.15, U1.27 (SCK/D13)
STM_SCL: J1.2, J2.5, J3.5, J5.5, R11.2, U1.31 (A5/SCL)
STM_SDA: J1.1, J2.6, J3.6, J5.6, R10.2, U1.32 (A4/SDA)
VRAW: J9.2, U1.19 (RAW)

Notes on the sheet:
OLED I2C
FRONT PANEL BREAKOUT
USE VRAW
ENCODER
I2C TERMINATORS
