land-boards/lb-boards/Arduino Cards/Black-Pill-Hub/Black-Pill-Board.sch

## KiCad design Arduino Cards/Black-Pill-Hub/Black-Pill-Board.sch (2021-01-31)

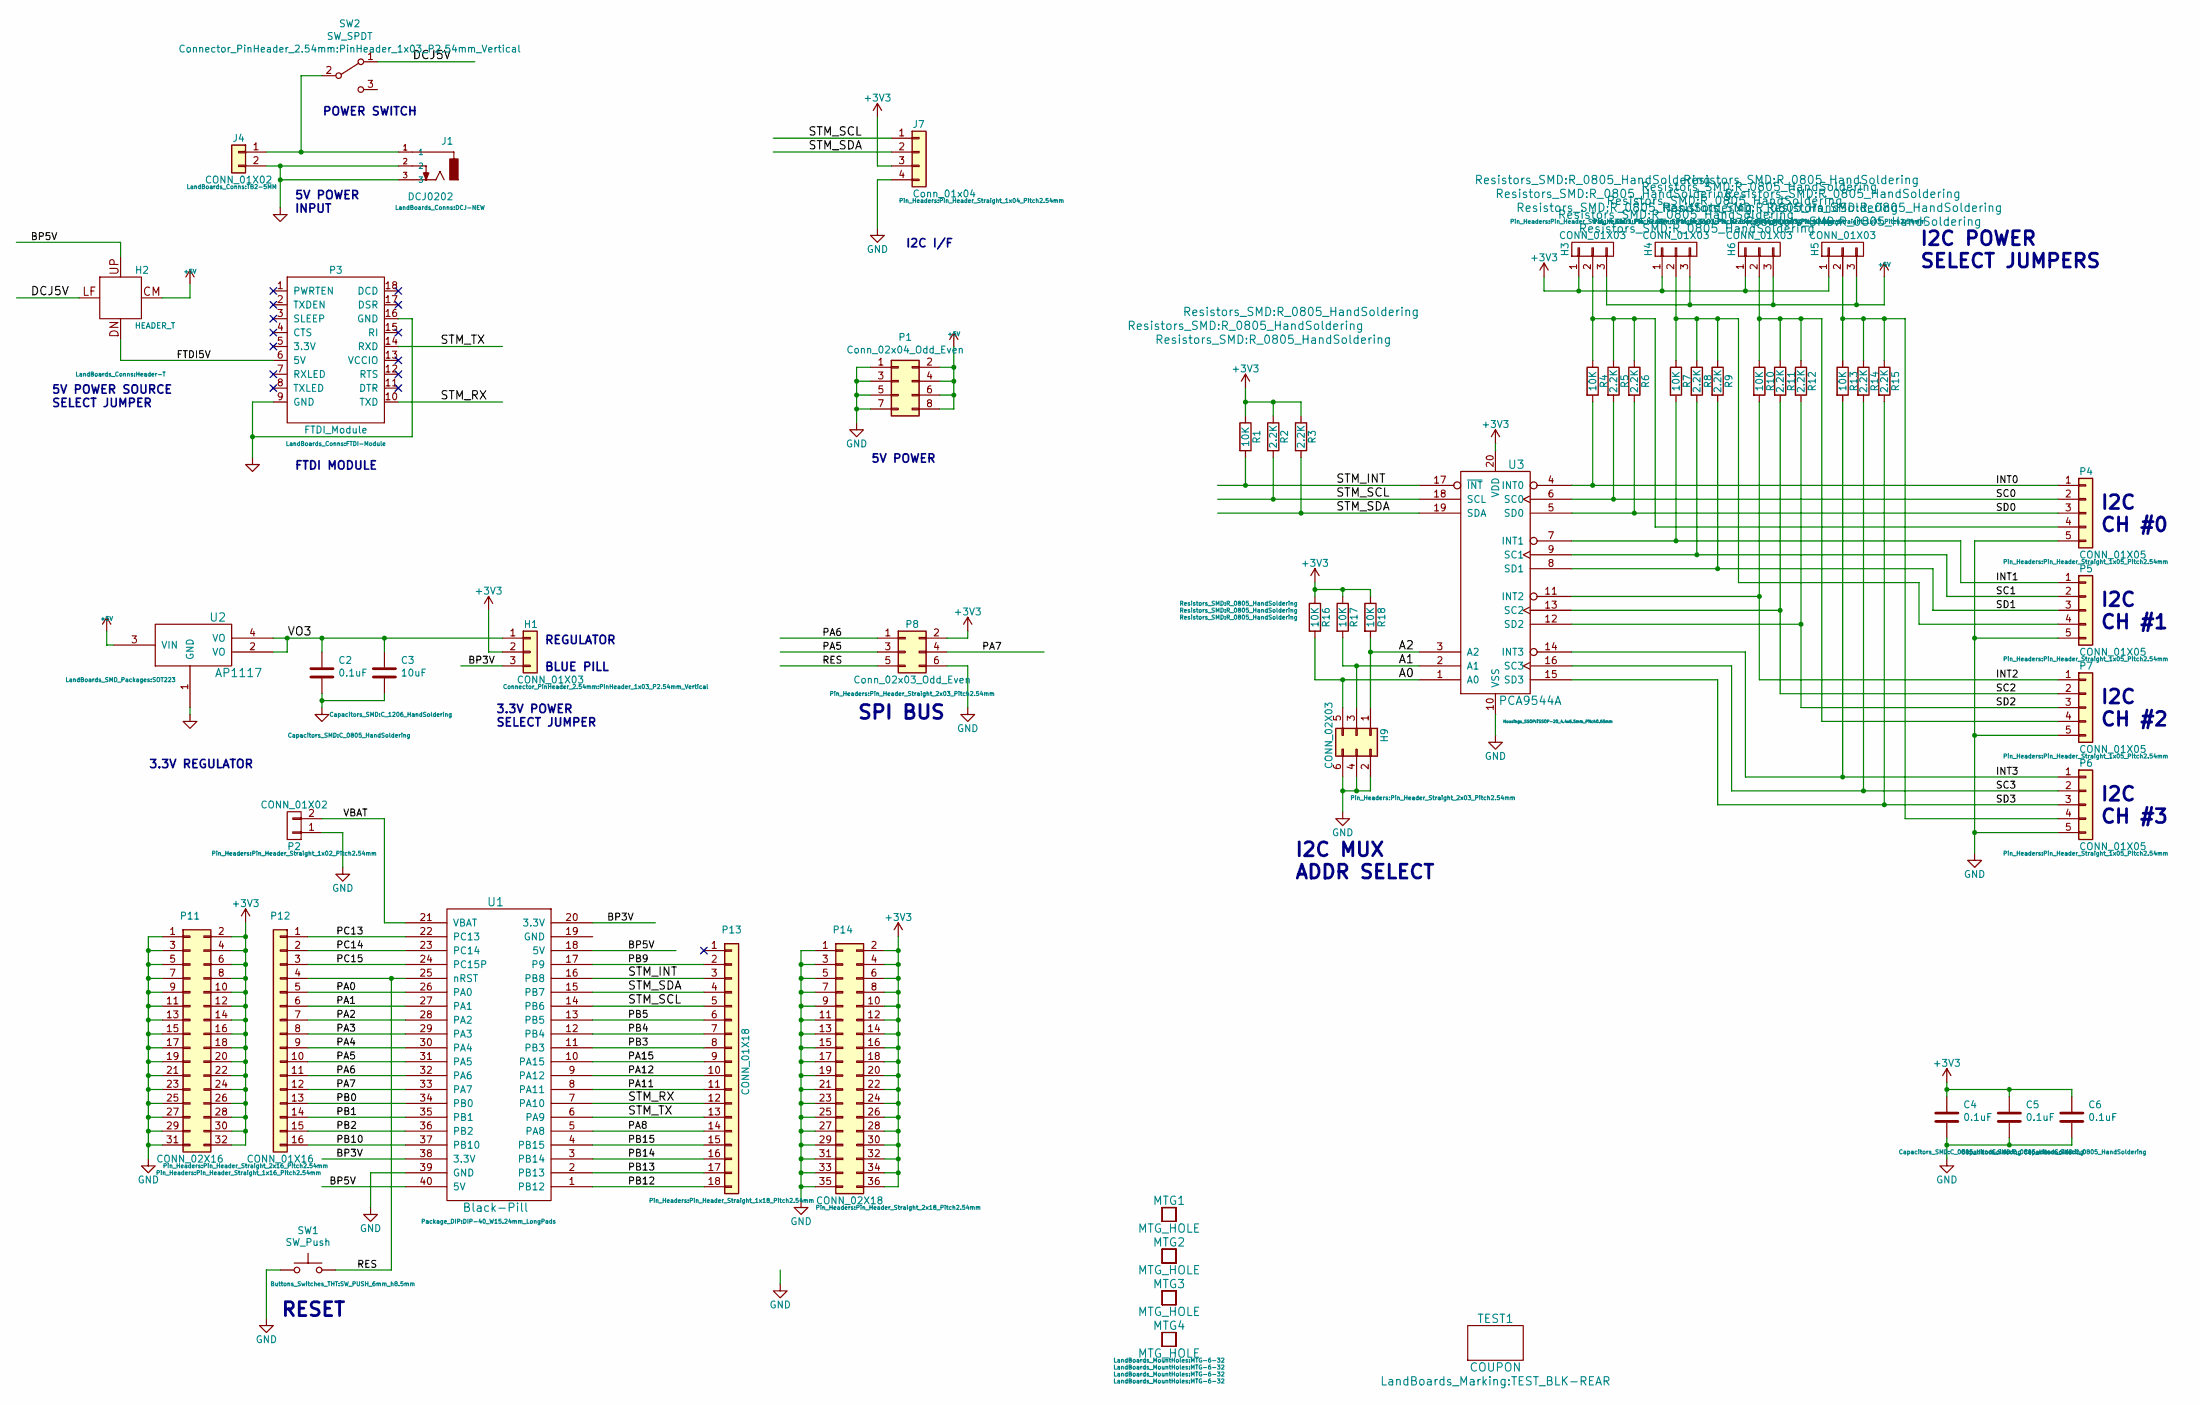
[picture p615: schematic Black-Pill-Board.sch]

Parts:
C2, C4, C5, C6: 0.1uF; C_0805_HandSoldering
C3: 10uF; C_1206_HandSoldering
H1: CONN_01X03; PinHeader_1x03_P2.54mm_Vertical
H2: HEADER_T; Header-T
H3, H4, H5, H6: CONN_01X03; Pin_Header_Straight_1x03_Pitch2.54mm
H9: CONN_02X03; Pin_Header_Straight_2x03_Pitch2.54mm
J1: DCJ0202; DCJ-NEW
J4: CONN_01X02; TB2-5MM
J7: Conn_01x04; Pin_Header_Straight_1x04_Pitch2.54mm
MTG1, MTG2, MTG3, MTG4: MTG_HOLE; MTG-6-32
P1: Conn_02x04_Odd_Even; PinHeader_2x04_P2.54mm_Vertical
P2: CONN_01X02; Pin_Header_Straight_1x02_Pitch2.54mm
P3: FTDI_Module; FTDI-Module
P4, P5, P6, P7: CONN_01X05; Pin_Header_Straight_1x05_Pitch2.54mm
P8: Conn_02x03_Odd_Even; Pin_Header_Straight_2x03_Pitch2.54mm
P11: CONN_02X16; Pin_Header_Straight_2x16_Pitch2.54mm
P12: CONN_01X16; Pin_Header_Straight_1x16_Pitch2.54mm
P13: CONN_01X18; Pin_Header_Straight_1x18_Pitch2.54mm
P14: CONN_02X18; Pin_Header_Straight_2x18_Pitch2.54mm
R1, R4, R7, R10, R13, R16, R17, R18: 10K; R_0805_HandSoldering
R2, R3, R5, R6, R8, R9, R11, R12, R14, R15: 2.2K; R_0805_HandSoldering
SW1: SW_Push; SW_PUSH_6mm_h8.5mm
SW2: SW_SPDT; PinHeader_1x03_P2.54mm_Vertical
TEST1: COUPON; TEST_BLK-REAR
U1: Black-Pill; DIP-40_W15.24mm_LongPads
U2: AP1117; SOT223
U3: PCA9544A; TSSOP-20_4.4x6.5mm_Pitch0.65mm

Connections:
+3V3: C4.1, C5.1, C6.1, H1.2, H3.1, H4.1, H5.1, H6.1, J7.3, P8.2, P11.2, P11.4, P11.6, P11.8, P11.10, P11.12, P11.14, P11.16, P11.18, P11.20, P11.22, P11.24, P11.26, P11.28, P11.30, P11.32, P14.2, P14.4, P14.6, P14.8, P14.10, P14.12, P14.14, P14.16, P14.18, P14.20, P14.22, P14.24, P14.26, P14.28, P14.30, P14.32, P14.34, P14.36, R1.1, R2.1, R3.1, R16.1, R17.1, R18.1, U3.20 (VDD)
+5V: H2.CM (COM), H3.3, H4.3, H5.3, H6.3, P1.2, P1.4, P1.6, P1.8, U2.3 (VIN)
A0: H9.5, R16.2, U3.1 (A0)
A1: H9.3, R17.2, U3.2 (A1)
A2: H9.1, R18.2, U3.3 (A2)
BP3V: H1.3, U1.20 (3.3V), U1.38 (3.3V)
BP5V: H2.UP, U1.18 (5V), U1.40 (5V)
DCJ5V: H2.LF (LEFT), SW2.1 (A)
FTDI5V: H2.DN (DOWN), P3.6 (5V)
GND: C2.2, C3.2, C4.2, C5.2, C6.2, H9.2, H9.4, H9.6, J1.2, J1.3, J4.2, J7.4, P1.1, P1.3, P1.5, P1.7, P2.1, P3.9 (GND), P3.16 (GND), P4.5, P5.5, P6.5, P7.5, P8.6, P11.1, P11.3, P11.5, P11.7, P11.9, P11.11, P11.13, P11.15, P11.17, P11.19, P11.21, P11.23, P11.25, P11.27, P11.29, P11.31, P14.1, P14.3, P14.5, P14.7, P14.9, P14.11, P14.13, P14.15, P14.17, P14.19, P14.21, P14.23, P14.25, P14.27, P14.29, P14.31, P14.33, P14.35, SW1.1, U1.39 (GND), U2.1 (GND), U3.10 (VSS)
INT0: P4.1, R4.2, U3.4 (INT0)
INT1: P5.1, R7.2, U3.7 (INT1)
INT2: P7.1, R10.2, U3.11 (INT2)
INT3: P6.1, R13.2, U3.14 (INT3)
unnamed: H3.2, P4.4, R4.1, R5.1, R6.1
unnamed: H4.2, P5.4, R7.1, R8.1, R9.1
unnamed: H5.2, P6.4, R13.1, R14.1, R15.1
unnamed: H6.2, P7.4, R10.1, R11.1, R12.1
unnamed: J1.1, J4.1, SW2.2 (B)
PA0: P12.5, U1.26 (PA0)
PA1: P12.6, U1.27 (PA1)
PA2: P12.7, U1.28 (PA2)
PA3: P12.8, U1.29 (PA3)
PA4: P12.9, U1.30 (PA4)
PA5: P8.3, P12.10, U1.31 (PA5)
PA6: P8.1, P12.11, U1.32 (PA6)
PA7: P8.4, P12.12, U1.33 (PA7)
PA8: P13.14, U1.5 (PA8)
PA11: P13.11, U1.8 (PA11)
PA12: P13.10, U1.9 (PA12)
PA15: P13.9, U1.10 (PA15)
PB0: P12.13, U1.34 (PB0)
PB1: P12.14, U1.35 (PB1)
PB2: P12.15, U1.36 (PB2)
PB3: P13.8, U1.11 (PB3)
PB4: P13.7, U1.12 (PB4)
PB5: P13.6, U1.13 (PB5)
PB9: P13.2, U1.17 (P9)
PB10: P12.16, U1.37 (PB10)
PB12: P13.18, U1.1 (PB12)
PB13: P13.17, U1.2 (PB13)
PB14: P13.16, U1.3 (PB14)
PB15: P13.15, U1.4 (PB15)
PC13: P12.1, U1.22 (PC13)
PC14: P12.2, U1.23 (PC14)
PC15: P12.3, U1.24 (PC15P)
RES: P8.5, P12.4, SW1.2, U1.25 (nRST)
SC0: P4.2, R5.2, U3.6 (SC0)
SC1: P5.2, R8.2, U3.9 (SC1)
SC2: P7.2, R11.2, U3.13 (SC2)
SC3: P6.2, R14.2, U3.16 (SC3)
SD0: P4.3, R6.2, U3.5 (SD0)
SD1: P5.3, R9.2, U3.8 (SD1)
SD2: P7.3, R12.2, U3.12 (SD2)
SD3: P6.3, R15.2, U3.15 (SD3)
STM_INT: P13.3, R1.2, U1.16 (PB8), U3.17 (~INT)
STM_RX: P3.10 (TXD), P13.12, U1.7 (PA10)
STM_SCL: J7.1, P13.5, R2.2, U1.14 (PB6), U3.18 (SCL)
STM_SDA: J7.2, P13.4, R3.2, U1.15 (PB7), U3.19 (SDA)
STM_TX: P3.14 (RXD), P13.13, U1.6 (PA9)
VBAT: P2.2, U1.21 (VBAT)
VO3: C2.1, C3.1, H1.1, U2.2 (VO), U2.4 (VO)

Notes on the sheet:
FTDI MODULE
SPI BUS
RESET
I2C I/F
POWER SWITCH
5V POWER INPUT
5V POWER SOURCE SELECT JUMPER
I2C MUX ADDR SELECT
I2C CH #0
I2C CH #1
I2C CH #2
I2C CH #3
I2C POWER SELECT JUMPERS
3.3V REGULATOR
3.3V POWER SELECT JUMPER
REGULATOR BLUE PILL
5V POWER
