land-boards/lb-boards/Arduino Cards/FTDI-USB-RS-232/FTDI-USB-RS-232.sch

## KiCad design Arduino Cards/FTDI-USB-RS-232/FTDI-USB-RS-232.sch (2016-09-02)

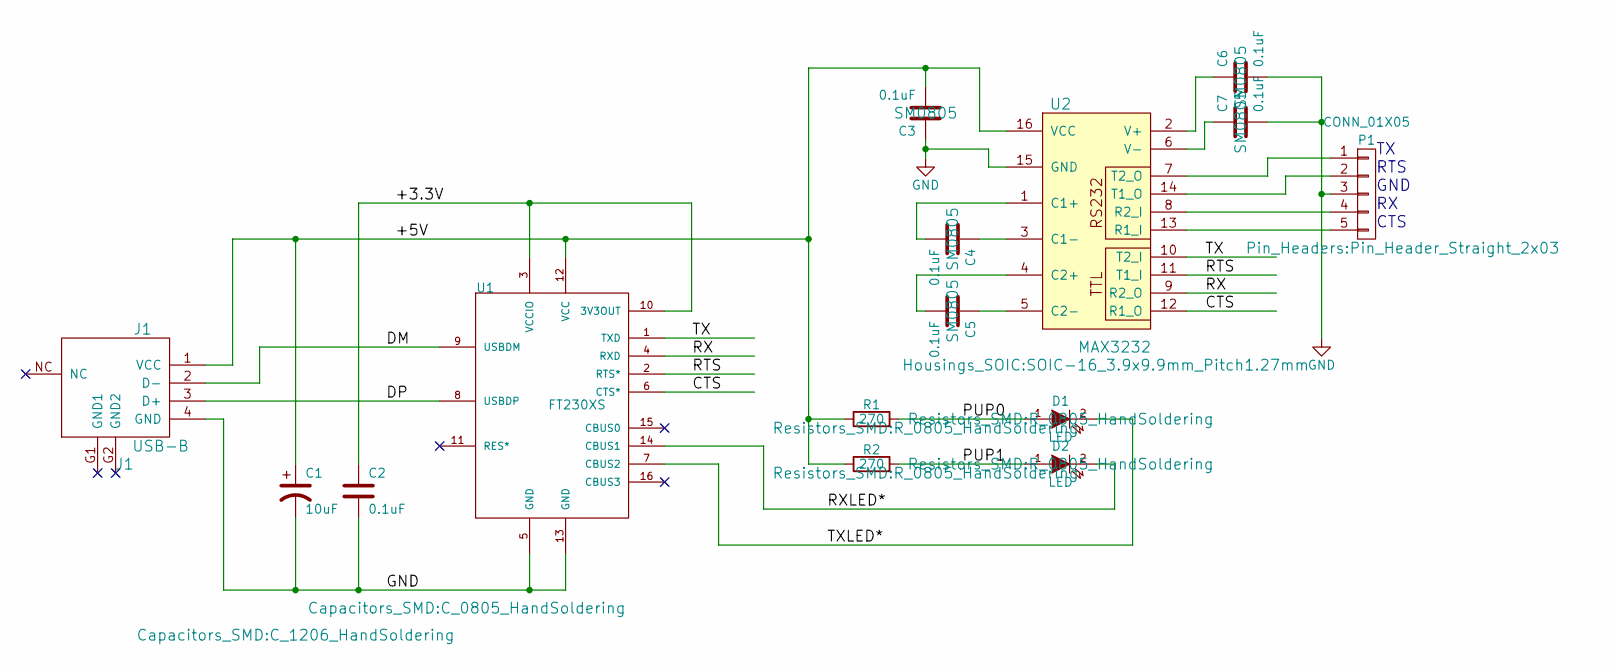
[picture p616: schematic FTDI-USB-RS-232.sch]

Parts:
C1: 10uF; C_1206_HandSoldering; MfgPN CC121ZKY5V8BB106
C2: 0.1uF; C_0805_HandSoldering; MfgPN GRM155F51E104ZA1J
C3, C4, C5, C6, C7: 0.1uF; SM0805; MfgPN GRM155F51E104ZA1J
D1, D2: LED; R_0805_HandSoldering
J1: USB-B; J1; MfgPN UX60SC-MB-5ST(80)
P1: CONN_01X05; Pin_Header_Straight_2x03
R1: 270; R_0805_HandSoldering; MfgPN CRG0805F270R
R2: 270; R_0805_HandSoldering
U1: FT230XS; SSOP-16_3.9x4.9mm_Pitch0.635mm
U2: MAX3232; SOIC-16_3.9x9.9mm_Pitch1.27mm

Connections:
+3.3V: C2.1, U1.3 (VCCIO), U1.10 (3V3OUT)
+5V: C1.1, C3.2, J1.1 (VCC), R1.1, R2.1, U1.12 (VCC), U2.16 (VCC)
CTS: U1.6 (CTS*), U2.12 (R1_O)
DM: J1.2 (D-), U1.9 (USBDM)
DP: J1.3 (D+), U1.8 (USBDP)
GND: C1.2, C2.2, C3.1, C6.2, C7.2, J1.4 (GND), P1.3, U1.5 (GND), U1.13 (GND), U2.15 (GND)
unnamed: C4.1, U2.3 (C1-)
unnamed: C4.2, U2.1 (C1+)
unnamed: C5.1, U2.5 (C2-)
unnamed: C5.2, U2.4 (C2+)
unnamed: C6.1, U2.2 (V+)
unnamed: C7.1, U2.6 (V-)
unnamed: P1.1, U2.7 (T2_O)
unnamed: P1.2, U2.14 (T1_O)
unnamed: P1.4, U2.8 (R2_I)
unnamed: P1.5, U2.13 (R1_I)
PUP0: D1.1 (A), R1.2
PUP1: D2.1 (A), R2.2
RTS: U1.2 (RTS*), U2.11 (T1_I)
RX: U1.4 (RXD), U2.9 (R2_O)
RXLED*: D2.2 (K), U1.14 (CBUS1)
TX: U1.1 (TXD), U2.10 (T2_I)
TXLED*: D1.2 (K), U1.7 (CBUS2)

Notes on the sheet:
TX RTS GND RX CTS
