land-boards/lb-boards/Arduino Cards/FTDI-USB-TTL-49MM/FTDI-USB-TTL-49MM.kicad_sch

## KiCad design Arduino Cards/FTDI-USB-TTL-49MM/FTDI-USB-TTL-49MM.kicad_sch (2024-08-18)

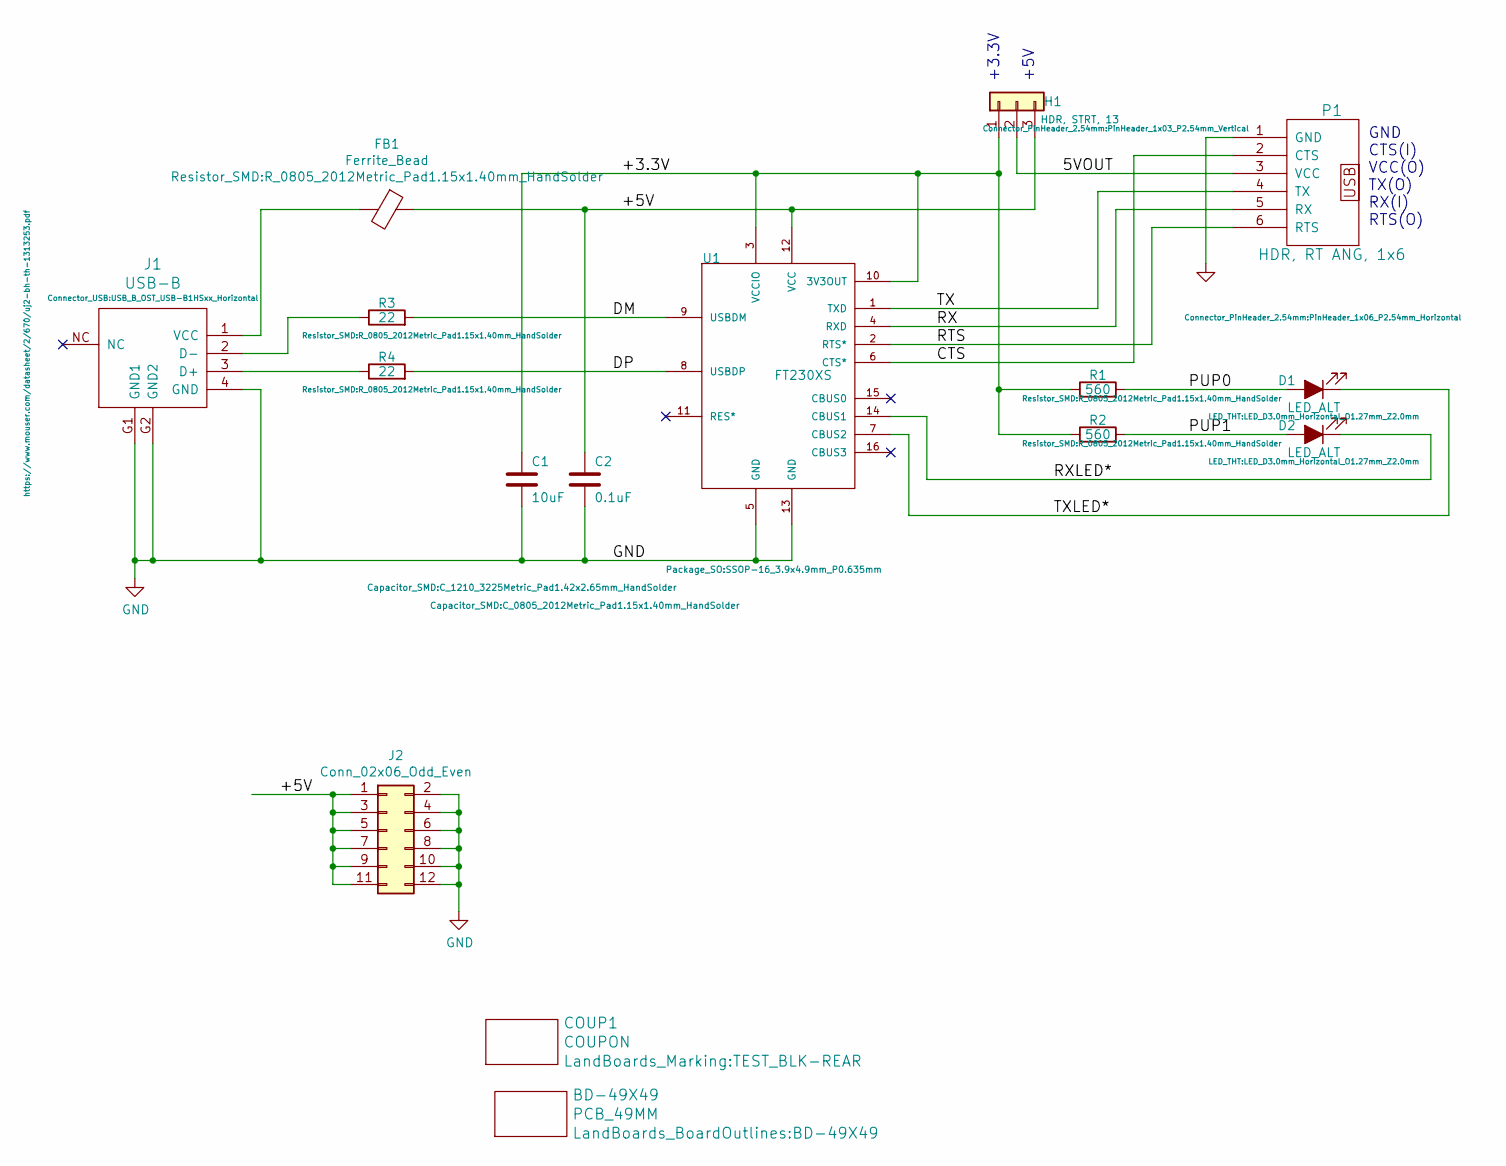
[picture p617: schematic FTDI-USB-TTL-49MM.kicad_sch]

Parts:
BD-49X49: PCB_49MM; BD-49X49
C1: 10uF; C_1210_3225Metric_Pad1.42x2.65mm_HandSolder; MfgPN CC121ZKY5V8BB106
C2: 0.1uF; C_0805_2012Metric_Pad1.15x1.40mm_HandSolder; MfgPN GRM155F51E104ZA1J
COUP1: COUPON; TEST_BLK-REAR
D1, D2: LED_ALT; LED_D3.0mm_Horizontal_O1.27mm_Z2.0mm
FB1: Ferrite_Bead; R_0805_2012Metric_Pad1.15x1.40mm_HandSolder
H1: HDR, STRT, 13; PinHeader_1x03_P2.54mm_Vertical; MfgPN 68002-103HLF
J1: USB-B; USB_B_OST_USB-B1HSxx_Horizontal
J2: Conn_02x06_Odd_Even; PinHeader_2x06_P2.54mm_Horizontal
P1: HDR, RT ANG, 1x6; PinHeader_1x06_P2.54mm_Horizontal; MfgPN 68002-106HLF
R1: 560; R_0805_2012Metric_Pad1.15x1.40mm_HandSolder; MfgPN CRG0805F270R
R2: 560; R_0805_2012Metric_Pad1.15x1.40mm_HandSolder
R3, R4: 22; R_0805_2012Metric_Pad1.15x1.40mm_HandSolder
U1: FT230XS; SSOP-16_3.9x4.9mm_P0.635mm

Connections:
5VOUT: H1.2, P1.3 (VCC)
+3.3V: C1.1, H1.1, R1.1, R2.1, U1.3 (VCCIO), U1.10 (3V3OUT)
+5V: C2.1, FB1.1, H1.3, J2.1, J2.3, J2.5, J2.7, J2.9, J2.11, U1.12 (VCC)
CTS: P1.2 (CTS), U1.6 (CTS*)
DM: R3.2, U1.9 (USBDM)
DP: R4.2, U1.8 (USBDP)
GND: C1.2, C2.2, J1.4 (GND), J1.G1 (GND1), J1.G2 (GND2), J2.2, J2.4, J2.6, J2.8, J2.10, J2.12, P1.1 (GND), U1.5 (GND), U1.13 (GND)
unnamed: FB1.2, J1.1 (VCC)
unnamed: J1.2 (D-), R3.1
unnamed: J1.3 (D+), R4.1
PUP0: D1.2 (A), R1.2
PUP1: D2.2 (A), R2.2
RTS: P1.6 (RTS), U1.2 (RTS*)
RX: P1.5 (RX), U1.4 (RXD)
RXLED*: D2.1 (K), U1.14 (CBUS1)
TX: P1.4 (TX), U1.1 (TXD)
TXLED*: D1.1 (K), U1.7 (CBUS2)

Notes on the sheet:
GND CTS(I) VCC(O) TX(O) RX(I) RTS(O)
+3.3V +5V
