land-boards/lb-boards/Arduino Cards/FTDI-USB-TTL/FTDI-USB-TTL.sch

## KiCad design Arduino Cards/FTDI-USB-TTL/FTDI-USB-TTL.sch (2020-11-30)

Schematic: FTDI-USB-TTL.sch

Parts:
C1: 10uF; C_1210_HandSoldering; MfgPN CC121ZKY5V8BB106
C2: 0.1uF; C_0805_HandSoldering; MfgPN GRM155F51E104ZA1J
H1: CONN_3; Pin_Header_Straight_1x03_Pitch2.54mm; MfgPN 68002-103HLF
H2: CONN_2X2; Pin_Header_Straight_2x02_Pitch2.54mm
J1: USB-B; USB-B-MINI; MfgPN UX60SC-MB-5ST(80)
MTG1: CONN_1; MTG-4-40; MfgPN N/A
MTG2: CONN_1; MTG-4-40
P1: CONN_6; Pin_Header_Angled_1x06_Pitch2.54mm; MfgPN 68002-106HLF
R1: 270; R_0805_HandSoldering; MfgPN CRG0805F270R
R2: 270; R_0805_HandSoldering
U1: FT230XS; SSOP-16_3.9x4.9mm_Pitch0.635mm

Notes on the sheet:
GND CTS(I) VCC(O) TX(O) RX(I) RTS(O)
+3.3V +5V
