land-boards/lb-boards/Arduino Cards/GVS-32U4/GVS-32U4-X3.sch

## KiCad design Arduino Cards/GVS-32U4/GVS-32U4-X3.sch (2013-06-27)

Schematic: GVS-32U4-X3.sch

Parts:
C1: 1uF; SM0805
C2, C3, C5, C6, C7, C8: 0.1uF; SM0805
C4: 10uF; SM1210
C9: 0.01uF; SM0805
COUP1: REV_BLOCK
DS2: LED; LED-0805
F1: FUSE; SM1206
J1: USB-B; USB-B-MINI
J2, J3, J4, J5, J6, J7, J9, J10, J11, J12, J13, J14, J15, J16, J17, J18, J19, J20, J21, J22, J23, J24, J25, J26, J27: GVS; PIN_ARRAY_3X1
J8, J29, J30: CONN_2; PIN_ARRAY_2X1
J28: CONN_3; PIN_ARRAY_3X1
L1: 10uH; SM0805
MTG1, MTG2, MTG3, MTG4: CONN_1; MTG-4-40
R1, R2: 22; SM0805
R3: 270; SM0805
R4, R9: 10K; SM0805
U1: ATMEGA32U4-AU; TQFP44
U2: AP1117; SOT223
X1: 16MHz; RESON_3PIN

Notes on the sheet:
USB Pwr
