land-boards/lb-boards/Arduino Cards/MiniDuino/MiniDuino.sch

## KiCad design Arduino Cards/MiniDuino/MiniDuino.sch (2013-05-17)

Schematic: MiniDuino.sch

Parts:
C1, C2, C3, C5: 0.1uF; C1
C4: CP; CP_5x11mm
D1: 4N4004; D3
J1: CONN_10; PIN_ARRAY-10X1
J2, J8: CONN_3; PIN_ARRAY_3X1
J3: CONN_8; PIN_ARRAY-8X1
J4, J5, J6: CONN_6; PIN_ARRAY-6X1
J7: CONN_4; PIN_ARRAY_4x1
MTG1, MTG2, MTG3, MTG4: CONN_1; MTG-4-40
R1: 10K; R1
TB1: TB-2PIN; TB2-5MM
U1: ATMEGA328-PU; DIP-28__300
U2: AP1117; SOT223
Y1: 16MHz; SIL-3

Notes on the sheet:
GND CTS +5V TX RX RTS
GND
+VIN
I2C I/F
DIGITAL SPARES
ANALOG SPARES
FTDI CONNECTOR
MENU 5-WAY SWITCH
GPS CONNECTOR
3.3VOUT
GPSEN
VBAT
GPSFIX
GPSTX
GPSRX
VIN
TFT LCD
SDCS
MOSI
MISO
SCL
LCDCS
RESET
BKL
VCC
(D13)
(D12)
(D11)
(D10)
(D9)
(D8)
(D7)
(D6)
(D5)
(D4)
(D3)
(D2)
(D1)
(D0)
(AD0)
(AD1)
(AD2)
(AD3)
(AD4)
(AD5)
