land-boards/lb-boards/Arduino Cards/MyMenu/MyMenu.kicad_sch

## KiCad design Arduino Cards/MyMenu/MyMenu.kicad_sch (2022-10-10)

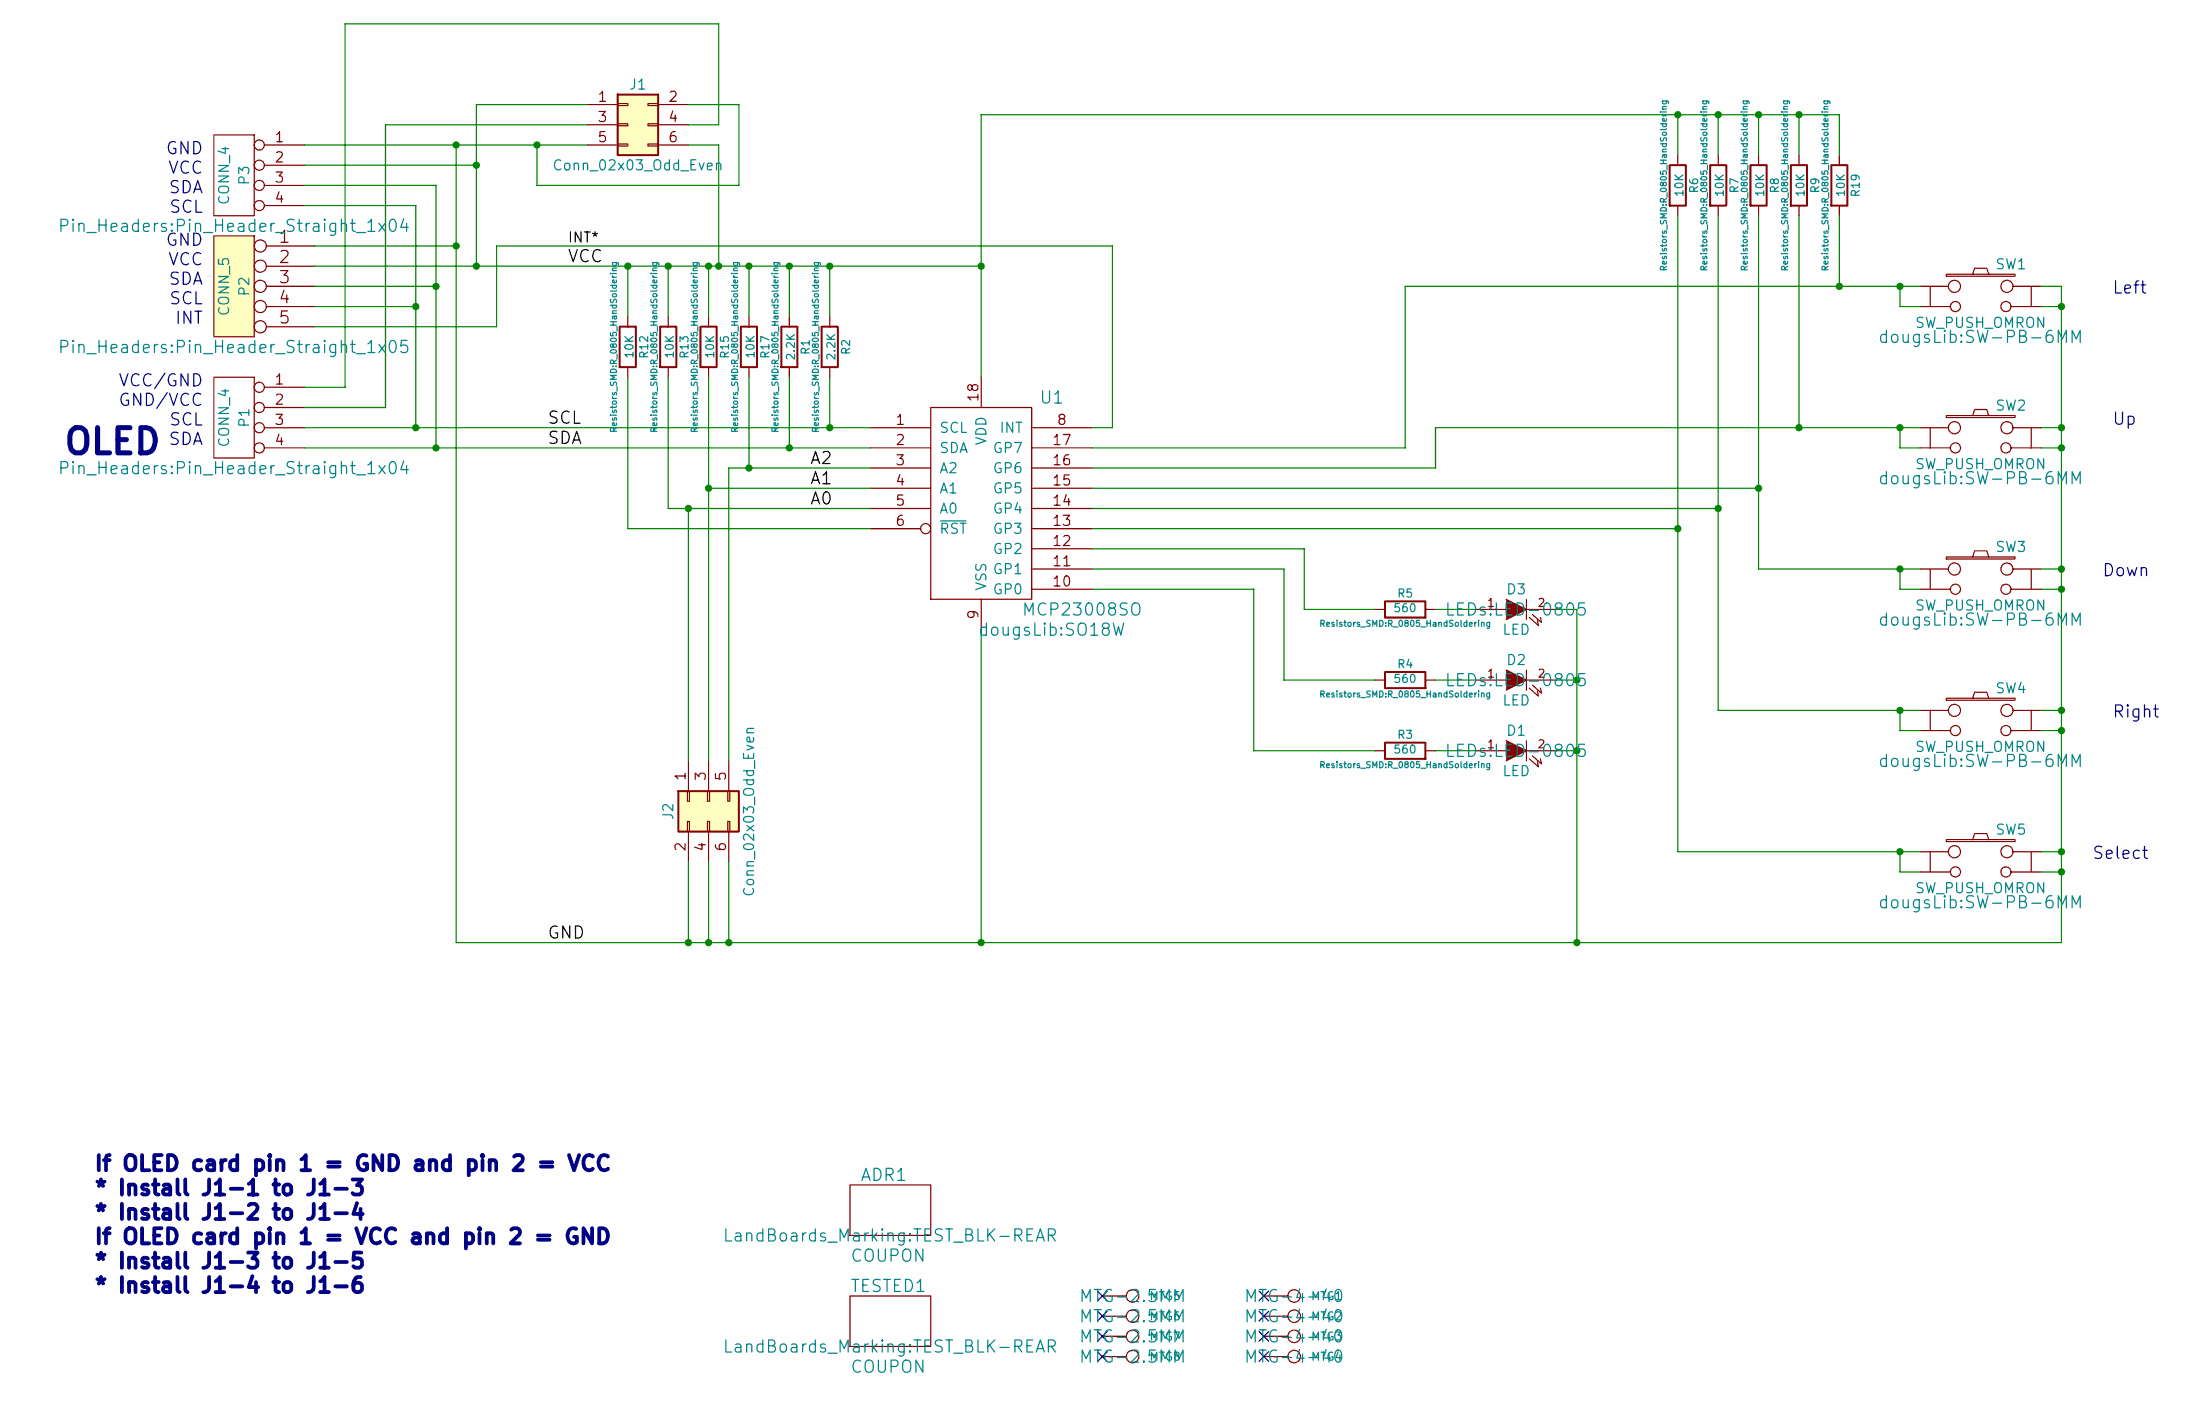
[picture p618: schematic MyMenu.kicad_sch]

Parts:
ADR1: COUPON; TEST_BLK-REAR
D1, D2, D3: LED; LED-0805
J1, J2: Conn_02x03_Odd_Even; PinHeader_2x03_P2.54mm_Vertical
MTG1, MTG2, MTG3, MTG4: CONN_1; MTG-4-40
MTG5, MTG6, MTG7, MTG8: CONN_1; MTG-2.5MM
P1, P3: CONN_4; Pin_Header_Straight_1x04
P2: CONN_5; Pin_Header_Straight_1x05
R1, R2: 2.2K; R_0805_HandSoldering
R3, R4, R5: 560; R_0805_HandSoldering
R6, R7, R8, R9, R12, R13, R15, R17, R19: 10K; R_0805_HandSoldering
SW1, SW2, SW3, SW4, SW5: SW_PUSH_OMRON; SW-PB-6MM
TESTED1: COUPON; TEST_BLK-REAR
U1: MCP23008SO; SO18W

Connections:
A0: J2.1, R13.2, U1.5 (A0)
A1: J2.3, R15.2, U1.4 (A1)
A2: J2.5, R17.2, U1.3 (A2)
GND: D1.2 (K), D2.2 (K), D3.2 (K), J1.2, J1.5, J2.2, J2.4, J2.6, P2.1, P3.1, SW1.3, SW1.4, SW2.3, SW2.4, SW3.3, SW3.4, SW4.3, SW4.4, SW5.3, SW5.4, U1.9 (VSS)
INT*: P2.5, U1.8 (INT)
unnamed: D1.1 (A), R3.2
unnamed: D2.1 (A), R4.2
unnamed: D3.1 (A), R5.2
unnamed: J1.3, P1.2
unnamed: J1.4, P1.1
unnamed: R3.1, U1.10 (GP0)
unnamed: R4.1, U1.11 (GP1)
unnamed: R5.1, U1.12 (GP2)
unnamed: R6.2, SW5.1, SW5.2, U1.13 (GP3)
unnamed: R7.2, SW4.1, SW4.2, U1.14 (GP4)
unnamed: R8.2, SW3.1, SW3.2, U1.15 (GP5)
unnamed: R9.2, SW2.1, SW2.2, U1.16 (GP6)
unnamed: R12.2, U1.6 (~RST)
unnamed: R19.2, SW1.1, SW1.2, U1.17 (GP7)
SCL: P1.3, P2.4, P3.4, R2.2, U1.1 (SCL)
SDA: P1.4, P2.3, P3.3, R1.2, U1.2 (SDA)
VCC: J1.1, J1.6, P2.2, P3.2, R1.1, R2.1, R6.1, R7.1, R8.1, R9.1, R12.1, R13.1, R15.1, R17.1, R19.1, U1.18 (VDD)

Notes on the sheet:
GND VCC SDA SCL
Left
OLED
VCC/GND GND/VCC SCL SDA
Right
If OLED card pin 1 = GND and pin 2 = VCC * Install J1-1 to J1-3 * Install J1-2 to J1-4 If OLED card pin 1 = VCC and pin 2 = GND * Install J1-3 to J1-5 * Install J1-4 to J1-6
Down
Select
GND VCC SDA SCL INT
