land-boards/lb-boards/Arduino Cards/NANO-BKOUT/NANO-BKOUT.kicad_sch

## KiCad design Arduino Cards/NANO-BKOUT/NANO-BKOUT.kicad_sch (2022-10-10)

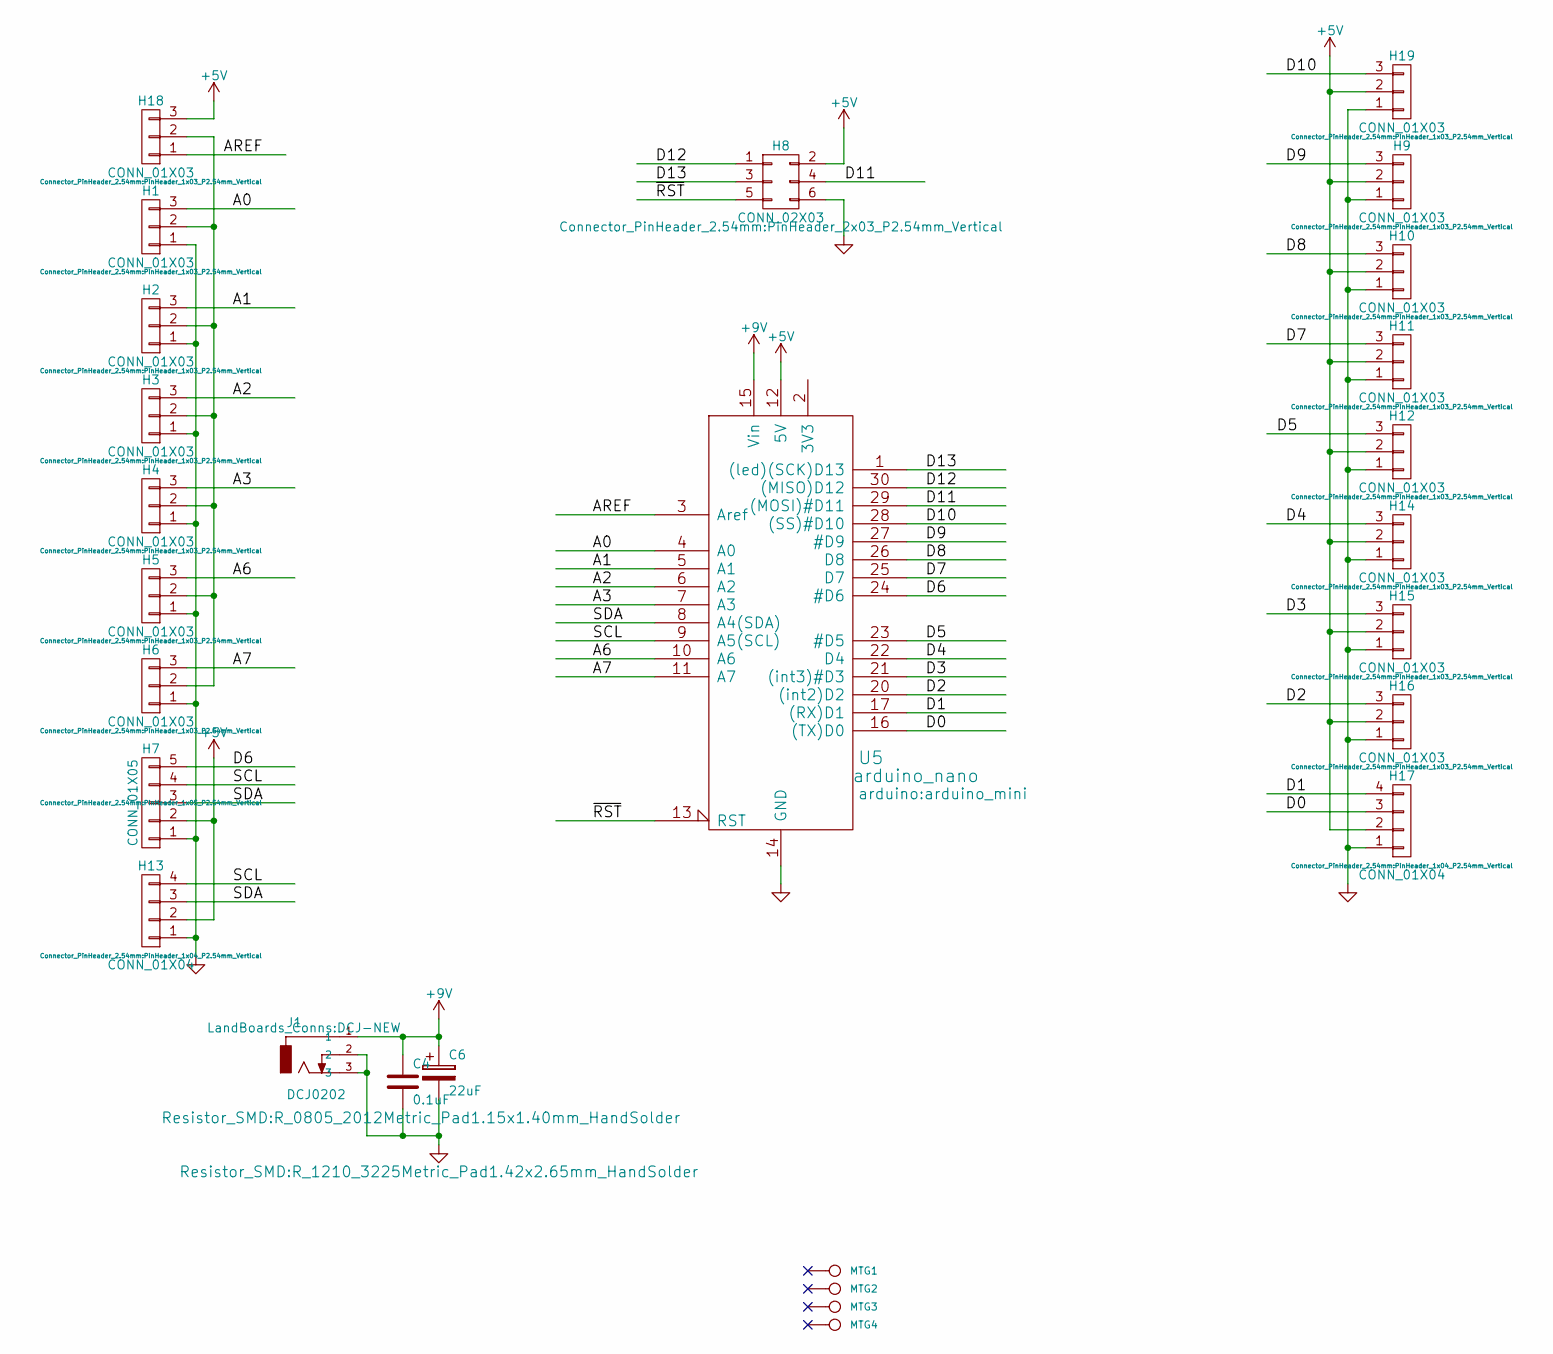
[picture p619: schematic NANO-BKOUT.kicad_sch]

Parts:
C4: 0.1uF; R_0805_2012Metric_Pad1.15x1.40mm_HandSolder
C6: 22uF; R_1210_3225Metric_Pad1.42x2.65mm_HandSolder
H1, H2, H3, H4, H5, H6, H9, H10, H11, H12, H14, H15, H16, H18, H19: CONN_01X03; PinHeader_1x03_P2.54mm_Vertical
H7: CONN_01X05; PinHeader_1x05_P2.54mm_Vertical
H8: CONN_02X03; PinHeader_2x03_P2.54mm_Vertical
H13, H17: CONN_01X04; PinHeader_1x04_P2.54mm_Vertical
J1: DCJ0202; DCJ-NEW
MTG1, MTG2, MTG3, MTG4: CONN_1; MTG-4-40
U5: arduino_nano; arduino_mini

Connections:
+5V: H7.2, H8.2, H9.2, H10.2, H11.2, H12.2, H13.2, H14.2, H15.2, H16.2, H17.2, H18.3, H19.2, U5.12 (5V)
+9V: C4.1, C6.1, J1.1, U5.15 (Vin)
A0: H1.3, U5.4 (A0)
A1: H2.3, U5.5 (A1)
A2: H3.3, U5.6 (A2)
A3: H4.3, U5.7 (A3)
A6: H5.3, U5.10 (A6)
A7: H6.3, U5.11 (A7)
AREF: H18.1, U5.3 (Aref)
D0: H17.3, U5.16 ((TX)D0)
D1: H17.4, U5.17 ((RX)D1)
D2: H16.3, U5.20 ((int2)D2)
D3: H15.3, U5.21 ((int3)#D3)
D4: H14.3, U5.22 (D4)
D5: H12.3, U5.23 (#D5)
D6: H7.5, U5.24 (#D6)
D7: H11.3, U5.25 (D7)
D8: H10.3, U5.26 (D8)
D9: H9.3, U5.27 (#D9)
D10: H19.3, U5.28 ((SS)#D10)
D11: H8.4, U5.29 ((MOSI)#D11)
D12: H8.1, U5.30 ((MISO)D12)
D13: H8.3, U5.1 ((led)(SCK)D13)
GND: C4.2, C6.2, H1.1, H2.1, H3.1, H4.1, H5.1, H6.1, H7.1, H8.6, H9.1, H10.1, H11.1, H12.1, H13.1, H14.1, H15.1, H16.1, H17.1, H19.1, J1.2, J1.3, U5.14 (GND)
unnamed: H1.2, H2.2, H3.2, H4.2, H5.2, H6.2, H18.2
SCL: H7.4, H13.4, U5.9 (A5(SCL))
SDA: H7.3, H13.3, U5.8 (A4(SDA))
~RST: H8.5, U5.13 (RST)
