land-boards/lb-boards/Arduino Cards/QTPy49-01/QTPy49.kicad_sch

## KiCad design Arduino Cards/QTPy49-01/QTPy49.kicad_sch (2022-10-10)

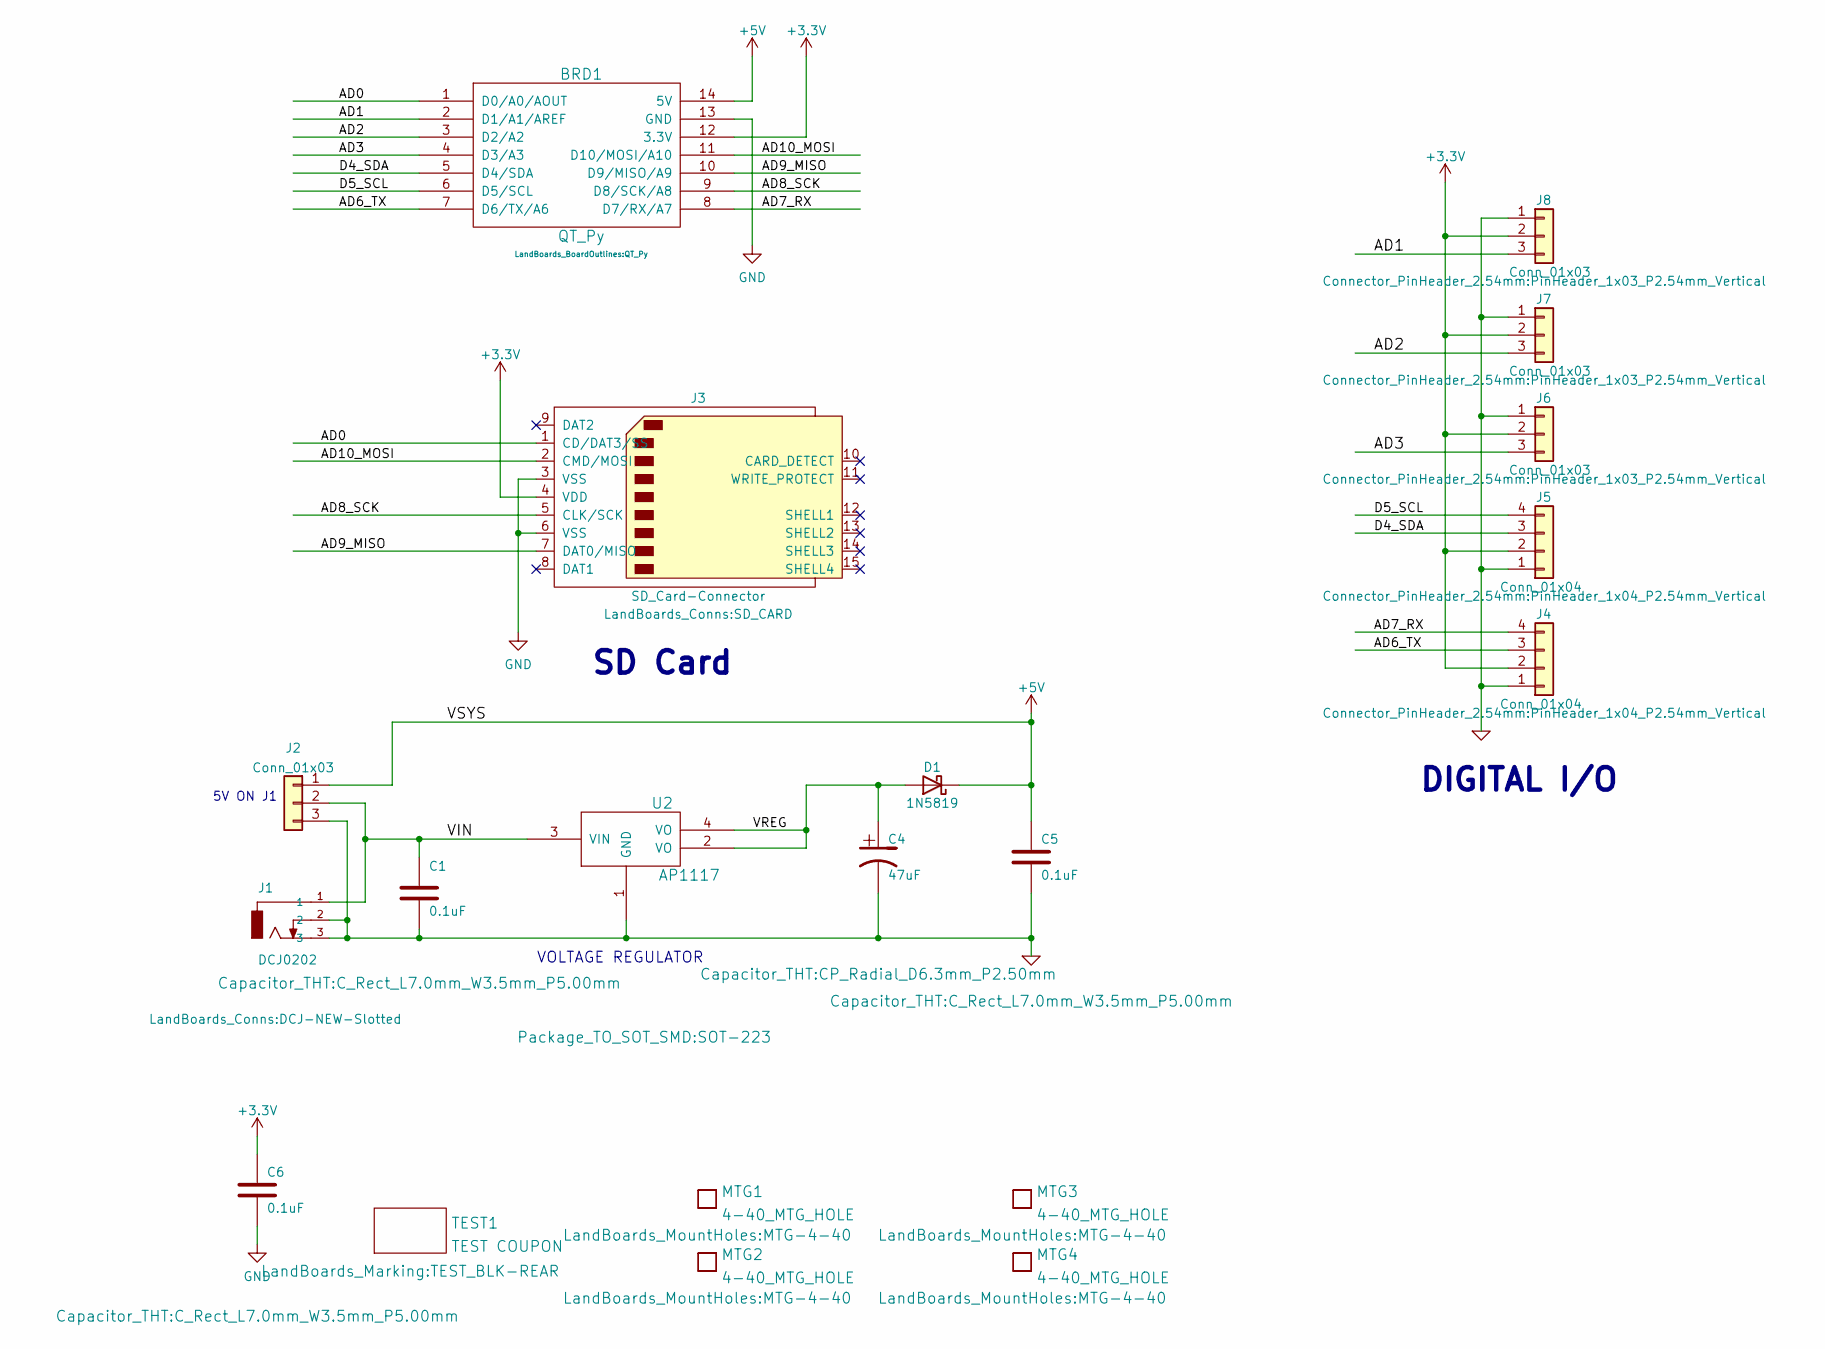
[picture p620: schematic QTPy49.kicad_sch]

Parts:
BRD1: QT_Py
C1, C5, C6: 0.1uF; C_Rect_L7.0mm_W3.5mm_P5.00mm
C4: 47uF; CP_Radial_D6.3mm_P2.50mm
D1: 1N5819; D_DO-41_SOD81_P10.16mm_Horizontal
J1: DCJ0202; DCJ-NEW-Slotted
J2, J6, J7, J8: Conn_01x03; PinHeader_1x03_P2.54mm_Vertical
J3: SD_Card-Connector; SD_CARD
J4, J5: Conn_01x04; PinHeader_1x04_P2.54mm_Vertical
MTG1, MTG2, MTG3, MTG4: 4-40_MTG_HOLE; MTG-4-40
TEST1: TEST COUPON; TEST_BLK-REAR
U2: AP1117; SOT-223

Connections:
+3.3V: BRD1.12 (3.3V), C6.1, J3.4 (VDD), J4.2, J5.2, J6.2, J7.2, J8.2
+5V: BRD1.14 (5V), C5.1, D1.1 (K), J2.1
AD0: BRD1.1 (D0/A0/AOUT), J3.1 (CD/DAT3/SS)
AD1: BRD1.2 (D1/A1/AREF), J8.3
AD2: BRD1.3 (D2/A2), J7.3
AD3: BRD1.4 (D3/A3), J6.3
AD6_TX: BRD1.7 (D6/TX/A6), J4.3
AD7_RX: BRD1.8 (D7/RX/A7), J4.4
AD8_SCK: BRD1.9 (D8/SCK/A8), J3.5 (CLK/SCK)
AD9_MISO: BRD1.10 (D9/MISO/A9), J3.7 (DAT0/MISO)
AD10_MOSI: BRD1.11 (D10/MOSI/A10), J3.2 (CMD/MOSI)
D4_SDA: BRD1.5 (D4/SDA), J5.3
D5_SCL: BRD1.6 (D5/SCL), J5.4
GND: BRD1.13 (GND), C1.2, C4.2, C5.2, C6.2, J1.2, J1.3, J2.3, J3.3 (VSS), J3.6 (VSS), J4.1, J5.1, J6.1, J7.1, J8.1, U2.1 (GND)
VIN: C1.1, J1.1, J2.2, U2.3 (VIN)
VREG: C4.1, D1.2 (A), U2.2 (VO), U2.4 (VO)

Notes on the sheet:
SD Card
DIGITAL I/O
5V ON J1
VOLTAGE REGULATOR
