land-boards/lb-boards/Arduino Cards/Screwduino/screwduino.kicad_sch

## KiCad design Arduino Cards/Screwduino/screwduino.kicad_sch (2023-03-08)

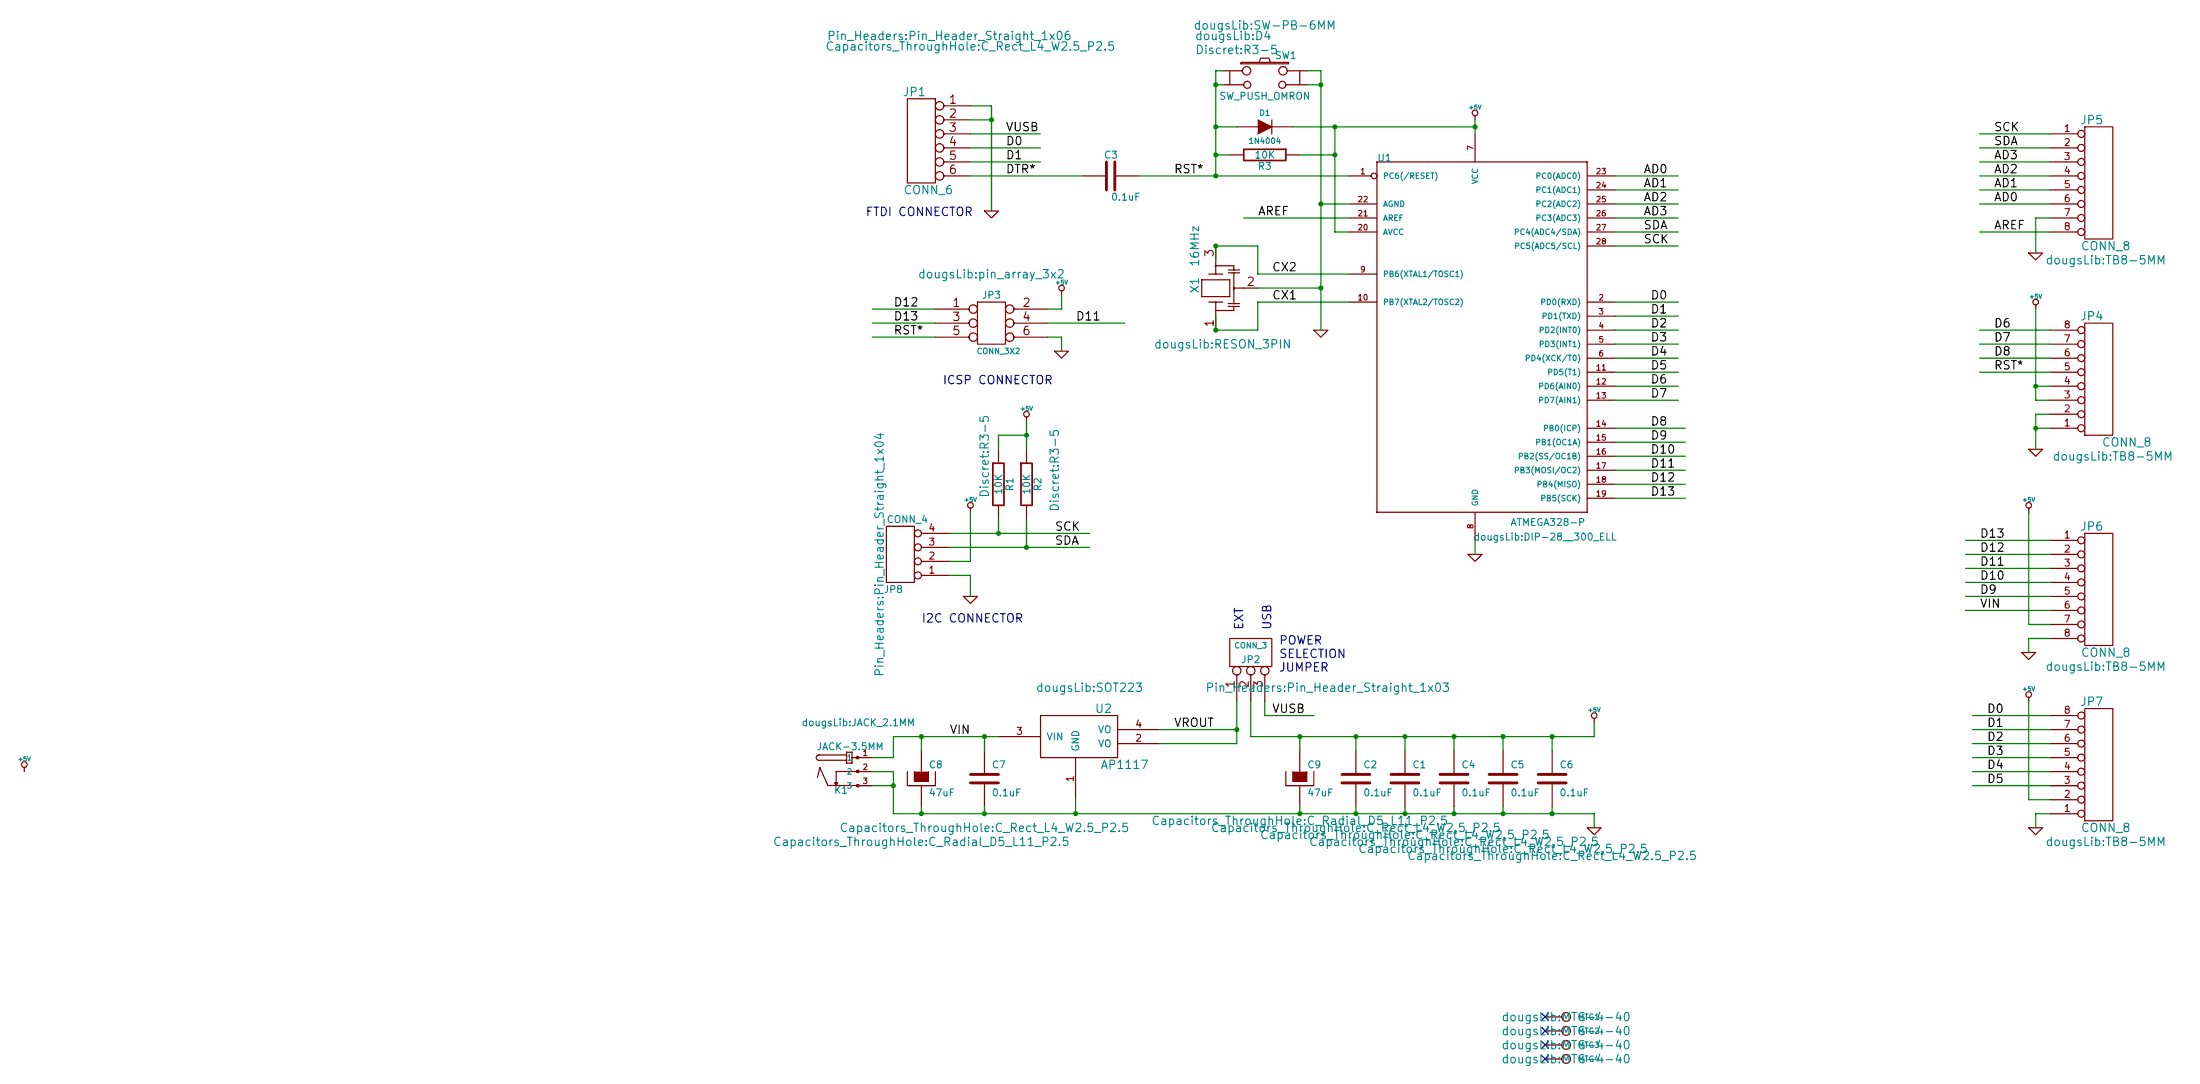
[picture p622: schematic screwduino.kicad_sch]

Parts:
C1, C2, C3, C4, C5, C6, C7: 0.1uF; C_Rect_L4_W2.5_P2.5; MfgPN 1C10Z5U104M050B
C8, C9: 47uF; C_Radial_D5_L11_P2.5; MfgPN REA100M1EBK-0511P
D1: 1N4004; D4; MfgPN 1N4004
JP1: CONN_6; Pin_Header_Straight_1x06; MfgPN 68602-406HLF
JP2: CONN_3; Pin_Header_Straight_1x03; MfgPN 69190-403
JP3: CONN_3X2; pin_array_3x2; MfgPN 929836-09-03
JP4, JP5, JP7: CONN_8; TB8-5MM; MfgPN 1935226
JP6: CONN_8; TB8-5MM; MfgPN 651-1935226
JP8: CONN_4; Pin_Header_Straight_1x04; MfgPN 68602-404HLF
K1: JACK-3.5MM; JACK_2.1MM; MfgPN 163-179PH-EX
MTG1, MTG2, MTG3, MTG4: CONN_1; MTG-4-40
R1, R2, R3: 10K; R3-5; MfgPN CMF5510K000FKEK
SW1: SW_PUSH_OMRON; SW-PB-6MM; MfgPN TL1105DF100Q
U1: ATMEGA328-P; DIP-28__300_ELL; MfgPN ATMEGA328P-PU
U2: AP1117; SOT223; MfgPN TLV1117-50CDCYR
X1: 16MHz; RESON_3PIN; MfgPN CSTLS16M0X51-A0

Connections:
+5V: C1.1, C2.1, C4.1, C5.1, C6.1, C9.1, D1.2 (K), JP2.2 (PM), JP3.2, JP4.3, JP4.4, JP6.7, JP7.2, JP8.2, R1.1, R2.1, R3.1, U1.7 (VCC), U1.20 (AVCC)
AD0: JP5.6, U1.23 (PC0(ADC0))
AD1: JP5.5, U1.24 (PC1(ADC1))
AD2: JP5.4, U1.25 (PC2(ADC2))
AD3: JP5.3, U1.26 (PC3(ADC3))
AREF: JP5.8, U1.21 (AREF)
CX1: U1.10 (PB7(XTAL2/TOSC2)), X1.1
CX2: U1.9 (PB6(XTAL1/TOSC1)), X1.3
D0: JP1.4, JP7.8, U1.2 (PD0(RXD))
D1: JP1.5, JP7.7, U1.3 (PD1(TXD))
D2: JP7.6, U1.4 (PD2(INT0))
D3: JP7.5, U1.5 (PD3(INT1))
D4: JP7.4, U1.6 (PD4(XCK/T0))
D5: JP7.3, U1.11 (PD5(T1))
D6: JP4.8, U1.12 (PD6(AIN0))
D7: JP4.7, U1.13 (PD7(AIN1))
D8: JP4.6, U1.14 (PB0(ICP))
D9: JP6.5, U1.15 (PB1(OC1A))
D10: JP6.4, U1.16 (PB2(SS/OC1B))
D11: JP3.4, JP6.3, U1.17 (PB3(MOSI/OC2))
D12: JP3.1, JP6.2, U1.18 (PB4(MISO))
D13: JP3.3, JP6.1, U1.19 (PB5(SCK))
DTR*: C3.2, JP1.6
GND: C1.2, C2.2, C4.2, C5.2, C6.2, C7.2, C8.2, C9.2, JP1.1, JP1.2, JP3.6, JP4.1, JP4.2, JP5.7, JP6.8, JP7.1, JP8.1, K1.2, K1.3, SW1.3, SW1.4, U1.8 (GND), U1.22 (AGND), U2.1 (GND), X1.2
RST*: C3.1, D1.1 (A), JP3.5, JP4.5, R3.2, SW1.1, SW1.2, U1.1 (PC6(/RESET))
SCK: JP5.1, JP8.4, R1.2, U1.28 (PC5(ADC5/SCL))
SDA: JP5.2, JP8.3, R2.2, U1.27 (PC4(ADC4/SDA))
VIN: C7.1, C8.1, JP6.6, K1.1, U2.3 (VIN)
VROUT: JP2.1, U2.2 (VO), U2.4 (VO)
VUSB: JP1.3, JP2.3

Notes on the sheet:
USB
ICSP CONNECTOR
EXT
POWER SELECTION JUMPER
FTDI CONNECTOR
I2C CONNECTOR
