land-boards/lb-boards/Arduino Cards/Tiny85ISP/Tiny85ISP.sch

## KiCad design Arduino Cards/Tiny85ISP/Tiny85ISP.sch (2013-06-25)

Schematic: Tiny85ISP.sch

Parts:
C1, C2, C4: 0.1uF; SM0805
C3: 10uF; SM1210
H1: CONN_3X2; pin_array_3x2
H2, H3: CONN_3; PIN_ARRAY_3X1
H4, H5: CONN_2; PIN_ARRAY_2X1
MTG1, MTG2, MTG3, MTG4: CONN_1; MTG-4-40
R1: 10K; SM0805
U1: AP1117; SOT223
U2: ATTINY85; DIP-8__300
