land-boards/lb-boards/Arduino Cards/TinyDuino85/TinyDuino85.sch

## KiCad design Arduino Cards/TinyDuino85/TinyDuino85.sch (2012-09-09)

Schematic: TinyDuino85.sch

Parts:
C1, C2, C4: 0.1uF; C1
C3: 10uF; C1V5
K1, K2, K3, K4, K5: CONN_3; PIN_ARRAY_3X1
MTG1, MTG2, MTG3, MTG4: CONN_1; MTG-4-40
P1: CONN_3; PIN_ARRAY_3X1
R1: 10K; R1
R2, R3, R4, R5, R6: R; R1
U1: AP1117; SOT223
U2: ATTINY85; DIP-8__300
