land-boards/lb-boards/Arduino Cards/TinyGrid85-Opto/TinyGrid85-Opto.sch

## KiCad design Arduino Cards/TinyGrid85-Opto/TinyGrid85-Opto.sch (2014-07-08)

Schematic: TinyGrid85-Opto.sch

Parts:
C1, C2, C3, C4, C5: 0.1uF; C1
C6: 10uF; C1V5
H1: CONN_2; PIN_ARRAY_2X1
H2: CONN_3X2; pin_array_3x2
J1: DCJ0202; JACK_2.1MM
MTG1, MTG2, MTG3, MTG4: CONN_1; MTG-4-40
P1, P2, P3, P4, P5, P6, P7, P8, P9, P10, P11, P12: CONN_10; PIN_ARRAY-10X1
R1: 10K; R4
U1: ATTINY85; DIP-8__300
U2: AP1117; SOT223

Notes on the sheet:
INSTALLED = USE REG NOT INST = DON'T USE REG
MICROPROCESSOR
VOLTAGE REGULATOR
2.1MM POWER CONN
BREADBOARD GRID
[A4]
[B4]
[F1]
[E1]
[D1]
[F2]
[B1]
[E3]
[A3]
[D2]
[A2]
[B7]
[C7]
[D10]
[F10]
[F7]
[F6-VCC]
[B10]
[B8]
[E8]
[E10]
[D1-VCC]
[D3-10]
[D2-7]
[D4-7]
[D4-3]
[D2-3]
[D4-4]
[D2-4]
[D4-5-GND]
[D2-5-GND]
