land-boards/lb-boards/Arduino Cards/ToidUino/ToidUino.sch

## KiCad design Arduino Cards/ToidUino/ToidUino.sch (2012-09-03)

Schematic: ToidUino.sch

Parts:
C1, C9: 10uF
C8: 0.1uF
D1: 1N4004
D2, D3: LED
J1: USB-B
J2: CONN_2
MTG1, MTG2, MTG3, MTG4: CONN_1
R1, R3: 1K
R2, R4: 10K
R5: 330
U1: MCP73833
U2: FGPMMOPA6H
U3: FT232RL; ftdichip-1-SSOP28DB
U4: ATTINY85

Notes on the sheet:
+ LiPO BATTERY -
+ -
