land-boards/lb-boards/Arduino Cards/UNO-DB25/UNO-DB25.kicad_sch

## KiCad design Arduino Cards/UNO-DB25/UNO-DB25.kicad_sch (2022-10-10)

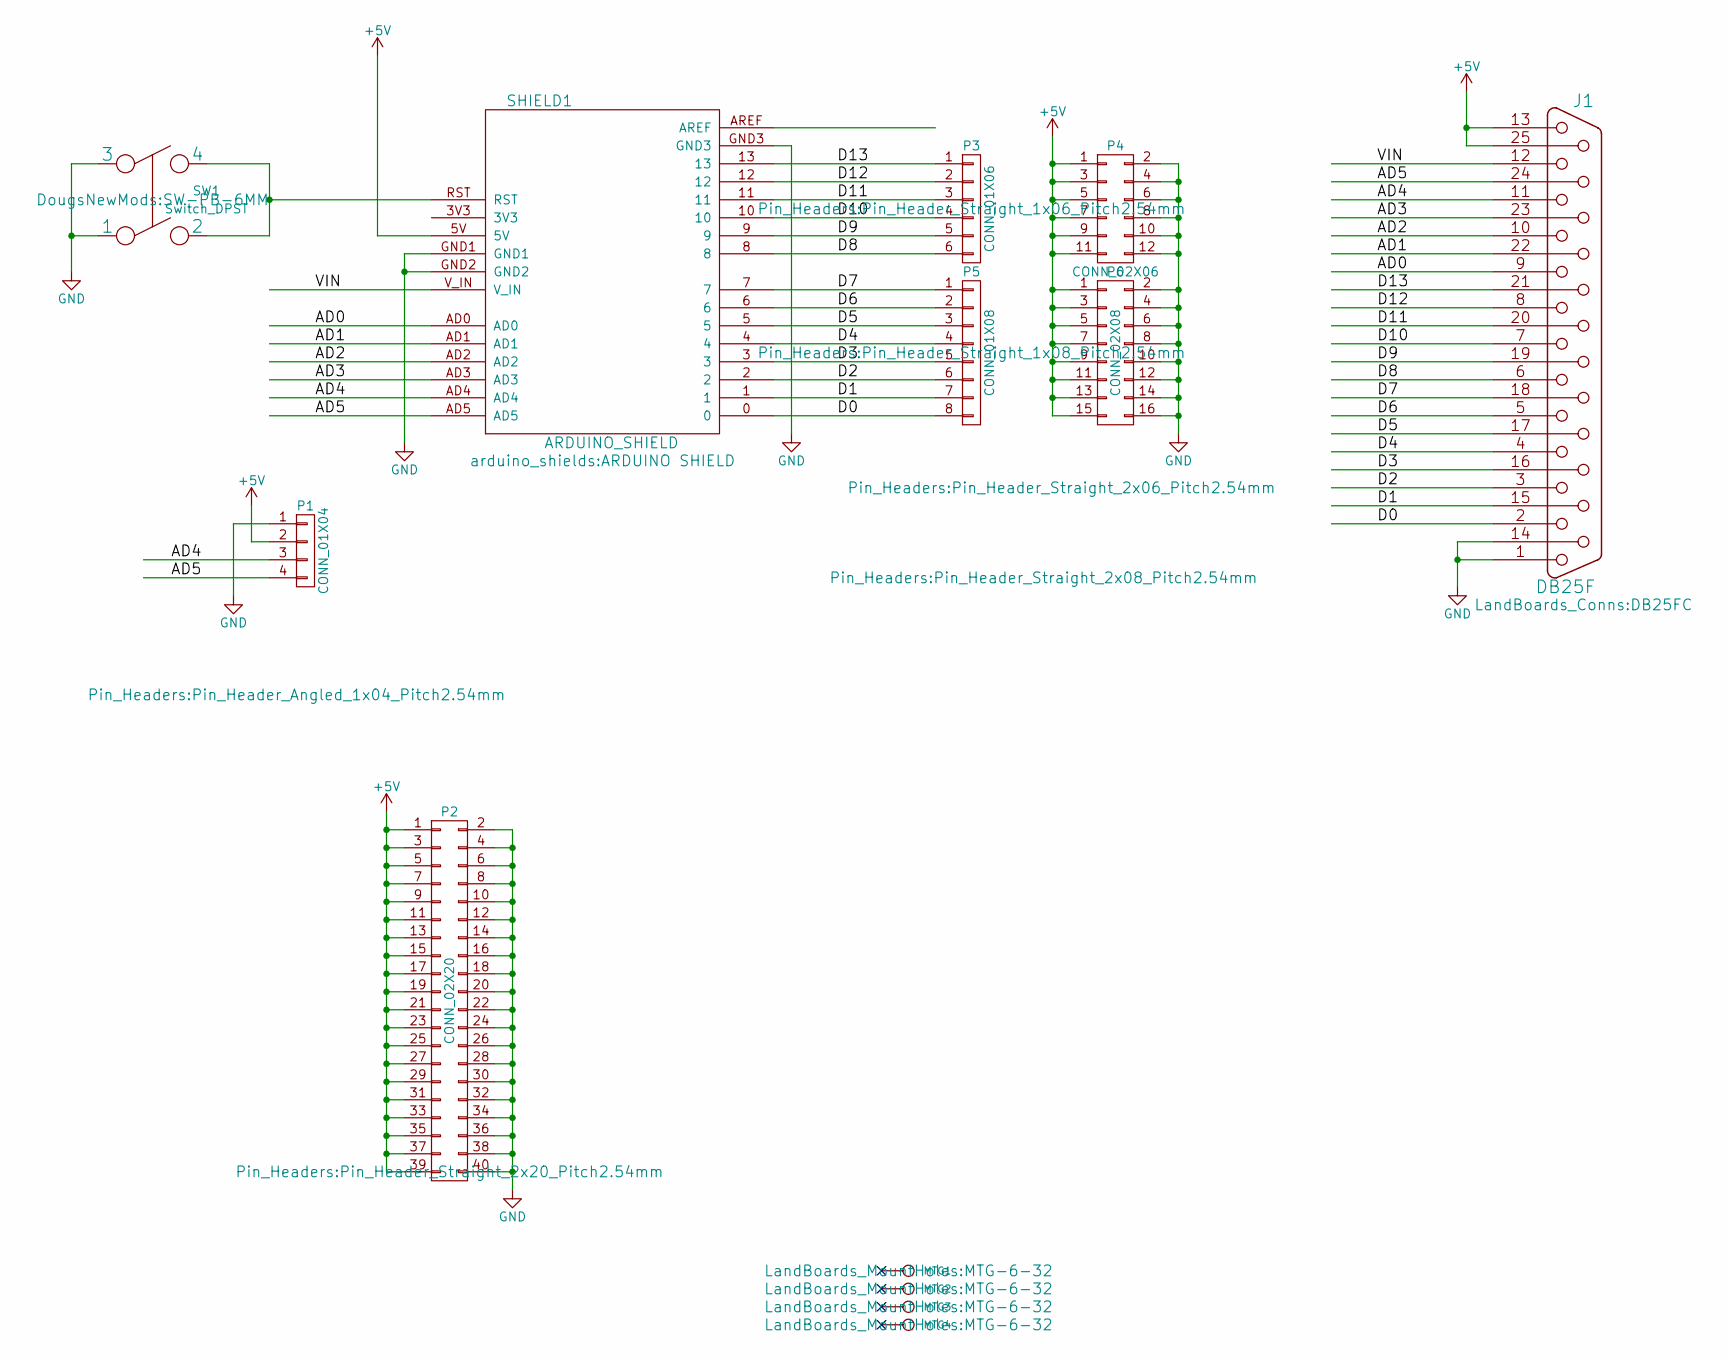
[picture p623: schematic UNO-DB25.kicad_sch]

Parts:
J1: DB25F; DB25FC
MTG1, MTG2, MTG3, MTG4: CONN_1; MTG-6-32
P1: CONN_01X04; Pin_Header_Angled_1x04_Pitch2.54mm
P2: CONN_02X20; Pin_Header_Straight_2x20_Pitch2.54mm
P3: CONN_01X06; Pin_Header_Straight_1x06_Pitch2.54mm
P4: CONN_02X06; Pin_Header_Straight_2x06_Pitch2.54mm
P5: CONN_01X08; Pin_Header_Straight_1x08_Pitch2.54mm
P6: CONN_02X08; Pin_Header_Straight_2x08_Pitch2.54mm
SHIELD1: ARDUINO_SHIELD; ARDUINO SHIELD
SW1: Switch_DPST; SW-PB-6MM

Connections:
+5V: J1.13, J1.25, P1.2, P2.1, P2.3, P2.5, P2.7, P2.9, P2.11, P2.13, P2.15, P2.17, P2.19, P2.21, P2.23, P2.25, P2.27, P2.29, P2.31, P2.33, P2.35, P2.37, P2.39, P4.1, P4.3, P4.5, P4.7, P4.9, P4.11, P6.1, P6.3, P6.5, P6.7, P6.9, P6.11, P6.13, P6.15, SHIELD1.5V
AD0: J1.9, SHIELD1.AD0
AD1: J1.22, SHIELD1.AD1
AD2: J1.10, SHIELD1.AD2
AD3: J1.23, SHIELD1.AD3
AD4: J1.11, P1.3, SHIELD1.AD4
AD5: J1.24, P1.4, SHIELD1.AD5
D0: J1.2, P5.8, SHIELD1.0
D1: J1.15, P5.7, SHIELD1.1
D2: J1.3, P5.6, SHIELD1.2
D3: J1.16, P5.5, SHIELD1.3
D4: J1.4, P5.4, SHIELD1.4
D5: J1.17, P5.3, SHIELD1.5
D6: J1.5, P5.2, SHIELD1.6
D7: J1.18, P5.1, SHIELD1.7
D8: J1.6, P3.6, SHIELD1.8
D9: J1.19, P3.5, SHIELD1.9
D10: J1.7, P3.4, SHIELD1.10
D11: J1.20, P3.3, SHIELD1.11
D12: J1.8, P3.2, SHIELD1.12
D13: J1.21, P3.1, SHIELD1.13
GND: J1.1, J1.14, P1.1, P2.2, P2.4, P2.6, P2.8, P2.10, P2.12, P2.14, P2.16, P2.18, P2.20, P2.22, P2.24, P2.26, P2.28, P2.30, P2.32, P2.34, P2.36, P2.38, P2.40, P4.2, P4.4, P4.6, P4.8, P4.10, P4.12, P6.2, P6.4, P6.6, P6.8, P6.10, P6.12, P6.14, P6.16, SHIELD1.GND1, SHIELD1.GND2, SHIELD1.GND3, SW1.1, SW1.3
unnamed: SHIELD1.RST, SW1.2, SW1.4
VIN: J1.12, SHIELD1.V_IN
