land-boards/lb-boards/Arduino Cards/WLSensor/WLS-002.sch

## KiCad design Arduino Cards/WLSensor/WLS-002.sch (2013-09-30)

Schematic: WLS-002.sch

Parts:
C1, C3, C5: 0.1uF; C1
C4: 10uF; CP_5x11mm
C6, C7: 18pF
D1: 4N4004; D3
J2: DCJ0202; JACK_3.5MM
J7: CONN_4; PIN_ARRAY_4x1
P1: CONN_3X2; pin_array_3x2
R1: 10K; R1
U1: ATMEGA328-PU; DIP-28__300
U2: AP1117-3.3; SOT223
X1: 8MHz

Notes on the sheet:
I2C I/F
(D13)
(D12)
(D11)
(D10)
(D9)
(D8)
(D7)
(D6)
(D5)
(D4)
(D3)
(D2)
(D1)
(D0)
(AD0)
(AD1)
(AD2)
(AD3)
(AD4)
(AD5)
