land-boards/lb-boards/Audio Cards/AudioAmp380/AudioAmp380.sch

## KiCad design Audio Cards/AudioAmp380/AudioAmp380.sch (2022-04-09)

Schematic: AudioAmp380.sch

Parts:
C1, C3, C5, C8: 100nF; C_Disc_D3.0mm_W1.6mm_P2.50mm; MfgPN 1C10Z5U104M050B
C2: 10uF; CP_Radial_D5.0mm_P2.50mm
C4: 470uF; CP_Radial_D10.0mm_P5.00mm
C6: 10uF; CP_Radial_D5.0mm_P2.50mm; MfgPN 1C10Z5U104M050B
C7: 0.47uF; CP_Radial_D5.0mm_P2.50mm
C9: 100uF; CP_Radial_D6.3mm_P2.50mm
J1, J2: RCA-JACK; RCA; MfgPN NYS354
J3: DCJ0202; DCJ-NEW-Slotted
MTG4: MTG_HOLE; MTG-4-40
R1: 51; R_Axial_DIN0207_L6.3mm_D2.5mm_P10.16mm_Horizontal
R2: 10; R_Axial_DIN0207_L6.3mm_D2.5mm_P10.16mm_Horizontal
R3, R4: 10K; R_Axial_DIN0207_L6.3mm_D2.5mm_P10.16mm_Horizontal
R5: 2.7; R_Axial_DIN0207_L6.3mm_D2.5mm_P10.16mm_Horizontal; MfgPN CCF0710R0GKE36
RV1: CONN_01X05/10K; Pin_Header_Angled_1x05_Pitch2.54mm
RV2: 500; Potentiometer_Bourns_3299W_Vertical
TESTED1: COUPON; TEST_BLK-REAR
U1: NE5534; DIP-8_W7.62mm
U2: LM380N; DIP-14_W7.62mm

Notes on the sheet:
POT
+10-22VDC
Audio Input
Audio Output
