land-boards/lb-boards/Audio Cards/AudioAmp384/$AudioAmp384.sch

## KiCad design Audio Cards/AudioAmp384/$AudioAmp384.sch (2018-12-25)

Schematic: $AudioAmp384.sch

Parts:
C1, C4: 470uF; CP_Radial_D10.0mm_P5.00mm
C2: 4.7uF; CP_Radial_D4.0mm_P1.50mm
C3, C5: 0.1uF; C_Rect_L7.0mm_W2.5mm_P5.00mm
C6: 100uF; CP_Radial_D8.0mm_P3.50mm
COUP?1: TESTED1; TEST_BLK-REAR
J1, J2: RCA-JACK; RCA
J3: TB2-5MM
J4: CONN_01X05; Pin_Header_Angled_1x05_Pitch2.54mm
MTG1, MTG2, MTG3, MTG4: MTG_HOLE; MTG-4-40
R1: 2.7; R_Axial_DIN0204_L3.6mm_D1.6mm_P7.62mm_Horizontal
R2: 10; R_Axial_DIN0204_L3.6mm_D1.6mm_P7.62mm_Horizontal
R3: 75K; R_Axial_DIN0204_L3.6mm_D1.6mm_P7.62mm_Horizontal
U1: DIP-14__300; DIP-14_W7.62mm_LongPads

Notes on the sheet:
+V -V
