land-boards/lb-boards/Audio Cards/Pot_Pins/Pot_Pins.sch

## KiCad design Audio Cards/Pot_Pins/Pot_Pins.sch (2022-04-09)

Schematic: Pot_Pins.sch

Parts:
J1: Conn_01x05; PinHeader_1x05_P2.54mm_Vertical
J2: Conn_01x03; Pot3
