land-boards/lb-boards/Audio Cards/XR-2206/XR2206.sch

## KiCad design Audio Cards/XR-2206/XR2206.sch (2022-04-09)

Schematic: XR2206.sch

Parts:
C1: 0.1uF
C2: 1UF
C3: 4.7uF
J1, J2, J3: CONN_2
MTG1, MTG2, MTG3: CONN_1
R1, R5: 10K
R3: 220
R6, R7: 5.1K
RV1: 25K
U1: XR2206

Notes on the sheet:
G ADJ
VCO-OUT GND
+12V GND
