land-boards/lb-boards/BeagleBoneBlack Cards/BBB-COMMS-1/BBB-COMMS-1.sch

## KiCad design BeagleBoneBlack Cards/BBB-COMMS-1/BBB-COMMS-1.sch (2018-12-25)

Schematic: BBB-COMMS-1.sch

Parts:
FID1, FID2: CONN_1; FIDUCIAL
TESTED1: COUPON; TEST_BLK-REAR
