land-boards/lb-boards/BeagleBoneBlack Cards/BBB-COMMS-2/Analog-Inputs.sch

## KiCad design BeagleBoneBlack Cards/BBB-COMMS-2/Analog-Inputs.sch (2018-12-25)

Schematic: Analog-Inputs.sch

Parts:
A0, A1, A2, A3, A4, A5, A6: CONN_3; PIN_ARRAY_3X1
R6, R7, R8, R9, R10, R11, R12: 10K; R_0805_HandSoldering
U2, U3: MCP6004-I/SL; SOIC-14_N
