land-boards/lb-boards/BeagleBoneBlack Cards/BBB-COMMS-2/trans16.sch

## KiCad design BeagleBoneBlack Cards/BBB-COMMS-2/trans16.sch (2018-12-25)

Schematic: trans16.sch

Parts:
J26: GVS-8X3; Pin_Header_Straight_3x08
P1: CONN_8; Pin_Header_Straight_1x08
U4: TXS0108EPWR; SOG20
