land-boards/lb-boards/BeagleBoneBlack Cards/BBB-GVS-2/BBB-GVS-2.sch

## KiCad design BeagleBoneBlack Cards/BBB-GVS-2/BBB-GVS-2.sch (2015-10-31)

Schematic: BBB-GVS-2.sch

Parts:
COUP3, COUP4: COUPON; REV_BLOCK
FID3, FID4: CONN_1; FIDUCIAL
