land-boards/lb-boards/BeagleBoneBlack Cards/BBB-GVS-4/Analog-Inputs.kicad_sch

## KiCad design BeagleBoneBlack Cards/BBB-GVS-4/Analog-Inputs.kicad_sch (2022-10-10)

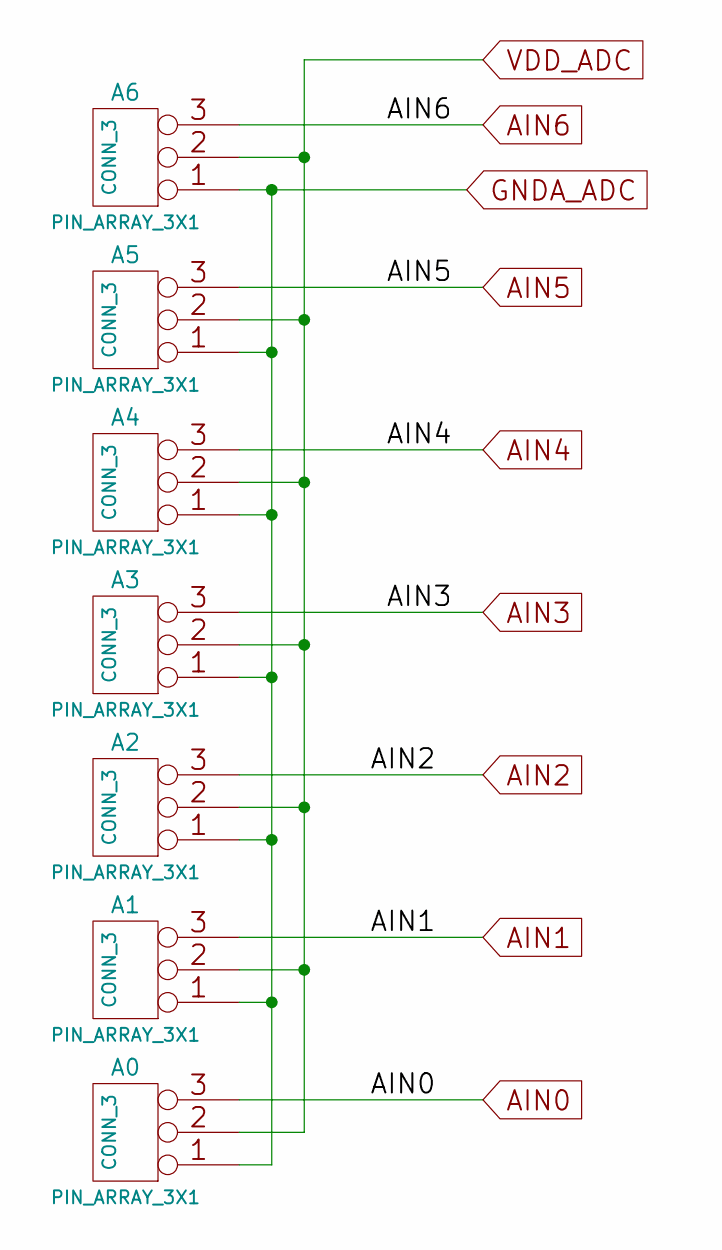
[picture p624: schematic Analog-Inputs.kicad_sch]

Parts:
A0, A1, A2, A3, A4, A5, A6: CONN_3; PIN_ARRAY_3X1

Connections:
AIN0: A0.3
AIN1: A1.3
AIN2: A2.3
AIN3: A3.3
AIN4: A4.3
AIN5: A5.3
AIN6: A6.3
GNDA_ADC: A0.1, A1.1, A2.1, A3.1, A4.1, A5.1, A6.1
VDD_ADC: A0.2 (PM), A1.2 (PM), A2.2 (PM), A3.2 (PM), A4.2 (PM), A5.2 (PM), A6.2 (PM)
