land-boards/lb-boards/BeagleBoneBlack Cards/BBB-GVS-4/BBB-Conn.kicad_sch

## KiCad design BeagleBoneBlack Cards/BBB-GVS-4/BBB-Conn.kicad_sch (2022-10-10)

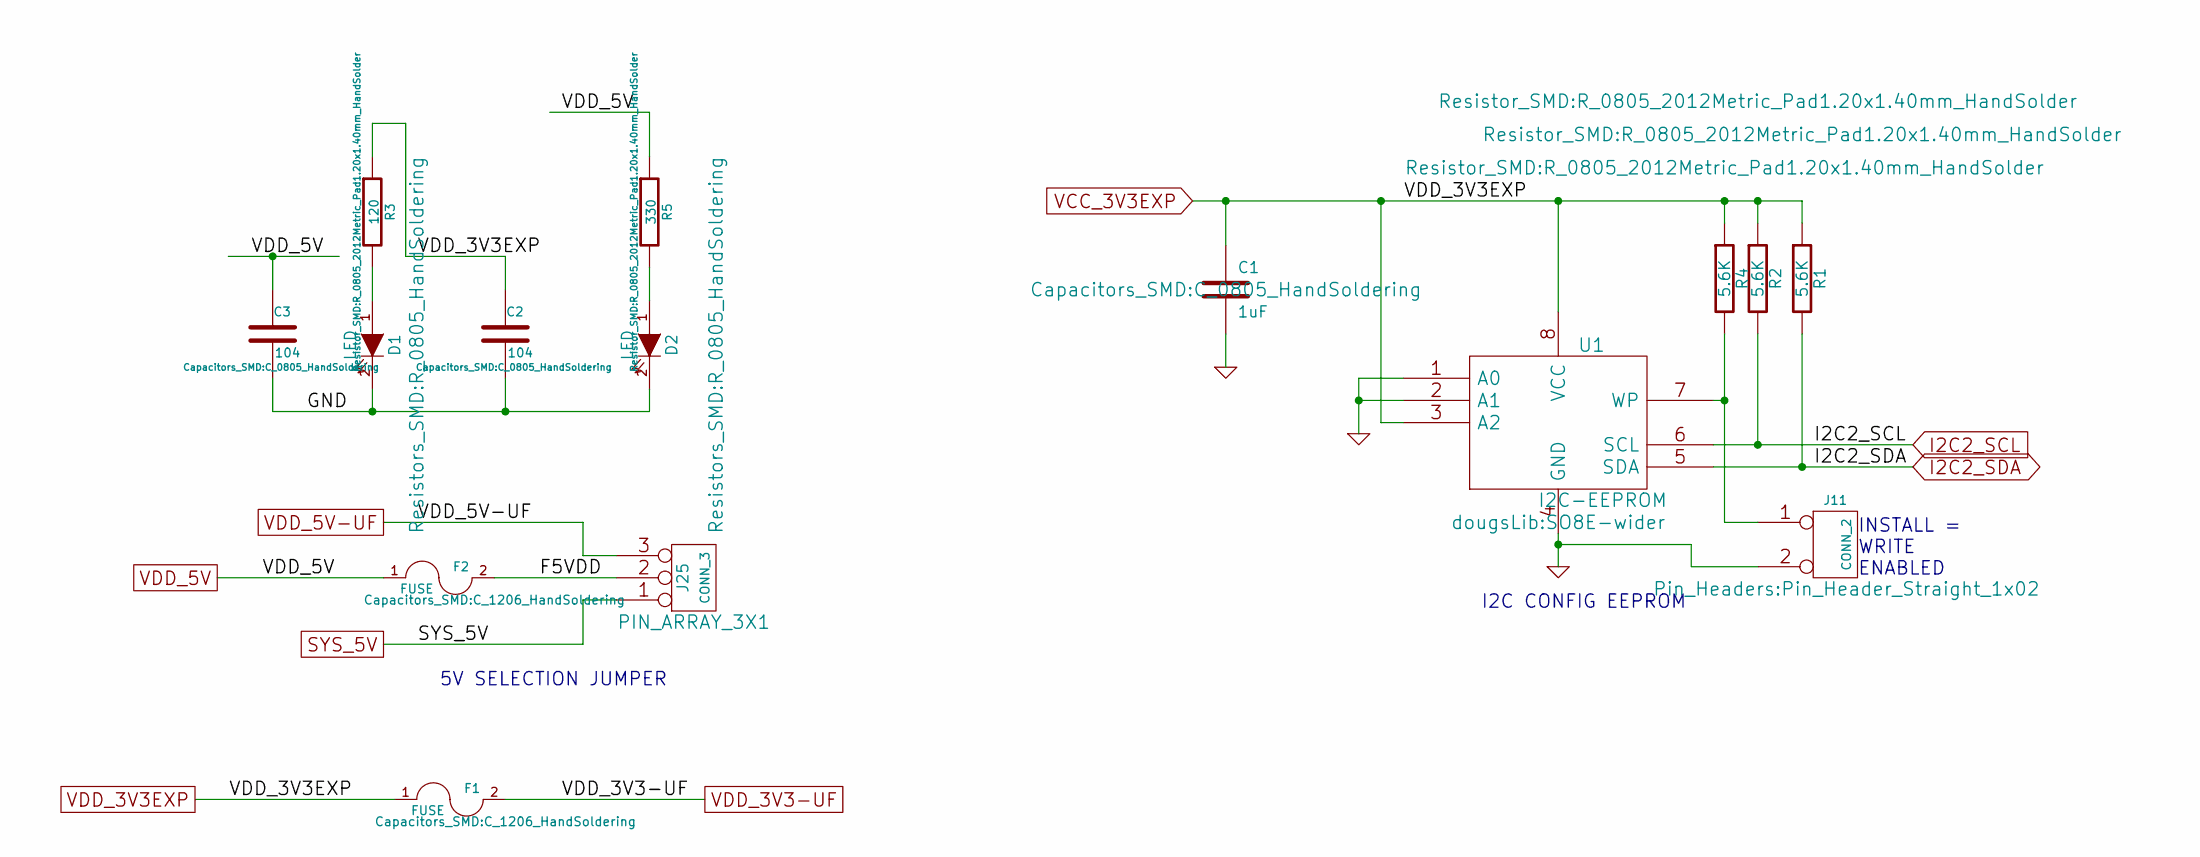
[picture p625: schematic BBB-Conn.kicad_sch]

Parts:
C1: 1uF; C_0805_HandSoldering
C2, C3: 104; C_0805_HandSoldering
D1, D2: LED; R_0805_HandSoldering
F1, F2: FUSE; C_1206_HandSoldering
J11: CONN_2; Pin_Header_Straight_1x02
J25: CONN_3; PIN_ARRAY_3X1
R1, R2, R4: 5.6K; R_0805_2012Metric_Pad1.20x1.40mm_HandSolder
R3: 120; R_0805_2012Metric_Pad1.20x1.40mm_HandSolder
R5: 330; R_0805_2012Metric_Pad1.20x1.40mm_HandSolder
U1: I2C-EEPROM; SO8E-wider

Connections:
F5VDD: F2.2, J25.2 (PM)
GND: C2.2, C3.2, D1.2 (K), D2.2 (K)
I2C2_SCL: R2.2, U1.6 (SCL)
I2C2_SDA: R1.2, U1.5 (SDA)
unnamed: D1.1 (A), R3.2
unnamed: D2.1 (A), R5.2
unnamed: J11.1, R4.2, U1.7 (WP)
SYS_5V: J25.1
VCC_3V3EXP: C1.1, C2.1, F1.1, R1.1, R2.1, R3.1, R4.1, U1.3 (A2), U1.8 (VCC)
VDD_3V3-UF: F1.2
VDD_5V: C3.1, F2.1, R5.1
VDD_5V-UF: J25.3
~: C1.2, J11.2 (PM), U1.1 (A0), U1.2 (A1), U1.4 (GND)

Notes on the sheet:
I2C CONFIG EEPROM
5V SELECTION JUMPER
INSTALL = WRITE ENABLED
