land-boards/lb-boards/BeagleBoneBlack Cards/BBB-GVS-4/BBB-P8-Conn.kicad_sch

## KiCad design BeagleBoneBlack Cards/BBB-GVS-4/BBB-P8-Conn.kicad_sch (2022-10-10)

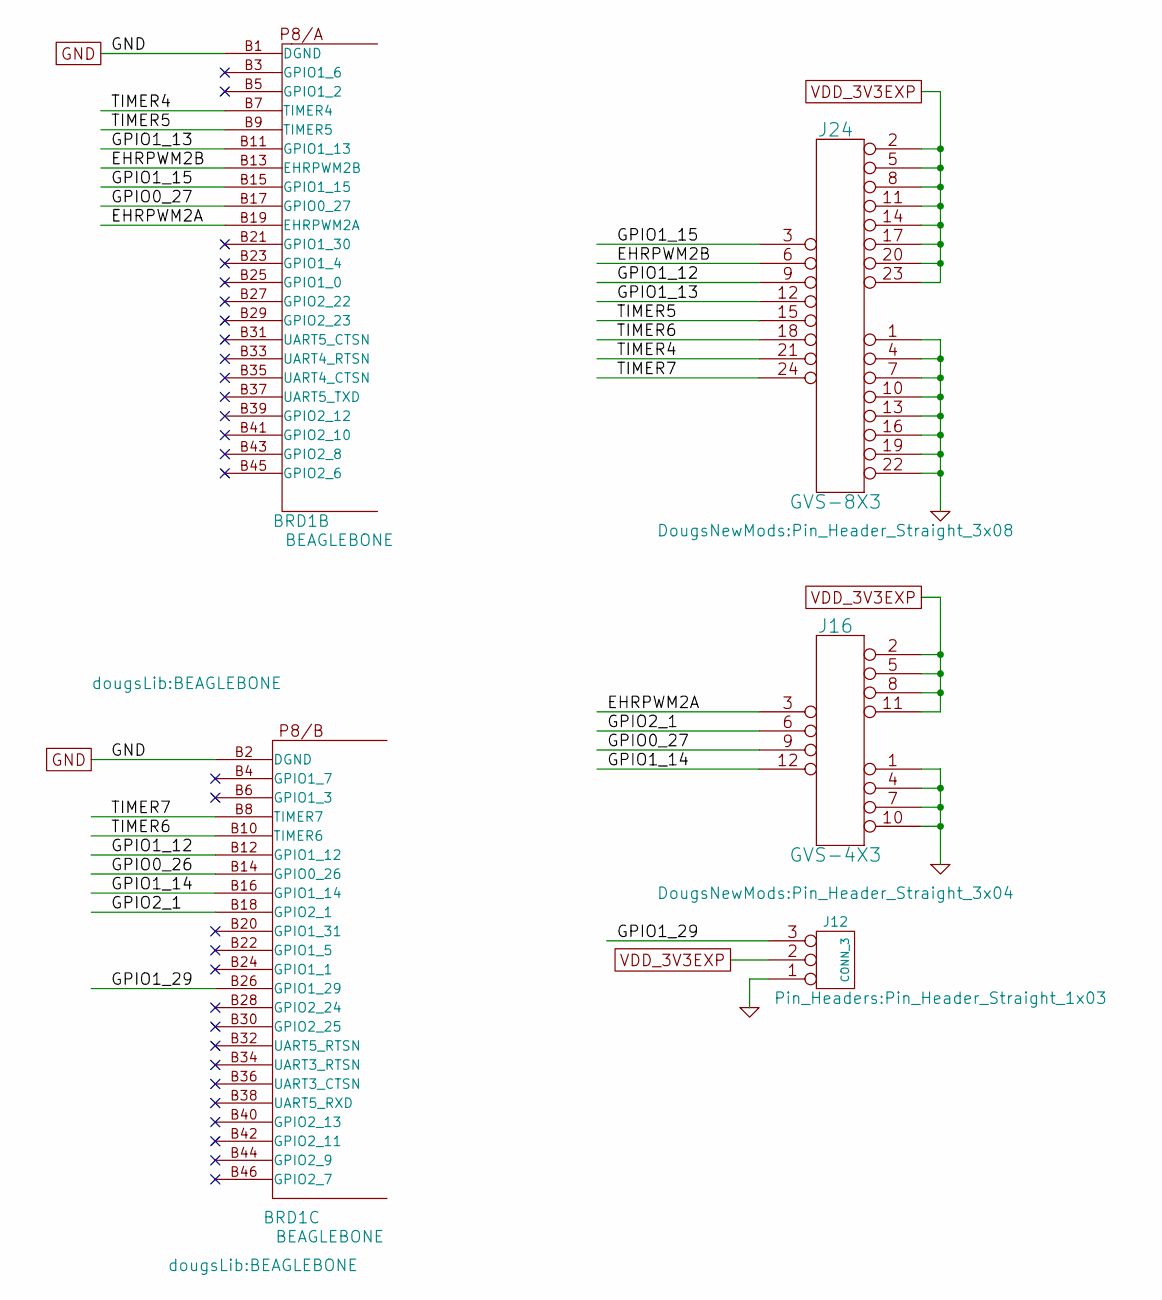
[picture p626: schematic BBB-P8-Conn.kicad_sch]

Parts:
BRD1: BEAGLEBONE
J12: CONN_3; Pin_Header_Straight_1x03
J16: GVS-4X3; Pin_Header_Straight_3x04
J24: GVS-8X3; Pin_Header_Straight_3x08

Connections:
EHRPWM2A: BRD1.B19 (EHRPWM2A), J16.3
EHRPWM2B: BRD1.B13 (EHRPWM2B), J24.6
GND: BRD1.B1 (DGND), BRD1.B2 (DGND), J12.1, J16.1 (G), J16.4, J16.7, J16.10, J24.1 (G), J24.4, J24.7, J24.10, J24.13, J24.16, J24.19, J24.22
GPIO0_26: BRD1.B14 (GPIO0_26)
GPIO0_27: BRD1.B17 (GPIO0_27), J16.9
GPIO1_12: BRD1.B12 (GPIO1_12), J24.9
GPIO1_13: BRD1.B11 (GPIO1_13), J24.12
GPIO1_14: BRD1.B16 (GPIO1_14), J16.12
GPIO1_15: BRD1.B15 (GPIO1_15), J24.3
GPIO1_29: BRD1.B26 (GPIO1_29), J12.3
GPIO2_1: BRD1.B18 (GPIO2_1), J16.6
TIMER4: BRD1.B7 (TIMER4), J24.21
TIMER5: BRD1.B9 (TIMER5), J24.15
TIMER6: BRD1.B10 (TIMER6), J24.18
TIMER7: BRD1.B8 (TIMER7), J24.24
VDD_3V3EXP: J12.2 (PM), J16.2 (V), J16.5, J16.8, J16.11, J24.2 (V), J24.5, J24.8, J24.11, J24.14, J24.17, J24.20, J24.23
