land-boards/lb-boards/BeagleBoneBlack Cards/BBB-GVS-4/BBB-P8-P9-Conn.sch

## KiCad design BeagleBoneBlack Cards/BBB-GVS-4/BBB-P8-P9-Conn.sch (2015-02-23)

Schematic: BBB-P8-P9-Conn.sch

Parts:
BRD1: BEAGLEBONE
C1, C2, C4, C5: 104; SM0805
C3: 1uF; SM0805
COUP1, COUP2: COUPON; REV_BLOCK
D1, D2: LED; SM0805
F1, F2: FUSE; SM1206
FID1, FID2: CONN_1; FIDUCIAL
J23: CONN_3; PIN_ARRAY_3X1
J24: ADR SEL; PIN_ARRAY_2X2
J33: CONN_2; PIN_ARRAY_2X1
R1, R2, R5, R6, R7, R8: 5.6K; SM0805
R3: 330; SM0805
R4: 120; SM0805
U3: CAT24C256; SO8E-wider

Notes on the sheet:
I2C CONFIG EEPROM
5V SELECTION JUMPER
