land-boards/lb-boards/BeagleBoneBlack Cards/BBB-GVS-4/BBB-P9-Conn.kicad_sch

## KiCad design BeagleBoneBlack Cards/BBB-GVS-4/BBB-P9-Conn.kicad_sch (2022-10-10)

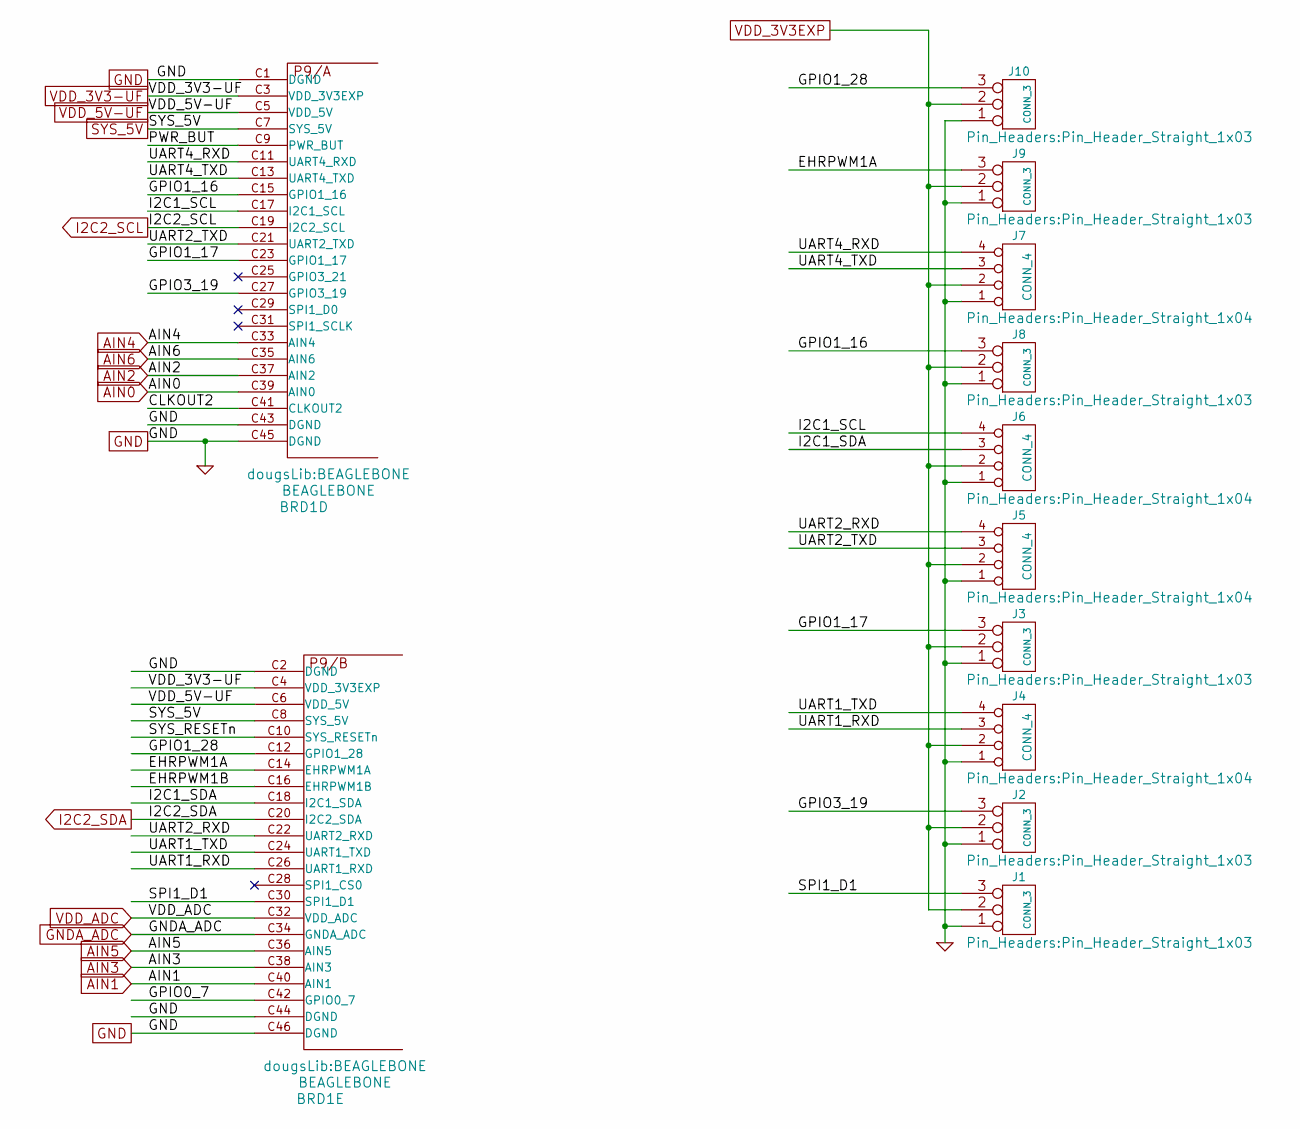
[picture p627: schematic BBB-P9-Conn.kicad_sch]

Parts:
BRD1: BEAGLEBONE
J1, J2, J3, J8, J9, J10: CONN_3; Pin_Header_Straight_1x03
J4, J5, J6, J7: CONN_4; Pin_Header_Straight_1x04

Connections:
AIN0: BRD1.C39 (AIN0)
AIN1: BRD1.C40 (AIN1)
AIN2: BRD1.C37 (AIN2)
AIN3: BRD1.C38 (AIN3)
AIN4: BRD1.C33 (AIN4)
AIN5: BRD1.C36 (AIN5)
AIN6: BRD1.C35 (AIN6)
CLKOUT2: BRD1.C41 (CLKOUT2)
EHRPWM1A: BRD1.C14 (EHRPWM1A), J9.3
EHRPWM1B: BRD1.C16 (EHRPWM1B)
GND: BRD1.C1 (DGND), BRD1.C2 (DGND), BRD1.C43 (DGND), BRD1.C44 (DGND), BRD1.C45 (DGND), BRD1.C46 (DGND), J1.1, J2.1, J3.1, J4.1, J5.1, J6.1, J7.1, J8.1, J9.1, J10.1
GNDA_ADC: BRD1.C34 (GNDA_ADC)
GPIO0_7: BRD1.C42 (GPIO0_7)
GPIO1_16: BRD1.C15 (GPIO1_16), J8.3
GPIO1_17: BRD1.C23 (GPIO1_17), J3.3
GPIO1_28: BRD1.C12 (GPIO1_28), J10.3
GPIO3_19: BRD1.C27 (GPIO3_19), J2.3
I2C1_SCL: BRD1.C17 (I2C1_SCL), J6.4
I2C1_SDA: BRD1.C18 (I2C1_SDA), J6.3
I2C2_SCL: BRD1.C19 (I2C2_SCL)
I2C2_SDA: BRD1.C20 (I2C2_SDA)
PWR_BUT: BRD1.C9 (PWR_BUT)
SPI1_D1: BRD1.C30 (SPI1_D1), J1.3
SYS_5V: BRD1.C7 (SYS_5V), BRD1.C8 (SYS_5V)
SYS_RESETn: BRD1.C10 (SYS_RESETn)
UART1_RXD: BRD1.C26 (UART1_RXD), J4.3
UART1_TXD: BRD1.C24 (UART1_TXD), J4.4
UART2_RXD: BRD1.C22 (UART2_RXD), J5.4
UART2_TXD: BRD1.C21 (UART2_TXD), J5.3
UART4_RXD: BRD1.C11 (UART4_RXD), J7.4
UART4_TXD: BRD1.C13 (UART4_TXD), J7.3
VDD_3V3-UF: BRD1.C3 (VDD_3V3EXP), BRD1.C4 (VDD_3V3EXP)
VDD_3V3EXP: J1.2 (PM), J2.2 (PM), J3.2 (PM), J4.2, J5.2, J6.2, J7.2, J8.2 (PM), J9.2 (PM), J10.2 (PM)
VDD_5V-UF: BRD1.C5 (VDD_5V), BRD1.C6 (VDD_5V)
VDD_ADC: BRD1.C32 (VDD_ADC)
