land-boards/lb-boards/BeagleBoneBlack Cards/BBB-GVS-4/P9.sch

## KiCad design BeagleBoneBlack Cards/BBB-GVS-4/P9.sch (2015-02-23)

Schematic: P9.sch

Parts:
BRD1: BEAGLEBONE
C1, C2, C4, C5: 104; SM0805
C3: 1uF; SM0805
COUP1, COUP2: COUPON; REV_BLOCK
D1, D2: LED; SM0805
F1, F2: FUSE; SM1206
FID1, FID2: CONN_1; FIDUCIAL
J1, J2, J3, J4, J5, J6, J7, J23: CONN_3; PIN_ARRAY_3X1
J24: ADR SEL; PIN_ARRAY_2X2
J33: CONN_2; PIN_ARRAY_2X1
P1, P2, P3, P4, P5, P6, P7, P8: CONN_8
R1, R2, R5, R6, R7, R8: 5.6K; SM0805
R3: 330; SM0805
R4: 120; SM0805
U1, U2: TXS0108EPWR; SOG20
U3: CAT24C256; SO8E-wider

Notes on the sheet:
I2C CONFIG EEPROM
ANALOG GVS SIGNALS
5V SELECTION JUMPER
AGND AVCC AI6
AGND AVCC AI5
AGND AVCC AI4
AGND AVCC AI3
AGND AVCC AI2
AGND AVCC AI1
AGND AVCC AI0
