land-boards/lb-boards/BeagleBoneBlack Cards/BBB-GVS-4/trans16.kicad_sch

## KiCad design BeagleBoneBlack Cards/BBB-GVS-4/trans16.kicad_sch (2022-10-10)

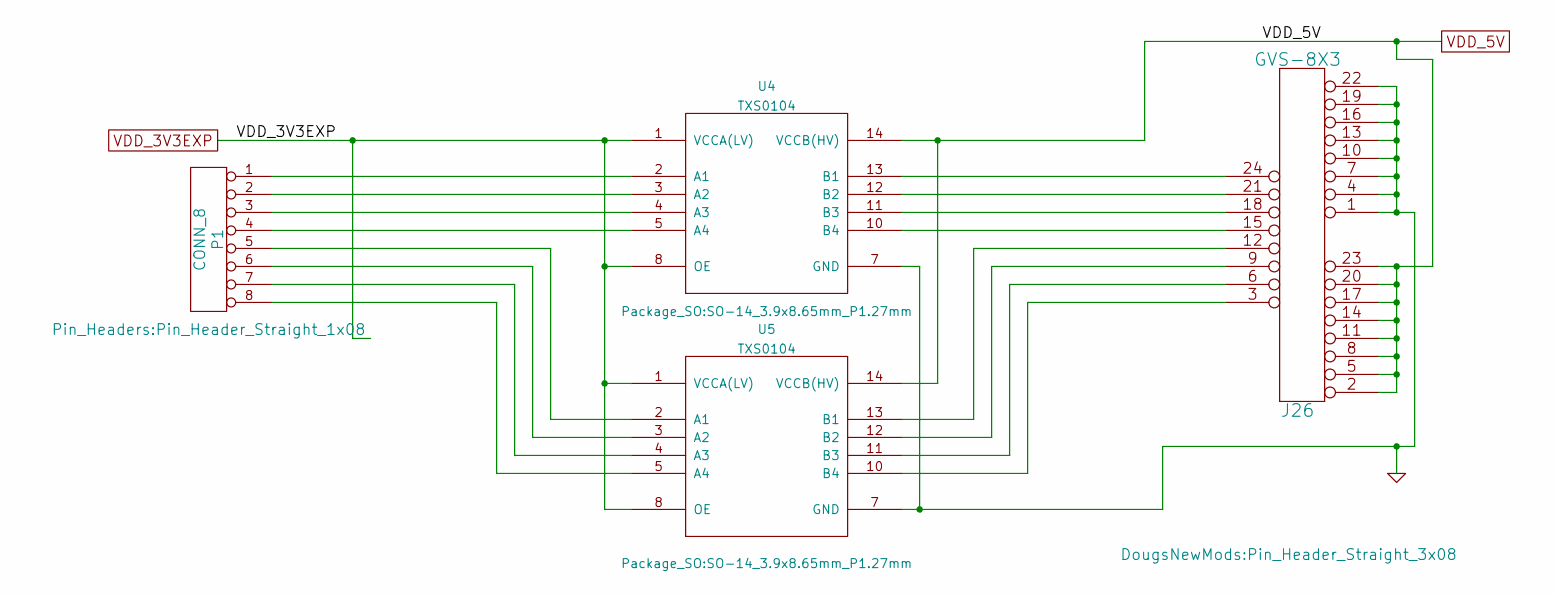
[picture p628: schematic trans16.kicad_sch]

Parts:
J26: GVS-8X3; Pin_Header_Straight_3x08
P1: CONN_8; Pin_Header_Straight_1x08
U4, U5: TXS0104; SO-14_3.9x8.65mm_P1.27mm

Connections:
GND: J26.1 (G), J26.4, J26.7, J26.10, J26.13, J26.16, J26.19, J26.22, U4.7 (GND), U5.7 (GND)
unnamed: J26.3, U5.10 (B4)
unnamed: J26.6, U5.11 (B3)
unnamed: J26.9, U5.12 (B2)
unnamed: J26.12, U5.13 (B1)
unnamed: J26.15, U4.10 (B4)
unnamed: J26.18, U4.11 (B3)
unnamed: J26.21, U4.12 (B2)
unnamed: J26.24, U4.13 (B1)
unnamed: P1.1, U4.2 (A1)
unnamed: P1.2, U4.3 (A2)
unnamed: P1.3, U4.4 (A3)
unnamed: P1.4, U4.5 (A4)
unnamed: P1.5, U5.2 (A1)
unnamed: P1.6, U5.3 (A2)
unnamed: P1.7, U5.4 (A3)
unnamed: P1.8, U5.5 (A4)
VDD_3V3EXP: U4.1 (VCCA(LV)), U4.8 (OE), U5.1 (VCCA(LV)), U5.8 (OE)
VDD_5V: J26.2 (V), J26.5, J26.8, J26.11, J26.14, J26.17, J26.20, J26.23, U4.14 (VCCB(HV)), U5.14 (VCCB(HV))
