land-boards/lb-boards/BeagleBoneBlack Cards/BBB-GVS/P9.sch

## KiCad design BeagleBoneBlack Cards/BBB-GVS/P9.sch (2022-04-09)

Schematic: P9.sch

Parts:
BRD1: BEAGLEBONE
C1, C2, C4, C5: 104; SM0805
C3: 1uF; SM0805
COUP1, COUP2: COUPON; REV_BLOCK
D1, D2: LED; SM0805
F1, F2: FUSE; SM1206
FID1, FID2: CONN_1; FIDUCIAL
J1, J2, J3, J4, J5, J6, J7, J9, J10, J14, J15, J23: CONN_3; PIN_ARRAY_3X1
J8: CONN_3; PIN_ARRAY_3x1
J11, J12, J13, J16: CONN_4; PIN_ARRAY_4X1
J33: CONN_2; PIN_ARRAY_2X1
R1, R2, R8: 5.6K; SM0805
R3: 330; SM0805
R4: 120; SM0805
U2: TXS0108EPWR; SOG20
U3: CAT24C256; SO8E-wider

Notes on the sheet:
I2C CONFIG EEPROM
GPIO1_28 VCC GND
GPIO1_16 VCC GND
U2RX U2TX VCC GND
ANALOG GVS SIGNALS
5V SELECTION JUMPER
I2C1_SCL I2C1_SDA VCC GND
U4RX U4TX VCC GND
GPIO1_17 VCC GND
U1RX U1TX VCC GND
SP1DI VCC GND
AGND AVCC AI6
AGND AVCC AI5
AGND AVCC AI4
AGND AVCC AI3
AGND AVCC AI2
AGND AVCC AI1
AGND AVCC AI0
GPIO3_19 VCC GND
