land-boards/lb-boards/BeagleBoneBlack Cards/BBB-IND-01/BBB-IND-01.sch

## KiCad design BeagleBoneBlack Cards/BBB-IND-01/BBB-IND-01.sch (2016-08-07)

Schematic: BBB-IND-01.sch

Parts:
FID1, FID2: CONN_1; FIDUCIAL
MTG1, MTG2, MTG3, MTG4: CONN_1; MountingHole_4.3mm_M4
TESTED1: COUPON; REV_BLOCK
