land-boards/lb-boards/GPS Cards/GPS-Design/GPS-Design.sch

## KiCad design GPS Cards/GPS-Design/GPS-Design.sch (2015-10-13)

Schematic: GPS-Design.sch

Parts:
BRD3: KEYPAD
BRD4: MINIDUINO
BRD5: GPS
BRD6: TFT_LCD
BT1: BATTERY
