land-boards/lb-boards/GPS Cards/GPS-Logger-Design/GPS-Logger-Design.sch

## KiCad design GPS Cards/GPS-Logger-Design/GPS-Logger-Design.sch (2012-09-13)

Schematic: GPS-Logger-Design.sch

Parts:
BRD1: FTDI
BRD2: GPS
BT1: BATTERY
