land-boards/lb-boards/GPS Cards/USB-GPS-Hammond/USB-GPS-Hammond-X3.sch

## KiCad design GPS Cards/USB-GPS-Hammond/USB-GPS-Hammond-X3.sch (2013-08-16)

Schematic: USB-GPS-Hammond-X3.sch

Parts:
C1, C6: 1uF; SM0805
C2, C3, C4: 0.1uF; SM0805
C5: 10uF; SM1210
C7, C8: 18pF; SM0805
DS1: LED2C_CA; SOT23; MfgPN SML-LX15IGC-TR
DS2, DS3: LED; LED-0805
F1: FUSE; SM1206; MfgPN PTS120615V050
FID1, FID2: FIDUCIAL
J1: USB-B; USB-B-MINI
J3: JST_2; JST-2-SMT; MfgPN S2B-PH-SM4-TB(LF)(SN)
J4, J5: HDR2; PIN_ARRAY_2X1
MTG1: CONN_1; MTG-2.5MM
P1: CONN_6; PIN_ARRAY-6X1
R1, R2: 470; SM0805
R3, R4: 22; SM0805
R5: 2.2K; SM0805
R6: NTC; SM0603
R7, R8, R11: 10K; SM0805
R9, R10: 150; SM0805
R12: OPEN; SM0805
SW1: SWITCH_INV; PIN_ARRAY_2X1
U1: MCP73833; MSOP10-0.5
U2: ATMEGA32U4-AU; TQFP44
U3: FGPMMOPA6H; MfgPN Custom
X1: 8MHz; Crystal_HC49-SD_SMD_RevA_09Aug2010

Notes on the sheet:
USB POWER STAT1=CHARGING (RED) STAT2=CHARGED (GRN)
RESET
GPS MODULE
LiPoly Charger
USB- MINI
INDICATORS
BREADCRUMB
POWER SWITCH
BATTERY
