land-boards/lb-boards/GPS Cards/USB-GPS/USB-GPSX3.sch

## KiCad design GPS Cards/USB-GPS/USB-GPSX3.sch (2012-12-13)

Schematic: USB-GPSX3.sch

Parts:
C1, C8: 1uF; SM0805
C2, C3: 18pF; SM0805
C4: 10uF; SM1210
C5, C6, C7: 0.1uF; SM0805
DS1, DS3: LED; LED-0805
DS2: LED2C_CA; SOT23_LED2C; MfgPN SML-LX15IGC-TR
F1: FUSE; SM1206; MfgPN PTS120615V050
J1: USB-B; USB-B-MINI
J2: JST_2; adafruit-JST-PH-2-SMT; MfgPN S2B-PH-SM4-TB(LF)(SN)
J3, J4, J5: HDR2; PIN_ARRAY_2X1
MTG1, MTG2, MTG3, MTG4: CONN_1; MTG-4-40; MfgPN Mtg-Hole
R1, R2: 22; SM0805
R3, R6: 470; SM0805
R4, R9: 10K; SM0805
R5, R12: 150; SM0805
R7: 2.2K; SM0805
R8: NTC; SM0603
U1: MCP73833; MSOP10-0.5
U2: FGPMMOPA6H; MfgPN Custom
U3: ATMEGA32U4-AU; TQFP44
X1: 8MHz; Crystal_HC49-SD_SMD_RevA_09Aug2010

Notes on the sheet:
PROGRAMMING JUMPER
INDICATORS
GPS MODULE
LiPoly CHARGER
USB- MINI
+ -
RESET
POWER SWITCH
LiPoly BATTERY
USB POWER STAT1=CHARGING (RED) STAT2=CHARGED (GRN)
