land-boards/lb-boards/GVS Cards/DS18S20-LDR/DS18S20-LDR.sch

## KiCad design GVS Cards/DS18S20-LDR/DS18S20-LDR.sch (2013-01-02)

Schematic: DS18S20-LDR.sch

Parts:
MTG1, MTG2: CONN_1; MTG-4-40; MfgPN N/A
P1: CONN_4
R1: 4.7K; R4; MfgPN 291-4.7K-RC
R2: LDR
R3: 56K
U1: DS18S20+; TO92-123; MfgPN DS18S20 +

Notes on the sheet:
G V S(temp) S(LDR)
