land-boards/lb-boards/GVS Cards/DS18S20/DS18S20-Rev3.sch

## KiCad design GVS Cards/DS18S20/DS18S20-Rev3.sch (2012-10-23)

Schematic: DS18S20-Rev3.sch

Parts:
J1: CONN_2; PIN_ARRAY_2X1; MfgPN 68002-102HLF
J2, J3: CONN_3; PIN_ARRAY_3X1; MfgPN 68002-103HLF
MTG1: CONN_1; MTG-4-40; MfgPN N/A
R1: 4.7K; R4; MfgPN 291-4.7K-RC
U1: DS18S20+; TO92-123; MfgPN DS18S20 +

Notes on the sheet:
CHAINED DEVICE JUMPER
G V S
