land-boards/lb-boards/GVS Cards/GVS Sensors/GVS Sensors.sch

## KiCad design GVS Cards/GVS Sensors/GVS Sensors.sch (2014-06-19)

Schematic: GVS Sensors.sch

Parts:
DS1: LED
J1: CONN_3
P1: CONN_3
R1: 10K
RV1: POT
SW1: SW_PUSH

Notes on the sheet:
G V S
GVS ACTIVE LOW SWITCH
GVS ACTIVE HIGH LED
GVS ACTIVE LOW LED
GVS POT
NO NO NO - GVS POT - NO NO NO
