land-boards/lb-boards/GVS Cards/GVS-Switch/GVS-Switch.sch

## KiCad design GVS Cards/GVS-Switch/GVS-Switch.sch (2014-07-08)

Schematic: GVS-Switch.sch

Parts:
J1: CONN_3
R1: 10K
SW1: SW_PUSH_OMRON
