land-boards/lb-boards/GVS Cards/GVSUNI/GVSUNI.sch

## KiCad design GVS Cards/GVSUNI/GVSUNI.sch (2018-12-25)

Schematic: GVSUNI.sch

Parts:
J1: GVS; Pin_Header_Straight_1x03_Pitch2.54mm
P1, P2, P3: CONN_01X03; Pin_Header_Straight_1x03_Pitch2.54mm
R1: 10K; R_0805_HandSoldering
