land-boards/lb-boards/GVS Cards/IR Sensor/IR-Sensor.sch

## KiCad design GVS Cards/IR Sensor/IR-Sensor.sch (2013-02-25)

Schematic: IR-Sensor.sch

Parts:
D1: IR TX LED; LED-5MM
D2: IR RX; LED-5MM
J1: CONN_4; PIN_ARRAY_4x1
MTG1, MTG2: CONN_1; MTG-4-40
R1, R2: 82; R4-5
R3: 1M; R4-5

Notes on the sheet:
G VT VR S
