land-boards/lb-boards/GVS Cards/IRSens-2/IRSens-2.sch

## KiCad design GVS Cards/IRSens-2/IRSens-2.sch (2015-02-03)

Schematic: IRSens-2.sch

Parts:
D1: IR RX; LED-5MM
D2: LED; LED-5MM
J1, J2: CONN_3; PIN_ARRAY_3X1
MTG1, MTG2, MTG3, MTG4: CONN_1; MTG-4-40
Q1: MMBT3904; SOT23EBC
R1, R6: 220K; SM0805
R2: 4.7K; SM0805
R3: 10K; SM0805
R4, R5: 82; SM1206; MfgPN RK73B2BTTD820J
U1: LM358; SO8E-wider

Notes on the sheet:
S V G
