land-boards/lb-boards/GVS Cards/LDRSensor/LDR SensorV2.sch

## KiCad design GVS Cards/LDRSensor/LDR SensorV2.sch (2012-07-23)

Schematic: LDR SensorV2.sch

Parts:
JP1: JUMPER3
MTG1, MTG2: CONN_1
R1: 56K
VT90N2: RVAR
