land-boards/lb-boards/GVS Cards/RotaryEnc/RotaryEnc.kicad_sch

## KiCad design GVS Cards/RotaryEnc/RotaryEnc.kicad_sch (2023-01-07)

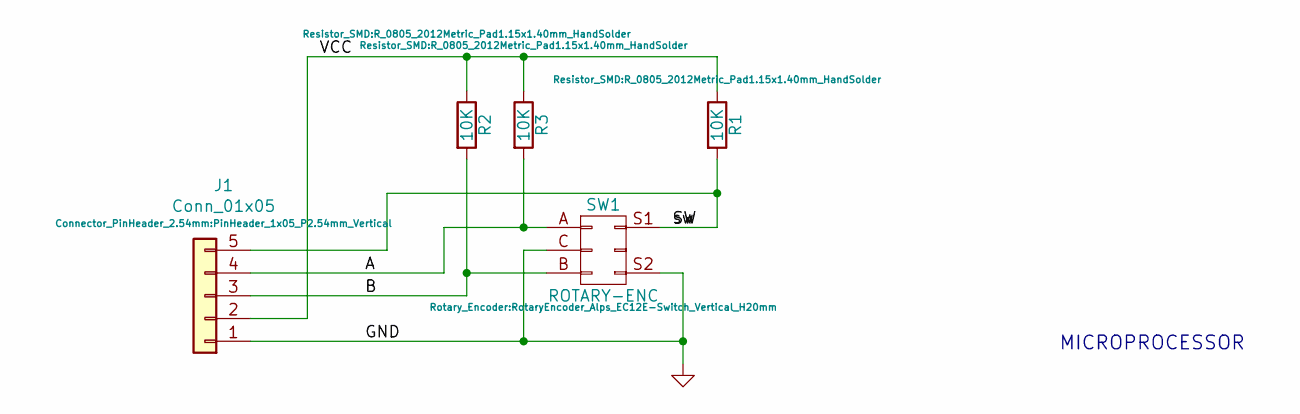
[picture p629: schematic RotaryEnc.kicad_sch]

Parts:
J1: Conn_01x05; PinHeader_1x05_P2.54mm_Vertical
R1, R2, R3: 10K; R_0805_2012Metric_Pad1.15x1.40mm_HandSolder
SW1: ROTARY-ENC; RotaryEncoder_Alps_EC12E-Switch_Vertical_H20mm

Connections:
A: J1.4, R3.2, SW1.A
B: J1.3, R2.2, SW1.B
GND: J1.1, SW1.C, SW1.S2
SW: J1.5, R1.2, SW1.S1
VCC: J1.2, R1.1, R2.1, R3.1

Notes on the sheet:
MICROPROCESSOR
