land-boards/lb-boards/GVS Cards/Sw5Way/SW5WayV3.sch

## KiCad design GVS Cards/Sw5Way/SW5WayV3.sch (2012-07-11)

Schematic: SW5WayV3.sch

Parts:
J1: CONN_3; SIL-3; MfgPN 68001-203HLF
MTG1, MTG2, MTG3, MTG4: CONN_1; MTG-4-40
R1: 3.3K; R3; MfgPN 271-3.3K-RC
R2: 1K; R3; MfgPN 271-1K-RC
R3: 560; R3; MfgPN CCF07560RJKE36
R4: 330; R3; MfgPN CCF07330RJKE36
R5: 1.8K; R3; MfgPN CCF071K80JNE36
SW1: SW5WAY

Notes on the sheet:
G V S
