land-boards/lb-boards/GVS Cards/Sw5WayDiscrete/SW5WayDiscrete.sch

## KiCad design GVS Cards/Sw5WayDiscrete/SW5WayDiscrete.sch (2014-07-24)

Schematic: SW5WayDiscrete.sch

Parts:
J1: CONN_3; SIL-3; MfgPN 68001-203HLF
MTG1, MTG2, MTG3, MTG4: CONN_1; MTG-4-40
R1: 330; SM0805; MfgPN 271-3.3K-RC
R2: 3.3K; SM0805; MfgPN 271-1K-RC
R3: 1K; SM0805; MfgPN CCF07560RJKE36
R4: 560; SM0805; MfgPN CCF07330RJKE36
R5: 1.8K; SM0805; MfgPN CCF071K80JNE36
SW1, SW2, SW3, SW4, SW5: SW_PUSH_OMRON; SW-PB-6MM

Notes on the sheet:
G V S
Right
Down
Left
Select
