land-boards/lb-boards/HamRadio/ADE1-MIXER/ADE1-MIXER.sch

## KiCad design HamRadio/ADE1-MIXER/ADE1-MIXER.sch (2021-08-16)

Schematic: ADE1-MIXER.sch

Parts:
COUP?1: COUPON; BD-49X49
J1, J2, J3: Conn_Coaxial; SMA_EDGE
MTG1, MTG2, MTG3: MTG_HOLE; MTG-4-40
MTG?1: MTG_HOLE; MTG-4-40
P1, P2, P3: BNC; BNC-RT
R1, R3: DNP; R_Axial_DIN0309_L9.0mm_D3.2mm_P15.24mm_Horizontal
R2: 0; R_Axial_DIN0309_L9.0mm_D3.2mm_P15.24mm_Horizontal
U1: ADE-1; Mini-Circuits_CD636_H4.11mm
