land-boards/lb-boards/HamRadio/ANTUNER/ANTUNER.sch

## KiCad design HamRadio/ANTUNER/ANTUNER.sch (2018-12-25)

Schematic: ANTUNER.sch

Parts:
COUP?1: COUPON; TEST_BLK-REAR
J1, J2, J3, J4: BNC; BNC-RT; MfgPN 31-5431-10RFX
MTG1, MTG2, MTG3, MTG4: CONN_1; MTG-4-40
R1, R3, R4: 50; R_0805_HandSoldering
R2, R5: 1K; R_0805_HandSoldering

Notes on the sheet:
SIG GEN
ANT
SCOPE CH 1
SCOPE CH 2
