land-boards/lb-boards/HamRadio/CLK-GEN/CLK-GEN.sch

## KiCad design HamRadio/CLK-GEN/CLK-GEN.sch (2020-11-30)

Schematic: CLK-GEN.sch

Parts:
C1, C4: 0.1uF; C_0805_HandSoldering
C2, C3: 10uF; R_1210_HandSoldering
COUP?1: COUPON; TEST_BLK-REAR
J1: DCJ0202; DCJ-NEW
MTG?1, MTG?2: MTG_HOLE; MTG-4-40
P1, P2: CONN_01X01; Banana_Jack_1Pin
P3: CONN_01X03; Pin_Header_Straight_1x03
R1: 10K; R_0805_HandSoldering
U1: AP1117; SOT-223
U2: ADR34XX; SOT-23-6
U3: MCP6002; SOIC-8_3.9x4.9mm_Pitch1.27mm
