land-boards/lb-boards/HamRadio/Colpitts_XTAL_Osc/CP-OSC.sch

## KiCad design HamRadio/Colpitts_XTAL_Osc/CP-OSC.sch (2021-09-20)

Schematic: CP-OSC.sch

Parts:
C1, C2: 470PF; C_0805_2012Metric_Pad1.15x1.40mm_HandSolder; MfgPN 1C10Z5U104M050B
C3: 10nF; C_0805_2012Metric_Pad1.15x1.40mm_HandSolder; MfgPN 1C10Z5U104M050B
C4: 0.1uF; C_0805_2012Metric_Pad1.15x1.40mm_HandSolder; MfgPN 1C10Z5U104M050B
J1: BNC; BNC-RT
J2: Conn_01x06; PinHeader_1x06_P2.54mm_Vertical
J3: DCJ0202; DCJ-NEW-Slotted
MTG4: MTG_HOLE; MTG-4-40
P1: SMA; SMA_Samtec_SMA-J-P-H-ST-EM1_EdgeMount
Q1, Q2: 2N3904; TO-92_HandSolder
R1, R2: 10K; R_0805_2012Metric_Pad1.15x1.40mm_HandSolder
R3, R4, R5: 1K; R_0805_2012Metric_Pad1.15x1.40mm_HandSolder
R6: 47; R_0805_2012Metric_Pad1.15x1.40mm_HandSolder
TESTED1: COUPON; TEST_BLK-REAR
Y5: 9.000
