land-boards/lb-boards/HamRadio/DDS-Mini/DDS-Mini-01.sch

## KiCad design HamRadio/DDS-Mini/DDS-Mini-01.sch (2016-02-28)

Schematic: DDS-Mini-01.sch

Parts:
H3: CONN_4; Pin_Header_Angled_1x04
P4: CONN_01X06; Pin_Header_Angled_1x06
U3: arduino_mini

Notes on the sheet:
ENCA VCC N/C ENCB PBSW GND
NEWPOT-MINUS
