land-boards/lb-boards/HamRadio/DDS-Mini/DDS-Mini-02.sch

## KiCad design HamRadio/DDS-Mini/DDS-Mini-02.sch (2017-01-01)

Schematic: DDS-Mini-02.sch

Parts:
C1, C2, C6, C7: 0.1uF; C_0805_HandSoldering; MfgPN 08055C104MAT2A
C3, C5: 10nF; C_0805_HandSoldering; MfgPN VJ0805Y103JXBAC
U1: AD9833; MSOP10-0.5; MfgPN AD9833BRMZ
U2: 25.000MHz; OSC-ACHL; MfgPN ECS-2100AX-25.0MHZ
