land-boards/lb-boards/HamRadio/DDS-Mini/DDS-Mini-03.sch

## KiCad design HamRadio/DDS-Mini/DDS-Mini-03.sch (2016-02-28)

Schematic: DDS-Mini-03.sch

Parts:
C13, C17: 10uF; C_1210_HandSoldering; MfgPN C1206C106K3PACTU
C16, C20: 1uF; C_1210_HandSoldering; MfgPN C3216X7R2A105K
FB3: MPZ2012S101A; R_0805_HandSoldering; MfgPN MPZ2012S101A
U4, U6: TLV1117-50CDCYR; SOT223; MfgPN TLV1117-50CDCYR
