land-boards/lb-boards/HamRadio/DDS-Mini/DDS-Mini-04.sch

## KiCad design HamRadio/DDS-Mini/DDS-Mini-04.sch (2016-02-28)

Schematic: DDS-Mini-04.sch

Parts:
C21: 10pF; C_0805_HandSoldering; MfgPN VJ0805A100GXXPW1BC
C22: .33uF; C_0805_HandSoldering; MfgPN VJ0805V334ZXACW1BC
R7: 510K; R_0805_HandSoldering; MfgPN CR0805-JW-514ELF
R8: 20; R_0805_HandSoldering; MfgPN CR0805-JW-200ELF
R9: 82K; R_0805_HandSoldering; MfgPN CR0805-JW-823ELF
R10: 001; R_0805_HandSoldering; MfgPN CRCW080550R0FKTA
RV1: 100K; POT-5X10MM; MfgPN PV36X104C01B00
U7: OPA357-MSOP8; HSOP-8; MfgPN OPA357AIDDA

Notes on the sheet:
ADJUST RV1 FOR TBD V(P-P) UNDER 50 OHM LOAD
