land-boards/lb-boards/HamRadio/DDS-Mini/DDS-Mini-05.sch

## KiCad design HamRadio/DDS-Mini/DDS-Mini-05.sch (2013-05-23)

Schematic: DDS-Mini-05.sch

Parts:
C4: 0.1uF; SM0805; MfgPN 08055C104MAT2A
C8: 10uF; c_elec_8x10.5; MfgPN UUX2A100MNL1GS
C12: 1uF; SM1210; MfgPN C3216X7R2A105K
C23: 22nF; SM0805; MfgPN VJ0805Y223JXJPW1BC
C24: 910pF; SM0805; MfgPN GRM1555C1E911JA01D
C25: 4.7uF; SM1210; MfgPN GRM329F51E475ZA01D
C27: 0.1uF; SM1210; MfgPN VJ1206Y104JXBTW1BC
C28: 4.7nF; SM0805; MfgPN GRM329F51E475ZA01D
D1: SK310A-TP; DO-214AC(SMA); MfgPN SK310A-TP
DS1: LED; SM0805; MfgPN LTST-C170KRKT
FB5, FB6: MPZ2012S101A; SM0805; MfgPN MPZ2012S101A
L1: 33uH; IND-8MM; MfgPN SRN8040-330M
R1: 29.4K; SM0805; MfgPN CRCW080529K4FKEA
R6: 4.7K/1%; SM0805; MfgPN CR0805-FX-4701ELF
R11: 2.61K; SM0805; MfgPN CRCW08052K61FKEA
R12: 1m; SM1210; MfgPN KRL3216-C-R001-J-T1
R15: 4.7K; SM0805; MfgPN CR0805-FX-4701ELF
U8: LM5010; TSSOP-14EP; MfgPN LM5010MHX/NOPB
