land-boards/lb-boards/HamRadio/DDS-Mini/DDS-Mini.sch

## KiCad design HamRadio/DDS-Mini/DDS-Mini.sch (2016-02-28)

Schematic: DDS-Mini.sch

Parts:
FID1, FID2: CONN_1; FIDUCIAL
J1: DCJ0202; DCJ-NEW
MTG1, MTG2, MTG3, MTG4: CONN_1; MTG-4-40
P1: BNC; BNC-RT; MfgPN 31-5431-10RFX
P2: CONN_2; TB2-5MM; MfgPN 282836-2
P3: CONN_2; SMA_EDGE; MfgPN 142-0701-801

Notes on the sheet:
INPUT POWER CONNECTOR
