land-boards/lb-boards/HamRadio/DIODE-MIXER/DIODE-MIXER.sch

## KiCad design HamRadio/DIODE-MIXER/DIODE-MIXER.sch (2021-08-16)

Schematic: DIODE-MIXER.sch

Parts:
COUP?1: COUPON; BD-49X49
D1, D2, D3, D4: D_Schottky; D_DO-35_SOD27_P7.62mm_Horizontal
J1, J2, J3: Conn_Coaxial; SMA_EDGE
L1: Conn_01x05; PinHeader_1x05_P2.54mm_Vertical
L2: Conn_01x06; PinHeader_1x06_P2.54mm_Vertical
MTG1, MTG2, MTG3: MTG_HOLE; MTG-4-40
MTG?1: MTG_HOLE; MTG-4-40
P1, P2, P3: BNC; BNC-RT
R1: 51; R_Axial_DIN0309_L9.0mm_D3.2mm_P15.24mm_Horizontal
RV1: 100; Potentiometer_Bourns_3299W_Vertical
