land-boards/lb-boards/HamRadio/DRIVE50/DRIVE50.kicad_sch

## KiCad design HamRadio/DRIVE50/DRIVE50.kicad_sch (2022-10-10)

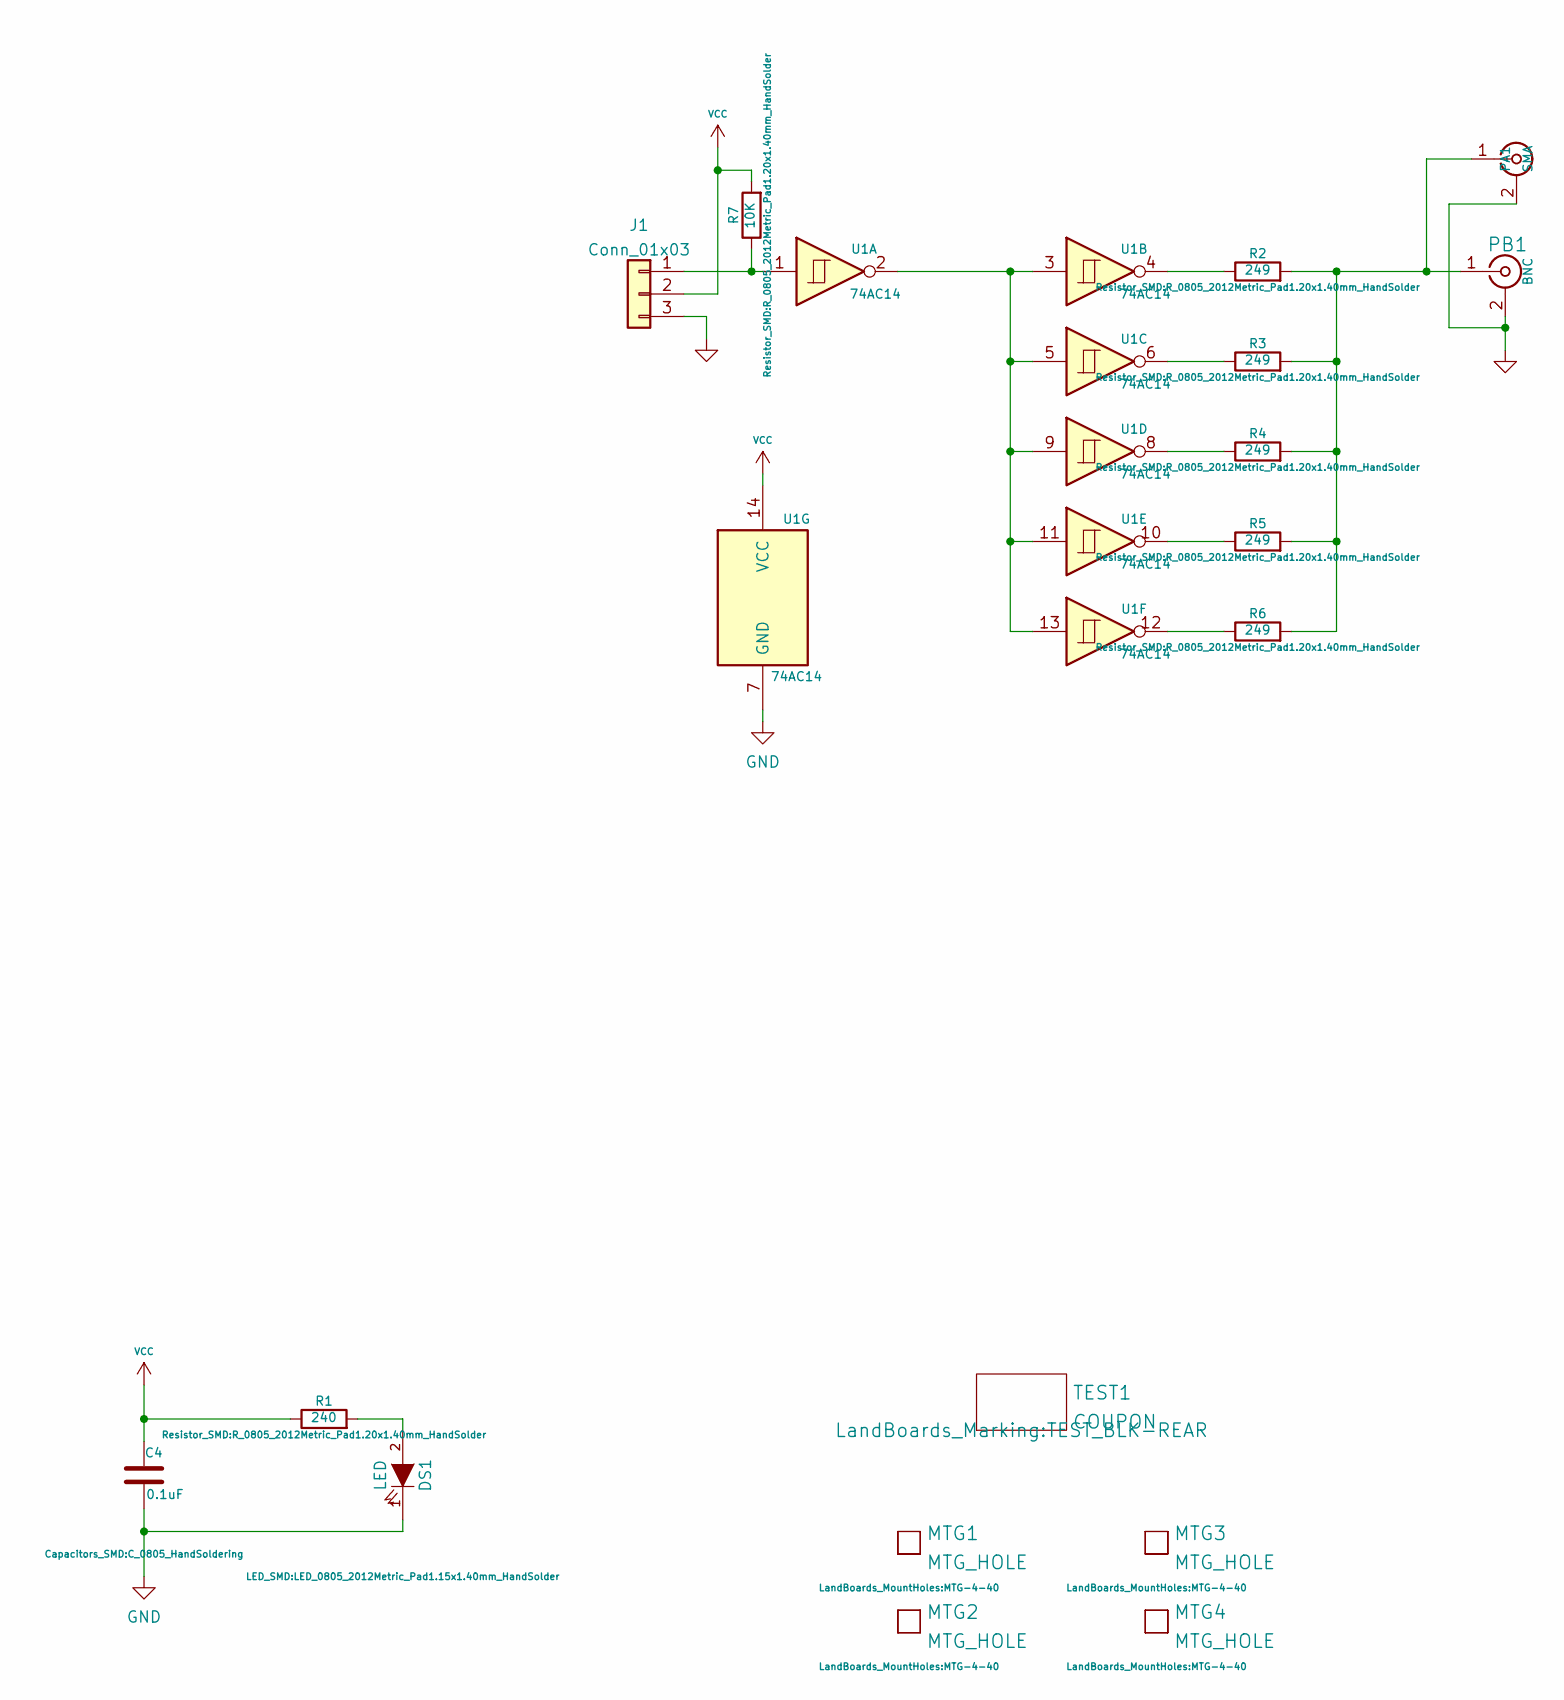
[picture p630: schematic DRIVE50.kicad_sch]

Parts:
C4: 0.1uF; C_0805_HandSoldering
DS1: LED; LED_0805_2012Metric_Pad1.15x1.40mm_HandSolder
J1: Conn_01x03; PinHeader_1x03_P2.54mm_Horizontal
MTG1, MTG2, MTG3, MTG4: MTG_HOLE; MTG-4-40
PA1: SMA; SMA_EDGE-F
PB1: BNC; BNC-RT; MfgPN 31-5431-10RFX
R1: 240; R_0805_2012Metric_Pad1.20x1.40mm_HandSolder
R2, R3, R4, R5, R6: 249; R_0805_2012Metric_Pad1.20x1.40mm_HandSolder
R7: 10K; R_0805_2012Metric_Pad1.20x1.40mm_HandSolder
TEST1: COUPON; TEST_BLK-REAR
U1: 74AC14; so-14; MfgPN SN74AC14DR

Connections:
GND: C4.2, DS1.1 (K), J1.3, PA1.2 (Ext), PB1.2 (Ext), U1.7 (GND)
unnamed: DS1.2 (A), R1.2
unnamed: J1.1, R7.1, U1.1
unnamed: PA1.1 (In), PB1.1 (In), R2.2, R3.2, R4.2, R5.2, R6.2
unnamed: R2.1, U1.4
unnamed: R3.1, U1.6
unnamed: R4.1, U1.8
unnamed: R5.1, U1.10
unnamed: R6.1, U1.12
unnamed: U1.2, U1.3, U1.5, U1.9, U1.11, U1.13
VCC: C4.1, J1.2, R1.1, R7.2, U1.14 (VCC)
