land-boards/lb-boards/HamRadio/FM-NOTCH/FM-NOTCH.sch

## KiCad design HamRadio/FM-NOTCH/FM-NOTCH.sch (2018-12-25)

Schematic: FM-NOTCH.sch

Parts:
C1, C7: 8pF; C_0603_HandSoldering
C2: 110pF; C_0603_HandSoldering
C3: 100pF; C_0805_HandSoldering
C4: 110pF; C_0805_HandSoldering
C5, C6: 15pF; C_0603_HandSoldering
L1, L3: 22nH; R_0805_HandSoldering
L2: 27nH; R_0603_HandSoldering
L4, L7: 330nH; R_0805_HandSoldering
L5, L6: 180nH; R_0805_HandSoldering
P1, P2: CONN_2; SMA_EDGE-F
TEST1: COUPON; TEST_BLK-REAR
