land-boards/lb-boards/HamRadio/I2C-VFO3/I2C-VFO3.sch

## KiCad design HamRadio/I2C-VFO3/I2C-VFO3.sch (2021-01-09)

Schematic: I2C-VFO3.sch

Parts:
C1, C2: 0.1uF; C_0805_2012Metric_Pad1.15x1.40mm_HandSolder
J1: Conn_02x04_Odd_Even; PinHeader_2x04_P2.54mm_Vertical
J2: Conn_02x03_Odd_Even; PinHeader_2x03_P2.54mm_Vertical
R1, R2: 2.2K; R_0805_2012Metric_Pad1.15x1.40mm_HandSolder
U1: Si5351A; MSOP-10_3x3mm_P0.5mm
U2: ASE-xxxMHz; Oscillator_SMD_EuroQuartz_XO53-4Pin_5.0x3.2mm_HandSoldering
