land-boards/lb-boards/HamRadio/IRF510-Amplifier-v2/IRF510-Amplifier.sch

## KiCad design HamRadio/IRF510-Amplifier-v2/IRF510-Amplifier.sch (2021-10-10)

Schematic: IRF510-Amplifier.sch

Parts:
C1, C2, C4, C6, C9, C10, C12, C13, C15, C17, C53, C57: .1uF; Capacitor 0805
C3, C8: 150p; Capacitor 1206
C5: 330p; Capacitor 1206
C7: 33p; Capacitor 1206
C11: 100uF; Cap_6.3x5.4
C14, C16: 22uF; Cap_4x5.4
D1: D_Zener; D_A-405_P10.16mm_Horizontal
J1: Jack-DC; BarrelJack_Horizontal
J2, J3: BNC
J4: Audio_Jack
L1: T50-43 10T; T50_Inductor
L3: 14T T37-6; T37_Inductor
L4: 18T T37-6; T37_Inductor
Q1: 2N3904-SMD; SOT-23
Q2: 2SC5706; TO-252-2
Q3: BS170F; SOT-23
Q4: IRF510; TO-220-3_Vertical
Q5: IRFU9024; TO-251-3_Vertical
R1: 33; Resistor 0805
R2: 10; Resistor 0805
R3, R4, R7: 10k; Resistor 0805
R5: 1.5k; Resistor 0805
R6, R10: 62; Resistor 0805
R8: 100; Resistor 0805
R9: 2.7k; Resistor 0805
R11, R12: 18; Resistor 0805
R52, R64: 24k; Resistor 0805
R53, R65: 6.8k; Resistor 0805
RV1, RV2: R_POT; Trimpot Vertical
T1: T37-43 8T:4T; T37 Transformer
T2: T37-43 25T:8T; T37 Transformer
U6: MCP1703A-2502_SOT223; TO-252-3_TabPin2
