land-boards/lb-boards/HamRadio/KEYER/KEYER.sch

## KiCad design HamRadio/KEYER/KEYER.sch (2020-11-30)

Schematic: KEYER.sch

Parts:
BZ1: Buzzer
C1, C2, C3, C4, C5: 0.01uF; C_Rect_L4.6mm_W2.0mm_P2.50mm_MKS02_FKP02
COUP?1: COUPON; TEST_BLK-REAR
J1, J2, J6: AudioJack3; Jack_3.5mm_CUI_SJ1-352XN_Horizontal
J3: Conn_01x06
J4: DCJ0202; con-jack-DCJ0202
J5, J7: Conn_01x03
J8: Conn_01x02; TB2-5MM
MINI-3601: MINI-360
MTG?1, MTG?2: MTG_HOLE; MTG-4-40
R1, R2, R3, R6, R7: 10K; R_Axial_DIN0207_L6.3mm_D2.5mm_P2.54mm_Vertical
R4, R5: 120; R_Axial_DIN0207_L6.3mm_D2.5mm_P2.54mm_Vertical
SW1: Rotary_Encoder_Switch
U1, U2: 4N25; DIP-6_W7.62mm
uP1: ARDUPROMINI; ArduProMini

Notes on the sheet:
PADDLE
STRAIGHT KEY
FTDI
RADIO(S) KEY
ROTARY ENCODER CARD
