land-boards/lb-boards/HamRadio/PULSE-GEN/PULSE-GEN.kicad_sch

## KiCad design HamRadio/PULSE-GEN/PULSE-GEN.kicad_sch (2024-09-10)

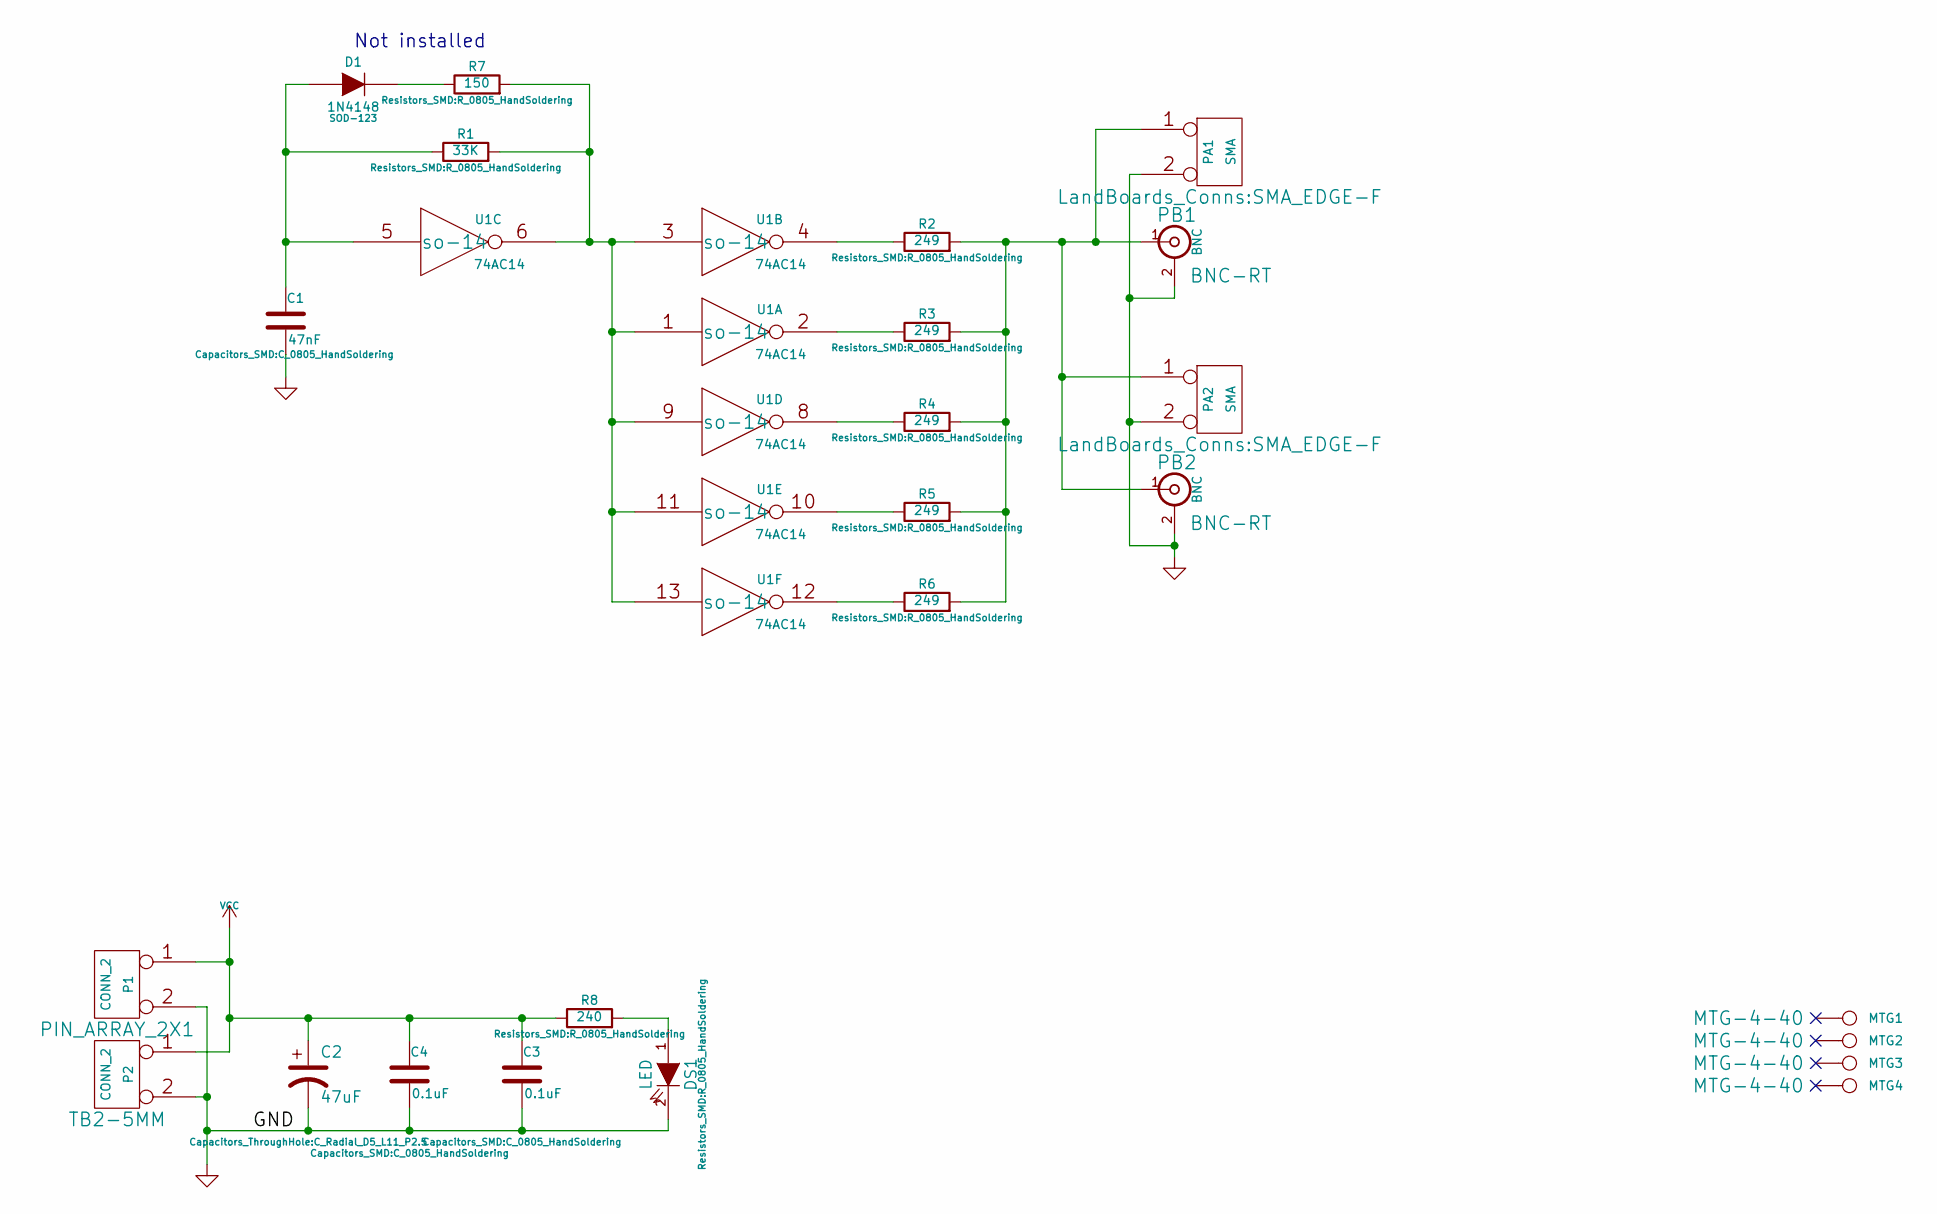
[picture p631: schematic PULSE-GEN.kicad_sch]

Parts:
C1: 47nF; C_0805_HandSoldering
C2: 47uF; C_Radial_D5_L11_P2.5
C3, C4: 0.1uF; C_0805_HandSoldering
D1: 1N4148; SOD-123
DS1: LED; R_0805_HandSoldering
MTG1, MTG2, MTG3, MTG4: CONN_1; MTG-4-40
P1: CONN_2; PIN_ARRAY_2X1
P2: CONN_2; TB2-5MM
PA1, PA2: SMA; SMA_EDGE-F
PB1, PB2: BNC; BNC-RT; MfgPN 31-5431-10RFX
R1: 33K; R_0805_HandSoldering
R2, R3, R4, R5, R6: 249; R_0805_HandSoldering
R7: 150; R_0805_HandSoldering
R8: 240; R_0805_HandSoldering
U1: 74AC14; so-14; MfgPN SN74AC14DR

Connections:
GND: C1.2, C2.2, C3.2, C4.2, DS1.2 (K), P1.2 (PM), P2.2 (PM), PA1.2 (PM), PA2.2 (PM), PB1.2 (Ext), PB2.2 (Ext)
unnamed: C1.1, D1.1 (A), R1.1, U1.5
unnamed: D1.2 (K), R7.1
unnamed: DS1.1 (A), R8.2
unnamed: PA1.1, PA2.1, PB1.1 (In), PB2.1 (In), R2.2, R3.2, R4.2, R5.2, R6.2
unnamed: R1.2, R7.2, U1.1, U1.3, U1.6, U1.9, U1.11, U1.13
unnamed: R2.1, U1.4
unnamed: R3.1, U1.2
unnamed: R4.1, U1.8
unnamed: R5.1, U1.10
unnamed: R6.1, U1.12
VCC: C2.1, C3.1, C4.1, P1.1, P2.1, R8.1

Notes on the sheet:
Not installed
