land-boards/lb-boards/HamRadio/RF-AMP-1/RF-AMP-1.sch

## KiCad design HamRadio/RF-AMP-1/RF-AMP-1.sch (2019-05-17)

Schematic: RF-AMP-1.sch

Parts:
C4, C5, C6, C7, C8: 0.1uF; C_0805_HandSoldering
J1: DCJ0202; DCJ-NEW
MTG1, MTG2, MTG3, MTG4: MTG_HOLE; MTG-4-40
P1: CONN_01X02; Pin_Header_Straight_1x02_Pitch2.54mm
P2, P3: BNC; SMA_EDGE-F
R3, R9: 100; R_0805_HandSoldering
R10, R11: 1M; R_0805_HandSoldering
U1: LT1813; SOIC-8_3.9x4.9mm_Pitch1.27mm
U2: AP1117; SOT223
