land-boards/lb-boards/HamRadio/RF-Amp/RF-Amp.sch

## KiCad design HamRadio/RF-Amp/RF-Amp.sch (2021-11-06)

Schematic: RF-Amp.sch

Parts:
C1, C2, C3: 100nF; C_Disc_D3.0mm_W2.0mm_P2.50mm
MTG1, MTG2, MTG3, MTG4: CONN_1; MTG-4-40
P1, P2: BNC; BNC-RT
P3: CONN_2; TB2-5MM
PB1, PB2: SMA; SMA_Samtec_SMA-J-P-H-ST-EM1_EdgeMount
Q1: 2N3904; TO-92_HandSolder
R1: 15K; R_Axial_DIN0207_L6.3mm_D2.5mm_P7.62mm_Horizontal
R2: 3.3K; R_Axial_DIN0207_L6.3mm_D2.5mm_P7.62mm_Horizontal
R3: 120; R_Axial_DIN0207_L6.3mm_D2.5mm_P7.62mm_Horizontal
R4: 10; R_Axial_DIN0207_L6.3mm_D2.5mm_P7.62mm_Horizontal
R5, R6: DNP; R_Axial_DIN0207_L6.3mm_D2.5mm_P7.62mm_Horizontal
T1, T2: FT37-43; Transformer_Toroid_Horizontal_D9.0mm_Amidon-T30
