land-boards/lb-boards/HamRadio/SMA-HDRS/SMA-HDRS.sch

## KiCad design HamRadio/SMA-HDRS/SMA-HDRS.sch (2021-11-14)

Schematic: SMA-HDRS.sch

Parts:
J1: Conn_01x04; PinHeader_1x04_P2.54mm_Vertical
J2: Conn_01x03; PinHeader_1x03_P2.54mm_Vertical
P1: SMA; SMA_Samtec_SMA-J-P-H-ST-EM1_EdgeMount
