land-boards/lb-boards/HamRadio/VFO-001/VFO-001.sch

## KiCad design HamRadio/VFO-001/VFO-001.sch (2020-11-30)

Schematic: VFO-001.sch

Parts:
FTDI: Conn_01x06
OLED: Conn_01x04; Pin_Header_Straight_1x04_Pitch2.54mm
ROTARY_ENC: Conn_01x05
SI5351: Conn_02x04_Odd_Even

Notes on the sheet:
GND VCC B A SW
RTS TX RX 3.3V NC GND
5-23 VDC
Buck Reg.
Land Boards Si5351
128x32 OLED
Set to 3.3V
Land Boards Breakout
Arduino Pro Mini
