land-boards/lb-boards/HamRadio/VFO-001/VFO-001b.sch

## KiCad design HamRadio/VFO-001/VFO-001b.sch (2020-11-30)

Schematic: VFO-001b.sch

Parts:
C4, C5, C6: 0.1uF; C_0805_HandSoldering
J7: Conn_01x04; Pin_Header_Straight_1x04_Pitch2.54mm
MTG1, MTG2, MTG3, MTG4: MTG_HOLE; MTG-6-32
TEST1: COUPON; TEST_BLK-REAR
U1: BLUE PILL HUB; BLUEPILL

Notes on the sheet:
OLED I2C
GND ~CTS VCC TX RX DTR
FTDI I/F
GND VCC B A SW
ROTARY ENC
Si5351
