land-boards/lb-boards/HamRadio/VFO-002/VFO-002.sch

## KiCad design HamRadio/VFO-002/VFO-002.sch (2020-11-30)

Schematic: VFO-002.sch

Parts:
BRD1: MINI-360
C1: 10uF; C_1210_3225Metric_Pad1.42x2.65mm_HandSolder
C2, C3, C4, C5, C6, C7: 0.1uF; C_0805_2012Metric_Pad1.15x1.40mm_HandSolder
J1: OLED_I2C; OLED-091in
J2, J3, J7: Conn_01x08; PinHeader_1x08_P2.54mm_Vertical
J4: Conn_01x06; PinHeader_1x06_P2.54mm_Vertical
J5: Conn_01x04; PinHeader_1x04_P2.54mm_Vertical
J6, J8: Conn_01x02; PinHeader_1x02_P2.54mm_Vertical
J9, J10, J11: SMA-F; SMA_EDGE
J99: DCJ0202; DCJ-NEW-Slotted
MTG1, MTG2, MTG3, MTG4: MTG_HOLE; MTG-4-40
P1, P2, P3: BNC; BNC-RT-OVAL_MTG
R1, R2, R3, R10, R11: 10K; R_0805_2012Metric_Pad1.15x1.40mm_HandSolder
R4, R5, R6: 1K; R_0805_2012Metric_Pad1.15x1.40mm_HandSolder
R7, R8, R9, R12, R13, R14, R15, R16, R17: 150; R_0805_2012Metric_Pad1.15x1.40mm_HandSolder
SW1, SW2: Rotary_Encoder_Switch; RotaryEncoder_Alps_EC12E-Switch_Vertical_H20mm
TEST1: COUPON; TEST_BLK-REAR
U1: Blue-Pill; BluePill
U2: 24LC024; DIP-8_W7.62mm
U3: Si5351A; MSOP-10_3x3mm_P0.5mm
U4, U5: 74AC14; SOIC-14_3.9x8.7mm_P1.27mm
U6: AP1117; SOT223
Y1: Crystal_GND2_Small; Crystal_SMD_SeikoEpson_FA238-4Pin_3.2x2.5mm_HandSoldering

Notes on the sheet:
OLED I2C
FTDI
FRONT PANEL BREAKOUT
ENCODER
EEPROM
FREQ SYNTH
SHORT PROTECTED 3.3V/150 OHMS = 22mA < 24 mA DRIVE OF AC14
I2C TERMINATORS
