land-boards/lb-boards/HamRadio/VFO-003/VFO-003.kicad_sch

## KiCad design HamRadio/VFO-003/VFO-003.kicad_sch (2022-10-10)

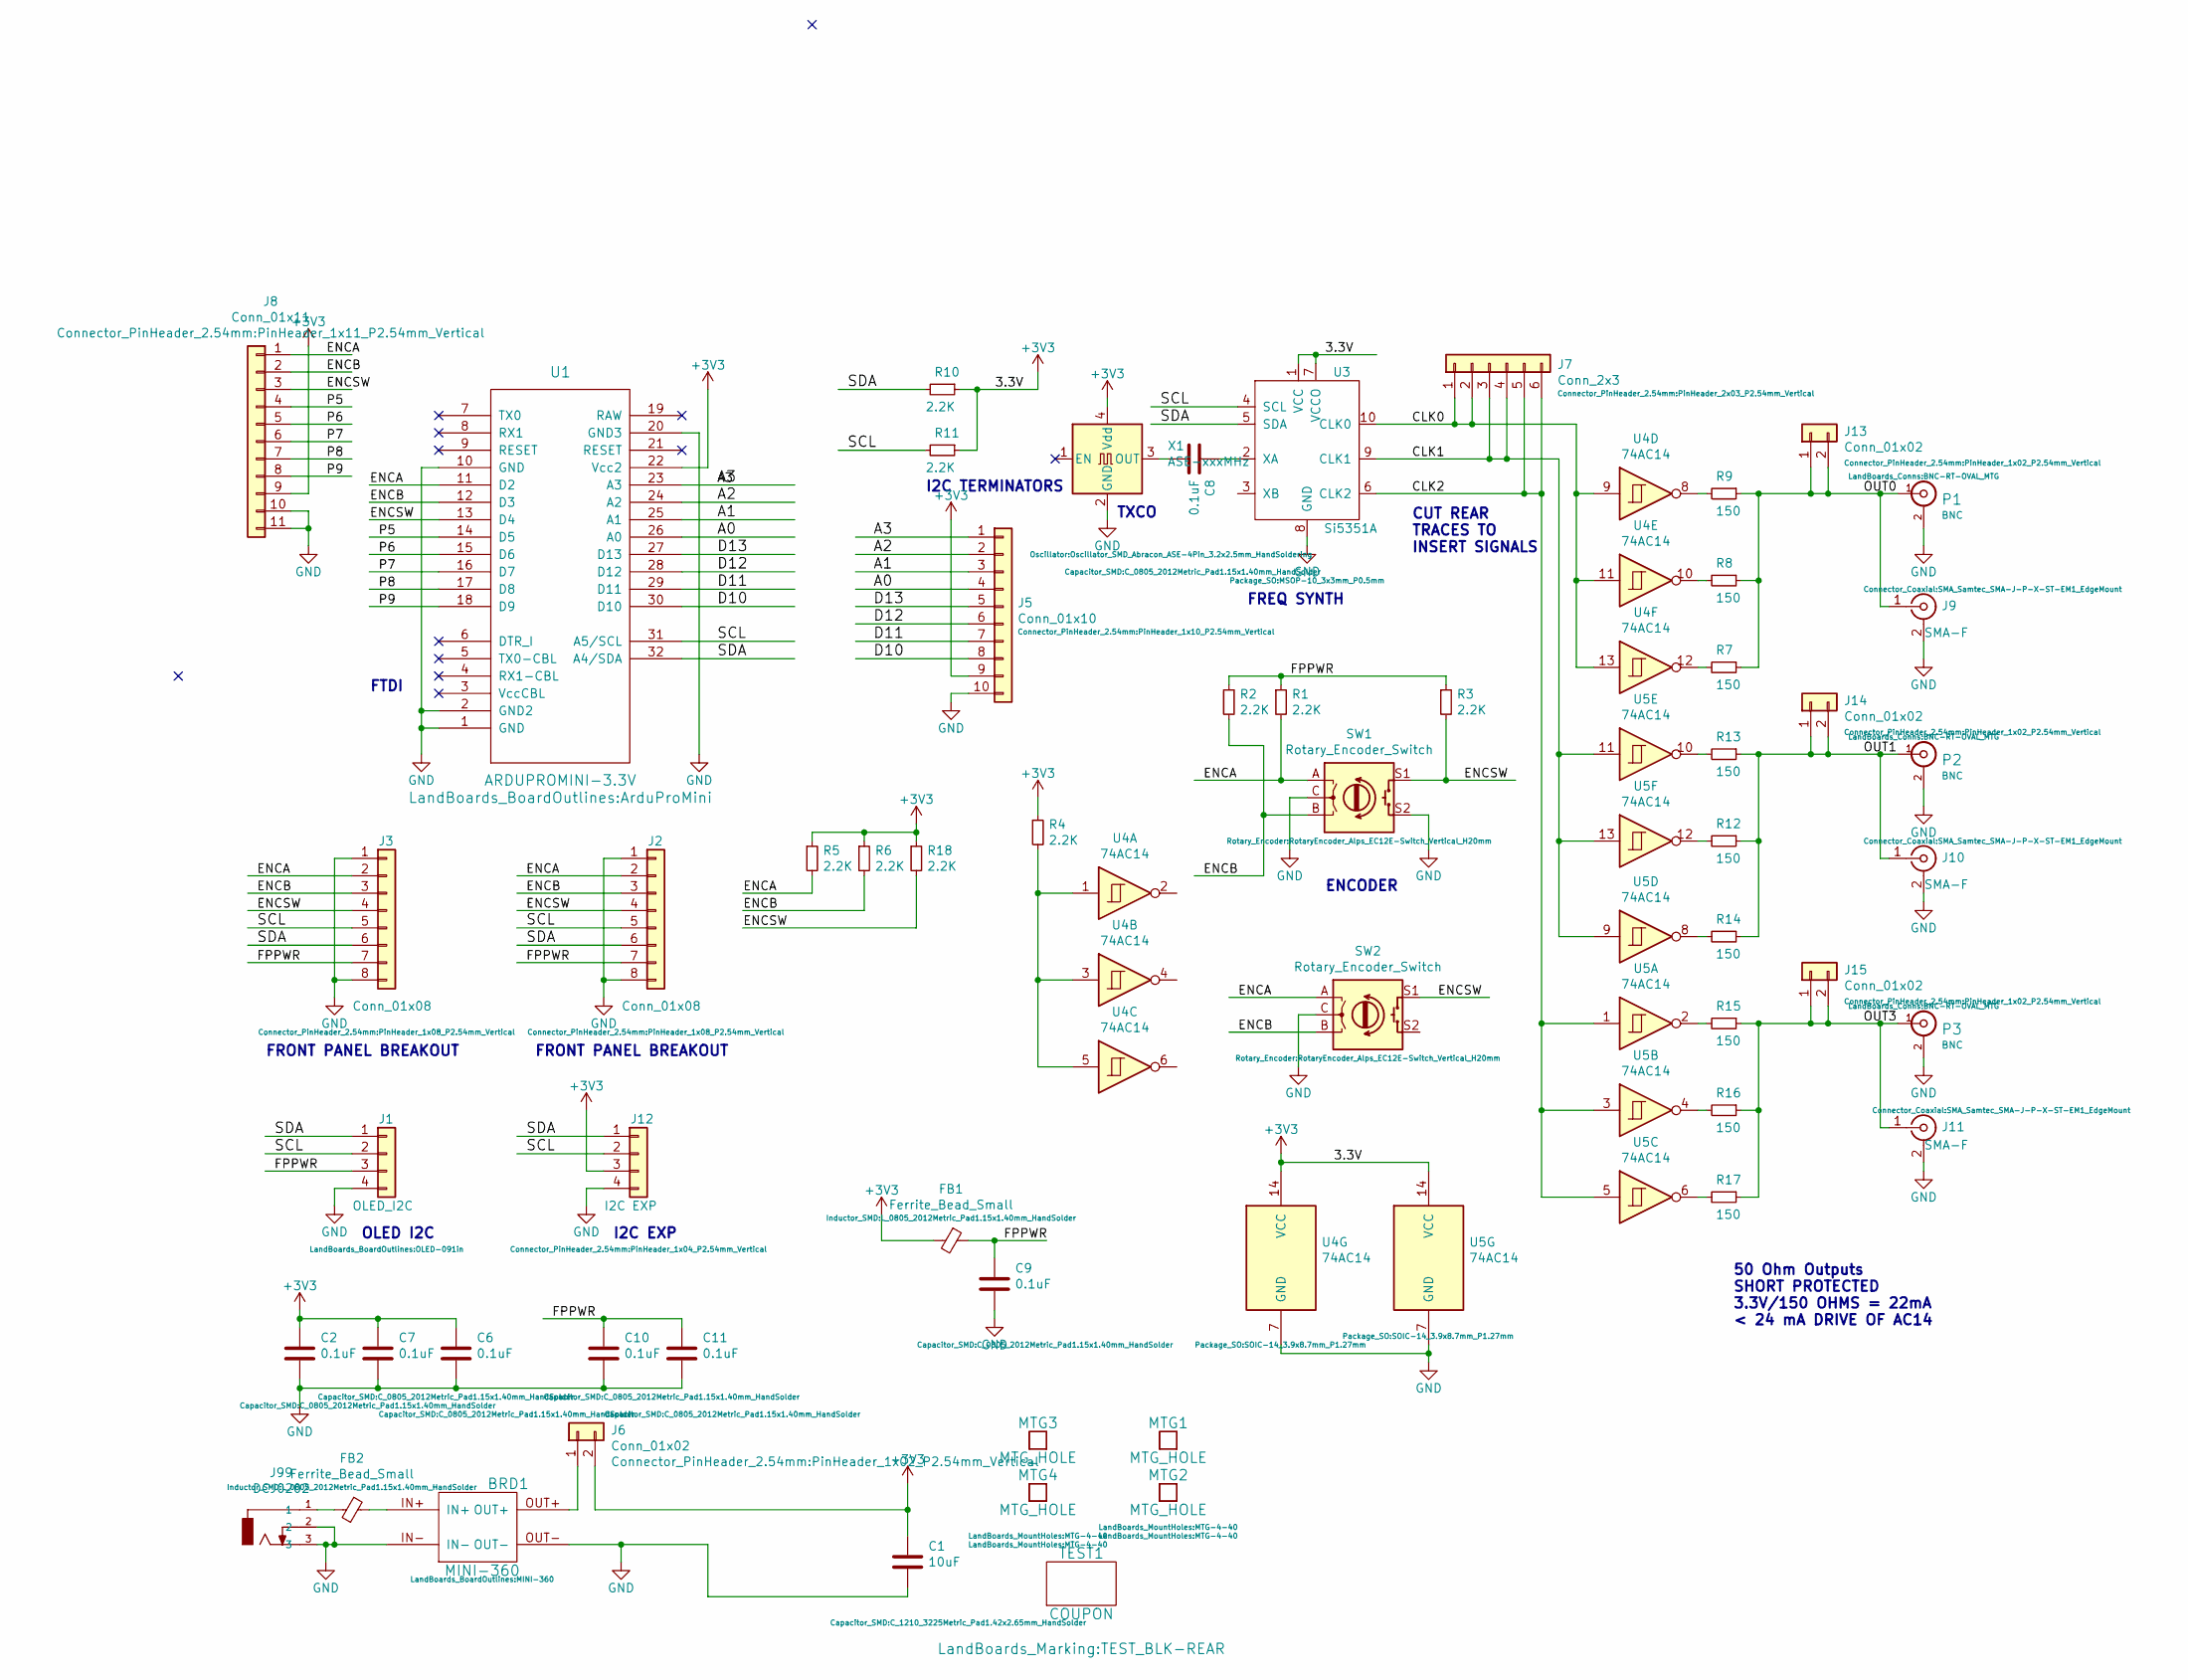
[picture p632: schematic VFO-003.kicad_sch]

Parts:
BRD1: MINI-360
C1: 10uF; C_1210_3225Metric_Pad1.42x2.65mm_HandSolder
C2, C6, C7, C8, C9, C10, C11: 0.1uF; C_0805_2012Metric_Pad1.15x1.40mm_HandSolder
FB1, FB2: Ferrite_Bead_Small; L_0805_2012Metric_Pad1.15x1.40mm_HandSolder
J1: OLED_I2C; OLED-091in
J2, J3: Conn_01x08; PinHeader_1x08_P2.54mm_Vertical
J5: Conn_01x10; PinHeader_1x10_P2.54mm_Vertical
J6, J13, J14, J15: Conn_01x02; PinHeader_1x02_P2.54mm_Vertical
J7: Conn_2x3; PinHeader_2x03_P2.54mm_Vertical
J8: Conn_01x11; PinHeader_1x11_P2.54mm_Vertical
J9, J10, J11: SMA-F; SMA_Samtec_SMA-J-P-X-ST-EM1_EdgeMount
J12: I2C EXP; PinHeader_1x04_P2.54mm_Vertical
J99: DCJ0202; DCJ-NEW-Slotted
MTG1, MTG2, MTG3, MTG4: MTG_HOLE; MTG-4-40
P1, P2, P3: BNC; BNC-RT-OVAL_MTG
R1, R2, R3, R4, R5, R6, R10, R11, R18: 2.2K; R_0805_2012Metric_Pad1.15x1.40mm_HandSolder
R7, R8, R9, R12, R13, R14, R15, R16, R17: 150; R_0805_2012Metric_Pad1.15x1.40mm_HandSolder
SW1, SW2: Rotary_Encoder_Switch; RotaryEncoder_Alps_EC12E-Switch_Vertical_H20mm
TEST1: COUPON; TEST_BLK-REAR
U1: ARDUPROMINI-3.3V; ArduProMini
U3: Si5351A; MSOP-10_3x3mm_P0.5mm
U4, U5: 74AC14; SOIC-14_3.9x8.7mm_P1.27mm
X1: ASE-xxxMHz; Oscillator_SMD_Abracon_ASE-4Pin_3.2x2.5mm_HandSoldering

Connections:
+3V3: C1.1, C2.1, C6.1, C7.1, FB1.2, J5.9, J6.2, J8.9, J12.3, R4.1, R5.1, R6.1, R10.1, R11.1, R18.1, U1.22 (Vcc2), U3.1 (VCC), U3.7 (VCCO), U4.14 (VCC), U5.14 (VCC), X1.4 (Vdd)
A0: J5.4, U1.26 (A0)
A1: J5.3, U1.25 (A1)
A2: J5.2, U1.24 (A2)
A3: J5.1, U1.23 (A3)
CLK0: J7.1, J7.2, U3.10 (CLK0), U4.9, U4.11, U4.13
CLK1: J7.3, J7.4, U3.9 (CLK1), U5.9, U5.11, U5.13
CLK2: J7.5, J7.6, U3.6 (CLK2), U5.1, U5.3, U5.5
D10: J5.8, U1.30 (D10)
D11: J5.7, U1.29 (D11)
D12: J5.6, U1.28 (D12)
D13: J5.5, U1.27 (D13)
ENCA: J2.2, J3.2, J8.1, R1.2, R5.2, SW1.A, SW2.A, U1.11 (D2)
ENCB: J2.3, J3.3, J8.2, R2.2, R6.2, SW1.B, SW2.B, U1.12 (D3)
ENCSW: J2.4, J3.4, J8.3, R3.2, R18.2, SW1.S1, SW2.S1, U1.13 (D4)
FPPWR: C9.1, C10.1, C11.1, FB1.1, J1.3, J2.7, J3.7, R1.1, R2.1, R3.1
GND: BRD1.IN-, BRD1.OUT-, C1.2, C2.2, C6.2, C7.2, C9.2, C10.2, C11.2, J1.4, J2.1, J2.8, J3.1, J3.8, J5.10, J8.10, J8.11, J9.2 (Ext), J10.2 (Ext), J11.2 (Ext), J12.4, J99.2, J99.3, P1.2 (Ext), P2.2 (Ext), P3.2 (Ext), SW1.C, SW1.S2, SW2.C, U1.1 (GND), U1.2 (GND2), U1.10 (GND), U1.20 (GND3), U3.8 (GND), U4.7 (GND), U5.7 (GND), X1.2 (GND)
unnamed: BRD1.IN+, FB2.1
unnamed: BRD1.OUT+, J6.1
unnamed: C8.1, U3.2 (XA)
unnamed: C8.2, X1.3 (OUT)
unnamed: FB2.2, J99.1
unnamed: R4.2, U4.1, U4.3, U4.5
unnamed: R7.2, U4.12
unnamed: R8.2, U4.10
unnamed: R9.2, U4.8
unnamed: R12.2, U5.12
unnamed: R13.2, U5.10
unnamed: R14.2, U5.8
unnamed: R15.2, U5.2
unnamed: R16.2, U5.4
unnamed: R17.2, U5.6
OUT0: J9.1 (In), J13.1, J13.2, P1.1 (In), R7.1, R8.1, R9.1
OUT1: J10.1 (In), J14.1, J14.2, P2.1 (In), R12.1, R13.1, R14.1
OUT3: J11.1 (In), J15.1, J15.2, P3.1 (In), R15.1, R16.1, R17.1
P5: J8.4, U1.14 (D5)
P6: J8.5, U1.15 (D6)
P7: J8.6, U1.16 (D7)
P8: J8.7, U1.17 (D8)
P9: J8.8, U1.18 (D9)
SCL: J1.2, J2.5, J3.5, J12.2, R11.2, U1.31 (A5/SCL), U3.4 (SCL)
SDA: J1.1, J2.6, J3.6, J12.1, R10.2, U1.32 (A4/SDA), U3.5 (SDA)

Notes on the sheet:
I2C EXP
FREQ SYNTH
ENCODER
FTDI
FRONT PANEL BREAKOUT
50 Ohm Outputs SHORT PROTECTED 3.3V/150 OHMS = 22mA < 24 mA DRIVE OF AC14
CUT REAR TRACES TO INSERT SIGNALS
TXCO
I2C TERMINATORS
OLED I2C
