land-boards/lb-boards/HamRadio/VFO-004/VFO-004.sch

## KiCad design HamRadio/VFO-004/VFO-004.sch (2020-11-30)

Schematic: VFO-004.sch

Parts:
C4, C5, C6: 0.1uF; C_0805_HandSoldering
FTDI: Conn_01x06
MTG1, MTG2, MTG3, MTG4: MTG_HOLE; MTG-6-32
OLED: Conn_01x04; Pin_Header_Straight_1x04_Pitch2.54mm
ROTARY_ENC: Conn_01x05
SI5351: Conn_02x04_Odd_Even
TEST1: COUPON; TEST_BLK-REAR

Notes on the sheet:
GND VCC B A SW
