land-boards/lb-boards/HamRadio/W7ZOI_TIA/W7ZOI_TIA.sch

## KiCad design HamRadio/W7ZOI_TIA/W7ZOI_TIA.sch (2022-04-09)

Schematic: W7ZOI_TIA.sch

Parts:
C1, C2, C3, C4, C5, C6, C7, C8, C9, C10: 0.1u; C_Disc_D3.0mm_W2.0mm_P2.50mm
J1, J2: Conn_01x03; PinHeader_1x03_P2.54mm_Vertical
MTG1, MTG2, MTG3, MTG4: CONN_1; MTG-4-40
P1, P2: BNC; SMA_Samtec_SMA-J-P-X-ST-EM1_EdgeMount
P3, P4: BNC; BNC-RT-OVAL_MTG
Q1, Q2, Q3, Q4, Q5, Q6: 2N3904; TO-92_HandSolder
R1, R13: 10K; R_Axial_DIN0207_L6.3mm_D2.5mm_P7.62mm_Horizontal
R2, R8, R14, R19: 2.2K; R_Axial_DIN0207_L6.3mm_D2.5mm_P7.62mm_Horizontal
R3, R15: 1.8K; R_Axial_DIN0207_L6.3mm_D2.5mm_P7.62mm_Horizontal
R4, R12: 10; R_Axial_DIN0207_L6.3mm_D2.5mm_P7.62mm_Horizontal
R5, R16: 330; R_Axial_DIN0207_L6.3mm_D2.5mm_P7.62mm_Horizontal
R6, R17: 200; R_Axial_DIN0207_L6.3mm_D2.5mm_P7.62mm_Horizontal
R7, R18: 4.7; R_Axial_DIN0207_L6.3mm_D2.5mm_P7.62mm_Horizontal
R9, R20: 470; R_Axial_DIN0207_L6.3mm_D2.5mm_P7.62mm_Horizontal
R10, R21: 47; R_Axial_DIN0207_L6.3mm_D2.5mm_P7.62mm_Horizontal
R11, R22: 50; R_Axial_DIN0207_L6.3mm_D2.5mm_P7.62mm_Horizontal
V1: 13.8
V2, V4: dc 0 ac 1
V3: 0

Notes on the sheet:
.ac dec 100 1Meg 100Meg
R1(COLL)
