land-boards/lb-boards/HamRadio/W7ZOI_TIA_SMT/W7ZOI_TIA_SMT.sch

## KiCad design HamRadio/W7ZOI_TIA_SMT/W7ZOI_TIA_SMT.sch (2021-11-14)

Schematic: W7ZOI_TIA_SMT.sch

Parts:
C1, C2, C3, C4, C5, C6, C7, C8, C9, C10: 0.1u; C_0805_2012Metric_Pad1.18x1.45mm_HandSolder
J1, J2: DCJ0202; DCJ-NEW-Slotted
MTG1, MTG2, MTG3: MTG_HOLE; MTG-4-40
MTG?1: MTG_HOLE; MTG-4-40
P1, P2: BNC; SMA_Samtec_SMA-J-P-X-ST-EM1_EdgeMount
P3, P4: BNC; BNC-RT-OVAL_MTG
Q1, Q2, Q3, Q4, Q5, Q6: MMBT3904; SOT-23
R1, R13: 10K; R_0805_2012Metric_Pad1.20x1.40mm_HandSolder
R2, R8, R14, R19: 2.2K; R_0805_2012Metric_Pad1.20x1.40mm_HandSolder
R3, R15: 1.8K; R_0805_2012Metric_Pad1.20x1.40mm_HandSolder
R4, R12: 10; R_0805_2012Metric_Pad1.20x1.40mm_HandSolder
R5, R16: 330; R_0805_2012Metric_Pad1.20x1.40mm_HandSolder
R6, R17: 180; R_0805_2012Metric_Pad1.20x1.40mm_HandSolder
R7, R18: 4.7; R_0805_2012Metric_Pad1.20x1.40mm_HandSolder
R9, R20: 470; R_0805_2012Metric_Pad1.20x1.40mm_HandSolder
R10, R21: 47; R_0805_2012Metric_Pad1.20x1.40mm_HandSolder
R11, R22: 50; R_Axial_DIN0207_L6.3mm_D2.5mm_P10.16mm_Horizontal
V1: 0
V2, V4: dc 0 ac 1
V3: 13.8

Notes on the sheet:
.ac dec 100 1Meg 100Meg
R1(COLL)
12V FR L-R 0V FOR R-L
0V FR L-R 12V FOR R-L
ENABLE SYMBOL FOR L-R SIMULATION DISABLE SYMBOL FOR L-R SIMULATION
ENABLE SYMBOL FOR R-L SIMULATION DISABLE SYMBOL FOR R-L SIMULATION
SPICE SIMULATION CONTROL
OPTIONAL TERMINATOR
