land-boards/lb-boards/I2C Cards/DIGIO-128/DIGIO-128-1.kicad_sch

## KiCad design I2C Cards/DIGIO-128/DIGIO-128-1.kicad_sch (2022-10-10)

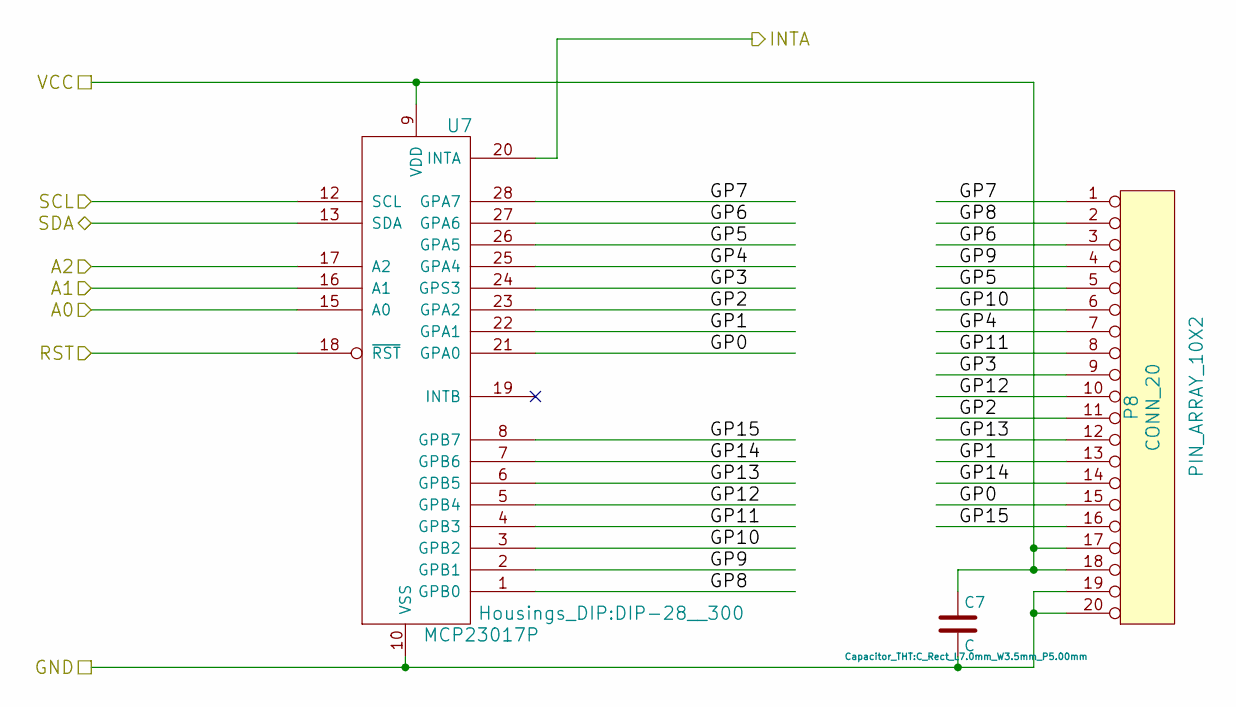
[picture p633: schematic DIGIO-128-1.kicad_sch]

Parts:
C7: C; C_Rect_L7.0mm_W3.5mm_P5.00mm
P8: CONN_20; PIN_ARRAY_10X2
U7: MCP23017P; DIP-28__300

Connections:
A0: U7.15 (A0)
A1: U7.16 (A1)
A2: U7.17 (A2)
GND: C7.2, P8.19, P8.20, U7.10 (VSS)
GP0: P8.15, U7.21 (GPA0)
GP1: P8.13, U7.22 (GPA1)
GP2: P8.11, U7.23 (GPA2)
GP3: P8.9, U7.24 (GPS3)
GP4: P8.7, U7.25 (GPA4)
GP5: P8.5, U7.26 (GPA5)
GP6: P8.3, U7.27 (GPA6)
GP7: P8.1, U7.28 (GPA7)
GP8: P8.2, U7.1 (GPB0)
GP9: P8.4, U7.2 (GPB1)
GP10: P8.6, U7.3 (GPB2)
GP11: P8.8, U7.4 (GPB3)
GP12: P8.10, U7.5 (GPB4)
GP13: P8.12, U7.6 (GPB5)
GP14: P8.14, U7.7 (GPB6)
GP15: P8.16, U7.8 (GPB7)
INTA: U7.20 (INTA)
RST: U7.18 (~RST)
SCL: U7.12 (SCL)
SDA: U7.13 (SDA)
VCC: C7.1, P8.17, P8.18, U7.9 (VDD)
