land-boards/lb-boards/I2C Cards/DIGIO-128/DIGIO-128-2.sch

## KiCad design I2C Cards/DIGIO-128/DIGIO-128-2.sch (2015-03-30)

Schematic: DIGIO-128-2.sch

Parts:
P1: CONN_20
U2: MCP23017P; DIP-28__300
