land-boards/lb-boards/I2C Cards/DIGIO-128/DIGIO-128.kicad_sch

## KiCad design I2C Cards/DIGIO-128/DIGIO-128.kicad_sch (2022-10-10)

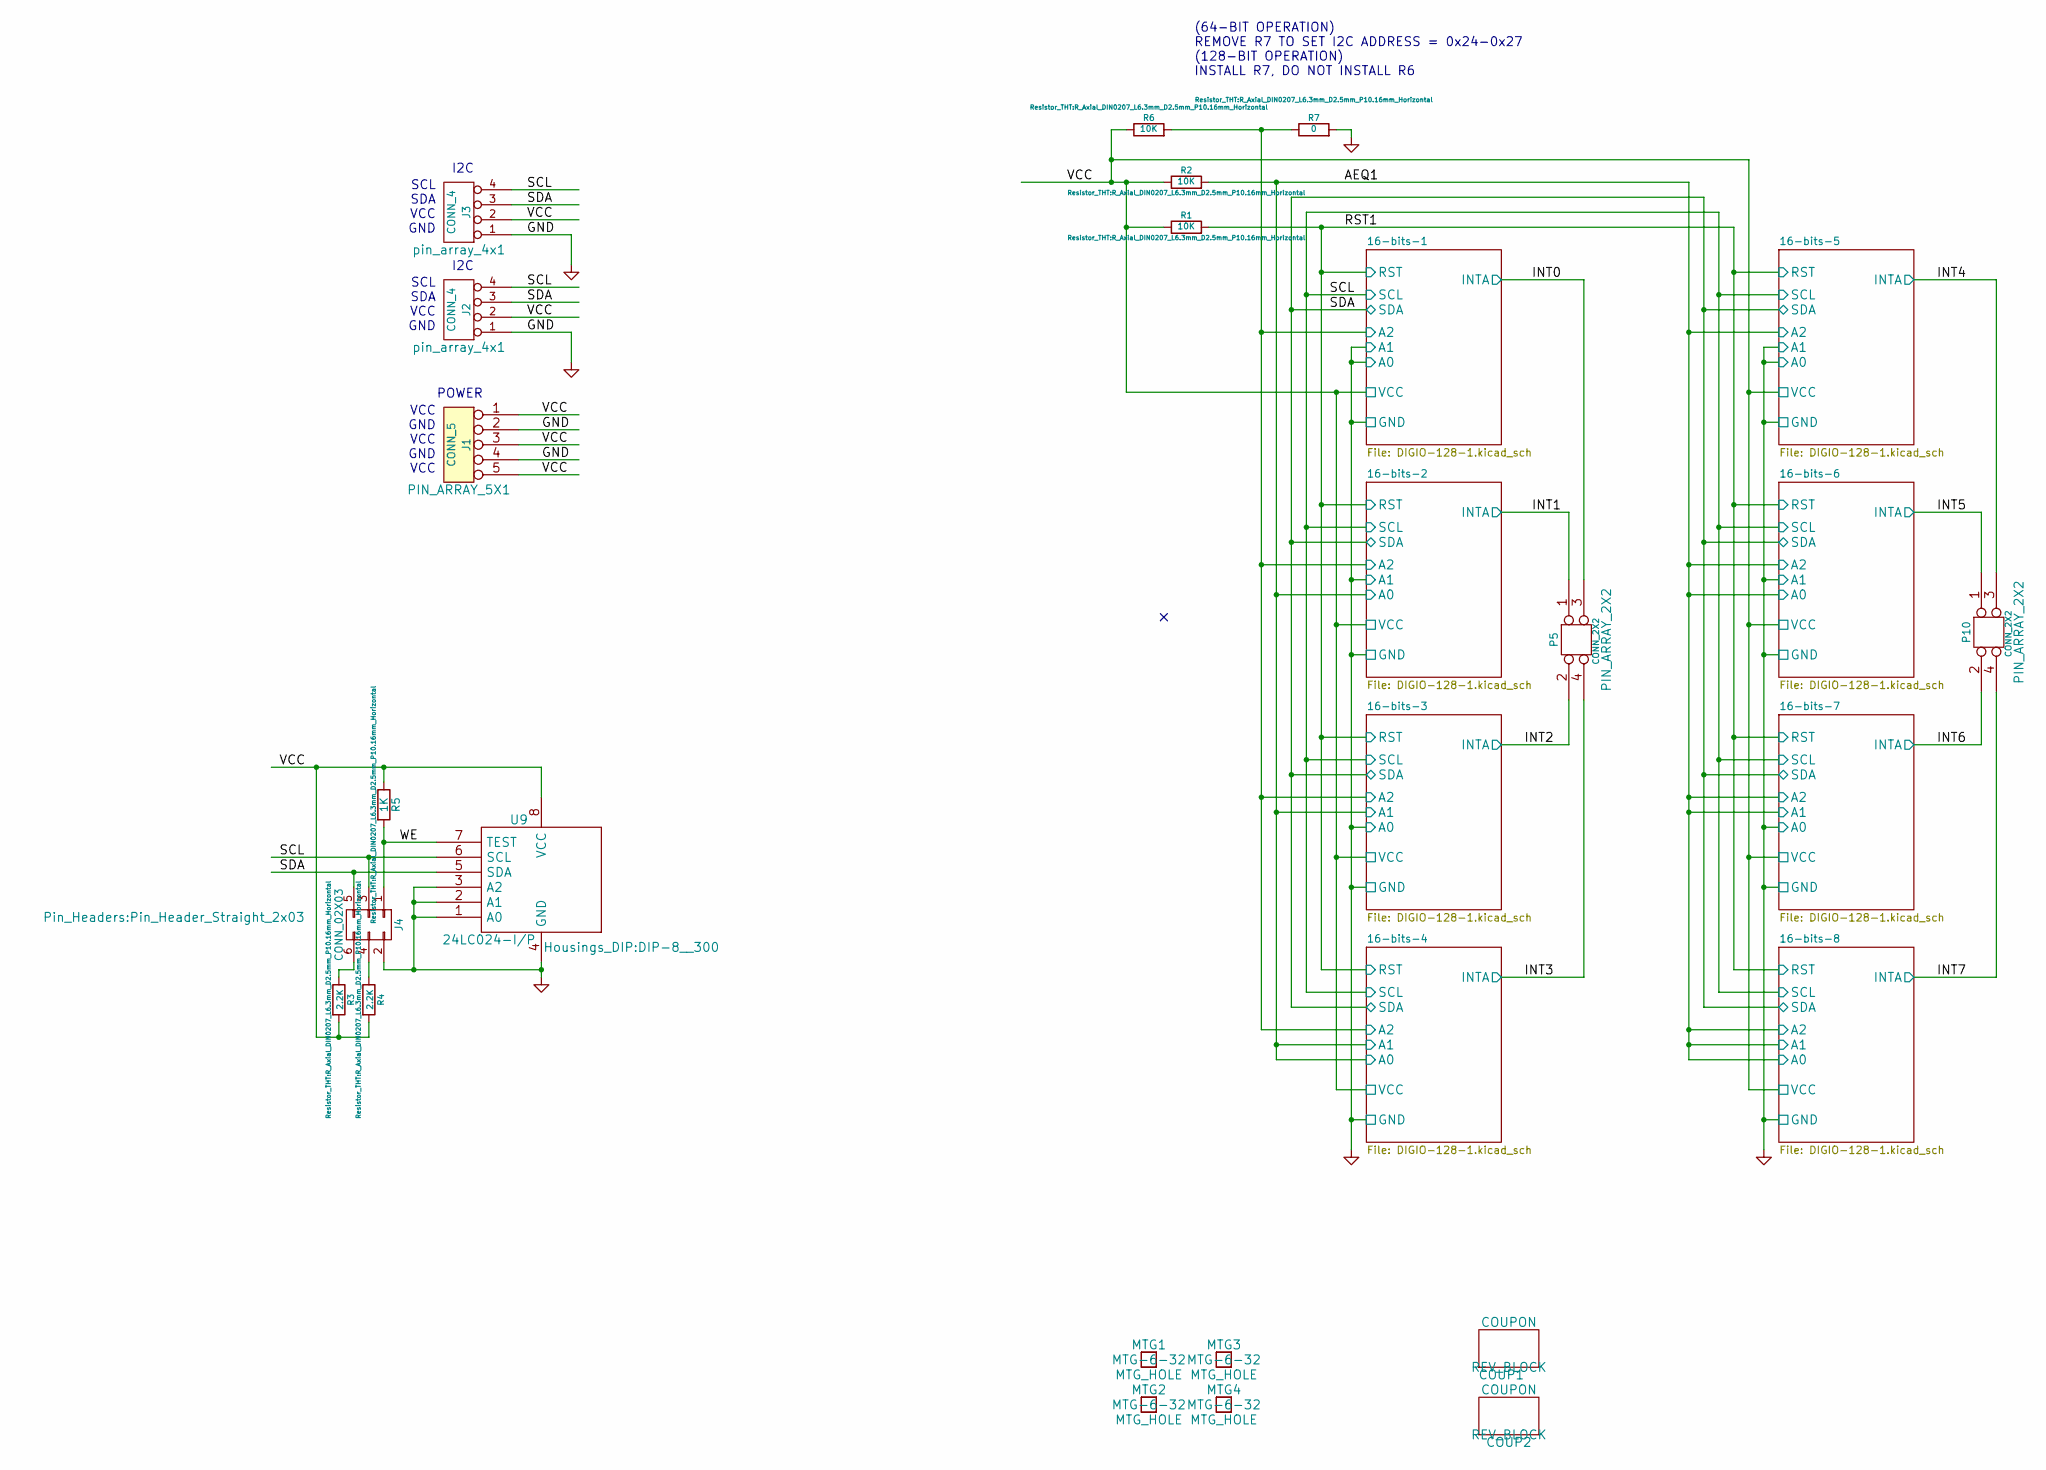
[picture p634: schematic DIGIO-128.kicad_sch]

Parts:
COUP1, COUP2: COUPON; REV_BLOCK
J1: CONN_5; PIN_ARRAY_5X1
J2, J3: CONN_4; pin_array_4x1
J4: CONN_02X03; Pin_Header_Straight_2x03
MTG1, MTG2, MTG3, MTG4: MTG_HOLE; MTG-6-32
P5, P10: CONN_2X2; PIN_ARRAY_2X2
R1, R2, R6: 10K; R_Axial_DIN0207_L6.3mm_D2.5mm_P10.16mm_Horizontal
R3, R4: 2.2K; R_Axial_DIN0207_L6.3mm_D2.5mm_P10.16mm_Horizontal
R5: 1K; R_Axial_DIN0207_L6.3mm_D2.5mm_P10.16mm_Horizontal
R7: 0; R_Axial_DIN0207_L6.3mm_D2.5mm_P10.16mm_Horizontal
U9: 24LC024-I/P; DIP-8__300

Connections:
A2: R6.2, R7.1
AEQ1: R2.2
GND: J1.2, J1.4, J2.1, J3.1, J4.2, R7.2, U9.1 (A0), U9.2 (A1), U9.3 (A2), U9.4 (GND)
INT0: P5.3
INT1: P5.1
INT2: P5.2
INT3: P5.4
INT4: P10.3
INT5: P10.1
INT6: P10.2
INT7: P10.4
unnamed: J4.4, R4.1
unnamed: J4.6, R3.1
RST1: R1.2
SCL: J2.4, J3.4, J4.3, U9.6 (SCL)
SDA: J2.3, J3.3, J4.5, U9.5 (SDA)
VCC: J1.1, J1.3, J1.5, J2.2, J3.2, R1.1, R2.1, R3.2, R4.2, R5.1, R6.1, U9.8 (VCC)
WE: J4.1, R5.2, U9.7 (TEST)

Notes on the sheet:
SCL SDA VCC GND
(64-BIT OPERATION) REMOVE R7 TO SET I2C ADDRESS = 0x24-0x27 (128-BIT OPERATION) INSTALL R7, DO NOT INSTALL R6
VCC GND VCC GND VCC
POWER
I2C
