land-boards/lb-boards/I2C Cards/DigIO16-I2C/DigIO16-I2C.sch

## KiCad design I2C Cards/DigIO16-I2C/DigIO16-I2C.sch (2020-01-01)

Schematic: DigIO16-I2C.sch

Parts:
C1, C2: 0.1uF; C_Rect_L7_W2_P5
F1: FUSE; SM1206
FID1, FID2: ADAFRUIT_FIDUCIAL; FIDUCIAL
J1, J5: CONN_3; PIN_ARRAY_3X1
J2, J3: CONN_4; pin_array_4x1
J4: CONN_3X2; Pin_Header_Straight_2x03
J6: CONN_02X02; Pin_Header_Straight_2x02
J7: CONN_01X02; Pin_Header_Straight_1x02
J8: DB25; DB25FC
MTG1, MTG2, MTG3, MTG4: MTG_HOLE; MTG-6-32
R1, R2: 2.2K; R4-5
R3, R4, R6, R7, R8: 10K; R4-5
R5: 1K; R4-5
ST1, ST2: CONN_1; REV_BLOCK
U1: MCP23017P; DIP-28__300_ELL
U2: 24C01; DIP-8__300_ELL

Notes on the sheet:
SCL SDA VCC GND
GND VCC GND
~CP ~INT GND
POWER
I2C
