land-boards/lb-boards/I2C Cards/DigIO32-I2C/DigIO32-I2C.kicad_sch

## KiCad design I2C Cards/DigIO32-I2C/DigIO32-I2C.kicad_sch (2022-10-10)

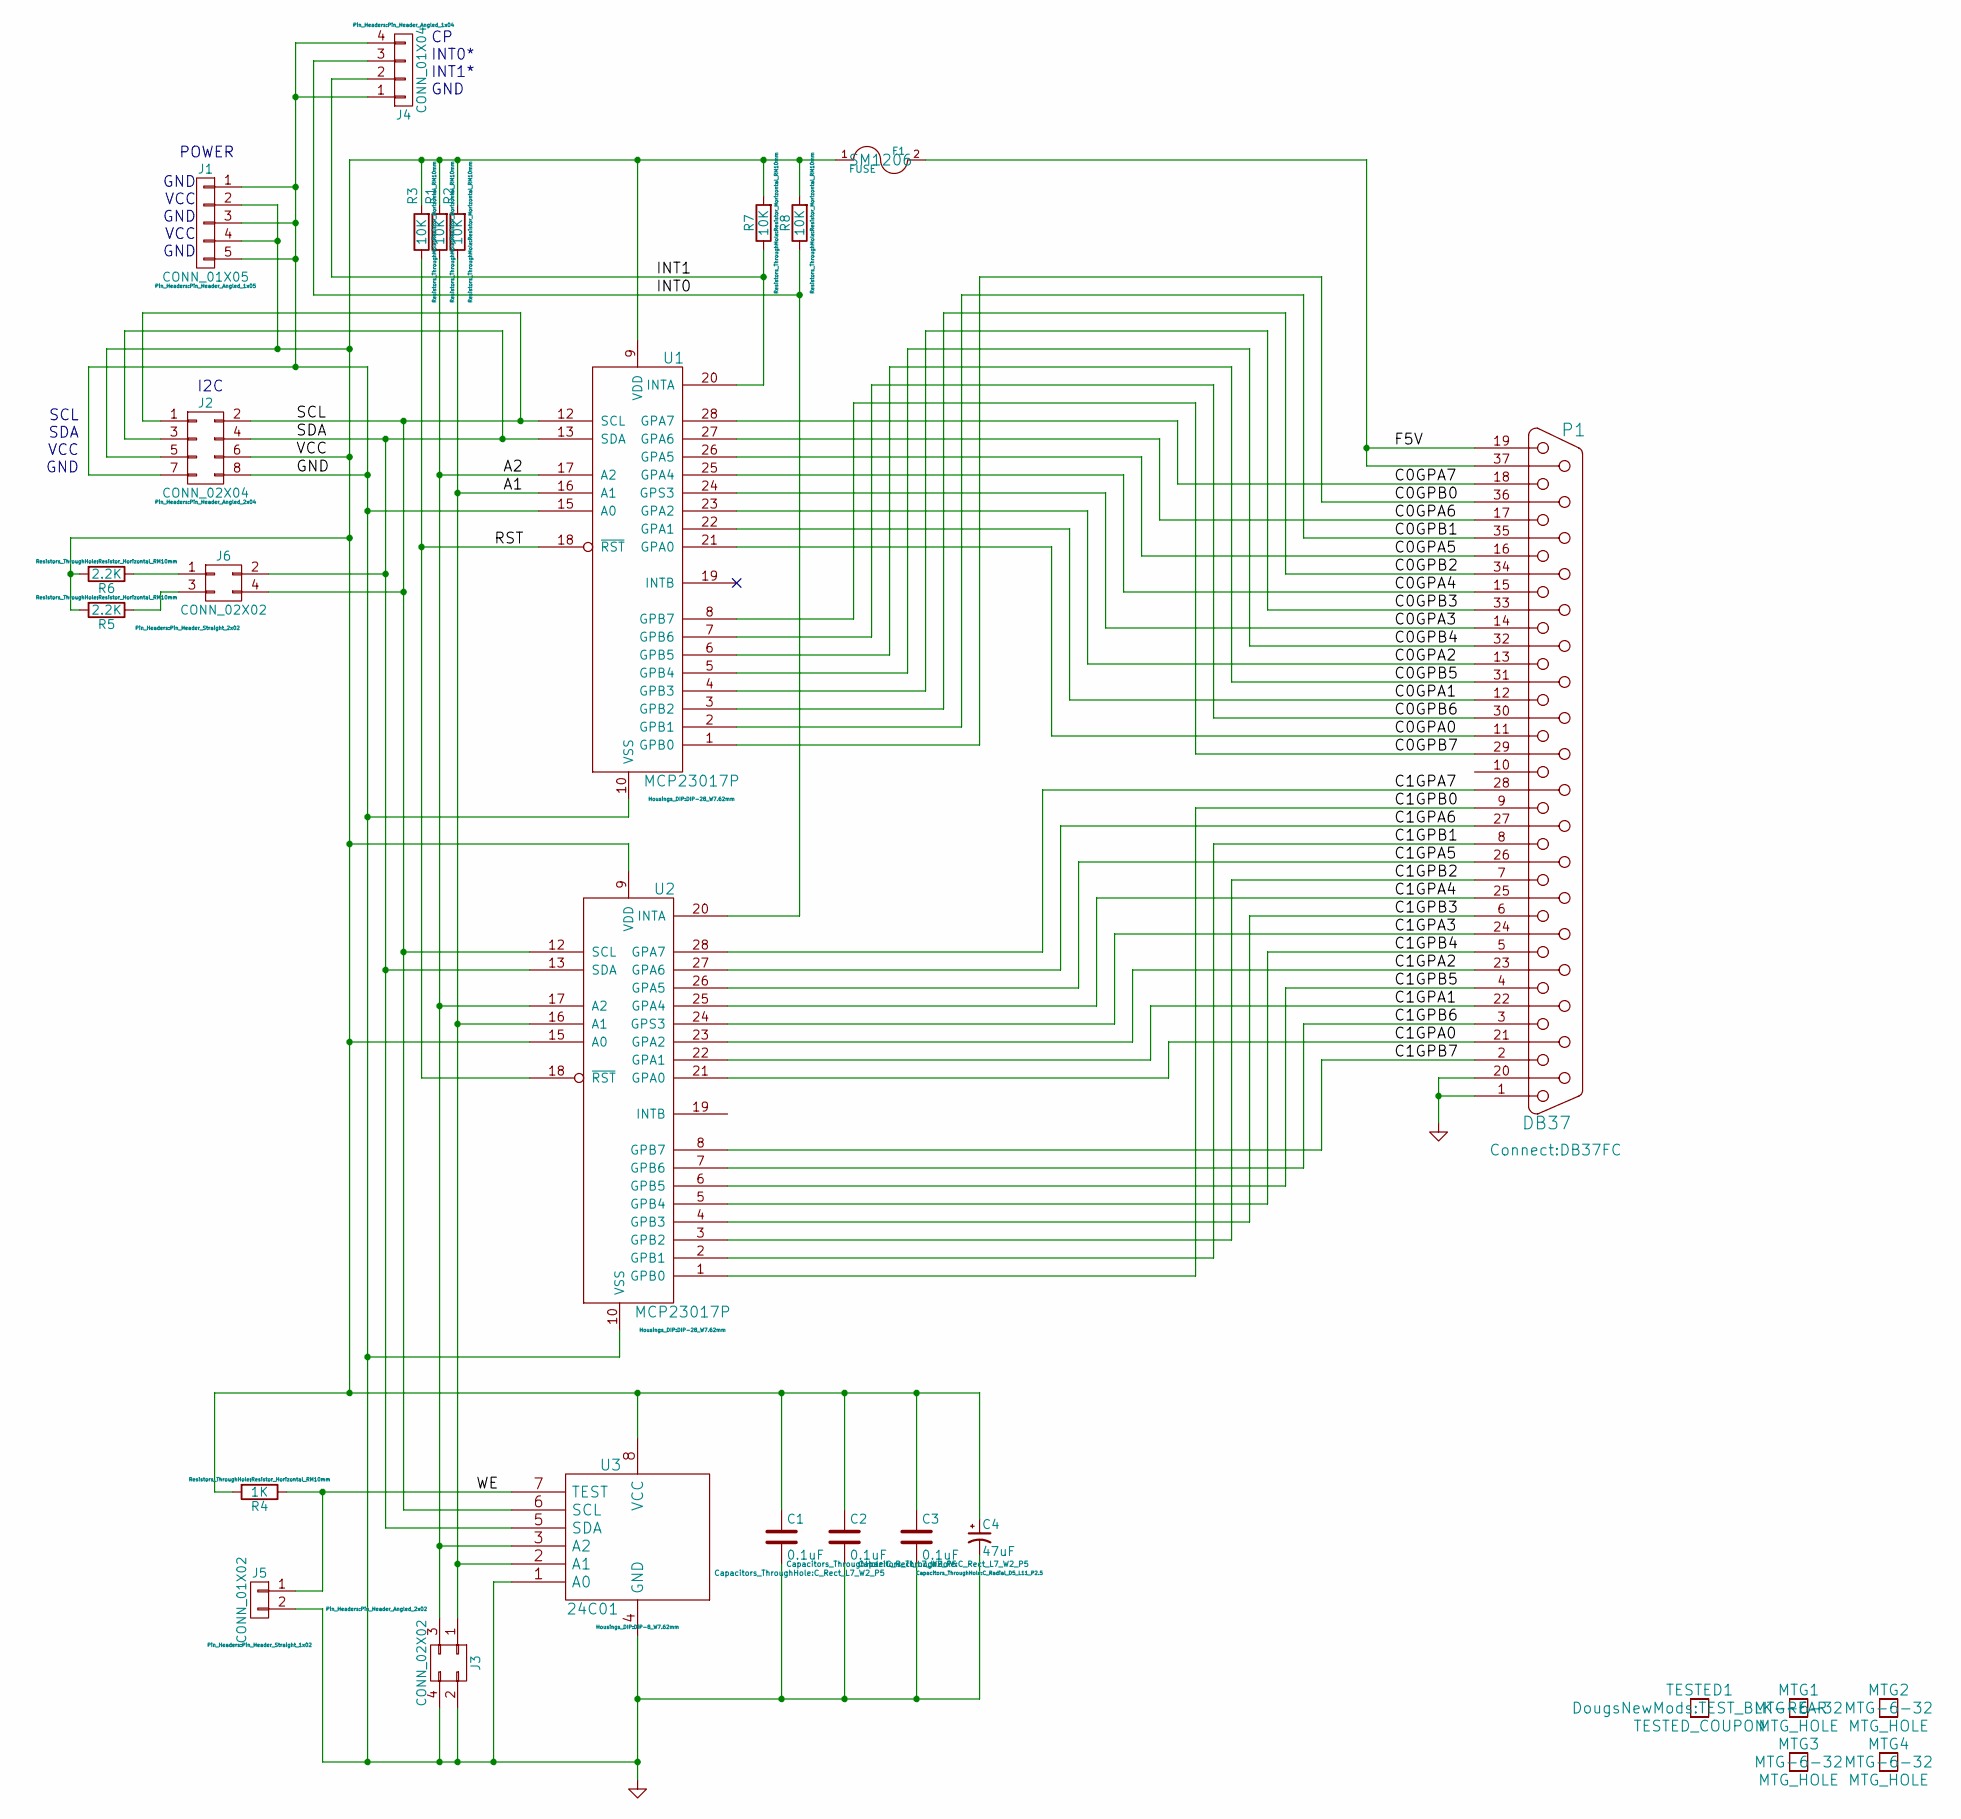
[picture p635: schematic DigIO32-I2C.kicad_sch]

Parts:
C1, C2, C3: 0.1uF; C_Rect_L7_W2_P5
C4: 47uF; C_Radial_D5_L11_P2.5
F1: FUSE; SM1206
J1: CONN_01X05; Pin_Header_Angled_1x05
J2: CONN_02X04; Pin_Header_Angled_2x04
J3: CONN_02X02; Pin_Header_Angled_2x02
J4: CONN_01X04; Pin_Header_Angled_1x04
J5: CONN_01X02; Pin_Header_Straight_1x02
J6: CONN_02X02; Pin_Header_Straight_2x02
MTG1, MTG2, MTG3, MTG4: MTG_HOLE; MTG-6-32
P1: DB37; DB37FC
R1, R2, R3, R7, R8: 10K; Resistor_Horizontal_RM10mm
R4: 1K; Resistor_Horizontal_RM10mm
R5, R6: 2.2K; Resistor_Horizontal_RM10mm
TESTED1: TESTED_COUPON; TEST_BLK-REAR
U1, U2: MCP23017P; DIP-28_W7.62mm
U3: 24C01; DIP-8_W7.62mm

Connections:
A1: J3.1, R2.1, U1.16 (A1), U2.16 (A1), U3.2 (A1)
A2: J3.3, R1.1, U1.17 (A2), U2.17 (A2), U3.3 (A2)
C0GPA0: P1.11, U1.21 (GPA0)
C0GPA1: P1.12, U1.22 (GPA1)
C0GPA2: P1.13, U1.23 (GPA2)
C0GPA3: P1.14, U1.24 (GPS3)
C0GPA4: P1.15, U1.25 (GPA4)
C0GPA5: P1.16, U1.26 (GPA5)
C0GPA6: P1.17, U1.27 (GPA6)
C0GPA7: P1.18, U1.28 (GPA7)
C0GPB0: P1.36, U1.1 (GPB0)
C0GPB1: P1.35, U1.2 (GPB1)
C0GPB2: P1.34, U1.3 (GPB2)
C0GPB3: P1.33, U1.4 (GPB3)
C0GPB4: P1.32, U1.5 (GPB4)
C0GPB5: P1.31, U1.6 (GPB5)
C0GPB6: P1.30, U1.7 (GPB6)
C0GPB7: P1.29, U1.8 (GPB7)
C1GPA0: P1.21, U2.21 (GPA0)
C1GPA1: P1.22, U2.22 (GPA1)
C1GPA2: P1.23, U2.23 (GPA2)
C1GPA3: P1.24, U2.24 (GPS3)
C1GPA4: P1.25, U2.25 (GPA4)
C1GPA5: P1.26, U2.26 (GPA5)
C1GPA6: P1.27, U2.27 (GPA6)
C1GPA7: P1.28, U2.28 (GPA7)
C1GPB0: P1.9, U2.1 (GPB0)
C1GPB1: P1.8, U2.2 (GPB1)
C1GPB2: P1.7, U2.3 (GPB2)
C1GPB3: P1.6, U2.4 (GPB3)
C1GPB4: P1.5, U2.5 (GPB4)
C1GPB5: P1.4, U2.6 (GPB5)
C1GPB6: P1.3, U2.7 (GPB6)
C1GPB7: P1.2, U2.8 (GPB7)
F5V: F1.2, P1.19, P1.37
GND: C1.2, C2.2, C3.2, C4.2, J1.1, J1.3, J1.5, J2.7, J2.8, J3.2, J3.4, J4.1, J4.4, J5.2, P1.1, P1.20, U1.10 (VSS), U1.15 (A0), U2.10 (VSS), U3.1 (A0), U3.4 (GND)
INT0: J4.3, R8.1, U2.20 (INTA)
INT1: J4.2, R7.1, U1.20 (INTA)
unnamed: J6.1, R6.1
unnamed: J6.3, R5.1
RST: R3.1, U1.18 (~RST), U2.18 (~RST)
SCL: J2.1, J2.2, J6.4, U1.12 (SCL), U2.12 (SCL), U3.6 (SCL)
SDA: J2.3, J2.4, J6.2, U1.13 (SDA), U2.13 (SDA), U3.5 (SDA)
VCC: C1.1, C2.1, C3.1, C4.1, F1.1, J1.2, J1.4, J2.5, J2.6, R1.2, R2.2, R3.2, R4.2, R5.2, R6.2, R7.2, R8.2, U1.9 (VDD), U2.9 (VDD), U2.15 (A0), U3.8 (VCC)
WE: J5.1, R4.1, U3.7 (TEST)

Notes on the sheet:
GND VCC GND VCC GND
POWER
SCL SDA VCC GND
I2C
CP INT0* INT1* GND
