land-boards/lb-boards/I2C Cards/I2C8Bit/I2C8BitV2.sch

## KiCad design I2C Cards/I2C8Bit/I2C8BitV2.sch (2012-07-01)

Schematic: I2C8BitV2.sch

Parts:
C1: 0.1uF
J1, J2, J3: CONN_2; SIL-2
J4: CONN_4; SIL-4
J5, J6, J7, J8, J9, J10, J11, J12, J13: CONN_3; SIL-3
MTG1, MTG2, MTG3, MTG4: CONN_1
R1, R2, R3, R4, R5, R6: 10K; R1
U1: MCP23008P; DIP-18__300
