land-boards/lb-boards/I2C Cards/I2C16Bit/I2C16BitV3.sch

## KiCad design I2C Cards/I2C16Bit/I2C16BitV3.sch (2012-07-20)

Schematic: I2C16BitV3.sch

Parts:
C1: 0.1uF
J1, J2, J3: CONN_2; SIL-2
J4, J23: CONN_4; SIL-4
J5, J6, J7, J8, J9, J10, J11, J12, J13, J14, J15, J16, J17, J18, J19, J20, J21, J22: CONN_3; SIL-3
MTG1, MTG2, MTG3, MTG4: CONN_1
R1, R2, R3, R4, R5, R6: 10K; R1
U1: MCP23017P

Notes on the sheet:
SCK SDA VCC GND
