land-boards/lb-boards/I2C Cards/I2C-RPT-01/I2C-RPT-01.sch

## KiCad design I2C Cards/I2C-RPT-01/I2C-RPT-01.sch (2020-01-01)

Schematic: I2C-RPT-01.sch

Parts:
C1: 0.1uF; R_0805_HandSoldering
C2: 0.1uF; R_1206_HandSoldering
FID1, FID2: ADAFRUIT_FIDUCIAL; FIDUCIAL
H1, H2, H3, H4: CONN_01X02; Pin_Header_Straight_1x02
J1, J2, J3, J4, J5: I2CINT-5PIN; Pin_Header_Straight_1x05
MTG1, MTG2, MTG3, MTG4: MTG_HOLE; MTG-4-40
R1, R2, R3, R4, R5, R6, R7, R8, R9, R10, R11, R12, R13, R14, R15: 3.3K; R_0805_HandSoldering
ST1: CONN_1; TEST_BLK-REAR
U1: PCA9544A; TSSOP-20_4.4x6.5mm_Pitch0.65mm
