land-boards/lb-boards/I2C Cards/I2C-RPT-08/I2C-RPT-08.kicad_sch

## KiCad design I2C Cards/I2C-RPT-08/I2C-RPT-08.kicad_sch (2022-10-10)

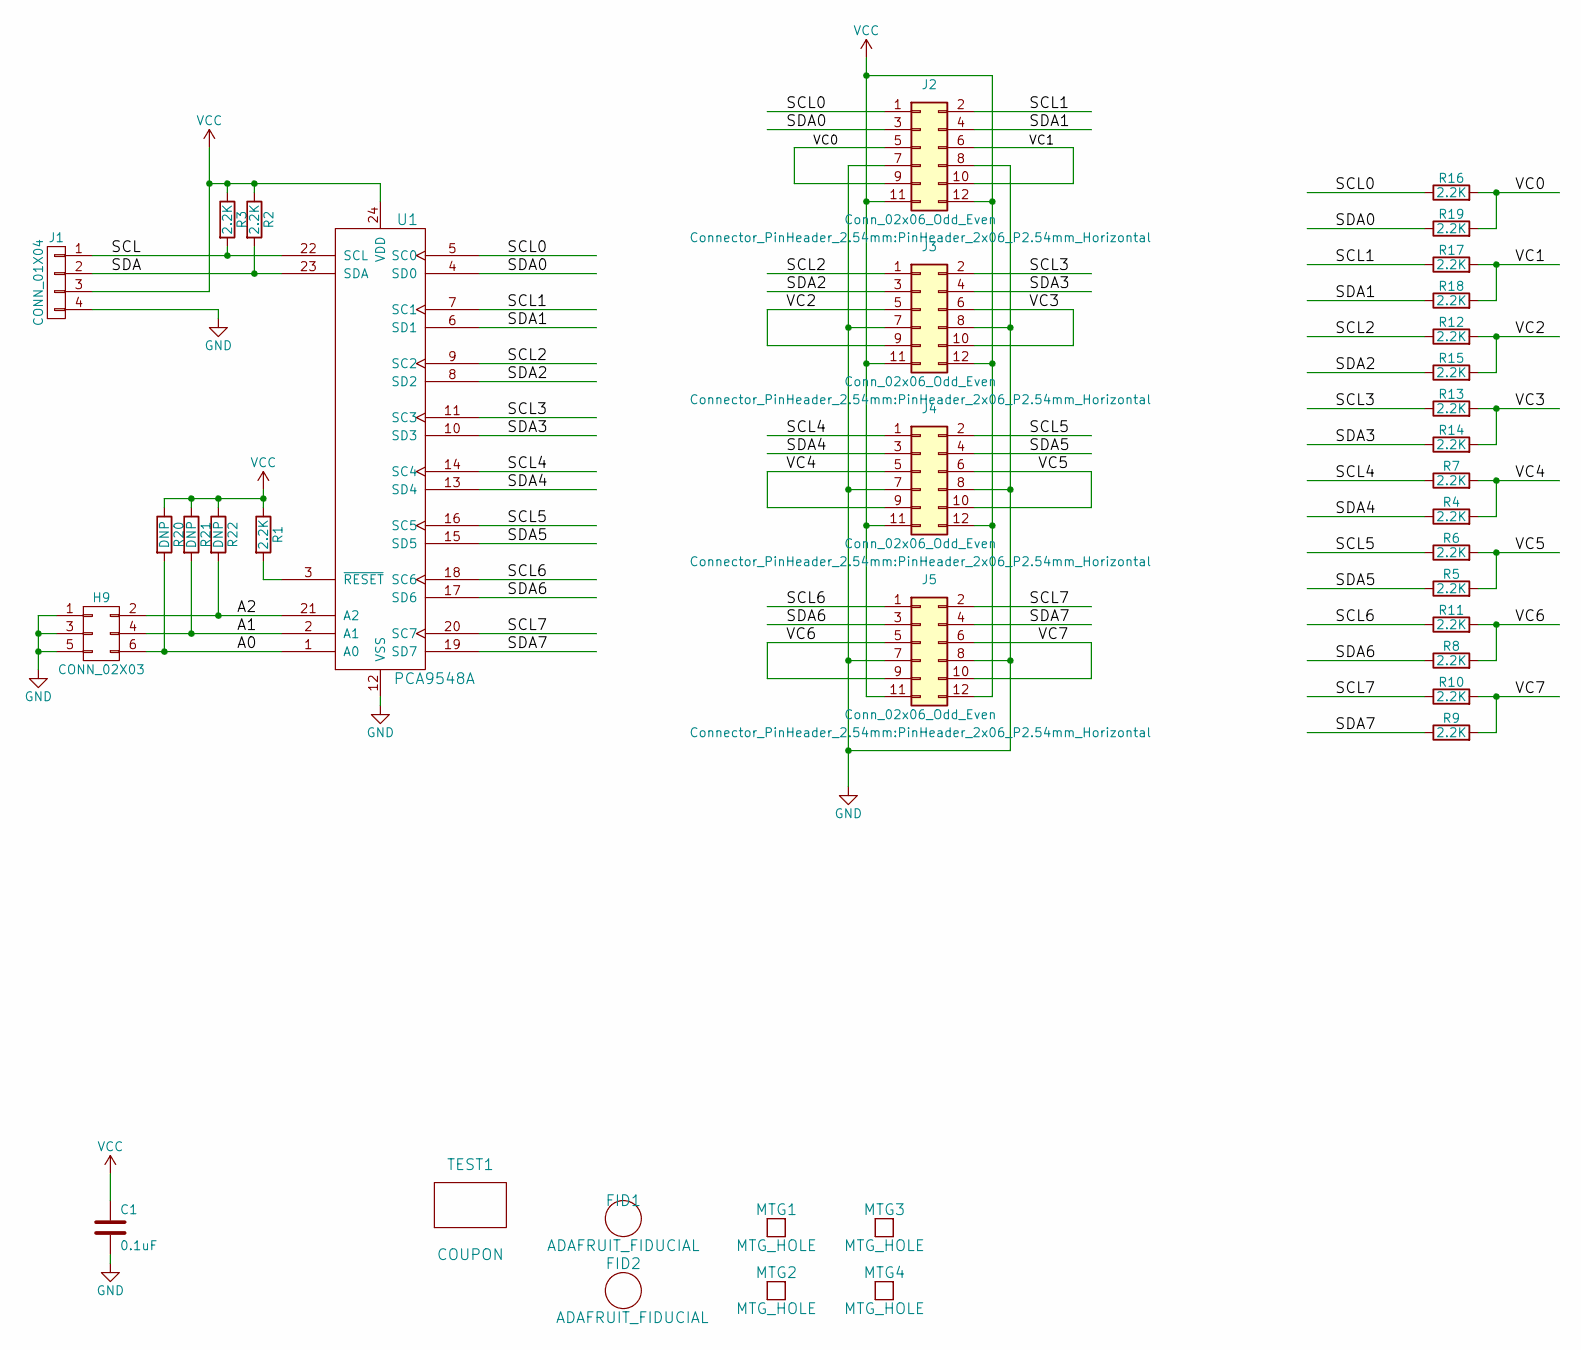
[picture p636: schematic I2C-RPT-08.kicad_sch]

Parts:
C1: 0.1uF; R_0805_HandSoldering
FID1, FID2: ADAFRUIT_FIDUCIAL; FIDUCIAL
H9: CONN_02X03; Pin_Header_Straight_2x03_Pitch2.54mm
J1: CONN_01X04; Pin_Header_Angled_1x04_Pitch2.54mm
J2, J3, J4, J5: Conn_02x06_Odd_Even; PinHeader_2x06_P2.54mm_Horizontal
MTG1, MTG2, MTG3, MTG4: MTG_HOLE; MTG-4-40
R1, R2, R3, R4, R5, R6, R7, R8, R9, R10, R11, R12, R13, R14, R15, R16, R17, R18, R19: 2.2K; R_0805_HandSoldering
R20, R21, R22: DNP; R_0805_HandSoldering
TEST1: COUPON; TEST_BLK-REAR
U1: PCA9548A; SOIC-24W_7.5x15.4mm_Pitch1.27mm

Connections:
A0: H9.6, R20.2, U1.1 (A0)
A1: H9.4, R21.2, U1.2 (A1)
A2: H9.2, R22.2, U1.21 (A2)
GND: C1.2, H9.1, H9.3, H9.5, J1.4, J2.7, J2.8, J3.7, J3.8, J4.7, J4.8, J5.7, J5.8, U1.12 (VSS)
unnamed: R1.2, U1.3 (~RESET)
SCL: J1.1, R3.2, U1.22 (SCL)
SCL0: J2.1, R16.1, U1.5 (SC0)
SCL1: J2.2, R17.1, U1.7 (SC1)
SCL2: J3.1, R12.1, U1.9 (SC2)
SCL3: J3.2, R13.1, U1.11 (SC3)
SCL4: J4.1, R7.1, U1.14 (SC4)
SCL5: J4.2, R6.1, U1.16 (SC5)
SCL6: J5.1, R11.1, U1.18 (SC6)
SCL7: J5.2, R10.1, U1.20 (SC7)
SDA: J1.2, R2.2, U1.23 (SDA)
SDA0: J2.3, R19.1, U1.4 (SD0)
SDA1: J2.4, R18.1, U1.6 (SD1)
SDA2: J3.3, R15.1, U1.8 (SD2)
SDA3: J3.4, R14.1, U1.10 (SD3)
SDA4: J4.3, R4.1, U1.13 (SD4)
SDA5: J4.4, R5.1, U1.15 (SD5)
SDA6: J5.3, R8.1, U1.17 (SD6)
SDA7: J5.4, R9.1, U1.19 (SD7)
VC0: J2.5, J2.9, R16.2, R19.2
VC1: J2.6, J2.10, R17.2, R18.2
VC2: J3.5, J3.9, R12.2, R15.2
VC3: J3.6, J3.10, R13.2, R14.2
VC4: J4.5, J4.9, R4.2, R7.2
VC5: J4.6, J4.10, R5.2, R6.2
VC6: J5.5, J5.9, R8.2, R11.2
VC7: J5.6, J5.10, R9.2, R10.2
VCC: C1.1, J1.3, J2.11, J2.12, J3.11, J3.12, J4.11, J4.12, J5.11, J5.12, R1.1, R2.1, R3.1, R20.1, R21.1, R22.1, U1.24 (VDD)
