land-boards/lb-boards/I2C Cards/I2C-SERIAL/I2C-SERIAL.kicad_sch

## KiCad design I2C Cards/I2C-SERIAL/I2C-SERIAL.kicad_sch (2022-10-10)

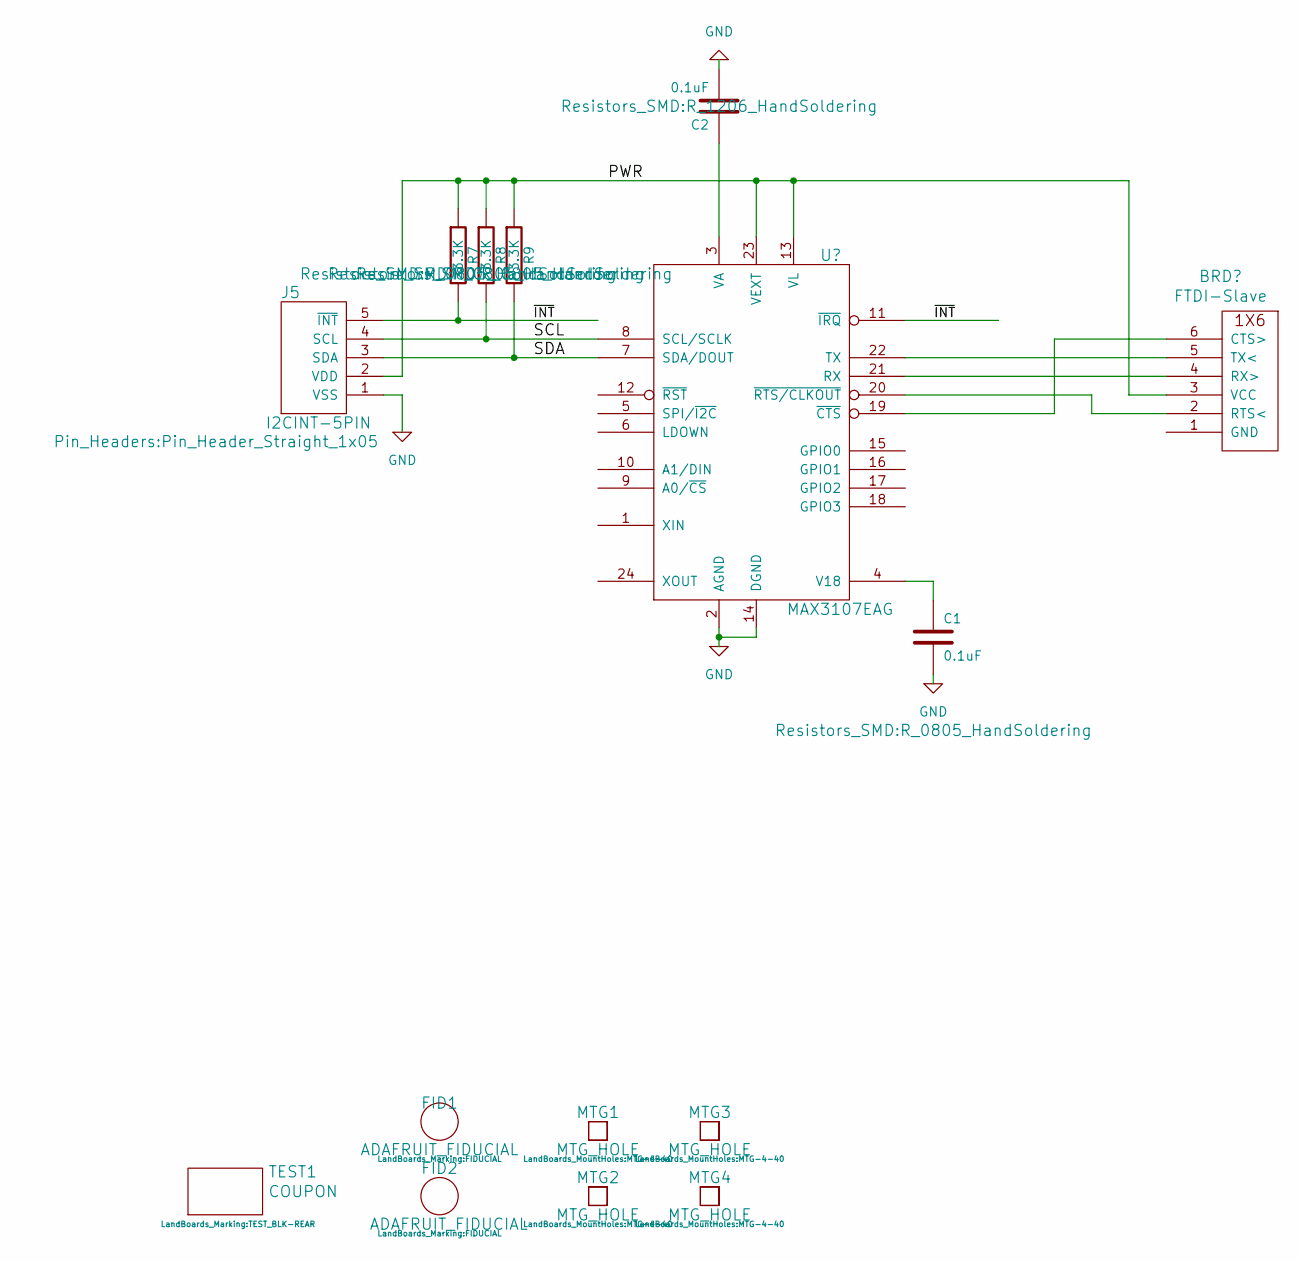
[picture p637: schematic I2C-SERIAL.kicad_sch]

Parts:
C1: 0.1uF; R_0805_HandSoldering
C2: 0.1uF; R_1206_HandSoldering
FID1, FID2: ADAFRUIT_FIDUCIAL; FIDUCIAL
J5: I2CINT-5PIN; Pin_Header_Straight_1x05
MTG1, MTG2, MTG3, MTG4: MTG_HOLE; MTG-4-40
R7, R8, R9: 3.3K; R_0805_HandSoldering
TEST1: COUPON; TEST_BLK-REAR

Connections:
GND: C1.2, C2.2
PWR: J5.2 (VDD), R7.1, R8.1, R9.1
SCL: J5.4 (SCL), R8.2
SDA: J5.3 (SDA), R9.2
~INT: J5.5 (~INT), R7.2
