land-boards/lb-boards/I2C Cards/I2CIO16-DB25/I2CIO16-DB25.kicad_sch

## KiCad design I2C Cards/I2CIO16-DB25/I2CIO16-DB25.kicad_sch (2022-10-10)

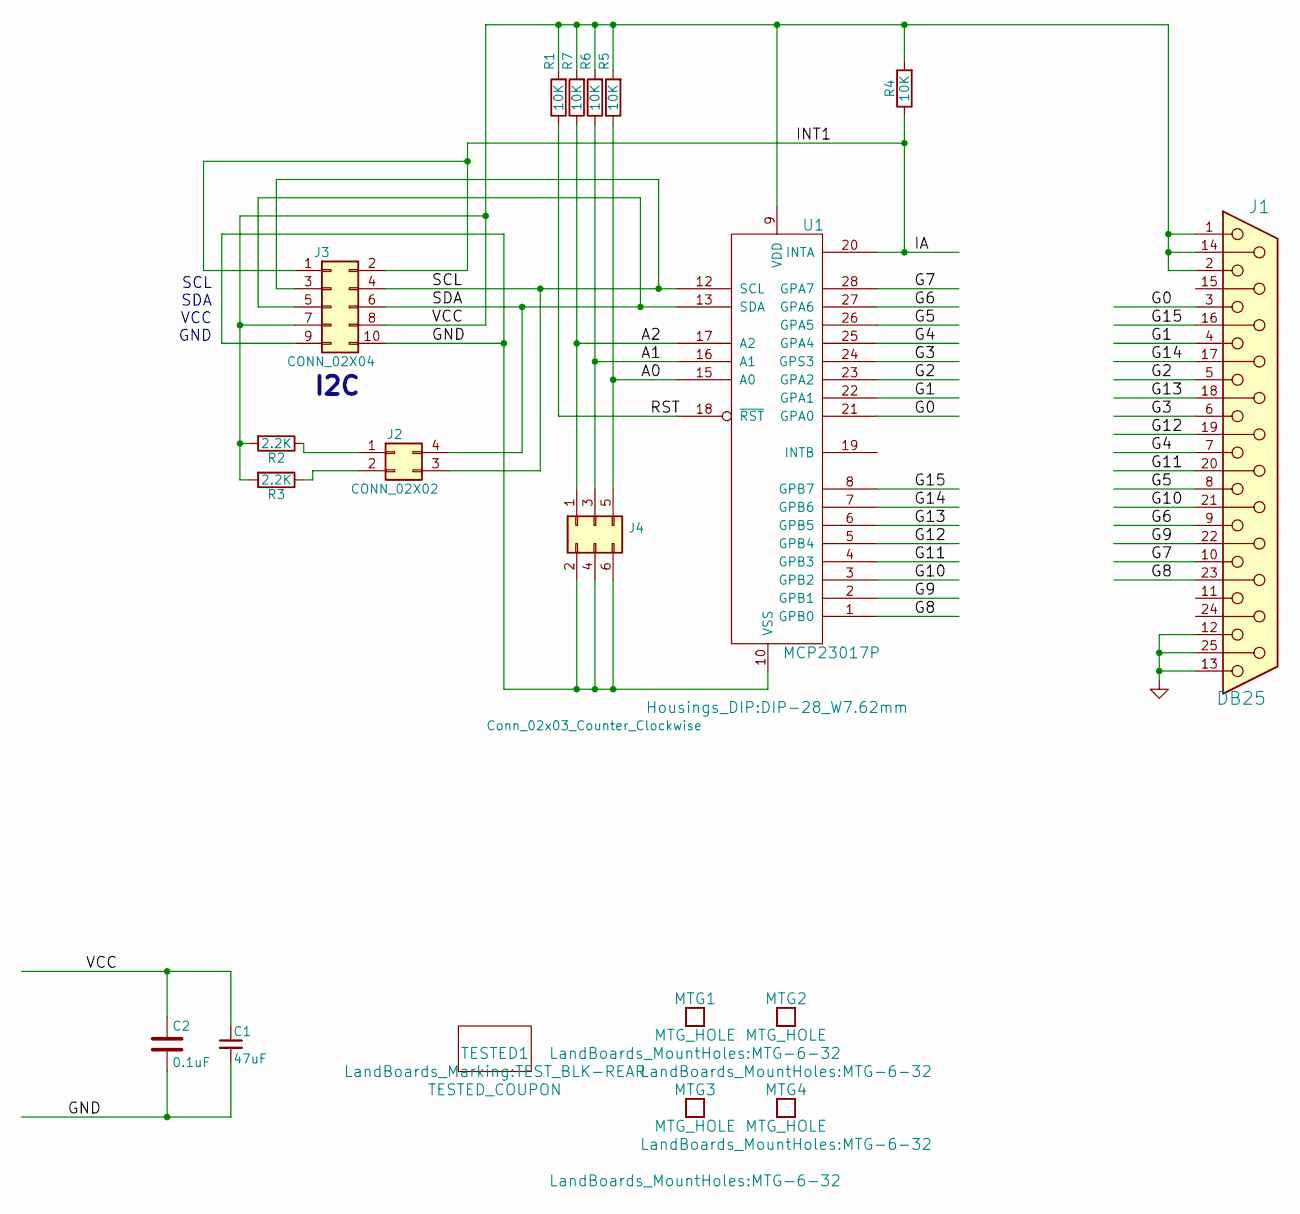
[picture p638: schematic I2CIO16-DB25.kicad_sch]

Parts:
C1: 47uF; C_Radial_D5_L11_P2.5
C2: 0.1uF; C_Rect_L7_W2_P5
J1: DB25; DB25FC
J2: CONN_02X02; PinHeader_2x02_P2.54mm_Horizontal
J3: CONN_02X04; PinHeader_2x05_P2.54mm_Horizontal
J4: Conn_02x03_Counter_Clockwise; PinHeader_2x03_P2.54mm_Horizontal
MTG1, MTG2, MTG3, MTG4: MTG_HOLE; MTG-6-32
R1, R4, R5, R6, R7: 10K; R_Axial_DIN0207_L6.3mm_D2.5mm_P10.16mm_Horizontal
R2, R3: 2.2K; R_Axial_DIN0207_L6.3mm_D2.5mm_P10.16mm_Horizontal
TESTED1: TESTED_COUPON; TEST_BLK-REAR
U1: MCP23017P; DIP-28_W7.62mm

Connections:
A0: J4.5, R5.1, U1.15 (A0)
A1: J4.3, R6.1, U1.16 (A1)
A2: J4.1, R7.1, U1.17 (A2)
G0: J1.3, U1.21 (GPA0)
G1: J1.4, U1.22 (GPA1)
G2: J1.5, U1.23 (GPA2)
G3: J1.6, U1.24 (GPS3)
G4: J1.7, U1.25 (GPA4)
G5: J1.8, U1.26 (GPA5)
G6: J1.9, U1.27 (GPA6)
G7: J1.10, U1.28 (GPA7)
G8: J1.23, U1.1 (GPB0)
G9: J1.22, U1.2 (GPB1)
G10: J1.21, U1.3 (GPB2)
G11: J1.20, U1.4 (GPB3)
G12: J1.19, U1.5 (GPB4)
G13: J1.18, U1.6 (GPB5)
G14: J1.17, U1.7 (GPB6)
G15: J1.16, U1.8 (GPB7)
GND: C1.2, C2.2, J1.12, J1.13, J1.25, J3.9, J3.10, J4.2, J4.4, J4.6, U1.10 (VSS)
IA: J3.1, J3.2, R4.1, U1.20 (INTA)
unnamed: J2.1, R2.1
unnamed: J2.2, R3.1
RST: R1.1, U1.18 (~RST)
SCL: J2.3, J3.3, J3.4, U1.12 (SCL)
SDA: J2.4, J3.5, J3.6, U1.13 (SDA)
VCC: C1.1, C2.1, J1.1, J1.2, J1.14, J3.7, J3.8, R1.2, R2.2, R3.2, R4.2, R5.2, R6.2, R7.2, U1.9 (VDD)

Notes on the sheet:
SCL SDA VCC GND
I2C
