land-boards/lb-boards/I2C Cards/I2CIO-8/I2CIO-8.kicad_sch

## KiCad design I2C Cards/I2CIO-8/I2CIO-8.kicad_sch (2022-10-10)

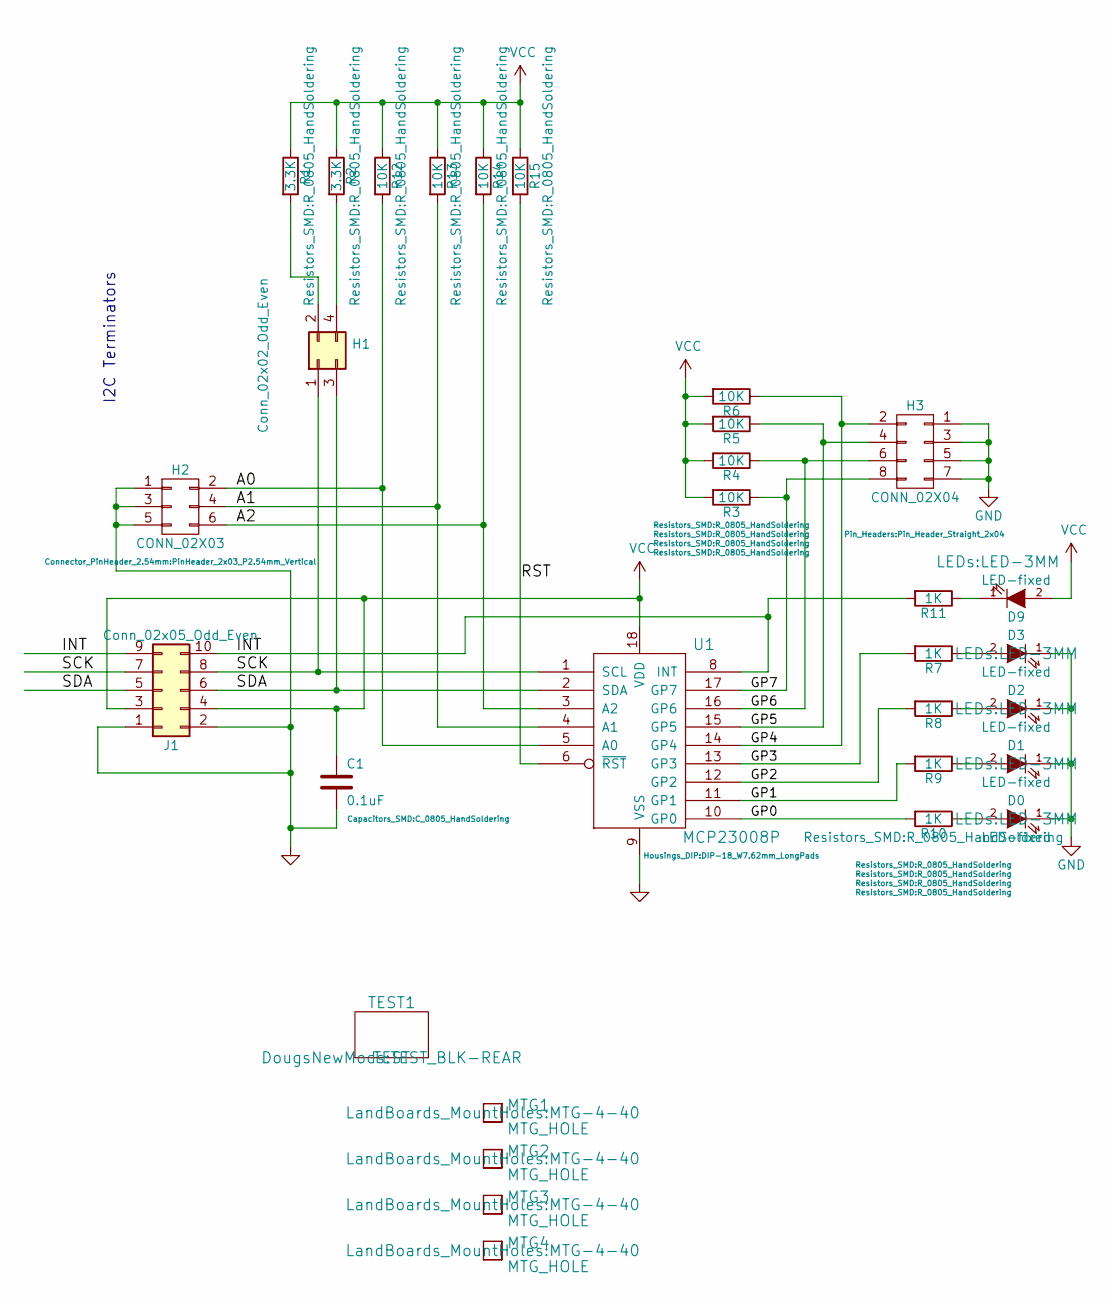
[picture p639: schematic I2CIO-8.kicad_sch]

Parts:
C1: 0.1uF; C_0805_HandSoldering
D0, D1, D2, D3, D9: LED-fixed; LED-3MM
H1: Conn_02x02_Odd_Even; PinHeader_2x02_P2.54mm_Vertical
H2: CONN_02X03; PinHeader_2x03_P2.54mm_Vertical
H3: CONN_02X04; Pin_Header_Straight_2x04
J1: Conn_02x05_Odd_Even; PinHeader_2x05_P2.54mm_Horizontal
MTG1, MTG2, MTG3, MTG4: MTG_HOLE; MTG-4-40
R1, R2: 3.3K; R_0805_HandSoldering
R3, R4, R5, R6, R12, R13, R14, R15: 10K; R_0805_HandSoldering
R7, R8, R9, R10, R11: 1K; R_0805_HandSoldering
TEST1: TEST; TEST_BLK-REAR
U1: MCP23008P; DIP-18_W7.62mm_LongPads

Connections:
A0: H2.2, R12.2, U1.5 (A0)
A1: H2.4, R13.2, U1.4 (A1)
A2: H2.6, R14.2, U1.3 (A2)
GND: C1.2, D0.1 (K), D1.1 (K), D2.1 (K), D3.1 (K), H2.1, H2.3, H2.5, H3.1, H3.3, H3.5, H3.7, J1.1, J1.2, U1.9 (VSS)
GP0: R10.2, U1.10 (GP0)
GP1: R9.2, U1.11 (GP1)
GP2: R8.2, U1.12 (GP2)
GP3: R7.2, U1.13 (GP3)
GP4: H3.2, R6.1, U1.14 (GP4)
GP5: H3.4, R5.1, U1.15 (GP5)
GP6: H3.6, R4.1, U1.16 (GP6)
GP7: H3.8, R3.1, U1.17 (GP7)
INT: J1.9, J1.10, R11.2, U1.8 (INT)
unnamed: D0.2 (A), R10.1
unnamed: D1.2 (A), R9.1
unnamed: D2.2 (A), R8.1
unnamed: D3.2 (A), R7.1
unnamed: D9.1 (K), R11.1
unnamed: H1.2, R1.2
unnamed: H1.4, R2.2
RST: R15.2, U1.6 (~RST)
SCK: H1.1, J1.7, J1.8, U1.1 (SCL)
SDA: H1.3, J1.5, J1.6, U1.2 (SDA)
VCC: C1.1, D9.2 (A), J1.3, J1.4, R1.1, R2.1, R3.2, R4.2, R5.2, R6.2, R12.1, R13.1, R14.1, R15.1, U1.18 (VDD)

Notes on the sheet:
I2C Terminators
