land-boards/lb-boards/I2C Cards/I2CIO-8X/I2CIO-8X.sch

## KiCad design I2C Cards/I2CIO-8X/I2CIO-8X.sch (2022-04-09)

Schematic: I2CIO-8X.sch

Parts:
C1: 0.1uF; C_0805_HandSoldering
H2, H3: CONN_2; Pin_Header_Straight_1x02
H4: CONN_02X03; Pin_Header_Straight_2x03
J1, J2: CONN_01X05; Pin_Header_Angled_1x05
MTG1, MTG2, MTG3, MTG4: CONN_1
MTG5, MTG6, MTG7: MTG_HOLE; MTG-4-40
MTG?1: MTG_HOLE; MTG-4-40
P1: CONN_01X24; Pin_Header_Straight_3x08
R1, R2: 2.2K; R_0805_HandSoldering
R3, R4, R5, R6: 10K; R_0805_HandSoldering
TEST1: TEST; TEST_BLK-REAR
U1: MCP23008P; DIP-18_W7.62mm_LongPads

Notes on the sheet:
I2C Terminators
INT SCK SDA +V GND
