land-boards/lb-boards/I2C Cards/Proto16-I2C/Proto16-I2C.kicad_sch

## KiCad design I2C Cards/Proto16-I2C/Proto16-I2C.kicad_sch (2022-10-10)

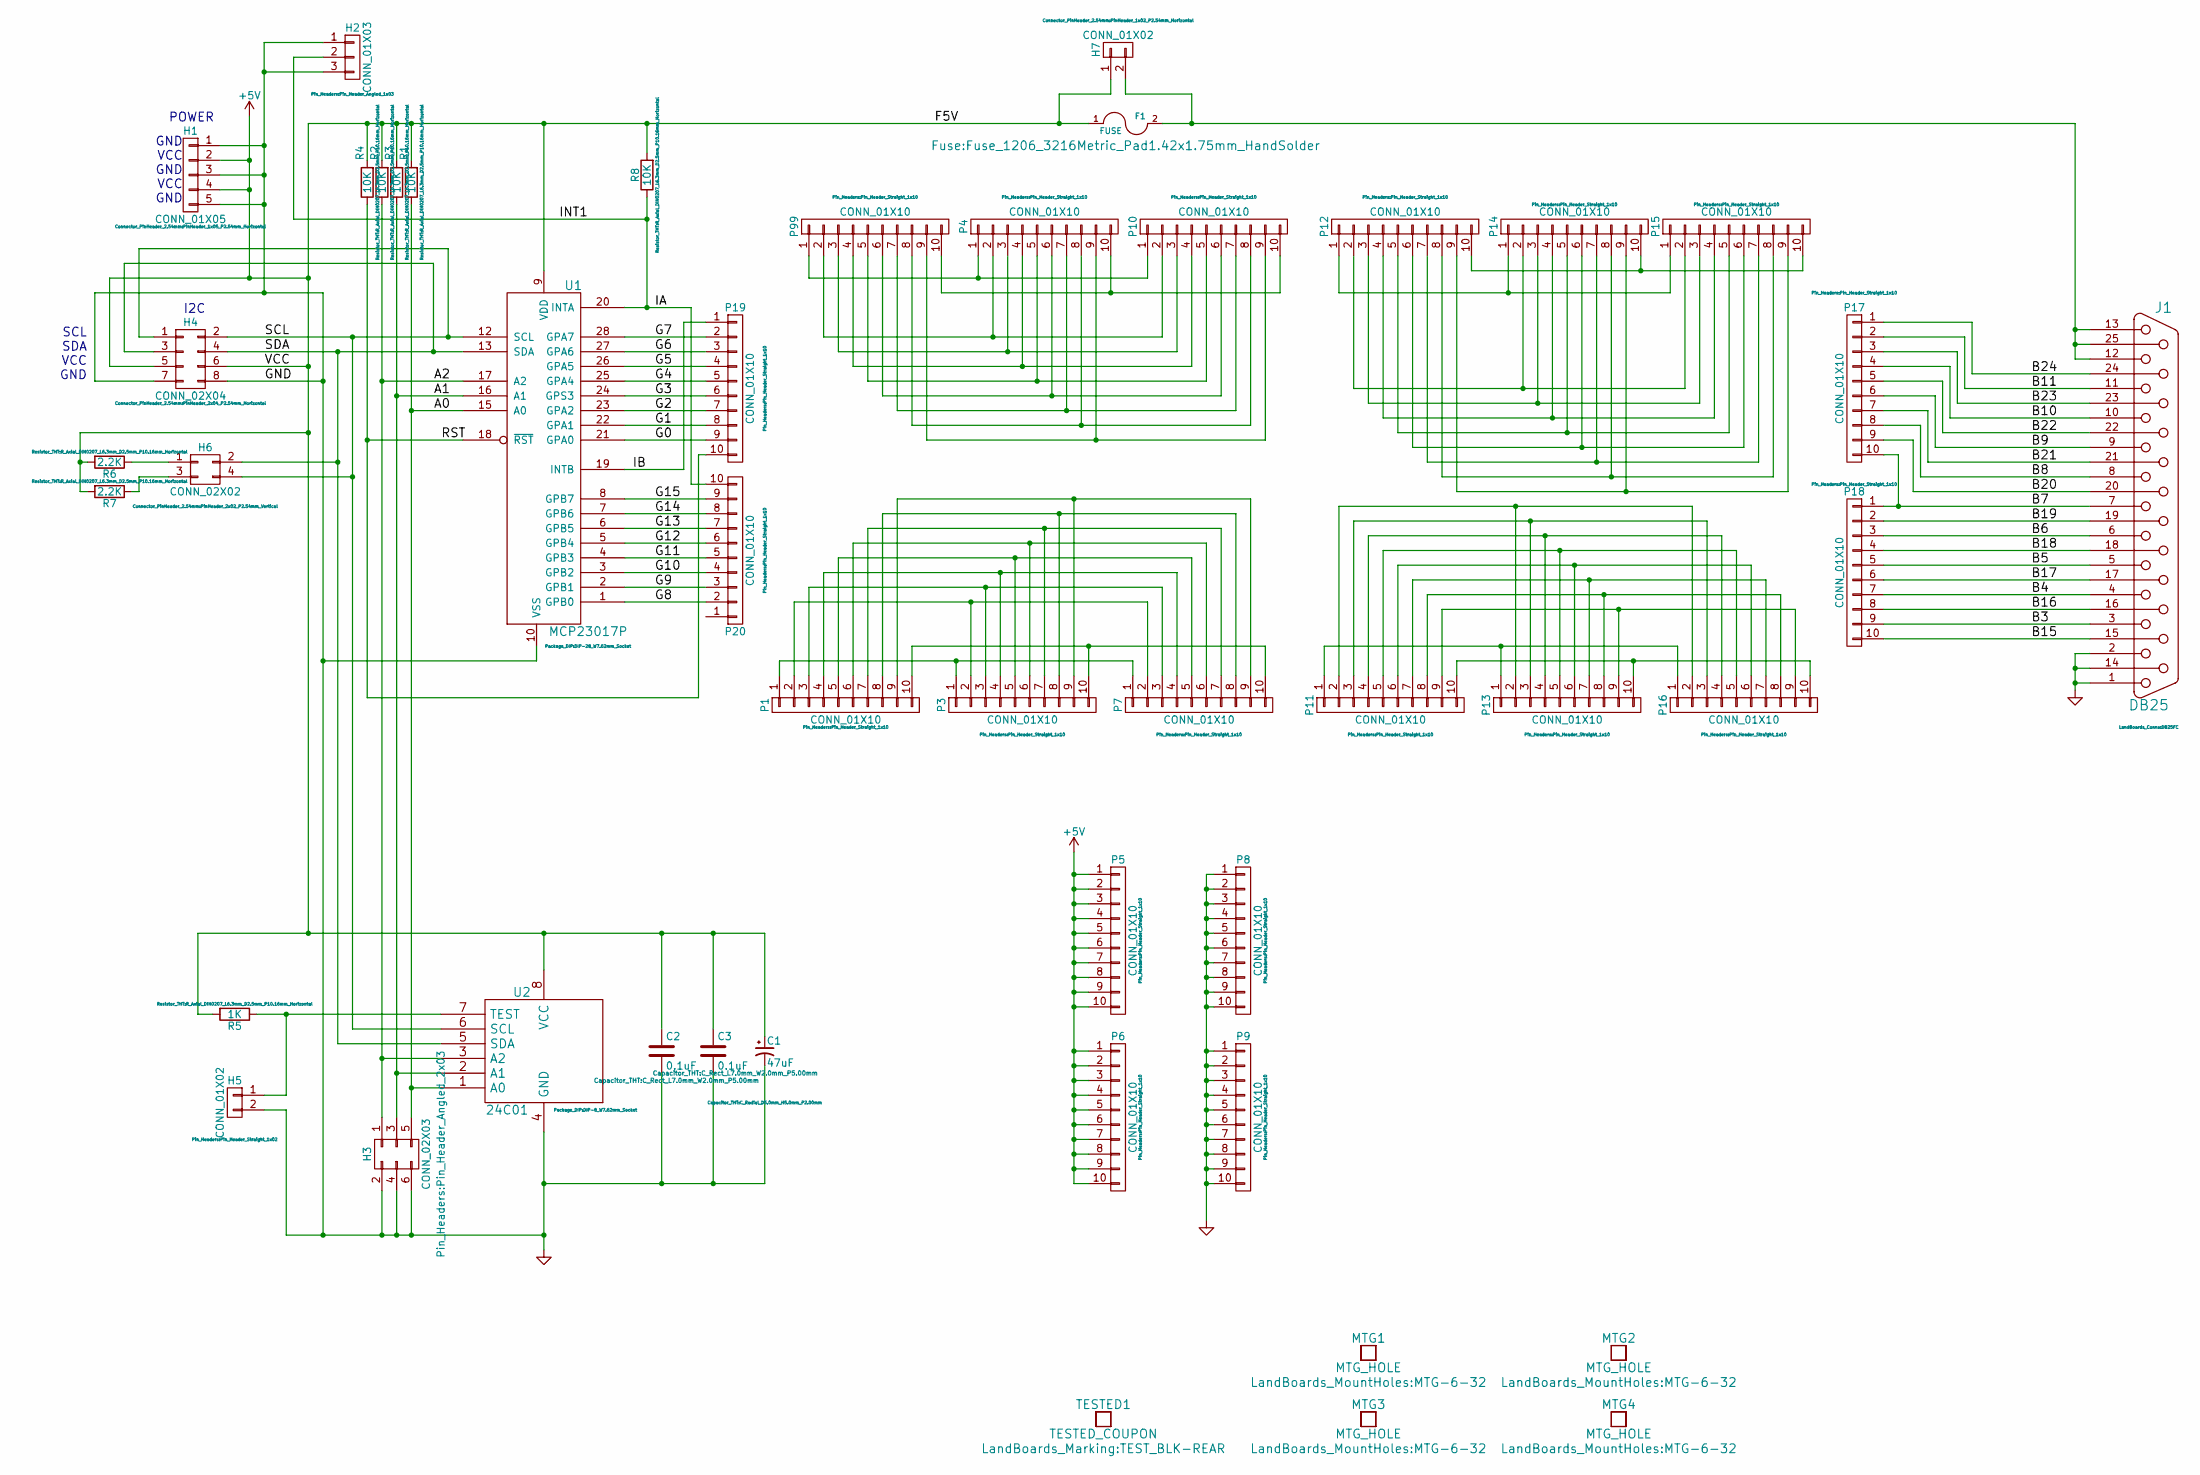
[picture p640: schematic Proto16-I2C.kicad_sch]

Parts:
C1: 47uF; C_Radial_D5.0mm_H5.0mm_P2.00mm
C2, C3: 0.1uF; C_Rect_L7.0mm_W2.0mm_P5.00mm
F1: FUSE; Fuse_1206_3216Metric_Pad1.42x1.75mm_HandSolder
H1: CONN_01X05; PinHeader_1x05_P2.54mm_Horizontal
H2: CONN_01X03; Pin_Header_Angled_1x03
H3: CONN_02X03; Pin_Header_Angled_2x03
H4: CONN_02X04; PinHeader_2x04_P2.54mm_Horizontal
H5: CONN_01X02; Pin_Header_Straight_1x02
H6: CONN_02X02; PinHeader_2x02_P2.54mm_Vertical
H7: CONN_01X02; PinHeader_1x02_P2.54mm_Horizontal
J1: DB25; DB25FC
MTG1, MTG2, MTG3, MTG4: MTG_HOLE; MTG-6-32
P1, P3, P4, P5, P6, P7, P8, P9, P10, P11, P12, P13, P14, P15, P16, P17, P18, P19, P20, P99: CONN_01X10; Pin_Header_Straight_1x10
R1, R2, R3, R4, R8: 10K; R_Axial_DIN0207_L6.3mm_D2.5mm_P10.16mm_Horizontal
R5: 1K; R_Axial_DIN0207_L6.3mm_D2.5mm_P10.16mm_Horizontal
R6, R7: 2.2K; R_Axial_DIN0207_L6.3mm_D2.5mm_P10.16mm_Horizontal
TESTED1: TESTED_COUPON; TEST_BLK-REAR
U1: MCP23017P; DIP-28_W7.62mm_Socket
U2: 24C01; DIP-8_W7.62mm_Socket

Connections:
+5V: C1.1, C2.1, C3.1, F1.1, H1.2, H1.4, H4.5, H4.6, H7.1, P5.1, P5.2, P5.3, P5.4, P5.5, P5.6, P5.7, P5.8, P5.9, P5.10, P6.1, P6.2, P6.3, P6.4, P6.5, P6.6, P6.7, P6.8, P6.9, P6.10, R1.2, R2.2, R3.2, R4.2, R5.2, R6.2, R7.2, R8.2, U1.9 (VDD), U2.8 (VCC)
A0: H3.5, R1.1, U1.15 (A0), U2.1 (A0)
A1: H3.3, R3.1, U1.16 (A1), U2.2 (A1)
A2: H3.1, R2.1, U1.17 (A2), U2.3 (A2)
B3: J1.3, P18.9
B4: J1.4, P18.7
B5: J1.5, P18.5
B6: J1.6, P18.3
B7: J1.7, P17.10, P18.1
B8: J1.8, P17.8
B9: J1.9, P17.6
B10: J1.10, P17.4
B11: J1.11, P17.2
B15: J1.15, P18.10
B16: J1.16, P18.8
B17: J1.17, P18.6
B18: J1.18, P18.4
B19: J1.19, P18.2
B20: J1.20, P17.9
B21: J1.21, P17.7
B22: J1.22, P17.5
B23: J1.23, P17.3
B24: J1.24, P17.1
G0: P19.9, U1.21 (GPA0)
G1: P19.8, U1.22 (GPA1)
G2: P19.7, U1.23 (GPA2)
G3: P19.6, U1.24 (GPS3)
G4: P19.5, U1.25 (GPA4)
G5: P19.4, U1.26 (GPA5)
G6: P19.3, U1.27 (GPA6)
G7: P19.2, U1.28 (GPA7)
G8: P20.2, U1.1 (GPB0)
G9: P20.3, U1.2 (GPB1)
G10: P20.4, U1.3 (GPB2)
G11: P20.5, U1.4 (GPB3)
G12: P20.6, U1.5 (GPB4)
G13: P20.7, U1.6 (GPB5)
G14: P20.8, U1.7 (GPB6)
G15: P20.9, U1.8 (GPB7)
GND: C1.2, C2.2, C3.2, H1.1, H1.3, H1.5, H2.1, H2.3, H3.2, H3.4, H3.6, H4.7, H4.8, H5.2, J1.1, J1.2, J1.14, P8.1, P8.2, P8.3, P8.4, P8.5, P8.6, P8.7, P8.8, P8.9, P8.10, P9.1, P9.2, P9.3, P9.4, P9.5, P9.6, P9.7, P9.8, P9.9, P9.10, U1.10 (VSS), U2.4 (GND)
IA: H2.2, P20.10, R8.1, U1.20 (INTA)
IB: P19.1, U1.19 (INTB)
unnamed: F1.2, H7.2, J1.12, J1.13, J1.25
unnamed: H5.1, R5.1, U2.7 (TEST)
unnamed: H6.1, R6.1
unnamed: H6.3, R7.1
unnamed: P1.1, P3.1, P7.1
unnamed: P1.2, P3.2, P7.2
unnamed: P1.3, P3.3, P7.3
unnamed: P1.4, P3.4, P7.4
unnamed: P1.5, P3.5, P7.5
unnamed: P1.6, P3.6, P7.6
unnamed: P1.7, P3.7, P7.7
unnamed: P1.8, P3.8, P7.8
unnamed: P1.9, P3.9, P7.9
unnamed: P1.10, P3.10, P7.10
unnamed: P4.1, P10.1, P99.1
unnamed: P4.2, P10.2, P99.2
unnamed: P4.3, P10.3, P99.3
unnamed: P4.4, P10.4, P99.4
unnamed: P4.5, P10.5, P99.5
unnamed: P4.6, P10.6, P99.6
unnamed: P4.7, P10.7, P99.7
unnamed: P4.8, P10.8, P99.8
unnamed: P4.9, P10.9, P99.9
unnamed: P4.10, P10.10, P99.10
unnamed: P11.1, P13.1, P16.1
unnamed: P11.2, P13.2, P16.2
unnamed: P11.3, P13.3, P16.3
unnamed: P11.4, P13.4, P16.4
unnamed: P11.5, P13.5, P16.5
unnamed: P11.6, P13.6, P16.6
unnamed: P11.7, P13.7, P16.7
unnamed: P11.8, P13.8, P16.8
unnamed: P11.9, P13.9, P16.9
unnamed: P11.10, P13.10, P16.10
unnamed: P12.1, P14.1, P15.1
unnamed: P12.2, P14.2, P15.2
unnamed: P12.3, P14.3, P15.3
unnamed: P12.4, P14.4, P15.4
unnamed: P12.5, P14.5, P15.5
unnamed: P12.6, P14.6, P15.6
unnamed: P12.7, P14.7, P15.7
unnamed: P12.8, P14.8, P15.8
unnamed: P12.9, P14.9, P15.9
unnamed: P12.10, P14.10, P15.10
RST: P19.10, R4.1, U1.18 (~RST)
SCL: H4.1, H4.2, H6.4, U1.12 (SCL), U2.6 (SCL)
SDA: H4.3, H4.4, H6.2, U1.13 (SDA), U2.5 (SDA)

Notes on the sheet:
SCL SDA VCC GND
POWER
GND VCC GND VCC GND
I2C
