land-boards/lb-boards/I2C Cards/SWLEDX8-I2C/SWLEDX8-I2C.kicad_sch

## KiCad design I2C Cards/SWLEDX8-I2C/SWLEDX8-I2C.kicad_sch (2022-10-10)

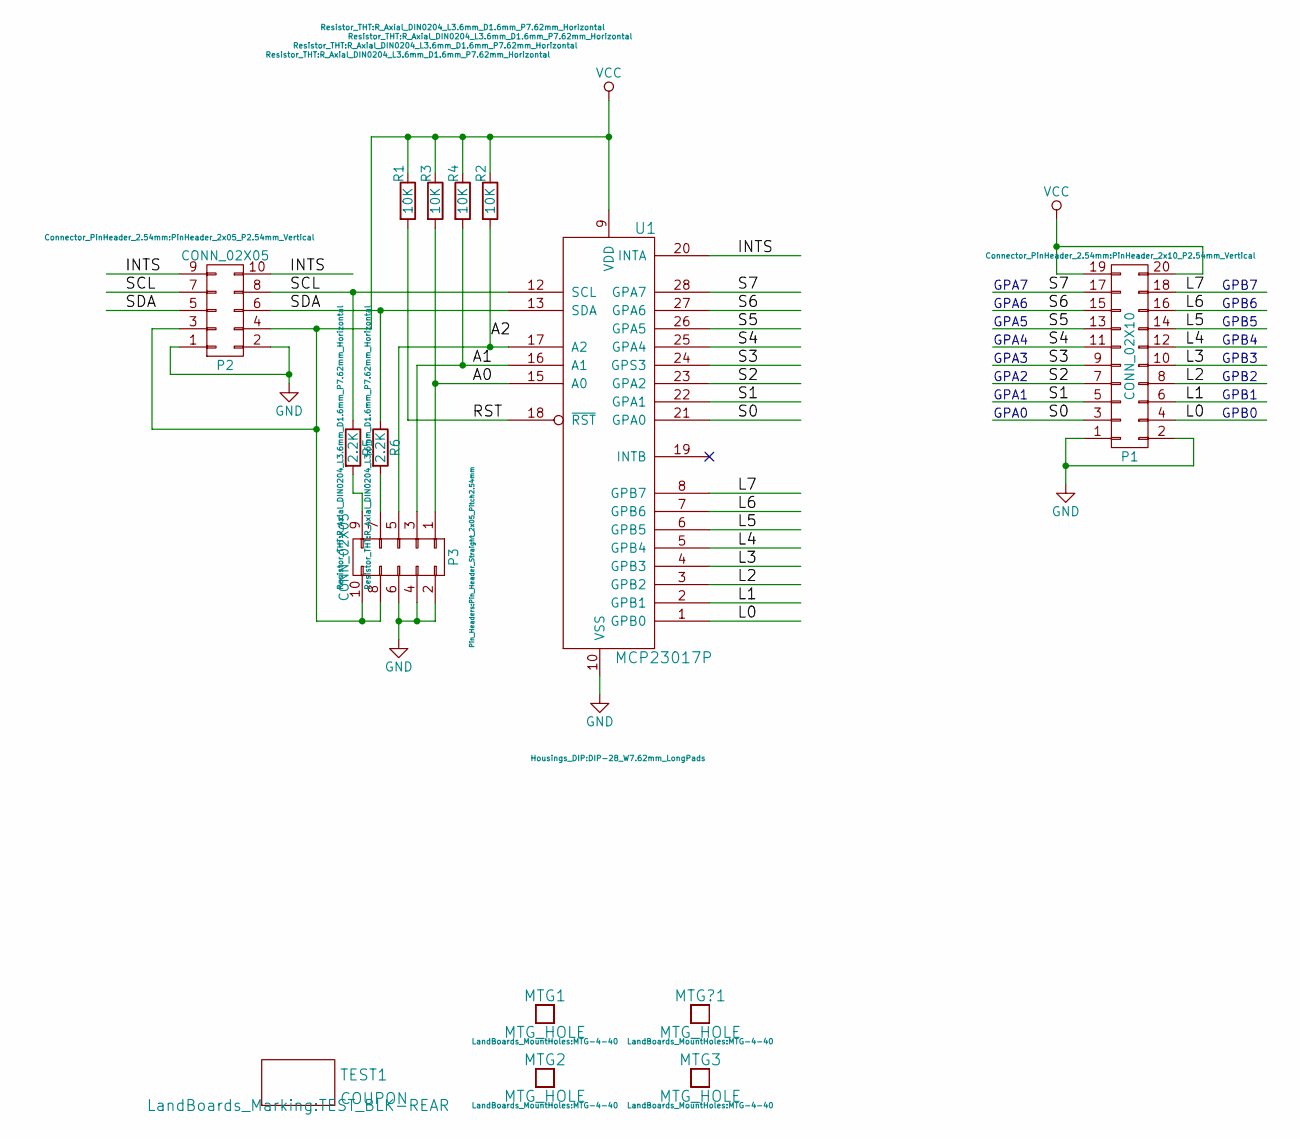
[picture p641: schematic SWLEDX8-I2C.kicad_sch]

Parts:
MTG1, MTG2, MTG3: MTG_HOLE; MTG-4-40
MTG?1: MTG_HOLE; MTG-4-40
P1: CONN_02X10; PinHeader_2x10_P2.54mm_Vertical
P2: CONN_02X05; PinHeader_2x05_P2.54mm_Vertical
P3: CONN_02X05; Pin_Header_Straight_2x05_Pitch2.54mm
R1, R2, R3, R4: 10K; R_Axial_DIN0204_L3.6mm_D1.6mm_P7.62mm_Horizontal
R5, R6: 2.2K; R_Axial_DIN0204_L3.6mm_D1.6mm_P7.62mm_Horizontal
TEST1: COUPON; TEST_BLK-REAR
U1: MCP23017P; DIP-28_W7.62mm_LongPads

Connections:
A0: P3.1, R3.2, U1.15 (A0)
A1: P3.3, R4.2, U1.16 (A1)
A2: P3.5, R2.2, U1.17 (A2)
GND: P1.1, P1.2, P2.1, P2.2, U1.10 (VSS)
INTS: P2.9, P2.10, U1.20 (INTA)
L0: P1.4, U1.1 (GPB0)
L1: P1.6, U1.2 (GPB1)
L2: P1.8, U1.3 (GPB2)
L3: P1.10, U1.4 (GPB3)
L4: P1.12, U1.5 (GPB4)
L5: P1.14, U1.6 (GPB5)
L6: P1.16, U1.7 (GPB6)
L7: P1.18, U1.8 (GPB7)
unnamed: P3.2, P3.4, P3.6
unnamed: P3.7, R6.2
unnamed: P3.9, R5.2
RST: R1.2, U1.18 (~RST)
S0: P1.3, U1.21 (GPA0)
S1: P1.5, U1.22 (GPA1)
S2: P1.7, U1.23 (GPA2)
S3: P1.9, U1.24 (GPS3)
S4: P1.11, U1.25 (GPA4)
S5: P1.13, U1.26 (GPA5)
S6: P1.15, U1.27 (GPA6)
S7: P1.17, U1.28 (GPA7)
SCL: P2.7, P2.8, R5.1, U1.12 (SCL)
SDA: P2.5, P2.6, R6.1, U1.13 (SDA)
VCC: P1.19, P1.20, P2.3, P2.4, P3.8, P3.10, R1.1, R2.1, R3.1, R4.1, U1.9 (VDD)

Notes on the sheet:
GPB4
GPA0
GPB0
GPB3
GPA3
GPB1
GPA2
GPB2
GPA1
GPA5
GPA4
GPB6
GPB7
GPB5
GPA6
GPA7
