land-boards/lb-boards/I2C Cards/SWLEDX8/SWLEDX8.kicad_sch

## KiCad design I2C Cards/SWLEDX8/SWLEDX8.kicad_sch (2022-10-10)

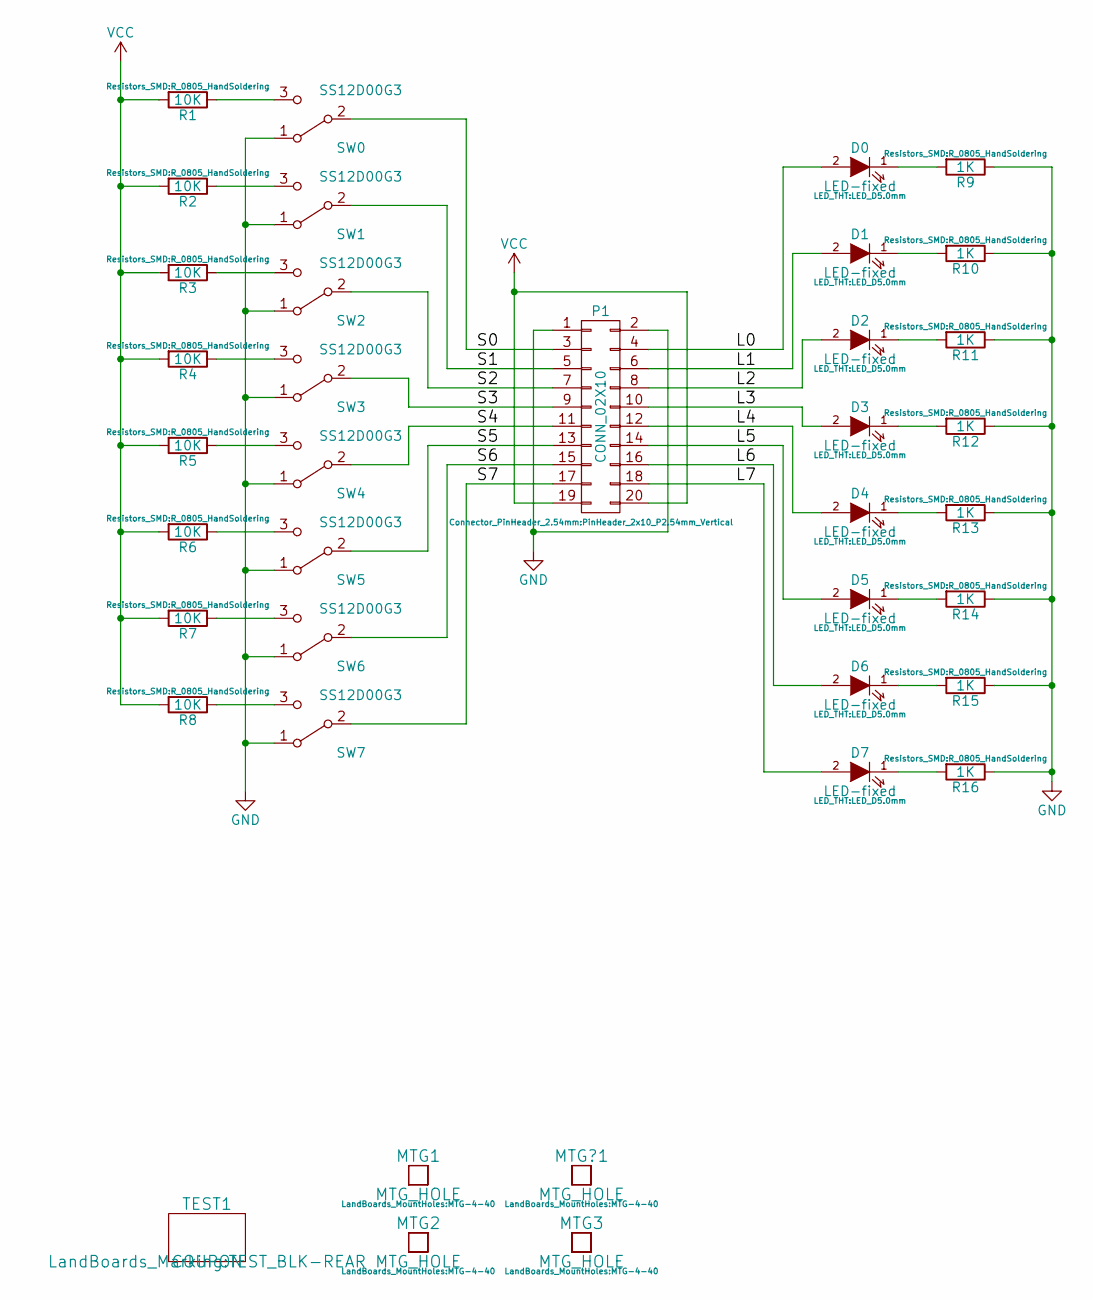
[picture p642: schematic SWLEDX8.kicad_sch]

Parts:
D0, D1, D2, D3, D4, D5, D6, D7: LED-fixed; LED_D5.0mm
MTG1, MTG2, MTG3: MTG_HOLE; MTG-4-40
MTG?1: MTG_HOLE; MTG-4-40
P1: CONN_02X10; PinHeader_2x10_P2.54mm_Vertical
R1, R2, R3, R4, R5, R6, R7, R8: 10K; R_0805_HandSoldering
R9, R10, R11, R12, R13, R14, R15, R16: 1K; R_0805_HandSoldering
SW0, SW1, SW2, SW3, SW4, SW5, SW6, SW7: SS12D00G3; PinHeader_1x03_P2.54mm_Vertical
TEST1: COUPON; TEST_BLK-REAR

Connections:
GND: P1.1, P1.2, R9.1, R10.1, R11.1, R12.1, R13.1, R14.1, R15.1, R16.1, SW0.1 (A), SW1.1 (A), SW2.1 (A), SW3.1 (A), SW4.1 (A), SW5.1 (A), SW6.1 (A), SW7.1 (A)
L0: D0.2 (A), P1.4
L1: D1.2 (A), P1.6
L2: D2.2 (A), P1.8
L3: D3.2 (A), P1.10
L4: D4.2 (A), P1.12
L5: D5.2 (A), P1.14
L6: D6.2 (A), P1.16
L7: D7.2 (A), P1.18
unnamed: D0.1 (K), R9.2
unnamed: D1.1 (K), R10.2
unnamed: D2.1 (K), R11.2
unnamed: D3.1 (K), R12.2
unnamed: D4.1 (K), R13.2
unnamed: D5.1 (K), R14.2
unnamed: D6.1 (K), R15.2
unnamed: D7.1 (K), R16.2
unnamed: R1.1, SW0.3 (C)
unnamed: R2.1, SW1.3 (C)
unnamed: R3.1, SW2.3 (C)
unnamed: R4.1, SW3.3 (C)
unnamed: R5.1, SW4.3 (C)
unnamed: R6.1, SW5.3 (C)
unnamed: R7.1, SW6.3 (C)
unnamed: R8.1, SW7.3 (C)
S0: P1.3, SW0.2 (B)
S1: P1.5, SW1.2 (B)
S2: P1.7, SW2.2 (B)
S3: P1.9, SW3.2 (B)
S4: P1.11, SW4.2 (B)
S5: P1.13, SW5.2 (B)
S6: P1.15, SW6.2 (B)
S7: P1.17, SW7.2 (B)
VCC: P1.19, P1.20, R1.2, R2.2, R3.2, R4.2, R5.2, R6.2, R7.2, R8.2
