land-boards/lb-boards/LEDs Cards/CCLED/CCLED.sch

## KiCad design LEDs Cards/CCLED/CCLED.sch (2018-12-25)

Schematic: CCLED.sch

Parts:
COUP?1: COUPON; TEST_BLK-REAR
D1, D2, D3: LED; LED_1W_3W_R8
MTG1, MTG2, MTG3, MTG4: CONN_1; MTG-4-40
P1: CONN_2; TB2-5MM
P2, P3, P4, P5: CONN_01X02; Pin_Header_Angled_1x02_Pitch2.54mm
Q1, Q2, Q3, Q4, Q5: 2N3904; SOT-23
R1, R3, R5, R7, R9: 22; R_0805_HandSoldering
R2, R4, R6, R8, R10: 10K; R_0805_HandSoldering
U1: LM317AT; TO-220
