land-boards/lb-boards/LEDs Cards/FRONT-8-BIT/FRONT-8-BIT.sch

## KiCad design LEDs Cards/FRONT-8-BIT/FRONT-8-BIT.sch (2021-06-14)

Schematic: FRONT-8-BIT.sch

Parts:
D1, D2, D3, D4, D5, D6, D7, D8, D9, D10, D11, D12, D13, D14, D15, D16, D17, D18, D19: LED-fixed; LED_D5.0mm
J1: Conn_02x25_Odd_Even; PinHeader_2x25_P2.54mm_Horizontal
MTG1, MTG2, MTG3: MTG_HOLE; MTG-6-32
MTG?1: MTG_HOLE; MTG-6-32
R1, R2, R3, R4, R5, R6, R7, R8, R9, R10, R11, R12, R13, R14, R15, R16, R17, R18, R19: 1K; R_Axial_DIN0207_L6.3mm_D2.5mm_P10.16mm_Horizontal
R20, R22, R23, R24, R25, R26, R27, R28, R29, R30, R31, R32, R33, R34, R35, R36, R37, R38, R39, R40, R41: 10K; R_Axial_DIN0207_L6.3mm_D2.5mm_P10.16mm_Horizontal
SW1, SW2, SW3, SW4, SW5, SW6, SW7, SW8, SW9, SW10, SW11, SW12, SW13, SW14: SW_SPDT; PinHeader_1x03_P2.54mm_Vertical
SW15, SW16, SW17, SW18, SW19, SW20, SW21: SW_Push; SW_PUSH_6mm_H8.5mm
TEST1: COUPON; TEST_BLK-REAR
