land-boards/lb-boards/LEDs Cards/LED1W4X/LED1W4X.sch

## KiCad design LEDs Cards/LED1W4X/LED1W4X.sch (2018-12-25)

Schematic: LED1W4X.sch

Parts:
COUP?1: COUPON; TEST_BLK-REAR
D1, D2, D3, D4: LED; LED_1W_3W_R8
MTG1, MTG2, MTG3, MTG4: CONN_1; MTG-4-40-SMALL
P1, P2, P3, P4: CONN_2; TB2-5MM
