land-boards/lb-boards/LEDs Cards/LED1W/LED1W.sch

## KiCad design LEDs Cards/LED1W/LED1W.sch (2018-12-25)

Schematic: LED1W.sch

Parts:
COUP?1: COUPON; TEST_BLK-REAR
D1: LED; LED_1W_3W_R8
MTG1: CONN_1; MTG-4-40
P1: CONN_2; TB2-5MM
