land-boards/lb-boards/LEDs Cards/LED32-DB37/LED32-DB37.kicad_sch

## KiCad design LEDs Cards/LED32-DB37/LED32-DB37.kicad_sch (2023-03-14)

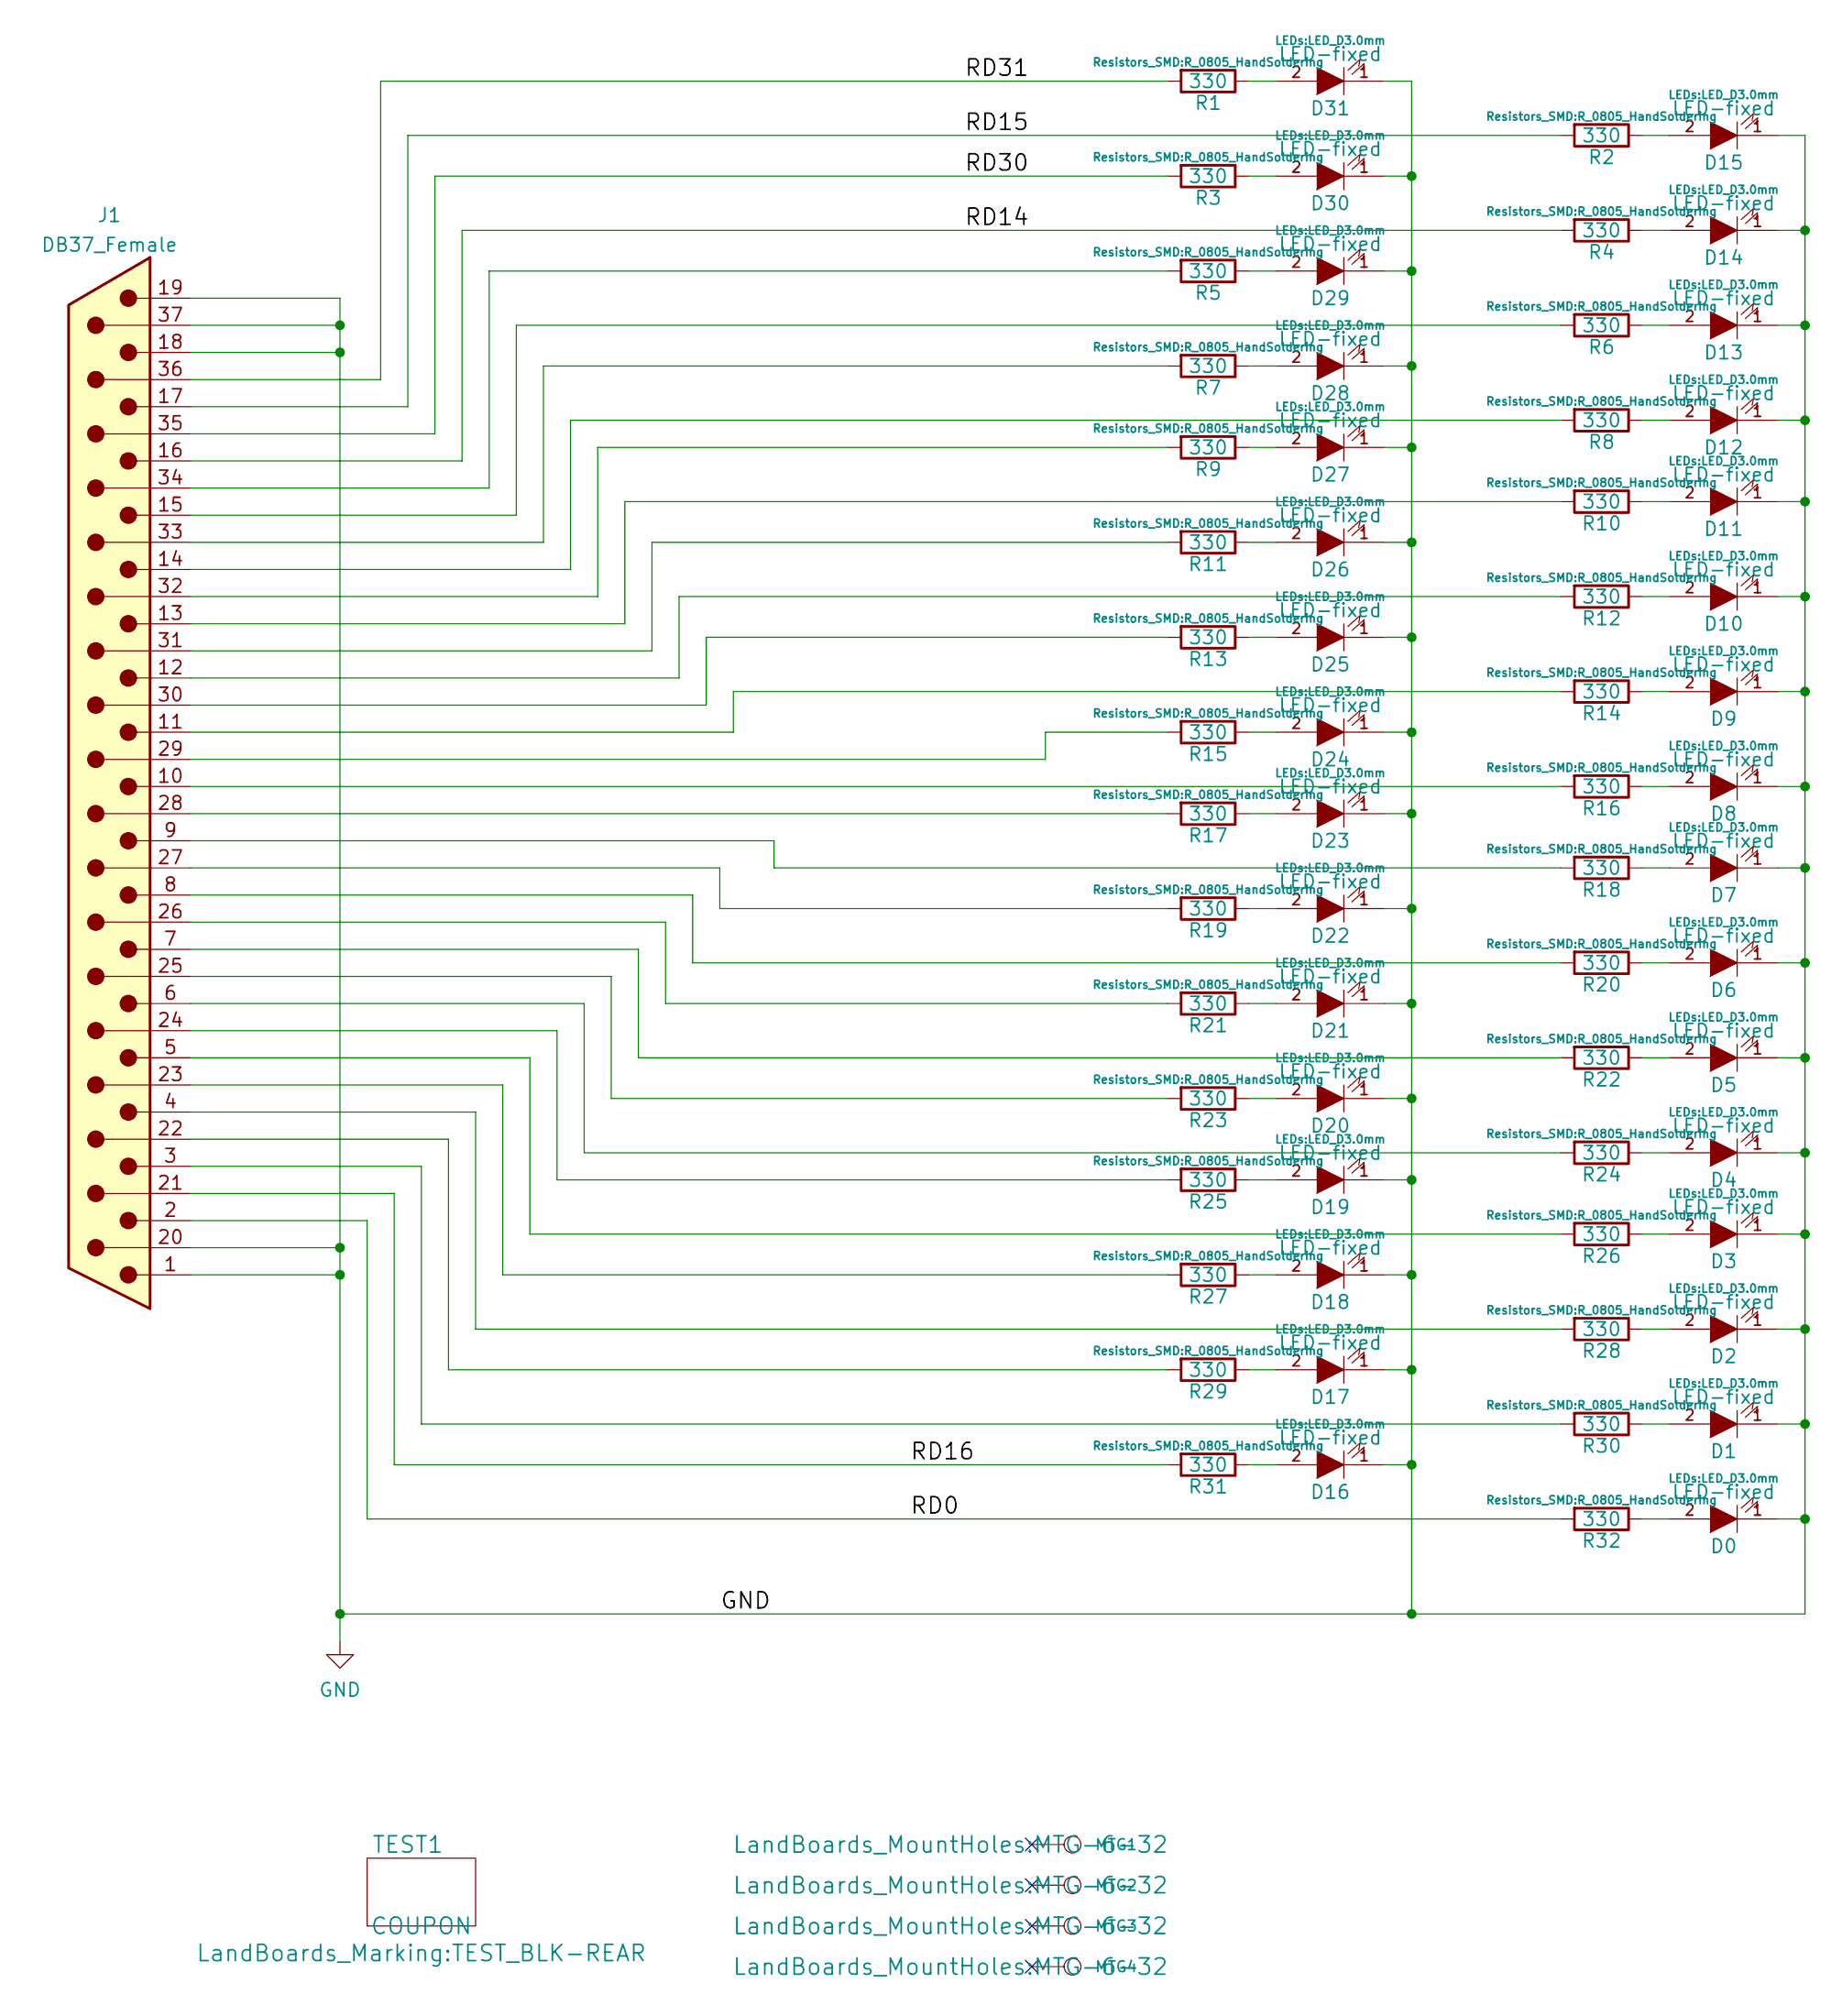
[picture p643: schematic LED32-DB37.kicad_sch]

Parts:
D0, D1, D2, D3, D4, D5, D6, D7, D8, D9, D10, D11, D12, D13, D14, D15, D16, D17, D18, D19, D20, D21, D22, D23, D24, D25, D26, D27, D28, D29, D30, D31: LED-fixed; LED_D3.0mm
J1: DB37_Female; DB37FC_FIXED
MTG1, MTG2, MTG3, MTG4: CONN_1; MTG-6-32
R1, R2, R3, R4, R5, R6, R7, R8, R9, R10, R11, R12, R13, R14, R15, R16, R17, R18, R19, R20, R21, R22, R23, R24, R25, R26, R27, R28, R29, R30, R31, R32: 330; R_0805_HandSoldering
TEST1: COUPON; TEST_BLK-REAR

Connections:
GND: D0.1 (K), D1.1 (K), D2.1 (K), D3.1 (K), D4.1 (K), D5.1 (K), D6.1 (K), D7.1 (K), D8.1 (K), D9.1 (K), D10.1 (K), D11.1 (K), D12.1 (K), D13.1 (K), D14.1 (K), D15.1 (K), D16.1 (K), D17.1 (K), D18.1 (K), D19.1 (K), D20.1 (K), D21.1 (K), D22.1 (K), D23.1 (K), D24.1 (K), D25.1 (K), D26.1 (K), D27.1 (K), D28.1 (K), D29.1 (K), D30.1 (K), D31.1 (K), J1.1, J1.18, J1.19, J1.20, J1.37
unnamed: D0.2 (A), R32.1
unnamed: D1.2 (A), R30.1
unnamed: D2.2 (A), R28.1
unnamed: D3.2 (A), R26.1
unnamed: D4.2 (A), R24.1
unnamed: D5.2 (A), R22.1
unnamed: D6.2 (A), R20.1
unnamed: D7.2 (A), R18.1
unnamed: D8.2 (A), R16.1
unnamed: D9.2 (A), R14.1
unnamed: D10.2 (A), R12.1
unnamed: D11.2 (A), R10.1
unnamed: D12.2 (A), R8.1
unnamed: D13.2 (A), R6.1
unnamed: D14.2 (A), R4.1
unnamed: D15.2 (A), R2.1
unnamed: D16.2 (A), R31.1
unnamed: D17.2 (A), R29.1
unnamed: D18.2 (A), R27.1
unnamed: D19.2 (A), R25.1
unnamed: D20.2 (A), R23.1
unnamed: D21.2 (A), R21.1
unnamed: D22.2 (A), R19.1
unnamed: D23.2 (A), R17.1
unnamed: D24.2 (A), R15.1
unnamed: D25.2 (A), R13.1
unnamed: D26.2 (A), R11.1
unnamed: D27.2 (A), R9.1
unnamed: D28.2 (A), R7.1
unnamed: D29.2 (A), R5.1
unnamed: D30.2 (A), R3.1
unnamed: D31.2 (A), R1.1
unnamed: J1.3, R30.2
unnamed: J1.4, R28.2
unnamed: J1.5, R26.2
unnamed: J1.6, R24.2
unnamed: J1.7, R22.2
unnamed: J1.8, R20.2
unnamed: J1.9, R18.2
unnamed: J1.10, R16.2
unnamed: J1.11, R14.2
unnamed: J1.12, R12.2
unnamed: J1.13, R10.2
unnamed: J1.14, R8.2
unnamed: J1.15, R6.2
unnamed: J1.22, R29.2
unnamed: J1.23, R27.2
unnamed: J1.24, R25.2
unnamed: J1.25, R23.2
unnamed: J1.26, R21.2
unnamed: J1.27, R19.2
unnamed: J1.28, R17.2
unnamed: J1.29, R15.2
unnamed: J1.30, R13.2
unnamed: J1.31, R11.2
unnamed: J1.32, R9.2
unnamed: J1.33, R7.2
unnamed: J1.34, R5.2
RD0: J1.2, R32.2
RD14: J1.16, R4.2
RD15: J1.17, R2.2
RD16: J1.21, R31.2
RD30: J1.35, R3.2
RD31: J1.36, R1.2
