land-boards/lb-boards/LEDs Cards/LED-18/LED-18.sch

## KiCad design LEDs Cards/LED-18/LED-18.sch (2013-07-08)

Schematic: LED-18.sch

Parts:
C1: 10uF; SM1210
C2: 0.1uF; SM0805
D1, D2, D3, D4, D5, D6, D7, D8, D9, D10, D11, D12, D13, D14, D15, D16, D17, D18: LED; LED-5MM
MTG1, MTG2, MTG3, MTG4: CONN_1; MTG-4-40
P1: CONN_2; TB2-5MM
P2: CONN_3X2; pin_array_3x2
Q1, Q2, Q3, Q4, Q5, Q6: NPN; TO92-123
R1, R2, R3, R4, R5, R6, R11: 10K; SM0805
R7, R8, R9, R10, R12, R13: 100; SM0805
RV1: 10K-POT; PIN_ARRAY_3X1
U1: AP1117; SOT223
U2: ATTINY85; DIP-8__300
