land-boards/lb-boards/LEDs Cards/LED-Lamp/LED-Lamp.sch

## KiCad design LEDs Cards/LED-Lamp/LED-Lamp.sch (2012-12-14)

Schematic: LED-Lamp.sch

Parts:
C1: 100UuF
C2: 0.1uF
D1, D2, D3, D4: 1N4006
D5, D6: 1N4148
D7: ZD9V1
D8: TVS400V; diode-CB429-17
P1, P2: CONN_1
P3: CONN_5
Q1: 1N3904
Q2: IRFU420
R1: 10
R2: 100K
R3: 330K
R4: 50K
R5, R9: 220K
R6: 10K
R7: 1K
R8, R10: 220
