land-boards/lb-boards/LEDs Cards/LED-TEST-2/LED-TEST-2.sch

## KiCad design LEDs Cards/LED-TEST-2/LED-TEST-2.sch (2014-11-22)

Schematic: LED-TEST-2.sch

Parts:
D1, D2, D3, D4, D5, D6, D7, D8, D9, D10, D11, D12, D13, D14, D15, D16: LED; LED-5MM
MTG1, MTG2, MTG3, MTG4: CONN_1; MTG-4-40
P1, P2, P3, P4, P5, P6, P7, P8, P9, P10, P11, P12, P13, P14, P15, P16: CONN_2; PIN_ARRAY_2X1
RP1, RP2, RP3, RP4: RP4X2; SIL-8
