land-boards/lb-boards/LEDs Cards/LED-Test/LED-Test.sch

## KiCad design LEDs Cards/LED-Test/LED-Test.sch (2014-07-01)

Schematic: LED-Test.sch

Parts:
COUP1: COUPON; REV_BLOCK
COUP?1: COUPON; REV_BLOCK
D1, D2, D3, D4, D5, D6, D7, D8, D9, D10, D11, D12, D13, D14, D15, D16: LED; LED-5MM
J1, J2, J3, J4, J5, J6, J7, J8, J9, J10, J11, J12, J13, J14, J15, J16: CONN_3; PIN_ARRAY_3X1
MTG1, MTG2, MTG3, MTG4: CONN_1; MTG-4-40
R1, R2, R3, R4, R5, R6, R7, R8, R9, R10, R11, R12, R13, R14, R15, R16: 100; SM0805
