land-boards/lb-boards/SYNTHS/SYNTH-ENV_GEN-01/SOFTWARE/DUALENVGEN.ino

#include <avr/io.h>//for fast PWM

int atk1, atk2, rel1, rel2, lev1, lev2, con1, con2, out1, out2, count1, count2;
//count -- 0 is not triggerd , 1 is attack duration , 2 is release duration.
bool in1, in2, old_in1, old_in2;
int i = 0;//CH1 count
int j = 0;//CH2 count
int last_out1 = 0; //If retriggered at the release time, the CV voltage will be restarted from the middle of the line, not from zero.
int last_out2 = 0;
long timer1 = 0;
long timer2 = 0;

const static byte curve[16][128] PROGMEM = {
  {0, 4, 7, 10, 14, 17, 21, 24, 27, 31, 34, 37, 40, 43, 46, 49, 52, 55, 58, 61, 64, 67, 70, 73, 76, 78, 81, 84, 87, 89, 92, 95, 97, 100, 102, 105, 107, 110, 112, 115, 117, 119, 122, 124, 126, 128, 131, 133, 135, 137, 140, 142, 144, 146, 148, 150, 152, 154, 156, 158, 160, 162, 164, 166, 168, 169, 171, 173, 175, 177, 178, 180, 182, 184, 185, 187, 189, 190, 192, 194, 195, 197, 198, 200, 202, 203, 205, 206, 208, 209, 210, 212, 213, 215, 216, 217, 219, 220, 221, 223, 224, 225, 227, 228, 229, 230, 232, 233, 234, 235, 237, 238, 239, 240, 241, 242, 243, 245, 246, 247, 248, 249, 250, 251, 252, 253, 254, 255},
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
  timer1 = micros();
  timer2 = micros();
  TCCR1B &= B11111000;//fast pwm setting
  TCCR1B |= B00000001;//fast pwm setting
  //  Serial.begin(9600);
  delay(50);
}

void loop()
{
  old_in1 = in1;
  old_in2 = in2;
  in1 = digitalRead(11);// trig input
  in2 = digitalRead(3);// trig input

  if (old_in1 == 0 && in1 == 1) {// if detect trigger
    if (count1 == 2) {
      last_out1 = out1;
    }
    else if (count1 != 2) {
      last_out1 = 0;
    }
    i = 0;//wave table count reset
    count1 = 1;//start attack duration
    atk1 = analogRead(1) * 12;
    rel1 = analogRead(2) * 16;
    lev1 = analogRead(4) / 4;
    con1 = analogRead(7) / 64;
  }

  else if (count1 == 1 && i > 127) {//attack duration end
    count1 = 2;//start release duration
  }
  else if (count1 == 2 && i > 255) {//release duration end
    count1 = 0;
  }

  if (old_in2 == 0 && in2 == 1) {// if detect trigger
    if (count2 == 2) {
      last_out2 = out2;
    }
    else if (count2 != 2) {
      last_out2 = 0;
    }
    j = 0;//wave table count reset
    count2 = 1;//start attack duration
    atk2 = analogRead(0) * 12;
    rel2 = analogRead(3) * 16;
    lev2 = analogRead(5) / 4;
    con2 = analogRead(6) / 64;
  }

  else if (count2 == 1 && j > 127) {//attack duration end
    count2 = 2;//start release duration
  }
  else if (count2 == 2 && j > 255) {//release duration end
    count2 = 0;
  }

  //----------------------CV output buffer CH1-------------------------
  if (count1 == 1) {//attack
    if (atk1 <= 32) {//Minimize atk time
      i = 128;
      count1 = 2;
    }
    out1 = (pgm_read_byte(&(curve[con1][i])));//store output voltage value
    if (timer1 + atk1 <= micros()) {
      i++;
      timer1 = micros();
    }
  }

  else if (count1 == 2) {//release
    out1 = 255 - (pgm_read_byte(&(curve[con1][i - 128])));//store output voltage value
    if (timer1 + rel1 <= micros()) {
      i++;
      timer1 = micros();
    }
  }

  //----------------------CV output buffer CH2-------------------------
  if (count2 == 1) {//attack
    if (atk2 <= 32) {//Minimize atk time
      j = 128;
      count2 = 2;
    }
    out2 = (pgm_read_byte(&(curve[con2][j])));//store output voltage value
    if (timer2 + atk2 <= micros()) {
      j++;
      timer2 = micros();
    }
  }

  else if (count2 == 2) {//release
    out2 = 255 - (pgm_read_byte(&(curve[con1][j - 128])));//store output voltage value
    if (timer2 + rel2 <= micros()) {
      j++;
      timer2 = micros();
    }
  }
  //----------------------CV output-------------------------
  PWM_OUT();//CV out
}
void PWM_OUT() {//PWM duty setting
  if (count1 == 1) {
    out1 = map(out1, 0, 255, last_out1, lev1);
  }
  else if (count1 == 2) {
    out1 = map(out1, 0, 255, 0, lev1);
  }
  if (count2 == 1) {
    out2 = map(out2, 0, 255, last_out2, lev2);
  }
  else if (count2 == 2) {
    out2 = map(out2, 0, 255, 0, lev2);
  }
  analogWrite(10, out1);//PWM output
  analogWrite(9, out2);//PWM output

}
