land-boards/lb-boards/Hardware/SparkFun/psoc/cores/arduino/ServoCounter.h

/*******************************************************************************
* File Name: ServoCounter.h  
* Version 3.0
*
*  Description:
*   Contains the function prototypes and constants available to the counter
*   user module.
*
*   Note:
*    None
*
********************************************************************************
* Copyright 2008-2015, Cypress Semiconductor Corporation.  All rights reserved.
* You may use this file only in accordance with the license, terms, conditions, 
* disclaimers, and limitations in the end user license agreement accompanying 
* the software package with which this file was provided.
*******************************************************************************/
    
#if !defined(CY_COUNTER_ServoCounter_H)
#define CY_COUNTER_ServoCounter_H

#include "cytypes.h"
#include "cyfitter.h"
#include "CyLib.h" /* For CyEnterCriticalSection() and CyExitCriticalSection() functions */

extern uint8 ServoCounter_initVar;

/* Check to see if required defines such as CY_PSOC5LP are available */
/* They are defined starting with cy_boot v3.0 */
#if !defined (CY_PSOC5LP)
    #error Component Counter_v3_0 requires cy_boot v3.0 or later
#endif /* (CY_ PSOC5LP) */

/* Error message for removed ServoCounter_CounterUDB_sCTRLReg_ctrlreg through optimization */
#ifdef ServoCounter_CounterUDB_sCTRLReg_ctrlreg__REMOVED
    #error Counter_v3_0 detected with a constant 0 for the enable, a \
                                constant 0 for the count or constant 1 for \
                                the reset. This will prevent the component from\
                                operating.
#endif /* ServoCounter_CounterUDB_sCTRLReg_ctrlreg__REMOVED */


/**************************************
*           Parameter Defaults        
**************************************/

#define ServoCounter_Resolution            16u
#define ServoCounter_UsingFixedFunction    0u
#define ServoCounter_ControlRegRemoved     0u
#define ServoCounter_COMPARE_MODE_SOFTWARE 0u
#define ServoCounter_CAPTURE_MODE_SOFTWARE 0u
#define ServoCounter_RunModeUsed           0u


/***************************************
*       Type defines
***************************************/


/**************************************************************************
 * Sleep Mode API Support
 * Backup structure for Sleep Wake up operations
 *************************************************************************/
typedef struct
{
    uint8 CounterEnableState; 
    uint16 CounterUdb;         /* Current Counter Value */

    #if (!ServoCounter_ControlRegRemoved)
        uint8 CounterControlRegister;               /* Counter Control Register */
    #endif /* (!ServoCounter_ControlRegRemoved) */

}ServoCounter_backupStruct;


/**************************************
 *  Function Prototypes
 *************************************/
void    ServoCounter_Start(void) ;
void    ServoCounter_Stop(void) ;
void    ServoCounter_SetInterruptMode(uint8 interruptsMask) ;
uint8   ServoCounter_ReadStatusRegister(void) ;
#define ServoCounter_GetInterruptSource() ServoCounter_ReadStatusRegister()
#if(!ServoCounter_ControlRegRemoved)
    uint8   ServoCounter_ReadControlRegister(void) ;
    void    ServoCounter_WriteControlRegister(uint8 control) \
        ;
#endif /* (!ServoCounter_ControlRegRemoved) */
#if (!(ServoCounter_UsingFixedFunction && (CY_PSOC5A)))
    void    ServoCounter_WriteCounter(uint16 counter) \
            ; 
#endif /* (!(ServoCounter_UsingFixedFunction && (CY_PSOC5A))) */
uint16  ServoCounter_ReadCounter(void) ;
uint16  ServoCounter_ReadCapture(void) ;
void    ServoCounter_WritePeriod(uint16 period) \
    ;
uint16  ServoCounter_ReadPeriod( void ) ;
#if (!ServoCounter_UsingFixedFunction)
    void    ServoCounter_WriteCompare(uint16 compare) \
        ;
    uint16  ServoCounter_ReadCompare( void ) \
        ;
#endif /* (!ServoCounter_UsingFixedFunction) */

#if (ServoCounter_COMPARE_MODE_SOFTWARE)
    void    ServoCounter_SetCompareMode(uint8 compareMode) ;
#endif /* (ServoCounter_COMPARE_MODE_SOFTWARE) */
#if (ServoCounter_CAPTURE_MODE_SOFTWARE)
    void    ServoCounter_SetCaptureMode(uint8 captureMode) ;
#endif /* (ServoCounter_CAPTURE_MODE_SOFTWARE) */
void ServoCounter_ClearFIFO(void)     ;
void ServoCounter_Init(void)          ;
void ServoCounter_Enable(void)        ;
void ServoCounter_SaveConfig(void)    ;
void ServoCounter_RestoreConfig(void) ;
void ServoCounter_Sleep(void)         ;
void ServoCounter_Wakeup(void)        ;


/***************************************
*   Enumerated Types and Parameters
***************************************/

/* Enumerated Type B_Counter__CompareModes, Used in Compare Mode retained for backward compatibility of tests*/
#define ServoCounter__B_COUNTER__LESS_THAN 1
#define ServoCounter__B_COUNTER__LESS_THAN_OR_EQUAL 2
#define ServoCounter__B_COUNTER__EQUAL 0
#define ServoCounter__B_COUNTER__GREATER_THAN 3
#define ServoCounter__B_COUNTER__GREATER_THAN_OR_EQUAL 4
#define ServoCounter__B_COUNTER__SOFTWARE 5

/* Enumerated Type Counter_CompareModes */
#define ServoCounter_CMP_MODE_LT 1u
#define ServoCounter_CMP_MODE_LTE 2u
#define ServoCounter_CMP_MODE_EQ 0u
#define ServoCounter_CMP_MODE_GT 3u
#define ServoCounter_CMP_MODE_GTE 4u
#define ServoCounter_CMP_MODE_SOFTWARE_CONTROLLED 5u

/* Enumerated Type B_Counter__CaptureModes, Used in Capture Mode retained for backward compatibility of tests*/
#define ServoCounter__B_COUNTER__NONE 0
#define ServoCounter__B_COUNTER__RISING_EDGE 1
#define ServoCounter__B_COUNTER__FALLING_EDGE 2
#define ServoCounter__B_COUNTER__EITHER_EDGE 3
#define ServoCounter__B_COUNTER__SOFTWARE_CONTROL 4

/* Enumerated Type Counter_CompareModes */
#define ServoCounter_CAP_MODE_NONE 0u
#define ServoCounter_CAP_MODE_RISE 1u
#define ServoCounter_CAP_MODE_FALL 2u
#define ServoCounter_CAP_MODE_BOTH 3u
#define ServoCounter_CAP_MODE_SOFTWARE_CONTROLLED 4u


/***************************************
 *  Initialization Values
 **************************************/
#define ServoCounter_CAPTURE_MODE_CONF       0u
#define ServoCounter_INIT_PERIOD_VALUE       20000u
#define ServoCounter_INIT_COUNTER_VALUE      0u
#if (ServoCounter_UsingFixedFunction)
#define ServoCounter_INIT_INTERRUPTS_MASK    ((uint8)((uint8)0u << ServoCounter_STATUS_ZERO_INT_EN_MASK_SHIFT))
#else
#define ServoCounter_INIT_COMPARE_VALUE      10000u
#define ServoCounter_INIT_INTERRUPTS_MASK ((uint8)((uint8)0u << ServoCounter_STATUS_ZERO_INT_EN_MASK_SHIFT) | \
        ((uint8)((uint8)0u << ServoCounter_STATUS_CAPTURE_INT_EN_MASK_SHIFT)) | \
        ((uint8)((uint8)1u << ServoCounter_STATUS_CMP_INT_EN_MASK_SHIFT)) | \
        ((uint8)((uint8)1u << ServoCounter_STATUS_OVERFLOW_INT_EN_MASK_SHIFT)) | \
        ((uint8)((uint8)1u << ServoCounter_STATUS_UNDERFLOW_INT_EN_MASK_SHIFT)))
#define ServoCounter_DEFAULT_COMPARE_MODE    0u

#if( 0 != ServoCounter_CAPTURE_MODE_CONF)
    #define ServoCounter_DEFAULT_CAPTURE_MODE    ((uint8)((uint8)0u << ServoCounter_CTRL_CAPMODE0_SHIFT))
#else    
    #define ServoCounter_DEFAULT_CAPTURE_MODE    (0u )
#endif /* ( 0 != ServoCounter_CAPTURE_MODE_CONF) */

#endif /* (ServoCounter_UsingFixedFunction) */


/**************************************
 *  Registers
 *************************************/
#if (ServoCounter_UsingFixedFunction)
    #define ServoCounter_STATICCOUNT_LSB     (*(reg16 *) ServoCounter_CounterHW__CAP0 )
    #define ServoCounter_STATICCOUNT_LSB_PTR ( (reg16 *) ServoCounter_CounterHW__CAP0 )
    #define ServoCounter_PERIOD_LSB          (*(reg16 *) ServoCounter_CounterHW__PER0 )
    #define ServoCounter_PERIOD_LSB_PTR      ( (reg16 *) ServoCounter_CounterHW__PER0 )
    /* MODE must be set to 1 to set the compare value */
    #define ServoCounter_COMPARE_LSB         (*(reg16 *) ServoCounter_CounterHW__CNT_CMP0 )
    #define ServoCounter_COMPARE_LSB_PTR     ( (reg16 *) ServoCounter_CounterHW__CNT_CMP0 )
    /* MODE must be set to 0 to get the count */
    #define ServoCounter_COUNTER_LSB         (*(reg16 *) ServoCounter_CounterHW__CNT_CMP0 )
    #define ServoCounter_COUNTER_LSB_PTR     ( (reg16 *) ServoCounter_CounterHW__CNT_CMP0 )
    #define ServoCounter_RT1                 (*(reg8 *) ServoCounter_CounterHW__RT1)
    #define ServoCounter_RT1_PTR             ( (reg8 *) ServoCounter_CounterHW__RT1)
#else
    
    #if (ServoCounter_Resolution <= 8u) /* 8-bit Counter */
    
        #define ServoCounter_STATICCOUNT_LSB     (*(reg8 *) \
            ServoCounter_CounterUDB_sC16_counterdp_u0__F0_REG )
        #define ServoCounter_STATICCOUNT_LSB_PTR ( (reg8 *) \
            ServoCounter_CounterUDB_sC16_counterdp_u0__F0_REG )
        #define ServoCounter_PERIOD_LSB          (*(reg8 *) \
            ServoCounter_CounterUDB_sC16_counterdp_u0__D0_REG )
        #define ServoCounter_PERIOD_LSB_PTR      ( (reg8 *) \
            ServoCounter_CounterUDB_sC16_counterdp_u0__D0_REG )
        #define ServoCounter_COMPARE_LSB         (*(reg8 *) \
            ServoCounter_CounterUDB_sC16_counterdp_u0__D1_REG )
        #define ServoCounter_COMPARE_LSB_PTR     ( (reg8 *) \
            ServoCounter_CounterUDB_sC16_counterdp_u0__D1_REG )
        #define ServoCounter_COUNTER_LSB         (*(reg8 *) \
            ServoCounter_CounterUDB_sC16_counterdp_u0__A0_REG )  
        #define ServoCounter_COUNTER_LSB_PTR     ( (reg8 *)\
            ServoCounter_CounterUDB_sC16_counterdp_u0__A0_REG )
    
    #elif(ServoCounter_Resolution <= 16u) /* 16-bit Counter */
        #if(CY_PSOC3) /* 8-bit address space */ 
            #define ServoCounter_STATICCOUNT_LSB     (*(reg16 *) \
                ServoCounter_CounterUDB_sC16_counterdp_u0__F0_REG )
            #define ServoCounter_STATICCOUNT_LSB_PTR ( (reg16 *) \
                ServoCounter_CounterUDB_sC16_counterdp_u0__F0_REG )
            #define ServoCounter_PERIOD_LSB          (*(reg16 *) \
                ServoCounter_CounterUDB_sC16_counterdp_u0__D0_REG )
            #define ServoCounter_PERIOD_LSB_PTR      ( (reg16 *) \
                ServoCounter_CounterUDB_sC16_counterdp_u0__D0_REG )
            #define ServoCounter_COMPARE_LSB         (*(reg16 *) \
                ServoCounter_CounterUDB_sC16_counterdp_u0__D1_REG )
            #define ServoCounter_COMPARE_LSB_PTR     ( (reg16 *) \
                ServoCounter_CounterUDB_sC16_counterdp_u0__D1_REG )
            #define ServoCounter_COUNTER_LSB         (*(reg16 *) \
                ServoCounter_CounterUDB_sC16_counterdp_u0__A0_REG )  
            #define ServoCounter_COUNTER_LSB_PTR     ( (reg16 *)\
                ServoCounter_CounterUDB_sC16_counterdp_u0__A0_REG )
        #else /* 16-bit address space */
            #define ServoCounter_STATICCOUNT_LSB     (*(reg16 *) \
                ServoCounter_CounterUDB_sC16_counterdp_u0__16BIT_F0_REG )
            #define ServoCounter_STATICCOUNT_LSB_PTR ( (reg16 *) \
                ServoCounter_CounterUDB_sC16_counterdp_u0__16BIT_F0_REG )
            #define ServoCounter_PERIOD_LSB          (*(reg16 *) \
                ServoCounter_CounterUDB_sC16_counterdp_u0__16BIT_D0_REG )
            #define ServoCounter_PERIOD_LSB_PTR      ( (reg16 *) \
                ServoCounter_CounterUDB_sC16_counterdp_u0__16BIT_D0_REG )
            #define ServoCounter_COMPARE_LSB         (*(reg16 *) \
                ServoCounter_CounterUDB_sC16_counterdp_u0__16BIT_D1_REG )
            #define ServoCounter_COMPARE_LSB_PTR     ( (reg16 *) \
                ServoCounter_CounterUDB_sC16_counterdp_u0__16BIT_D1_REG )
            #define ServoCounter_COUNTER_LSB         (*(reg16 *) \
                ServoCounter_CounterUDB_sC16_counterdp_u0__16BIT_A0_REG )  
            #define ServoCounter_COUNTER_LSB_PTR     ( (reg16 *)\
                ServoCounter_CounterUDB_sC16_counterdp_u0__16BIT_A0_REG )
        #endif /* CY_PSOC3 */   
    #elif(ServoCounter_Resolution <= 24u) /* 24-bit Counter */
        
        #define ServoCounter_STATICCOUNT_LSB     (*(reg32 *) \
            ServoCounter_CounterUDB_sC16_counterdp_u0__F0_REG )
        #define ServoCounter_STATICCOUNT_LSB_PTR ( (reg32 *) \
            ServoCounter_CounterUDB_sC16_counterdp_u0__F0_REG )
        #define ServoCounter_PERIOD_LSB          (*(reg32 *) \
            ServoCounter_CounterUDB_sC16_counterdp_u0__D0_REG )
        #define ServoCounter_PERIOD_LSB_PTR      ( (reg32 *) \
            ServoCounter_CounterUDB_sC16_counterdp_u0__D0_REG )
        #define ServoCounter_COMPARE_LSB         (*(reg32 *) \
            ServoCounter_CounterUDB_sC16_counterdp_u0__D1_REG )
        #define ServoCounter_COMPARE_LSB_PTR     ( (reg32 *) \
            ServoCounter_CounterUDB_sC16_counterdp_u0__D1_REG )
        #define ServoCounter_COUNTER_LSB         (*(reg32 *) \
            ServoCounter_CounterUDB_sC16_counterdp_u0__A0_REG )  
        #define ServoCounter_COUNTER_LSB_PTR     ( (reg32 *)\
            ServoCounter_CounterUDB_sC16_counterdp_u0__A0_REG )
    
    #else /* 32-bit Counter */
        #if(CY_PSOC3 || CY_PSOC5) /* 8-bit address space */
            #define ServoCounter_STATICCOUNT_LSB     (*(reg32 *) \
                ServoCounter_CounterUDB_sC16_counterdp_u0__F0_REG )
            #define ServoCounter_STATICCOUNT_LSB_PTR ( (reg32 *) \
                ServoCounter_CounterUDB_sC16_counterdp_u0__F0_REG )
            #define ServoCounter_PERIOD_LSB          (*(reg32 *) \
                ServoCounter_CounterUDB_sC16_counterdp_u0__D0_REG )
            #define ServoCounter_PERIOD_LSB_PTR      ( (reg32 *) \
                ServoCounter_CounterUDB_sC16_counterdp_u0__D0_REG )
            #define ServoCounter_COMPARE_LSB         (*(reg32 *) \
                ServoCounter_CounterUDB_sC16_counterdp_u0__D1_REG )
            #define ServoCounter_COMPARE_LSB_PTR     ( (reg32 *) \
                ServoCounter_CounterUDB_sC16_counterdp_u0__D1_REG )
            #define ServoCounter_COUNTER_LSB         (*(reg32 *) \
                ServoCounter_CounterUDB_sC16_counterdp_u0__A0_REG )  
            #define ServoCounter_COUNTER_LSB_PTR     ( (reg32 *)\
                ServoCounter_CounterUDB_sC16_counterdp_u0__A0_REG )
        #else /* 32-bit address space */
            #define ServoCounter_STATICCOUNT_LSB     (*(reg32 *) \
                ServoCounter_CounterUDB_sC16_counterdp_u0__32BIT_F0_REG )
            #define ServoCounter_STATICCOUNT_LSB_PTR ( (reg32 *) \
                ServoCounter_CounterUDB_sC16_counterdp_u0__32BIT_F0_REG )
            #define ServoCounter_PERIOD_LSB          (*(reg32 *) \
                ServoCounter_CounterUDB_sC16_counterdp_u0__32BIT_D0_REG )
            #define ServoCounter_PERIOD_LSB_PTR      ( (reg32 *) \
                ServoCounter_CounterUDB_sC16_counterdp_u0__32BIT_D0_REG )
            #define ServoCounter_COMPARE_LSB         (*(reg32 *) \
                ServoCounter_CounterUDB_sC16_counterdp_u0__32BIT_D1_REG )
            #define ServoCounter_COMPARE_LSB_PTR     ( (reg32 *) \
                ServoCounter_CounterUDB_sC16_counterdp_u0__32BIT_D1_REG )
            #define ServoCounter_COUNTER_LSB         (*(reg32 *) \
                ServoCounter_CounterUDB_sC16_counterdp_u0__32BIT_A0_REG )  
            #define ServoCounter_COUNTER_LSB_PTR     ( (reg32 *)\
                ServoCounter_CounterUDB_sC16_counterdp_u0__32BIT_A0_REG )
        #endif /* CY_PSOC3 || CY_PSOC5 */   
    #endif

	#define ServoCounter_COUNTER_LSB_PTR_8BIT     ( (reg8 *)\
                ServoCounter_CounterUDB_sC16_counterdp_u0__A0_REG )
				
    #define ServoCounter_AUX_CONTROLDP0 \
        (*(reg8 *) ServoCounter_CounterUDB_sC16_counterdp_u0__DP_AUX_CTL_REG)
    
    #define ServoCounter_AUX_CONTROLDP0_PTR \
        ( (reg8 *) ServoCounter_CounterUDB_sC16_counterdp_u0__DP_AUX_CTL_REG)
    
    #if (ServoCounter_Resolution == 16 || ServoCounter_Resolution == 24 || ServoCounter_Resolution == 32)
       #define ServoCounter_AUX_CONTROLDP1 \
           (*(reg8 *) ServoCounter_CounterUDB_sC16_counterdp_u1__DP_AUX_CTL_REG)
       #define ServoCounter_AUX_CONTROLDP1_PTR \
           ( (reg8 *) ServoCounter_CounterUDB_sC16_counterdp_u1__DP_AUX_CTL_REG)
    #endif /* (ServoCounter_Resolution == 16 || ServoCounter_Resolution == 24 || ServoCounter_Resolution == 32) */
    
    #if (ServoCounter_Resolution == 24 || ServoCounter_Resolution == 32)
       #define ServoCounter_AUX_CONTROLDP2 \
           (*(reg8 *) ServoCounter_CounterUDB_sC16_counterdp_u2__DP_AUX_CTL_REG)
       #define ServoCounter_AUX_CONTROLDP2_PTR \
           ( (reg8 *) ServoCounter_CounterUDB_sC16_counterdp_u2__DP_AUX_CTL_REG)
    #endif /* (ServoCounter_Resolution == 24 || ServoCounter_Resolution == 32) */
    
    #if (ServoCounter_Resolution == 32)
       #define ServoCounter_AUX_CONTROLDP3 \
           (*(reg8 *) ServoCounter_CounterUDB_sC16_counterdp_u3__DP_AUX_CTL_REG)
       #define ServoCounter_AUX_CONTROLDP3_PTR \
           ( (reg8 *) ServoCounter_CounterUDB_sC16_counterdp_u3__DP_AUX_CTL_REG)
    #endif /* (ServoCounter_Resolution == 32) */

#endif  /* (ServoCounter_UsingFixedFunction) */

#if (ServoCounter_UsingFixedFunction)
    #define ServoCounter_STATUS         (*(reg8 *) ServoCounter_CounterHW__SR0 )
    /* In Fixed Function Block Status and Mask are the same register */
    #define ServoCounter_STATUS_MASK             (*(reg8 *) ServoCounter_CounterHW__SR0 )
    #define ServoCounter_STATUS_MASK_PTR         ( (reg8 *) ServoCounter_CounterHW__SR0 )
    #define ServoCounter_CONTROL                 (*(reg8 *) ServoCounter_CounterHW__CFG0)
    #define ServoCounter_CONTROL_PTR             ( (reg8 *) ServoCounter_CounterHW__CFG0)
    #define ServoCounter_CONTROL2                (*(reg8 *) ServoCounter_CounterHW__CFG1)
    #define ServoCounter_CONTROL2_PTR            ( (reg8 *) ServoCounter_CounterHW__CFG1)
    #if (CY_PSOC3 || CY_PSOC5LP)
        #define ServoCounter_CONTROL3       (*(reg8 *) ServoCounter_CounterHW__CFG2)
        #define ServoCounter_CONTROL3_PTR   ( (reg8 *) ServoCounter_CounterHW__CFG2)
    #endif /* (CY_PSOC3 || CY_PSOC5LP) */
    #define ServoCounter_GLOBAL_ENABLE           (*(reg8 *) ServoCounter_CounterHW__PM_ACT_CFG)
    #define ServoCounter_GLOBAL_ENABLE_PTR       ( (reg8 *) ServoCounter_CounterHW__PM_ACT_CFG)
    #define ServoCounter_GLOBAL_STBY_ENABLE      (*(reg8 *) ServoCounter_CounterHW__PM_STBY_CFG)
    #define ServoCounter_GLOBAL_STBY_ENABLE_PTR  ( (reg8 *) ServoCounter_CounterHW__PM_STBY_CFG)
    

    /********************************
    *    Constants
    ********************************/

    /* Fixed Function Block Chosen */
    #define ServoCounter_BLOCK_EN_MASK          ServoCounter_CounterHW__PM_ACT_MSK
    #define ServoCounter_BLOCK_STBY_EN_MASK     ServoCounter_CounterHW__PM_STBY_MSK 
    
    /* Control Register Bit Locations */    
    /* As defined in Register Map, part of TMRX_CFG0 register */
    #define ServoCounter_CTRL_ENABLE_SHIFT      0x00u
    #define ServoCounter_ONESHOT_SHIFT          0x02u
    /* Control Register Bit Masks */
    #define ServoCounter_CTRL_ENABLE            ((uint8)((uint8)0x01u << ServoCounter_CTRL_ENABLE_SHIFT))         
    #define ServoCounter_ONESHOT                ((uint8)((uint8)0x01u << ServoCounter_ONESHOT_SHIFT))

    /* Control2 Register Bit Masks */
    /* Set the mask for run mode */
    #if (CY_PSOC5A)
        /* Use CFG1 Mode bits to set run mode */
        #define ServoCounter_CTRL_MODE_SHIFT        0x01u    
        #define ServoCounter_CTRL_MODE_MASK         ((uint8)((uint8)0x07u << ServoCounter_CTRL_MODE_SHIFT))
    #endif /* (CY_PSOC5A) */
    #if (CY_PSOC3 || CY_PSOC5LP)
        /* Use CFG2 Mode bits to set run mode */
        #define ServoCounter_CTRL_MODE_SHIFT        0x00u    
        #define ServoCounter_CTRL_MODE_MASK         ((uint8)((uint8)0x03u << ServoCounter_CTRL_MODE_SHIFT))
    #endif /* (CY_PSOC3 || CY_PSOC5LP) */
    /* Set the mask for interrupt (raw/status register) */
    #define ServoCounter_CTRL2_IRQ_SEL_SHIFT     0x00u
    #define ServoCounter_CTRL2_IRQ_SEL          ((uint8)((uint8)0x01u << ServoCounter_CTRL2_IRQ_SEL_SHIFT))     
    
    /* Status Register Bit Locations */
    #define ServoCounter_STATUS_ZERO_SHIFT      0x07u  /* As defined in Register Map, part of TMRX_SR0 register */ 

    /* Status Register Interrupt Enable Bit Locations */
    #define ServoCounter_STATUS_ZERO_INT_EN_MASK_SHIFT      (ServoCounter_STATUS_ZERO_SHIFT - 0x04u)

    /* Status Register Bit Masks */                           
    #define ServoCounter_STATUS_ZERO            ((uint8)((uint8)0x01u << ServoCounter_STATUS_ZERO_SHIFT))

    /* Status Register Interrupt Bit Masks*/
    #define ServoCounter_STATUS_ZERO_INT_EN_MASK       ((uint8)((uint8)ServoCounter_STATUS_ZERO >> 0x04u))
    
    /*RT1 Synch Constants: Applicable for PSoC3 and PSoC5LP */
    #define ServoCounter_RT1_SHIFT            0x04u
    #define ServoCounter_RT1_MASK             ((uint8)((uint8)0x03u << ServoCounter_RT1_SHIFT))  /* Sync TC and CMP bit masks */
    #define ServoCounter_SYNC                 ((uint8)((uint8)0x03u << ServoCounter_RT1_SHIFT))
    #define ServoCounter_SYNCDSI_SHIFT        0x00u
    #define ServoCounter_SYNCDSI_MASK         ((uint8)((uint8)0x0Fu << ServoCounter_SYNCDSI_SHIFT)) /* Sync all DSI inputs */
    #define ServoCounter_SYNCDSI_EN           ((uint8)((uint8)0x0Fu << ServoCounter_SYNCDSI_SHIFT)) /* Sync all DSI inputs */
    
#else /* !ServoCounter_UsingFixedFunction */
    #define ServoCounter_STATUS               (* (reg8 *) ServoCounter_CounterUDB_sSTSReg_stsreg__STATUS_REG )
    #define ServoCounter_STATUS_PTR           (  (reg8 *) ServoCounter_CounterUDB_sSTSReg_stsreg__STATUS_REG )
    #define ServoCounter_STATUS_MASK          (* (reg8 *) ServoCounter_CounterUDB_sSTSReg_stsreg__MASK_REG )
    #define ServoCounter_STATUS_MASK_PTR      (  (reg8 *) ServoCounter_CounterUDB_sSTSReg_stsreg__MASK_REG )
    #define ServoCounter_STATUS_AUX_CTRL      (*(reg8 *) ServoCounter_CounterUDB_sSTSReg_stsreg__STATUS_AUX_CTL_REG)
    #define ServoCounter_STATUS_AUX_CTRL_PTR  ( (reg8 *) ServoCounter_CounterUDB_sSTSReg_stsreg__STATUS_AUX_CTL_REG)
    #define ServoCounter_CONTROL              (* (reg8 *) ServoCounter_CounterUDB_sCTRLReg_ctrlreg__CONTROL_REG )
    #define ServoCounter_CONTROL_PTR          (  (reg8 *) ServoCounter_CounterUDB_sCTRLReg_ctrlreg__CONTROL_REG )


    /********************************
    *    Constants
    ********************************/
    /* Control Register Bit Locations */
    #define ServoCounter_CTRL_CAPMODE0_SHIFT    0x03u       /* As defined by Verilog Implementation */
    #define ServoCounter_CTRL_RESET_SHIFT       0x06u       /* As defined by Verilog Implementation */
    #define ServoCounter_CTRL_ENABLE_SHIFT      0x07u       /* As defined by Verilog Implementation */
    /* Control Register Bit Masks */
    #define ServoCounter_CTRL_CMPMODE_MASK      0x07u 
    #define ServoCounter_CTRL_CAPMODE_MASK      0x03u  
    #define ServoCounter_CTRL_RESET             ((uint8)((uint8)0x01u << ServoCounter_CTRL_RESET_SHIFT))  
    #define ServoCounter_CTRL_ENABLE            ((uint8)((uint8)0x01u << ServoCounter_CTRL_ENABLE_SHIFT)) 

    /* Status Register Bit Locations */
    #define ServoCounter_STATUS_CMP_SHIFT       0x00u       /* As defined by Verilog Implementation */
    #define ServoCounter_STATUS_ZERO_SHIFT      0x01u       /* As defined by Verilog Implementation */
    #define ServoCounter_STATUS_OVERFLOW_SHIFT  0x02u       /* As defined by Verilog Implementation */
    #define ServoCounter_STATUS_UNDERFLOW_SHIFT 0x03u       /* As defined by Verilog Implementation */
    #define ServoCounter_STATUS_CAPTURE_SHIFT   0x04u       /* As defined by Verilog Implementation */
    #define ServoCounter_STATUS_FIFOFULL_SHIFT  0x05u       /* As defined by Verilog Implementation */
    #define ServoCounter_STATUS_FIFONEMP_SHIFT  0x06u       /* As defined by Verilog Implementation */
    /* Status Register Interrupt Enable Bit Locations - UDB Status Interrupt Mask match Status Bit Locations*/
    #define ServoCounter_STATUS_CMP_INT_EN_MASK_SHIFT       ServoCounter_STATUS_CMP_SHIFT       
    #define ServoCounter_STATUS_ZERO_INT_EN_MASK_SHIFT      ServoCounter_STATUS_ZERO_SHIFT      
    #define ServoCounter_STATUS_OVERFLOW_INT_EN_MASK_SHIFT  ServoCounter_STATUS_OVERFLOW_SHIFT  
    #define ServoCounter_STATUS_UNDERFLOW_INT_EN_MASK_SHIFT ServoCounter_STATUS_UNDERFLOW_SHIFT 
    #define ServoCounter_STATUS_CAPTURE_INT_EN_MASK_SHIFT   ServoCounter_STATUS_CAPTURE_SHIFT   
    #define ServoCounter_STATUS_FIFOFULL_INT_EN_MASK_SHIFT  ServoCounter_STATUS_FIFOFULL_SHIFT  
    #define ServoCounter_STATUS_FIFONEMP_INT_EN_MASK_SHIFT  ServoCounter_STATUS_FIFONEMP_SHIFT  
    /* Status Register Bit Masks */                
    #define ServoCounter_STATUS_CMP             ((uint8)((uint8)0x01u << ServoCounter_STATUS_CMP_SHIFT))  
    #define ServoCounter_STATUS_ZERO            ((uint8)((uint8)0x01u << ServoCounter_STATUS_ZERO_SHIFT)) 
    #define ServoCounter_STATUS_OVERFLOW        ((uint8)((uint8)0x01u << ServoCounter_STATUS_OVERFLOW_SHIFT)) 
    #define ServoCounter_STATUS_UNDERFLOW       ((uint8)((uint8)0x01u << ServoCounter_STATUS_UNDERFLOW_SHIFT)) 
    #define ServoCounter_STATUS_CAPTURE         ((uint8)((uint8)0x01u << ServoCounter_STATUS_CAPTURE_SHIFT)) 
    #define ServoCounter_STATUS_FIFOFULL        ((uint8)((uint8)0x01u << ServoCounter_STATUS_FIFOFULL_SHIFT))
    #define ServoCounter_STATUS_FIFONEMP        ((uint8)((uint8)0x01u << ServoCounter_STATUS_FIFONEMP_SHIFT))
    /* Status Register Interrupt Bit Masks  - UDB Status Interrupt Mask match Status Bit Locations */
    #define ServoCounter_STATUS_CMP_INT_EN_MASK            ServoCounter_STATUS_CMP                    
    #define ServoCounter_STATUS_ZERO_INT_EN_MASK           ServoCounter_STATUS_ZERO            
    #define ServoCounter_STATUS_OVERFLOW_INT_EN_MASK       ServoCounter_STATUS_OVERFLOW        
    #define ServoCounter_STATUS_UNDERFLOW_INT_EN_MASK      ServoCounter_STATUS_UNDERFLOW       
    #define ServoCounter_STATUS_CAPTURE_INT_EN_MASK        ServoCounter_STATUS_CAPTURE         
    #define ServoCounter_STATUS_FIFOFULL_INT_EN_MASK       ServoCounter_STATUS_FIFOFULL        
    #define ServoCounter_STATUS_FIFONEMP_INT_EN_MASK       ServoCounter_STATUS_FIFONEMP         
    

    /* StatusI Interrupt Enable bit Location in the Auxilliary Control Register */
    #define ServoCounter_STATUS_ACTL_INT_EN     0x10u /* As defined for the ACTL Register */
    
    /* Datapath Auxillary Control Register definitions */
    #define ServoCounter_AUX_CTRL_FIFO0_CLR         0x01u   /* As defined by Register map */
    #define ServoCounter_AUX_CTRL_FIFO1_CLR         0x02u   /* As defined by Register map */
    #define ServoCounter_AUX_CTRL_FIFO0_LVL         0x04u   /* As defined by Register map */
    #define ServoCounter_AUX_CTRL_FIFO1_LVL         0x08u   /* As defined by Register map */
    #define ServoCounter_STATUS_ACTL_INT_EN_MASK    0x10u   /* As defined for the ACTL Register */
    
#endif /* ServoCounter_UsingFixedFunction */

#endif  /* CY_COUNTER_ServoCounter_H */


/* [] END OF FILE */
