land-boards/lb-boards/Hardware/SparkFun/psoc/cores/arduino/ServoInterrupt.h

/*******************************************************************************
* File Name: ServoInterrupt.h
* Version 1.70
*
*  Description:
*   Provides the function definitions for the Interrupt Controller.
*
*
********************************************************************************
* Copyright 2008-2015, Cypress Semiconductor Corporation.  All rights reserved.
* You may use this file only in accordance with the license, terms, conditions, 
* disclaimers, and limitations in the end user license agreement accompanying 
* the software package with which this file was provided.
*******************************************************************************/
#if !defined(CY_ISR_ServoInterrupt_H)
#define CY_ISR_ServoInterrupt_H


#include <cytypes.h>
#include <cyfitter.h>

/* Interrupt Controller API. */
void ServoInterrupt_Start(void);
void ServoInterrupt_StartEx(cyisraddress address);
void ServoInterrupt_Stop(void);

CY_ISR_PROTO(ServoInterrupt_Interrupt);

void ServoInterrupt_SetVector(cyisraddress address);
cyisraddress ServoInterrupt_GetVector(void);

void ServoInterrupt_SetPriority(uint8 priority);
uint8 ServoInterrupt_GetPriority(void);

void ServoInterrupt_Enable(void);
uint8 ServoInterrupt_GetState(void);
void ServoInterrupt_Disable(void);

void ServoInterrupt_SetPending(void);
void ServoInterrupt_ClearPending(void);


/* Interrupt Controller Constants */

/* Address of the INTC.VECT[x] register that contains the Address of the ServoInterrupt ISR. */
#define ServoInterrupt_INTC_VECTOR            ((reg32 *) ServoInterrupt__INTC_VECT)

/* Address of the ServoInterrupt ISR priority. */
#define ServoInterrupt_INTC_PRIOR             ((reg8 *) ServoInterrupt__INTC_PRIOR_REG)

/* Priority of the ServoInterrupt interrupt. */
#define ServoInterrupt_INTC_PRIOR_NUMBER      ServoInterrupt__INTC_PRIOR_NUM

/* Address of the INTC.SET_EN[x] byte to bit enable ServoInterrupt interrupt. */
#define ServoInterrupt_INTC_SET_EN            ((reg32 *) ServoInterrupt__INTC_SET_EN_REG)

/* Address of the INTC.CLR_EN[x] register to bit clear the ServoInterrupt interrupt. */
#define ServoInterrupt_INTC_CLR_EN            ((reg32 *) ServoInterrupt__INTC_CLR_EN_REG)

/* Address of the INTC.SET_PD[x] register to set the ServoInterrupt interrupt state to pending. */
#define ServoInterrupt_INTC_SET_PD            ((reg32 *) ServoInterrupt__INTC_SET_PD_REG)

/* Address of the INTC.CLR_PD[x] register to clear the ServoInterrupt interrupt. */
#define ServoInterrupt_INTC_CLR_PD            ((reg32 *) ServoInterrupt__INTC_CLR_PD_REG)


#endif /* CY_ISR_ServoInterrupt_H */


/* [] END OF FILE */
