land-boards/lb-boards/Hardware/SparkFun/psoc/cores/arduino/D10_Ctrl.h

/*******************************************************************************
* File Name: D10_Ctrl.h  
* Version 1.80
*
* Description:
*  This file containts Control Register function prototypes and register defines
*
* Note:
*
********************************************************************************
* Copyright 2008-2015, Cypress Semiconductor Corporation.  All rights reserved.
* You may use this file only in accordance with the license, terms, conditions, 
* disclaimers, and limitations in the end user license agreement accompanying 
* the software package with which this file was provided.
*******************************************************************************/

#if !defined(CY_CONTROL_REG_D10_Ctrl_H) /* CY_CONTROL_REG_D10_Ctrl_H */
#define CY_CONTROL_REG_D10_Ctrl_H

#include "cytypes.h"

    
/***************************************
*     Data Struct Definitions
***************************************/

/* Sleep Mode API Support */
typedef struct
{
    uint8 controlState;

} D10_Ctrl_BACKUP_STRUCT;


/***************************************
*         Function Prototypes 
***************************************/

void    D10_Ctrl_Write(uint8 control) ;
uint8   D10_Ctrl_Read(void) ;

void D10_Ctrl_SaveConfig(void) ;
void D10_Ctrl_RestoreConfig(void) ;
void D10_Ctrl_Sleep(void) ; 
void D10_Ctrl_Wakeup(void) ;


/***************************************
*            Registers        
***************************************/

/* Control Register */
#define D10_Ctrl_Control        (* (reg8 *) D10_Ctrl_Sync_ctrl_reg__CONTROL_REG )
#define D10_Ctrl_Control_PTR    (  (reg8 *) D10_Ctrl_Sync_ctrl_reg__CONTROL_REG )

#endif /* End CY_CONTROL_REG_D10_Ctrl_H */


/* [] END OF FILE */
