land-boards/lb-boards/Raspberry Pi Cards/RPPSOC/PSOC-SPI/PSOC-SPI/PSOC-SPI.cydsn/codegentemp/cyfitter.h

#ifndef INCLUDED_CYFITTER_H
#define INCLUDED_CYFITTER_H
#include "cydevice.h"
#include "cydevice_trm.h"

/* SS */
#define SS__0__INTTYPE CYREG_PICU6_INTTYPE4
#define SS__0__MASK 0x10u
#define SS__0__PC CYREG_PRT6_PC4
#define SS__0__PORT 6u
#define SS__0__SHIFT 4
#define SS__AG CYREG_PRT6_AG
#define SS__AMUX CYREG_PRT6_AMUX
#define SS__BIE CYREG_PRT6_BIE
#define SS__BIT_MASK CYREG_PRT6_BIT_MASK
#define SS__BYP CYREG_PRT6_BYP
#define SS__CTL CYREG_PRT6_CTL
#define SS__DM0 CYREG_PRT6_DM0
#define SS__DM1 CYREG_PRT6_DM1
#define SS__DM2 CYREG_PRT6_DM2
#define SS__DR CYREG_PRT6_DR
#define SS__INP_DIS CYREG_PRT6_INP_DIS
#define SS__INTTYPE_BASE CYDEV_PICU_INTTYPE_PICU6_BASE
#define SS__LCD_COM_SEG CYREG_PRT6_LCD_COM_SEG
#define SS__LCD_EN CYREG_PRT6_LCD_EN
#define SS__MASK 0x10u
#define SS__PORT 6u
#define SS__PRT CYREG_PRT6_PRT
#define SS__PRTDSI__CAPS_SEL CYREG_PRT6_CAPS_SEL
#define SS__PRTDSI__DBL_SYNC_IN CYREG_PRT6_DBL_SYNC_IN
#define SS__PRTDSI__OE_SEL0 CYREG_PRT6_OE_SEL0
#define SS__PRTDSI__OE_SEL1 CYREG_PRT6_OE_SEL1
#define SS__PRTDSI__OUT_SEL0 CYREG_PRT6_OUT_SEL0
#define SS__PRTDSI__OUT_SEL1 CYREG_PRT6_OUT_SEL1
#define SS__PRTDSI__SYNC_OUT CYREG_PRT6_SYNC_OUT
#define SS__PS CYREG_PRT6_PS
#define SS__SHIFT 4
#define SS__SLW CYREG_PRT6_SLW

/* SPI_BSPIS */
#define SPI_BSPIS_BitCounter__16BIT_CONTROL_AUX_CTL_REG CYREG_B0_UDB13_14_ACTL
#define SPI_BSPIS_BitCounter__16BIT_CONTROL_CONTROL_REG CYREG_B0_UDB13_14_CTL
#define SPI_BSPIS_BitCounter__16BIT_CONTROL_COUNT_REG CYREG_B0_UDB13_14_CTL
#define SPI_BSPIS_BitCounter__16BIT_COUNT_CONTROL_REG CYREG_B0_UDB13_14_CTL
#define SPI_BSPIS_BitCounter__16BIT_COUNT_COUNT_REG CYREG_B0_UDB13_14_CTL
#define SPI_BSPIS_BitCounter__16BIT_MASK_MASK_REG CYREG_B0_UDB13_14_MSK
#define SPI_BSPIS_BitCounter__16BIT_MASK_PERIOD_REG CYREG_B0_UDB13_14_MSK
#define SPI_BSPIS_BitCounter__16BIT_PERIOD_MASK_REG CYREG_B0_UDB13_14_MSK
#define SPI_BSPIS_BitCounter__16BIT_PERIOD_PERIOD_REG CYREG_B0_UDB13_14_MSK
#define SPI_BSPIS_BitCounter__CONTROL_AUX_CTL_REG CYREG_B0_UDB13_ACTL
#define SPI_BSPIS_BitCounter__CONTROL_REG CYREG_B0_UDB13_CTL
#define SPI_BSPIS_BitCounter__CONTROL_ST_REG CYREG_B0_UDB13_ST_CTL
#define SPI_BSPIS_BitCounter__COUNT_REG CYREG_B0_UDB13_CTL
#define SPI_BSPIS_BitCounter__COUNT_ST_REG CYREG_B0_UDB13_ST_CTL
#define SPI_BSPIS_BitCounter__MASK_CTL_AUX_CTL_REG CYREG_B0_UDB13_MSK_ACTL
#define SPI_BSPIS_BitCounter__PER_CTL_AUX_CTL_REG CYREG_B0_UDB13_MSK_ACTL
#define SPI_BSPIS_BitCounter__PERIOD_REG CYREG_B0_UDB13_MSK
#define SPI_BSPIS_BitCounter_ST__16BIT_STATUS_AUX_CTL_REG CYREG_B0_UDB13_14_ACTL
#define SPI_BSPIS_BitCounter_ST__16BIT_STATUS_REG CYREG_B0_UDB13_14_ST
#define SPI_BSPIS_BitCounter_ST__MASK_REG CYREG_B0_UDB13_MSK
#define SPI_BSPIS_BitCounter_ST__MASK_ST_AUX_CTL_REG CYREG_B0_UDB13_MSK_ACTL
#define SPI_BSPIS_BitCounter_ST__PER_ST_AUX_CTL_REG CYREG_B0_UDB13_MSK_ACTL
#define SPI_BSPIS_BitCounter_ST__STATUS_AUX_CTL_REG CYREG_B0_UDB13_ACTL
#define SPI_BSPIS_BitCounter_ST__STATUS_CNT_REG CYREG_B0_UDB13_ST_CTL
#define SPI_BSPIS_BitCounter_ST__STATUS_CONTROL_REG CYREG_B0_UDB13_ST_CTL
#define SPI_BSPIS_BitCounter_ST__STATUS_REG CYREG_B0_UDB13_ST
#define SPI_BSPIS_RxStsReg__16BIT_STATUS_AUX_CTL_REG CYREG_B0_UDB14_15_ACTL
#define SPI_BSPIS_RxStsReg__16BIT_STATUS_REG CYREG_B0_UDB14_15_ST
#define SPI_BSPIS_RxStsReg__3__MASK 0x08u
#define SPI_BSPIS_RxStsReg__3__POS 3
#define SPI_BSPIS_RxStsReg__4__MASK 0x10u
#define SPI_BSPIS_RxStsReg__4__POS 4
#define SPI_BSPIS_RxStsReg__5__MASK 0x20u
#define SPI_BSPIS_RxStsReg__5__POS 5
#define SPI_BSPIS_RxStsReg__6__MASK 0x40u
#define SPI_BSPIS_RxStsReg__6__POS 6
#define SPI_BSPIS_RxStsReg__MASK 0x78u
#define SPI_BSPIS_RxStsReg__MASK_REG CYREG_B0_UDB14_MSK
#define SPI_BSPIS_RxStsReg__STATUS_AUX_CTL_REG CYREG_B0_UDB14_ACTL
#define SPI_BSPIS_RxStsReg__STATUS_REG CYREG_B0_UDB14_ST
#define SPI_BSPIS_sR8_Dp_u0__16BIT_A0_REG CYREG_B0_UDB13_14_A0
#define SPI_BSPIS_sR8_Dp_u0__16BIT_A1_REG CYREG_B0_UDB13_14_A1
#define SPI_BSPIS_sR8_Dp_u0__16BIT_D0_REG CYREG_B0_UDB13_14_D0
#define SPI_BSPIS_sR8_Dp_u0__16BIT_D1_REG CYREG_B0_UDB13_14_D1
#define SPI_BSPIS_sR8_Dp_u0__16BIT_DP_AUX_CTL_REG CYREG_B0_UDB13_14_ACTL
#define SPI_BSPIS_sR8_Dp_u0__16BIT_F0_REG CYREG_B0_UDB13_14_F0
#define SPI_BSPIS_sR8_Dp_u0__16BIT_F1_REG CYREG_B0_UDB13_14_F1
#define SPI_BSPIS_sR8_Dp_u0__A0_A1_REG CYREG_B0_UDB13_A0_A1
#define SPI_BSPIS_sR8_Dp_u0__A0_REG CYREG_B0_UDB13_A0
#define SPI_BSPIS_sR8_Dp_u0__A1_REG CYREG_B0_UDB13_A1
#define SPI_BSPIS_sR8_Dp_u0__D0_D1_REG CYREG_B0_UDB13_D0_D1
#define SPI_BSPIS_sR8_Dp_u0__D0_REG CYREG_B0_UDB13_D0
#define SPI_BSPIS_sR8_Dp_u0__D1_REG CYREG_B0_UDB13_D1
#define SPI_BSPIS_sR8_Dp_u0__DP_AUX_CTL_REG CYREG_B0_UDB13_ACTL
#define SPI_BSPIS_sR8_Dp_u0__F0_F1_REG CYREG_B0_UDB13_F0_F1
#define SPI_BSPIS_sR8_Dp_u0__F0_REG CYREG_B0_UDB13_F0
#define SPI_BSPIS_sR8_Dp_u0__F1_REG CYREG_B0_UDB13_F1
#define SPI_BSPIS_sR8_Dp_u0__MSK_DP_AUX_CTL_REG CYREG_B0_UDB13_MSK_ACTL
#define SPI_BSPIS_sR8_Dp_u0__PER_DP_AUX_CTL_REG CYREG_B0_UDB13_MSK_ACTL
#define SPI_BSPIS_TxStsReg__0__MASK 0x01u
#define SPI_BSPIS_TxStsReg__0__POS 0
#define SPI_BSPIS_TxStsReg__1__MASK 0x02u
#define SPI_BSPIS_TxStsReg__1__POS 1
#define SPI_BSPIS_TxStsReg__2__MASK 0x04u
#define SPI_BSPIS_TxStsReg__2__POS 2
#define SPI_BSPIS_TxStsReg__6__MASK 0x40u
#define SPI_BSPIS_TxStsReg__6__POS 6
#define SPI_BSPIS_TxStsReg__MASK 0x47u
#define SPI_BSPIS_TxStsReg__MASK_REG CYREG_B0_UDB15_MSK
#define SPI_BSPIS_TxStsReg__STATUS_AUX_CTL_REG CYREG_B0_UDB15_ACTL
#define SPI_BSPIS_TxStsReg__STATUS_REG CYREG_B0_UDB15_ST

/* MISO */
#define MISO__0__INTTYPE CYREG_PICU6_INTTYPE7
#define MISO__0__MASK 0x80u
#define MISO__0__PC CYREG_PRT6_PC7
#define MISO__0__PORT 6u
#define MISO__0__SHIFT 7
#define MISO__AG CYREG_PRT6_AG
#define MISO__AMUX CYREG_PRT6_AMUX
#define MISO__BIE CYREG_PRT6_BIE
#define MISO__BIT_MASK CYREG_PRT6_BIT_MASK
#define MISO__BYP CYREG_PRT6_BYP
#define MISO__CTL CYREG_PRT6_CTL
#define MISO__DM0 CYREG_PRT6_DM0
#define MISO__DM1 CYREG_PRT6_DM1
#define MISO__DM2 CYREG_PRT6_DM2
#define MISO__DR CYREG_PRT6_DR
#define MISO__INP_DIS CYREG_PRT6_INP_DIS
#define MISO__INTTYPE_BASE CYDEV_PICU_INTTYPE_PICU6_BASE
#define MISO__LCD_COM_SEG CYREG_PRT6_LCD_COM_SEG
#define MISO__LCD_EN CYREG_PRT6_LCD_EN
#define MISO__MASK 0x80u
#define MISO__PORT 6u
#define MISO__PRT CYREG_PRT6_PRT
#define MISO__PRTDSI__CAPS_SEL CYREG_PRT6_CAPS_SEL
#define MISO__PRTDSI__DBL_SYNC_IN CYREG_PRT6_DBL_SYNC_IN
#define MISO__PRTDSI__OE_SEL0 CYREG_PRT6_OE_SEL0
#define MISO__PRTDSI__OE_SEL1 CYREG_PRT6_OE_SEL1
#define MISO__PRTDSI__OUT_SEL0 CYREG_PRT6_OUT_SEL0
#define MISO__PRTDSI__OUT_SEL1 CYREG_PRT6_OUT_SEL1
#define MISO__PRTDSI__SYNC_OUT CYREG_PRT6_SYNC_OUT
#define MISO__PS CYREG_PRT6_PS
#define MISO__SHIFT 7
#define MISO__SLW CYREG_PRT6_SLW

/* MOSI */
#define MOSI__0__INTTYPE CYREG_PICU6_INTTYPE6
#define MOSI__0__MASK 0x40u
#define MOSI__0__PC CYREG_PRT6_PC6
#define MOSI__0__PORT 6u
#define MOSI__0__SHIFT 6
#define MOSI__AG CYREG_PRT6_AG
#define MOSI__AMUX CYREG_PRT6_AMUX
#define MOSI__BIE CYREG_PRT6_BIE
#define MOSI__BIT_MASK CYREG_PRT6_BIT_MASK
#define MOSI__BYP CYREG_PRT6_BYP
#define MOSI__CTL CYREG_PRT6_CTL
#define MOSI__DM0 CYREG_PRT6_DM0
#define MOSI__DM1 CYREG_PRT6_DM1
#define MOSI__DM2 CYREG_PRT6_DM2
#define MOSI__DR CYREG_PRT6_DR
#define MOSI__INP_DIS CYREG_PRT6_INP_DIS
#define MOSI__INTTYPE_BASE CYDEV_PICU_INTTYPE_PICU6_BASE
#define MOSI__LCD_COM_SEG CYREG_PRT6_LCD_COM_SEG
#define MOSI__LCD_EN CYREG_PRT6_LCD_EN
#define MOSI__MASK 0x40u
#define MOSI__PORT 6u
#define MOSI__PRT CYREG_PRT6_PRT
#define MOSI__PRTDSI__CAPS_SEL CYREG_PRT6_CAPS_SEL
#define MOSI__PRTDSI__DBL_SYNC_IN CYREG_PRT6_DBL_SYNC_IN
#define MOSI__PRTDSI__OE_SEL0 CYREG_PRT6_OE_SEL0
#define MOSI__PRTDSI__OE_SEL1 CYREG_PRT6_OE_SEL1
#define MOSI__PRTDSI__OUT_SEL0 CYREG_PRT6_OUT_SEL0
#define MOSI__PRTDSI__OUT_SEL1 CYREG_PRT6_OUT_SEL1
#define MOSI__PRTDSI__SYNC_OUT CYREG_PRT6_SYNC_OUT
#define MOSI__PS CYREG_PRT6_PS
#define MOSI__SHIFT 6
#define MOSI__SLW CYREG_PRT6_SLW

/* SCLK */
#define SCLK__0__INTTYPE CYREG_PICU6_INTTYPE5
#define SCLK__0__MASK 0x20u
#define SCLK__0__PC CYREG_PRT6_PC5
#define SCLK__0__PORT 6u
#define SCLK__0__SHIFT 5
#define SCLK__AG CYREG_PRT6_AG
#define SCLK__AMUX CYREG_PRT6_AMUX
#define SCLK__BIE CYREG_PRT6_BIE
#define SCLK__BIT_MASK CYREG_PRT6_BIT_MASK
#define SCLK__BYP CYREG_PRT6_BYP
#define SCLK__CTL CYREG_PRT6_CTL
#define SCLK__DM0 CYREG_PRT6_DM0
#define SCLK__DM1 CYREG_PRT6_DM1
#define SCLK__DM2 CYREG_PRT6_DM2
#define SCLK__DR CYREG_PRT6_DR
#define SCLK__INP_DIS CYREG_PRT6_INP_DIS
#define SCLK__INTTYPE_BASE CYDEV_PICU_INTTYPE_PICU6_BASE
#define SCLK__LCD_COM_SEG CYREG_PRT6_LCD_COM_SEG
#define SCLK__LCD_EN CYREG_PRT6_LCD_EN
#define SCLK__MASK 0x20u
#define SCLK__PORT 6u
#define SCLK__PRT CYREG_PRT6_PRT
#define SCLK__PRTDSI__CAPS_SEL CYREG_PRT6_CAPS_SEL
#define SCLK__PRTDSI__DBL_SYNC_IN CYREG_PRT6_DBL_SYNC_IN
#define SCLK__PRTDSI__OE_SEL0 CYREG_PRT6_OE_SEL0
#define SCLK__PRTDSI__OE_SEL1 CYREG_PRT6_OE_SEL1
#define SCLK__PRTDSI__OUT_SEL0 CYREG_PRT6_OUT_SEL0
#define SCLK__PRTDSI__OUT_SEL1 CYREG_PRT6_OUT_SEL1
#define SCLK__PRTDSI__SYNC_OUT CYREG_PRT6_SYNC_OUT
#define SCLK__PS CYREG_PRT6_PS
#define SCLK__SHIFT 5
#define SCLK__SLW CYREG_PRT6_SLW

/* I2C_1_I2C_FF */
#define I2C_1_I2C_FF__ADR CYREG_I2C_ADR
#define I2C_1_I2C_FF__CFG CYREG_I2C_CFG
#define I2C_1_I2C_FF__CLK_DIV1 CYREG_I2C_CLK_DIV1
#define I2C_1_I2C_FF__CLK_DIV2 CYREG_I2C_CLK_DIV2
#define I2C_1_I2C_FF__CSR CYREG_I2C_CSR
#define I2C_1_I2C_FF__D CYREG_I2C_D
#define I2C_1_I2C_FF__MCSR CYREG_I2C_MCSR
#define I2C_1_I2C_FF__PM_ACT_CFG CYREG_PM_ACT_CFG5
#define I2C_1_I2C_FF__PM_ACT_MSK 0x04u
#define I2C_1_I2C_FF__PM_STBY_CFG CYREG_PM_STBY_CFG5
#define I2C_1_I2C_FF__PM_STBY_MSK 0x04u
#define I2C_1_I2C_FF__TMOUT_CFG0 CYREG_I2C_TMOUT_CFG0
#define I2C_1_I2C_FF__TMOUT_CFG1 CYREG_I2C_TMOUT_CFG1
#define I2C_1_I2C_FF__TMOUT_CSR CYREG_I2C_TMOUT_CSR
#define I2C_1_I2C_FF__TMOUT_SR CYREG_I2C_TMOUT_SR
#define I2C_1_I2C_FF__XCFG CYREG_I2C_XCFG

/* I2C_1_I2C_IRQ */
#define I2C_1_I2C_IRQ__INTC_CLR_EN_REG CYREG_NVIC_CLRENA0
#define I2C_1_I2C_IRQ__INTC_CLR_PD_REG CYREG_NVIC_CLRPEND0
#define I2C_1_I2C_IRQ__INTC_MASK 0x8000u
#define I2C_1_I2C_IRQ__INTC_NUMBER 15u
#define I2C_1_I2C_IRQ__INTC_PRIOR_NUM 7u
#define I2C_1_I2C_IRQ__INTC_PRIOR_REG CYREG_NVIC_PRI_15
#define I2C_1_I2C_IRQ__INTC_SET_EN_REG CYREG_NVIC_SETENA0
#define I2C_1_I2C_IRQ__INTC_SET_PD_REG CYREG_NVIC_SETPEND0

/* SCL_1 */
#define SCL_1__0__INTTYPE CYREG_PICU0_INTTYPE0
#define SCL_1__0__MASK 0x01u
#define SCL_1__0__PC CYREG_PRT0_PC0
#define SCL_1__0__PORT 0u
#define SCL_1__0__SHIFT 0
#define SCL_1__AG CYREG_PRT0_AG
#define SCL_1__AMUX CYREG_PRT0_AMUX
#define SCL_1__BIE CYREG_PRT0_BIE
#define SCL_1__BIT_MASK CYREG_PRT0_BIT_MASK
#define SCL_1__BYP CYREG_PRT0_BYP
#define SCL_1__CTL CYREG_PRT0_CTL
#define SCL_1__DM0 CYREG_PRT0_DM0
#define SCL_1__DM1 CYREG_PRT0_DM1
#define SCL_1__DM2 CYREG_PRT0_DM2
#define SCL_1__DR CYREG_PRT0_DR
#define SCL_1__INP_DIS CYREG_PRT0_INP_DIS
#define SCL_1__INTTYPE_BASE CYDEV_PICU_INTTYPE_PICU0_BASE
#define SCL_1__LCD_COM_SEG CYREG_PRT0_LCD_COM_SEG
#define SCL_1__LCD_EN CYREG_PRT0_LCD_EN
#define SCL_1__MASK 0x01u
#define SCL_1__PORT 0u
#define SCL_1__PRT CYREG_PRT0_PRT
#define SCL_1__PRTDSI__CAPS_SEL CYREG_PRT0_CAPS_SEL
#define SCL_1__PRTDSI__DBL_SYNC_IN CYREG_PRT0_DBL_SYNC_IN
#define SCL_1__PRTDSI__OE_SEL0 CYREG_PRT0_OE_SEL0
#define SCL_1__PRTDSI__OE_SEL1 CYREG_PRT0_OE_SEL1
#define SCL_1__PRTDSI__OUT_SEL0 CYREG_PRT0_OUT_SEL0
#define SCL_1__PRTDSI__OUT_SEL1 CYREG_PRT0_OUT_SEL1
#define SCL_1__PRTDSI__SYNC_OUT CYREG_PRT0_SYNC_OUT
#define SCL_1__PS CYREG_PRT0_PS
#define SCL_1__SHIFT 0
#define SCL_1__SLW CYREG_PRT0_SLW

/* SDA_1 */
#define SDA_1__0__INTTYPE CYREG_PICU0_INTTYPE1
#define SDA_1__0__MASK 0x02u
#define SDA_1__0__PC CYREG_PRT0_PC1
#define SDA_1__0__PORT 0u
#define SDA_1__0__SHIFT 1
#define SDA_1__AG CYREG_PRT0_AG
#define SDA_1__AMUX CYREG_PRT0_AMUX
#define SDA_1__BIE CYREG_PRT0_BIE
#define SDA_1__BIT_MASK CYREG_PRT0_BIT_MASK
#define SDA_1__BYP CYREG_PRT0_BYP
#define SDA_1__CTL CYREG_PRT0_CTL
#define SDA_1__DM0 CYREG_PRT0_DM0
#define SDA_1__DM1 CYREG_PRT0_DM1
#define SDA_1__DM2 CYREG_PRT0_DM2
#define SDA_1__DR CYREG_PRT0_DR
#define SDA_1__INP_DIS CYREG_PRT0_INP_DIS
#define SDA_1__INTTYPE_BASE CYDEV_PICU_INTTYPE_PICU0_BASE
#define SDA_1__LCD_COM_SEG CYREG_PRT0_LCD_COM_SEG
#define SDA_1__LCD_EN CYREG_PRT0_LCD_EN
#define SDA_1__MASK 0x02u
#define SDA_1__PORT 0u
#define SDA_1__PRT CYREG_PRT0_PRT
#define SDA_1__PRTDSI__CAPS_SEL CYREG_PRT0_CAPS_SEL
#define SDA_1__PRTDSI__DBL_SYNC_IN CYREG_PRT0_DBL_SYNC_IN
#define SDA_1__PRTDSI__OE_SEL0 CYREG_PRT0_OE_SEL0
#define SDA_1__PRTDSI__OE_SEL1 CYREG_PRT0_OE_SEL1
#define SDA_1__PRTDSI__OUT_SEL0 CYREG_PRT0_OUT_SEL0
#define SDA_1__PRTDSI__OUT_SEL1 CYREG_PRT0_OUT_SEL1
#define SDA_1__PRTDSI__SYNC_OUT CYREG_PRT0_SYNC_OUT
#define SDA_1__PS CYREG_PRT0_PS
#define SDA_1__SHIFT 1
#define SDA_1__SLW CYREG_PRT0_SLW

/* Clock_1 */
#define Clock_1__CFG0 CYREG_CLKDIST_DCFG0_CFG0
#define Clock_1__CFG1 CYREG_CLKDIST_DCFG0_CFG1
#define Clock_1__CFG2 CYREG_CLKDIST_DCFG0_CFG2
#define Clock_1__CFG2_SRC_SEL_MASK 0x07u
#define Clock_1__INDEX 0x00u
#define Clock_1__PM_ACT_CFG CYREG_PM_ACT_CFG2
#define Clock_1__PM_ACT_MSK 0x01u
#define Clock_1__PM_STBY_CFG CYREG_PM_STBY_CFG2
#define Clock_1__PM_STBY_MSK 0x01u

/* Miscellaneous */
#define BCLK__BUS_CLK__HZ 24000000U
#define BCLK__BUS_CLK__KHZ 24000U
#define BCLK__BUS_CLK__MHZ 24U
#define CY_PROJECT_NAME "PSOC-SPI"
#define CY_VERSION "PSoC Creator  3.3"
#define CYDEV_CHIP_DIE_LEOPARD 1u
#define CYDEV_CHIP_DIE_PANTHER 18u
#define CYDEV_CHIP_DIE_PSOC4A 10u
#define CYDEV_CHIP_DIE_PSOC5LP 17u
#define CYDEV_CHIP_DIE_TMA4 2u
#define CYDEV_CHIP_DIE_UNKNOWN 0u
#define CYDEV_CHIP_FAMILY_PSOC3 1u
#define CYDEV_CHIP_FAMILY_PSOC4 2u
#define CYDEV_CHIP_FAMILY_PSOC5 3u
#define CYDEV_CHIP_FAMILY_UNKNOWN 0u
#define CYDEV_CHIP_FAMILY_USED CYDEV_CHIP_FAMILY_PSOC5
#define CYDEV_CHIP_JTAG_ID 0x2E133069u
#define CYDEV_CHIP_MEMBER_3A 1u
#define CYDEV_CHIP_MEMBER_4A 10u
#define CYDEV_CHIP_MEMBER_4C 15u
#define CYDEV_CHIP_MEMBER_4D 6u
#define CYDEV_CHIP_MEMBER_4E 4u
#define CYDEV_CHIP_MEMBER_4F 11u
#define CYDEV_CHIP_MEMBER_4G 2u
#define CYDEV_CHIP_MEMBER_4H 9u
#define CYDEV_CHIP_MEMBER_4I 14u
#define CYDEV_CHIP_MEMBER_4J 7u
#define CYDEV_CHIP_MEMBER_4K 8u
#define CYDEV_CHIP_MEMBER_4L 13u
#define CYDEV_CHIP_MEMBER_4M 12u
#define CYDEV_CHIP_MEMBER_4N 5u
#define CYDEV_CHIP_MEMBER_4U 3u
#define CYDEV_CHIP_MEMBER_5A 17u
#define CYDEV_CHIP_MEMBER_5B 16u
#define CYDEV_CHIP_MEMBER_UNKNOWN 0u
#define CYDEV_CHIP_MEMBER_USED CYDEV_CHIP_MEMBER_5B
#define CYDEV_CHIP_DIE_EXPECT CYDEV_CHIP_MEMBER_USED
#define CYDEV_CHIP_DIE_ACTUAL CYDEV_CHIP_DIE_EXPECT
#define CYDEV_CHIP_REV_LEOPARD_ES1 0u
#define CYDEV_CHIP_REV_LEOPARD_ES2 1u
#define CYDEV_CHIP_REV_LEOPARD_ES3 3u
#define CYDEV_CHIP_REV_LEOPARD_PRODUCTION 3u
#define CYDEV_CHIP_REV_PANTHER_ES0 0u
#define CYDEV_CHIP_REV_PANTHER_ES1 1u
#define CYDEV_CHIP_REV_PANTHER_PRODUCTION 1u
#define CYDEV_CHIP_REV_PSOC4A_ES0 17u
#define CYDEV_CHIP_REV_PSOC4A_PRODUCTION 17u
#define CYDEV_CHIP_REV_PSOC5LP_ES0 0u
#define CYDEV_CHIP_REV_PSOC5LP_PRODUCTION 0u
#define CYDEV_CHIP_REV_TMA4_ES 17u
#define CYDEV_CHIP_REV_TMA4_ES2 33u
#define CYDEV_CHIP_REV_TMA4_PRODUCTION 17u
#define CYDEV_CHIP_REVISION_3A_ES1 0u
#define CYDEV_CHIP_REVISION_3A_ES2 1u
#define CYDEV_CHIP_REVISION_3A_ES3 3u
#define CYDEV_CHIP_REVISION_3A_PRODUCTION 3u
#define CYDEV_CHIP_REVISION_4A_ES0 17u
#define CYDEV_CHIP_REVISION_4A_PRODUCTION 17u
#define CYDEV_CHIP_REVISION_4C_PRODUCTION 0u
#define CYDEV_CHIP_REVISION_4D_PRODUCTION 0u
#define CYDEV_CHIP_REVISION_4E_PRODUCTION 0u
#define CYDEV_CHIP_REVISION_4F_PRODUCTION 0u
#define CYDEV_CHIP_REVISION_4F_PRODUCTION_256DMA 0u
#define CYDEV_CHIP_REVISION_4F_PRODUCTION_256K 0u
#define CYDEV_CHIP_REVISION_4G_ES 17u
#define CYDEV_CHIP_REVISION_4G_ES2 33u
#define CYDEV_CHIP_REVISION_4G_PRODUCTION 17u
#define CYDEV_CHIP_REVISION_4H_PRODUCTION 0u
#define CYDEV_CHIP_REVISION_4I_PRODUCTION 0u
#define CYDEV_CHIP_REVISION_4J_PRODUCTION 0u
#define CYDEV_CHIP_REVISION_4K_PRODUCTION 0u
#define CYDEV_CHIP_REVISION_4L_PRODUCTION 0u
#define CYDEV_CHIP_REVISION_4M_PRODUCTION 0u
#define CYDEV_CHIP_REVISION_4N_PRODUCTION 0u
#define CYDEV_CHIP_REVISION_4U_PRODUCTION 0u
#define CYDEV_CHIP_REVISION_5A_ES0 0u
#define CYDEV_CHIP_REVISION_5A_ES1 1u
#define CYDEV_CHIP_REVISION_5A_PRODUCTION 1u
#define CYDEV_CHIP_REVISION_5B_ES0 0u
#define CYDEV_CHIP_REVISION_5B_PRODUCTION 0u
#define CYDEV_CHIP_REVISION_USED CYDEV_CHIP_REVISION_5B_PRODUCTION
#define CYDEV_CHIP_REV_EXPECT CYDEV_CHIP_REVISION_USED
#define CYDEV_CONFIG_FASTBOOT_ENABLED 1
#define CYDEV_CONFIG_UNUSED_IO_AllowButWarn 0
#define CYDEV_CONFIG_UNUSED_IO CYDEV_CONFIG_UNUSED_IO_AllowButWarn
#define CYDEV_CONFIG_UNUSED_IO_AllowWithInfo 1
#define CYDEV_CONFIG_UNUSED_IO_Disallowed 2
#define CYDEV_CONFIGURATION_COMPRESSED 1
#define CYDEV_CONFIGURATION_DMA 0
#define CYDEV_CONFIGURATION_ECC 1
#define CYDEV_CONFIGURATION_IMOENABLED CYDEV_CONFIG_FASTBOOT_ENABLED
#define CYDEV_CONFIGURATION_MODE_COMPRESSED 0
#define CYDEV_CONFIGURATION_MODE CYDEV_CONFIGURATION_MODE_COMPRESSED
#define CYDEV_CONFIGURATION_MODE_DMA 2
#define CYDEV_CONFIGURATION_MODE_UNCOMPRESSED 1
#define CYDEV_DEBUG_ENABLE_MASK 0x20u
#define CYDEV_DEBUG_ENABLE_REGISTER CYREG_MLOGIC_DEBUG
#define CYDEV_DEBUGGING_DPS_Disable 3
#define CYDEV_DEBUGGING_DPS_JTAG_4 1
#define CYDEV_DEBUGGING_DPS_JTAG_5 0
#define CYDEV_DEBUGGING_DPS_SWD 2
#define CYDEV_DEBUGGING_DPS_SWD_SWV 6
#define CYDEV_DEBUGGING_DPS CYDEV_DEBUGGING_DPS_SWD_SWV
#define CYDEV_DEBUGGING_ENABLE 1
#define CYDEV_DEBUGGING_XRES 0
#define CYDEV_DMA_CHANNELS_AVAILABLE 24u
#define CYDEV_ECC_ENABLE 0
#define CYDEV_HEAP_SIZE 0x80
#define CYDEV_INSTRUCT_CACHE_ENABLED 1
#define CYDEV_INTR_RISING 0x00008000u
#define CYDEV_IS_EXPORTING_CODE 0
#define CYDEV_IS_IMPORTING_CODE 0
#define CYDEV_PROJ_TYPE 0
#define CYDEV_PROJ_TYPE_BOOTLOADER 1
#define CYDEV_PROJ_TYPE_LAUNCHER 5
#define CYDEV_PROJ_TYPE_LOADABLE 2
#define CYDEV_PROJ_TYPE_LOADABLEANDBOOTLOADER 4
#define CYDEV_PROJ_TYPE_MULTIAPPBOOTLOADER 3
#define CYDEV_PROJ_TYPE_STANDARD 0
#define CYDEV_PROTECTION_ENABLE 0
#define CYDEV_STACK_SIZE 0x0800
#define CYDEV_USE_BUNDLED_CMSIS 1
#define CYDEV_VARIABLE_VDDA 0
#define CYDEV_VDDA 5.0
#define CYDEV_VDDA_MV 5000
#define CYDEV_VDDD 5.0
#define CYDEV_VDDD_MV 5000
#define CYDEV_VDDIO0 5.0
#define CYDEV_VDDIO0_MV 5000
#define CYDEV_VDDIO1 5.0
#define CYDEV_VDDIO1_MV 5000
#define CYDEV_VDDIO2 5.0
#define CYDEV_VDDIO2_MV 5000
#define CYDEV_VDDIO3 5.0
#define CYDEV_VDDIO3_MV 5000
#define CYDEV_VIO0 5.0
#define CYDEV_VIO0_MV 5000
#define CYDEV_VIO1 5.0
#define CYDEV_VIO1_MV 5000
#define CYDEV_VIO2 5.0
#define CYDEV_VIO2_MV 5000
#define CYDEV_VIO3 5.0
#define CYDEV_VIO3_MV 5000
#define CYIPBLOCK_ARM_CM3_VERSION 0
#define CYIPBLOCK_P3_ANAIF_VERSION 0
#define CYIPBLOCK_P3_CAPSENSE_VERSION 0
#define CYIPBLOCK_P3_COMP_VERSION 0
#define CYIPBLOCK_P3_DMA_VERSION 0
#define CYIPBLOCK_P3_DRQ_VERSION 0
#define CYIPBLOCK_P3_EMIF_VERSION 0
#define CYIPBLOCK_P3_I2C_VERSION 0
#define CYIPBLOCK_P3_LCD_VERSION 0
#define CYIPBLOCK_P3_LPF_VERSION 0
#define CYIPBLOCK_P3_PM_VERSION 0
#define CYIPBLOCK_P3_TIMER_VERSION 0
#define CYIPBLOCK_P3_USB_VERSION 0
#define CYIPBLOCK_P3_VIDAC_VERSION 0
#define CYIPBLOCK_P3_VREF_VERSION 0
#define CYIPBLOCK_S8_GPIO_VERSION 0
#define CYIPBLOCK_S8_IRQ_VERSION 0
#define CYIPBLOCK_S8_SAR_VERSION 0
#define CYIPBLOCK_S8_SIO_VERSION 0
#define CYIPBLOCK_S8_UDB_VERSION 0
#define DMA_CHANNELS_USED__MASK0 0x00000000u
#define CYDEV_BOOTLOADER_ENABLE 0

#endif /* INCLUDED_CYFITTER_H */
