land-boards/lb-boards/Hardware/SparkFun/psoc/cores/arduino/USBUART.h

/*******************************************************************************
* File Name: USBUART.h
* Version 2.80
*
* Description:
*  Header File for the USBFS component. Contains prototypes and constant values.
*
********************************************************************************
* Copyright 2008-2014, Cypress Semiconductor Corporation.  All rights reserved.
* You may use this file only in accordance with the license, terms, conditions,
* disclaimers, and limitations in the end user license agreement accompanying
* the software package with which this file was provided.
*******************************************************************************/

#if !defined(CY_USBFS_USBUART_H)
#define CY_USBFS_USBUART_H

#include "cytypes.h"
#include "cydevice_trm.h"
#include "cyfitter.h"
#include "CyLib.h"

/*  User supplied definitions. */
/* `#START USER_DEFINITIONS` Place your declaration here */

/* `#END` */


/***************************************
* Conditional Compilation Parameters
***************************************/

/* Check to see if required defines such as CY_PSOC5LP are available */
/* They are defined starting with cy_boot v3.0 */
#if !defined (CY_PSOC5LP)
    #error Component USBFS_v2_80 requires cy_boot v3.0 or later
#endif /* (CY_PSOC5LP) */


/***************************************
*  Memory Type Definitions
***************************************/

/* Renamed Type Definitions for backward compatibility.
*  Should not be used in new designs.
*/
#define USBUART_CODE CYCODE
#define USBUART_FAR CYFAR
#if defined(__C51__) || defined(__CX51__)
    #define USBUART_DATA data
    #define USBUART_XDATA xdata
#else
    #define USBUART_DATA
    #define USBUART_XDATA
#endif /*  __C51__ */
#define USBUART_NULL       NULL


/***************************************
* Enumerated Types and Parameters
***************************************/

#define USBUART__EP_MANUAL 0
#define USBUART__EP_DMAMANUAL 1
#define USBUART__EP_DMAAUTO 2

#define USBUART__MA_STATIC 0
#define USBUART__MA_DYNAMIC 1



/***************************************
*    Initial Parameter Constants
***************************************/

#define USBUART_NUM_DEVICES   (1u)
#define USBUART_ENABLE_CDC_CLASS   
#define USBUART_ENABLE_DESCRIPTOR_STRINGS   
#define USBUART_ENABLE_MSOS_STRING   
#define USBUART_ENABLE_SN_STRING   
#define USBUART_ENABLE_IDSN_STRING   
#define USBUART_ENABLE_STRINGS   
#define USBUART_MAX_REPORTID_NUMBER   (0u)

#define USBUART_MON_VBUS                       (0u)
#define USBUART_EXTERN_VBUS                    (0u)
#define USBUART_EXTERN_VND                     (0u)
#define USBUART_EXTERN_CLS                     (0u)
#define USBUART_MAX_INTERFACES_NUMBER          (2u)
#define USBUART_EP0_ISR_REMOVE                 (0u)
#define USBUART_EP1_ISR_REMOVE                 (0u)
#define USBUART_EP2_ISR_REMOVE                 (0u)
#define USBUART_EP3_ISR_REMOVE                 (0u)
#define USBUART_EP4_ISR_REMOVE                 (1u)
#define USBUART_EP5_ISR_REMOVE                 (1u)
#define USBUART_EP6_ISR_REMOVE                 (1u)
#define USBUART_EP7_ISR_REMOVE                 (1u)
#define USBUART_EP8_ISR_REMOVE                 (1u)
#define USBUART_EP_MM                          (0u)
#define USBUART_EP_MA                          (0u)
#define USBUART_EP_DMA_AUTO_OPT                (0u)
#define USBUART_DMA1_REMOVE                    (1u)
#define USBUART_DMA2_REMOVE                    (1u)
#define USBUART_DMA3_REMOVE                    (1u)
#define USBUART_DMA4_REMOVE                    (1u)
#define USBUART_DMA5_REMOVE                    (1u)
#define USBUART_DMA6_REMOVE                    (1u)
#define USBUART_DMA7_REMOVE                    (1u)
#define USBUART_DMA8_REMOVE                    (1u)
#define USBUART_SOF_ISR_REMOVE                 (0u)
#define USBUART_ARB_ISR_REMOVE                 (0u)
#define USBUART_DP_ISR_REMOVE                  (0u)
#define USBUART_ENABLE_CDC_CLASS_API           (1u)
#define USBUART_ENABLE_MIDI_API                (1u)
#define USBUART_MIDI_EXT_MODE                  (0u)


/***************************************
*    Data Struct Definition
***************************************/

typedef struct
{
    uint8  attrib;
    uint8  apiEpState;
    uint8  hwEpState;
    uint8  epToggle;
    uint8  addr;
    uint8  epMode;
    uint16 buffOffset;
    uint16 bufferSize;
    uint8  interface;
} T_USBUART_EP_CTL_BLOCK;

typedef struct
{
    uint8  interface;
    uint8  altSetting;
    uint8  addr;
    uint8  attributes;
    uint16 bufferSize;
    uint8  bMisc;
} T_USBUART_EP_SETTINGS_BLOCK;

typedef struct
{
    uint8  status;
    uint16 length;
} T_USBUART_XFER_STATUS_BLOCK;

typedef struct
{
    uint16  count;
    volatile uint8 *pData;
    T_USBUART_XFER_STATUS_BLOCK *pStatusBlock;
} T_USBUART_TD;


typedef struct
{
    uint8   c;
    const void *p_list;
} T_USBUART_LUT;

/* Resume/Suspend API Support */
typedef struct
{
    uint8 enableState;
    uint8 mode;
} USBUART_BACKUP_STRUCT;


/* Renamed structure fields for backward compatibility.
*  Should not be used in new designs.
*/
#define wBuffOffset         buffOffset
#define wBufferSize         bufferSize
#define bStatus             status
#define wLength             length
#define wCount              count

/* Renamed global variable for backward compatibility.
*  Should not be used in new designs.
*/
#define CurrentTD           USBUART_currentTD


/***************************************
*       Function Prototypes
***************************************/

void   USBUART_Start(uint8 device, uint8 mode) ;
void   USBUART_Init(void) ;
void   USBUART_InitComponent(uint8 device, uint8 mode) ;
void   USBUART_Stop(void) ;
uint8  USBUART_CheckActivity(void) ;
uint8  USBUART_GetConfiguration(void) ;
uint8  USBUART_IsConfigurationChanged(void) ;
uint8  USBUART_GetInterfaceSetting(uint8 interfaceNumber)
                                                        ;
uint8  USBUART_GetEPState(uint8 epNumber) ;
uint16 USBUART_GetEPCount(uint8 epNumber) ;
void   USBUART_LoadInEP(uint8 epNumber, const uint8 pData[], uint16 length)
                                                                    ;
uint16 USBUART_ReadOutEP(uint8 epNumber, uint8 pData[], uint16 length)
                                                                    ;
void   USBUART_EnableOutEP(uint8 epNumber) ;
void   USBUART_DisableOutEP(uint8 epNumber) ;
void   USBUART_Force(uint8 bState) ;
uint8  USBUART_GetEPAckState(uint8 epNumber) ;
void   USBUART_SetPowerStatus(uint8 powerStatus) ;
uint8  USBUART_RWUEnabled(void) ;
void   USBUART_TerminateEP(uint8 ep) ;

void   USBUART_Suspend(void) ;
void   USBUART_Resume(void) ;

#if defined(USBUART_ENABLE_FWSN_STRING)
    void   USBUART_SerialNumString(uint8 snString[]) ;
#endif  /* USBUART_ENABLE_FWSN_STRING */
#if (USBUART_MON_VBUS == 1u)
    uint8  USBUART_VBusPresent(void) ;
#endif /*  USBUART_MON_VBUS */

#if defined(CYDEV_BOOTLOADER_IO_COMP) && ((CYDEV_BOOTLOADER_IO_COMP == CyBtldr_USBUART) || \
                                          (CYDEV_BOOTLOADER_IO_COMP == CyBtldr_Custom_Interface))

    void USBUART_CyBtldrCommStart(void) ;
    void USBUART_CyBtldrCommStop(void) ;
    void USBUART_CyBtldrCommReset(void) ;
    cystatus USBUART_CyBtldrCommWrite(const uint8 pData[], uint16 size, uint16 *count, uint8 timeOut) CYSMALL
                                                        ;
    cystatus USBUART_CyBtldrCommRead       (uint8 pData[], uint16 size, uint16 *count, uint8 timeOut) CYSMALL
                                                        ;

    #define USBUART_BTLDR_OUT_EP      (0x01u)
    #define USBUART_BTLDR_IN_EP       (0x02u)

    #define USBUART_BTLDR_SIZEOF_WRITE_BUFFER  (64u)   /* EP 1 OUT */
    #define USBUART_BTLDR_SIZEOF_READ_BUFFER   (64u)   /* EP 2 IN  */
    #define USBUART_BTLDR_MAX_PACKET_SIZE      USBUART_BTLDR_SIZEOF_WRITE_BUFFER

    #define USBUART_BTLDR_WAIT_1_MS            (1u)    /* Time Out quantity equal 1mS */

    /* These defines active if used USBFS interface as an
    *  IO Component for bootloading. When Custom_Interface selected
    *  in Bootloder configuration as the IO Component, user must
    *  provide these functions.
    */
    #if (CYDEV_BOOTLOADER_IO_COMP == CyBtldr_USBUART)
        #define CyBtldrCommStart        USBUART_CyBtldrCommStart
        #define CyBtldrCommStop         USBUART_CyBtldrCommStop
        #define CyBtldrCommReset        USBUART_CyBtldrCommReset
        #define CyBtldrCommWrite        USBUART_CyBtldrCommWrite
        #define CyBtldrCommRead         USBUART_CyBtldrCommRead
    #endif  /*End   CYDEV_BOOTLOADER_IO_COMP == CyBtldr_USBUART */

#endif /*  CYDEV_BOOTLOADER_IO_COMP  */

#if(USBUART_EP_MM != USBUART__EP_MANUAL)
    void USBUART_InitEP_DMA(uint8 epNumber, const uint8* pData)
                                                    ;
    void USBUART_Stop_DMA(uint8 epNumber) ;
#endif /*  USBUART_EP_MM != USBUART__EP_MANUAL) */

#if defined(USBUART_ENABLE_MIDI_STREAMING) && (USBUART_ENABLE_MIDI_API != 0u)
    void USBUART_MIDI_EP_Init(void) ;

    #if (USBUART_MIDI_IN_BUFF_SIZE > 0)
        void USBUART_MIDI_IN_Service(void) ;
        uint8 USBUART_PutUsbMidiIn(uint8 ic, const uint8 midiMsg[], uint8 cable)
                                                                ;
    #endif /* USBUART_MIDI_IN_BUFF_SIZE > 0 */

    #if (USBUART_MIDI_OUT_BUFF_SIZE > 0)
        void USBUART_MIDI_OUT_EP_Service(void) ;
    #endif /* USBUART_MIDI_OUT_BUFF_SIZE > 0 */

#endif /*  USBUART_ENABLE_MIDI_API != 0u */

/* Renamed Functions for backward compatibility.
*  Should not be used in new designs.
*/

#define USBUART_bCheckActivity             USBUART_CheckActivity
#define USBUART_bGetConfiguration          USBUART_GetConfiguration
#define USBUART_bGetInterfaceSetting       USBUART_GetInterfaceSetting
#define USBUART_bGetEPState                USBUART_GetEPState
#define USBUART_wGetEPCount                USBUART_GetEPCount
#define USBUART_bGetEPAckState             USBUART_GetEPAckState
#define USBUART_bRWUEnabled                USBUART_RWUEnabled
#define USBUART_bVBusPresent               USBUART_VBusPresent

#define USBUART_bConfiguration             USBUART_configuration
#define USBUART_bInterfaceSetting          USBUART_interfaceSetting
#define USBUART_bDeviceAddress             USBUART_deviceAddress
#define USBUART_bDeviceStatus              USBUART_deviceStatus
#define USBUART_bDevice                    USBUART_device
#define USBUART_bTransferState             USBUART_transferState
#define USBUART_bLastPacketSize            USBUART_lastPacketSize

#define USBUART_LoadEP                     USBUART_LoadInEP
#define USBUART_LoadInISOCEP               USBUART_LoadInEP
#define USBUART_EnableOutISOCEP            USBUART_EnableOutEP

#define USBUART_SetVector                  CyIntSetVector
#define USBUART_SetPriority                CyIntSetPriority
#define USBUART_EnableInt                  CyIntEnable


/***************************************
*          API Constants
***************************************/

#define USBUART_EP0                        (0u)
#define USBUART_EP1                        (1u)
#define USBUART_EP2                        (2u)
#define USBUART_EP3                        (3u)
#define USBUART_EP4                        (4u)
#define USBUART_EP5                        (5u)
#define USBUART_EP6                        (6u)
#define USBUART_EP7                        (7u)
#define USBUART_EP8                        (8u)
#define USBUART_MAX_EP                     (9u)

#define USBUART_TRUE                       (1u)
#define USBUART_FALSE                      (0u)

#define USBUART_NO_EVENT_ALLOWED           (2u)
#define USBUART_EVENT_PENDING              (1u)
#define USBUART_NO_EVENT_PENDING           (0u)

#define USBUART_IN_BUFFER_FULL             USBUART_NO_EVENT_PENDING
#define USBUART_IN_BUFFER_EMPTY            USBUART_EVENT_PENDING
#define USBUART_OUT_BUFFER_FULL            USBUART_EVENT_PENDING
#define USBUART_OUT_BUFFER_EMPTY           USBUART_NO_EVENT_PENDING

#define USBUART_FORCE_J                    (0xA0u)
#define USBUART_FORCE_K                    (0x80u)
#define USBUART_FORCE_SE0                  (0xC0u)
#define USBUART_FORCE_NONE                 (0x00u)

#define USBUART_IDLE_TIMER_RUNNING         (0x02u)
#define USBUART_IDLE_TIMER_EXPIRED         (0x01u)
#define USBUART_IDLE_TIMER_INDEFINITE      (0x00u)

#define USBUART_DEVICE_STATUS_BUS_POWERED  (0x00u)
#define USBUART_DEVICE_STATUS_SELF_POWERED (0x01u)

#define USBUART_3V_OPERATION               (0x00u)
#define USBUART_5V_OPERATION               (0x01u)
#define USBUART_DWR_VDDD_OPERATION         (0x02u)

#define USBUART_MODE_DISABLE               (0x00u)
#define USBUART_MODE_NAK_IN_OUT            (0x01u)
#define USBUART_MODE_STATUS_OUT_ONLY       (0x02u)
#define USBUART_MODE_STALL_IN_OUT          (0x03u)
#define USBUART_MODE_RESERVED_0100         (0x04u)
#define USBUART_MODE_ISO_OUT               (0x05u)
#define USBUART_MODE_STATUS_IN_ONLY        (0x06u)
#define USBUART_MODE_ISO_IN                (0x07u)
#define USBUART_MODE_NAK_OUT               (0x08u)
#define USBUART_MODE_ACK_OUT               (0x09u)
#define USBUART_MODE_RESERVED_1010         (0x0Au)
#define USBUART_MODE_ACK_OUT_STATUS_IN     (0x0Bu)
#define USBUART_MODE_NAK_IN                (0x0Cu)
#define USBUART_MODE_ACK_IN                (0x0Du)
#define USBUART_MODE_RESERVED_1110         (0x0Eu)
#define USBUART_MODE_ACK_IN_STATUS_OUT     (0x0Fu)
#define USBUART_MODE_MASK                  (0x0Fu)
#define USBUART_MODE_STALL_DATA_EP         (0x80u)

#define USBUART_MODE_ACKD                  (0x10u)
#define USBUART_MODE_OUT_RCVD              (0x20u)
#define USBUART_MODE_IN_RCVD               (0x40u)
#define USBUART_MODE_SETUP_RCVD            (0x80u)

#define USBUART_RQST_TYPE_MASK             (0x60u)
#define USBUART_RQST_TYPE_STD              (0x00u)
#define USBUART_RQST_TYPE_CLS              (0x20u)
#define USBUART_RQST_TYPE_VND              (0x40u)
#define USBUART_RQST_DIR_MASK              (0x80u)
#define USBUART_RQST_DIR_D2H               (0x80u)
#define USBUART_RQST_DIR_H2D               (0x00u)
#define USBUART_RQST_RCPT_MASK             (0x03u)
#define USBUART_RQST_RCPT_DEV              (0x00u)
#define USBUART_RQST_RCPT_IFC              (0x01u)
#define USBUART_RQST_RCPT_EP               (0x02u)
#define USBUART_RQST_RCPT_OTHER            (0x03u)

/* USB Class Codes */
#define USBUART_CLASS_DEVICE               (0x00u)     /* Use class code info from Interface Descriptors */
#define USBUART_CLASS_AUDIO                (0x01u)     /* Audio device */
#define USBUART_CLASS_CDC                  (0x02u)     /* Communication device class */
#define USBUART_CLASS_HID                  (0x03u)     /* Human Interface Device */
#define USBUART_CLASS_PDC                  (0x05u)     /* Physical device class */
#define USBUART_CLASS_IMAGE                (0x06u)     /* Still Imaging device */
#define USBUART_CLASS_PRINTER              (0x07u)     /* Printer device  */
#define USBUART_CLASS_MSD                  (0x08u)     /* Mass Storage device  */
#define USBUART_CLASS_HUB                  (0x09u)     /* Full/Hi speed Hub */
#define USBUART_CLASS_CDC_DATA             (0x0Au)     /* CDC data device */
#define USBUART_CLASS_SMART_CARD           (0x0Bu)     /* Smart Card device */
#define USBUART_CLASS_CSD                  (0x0Du)     /* Content Security device */
#define USBUART_CLASS_VIDEO                (0x0Eu)     /* Video device */
#define USBUART_CLASS_PHD                  (0x0Fu)     /* Personal Healthcare device */
#define USBUART_CLASS_WIRELESSD            (0xDCu)     /* Wireless Controller */
#define USBUART_CLASS_MIS                  (0xE0u)     /* Miscellaneous */
#define USBUART_CLASS_APP                  (0xEFu)     /* Application Specific */
#define USBUART_CLASS_VENDOR               (0xFFu)     /* Vendor specific */
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
