land-boards/lb-boards/(commit log)

2012-07-01 did stuff
    [$savepcb.brd, AudioAmp386.brd, AudioAmp386.sch, AudioAmp386_PL.csv, AudioAmp386_PL.ods, DS18S20-Rev2.brd, DS18S20-Rev2.sch, Design Comparisons Screwduino vs Others.ods]
2012-07-01 Added LDR
    [$savepcb.brd, LDR Sensor.brd, LDR Sensor.sch, LDR.ods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]
2012-07-03 Added 16bit i2c
    [$savepcb.brd, I2C16Bit.brd, I2C16Bit.sch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]
2012-07-03 adding utilities to fix kicad libraries and modules
2012-07-04 Added ftdi board
    [$savepcb.brd, FTDI-USB-TTL.brd, FTDI-USB-TTL.sch, usbtest.brd, usbtest.sch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]
2012-07-05 adding cards
    [$savepcb.brd, BomTemplate.csv, BomTemplate.xls, BrBdPwrSply-2.csv, BrBdPwrSply-2_mouser.csv, BrBdPwrSply-3.csv, BrBdPwrSply-3_mouser.csv, BrBdPwrSply.brd]
2012-07-06 added a bunch of stuff
    [$savepcb.brd, DS18S20-Rev2.brd, FTDI-USB-TTL.brd, FTDI-USB-TTL.sch, FTDI-USB-TTLv2.brd, FTDI-USB-TTLv2.sch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]
2012-07-06 adding stuff
    [$savepcb.brd, FTDI-USB-TTL.brd, FTDI-USB-TTL.sch, FTDI-USB-TTLv2.brd, HVDigitalPot.brd, HVDigitalPot.sch, I2C16Bit.brd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]
2012-07-06 Updating readme file
    [FTDI-USB-TTLv2.brd]
2012-07-08 Added mergeKiMod.py function to merge together KiCad module files
2012-07-08 V2 of the Audio Amp
    [$savepcb.brd, AudioAmp386V2.brd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]
2012-07-09 Added an LM371 Power Supply
    [PwrSply317.brd, PwrSply317.sch]
2012-07-10 Added plot files for power supply
    [PwrSply317.brd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]
2012-07-11 update gvsduino
    [GVSDuino.brd]
2012-07-11 Created V3 of Soft Switch
    [DCFilterCap.xlsx, GVSDuino.sch, PCIe Outline.dxf, SW5WayV3.sch]
2012-07-20 Adding GPS application
    [GPS-Design.sch, MiniDuino.sch]
2012-07-20 Created 16Bit I2C V3 design - added through conn for I2C
    [$savepcb.brd, I2C16BitV2.brd, I2C16BitV2Old.sch, I2C16BitV3.brd, I2C16BitV3.sch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]
2012-07-20 Created Power Distribution card
    [$savepcb.brd, PowerDistrib.brd, PowerDistrib.sch]
2012-07-23 Updates based on first boards
    [$savepcb.brd, AudioAmp386V2.brd, AudioAmp386V2.sch, AudioAmp386V2_PL.csv, AudioAmp386V2_PL.xls, AudioAmp386V3.brd, AudioAmp386V3.sch, BrBdPwrSply.brd]
2012-07-24 fixing DS18S20 footprint
    [DS18S20-Rev2.brd, DS18S20-Rev2.sch, DS18S20-Rev2_PL.csv, DS18S20-Rev2_PL.xls, DS18S20-Rev3.sch]
2012-07-24 updating the DS18S20 part on the board
    [DS18S20-Rev3.brd]
2012-07-25 updates to GVSDuino
    [$savepcb.brd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]
2012-07-26 update XR2206
    [XR2206.brd, XR2206.sch]
2012-07-26 messed with ftdi design
    [FTDI-USB-TTLv2.sch, HVDigitalPotV2.sch, XR2206.brd, XR2206.sch]
2012-07-27 update miniduino stuff
    [MiniDuino.brd]
2012-07-30 fix theremin
    [theremin.sch]
2012-07-31 working x2 miniduino
    [MiniDuino.brd, MiniDuino.sch]
2012-07-31 update miniduino
    [MiniDuino.brd, MiniDuino.sch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]
2012-08-07 power and ground pins AVCC and AGND were reversed on earlier boards
    [screwduinov2p1.sch, screwduinov3.brd, screwduinov3.sch]
2012-08-09 Added lm384 5w audio amp
    [AudioAmp384.brd, AudioAmp384.sch, SMPS-9V.sch]
2012-08-09 created audio amp
    [AudioAmp384.brd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]
2012-08-14 Worked on a cScrewduino and BrBdPwrSply
    [$savepcb.brd, Adafruit Ultimate GPS.brd, Adafruit Ultimate GPS.sch, BrBdPwrSplyV2.brd, BrBdPwrSplyV2.sch, screwduinov3.brd, screwduinov3.sch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]
2012-08-21 Added TinyDuino85
    [$savepcb.brd, TinyDuino85.brd, TinyDuino85.sch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]
2012-08-21 misc pdates
    [MiniDuino.sch, XR2206.sch]
2012-08-26 fairly clean small altoids gps arduino
    [$savepcb.brd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]
2012-08-26 miniduino arduino
    [MiniDuino.sch]
2012-08-26 ordered x2 board minor improvements
    [FTDI-USB-TTLv2.brd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]
2012-09-05 AtMega32U4 added
    [atmega32u4bb.brd, atmega32u4bb.sch]
2012-09-09 X2 version of tinyduino adds reset pin and makes card smaller
    [$savepcb.brd, TinyDuino85.brd, TinyDuino85.sch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]
2012-09-12 ATMega baseline design
    [$savepcb.brd, atmega32u4bb.sch]
2012-09-12 ATMega removed conn
    [atmega32u4bb.sch]
2012-09-13 gps adds
    [Adafruit Ultimate GPS.brd, Adafruit Ultimate GPS.sch, GPS-Design.sch, atmega32u4bb.brd, atmega32u4bb.sch]
2012-09-14 gps updates
    [atmega32u4bb.brd, atmega32u4bb.sch]
2012-09-14 gps stuff
    [$savepcb.brd, Adafruit Ultimate GPS.brd, Adafruit Ultimate GPS.sch, FTDI-USB-TTLv2.brd, FTDI-USB-TTLv2.sch, FTDI-USB-TTLv2_PL.csv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]
2012-09-17 adding gps updates
    [$savepcb.brd, Adafruit Ultimate GPS.brd, Adafruit Ultimate GPS.sch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]
2012-09-17 Updating GPS stuff
    [GVS-32U4.brd, USB-GPS.brd, USB-GPS.sch, USB-GPSX2.brd, USB-GPSX2.sch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]
2012-09-20 Update gps
    [USB-GPSX2.csv]
2012-09-24 GVS-32U4 layout done
    [$savepcb.brd, GVS-32U4.brd, GVS-32U4.sch]
2012-09-24 Library update GVS connector
2012-09-24 working on GPS PL
    [USB-GPSX2.csv]
2012-09-24 eliminated duplicate module files from kicad modules folder
    [Adafruit Ultimate GPS.brd, Adafruit Ultimate GPS.sch, GPS-Design.sch, GVS-32U4.brd, affich.brd, conn_DBxx.brd, conn_HExx.brd, connect1.brd]
2012-09-25 Enlarged power plane
    [GVS-32U4.brd]
2012-09-25 updating the gps
    [Arduino_Leonardo-REV3b.brd, Arduino_Leonardo-REV3b.sch, GVS-32U4.brd]
2012-10-23 synching it up
    [Fan12VCtrl.brd, Fan12VCtrl.sch]
2012-10-26 update 32u4 gvs board
    [GVS-32U4.brd, GVS-32U4.sch]
2012-10-26 Ordered 32U4 board
    [Drills.xln, GVS-32U4-Back.gbl, GVS-32U4-Front.gtl, GVS-32U4-Mask_Back.gbs, GVS-32U4-Mask_Front.gts, GVS-32U4-PCB_Edges.gbr, GVS-32U4-SilkS_Back.gbo, GVS-32U4-SilkS_Front.gto]
2012-11-06 debugging the USB-GPS design
    [USB-GPSX2.csv, USB-GPSX2.xlsx]
2012-11-07 updated usb gps design
    [Mouser Costed BOM USB-GPSX2.xlsx, USB-GPS-BOM-2012-11-07.xls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]
2012-11-08 rev x2 of usb gps - as ordered
    [USB-GPSX2.brd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]
2012-11-08 do cleanups
    [USB-GPSX2.csv, USB-GPSX2.xlsx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]
2012-11-08 Updated the GVS-32U4 and USB-GPSX2 designs
    [GVS-32U4.csv, GVS-32U4.sch, GVS-32U4.xlsx, Mouser Export USB-GPSX2.xlsx, USB-GPSX2.sch]
2012-11-10 Created a board outline to fit in a Hammond Plastic case
    [$savepcb.brd, USB-GPS-Hammond-X3.brd, USB-GPS-Hammond-X3.sch]
2012-11-11 Flipped outline since board will be in upside down
    [$savepcb.brd, USB-GPS-Hammond-X3.brd, USB-GPS-Hammond-X3.sch]
2012-11-12 Created X2 version of the card fixing stuff in X1 version
    [Drills.xln, GVS-32U4-Back.gbl, GVS-32U4-Front.gtl, GVS-32U4-Mask_Back.gbs, GVS-32U4-Mask_Front.gts, GVS-32U4-PCB_Edges.gbr, GVS-32U4-SilkS_Back.gbo, GVS-32U4-SilkS_Front.gto]
2012-11-16 fixed GVS-32U4 HW line error
    [GVS-32U4-X2.brd]
2012-11-17 synicing up
    [GVS-32U4.csv]
2012-11-19 Updated GVS-32U4
    [GVS-32U4-X2.brd, USB-GPSX2.xlsx]
2012-11-30 Update GPS Hammond case
2012-12-04 Updated USB-GPS-X2 based on checkout of the X2 board - made an X3
2012-12-06 Updated the USB-GPS designs
    [Drills.xln, USB-GPS-Hammond-X1-Back.gbl, USB-GPS-Hammond-X1-Front.gtl, USB-GPS-Hammond-X1-Mask_Back.gbs, USB-GPS-Hammond-X1-Mask_Front.gts, USB-GPS-Hammond-X1-PCB_Edges.gbr, USB-GPS-Hammond-X1-SilkS_Back.gbo, USB-GPS-Hammond-X1-SilkS_Front.gto]
2012-12-07 USB-GPS-X3 - Fixed etch and added 2 Color charging LED
    [USB-GPS-Hammond-X1.sch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]
2012-12-07 updates gps
    [USB-GPSX3.brd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]
2012-12-13 updates to pcbs
    [USB-GPSX3.brd, USB-GPSX3.sch]
2012-12-14 Did stuff with the LED light
    [LED-Lamp.brd, LED-Lamp.sch]
2012-12-18 adding usb-gps case
    [GPS-Box.skp, GPS-Box.stl, USB-GPS-lid.skp, USB-GPS-lid.stl]
2012-12-21 updates to boards
    [GPS-Box.skp, PowerSwitch-RS-275-409.dxf, USB-GPS-Board.skp, USB-GPS-lid.skp, USB-GPS-lid.stl]
2013-01-02 board updatdates
    [$savepcb.brd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]
2013-01-11 update led-12 board and various modules
    [LED-12 Holes in mm.dxf, LED-12-Back.dxf, LED-12-Front.dxf, LED-12-Mask_Back.dxf, LED-12-Mask_Front.dxf, LED-12-PCB_Edges.dxf, LED-12-SilkS_Back.dxf, LED-12-SilkS_Front.dxf]
2013-01-22 USB-GPS updates
    [GPS-Box-X3.stl, GPS-Box.stl, USB-GPS-lid-x3.stl, USB-GPS-lid.stl]
2013-01-22 cleanup USB-GPS-Hammond files
    [USB-GPS-Hammond-X1.brd]
2013-01-22 util cleanups
    [BomTemplate.csv, BomTemplate.xls, BrBdPwrSply-2.csv, BrBdPwrSply-2_mouser.csv, BrBdPwrSply-3.csv, BrBdPwrSply-3_mouser.csv, testBom.csv, testBom_mouser.csv]
2013-01-24 Added IR Sensor pair card
    [IR Sensor Design Notes.xlsx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]
2013-01-24 Adding parts to IR Sensors
2013-01-24 Created kiListPads utility to list all of the pads used by a module
    [SynchroAmp4-footprints.csv]
2013-01-25 working with footprint files
    [SynchroAmp4-footprints.xlsx]
2013-01-25 Update IR stuff
    [IR-Sensor.sch, IRSensorCalcs.xlsx]
2013-01-26 IR sensor
2013-01-28 fan controller pics
2013-02-06 Created 10-bit HV Pot, Updated libraries, Updated IR sensor design
    [HVDigitalPot2.brd, HVDigitalPot2.sch, IR-Sensor.sch, IRSensorCalcs.xlsx]
2013-02-07 syncing up the IR sensor
2013-02-07 Update HVPot2
    [$savepcb.brd, HVDigitalPot2.sch]
2013-02-08 creating X2 version of IR sensor plus HV Digital Pot 2 order
    [HVDigitalPot2.brd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]
2013-02-08 Clearned up IR Sensor folder
    [IR-Sensor-Back.gbl, IR-Sensor-Front.gtl, IR-Sensor-Mask_Back.gbs, IR-Sensor-Mask_Front.gts, IR-Sensor-PCB_Edges.gbr, IR-Sensor-SilkS_Back.gbo, IR-Sensor-SilkS_Front.gto, IR-Sensor.drl]
2013-02-11 Updating IR Sensor parts files based on Digikey purchase
2013-02-13 updating theremin related files
    [IRSensorCalcs.xlsx, MiniDuino.sch, XR2206.sch, theremin.sch, xr2206.ods]
2013-02-15 updates to BrBdPwrSply
    [BrBdPwrSplyV3.brd, BrBdPwrSplyV3.sch]
2013-02-15 Did stuff with BrBdPwrSply - made an V3
    [BrBdPwrSply.brd, BrBdPwrSply.sch, BrBdPwrSplyV2.brd, BrBdPwrSplyV2.csv, BrBdPwrSplyV2.sch]
2013-02-15 audio amp stuff
    [AudioAmp384.sch, XR2206.brd]
2013-02-15 Worked on X3 version of XR-2206 and X3 version of BrBdPwrSply
    [BrBdPwrSplyV3.brd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]
2013-02-21 New Power Distribution strips design
    [PowerDistrib.brd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]
2013-02-21 Updated Theremin Design
    [theremin.sch]
2013-02-21 Integr theremin
    [$savepcb.brd, AudioAmp386V2.brd, IntegTheremin.brd, IntegTheremin.sch, XR2206.sch]
2013-02-22 Worked on Integrated Theremin Design
    [IntegTheremin.brd, IntegTheremin.sch, IntegTheremin2 (copy).sch, IntegTheremin2.sch, IntegTheremin3.sch, IntegTheremin3sch.sch, IntegTheremin4.sch, IntegTheremin4sch.sch]
2013-02-22 IntegTheremin and library updates
    [IntegTheremin.brd, IntegTheremin.sch, IntegTheremin2.sch, IntegTheremin3.sch, IntegTheremin4.sch, IntegTheremin5.sch, theremin.sch]
2013-02-22 cleaning up heriarchical IntegTheremin folder
    [IntegTheremin2 (copy).sch, IntegTheremin3sch.sch, IntegTheremin4sch.sch]
2013-02-25 Worked IntegTheremin
    [$savepcb.brd, BOM_3670388_1.xls, BOM_3670388_3.xls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]
2013-02-25 Updated IntegTheremin and updated libraries
    [BOM_3670388_3.xls, IntegTheremin.brd, IntegTheremin.sch, IntegTheremin2.sch, IntegTheremin3.sch, IntegTheremin4.sch, IntegTheremin5.sch, IntegTheremin6.sch]
2013-02-26 IntegTheremin updates
    [IntegTheremin.brd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]
2013-02-26 Worked on IntegTheremin
    [BOM_3670388_3.xls, IntegTheremin.brd, IntegTheremin.csv, IntegTheremin.sch, IntegTheremin.xlsx, IntegTheremin2.sch, IntegTheremin3.sch, IntegTheremin4.sch]
2013-02-27 Check in HV Digital Pot updates
    [HVDigitalPot2.sch]
2013-03-05 Updated libraries
    [$savepcb.brd, Arduino Projects Pinouts-2012-02-16.xls, Arduino Projects Pinouts.xls, Arduino Uno Project Pinout Sheet.xls, affich.brd, conn_DBxx.brd, conn_HExx.brd, connect1.brd]
2013-03-05 Updated mergeKiMods to better merge module files
    [TestProject.sch]
2013-03-06 wings adds
2013-03-06 Updated libraries and XR-2206 board schematic
    [IntegTheremin.sch, IntegTheremin2.sch, IntegTheremin3.sch, IntegTheremin4.sch, IntegTheremin5.sch, IntegTheremin6.sch, IntegTheremin7.sch, XR2206.sch]
2013-03-12 Created dimensioned parts drawing
    [.kicad_pcb.kicad_pcb, Inventory-2013-03-07.xlsx, library_caps_dimensioned.kicad_pcb]
2013-03-13 fixed ir sensor to remove back side soldermask under LEDs
    [IR-Sensor-B_Mask.gbs, IR-Sensor-B_SilkS.gbo, IR-Sensor-Back.gbl, IR-Sensor-Edge_Cuts.gbr, IR-Sensor-F_Mask.gts, IR-Sensor-F_SilkS.gto, IR-Sensor-Front.gtl, IR-Sensor-Mask_Back.gbs]
2013-03-13 removing old IR sensor plot files
    [$savepcb.brd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]
2013-03-15 Worked on IntegTheremin and added a kiFeet utility to deal with CMP files
    [IR-Pair-Volts-vs-Resistance.xls, IntegTheremin.csv, IntegTheremin.sch, IntegTheremin.xlsx, IntegTheremin2.sch, IntegTheremin3.sch, IntegTheremin4.sch, IntegTheremin5.sch]
2013-03-20 WOrked on Screwduino X3
    [GVS-32U4-X2.sch, TTH-DS-PWR.csv, screwduinov3.brd, screwduinov3.sch]
2013-03-28 Creating Rev X2 of the iTheremin
    [IntegTheremin.brd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]
2013-03-28 doing updates on iTheremin folders
    [$savepcb.brd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]
2013-03-29 found some other files in other places
    [Drills.xln, SW5Wayv2-Back.gbl, SW5Wayv2-Eco1.gbr, SW5Wayv2-Front.gtl, SW5Wayv2-Mask_Back.gbs, SW5Wayv2-Mask_Front.gts, SW5Wayv2-PCB_Edges.gbr, SW5Wayv2-SilkS_Back.gbo]
2013-04-02 New kiPL python program to create better PLs
    [BomTemplate.csv, BomTemplate.xls, BrBdPwrSply-2.csv, BrBdPwrSply-2_mouser.csv, BrBdPwrSply-3.csv, BrBdPwrSply-3_mouser.csv, IntegTheremin.brd, testBom.csv]
2013-04-03 did some more work on the iTheremin and created some 3D parts
    [IntegTheremin.sch, IntegTheremin2.sch, IntegTheremin3.sch, IntegTheremin4.sch, IntegTheremin5.sch, IntegTheremin6.sch, IntegTheremin7.sch, SynchroAmp4Ref_PL.csv]
2013-04-03 deletes of test files for kiPL.py program
    [testPL_PL.csv]
2013-04-06 Did stuff with screwduino board design v3
    [screwduinov3.brd]
2013-04-08 Created kiPL Parts List Utility for KiCad
2013-04-08 Created 8-pin can oscillator package 3D
2013-04-08 Minor Updates
    [Inventory-2013-03-07.xlsx, SynchroAmp4Ref_PL.csv, SynchroAmp4Ref_PL.xlsx]
2013-04-10 Checking out iTheremin Board #2
    [IntegTheremin.sch, IntegTheremin2.sch, IntegTheremin3.sch, IntegTheremin4.sch, IntegTheremin5.sch, IntegTheremin6.sch, IntegTheremin7.sch]
2013-04-10 Did something with the Screwduino
    [screwduinov3.brd]
2013-04-10 Loaded OrCAD schematic library symbols
2013-04-17 Worked on screwduino
    [Inventory-2013-03-07.xlsx, Inventory-2013-04-16.xlsx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]
2013-04-25 Worked on iTheremin
    [IntegTheremin.brd, IntegTheremin.sch, IntegTheremin2.sch, IntegTheremin3.sch, IntegTheremin4.sch, IntegTheremin5.sch, IntegTheremin6.sch, IntegTheremin7.sch]
2013-04-25 Updated GPS parts list
    [USB-GPSX3.csv]
2013-04-27 worked ir sensor
    [IR Sensor Design Notes.xlsx, IR-Pair-Volts-vs-Resistance.xls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]
2013-04-28 Updated colors on schematic
    [USB-GPS-Hammond-X1.sch]
2013-04-28 Created OneWireLogger
    [OneWireL-01.sch, OneWireL-02.sch, OneWireL-03.sch, OneWireL-04.sch, OneWireLogger.kicad_pcb, OneWireLogger.sch]
2013-04-29 Worked on OneWireLogger
    [OneWireL-01.sch, OneWireL-02.sch, OneWireL-03.sch, OneWireL-04.sch, OneWireLogger.kicad_pcb, OneWireLogger.sch]
2013-04-29 Worked in iTheremin
    [IntegTheremin.brd, IntegTheremin.sch, IntegTheremin2.sch, IntegTheremin3.sch, IntegTheremin4.sch, IntegTheremin5.sch, IntegTheremin6.sch, IntegTheremin7.sch]
2013-04-30 Did stuff on 1WireLogger
    [OneWireL-01.sch, OneWireL-02.sch, OneWireL-03.sch, OneWireL-04.sch, OneWireLogger.kicad_pcb, OneWireLogger.sch]
2013-05-02 did 1wl project
    [OneWireLogger.kicad_pcb]
2013-05-06 Worked on library merging
    [USB-GPS-Hammond-X1.sch]
2013-05-09 Did stuff w screwduino
    [screwduinov3.sch]
2013-05-09 created gvs-32u4
    [GVS-32U4-X2-B_Mask.gbs, GVS-32U4-X2-B_SilkS.gbo, GVS-32U4-X2-Back.gbl, GVS-32U4-X2-F_Mask.gts, GVS-32U4-X2-F_SilkS.gto, GVS-32U4-X2-Front.gtl, GVS-32U4-X2.drl, GVS-32U4-X2.gbl]
2013-05-09 Update KiCad libraries
2013-05-17 Updating libraries and the OneWireLogger
    [MiniDuino.sch, OneWireL-01.sch, OneWireL-02.sch, OneWireL-03.sch, OneWireL-04.sch, OneWireL-05.sch, OneWireLogger.kicad_pcb, OneWireLogger.sch]
2013-05-22 Worked BNC connector 3D
2013-05-22 Created Pulse Generator
    [PulseGenerator.csv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]
2013-05-22 Deleting some 1 wire files
2013-05-22 Updates to 1WireLogger files
    [OneWireL-01.sch, OneWireL-02.sch, OneWireL-03.sch, OneWireL-04.sch, OneWireL-05.sch, OneWireLogger.kicad_pcb, OneWireLogger.sch]
2013-05-22 Moved some one wire logger data sheets
    [OneWireLogger.csv]
2013-05-23 Created a DDS Mini board
    [DDS-Mini-01.sch, DDS-Mini-02.sch, DDS-Mini-03.sch, DDS-Mini-04.sch, DDS-Mini-05.sch, DDS-Mini.brd, DDS-Mini.sch]
2013-05-23 No changes to GVs-32U4 that I know of?
    [GVS-32U4-X2.csv, GVS-32U4-X2.sch]
2013-05-23 Did something with the OneWireDataLogger
    [OneWireLogger.csv, OneWireLogger.xlsx]
2013-06-06 Updated TinyDuino85
    [TinyDuino85.sch]
2013-06-06 Created an RF-Amplifier based on QST article
    [RF-Amp.kicad_pcb, RF-Amp.sch]
2013-06-06 Tiny85ISP X1 initial design
    [Tiny85ISP.brd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]
2013-06-06 Updated inventory
    [Inventory-2013-04-16.xlsx, Inventory-2013-05-29.xlsx]
2013-06-06 Inventory updates.
    [Inventory-2013-04-16.xlsx]
2013-06-07 DDS MINI
    [DDS-Mini-01.sch, DDS-Mini-02.sch, DDS-Mini-03.sch, DDS-Mini-04.sch, DDS-Mini.sch]
2013-06-12 Finished LED-18 (LEDs driven by ATTiny) design
    [LED-18.drl, LED-18.gbl, LED-18.gbo, LED-18.gbs, LED-18.gko, LED-18.gtl, LED-18.gto, LED-18.gts]
2013-06-12 Touched in the PulseGen design.
    [PulseGenerator.sch]
2013-06-12 Did stuff with the DDS Mini design
    [DDS-Mini.brd]
2013-06-12 Updated Pulse gen by adding pictures
    [PulseGen w RG-58CU coax.xlsx]
2013-06-12 Put some dimensions on the PCB to make a case easier to design.
    [PulseGenerator.kicad_pcb]
2013-06-25 Worked on DDS-Mini and One Wire Logger
    [$CurrentLoad.sch, CurrentLoad.sch, OneWireL-06.sch, OneWireLogger.kicad_pcb, dummyload1.brd, dummyload1.sch]
2013-06-25 Created a current load design
    [$CurrentLoad.sch, CurrentLoad.sch]
2013-06-25 Worked one wire data logger
    [CurrentLoad.sch, GVS-32U4-X2.brd, OneWireL-01.sch, OneWireL-02.sch, OneWireL-03.sch, OneWireL-04.sch, OneWireL-05.sch, OneWireL-06.sch]
2013-06-26 Updates to Hammond GPS X2 and OneWireLogger.
    [OneWireLogger.kicad_pcb, USB-GPS-Hammond-X2.brd]
2013-06-27 GVS-32U4 updates for Rev X3.
    [$savepcb.brd, GVS-32U4-X2.brd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]
2013-06-28 Did stuff with TinyGrid85 card
    [TinyGrid85.brd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]
2013-07-03 Finishing up TinyGrid85 Rev 1.
    [TinyGrid85-B_Mask.gbs, TinyGrid85-B_SilkS.gbo, TinyGrid85-Back.gbl, TinyGrid85-Edge_Cuts.gbr, TinyGrid85-F_Mask.gts, TinyGrid85-F_SilkS.gto, TinyGrid85-Front.gtl, TinyGrid85.drl]
2013-07-03 Added Board Revision X1 to Silkscreen
    [TinyGrid85.brd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]
2013-07-08 Update LED-18
    [$TinyGrid85.sch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]
2013-07-09 Worked on 1wire logger
    [OneWireL-01.sch, OneWireL-02.sch, OneWireL-03.sch, OneWireL-04.sch, OneWireL-05.sch, OneWireL-06.sch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]
2013-07-10 Did stuff with One Wire Data Logger Design
    [OneWireL-01.sch, OneWireL-02.sch, OneWireL-03.sch, OneWireL-04.sch, OneWireL-05.sch, OneWireL-06.sch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]
2013-07-10 Updated One-Wire Data Logger
    [OneWireL-01.sch, OneWireL-02.sch, OneWireL-03.sch, OneWireL-04.sch, OneWireL-05.sch, OneWireL-06.sch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]
2013-07-20 USB Hammond Stuff
    [$TinyGrid85.sch, TinyGrid85.sch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]
2013-08-16 Updates to gps
    [BrBdEnvir.brd, BrBdEnvir.sch, USB-GPS-Hammond-X2.brd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]
2013-08-29 Worked the 1Wire Data Logger
    [OneWireL-01.sch, OneWireL-02.sch, OneWireL-03.sch, OneWireL-04.sch, OneWireL-05.sch, OneWireL-06.sch, OneWireLogger.csv, OneWireLogger.sch]
2013-09-03 One Wire Data Logger stuff
    [OneWireL-01.sch, OneWireL-02.sch, OneWireL-03.sch, OneWireL-04.sch, OneWireL-05.sch, OneWireL-06.sch, OneWireLogger.csv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]
2013-09-05 Updated 1WireLogger files
    [OneWireL-01.sch, OneWireL-02.sch, OneWireL-03.sch, OneWireL-04.sch, OneWireL-05.sch, OneWireL-06.sch, OneWireLogger.sch]
2013-09-05 Worked on the rev 2 of the One Wire Logger hardware
    [OneWireL-01.sch, OneWireL-02.sch, OneWireL-03.sch, OneWireL-04.sch, OneWireL-05.sch, OneWireL-06.sch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]
2013-09-09 Update One Wire Logger stuff
    [OneWireL-01.sch, OneWireL-02.sch, OneWireL-03.sch, OneWireL-04.sch, OneWireL-05.sch, OneWireL-06.sch, OneWireLogger.sch]
2013-09-12 One Wire Logger improvements
    [OneWireLogger.kicad_pcb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]
2013-09-17 ATMega Programmer
    [$savepcb.brd, ATProg-Sht2.sch, ATProg-Sht3.sch, ATProg-Sht4.sch, ATProg-Sht5.sch, ATProg.kicad_pcb, ATProg.sch]
2013-09-18 Worked ATMega Programmer design
    [ATProg-Sht2.sch, ATProg-Sht3.sch, ATProg-Sht4.sch, ATProg-Sht5.sch, ATProg-Sht6.sch, ATProg.kicad_pcb, ATProg.sch]
2013-09-23 New GVS Duino and shield for programming.
    [ATProgHead-Sht2.sch, ATProgHead-Sht3.sch, ATProgHead-Sht4.sch, ATProgHead-Sht5.sch, ATProgHead-Sht6.sch, ATProgHead.kicad_pcb, ATProgHead.sch, GVSDuino-V2.brd]
2013-09-24 Atmel programmer and new GVSDuino for programming
    [ATProgHead.kicad_pcb, ATProgHead.sch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]
2013-09-25 Did stuff with GVSDuino Rev X3
    [GVSDuino-X3.brd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]
2013-09-26 New cheaper FTDI chip
    [FTDI-USB-TTLv3.brd, FTDI-USB-TTLv4.brd, FTDI-USB-TTLv4.sch]
2013-09-28 usb ttl
    [FTDI-USB-TTLv4.brd]
2013-09-30 Sensor cpu
    [GVSDuino-X3.brd, LWS-001.sch, LWS-002.sch, WLS-002.sch, WLSensor.kicad_pcb, WLSensor.sch]
2013-09-30 FTDI-USB Rev X5
    [FTDI-USB-TTLv5.brd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]
2013-09-30 Worked on the Wireless Sensor design
    [LWS-001.sch, WLS-002.sch, WLSensor.sch]
2013-10-11 Updated 1Wire Logger
    [FTDI-USB-TTLv5.csv, FTDI-USB-TTLv5.xlsx, OneWireL-01.sch, OneWireL-02.sch, OneWireL-03.sch, OneWireL-04.sch, OneWireL-05.sch, OneWireL-06.sch]
2013-10-14 FTDI SSOP-16 pinout was really messed up.
    [FTDI-USB-TTLx6.brd, FTDI-USB-TTLx6.sch]
2013-10-17 Updated ATProgHead stuff
    [ATProgHead-Sht2.sch, ATProgHead-Sht3.sch, ATProgHead-Sht4.sch, ATProgHead-Sht5.sch, ATProgHead-Sht6.sch, ATProgHead.kicad_pcb, ATProgHead.sch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]
2013-10-25 Updated ATProghead design
    [ATProgHead-B_Cu.gbl, ATProgHead-B_Mask.gbs, ATProgHead-B_SilkS.gbo, ATProgHead-Edge_Cuts.gbr, ATProgHead-F_Cu.gtl, ATProgHead-F_Mask.gts, ATProgHead-F_SilkS.gto, ATProgHead.drl]
2013-11-04 Did FTDI-TTL updates
    [FTDI-USB-TTLx6.brd]
2014-01-20 Did different stuff
    [USB-GPS-Hammond-X1-Back.gbl, USB-GPS-Hammond-X1-Front.gtl, USB-GPS-Hammond-X1-Mask_Back.gbs, USB-GPS-Hammond-X1-Mask_Front.gts, USB-GPS-Hammond-X1-PCB_Edges.gbr, USB-GPS-Hammond-X1-SilkS_Back.gbo, USB-GPS-Hammond-X1-SilkS_Front.gto, USB-GPS-Hammond-X1.drl]
2014-02-13 Worked on the one wire data logger
    [OneWireLogger-B_Cu.gbl, OneWireLogger-B_Mask.gbs, OneWireLogger-B_SilkS.gbo, OneWireLogger-Edge_Cuts.gbr, OneWireLogger-F_Cu.gtl, OneWireLogger-F_Mask.gts, OneWireLogger-F_SilkS.gto, OneWireLogger.drl]
2014-03-25 Fixed the NAND gate package SO14 s/b TSSOP14
    [OneWireL-01.sch, OneWireL-02.sch, OneWireL-03.sch, OneWireL-04.sch, OneWireL-05.sch, OneWireL-06.sch, OneWireLogger.kicad_pcb, OneWireLogger.sch]
2014-03-26 OWL changes
    Added +5V to pin 2 of the RJ-45 connector.
    Added an I/O connector with GV and 4 signal lines for stuff like
    external buzzers, etc.
    [OneWireL-01.sch, OneWireL-02.sch, OneWireL-03.sch, OneWireL-04.sch, OneWireL-05.sch, OneWireL-06.sch, OneWireLogger.kicad_pcb, OneWireLogger.sch]
2014-04-21 Added the Raspberry Pi Dimensioned drawing
    [Raspberry Pi Dimensioned drawing.dxf]
2014-04-23 Raspberry Pi Connector pinout
2014-04-24 raspi plate
    [RasPiDB001-01.sch, RasPiDB001-02.sch, RasPiDB001-03.sch, RasPiDB001-04.sch, RasPiDB001.kicad_pcb, RasPiDB001.sch, ibex_rpi_model_b_v1_00.dxf, ~ibex_rpi_model_b_v1_00.dxf]
2014-04-24 outline plus conn
    [ibex_rpi_model_b_v1_00.dxf]
2014-05-02 synced up with other folders
    [ATProgHead-B_Cu.gbl, ATProgHead-B_Mask.gbs, ATProgHead-B_SilkS.gbo, ATProgHead-Edge_Cuts.gbr, ATProgHead-F_Cu.gtl, ATProgHead-F_Mask.gts, ATProgHead-F_SilkS.gto, ATProgHead.drl]
2014-05-15 Created BBB Cape based on FlyingBone Cape
    [BBBCape-001.brd, BBBCape-001.sch, P8.sch, P9.sch, batt_backight.sch, c_holes.sch]
2014-05-19 Updated the README
    Reflect land-boards
2014-05-19 Copied flyingbone design files are CCC
    [FlyingBone.brd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]
2014-05-19 Copied reload DC load files
    [reload.brd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]
2014-05-19 Added TFT Breakout
    [jdt1800-bob.brd, jdt1800-bob.sch]
2014-05-19 Added the BBB Getting Started Guide.
    [BONE_BOM.xls, config.txt]
2014-05-19 8-Channel Opto-isolated input board
    [OptoIn8.kicad_pcb, OptoIn8.sch]
2014-05-19 8-Channel Opto-Isolated output board
    [OptoOut8.kicad_pcb, OptoOut8.sch]
2014-05-21 Made OptoIn8 with I2C design
    [OptoIn8-I2C.kicad_pcb, OptoIn8-I2C.sch, OptoIn8.kicad_pcb]
2014-05-21 Renamed OptoOut8 to add I2C
    [OptoOut8.kicad_pcb, OptoOut8.sch]
2014-05-22 Backannotated schematics
    [OptoIn8-I2C-B_Cu.gbl, OptoIn8-I2C-B_Mask.gbs, OptoIn8-I2C-B_SilkS.gbo, OptoIn8-I2C-Edge_Cuts.gbr, OptoIn8-I2C-F_Cu.gtl, OptoIn8-I2C-F_Mask.gts, OptoIn8-I2C-F_SilkS.gto, OptoIn8-I2C.drl]
2014-06-03 Speed improvements to HV Digital Pot
    Added some speed improvements particularly separated the two CS and
    combined into one data line. That lets the parts be accessed
    individually and more importantly have separate CS for fast SPI
    accesses.
    [$savepcb.brd, HVDigitalPot2.brd, HVDigitalPot2.sch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]
2014-06-04 Tweeked the opto boards
    [OptoIn8-I2C-F_SilkS.dxf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]
2014-06-05 opto cpu
    [DAS-32U4.brd, DAS-32U4.sch]
2014-06-05 Updates to opto processor
    [DAS-32U4.brd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]
2014-06-06 Updates to add analog db9
    [DAS-32U4.brd, DAS-32U4.sch]
2014-06-09 Tweeks to optos
    [ODAS.kicad_pcb, OptoOut8-I2C.kicad_pcb, OptoOut8-I2C.sch]
2014-06-10 lined up connectors
    [OptoIn8-I2C.kicad_pcb, OptoIn8-I2C.sch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]
2014-06-10 Lined up opto connectors
    [Power Budgets.csv]
2014-06-12 Created DIGIO16-I2C
    [DigIO16-I2C.kicad_pcb, DigIO16-I2C.sch]
2014-06-16 Did some work on the LED-18 design
    Want to show it at the next Microcontroller meetup
    [LED-18-Calcs.csv]
2014-06-17 Added GVS connectors for test
    [GVS Sensors.sch]
2014-06-18 bbb gvs 5x
    [BBBCape-001.brd, BBBCape-001.sch, P8.sch, P9.sch, batt_backight.sch]
2014-06-18 Making a comprehensive list of sensors drawing.
    [GVS Sensors.sch]
2014-06-19 Updated GVS Sensors
    [GVS Sensors.sch]
2014-06-23 BBB Cape
    [BBBCape-001.brd, BBBCape-001.sch, P8.sch, P8A.sch, P8B.sch, P9.sch, P9A.sch, P9B.sch]
2014-06-24 Got GVS hooked up
    [BBBCape-001.sch, P8A.sch, P8B.sch, P9A.sch, P9B.sch, batt_backight.sch]
2014-06-25 tweek ss
    [BBBCape-001.brd]
2014-06-25 CAPE UPS
    [BBBCape-001.brd, BBBCape-001.sch, P8A.sch, P8B.sch, P9A.sch, P9B.sch, batt_backight.sch]
2014-06-26 New version, easier assembly
    [BBBCape-002.brd, BBBCape-002.sch, P8.sch, P8A.sch, P8B.sch, P9.sch, P9A.sch, P9B.sch]
2014-06-27 added more channels
    [BBB-GVS-V2.brd, BBB-GVS-V2.sch, BBBCape-002.brd, P8.sch, P9.sch, batt_backight.sch]
2014-06-30 RasPi board
    [RasPiDB002-01.sch, RasPiDB002-02.sch, RasPiDB002-03.sch, RasPiDB002-04.sch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]
2014-07-01 made bbb
    [BBB-GVS-V2.brd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]
2014-07-01 updated boards
    [RasPiDB002-B_Cu.gbl, RasPiDB002-B_Mask.gbs, RasPiDB002-B_SilkS.gbo, RasPiDB002-Edge_Cuts.gbr, RasPiDB002-F_Cu.gtl, RasPiDB002-F_Mask.gts, RasPiDB002-F_SilkS.gto, RasPiDB002.drl]
2014-07-01 Created LED test card
    [LED-Test-B_Mask.gbs, LED-Test-B_SilkS.gbo, LED-Test-Back.gbl, LED-Test-Edge_Cuts.gbr, LED-Test-F_Mask.gts, LED-Test-F_SilkS.gto, LED-Test-Front.gtl, LED-Test.drl]
2014-07-01 Created RasPi-GVS card
    [RasPi-GVS-01.sch, RasPi-GVS-02.sch, RasPi-GVS-03.sch, RasPi-GVS-04.sch, RasPi-GVS.kicad_pcb, RasPi-GVS.sch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]
2014-07-01 Changed raspidb002 to gvs
    [RasPiDB002-01.sch, RasPiDB002-02.sch, RasPiDB002-03.sch, RasPiDB002-04.sch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]
2014-07-01 update to board
    [BBB-GVS-V2.brd]
2014-07-02 Created a Tiny85 based Opto-Isolated Probe
    [TinyOptoProbe.brd, TinyOptoProbe.sch]
2014-07-04 Board stuff
    [GVSDuino-X3.brd, LED-Test.kicad_pcb, TinyGrid85.brd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]
2014-07-06 lots of board stuff
    [ATProgHead-B_Cu.gbl, ATProgHead-B_Mask.gbs, ATProgHead-B_SilkS.gbo, ATProgHead-Edge_Cuts.gbr, ATProgHead-F_Cu.gtl, ATProgHead-F_Mask.gts, ATProgHead-F_SilkS.gto, ATProgHead.drl]
2014-07-08 Worked one wire logger
    [OneWireL-01.sch, OneWireL-02.sch, OneWireL-03.sch, OneWireL-04.sch, OneWireL-05.sch, OneWireL-06.sch, OneWireLogger-2014-07-08.csv, OneWireLogger.sch]
2014-07-08 gvs-switch design
    [GVS-Switch-B_Cu.gbl, GVS-Switch-B_Mask.gbs, GVS-Switch-B_SilkS.gbo, GVS-Switch-Edge_Cuts.gbr, GVS-Switch-F_Cu.gtl, GVS-Switch-F_Mask.gts, GVS-Switch-F_SilkS.gto, GVS-Switch.drl]
2014-07-09 OWL updates
    [OneWireL-01.sch, OneWireL-02.sch, OneWireL-03.sch, OneWireL-04.sch, OneWireL-05.sch, OneWireL-06.sch, OneWireLogger.sch, OneWireLogger_PL.csv]
2014-07-09 Merge branch 'master' of https://github.com/douggilliland/lb-boards
    Conflicts:
    KiCAD/utilities/kiPL/kiPL/OneWireLogger_PL.csv
    OneWireLogger/OneWireL-01.bak
    OneWireLogger/OneWireL-02.bak
    OneWireLogger/OneWireL-03.bak
    OneWireLogger/OneWireL-04.bak
    OneWireLogger/OneWireL-05.bak
    OneWireLogger/OneWireL-06.bak
    OneWireLogger/OneWireLogger.bak
    OneWireLogger/OneWireLogger.net
    stuff
    [OneWireL-01.sch, OneWireL-02.sch, OneWireL-03.sch, OneWireL-04.sch, OneWireL-05.sch, OneWireL-06.sch, OneWireLogger-2014-07-08.csv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]
2014-07-10 Switched to more common/less expensive TFT display
    [OneWireL-01.sch, OneWireL-02.sch, OneWireL-03.sch, OneWireL-04.sch, OneWireL-05-OLD.sch, OneWireL-05.sch, OneWireL-06.sch, OneWireLogger-2014-07-08.csv]
2014-07-11 BBB X3
    [BBB-GVS-V2.brd, BBB-GVS-V2.sch, BBB-GVS-X3.brd, BBB-GVS-X3.sch, P8.sch, P9.sch, batt_backight.sch, c_holes.sch]
2014-07-11 fixed traces
    [BBB-GVS-X3.brd, P8.sch, P9.sch]
2014-07-11 Updates that hopefully make BBB GVS Rev X3 work
    [BBB-GVS-X3.brd, BBB-GVS-X3.sch, P8.sch, P9.sch, batt_backight.sch]
2014-07-12 more board updates
    [BBB-GVS-V2.brd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]
2014-07-13 tweeking the bord
    [BBB-GVS-V2-B_Mask.gbs, BBB-GVS-V2-B_SilkS.gbo, BBB-GVS-V2-Back.gbl, BBB-GVS-V2-Edge_Cuts.gbr, BBB-GVS-V2-F_Mask.gts, BBB-GVS-V2-F_SilkS.gto, BBB-GVS-V2-Front.gtl, BBB-GVS-V2.drl]
2014-07-14 BBB-GVS-X3 as ordered
    [BBB-GVS-X3.brd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]
2014-07-18 minor ss updates
    [RasPi-GVS-Plus.kicad_pcb]
2014-07-18 opto board
    [TinyOptoProbe.sch]
2014-07-19 voltage reg
    [RasPi-GVS-Plus-B_Cu.gbl, RasPi-GVS-Plus-B_Mask.gbs, RasPi-GVS-Plus-B_SilkS.gbo, RasPi-GVS-Plus-Edge_Cuts.gbr, RasPi-GVS-Plus-F_Cu.gtl, RasPi-GVS-Plus-F_Mask.gts, RasPi-GVS-Plus-F_SilkS.gto, RasPi-GVS-Plus.drl]
2014-07-24 BBB-GVS stuff
    [BBB-GVS-X3.sch, P8.sch, P9.sch]
2014-07-24 Library updates
    [LeadTimes.xlsx]
2014-07-24 LiPo touches
    [LiPo5V.sch]
2014-07-24 OWL inductor updates
    [OneWireLogger.kicad_pcb]
2014-07-24 made a 3.3v version of the raspberry pi gvs shield
    [RasPi-GVS-Plus-3V.kicad_pcb, RasPi-GVS-Plus-3V.sch, ibex_rpi_model_b_v1_00.dxf]
2014-07-24 5 way switch resistor values adjust
    [SW5WayDiscrete.csv, SW5WayDiscrete.sch]
2014-07-24 design volt convx
    [Voltage-Conv-01.sch, Voltage-Conv-02.sch, Voltage-Conv-03.sch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]
2014-07-24 5 way switch values calc
2014-07-27 doc via pics
    [LED-Test-B_Mask.gbs, LED-Test-B_SilkS.gbo, LED-Test-Back.gbl, LED-Test-Edge_Cuts.gbr, LED-Test-F_Mask.gts, LED-Test-F_SilkS.gto, LED-Test-Front.gtl, LED-Test.drl]
2014-07-28 PLs and pictures and moved stuff around
    [$RasPi-GVS.sch, $savepcb.brd, ATProgHead.csv, BBB-GVS-X3.csv, BrBdEnvir.brd, BrBdEnvir.sch, CurrentLoad.sch, DAS-32U4.csv]
2014-07-28 GVSDuino fixed the ISP RESET line (hopefully)
    [GVSDuino-X4.brd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]
2014-07-28 bbb gvs v2
    [$RasPi-GVS.sch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]
2014-07-30 Did stuff yesterday
    [Drills.xln]
2014-07-31 Debug of TinyOptoProbe
    [TinyOptoProbe.brd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]
2014-08-06 added kickstarter cost file
    [KickstarterCostFile.xlsx]
2014-08-09 Created RasPi-GVS X2 PWB
    [RasPi-GVS.csv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]
2014-08-09 reconstructed old RasPi-
    [RasPi-GVS-Plus-B_Cu.gbl, RasPi-GVS-Plus-B_Mask.gbs, RasPi-GVS-Plus-B_SilkS.gbo, RasPi-GVS-Plus-Edge_Cuts.gbr, RasPi-GVS-Plus-F_Cu.gtl, RasPi-GVS-Plus-F_Mask.gts, RasPi-GVS-Plus-F_SilkS.gto, RasPi-GVS-Plus.drl]
2014-08-13 Worked TinyProbe85
    [TinyOptoProbe.brd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]
2014-08-13 Finished voltage converter
    [Voltage-Conv-B_Cu.gbl, Voltage-Conv-B_Mask.gbs, Voltage-Conv-B_SilkS.gbo, Voltage-Conv-Edge_Cuts.gbr, Voltage-Conv-F_Cu.gtl, Voltage-Conv-F_Mask.gts, Voltage-Conv-F_SilkS.gto, Voltage-Conv.drl]
2014-08-18 Worked BBB-GVS board
    [BBB-GVS-X4.brd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]
2014-08-18 New RasPi-Okus GVS shield
    [RasPi-GVS-Plus-3V.csv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]
2014-08-19 gvs presentation
    [RasPi-GVS-Plus-3V.csv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]
2014-08-19 Did stuff with pad clearance
    [GVSDuino-X5.brd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]
2014-08-19 increased clearances around mtg holes
    [RasPi-GVS-Plus-B_Cu.gbl, RasPi-GVS-Plus-B_Mask.gbs, RasPi-GVS-Plus-B_SilkS.gbo, RasPi-GVS-Plus-Edge_Cuts.gbr, RasPi-GVS-Plus-F_Cu.gtl, RasPi-GVS-Plus-F_Mask.gts, RasPi-GVS-Plus-F_SilkS.gto, RasPi-GVS-Plus.drl]
2014-08-21 LTP at lunch
    [LTP-01-B_Mask.gbs, LTP-01-B_SilkS.gbo, LTP-01-Back.gbl, LTP-01-Edge_Cuts.gbr, LTP-01-F_Mask.gts, LTP-01-F_SilkS.gto, LTP-01-Front.gtl, LTP-01.drl]
2014-08-22 Added PS and Charger
    [LTP-01-CPU.sch, LTP-01-Charger.sch, LTP-01-SMPS.sch, LTP-01.brd, LTP-01.sch]
2014-08-25 raspi gvs cfg card
    [RasPi-GVS-Plus-CFG-B_Cu.gbl, RasPi-GVS-Plus-CFG-B_Mask.gbs, RasPi-GVS-Plus-CFG-B_SilkS.gbo, RasPi-GVS-Plus-CFG-Edge_Cuts.gbr, RasPi-GVS-Plus-CFG-F_Cu.gtl, RasPi-GVS-Plus-CFG-F_Mask.gts, RasPi-GVS-Plus-CFG-F_SilkS.gto, RasPi-GVS-Plus-CFG.drl]
2014-08-26 did stuff with KiPL
    [LTP-01-CPU.sch, LTP-01-Charger.sch, LTP-01-SMPS.sch, LTP-01.csv, LTP-01.sch, LTP-01_PL.csv, LTP-01_REF_PL.csv]
2014-08-26 Added qty column to KiPL
    [LTP-01_PL.csv]
2014-09-03 Committed boards to fab
    [RasPi-GVS-B_Cu.gbl, RasPi-GVS-B_Mask.gbs, RasPi-GVS-B_SilkS.gbo, RasPi-GVS-Edge_Cuts.gbr, RasPi-GVS-F_Cu.gtl, RasPi-GVS-F_Mask.gts, RasPi-GVS-F_SilkS.gto, RasPi-GVS-Plus-B_Cu.gbl]
2014-09-03 Deleted extra bak files - created X2 version
    [PWR-BLK-01-01.sch, PWR-BLK-01-02.sch, PWR-BLK-01-03.sch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]
2014-09-23 Put in pullups on I2C SDA, SCK lines.
    [RasPi-GVS-Plus-CFG-B_Cu.gbl, RasPi-GVS-Plus-CFG-B_Mask.gbs, RasPi-GVS-Plus-CFG-B_SilkS.gbo, RasPi-GVS-Plus-CFG-Edge_Cuts.gbr, RasPi-GVS-Plus-CFG-F_Cu.gtl, RasPi-GVS-Plus-CFG-F_Mask.gts, RasPi-GVS-Plus-CFG-F_SilkS.gto, RasPi-GVS-Plus-CFG.drl]
2014-09-24 board costs
    [pwb-seedstudio-5cm-5cm.csv]
2014-09-25 Added pull-ups for SDA, SCK,
    [RasPi-GVS-Plus-CFG-B_Cu.gbl, RasPi-GVS-Plus-CFG-B_Mask.gbs, RasPi-GVS-Plus-CFG-B_SilkS.gbo, RasPi-GVS-Plus-CFG-Edge_Cuts.gbr, RasPi-GVS-Plus-CFG-F_Cu.gtl, RasPi-GVS-Plus-CFG-F_Mask.gts, RasPi-GVS-Plus-CFG-F_SilkS.gto, RasPi-GVS-Plus-CFG.drl]
2014-09-25 redesigned the eeprom stuff
    [RasPi-GVS-Plus-CFG-B_Cu.gbl, RasPi-GVS-Plus-CFG-B_Mask.gbs, RasPi-GVS-Plus-CFG-B_SilkS.gbo, RasPi-GVS-Plus-CFG-Edge_Cuts.gbr, RasPi-GVS-Plus-CFG-F_Cu.gtl, RasPi-GVS-Plus-CFG-F_Mask.gts, RasPi-GVS-Plus-CFG-F_SilkS.gto, RasPi-GVS-Plus-CFG.drl]
2014-09-27 cfg card
    [RasPi-GVS-Plus.csv, RasPi-Plus-GVS_PL.csv]
2014-09-29 MDI board
    [RPI-MDI-B_Cu.gbl, RPI-MDI-B_Mask.gbs, RPI-MDI-B_SilkS.gbo, RPI-MDI-Edge_Cuts.gbr, RPI-MDI-F_Cu.gtl, RPI-MDI-F_Mask.gts, RPI-MDI-F_SilkS.gto, RPI-MDI.drl]
2014-09-30 narrative pics
    [taspi-plus=gvs-cfg.csv]
2014-10-06 Renamed a bunch of stuff
    [RPI-PLUS-GVS-CFG-B_Cu.gbl, RPI-PLUS-GVS-CFG-B_Mask.gbs, RPI-PLUS-GVS-CFG-B_SilkS.gbo, RPI-PLUS-GVS-CFG-Edge_Cuts.gbr, RPI-PLUS-GVS-CFG.drl, RPI-PLUS-GVS-CFG_Cu.gtl, RPI-PLUS-GVS-CFG_Mask.gts, RPI-PLUS-GVS-CFG_SilkS.gto]
2014-10-09 X3 raspi cfg
    [RasPi-GVS-Plus-CFG.kicad_pcb, RasPi-GVS-Plus-CFG.sch, taspi-plus=gvs-cfg.csv]
2014-10-12 gvs stuff
    [RasPi-GVS-Plus-CFG_PL.csv, WakeUp.brd, WakeUp.sch, raspi-plus-gvs-cfg.csv]
2014-10-17 MDI and WakeUp
    [RPI-MDI_PL.csv, WakeUp.sch]
2014-10-21 Created a Raspberry Pi GPIO Tiny Board
    [RPIO-TINY-B_Cu.gbl, RPIO-TINY-B_Mask.gbs, RPIO-TINY-B_SilkS.gbo, RPIO-TINY-Edge_Cuts.gbr, RPIO-TINY-F_Cu.gtl, RPIO-TINY-F_Mask.gts, RPIO-TINY-F_SilkS.gto, RPIO-TINY.drl]
2014-10-27 should ignore thumbs
    [RPP-GPIO-Ext-B_Cu.gbl, RPP-GPIO-Ext-B_Mask.gbs, RPP-GPIO-Ext-B_SilkS.gbo, RPP-GPIO-Ext-Edge_Cuts.gbr, RPP-GPIO-Ext-F_Cu.gtl, RPP-GPIO-Ext-F_Mask.gts, RPP-GPIO-Ext-F_SilkS.gto, RPP-GPIO-Ext.drl]
2014-10-30 Worked LED-TEST-2 card folders
    [LED-TEST-2.kicad_pcb, LED-TEST-2.sch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]
2014-11-03 PulseGen and others updates
    [PulseGenX1.drl, PulseGenX1.gbo, PulseGenX1.gbs, PulseGenerator-B_Cu.gbl, PulseGenerator-B_Mask.gbs, PulseGenerator-B_SilkS.gbo, PulseGenerator-Edge_Cuts.gbr, PulseGenerator-F_Cu.gtl]
2014-11-05 New RPIO-TINY folder
    [RPIO-TINY-B_Cu.gbl, RPIO-TINY-B_Mask.gbs, RPIO-TINY-B_SilkS.gbo, RPIO-TINY-Edge_Cuts.gbr, RPIO-TINY-F_Cu.gtl, RPIO-TINY-F_Mask.gts, RPIO-TINY-F_SilkS.gto, RPIO-TINY.drl]
2014-11-06 X10 Filter for LED light interference
    [X10-FLT-01.sch]
2014-11-10 X10 filter
    [X10-FLT-01-B_Mask.gbs, X10-FLT-01-B_SilkS.gbo, X10-FLT-01-Back.gbl, X10-FLT-01-Edge_Cuts.gbr, X10-FLT-01-F_Mask.gts, X10-FLT-01-F_SilkS.gto, X10-FLT-01-Front.gtl, X10-FLT-01.drl]
2014-11-11 Reference schematic
2014-11-11 New Tiny Version
    [RPIO-TINY-2.kicad_pcb, RPIO-TINY-2.sch]
2014-11-17 LTP stuff
    [LTP-01-CPU.sch, LTP-01-Charger.sch, LTP-01-SMPS.sch, LTP-01.sch]
2014-11-26 Created IReflow project
    Infrared reflow oven project.
    [IReflow-CPU.sch, IReflow.kicad_pcb, IReflow.sch, Power Supply.sch, ThermoAmp.sch]
2014-12-02 Added schematic PNG for webdocs
2014-12-09 New line driver part
2014-12-14 pl tables
    [RPIO-TINY-2_PL.csv]
2014-12-18 Eddie and IReflow stuff
    [EDDIE-01.sch, IReflow-CPU.sch, IReflow.kicad_pcb, IReflow.sch, Power Supply.sch, ThermoAmp.sch]
2014-12-22 LTP Rev X2
    [LTP-01.brd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]
2014-12-23 IReflow board updates
    [IReflow-B_Cu.gbl, IReflow-B_Mask.gbs, IReflow-B_SilkS.gbo, IReflow-Edge_Cuts.gbr, IReflow-F_Cu.gtl, IReflow-F_Mask.gts, IReflow-F_SilkS.gto, IReflow.drl]
2014-12-24 IReflow PCB updates
    [IReflow.kicad_pcb]
2014-12-30 IReflow PCB design updates
    [IReflow-CPU.sch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]
2014-12-31 IReflow updates
    [GVSDuino-X5.sch, IReflow-CPU.sch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]
2014-12-31 Merge remote-tracking branch 'origin/master'
    IReflow/IReflow.kicad_pcb-bak
    IReflow/plots/IReflow-B_Cu.gbl
    IReflow/plots/IReflow-B_Mask.gbs
    IReflow/plots/IReflow-B_SilkS.gbo
    IReflow/plots/IReflow-Edge_Cuts.gbr
    IReflow/plots/IReflow-F_Cu.gtl
    IReflow/plots/IReflow-F_Mask.gts
    IReflow/plots/IReflow-F_SilkS.gto
    IReflow/plots/IReflow.drl
    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
    [IReflow-B_Cu.gbl, IReflow-B_Mask.gbs, IReflow-B_SilkS.gbo, IReflow-Edge_Cuts.gbr, IReflow-F_Cu.gtl, IReflow-F_Mask.gts, IReflow-F_SilkS.gto, IReflow.drl]
2015-01-05 IReflow plus more
    [IRSens-2.brd, IRSens-2.sch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]
2015-01-05 OP-TEST-01 board
    [OP-TEST-01.kicad_pcb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]
2015-01-05 Improved IR Sensor
    [IRSens-2-B_Mask.gbs, IRSens-2-B_SilkS.gbo, IRSens-2-Back.gbl, IRSens-2-Edge_Cuts.gbr, IRSens-2-F_Mask.gts, IRSens-2-F_SilkS.gto, IRSens-2-Front.gtl, IRSens-2.drl]
2015-01-06 IRSens-2 plots ordered
    [IRSens-2.brd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]
2015-01-09 Worked on Power Block
    [PWR-BLK-02-01.sch, PWR-BLK-02-02.sch, PWR-BLK-02-03.sch, PWR-BLK-02.sch]
2015-01-13 other stuff added
    [IReflow_PL.csv]
2015-02-03 ir sense
    [IRSens-2.sch, IRSens-2_PL.csv, OP-TEST-01.kicad_pcb, PWR-BLK-02.kicad_pcb, PWR-BLK-02_AssyParts.csv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]
2015-02-14 pwr blk 02 dxf file
    [PWR-BLK-02-F_Cu.dxf]
2015-03-30 new card filws
    [DIGIO-128-1.sch, DIGIO-128-2.sch, DIGIO-128-3.sch, DIGIO-128-4.sch, DIGIO-128-5.sch, DIGIO-128-6.sch, DIGIO-128-7.sch, DIGIO-128-8.sch]
2015-04-11 DIGIO-128 REV X2
    [DIGIO-128-1.sch, DIGIO-128-2.sch, DIGIO-128-3.sch, DIGIO-128-4.sch, DIGIO-128-5.sch, DIGIO-128-6.sch, DIGIO-128-7.sch, DIGIO-128-8.sch]
2015-04-18 changes to library supporting new Kicad version
    [DIGIO-128-1.sch, DIGIO-128.kicad_pcb, DIGIO-128.sch]
2015-04-18 TRIED TO
    [DIGIO-128-1.sch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]
2015-04-20 rev x2
    [DIGIO-128-1.sch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]
2015-04-20 pics and new board layouts
    [RPP-UIO-16-B_Cu.gbl, RPP-UIO-16-B_Mask.gbs, RPP-UIO-16-B_SilkS.gbo, RPP-UIO-16-Edge_Cuts.gbr, RPP-UIO-16-F_Cu.gtl, RPP-UIO-16-F_Mask.gts, RPP-UIO-16-F_SilkS.gto, RPP-UIO-16.drl]
2015-04-21 glossing pwbs
    [PulseGenerator.sch, PulseGeneratorAssySheet.csv, PulseGenerator_PL.csv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]
2015-04-22 ordered DIGIO-128
    [DIGIO-128-1.sch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]
2015-04-23 MyMenu checkout
    [MyMenu.sch, MyMenu_PL.csv]
2015-04-26 Working on ODAS layouts
    [DigIO16-I2C-B_Cu.gbl, DigIO16-I2C-B_Mask.gbs, DigIO16-I2C-B_SilkS.gbo, DigIO16-I2C-Edge_Cuts.gbr, DigIO16-I2C-F_Cu.gtl, DigIO16-I2C-F_Mask.gts, DigIO16-I2C-F_SilkS.gto, DigIO16-I2C.drl]
2015-04-27 X2 boards - as ordered
    [DigIO16-I2C-B_Cu.gbl, DigIO16-I2C-B_Mask.gbs, DigIO16-I2C-B_SilkS.gbo, DigIO16-I2C-Edge_Cuts.gbr, DigIO16-I2C-F_Cu.gtl, DigIO16-I2C-F_Mask.gts, DigIO16-I2C-F_SilkS.gto, DigIO16-I2C.drl]
2015-05-02 J8 sheet in wiki
    [J8-Pinout.csv, Power Budgets.csv]
2015-05-03 Annotated digio int lines
    [DIGIO-128.kicad_pcb, DIGIO-128.sch, DIGIO-128_X2-PL.csv]
2015-05-16 ODAS stuff
    [DigIO16-I2C-B_Cu.gbl, DigIO16-I2C-B_Mask.gbs, DigIO16-I2C-B_SilkS.gbo, DigIO16-I2C-Edge_Cuts.gbr, DigIO16-I2C-F_Cu.gtl, DigIO16-I2C-F_Mask.gts, DigIO16-I2C-F_SilkS.gto, DigIO16-I2C.drl]
2015-05-16 adding pics
    [DigIO16-I2C-B_Cu.gbl, DigIO16-I2C-B_Mask.gbs, DigIO16-I2C-B_SilkS.gbo, DigIO16-I2C-Edge_Cuts.gbr, DigIO16-I2C-F_Cu.gtl, DigIO16-I2C-F_Mask.gts, DigIO16-I2C-F_SilkS.gto, DigIO16-I2C.drl]
2015-05-18 CPLD Card
    [CPLD-MAX5-100.sch]
2015-05-18 worked on CPLD card
    [CPLD-MAX5-100.kicad_pcb, CPLD-MAX5-100.sch]
2015-05-18 Checkout changes
    [OPTOOUT8-J7.csv, Opto-Calcs.csv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]
2015-05-19 USB BLASTER CABLE USER GUIDE
2015-05-19 Add QFP library and CPLD card layout
    [CPLD-MAX5-100.sch]
2015-05-20 gerbers purchased cards
    [DigIO16-I2C-B_Cu.gbl, DigIO16-I2C-B_Mask.gbs, DigIO16-I2C-B_SilkS.gbo, DigIO16-I2C-Edge_Cuts.gbr, DigIO16-I2C-F_Cu.gtl, DigIO16-I2C-F_Mask.gts, DigIO16-I2C-F_SilkS.gto, DigIO16-I2C.drl]
2015-05-26 CPLD layout
    [CPLD-MAX5-100.kicad_pcb, CPLD-MAX5-100.sch]
2015-06-10 cpld files
    [$savepcb.brd, Design Comparisons Screwduino vs Others.ods, ODAS-Cards.csv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]
2015-06-18 OptoSmall card design
    [OptoBlock.sch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]
2015-06-23 Fix the DB-25 mounting holes
    [DigIO16-I2C.kicad_pcb, DigIO16-I2C.sch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]
2015-06-23 Lotsa digio-128 stuff
    [DIGIO-128-1.sch, DIGIO-128-2.sch, DIGIO-128-3.sch, DIGIO-128-4.sch, DIGIO-128-5.sch, DIGIO-128-6.sch, DIGIO-128-7.sch, DIGIO-128-8.sch]
2015-06-26 Lotsa pics
    [DIGIO-128.kicad_pcb]
2015-07-04 MyMenu updates
    [MyMenu-B_Cu.gbl, MyMenu-B_Mask.gbs, MyMenu-B_SilkS.gbo, MyMenu-Edge_Cuts.gbr, MyMenu-F_Cu.gtl, MyMenu-F_Mask.gts, MyMenu-F_SilkS.gto, MyMenu.drl]
2015-07-06 Added 2nd I2C port for daisy-chain
    [MyMenu-B_Cu.gbl, MyMenu-B_Mask.gbs, MyMenu-B_SilkS.gbo, MyMenu-Edge_Cuts.gbr, MyMenu-F_Cu.gtl, MyMenu-F_Mask.gts, MyMenu-F_SilkS.gto, MyMenu.drl]
2015-07-17 Ordering versions
    [DIGIO-128-B_Cu.gbl, DIGIO-128-B_Mask.gbs, DIGIO-128-B_SilkS.gbo, DIGIO-128-Edge_Cuts.gbr, DIGIO-128-F_Cu.gtl, DIGIO-128-F_Mask.gts, DIGIO-128-F_SilkS.gto, DIGIO-128.drl]
2015-07-18 Made sure I did DRC before ordering
    [DIGIO-128-B_Cu.gbl, DIGIO-128-B_Mask.gbs, DIGIO-128-B_SilkS.gbo, DIGIO-128-Edge_Cuts.gbr, DIGIO-128-F_Cu.gtl, DIGIO-128-F_Mask.gts, DIGIO-128-F_SilkS.gto, DIGIO-128.drl]
2015-07-20 added arduino nano to the board
    [ESP-BKOUT-B_Cu.gbl, ESP-BKOUT-B_Mask.gbs, ESP-BKOUT-B_SilkS.gbo, ESP-BKOUT-Edge_Cuts.gbr, ESP-BKOUT-F_Cu.gtl, ESP-BKOUT-F_Mask.gts, ESP-BKOUT-F_SilkS.gto, ESP-BKOUT.drl]
2015-07-23 DC-62 connector
2015-07-23 62 pin conn
2015-07-24 Ordered boards
    [ESP-BKOUT-B_Cu.gbl, ESP-BKOUT-B_Mask.gbs, ESP-BKOUT-B_SilkS.gbo, ESP-BKOUT-Edge_Cuts.gbr, ESP-BKOUT-F_Cu.gtl, ESP-BKOUT-F_Mask.gts, ESP-BKOUT-F_SilkS.gto, ESP-BKOUT.drl]
2015-07-28 I2C Hub parts
2015-07-28 Initial checking of the I2C repeater
    [I2C-RPT-01-B_Cu.gbl, I2C-RPT-01-B_Mask.gbs, I2C-RPT-01-B_SilkS.gbo, I2C-RPT-01-Edge_Cuts.gbr, I2C-RPT-01-F_Cu.gtl, I2C-RPT-01-F_Mask.gts, I2C-RPT-01-F_SilkS.gto, I2C-RPT-01.drl]
2015-07-30 Change part to TSOP on repeater
    [I2C-RPT-01-B_Cu.gbl, I2C-RPT-01-B_Mask.gbs, I2C-RPT-01-B_SilkS.gbo, I2C-RPT-01-Edge_Cuts.gbr, I2C-RPT-01-F_Cu.gtl, I2C-RPT-01-F_Mask.gts, I2C-RPT-01-F_SilkS.gto, I2C-RPT-01.drl]
2015-08-01 I2C repeater ordered cards from this rev
    [I2C-RPT-01-B_Cu.gbl, I2C-RPT-01-B_Mask.gbs, I2C-RPT-01-B_SilkS.gbo, I2C-RPT-01-Edge_Cuts.gbr, I2C-RPT-01-F_Cu.gtl, I2C-RPT-01-F_Mask.gts, I2C-RPT-01-F_SilkS.gto, I2C-RPT-01.drl]
2015-08-02 ESP Break CAD pic
2015-08-05 New HD SMT connectors
2015-08-05 I2C Hub for the Raspberry Pi
    [I2C-RPT-01.sch, RPI-I2C-HUB.kicad_pcb, RPI-I2C-HUB.sch]
2015-08-14 Added details to user layer for template
    [screwduino.kicad_pcb]
2015-08-25 esp rework and pics
    [ESP-BKOUT-B_Cu.gbl, ESP-BKOUT-B_Mask.gbs, ESP-BKOUT-B_SilkS.gbo, ESP-BKOUT-Edge_Cuts.gbr, ESP-BKOUT-F_Cu.gtl, ESP-BKOUT-F_Mask.gts, ESP-BKOUT-F_SilkS.gto, ESP-BKOUT.drl]
2015-08-28 The I2C repeater docs
    [I2C-RPT-01.sch, I2C-RPT-01_PL.csv]
2015-08-30 updates to esp and screwduino boards
    [ESP-BKOUT-B_Cu.gbl, ESP-BKOUT-B_Mask.gbs, ESP-BKOUT-B_SilkS.gbo, ESP-BKOUT-Edge_Cuts.gbr, ESP-BKOUT-F_Cu.gtl, ESP-BKOUT-F_Mask.gts, ESP-BKOUT-F_SilkS.gto, ESP-BKOUT.drl]
2015-08-31 Additional connectors
2015-09-01 front cad picture
2015-09-11 I2C repeater
    [DigIO16-I2C.kicad_pcb, I2C-RPT-01.sch, RPI-I2C-HUB_PL.csv]
2015-09-27 psoc5 code
    [Measure75OhmsOut.csv, Screwduino-PL-Illustrated.csv]
2015-09-28 Edison adapter
    [IntelEdisonBlockTemplate.kicad_pcb, IntelEdisonBlockTemplate.sch]
2015-09-29 PSOC Connector
2015-09-30 More Connectors
2015-10-12 Initial check-in of I2CIO-8 design
    [I2CIO-8-B_Cu.gbl, I2CIO-8-B_Mask.gbs, I2CIO-8-B_SilkS.gbo, I2CIO-8-Edge_Cuts.gbr, I2CIO-8-F_Cu.gtl, I2CIO-8-F_Mask.gts, I2CIO-8-F_SilkS.gto, I2CIO-8.drl]
2015-10-12 SPI Potentiometer
    [I2CIO-8-B_Cu.gbl, I2CIO-8-B_Mask.gbs, I2CIO-8-B_SilkS.gbo, I2CIO-8-Edge_Cuts.gbr, I2CIO-8-F_Cu.gtl, I2CIO-8-F_Mask.gts, I2CIO-8-F_SilkS.gto, I2CIO-8.drl]
2015-10-13 I2C Temperature card
    [I2C-TEMP-B_Cu.gbl, I2C-TEMP-B_Mask.gbs, I2C-TEMP-B_SilkS.gbo, I2C-TEMP-Edge_Cuts.gbr, I2C-TEMP-F_Cu.gtl, I2C-TEMP-F_Mask.gts, I2C-TEMP-F_SilkS.gto, I2C-TEMP.drl]
2015-10-13 updates for esp breakout
    [ESP-BKOUT-X2_PL.csv, ESP-BKOUT_PL.csv, GPS-Design.sch]
2015-10-16 UPDATES TO I2C-TEMP
    [I2C-TEMP-B_Cu.gbl, I2C-TEMP-B_Mask.gbs, I2C-TEMP-B_SilkS.gbo, I2C-TEMP-Edge_Cuts.gbr, I2C-TEMP-F_Cu.gtl, I2C-TEMP-F_Mask.gts, I2C-TEMP-F_SilkS.gto, I2C-TEMP.drl]
2015-10-16 FINAL TOUCHES ON SPI-POTX2
    [SPI-POTX2-B_Cu.gbl, SPI-POTX2-B_Mask.gbs, SPI-POTX2-B_SilkS.gbo, SPI-POTX2-Edge_Cuts.gbr, SPI-POTX2-F_Cu.gtl, SPI-POTX2-F_Mask.gts, SPI-POTX2-F_SilkS.gto, SPI-POTX2.drl]
2015-10-19 Created new rev board
    [GVSDuino-B_Cu.gbl, GVSDuino-B_Mask.gbs, GVSDuino-B_SilkS.gbo, GVSDuino-Edge_Cuts.gbr, GVSDuino-F_Cu.gtl, GVSDuino-F_Mask.gts, GVSDuino-F_SilkS.gto, GVSDuino-X5-B_Cu.gbl]
2015-10-19 Minor tweeks to the SPI-POT design
    [SPI-POTX2-B_Cu.gbl, SPI-POTX2-B_Mask.gbs, SPI-POTX2-B_SilkS.gbo, SPI-POTX2-Edge_Cuts.gbr, SPI-POTX2-F_Cu.gtl, SPI-POTX2-F_Mask.gts, SPI-POTX2-F_SilkS.gto, SPI-POTX2.drl]
2015-10-20 Ordered GVSDuino X6
    [GVSDuino-B_Cu.gbl, GVSDuino-B_Mask.gbs, GVSDuino-B_SilkS.gbo, GVSDuino-Edge_Cuts.gbr, GVSDuino-F_Cu.gtl, GVSDuino-F_Mask.gts, GVSDuino-F_SilkS.gto, GVSDuino.drl]
2015-10-20 Ordered I2C-TEMP-01 Rev X1 boards
    [I2C-TEMP-B_Cu.gbl, I2C-TEMP-B_Mask.gbs, I2C-TEMP-B_SilkS.gbo, I2C-TEMP-Edge_Cuts.gbr, I2C-TEMP-F_Cu.gtl, I2C-TEMP-F_Mask.gts, I2C-TEMP-F_SilkS.gto, I2C-TEMP.drl]
2015-10-20 Ordered I2CIO-8 Rev X1 boards
    [I2CIO-8-B_Cu.gbl, I2CIO-8-B_Mask.gbs, I2CIO-8-B_SilkS.gbo, I2CIO-8-Edge_Cuts.gbr, I2CIO-8-F_Cu.gtl, I2CIO-8-F_Mask.gts, I2CIO-8-F_SilkS.gto, I2CIO-8.drl]
2015-10-20 RPI-CONSOLE Rev X3 ordered boards
    [RP-Console-B_Cu.gbl, RP-Console-B_Mask.gbs, RP-Console-B_SilkS.gbo, RP-Console-Edge_Cuts.gbr, RP-Console-F_Cu.gtl, RP-Console-F_Mask.gts, RP-Console-F_SilkS.gto, RP-Console-NPTH.drl]
2015-10-20 RPI-Console card backup of Rev X2
    [RP-Console-B_Cu.gbl, RP-Console-B_Mask.gbs, RP-Console-B_SilkS.gbo, RP-Console-Edge_Cuts.gbr, RP-Console-F_Cu.gtl, RP-Console-F_Mask.gts, RP-Console-F_SilkS.gto, RP-Console.drl]
2015-10-20 RPI-Console Rev X3 files
    [RP-Console.kicad_pcb, RP-Console.sch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]
2015-10-20 SPI-POTX2 Rev X1 ordered boards
    [SPI-POTX2-B_Cu.gbl, SPI-POTX2-B_Mask.gbs, SPI-POTX2-B_SilkS.gbo, SPI-POTX2-Edge_Cuts.gbr, SPI-POTX2-F_Cu.gtl, SPI-POTX2-F_Mask.gts, SPI-POTX2-F_SilkS.gto, SPI-POTX2.drl]
2015-10-22 Theremin PSOC files
    [ThereminPSOC.sdf]
2015-10-25 Added rts/cts to buffered lines
    [ESP-BKOUT-B_Cu.gbl, ESP-BKOUT-B_Mask.gbs, ESP-BKOUT-B_SilkS.gbo, ESP-BKOUT-Edge_Cuts.gbr, ESP-BKOUT-F_Cu.gtl, ESP-BKOUT-F_Mask.gts, ESP-BKOUT-F_SilkS.gto, ESP-BKOUT.drl]
2015-10-31 new bbb gvs card
    [Analog-Inputs.sch, BBB-Conn.sch, BBB-GVS-2.sch, BBB-GVS-3.kicad_pcb, BBB-GVS-3.sch, BBB-P8-Conn.sch, BBB-P8-P9-Conn.sch, BBB-P9-Conn.sch]
2015-11-11 KiCad library updates
2015-11-12 I2C IO LED
    [I2CIO-8-B_Cu.gbl, I2CIO-8-B_Mask.gbs, I2CIO-8-B_SilkS.gbo, I2CIO-8-Edge_Cuts.gbr, I2CIO-8-F_Cu.gtl, I2CIO-8-F_Mask.gts, I2CIO-8-F_SilkS.gto, I2CIO-8.drl]
2015-11-16 BBB-GVS-3 designed
    [Analog-Inputs.sch, BBB-Conn.sch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]
2015-11-17 RPPSOC card
    [PSOC-SPI.sdf, RPP-CFG-V2.csv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]
2015-11-18 RPPSOC fine tuning
    [RPP-UIO-16-B_Cu.gbl, RPP-UIO-16-B_Mask.gbs, RPP-UIO-16-B_SilkS.gbo, RPP-UIO-16-Edge_Cuts.gbr, RPP-UIO-16-F_Cu.gtl, RPP-UIO-16-F_Mask.gts, RPP-UIO-16-F_SilkS.gto, RPP-UIO-16.drl]
2015-11-19 Added caps to RPPSOC
    [RPPSOC-B_Cu.gbl, RPPSOC-B_Mask.gbs, RPPSOC-B_SilkS.gbo, RPPSOC-Edge_Cuts.gbr, RPPSOC-F_Cu.gtl, RPPSOC-F_Mask.gts, RPPSOC-F_SilkS.gto, RPPSOC.drl]
2015-11-19 Fine tuning the design
    [RPPSOC-B_Cu.gbl, RPPSOC-B_Mask.gbs, RPPSOC-B_SilkS.gbo, RPPSOC-Edge_Cuts.gbr, RPPSOC-F_Cu.gtl, RPPSOC-F_Mask.gts, RPPSOC-F_SilkS.gto, RPPSOC.drl]
2015-11-22 BBB GVS version 3
    [BBB-GVS-3-B_Cu.gbl, BBB-GVS-3-B_Mask.gbs, BBB-GVS-3-B_SilkS.gbo, BBB-GVS-3-Edge_Cuts.gbr, BBB-GVS-3-F_Cu.gtl, BBB-GVS-3-F_Mask.gts, BBB-GVS-3-F_SilkS.gto, BBB-GVS-3.drl]
2015-11-23 fixed cap gnd
    [GVSDuino-B_Cu.gbl, GVSDuino-B_Mask.gbs, GVSDuino-B_SilkS.gbo, GVSDuino-Edge_Cuts.gbr, GVSDuino-F_Cu.gtl, GVSDuino-F_Mask.gts, GVSDuino-F_SilkS.gto, GVSDuino.drl]
2015-11-27 Fixed pinouts of ports added silkscreen
    [I2C-RPT-01-B_Cu.gbl, I2C-RPT-01-B_Mask.gbs, I2C-RPT-01-B_SilkS.gbo, I2C-RPT-01-Edge_Cuts.gbr, I2C-RPT-01-F_Cu.gtl, I2C-RPT-01-F_Mask.gts, I2C-RPT-01-F_SilkS.gto, I2C-RPT-01.drl]
2015-12-01 I2CIO-8 updates
    [I2C-TEMP.sch, I2C-TEMP_PL.csv, I2CIO-8.sch, I2CIO-8_PL.csv]
2015-12-12 comsole usb micro
    [RP-Console-u-B_Cu.gbl, RP-Console-u-B_Mask.gbs, RP-Console-u-B_SilkS.gbo, RP-Console-u-Edge_Cuts.gbr, RP-Console-u-F_Cu.gtl, RP-Console-u-F_Mask.gts, RP-Console-u-F_SilkS.gto, RP-Console-u.drl]
2015-12-21 Fixed SCK to be SCL
    [I2CIO-8-B_Cu.gbl, I2CIO-8-B_Mask.gbs, I2CIO-8-B_SilkS.gbo, I2CIO-8-Edge_Cuts.gbr, I2CIO-8-F_Cu.gtl, I2CIO-8-F_Mask.gts, I2CIO-8-F_SilkS.gto, I2CIO-8.drl]
2015-12-22 new console card
    [I2C-RPT-01.sch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]
2015-12-23 Stuff with I2CIO-8 new version
    [I2CIO-8-B_Cu.gbl, I2CIO-8-B_Mask.gbs, I2CIO-8-B_SilkS.gbo, I2CIO-8-Edge_Cuts.gbr, I2CIO-8-F_Cu.gtl, I2CIO-8-F_Mask.gts, I2CIO-8-F_SilkS.gto, I2CIO-8.drl]
2015-12-27 Power circuitry
    [PWR-BLK-03-01.sch, PWR-BLK-03-02.sch, PWR-BLK-03-03.sch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]
2015-12-30 PL tweeks
    [PWR-BLK-03-01.sch, PWR-BLK-03_PL.csv]
2015-12-31 BBB-GVS-3 Assembly sheet pics
    [BBB-GVS-3_PL.csv, PWR-BLK-03.kicad_pcb]
2016-01-03 RPI-MDI Schematic
2016-01-03 PWR-BLK-03 Ordered
    [PWR-BLK-03-B_Cu.gbl, PWR-BLK-03-B_Mask.gbs, PWR-BLK-03-B_SilkS.gbo, PWR-BLK-03-Edge_Cuts.gbr, PWR-BLK-03-F_Cu.gtl, PWR-BLK-03-F_Mask.gts, PWR-BLK-03-F_SilkS.gto, PWR-BLK-03.drl]
2016-01-03 Change to GVS pins
    [I2CIO-8.kicad_pcb, I2CIO-8.sch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]
2016-01-03 Changing GVS connector types
    [Analog-Inputs.sch, BBB-Conn.sch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]
2016-01-04 moving around kicad utility code
    [BBB-GVS-V2.brd, BBB-GVS-V2.sch, BBB-GVS-V2_new.sch, BBB-GVS-V2_newboard.brd, OptoIn8-I2C - Copy.sch, OptoIn8-I2C.sch, P8.sch, P8_new.sch]
2016-01-06 Adding filter modules
2016-01-07 Changing orientation of bottom connectors
    [BBB-GVS-3.kicad_pcb, BBB-P8-Conn.sch, BBB-P9-Conn.sch, trans16.sch]
2016-01-18 Constant Current load control board
    [CCLOAD-01.kicad_pcb, CCLOAD-01.sch]
2016-01-23 Tweeks to the silkscreen
    [I2C-RPT-01-B_Cu.gbl, I2C-RPT-01-B_Mask.gbs, I2C-RPT-01-B_SilkS.gbo, I2C-RPT-01-Edge_Cuts.gbr, I2C-RPT-01-F_Cu.gtl, I2C-RPT-01-F_Mask.gts, I2C-RPT-01-F_SilkS.gto, I2C-RPT-01.drl]
2016-01-25 const current load
    [CCLOAD-01.sch]
2016-01-28 Constant Current Load
    [CCLOAD-01.kicad_pcb, CCLOAD-01.sch]
2016-01-28 Load updates for new KiCad
    [CCLOAD-01.kicad_pcb, CCLOAD-01.sch]
2016-02-02 cc load updates
    [CCLOAD-01-B.Cu.gbl, CCLOAD-01-B.Mask.gbs, CCLOAD-01-B.SilkS.gbo, CCLOAD-01-Edge.Cuts.gm1, CCLOAD-01-F.Cu.gtl, CCLOAD-01-F.Mask.gts, CCLOAD-01-F.SilkS.gto, CCLOAD-01.drl]
2016-02-02 Changed stuff
    [NewPot.brd, NewPot.sch]
2016-02-05 Initial checkin of Voltage Reference design
    [VRef4096.brd, VRef4096.sch]
2016-02-06 I2C-RPT-01 test setup pics
2016-02-08 Ref Voltage layout
    [VRef4096.kicad_pcb]
2016-02-08 Layout card
    [I-100ma-AdjPot.xlsx, VRef4096.kicad_pcb, VRef4096.sch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]
2016-02-12 CC Load PL
    [CCLOAD-01_PL.csv]
2016-02-14 RotaryEncoder with ATTiny85
    [NewPot-B.Mask.gbs, NewPot-B.SilkS.gbo, NewPot-Back.gbl, NewPot-Edge.Cuts.gm1, NewPot-F.Mask.gts, NewPot-F.SilkS.gto, NewPot-Front.gtl, NewPot.drl]
2016-02-14 Voltage Reference design
    [VRef4096-B.Mask.gbs, VRef4096-B.SilkS.gbo, VRef4096-B_Cu.gbl, VRef4096-B_SilkS.gbo, VRef4096-Back.gbl, VRef4096-Edge.Cuts.gm1, VRef4096-F.Mask.gts, VRef4096-F.SilkS.gto]
2016-02-14 Constant current load design
    [CCLOAD-01-B.Cu.gbl, CCLOAD-01-B.Mask.gbs, CCLOAD-01-B.SilkS.gbo, CCLOAD-01-Edge.Cuts.gm1, CCLOAD-01-F.Cu.gtl, CCLOAD-01-F.Mask.gts, CCLOAD-01-F.SilkS.gto, CCLOAD-01.drl]
2016-02-14 Rotary encoder with cpu and pot
    [NewPot2-B.Mask.gbs, NewPot2-B.SilkS.gbo, NewPot2-Back.gbl, NewPot2-Edge.Cuts.gm1, NewPot2-F.Mask.gts, NewPot2-F.SilkS.gto, NewPot2-Front.gtl, NewPot2.drl]
2016-02-17 USB Power module
    [PWR-BLK-03-02.sch, PWR-BLK-03-03.sch, USB-Power-01.sch, USB-Power-02.sch, USB-Power-03.sch, USB-Power.kicad_pcb, USB-Power.sch]
2016-02-17 Tweeks to the USB power card
    [USB-Power-02.sch, USB-Power-03.sch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]
2016-02-18 Update design for mfg Pulse gen card
    [PULSE-GEN-B.Cu.gbl, PULSE-GEN-B.Mask.gbs, PULSE-GEN-B.SilkS.gbo, PULSE-GEN-Edge.Cuts.gm1, PULSE-GEN-F.Cu.gtl, PULSE-GEN-F.Mask.gts, PULSE-GEN-F.SilkS.gto, PULSE-GEN.drl]
2016-02-18 Added 50/75 Ohm select and Test Stamp location
    [PULSE-GEN-B.Cu.gbl, PULSE-GEN-B.Mask.gbs, PULSE-GEN-B.SilkS.gbo, PULSE-GEN-B_Cu.gbl, PULSE-GEN-B_Mask.gbs, PULSE-GEN-B_SilkS.gbo, PULSE-GEN-Edge.Cuts.gm1, PULSE-GEN-Edge_Cuts.gbr]
2016-02-28 DDS card
    [DDS-Mini-B.Mask.gbs, DDS-Mini-B.SilkS.gbo, DDS-Mini-Back.gbl, DDS-Mini-Edge.Cuts.gm1, DDS-Mini-F.Mask.gts, DDS-Mini-F.SilkS.gto, DDS-Mini-Front.gtl, DDS-Mini.drl]
2016-03-03 newer NewPot2 fixes attiny footprint
    [NewPot2-B.Mask.gbs, NewPot2-B.SilkS.gbo, NewPot2-Back.gbl, NewPot2-Edge.Cuts.gm1, NewPot2-F.Mask.gts, NewPot2-F.SilkS.gto, NewPot2-Front.gtl, NewPot2.drl]
2016-03-16 Pictures of the Vref4096 assembly
2016-05-03 lotsa changes
    [PULSE-GEN-B.Cu.gbl, PULSE-GEN-B.Cu.gbr, PULSE-GEN-B.Mask.gbr, PULSE-GEN-B.Mask.gbs, PULSE-GEN-B.SilkS.gbo, PULSE-GEN-B.SilkS.gbr, PULSE-GEN-B_Cu.gbl, PULSE-GEN-B_Mask.gbs]
2016-05-20 RPPSOC pics
    [RPPSOC-B.Cu.gbl, RPPSOC-B.Mask.gbs, RPPSOC-B.SilkS.gbo, RPPSOC-Edge.Cuts.gm1, RPPSOC-F.Cu.gtl, RPPSOC-F.Mask.gts, RPPSOC-F.SilkS.gto, RPPSOC.drl]
2016-05-24 RPPSOC pics and tables
    [RPPSOC-B.Cu.gbl, RPPSOC-B.Cu.gbr, RPPSOC-B.Mask.gbr, RPPSOC-B.Mask.gbs, RPPSOC-B.SilkS.gbo, RPPSOC-B.SilkS.gbr, RPPSOC-B_Cu.gbl, RPPSOC-B_Mask.gbs]
2016-06-03 new pics
    [RPPSOC-PINS-20x2pins.csv]
2016-06-15 LAN USB
    [LED-TEST-2.kicad_pcb, LED-TEST-2.sch]
2016-06-15 Changed the file name
    [LAN-USB.kicad_pcb, LAN-USB.sch, LED-TEST-2.sch]
2016-06-19 RPI-PWR design
    [RPI-PWR-B.Cu.gbr, RPI-PWR-B.Mask.gbr, RPI-PWR-B.SilkS.gbr, RPI-PWR-Edge.Cuts.gbr, RPI-PWR-F.Cu.gbr, RPI-PWR-F.Mask.gbr, RPI-PWR-F.SilkS.gbr, RPI-PWR.drl]
2016-06-25 rppsoc mounted with standoffs
2016-06-28 USB cables for a PC case
    [PC-Case-USB.kicad_pcb, PC-Case-USB.sch]
2016-06-28 PC Case Power Reset and LEDs interface for a Pi
    [PC-Case-SwLED.kicad_pcb, PC-Case-SwLED.sch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]
2016-06-28 case switch
    [PC-Case-SwLED.kicad_pcb, PC-Case-SwLED.sch]
2016-06-29 renamed to PiATX
    [PC-Case-SwLED.kicad_pcb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]
2016-07-05 PiATX pics
    [PIATXConn26.csv, _saved_PiATX.sch]
2016-07-05 Autosaved schematic
    [_saved_PiATX.sch]
2016-07-10 esp 12e card design
    [ESP-12E-01-B.Mask.gbr, ESP-12E-01-B.SilkS.gbr, ESP-12E-01-Back.gbr, ESP-12E-01-Edge.Cuts.gbr, ESP-12E-01-F.Mask.gbr, ESP-12E-01-F.SilkS.gbr, ESP-12E-01-Front.gbr, ESP-12E-01.drl]
2016-07-18 What I did on my summer vac
    [Defaults.csv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]
2016-07-24 REv X1 archive now Rev X2 layout
    [PIATXConn26.csv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]
2016-07-26 PiATX stuff
    [PiATX-B_Cu.gbr, PiATX-B_Mask.gbr, PiATX-B_SilkS.gbr, PiATX-Edge_Cuts.gbr, PiATX-F_Cu.gbr, PiATX-F_Mask.gbr, PiATX-F_SilkS.gbr, PiATX.drl]
2016-07-29 rpi-console fix usb conn
    [RP-Console-B.Cu.gbl, RP-Console-B.Mask.gbs, RP-Console-B.SilkS.gbo, RP-Console-Edge.Cuts.gm1, RP-Console-F.Cu.gtl, RP-Console-F.Mask.gts, RP-Console-F.SilkS.gto, RP-Console.drl]
2016-07-31 pi cluster
    [J2.csv, PiATX-2016-04-24.sch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]
2016-07-31 Added graph x axis
    [ToasterOvenTimeVsTemp(30secs).ods]
2016-07-31 bake curve
    [ToasterOvenTimeVsTemp(30secs)bake.ods]
2016-07-31 reflow oven
    [Bake-HeatCycleOnly.csv, OvenManualBake-vs-LeadFreeProfile.csv, OvenManualBake-vs-LeadedProfile.csv, ToasterOvenTimeVsTemp(30secs).ods, ToasterOvenTimeVsTemp(30secs)bake-FullCycle.csv, ToasterOvenTimeVsTemp(30secs)bake-FullCycle.ods, ToasterOvenTimeVsTemp(30secs)bake.ods, ToasterOvenTimeVsTemp(30secs)broil.ods]
2016-08-07 BeagleBone Black Industrial version
    [Analog-Inputs.sch, BBB-Conn.sch, BBB-GVS-3_PL.csv, BBB-IND-01.kicad_pcb, BBB-IND-01.sch, BBB-P8-Conn.sch, BBB-P8-P9-Conn.sch, BBB-P9-Conn.sch]
2016-08-08 docs for kicad utils
    [test.sch]
2016-08-09 Back Annotation Schematic code working
    [Defaults.csv, LED-TEST-2.kicad_pcb, LED-TEST-2.sch, LED-TEST-2before.sch, OptoIn8-I2C - Copy.sch, OptoIn8-I2C.sch, test.sch]
2016-08-28 card pics
    [ESP-12E-01_PL.csv]
2016-09-02 FTDI USB to RS-232 converter
    [FTDI-USB-RS-232.kicad_pcb, FTDI-USB-RS-232.sch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]
2016-09-02 package tweeks
    [FTDI-USB-RS-232.kicad_pcb, FTDI-USB-RS-232.sch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]
2016-09-30 Analog Signal Conditioner
    [ANA-SIG-CON.kicad_pcb, ANA-SIG-CON.sch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]
2016-10-06 proto board
    [GRID49-B.Mask.gbs, GRID49-B.SilkS.gbo, GRID49-Back.gbl, GRID49-Edge.Cuts.gm1, GRID49-F.Mask.gts, GRID49-F.SilkS.gto, GRID49-Front.gtl, GRID49.drl]
2016-10-18 LED Test card pcb file updated
    [LED-TEST-2.kicad_pcb]
2016-10-18 Starting X3 version
    [PIATXConn26.csv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]
2016-10-24 32-Bit I/O Card
    [DigIO16-I2C_PL.csv, DigIO32-I2C.kicad_pcb, DigIO32-I2C.sch, RC-Calculations.xlsx, RP-Console_PL.csv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]
2016-10-25 Ordered this version of the card
    [DigIO32-I2C-B_Cu.gbl, DigIO32-I2C-B_Mask.gbs, DigIO32-I2C-B_SilkS.gbo, DigIO32-I2C-Edge_Cuts.gbr, DigIO32-I2C-F_Cu.gtl, DigIO32-I2C-F_Mask.gts, DigIO32-I2C-F_SilkS.gto, DigIO32-I2C.drl]
2016-10-25 16-Bit Custom I/O Card
    [DigIO32-I2C.kicad_pcb, DigIO32-I2C.sch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]
2016-10-26 Some new DAS family cards
    [DigIO32-I2C-B_Cu.gbl, DigIO32-I2C-B_Mask.gbs, DigIO32-I2C-B_SilkS.gbo, DigIO32-I2C-Edge_Cuts.gbr, DigIO32-I2C-F_Cu.gtl, DigIO32-I2C-F_Mask.gts, DigIO32-I2C-F_SilkS.gto, DigIO32-I2C.drl]
2016-10-27 PSOC on an ODAS board
    [ODAS-PSOC5.kicad_pcb, ODAS-PSOC5.sch]
2016-10-28 Worked on adding features to ODAS-PSOC5 card
    [ODAS-PSOC5.sch]
2016-11-06 PSOC5 board layout
    [ODAS-PSOC5.kicad_pcb, ODAS-PSOC5.sch]
2016-11-07 Fixed missing power line
    [RP-Console_PL.csv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]
2016-11-07 Display Processor Card
    [DisplayProc-01-B_Cu.gbl, DisplayProc-01-B_Mask.gbs, DisplayProc-01-B_SilkS.gbo, DisplayProc-01-Edge_Cuts.gbr, DisplayProc-01-F_Cu.gtl, DisplayProc-01-F_Mask.gts, DisplayProc-01-F_SilkS.gto, DisplayProc-01.drl]
2016-11-07 Display Processor Single-Board
2016-11-08 Rev 2 with improved reset
    [ESP-12E-01-B.Mask.gbr, ESP-12E-01-B.SilkS.gbr, ESP-12E-01-B_Cu.gbr, ESP-12E-01-B_Mask.gbr, ESP-12E-01-B_SilkS.gbr, ESP-12E-01-Back.gbr, ESP-12E-01-Edge.Cuts.gbr, ESP-12E-01-Edge_Cuts.gbr]
2016-11-08 Diode was shown backwards
2016-11-08 ESP-12E-01 update
    [ESP-12E-01-B_Cu.gbr, ESP-12E-01-B_Mask.gbr, ESP-12E-01-B_SilkS.gbr, ESP-12E-01-Edge_Cuts.gbr, ESP-12E-01-F_Cu.gbr, ESP-12E-01-F_Mask.gbr, ESP-12E-01-F_SilkS.gbr, ESP-12E-01.drl]
2016-11-08 WeMOS schematic
2016-11-09 Improvements to the Display Processor card
    [DisplayProc-01-B_Cu.gbl, DisplayProc-01-B_Mask.gbs, DisplayProc-01-B_SilkS.gbo, DisplayProc-01-Edge_Cuts.gbr, DisplayProc-01-F_Cu.gtl, DisplayProc-01-F_Mask.gts, DisplayProc-01-F_SilkS.gto, DisplayProc-01.drl]
2016-11-09 Serial I/O Processor
    [DisplayProc-01-B_Cu.gbl, DisplayProc-01-B_Mask.gbs, DisplayProc-01-B_SilkS.gbo, DisplayProc-01-Edge_Cuts.gbr, DisplayProc-01-F_Cu.gtl, DisplayProc-01-F_Mask.gts, DisplayProc-01-F_SilkS.gto, DisplayProc-01.drl]
2016-11-14 Display and Serial IO Processors
    [DisplayProc-01-B_Cu.gbl, DisplayProc-01-B_Mask.gbs, DisplayProc-01-B_SilkS.gbo, DisplayProc-01-Edge_Cuts.gbr, DisplayProc-01-F_Cu.gtl, DisplayProc-01-F_Mask.gts, DisplayProc-01-F_SilkS.gto, DisplayProc-01.drl]
2016-11-18 Logic Probe parts List
    [RP-Console_PL.csv]
2016-11-21 Built cards
    [DigIO32-I2C-B.Cu.gbl, DigIO32-I2C-B.Mask.gbs, DigIO32-I2C-B.SilkS.gbo, DigIO32-I2C-Edge.Cuts.gm1, DigIO32-I2C-F.Cu.gtl, DigIO32-I2C-F.Mask.gts, DigIO32-I2C-F.SilkS.gto, DigIO32-I2C.drl]
2016-11-21 FPGA adapter carrd
    [EP2C5-DB.kicad_pcb, EP2C5-DB.sch]
2016-11-23 FPGA Adapter board
    [EP2C5-DB.kicad_pcb, EP2C5-DB.sch]
2016-11-23 Multi-Computer files
    [EP2C5-DB-B_Cu.gbl, EP2C5-DB-B_Mask.gbs, EP2C5-DB-B_SilkS.gbo, EP2C5-DB-Edge_Cuts.gbr, EP2C5-DB-F_Cu.gtl, EP2C5-DB-F_Mask.gts, EP2C5-DB-F_SilkS.gto, EP2C5-DB.drl]
2016-11-25 diff probe
    [DiffProbe.kicad_pcb, DiffProbe.sch, DiffProbe_PL.csv, EP2C5-DB_PL.csv, ODAS-PSOC5.sch, ODAS-PSOC5_PL.csv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]
2016-11-26 Differential scope robe
    [DiffProbe-B.Cu.gbl, DiffProbe-B.Mask.gbs, DiffProbe-B.SilkS.gbo, DiffProbe-Edge.Cuts.gm1, DiffProbe-F.Cu.gtl, DiffProbe-F.Mask.gts, DiffProbe-F.SilkS.gto, DiffProbe.drl]
2016-11-26 Assembly Instructions
    [DisplayProc-01_PL.csv, LED-TEST-2_PL.csv, Proto16-I2C_PL.csv, SIOProc-01_PL.csv]
2016-11-26 Changed resistor value of video output
    [DisplayProc-01.sch]
2016-11-28 Merging
    # Conflicts:
    # KiCAD/library/DougsSch.bak
    [DiffProbe_PL.csv, EP2C5-DB.kicad_pcb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]
2016-11-29 Pictures of the terminal boards
    [DisplayProc-ISP.csv, Keyboard-Adapter-Cable.csv]
2016-12-01 Ordered a bunch of cards from seeedstudio
    [DiffProbe-B_Cu.gbr, DiffProbe-B_Mask.gbr, DiffProbe-B_SilkS.gbr, DiffProbe-Edge_Cuts.gbr, DiffProbe-F_Cu.gbr, DiffProbe-F_Mask.gbr, DiffProbe-F_SilkS.gbr, DiffProbe.drl]
2016-12-09 New Diff Probe Pics
2016-12-12 Kicad Lib updates
2016-12-17 Add keyboard resistors
    [EP2C5-DB-B_Cu.gbr, EP2C5-DB-B_Mask.gbr, EP2C5-DB-B_SilkS.gbr, EP2C5-DB-Edge_Cuts.gbr, EP2C5-DB-F_Cu.gbr, EP2C5-DB-F_Mask.gbr, EP2C5-DB-F_SilkS.gbr, EP2C5-DB.drl]
2016-12-19 Created OptoFast
    [OptoBlock.sch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]
2016-12-19 ODAS-PSOC5 change to 6-32 screw holes
    [ODAS-PSOC5-B_Cu.gbr, ODAS-PSOC5-B_Mask.gbr, ODAS-PSOC5-B_SilkS.gbr, ODAS-PSOC5-Edge_Cuts.gbr, ODAS-PSOC5-F_Cu.gbr, ODAS-PSOC5-F_Mask.gbr, ODAS-PSOC5-F_SilkS.gbr, ODAS-PSOC5.drl]
2016-12-20 retro computing
    [EP2C5-DB.kicad_pcb, EP2C5-DB.sch, NTSC_Video_Timing.ods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]
2016-12-23 card updates
    [ODAS-PSOC5-B.Cu.gbr, ODAS-PSOC5-B.Mask.gbr, ODAS-PSOC5-B.SilkS.gbr, ODAS-PSOC5-Edge.Cuts.gbr, ODAS-PSOC5-F.Cu.gbr, ODAS-PSOC5-F.Mask.gbr, ODAS-PSOC5-F.SilkS.gbr, ODAS-PSOC5.drl]
2016-12-24 re-layed out the fpga daughtercard
    [EP2C5-DB-B.Cu.gbr, EP2C5-DB-B.Mask.gbr, EP2C5-DB-B.SilkS.gbr, EP2C5-DB-B_Cu.gbr, EP2C5-DB-B_SilkS.gbr, EP2C5-DB-Edge.Cuts.gbr, EP2C5-DB-Edge_Cuts.gbr, EP2C5-DB-F.Cu.gbr]
2016-12-26 sd card
    [EP2C5-DB-B.Cu.gbr, EP2C5-DB-B.Mask.gbr, EP2C5-DB-B.SilkS.gbr, EP2C5-DB-Edge.Cuts.gbr, EP2C5-DB-F.Cu.gbr, EP2C5-DB-F.Mask.gbr, EP2C5-DB-F.SilkS.gbr, EP2C5-DB.drl]
2016-12-26 FTDI BREAKOUT CARD
    [FTDIBkout-B.Cu.gbr, FTDIBkout-B.Mask.gbr, FTDIBkout-B.SilkS.gbr, FTDIBkout-Edge.Cuts.gbr, FTDIBkout-F.Cu.gbr, FTDIBkout-F.Mask.gbr, FTDIBkout-F.SilkS.gbr, FTDIBkout.drl]
2017-01-01 Created folders and moved stuff to make navigation easier
    [$savepcb.brd, .kicad_pcb.kicad_pcb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]
2017-01-02 new odas card
    [Carrier95to49-B.Cu.gbr, Carrier95to49-B.Mask.gbr, Carrier95to49-B.SilkS.gbr, Carrier95to49-Edge.Cuts.gbr, Carrier95to49-F.Cu.gbr, Carrier95to49-F.Mask.gbr, Carrier95to49-F.SilkS.gbr, Carrier95to49.drl]
2017-01-03 ODAS-PSOC05-95mm card - ODAS with DC-62 IO Connector
    [OPSOC5-95MM-01.kicad_pcb, OPSOC5-95MM-01.sch]
2017-01-04 95mm card hw
    [OPSOC5-95MM-01.kicad_pcb, OPSOC5-95MM-01.sch, TestProject.kicad_pcb]
2017-01-04 pin 23 of p1
    [OPSOC5-95MM-01.sch]
2017-01-04 Moved around a few pieces of stuff
    [sag.kicad_pcb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]
2017-01-04 Updates to match part internal pin uses
    [OPSOC5-95MM-01-B_Cu.gbr, OPSOC5-95MM-01-B_Mask.gbr, OPSOC5-95MM-01-B_SilkS.gbr, OPSOC5-95MM-01-Edge_Cuts.gbr, OPSOC5-95MM-01-F_Cu.gbr, OPSOC5-95MM-01-F_Mask.gbr, OPSOC5-95MM-01-F_SilkS.gbr, OPSOC5-95MM-01.drl]
2017-01-06 Diff Probe as ordered OSHPark
    [DiffProbe-B.Cu.gbr, DiffProbe-B.Mask.gbr, DiffProbe-B.SilkS.gbr, DiffProbe-B_Cu.gbr, DiffProbe-Edge.Cuts.gbr, DiffProbe-F.Cu.gbr, DiffProbe-F.Mask.gbr, DiffProbe-F.SilkS.gbr]
2017-01-08 nothing much
    [ODAS-Cards-PID.csv]
2017-01-14 Moved around stuff - new cards
    [Proto16-I2C_PL.csv]
2017-01-16 8 Channel I2C Repeater
    [I2C-RPT-01_PL.csv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]
2017-01-16 Changed to address jumpers
    [I2C-RPT-08.kicad_pcb]
2017-01-16 Power FET Notes
2017-01-17 I2C Repeater Card
    [EP2C5-DB-B.Cu.gbr, EP2C5-DB-B.Mask.gbr, EP2C5-DB-B.SilkS.gbr, EP2C5-DB-Edge.Cuts.gbr, EP2C5-DB-F.Cu.gbr, EP2C5-DB-F.Mask.gbr, EP2C5-DB-F.SilkS.gbr, EP2C5-DB.drl]
2017-01-17 Footprint files move stuff to X2 folder
2017-01-19 Footprint generator
    [Defaults.csv]
2017-01-20 create footprints tool
2017-01-20 Made rev 3 retro computer PCB
    [EP2C5-DB-B.Cu.gbr, EP2C5-DB-B.Mask.gbr, EP2C5-DB-B.SilkS.gbr, EP2C5-DB-B_Cu.gbr, EP2C5-DB-B_Mask.gbr, EP2C5-DB-B_SilkS.gbr, EP2C5-DB-Edge_Cuts.gbr, EP2C5-DB-F.Cu.gbr]
2017-01-30 Worked wiki docs for EP2C5-DB card
    [TTL-Serial.csv]
2017-01-31 OptoFast measurements
    [DiffProbe_PL.csv, OPTOFAST-SpeedTable.csv]
2017-01-31 Arduino UNO Shield with DB-25
    [Carrier95to49-B.Cu.gbr, Carrier95to49-B_Cu.gbr, Carrier95to49-B_Mask.gbr, Carrier95to49-B_SilkS.gbr, Carrier95to49-Edge_Cuts.gbr, Carrier95to49-F.Cu.gbr, Carrier95to49-F_Cu.gbr, Carrier95to49-F_Mask.gbr]
2017-02-01 Arduino UNO ODAS shield - added GVS
    [UNO-DB25-B_Cu.gbr, UNO-DB25-B_Mask.gbr, UNO-DB25-B_SilkS.gbr, UNO-DB25-Edge_Cuts.gbr, UNO-DB25-F_Cu.gbr, UNO-DB25-F_Mask.gbr, UNO-DB25-F_SilkS.gbr, UNO-DB25.drl]
2017-02-04 psoc card
    [OPSOC5-95MM-01.kicad_pcb]
2017-02-05 Making Gerbers for our next order
    [Carrier95to49-B.Cu.gbr, Carrier95to49-B.Mask.gbr, Carrier95to49-B.SilkS.gbr, Carrier95to49-B_Cu.gbr, Carrier95to49-Edge.Cuts.gbr, Carrier95to49-F.Cu.gbr, Carrier95to49-F.Mask.gbr, Carrier95to49-F.SilkS.gbr]
2017-02-06 Scaled NANO-BKOUT board
2017-02-08 8-channel I2C Repeater
    [I2C-RPT-08-B_Cu.gbr, I2C-RPT-08-B_Mask.gbr, I2C-RPT-08-B_SilkS.gbr, I2C-RPT-08-Edge_Cuts.gbr, I2C-RPT-08-F_Cu.gbr, I2C-RPT-08-F_Mask.gbr, I2C-RPT-08-F_SilkS.gbr, I2C-RPT-08.drl]
2017-02-08 Arduino readme
2017-02-09 Move SPI-POTX2 to Analog cards
    [SPI-POTX2-B_Cu.gbl, SPI-POTX2-B_Mask.gbs, SPI-POTX2-B_SilkS.gbo, SPI-POTX2-Edge_Cuts.gbr, SPI-POTX2-F_Cu.gtl, SPI-POTX2-F_Mask.gts, SPI-POTX2-F_SilkS.gto, SPI-POTX2.drl]
2017-02-13 create readme files for Raspberry Pi cards/hats
2017-02-17 FPGA Base card
    [BASE-EP4CE6.kicad_pcb, BASE-EP4CE6.sch]
2017-02-20 Board file updates
    [raspberry_pi_dimensions.skp]
2017-02-26 Fixed UNO-DB25 layer error
    [UNO-DB25-B.Cu.gbr, UNO-DB25-B.Mask.gbr, UNO-DB25-B.SilkS.gbr, UNO-DB25-B_Cu.gbr, UNO-DB25-B_Mask.gbr, UNO-DB25-B_SilkS.gbr, UNO-DB25-Edge.Cuts.gbr, UNO-DB25-Edge_Cuts.gbr]
2017-02-26 Working on Docs
    [DigIO32-I2C.kicad_pcb, DigIO32-I2C.sch, DigIO32-I2C_PL.csv]
2017-02-26 New Kicad install
    [XR2206.sch]
2017-03-06 Move around pics
    [ODAS-PSOC5-B.Cu.gbr, ODAS-PSOC5-B_Cu.gbr, ODAS-PSOC5-B_Mask.gbr, ODAS-PSOC5-B_SilkS.gbr, ODAS-PSOC5-Edge_Cuts.gbr, ODAS-PSOC5-F.Cu.gbr, ODAS-PSOC5-F_Cu.gbr, ODAS-PSOC5-F_Mask.gbr]
2017-03-06 Was missing the last line of each netlist - fixed
    [Defaults.csv]
2017-03-06 X4 version of the card
    [EP2C5-DB-B.Cu.gbr, EP2C5-DB-B.Mask.gbr, EP2C5-DB-B.SilkS.gbr, EP2C5-DB-Edge.Cuts.gbr, EP2C5-DB-F.Cu.gbr, EP2C5-DB-F.Mask.gbr, EP2C5-DB-F.SilkS.gbr, EP2C5-DB.drl]
2017-03-06 Rev X4 version of EP2C5 Daughtercard
    [EP2C5-DB-B_Cu.gbr, EP2C5-DB-B_Mask.gbr, EP2C5-DB-B_SilkS.gbr, EP2C5-DB-Edge_Cuts.gbr, EP2C5-DB-F_Cu.gbr, EP2C5-DB-F_Mask.gbr, EP2C5-DB-F_SilkS.gbr, EP2C5-DB.drl]
2017-03-07 USB Opto
    [BASE-EP4CE6.kicad_pcb, BASE-EP4CE6.sch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]
2017-03-10 Added RPI-I2C-HUB to boards that need to be ordered
2017-03-12 CCLED card
    [CCLED-B.Mask.gbr, CCLED-B.SilkS.gbr, CCLED-Back.gbr, CCLED-Edge.Cuts.gbr, CCLED-F.Mask.gbr, CCLED-F.SilkS.gbr, CCLED-Front.gbr, CCLED.drl]
2017-03-12 LED cards
    [LED1W-B.Mask.gbr, LED1W-B.SilkS.gbr, LED1W-Back.gbr, LED1W-Edge.Cuts.gbr, LED1W-F.Mask.gbr, LED1W-F.SilkS.gbr, LED1W-Front.gbr, LED1W.drl]
2017-03-13 boards orders
    [BASE-EP4CE6-B.Cu.gbr, BASE-EP4CE6-B.Mask.gbr, BASE-EP4CE6-B.SilkS.gbr, BASE-EP4CE6-Edge.Cuts.gbr, BASE-EP4CE6-F.Cu.gbr, BASE-EP4CE6-F.Mask.gbr, BASE-EP4CE6-F.SilkS.gbr, BASE-EP4CE6.drl]
2017-03-20 Simulation of the Constant Current LEDs design
2017-03-31 CC LED Docs
    [CCLED_PL.csv, LED1W4X_PL.csv, LED1W_PL.csv]
2017-04-04 CAD Drawings and PLs for cards
    [BASE-EP4CE6_PL.csv, OPSOC5-95MM-01_PL.csv, OptoUSB_PL.csv, UNO-DB25_PL.csv]
2017-04-14 W1AEW Video 112
    [W2AEW-112.kicad_pcb, W2AEW-112.sch]
2017-04-17 EP2C5-DB card CAD pictures
    [ANTUNER-B_Cu.gbr, ANTUNER-B_Mask.gbr, ANTUNER-B_SilkS.gbr, ANTUNER-Edge_Cuts.gbr, ANTUNER-F_Cu.gbr, ANTUNER-F_Mask.gbr, ANTUNER-F_SilkS.gbr, ANTUNER.drl]
2017-04-18 Added in PcbDraw code. need to check it out later
2017-04-19 AudioAmp updates
    [$savepcb.brd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]
2017-04-20 Card stuff
    [AudioAmp384-B_Cu.gbl, AudioAmp384-B_Mask.gbs, AudioAmp384-B_SilkS.gbo, AudioAmp384-Back.gbl, AudioAmp384-Edge_Cuts.gbr, AudioAmp384-F_Cu.gtl, AudioAmp384-F_Mask.gts, AudioAmp384-F_SilkS.gto]
2017-04-24 Power Monitor
    [PowerMon.kicad_pcb, PowerMon.sch]
2017-04-25 Bike MPH Project
    [BikeMPH.xlsx, PowerMon.sch]
2017-04-25 Power Monitor backups - remove
2017-04-27 clean up folders
    [EP2C5-DB_PL.csv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]
2017-05-02 RetroComputer daughtercard PL
    [EP2C5-DB_PL-X4.csv]
2017-05-02 Carrier card CAD pictures
    [Carrier95to49_PL.csv]
2017-05-03 Created Switch card
    [$SWITCHX8.sch, SWITCHX8.kicad_pcb, SWITCHX8.sch]
2017-05-03 CC-LED Pictures for Wiki
2017-05-03 Simple Switches and LED card with I2C
    [SWITCHX8-B_Cu.gbr, SWITCHX8-B_Mask.gbr, SWITCHX8-B_SilkS.gbr, SWITCHX8-Edge_Cuts.gbr, SWITCHX8-F_Cu.gbr, SWITCHX8-F_Mask.gbr, SWITCHX8-F_SilkS.gbr, SWITCHX8.drl]
2017-05-04 GVSUNI card initial design as ordered from OSHPark
    [GVSUNI-B_Cu.gbr, GVSUNI-B_Mask.gbr, GVSUNI-B_SilkS.gbr, GVSUNI-Edge_Cuts.gbr, GVSUNI-F_Cu.gbr, GVSUNI-F_Mask.gbr, GVSUNI-F_SilkS.gbr, GVSUNI.drl]
2017-05-09 STM32 Board stuff
2017-05-10 STM32 pictures
2017-05-10 STM32 pics
2017-05-12 cards stuff
    [AudioAmp386-B.Mask.gbr, AudioAmp386-B.SilkS.gbr, AudioAmp386-B_Cu.gbr, AudioAmp386-B_Mask.gbr, AudioAmp386-B_SilkS.gbr, AudioAmp386-Back.gbr, AudioAmp386-Edge.Cuts.gbr, AudioAmp386-Edge_Cuts.gbr]
2017-05-15 Change Switches to smaller less expensive part
    [ANTUNER-B_Cu.gbr, ANTUNER-B_Mask.gbr, ANTUNER-B_SilkS.gbr, ANTUNER-Edge_Cuts.gbr, ANTUNER-F_Cu.gbr, ANTUNER-F_Mask.gbr, ANTUNER-F_SilkS.gbr, ANTUNER.drl]
2017-05-20 OptoUSB Rev X2 speedups
    [OptoUSB-B.Mask.gbr, OptoUSB-B.SilkS.gbr, OptoUSB-B_Cu.gbr, OptoUSB-Back.gbr, OptoUSB-Edge.Cuts.gbr, OptoUSB-F.Mask.gbr, OptoUSB-F.SilkS.gbr, OptoUSB-F_Cu.gbr]
2017-05-20 OptoUSB Rev X2 board
2017-05-20 More OPTOUSB cleanup add test point for power
    [OptoUSB-B.Mask.gbr, OptoUSB-B.SilkS.gbr, OptoUSB-Back.gbr, OptoUSB-Edge.Cuts.gbr, OptoUSB-F.Mask.gbr, OptoUSB-F.SilkS.gbr, OptoUSB-Front.gbr, OptoUSB.drl]
2017-05-20 OptoUSB with power test points
2017-05-20 OPTOFAST Speedups - part val changes
    [OptoBlock.sch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]
2017-05-20 OptoSmall minoir edits no PCB changes
    [OptoBlock.sch, OptoISmall.kicad_pcb, OptoISmall.sch]
2017-05-25 32 LED card with DB-37 connector
    [LED-32-B_Cu.gbl, LED-32-B_Mask.gbs, LED-32-B_SilkS.gbo, LED-32-Edge_Cuts.gbr, LED-32-F_Cu.gtl, LED-32-F_Mask.gts, LED-32-F_SilkS.gto, LED-32.drl]
2017-05-25 Card library adds for many Land Boards Design
2017-05-25 I2C Card picture
2017-05-25 Fix schematic title block date, names, etc.
    [LED-32.sch]
2017-05-25 32-Channel Relay Card
    [RELAY-32.kicad_pcb, RELAY-32.sch]
2017-05-30 tweeking files
    [ANTUNER-B.Cu.gbr, ANTUNER-B.Mask.gbr, ANTUNER-B.SilkS.gbr, ANTUNER-B_Cu.gbr, ANTUNER-B_Mask.gbr, ANTUNER-B_SilkS.gbr, ANTUNER-Edge.Cuts.gbr, ANTUNER-Edge_Cuts.gbr]
2017-05-31 Standoff hardware table
    [Standoffs.csv]
2017-06-05 Bought boards
    [BBB-GVS-3.kicad_pcb, FM-NOTCH.kicad_pcb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]
2017-06-05 Card changes
    [Mouser_All-LandBoards-Parts_Jun01_0833AM.xls, Standoffs.csv]
2017-06-08 BBB Comm card
    [Analog-Inputs.sch, BBB-COMMS-1.kicad_pcb, BBB-COMMS-1.sch, BBB-Conn.sch]
2017-06-08 BBB Card
    [Analog-Inputs.sch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]
2017-06-08 Carrier card
    [Carrier95to49-B.Cu.gbr, Carrier95to49-B.Mask.gbr, Carrier95to49-B.SilkS.gbr, Carrier95to49-B_Cu.gbr, Carrier95to49-B_Mask.gbr, Carrier95to49-B_SilkS.gbr, Carrier95to49-Edge.Cuts.gbr, Carrier95to49-Edge_Cuts.gbr]
2017-06-08 cleanup cards
    [LED-32-B.Mask.gbr, LED-32-B.SilkS.gbr, LED-32-Back.gbr, LED-32-Edge.Cuts.gbr, LED-32-F.Mask.gbr, LED-32-F.SilkS.gbr, LED-32-Front.gbr, LED-32.drl]
2017-06-09 comm card for bbb
    [Analog-Inputs.sch, BBB-COMMS-1.kicad_pcb, BBB-COMMS-1.sch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]
2017-06-09 Relay card improvements for bits lineup
    [ODAS-RELAY-16-B_Cu.gbr, ODAS-RELAY-16-B_Mask.gbr, ODAS-RELAY-16-B_SilkS.gbr, ODAS-RELAY-16-Edge_Cuts.gbr, ODAS-RELAY-16-F_Cu.gbr, ODAS-RELAY-16-F_Mask.gbr, ODAS-RELAY-16-F_SilkS.gbr, ODAS-RELAY-16.drl]
2017-06-09 Tweeking cards for perfection ;)
    [Carrier95to49-B.Cu.gbr, Carrier95to49-B.Mask.gbr, Carrier95to49-B.SilkS.gbr, Carrier95to49-B_Cu.gbr, Carrier95to49-B_Mask.gbr, Carrier95to49-B_SilkS.gbr, Carrier95to49-Edge.Cuts.gbr, Carrier95to49-Edge_Cuts.gbr]
2017-06-09 Fixed mounting hole sizes s/b 6-32
    [DB25RIBBONADAPTER-B_Cu.gbr, DB25RIBBONADAPTER-B_Mask.gbr, DB25RIBBONADAPTER-B_SilkS.gbr, DB25RIBBONADAPTER-Edge_Cuts.gbr, DB25RIBBONADAPTER-F_Cu.gbr, DB25RIBBONADAPTER-F_Mask.gbr, DB25RIBBONADAPTER-F_SilkS.gbr, DB25RIBBONADAPTER.drl]
2017-06-09 BBB Comm card final touches
    [BBB-COMMS-2-B_Cu.gbr, BBB-COMMS-2-B_Mask.gbr, BBB-COMMS-2-B_SilkS.gbr, BBB-COMMS-2-Back.gbr, BBB-COMMS-2-Edge_Cuts.gbr, BBB-COMMS-2-F_Cu.gbr, BBB-COMMS-2-F_Mask.gbr, BBB-COMMS-2-F_SilkS.gbr]
2017-06-09 added keying headers
    [BBB-COMMS-2-B.Mask.gbr, BBB-COMMS-2-B.SilkS.gbr, BBB-COMMS-2-B_Cu.gbr, BBB-COMMS-2-Back.gbr, BBB-COMMS-2-Edge.Cuts.gbr, BBB-COMMS-2-F.Mask.gbr, BBB-COMMS-2-F.SilkS.gbr, BBB-COMMS-2-F_Cu.gbr]
2017-06-10 Some updates and snapshots of boards from OSHPark
    [OptoFast-2-B.Mask.gbr, OptoFast-2-B.SilkS.gbr, OptoFast-2-B_Cu.gbr, OptoFast-2-B_Mask.gbr, OptoFast-2-B_SilkS.gbr, OptoFast-2-Back.gbr, OptoFast-2-Edge.Cuts.gbr, OptoFast-2-Edge_Cuts.gbr]
2017-06-11 doc updated
    [AudioAmp384_PL.csv, AudioAmp386_PL.csv, AudioAmp386_PL.ods, BBB-COMMS-2_PL.csv, BBB-GVS-3_PL.csv, I2C-RPT-01_PL.csv, I2C-RPT-08_PL.csv, LED-32_PL.csv]
2017-06-19 Updating libraries
    [BBB-COMMS-2.csv, DigIO32-I2C-drl_map.dxf, LED-32_Connector.csv, ODAS-RELAY-16 DC-37 Connector Pinout.csv, ODAS-RELAY-16.sch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]
2017-06-20 Pics of LED-32 card layout
    [LED-32.kicad_pcb]
2017-06-23 Map files
    [ODAS-PSOC5-NPTH-drl_map.dxf, ODAS-PSOC5-drl_map.dxf, OptoFast-2-drl_map.dxf, OptoUSB-drl_map.dxf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]
2017-06-23 Create a generic file comparison utility
    [Defaults.csv, LTP-01_PL.csv, LTP-01_REF_PL.csv, OneWireLogger_REF_PL.csv]
2017-06-26 CREATED LED-32 CARD SYMBOLS
2017-06-26 Update Kicad utilities
    [BBB-GVS-V2.brd, BBB-GVS-V2.sch, BBB-GVS-V2_new.sch, BBB-GVS-V2_newboard.brd, Carrier95to49-NPTH-drl_map.dxf, Carrier95to49-drl_map.dxf, Defaults.csv, P8.sch]
2017-06-26 Land Boards
2017-06-26 Doc files for kicad utilities
2017-06-26 Card pics and updates to ODAS-PSOC5
    [ODAS-PSOC5-NPTH-drl_map.dxf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]
2017-06-30 Sstuff moved around
    [ODAS-RELAY-16-B.Cu.gbr, ODAS-RELAY-16-B.Mask.gbr, ODAS-RELAY-16-B.SilkS.gbr, ODAS-RELAY-16-B_Cu.gbr, ODAS-RELAY-16-B_Mask.gbr, ODAS-RELAY-16-B_SilkS.gbr, ODAS-RELAY-16-Edge.Cuts.gbr, ODAS-RELAY-16-Edge_Cuts.gbr]
2017-07-01 pics and bbb-gvs
    [Analog-Inputs.sch, BBB-Conn.sch, BBB-GVS-3.sch, BBB-GVS-3_P8_P9.csv, BBB-P8-Conn.sch, BBB-P9-Conn.sch, DIGIO32-LED.csv, trans16.sch]
2017-07-02 Note filter - made part for SMA Edge Launch
    [FM-NOTCH-B.Mask.gbs, FM-NOTCH-B.SilkS.gbo, FM-NOTCH-B_Cu.gbl, FM-NOTCH-B_Mask.gbs, FM-NOTCH-B_SilkS.gbo, FM-NOTCH-Back.gbl, FM-NOTCH-Edge.Cuts.gm1, FM-NOTCH-Edge_Cuts.gbr]
2017-07-06 Check a Netlist
    [Defaults.csv, LTP-01_PL.csv, LTP-01_REF_PL.csv, NonSinglePointNets.csv, ODAS-PSOC5-P1-Pinout.csv, OneWireLogger_REF_PL.csv, SinglePointNets.csv]
2017-07-06 Land Board Cards updates
2017-07-07 Opto Fast Both Directions Card
    [OptoBlock.sch, OptoFastBi.kicad_pcb, OptoFastBi.sch]
2017-07-07 odas pics
    [optoout8-Pinout-3.csv]
2017-07-21 Bunch of card stuff
    [AudioAmp386-B.Mask.gbr, AudioAmp386-B.SilkS.gbr, AudioAmp386-Back.gbr, AudioAmp386-Edge.Cuts.gbr, AudioAmp386-F.Mask.gbr, AudioAmp386-F.SilkS.gbr, AudioAmp386-Front.gbr, AudioAmp386.drl]
2017-07-21 Relay Card Pics
2017-07-22 RCA Connector data sheet
2017-07-23 card docs
    [AudioAmp386.kicad_pcb, OPTOFAST-SpeedTable.csv]
2017-07-26 Shuffling around files
    [GVS-32U4-X2.brd, GVS-32U4-X2.csv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]
2017-07-26 Cleaned up libraries
    Deleted extra libraries
    Delete extra parts from libraries
    [Carrier95to49-NPTH-drl_map.dxf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]
2017-07-26 Remove bad LED pinout from libraries
    [Carrier95to49.sch]
2017-07-27 kiPL exe and updates
    [DIGIO-128_PL.csv, LTP-01_PL.csv, LTP-01_REF_PL.csv, OneWireLogger_REF_PL.csv]
2017-07-29 DB-15 Test connector
2017-08-02 Drill map files for the Land Boards cards
    [Carrier95to49-drl_map.dxf, DigIO32-I2C-drl_map.dxf, I2C-RPT-01-drl_map.dxf, LED-32-drl_map.dxf, OptoUSB-drl_map.dxf, Proto16-I2C-drl_map.dxf]
2017-08-08 Got library from Kicad repo
2017-09-05 Fast Pulse Gen tweeks
    [PULSE-GEN-B.Cu.gbr, PULSE-GEN-B.Mask.gbr, PULSE-GEN-B.SilkS.gbr, PULSE-GEN-B_Cu.gbr, PULSE-GEN-B_Mask.gbr, PULSE-GEN-B_SilkS.gbr, PULSE-GEN-Edge.Cuts.gbr, PULSE-GEN-Edge_Cuts.gbr]
2017-10-05 Fixed ref des - created PLs
    [ANTUNER_PL.csv]
2018-07-28 schematic and picture
2018-08-07 Slotted micro-usb connector
    [RP-Console-u-B.Cu.gbr, RP-Console-u-B.Mask.gbr, RP-Console-u-B.SilkS.gbr, RP-Console-u-B_Cu.gbr, RP-Console-u-B_Mask.gbr, RP-Console-u-B_SilkS.gbr, RP-Console-u-Edge.Cuts.gbr, RP-Console-u-Edge_Cuts.gbr]
2018-08-07 New plot files
    [RP-Console-u-B_Cu.gbl, RP-Console-u-B_Mask.gbs, RP-Console-u-B_SilkS.gbo, RP-Console-u-Edge_Cuts.gbr, RP-Console-u-F_Cu.gtl, RP-Console-u-F_Mask.gts, RP-Console-u-F_SilkS.gto, RP-Console-u.drl]
2018-08-07 Hopefully have slots correctly drawn
    [RP-Console-u-B_Cu.gbl, RP-Console-u-B_Mask.gbs, RP-Console-u-B_SilkS.gbo, RP-Console-u-Edge_Cuts.gbr, RP-Console-u-F_Cu.gtl, RP-Console-u-F_Mask.gts, RP-Console-u-F_SilkS.gto, RP-Console-u.drl]
2018-12-10 shorted to ground
    [LED-32-drl_map.dxf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]
2018-12-19 OP AMP CARD UPDATES
    [UNI-OPAMP-08-B_Cu.gbl, UNI-OPAMP-08-B_Mask.gbs, UNI-OPAMP-08-B_SilkS.gbo, UNI-OPAMP-08-Edge_Cuts.gbr, UNI-OPAMP-08-F_Cu.gtl, UNI-OPAMP-08-F_Mask.gts, UNI-OPAMP-08-F_SilkS.gto, UNI-OPAMP-08.drl]
2018-12-20 Added sixth resistor splitting pwr/gnd to A+ input
    [UNI-OPAMP-08-B_Cu.gbl, UNI-OPAMP-08-B_Mask.gbs, UNI-OPAMP-08-B_SilkS.gbo, UNI-OPAMP-08-Edge_Cuts.gbr, UNI-OPAMP-08-F_Cu.gtl, UNI-OPAMP-08-F_Mask.gts, UNI-OPAMP-08-F_SilkS.gto, UNI-OPAMP-08.drl]
2019-01-14 Creating RF Amplifier card
    [RF-AMP-1.kicad_pcb, RF-AMP-1.sch]
2019-01-14 RF Buffer Amplifier
    [RF-AMP-1-B_Cu.gbl, RF-AMP-1-B_Mask.gbs, RF-AMP-1-B_SilkS.gbo, RF-AMP-1-Edge_Cuts.gbr, RF-AMP-1-F_Cu.gtl, RF-AMP-1-F_Mask.gts, RF-AMP-1-F_SilkS.gto, RF-AMP-1.drl]
2019-02-25 fpga stuff
    [RPI-I2C-HUB-2019-02-02-23-23-30.sch]
2019-02-26 blue pill board
2019-02-26 BLUE PILL
    [Blue-Pill-Board.kicad_pcb, Blue-Pill-Board.sch]
2019-03-04 blue pill hub
    [Blue-Pill-Board-B.Cu.gbr, Blue-Pill-Board-B.Mask.gbr, Blue-Pill-Board-B.SilkS.gbr, Blue-Pill-Board-Edge.Cuts.gbr, Blue-Pill-Board-F.Cu.gbr, Blue-Pill-Board-F.Mask.gbr, Blue-Pill-Board-F.SilkS.gbr, Blue-Pill-Board-NPTH.drl]
2019-03-06 Update Blue Pill
    [Blue-Pill-Board-2019-02-27-18-36-19.sch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]
2019-03-07 Digital Pot schematic - no changes
2019-03-09 ESP32 files
    [Blue-Pill-Board-2019-02-27-18-36-19.sch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]
2019-03-09 esp32 parts
2019-03-12 digio new kicad
    [DigIO32-I2C-2019-03-10-20-10-55.sch]
2019-03-12 blue pill pl
    [Blue-Pill-Board_PL.csv]
2019-03-12 Parts List for Blue Pill Board
    [Blue-Pill-Board_PL.csv]
2019-03-12 FPGA card designs
    [EP4_EP2_mapping.csv, P3.csv, P3_P4.csv, P4.csv]
2019-03-12 FPGA card stuff
    [EP4_EP2_mapping.csv, P3.csv]
2019-03-17 tweeked cards
    [Blue-Pill-Board.kicad_pcb, Blue-Pill-Board.sch, Blue-Pill-Board_PL.csv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]
2019-03-20 Moved power select jumpers around
    [ESP32-Hub-B.Cu.gbr, ESP32-Hub-B.Mask.gbr, ESP32-Hub-B.SilkS.gbr, ESP32-Hub-Edge.Cuts.gbr, ESP32-Hub-F.Cu.gbr, ESP32-Hub-F.Mask.gbr, ESP32-Hub-F.SilkS.gbr, ESP32-Hub-NPTH.drl]
2019-03-26 Import to current KiCad version
    [BASE-EP4CE6-2019-03-26-08-19-06.sch]
2019-03-26 PDF of schematic
2019-03-26 CAD and part selector
2019-03-27 Blue pill board documents
2019-03-28 STM32 programming
2019-04-01 ep4 board updates
    [BASE-EP4CE6-B.Cu.gbr, BASE-EP4CE6-B.Mask.gbr, BASE-EP4CE6-B.SilkS.gbr, BASE-EP4CE6-Edge.Cuts.gbr, BASE-EP4CE6-F.Cu.gbr, BASE-EP4CE6-F.Mask.gbr, BASE-EP4CE6-F.SilkS.gbr, BASE-EP4CE6-NPTH.drl]
2019-04-01 Moved to ODAS folder
    [EP2C5-DB-2019-03-30-09-13-11.sch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]
2019-04-01 FPGA Card schematic
2019-04-02 Fixed EP4 silkscreen again
    [BASE-EP4CE6-B.Cu.gbr, BASE-EP4CE6-B.Mask.gbr, BASE-EP4CE6-B.SilkS.gbr, BASE-EP4CE6-Edge.Cuts.gbr, BASE-EP4CE6-F.Cu.gbr, BASE-EP4CE6-F.Mask.gbr, BASE-EP4CE6-F.SilkS.gbr, BASE-EP4CE6-NPTH.drl]
2019-04-02 Move around retro computing folders
    [EP4_EP2_mapping.csv, EP4_EP2_mapping_P3-Rev-X2.csv, EP4_EP2_mapping_P4-Rev-X2.csv, EP4_EP2_mapping_P4-Rev-X3.csv, EP4_EP2_mapping_P4-Rev-X4.csv, EP4_EP2_mapping_P4-RevX1.csv, EP4_EP2_mappingv2.csv, EP4_EP2_mappingv3.csv]
2019-04-02 Move FPGA Cards to new folder
    [BASE-EP4CE6-2019-03-26-08-19-06.sch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]
2019-04-02 Retro-FPGA card
    [BASE-EP4CE6-2019-03-26-08-19-06.sch, BASE-EP4CE6_PL.csv, P3.csv, P3_P4.csv, P4.csv, RETRO-EP4CE6.kicad_pcb, RETRO-EP4CE6.sch]
2019-04-03 Retro board moved text to another layer
    [RETRO-EP4CE6.kicad_pcb]
2019-04-04 Small wiring changes
    [RETRO-EP4CE6.sch]
2019-04-05 RETRO-EP4 board
    [RETRO-EP4CE6-B.Cu.gbr, RETRO-EP4CE6-B.Mask.gbr, RETRO-EP4CE6-B.SilkS.gbr, RETRO-EP4CE6-Edge.Cuts.gbr, RETRO-EP4CE6-F.Cu.gbr, RETRO-EP4CE6-F.Mask.gbr, RETRO-EP4CE6-F.SilkS.gbr, RETRO-EP4CE6-NPTH.drl]
2019-04-06 test eqt
    test eqt
    [ESP32-Hub-B.Cu.gbr, ESP32-Hub-B.Mask.gbr, ESP32-Hub-B.SilkS.gbr, ESP32-Hub-Edge.Cuts.gbr, ESP32-Hub-F.Cu.gbr, ESP32-Hub-F.Mask.gbr, ESP32-Hub-F.SilkS.gbr, ESP32-Hub-NPTH.drl]
2019-04-07 c4 dev card
    [Blue-Pill-Board-B.Cu.gbr, Blue-Pill-Board-B.Mask.gbr, Blue-Pill-Board-B.SilkS.gbr, Blue-Pill-Board-Edge.Cuts.gbr, Blue-Pill-Board-F.Cu.gbr, Blue-Pill-Board-F.Mask.gbr, Blue-Pill-Board-F.SilkS.gbr, Blue-Pill-Board-NPTH.drl]
2019-04-13 RETRO Parts List
    [RETRO-EP4CE6_PL.csv]
2019-04-13 pics of cards
    [RETRO-EP4CE6.sch]
2019-04-18 fpga boards
2019-04-20 board schematics
2019-04-20 esp32 parts list
    [ESP32-Hub.sch, ESP32-Hub_PL.csv]
2019-04-24 Create OpenSTM32 Community Site _ Downloading the System Workbench for STM32 installer.url
2019-04-25 fixed ps/2 footprint
    [RETRO-EP4CE6.kicad_pcb, RETRO-EP4CE6.sch]
2019-04-26 resistors are not right for some reason
    [ESP32-Hub.sch, ESP32-Hub_PL.csv]
2019-04-27 fixed pinouts of i2c
    [ESP32-Hub-B.Cu.gbr, ESP32-Hub-B.Mask.gbr, ESP32-Hub-B.SilkS.gbr, ESP32-Hub-Edge.Cuts.gbr, ESP32-Hub-F.Cu.gbr, ESP32-Hub-F.Mask.gbr, ESP32-Hub-F.SilkS.gbr, ESP32-Hub-NPTH.drl]
2019-05-03 OptoUSB Updates
    [OptoUSB-2019-04-30-13-26-04.sch]
2019-05-03 New FPGA board
    [ADC_TLC549.smp_dump.txt, IR.smp_dump.txt, LCD12864.smp_dump.txt, PIN_IO.xls, buzzer.smp_dump.txt, ds18b20.smp_dump.txt, key_3x3.smp_dump.txt, lcd.smp_dump.txt]
2019-05-08 Added 3 pin JST connector
2019-05-16 MapleMini docs
    [maplemini.brd, maplemini.sch]
2019-05-17 Updates to latest KiCad
    [RF-Amp-2019-05-17-09-07-11.sch]
2019-05-17 Created wiki docs
    [RF-AMP-1-2019-05-17-11-31-54.sch, RF-AMP-1.sch]
2019-06-15 OPTO-FAST pics
    [OptoFast-2.kicad_pcb]
2019-06-19 got python working
    [OptoBlock-2019-06-18-17-42-15.sch, OptoFastBi-2019-06-18-17-42-15.sch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]
2019-07-25 Annotated SD Card connections
    [EP2C5-DB.sch, RETRO-EP4CE6.sch]
2019-08-03 Moved I2C cards from ODAS to I2C folder
    [DIGIO-128-1.sch, DIGIO-128-2.sch, DIGIO-128-3.sch, DIGIO-128-4.sch, DIGIO-128-5.sch, DIGIO-128-6.sch, DIGIO-128-7.sch, DIGIO-128-8.sch]
2019-08-14 grid49 pcb pics
    [GRID49-2019-08-11-16-43-44.sch]
2019-08-16 EP4-CExx breakout board
    [EPXX-GVS-B.Cu.gbr, EPXX-GVS-B.Mask.gbr, EPXX-GVS-B.SilkS.gbr, EPXX-GVS-Edge.Cuts.gbr, EPXX-GVS-F.Cu.gbr, EPXX-GVS-F.Mask.gbr, EPXX-GVS-F.SilkS.gbr, EPXX-GVS-NPTH.drl]
2019-08-16 bugs in esp32-hub
    [ESP32-Hub.sch]
2019-08-18 tweek layout
    [ESP32-Hub-B.Cu.gbr, ESP32-Hub-B.Mask.gbr, ESP32-Hub-B.SilkS.gbr, ESP32-Hub-Edge.Cuts.gbr, ESP32-Hub-F.Cu.gbr, ESP32-Hub-F.Mask.gbr, ESP32-Hub-F.SilkS.gbr, ESP32-Hub-NPTH.drl]
2019-08-19 ESP32-I2C-HUB renamed on silkscreen
    [ESP32-Hub-2019-02-27-18-36-19.sch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]
2019-08-20 Moved stuff around
    [A-ESTF core Board PIN IO_PIN_IO.xls, PIN_IO.xls]
2019-08-25 EPXX-GVS card
    [EPXX-GVS.sch]
2019-08-26 Typo on the EPXX-GVS card silkscreen
    [EPXX-GVS-B.Cu.gbr, EPXX-GVS-B.Mask.gbr, EPXX-GVS-B.SilkS.gbr, EPXX-GVS-Edge.Cuts.gbr, EPXX-GVS-F.Cu.gbr, EPXX-GVS-F.Mask.gbr, EPXX-GVS-F.SilkS.gbr, EPXX-GVS-NPTH.drl]
2019-08-26 Re-oriented the connectors and placed next to each other
    [EPXX-GVS-B.Cu.gbr, EPXX-GVS-B.Mask.gbr, EPXX-GVS-B.SilkS.gbr, EPXX-GVS-Edge.Cuts.gbr, EPXX-GVS-F.Cu.gbr, EPXX-GVS-F.Mask.gbr, EPXX-GVS-F.SilkS.gbr, EPXX-GVS-NPTH.drl]
2019-08-30 more work
    [EPXX-GVS.kicad_pcb]
2019-09-06 new stuff
    [RS232_TTL_Female-B.Cu.gbr, RS232_TTL_Female-B.Mask.gbr, RS232_TTL_Female-B.Paste.gbr, RS232_TTL_Female-B.SilkS.gbr, RS232_TTL_Female-Edge.Cuts.gbr, RS232_TTL_Female-F.Cu.gbr, RS232_TTL_Female-F.Mask.gbr, RS232_TTL_Female-F.Paste.gbr]
2019-09-08 PSOC5 card
    [ODAS-PSOC5-2019-09-07-13-32-49.sch]
2019-09-09 RS-232 to TTL with handshake because they cost $10 on-line
    [RS232_TTL_Female-B.Cu.gbr, RS232_TTL_Female-B.Mask.gbr, RS232_TTL_Female-B.Paste.gbr, RS232_TTL_Female-B.SilkS.gbr, RS232_TTL_Female-Edge.Cuts.gbr, RS232_TTL_Female-F.Cu.gbr, RS232_TTL_Female-F.Mask.gbr, RS232_TTL_Female-F.Paste.gbr]
2019-09-16 added ftdi
    [EPXX-GVS-B.Cu.gbr, EPXX-GVS-B.Mask.gbr, EPXX-GVS-B.SilkS.gbr, EPXX-GVS-Edge.Cuts.gbr, EPXX-GVS-F.Cu.gbr, EPXX-GVS-F.Mask.gbr, EPXX-GVS-F.SilkS.gbr, EPXX-GVS-PTH.drl]
2019-10-02 RPI_PSoC card design
    [RPI_PSOC5-2019-10-02-14-13-06.sch, RPI_PSOC5.kicad_pcb, RPI_PSOC5.sch, RPPSOC_PL.csv]
2019-10-04 rpi psoc
    [RPI_PSOC5-B.Cu.gbr, RPI_PSOC5-B.Mask.gbr, RPI_PSOC5-B.SilkS.gbr, RPI_PSOC5-Edge.Cuts.gbr, RPI_PSOC5-F.Cu.gbr, RPI_PSOC5-F.Mask.gbr, RPI_PSOC5-F.SilkS.gbr, RPI_PSOC5-NPTH.drl]
2019-10-06 RPI_PSOC5 design tweeks
    [RPI_PSOC5-B.Cu.gbr, RPI_PSOC5-B.Mask.gbr, RPI_PSOC5-B.SilkS.gbr, RPI_PSOC5-Edge.Cuts.gbr, RPI_PSOC5-F.Cu.gbr, RPI_PSOC5-F.Mask.gbr, RPI_PSOC5-F.SilkS.gbr, RPI_PSOC5-NPTH.drl]
2019-10-07 new boards
    [RPI_PSOC5-B.Cu.gbr, RPI_PSOC5-B.Mask.gbr, RPI_PSOC5-B.SilkS.gbr, RPI_PSOC5-Edge.Cuts.gbr, RPI_PSOC5-F.Cu.gbr, RPI_PSOC5-F.Mask.gbr, RPI_PSOC5-F.SilkS.gbr, RPI_PSOC5-NPTH.drl]
2019-10-08 Card missing an etch - noted on schematic
    [RPI_PSOC5.sch]
2019-10-09 added rpi pin alternatives
    [RPI_PSOC5.sch]
2019-10-09 made rev 2
    [RPI_PSOC5-B.Cu.gbr, RPI_PSOC5-B.Mask.gbr, RPI_PSOC5-B.SilkS.gbr, RPI_PSOC5-Edge.Cuts.gbr, RPI_PSOC5-F.Cu.gbr, RPI_PSOC5-F.Mask.gbr, RPI_PSOC5-F.SilkS.gbr, RPI_PSOC5-NPTH.drl]
2019-10-10 pics to illustrate using psoc gpio for rpi
    [RPI_PSOC5-B.Cu.gbr, RPI_PSOC5-B.Mask.gbr, RPI_PSOC5-B.SilkS.gbr, RPI_PSOC5-Edge.Cuts.gbr, RPI_PSOC5-F.Cu.gbr, RPI_PSOC5-F.Mask.gbr, RPI_PSOC5-F.SilkS.gbr, RPI_PSOC5-NPTH.drl]
2019-10-15 Fixed USB-Micro pinout - pin 5 = VUSB
    [RPI_PSOC5.sch]
2019-10-15 Parts List for the RPI_PSOC5
    [RPI_PSOC5_PL.csv]
2019-10-17 RPI-PSOC5 Updates per rework on Rev 1 card
    [RPI_PSOC5-B.Cu.gbr, RPI_PSOC5-B.Mask.gbr, RPI_PSOC5-B.SilkS.gbr, RPI_PSOC5-Edge.Cuts.gbr, RPI_PSOC5-F.Cu.gbr, RPI_PSOC5-F.Mask.gbr, RPI_PSOC5-F.SilkS.gbr, RPI_PSOC5-NPTH.drl]
2019-10-22 No trace changes
    [RPI_PSOC5.kicad_pcb]
2019-11-02 Board orders
2019-11-09 new fpga card
    [BASE-EP4CE6-2019-03-26-08-19-06.sch, DisplayProc-01-2019-11-08-17-44-55.sch, DisplayProc-01.sch, P3.csv, P3_P4.csv, P4.csv, RETRO-EP4CE15.kicad_pcb, RETRO-EP4CE15.sch]
2019-11-16 Added PS/2 connector to EP2C5-DB
    [EP2C5-DB-B.Cu.gbr, EP2C5-DB-B.Mask.gbr, EP2C5-DB-B.SilkS.gbr, EP2C5-DB-Edge.Cuts.gbr, EP2C5-DB-F.Cu.gbr, EP2C5-DB-F.Mask.gbr, EP2C5-DB-F.SilkS.gbr, EP2C5-DB-NPTH.drl]
2019-11-17 USB - Serial interface
    [USBFS_UART01.sdf]
2019-11-18 Dual PS/2 connectors card
    [GRID49-2019-08-11-16-43-44.sch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]
2019-11-19 RETRO card
    [RETRO-EP4CE15-B.Cu.gbr, RETRO-EP4CE15-B.Mask.gbr, RETRO-EP4CE15-B.SilkS.gbr, RETRO-EP4CE15-Edge.Cuts.gbr, RETRO-EP4CE15-F.Cu.gbr, RETRO-EP4CE15-F.Mask.gbr, RETRO-EP4CE15-F.SilkS.gbr, RETRO-EP4CE15-NPTH.drl]
2019-11-19 odas 49mm cards
    [GRID49-2019-08-11-16-43-44.sch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]
2019-11-19 Create Termination Resistors Required for the USB Type... _ Cypress Developer Community.url
2019-11-19 A couple of ODAS cards
    [PS2X49-B.Mask.gbs, PS2X49-B.SilkS.gbo, PS2X49-Back.gbl, PS2X49-F.Mask.gts, PS2X49-F.SilkS.gto, PS2X49-Front.gtl, PS2X49-NPTH.drl, PS2X49-PTH.drl]
2019-11-20 vga board
    [VGAX49-B.Mask.gbs, VGAX49-B.SilkS.gbo, VGAX49-Back.gbl, VGAX49-Edge.Cuts.gm1, VGAX49-F.Mask.gts, VGAX49-F.SilkS.gto, VGAX49-Front.gtl, VGAX49-NPTH.drl]
2019-11-21 Updated cards
    [EP2C5-DB-B.Cu.gbr, EP2C5-DB-B.Mask.gbr, EP2C5-DB-B.SilkS.gbr, EP2C5-DB-Edge.Cuts.gbr, EP2C5-DB-F.Cu.gbr, EP2C5-DB-F.Mask.gbr, EP2C5-DB-F.SilkS.gbr, EP2C5-DB-NPTH.drl]
2019-11-22 Make schematic PDF files
    [Blue-Pill-Board.sch]
2019-11-25 Update orders folders
    [TinyPS2-2019-11-21-10-44-00.sch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]
2019-11-28 fpga cards
    [RETRO-EP4CE15-B.Cu.gbr, RETRO-EP4CE15-B.Mask.gbr, RETRO-EP4CE15-B.SilkS.gbr, RETRO-EP4CE15-Edge.Cuts.gbr, RETRO-EP4CE15-F.Cu.gbr, RETRO-EP4CE15-F.Mask.gbr, RETRO-EP4CE15-F.SilkS.gbr, RETRO-EP4CE15-NPTH.drl]
2019-11-28 Changed serial port resistors to 2.2K (more common value)
    [EP2C5-DB.sch]
2019-12-01 EP4CE15 FPGA design
    [RETRO-EP4CE15-B.Cu.gbr, RETRO-EP4CE15-B.Mask.gbr, RETRO-EP4CE15-B.SilkS.gbr, RETRO-EP4CE15-Edge.Cuts.gbr, RETRO-EP4CE15-F.Cu.gbr, RETRO-EP4CE15-F.Mask.gbr, RETRO-EP4CE15-F.SilkS.gbr, RETRO-EP4CE15-NPTH.drl]
2019-12-02 X6 EP2C5-DB
    [RETRO-EP4CE15-B.Cu.gbr, RETRO-EP4CE15-B.Mask.gbr, RETRO-EP4CE15-B.SilkS.gbr, RETRO-EP4CE15-Edge.Cuts.gbr, RETRO-EP4CE15-F.Cu.gbr, RETRO-EP4CE15-F.Mask.gbr, RETRO-EP4CE15-F.SilkS.gbr, RETRO-EP4CE15-NPTH.drl]
2019-12-05 Parts Lists
    [PS2X49_PL.csv, SD_CARD_X49_PL.csv, TinyPS2_PL.csv, VGAX49_PL.csv]
2019-12-08 esp32 vga
    [ESP-32_VGA-B.Cu.gbr, ESP-32_VGA-B.Mask.gbr, ESP-32_VGA-B.SilkS.gbr, ESP-32_VGA-Edge.Cuts.gbr, ESP-32_VGA-F.Cu.gbr, ESP-32_VGA-F.Mask.gbr, ESP-32_VGA-F.SilkS.gbr, ESP-32_VGA-NPTH.drl]
2019-12-08 Silkscreen tweeks
    [ESP-32_VGA-B.Cu.gbr, ESP-32_VGA-B.Mask.gbr, ESP-32_VGA-B.SilkS.gbr, ESP-32_VGA-Edge.Cuts.gbr, ESP-32_VGA-F.Cu.gbr, ESP-32_VGA-F.Mask.gbr, ESP-32_VGA-F.SilkS.gbr, ESP-32_VGA-NPTH.drl]
2019-12-08 Print schematics
    [ESP-32_VGA-B.Cu.gbr, ESP-32_VGA-B.Mask.gbr, ESP-32_VGA-B.SilkS.gbr, ESP-32_VGA-Edge.Cuts.gbr, ESP-32_VGA-F.Cu.gbr, ESP-32_VGA-F.Mask.gbr, ESP-32_VGA-F.SilkS.gbr, ESP-32_VGA-NPTH.drl]
2019-12-23 tweeking boards
    [DIGIO-128-1-2019-12-21-13-09-24.sch, DIGIO-128-2019-12-21-13-09-24.sch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]
2020-01-01 Moving stuff around
    [Blue-Pill-Board-2019-02-27-18-36-19.sch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]
2020-01-02 More board docs
    [PS2X49-B.Mask.gbs, PS2X49-B.SilkS.gbo, PS2X49-Back.gbl, PS2X49-Edge.Cuts.gm1, PS2X49-F.Mask.gts, PS2X49-F.SilkS.gto, PS2X49-Front.gtl, PS2X49-NPTH.drl]
2020-01-04 pics cards
    [HVDigitalPot2F.csv, HVDigitalPotV2.csv, NewPot2_PL.csv, RF-Amp_PL.csv]
2020-01-04 Move esp32 cards
    [ESP-32_VGA-B.Cu.gbr, ESP-32_VGA-B.Mask.gbr, ESP-32_VGA-B.SilkS.gbr, ESP-32_VGA-Edge.Cuts.gbr, ESP-32_VGA-F.Cu.gbr, ESP-32_VGA-F.Mask.gbr, ESP-32_VGA-F.SilkS.gbr, ESP-32_VGA-NPTH.drl]
2020-01-04 move more esp
    [ESP-12E Serial.ods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]
2020-01-05 more docs
    [RasPi-Plus-GVS-2020-01-04-19-22-14.sch]
2020-01-11 recreating wiki
    [CCLOAD-01_PL.csv, Comparison.csv]
2020-01-16 expanded esp32 symbol annotations
    [ESP32-Hub.sch]
2020-01-17 esp32 docs
    [PS2X49-B.Mask.gbs, PS2X49-B.SilkS.gbo, PS2X49-Back.gbl, PS2X49-Edge.Cuts.gm1, PS2X49-F.Mask.gts, PS2X49-F.SilkS.gto, PS2X49-Front.gtl, PS2X49-NPTH.drl]
2020-01-19 led board
    [LED-TEST-2.kicad_pcb, LED-TEST-2.sch, LED-TEST-2_xx.sch, LED-TEST-2before.sch]
2020-01-24 moved folder
    [ESP-32_VGA-B.Cu.gbr, ESP-32_VGA-B.Mask.gbr, ESP-32_VGA-B.SilkS.gbr, ESP-32_VGA-Edge.Cuts.gbr, ESP-32_VGA-F.Cu.gbr, ESP-32_VGA-F.Mask.gbr, ESP-32_VGA-F.SilkS.gbr, ESP-32_VGA-NPTH.drl]
2020-01-25 DAC calues
    [ESP32-VGA.sch, ESP32-VGA_PL.csv]
2020-02-01 new symbols
    [RETRO-EP4CE15.sch]
2020-02-01 fpga changes
    [RETRO-EP4CE15-B.Cu.gbr, RETRO-EP4CE15-B.Mask.gbr, RETRO-EP4CE15-B.SilkS.gbr, RETRO-EP4CE15-Edge.Cuts.gbr, RETRO-EP4CE15-F.Cu.gbr, RETRO-EP4CE15-F.Mask.gbr, RETRO-EP4CE15-F.SilkS.gbr, RETRO-EP4CE15-NPTH.drl]
2020-02-01 pick vga resistors
    [RETRO-EP4CE15.sch, RETRO-EP4CE15_PL.csv]
2020-02-02 ESP-VGA card files
    [ESP-32_VGA-B.Cu.gbr, ESP-32_VGA-B.Mask.gbr, ESP-32_VGA-B.SilkS.gbr, ESP-32_VGA-Edge.Cuts.gbr, ESP-32_VGA-F.Cu.gbr, ESP-32_VGA-F.Mask.gbr, ESP-32_VGA-F.SilkS.gbr, ESP-32_VGA-NPTH.drl]
2020-02-03 more PLs
    [ESP32-Hub.kicad_pcb, ESP32-Hub_PL.csv, ESP32-VGA.kicad_pcb, ESP32-VGA.sch, ESP32-VGA_PL.csv, ESP32-VGA_PL_Rev1.csv, RETRO-EP4CE15_PL.csv]
2020-02-08 Tweeks to boards
    [EP2C5-DB_PL.csv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]
2020-02-18 resistor selection
    [ESP32-VGA.kicad_pcb, ESP32-VGA.sch, ESP32-VGA_PL.csv, RETRO-EP4CE6.sch, Resurr-hotg.csv]
2020-02-18 Improve resistor choices for Video DAC
2020-02-20 Video DAC resistor changes
    [Book1.xlsx, ESP32-VGA.kicad_pcb, ESP32-VGA.sch, ESP32-VGA_PL.csv]
2020-02-24 Update schematic library for Blue Pill Board
    [Blue-Pill-Board-B.Cu.gbr, Blue-Pill-Board-B.Mask.gbr, Blue-Pill-Board-B.SilkS.gbr, Blue-Pill-Board-B_Cu.gbr, Blue-Pill-Board-B_Mask.gbr, Blue-Pill-Board-B_SilkS.gbr, Blue-Pill-Board-Edge.Cuts.gbr, Blue-Pill-Board-F.Cu.gbr]
2020-02-24 Creating T header
    [Blue-Pill-Board.sch]
2020-02-25 Improved the 5V select jumper to only allow one 5V source to be selected
    [Blue-Pill-Board-B.Cu.gbr, Blue-Pill-Board-B.Mask.gbr, Blue-Pill-Board-B.SilkS.gbr, Blue-Pill-Board-Edge.Cuts.gbr, Blue-Pill-Board-F.Cu.gbr, Blue-Pill-Board-F.Mask.gbr, Blue-Pill-Board-F.SilkS.gbr, Blue-Pill-Board-NPTH.drl]
2020-03-05 Thru hole version of FPGA card
    [EP2C5-DB-2019-03-30-09-13-11.sch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]
2020-03-07 Through hole version
    [EP2C5-DB-B.Cu.gbr, EP2C5-DB-B.Mask.gbr, EP2C5-DB-B.SilkS.gbr, EP2C5-DB-F.Cu.gbr, EP2C5-DB-F.Mask.gbr, EP2C5-DB-F.SilkS.gbr, EP2C5-DB-NPTH.drl, EP2C5-DB-PTH.drl]
2020-03-09 new pcb
    [RETRO-EP4CE15_PL.csv]
2020-03-09 FTDI 49mm Card
    [FTDI-USB-TTL-2020-03-09-12-07-46.sch, FTDI-USB-TTL.kicad_pcb, FTDI-USB-TTL.sch]
2020-03-10 Tweeks to card
    [FTDI-USB-TTL.kicad_pcb]
2020-03-10 FTDI Card
    [FTDI-USB-TTL-49MM-B.Mask.gbs, FTDI-USB-TTL-49MM-B.SilkS.gbo, FTDI-USB-TTL-49MM-Back.gbl, FTDI-USB-TTL-49MM-Edge.Cuts.gm1, FTDI-USB-TTL-49MM-F.Mask.gts, FTDI-USB-TTL-49MM-F.SilkS.gto, FTDI-USB-TTL-49MM-Front.gtl, FTDI-USB-TTL-49MM-NPTH.drl]
2020-04-11 Create QMTECH Altera Intel FPGA Core Board Cyc...pdf
2020-04-12 ESP32 FPGA CARD PICS
2020-04-13 Small ESP-32 carrier card
    [EP2C5-DB-B.Cu.gbr, EP2C5-DB-B.Mask.gbr, EP2C5-DB-B.SilkS.gbr, EP2C5-DB-B_Cu.gbr, EP2C5-DB-B_Mask.gbr, EP2C5-DB-B_SilkS.gbr, EP2C5-DB-Edge.Cuts.gbr, EP2C5-DB-Edge_Cuts.gbr]
2020-04-14 ESP32 CARD
    [ESP32-49MM.kicad_pcb, ESP32-49MM.sch]
2020-04-14 power supply repair
2020-04-17 DCE and DTE
    [SIOProc-01-2020-04-17-10-17-31.sch, SIOProc-01.sch]
2020-04-19 DCE/DTE cards
    [RS232_TTL_Female-B.Cu.gbr, RS232_TTL_Female-B.Mask.gbr, RS232_TTL_Female-B.Paste.gbr, RS232_TTL_Female-B.SilkS.gbr, RS232_TTL_Female-B_Cu.gbr, RS232_TTL_Female-B_Mask.gbr, RS232_TTL_Female-B_Paste.gbr, RS232_TTL_Female-B_SilkS.gbr]
2020-06-01 board updates
    [Blue-Pill-Board-B.Cu.gbr, Blue-Pill-Board-B.Mask.gbr, Blue-Pill-Board-B.SilkS.gbr, Blue-Pill-Board-B_Cu.gbr, Blue-Pill-Board-B_Mask.gbr, Blue-Pill-Board-B_SilkS.gbr, Blue-Pill-Board-Edge.Cuts.gbr, Blue-Pill-Board-Edge_Cuts.gbr]
2020-06-14 new PCB pics
    [RETRO-EP4CE15-B_Cu.gbr, RETRO-EP4CE15-B_Mask.gbr, RETRO-EP4CE15-B_SilkS.gbr, RETRO-EP4CE15-Edge_Cuts.gbr, RETRO-EP4CE15-F_Cu.gbr, RETRO-EP4CE15-F_Mask.gbr, RETRO-EP4CE15-F_SilkS.gbr, RETRO-EP4CE15-NPTH.drl]
2020-06-20 blue pill stuff
    [Blue-Pill-Board_PL.csv]
2020-06-20 optousb card update to add test points
    [OptoUSB-B_Mask.gbr, OptoUSB-B_SilkS.gbr, OptoUSB-Back.gbr, OptoUSB-Edge_Cuts.gbr, OptoUSB-F_Mask.gbr, OptoUSB-F_SilkS.gbr, OptoUSB-Front.gbr, OptoUSB-NPTH.drl]
2020-06-21 Blue Pill Hub Board updates
    [Blue-Pill-Board.sch, Blue-Pill-Board_PL.csv]
2020-06-25 EP2C5 pictures
    [RETRO-EP4CE15.kicad_pcb]
2020-06-27 verf design
    [VRef4096-2020-06-27-09-36-22.sch]
2020-06-28 FTDI CARDS
    [FTDI-USB-TTL-2020-03-09-12-07-46.sch, FTDI-USB-TTL-49MM_PL.csv]
2020-06-30 New resistor values
    [EP2C5-DB.sch]
2020-07-07 fixed J1 pin
2020-07-15 Tweeks to FTDI card
    [FTDI-USB-TTL-49MM-B_Mask.gbs, FTDI-USB-TTL-49MM-B_SilkS.gbo, FTDI-USB-TTL-49MM-Back.gbl, FTDI-USB-TTL-49MM-Edge_Cuts.gm1, FTDI-USB-TTL-49MM-F_Mask.gts, FTDI-USB-TTL-49MM-F_SilkS.gto, FTDI-USB-TTL-49MM-Front.gtl, FTDI-USB-TTL-49MM-NPTH.drl]
2020-08-01 Schematic for webpage
2020-08-03 More cards ordering trying PCBWay
    [EP2C5-DB-TH-B_Cu.gbr, EP2C5-DB-TH-B_Mask.gbr, EP2C5-DB-TH-B_SilkS.gbr, EP2C5-DB-TH-Edge_Cuts.gbr, EP2C5-DB-TH-F_Cu.gbr, EP2C5-DB-TH-F_Mask.gbr, EP2C5-DB-TH-F_SilkS.gbr, EP2C5-DB-TH-NPTH.drl]
2020-08-08 update schematic
    [CCLOAD-01-2020-08-07-14-45-54.sch, CCLOAD-01-2020-08-07-15-50-33.sch]
2020-08-13 fpga card docs
    [RETRO-EP4CE15.sch]
2020-08-21 docs for fpga
    [RETRO-EP4CE15.sch]
2020-08-24 pdf schem
    [RETRO-EP4CE15.sch]
2020-08-28 Adding retro computers
    [DIGIO16-DB25_DIGIO32-DB37.csv, DIGIO16-LED.csv, DIGIO16_DB25.csv, DIGIO16_DB25RIBBON.csv, FrontPanel-2019-09-24-09-47-13.sch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]
2020-08-28 Moved 65816 from Retro-Computers archive
    [WC65C816_CPU.kicad_pcb, WC65C816_CPU.sch]
2020-09-03 VFO design
    [I2C-VFO3-2020-09-03-11-31-34.sch]
2020-09-13 Move to HamRadio folder
    [ANTUNER-B.Cu.gbr, ANTUNER-B.Mask.gbr, ANTUNER-B.SilkS.gbr, ANTUNER-Edge.Cuts.gbr, ANTUNER-F.Cu.gbr, ANTUNER-F.Mask.gbr, ANTUNER-F.SilkS.gbr, ANTUNER.drl]
2020-09-15 NEW POT REFERSH AND ROTARY ENC
    [NewPot-2020-09-13-14-29-59.sch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]
2020-09-30 vfo stuff
    [Blue-Pill-Board-2019-02-27-18-36-19.sch, Blue-Pill-Board.kicad_pcb, Blue-Pill-Board.sch, FTDI-USB-TTL-2020-09-20-10-08-56.sch, NewPot-2020-09-13-14-29-59.sch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]
2020-10-04 black pill board
    [Black-Pill-Board-B_Cu.gbr, Black-Pill-Board-B_Mask.gbr, Black-Pill-Board-B_SilkS.gbr, Black-Pill-Board-Edge_Cuts.gbr, Black-Pill-Board-F_Cu.gbr, Black-Pill-Board-F_Mask.gbr, Black-Pill-Board-F_SilkS.gbr, Black-Pill-Board-NPTH.drl]
2020-10-19 vfo designs
    [31-5431-10RFX.stp, Blue-Pill-Board-2019-02-27-18-36-19.sch, DS-201B.step, DS-261B.step, EC11E12-15P30C-SW.stp, OLED_0.91_128x32.stp, PULSE-GEN-2020-10-16-10-23-41.sch, PULSE-GEN.sch]
2020-10-25 VFO files
    [31-5431-10RFX.stp, DS-201B.step, DS-261B.step, EC11E12-15P30C-SW.stp, OLED_0.91_128x32.stp, STEP Rotary Encoder Knob.STEP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]
2020-10-30 LOT OF SHUFFLING
    [VFO-003.kicad_pcb, VFO-003.sch, box.kicad_pcb, box.sch]
2020-10-31 Working VFO designs
    [Blue-Pill-Board-2019-02-27-18-36-19.sch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]
2020-10-31 pics of build
    [VFO-001.sch]
2020-11-03 Yet another VFO
    [AD9833FunctionGenerator-2018-09-10-23-01-08.sch, AD9833FunctionGenerator-2018-09-23-23-28-16.sch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]
2020-11-03 Arduino in a box
    [ArduinoInABox.kicad_pcb, ArduinoInABox.sch]
2020-11-04 Moved power supply folder
    [MHS-5200A_PwrSupply-B_Cu.gbr, MHS-5200A_PwrSupply-B_Mask.gbr, MHS-5200A_PwrSupply-B_Paste.gbr, MHS-5200A_PwrSupply-B_SilkS.gbr, MHS-5200A_PwrSupply-Edge_Cuts.gbr, MHS-5200A_PwrSupply-F_Cu.gbr, MHS-5200A_PwrSupply-F_Mask.gbr, MHS-5200A_PwrSupply-F_Paste.gbr]
2020-11-11 vfo schematic
    [VFO-005.sch]
2020-11-14 ArduinoProMini pics
2020-11-14 VFO docs
    [ANTTENA.fzz, RDS_RBDS_PROGRAM_TYPE_TABLE.csv, SI4735.brd, SI4735.sch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]
2020-11-14 Old Power Supply
2020-11-17 filter designs
    [BUTTER07-B_Mask.gbs, BUTTER07-B_SilkS.gbo, BUTTER07-Back.gbl, BUTTER07-Edge_Cuts.gm1, BUTTER07-F_Mask.gts, BUTTER07-F_SilkS.gto, BUTTER07-Front.gtl, BUTTER07-NPTH.drl]
2020-11-19 Update Universal Low Pass Filter Kit Ver.1.5.website
2020-11-21 keyer stuff
    [KEYER.kicad_pcb, KEYER.sch]
2020-11-25 REV 2 BOARD
    [MHS-5200A_PwrSupply-B.Cu.gbr, MHS-5200A_PwrSupply-B.Mask.gbr, MHS-5200A_PwrSupply-B.Paste.gbr, MHS-5200A_PwrSupply-B.SilkS.gbr, MHS-5200A_PwrSupply-B_Cu.gbr, MHS-5200A_PwrSupply-B_Mask.gbr, MHS-5200A_PwrSupply-B_Paste.gbr, MHS-5200A_PwrSupply-B_SilkS.gbr]
2020-11-29 layout tweeks
    [PS317.kicad_pcb, PS317.sch]
2020-11-29 reverse pot
    [PS317.kicad_pcb, PS317.sch]
2020-12-01 Schematic Rev 4
2020-12-02 new vfo
    [I2C-VFO3-B.Mask.gbs, I2C-VFO3-B.SilkS.gbo, I2C-VFO3-B_Mask.gbs, I2C-VFO3-B_SilkS.gbo, I2C-VFO3-Back.gbl, I2C-VFO3-Edge.Cuts.gm1, I2C-VFO3-Edge_Cuts.gm1, I2C-VFO3-F.Mask.gts]
2020-12-02 vfo build
    [I2C-VFO3-B_Mask.gbs, I2C-VFO3-B_SilkS.gbo, I2C-VFO3-Edge_Cuts.gm1, I2C-VFO3-F_Mask.gts, I2C-VFO3-F_SilkS.gto]
2020-12-28 GPS freq reference
    [PS317.kicad_pcb, PS317.sch]
2020-12-28 update pwr supply
    [PS317.sch]
2021-01-09 update soldermask spacing
    [I2C-VFO3-B_Mask.gbs, I2C-VFO3-B_SilkS.gbo, I2C-VFO3-Back.gbl, I2C-VFO3-Edge_Cuts.gm1, I2C-VFO3-F_Mask.gts, I2C-VFO3-F_SilkS.gto, I2C-VFO3-Front.gtl, I2C-VFO3-NPTH.drl]
2021-01-11 fixed soldermask gap
    [CLK-GEN-B_Mask.gbs, CLK-GEN-B_SilkS.gbo, CLK-GEN-Back.gbl, CLK-GEN-Edge_Cuts.gm1, CLK-GEN-F_Mask.gts, CLK-GEN-F_SilkS.gto, CLK-GEN-Front.gtl, CLK-GEN-NPTH.drl]
2021-01-26 Black pill hub cleanup
    [Black-Pill-Board.sch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]
2021-01-29 pics etc
    [Black-Pill-Board_PL.csv, Blue-Pill-Board_PL.csv, LEDS-SWITCHES_PL.csv]
2021-01-31 Black Pill Hub
    [Black-Pill-Board-B_Cu.gbr, Black-Pill-Board-B_Mask.gbr, Black-Pill-Board-B_SilkS.gbr, Black-Pill-Board-Edge_Cuts.gbr, Black-Pill-Board-F_Cu.gbr, Black-Pill-Board-F_Mask.gbr, Black-Pill-Board-F_SilkS.gbr, Black-Pill-Board-NPTH.drl]
2021-02-26 Move FPGA cards
    [A-ESTF core Board PIN IO_PIN_IO.xls, ADC_TLC549.smp_dump.txt, I2C-RPT-01.sch, IR.smp_dump.txt, LCD12864.smp_dump.txt, LEDS_8DIGS.kicad_pcb, LEDS_8DIGS.sch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]
2021-03-04 Fix pinouts
    [RETRO-EP4CE15.sch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]
2021-03-12 added silkscreen clearances
    [Black-Pill-Board-B_Cu.gbr, Black-Pill-Board-B_Mask.gbr, Black-Pill-Board-B_SilkS.gbr, Black-Pill-Board-Edge_Cuts.gbr, Black-Pill-Board-F_Cu.gbr, Black-Pill-Board-F_Mask.gbr, Black-Pill-Board-F_SilkS.gbr, Black-Pill-Board-NPTH.drl]
2021-03-15 RPi PICO
2021-03-21 SD card docs
    [PiPico-01.kicad_pcb, PiPico-01.sch]
2021-03-27 FPGA schematic
2021-04-09 pdp8 front panel
    [ESP-32_VGA-B.Cu.gbr, ESP-32_VGA-B.Mask.gbr, ESP-32_VGA-B.SilkS.gbr, ESP-32_VGA-Edge.Cuts.gbr, ESP-32_VGA-F.Cu.gbr, ESP-32_VGA-F.Mask.gbr, ESP-32_VGA-F.SilkS.gbr, ESP-32_VGA-NPTH.drl]
2021-04-17 PDP-8 front panel
    [LEDS-SW12.sch]
2021-05-08 rev 3
    [DiffProbe.sch, ESP32-VGA.sch]
2021-05-21 PSP-8 FRONT PANEL
    [LEDS-SW12.kicad_pcb, LEDS-SW12.sch]
2021-06-14 pics mostly
    [ESP-32_VGA-B.Cu.gbr, ESP-32_VGA-B.Mask.gbr, ESP-32_VGA-B.SilkS.gbr, ESP-32_VGA-Edge.Cuts.gbr, ESP-32_VGA-F.Cu.gbr, ESP-32_VGA-F.Mask.gbr, ESP-32_VGA-F.SilkS.gbr, ESP-32_VGA-NPTH.drl]
2021-06-18 Front Panel TH edition
    [DIGIO16-DB25_DIGIO32-DB37.csv, DIGIO16-LED.csv, DIGIO16_DB25.csv, DIGIO16_DB25RIBBON.csv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]
2021-06-18 Rev 2 of RPI-SPI8 card (one cut one jumper)
    [RPI_SPI8-B_Cu.gbr, RPI_SPI8-B_Mask.gbr, RPI_SPI8-B_SilkS.gbr, RPI_SPI8-Edge_Cuts.gbr, RPI_SPI8-F_Cu.gbr, RPI_SPI8-F_Mask.gbr, RPI_SPI8-F_SilkS.gbr, RPI_SPI8-NPTH.drl]
2021-06-20 Add legends to Front Panel for typical 8-bit computer applications.
    [FrontPanel02-B_Cu.gbl, FrontPanel02-B_Mask.gbs, FrontPanel02-B_SilkS.gbo, FrontPanel02-Edge_Cuts.gm1, FrontPanel02-F_Cu.gtl, FrontPanel02-F_Mask.gts, FrontPanel02-F_SilkS.gto, FrontPanel02-NPTH.drl]
2021-06-20 TWEEK FRONT PANEL
    [FrontPanel02-B_Cu.gbl, FrontPanel02-B_Mask.gbs, FrontPanel02-B_SilkS.gbo, FrontPanel02-Edge_Cuts.gm1, FrontPanel02-F_Cu.gtl, FrontPanel02-F_Mask.gts, FrontPanel02-F_SilkS.gto, FrontPanel02-NPTH.drl]
2021-06-20 Front panel test/loopback
    [FrontPanel02_PL.csv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]
2021-06-23 SINGLE CONNECTOR VERSION OF CARD
    [ESP-32_VGA-B.Cu.gbr, ESP-32_VGA-B.Mask.gbr, ESP-32_VGA-B.SilkS.gbr, ESP-32_VGA-Edge.Cuts.gbr, ESP-32_VGA-F.Cu.gbr, ESP-32_VGA-F.Mask.gbr, ESP-32_VGA-F.SilkS.gbr, ESP-32_VGA-NPTH.drl]
2021-06-24 LEDs and Switches card updates
    [LEDS-SWITCHES _2_PL.csv, LEDS-SWITCHES_PL.csv]
2021-06-24 Ordered PCBs
2021-07-07 BOARD DOCS
2021-07-07 more card docs
    [LEDS-SWITCHES _2.kicad_pcb]
2021-07-15 Screwduino docs
    [screwduino-2021-07-14-15-40-22.sch, screwduino_PL.csv]
2021-07-18 DCE DTE
    [RS232_TTL_Female_PL.csv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]
2021-07-19 DCE DTE card docs
    [RS232_TTL_Female.sch]
2021-07-24 VFO-003 and other stuff
    [DB25RIBBONADAPTER-2021-07-24-13-16-24.sch, VFO-003.kicad_pcb, VFO-003_PL.csv]
2021-07-29 VFO-003 files
    [STEP ATTEN.lay6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]
2021-07-29 VFO-003 Rev 2
    [VFO-003-B_Cu.gbr, VFO-003-B_Mask.gbr, VFO-003-B_SilkS.gbr, VFO-003-Edge_Cuts.gbr, VFO-003-F_Cu.gbr, VFO-003-F_Mask.gbr, VFO-003-F_SilkS.gbr, VFO-003-NPTH.drl]
2021-08-04 Pulse Gen pics
    [PULSE-GEN.sch, SWLEDX8-2021-08-02-19-21-21.sch]
2021-08-13 Flipped and copied
    [SWLEDX8fLIPPED_6x.kicad_pcb]
2021-08-18 RF PROJECTS
    [AudioAmp380-2021-08-17-08-27-29.sch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]
2021-08-18 Create (2) #123- Build a crystal oscillator from schematic thru prototype construction and testing - DIY - YouTube.url
2021-08-20 More RF stuff
    [31-5431-10RFX.stp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]
2021-08-21 NOISE GEN AND OTHERS
    [AudioAmp380-B_Mask.gbr, AudioAmp380-B_SilkS.gbr, AudioAmp380-Back.gbr, AudioAmp380-Edge_Cuts.gbr, AudioAmp380-F_Mask.gbr, AudioAmp380-F_SilkS.gbr, AudioAmp380-Front.gbr, AudioAmp380-NPTH.drl]
2021-08-21 FAB NOISE GEN
    [CP-OSC-B_Mask.gbr, CP-OSC-B_SilkS.gbr, CP-OSC-Back.gbr, CP-OSC-Edge_Cuts.gbr, CP-OSC-F_Mask.gbr, CP-OSC-F_SilkS.gbr, CP-OSC-Front.gbr, CP-OSC-PTH.drl]
2021-08-22 RF fun
    [MINI360-2021-08-21-08-23-07.sch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]
2021-08-23 RF stuff
    [Toroids.ods]
2021-08-26 VFO-003 fix pwr/gnd
    [VFO-003-B_Cu.gbr, VFO-003-B_Mask.gbr, VFO-003-B_SilkS.gbr, VFO-003-Edge_Cuts.gbr, VFO-003-F_Cu.gbr, VFO-003-F_Mask.gbr, VFO-003-F_SilkS.gbr, VFO-003-NPTH.drl]
2021-08-30 Crystal filters
    [CW5-B_Mask.gbr, CW5-B_SilkS.gbr, CW5-Back.gbr, CW5-Edge_Cuts.gbr, CW5-F_Mask.gbr, CW5-F_SilkS.gbr, CW5-Front.gbr, CW5-NPTH.drl]
2021-09-03 Ham stuff
    [CW5-B_Mask.gbr, CW5-B_SilkS.gbr, CW5-Back.gbr, CW5-Edge_Cuts.gbr, CW5-F_Mask.gbr, CW5-F_SilkS.gbr, CW5-Front.gbr, CW5-NPTH.drl]
2021-09-23 Ordered 10 cards many panelized
    [AudioAmp380-B_Mask.gbs, AudioAmp380-B_SilkS.gbo, AudioAmp380-Back.gbl, AudioAmp380-Edge_Cuts.gko, AudioAmp380-F_Mask.gts, AudioAmp380-F_SilkS.gto, AudioAmp380-Front.gtl, AudioAmp380-NPTH.drl]
2021-09-24 Mostly ham radio stuff
    [MINI360-B_Mask.gbs, MINI360-B_SilkS.gbo, MINI360-Back.gbl, MINI360-Edge_Cuts.gko, MINI360-F_Mask.gts, MINI360-F_SilkS.gto, MINI360-Front.gtl, MINI360-NPTH.drl]
2021-09-27 More Ham Radio stuff
    [CW5-B_Mask.gbr, CW5-B_SilkS.gbr, CW5-Back.gbr, CW5-Edge_Cuts.gbr, CW5-F_Mask.gbr, CW5-F_SilkS.gbr, CW5-Front.gbr, CW5-NPTH.drl]
2021-10-02 MIXER MEASUREMENTS
    [AudioAmp380.kicad_pcb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]
2021-10-04 MORE HAM RADIO
    [ATTEN1-B_Cu.gbl, ATTEN1-B_Mask.gbs, ATTEN1-B_SilkS.gbo, ATTEN1-Edge_Cuts.gko, ATTEN1-Edge_Cuts.gm1, ATTEN1-F_Cu.gtl, ATTEN1-F_Mask.gts, ATTEN1-F_SilkS.gto]
2021-10-18 More boards
    [31-5431-10RFX.stp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]
2021-10-20 Arduino stuff
    [ATTEN_RESISTORS.csv, ArduinoInABox.kicad_pcb, DB25-02.kicad_pcb]
2021-10-28 Audi and Ham radio
    [AudioAmp380-B_Mask.gbs, AudioAmp380-B_SilkS.gbo, AudioAmp380-Back.gbl, AudioAmp380-Edge_Cuts.gm1, AudioAmp380-F_Mask.gts, AudioAmp380-F_SilkS.gto, AudioAmp380-Front.gtl, AudioAmp380-NPTH.drl]
2021-10-30 NEW CARDS
    [ATTEN6X2(RED).dxf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]
2021-11-02 Audio Amp
    [AudioAmp380_PL.csv, RF-Amp.sch]
2021-11-06 AUDIO AND HAM
    [AudioAmp380.sch, AudioAmp380_PL.csv, RF-Amp.sch, RF-Amp_PL.csv]
2021-11-08 RF-Amp fun
    [Class A Calculations.xlsx]
2021-11-09 Update Class A Calculations.xlsx
    [Class A Calculations.xlsx]
2021-11-14 Attenuator and RF Amp
    [SMA-HDRS-B_Cu.gbl, SMA-HDRS-B_Mask.gbs, SMA-HDRS-B_SilkS.gbo, SMA-HDRS-Edge_Cuts.gm1, SMA-HDRS-F_Cu.gtl, SMA-HDRS-F_Mask.gts, SMA-HDRS-F_SilkS.gto, SMA-HDRS-NPTH.drl]
2021-11-27 Relay driver card
    [RELAY_DRVR-B_Cu.gbr, RELAY_DRVR-B_Mask.gbr, RELAY_DRVR-B_Paste.gbr, RELAY_DRVR-B_SilkS.gbr, RELAY_DRVR-Edge_Cuts.gbr, RELAY_DRVR-F_Cu.gbr, RELAY_DRVR-F_Mask.gbr, RELAY_DRVR-F_Paste.gbr]
2021-11-30 Add bypass caps
    [VFO-003-B_Cu.gbr, VFO-003-B_Mask.gbr, VFO-003-B_SilkS.gbr, VFO-003-Edge_Cuts.gbr, VFO-003-F_Cu.gbr, VFO-003-F_Mask.gbr, VFO-003-F_SilkS.gbr, VFO-003-NPTH.drl]
2021-12-05 VFO tweeks - remove rotary switch buffering
    [VFO-003-B_Cu.gbr, VFO-003-B_Mask.gbr, VFO-003-B_SilkS.gbr, VFO-003-Edge_Cuts.gbr, VFO-003-F_Cu.gbr, VFO-003-F_Mask.gbr, VFO-003-F_SilkS.gbr, VFO-003-NPTH.drl]
2022-01-15 Board pics
2022-03-13 OptoOut8 card tweeks
    [OptoOut8-I2C.sch]
2022-03-17 Card designs
    [OptoCalc.csv, OptoIn8-I2C-2022-03-16-14-27-37.sch, OptoIn8-I2C.kicad_pcb, OptoIn8-I2C.sch, OptoIn8-I2C_PL.csv]
2022-03-22 ODAS Tester
    [I2CIO-8X-2022-03-21-17-05-18.sch, I2CIO-8X_PL.csv, I2CIO-8_PL.csv]
2022-03-29 Working card tests
    [AudioAmp380-2021-08-17-08-27-29.sch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]
2022-03-31 More card pics
    [RPI-Console-2022-03-31-12-01-24.sch]
2022-04-03 More board pics
    [I2C-RPT-08-B_Cu.gbr, I2C-RPT-08-B_Mask.gbr, I2C-RPT-08-B_SilkS.gbr, I2C-RPT-08-Back.gbr, I2C-RPT-08-Edge_Cuts.gbr, I2C-RPT-08-F_Cu.gbr, I2C-RPT-08-F_Mask.gbr, I2C-RPT-08-F_SilkS.gbr]
2022-04-03 Updated I2C-RPT-08 card
    [DIGIO-128.kicad_pcb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]
2022-04-05 SPI-POTX2 updates
    [SPI-POTX2-2022-04-04-21-53-18.sch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]
2022-04-06 SPI stuff
2022-04-08 Boards stuff
    [Analog-Inputs.sch, Analog_Cards.csv, BBB-COMMS-2-2022-04-07-14-10-54.sch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]
2022-04-09 BBB cards stuff
    [Analog-Inputs.sch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]
2022-04-27 PL for Arduino in a Box
    [ArduinoInABox_PL.csv]
2022-05-01 build pics shuffle folders
    [PDP-11_In_Box.csv, RETRO-EP4CE15.sch]
2022-05-14 kicad 6 related stuff
    [PULSE-GEN.kicad_pcb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]
2022-05-15 Pico stuff
    [GRID49.kicad_pcb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]
2022-05-17 CARDS ORDER
    [I2C-RPT-08-B_Mask.gbr, I2C-RPT-08-B_Mask.gbs, I2C-RPT-08-B_Silkscreen.gbo, I2C-RPT-08-B_Silkscreen.gbr, I2C-RPT-08-Back.gbl, I2C-RPT-08-Back.gbr, I2C-RPT-08-Edge_Cuts.gbr, I2C-RPT-08-Edge_Cuts.gko]
2022-05-19 More board stuff
    [FTDI-USB-TTL-49MM.kicad_pcb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]
2022-05-19 3D models
    [AudioJack.FCStd, Cube.step, JackBody.step, PICO_MM_CABLING.csv, PICO_MM_Connectors.csv, PICO_MM_VGA_RES.csv, PS2_MiniDIN.FCStd, PS2_MiniDIN6.step]
2022-05-20 Ported PTOTO15 to Kicad 6
    [ArduinoInABox.kicad_pcb, D1, Diode, Schottky, Raspberry Pi Pico-R3.SLDPRT, D2, QSME-C194, LED, Raspberry Pi Pico-R3.SLDPRT, L1, Inductor, Raspberry Pi Pico-R3.SLDPRT, MicroUSB Port, Raspberry Pi Pico-R3.SLDPRT, Mini-360.FCStd, Mini-360.step, PCB, Raspberry Pi Pico-R3.SLDPRT]
2022-05-23 Shuffle around folders a bit
    [31-5431-10RFX.stp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]
2022-05-24 More pics
    [SWLEDX8-I2C.kicad_pcb]
2022-05-24 BOM Tool
    [PiPicoMite01.csv]
2022-05-26 More card work
    [LEDS-SWITCHES _2.csv, LEDS-SWITCHES _2.kicad_pcb, LEDS-SWITCHES _2.kicad_sch, LEDS-SWITCHES _2_PL.csv, MouserReadIn.csv, Mouser_All-LandBoards-Parts_2019-09-26.xls, Mouser_All-LandBoards-Parts_2019-09-27.xls, Mouser_All-LandBoards-Parts_2030-01-07.xls]
2022-05-28 Touched up TinyPS2 and PC-Case-USB cards
    [PC-Case-USB-2022-05-28-15-32-33.sch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]
2022-05-29 Pico pics reorganized
2022-05-30 Work on W65C816 FPGA card
    [BASE-EP4CE6-2019-03-26-08-19-06.sch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]
2022-05-31 ODAS mechanicals
    [ODAS-Cards-PID.csv, ODAS-Cards.csv, ODAS.kicad_pcb, ODAS_49mm_KiCad.kicad_pcb, ODAS_95mm_KiCad.kicad_pcb]
2022-06-01 kicad backups
2022-06-04 QT Py and others
    [I2CIO-8-B_Mask.gbs, I2CIO-8-B_Silkscreen.gbo, I2CIO-8-Back.gbl, I2CIO-8-Edge_Cuts.gko, I2CIO-8-F_Mask.gts, I2CIO-8-F_Silkscreen.gto, I2CIO-8-Front.gtl, I2CIO-8.drl]
2022-06-09 KiCad Temptates and cards
    [0.96 OLED - Flush.stp, 0.96 OLED Module - i2C.stp, Adafruit+1.8+TFTshield.sch, BeagleBone_Black.kicad_pcb, BeagleBone_Black.kicad_sch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]
2022-06-09 ZIP templates
    [Raspberry_Pi.sch]
2022-06-09 KiCad templates
    [odas_95MM.kicad_pcb]
2022-06-13 MAX7219 card
    [MAX7219X4-B_Cu.gbr, MAX7219X4-B_Mask.gbr, MAX7219X4-B_Paste.gbr, MAX7219X4-B_Silkscreen.gbr, MAX7219X4-Edge_Cuts.gbr, MAX7219X4-F_Cu.gbr, MAX7219X4-F_Mask.gbr, MAX7219X4-F_Paste.gbr]
2022-06-16 SD Loader
    [PiPicoMite01-B_Cu.gbr, PiPicoMite01-B_Mask.gbr, PiPicoMite01-B_Silkscreen.gbr, PiPicoMite01-Edge_Cuts.gbr, PiPicoMite01-F_Cu.gbr, PiPicoMite01-F_Mask.gbr, PiPicoMite01-F_Silkscreen.gbr, PiPicoMite01.drl]
2022-06-18 PiPicoMite03 design
    [DS1306_PCB.step, DS1307.FCStd, PICO_MM_CABLING.csv, PICO_MM_Connectors_Rev1.csv, PICO_MM_Connectors_Rev2.csv, PICO_MM_VGA_RES.csv, PiPicoMite01.csv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]
2022-06-19 I2CIO16-DB25 svhematic
2022-06-19 I2C-SERIAL Card
    [I2C-RPT-01-2019-02-27-18-41-33.sch, I2C-RPT-01-2019-03-15-16-33-07.sch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]
2022-06-28 GPS Freq Std V2
    [GPS_Freq_Gen_Wiring.csv, PICO_MM_Connectors_Rev1.csv, PICO_MM_Connectors_Rev2.csv, PiPicoMite03.kicad_pcb]
2022-06-28 Cost est
    [PiPicoMite03.csv, PiPicoMite03_Costed.ods, PiPicoMite03_web.csv]
2022-07-08 DRIVE50 card
    [DRIVE50.csv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]
2022-07-09 Panel Cutouts
    [PiPicoMite03.kicad_pcb]
2022-07-17 PiPicoMite stuff
    [Book1.xlsx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]
2022-07-18 PicoVGA build
    [PicoVGA-B_Mask.gbs, PicoVGA-B_Silkscreen.gbo, PicoVGA-Back.gbl, PicoVGA-Edge_Cuts.gm1, PicoVGA-F_Mask.gts, PicoVGA-F_Silkscreen.gto, PicoVGA-Front.gtl, PicoVGA.drl]
2022-07-20 QTPy apps
    [JoyPad.csv, JoyPad.kicad_pcb, JoyPad.kicad_sch, JoyPad.sch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]
2022-07-24 QTPy49-01 design
    [QTPy49.csv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]
2022-07-29 Op Amp 4 docs
    [PicoVGA.kicad_pcb, PicoVGA_Pins.csv, UNI-OP-RESISTORS.csv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]
2022-07-31 GPS and DRIVE50 cards
    [PULSE-GEN.kicad_sch, PULSE-GEN.sch]
2022-07-31 MAX7219X4 docs
    [ArduinoInABox.kicad_pcb, ArduinoInABox.kicad_sch, MAX7219X4_Test.csv]
2022-08-01 Card docs / pics
    [MAX7219X4-B_Cu.gbl, MAX7219X4-B_Cu.gbr, MAX7219X4-B_Mask.gbr, MAX7219X4-B_Mask.gbs, MAX7219X4-B_Paste.gbp, MAX7219X4-B_Paste.gbr, MAX7219X4-B_Silkscreen.gbo, MAX7219X4-B_Silkscreen.gbr]
2022-08-02 New cards order
    [JoyPad-B.Cu.gbl, JoyPad-B.Mask.gbs, JoyPad-B.SilkS.gbo, JoyPad-B_Cu.gbl, JoyPad-B_Mask.gbs, JoyPad-B_Silkscreen.gbo, JoyPad-Edge.Cuts.gm1, JoyPad-Edge_Cuts.gm1]
2022-08-03 PicoVGA pics
    [JoyPad.kicad_pcb, JoyPad.kicad_sch]
2022-08-04 MAX7219X4 pics/docs
    [MAX7219X4_Test.csv]
2022-08-11 RETRO-65C816 conns
    [U8_CONN_MAP.csv]
2022-08-13 QTPy49-01 pics
    [PicoVGA.kicad_pcb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]
2022-08-15 SD Loader on QTPy49-01
    [QTPy49_Ap_02.kicad_pcb, QTPy49_Ap_02.kicad_sch, QT_Py_Ap_01.kicad_pcb, QT_Py_Ap_01.kicad_sch]
2022-08-15 TinyPS2 working
    [TinyPS2.csv, TinyPS2.kicad_sch]
2022-08-20 Level Shifter card
    [SD_CARD_X49.sch, SD_CARD_X49_PL.csv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]
2022-08-27 update ITX design files
    [ITX-65C816-B_Cu.gbl, ITX-65C816-B_Mask.gbs, ITX-65C816-B_Silkscreen.gbo, ITX-65C816-Edge_Cuts.gm1, ITX-65C816-F_Cu.gtl, ITX-65C816-F_Mask.gts, ITX-65C816-F_Silkscreen.gto, ITX-65C816.drl]
2022-08-30 ITX cards
    [FPGA-ITX-01.csv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]
2022-08-30 New pics renamed
    [FPGA-ITX-01-B_Cu.gbl, FPGA-ITX-01-B_Mask.gbs, FPGA-ITX-01-B_Silkscreen.gbo, FPGA-ITX-01-Edge_Cuts.gm1, FPGA-ITX-01-F_Cu.gtl, FPGA-ITX-01-F_Mask.gts, FPGA-ITX-01-F_Silkscreen.gto, FPGA-ITX-01.drl]
2022-08-30 More FGPA-ITX-01 card tweeks
    [FPGA-ITX-01-B_Cu.gbl, FPGA-ITX-01-B_Mask.gbs, FPGA-ITX-01-B_Silkscreen.gbo, FPGA-ITX-01-Edge_Cuts.gm1, FPGA-ITX-01-F_Cu.gtl, FPGA-ITX-01-F_Mask.gts, FPGA-ITX-01-F_Silkscreen.gto, FPGA-ITX-01.drl]
2022-08-30 ITX-BKOUT card
    [ITX-BKOUT.kicad_pcb]
2022-08-31 ITX card files - ordered
    [ITX-65C816-B_Cu.gbl, ITX-65C816-B_Mask.gbs, ITX-65C816-B_Silkscreen.gbo, ITX-65C816-Edge_Cuts.gm1, ITX-65C816-F_Cu.gtl, ITX-65C816-F_Mask.gts, ITX-65C816-F_Silkscreen.gto, ITX-65C816.drl]
2022-09-03 ESP32-VGA files
2022-09-05 ODAS-PSOC5 card
    [ODAS-PSOC5.csv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]
2022-09-07 XARDS UPDATES
    [ITX-65C816.kicad_sch, ODAS-PSOC5+RevX4_PL.csv, ODAS-PSOC5.csv, ODAS-PSOC5_PL-X2.csv, ODAS-PSOC5_PL.csv, ODAS-PSOC5_Rev5_PL.csv]
2022-09-10 BUILDS OF GRANT SEARLE SIMPLE CPUS ON A BACKPLANR
    [LB-65C816-01-B_Cu.gbl, LB-65C816-01-B_Mask.gbs, LB-65C816-01-B_Paste.gbp, LB-65C816-01-B_Silkscreen.gbo, LB-65C816-01-Edge_Cuts.gm1, LB-65C816-01-F_Cu.gtl, LB-65C816-01-F_Mask.gts, LB-65C816-01-F_Paste.gtp]
2022-09-12 SIMPLE CPU DESIGNS
    [SIMPLE-65C02-B_Cu.gbl, SIMPLE-65C02-B_Mask.gbs, SIMPLE-65C02-B_Paste.gbp, SIMPLE-65C02-B_Silkscreen.gbo, SIMPLE-65C02-Edge_Cuts.gm1, SIMPLE-65C02-F_Cu.gtl, SIMPLE-65C02-F_Mask.gts, SIMPLE-65C02-F_Paste.gtp]
2022-09-12 MC68B02 CPU
    [SIMPLE-65C02-B_Cu.gbl, SIMPLE-65C02-B_Mask.gbs, SIMPLE-65C02-B_Paste.gbp, SIMPLE-65C02-B_Silkscreen.gbo, SIMPLE-65C02-Edge_Cuts.gm1, SIMPLE-65C02-F_Cu.gtl, SIMPLE-65C02-F_Mask.gts, SIMPLE-65C02-F_Paste.gtp]
2022-09-14 68008 CARD
    [EPROM_PINS.csv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]
2022-09-15 68008 CPU card
    [EPROM_PINS.csv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]
2022-09-15 SIMPLE-68008 AND SCREWDUINO
2022-09-15 SHUFFLE FTDI PINS
    [SIMPLE-6502-B_Cu.gbl, SIMPLE-6502-B_Mask.gbs, SIMPLE-6502-B_Paste.gbp, SIMPLE-6502-B_Silkscreen.gbo, SIMPLE-6502-Edge_Cuts.gm1, SIMPLE-6502-F_Cu.gtl, SIMPLE-6502-F_Mask.gts, SIMPLE-6502-F_Paste.gtp]
2022-09-18 FPGA-ITX-01 UPDATES FROM BUILD
    [FPGA-ITX-01-B_Cu.gbl, FPGA-ITX-01-B_Mask.gbs, FPGA-ITX-01-B_Silkscreen.gbo, FPGA-ITX-01-Edge_Cuts.gm1, FPGA-ITX-01-F_Cu.gtl, FPGA-ITX-01-F_Mask.gts, FPGA-ITX-01-F_Silkscreen.gto, FPGA-ITX-01.drl]
2022-09-20 IFPGA-ITX PICS
    [FPGA-ITX-01_J10-J12_IOBUS_CONN_MAP.csv, FPGA-ITX-01_J8_CONN_MAP.csv, FPGA-ITX-01_U8_CONN_MAP.csv, ITX-65C816.kicad_pcb, ITX-65C816.kicad_sch, ITX-65C816_J1-CONN.csv, ITX-SWLEDs_J1_CONN.csv, LB-65CXX-01.kicad_sch]
2022-09-23 Synth boards
    [SYNTH-MIDI-CTL-01-B_Cu.gbl, SYNTH-MIDI-CTL-01-B_Mask.gbs, SYNTH-MIDI-CTL-01-B_Paste.gbp, SYNTH-MIDI-CTL-01-B_Silkscreen.gbo, SYNTH-MIDI-CTL-01-Edge_Cuts.gm1, SYNTH-MIDI-CTL-01-F_Cu.gtl, SYNTH-MIDI-CTL-01-F_Mask.gts, SYNTH-MIDI-CTL-01-F_Paste.gtp]
2022-09-24 SYNTH DESIGNS
    [MIDI-IN-OUT-B_Cu.gbl, MIDI-IN-OUT-B_Mask.gbs, MIDI-IN-OUT-B_Paste.gbp, MIDI-IN-OUT-B_Silkscreen.gbo, MIDI-IN-OUT-Edge_Cuts.gm1, MIDI-IN-OUT-F_Cu.gtl, MIDI-IN-OUT-F_Mask.gts, MIDI-IN-OUT-F_Paste.gtp]
2022-09-25 AUDIO CARDS
    [Cube.step, DIN-5_MIDI.FCStd, MIDI-IN-OUT.kicad_pcb, MIDI-IN-OUT.kicad_sch, SCF-2.kicad_sch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]
2022-10-04 SYNTH and RPPSOC
    [ER-PWR-01-B_Cu.gbl, ER-PWR-01-B_Mask.gbs, ER-PWR-01-B_Paste.gbp, ER-PWR-01-B_Silkscreen.gbo, ER-PWR-01-Edge_Cuts.gm1, ER-PWR-01-F_Cu.gtl, ER-PWR-01-F_Mask.gts, ER-PWR-01-F_Paste.gtp]
2022-10-04 SHUFFLE FOLDERS
    [ER-PWR-01-B_Cu.gbl, ER-PWR-01-B_Mask.gbs, ER-PWR-01-B_Paste.gbp, ER-PWR-01-B_Silkscreen.gbo, ER-PWR-01-Edge_Cuts.gm1, ER-PWR-01-F_Cu.gtl, ER-PWR-01-F_Mask.gts, ER-PWR-01-F_Paste.gtp]
2022-10-04 p/s, vco1
    [ER-PWR-01.kicad_pcb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]
2022-10-06 Boards details
    [MOD-CTL-POTS-B_Cu.gbl, MOD-CTL-POTS-B_Mask.gbs, MOD-CTL-POTS-B_Paste.gbp, MOD-CTL-POTS-B_Silkscreen.gbo, MOD-CTL-POTS-Edge_Cuts.gm1, MOD-CTL-POTS-F_Cu.gtl, MOD-CTL-POTS-F_Mask.gts, MOD-CTL-POTS-F_Paste.gtp]
2022-10-07 synth pieces
    [LB-MEM-03-B_Cu.gbl, LB-MEM-03-B_Mask.gbs, LB-MEM-03-B_Paste.gbp, LB-MEM-03-B_Silkscreen.gbo, LB-MEM-03-Edge_Cuts.gm1, LB-MEM-03-F_Cu.gtl, LB-MEM-03-F_Mask.gts, LB-MEM-03-F_Paste.gtp]
2022-10-10 VCO-01 REWORK
    [DIY_MIDI_CV_v1_1_controls_BOM.xls, DIY_MIDI_CV_v1_1_main_BOM.xls, HAGIWO_RESOURCES.csv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]
2022-10-11 synth parts
    [SYNTH-MIDI-CTL-01-B_Cu.gbl, SYNTH-MIDI-CTL-01-B_Mask.gbs, SYNTH-MIDI-CTL-01-B_Paste.gbp, SYNTH-MIDI-CTL-01-B_Silkscreen.gbo, SYNTH-MIDI-CTL-01-Edge_Cuts.gm1, SYNTH-MIDI-CTL-01-F_Cu.gtl, SYNTH-MIDI-CTL-01-F_Mask.gts, SYNTH-MIDI-CTL-01-F_Paste.gtp]
2022-10-13 SYNTH Card stuff
    [MOD-MIDI-THRU-B_Cu.gbl, MOD-MIDI-THRU-B_Mask.gbs, MOD-MIDI-THRU-B_Paste.gbp, MOD-MIDI-THRU-B_Silkscreen.gbo, MOD-MIDI-THRU-Edge_Cuts.gm1, MOD-MIDI-THRU-F_Cu.gtl, MOD-MIDI-THRU-F_Mask.gts, MOD-MIDI-THRU-F_Paste.gtp]
2022-10-17 MORE CARD STUFF
    [ER-PWR-01-B_Cu.gbl, ER-PWR-01-B_Mask.gbs, ER-PWR-01-B_Paste.gbp, ER-PWR-01-B_Silkscreen.gbo, ER-PWR-01-Edge_Cuts.gm1, ER-PWR-01-F_Cu.gtl, ER-PWR-01-F_Mask.gts, ER-PWR-01-F_Paste.gtp]
2022-10-18 MORE SYNTH
    [ER-ADSR-555-01.kicad_pcb, ER-ADSR-555-01.kicad_sch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]
2022-10-18 RE-NAME FOLDER
    [ER-MIDI-THRU-B_Cu.gbl, ER-MIDI-THRU-B_Mask.gbs, ER-MIDI-THRU-B_Silkscreen.gbo, ER-MIDI-THRU-Edge_Cuts.gm1, ER-MIDI-THRU-F_Cu.gtl, ER-MIDI-THRU-F_Mask.gts, ER-MIDI-THRU-F_Silkscreen.gto, ER-MIDI-THRU.drl]
2022-10-20 Getting ready to order PCBs
    [ER-ADSR-555-01-B_Cu.gbl, ER-ADSR-555-01-B_Mask.gbs, ER-ADSR-555-01-B_Silkscreen.gbo, ER-ADSR-555-01-Edge_Cuts.gm1, ER-ADSR-555-01-F_Cu.gtl, ER-ADSR-555-01-F_Mask.gts, ER-ADSR-555-01-F_Silkscreen.gto, ER-ADSR-555-01.drl]
2022-11-06 ADSR working
    [ER-ADSR-555-01.csv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]
2022-11-06 ADSR SCHEMATICS
2022-11-06 SHUFFLE PLUS ADD PICS
    [ER-ADSR-555-01-B_Cu.gbl, ER-ADSR-555-01-B_Mask.gbs, ER-ADSR-555-01-B_Silkscreen.gbo, ER-ADSR-555-01-Edge_Cuts.gm1, ER-ADSR-555-01-F_Cu.gtl, ER-ADSR-555-01-F_Mask.gts, ER-ADSR-555-01-F_Silkscreen.gto, ER-ADSR-555-01.drl]
2022-11-08 ER CARDS
    [DIY_MIDI_CV_v1_1_controls_BOM.xls, DIY_MIDI_CV_v1_1_main_BOM.xls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]
2022-11-11 SYNTH CARDS
    [ER-PROTO-01_SLEW.kicad_pcb, ER-PROTO-01_SLEW.kicad_sch, ER-PROTO-02-CTLS.kicad_pcb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]
2022-11-12 SLEW RATE CARD
    [ER-MIDI-CV4-02_CTLS.csv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]
2022-11-13 Braids and other stuff
    [Braids.xlsx, ER-PROTO-01_SLEW.kicad_sch, braids.dwg, braids_v50.brd, braids_v50.sch]
2022-11-14 Beaks and Braids
    [Braids_THT_BOM_PCB_1.1.csv, Peaks.kicad_pcb, Peaks.sch]
2022-11-14 Thru Hole Braids files
    [Braids.xlsx, Braids_THT_BOM_PCB_1.1.csv, Braids_THT_BOM_PCB_1.1.xlsx, braids.dwg, braids_v50.brd, braids_v50.sch]
2022-11-15 NOISE SCHEMATIC
2022-11-15 noise gen
    [ER-SH-NOISE-01.kicad_sch]
2022-11-15 Update Noise Generator on ER-PROTO-01 - Land Boards Wiki.pdf
2022-11-28 Visible BOM plugin
    [ER-ADSR-555-01.kicad_pcb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]
2022-11-29 SYNTH updates
    [CV_Table.xlsx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]
2022-12-09 Eurorack sound modules
    [ER-BEZIER-CV.kicad_sch, ER-PROTO-02-MOZZI-DB.kicad_sch]
2022-12-23 Beaks built and working
    [ER-PROTO-02-LEDS.kicad_sch, ER-PROTO-02-MOZZI-DB.kicad_sch]
2022-12-25 Braids files
    [Gerber_BoardOutline.GKO, Gerber_BottomLayer.GBL, Gerber_BottomSilkLayer.GBO, Gerber_BottomSolderMaskLayer.GBS, Gerber_Drill_NPTH.DRL, Gerber_Drill_PTH.DRL, Gerber_TopLayer.GTL, Gerber_TopSilkLayer.GTO]
2022-12-26 MUTABLE INSTRUMENTS STUFF
    [Blades.xlsx, Blinds.xlsx, Braids.xlsx, Branches.xlsx, Clouds.xlsx, Ears.xlsx, Edges.xlsx, Elements.xlsx]
2022-12-27 STIX - DiY MI Branches
    [STIX.csv, STIX.kicad_pcb, STIX.kicad_sch]
2023-01-08 ER-SCOPE working
    [ER-SCOPE-01.kicad_sch]
2023-01-10 ER-MIDI card
    [ER-MIDI-CV4-02_CTLS.kicad_sch, ER-USB-MIDI.kicad_sch, ER-VCA2-01.kicad_sch]
2023-01-16 Ordered cards
    [ER-ADSR-555-01_Panel.kicad_pcb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]
2023-01-18 ER-DELAY CARD
    [ER-DELAY-01.kicad_pcb, ER-DELAY-01.kicad_sch, ER-USB-MIDI.kicad_sch]
2023-01-23 ER-DELAY-01 DESIGN
    [Defaults.csv, ER-DELAY-01.kicad_pcb, ER-DELAY-01.kicad_sch]
2023-02-01 SAMPLE AND HOLD
    [ER-ADSR-555-01.csv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]
2023-02-02 CARD DOC UPDATES
    [ER-PROTO-02-MOZZI-DB.csv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]
2023-02-11 pipicomite03 end panels
    [ER-DELAY-01.kicad_sch, ER-PROTO-02_S-H.kicad_sch, PiPicoMite03 panel - PS2 end.stl, PiPicoMite03 panel - VGA end.stl]
2023-03-01 SIMPLE CPUs
    [EPROM_PINS_28P.csv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]
2023-03-11 ER-VCF-02 working
    [ER-MIXER5-02-B_Cu.gbl, ER-MIXER5-02-B_Mask.gbs, ER-MIXER5-02-B_Silkscreen.gbo, ER-MIXER5-02-Edge_Cuts.gm1, ER-MIXER5-02-F_Cu.gtl, ER-MIXER5-02-F_Mask.gts, ER-MIXER5-02-F_Silkscreen.gto, ER-MIXER5-02.drl]
2023-03-25 SIMPLE-6802 PICS PLUS FORTH
    [SIMPLE-6802.kicad_pcb, SIMPLE-6802.kicad_sch, SYMBOLTABLE.CSV]
2023-03-30 optofast-2 card
    [OptoBlock-2023-03-29-15-28-39.sch, OptoBlock.kicad_sch, OptoBlock.sch, OptoCalc-2.csv, OptoFast-2-2023-03-29-15-28-39.sch, OptoFast-2.csv, OptoFast-2.kicad_pcb, OptoFast-2.kicad_sch]
2023-03-30 ODASFAST-2 TEST
    [OptoBlock.kicad_sch, OptoFast-2.kicad_pcb, OptoFast-2.kicad_sch]
2023-04-26 Move to Kicad 7
    [RPI_SPI8.kicad_pcb, RPI_SPI8.kicad_sch, RPI_SPI8.sch]
2023-05-10 PCBs ordered
2024-06-20 Lots of updates
    [ANA-SIG-CON.kicad_pcb, ANA-SIG-CON.kicad_sch, ANA-SIG-CON.sch, SIMPLE-6502.kicad_pcb, SIMPLE-6502.kicad_sch, SIMPLE-68008.kicad_pcb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]
2024-06-27 68K CPU and others
    [LEDS-SW12.kicad_pcb, LEDS-SW12.kicad_sch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]
2024-08-29 LB cards
    [CPU_Compare.csv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]
2024-09-07 LB-RETRO card set updates
    [FTDI_Monitor-2024-08-30-09-25-38.sch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]
2024-09-10 Update 6809 CPU
    [LB-6809-01-B_Cu.gbl, LB-6809-01-B_Mask.gbs, LB-6809-01-B_Silkscreen.gbo, LB-6809-01-Edge_Cuts.gm1, LB-6809-01-F_Cu.gtl, LB-6809-01-F_Mask.gts, LB-6809-01-F_Silkscreen.gto, LB-6809-01.drl]
2024-09-13 Card updates - Add LEDs to CPU cards
    [LB-65CXX-01-B_Cu.gbl, LB-65CXX-01-B_Mask.gbs, LB-65CXX-01-B_Silkscreen.gbo, LB-65CXX-01-Edge_Cuts.gm1, LB-65CXX-01-F_Cu.gtl, LB-65CXX-01-F_Mask.gts, LB-65CXX-01-F_Silkscreen.gto, LB-65CXX-01.drl]
2024-09-20 LB-RETRO CPUs UPDATES
    [FTDI_Monitor-B_Cu.gbr, FTDI_Monitor-B_Mask.gbr, FTDI_Monitor-Edge_Cuts.gbr, FTDI_Monitor-F_Cu.gbr, FTDI_Monitor-F_Mask.gbr, FTDI_Monitor-F_Silkscreen.gbr, FTDI_Monitor-job.gbrjob, FTDI_Monitor.drl]
2024-10-09 Ordered PCBa
2024-10-14 Z80 PICS
    [LB-Z80-01.kicad_sch]
2024-10-16 CARD CHECKOUTS
    [LB-68B50-02.kicad_sch, LB-Z80-01.kicad_sch]
2024-12-02 Retro backplane computer pics
    [FTDI_Monitor.kicad_sch, LB-6809-01.kicad_pcb, LB-6809-01.kicad_sch]
