land-boards/lb-boards/(notices)

Notices in the files:
Hardware/SparkFun/psoc/variants/standard/pins_arduino.h:
Public License along with this library; if not, write to the
Free Software Foundation, Inc., 59 Temple Place, Suite 330,
Boston, MA 02111-1307 USA
parts and their libraries:
si4735: COPYRIGHT: Copyright (C) 2018 Accelerated Designs. All rights reserved
SparkFun-Resistors: Licensing: Creative Commons ShareAlike 4.0 International - https://creativecommons.org/licenses/by-sa/4.0
